EOSCogniton/ELIZ-2022/Documentation/systemes/module standard 48v/conception/concepts/concept_connecteurs_modules.png

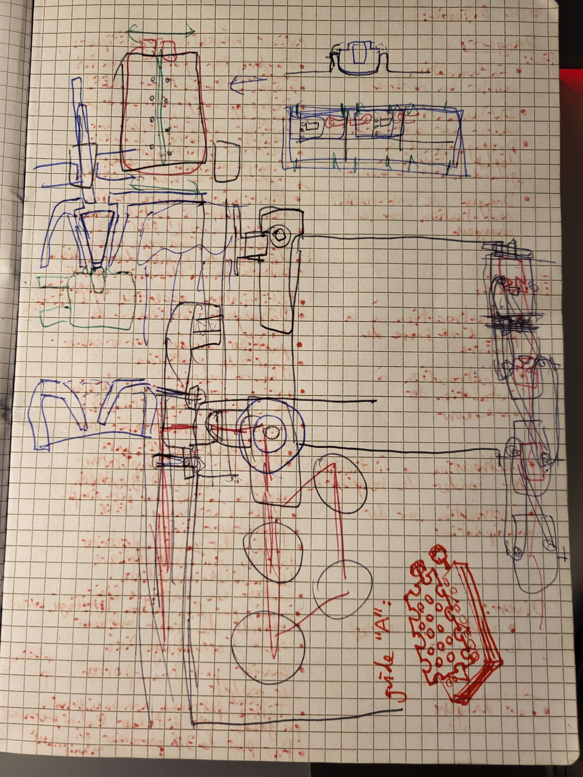
Documentation/systemes/module standard 48v/conception/concepts/concept_connecteurs_modules.png
