EOSCogniton/ELIZ-2022/01 - Maquette CATIA/AA - Mise en plan/La mache laser/4e vague/Anti-Intrusion Plate/Note - read me.txt

Note - read me

Il me semble que l'AIP avait été faite en Alu l'année dernière, mais elle doit être soudée sur tout son coutour. Il faut donc soit de l'alu soudable, sinon du S235 en 1.5mm d'épaisseur ira très bien. Pour l'épaisseur de l'alu, il faut au moins 1.5mm, pas plus que 3. Je vous en reparle quand on se voit.
