EOSCogniton/ELIZ-2022/01 - Maquette CATIA/AA - Mise en plan/La mache laser/3e vague/S235/5mm/Note - read me.txt

Note : Si vous n'avez pas de 5mm, prenez ce que vous avez de plus proche (plus épais ou moins épais, peu importe). Ces pièces ne servent qu'à bloquer en translation les sangles du harnais.
