EOSCogniton/ELIZ-2022/02 - Documentation/CHASEA/Info chassis carbone/Mail_conseils_anglais.docx

Hello,

I am a student at Ecole Centrale de Lyon in France and I am member of the school’s Formula Student team named EPSA.

I am contacting you because I would like to ask you for some details about your chassis, especially the carbon fiber part.

Indeed we would like to design parts of our next car in carbon fiber but we have never made it. Therefore, maybe you could you give us some advices before beginning to use this material.

My questions are

1) Do you manufacture your own parts ?

2) If yes which technique do you use ? Draping and then vacuuming ? How do you produce the mould ?

3) How do you connect your carbon fiber part to the tubular structure ?

Thank you very much for your help.

Hope you will perform this summer.

Kind regards.
