EOSCogniton/ELIZ-2022/02 - Documentation/RC_Rendus_Compet/Eté 2024/IAD/Schematics/Positionning IAD on AIP.pptx

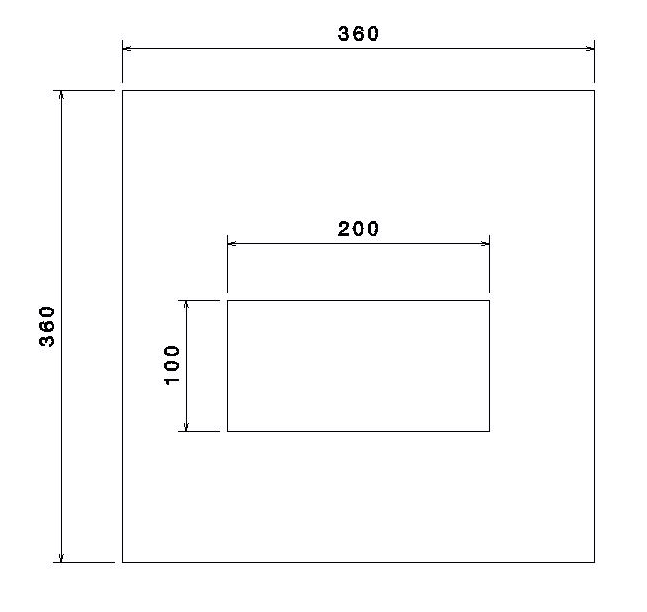
[picture p3: figure]

AIP

IA

## Slide 2

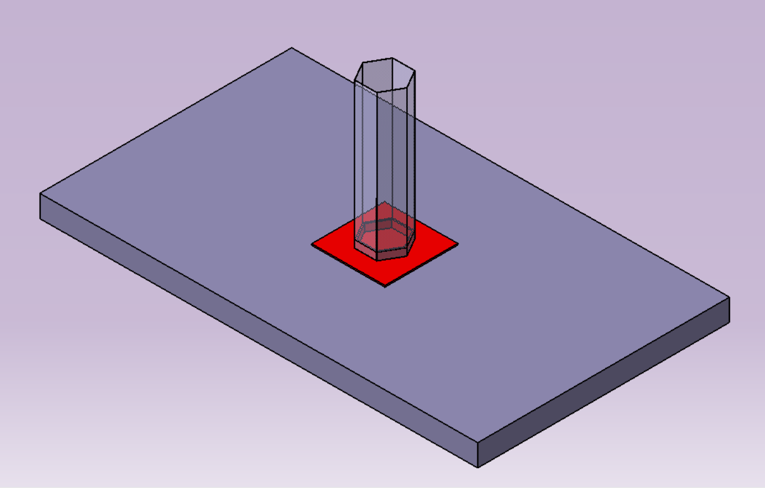
[picture p4: figure]

Cell of the AIP

AIP

Glue that runs up along the walls of the honeycomb

Glue spread on the AIP
