EOSCogniton/ELIZ-2022/02 - Documentation/BASTIE/Cartes Artemiz/SCS IMD-AMS Indicator/Note_SEI.rtf

Question en suspens:

/* Opto ou transistor ?
/* Bonne config du transistor ?
/* Quelles résistances Pulldown / Sortie ?
/* Tension de sortie du comparateur > Vt ?

/* Rest à faire:

/* Déterminer les valeurs des résistances:
/* 2 ponts diviseurs
/* Pull down
/* Sortie

/* Simulation

/* PCB
