EOSCogniton/ELIZ-2022/02 - Documentation/LASMECA/Hors sujet Osiriz/Drivetrain_osiriz/HU-FS-Gearset_B_ProductOverview2526.pdf

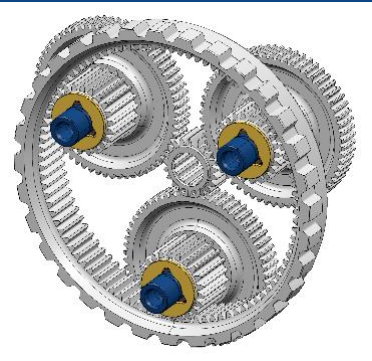
[picture p125: figure]
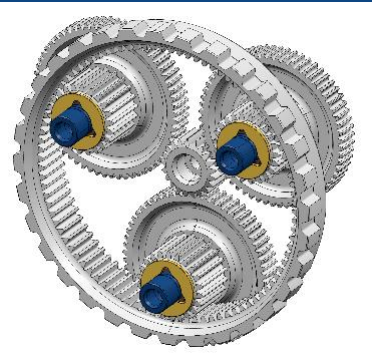
[picture p126: figure]

25/26 – Product Overview formula student gear set | 1

## FORMULA STUDENT GEAR SET

### Product Overview Racing Season 25 / 26

Products

Gear Set “AMK”
V1 – 2025, itot = 12.48
- 1x Sun gear “AMK”
(internal DIN5480 spline)
- 3x Stepped planets
- 1x Ring gear
- 3x Planetary bolts
- 12x Thrust washer

Gear Set “DTI”
V1 – 2025, itot = 12.48
- 1x Sun gear “DTI”
(external DIN5480 spline)
- 3x Stepped planets
- 1x Ring gear
- 3x Planetary bolts
- 12x Thrust washer

Pricing

Version | Price
Gear Set “AMK” | 2,500.00€
Gear Set “AMK” inclusive HUMBEL Sponsoring | 2,000.00€
Gear Set “DTI” | 2,500.00€
Gear Set “DTI” inclusive HUMBEL Sponsoring | 2,000.00€
(Incoterm: FCA Kradolf)

The conditions for the Sponsoring Kit remain in place for as long as the devices in the Sponsoring Kit are used.

HUMBEL Sponsoring requires the following conditions
- HUMBEL logo on the gearbox cover or
HUMBEL logo on the car
- HUMBEL logo on team-website
- 1x Instagram or LinkedIn Post from unboxing or assembly
- HUMBEL may call itself as “Team-Sponsor”
