EOSCogniton/ELIZ-2022/02 - Documentation/RC_Rendus_Compet/Eté 2025/Design Support FSS/Design Support Suspensions.pdf

# Design Support

# Suspensions & Vehicle Dynamics

### Objectives

- Predictable behavior of the car for non-professional drivers
- Extract maximum grip from the tires
- Easily adjustable
- First EV : reliability and ease of operations first

## Conception steps

### 1st Step : tyre choice & tyre study

| Continental C19 | Hoosier HB137 | Goodyear Eagle
Grip capability | 4 | 3 | 5
Weight | 5 | 4 | 5
Price | 5 | 5 | 3
Ease of supply | 3 | 3 | 1
Total | 17 | 15 | 14

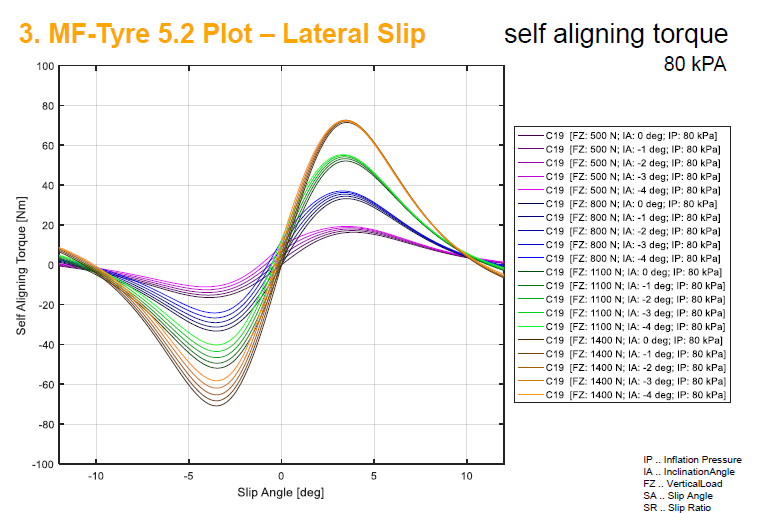
[picture p132: figure]
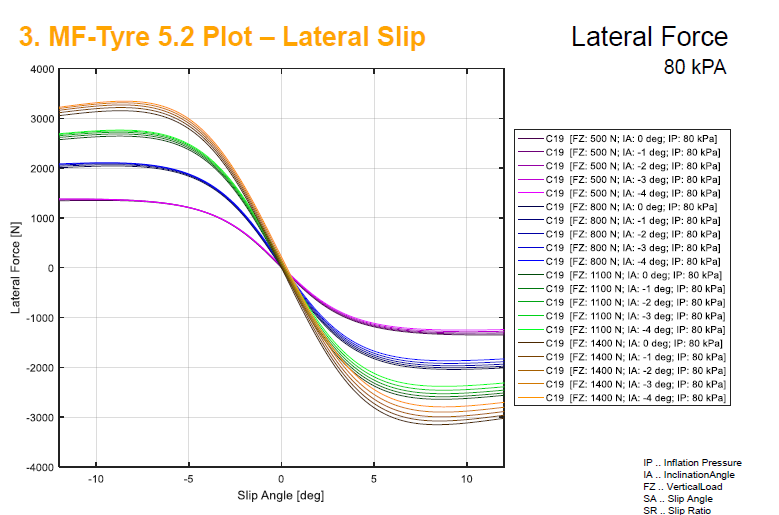
[picture p133: figure]
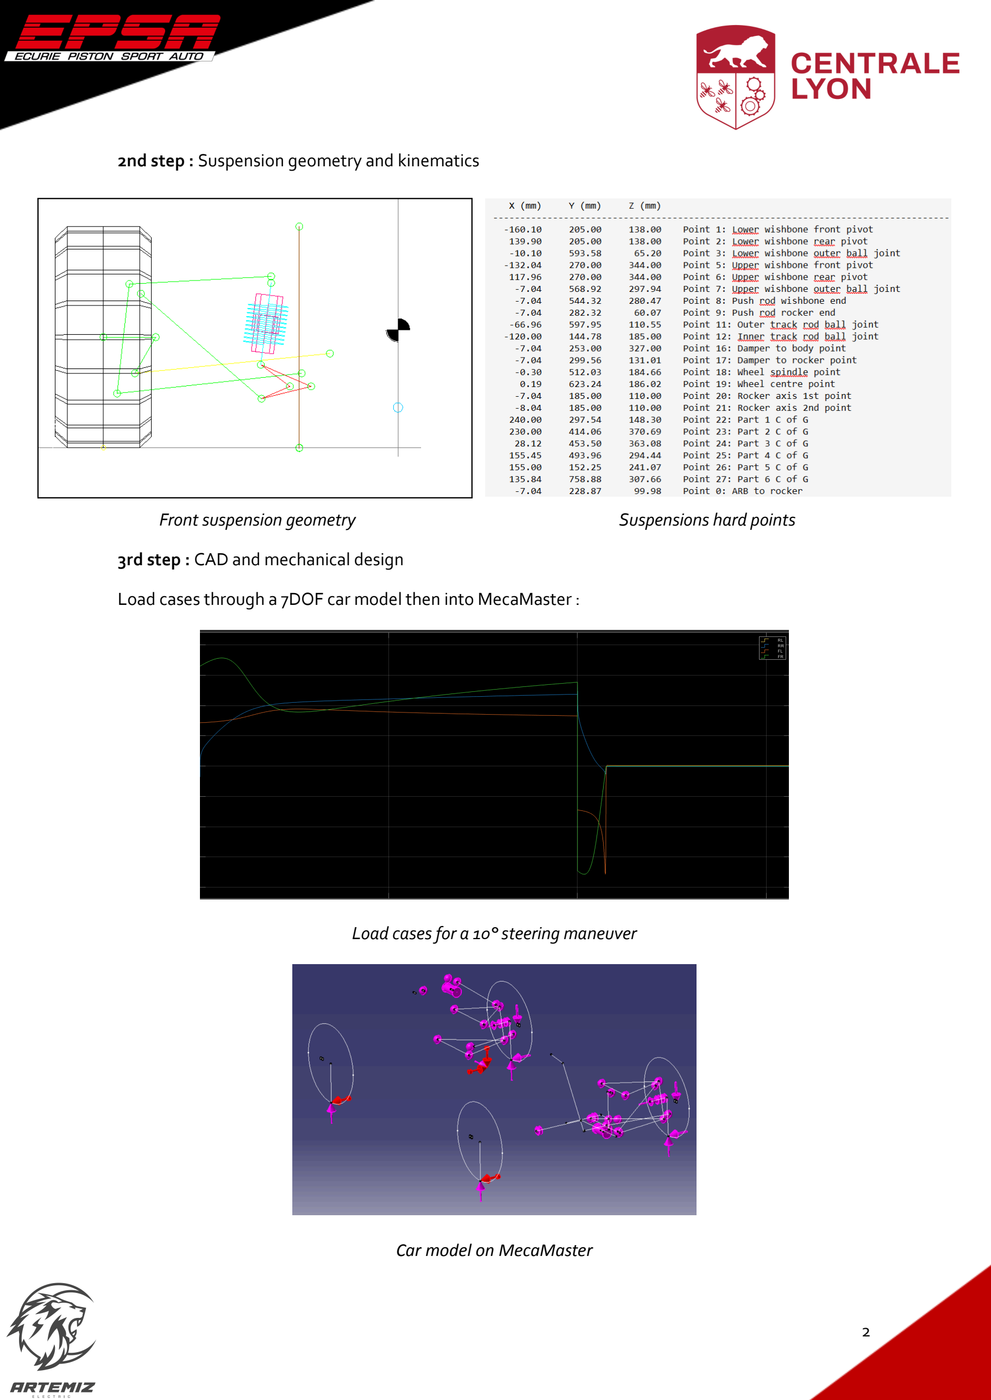
[picture p134: page 2]

2nd step : Suspension geometry and kinematics

Front suspension geometry | Suspensions hard points

3rd step : CAD and mechanical design

Load cases through a 7DOF car model then into MecaMaster :

Load cases for a 10° steering maneuver

Car model on MecaMaster

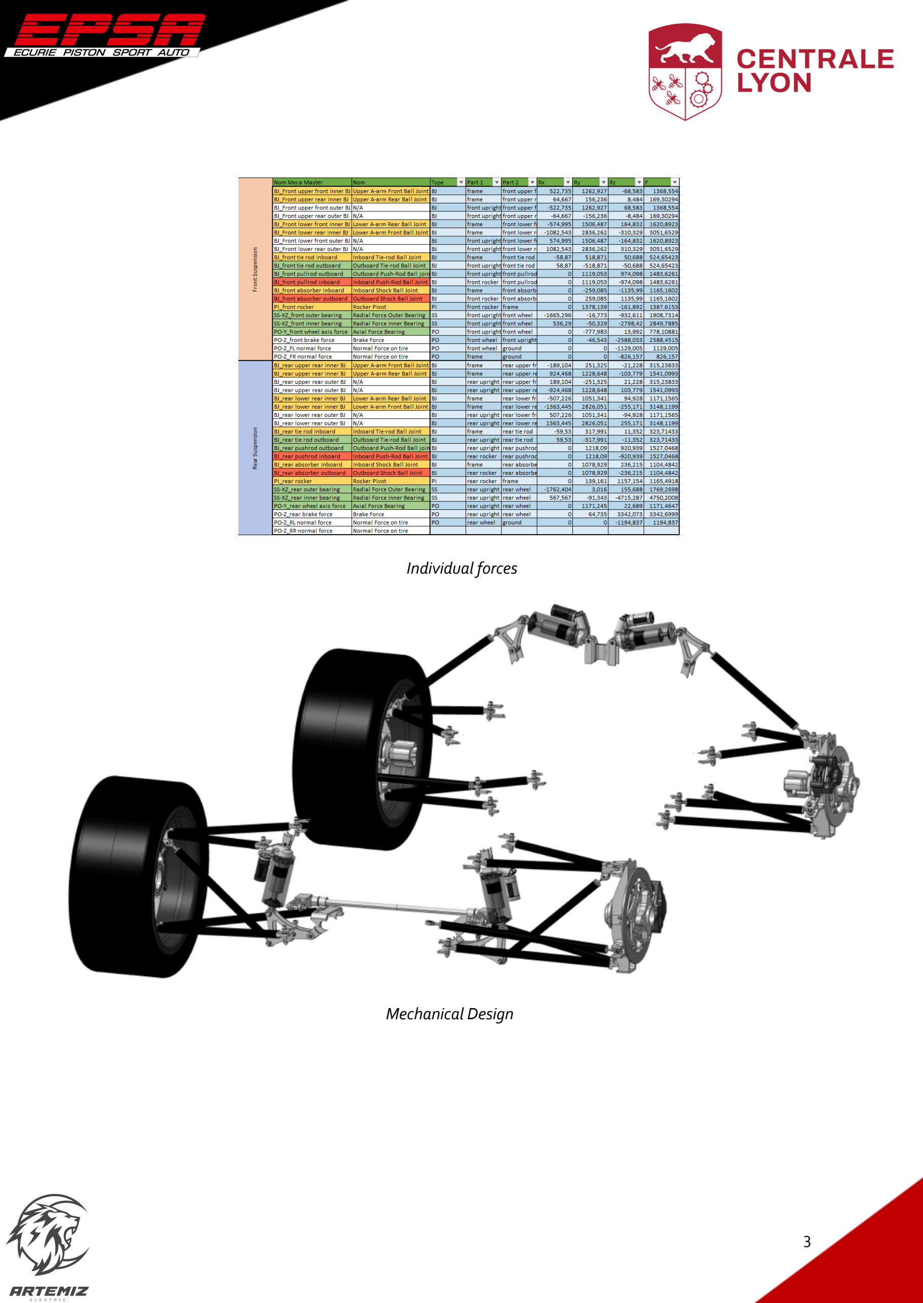
[picture p135: page 3]

Individual forces

Mechanical Design
