EOSCogniton/ELIZ-2022/02 - Documentation/RC_Rendus_Compet/Eté 2025/Design Support FSS/Design_Support_Chassis FSS 2025.pdf

# Design Support Documents

# Frame & Ergonomics

### Objectives

The objective of this document is to present the various tools and approaches we used to design the frame of Artemiz. Our goal was to create the team’s first frame for an electric vehicle. We also aimed to be as competitive as possible, so we set a performance target based on the previous results achieved with the team’s combustion-powered car.

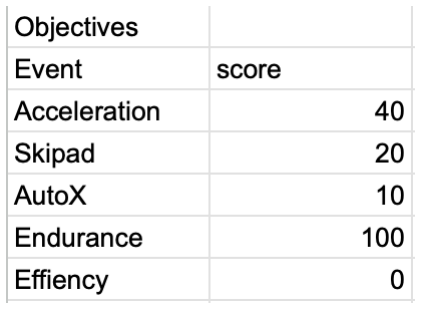
[picture p139: figure]

Figure 0 : Objectives points

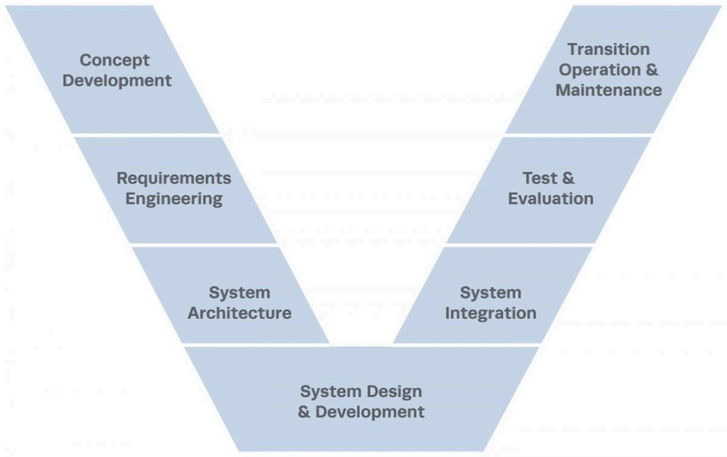
[picture p140: figure]

Figure 1 : Design of the product cycle: V-cycle

### Conception steps

To begin with, we set objectives, summated constraints imposed by the rules and located improvements opportunities, in order to structure and define our work. Then, a preconception phase instituted the basics of the development that was brought in detailed conception. This consisted of an iterative process between CAD and simulations and interface management with other systems.

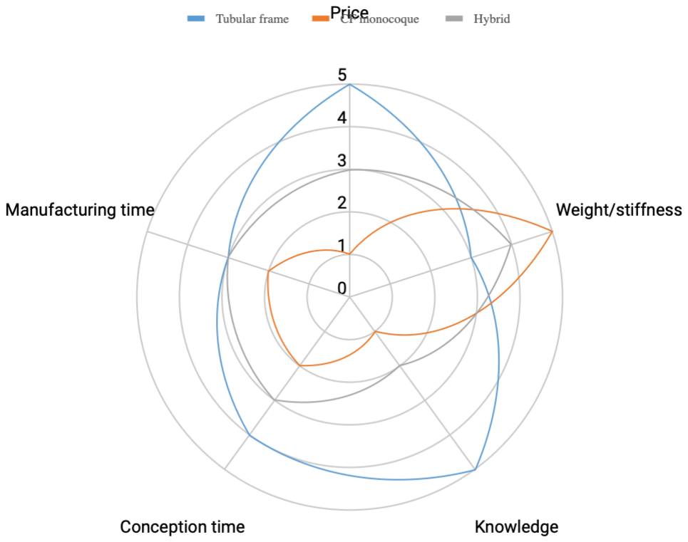
[picture p141: figure]

Figure 2 : Decision graph frame

### Assumptions

We realised simulations under the following assumptions.

- Elastic behaviour
- Small displacement
- No dynamic phenomenon
- Welding beams infinitely stiff
- Beam model

### Important values

| Target | Simulation | Test
Torsional Stiffness (Nm/deg) | 1200 - 1500 | 1430 | 1150
Weight (kg) | 57 | 52 | 53
- Steel: 25CrMo4
- Yield strength: > 700MPa

### CAD

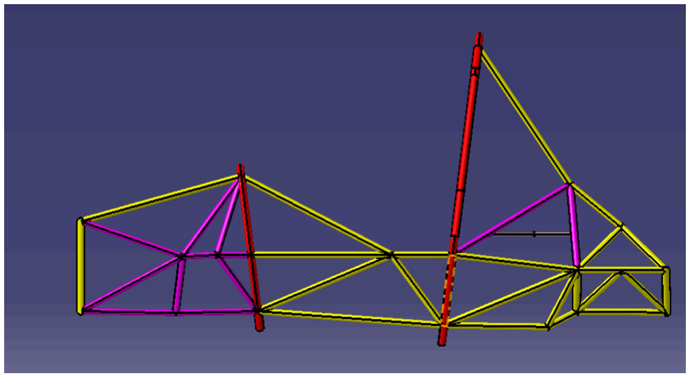
[picture p142: figure]

figure 3 : CAD of the frame

### Simulation tests results

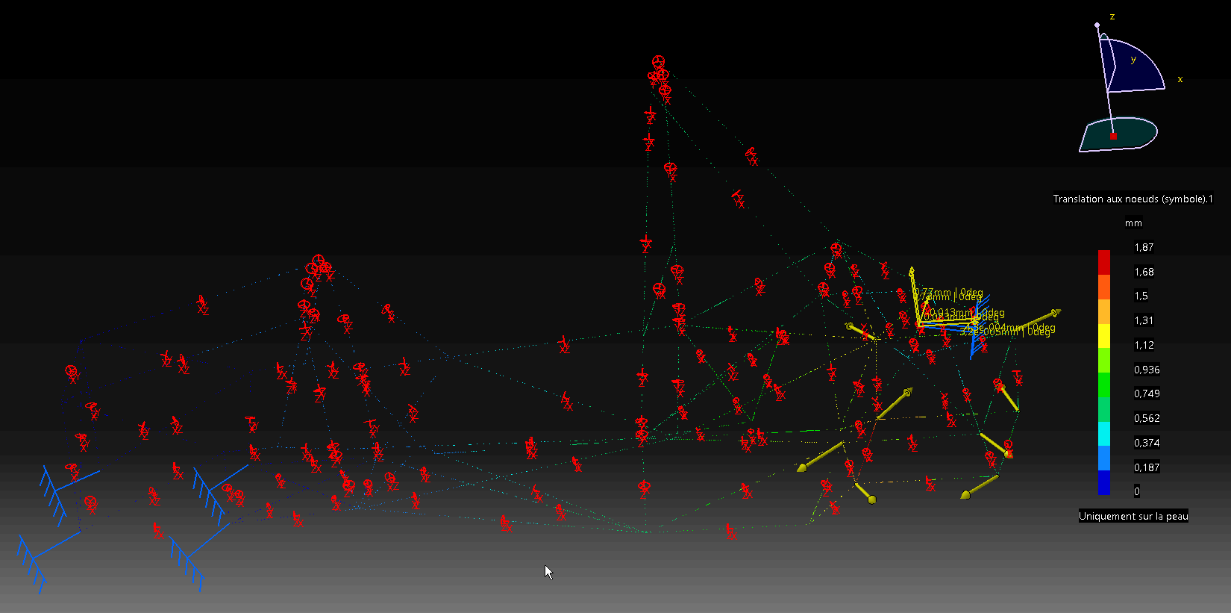
[picture p143: figure]

Figure 4 : Bump 3g rear

### Tests Results

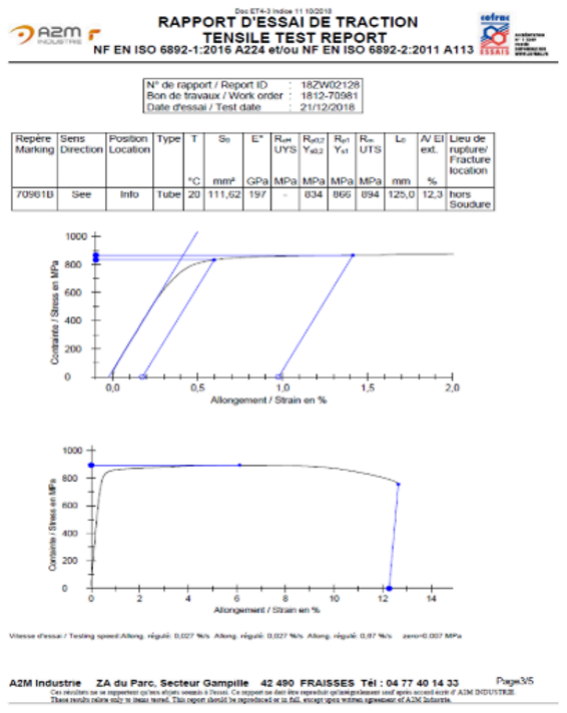
[picture p144: figure]

Figure 5 : Tensile strength test

### Stiffness measurement

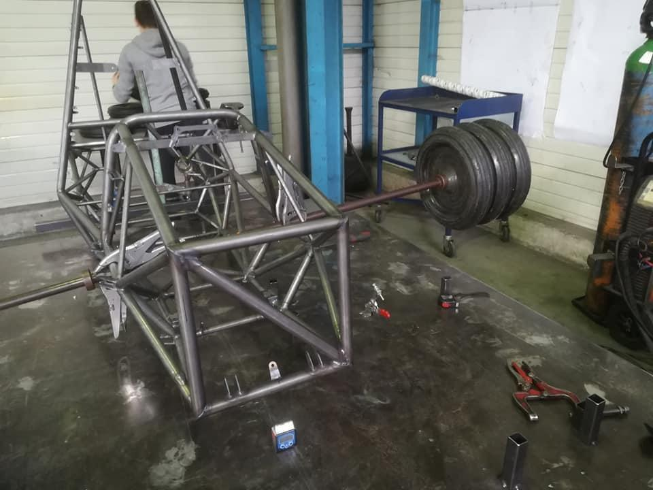
[picture p145: figure]
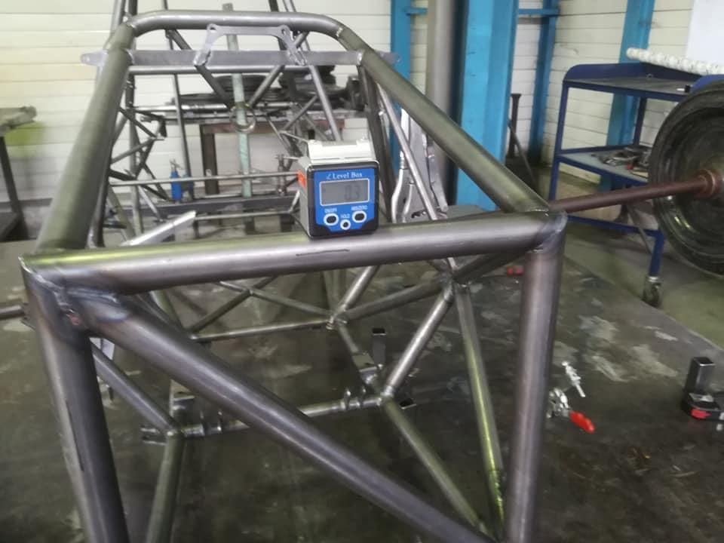
[picture p146: figure]

Fig 9A. Stiffness measurement on a previous frame

Measure performed in two times (distance to longitudinal axis approx. 1m):

- Apply a torque to the front and the cockpit of the frame, blocking the back
- Apply a torque at the back, blocking the front

### Ergonomics and Human Factors

A dedicated ergonomic test bench was used to validate pilot positioning:

- Adjustable seat, pedal box, and steering wheel
- Use of 95th percentile male anthropometric data
- Verification of visibility, accessibility, and harness geometry

This phase ensured rule compliance (6-point harness geometry, padding, egress time) and increased comfort.

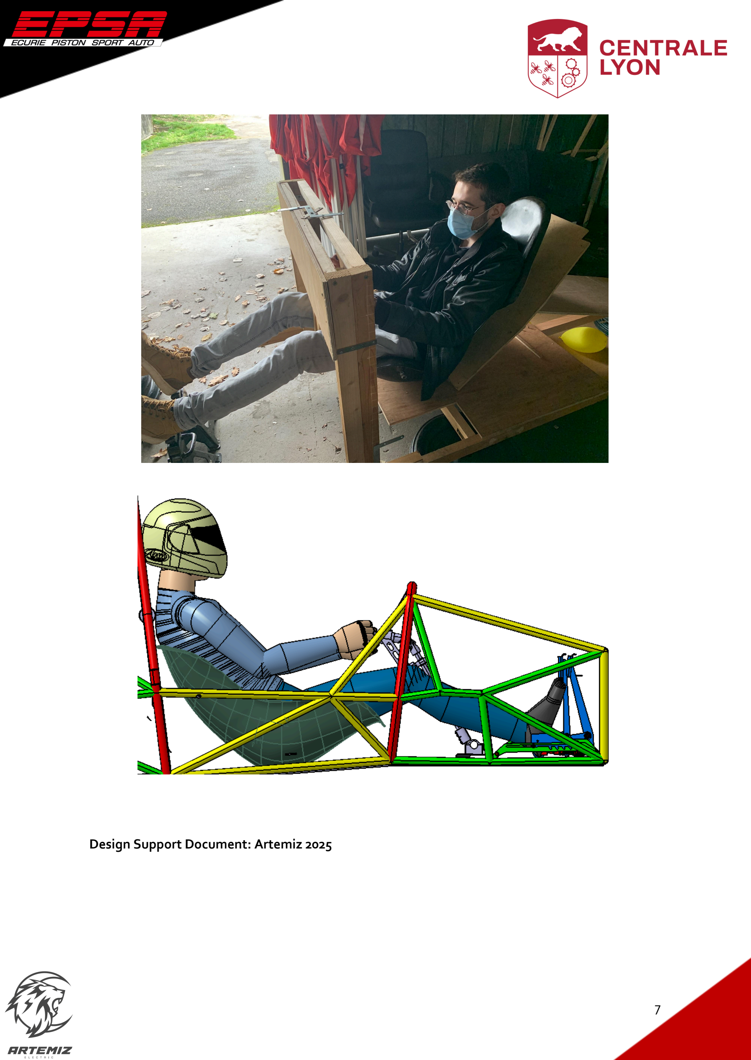
[picture p147: page 7]

Design Support Document: Artemiz 2025
