EOSCogniton/ELIZ-2022/Models/Electronique/Design carte/BSPD/Etape1CarteClarObj.pdf

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

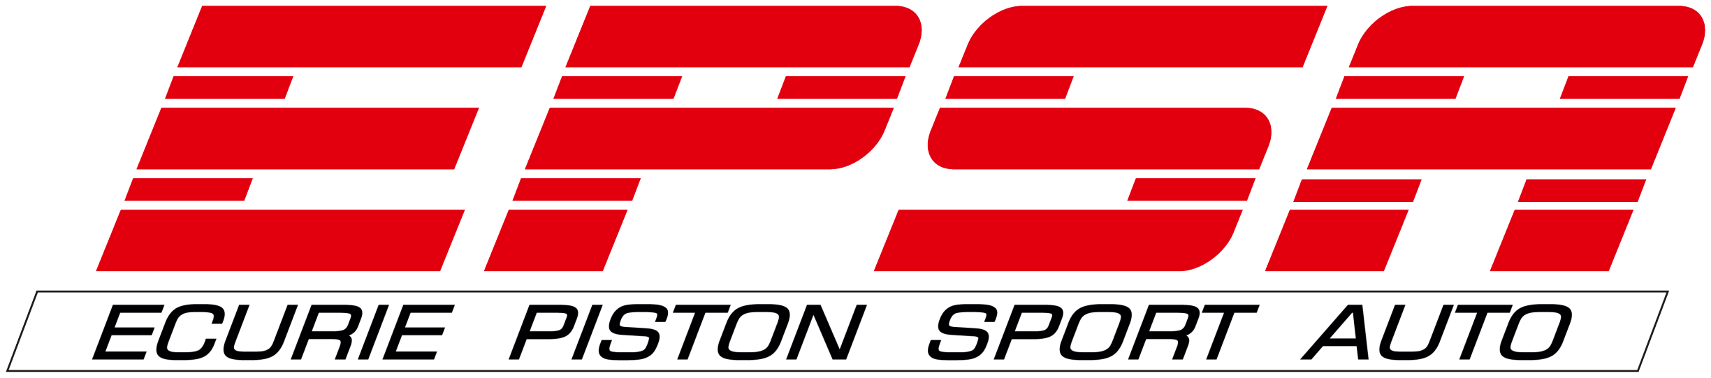
[picture p151: figure]

2 Description du fonctionnement

## Table des matières

1 Introduction | 1
2 Description du fonctionnement | 1
3 Description détaillé du fonctionnement de la carte | 2
4 Schéma Logique | 2
5 Réalisation de la carte BSPD durant le projet Artemiz V1.0 | 3

## 1 Introduction

Le présent document va résumer le fonctionnement la carte BSPD présent dans le réglement à la section X.0.0. Cette rédaction s'est faite sous la direction du véhicule Artemiz V1.0 et sous la version des régles suivantes : FS-Rules_2022_v1.0

## 2 Description du fonctionnement

La logique de cette carte obéit aux règles suivantes :

T 1 1. 6 Brake System P l a u s i b i l i t y Device

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

4 Schéma Logique

De ces règles nous pouvons sortir une liste d'entrée sortie que devra posséder notre carte :
Entrée :
Première entrée : signal du capteur de freinage
Deuxième entrée : signal du capteur de puissance délivrée aux moteurs Sortie :
Première sortie : interrupteur ouvrant ou fermant le shotgun circuit.

## 3 Description détaillé du fonctionnement de la carte

Le fonctionnement détaillé de la carte BSPD est résumé ci-dessous :
le BSPD ouvre le shutdown circuit lorsque'il capte un gros freinage alors que plus de 5kW est délivré aux moteurs pendant plus de 500ms Le shutdown circuit ne se referme que quand les conditions de fermeture ne sont pas validées pendant plus de 10 secondes. Il ne doit comporter que des circuits imprimés non programmables et n'être reliée à aucun système en amont.
Un système de pression des freins doit être utilisé tel que cette pression ne dépasse pas 30 bar.
Seul un capteur de courant DC doit être utilisé. Il doit être choisi tel que la puissance de dépasse pas 5kW à la tension maximale.
Il faut pouvoir déconnecter chaque capteur en cas d'inspection.
Il ne doit pas être dans la TSAC.
Tous les signaux associés doivent être des SCS.
Le fonctionnement du BSPD doit être prouvé en réalisant les conditions d'activation.

## 4 Schéma Logique

La carte BSPD, devra suivre le schéma logique Figure 1. Ce schéma pose les bases pour la conception détaillé de la carte.

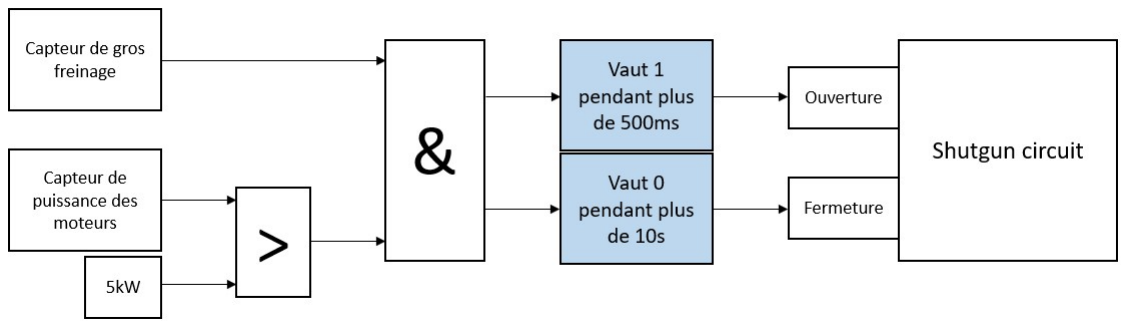
[picture p152: figure]

Figure 1 Schéma logique de la carte BSPD

BASTIE- v0.1 | Clarication Objectif Carte Electroniques- BSPD | 2

5 Réalisation de la carte BSPD durant le projet Artemiz V1.0

## 5 Réalisation de la carte BSPD durant le projet Artemiz V1.0

Cette année l'itération de la carte possède quelques particularité :
Première spécicité
Deuxième spécicité
La carte de l'année actuelle possède un circuit réelle représenté Figure 2 et une optimisation d'espace Figure 3. Toute les données concernant cette carte sont trouvables au lien suivant : Itération Artemiz V1.0 de la carte BSPD (http://google.com)

Figure 2 Schéma Réelle de la carte BSPD du projet Artemiz V1.0

Figure 3 Schéma position de la carte BSPD du projet Artemiz V1.0

La carte possède les composants suivants :

Pièce | Référence Quantité
NE555 | ? | 1
resistance de ?ohms | ? | 1
Condensateur de ?mF | ? | 2
Porte ET | ? | 1
Transistor MOS | ? | 1
Amplicateur opérationnel ? | 1
BASTIE- v0.1 | Clarication Objectif Carte Electroniques- BSPD | 3
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
