EOSCogniton/ELIZ-2022/02 - Documentation/CHASEA/Info chassis carbone/Carbon Rules.xlsx

Zone | Properties | Rules | Questions
side impact structure | same properties as 2 tubes for buckling modulus, yield strength and absorbed energy. | T3.5.2
test sample | Dimensions : 500 x 275
 | Information (permanent marker or engraving, but no sticke): laminated structure acronym and date of testing. | T3.5.4 | T3.5.9
 | rayon du load applicator = 50 mm | T3.5.5
Roll hoop | must be mechanically attached at the top and bottom of both sides of that structure | T3.7.4 | T3.7.6
 | the lower roll hoop tubing attachment points must be within 50mm of the endpoints of the roll hoop.
 | Mounting plates welded to the roll hoops must be at least 2mm thick steel | T3.7.5
Front bulkhead | perimeter shear strength equivalent to a 1:5mm thick steel plate. | T3.13.1
 | The length of the section perpendicular to the bulkhead may be a maximum of 25mm measured from the rearmost face of the bulkhead. |  | T3.13.2
Front bulkhead support | If the front bulkhead support is part of a composite structure, it must have equivalent EI to the sum of the EI of the six baseline steel tubes that it replaces and it must not be counted towards the composite front hoop bracing structures for the structural equivalency documentation | T3.14.2
 | The EI of the vertical side of the front bulkhead support structure must be equivalent to atleast the EI of one baseline steel tube that it replaces | T3.14.3
 |  |  | T3.14.4
Side impact structure | the region 320mm above the lowest inside chassis point between the front and main hoop must have an EI equal to the three baseline steel tubes that it replaces (cf schéma) | T3.15.2
 | The vertical side impact structure must have an EI equivalent to two baseline steel tubes and half the horizontal floor must have an EI equivalent to one baseline steel tube. |  | T3.15.2
 | The vertical side impact structure must have an absorbed energy equivalent to two baseline steel tubes.
 | The perimeter shear strength must be at least 7:5 kN.
Monocoque | Tissage : 50% max de fibres parallèles (+/- 10°) | T3.4.3
 | Main hoop en acier | T3.3.1
 | Front hoop en métal | T3.3.1
 | Respecter les propriétés des matériaux pour la primary structure | T3.2
Si pas même épaisseur partout attention
Front hoop possible de le laminer T3.9.5
