EOSCogniton/ELIZ-2022/02 - Documentation/module standard 48v/conception/Calcul-du-nombre-de-cellules-et-des-dimensions-à-utiliser.xlsx

Sheet: Calcul du nombre de cellules
Caractéristiques batterie | Valeur | Unité
Capacité | 7800 | Wh
Nombre de modules | 10 | /
Caractéristiques cellule : 18650 Parasonic ou Sony | Valeur | Unité
Tension nominale | 3.6 | V
Capacité | 2.5 | Ah
Caractéristiques module | Valeur | Unité
Capacité | 780 | Wh
Tension nominale | [48;50] | V
Nombre de cellules | 86.66666667 | /
Intervalle admissible pour le nombre de cellules (+/- 5%) | [83;91] | /
Nombre de blocs en parallèle | 14 | /
Facteur de paramétrisation | 6.19047619 | /

Sheet: Calculs pour la structure
Valable pour toutes les structures
c : nombre de colonnes, c \in {5,7,9}
n_0 : nombre de cellules dans une colonne de bout
n : nombre total de cellules, n \in [83;91]
Utilisation d'un script Python pour déterminer les n0 compatibles
Colonne1 | Colonne2
Résultats |  | Colonne 1 | Colonne 2 | Colonne 3 | Colonne 4 | Colonne 5
c = 5 | n0 = 17 | 17 | 18 | 17 | 18 | 17
Nombre total de cellules | 87
c = 7 | n0 = 12 | Colonne 1 | Colonne 2 | Colonne 3 | Colonne 4 | Colonne 5 | Colonne 6 | Colonne 7
Nombre total de cellules | 87 | 12 | 13 | 12 | 13 | 12 | 13 | 12
c = 9 | n0 = 9
Nombre total de cellules | 85 | Colonne 1 | Colonne 2 | Colonne 3 | Colonne 4 | Colonne 5 | Colonne 6 | Colonne 7 | Colonne 8 | Colonne 9
 |  | 9 | 10 | 9 | 10 | 9 | 10 | 9 | 10 | 9
