EOSCogniton/ELIZ-2022/02 - Documentation/module standard 48v/conception/calculs elec et dimensions.xlsx

Caractéstiques cellule | valeur | unité
Ref | 18650 panasonic/sony
Tension nominale | 2.3 | V | topologie batterie
Capacité |  |  | ligne 1 | ligne 2 | ligne 3 | ligne 4 | ligne 5
 |  |  | 8 | 9 | 8 | 9 | 8
 |  |  | total cellules : |  |  |  | 42
Caractéristiques module | valeur | unité
Capacité | 780 | Wh
Tension nominale | 48.3 | V
Facteur de parallélisation | 2
Nombre de cellules | 42
Volume parallépipédique enveloppe
Masse cellules
Prix cellules
Masse totales
Prix total
Caractéristiques batterie | valeur | unité
Capacité | 7800 | Wh
Nombre modules | 10 | -
