EOSCogniton/ELIZ-2022/Models/Electronique/Thermique Jeu de barre/Barre Design.xlsx

Paramètre simulation : |  |  | Résultat
Température air ambient | 50 | °C | Resistance du matériaux | 9.321401939e-05 | Ohm/m
Epaisseur plaque | 6 | mm | Puissance Dissipé | 3.728560776 | W/m
Largeur Plaque | 30 | mm
Courant Dans la plaque | 200 | A | Température atteinte | 62.94639158 | °C
Conductivité plaque | 59600000 | S/m
Coéfficient échange thermique | 4 | W/(m^2.K)
 |  |  | Equation de la simulation
 |  |  | Résistance | R = 1/(S*cond)
 |  |  | Premier principe en statique | 0 = (T - Tinf)*h*Per + Pelec
 |  |  | Puissance Dissipé | Pelec = I^2 * R
 |  |  | cond : conductivité
 |  |  | T : température du cable
 |  |  | Tinf : température ambiante
 |  |  | h : coéfficient échange thermique
 |  |  | Pelec : puissance dissipé par effet joule
 |  |  | S : la section de cable
 |  |  | I : inténsité électrique
 |  |  | Per : perimètre
