EOSCogniton/ELIZ-2022/02 - Documentation/BASTIE/Cartes Artemiz/TSAL (version SCS output)/TSAL_Design_explanation/truth_table.xlsx

Relais | Int | SCS | Int_Logic | Rel_Logic | Commentaire
Fermé | 12V | 0 | 1 | 0 | Pas de problème
Ouvert | 12V | 1 | 1 | 1
Fermé | 0V | 0 | 0 | 0 | the intentional state of the used (auxiliary) contact is opened
Ouvert | 0V | 0 | 0 | 1 | Pas de problème
VoltageAIR | IntDetect | VoltageAir_Logic | SCS |  | Commentaire | NOR | NAND int
50 | 1 | 0 | 0 |  | Pas de problème | 1 | 0
50 | 0 | 0 | 0 |  | Pas de tension intentionnellement | 0 | 1
0 | 1 | 1 | 1 |  |  | 0 | 0
0 | 0 | 1 | 0 |  | Pas de problème | 0 | 1
