EOSCogniton/ELIZ-2022/Models/Electronique/Thermique Jeu de barre/README.md

# Latex Thermique des Conducteur

Projet latex et de recherche sur les conducteurs.

Il y a à disposition :
- un fichier excel permettant de prévoir la montée de température des jeux de barres 
- un fichier pdf regroupant des connaissances de bases sur les conducteurs 
- un dernier pdf résumant de manière empirique les tailles de vis suivant les puissances électriques
