EOSCogniton/ELIZ-2022/02 - Documentation/BASTIE/Cartes Valkyriz/BMS/README.txt

Page 21: pulse transformers recommandés. Ratio 1:1, center tap pour un réduction eventuelle de bruit.
Page 20: Valeurs des résistances pour des tranfos 1:1
