EOSCogniton/ELIZ-2022/01 - Maquette CATIA/AA - Mise en plan/La mache laser/4e vague/Catch-can bottle/Note - read me.txt

Note - read me

Equipement qui se soudera sur une bouteille en inox. J'avoue que je n'ai aucune idée du matériau à utiliser dans ce cas, mais si du S235 convient, partons là dessus. Idem, je vous en parle quand nous nous revoyons.
