EOSCogniton/ELIZ-2022/03 - H901BENCH/Bancs et prototypes/proto batterie/module standard 48v/travail_JAuburtin/Connexions électriques/Deuxièmes versions.pptx

## C = 5

## C5.2.1

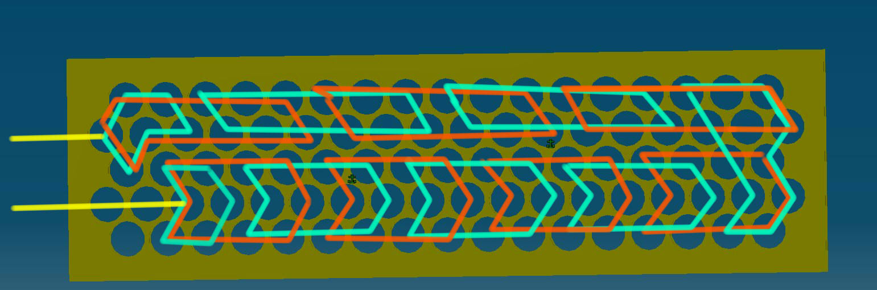
[picture p158: figure]

## C5.2.2

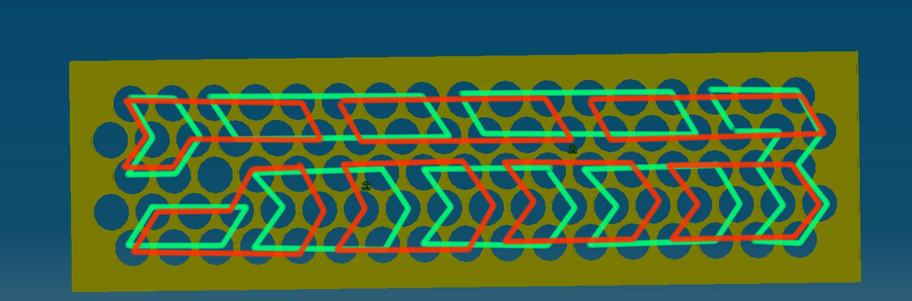
[picture p159: figure]

## C5.2.3

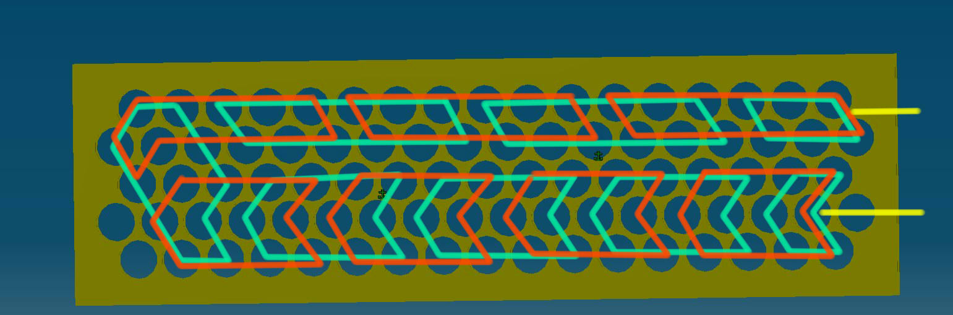
[picture p160: figure]

## C5.4.1

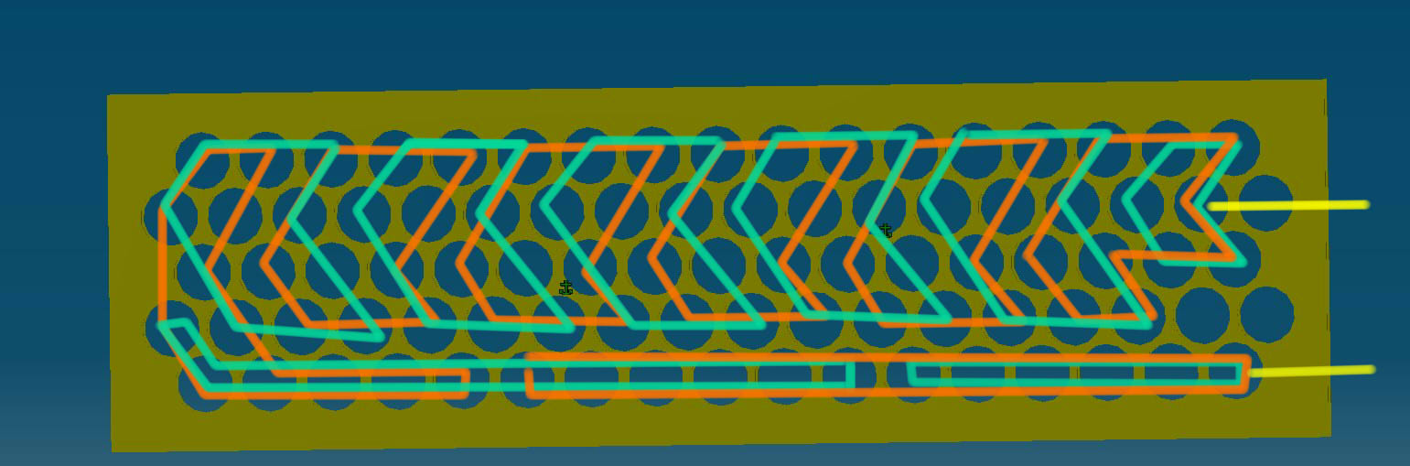
[picture p161: figure]

## C5.4.2

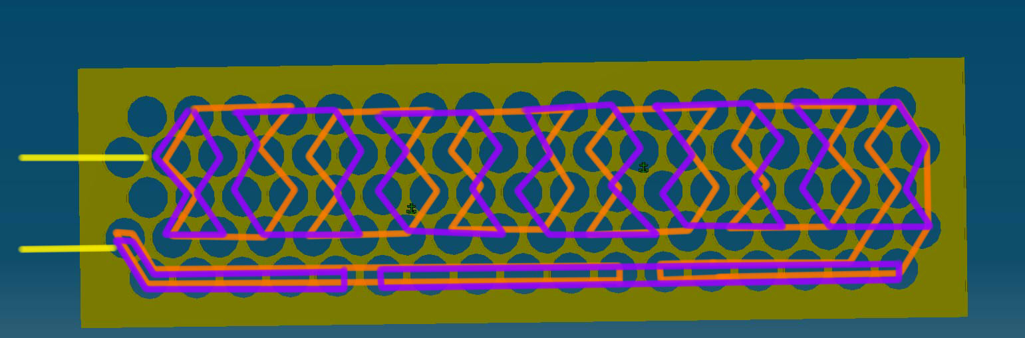
[picture p162: figure]

## C5.4.3

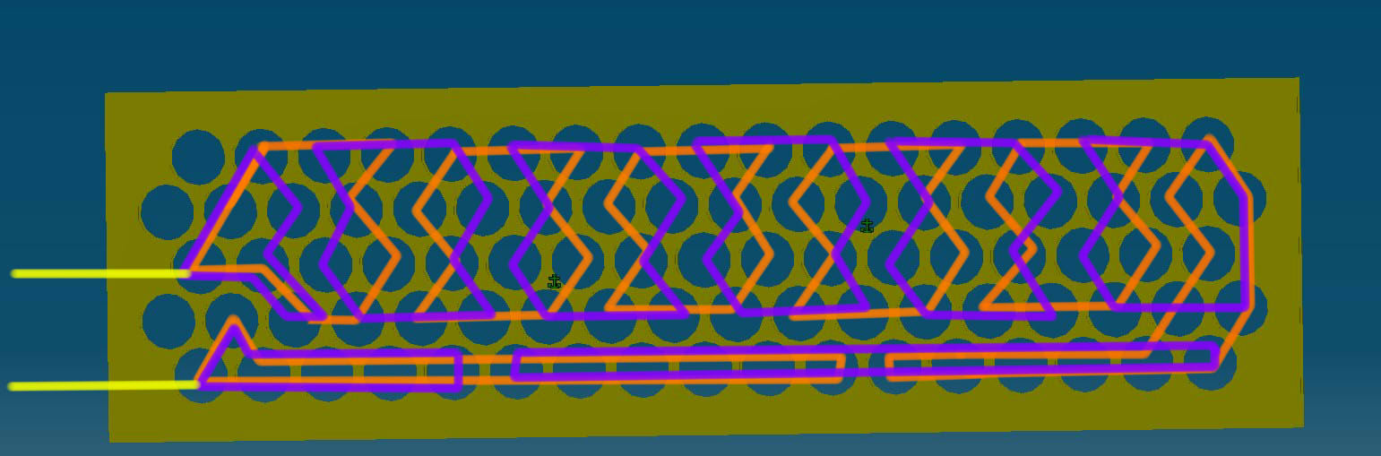
[picture p163: figure]

## C = 7

## C7.4.1

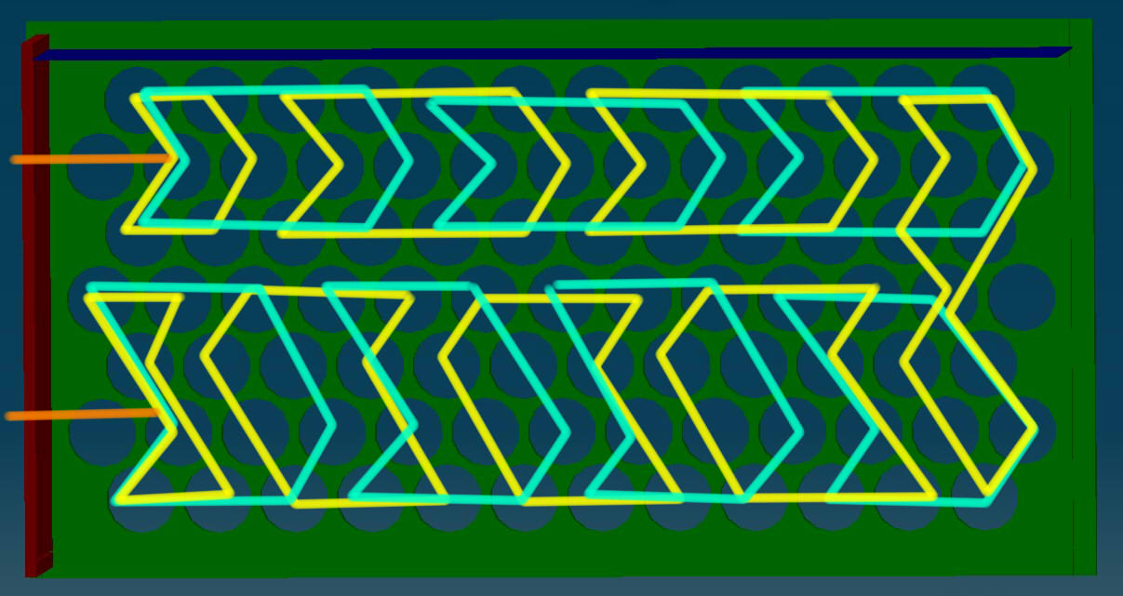
[picture p164: figure]

## C7.4.2

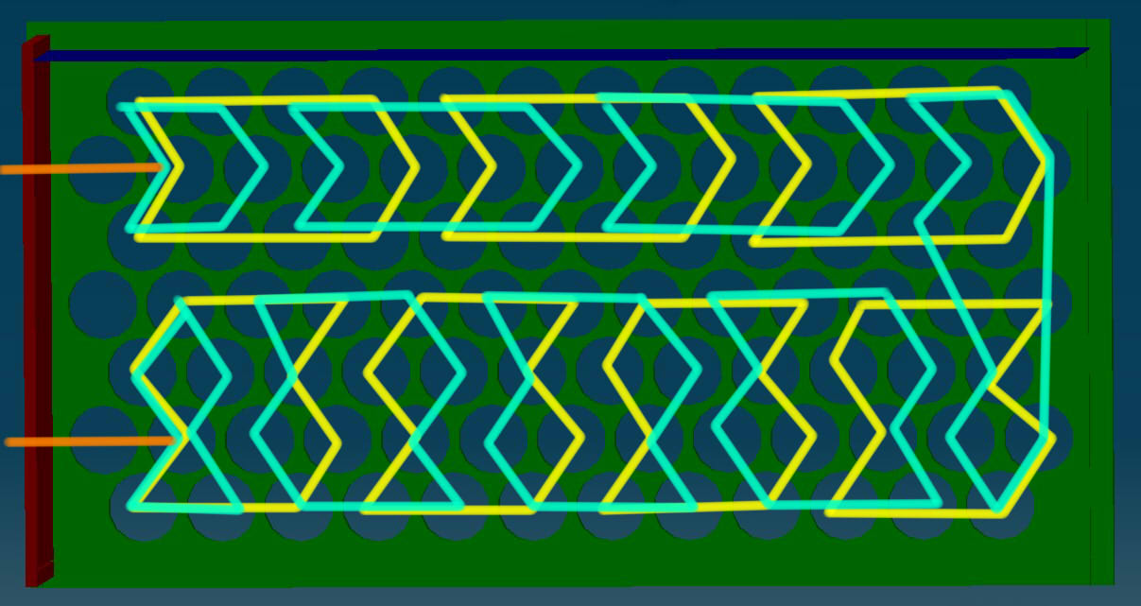
[picture p165: figure]

## C7.3.1

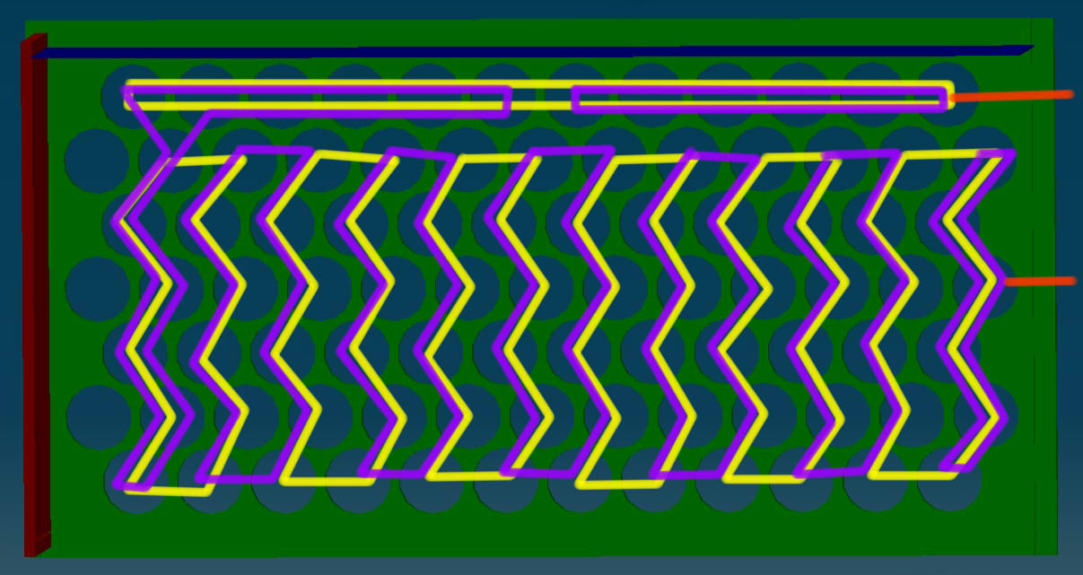
[picture p166: figure]
