EOSCogniton/ELIZ-2022/03 - H901BENCH/Bancs et prototypes/proto batterie/module standard 48v/travail_JAuburtin/Connexions électriques/Premières versions.pptx

## C = 5

Trois formes de connecteurs :
- le losange allongé, 3 de hauteur et 4 de largeur
- l’éclair de Harry Potter, 4 de hauteur et 3 de largeur
- le rectangle, 1 de hauteur et 6 de largeur

## Slide 2

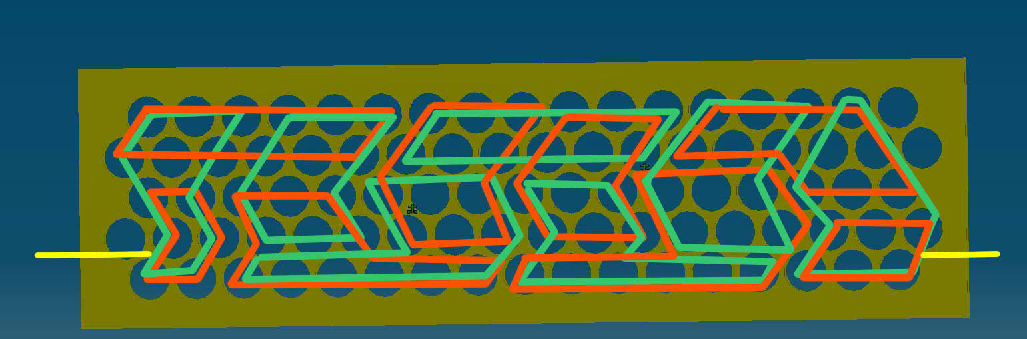
[picture p167: figure]

## Slide 3

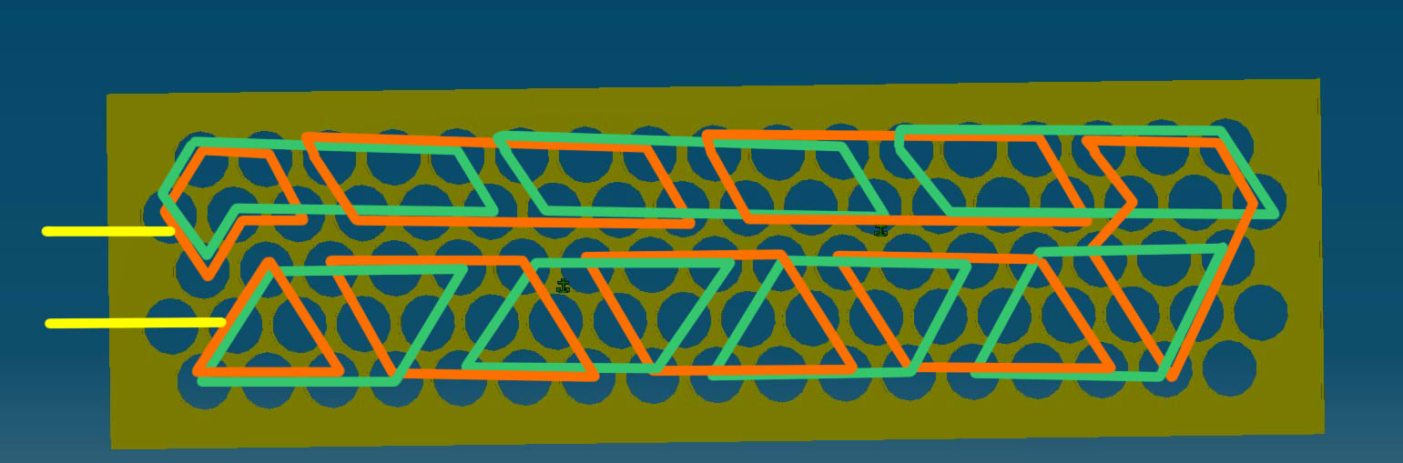
[picture p168: figure]

## Slide 4

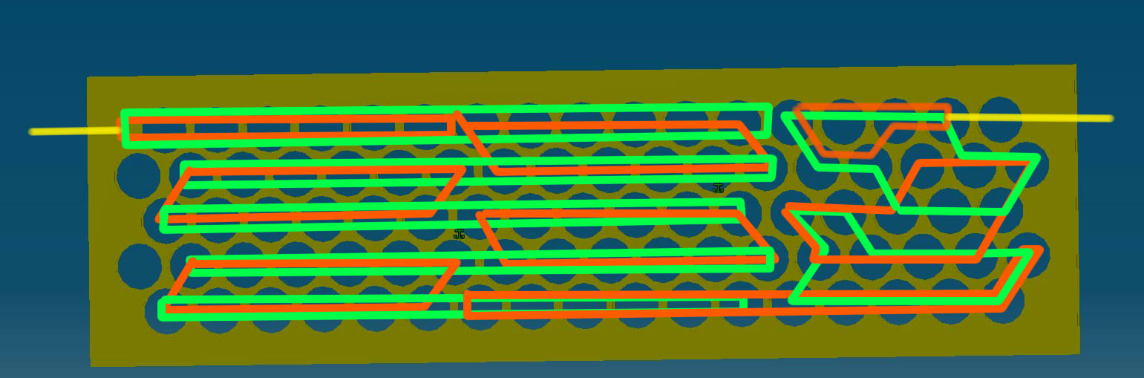
[picture p169: figure]

## Slide 5

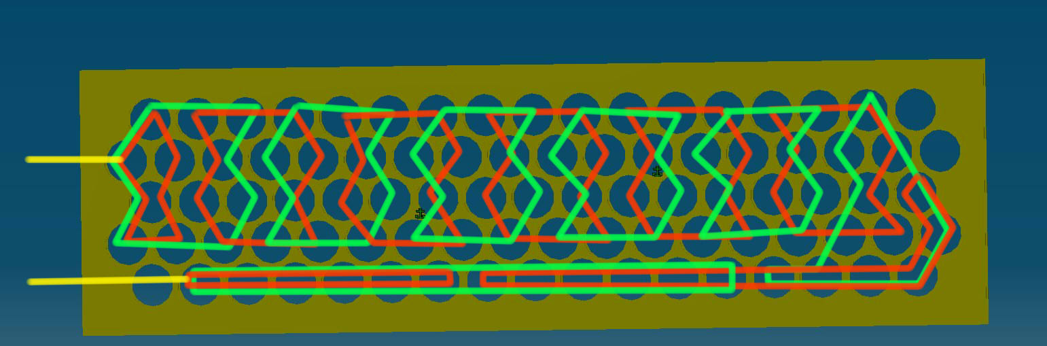
[picture p170: figure]

## C = 7

Cinq formes de connecteurs :
- le rectangle de hauteur 1 et de largeur 6
- l’éclair de Harry Potter, de hauteur 4 et de largeur 3
- le losange allongé, de hauteur 3 et de largeur 4
- le losange fin, de fauteur 6 et de base 2
- la flèche Exit, de hauteur 3 et de largeur 4

## Slide 7

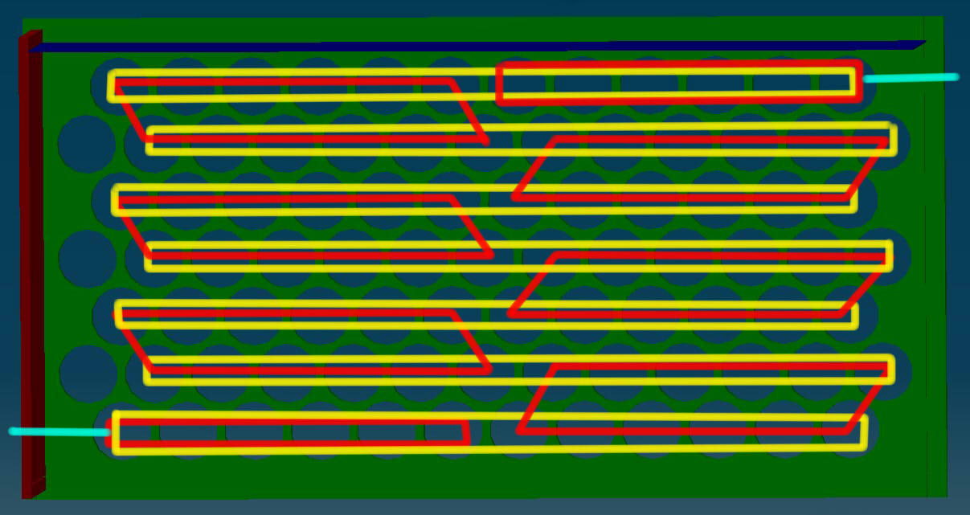
[picture p171: figure]

## Slide 8

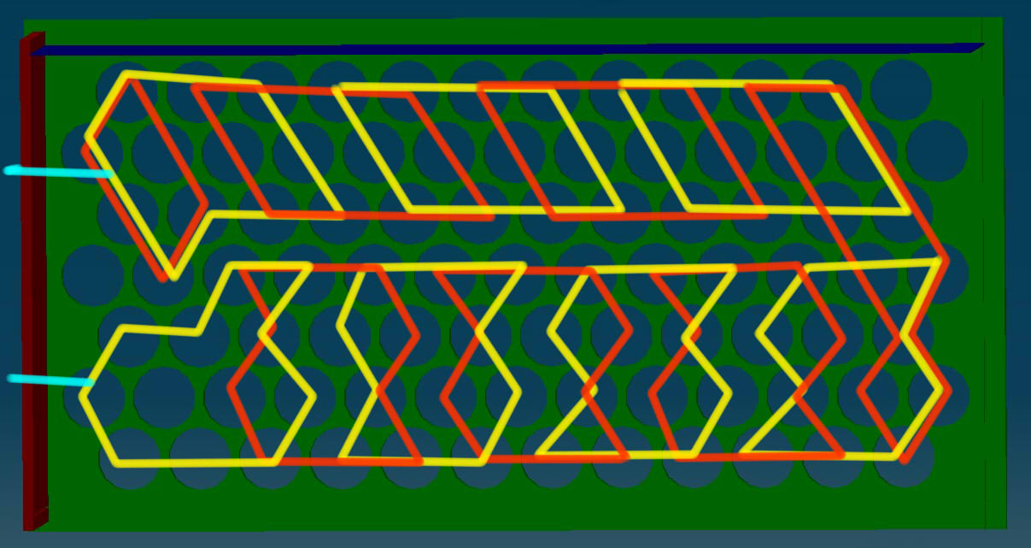
[picture p172: figure]

## Slide 9

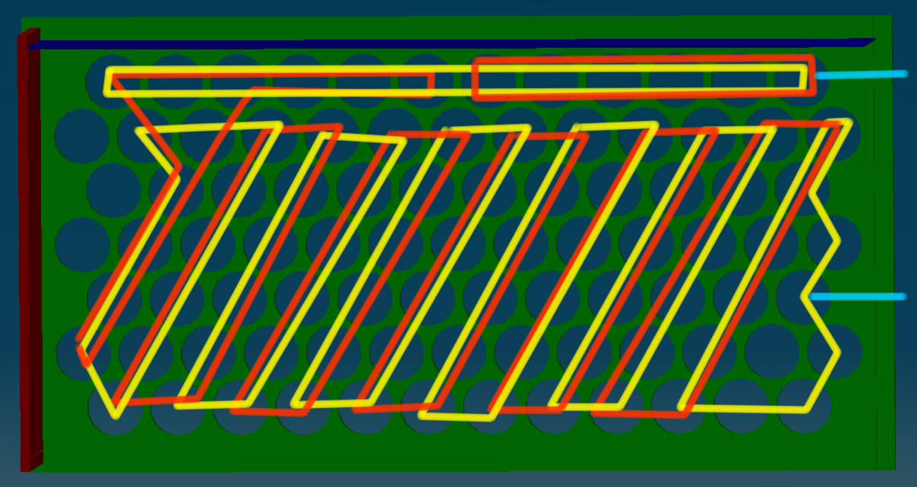
[picture p173: figure]

## Slide 10

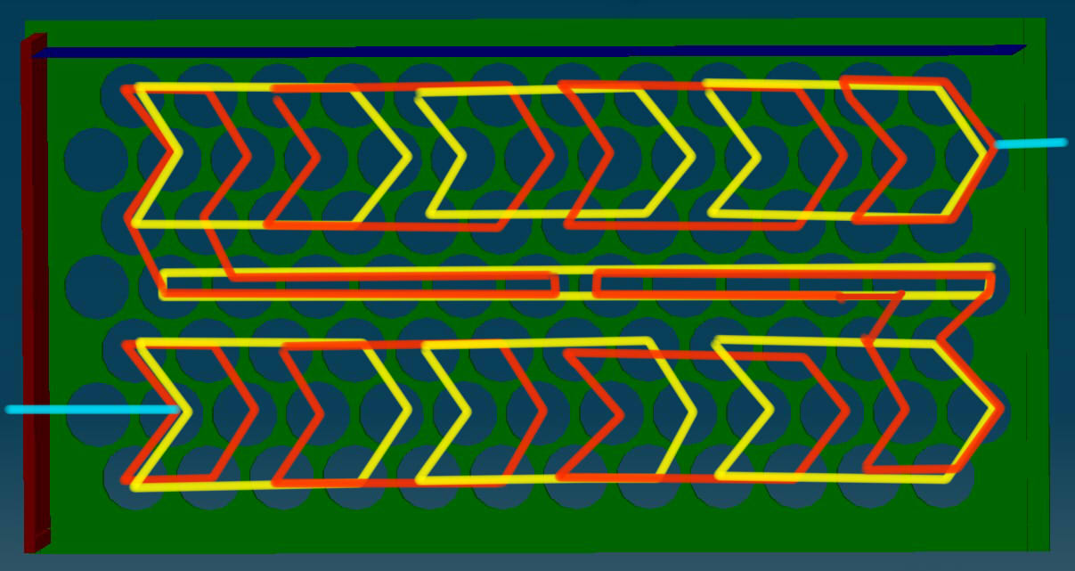
[picture p174: figure]
