EOSCogniton/ELIZ-2022/02 - Documentation/Formation_Catia/TP2-conception_paramétrée-schéma_de_référence.pdf

Démarche de conception - CATIA V5®

## TP2 :Utilisation d’un schéma de référence non modifiable piloté par un chef de projet

Introduction :
Dans le TP précédent, le schéma apparaissait explicitement dans l’arbre de l’assemblage.

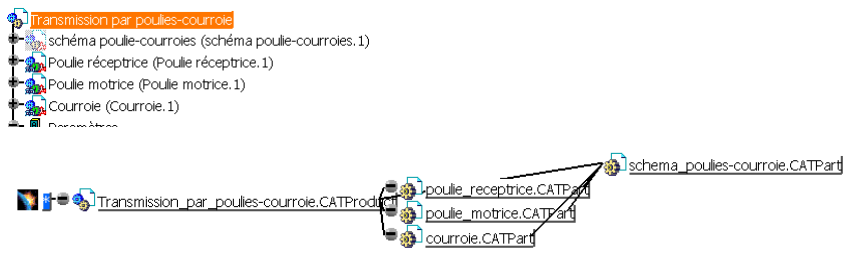
[picture p190: figure]

Ce résultat n’est pas souhaitable lorsque les fichiers de pièces et d’assemblages sont manipulés par plusieurs personnes différentes dans un ou plusieurs bureau d’études. En effet, une personne peut modifier voire détruire par inadvertance le fichier source « schema_poulies-courroie.CATPArt » et les personnes qui vont concevoir d’autres pièces à partir de ce schéma peuvent alors utiliser le bon ou le mauvais fichier. Il peut donc se produire des problèmes de références et donc de mise à jour des pièces et de l’assemblage.
Pour éviter ces problèmes, la pièce « schema_poulies-courroie.CATPArt » n’apparaîtra pas dans l’assemblage mais l’esquisse qui contient le schéma sera copiée comme résultat dans chaque pièce conçue à partir de lui.
Ainsi pas de risque de destruction ; de plus, on n’a plus besoin d’ouvrir l’assemblage pour mettre à jour les pièces. Une pièce ouverte sera mise à jour si une mise à jour de « schema_poulies-courroie.CATPArt » a été effectuée. Cette méthode est intéressante si différentes personnes travaillent en différents endroits et/ou en même temps sur une même conception.
Quand le chef de projet de la conception mettra à jour « schema_poulies-courroie.CATPArt », toutes les pièces dépendantes seront mises à jour.
Objectifs :
- concevoir une transmission par poulies-courroie en utilisant la copie d’un schéma de référence .
- travailler simultanément sur plusieurs fichiers dépendant d’un schéma de référence.

### 1 Etape n°1 : Visualisation du schéma de référence

### 1.1 Visualisation de la géométrie

Ouvrir « schema_poulies-courroie.CATPart dans le dossier « schéma(ne pas modifier) » :

Ce schéma est contenu dans l’esquisse du Corps principal nommée « Esquisse paramétrée (à copier) ».

©F.XERRI | Conception paramétrée du scootcar- TP n°2 | 1

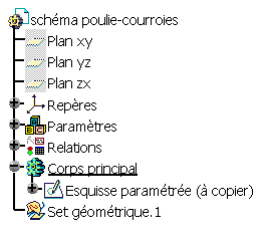
[picture p191: figure]

### 1.2 Visualisation du paramétrage

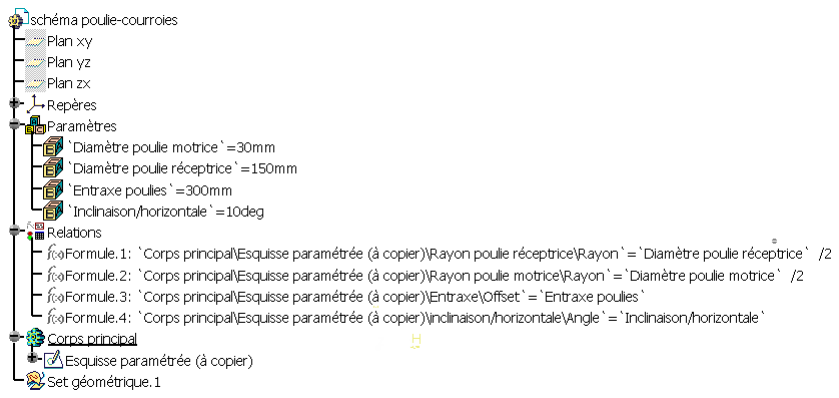
[picture p192: figure]

On a créé comme au TP précédent, quatre paramètres et autant de relations qui permettent de piloter le schéma . Cette fois, les paramètres et les relations ont été créés dans le schéma.

### 2 Etape n°2 : Création des pièces et de l’assemblage

### 2.1 Création de l’assemblage

2.1.1 Créer le fichier « Transmission_par_poulies-courroie.CATProduct » dans le dossier « TP2-copie d’un schéma ».

©F.XERRI | Conception paramétrée du scootcar- TP n°2 | 2

### 2.2 Création de la pièce poulie motrice

2.2.1 Insérer une nouvelle pièce « poulie-motrice.CATPart » dans cet assemblage. L’enregistrer dans le dossier « TP2-copie d’un schéma ».

2.2.2 Retourner dans « schema_poulies-courroie.CATPArt » (utiliser Mosaïque verticale pour le multi-fenêtrage).

2.2.3 Sélectionner puis copier l’esquisse nommée « Esquisse paramétrée (à copier) »

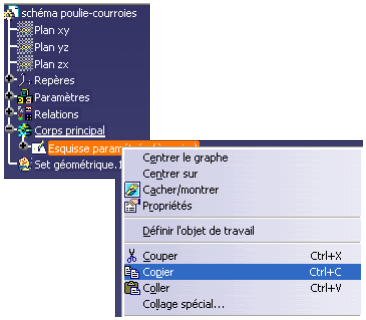
[picture p193: figure]
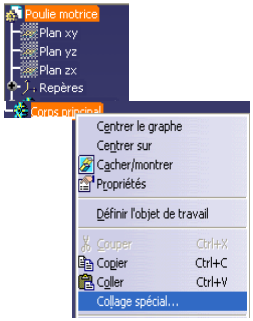
[picture p194: figure]

2.2.4 Aller dans « poulie-motrice.CATPart ». Cliquer bouton droit sur Corps Principal puis « Collage spécial ».

2.2.5 Choisir Coller « En tant que résultat avec lien ».

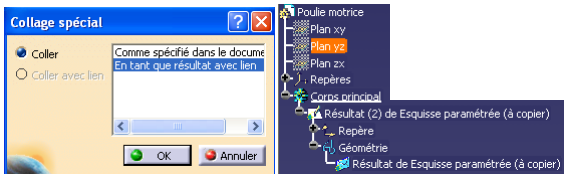
[picture p195: figure]

Seul le résultat visuel de la géométrie de l’esquisse est copié. Les entités qui composent la géométrie ne sont pas accessibles. On ne peut donc modifier directement le fichier « schema_poulies-courroie.CATPArt ».

©F.XERRI | Conception paramétrée du scootcar- TP n°2 | 3

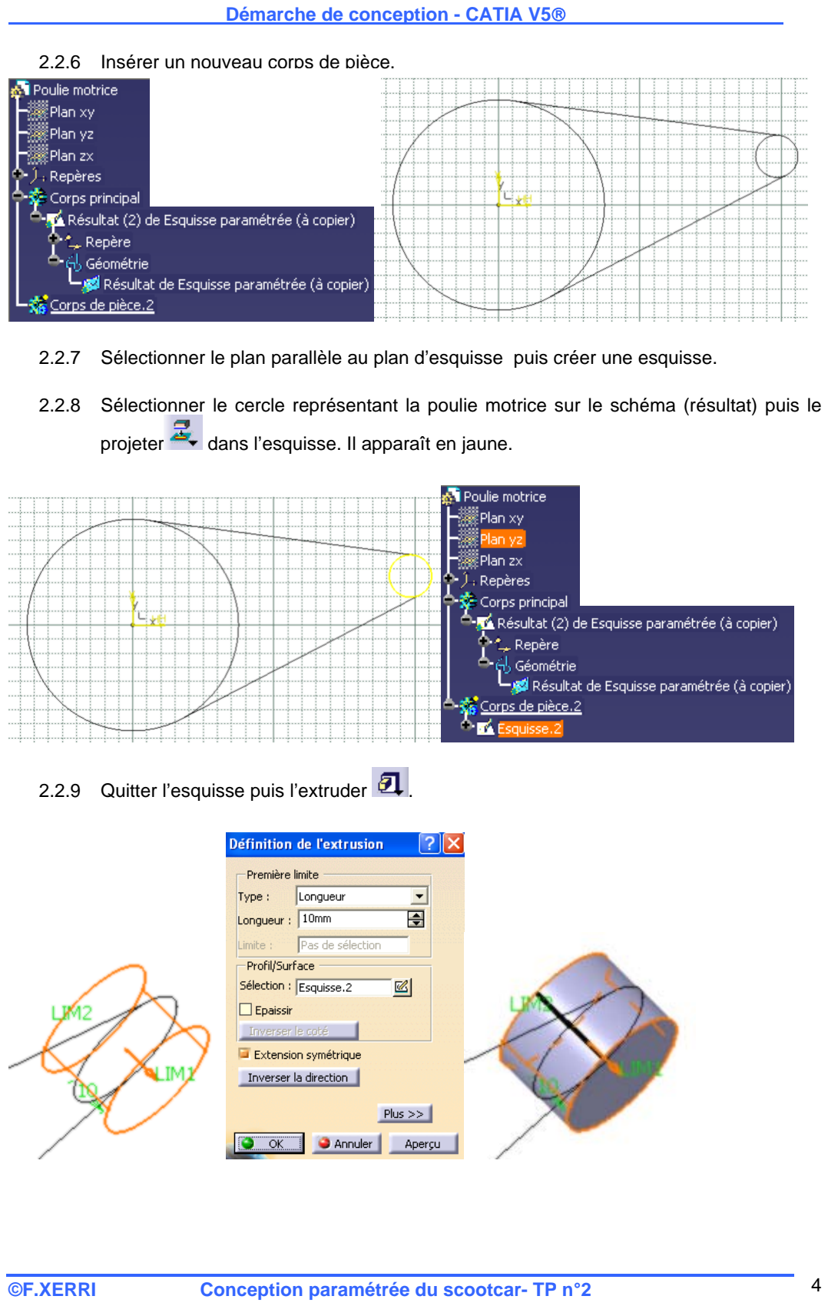
[picture p196: page 4]

2.2.6 Insérer un nouveau corps de pièce.

2.2.7 Sélectionner le plan parallèle au plan d’esquisse puis créer une esquisse.

2.2.8 Sélectionner le cercle représentant la poulie motrice sur le schéma (résultat) puis le

projeter | dans l’esquisse. Il apparaît en jaune.
2.2.9 Quitter l’esquisse puis l’extruder | .
©F.XERRI | Conception paramétrée du scootcar- TP n°2 | 4

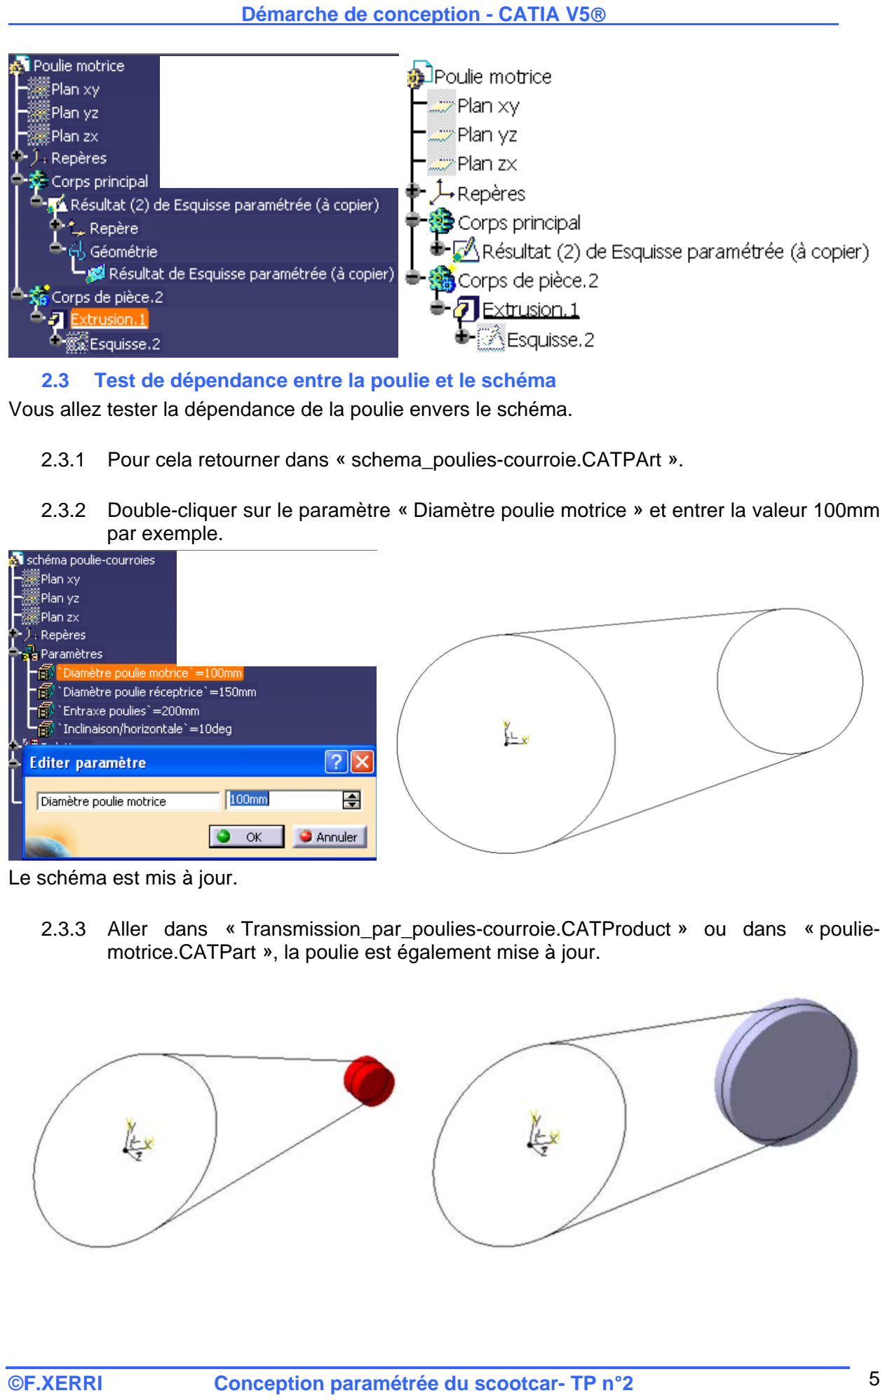
[picture p197: page 5]

### 2.3 Test de dépendance entre la poulie et le schéma

Vous allez tester la dépendance de la poulie envers le schéma.

2.3.1 Pour cela retourner dans « schema_poulies-courroie.CATPArt ».

2.3.2 Double-cliquer sur le paramètre « Diamètre poulie motrice » et entrer la valeur 100mm par exemple.

Le schéma est mis à jour.

2.3.3 Aller dans « Transmission_par_poulies-courroie.CATProduct » ou dans « poulie-motrice.CATPart », la poulie est également mise à jour.

©F.XERRI | Conception paramétrée du scootcar- TP n°2 | 5

### 2.4 Création des autres pièces : poulie réceptrice et courroie

2.4.1 Procéder de même . Reprendre la démarche en 2.2.1. Voir le TP1 pour l’extrusion de la courroie.
Voici le résultat que vous devez obtenir :

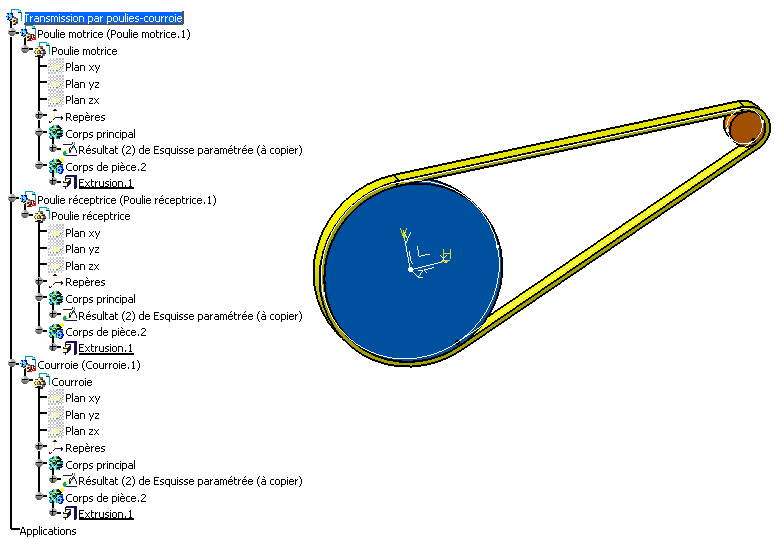
[picture p198: figure]

Pour information, vous pouvez voir les dépendances des fichiers en regardant dans FichierBureau. Les trois Part crées dépendent du schéma.

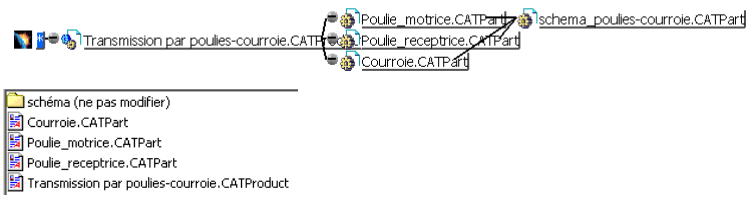
[picture p199: figure]

Conclusion :
Les trois pièces dépendent du fichier « schema_poulies-courroie.CATPArt » mais ce fichier n’apparaît pas comme pièce dans l’assemblage. Seule la copie de son esquisse en tant que résultat avec lien est visible dans le corps principal de chaque pièce.
Quand le chef de projet de la conception modifiera « schema_poulies-courroie.CATPArt », toutes les pièces dépendantes seront mises à jour d’où un gain de temps appréciable sans risque d’erreur de reconception.
©F.XERRI | Conception paramétrée du scootcar- TP n°2 | 6
