EOSCogniton/ELIZ-2022/02 - Documentation/Formation_Catia/TP3-conception-schéma_paramétrée-excel.pdf

Démarche de conception - CATIA V5®

## TP3 :modification d’une conception à partir d’une feuille de calcul Excel

Introduction :
Dans le TP précédent, le schéma est paramétré. Pour le modifier, il est nécessaire d’entrer les valeurs des paramètres.

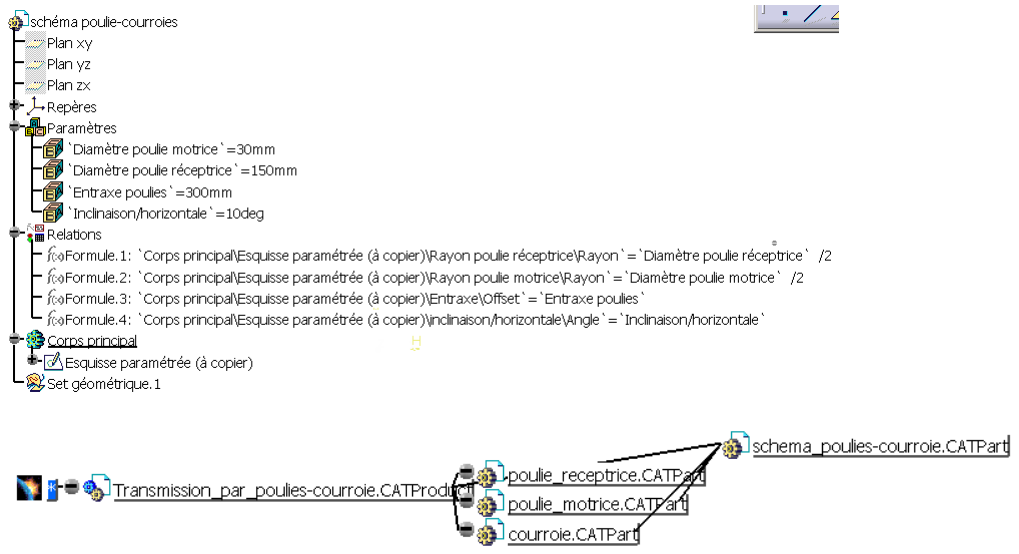
[picture p200: figure]

Dans le cas d’une transmission par poulies-courroie, l’entraxe définitif est imposé par le diamètre primitif des poulies et la longueur de courroie disponible (imposée par le fabricant). Nous allons utiliser un fichier Excel qui calculera cet entraxe définitif et mettra à jour les paramètres dans « schema_poulies-courroie.CATPArt ».
Quand le chef de projet de la conception utilisera le fichier Excel pour déterminer une transmission, le fichier « schema_poulies-courroie.CATPArt » et toutes les pièces dépendantes seront mis à jour. Objectifs :
- Créer une table de paramétrage (fichier Excel) à partir de paramètres existants .
- Lier une table de paramétrage à une feuille de calcul existante.

### 1 Etape n°1 : Création d’une table de paramétrage

### 1.1 Ouverture du fichier à paramétrer

Ouvrir « schema_poulies-courroie.CATPart dans le dossier « schéma(ne pas modifier) » :

©F.XERRI | Conception paramétrée du scootcar- TP n°3 | 1

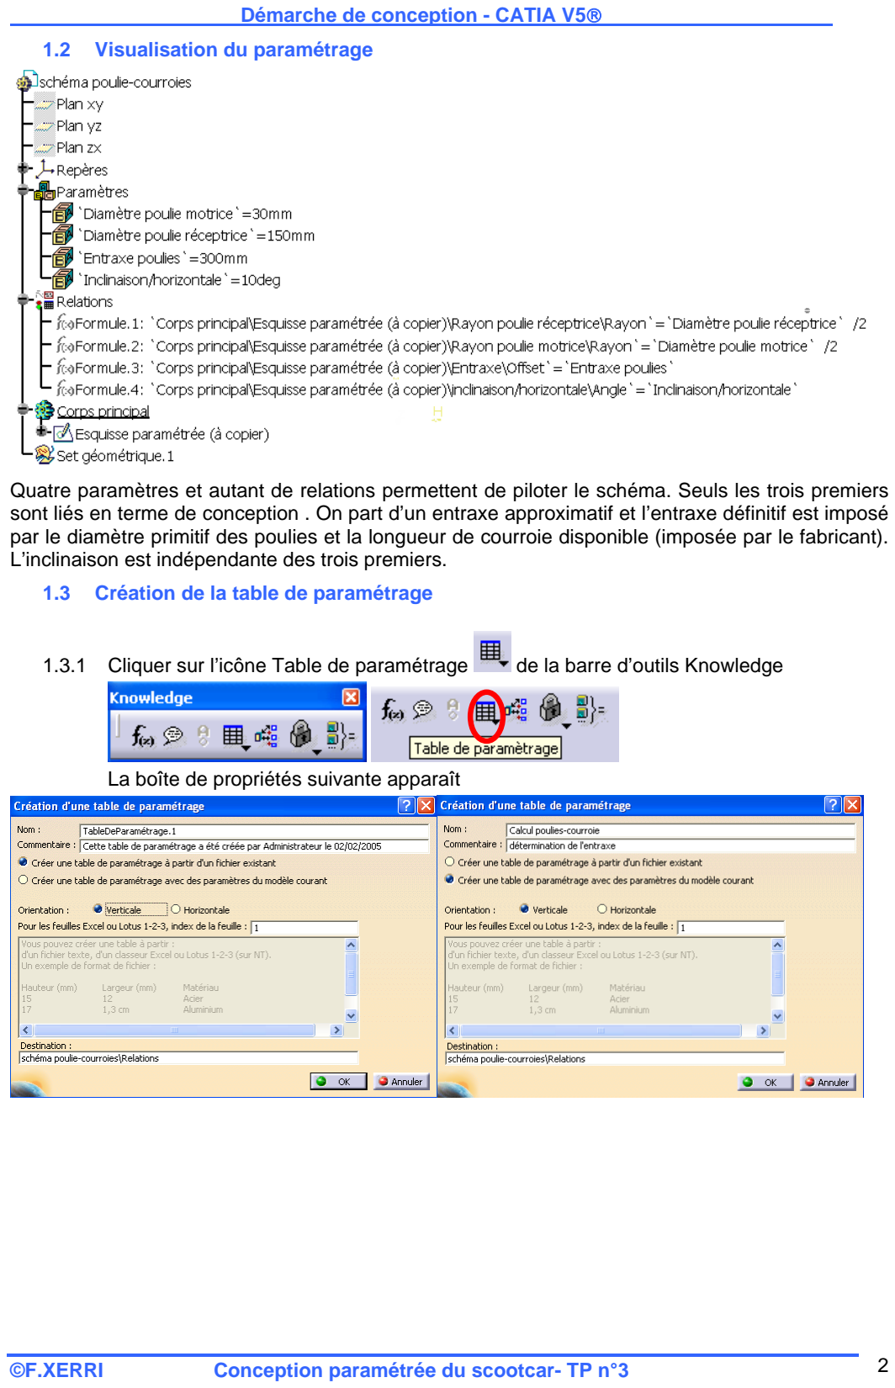
[picture p201: page 2]

### 1.2 Visualisation du paramétrage

Quatre paramètres et autant de relations permettent de piloter le schéma. Seuls les trois premiers sont liés en terme de conception . On part d’un entraxe approximatif et l’entraxe définitif est imposé par le diamètre primitif des poulies et la longueur de courroie disponible (imposée par le fabricant). L’inclinaison est indépendante des trois premiers.

### 1.3 Création de la table de paramétrage

1.3.1 Cliquer sur l’icône Table de paramétrage de la barre d’outils Knowledge

La boîte de propriétés suivante apparaît

©F.XERRI | Conception paramétrée du scootcar- TP n°3 | 2

1.3.2 Dans «Nom », remplacer « TableDeParmétrage.1 » par Calcul poulies-courroie

1.3.3 Dans « Commentaire », écrire « détermination de l'entraxe »

1.3.4 Cocher « Créer une table de paramétrage avec des paramètres du modèle courant »

1.3.5 Valider par « OK »

1.3.6 La boîte de propriétés suivante apparaît | Cliquer sur Paramètres dans l’arbre
pour | voir | apparaître | les | quatre
paramètres créés.

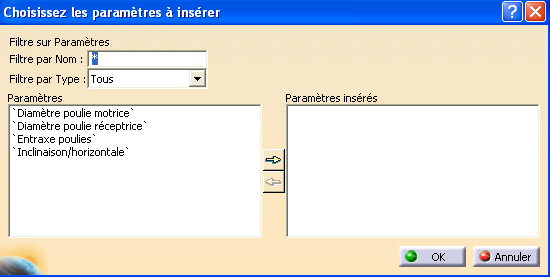
[picture p202: figure]

1.3.7 Sélectionner les trois premiers puis cliquer sur la flèche

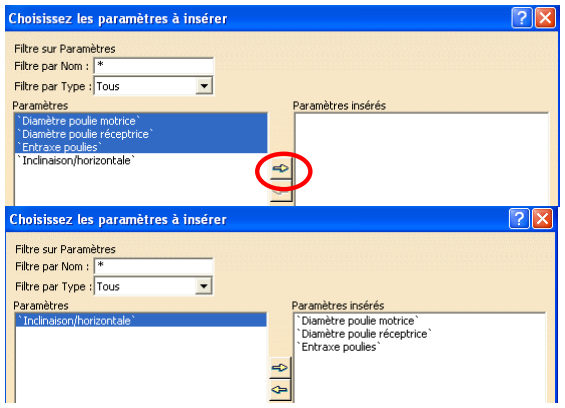
[picture p203: figure]

1.3.8 Cliquer sur OK.

1.3.9 La boîte « Enregister sous » apparaît et vous demande d’enregistrer le fichier Excel qui va être créer . Nommez-le « Calcul_poulies-courroie ».et enregistrez-le dans le dossier « schéma(ne pas modifier) »

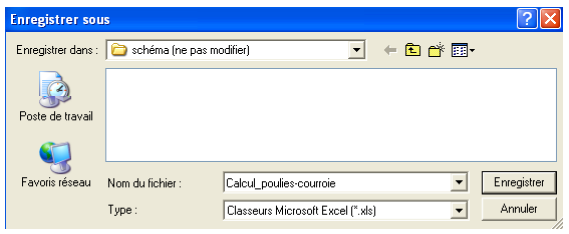
[picture p204: figure]

©F.XERRI | Conception paramétrée du scootcar- TP n°3 | 3

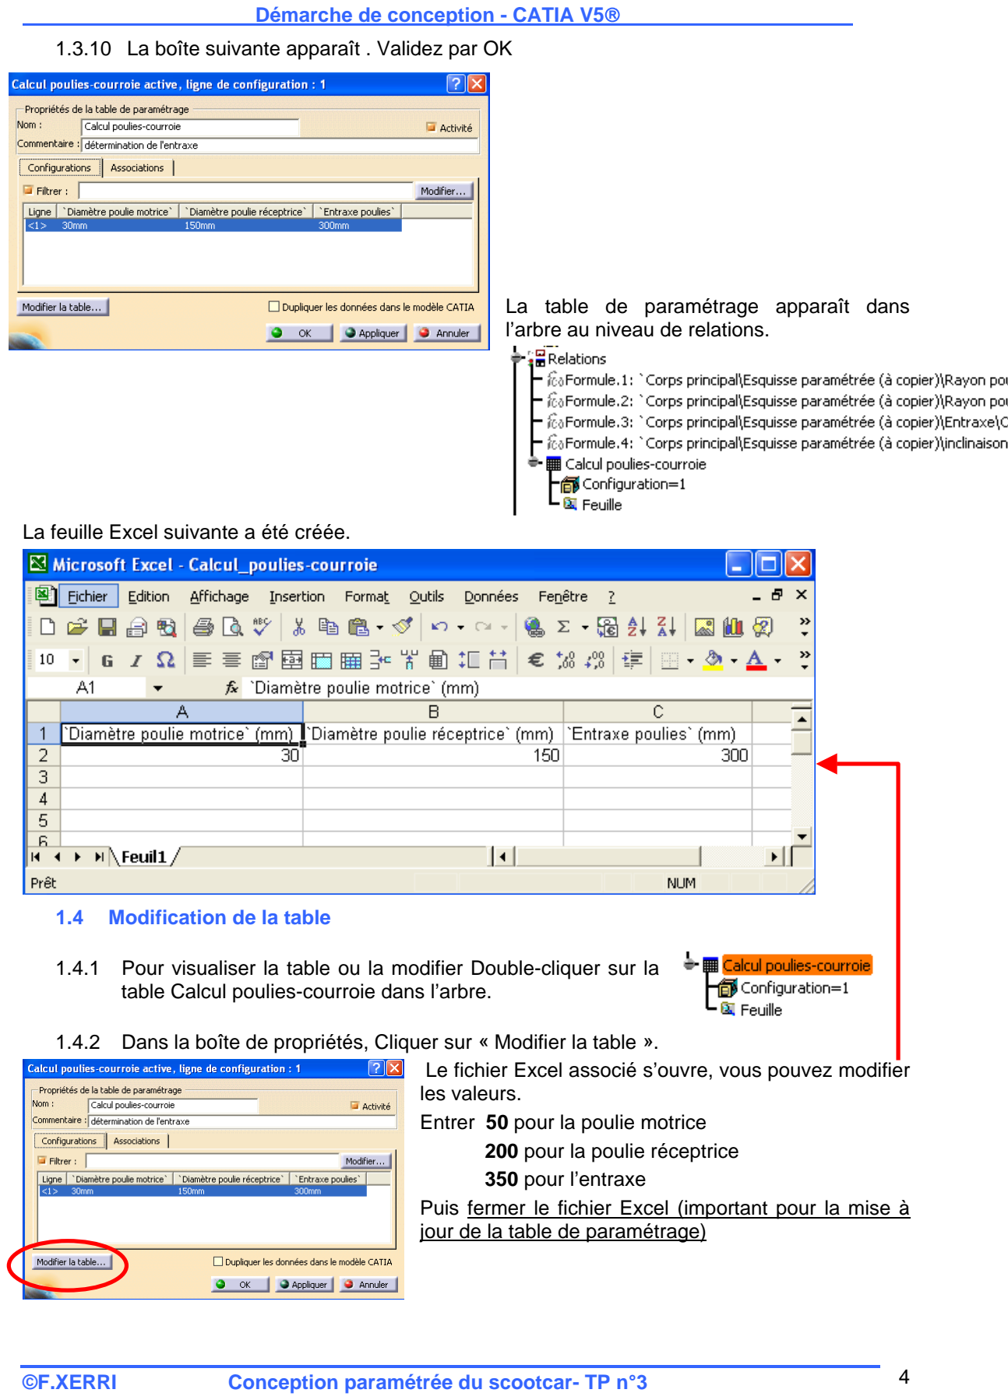
[picture p205: page 4]

1.3.10 La boîte suivante apparaît . Validez par OK

La table de paramétrage apparaît dans l’arbre au niveau de relations.

La feuille Excel suivante a été créée.

### 1.4 Modification de la table

1.4.1 Pour visualiser la table ou la modifier Double-cliquer sur la table Calcul poulies-courroie dans l’arbre.

1.4.2 Dans la boîte de propriétés, Cliquer sur « Modifier la table ». Le fichier Excel associé s’ouvre, vous pouvez modifier les valeurs.
Entrer 50 pour la poulie motrice
200 pour la poulie réceptrice
350 pour l’entraxe
Puis fermer le fichier Excel (important pour la mise à jour de la table de paramétrage)
©F.XERRI | Conception paramétrée du scootcar- TP n°3 | 4

La boîte de Messages suivante s’affiche.

1.4.3 Cliquer sur chaque message pour voir l’information associée. Les informations sont assez claires.

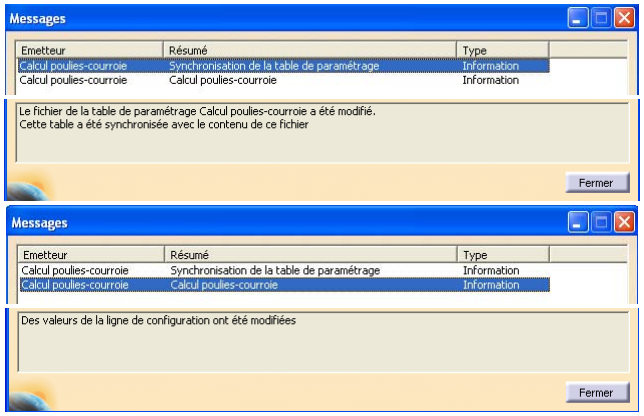
[picture p206: figure]

Les valeurs de la boîte de propriétés de la table ont été modifiées.

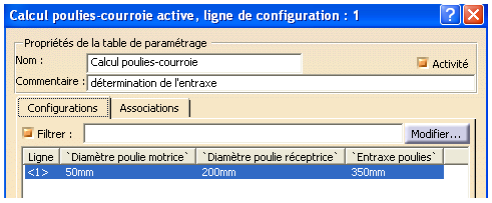
[picture p207: figure]

1.4.4 Cliquer sur Appliquer puis OK, le schéma est mis à jour.

### 2 Etape n°2 : Liaison avec une feuille de calcul existante

Rappel : l’entraxe est imposé par le diamètre primitif des poulies et la longueur de courroie disponible (imposée par le fabricant).
La valeur de l’entraxe de la table de paramétrage doit donc être calculée en fonction du diamètre primitif des poulies et de la longueur de courroie disponible. Pour cela , on utilise une feuille de calcul existante : « poulies-courroie-crantee.xls ».

### 2.1 Ouverture des fichiers Excel

2.1.1 Ouvrir « Calcul_poulies-courroie.xls » (feuille associée à la table de paramétrage).

2.1.2 Ouvrir « poulies-courroie-crantee.xls » (feuille de calcul avec formules).

©F.XERRI | Conception paramétrée du scootcar- TP n°3 | 5

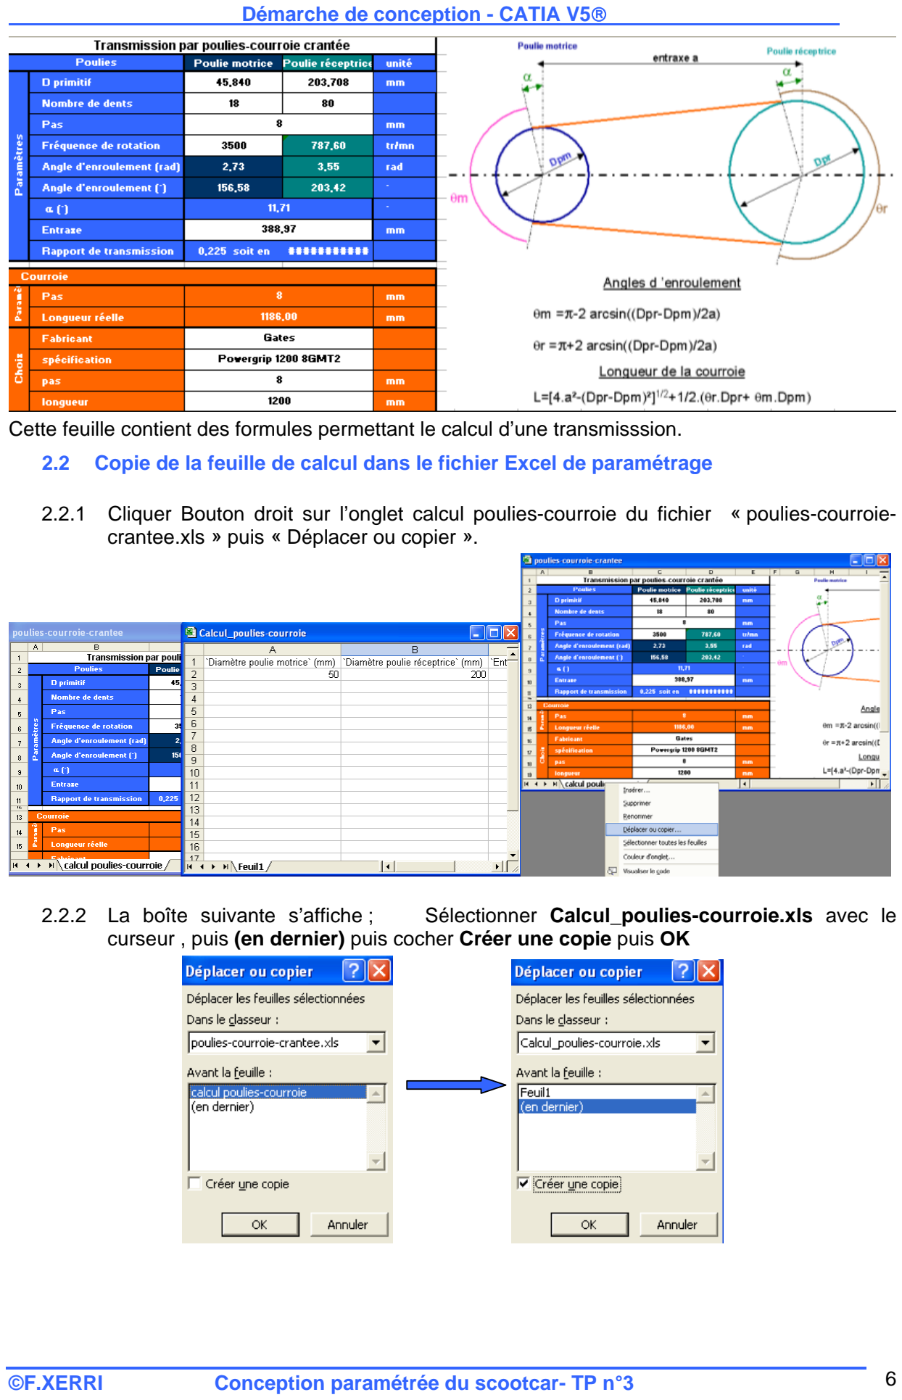
[picture p208: page 6]

Cette feuille contient des formules permettant le calcul d’une transmisssion.

### 2.2 Copie de la feuille de calcul dans le fichier Excel de paramétrage

2.2.1 Cliquer Bouton droit sur l’onglet calcul poulies-courroie du fichier « poulies-courroie-crantee.xls » puis « Déplacer ou copier ».

2.2.2 La boîte suivante s’affiche ; Sélectionner Calcul_poulies-courroie.xls avec le curseur , puis (en dernier) puis cocher Créer une copie puis OK

©F.XERRI | Conception paramétrée du scootcar- TP n°3 | 6

Le classeur « Calcul_poulies-courroie.xls » (associé à la table de paramétrage) contient maintenant deux feuilles :
- Feuil1 qui fait le lien vers la table de paramétrage Catia
- calcul poulies-courroie qui contient les formules de calcul

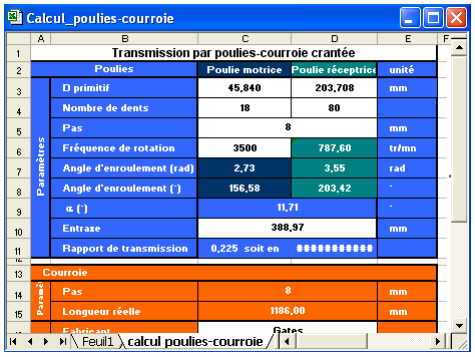
[picture p209: figure]

2.2.3 Enregistrer le fichier « Calcul_poulies-courroie.xls »

2.2.4 Fermer le fichier « poulies-courroie-crantee.xls »

### 2.3 Création de la liaison entre les deux feuilles

2.3.1 Cliquer sur Feuil1

2.3.2 Cliquer sur la cellule A2 qui contient la valeur du Diamètre primitif de la poulie motrice

2.3.3 Taper = puis cliquer sur la feuille calcul poulies-courroie puis sur la cellule C3 puis Entrée (au clavier)

La cellule A2 est maintenant liée par la formule « = Dp_m » à la cellule C3 (dont le nom est Dp_m).

©F.XERRI | Conception paramétrée du scootcar- TP n°3 | 7

2.3.4 Procéder de même avec le Diamètre primitif de la poulie réceptrice

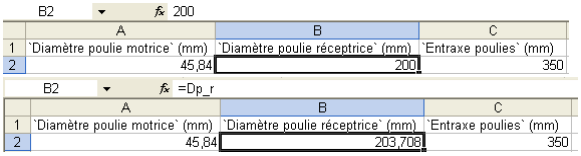
[picture p210: figure]

2.3.5 puis avec l’entraxe :

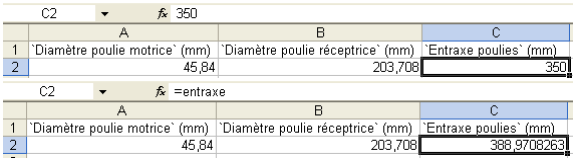
[picture p211: figure]

2.3.6 Enregistrer le fichier puis le fermer

2.3.7 Retourner dans la fenêtre Catia et Double-cliquer sur la table Calcul poulies-courroie dans l’arbre.

2.3.8 La table est synchronisée avec les valeurs du fichier Excel.

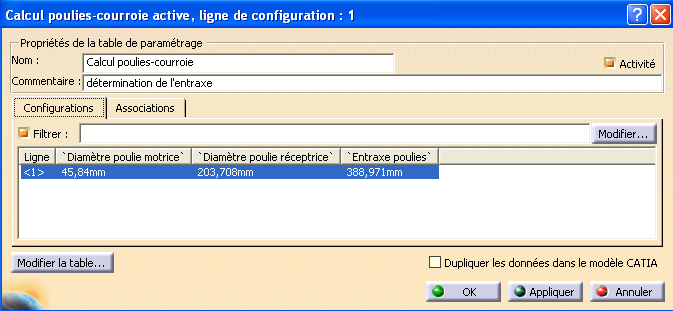
[picture p212: figure]

### 2.4 Calcul pour une courroie réelle

2.4.1 Ouvrir « Calcul_poulies-courroie.xls ».

2.4.2 Cliquer sur la feuille calcul poulies-courroie
Cliquer sur la cellule contenant la valeur de la longueur réelle de la courroie.

1186mm n’est pas une valeur du commerce.
Vous allez utiliser l’outil Valeur cible d’Excel pour calculer l’entraxe afin d’obtenir une valeur de 1200mm pour la longueur de courroie.
©F.XERRI | Conception paramétrée du scootcar- TP n°3 | 8

2.4.3 Cliquer sur Outils Valeur cible
Cellule à définir : cliquer sur la cellule C15 (qui contient la valeur 1186) Valeur à atteindre : entrer 1200
Cellule à modifier : Cliquer sur la valeur de l’entraxe cellule C10

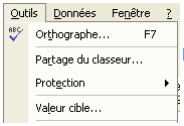
[picture p213: figure]

2.4.4 Puis OK

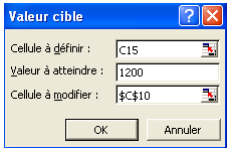
[picture p214: figure]

Un message s’affiche concernant le résultat du calcul, validez par OK

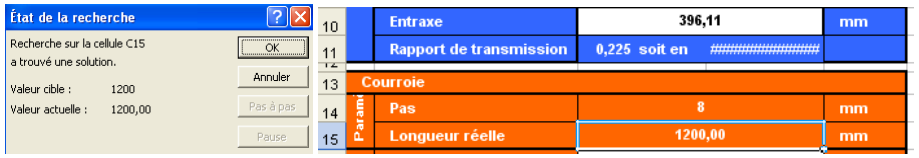
[picture p215: figure]

Le nouvel entraxe correspondant à une longueur de courroie de 1200mm est égal à 396,11 mm

2.4.5 Enregistrer le fichier puis le fermer

2.4.6 Retourner dans la fenêtre Catia et Double-cliquer sur la table Calcul poulies-courroie dans l’arbre.

2.4.7 La table est synchronisée avec les valeurs du fichier Excel.

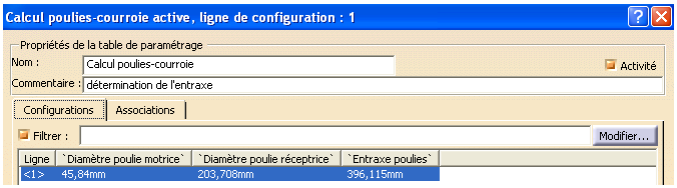
[picture p216: figure]

Conclusion :
Vous avez appris à créer une table de paramétrage liée à un fichier Excel, à lier cette table à une feuille de calcul Excel contenant des formules , à modifier une conception à partir d’un fichier Excel. Quand le chef de projet de la conception modifiera le fichier Excel « Calcul_poulies-courroie.xls ».le fichier « schema_poulies-courroie.CATPArt »et toutes les pièces dépendantes seront mises à jour d’où un gain de temps appréciable sans risque d’erreur de reconception.
©F.XERRI | Conception paramétrée du scootcar- TP n°3 | 9
