EOSCogniton/ELIZ-2022/02 - Documentation/CHASEA/Info chassis carbone/Devis_carrosserie_S2MA.pdf

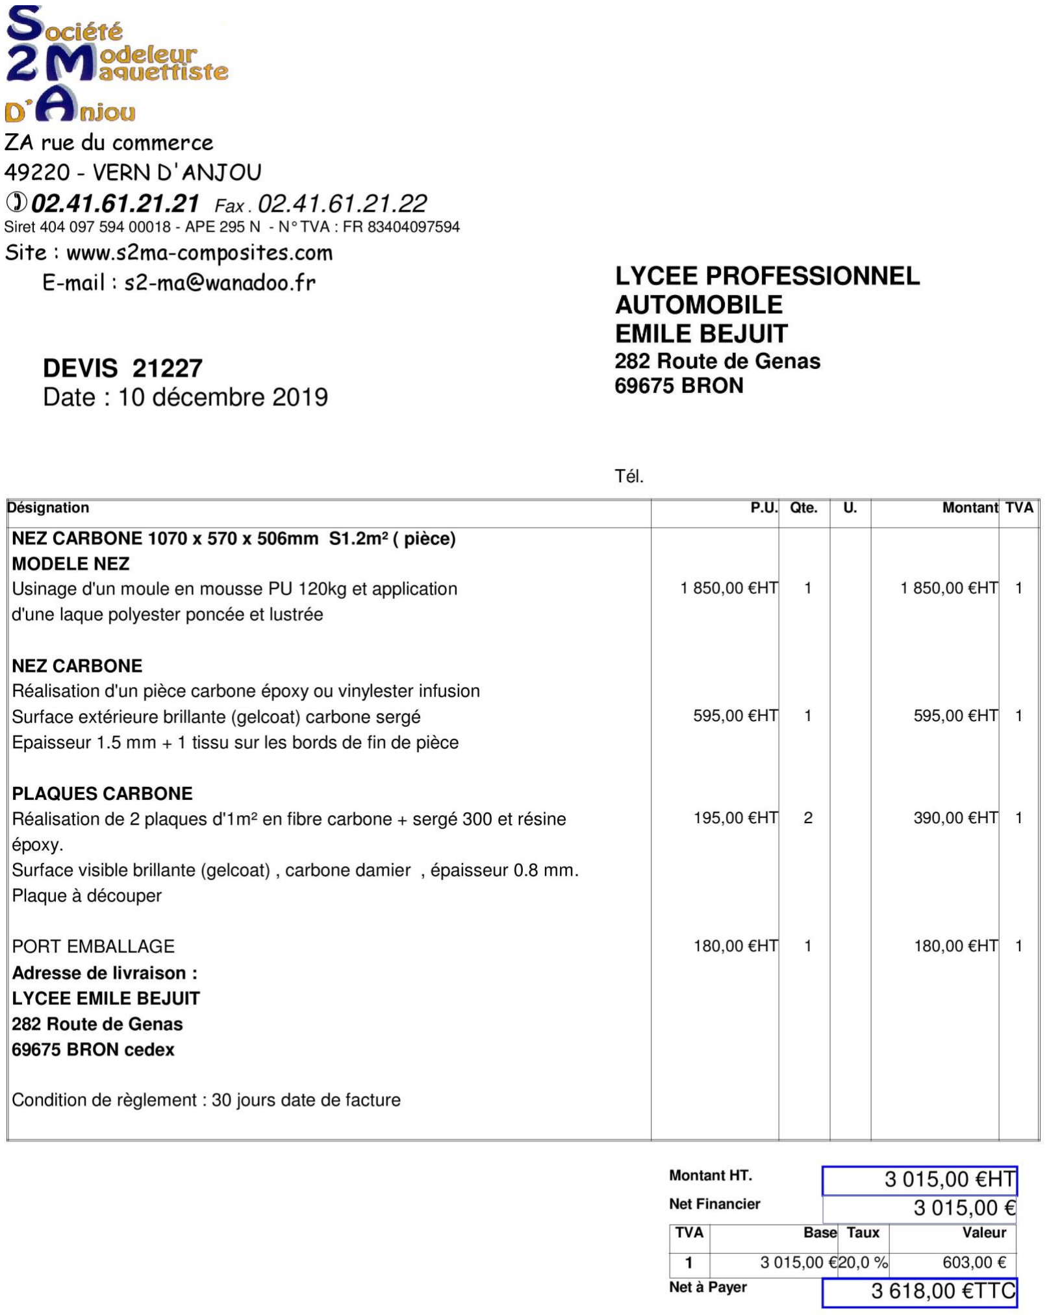
[picture p220: page 1]
