EOSCogniton/ELIZ-2022/01 - Maquette CATIA/EN_Engine_Drivetrain/EN_A0100 (Engine)/02_documents/Résistance-des-matériaux-Sections-usuelles.pdf

## Date de publication : 10 novembre 1987

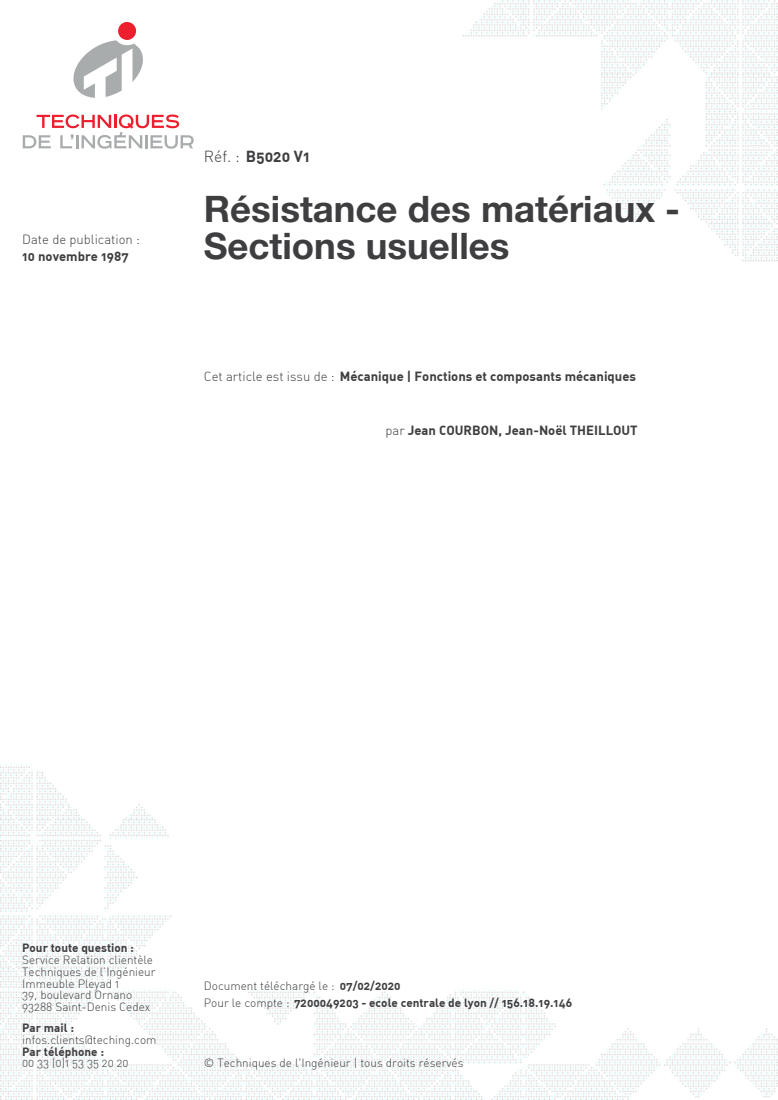
[picture p266: page 1]

Réf. : B5020 V1
Résistance des matériaux -
Sections usuelles

Cet article est issu de : Mécanique | Fonctions et composants mécaniques

par Jean COURBON, Jean-Noël THEILLOUT

Pour toute question :
Service Relation clientèle
Techniques de l’Ingénieur
Immeuble Pleyad 1
39, boulevard Ornano
93288 Saint-Denis Cedex
Par mail :
infos.clients@teching.com
Par téléphone :

Document téléchargé le : 07/02/2020
Pour le compte : 7200049203 - ecole centrale de lyon // 156.18.19.146

© Techniques de l'Ingénieur | tous droits réservés

Toute reproduction sans autorisation du Centre français d’exploitation du droit de copie
est strictement interdite. − © Techniques de l’Ingénieur | Form. B 5 020 − 1

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
# Résistance des matériaux

# Sections usuelles

### par Jean COURBON

Ingénieur Général Honoraire des Ponts et Chaussées
Professeur Honoraire à l’École Nationale des Ponts et Chaussées
M. COURBON étant décédé avant l’impression, ce formulaire a été mis au point

### par Jean-Noël THEILLOUT

Ingénieur au Laboratoire Central des Ponts et Chaussées, Section Fonctionnement des Structures

### ans cet article sont énoncées les caractéristiques géométriques puis les caractéristiques mécaniques de résistance des sections usuelles des pièces

suivant des hypothèses de base.

### Les caractéristiques mécaniques de résistance d’anneaux circulaires ou d’arcs

font l’objet d’un deuxième article [Form. B 5 021].

### Des articles du traité Structure et gros œuvre sont également consacrés à la résistance des matériaux des structures composées de poutres que l’on

rencontre dans presque tous les ouvrages de Génie civil.

Tableau 1 — Caractéristiques géométriques des sections | | Form. B 5 020-2
Tableau 2 — Contraintes de cisaillement dues à l’effort tranchant (déduites de la théorie de l’élasticité) | | — | 5
Tableau 3 — Contraintes de cisaillement et déformations dues à l’effort tranchant (formules approchées) | | — | 6
Tableau 4 — Contraintes de cisaillement et déformations dues à un moment de torsion (torsion gauche libre) (1) | | — | 8
Tableau 5 — Moments et effort tranchant dans une section en I soumise à une torsion (torsion gauche non libre) et à une flexion | | — | 10
Tableau 6 — Charge critique de flambement d’une barre à inertie constante, libre de fléchir transversalement entre ses extrémités (1) | | — | 11

D

Parution : novembre 1987 - Ce document a ete delivre pour le compte de 7200049203 - ecole centrale de lyon // 156.18.19.146 Ce document a ete delivre pour le compte de 7200049203 - ecole centrale de lyon // 156.18.19.146

tiwekacontentpdf_b5020 v1 | Ce document a ete delivre pour le compte de 7200049203 - ecole centrale de lyon // 156.18.19.146

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
Toute reproduction sans autorisation du Centre français d’exploitation du droit de copie Form. B 5 020 − 2 | est strictement interdite. − © Techniques de l’Ingénieur

RÉSISTANCE DES MATÉRIAUX ____________________________________________________________________________________________________________

(0)

### Tableau 1 – Caractéristiques géométriques des sections

Section

Centre de gravité | v a 2 = --v′ a 2 = -- | v a 2 = --v′ a 2 = -- | v h 2 = ---v′ h 2 = ---
Surface | S = a² | S a² a′ – 2 = | S = bh
Inertie polaire | a⁴ IG 6 = ----- | a⁴ a′ 4 – IG 6 = ------------------- | bh b² h² ( ) + IG 12 = --------------------------------
Inertie par rapport à un axe | a⁴ Ix1 3 = -----a⁴ Ix 12 = ------a⁴ Id 12 = ------ | a⁴ a′ 4 – Ix 12 = -------------------a⁴ a′ 4 – Id 12 = ------------------- | bh³ Ix1 3 = ----------bh³ Ix 12 = ----------b³h³ Id 6 b² h² ( ) + = ---------------------------
Module de résistance minimal | a³ µx 6 = -----a³ µd 62 = ---------- | a⁴ a′ 4 – µx 6a = -------------------a⁴ a′ a 72 -------------------4 – a⁴ a′ 4 – µd = -------------------6a 2 = | bh² µx 6 = ----------b²h² µd = ---------------------------6 b² h² +
Rayon de giration | a rx 12 = ----------a rd 12 = ---------- | a² a′ 2 + rx 12 -------------------- = a² a′ 2 + rd 12 -------------------- = | h rx 12 = ----------bh rd = -------------------------------6 b² h² ( ) +

Noyau central

Gα Gβ a
6 = = --

Gγ Gδ a
6 = = --

Gα Gβ a² a′
2 +
6a = = --------------------

Gγ Gδ a² a′
2 +
6a = = --------------------

Gα Gβ h
6 = = ---

Gγ Gδ b
6 = = ---

Parution : novembre 1987 - Ce document a ete delivre pour le compte de 7200049203 - ecole centrale de lyon // 156.18.19.146 Ce document a ete delivre pour le compte de 7200049203 - ecole centrale de lyon // 156.18.19.146

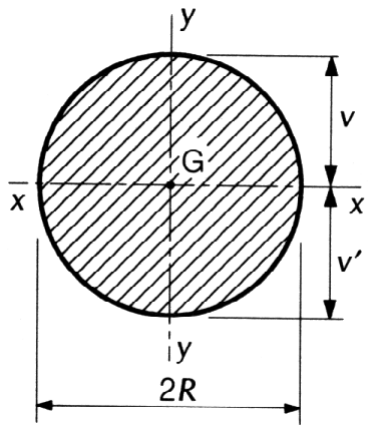
[picture p267: figure]
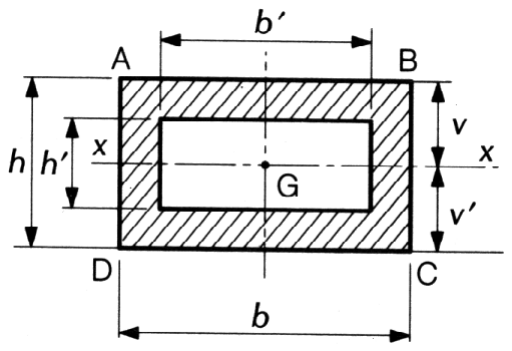
[picture p268: figure]

Toute reproduction sans autorisation du Centre français d’exploitation du droit de copie

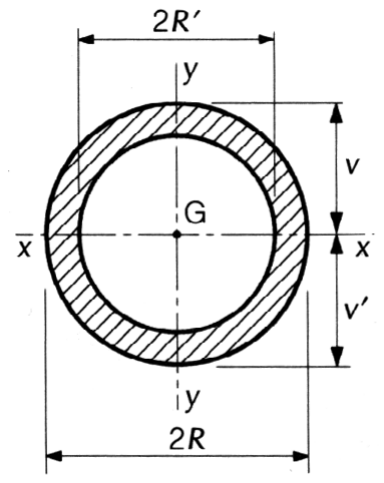
[picture p269: figure]

est strictement interdite. − © Techniques de l’Ingénieur | Form. B 5 020 − 3

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
___________________________________________________________________________________________________________ RÉSISTANCE DES MATÉRIAUX

Section

Centre de gravité | v h 2 = ---v′ h --- = 2 | v = R v′ = R | v = R v′ = R
Surface | S bh b = – ′h′ | S = π R² | S π R² R′ ( 2 = ) –
Inertie polaire | bh b² h² ( ) + b′h′ b′ ( 2 h′ 2 – ) + IG 12 = ------------------------------------------------------------------------------ | 1 -- πR⁴ = IG 2 | 1 IG -- π R⁴ R′ ( 4 = ) – 2
Inertie par rapport à un axe | bh³ b′h′ 3 – Ix 12 = ------------------------------ | 1 Ix -- πR⁴ = 4 1 Iy -- πR⁴ = 4 | π -- R⁴ R′ ( 4 = ) – Ix 4 π Iy -- R⁴ R′ ( 4 = ) – 4
Module de résistance minimal | bh³ b′h′ 3 – µx 6h = ------------------------------ | 1 µx -- πR³ = 4 µy 1 -- πR³ = 4 | π R⁴ R′ 4 ( ) – µx 4R = -----------------------------π R⁴ R′ 4 ( ) – µy 4R = -----------------------------
Rayon de giration | bh³ b′h′ 3 – rx 12( ) bh b– ′h′ ⁻⁻⁻⁻⁻⁻⁻⁻⁻⁻⁻⁻⁻⁻⁻⁻⁻⁻⁻⁻⁻⁻⁻⁻⁻⁻⁻⁻⁻⁻⁻⁻⁻⁻⁻⁻⁻ = | 1 rx 2 = -- R 1 ry 2 = -- R | 1 --R² R′ + 2 = rx 2 1 --R² R′ ry + 2 = 2

Noyau
central

Le noyau central est limité par un cercle de centre G et de rayon ρ :

Le noyau central est limité par un cercle de centre G et de rayon ρ :

### Tableau 1 – Caractéristiques géométriques des sections (suite)

Gα Gβ bh³ b′h′
3 –
6h bh b ( | ) – ′h′ = | = -------------------------------------
Gγ Gδ | hb³ h′b′
3 –
6b bh b ( | ) – ′h′ = | = -------------------------------------

ρ

1
4 = -- R | ρ

R² R′
2 +
4R = ---------------------

Parution : novembre 1987 - Ce document a ete delivre pour le compte de 7200049203 - ecole centrale de lyon // 156.18.19.146 Ce document a ete delivre pour le compte de 7200049203 - ecole centrale de lyon // 156.18.19.146

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
Toute reproduction sans autorisation du Centre français d’exploitation du droit de copie Form. B 5 020 − 4 | est strictement interdite. − © Techniques de l’Ingénieur

Section

Centre de gravité | v h² + ( ) be – ( ) 2he – 2( – = ----------------------------------------------------) hbe + v′ h² be e² + – 2( – = --------------------------------) hbe + | v 3( ) – e e² + 22( ) – e = ------------------------------------v′ ² ee² + – 22( ) – e = ------------------------------ | v hv = – ′ v′ 2h²eb′e1 2 + 22he b′e1 ( ) + = --------------------------------------
Surface | S = e(h + b − e) | S e = ( ) 2 – e | S 2he b′e1 = +
Inertie polaire | IG = Ix + Iy | IG = If + Id | IG = Ix + Iy
Inertie par rapport à un axe | e Ix1 -- h³ be² e³ = ( – ) + 3 Ix Ix1 Sv′ – 2 = e ------ b³ ( [ ) he – e² = ] + Iy 12 | 1 -- e ³ ( ) – e e² [ ] + – Sv′ 2 = Ix 3 ------ ⁴ ( 1 [ ) – e 4 = ] – If 12 Id If ²( ) – e 2e – 22( ) – e ----------------------------- = | 1 -- 2h³eb′e1 ( 3 = ) + Ix1 3 Ix Ix1 Sv′ – 2 = ------ hb³ 1 [ he1 ( ) – b′ 3 = ] – Iy 12
Module de résistance minimal | Ix µx v = ----eb³ ( ) he – e² [ ] + µy 6b = --------------------------------------------- | Ix µx v = ----If 2 µf = -----------Id µd v′ 2 = ------------ | Ix µx v = ----2Iy µy b = --------
Rayon de giration | Ix rx ---- = S Iy ry ---- = S | Ix rx ---- = S rf ² ( ) – e 2 + et Id 12 ------------------------------- = rd ---- = S | Ix rx ---- = S Iy ry ---- = S

Noyau
central
et | et | et

### Tableau 1 – Caractéristiques géométriques des sections (suite)

Gα | Ix
Sv′ = | G --------- | β

Ix
Sv = -------

Gγ Gδ

2Iy
Sb = | = --------
Gα | Id
Sv′ 2 = ----------------- | Gβ

Id
Sv 2 = ---------------

Gγ Gδ

If 2
S = | = -----------
Gα | Ix
Sv′ = | G --------- | β

Ix
Sv = -------

Gγ Gδ

2Iy
Sb = = --------

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

Toute reproduction sans autorisation du Centre français d’exploitation du droit de copie
est strictement interdite. − © Techniques de l’Ingénieur | Form. B 5 020 − 5

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
___________________________________________________________________________________________________________ RÉSISTANCE DES MATÉRIAUX

(0)
Tableau 2 – Contraintes de cisaillement dues à l’effort tranchant (déduites de la théorie de l’élasticité)

Les valeurs des contraintes de cisaillement, déduites de la théorie de l’élasticité, sont données dans le tableau ci-après pour les sections circulaire et rectangulaire. Elles ont été établies à partir des hypothèses suivantes (Gy et Gz étant les axes principaux d’inertie de la section de la pièce).
- La pièce est à section constante.
Dans le cas où la pièce est à section variable, il faut faire intervenir la notion d’effort tranchant réduit.
- La résultante T (élément de réduction de l’effort tranchant dans la section) est portée par Gy. Dans le cas où la résultante T est inclinée par rapport aux axes Gy et Gz, on décomposera T en 2 composantes

Ty et Tz suivant Gy et Gz. On fera le calcul des contraintes séparément sous l’action de Ty et Tz. Les contraintes totales s’obtiendront par application du principe de superposition.
- L’axe Gy est l’axe de symétrie de la section.
Dans le cas où Gy n’est pas axe de symétrie, il faut faire intervenir la notion de centre de cisaillement.
Les formules données dans ce tableau permettront en particulier de comparer les formules exactes ci-après avec les formules approchées, données dans le tableau 3.

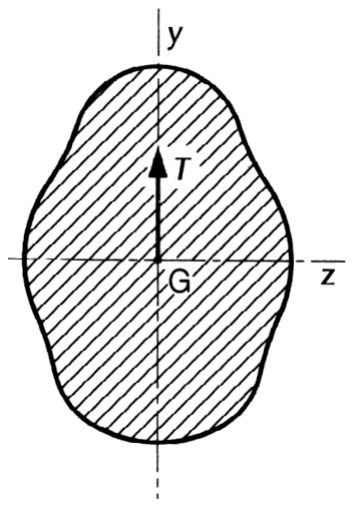
[picture p270: figure]

Section | Valeurs générales | Valeurs particulières
| 41( 12 + ν ) + ν ⁻⁻⁻⁻⁻⁻⁻⁻⁻⁻⁻⁻⁻⁻⁻⁻⁻⁻⁻⁻⁻ T --- = – yz τ2 I ν coefficient de Poisson I moment d’inertie par rapport à Gz | en G : 32 + ν 21( ) + ν ⁻⁻⁻⁻⁻⁻⁻⁻⁻⁻⁻⁻⁻⁻⁻⁻⁻⁻⁻⁻⁻ T --- = τ3 S en A et B : 12 + ν 1 + ν ⁻⁻⁻⁻⁻⁻⁻⁻⁻⁻⁻⁻⁻⁻⁻⁻ T --- = τ3 S

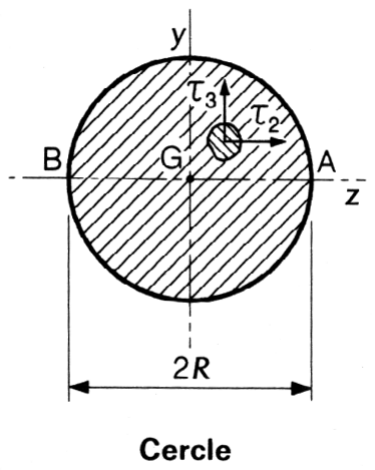
[picture p271: figure]

Rectangle | τ3 3T 3T τ3 ------- k1 = ------- k2 = 2S 2S Point G Points A et B τ2 = 0 τ2 = 0 Les coefficients k1 et k2 sont fonction de ν et du rapport a/b ; les valeurs données dans la table ci-après correspondent à ν = 0,25.

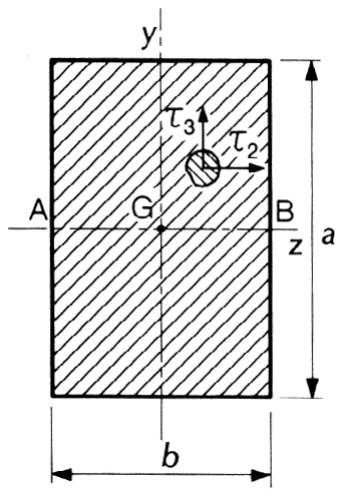
[picture p272: figure]

a/b | k1 | k2 | a/b | k1 | k2 | b/a | k1 | k2 | b/a | k1 | k2
0 | 0,800 | ∞ | 0,6 | 0,879 | 1,301 | 0 | 1 | 1 | 0,6 | 0,976 | 1,048
0,1 | 0,800 | 3,770 | 0,7 | 0,899 | 1,235 | 0,1 | 0,999 | 1,001 | 0,7 | 0,968 | 1,064
0,2 | 0,801 | 2,285 | 0,8 | 0,916 | 1,188 | 0,2 | 0,997 | 1,005 | 0,8 | 0,959 | 1,083
0,3 | 0,811 | 1,790 | 0,9 | 0,929 | 1,153 | 0,3 | 0,994 | 1,012 | 0,9 | 0,950 | 1,104
0,4 | 0,832 | 1,543 | 1 | 0,940 | 1,126 | 0,4 | 0,989 | 1,021 | 1 | 0,940 | 1,126
0,5 | 0,856 | 1,396 | | | | 0,5 | 0,983 | 1,033

τ3

32 + ν
81( | ) + ν ⁻⁻⁻⁻⁻⁻⁻⁻⁻⁻⁻⁻⁻⁻⁻⁻⁻⁻⁻⁻⁻ T I
--- | R² y² – | 12 – ν
32 + ν ⁻⁻⁻⁻⁻⁻⁻⁻⁻⁻⁻⁻⁻⁻⁻⁻ z² = | –

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
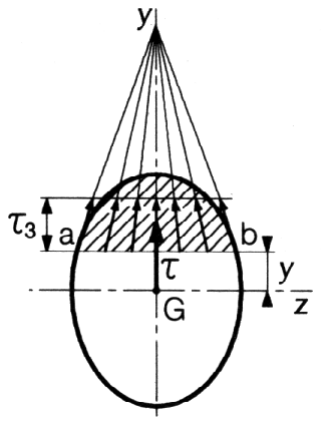
[picture p273: figure]

Toute reproduction sans autorisation du Centre français d’exploitation du droit de copie Form. B 5 020 − 6 | est strictement interdite. − © Techniques de l’Ingénieur

(0)
Tableau 3 – Contraintes de cisaillement et déformations dues à l’effort tranchant (formules approchées)

Les formules approchées, donnant pour les sections usuelles les valeurs des contraintes de cisaillement et la valeur de la section réduite S1 (intervenant dans le calcul des déformations), ont été déterminées à partir des hypothèses mentionnées dans le tableau 2 et des hypothèses

supplémentaires suivantes.

- Cas des sections pleines. | • Cas des sections minces (fermées ou ouvertes).

Le long d’une ligne parallèle à l’axe d’inertie Gz d’ordonnée y, coupant le contour de la section aux deux points a et b :
— les contraintes de cisaillement τ passent toutes par le point de concours des deux tangentes en a et b au contour de la section ;
— la composante τ3 suivant Gy des contraintes de cisaillement τ est constante.

La contrainte de cisaillement est tangente en chaque point à la ligne moyenne du profil.

Section | Contrainte de cisaillement | Déformation
Hypothèses | Valeur générale | Contrainte maximale | Diagramme | S1
| | S = bh | | | 3 -- T S = ---2 pour y = 0 | 5 -- S 6
a′ = ka (avec k < 1) | | | | | --- 1 kk² ++ 3 -- T 1 k² + ------------------------ = τ3 2 S pour mm (y = 0)

τ3

3
2

-- T
S
--- | 1 4y²
h² = | – --------- | τ3

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

Toute reproduction sans autorisation du Centre français d’exploitation du droit de copie
est strictement interdite. − © Techniques de l’Ingénieur | Form. B 5 020 − 7

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
___________________________________________________________________________________________________________ | RÉSISTANCE DES MATÉRIAUX
Section | | Contrainte de cisaillement | | Déformation
Hypothèses | Valeur générale | Contrainte maximale | Diagramme | S1
| | 4 -- T --- 1 y² R² – ------ = τ3 3 S A 4 -- T ---1 y² τ en – ------R² = 3 S S = π R² | 4 -- T τ3 S = ---3 le long de CD | | 9 ------ S 10
| | 6Te h e ( ) – τ1 3 – = ---------------------------------------------bh³ ( ) bb– ′ h′ b τ2 τ1 b′ = -----b′h --------- b bb ( ) – ′ ( ) h′ ⁄ h 2 – 3 --T τ3 b --------------------------------------------------bb ( ) – ′ ( ) h′ ⁄ h 3 – = 2 | τmax = τ3
| | 2T τM S = ------- cos ϕ S = 2 π Re | τA τB 2T = -------S = | | 0,5S

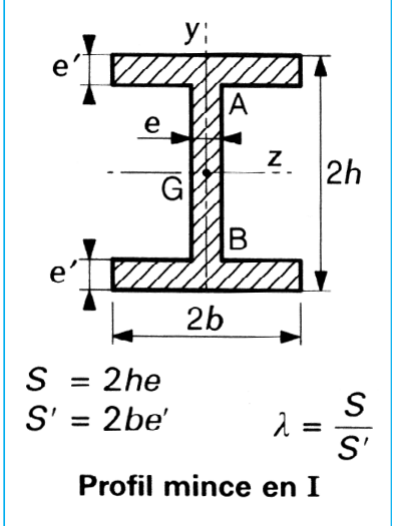
[picture p274: figure]

| | T τ 2 aile ( ) I = --- ( ) bz – h | T τ 2A() I = --- bh ---T 1 τ 3A() τ 3B() = = -------------1 λ S 6 + --1 λ 4 + --T τ 3G() = ----------------S 1 λ 6 + -- | | 2he

Tableau 3 – Contraintes de cisaillement et déformations dues à l’effort tranchant (formules approchées) (suite)

τ 3 âme ( )

T
I
--- | 2be′h | e
| | 2
-- h² y² = | + | ( | ) –

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

R
M

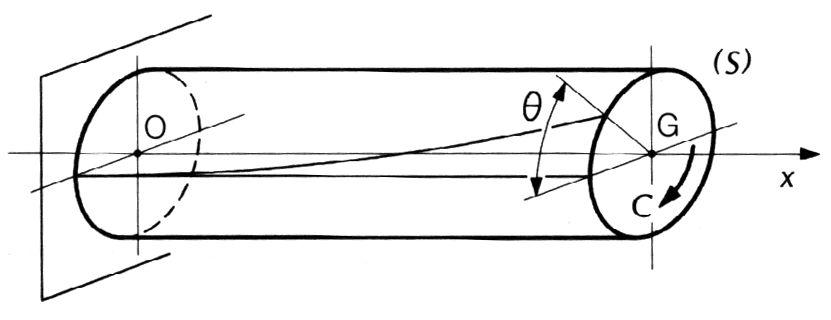
[picture p275: figure]

U
L
A
I
R
E
Toute reproduction sans autorisation du Centre français d’exploitation du droit de copie Form. B 5 020 − 8 | est strictement interdite. − © Techniques de l’Ingénieur

(0)
Tableau 4 – Contraintes de cisaillement et déformations dues à un moment de torsion (torsion gauche libre) (1)

Contraintes de cisaillement Les formules donnant les contraintes de cisaillement dans les pièces de section usuelle soumises à un moment de torsion C ont été déterminées dans les hypothèses suivantes :
— la pièce est rectiligne et de section constante ;
— au cours de la déformation, les sections ne restent pas planes et sont libres de gauchir (torsion gauche libre).
Déformation
Dans les mêmes hypothèses que précédemment, si θ est l’angle de rotation de la section d’abscisse x, on a :

(G module d’élasticité transversale).

La valeur de K, module d’inertie à la torsion de la pièce, est donnée dans le tableau ci-après pour les sections usuelles.
Section | Contrainte de cisaillement | Déformation
Direction des contraintes | Valeur générale | Contrainte maximale | Valeur de K
| | C Ga³b dθ C ------- k1 = – τmax et k2a²b = ----------------(a < b) dx
b/a | k1 | k2 | b/a | k1 | k2 | b/a | k1 | k2
1 1,1 1,2 1,3 1,4 1,5 1,6 1,7 1,8 | 0,140 6 0,154 0 0,165 1 0,177 1 0,186 9 0,195 8 0,203 7 0,210 9 0,217 4 | 0,208 2 0,213 9 0,218 9 0,223 4 0,227 3 0,231 0 0,234 3 0,237 5 0,240 4 | 1,9 2 2,2 2,4 2,6 2,8 3 3,5 4 | 0,223 3 0,228 7 0,238 0 0,245 9 0,252 6 0,258 3 0,263 3 0,273 3 0,280 8 | 0,243 2 0,245 9 0,250 9 0,255 4 0,259 7 0,263 6 0,267 2 0,275 1 0,281 7 | 4,5 5 6 7 8 9 10 20 ∞ | 0,286 6 0,291 3 0,298 3 0,303 3 0,307 1 0,310 0 0,312 3 0,322 8 1/3 | 0,287 0 0,291 5 0,298 4 0,303 3 0,307 1 0,310 0 0,312 3 0,322 8 1/3
| C τmax 0 217 , () Sd = ----------------------------S aire de la section S 1 -- d² = 3 2 | K = 0,133d²S
| C τmax 0 223 , × Sd × = -----------------------------------S aire de la section S 2 21 ( ) – d² = | K = 0,130d²S
τ Cr K = ------K inertie polaire | πR³ = ----------τmax 2C | K πR⁴ 2 = ----------

K inertie polaire

(1) Dans le cas où les sections de la pièce ne sont plus libres de se gauchir, il faut tenir compte (plus particulièrement pour les sections ouvertes à paroi mince) des phénomènes de torsion-flexion qui ont une influence importante sur la distribution des contraintes dans la pièce. L’exemple donné dans le tableau 5 per-mettra de se rendre compte de cette influence.

dθ

dx

------- C GK = – --------

τ Cr
K = ------ | τmax

2CR
π R⁴ R1
4 ( | ) –
= ---------------------------- | K | π R⁴ R1
4 ( | ) –
| | 2 = ----------------------------

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

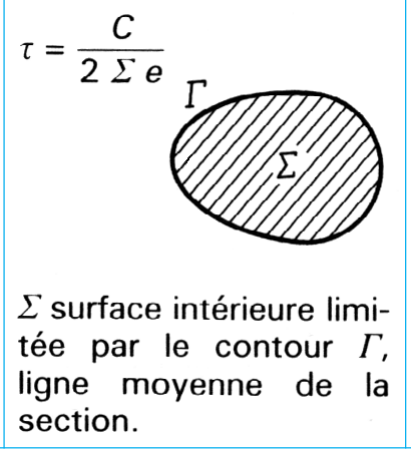
[picture p276: figure]
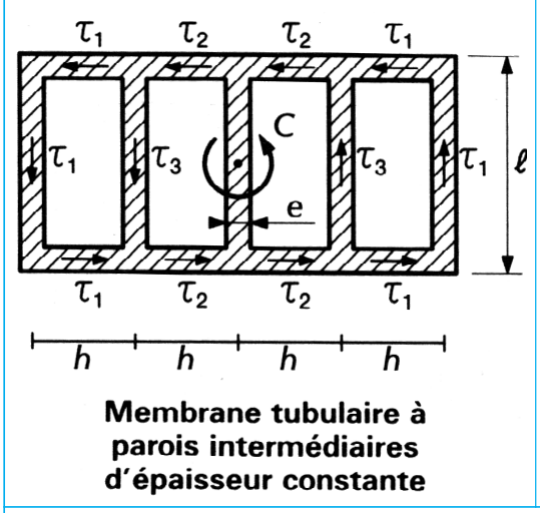
[picture p277: figure]

Toute reproduction sans autorisation du Centre français d’exploitation du droit de copie
est strictement interdite. − © Techniques de l’Ingénieur | Form. B 5 020 − 9

R
M

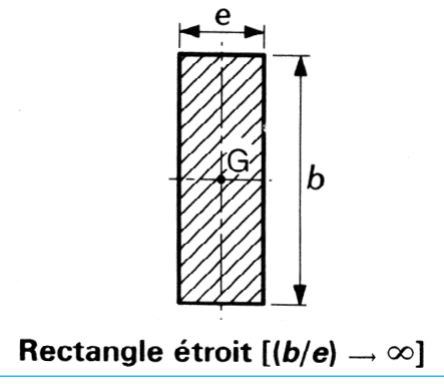
[picture p278: figure]

U
L
A
I
R
E
___________________________________________________________________________________________________________ | RÉSISTANCE DES MATÉRIAUX
| 3C τmax be² = ---------le long des grands côtés | K 1 -- be³ = 3
| ( 3C ) 2ae – e² = ---------------------------τmax | 1 -- 2( ) ae – e³ 3
| 3Ce1 τmax 3 + = ------------------------------------b1e1 3 2b2e2 on suppose e1 < e2 | b1e1 3 2b2e2 3 + 3 ------------------------------------
| Formules identiques aux ailes parallèles dans lesquelles on remplace : 3 1 -- e2 e3 ( ) + e2 2 ( ) + e2 par 2 e3 4
e faible et la variation de e dans la section n’est pas brusque. Section tubulaire mince | | 4Σ² -------------∫ d ------e Γ
On obtient τ1, τ2, τ3 et | en résolvant les quatre équations :

## τ3 = τ1 − τ2

Tableau 4 – Contraintes de cisaillement et déformations dues à un moment de torsion (torsion gauche libre) (1) (suite)

(1) Dans le cas où les sections de la pièce ne sont plus libres de se gauchir, il faut tenir compte (plus particulièrement pour les sections ouvertes à paroi mince) des phénomènes de torsion-flexion qui ont une influence importante sur la distribution des contraintes dans la pièce. L’exemple donné dans le tableau 5 per-mettra de se rendre compte de cette influence.

ϕ

dθ
dx = -------
( | ) + 2h τ1e e τ1 | τ2 + | 2 ( | ) – | = – Ghϕ
2hτ2e e τ2 | τ1 + | 2 ( | ) – | = – Ghϕ
C | 4he τ1 | τ2 = | ( | ) +

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

R
M
U
L
A
I

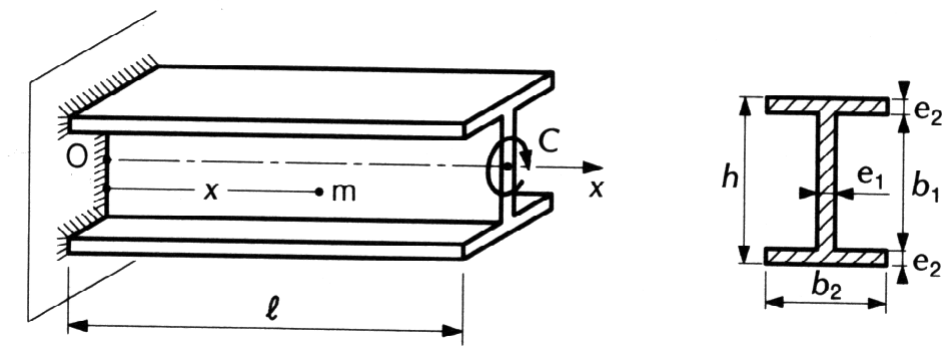
[picture p279: figure]

R
E

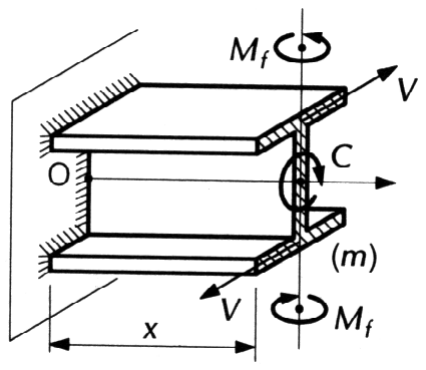
[picture p280: figure]
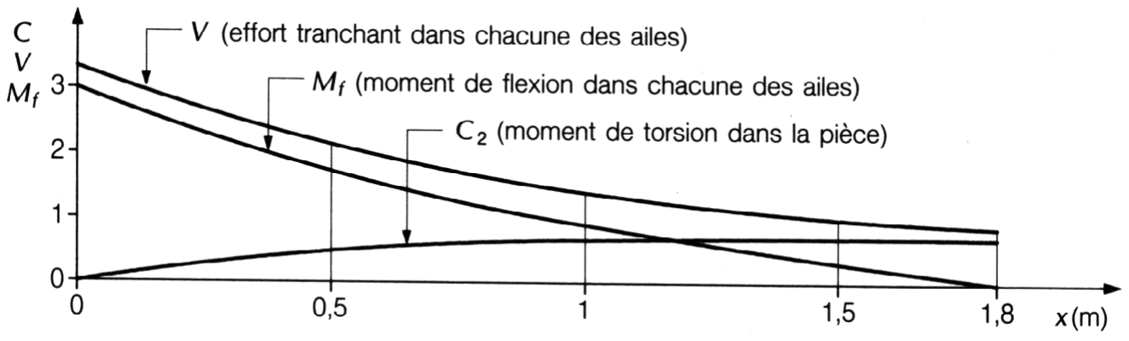
[picture p281: figure]

Toute reproduction sans autorisation du Centre français d’exploitation du droit de copie Form. B 5 020 − 10 | est strictement interdite. − © Techniques de l’Ingénieur

(0)

Tableau 5 – Moments et effort tranchant dans une section en I soumise à une torsion (torsion gauche non libre)

### et à une flexion

Étudions une poutre en I, encastrée à une extrémité et soumise à son extrémité libre à un moment de torsion C.

- Caractéristiques de la pièce

On pose :

EJ rigidité à la flexion d’une aile :

GK rigidité à la torsion de la poutre :

- Éléments de réduction dans une section m d’abscisse x Moment de flexion dans chacune des ailes :

Moment de torsion dans la pièce :

Effort tranchant dans chacune des ailes :

- Exemple :
poutre I 300, | : C = 1 t.
m.

a² EJh²
2GK = -------------

J e2b2

3
12 = ------------

K

b1e1

3 2b2e2

3 +
3 = ------------------------------------

Mf

a
h

--- C

sh – x
a

ch
a

= | -------------------------
C2 | C | 1

ch – x
a

ch
a

= | – -------------------------
V | C
| h

ch – x
a ----------- | |

ch
a

= – -------------------------

= 180 cm

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

Toute reproduction sans autorisation du Centre français d’exploitation du droit de copie
est strictement interdite. − © Techniques de l’Ingénieur | Form. B 5 020 − 11

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
___________________________________________________________________________________________________________ RÉSISTANCE DES MATÉRIAUX

(0)
Tableau 6 – Charge critique de flambement d’une barre à inertie constante, libre de fléchir transversalement

### entre ses extrémités (1)

Caractéristiques de la pièce
Cas de charges

Charge critique de flambement Fc (sans tenir compte des déformations dues à l’effort tranchant)

u | π /2 | 1,655 1 | 1,718 6 | 1,768 1 | 1,807 8 | 1,909 6
(1) E module d’élasticité longitudinale, | I moment d’inertie de la section transversale, | longueur de la pièce.
| π²EI ( 2 --------------------------) 1 122 , 7 837 EI () q c = , -----² =
| π²EI ² ⁻⁻⁻⁻⁻⁻⁻⁻⁻⁻⁻⁻ q – ------2 ≈ Fc (valeur approchée)
| π²EI () 2 2 = -------------- 03 – , q Fc (valeur approchée)
| ² ⁻⁻⁻⁻⁻⁻⁻⁻⁻⁻⁻⁻⁻⁻⁻⁻ π²EI --π 4u²EI = ------------L² = L P1 P2 ( ) + c et 2u = ------- P1 P2 + Si l’on pose β , u est la plus petite racine positive de l’équation : = ------------------P1 u β ------- cot u + u u cot ( ) β – 1 2 β + 1 = -------------------β
P1 P2 + ------------------P1 | 1 | 1,25 | 1,5 | 1,75 | 2 | 3
L ⁄ | 1 | 0,949 | 0,914 | 0,888 | 0,869 | 0,823

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
Toute reproduction sans autorisation du Centre français d’exploitation du droit de copie Form. B 5 020 − 12 | est strictement interdite. − © Techniques de l’Ingénieur

Poutre encastrée élastiquement à ses extrémités. Les rotations ω0 et ω1 des extrémités de la poutre sont proportionnelles aux moments M0 et M1 d’encastrement :

β0 et β1 étant des nombres positifs sans dimension ; β = 0 correspond à un encastrement, et β = ∞ correspond à une articulation. L’effort normal critique a pour valeur :

C étant un coefficient dépendant de β0 et β1 dont la valeur est donnée par le tableau suivant.
β0 β1 | 0 | 0,1 | 0,2 | 0,5 | 1 | 2 | 5 | 10 | 20 | 50 | ∞
0 0,1 0,2 0,5 1 2 5 10 20 50 ∞ | 39,478 38,199 37,004 33,981 30,550 26,958 23,452 21,933 21,092 20,559 20,191 | 38,199 36,981 35,841 32,950 29,647 26,166 22,745 21,257 20,431 19,907 19,546 | 37,004 35,841 34,752 31,984 28,804 25,429 22,092 20,635 19,825 19,311 18,955 | 33,981 32,950 31,984 29,517 26,648 23,554 20,495 19,073 18,307 17,819 17,482 | 30,550 29,647 28,804 26,648 24,121 21,353 18,521 17,250 16,545 16,091 15,777 | 26,958 26,166 25,429 23,554 21,353 18,916 16,382 15,236 14,589 14,174 13,886 | 23,452 22,745 22,092 20,495 18,521 16,382 14,134 13,107 12,523 12,148 11,887 | 21,933 21,257 20,635 19,073 17,250 15,236 13,107 12,130 11,574 11,217 10,967 | 21,092 20,431 19,825 18,307 16,545 14,589 12,523 11,574 11,034 10,686 10,443 | 20,559 19,907 19,311 17,819 16,091 14,174 12,148 11,217 10,686 10,344 10,105 | 20,191 19,546 18,955 17,482 15,777 13,886 11,887 10,967 10,443 10,105 9,870

Tableau 6 – Charge critique de flambement d’une barre à inertie constante, libre de fléchir transversalement

### entre ses extrémités (1) (suite)

Caractéristiques de la pièce Cas de charges | Charge critique de flambement Fc (sans tenir compte des déformations dues à l’effort tranchant)
| C C ∑ ∑ qx dx = q0 = ⁄ 4 On a : qx dx A B q0 π²EI --------- c ( 2 = --------------------------) 0 696 , 4
| GS1 G module d’élasticité au cisaillement S1 aire réduite de la section transversale de la pièce (voir valeurs de S1 dans le tableau 3)
(1) E module d’élasticité longitudinale, | I moment d’inertie de la section transversale, | longueur de la pièce.

Fc

π²EI
² ⁻⁻⁻⁻⁻⁻⁻⁻⁻⁻⁻⁻ | | | 1
1 | π²EI
² ⁻⁻⁻⁻⁻⁻⁻⁻⁻⁻⁻⁻ | | 1
+ | -----------
= | ------------------------------------------
ω0 | β0 M0
EI = | -----------
ω1 | β1 – M1 EI
----------- =
Fc | C EI
² = | -----

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

# GAGNEZ DU TEMPS ET SÉCURISEZ VOS PROJETS EN UTILISANT UNE SOURCE ACTUALISÉE ET FIABLE

en français !; leurs compléments et mises à jour, et bénéficiez des services inclus.; RÉDIGÉE ET VALIDÉE PAR DES EXPERTS; 100 % COMPATIBLE SUR TOUS SUPPORTS NUMÉRIQUES; MISE À JOUR PERMANENTE; SERVICES INCLUS DANS CHAQUE OFFRE; Automatique - Robotique Biomédical - Pharma Construction et travaux publics Électronique - Photonique Énergies Environnement - Sécurité Génie industriel Ingénierie des transports; Innovation Matériaux Mécanique Mesures - Analyses Procédés chimie - Bio - Agro Sciences fondamentales Technologies de l’information; + de 350 000 utilisateurs + de 10 000 articles de référence + de 80 offres 15 domaines d’expertise

# Techniques de l’Ingénieur propose la plus importante collection documentaire technique et scientifique

# Grâce à vos droits d’accès, retrouvez l’ensemble

des articles et fiches pratiques de votre offre,

Pour des offres toujours plus adaptées à votre métier,

# découvrez les offres dédiées à votre secteur d’activité

# Depuis plus de 70 ans, Techniques de l’Ingénieur est la source

d’informations de référence des bureaux d’études,
de la R&D et de l’innovation.

# www.techniques-ingenieur.fr

CONTACT : Tél. : + 33 (0)1 53 35 20 20 - Fax : +33 (0)1 53 26 79 18 - E-mail : infos.clients@teching.com

# ILS NOUS FONT CONFIANCE

## Accès illimité aux articles en HTML

## Enrichis et mis à jour pendant toute la durée de la souscription

## Questions aux experts*

## Les meilleurs experts techniques et scientifiques vous répondent

## Archives

## Technologies anciennes et versions antérieures des articles

*Questions aux experts est un service réservé aux entreprises, non proposé dans les offres écoles, universités ou pour tout autre organisme de formation.

## Consultation sur tous les supports numériques

## Des contenus optimisés pour ordinateurs, tablettes et mobiles

## Dictionnaire technique multilingue

45 000 termes en français, anglais,

## espagnol et allemand

## Alertes actualisations

## Recevez par email toutes les nouveautés de vos ressources documentaires

## Téléchargement des articles au format PDF

## Pour un usage en toute liberté

## Articles Découverte

## La possibilité de consulter des articles en dehors de votre offre

## Impression à la demande

## Commandez les éditions papier de vos ressources documentaires

# ACCÈS SERVICES ET OUTILS PRATIQUES

# www.techniques-ingenieur.fr

CONTACT : Tél. : + 33 (0)1 53 35 20 20 - Fax : +33 (0)1 53 26 79 18 - E-mail : infos.clients@teching.com

# LES AVANTAGES ET SERVICES compris dans les offres Techniques de l’Ingénieur
