EOSCogniton/ELIZ-2022/02 - Documentation/Formation_Catia/Conception_Schema/Bielle-Manivelle.xls

`Epaisseur-bielle` (mm) | `Longueur-bielle` (mm) | `Longueur-manivelle` (mm)
10 | 100 | 30
20 | 150 | 40
