EOSCogniton/ELIZ-2022/02 - Documentation/Formation_Catia/Conception_Schema/DesignTable1.xlsx

diametre_piston (mm) | excentrique (mm)
55 | 20
70 | 25
100 | 30
