EOSCogniton/ELIZ-2022/01 - Maquette CATIA/EL_Electrical/EL_A2100 (Accumulator Assy)/EL_A2100-a (Accumulator Assy Version a)/DesignTable1.xls

`EL_21000 (Filaire)\largeur_plot` (mm) | `EL_21000 (Filaire)\largeur_batterie` (mm) | `EL_21000 (Filaire)\profondeur_batterie` (mm) | `EL_21000 (Filaire)\hauteur_batterie` (mm) | `EL_21000 (Filaire)\largeur_plaque` (mm) | `EL_21000 (Filaire)\profondeur_plaque` (mm) | `EL_21000 (Filaire)\epaisseur_plaque` (mm) | `EL_21000 (Filaire)\b_verte` (mm) | `EL_21000 (Filaire)\h_verte` (mm) | `EL_21000 (Filaire)\L_verte` (mm)
60 | 310 | 430 | 260 | 190 | 310 | 6 | 50 | 6 | 44
