EOSCogniton/ELIZ-2022/01 - Maquette CATIA/EL_Electrical/EL_A2000(TSBox + Inverter)/schémas nouvelle TSBOX (2024).png

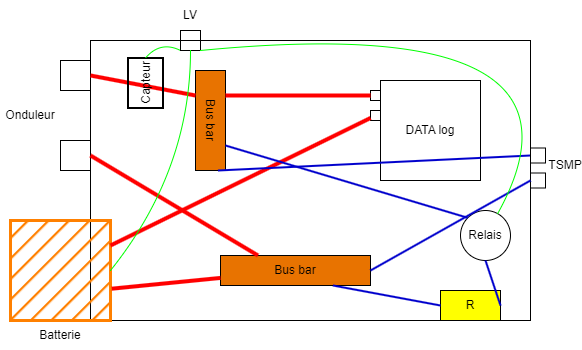
01 - Maquette CATIA/EL_Electrical/EL_A2000(TSBox + Inverter)/schémas nouvelle TSBOX (2024).png
