EOSCogniton/ELIZ-2022/01 - Maquette CATIA/FR_Frame_Body/Cockpit_Templates/Vérification/Impactor_Check.jpg

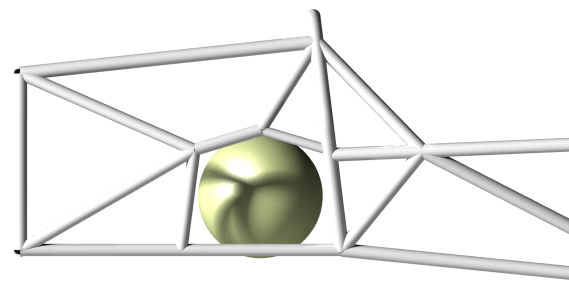
01 - Maquette CATIA/FR_Frame_Body/Cockpit_Templates/Vérification/Impactor_Check.jpg
