EOSCogniton/ELIZ-2022/01 - Maquette CATIA/SU_Suspension/SU_A0600 (Front Bell Crank)/01_FEA_FRocker/Simu_FRocker_Bump3G.1.PNG

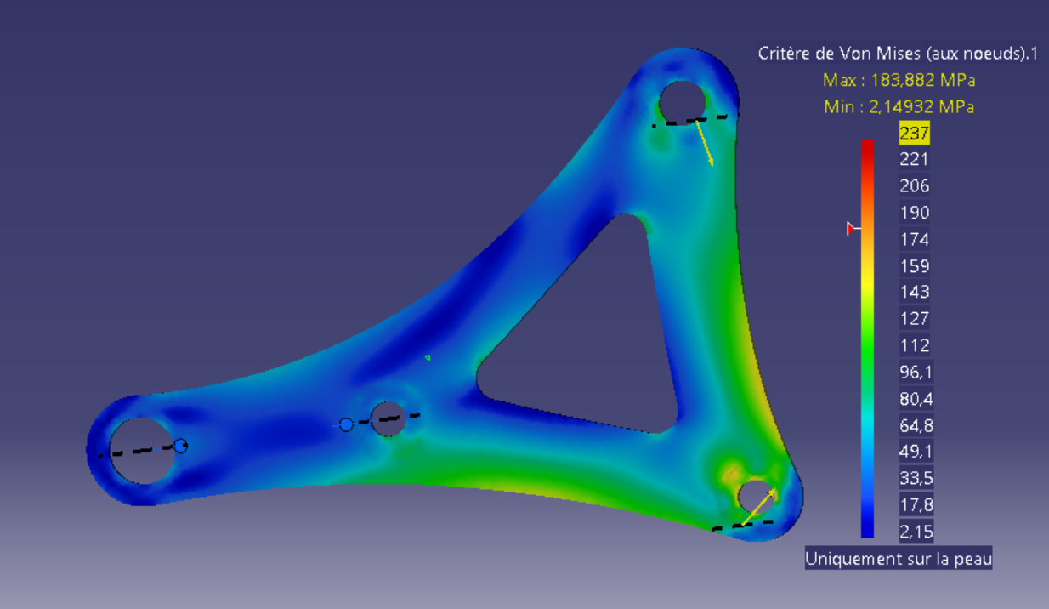
01 - Maquette CATIA/SU_Suspension/SU_A0600 (Front Bell Crank)/01_FEA_FRocker/Simu_FRocker_Bump3G.1.PNG
