EOSCogniton/ELIZ-2022/01 - Maquette CATIA/SU_Suspension/SU_A0600 (Front Bell Crank)/02_PROM/Stape1.PNG

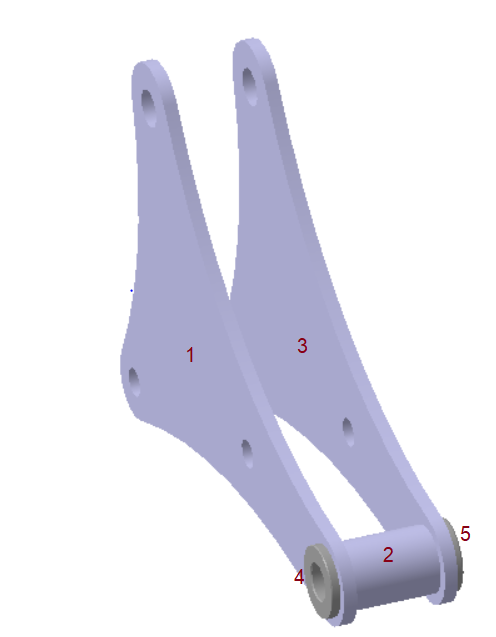
01 - Maquette CATIA/SU_Suspension/SU_A0600 (Front Bell Crank)/02_PROM/Stape1.PNG
