EOSCogniton/ELIZ-2022/01 - Maquette CATIA/WT_Wheels_Wheel-Bearings_Tires/01_nut_dowel/goujonsData.jpg

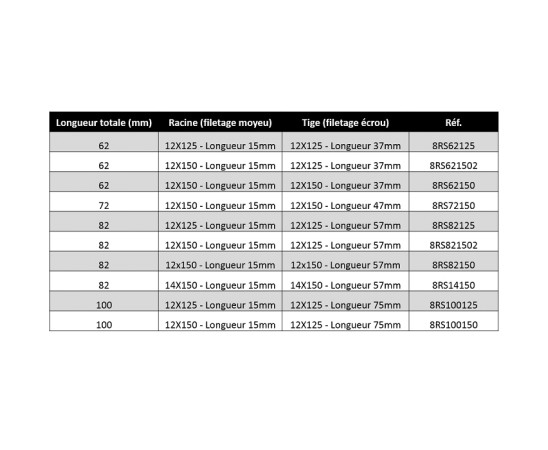
01 - Maquette CATIA/WT_Wheels_Wheel-Bearings_Tires/01_nut_dowel/goujonsData.jpg
