EOSCogniton/ELIZ-2022/01 - Maquette CATIA/WT_Wheels_Wheel-Bearings_Tires/01_nut_dowel/goujonsDetail.jpg

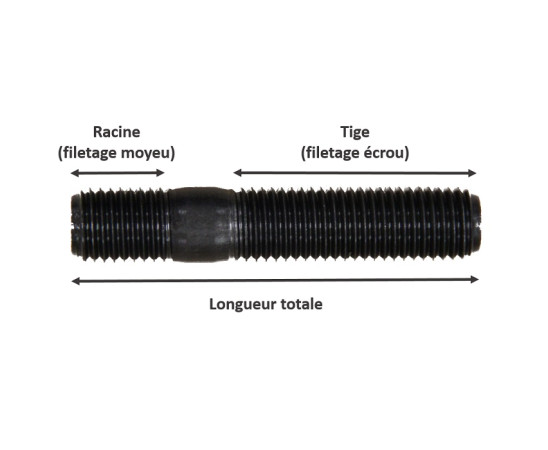
01 - Maquette CATIA/WT_Wheels_Wheel-Bearings_Tires/01_nut_dowel/goujonsDetail.jpg
