EOSCogniton/ELIZ-2022/02 - Documentation/BASTIE/Cartes Artemiz/TSAL (version SCS output)/TSAL/Explanation screenshot/Faulty_Detection.png

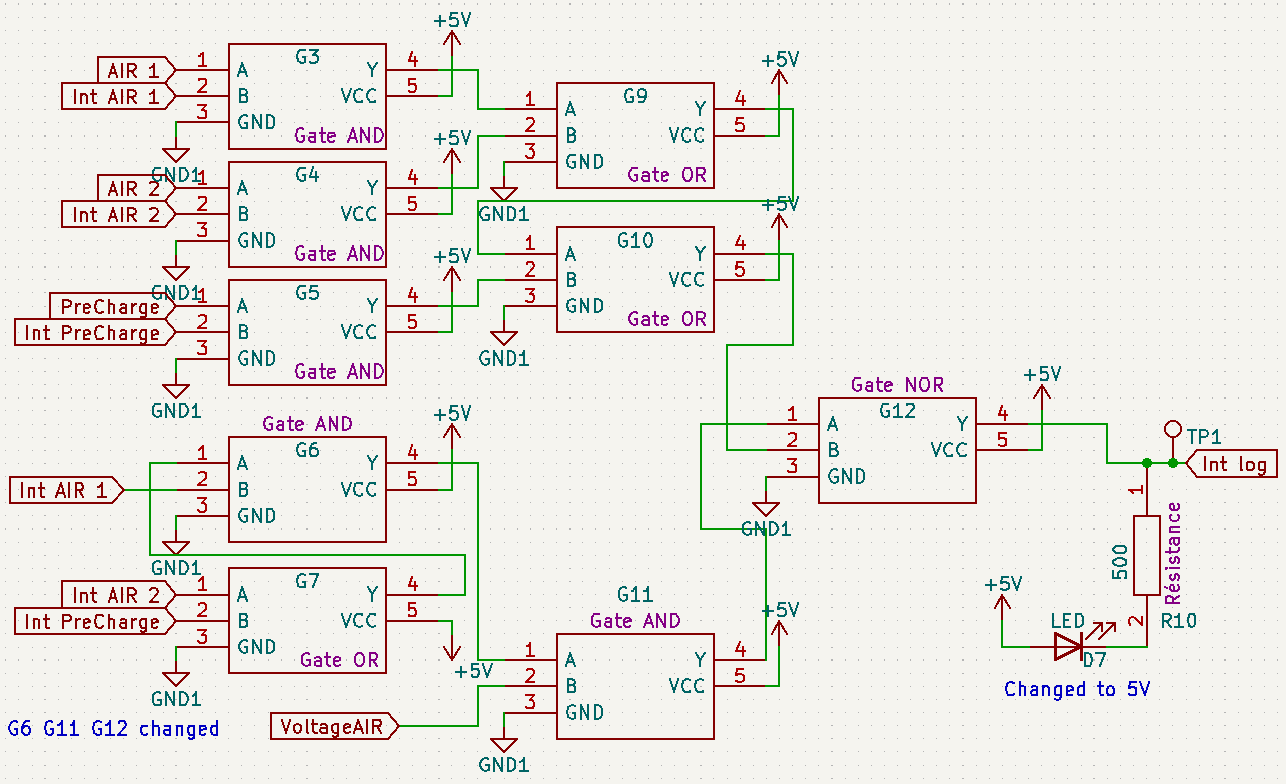
02 - Documentation/BASTIE/Cartes Artemiz/TSAL (version SCS output)/TSAL/Explanation screenshot/Faulty_Detection.png
