EOSCogniton/ELIZ-2022/02 - Documentation/BASTIE/Cartes Artemiz/TSAL (version SCS output)/TSAL/Explanation screenshot/Latch_init.png

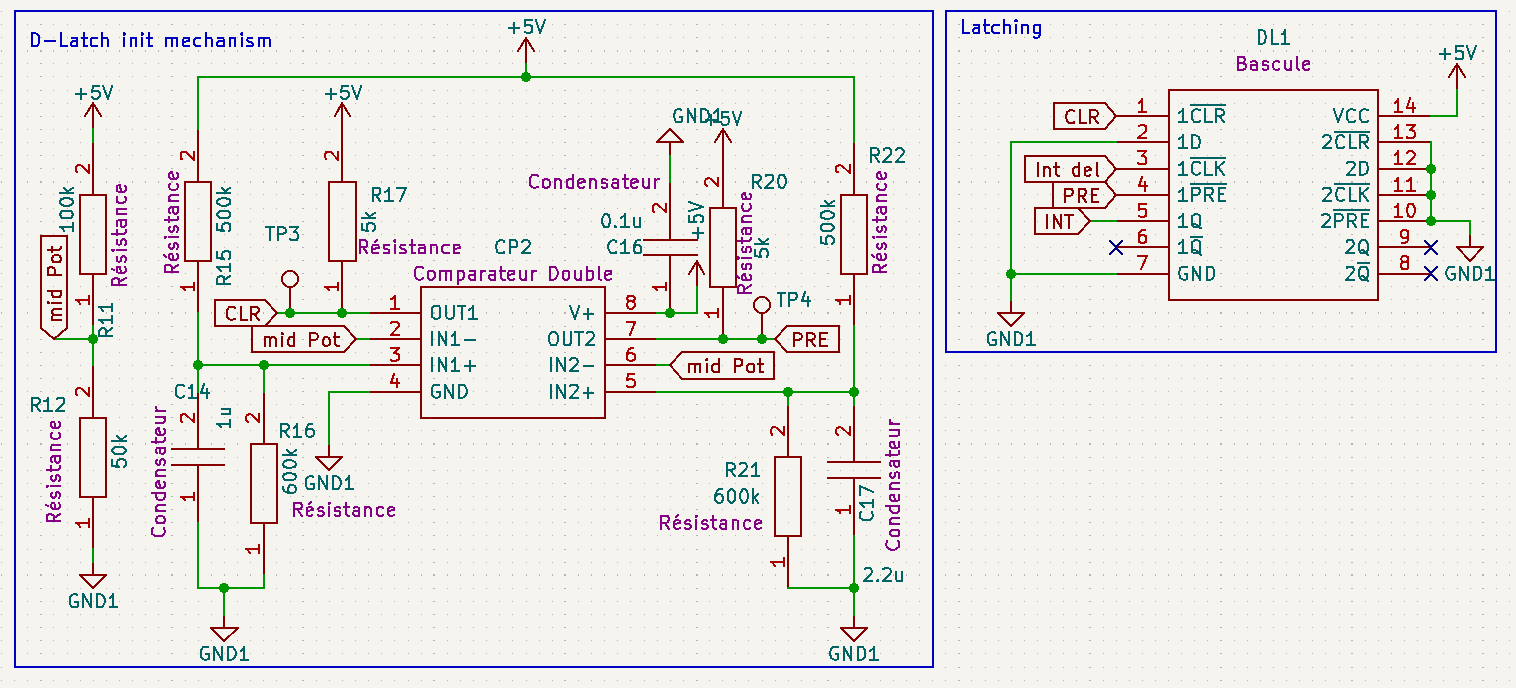
02 - Documentation/BASTIE/Cartes Artemiz/TSAL (version SCS output)/TSAL/Explanation screenshot/Latch_init.png
