EOSCogniton/ELIZ-2022/02 - Documentation/BASTIE/Cartes Artemiz/TSAL (version SCS output)/TSAL/Explanation screenshot/NON_SCS_Input.png

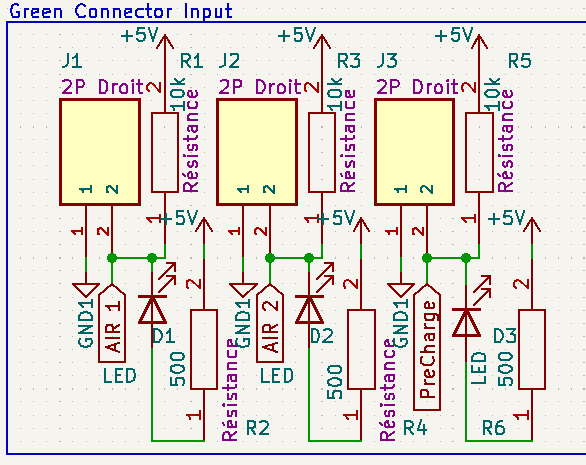
02 - Documentation/BASTIE/Cartes Artemiz/TSAL (version SCS output)/TSAL/Explanation screenshot/NON_SCS_Input.png
