EOSCogniton/ELIZ-2022/02 - Documentation/BASTIE/Cartes Artemiz/TSAL (version SCS output)/TSAL/TSAL-insta.png

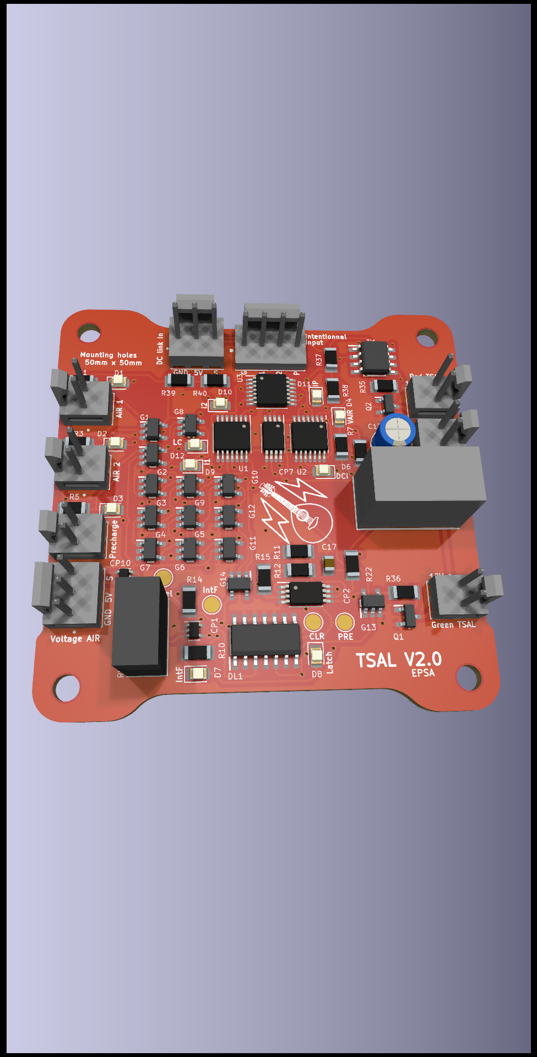
02 - Documentation/BASTIE/Cartes Artemiz/TSAL (version SCS output)/TSAL/TSAL-insta.png
