EOSCogniton/ELIZ-2022/02 - Documentation/BASTIE/Cartes Artemiz/TSAL (version SCS output)/TSAL/TSAL-topdown.jpg

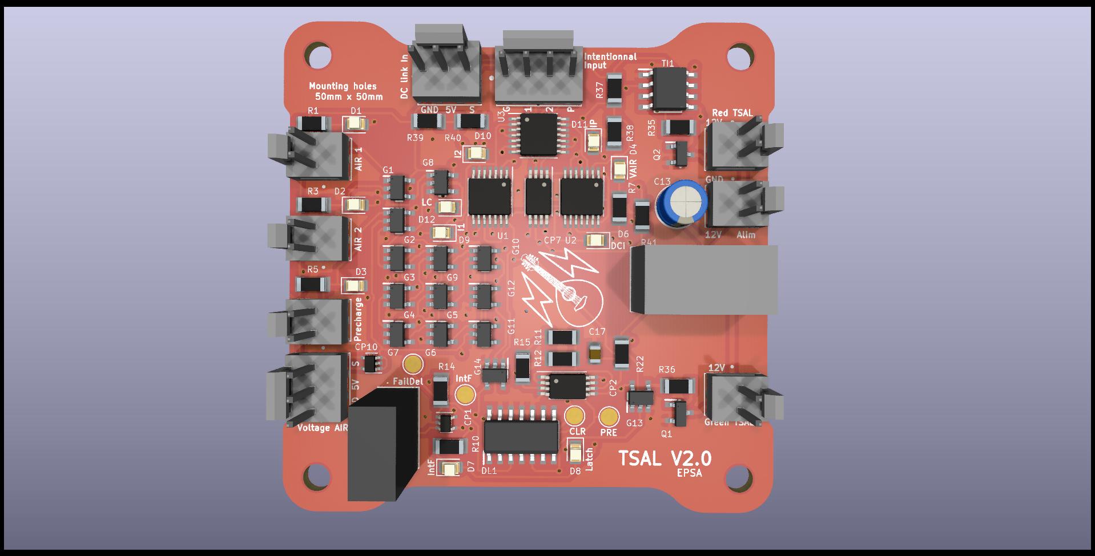
02 - Documentation/BASTIE/Cartes Artemiz/TSAL (version SCS output)/TSAL/TSAL-topdown.jpg
