EOSCogniton/ELIZ-2022/02 - Documentation/BASTIE/Cartes Artemiz/TSAL (version SCS output)/TSAL_Green_Latching/Justification simulation latching.png

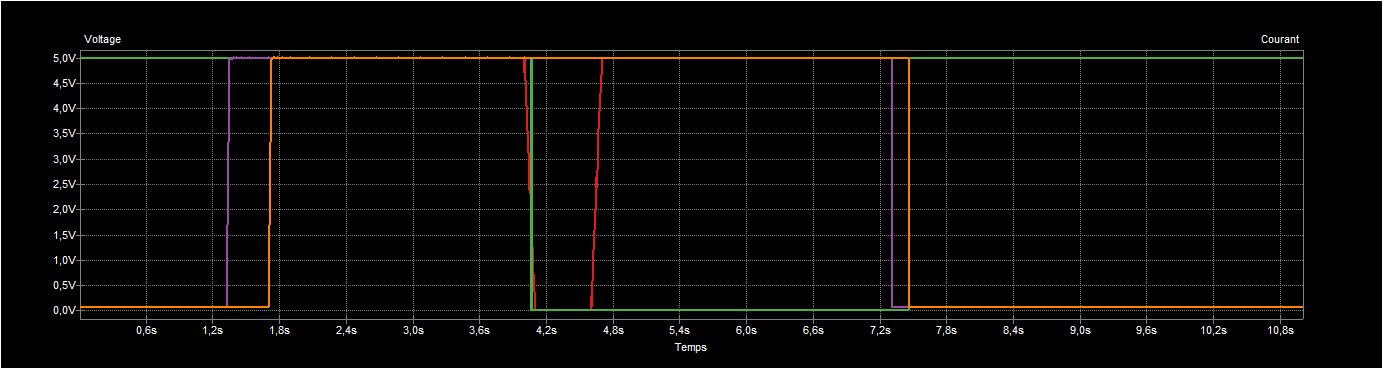
02 - Documentation/BASTIE/Cartes Artemiz/TSAL (version SCS output)/TSAL_Green_Latching/Justification simulation latching.png
