EOSCogniton/ELIZ-2022/02 - Documentation/BASTIE/Cartes Valkyriz/BMS/BMS V1.0/BMS V1.0_pers.png

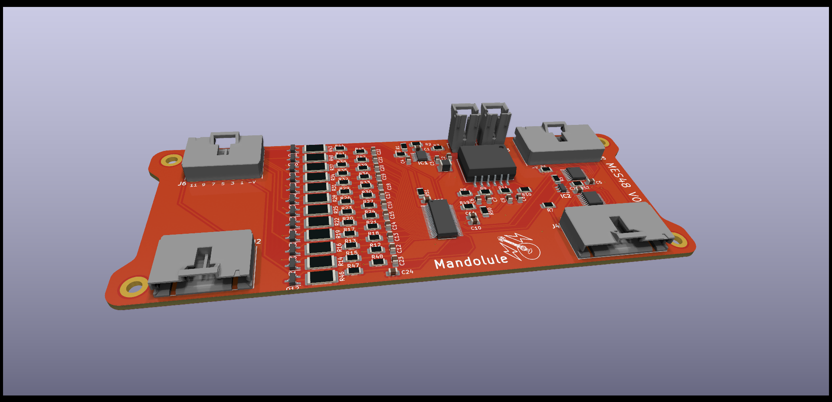
02 - Documentation/BASTIE/Cartes Valkyriz/BMS/BMS V1.0/BMS V1.0_pers.png
