EOSCogniton/ELIZ-2022/02 - Documentation/BASTIE/Cartes Valkyriz/BMS/BMS V1.0/illustration/LTC.jpg

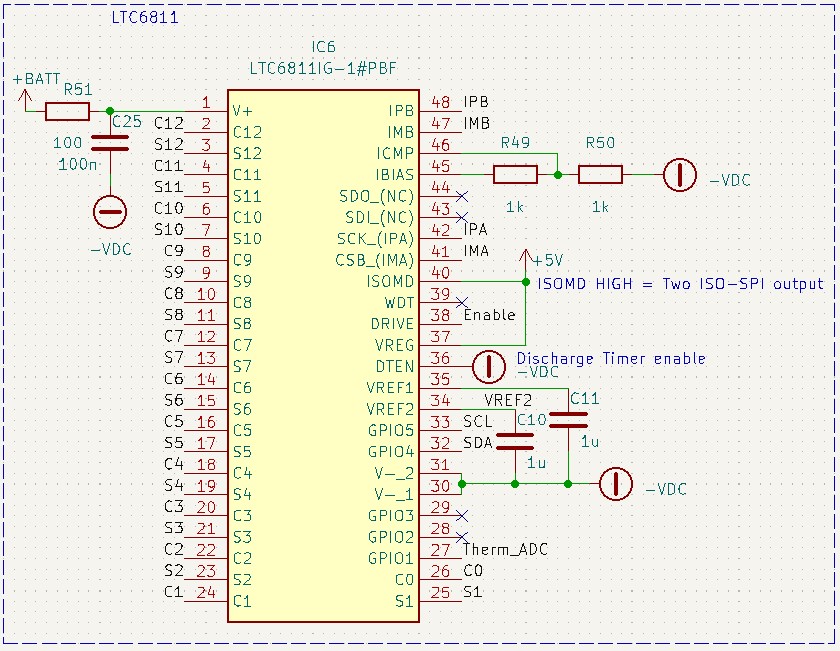
02 - Documentation/BASTIE/Cartes Valkyriz/BMS/BMS V1.0/illustration/LTC.jpg
