EOSCogniton/ELIZ-2022/02 - Documentation/BASTIE/Cartes Valkyriz/BMS/BMS V1.0/Silk/.svg2shenzhen-cache/images/F.SilkS_g835.png

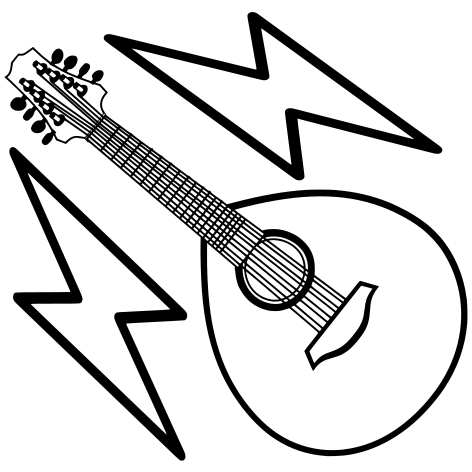
02 - Documentation/BASTIE/Cartes Valkyriz/BMS/BMS V1.0/Silk/.svg2shenzhen-cache/images/F.SilkS_g835.png
