EOSCogniton/ELIZ-2022/02 - Documentation/BASTIE/Tableau de Bord/Pictures/2.png

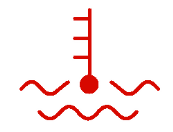
02 - Documentation/BASTIE/Tableau de Bord/Pictures/2.png
