EOSCogniton/ELIZ-2022/02 - Documentation/BASTIE/Tableau de Bord/Pictures/9.png

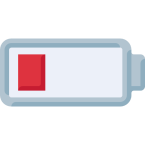
02 - Documentation/BASTIE/Tableau de Bord/Pictures/9.png
