EOSCogniton/ELIZ-2022/02 - Documentation/BASTIE/Tableau de Bord/Pictures/lowrezpicartemiz.png

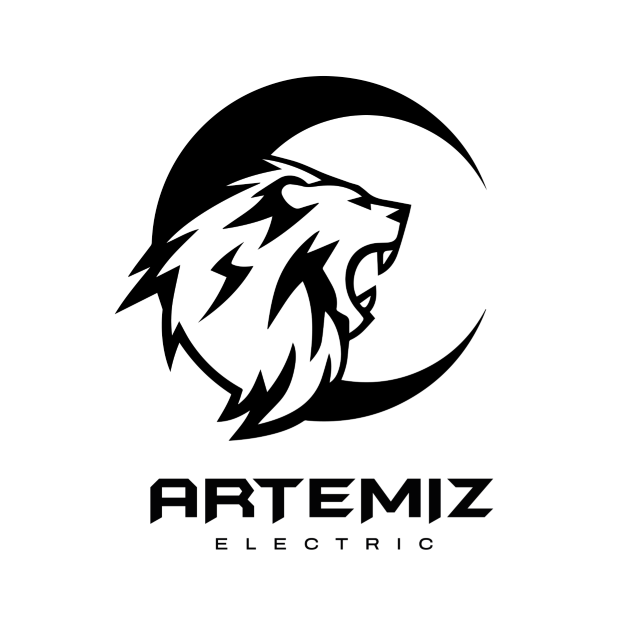
02 - Documentation/BASTIE/Tableau de Bord/Pictures/lowrezpicartemiz.png
