EOSCogniton/ELIZ-2022/02 - Documentation/CHASEA/Info chassis carbone/image_chassis_2.png

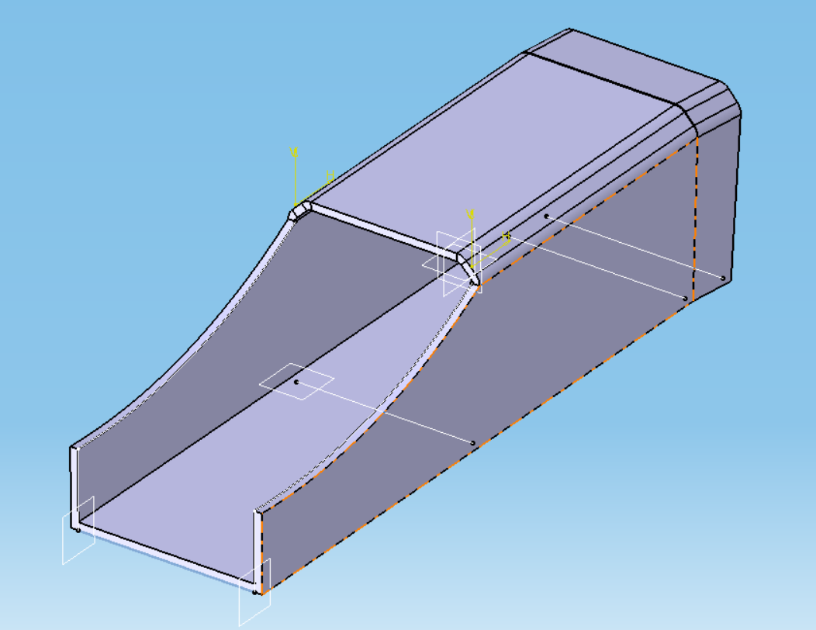
02 - Documentation/CHASEA/Info chassis carbone/image_chassis_2.png
