EOSCogniton/ELIZ-2022/02 - Documentation/CHASEA/Réglage BOTS/vue couleur BOTS.png

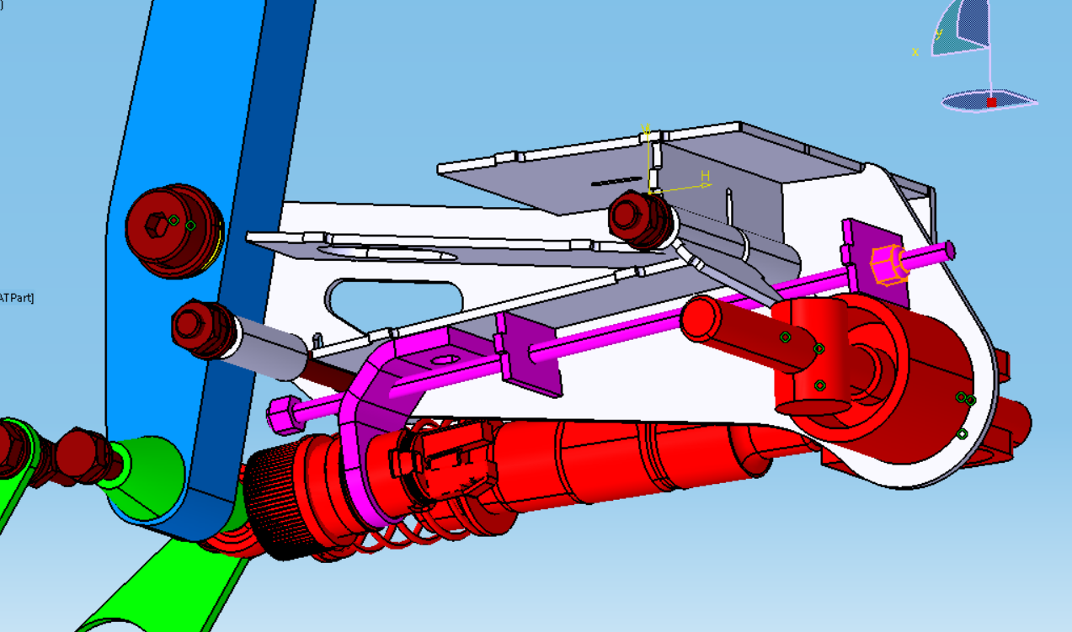
02 - Documentation/CHASEA/Réglage BOTS/vue couleur BOTS.png
