EOSCogniton/ELIZ-2022/02 - Documentation/CHASEA/Réglage BOTS/vue de cote.png

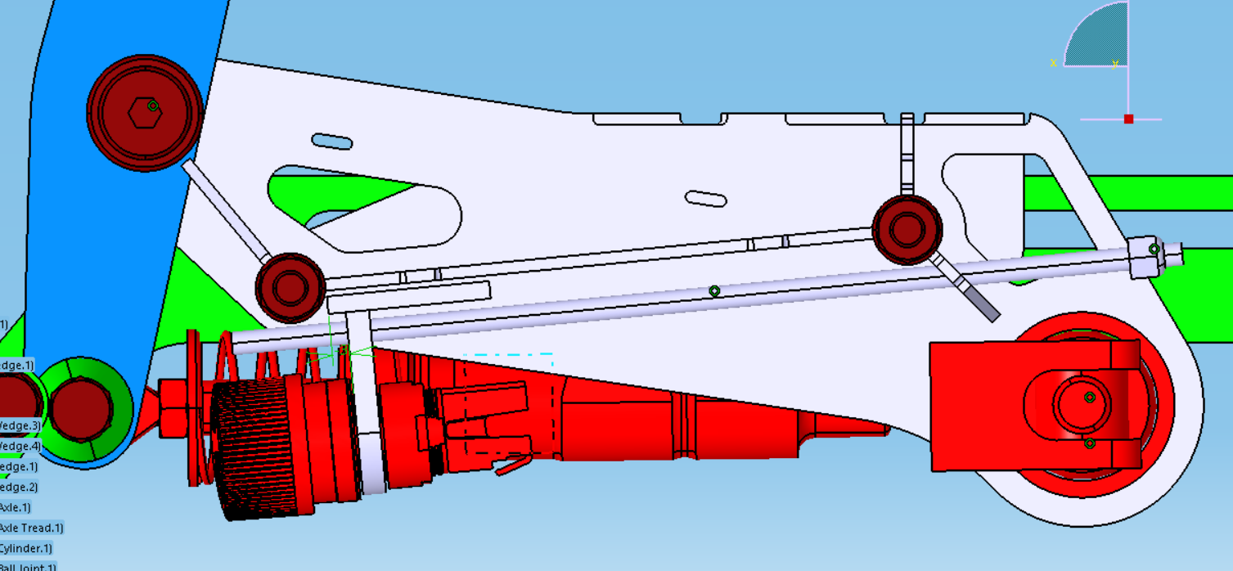
02 - Documentation/CHASEA/Réglage BOTS/vue de cote.png
