EOSCogniton/ELIZ-2022/02 - Documentation/CHASEA/Réglage BOTS/vue iso.png

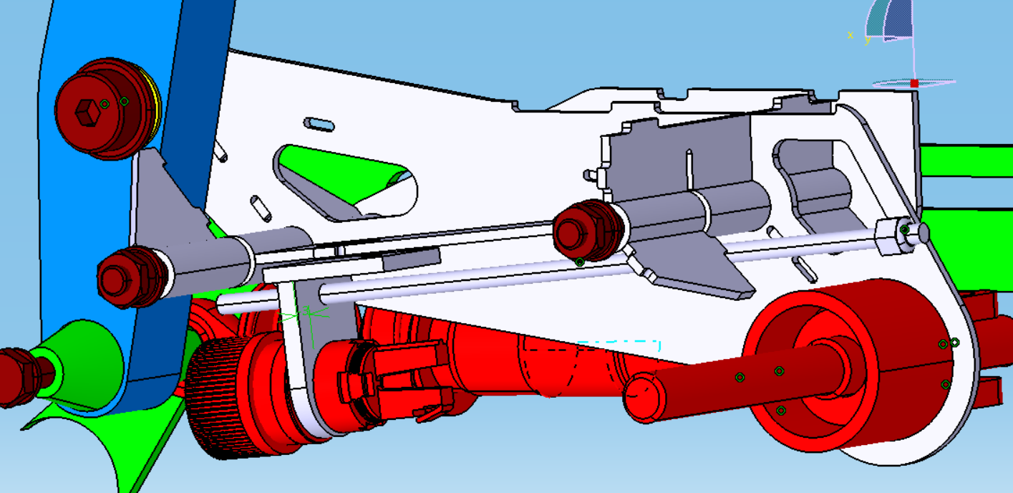
02 - Documentation/CHASEA/Réglage BOTS/vue iso.png
