EOSCogniton/ELIZ-2022/02 - Documentation/Formation_Catia/Bidon_Surfacique/Bidon.jpg

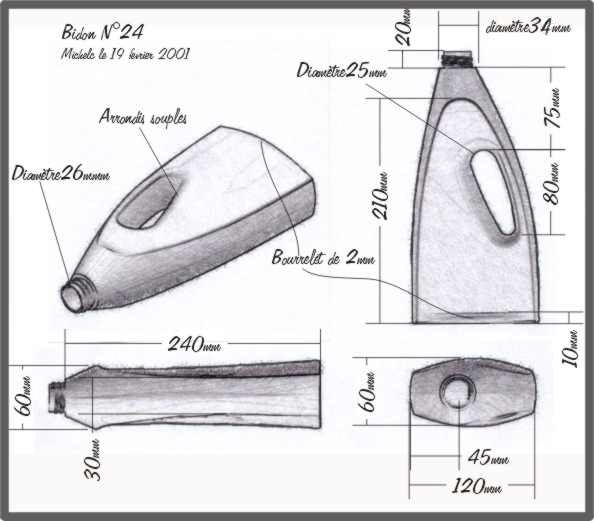
02 - Documentation/Formation_Catia/Bidon_Surfacique/Bidon.jpg
