EOSCogniton/ELIZ-2022/02 - Documentation/MODAC/Dimensionnement énergétique/michigan_tc.jpg

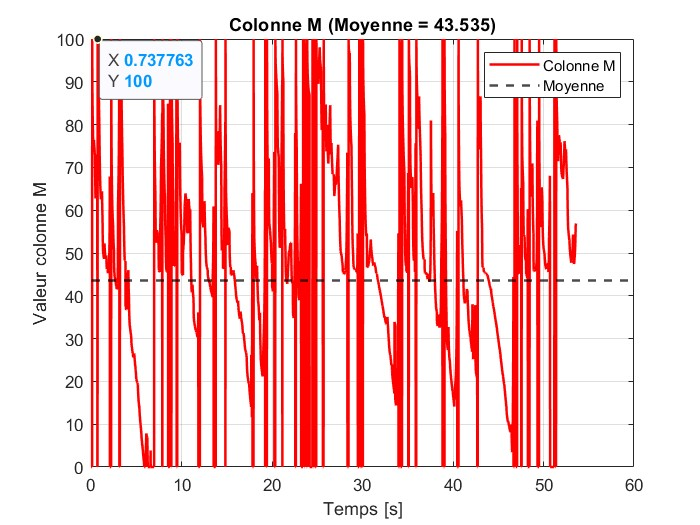
02 - Documentation/MODAC/Dimensionnement énergétique/michigan_tc.jpg
