EOSCogniton/ELIZ-2022/02 - Documentation/Models/Electronique/Design carte/0 - Template/schéma.png

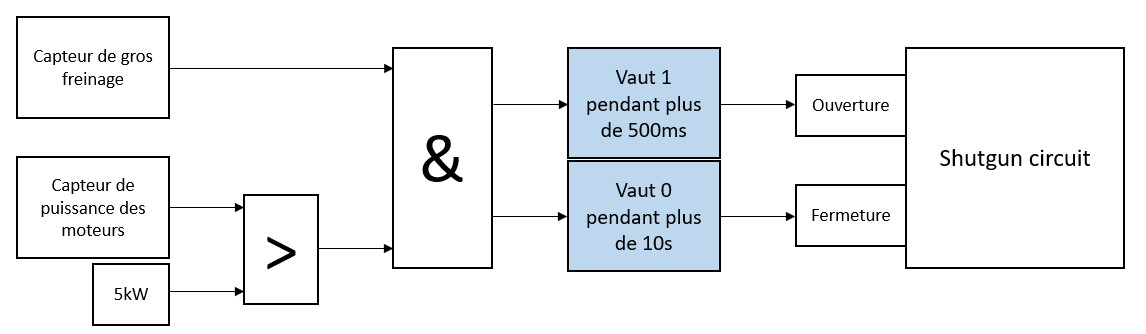
02 - Documentation/Models/Electronique/Design carte/0 - Template/schéma.png
