EOSCogniton/ELIZ-2022/02 - Documentation/module standard 48v/conception/concepts/2022-07-11 17_32_12-Window.jpg

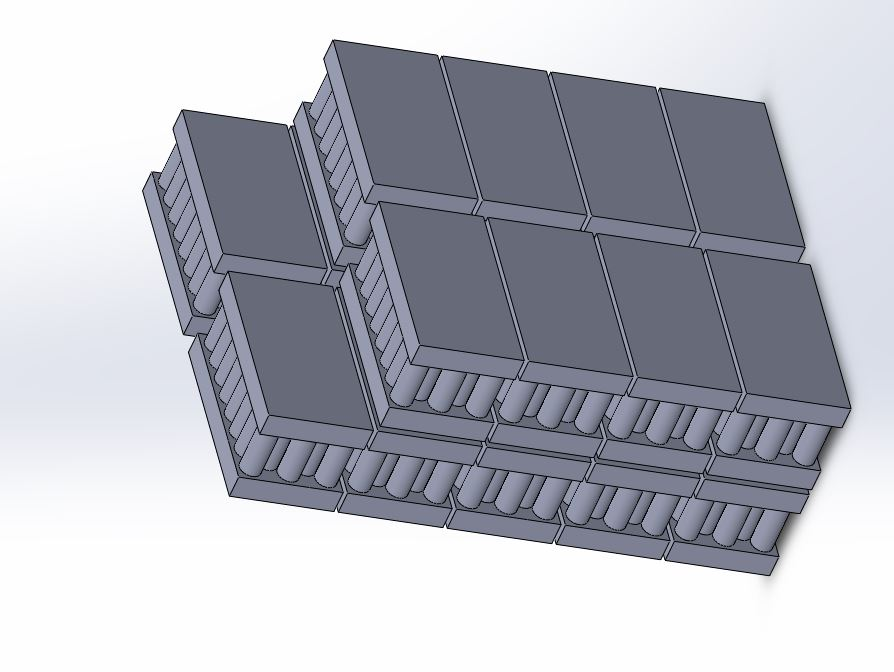
02 - Documentation/module standard 48v/conception/concepts/2022-07-11 17_32_12-Window.jpg
