EOSCogniton/ELIZ-2022/02 - Documentation/module standard 48v/conception/concepts/283409479_1040818083530950_8166807057242132913_n.jpg

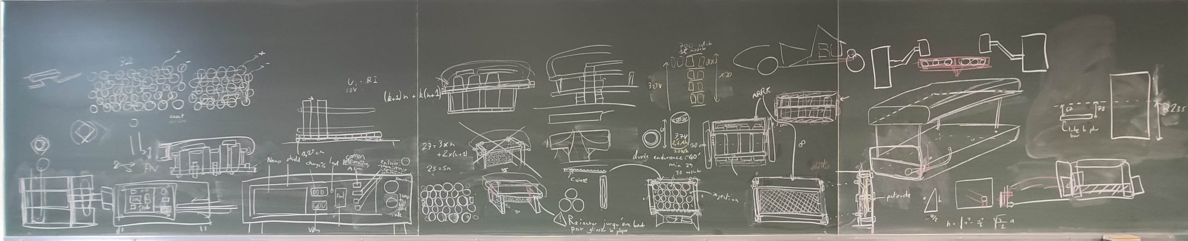
02 - Documentation/module standard 48v/conception/concepts/283409479_1040818083530950_8166807057242132913_n.jpg
