EOSCogniton/ELIZ-2022/02 - Documentation/module standard 48v/conception/concepts/284052310_564448625247586_6237405332960430543_n.jpg

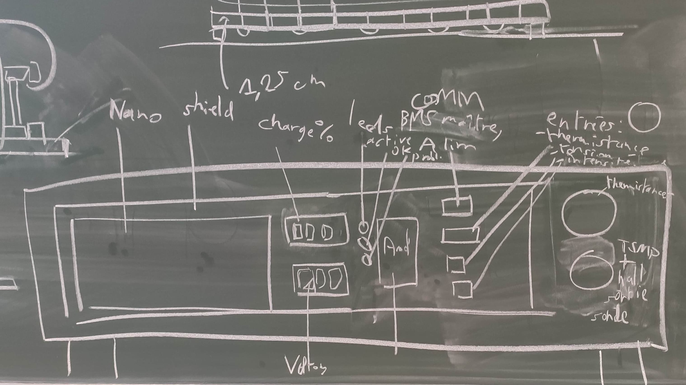
02 - Documentation/module standard 48v/conception/concepts/284052310_564448625247586_6237405332960430543_n.jpg
