EOSCogniton/ELIZ-2022/02 - Documentation/module standard 48v/conception/concepts/284619519_379124330854086_5229062566418372510_n.jpg

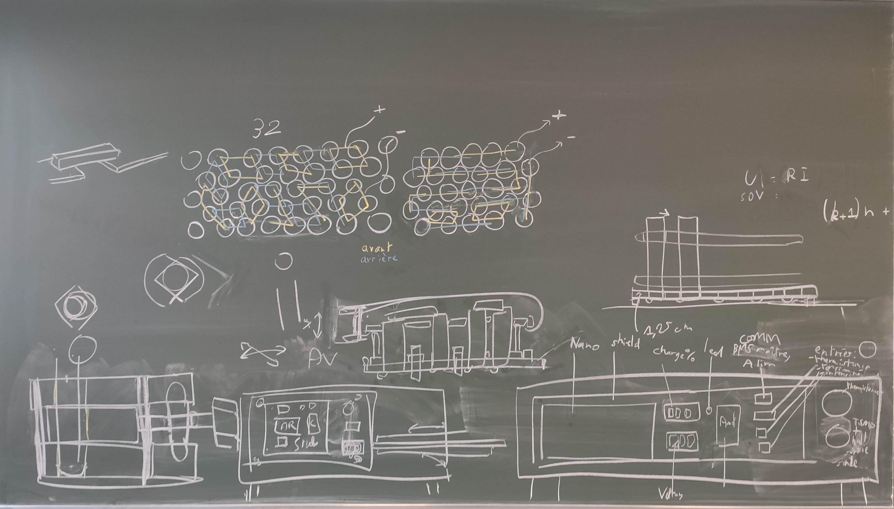
02 - Documentation/module standard 48v/conception/concepts/284619519_379124330854086_5229062566418372510_n.jpg
