EOSCogniton/ELIZ-2022/02 - Documentation/module standard 48v/conception/concepts/284865931_5956503121060884_3955008983643456669_n.jpg

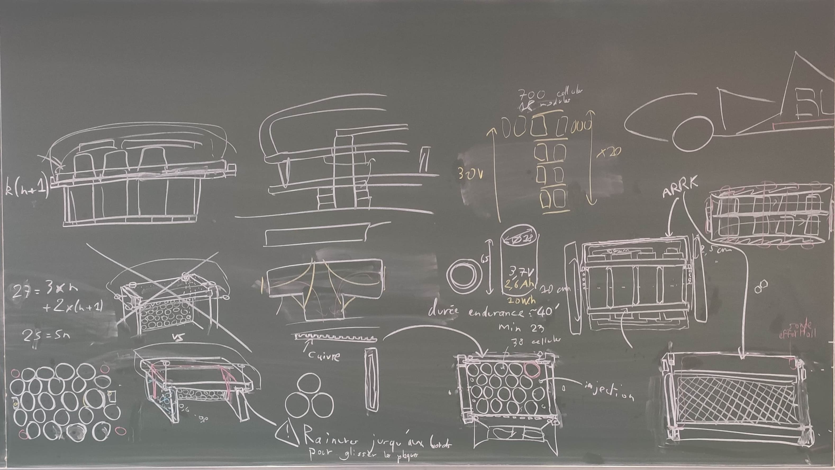
02 - Documentation/module standard 48v/conception/concepts/284865931_5956503121060884_3955008983643456669_n.jpg
