EOSCogniton/ELIZ-2022/02 - Documentation/module standard 48v/conception/concepts/285321508_559712972215300_2510789516890139299_n.jpg

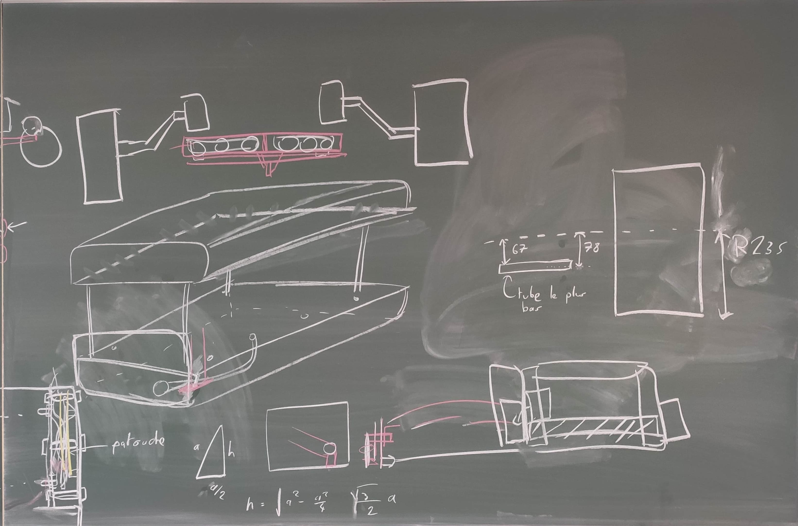
02 - Documentation/module standard 48v/conception/concepts/285321508_559712972215300_2510789516890139299_n.jpg
