EOSCogniton/ELIZ-2022/02 - Documentation/module standard 48v/conception/concepts/concept_connection.png

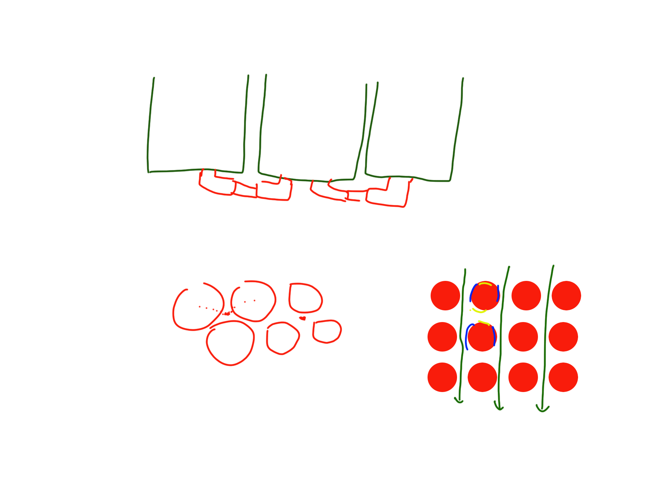
02 - Documentation/module standard 48v/conception/concepts/concept_connection.png
