EOSCogniton/ELIZ-2022/02 - Documentation/module standard 48v/conception/concepts/greenmot.png

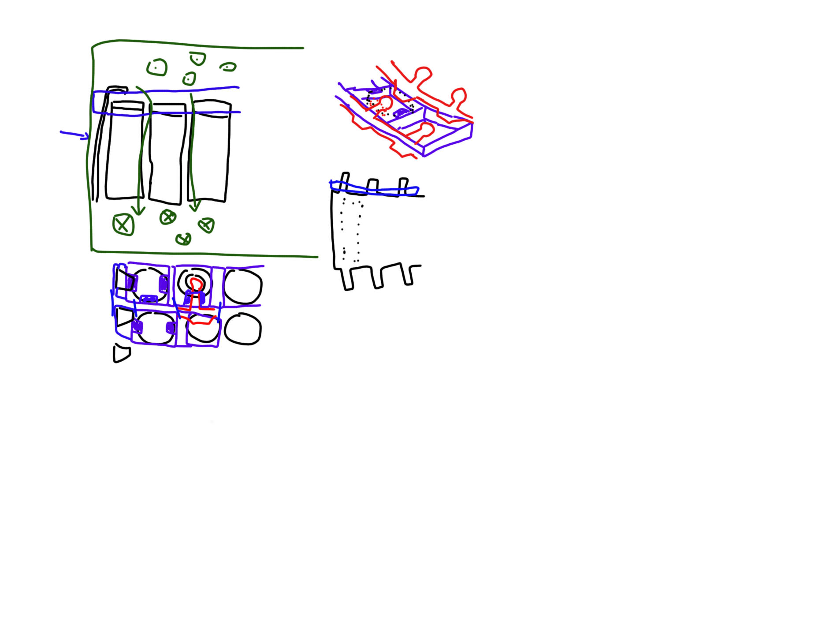
02 - Documentation/module standard 48v/conception/concepts/greenmot.png
