EOSCogniton/ELIZ-2022/02 - Documentation/module standard 48v/conception/concepts/The-structure-of-the-battery-system-of-the-Tesla-Model-S.png

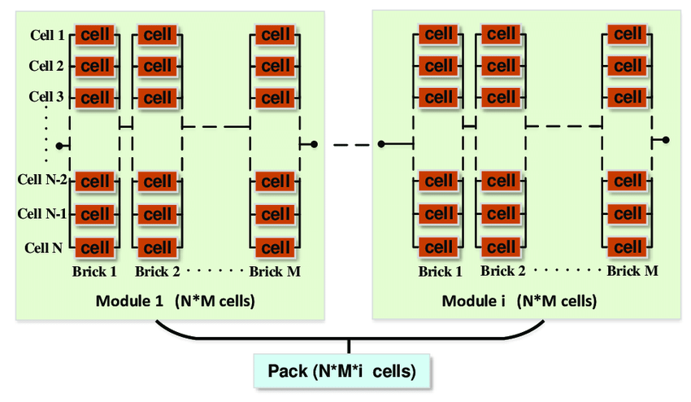
02 - Documentation/module standard 48v/conception/concepts/The-structure-of-the-battery-system-of-the-Tesla-Model-S.png
