EOSCogniton/ELIZ-2022/02 - Documentation/module standard 48v/images_reference/2022-09-29 10_20_48-Accumulator Learning Part 1_ Single Cells and How They Work - YouTube  Mozilla .jpg

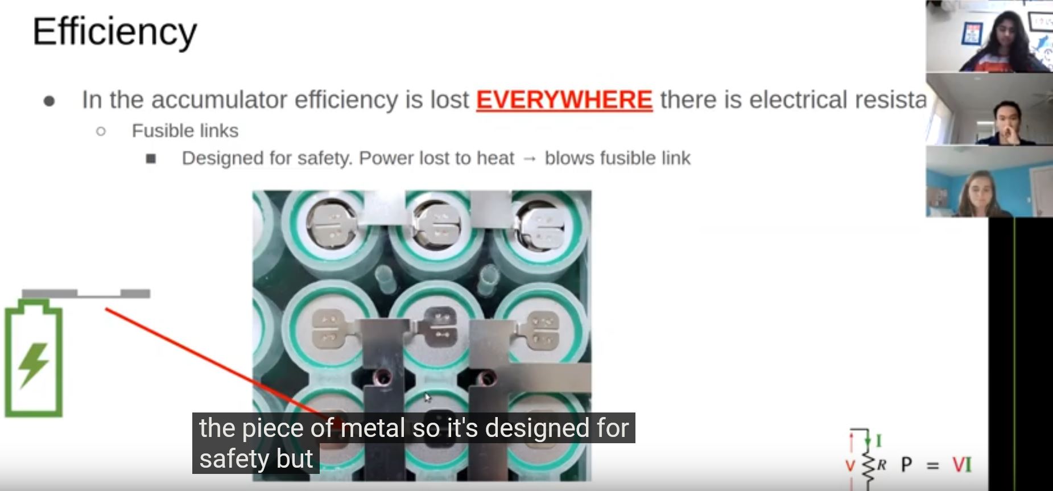
02 - Documentation/module standard 48v/images_reference/2022-09-29 10_20_48-Accumulator Learning Part 1_ Single Cells and How They Work - YouTube Mozilla .jpg
