EOSCogniton/ELIZ-2022/02 - Documentation/module standard 48v/images_reference/2022-09-29 12_02_42-battery pack - YouTube  Mozilla Firefox.jpg

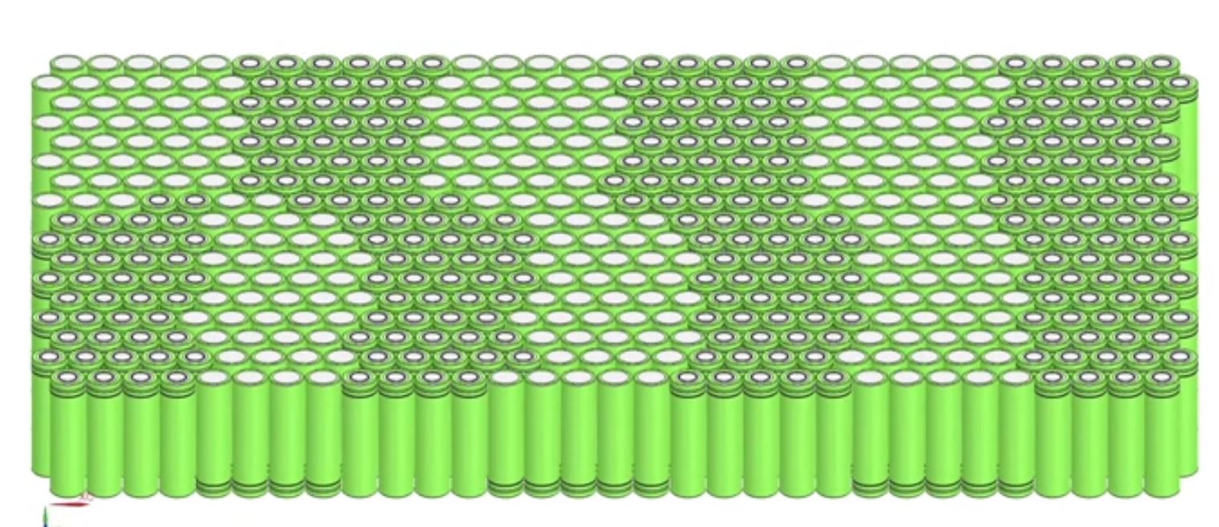
02 - Documentation/module standard 48v/images_reference/2022-09-29 12_02_42-battery pack - YouTube Mozilla Firefox.jpg
