EOSCogniton/ELIZ-2022/02 - Documentation/module standard 48v/images_reference/2022-09-29 12_10_30-Creating my single biggest D.I.Y. battery with 2800 18650 cells recovered from u.jpg

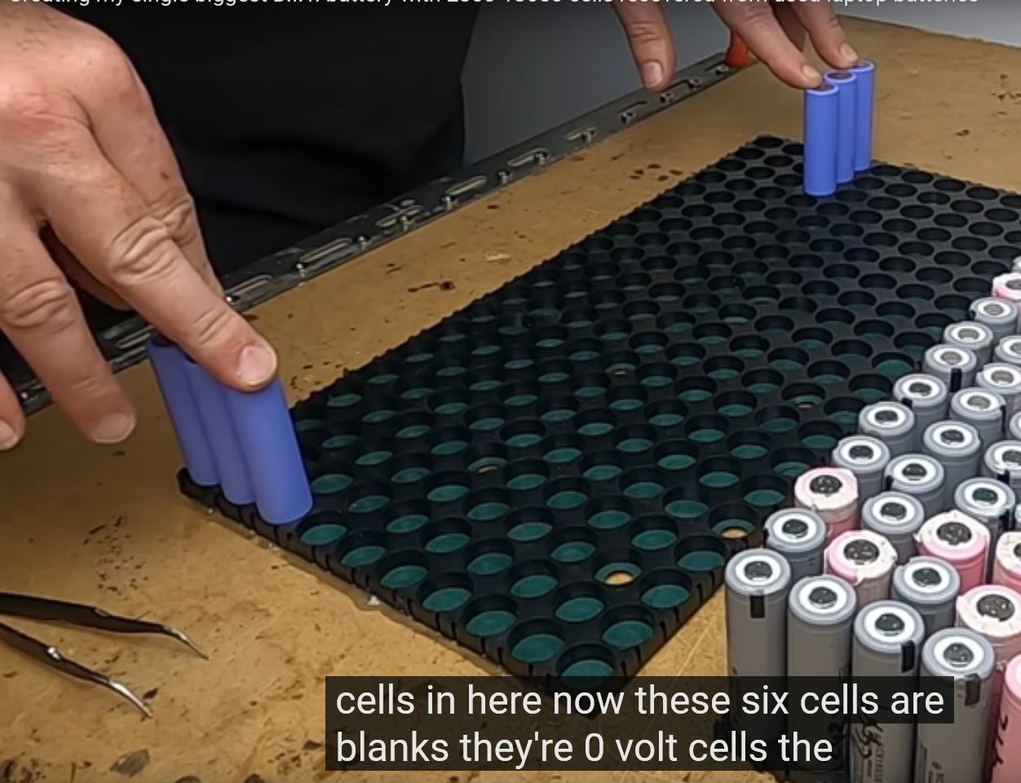
02 - Documentation/module standard 48v/images_reference/2022-09-29 12_10_30-Creating my single biggest D.I.Y. battery with 2800 18650 cells recovered from u.jpg
