EOSCogniton/ELIZ-2022/02 - Documentation/RC_Rendus_Compet/Eté 2024/Design/Vue 3D.jpg

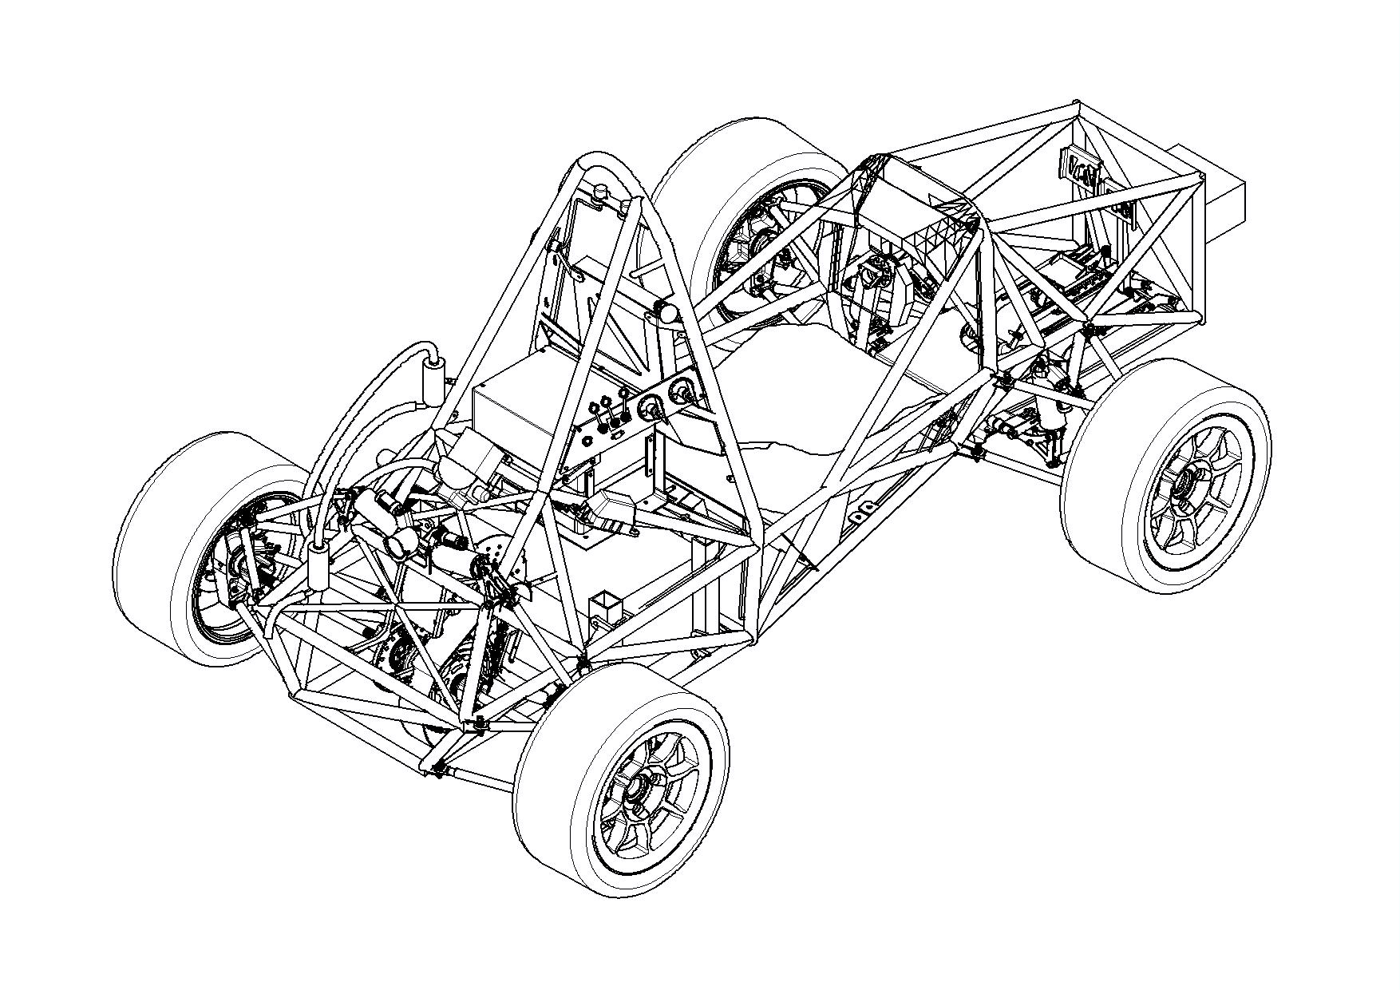
02 - Documentation/RC_Rendus_Compet/Eté 2024/Design/Vue 3D.jpg
