EOSCogniton/ELIZ-2022/02 - Documentation/RC_Rendus_Compet/Eté 2024/IAD/Schematics/Positionning IAD Rendering.jpg

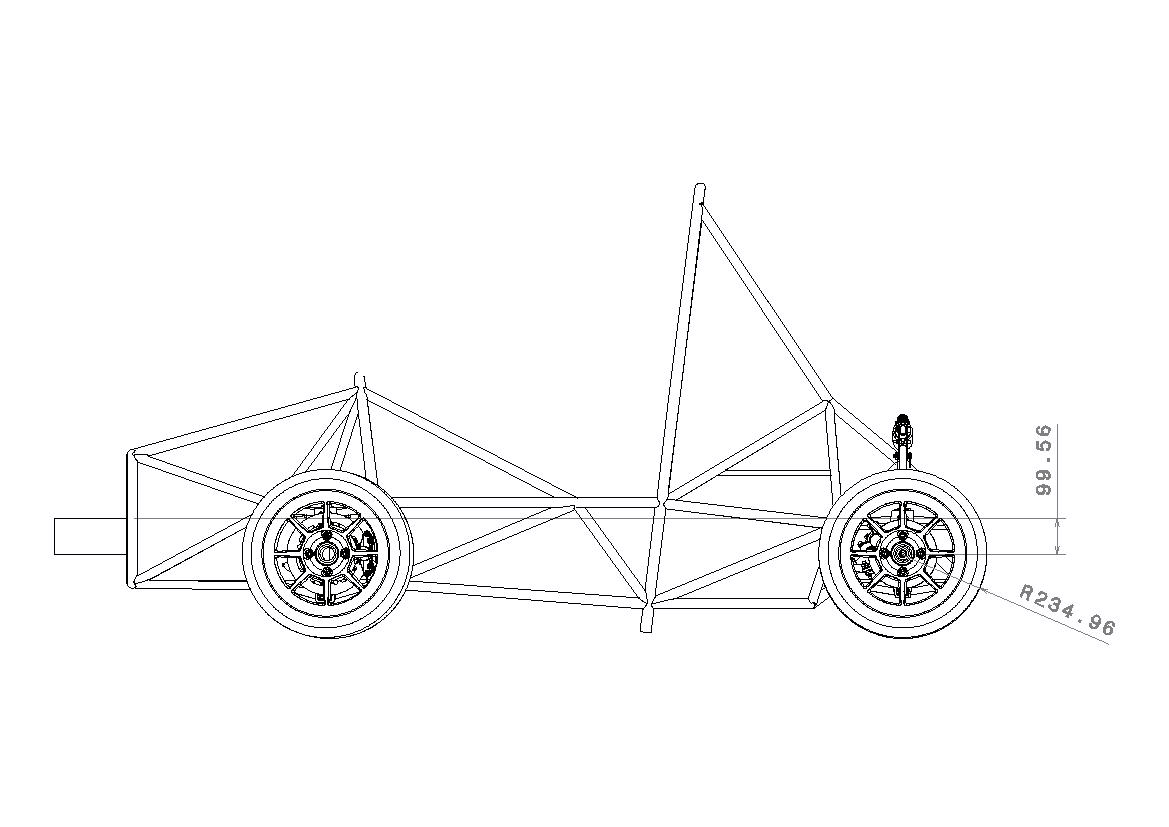
02 - Documentation/RC_Rendus_Compet/Eté 2024/IAD/Schematics/Positionning IAD Rendering.jpg
