EOSCogniton/ELIZ-2022/02 - Documentation/RC_Rendus_Compet/Eté 2024/IAD/Schematics/Spread glue.png

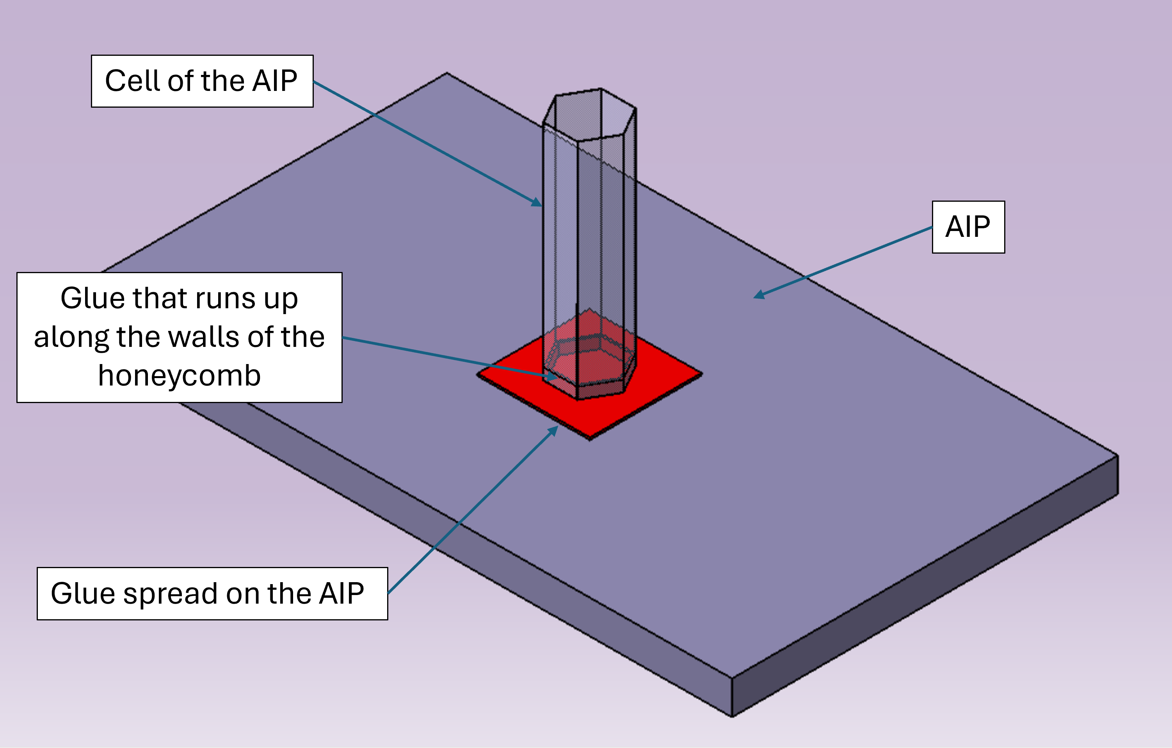
02 - Documentation/RC_Rendus_Compet/Eté 2024/IAD/Schematics/Spread glue.png
