EOSCogniton/ELIZ-2022/02 - Documentation/RC_Rendus_Compet/Eté 2024/SE3D/3D View.jpg

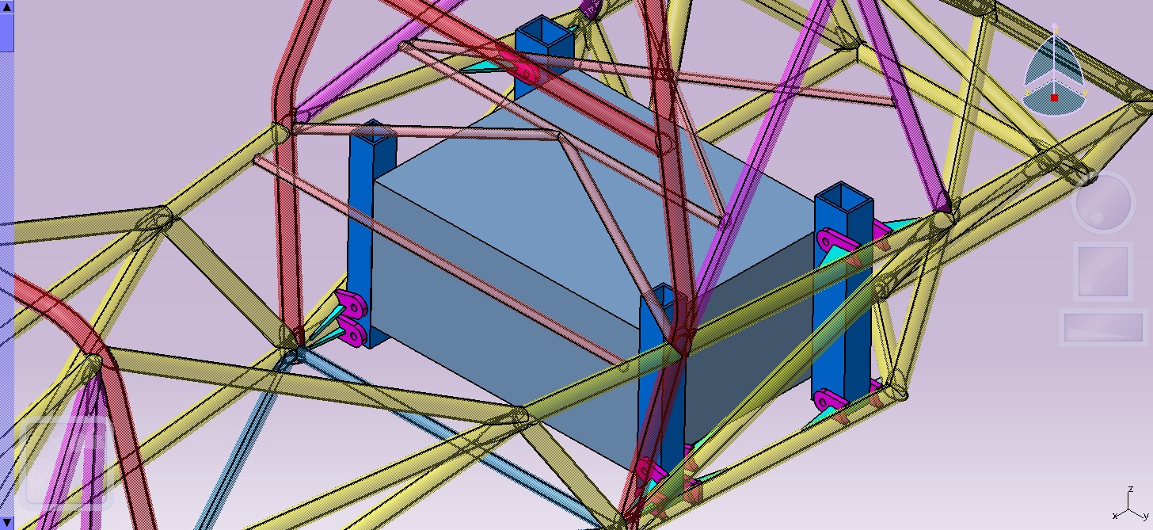
02 - Documentation/RC_Rendus_Compet/Eté 2024/SE3D/3D View.jpg
