EOSCogniton/ELIZ-2022/02 - Documentation/RC_Rendus_Compet/Eté 2024/SES/TSAC Attachment photos/Beam theory schematics 1.jpg

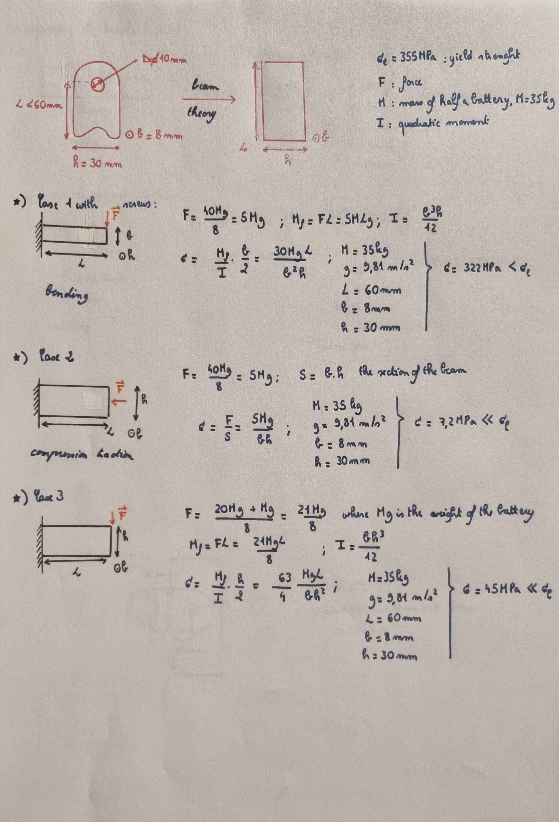
02 - Documentation/RC_Rendus_Compet/Eté 2024/SES/TSAC Attachment photos/Beam theory schematics 1.jpg
