EOSCogniton/ELIZ-2022/02 - Documentation/RC_Rendus_Compet/Eté 2024/SES/TSAC Attachment photos/Charge cases.png

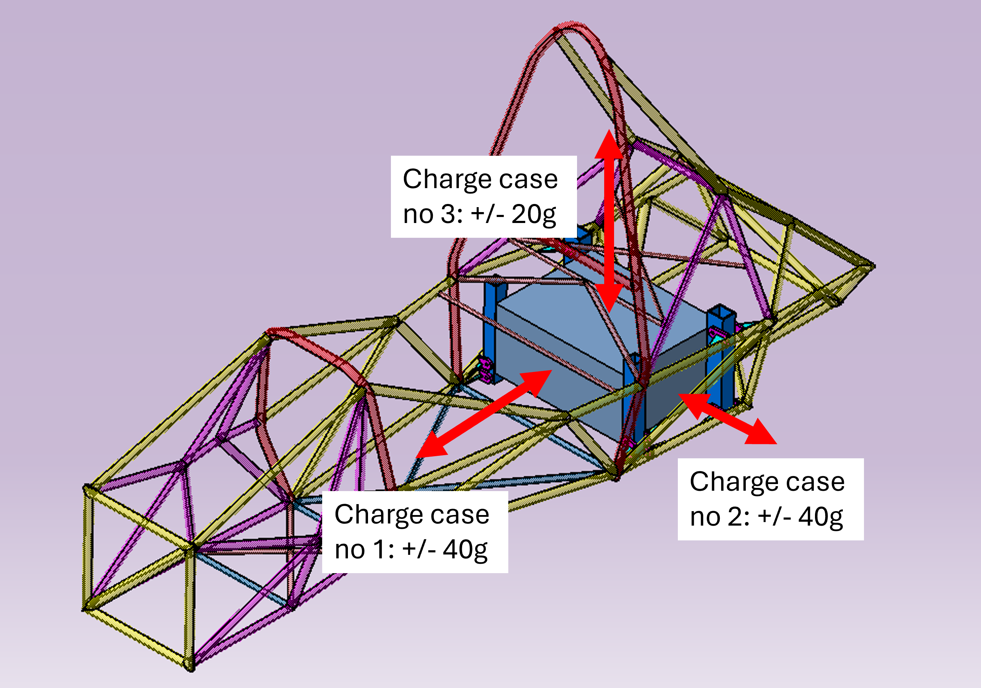
02 - Documentation/RC_Rendus_Compet/Eté 2024/SES/TSAC Attachment photos/Charge cases.png
