EOSCogniton/ELIZ-2022/02 - Documentation/RC_Rendus_Compet/Eté 2024/SES/TSAC Attachment photos/EL_21006 (High Rear Rear Bracket).jpg

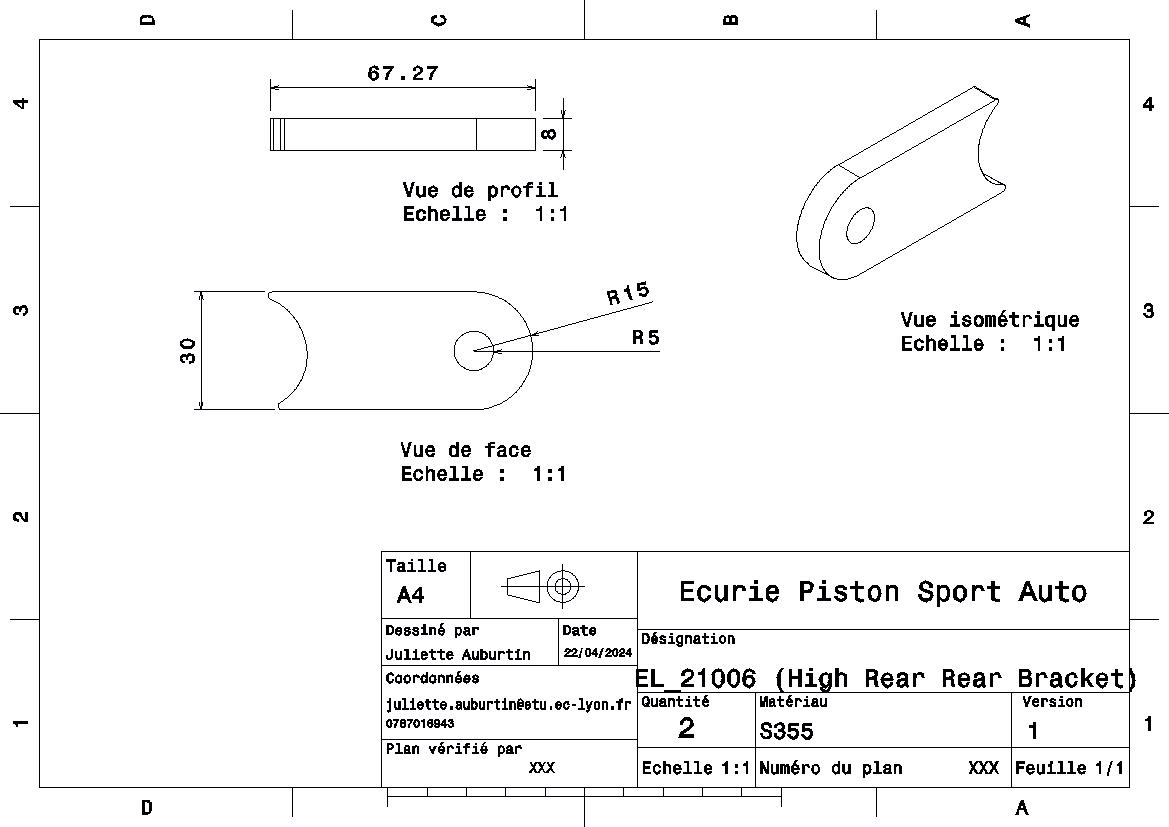
02 - Documentation/RC_Rendus_Compet/Eté 2024/SES/TSAC Attachment photos/EL_21006 (High Rear Rear Bracket).jpg
