EOSCogniton/ELIZ-2022/02 - Documentation/RC_Rendus_Compet/Eté 2024/SES/TSAC Attachment photos/Front.tif

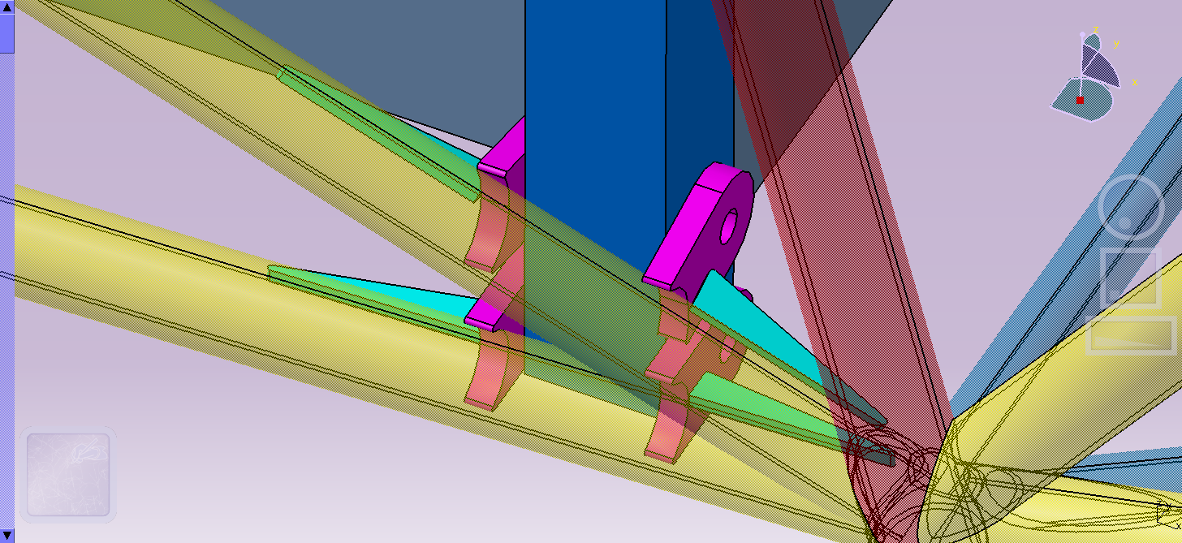
02 - Documentation/RC_Rendus_Compet/Eté 2024/SES/TSAC Attachment photos/Front.tif
