EOSCogniton/ELIZ-2022/02 - Documentation/RC_Rendus_Compet/Eté 2025/SES/systèmes lubrifiés.png

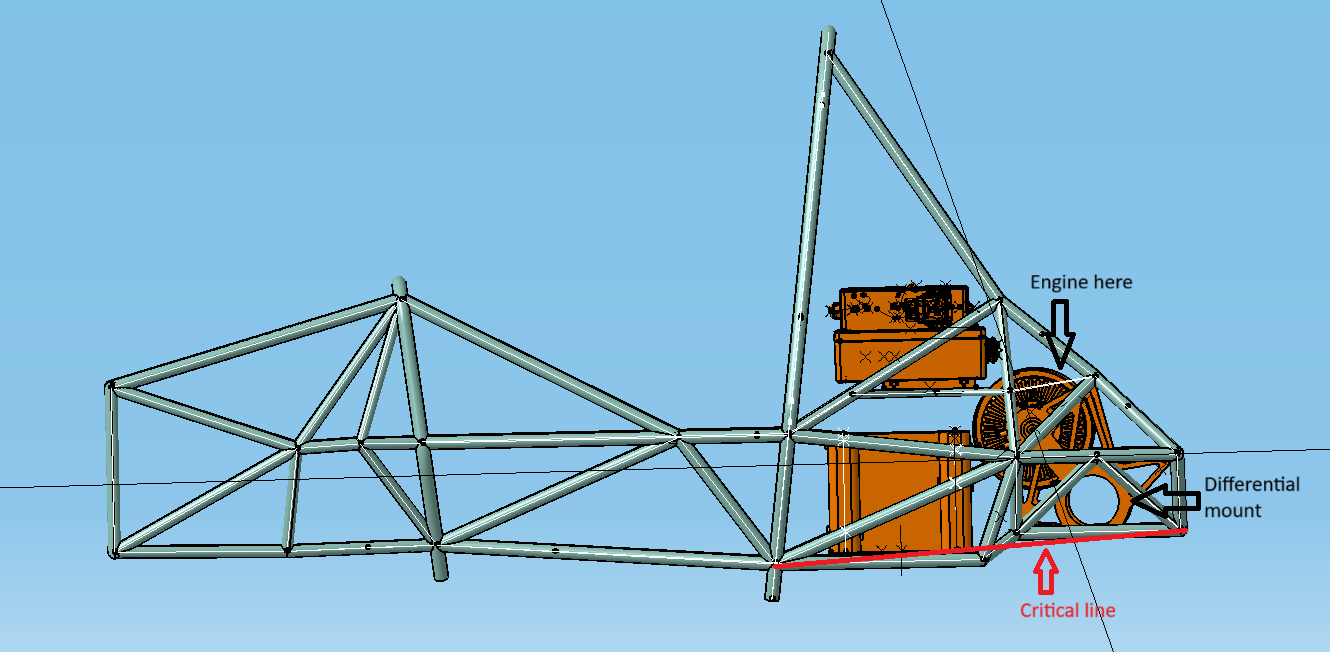
02 - Documentation/RC_Rendus_Compet/Eté 2025/SES/systèmes lubrifiés.png
