EOSCogniton/ELIZ-2022/03 - H901BENCH/Bancs et prototypes/banc ergo/2022-06-17 19_59_38-Window.png

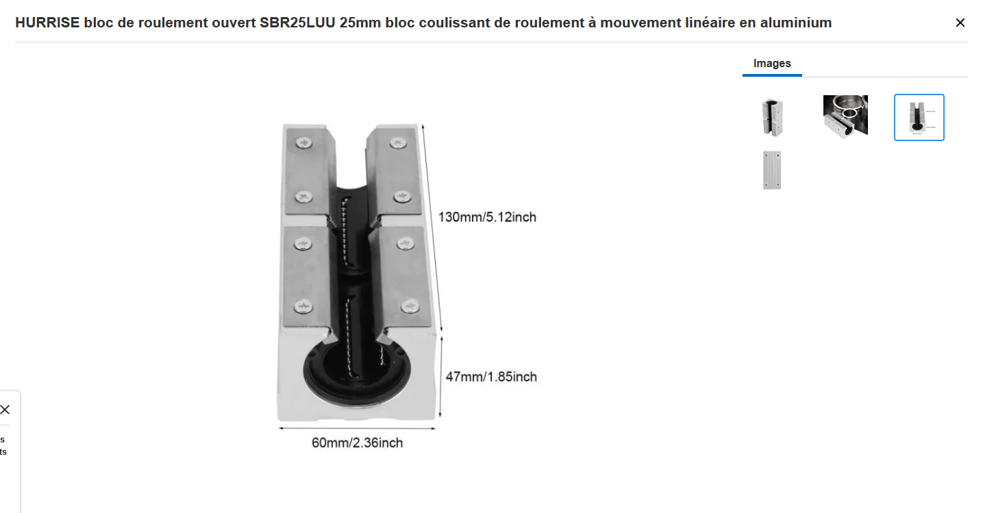
03 - H901BENCH/Bancs et prototypes/banc ergo/2022-06-17 19_59_38-Window.png
