EOSCogniton/ELIZ-2022/03 - H901BENCH/Bancs et prototypes/banc ergo/289910953_471915964622113_1568847782922603518_n.jpg

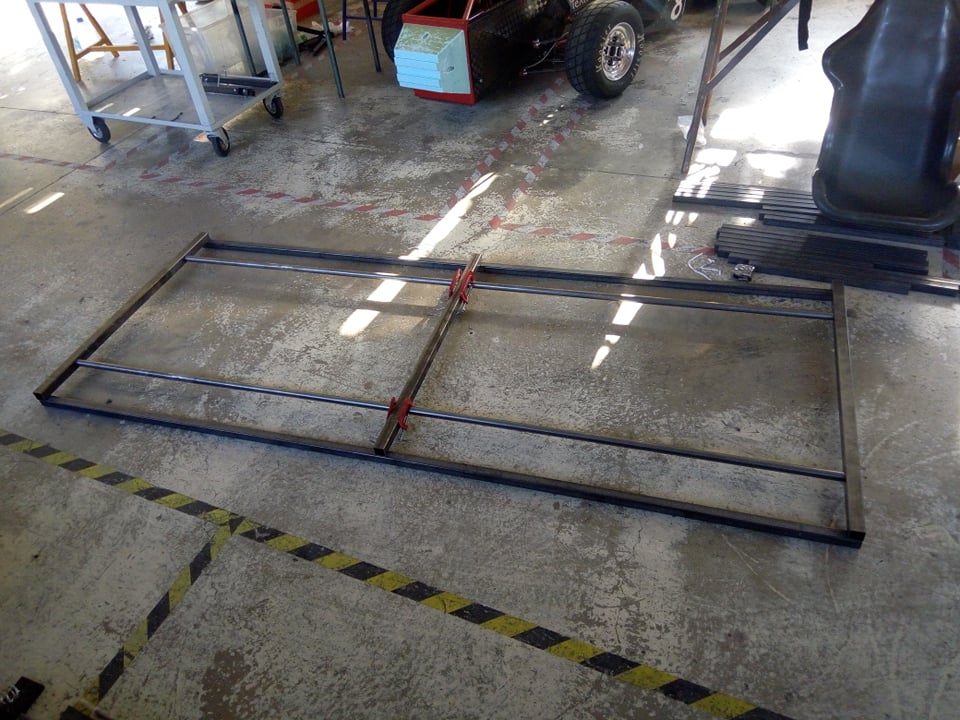
03 - H901BENCH/Bancs et prototypes/banc ergo/289910953_471915964622113_1568847782922603518_n.jpg
