EOSCogniton/ELIZ-2022/03 - H901BENCH/Bancs et prototypes/banc ergo/banc-ergo.png

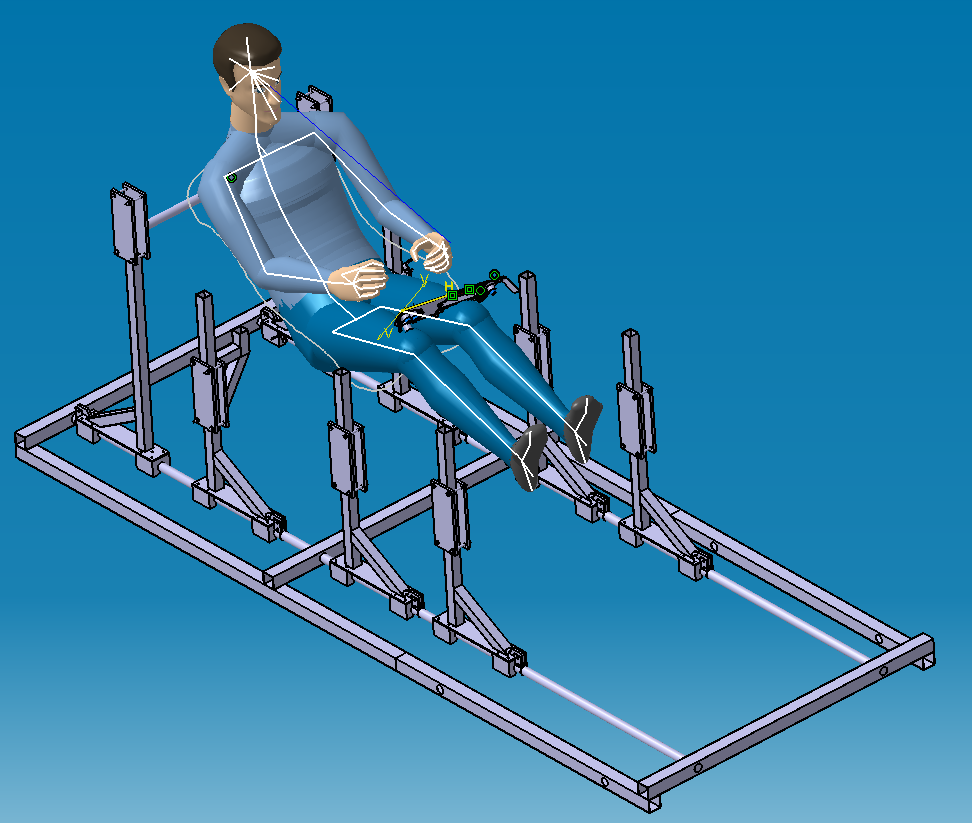
03 - H901BENCH/Bancs et prototypes/banc ergo/banc-ergo.png
