EOSCogniton/ELIZ-2022/03 - H901BENCH/Bancs et prototypes/banc ergo/documentation/279656564_1662025977463879_3420317699523870385_n.jpg

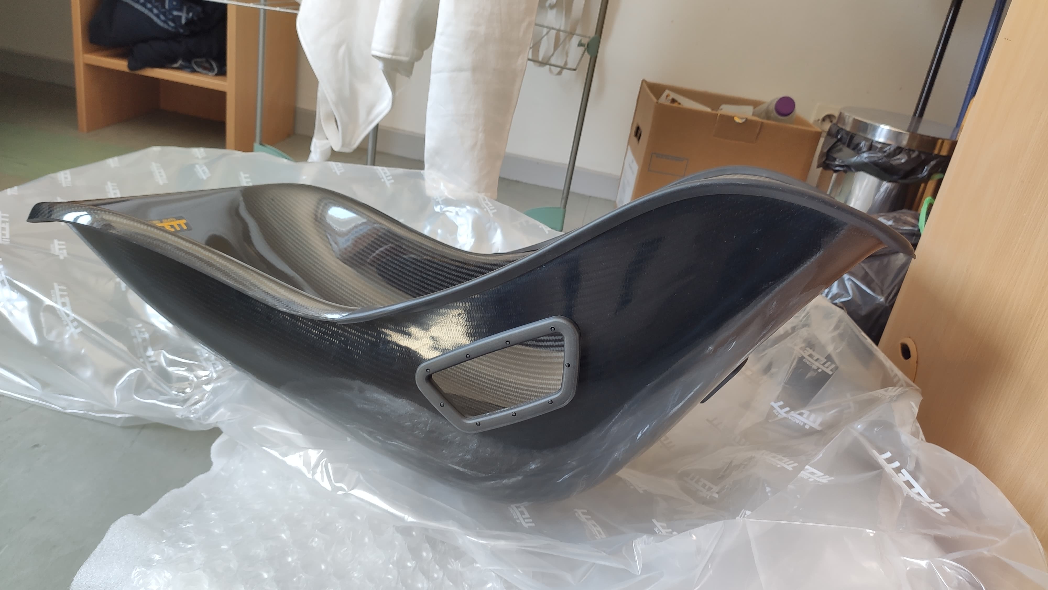
03 - H901BENCH/Bancs et prototypes/banc ergo/documentation/279656564_1662025977463879_3420317699523870385_n.jpg
