EOSCogniton/ELIZ-2022/03 - H901BENCH/Bancs et prototypes/banc ergo/documentation/279723270_539864260832111_1171870878692547965_n.jpg

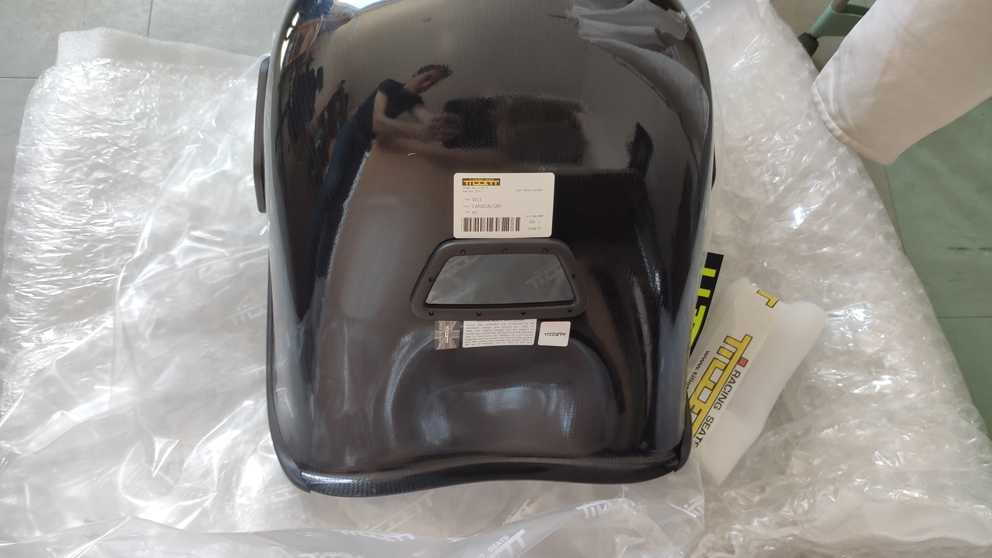
03 - H901BENCH/Bancs et prototypes/banc ergo/documentation/279723270_539864260832111_1171870878692547965_n.jpg
