EOSCogniton/ELIZ-2022/03 - H901BENCH/Bancs et prototypes/banc ergo/documentation/279912121_332806665449407_6657333633724223208_n.jpg

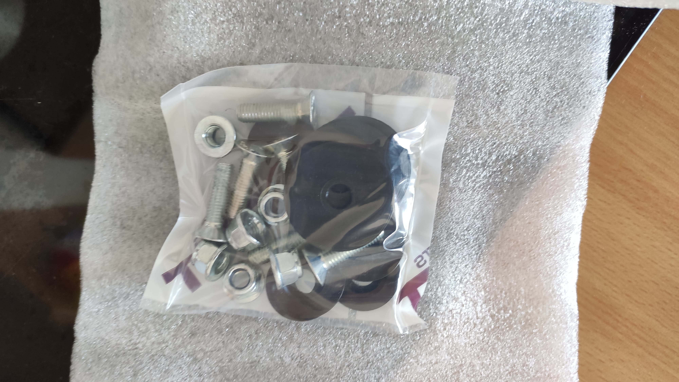
03 - H901BENCH/Bancs et prototypes/banc ergo/documentation/279912121_332806665449407_6657333633724223208_n.jpg
