EOSCogniton/ELIZ-2022/03 - H901BENCH/Bancs et prototypes/banc ergo/documentation/280055629_588726148908419_1213461718131169505_n.jpg

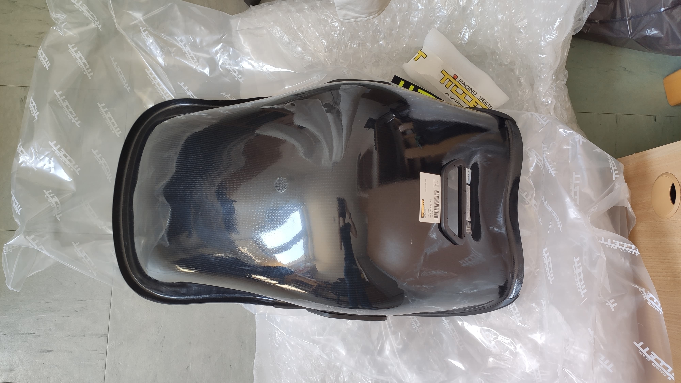
03 - H901BENCH/Bancs et prototypes/banc ergo/documentation/280055629_588726148908419_1213461718131169505_n.jpg
