EOSCogniton/ELIZ-2022/03 - H901BENCH/Bancs et prototypes/banc ergo/rails/2022-05-11 10_13_01-glissière mécanique - Recherche Google.png

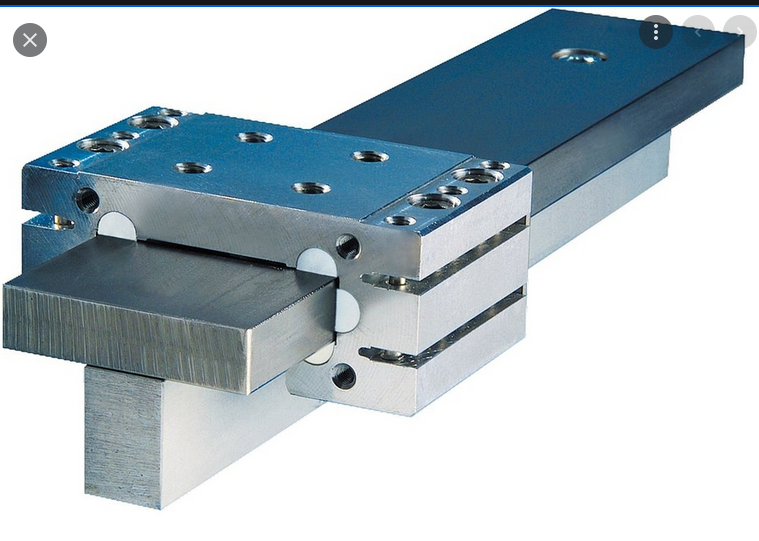
03 - H901BENCH/Bancs et prototypes/banc ergo/rails/2022-05-11 10_13_01-glissière mécanique - Recherche Google.png
