EOSCogniton/ELIZ-2022/03 - H901BENCH/Bancs et prototypes/proto batterie/module standard 48v/pieces/cellule 18650 MEP.jpg

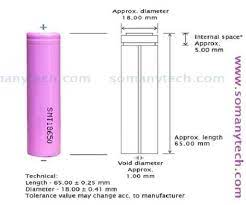
03 - H901BENCH/Bancs et prototypes/proto batterie/module standard 48v/pieces/cellule 18650 MEP.jpg
