EOSCogniton/ELIZ-2022/03 - H901BENCH/Bancs et prototypes/proto batterie/module standard 48v/simulations_thermiques/parametrique/documentation_modelisation_MES48V/2023-01-19 17_48_31-Window.jpg

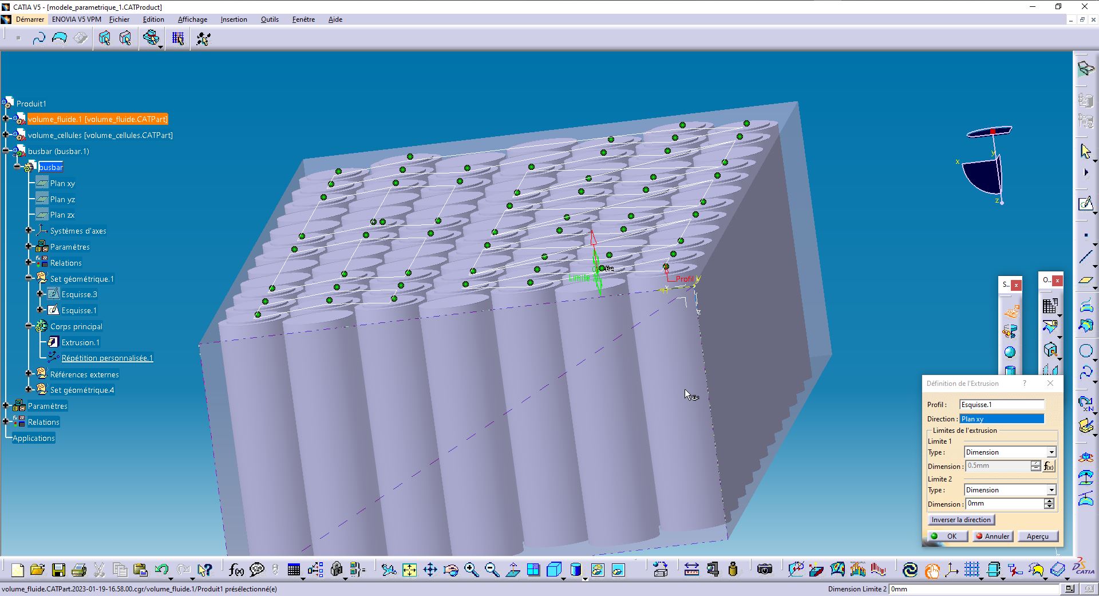
03 - H901BENCH/Bancs et prototypes/proto batterie/module standard 48v/simulations_thermiques/parametrique/documentation_modelisation_MES48V/2023-01-19 17_48_31-Window.jpg
