EOSCogniton/ELIZ-2022/03 - H901BENCH/Bancs et prototypes/proto batterie/module standard 48v/travail_JAuburtin/Connexions électriques/c5/Brouillons/c5_potable5.jpg

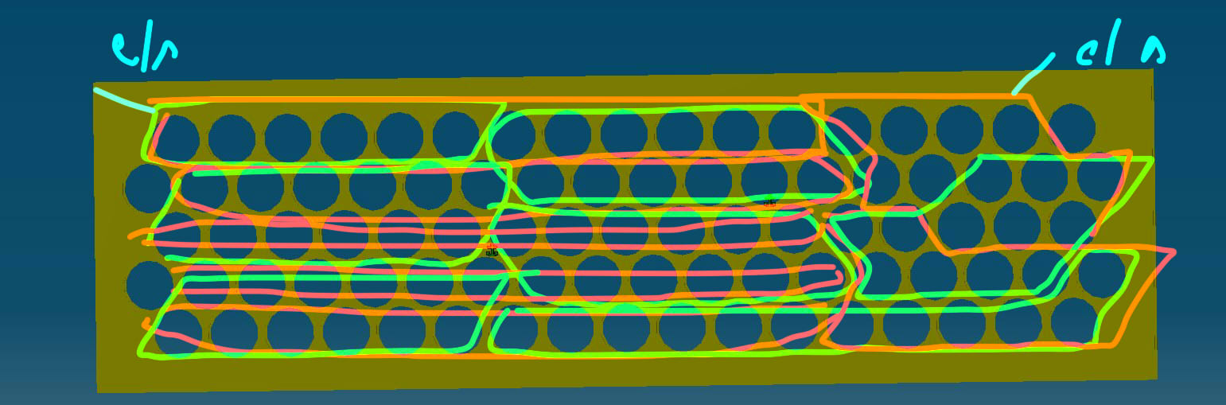
03 - H901BENCH/Bancs et prototypes/proto batterie/module standard 48v/travail_JAuburtin/Connexions électriques/c5/Brouillons/c5_potable5.jpg
