EOSCogniton/ELIZ-2022/03 - H901BENCH/BENCH 1/NDrive2-Software/images/images/unitek/Position_2014.bmp

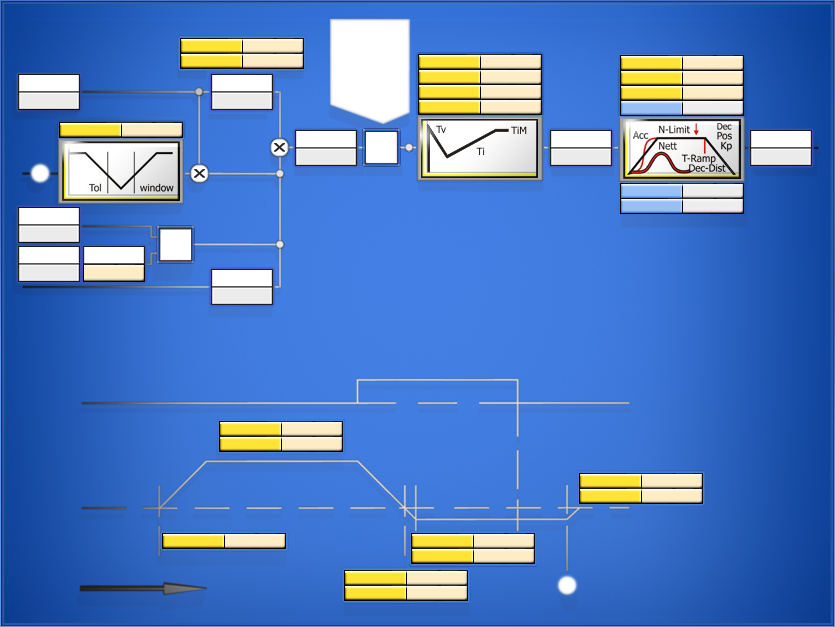
03 - H901BENCH/BENCH 1/NDrive2-Software/images/images/unitek/Position_2014.bmp
