EOSCogniton/ELIZ-2022/03 - H901BENCH/BENCH 1/NDrive2-Software/images/images/unitek/Speed_2014.png

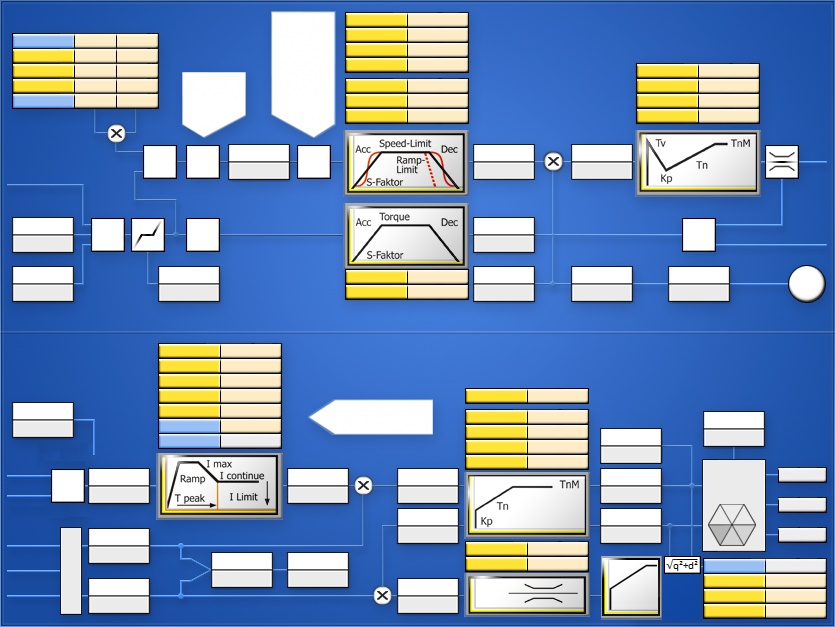
03 - H901BENCH/BENCH 1/NDrive2-Software/images/images/unitek/Speed_2014.png
