EOSCogniton/ELIZ-2022/Catia/Bancs et prototypes/banc ergo/documentation/2022-05-19 12_59_11-Window.png

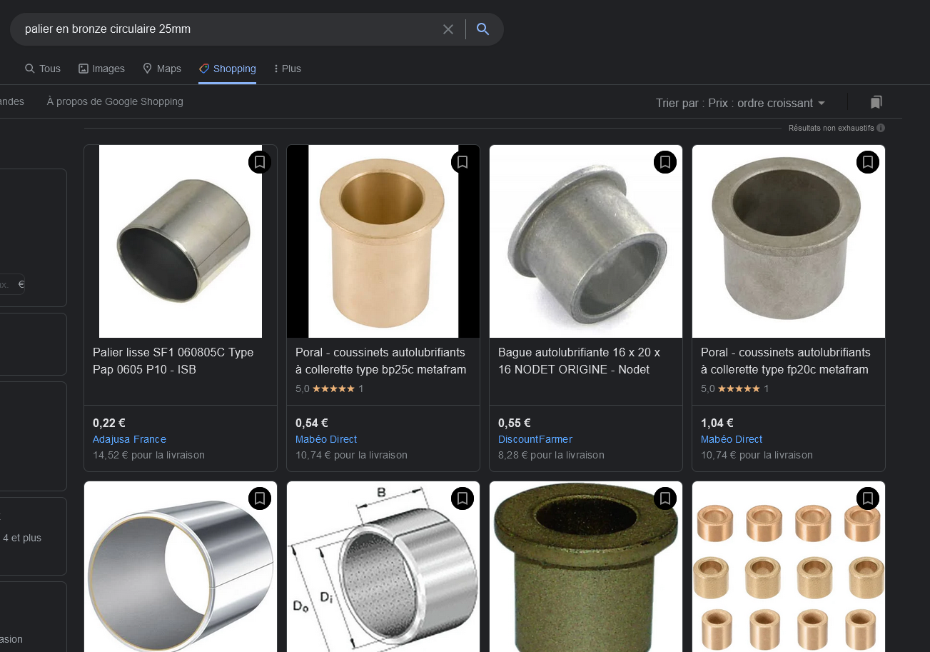
Catia/Bancs et prototypes/banc ergo/documentation/2022-05-19 12_59_11-Window.png
