EOSCogniton/ELIZ-2022/Catia/Bancs et prototypes/banc ergo/documentation/278388179_666104117824608_8467793082866683604_n.jpg

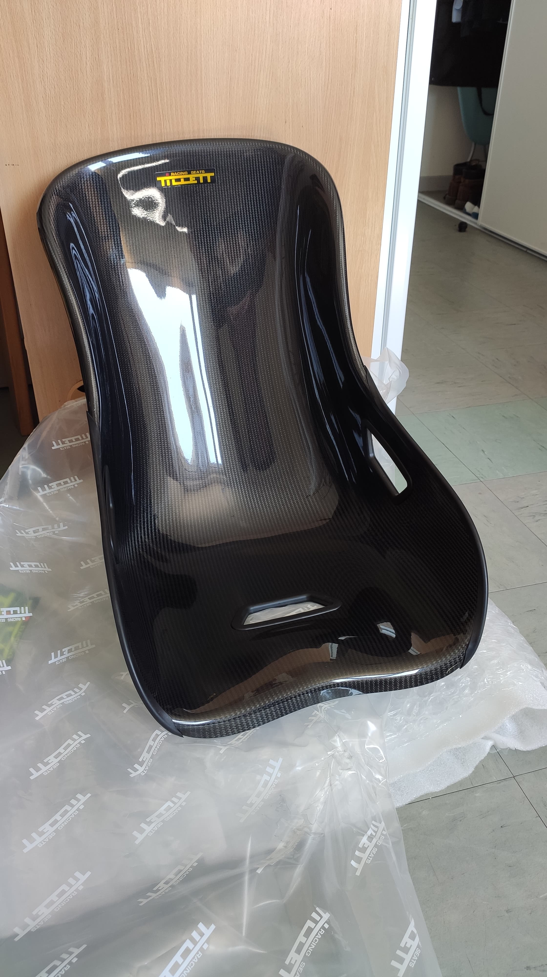
Catia/Bancs et prototypes/banc ergo/documentation/278388179_666104117824608_8467793082866683604_n.jpg
