EOSCogniton/ELIZ-2022/Catia/Bancs et prototypes/banc ergo/documentation/279902953_3407233502838058_2326856034201799243_n.jpg

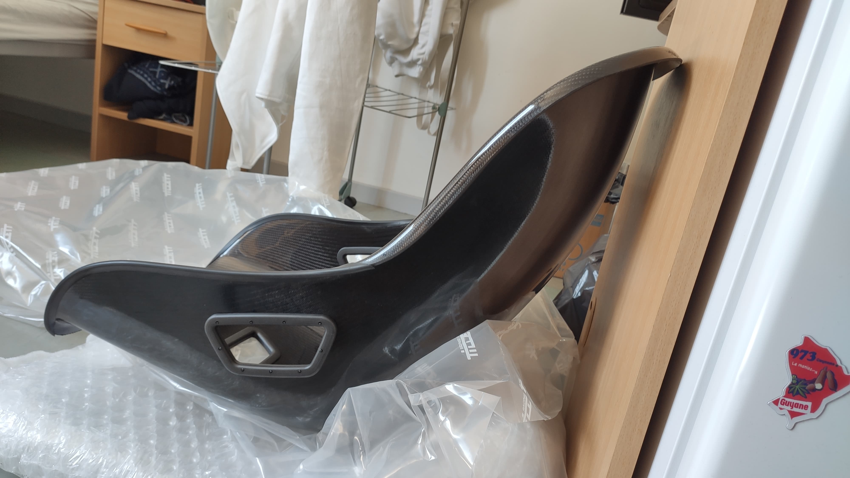
Catia/Bancs et prototypes/banc ergo/documentation/279902953_3407233502838058_2326856034201799243_n.jpg
