EOSCogniton/ELIZ-2022/Catia/Bancs et prototypes/banc ergo/rails/2022-05-11 10_13_15-glissière mécanique - Recherche Google.png

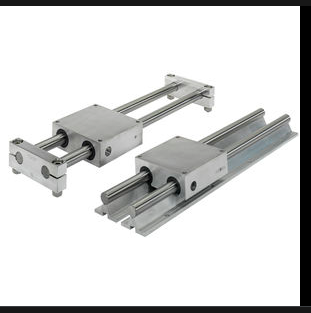
Catia/Bancs et prototypes/banc ergo/rails/2022-05-11 10_13_15-glissière mécanique - Recherche Google.png
