EOSCogniton/ELIZ-2022/Catia/Bancs et prototypes/proto batterie/module standard 48v/simulations_thermiques/parametrique/documentation_modelisation_MES48V/2023-01-19 18_01_43-Window.jpg

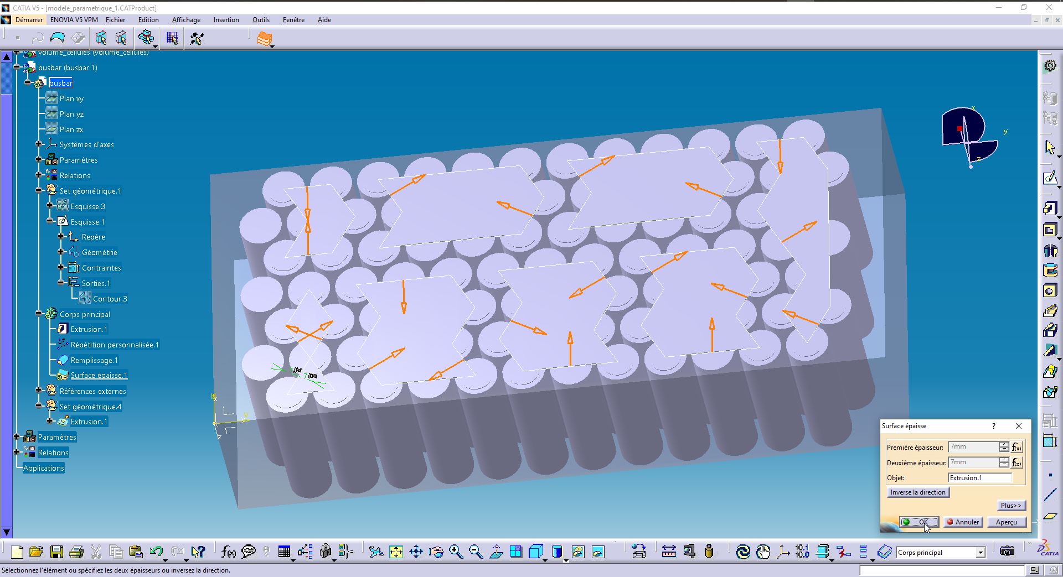
Catia/Bancs et prototypes/proto batterie/module standard 48v/simulations_thermiques/parametrique/documentation_modelisation_MES48V/2023-01-19 18_01_43-Window.jpg
