EOSCogniton/ELIZ-2022/Catia/Bancs et prototypes/proto batterie/module standard 48v/travail_JAuburtin/Connexions électriques/c5/Brouillons/c5_potable3.jpg

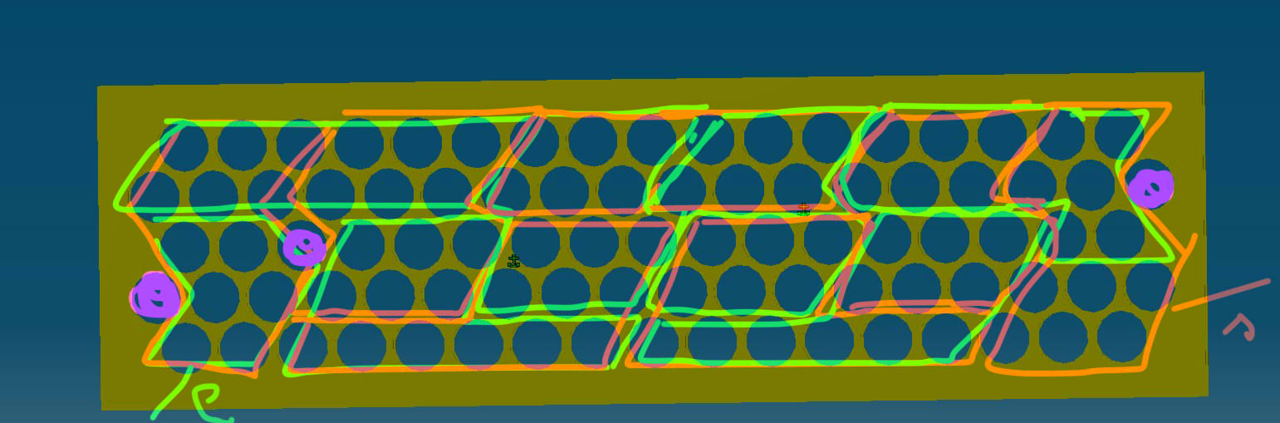
Catia/Bancs et prototypes/proto batterie/module standard 48v/travail_JAuburtin/Connexions électriques/c5/Brouillons/c5_potable3.jpg
