EOSCogniton/ELIZ-2022/Catia/Bancs et prototypes/proto batterie/module standard 48v/travail_JAuburtin/Connexions électriques/c7/Brouillons/c7_potable2.jpg

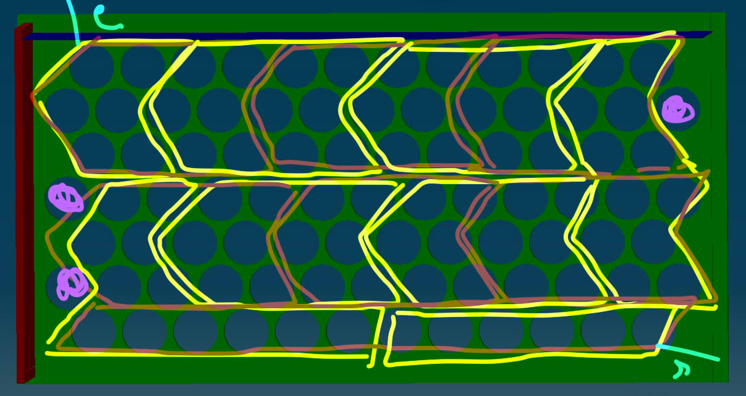
Catia/Bancs et prototypes/proto batterie/module standard 48v/travail_JAuburtin/Connexions électriques/c7/Brouillons/c7_potable2.jpg
