EOSCogniton/ELIZ-2022/Documentation/systemes/module standard 48v/images_reference/2022-09-29 10_26_17-Accumulator Learning Part 1_ Single Cells and How They Work - YouTube  Mozilla .jpg

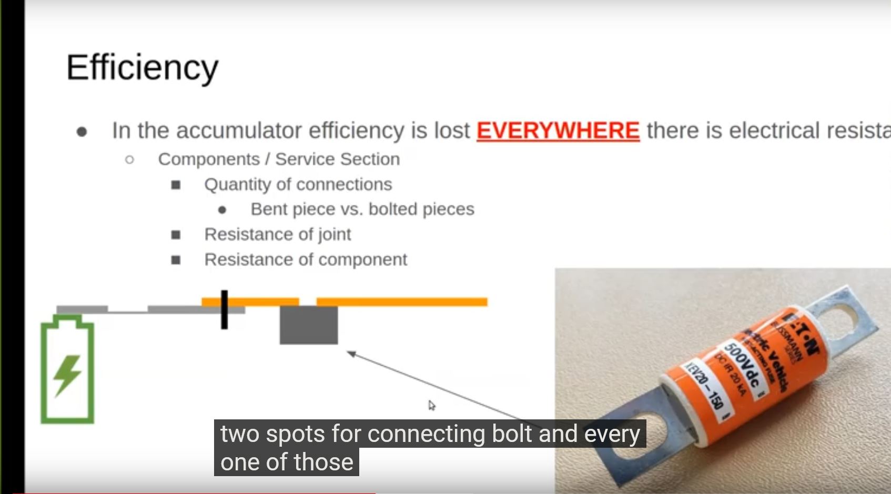
Documentation/systemes/module standard 48v/images_reference/2022-09-29 10_26_17-Accumulator Learning Part 1_ Single Cells and How They Work - YouTube Mozilla .jpg
