EOSCogniton/ELIZ-2022/Documentation/systemes/module standard 48v/images_reference/2022-09-29 12_05_47-Creating my single biggest D.I.Y. battery with 2800 18650 cells recovered from u.jpg

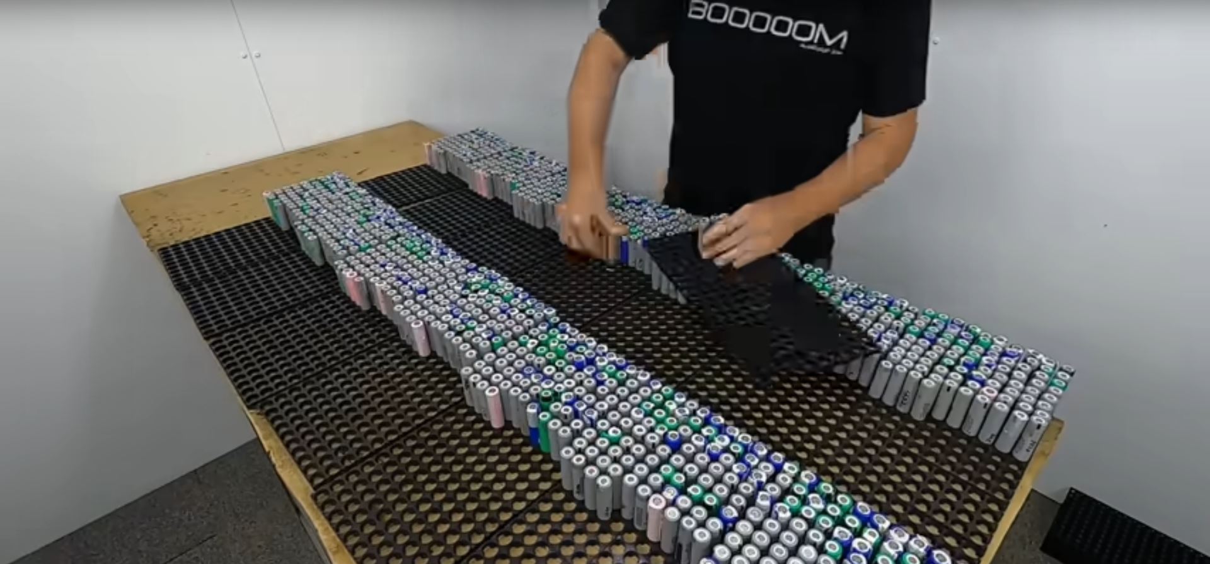
Documentation/systemes/module standard 48v/images_reference/2022-09-29 12_05_47-Creating my single biggest D.I.Y. battery with 2800 18650 cells recovered from u.jpg
