EOSCogniton/ELIZ-2022/02 - Documentation/LASMECA/Hors sujet Osiriz/Drivetrain_osiriz/HU-FS-Gearset_A_RequestOrder.pdf

V1.1 – Request & Order Form formula student gear set | 1

## FORMULA STUDENT GEAR SET

### Request & Order Form

(Please check where applicable)
[ ] Request
[ ] Order

Please fill out completely and ensure that all information is correct!

Ordering party (Team, University, Sponsor, …)

Company / Team
University name
Customer number (if known) Street
City
ZIP / Postal code
Country
Contact person
E-Mail
Phone number
VAT number / TAX ID

Deviating invoice address

Company / Team

University name
Street
City
ZIP / Postal code
Country

Deviating delivery address

Company / Team

University name
Street
City
ZIP / Postal code
Country
Contact person
Phone number

V1.1 – Request & Order Form formula student gear set | 2

AVAILABLE VARIANTS

Gear Set “AMK Version” | quantity | (Please check where applicable)
| [ ] with Sponsoring
| [ ] without Sponsoring
- 1x Sun gear “AMK” - 3x Stepped planets - 1x Ring gear - 3x Planetary bolts -12x Thrust washer | | HUMBEL Sponsoring requires the following conditions - HUMBEL logo on the gearbox cover or HUMBEL logo on the car - HUMBEL logo on team-website - 1x Instagram or LinkedIn Post (unboxing or assembly) - HUMBEL may call itself as “Team Sponsor”
Gear Set “DTI Version” | quantity
- 1x Sun gear “DTI” - 3x Stepped planets - 1x Ring gear - 3x Planetary bolts - 12x Thrust washer

(For a 4WD vehicle, 4 sets are required.)

[ ] We agree with the sponsoring conditions.

[ ] I would like to be informed about innovations & offers for the Formula Student Gear Set

in the future. (You can revoke this consent at any time by e-mail)

Date | Signature

Please send the completed form as PDF to fs-gearbox@humbel-gears.com
