EOSCogniton/ELIZ-2022/02 - Documentation/RC_Rendus_Compet/Eté 2025/CRD/BOM ARTEMIZ Version finale (1).xlsx

Sheet: BOM
System | Assembly | Part (25 chars max) | Sub-part | m/b | Comment (40 chars max) | Qty | ID
BR | Brake system front |  |  |  |  |  | BR_A0100
 |  | Front brake disc |  | b | In the front wheels | 2 | BR_01001
 |  | Front brake caliper |  | b | Beringer aerotec 2 pistons m10x1 | 2 | BR_01002
 |  | Front brake pad |  | b | In the calipers | 4 | BR_01003
BR | Brake system rear |  |  |  |  |  | BR_A0200
 |  | Rear brake disc |  | b | In the rear wheels | 2 | BR_02001
 |  | Rear brake caliper |  | b | Beringer aerotec 2 pistons m10x1 | 2 | BR_02002
 |  | Rear brake pad |  | b | In the calipers | 4 | BR_02003
BR | Brake master cylinder |  |  |  |  |  | BR_A0300
 |  | Master cylinder |  | b | Under the brake pedal | 2 | BR_003001
 |  | Reservoir |  | b | Under the brake pedal | 2 | BR_003002
 |  | Connector |  | b | Under the brake pedal | 4 | BR_003003
 |  | Wedge |  | b | Under the brake pedal | 2 | BR_003004
BR | Hose |  |  |  |  |  | BR_A0400
 |  | Rilsan |  | b |  | 8 | BR_A04001
 |  | Connector |  | b |  | 2 | BR_A04002
 |  | Hose |  | b |  | 2 | BR_A04003
 |  | Hose_R_T_R |  | b |  | 2 | BR_A04004
 |  | Hose_F_MC_T |  | b |  | 2 | BR_A04005
 |  | Hose_R_MC_T |  | b |  | 2 | BR_A04006
 |  | Hose_F_T_R |  | b |  | 2 | BR_A04007
 |  | Brake_T |  | b |  | 2 | BR_A04008
EL | Dash Panel |  |  |  |  |  | EL_A0100
 |  | Armature |  | m | Fixed to the front hoop | 1 | EL_001001
 |  | Screen |  | b | On the right side of the dashboard | 1 | EL_001002
 |  | Shutdown button |  | b | In the top right corner | 1 | EL_001003
 |  | Red led push button |  | b | In the bottom right corner | 1 | EL_001004
 |  | Push button |  | b | One in the bottom left corner, another next to red led push button | 2 | EL_001006
 |  | 2 Position switch |  | b | 2 next to red led push button and the other in the top left corner | 3 | EL_001007
 |  | 3 positions switch |  | b | At the right of the screen | 2 | EL_001008
 |  | Red led |  | b | Both in the top midddle | 2 | EL_001009
 |  | Green led |  | b | Top to red led push button | 1 | EL_001010
 |  | Controller housing |  | b | Behind the armature | 1 | EL_001011
EL | LV battery |  |  |  |  |  | EL_A0300
 |  | LV battery TYVA |  | b | On the rear side of the main hoop | 1 | EL_003001
 |  | LV battery support |  | m | Fixed between two bars | 1 | EL_003002
 |  | LV battery bracket |  | m | 2 fixed each side of the battery | 4 | EL_003003
EL | TS box |  |  |  |  |  | EL_A0400
 |  | BOPLA box |  | b | On top of the BAMOCAR, at the rear, behind the firewall | 1 | EL_004001
 |  | Fixation sheet |  | m | Inside the BOPLA box | 1 | EL_004002
 |  | Datalog sheet |  | m | On the fixation sheet | 1 | EL_004003
 |  | Copper bar |  | m | On the pods, on the fixation and data sheets | 3 | EL_004004
 |  | Pod 3mm |  | b | On the fixation and data sheet | 5 | EL_004006
 |  | Dissipative resistor |  | b | On the wall of the BOPLA box | 1 | EL_004008
 |  | Hall effect sensor |  | b | On the Fixation sheet | 1 | EL_004009
 |  | Relay |  | b | On the TSMP PCB | 1 | EL_004010
 |  | Small resistors 10kOhm |  | b | On the TSMP PCB | 2 | EL_004010_1
 |  | TSMP PCB |  | m | On the fixation sheet | 1 | EL_004010_2
 |  | Voltage sensor card |  | m | In the TS box | 2 | EL_004011
 |  | Battery connector |  | b | On the left side of the TS box |  | EL_004012
 |  | Relay control card |  | b | In the TS Box | 2 | EL_004016
 |  | Cable glands |  | b | On the walls of the TS box | 4 | EL_004017
EL | Switch support |  |  |  |  |  | EL_A0600
 |  | Master switch |  | b | On the right side | 2 | EL_006001
 |  | Master switch support |  | m | Between the main hoop and the rear hoop | 1 | EL_006002
 |  | Box cover TSMP |  | b | To protect TSMP from environment | 1 | EL_006003
 |  | Box clipsTSMP |  | b |  | 2 | EL_006004
 |  | Box cylinders clips TSMP |  | b |  | 2 | EL_006005
 |  | TSMP banana plug |  | b | At the left of the master switches | 2 | EL_006006
 |  | GND banana plug |  | b | At the left of TSMP banana plug | 1 | EL_006007
 |  | TSMP stickers |  | b | Next to respective plugs | 2 | EL_006008
 |  | GND stickers |  | b | Next to respective plug | 1 | EL_006009
EL | Inverter |  |  |  |  |  | EL_A0700
 |  | BAMOCAR |  | b | at the back, under the TSBox, on top of the battery | 1 | EL_007001
 |  | Cable gland |  | b | On the BAMOCAR, at the left | 5 | EL_007002
 |  | Support |  | m | Supporting the BAMOCAR on the chassis | 1 | EL_007003
EL | VCU |  |  |  |  |  | EL_A0800
 |  | VCU Ecotron EV2274A |  | b | Underneath the firewall | 1 | EL_008001
EL | Dashboard controller PCBA |  |  |  |  |  | EL_A0900
 |  | Controller PCB |  | b | In a box behind the dashboard | 1 | EL_009001
 |  | 4 pin wire to board M con. |  | b |  | 2 | EL_009002
 |  | 4 pin wire to board F con. |  | b |  | 2 | EL_009003
 |  | 6 pin CAN transceiver con. |  | b |  | 2 | EL_009004
 |  | CAN transceiver |  | b | Next to controller PCB | 2 | EL_009005
EL | BSPD PCBA |  |  |  |  |  | EL_A1000
 |  | BSPD PCB |  | m | In the aluminium diecast box | 1 | EL_010001
 |  | Open loop transducer |  | b | In the TS BOX | 1 | EL_010002
 |  | Pressure sensor 130bar |  | b | One at the front and another at the back | 2 | EL_010003
 |  | 6 pin wire to board M con. |  | b |  | 1 | EL_010004
 |  | 6 pin wire to board F con. |  | b |  | 1 | EL_010005
 |  | 5V voltage regulator |  | b |  | 1 | EL_010006
 |  | 12V dc coil relay 1RT |  | b |  | 1 | EL_010007
 |  | TVS protection diode |  | b |  | 3 | EL_010008
 |  | Fast switching diode |  | b |  | 2 | EL_010009
 |  | NMOS transistor |  | b |  | 2 | EL_010010
 |  | PMOS transistor |  | b |  | 1 | EL_010011
 |  | Dual voltage comparator |  | b |  | 3 | EL_010012
 |  | NOR Gate |  | b |  | 1 | EL_010013
 |  | 20kΩ trimmer resistor |  | b |  | 2 | EL_010014
 |  | 680kΩ resistor |  | b |  | 2 | EL_010015
 |  | 100kΩ resistor |  | b |  | 3 | EL_010016
 |  | 39kΩ resistor |  | b |  | 3 | EL_010017
 |  | 10kΩ resistor |  | b |  | 11 | EL_010018
 |  | 100Ω resistor |  | b |  | 4 | EL_010019
 |  | 10μF ceramic capacitor |  | b |  | 4 | EL_010020
 |  | 100nF ceramic capacitor |  | b |  | 6 | EL_010021
 |  | Aluminium diecast box |  | b | On the right side of the vehicle | 1 | EL_010022
EL | TSAL PCBA |  |  |  |  |  | EL_A1100
 |  | TSAL logic PCB |  | m | In a box beneath the top of the main hoop | 1 | EL_011001
 |  | 5 pin wire to board M con. |  | b |  | 2 | EL_011002
 |  | 5 pin wire to board F con. |  | b |  | 2 | EL_011003
 |  | 5V voltage regulator |  | b |  | 1 | EL_011004
 |  | Optocoupler |  | b |  | 2 | EL_011005
 |  | TVS protection diode |  | b |  | 1 | EL_011006
 |  | NMOS transistor |  | b |  | 2 | EL_011007
 |  | PMOS transistor |  | b |  | 2 | EL_011008
 |  | Dual voltage comparator |  | b |  | 5 | EL_011009
 |  | AND Gate |  | b |  | 1 | EL_011010
 |  | OR Gate |  | b |  | 1 | EL_011011
 |  | XNOR Gate |  | b |  | 1 | EL_011012
 |  | D-type flip-flops |  | b |  | 1 | EL_011013
 |  | Precision timer |  | b |  | 1 | EL_011014
 |  | 100kΩ resistor |  | b |  | 4 | EL_011015
 |  | 24kΩ resistor |  | b |  | 2 | EL_011016
 |  | 10kΩ resistor |  | b |  | 20 | EL_011017
 |  | 2,49kΩ resistor |  | b |  | 8 | EL_011018
 |  | 2kΩ resistor |  | b |  | 2 | EL_011019
 |  | 1kΩ resistor |  | b |  | 2 | EL_011020
 |  | 100Ω resistor |  | b |  | 4 | EL_011021
 |  | 680Ω through hole resist. |  | b |  | 1 | EL_011022
 |  | 33Ω through hole resistor |  | b |  | 2 | EL_011023
 |  | 10μF ceramic capacitor |  | b |  | 5 | EL_011024
 |  | 100nF ceramic capacitor |  | b |  | 11 | EL_011025
 |  | 10μF electrolytic capacitor |  | b |  | 2 | EL_011026
EL | SC circuit PCBA |  |  |  |  |  | EL_A1200
 |  | SC logic PCB |  | m | In a box next to the BSPD one | 1 | EL_012001
 |  | 4 pin wire to board M con. |  | b |  | 2 | EL_012002
 |  | 4 pin wire to board F con. |  | b |  | 2 | EL_012003
 |  | 6 pin wire to board M con. |  | b |  | 2 | EL_012004
 |  | 6 pin wire to board F con. |  | b |  | 2 | EL_012005
 |  | 5V voltage regulator |  | b |  | 1 | EL_012006
 |  | 12V dc coil relay 1RT |  | b |  | 3 | EL_012007
 |  | 12V dc, 35A relay DPNO |  | b |  | 2 | EL_012008
 |  | 12V dc, 5A relay DPNO |  | b |  | 1 | EL_012009
 |  | Optocoupler |  | b |  | 9 | EL_012010
 |  | TVS protection diode |  | b |  | 1 | EL_012011
 |  | Fast switching diode |  | b |  | 6 | EL_012012
 |  | Ultrafast rectifier |  | b |  | 1 | EL_012013
 |  | NMOS transistor |  | b |  | 4 | EL_012014
 |  | Dual voltage comparator |  | b |  | 1 | EL_012015
 |  | OR Gate |  | b |  | 2 | EL_012016
 |  | XOR Gate |  | b |  | 1 | EL_012017
 |  | Monostable multivibrator |  | b |  | 1 | EL_012018
 |  | D-type flip-flops |  | b |  | 1 | EL_012019
 |  | 100kΩ resistor |  | b |  | 5 | EL_012020
 |  | 10kΩ resistor |  | b |  | 13 | EL_012021
 |  | 4,3kΩ resistor |  | b |  | 10 | EL_012022
 |  | 2kΩ resistor |  | b |  | 1 | EL_012023
 |  | 1kΩ resistor |  | b |  | 1 | EL_012024
 |  | 680Ω through hole resist. |  | b |  | 2 | EL_012025
 |  | 100Ω resistor |  | b |  | 2 | EL_012026
 |  | 33Ω through hole resistor |  | b |  | 2 | EL_012027
 |  | 10μF ceramic capacitor |  | b |  | 5 | EL_012028
 |  | 100nF ceramic capacitor |  | b |  | 6 | EL_012029
 |  | 10μF electrolytic capacitor |  | b |  | 2 | EL_012030
EL | Accumulator electronics |  |  |  |  |  | EL_A1300
 |  | IMD housing |  | b | The power distribution unit in the TSAC | 1 | EL_013001
 |  | IMD connectors |  | b |  | 6 | EL_013002
 |  | IMD PCBA |  | b | In the power distribution unit | 1 | EL_013003
 |  | AMS housing |  | b | (c'est le même que l'IMD vu que c'est fourni par TYVA) | 1 | EL_013004
 |  | AMS connectors |  | b |  | 6 | EL_013005
 |  | AMS PCBA |  | b | In the power distribution unit | 1 | EL_A1400
 |  | TSAL AIR state housing |  |  | (y a pas) | 1 | EL_013007
 |  | TSAL AIR state connectors |  |  | (y a pas) | 4 | EL_013008
 |  | TSAL AIR state PCBA |  | m | (y a pas) | 1 | EL_A1500
 |  | Precharge circuit housing |  |  | (y a pas) | 1 | EL_013010
 |  | Precharge circuit connectors |  |  | (y a pas) | 2 | EL_013011
 |  | Precharge circuit PCBA |  |  | (y a pas) | 1 | EL_013012
 |  | Indicator voltage housing |  |  | (y a pas) | 1 | EL_013013
 |  | Indicator voltage connectors |  | b |  | 2 | EL_013014
 |  | Voltage indicator PCBA |  | m | In the upper container of the TSAC | 1 | EL_A1600
EL | Voltage indicator PCBA |  |  |  |  |  | EL_A1600
 |  | Indicator voltage PCB |  | m | In the upper container of the TSAC | 1 | EL_016001
 |  | 2 pin wire to board M con. |  | b |  | 3 | EL_016002
 |  | 2 pin wire to board F con. |  | b |  | 3 | EL_016003
 |  | Voltage regulator |  | b |  | 1 | EL_016004
 |  | Silicon diode |  | b |  | 1 | EL_016005
 |  | Ultrafast diode |  | b |  | 2 | EL_016006
 |  | 15V zener diode |  | b |  | 1 | EL_016007
 |  | NMOS transistor |  | b |  | 1 | EL_016008
 |  | Voltage comparator |  | b |  | 1 | EL_016009
 |  | Viper16 |  | b |  | 1 | EL_016010
 |  | 750kΩ resistor |  | b |  | 4 | EL_016011
 |  | 100kΩ resistor |  | b |  | 10 | EL_016012
 |  | 24kΩ resistor |  | b |  | 1 | EL_016013
 |  | 10kΩ resistor |  | b |  | 11 | EL_016014
 |  | 9,1kΩ resistor |  | b |  | 1 | EL_016015
 |  | 2,49kΩ resistor |  | b |  | 1 | EL_016016
 |  | 1kΩ resistor |  | b |  | 1 | EL_016017
 |  | 100Ω through hole resist. |  | b |  | 2 | EL_016018
 |  | 22Ω through hole resist. |  | b |  | 1 | EL_016019
 |  | 150nF ceramic capacitor |  | b |  | 2 | EL_016020
 |  | 100nF ceramic capacitor |  | b |  | 1 | EL_016021
 |  | 1,8nF ceramic capacitor |  | b |  | 1 | EL_016022
 |  | 220μF electrolytic capa. |  | b |  | 1 | EL_016023
 |  | 10μF 450V electrolytic capa. |  | b |  | 2 | EL_016024
 |  | 10μF 35V electrolytic capa. |  | b |  | 2 | EL_016025
 |  | 2,2mH through hole ind. |  | b |  | 1 | EL_016026
 |  | 1mH through hole ind. |  | b |  | 1 | EL_016027
EL | TSAL inverter voltage PCBA |  |  |  |  |  | EL_A1800
 |  | Indicator voltage PCB |  | m | In the upper container of the TSAC | 1 | EL_018001
 |  | Electronic components |  | b |  | 57 | EL_018002
EL | Battery |  |  |  |  |  | EL_A1800
 |  | TSAC |  | m |  | 1 | EL_2200
 |  | Module |  | b | in the TSAC | 4 | EL_A3200
 |  | Modules connectors |  | b | on top of modules | 3 | EL_A22001
 |  | AIR+ |  | b | inside container (LV part of TSAC) | 1 | EL_22002
 |  | AIR- |  | b | inside container | 1 | EL_22003
 |  | Precharge relay |  | b | inside container | 1 | EL_22004
 |  | Precharge resistor |  | b | inside container | 1 | EL_22005
 |  | Current sensor |  | b | inside container | 1 | EL_22006
 |  | Fuse |  | b | inside container | 1 | EL_22007
 |  | IMD |  | m | inside container | 1 | EL_22008
 |  | IMD SCS Maker |  | b | inside container | 1 | EL_22009
 |  | AMS |  | m | inside container | 1 | EL_22010
 |  | AVI |  | b | inside container | 1 | EL_22011
 |  | TSAC voltage sensor |  | b | inside container | 1 | EL_22012
 |  | Relay Controler |  | b | inside container | 1 | EL_22013
 |  | Short connector |  | b | inside container | 1 | EL_22014
 |  | Inside container connector |  | b | inside container | 2 | EL_22015
 |  | Long connector |  | b | inside container | 1 | EL_22016
 |  | Inside container |  | b | In the TSAC | 1 | EL_22017
 |  | HP plug |  | b | top of the TSAC | 1 | EL_22018
 |  | Receptable HP |  | b |  | 1 | EL_22019
 |  | Fan |  | b | side of TSAC | 4 | EL_22020
 |  | LED indicator |  | b |  | 1 | EL_22021
 |  | 5 pin LP connector |  | b |  | 3 | EL_22022
 |  | 2 pns LP connector |  | b |  | 2 | EL_22023
 |  | Cable gland |  | b |  | 4 | EL_22024
 |  | Fuse support |  | b |  | 1 | EL_22025
EL | AMS/IMD card |  |  |  |  |  | EL_A1800
 |  | Operationnal amplifier |  | b | On the AMS/IMS card | 1 | EL_22010_1
 |  | Analogic comparator |  | b | On the AMS/IMS card | 1 | EL_22010_2
 |  | Logic gate |  | b | On the AMS/IMS card | 2 | EL_22010_3
 |  | Logic gate |  | b | On the AMS/IMS card | 1 | EL_22010_4
 |  | Cable connector type 1 |  | b | On the AMS/IMS card | 7 | EL_22010_5
 |  | Cable connector type 2 |  | b | On the AMS/IMS card | 1 | EL_22010_6
 |  | Relay |  | b | On the AMS/IMS card | 1 | EL_22010_7
 |  | Relay |  | b | On the AMS/IMS card | 2 | EL_22010_8
 |  | Vishay |  | b | On the AMS/IMS card | 8 | EL_22010_9
 |  | Analogic comparator |  | b | On the AMS/IMS card | 1 | EL_22010_10
 |  | Resistor |  | b | On the AMS/IMS card | 22 | EL_22010_11
 |  | Converter |  | b | On the AMS/IMS card | 1 | EL_22010_12
 |  | Operationnal amplifier |  | b | On the AMS/IMS card | 1 | EL_22010_13
 |  | PCB |  | b | On the AMS/IMS card | 1 | EL_22010_14
EL | Charger |  |  |  |  |  | EL_A1800
 |  | Charger |  | b | Outside of the car | 1 | EL_23001
 |  | Banana jack type 1 |  | b | Outside of the car | 1 | EL_23002
 |  | Connector |  | b | Outside of the car | 2 | EL_23003
 |  | AMS/IMD Reset charger |  | b | Outside of the car | 1 | EL_23004
 |  | Converter |  | b | Outside of the car | 1 | EL_23005
 |  | Resistor |  | b | Outside of the car | 2 | EL_23006
 |  | LED light |  | b | Outside of the car | 2 | EL_23007
EL | VCU Bis card |  |  |  |  |  | EL_A1900
 |  | Capacitor 10n |  | b |  | 2 | EL_A19001
 |  | 4P Droit |  | b |  | 2 | EL_A19002
 |  | 2P Droit |  | b |  | 1 | EL_A19003
 |  | Resistor 8k2 |  | b |  | 8 | EL_A19004
 |  | Resistor 3k9 |  | b |  | 4 | EL_A19005
 |  | Alim LP TSR_0.5-2450 |  | b |  | 1 | EL_A19006
EL | SCS Maker card |  |  |  |  |  | EL_A2000
 |  | Capacitor 10n |  | b |  | 2 | EL_A20001
 |  | 2P Droit |  | b |  | 2 | EL_A20002
 |  | Resistor 3k9 |  | b |  | 1 | EL_A20003
 |  | Resistor 8k2 |  | b |  | 2 | EL_A20004
 |  | Alim LP TSR_0.5-2450 |  | b |  | 1 | EL_A20005
EL | SCS TSAL Green LED |  |  |  |  |  | EL_A2100
 |  | Capacitor 10n |  | b |  | 5 | EL_A21001
 |  | Capacitor 22u |  | b |  | 1 | EL_A21002
 |  | Comparator |  | b |  | 1 | EL_A21003
 |  | Gate AND |  | b |  | 1 | EL_A21004
 |  | Gate OR |  | b |  | 1 | EL_A21005
 |  | 2P Droit |  | b |  | 2 | EL_A21006
 |  | SSR CPC1394GR |  | b |  | 1 | EL_A21007
 |  | Resistor 2k2 |  | b |  | 1 | EL_A21008
 |  | Resistor 500k |  | b |  | 1 | EL_A21009
 |  | Resistor 10k |  | b |  | 2 | EL_A21010
 |  | Resistor 82k |  | b |  | 2 | EL_A21011
 |  | Resistor 12k |  | b |  | 2 | EL_A21012
 |  | Resistor 560k |  | b |  | 2 | EL_A21013
 |  | Opamp_Dual |  | b |  | 1 | EL_A21014
 |  | Alim LP TSR |  | b |  | 1 | EL_A21015
EL | SCS TSAL Red LED |  |  |  |  |  | EL_A2200
 |  | Capacitor_THT |  | b |  | 1 | EL_A22001
 |  | Capacitor 10n |  | b |  | 3 | EL_A22002
 |  | Gate AND |  | b |  | 1 | EL_A22003
 |  | 2P Droit |  | b |  | 2 | EL_A22004
 |  | SSR CPC1394GR |  | b |  | 1 | EL_A22005
 |  | Resistor 2k2 |  | b |  | 1 | EL_A22006
 |  | Resistor 500k |  | b |  | 1 | EL_A22007
 |  | Resistor 10k |  | b |  | 1 | EL_A22008
 |  | Resistor 82k |  | b |  | 2 | EL_A22009
 |  | Resistor 12k |  | b |  | 2 | EL_A22010
 |  | Opamp_Dual |  | b |  | 1 | EL_A22011
 |  | Alim LP TSR_0.5-2450 |  | b |  | 1 | EL_A22012
EN | Engine |  |  |  |  |  | EN_A0100
 |  | Emrax 228 MV LC |  | b | axial flux permanent magnet synchronous electric motor | 1 | EN_001001
 |  | Flanged shaft |  | m | at the right of the engine | 1 | EN_001002
 |  | Engine sprocket |  | b | connect the engine and the chain | 1 | EN_001003
 |  | Clamp washer |  | f | at the right of the engine sprocket | 1 | EN_001004
 |  | Bearing housing |  | m | at the right of the engine | 1 | EN_001005
 |  | Motor Shield part 1 |  | m | protect the engine | 1 | EN_001006
 |  | Motor Shield part 2 |  | m | protect the engine | 1 | EN_001007
 |  | Right engine bracket |  | m | to support the engine and the differential simultaneously | 1 | EN_001008
 |  | Left engine bracket |  | m | to support the engine and the differential simultaneously | 1 | EN_001009
 |  | Sprocket spacer |  | m | between the bearing and the sprocket | 1 | EN_001010
EN | Cooling system |  |  |  |  |  | EN_A0200
 |  | Radiator |  | b | On the left side of the vehicule near the back | 1 | EN_002001
 |  | Water pump |  | b | on the back of the vehicule | 1 | EN_002002
 |  | Brass connector |  | b | Connecting the different pipes together | 16 | EN_002003
 |  | Coolant lines |  | b | from the radiator to the water pomp to the motor at the back | 10 | EN_002006
 |  | Protective grid |  | b | in front of the radiator | 1 | EN_002009
 | Overflow bottle |  |  |  |  |  | EN_A02007
 |  | Overflow bottle body |  | m | At the back top | 1 | EN_002007_1
 |  | Overflow bottle cap |  | m | At the back top | 1 | EN_002007_2
 |  | Overflow primary pipe |  | b | At the rear back top | 3 | EN_002007_3
 | Catch-can |  |  |  |  |  | EN_A02007
 |  | Catch-can bottle body |  | b | At the back top | 1 | EN_002008_1
 |  | Catch-can bottle cap |  | m | At the back top | 1 | EN_002008_2
 |  | Overflow secondary pipe |  | b | At the rear back bottom | 1 | EN_002008_3
EN | Secondary transmission |  |  |  |  |  | EN_A0300
 |  | Excentric right |  | m | at the right of the differential, to clamp the chain | 1 | EN_003001
 |  | Chain |  | b | between the engine and the differential | 1 | EN_003002
 |  | Sprocket |  | b | at the right of the engine | 1 | EN_003003
 |  | Tripod |  | b | at the sides of the differential | 2 | EN_003004
 |  | Drexler differential |  | b | at the back | 1 | EN_003005
 |  | Sprocket bearer |  | m | at the right of the differential | 1 | EN_003006
 |  | Drexler bearing right |  | b | at the right of the differential | 1 | EN_003007
 |  | Right tripod housing |  | b | at the right of the differential | 1 | EN_003008
 |  | Left tripod housing |  | b | at the left of the differential | 1 | EN_003009
 |  | Drexler bearing left |  | b | at the left of the differential | 1 | EN_003010
 |  | Chain shield |  | m | over the chain | 1 | EN_003011
 |  | Driveshaft left |  | b | between the differential and the hub | 1 | EN_003012
 |  | Driveshaft right |  | b | between the differential and the hub | 1 | EN_003013
 |  | Excentric left |  | m | at the left of the differential, to clamp the chain | 1 | EN_003014
 |  | Tripod housing boot |  | b | at the ends of driveshaft | 2 | EN_003015
 |  | Chainshield bracket |  | m | near the engine, on the chassis | 2 | EN_003016
FR | Frame |  |  |  |  |  | FR_A0100
 |  | Round steel tubing |  | m | 28x1.5 25x1.5 20x1.5 & 15x1.5 |  | FR_001001
 |  | Round bent steel tubing |  | m | 30x2 | 2 | FR_001002
FR | Body |  |  |  |  |  | FR_A0200
 |  | Nose |  | m | moulded carbon fiber | 1 | FR_002001
 |  | Side plates |  | m | pressured water cut carbon pans | 2 | FR_002002
 |  | Push-clips |  | b | two on each side | 4 | FR_002004
 |  | Hook and loop belts |  | b |  | 3 | MS_A0300
FR | Throttle pedal |  |  |  |  |  | FR_A0300
 |  | Frame throttle |  | m | basis of the pedal | 1 | FR_003001
 |  | Footrest |  | m | top part of the pedal | 1 | FR_003002
 |  | Pedal stick |  | m | Below the footrest. | 1 | FR_003003
 |  | Fixing rail |  | m | allows the pedal to be adjusted in depth | 2 | FR_003004
 |  | Rail wedge |  | m | holds the rail with a bolt | 2 | FR_003005
 |  | Threated rod |  | b | is used to adjust the pedal depth | 2 | FR_003006
 |  | Front rail wedge |  | m | holds the rail with a bolt | 2 | FR_003007
 |  | Negative mechanical stop |  | m | End stop for the pedal stem | 1 | FR_003008
 |  | Positive mechanical stop |  | m | End stop for the pedal stem | 1 | FR_003009
 |  | Pedal bearing |  | b | part that allows rotation of the pedal stick | 2 | FR_003010
 |  | Springs |  | b | ensure the pedal's callback | 2 | FR_003011
 |  | Potentiometer |  | b | sensor | 2 | FR_003012
 |  | Rear Potentiometer Threaded rods |  | b | fix the potentiometer | 1 | FR_003013
 |  | Front Potentiometer Threaded rods |  | b | fix the potentiometer | 1 | FR_003014
 |  | Axle Spacer |  | m | Spacer at the basis of the throttle pedal stem | 1 | FR_003015
FR | Brake pedal |  |  |  |  |  | FR_A0400
 |  | Frame brake |  | m | basis of the pedal | 1 | FR_004001
 |  | Brake pedal stick |  | m | Below the footrest. | 1 | FR_004002
 |  | Footrest |  | m | top part of the pedal | 1 | FR_004003
 |  | Master cylinder |  | b | Piston under the frame. | 2 | FR_004004
 |  | Master cylinder wedge |  | m | at the basis of the pedal stick. | 2 | FR_004005
 |  | Brake fixing rail |  | m | allows the pedal to be adjusted in depth | 2 | FR_004006
 |  | Brake R Fixing Rail Wedge |  | m | holds the rail with a bolt | 2 | FR_004007
 |  | Brake F Fixing Rail Wedge |  | m | holds the rail with a bolt | 2 | FR_004008
 |  | Distribution Brake Axle |  | b | part of the break distribution system | 1 | FR_004009
 |  | Distribution Axle Tread |  | b | part of the break distribution system | 2 | FR_004010
 |  | Distribution Cylinder |  | b | part of the break distribution system | 1 | FR_004011
 |  | Distribution Ball Joint |  | b | part of the break distribution system | 1 | FR_004012
 |  | BOTS Support |  | m | holds the BOTS | 1 | FR_004013
 |  | BOTS |  | b | under the frame brake. | 1 | FR_004014
 |  | Brake Pedal Hose Wedge |  | m | in front of the pedal stick | 1 | FR_004015
 |  | cylinder screw Distribution |  | b | part of the break distribution system | 2 | FR_004016
 |  | Brake Pedale Bearing |  | b | part that allows rotation of the pedal stick | 2 | FR_004017
 |  | Brake Threated Rod |  | b | support of the frame brake into the fixing rails. | 2 | FR_004018
FR | Crash box |  |  |  |  |  | FR_A0500
 |  | Impact attenuator |  | b | crashbox in front of the car | 1 | FR_005001
 |  | Anti-intrusion plate |  | m | aluminium plate which the crashboxed is bolted to | 1 | FR_005002
FR | Floor pan |  |  |  |  |  | FR_A0600
 |  | Front plate |  | m | Front part of the floor pan | 1 | FR_006001
 |  | Cockpit plate |  | m | Rear part of the floor pan | 1 | FR_006002
MS | Seat |  |  |  |  |  | MS_A0100
 |  | Seat |  | b | at the center of the cockpit | 1 | MS_001001
MS | Head restraint |  |  |  |  |  | MS_A0200
 |  | Support |  | m | beside the foam | 1 | MS_002001
 |  | Foam |  | b |  | 1 | MS_002002
MS | Harness |  |  |  |  |  | MS_A0300
 |  | Harness |  | b | attached to the tubing | 1 | MS_003001
 |  | Roll bar padding |  | b | on the main hoop | 2 | MS_003004
MS | Firewall |  |  |  |  |  | MS_A0400
 |  | Middle part |  | m | Part of the firewall | 1 | MS_004001
 |  | Upper part |  | m | Part of the firewall | 1 | MS_004002
 |  | Lower part |  | m | Part of the firewall | 1 | MS_004003
ST | Steering rack |  |  |  |  |  | ST_A0100
 |  | Steering rack Narrcob |  | b | between the front wheels, in front of the seat | 1 | ST_001001
ST | Steering column |  |  |  |  |  | ST_A0200
 |  | Column |  | m | over the steering rack | 1 | ST_002001
 |  | Rigid coupling column/rack |  | b | between the column and the rack, behind the pedals | 1 | ST_002002
 |  | U joint |  | b | in front of the steering wheel | 1 | ST_002003
ST | Tie rod |  |  |  |  |  | ST_A0300
 |  | Rod tube |  | b | carbon tube | 2 | ST_003001
 |  | Insert sup |  | m | alu 7075 T6 | 2 | ST_003002
 |  | Wedge |  | m |  | 2 | ST_003003
 |  | Insert middle |  | m | alu 7075 T6 | 2 | ST_003004
ST | Steering rack support |  |  |  |  |  | ST_A0400
 |  | Half moon top |  | m | behind the rack, in front of the seat | 2 | ST_004001
 |  | Half moon bottom |  | m | behind the rack, in front of the seat | 2 | ST_004002
 |  | Left bracket |  | m | behind the rack, in front of the seat | 1 | ST_004003
 |  | Right bracket |  | m | behind the rack, in front of the seat | 1 | ST_004004
ST | Steering rack protection |  |  |  |  |  | ST_A0500
 |  | Protection rack |  | m | behind the rack, in front of the seat | 2 | ST_005003
ST | Steering shaft pivot |  |  |  |  |  | ST_A0600
 |  | Steering upper shaft |  | m | between the column and the steering wheel | 1 | ST_006001
 |  | Steering bore |  | m | between the column and the steering wheel | 1 | ST_006002
 |  | Fixation tube |  | m | between the column and the steering wheel | 2 | ST_006003
 |  | QR shaft |  | b | between the column and the steering wheel | 1 | ST_006004
 |  | Circlips M30 |  | b | between the column and the steering wheel | 1 | ST_006005
 |  | Fixation U joint |  | m | between the steering wheel and the ball joint | 2 | ST_006006
 |  | Ball joint |  | b | on the column | 1 | ST_006007
 |  | Steering shaft pivot sheet |  | m | behind the ball joint | 1 | ST_006008
 |  | Roller bearing |  | b | between the column and the steering wheel | 2 | ST_006009
ST | Steering wheel |  |  |  |  |  | ST_A0700
 |  | Steering wheel |  | b | in front of the seat | 1 | ST_007001
 |  | Shift spacer light |  | b | in front of the steering wheel | 1 | ST_007002
 |  | Quick release |  | b | in front of the steering wheel | 1 | ST_007003
SU | Front upper A-arm |  |  |  |  |  | SU_A0100
 |  | Front rod |  | b | carbon tube at the front | 2 | SU_001001
 |  | Rear rod |  | b | carbon tube at the rear | 2 | SU_001002
 |  | Outer bearing support |  | m | Wheel side, extremity of the A-arm alu 7075 T6 | 2 | SU_001003
 |  | Inner bearing support |  | m | Frame side, aluminium 7075 T6 | 4 | SU_001004
SU | Front lower A-arm |  |  |  |  |  | SU_A0200
 |  | Front rod |  | b | carbon tube at the front | 2 | SU_002001
 |  | Rear rod |  | b | carbon tube at the rear | 2 | SU_002002
 |  | Outer bearing support |  | m | Wheel side, extremity of the A-arm alu 7075 T6 | 2 | SU_002003
 |  | Inner bearing support |  | m | Frame side, aluminium 7075 T6 | 4 | SU_002004
SU | Rear upper A-arm |  |  |  |  |  | SU_A0300
 |  | Front rod |  | b | carbon tube at the front | 2 | SU_003001
 |  | Rear rod |  | b | carbon tube at the rear | 2 | SU_003002
 |  | Outer bearing support |  | m | Wheel side, extremity of the A-arm alu 7075 T6 | 2 | SU_003003
 |  | Inner bearing support |  | m | Frame side, aluminium 7075 T6 | 4 | SU_003004
SU | Rear lower A-arm |  |  |  |  |  | SU_A0400
 |  | Front rod |  | b | carbon tube at the front | 2 | SU_004001
 |  | Rear rod |  | b | carbon tube at the rear | 2 | SU_004002
 |  | Outer bearing support |  | m | Wheel side, extremity of the A-arm alu 7075 T6 | 2 | SU_004003
 |  | Inner bearing support |  | m | Frame side, aluminium 7075 T6 | 4 | SU_004004
SU | Tie rod |  |  |  |  |  | SU_A0500
 |  | Tube |  | b | carbon tube | 2 | SU_005001
 |  | Inner bearing support |  | m | aluminium 7075 T6, Oval, 2 screws, frame side | 2 | SU_005002
 |  | Wedge |  | m | RED, frame side | 2 | SU_005003
 |  | Outer bearing support |  | m | aluminium 7075 T6, wheel side, 1 screw | 2 | SU_005004
SU | Front bell crank |  |  |  | Triangle shape, under frame |  | SU_A0600
 |  | Front rocker |  | m | under the front absorber | 4 | SU_006001
 |  | Pivot joint spacer |  | m | under the front absorber | 4 | SU_006002
 |  | Ball joint spacer |  | m | above and under ball joint | 60 | SU_006003
 |  | Ohlins ball joint spacer |  | m | above and under ball joint | 16 | SU_006004
SU | Rear bell crank |  |  |  |  |  | SU_A0800
 |  | Rear rocker |  | m | at the sides of the rear absorber | 4 | SU_008001
SU | Front upright assy |  |  |  |  |  | SU_A1000
 |  | Front upright |  | m | Aluminium 7075 T6 | 2 | SU_01001
 |  | Upper arm bracket |  | m | Aluminium 7075 T6 | 2 | SU_01002
SU | Rear upright assy |  |  |  |  |  | SU_A1100
 |  | Rear upright |  | m | Aluminium 7075 T6 | 2 | SU_011001
 |  | Upper arm bracket |  | m | Aluminium 7075 T6 | 2 | SU_011002
 |  | Camber shim 2mm |  | m | Aluminium 2017 T4 | 10 | SU_011003
 |  | Camber shim 1mm |  | m | Aluminium 2017 T4 | 6 | SU_011004
SU | Front suspension rod |  |  |  |  |  | SU_A1200
 |  | Front pullrod |  | b | carbon tube | 2 | SU_012001
 |  | Tapped insert right |  | m | aluminium 7075 T6 | 8 | SU_012002
SU | Rear suspension rod |  |  |  |  |  | SU_A1300
 |  | Rear pushrod |  | b | carbon tube | 2 | SU_013001
SU | Anti roll bar |  |  |  |  |  | SU_A1400
 |  | ARB bar |  | m |  | 1 | SU_014001
 |  | Y stop |  | m | Aluminium 2017 T4 | 2 | SU_014002
 |  | Blade |  | m | Acier S355 | 4 | SU_014003
 |  | Pad |  | m |  | 2 | SU_014004
 |  | Blade link |  | b | SKF PRM 151715 | 2 | SU_014005
 |  | Brushing support |  | m | Aluminium 2017 T4 | 2 | SU_014006
 |  | Bracket |  | m |  | 2 | SU_014007
WT | Wheel Assy |  |  |  |  |  | WT_A0100
 |  | Rim oz magnesium |  | b | 13 inch | 4 | WT_001001
 |  | Tire Continental 13 |  | b |  | 4 | WT_001002
WT | Front hub |  |  |  |  |  | WT_A0200
 |  | Hub |  | m | Al7075t6 | 2 | WT_002001
 |  | Brake bell |  | m | Al2017T4 | 2 | WT_002002
 |  | Bearing washer |  | m | Al2017T4 | 2 | WT_002003
 |  | Inner bearing spacer |  | m | Aluminium 2017A | 4 | WT_002004
 |  | Speed disc |  | m | Acier S235 | 2 | WT_002005
 |  | Wheel stud |  | b |  | 8 | WT_002006
 |  | Bearing |  | b | S71910 ACD/P4A | 4 | WT_002007
 |  | Lock washer |  | b |  | 2 | WT_002008
 |  | Lock nut |  | b |  | 2 | WT_002009
WT | Rear hub |  |  |  |  |  | WT_A0300
 |  | Hub |  | m | Al7075t6 | 2 | WT_003001
 |  | Rear brake bell |  | m | Al2017T4 | 2 | WT_003002
 |  | Outboard tripod housing |  | m |  | 2 | WT_003003
 |  | Tripod housing spacer |  | m | Al2017T4 | 4 | WT_003004
 |  | Bearing washer |  | b | Al2017T4 | 2 | WT_002003
 |  | Speed disc |  | b | Acier S235 | 2 | WT_002005
 |  | Bearing |  | b | S71910 ACD/P4A | 4 | WT_002007
 |  | Tripod housing boot |  | b |  | 2 | EN_003015

Sheet: BR-Brake system
System | Assembly | Part (25 chars max) | m/b | Comment (40 chars max) | Qty | ID
BR | Brake system front |  |  |  |  | BR_A0100
 |  | Front brake disc | b | In the front wheels | 2 | BR_01001
 |  | Front brake caliper | b | Beringer aerotec 2 pistons m10x1 | 2 | BR_01002
 |  | Front brake pad | b | In the calipers | 4 | BR_01003
BR | Brake system rear |  |  |  |  | BR_A0200
 |  | Rear brake disc | b | In the rear wheels | 2 | BR_02001
 |  | Rear brake caliper | b | Beringer aerotec 2 pistons m10x1 | 2 | BR_02002
 |  | Rear brake pad | b | In the calipers | 4 | BR_02003
BR | Brake master cylinder |  |  |  |  | BR_A0300
 |  | Master cylinder | b | Under the brake pedal | 2 | BR_003001
 |  | Reservoir | b | Under the brake pedal | 2 | BR_003002
 |  | Connector | b | Under the brake pedal | 4 | BR_003003
 |  | Wedge | b | Under the brake pedal | 2 | BR_003004
BR | Hose |  |  |  |  | BR_A0400
 |  | Rilsan | b |  | 8 | BR_A04001
 |  | Connector | b |  | 2 | BR_A04002
 |  | Hose | b |  | 2 | BR_A04003
 |  | Hose_R_T_R | b |  | 2 | BR_A04004
 |  | Hose_F_MC_T | b |  | 2 | BR_A04005
 |  | Hose_R_MC_T | b |  | 2 | BR_A04006
 |  | Hose_F_T_R | b |  | 2 | BR_A04007
 |  | Brake_T | b |  | 2 | BR_A04008

Sheet: EL-Electrical
System | Assembly | Part (25 chars max) | m/b | Comment (40 chars max) | Qty | ID
EL | Dash Panel |  |  |  |  | EL_A0100
 |  | Armature | m | Fixed to the front hoop | 1 | EL_001001
 |  | Screen | b | On the right side of the dashboard | 1 | EL_001002
 |  | Shutdown button | b | In the top right corner | 1 | EL_001003
 |  | Red led push button | b | In the bottom right corner | 1 | EL_001004
 |  | Push button | b | One in the bottom left corner, another next to red led push button | 2 | EL_001006
 |  | 2 Position switch | b | 2 next to red led push button and the other in the top left corner | 3 | EL_001007
 |  | 3 positions switch | b | At the right of the screen | 2 | EL_001008
 |  | Red led | b | Both in the top midddle | 2 | EL_001009
 |  | Green led | b | Top to red led push button | 1 | EL_001010
 |  | Controller housing | b | Behind the armature | 1 | EL_001011
EL | LV battery |  |  |  |  | EL_A0300
 |  | LV battery TYVA | b | On the rear side of the main hoop | 1 | EL_003001
 |  | LV battery support | m | Fixed between two bars | 1 | EL_003002
 |  | LV battery bracket | m | 2 fixed each side of the battery | 4 | EL_003003
EL | TS box |  |  |  |  | EL_A0400
 |  | BOPLA box | b | On top of the BAMOCAR, at the rear, behind the firewall | 1 | EL_004001
 |  | Fixation sheet | m | Inside the BOPLA box | 1 | EL_004002
 |  | Datalog sheet | m | On the fixation sheet | 1 | EL_004003
 |  | Copper bar | m | On the pods, on the fixation and data sheets | 3 | EL_004004
 |  | Pod 3mm | b | On the fixation and data sheet | 5 | EL_004006
 |  | Dissipative resistor | b | On the wall of the BOPLA box | 1 | EL_004008
 |  | Hall effect sensor | b | On the Fixation sheet | 1 | EL_004009
 |  | Relay | b | On the TSMP PCB | 1 | EL_004010
 |  | Small resistors 10kOhm | b | On the TSMP PCB | 2 | EL_004010_1
 |  | TSMP PCB | m | On the fixation sheet | 1 | EL_004010_2
 |  | Voltage sensor card | m | In the TS box | 2 | EL_004011
 |  | Battery connector | b | On the left side of the TS box |  | EL_004012
 |  | Relay control card | b | In the TS Box | 2 | EL_004016
 |  | Cable glands | b | On the walls of the TS box | 4 | EL_004017
EL | Switch support |  |  |  |  | EL_A0600
 |  | Master switch | b | On the right side | 2 | EL_006001
 |  | Master switch support | m | Between the main hoop and the rear hoop | 1 | EL_006002
 |  | Box cover TSMP | b | To protect TSMP from environment | 1 | EL_006003
 |  | Box clipsTSMP | b |  | 2 | EL_006004
 |  | Box cylinders clips TSMP | b |  | 2 | EL_006005
 |  | TSMP banana plug | b | At the left of the master switches | 2 | EL_006006
 |  | GND banana plug | b | At the left of TSMP banana plug | 1 | EL_006007
 |  | TSMP stickers | b | Next to respective plugs | 2 | EL_006008
 |  | GND stickers | b | Next to respective plug | 1 | EL_006009
EL | Inverter |  |  |  |  | EL_A0700
 |  | BAMOCAR | b | at the back, under the TSBox, on top of the battery | 1 | EL_007001
 |  | Cable gland | b | On the BAMOCAR, at the left | 5 | EL_007002
 |  | Support | m | Supporting the BAMOCAR on the chassis | 1 | EL_007003
EL | VCU |  |  |  |  | EL_A0800
 |  | VCU Ecotron EV2274A | b | Underneath the firewall | 1 | EL_008001
EL | Dashboard controller PCBA |  |  |  |  | EL_A0900
 |  | Controller PCB | b | In a box behind the dashboard | 1 | EL_009001
 |  | 4 pin wire to board M con. | b |  | 2 | EL_009002
 |  | 4 pin wire to board F con. | b |  | 2 | EL_009003
 |  | 6 pin CAN transceiver con. | b |  | 2 | EL_009004
 |  | CAN transceiver | b | Next to controller PCB | 2 | EL_009005
EL | BSPD PCBA |  |  |  |  | EL_A1000
 |  | BSPD PCB | m | In the aluminium diecast box | 1 | EL_010001
 |  | Open loop transducer | b | In the TS BOX | 1 | EL_010002
 |  | Pressure sensor 130bar | b | One at the front and another at the back | 2 | EL_010003
 |  | 6 pin wire to board M con. | b |  | 1 | EL_010004
 |  | 6 pin wire to board F con. | b |  | 1 | EL_010005
 |  | 5V voltage regulator | b |  | 1 | EL_010006
 |  | 12V dc coil relay 1RT | b |  | 1 | EL_010007
 |  | TVS protection diode | b |  | 3 | EL_010008
 |  | Fast switching diode | b |  | 2 | EL_010009
 |  | NMOS transistor | b |  | 2 | EL_010010
 |  | PMOS transistor | b |  | 1 | EL_010011
 |  | Dual voltage comparator | b |  | 3 | EL_010012
 |  | NOR Gate | b |  | 1 | EL_010013
 |  | 20kΩ trimmer resistor | b |  | 2 | EL_010014
 |  | 680kΩ resistor | b |  | 2 | EL_010015
 |  | 100kΩ resistor | b |  | 3 | EL_010016
 |  | 39kΩ resistor | b |  | 3 | EL_010017
 |  | 10kΩ resistor | b |  | 11 | EL_010018
 |  | 100Ω resistor | b |  | 4 | EL_010019
 |  | 10μF ceramic capacitor | b |  | 4 | EL_010020
 |  | 100nF ceramic capacitor | b |  | 6 | EL_010021
 |  | Aluminium diecast box | b | On the right side of the vehicle | 1 | EL_010022
EL | TSAL PCBA |  |  |  |  | EL_A1100
 |  | TSAL logic PCB | m | In a box beneath the top of the main hoop | 1 | EL_011001
 |  | 5 pin wire to board M con. | b |  | 2 | EL_011002
 |  | 5 pin wire to board F con. | b |  | 2 | EL_011003
 |  | 5V voltage regulator | b |  | 1 | EL_011004
 |  | Optocoupler | b |  | 2 | EL_011005
 |  | TVS protection diode | b |  | 1 | EL_011006
 |  | NMOS transistor | b |  | 2 | EL_011007
 |  | PMOS transistor | b |  | 2 | EL_011008
 |  | Dual voltage comparator | b |  | 5 | EL_011009
 |  | AND Gate | b |  | 1 | EL_011010
 |  | OR Gate | b |  | 1 | EL_011011
 |  | XNOR Gate | b |  | 1 | EL_011012
 |  | D-type flip-flops | b |  | 1 | EL_011013
 |  | Precision timer | b |  | 1 | EL_011014
 |  | 100kΩ resistor | b |  | 4 | EL_011015
 |  | 24kΩ resistor | b |  | 2 | EL_011016
 |  | 10kΩ resistor | b |  | 20 | EL_011017
 |  | 2,49kΩ resistor | b |  | 8 | EL_011018
 |  | 2kΩ resistor | b |  | 2 | EL_011019
 |  | 1kΩ resistor | b |  | 2 | EL_011020
 |  | 100Ω resistor | b |  | 4 | EL_011021
 |  | 680Ω through hole resist. | b |  | 1 | EL_011022
 |  | 33Ω through hole resistor | b |  | 2 | EL_011023
 |  | 10μF ceramic capacitor | b |  | 5 | EL_011024
 |  | 100nF ceramic capacitor | b |  | 11 | EL_011025
 |  | 10μF electrolytic capacitor | b |  | 2 | EL_011026
EL | SC circuit PCBA |  |  |  |  | EL_A1200
 |  | SC logic PCB | m | In a box next to the BSPD one | 1 | EL_012001
 |  | 4 pin wire to board M con. | b |  | 2 | EL_012002
 |  | 4 pin wire to board F con. | b |  | 2 | EL_012003
 |  | 6 pin wire to board M con. | b |  | 2 | EL_012004
 |  | 6 pin wire to board F con. | b |  | 2 | EL_012005
 |  | 5V voltage regulator | b |  | 1 | EL_012006
 |  | 12V dc coil relay 1RT | b |  | 3 | EL_012007
 |  | 12V dc, 35A relay DPNO | b |  | 2 | EL_012008
 |  | 12V dc, 5A relay DPNO | b |  | 1 | EL_012009
 |  | Optocoupler | b |  | 9 | EL_012010
 |  | TVS protection diode | b |  | 1 | EL_012011
 |  | Fast switching diode | b |  | 6 | EL_012012
 |  | Ultrafast rectifier | b |  | 1 | EL_012013
 |  | NMOS transistor | b |  | 4 | EL_012014
 |  | Dual voltage comparator | b |  | 1 | EL_012015
 |  | OR Gate | b |  | 2 | EL_012016
 |  | XOR Gate | b |  | 1 | EL_012017
 |  | Monostable multivibrator | b |  | 1 | EL_012018
 |  | D-type flip-flops | b |  | 1 | EL_012019
 |  | 100kΩ resistor | b |  | 5 | EL_012020
 |  | 10kΩ resistor | b |  | 13 | EL_012021
 |  | 4,3kΩ resistor | b |  | 10 | EL_012022
 |  | 2kΩ resistor | b |  | 1 | EL_012023
 |  | 1kΩ resistor | b |  | 1 | EL_012024
 |  | 680Ω through hole resist. | b |  | 2 | EL_012025
 |  | 100Ω resistor | b |  | 2 | EL_012026
 |  | 33Ω through hole resistor | b |  | 2 | EL_012027
 |  | 10μF ceramic capacitor | b |  | 5 | EL_012028
 |  | 100nF ceramic capacitor | b |  | 6 | EL_012029
 |  | 10μF electrolytic capacitor | b |  | 2 | EL_012030
EL | Accumulator electronics |  |  |  |  | EL_A1300
 |  | IMD housing | b | The power distribution unit in the TSAC | 1 | EL_013001
 |  | IMD connectors | b |  | 6 | EL_013002
 |  | IMD PCBA | b | In the power distribution unit | 1 | EL_013003
 |  | AMS housing | b | (c'est le même que l'IMD vu que c'est fourni par TYVA) | 1 | EL_013004
 |  | AMS connectors | b |  | 6 | EL_013005
 |  | AMS PCBA | b | In the power distribution unit | 1 | EL_A1400
 |  | TSAL AIR state housing |  | (y a pas) | 1 | EL_013007
 |  | TSAL AIR state connectors |  | (y a pas) | 4 | EL_013008
 |  | TSAL AIR state PCBA | m | (y a pas) | 1 | EL_A1500
 |  | Precharge circuit housing |  | (y a pas) | 1 | EL_013010
 |  | Precharge circuit connectors |  | (y a pas) | 2 | EL_013011
 |  | Precharge circuit PCBA |  | (y a pas) | 1 | EL_013012
 |  | Indicator voltage housing |  | (y a pas) | 1 | EL_013013
 |  | Indicator voltage connectors | b |  | 2 | EL_013014
 |  | Voltage indicator PCBA | m | In the upper container of the TSAC | 1 | EL_A1600
EL | Voltage indicator PCBA |  |  |  |  | EL_A1600
 |  | Indicator voltage PCB | m | In the upper container of the TSAC | 1 | EL_016001
 |  | 2 pin wire to board M con. | b |  | 3 | EL_016002
 |  | 2 pin wire to board F con. | b |  | 3 | EL_016003
 |  | Voltage regulator | b |  | 1 | EL_016004
 |  | Silicon diode | b |  | 1 | EL_016005
 |  | Ultrafast diode | b |  | 2 | EL_016006
 |  | 15V zener diode | b |  | 1 | EL_016007
 |  | NMOS transistor | b |  | 1 | EL_016008
 |  | Voltage comparator | b |  | 1 | EL_016009
 |  | Viper16 | b |  | 1 | EL_016010
 |  | 750kΩ resistor | b |  | 4 | EL_016011
 |  | 100kΩ resistor | b |  | 10 | EL_016012
 |  | 24kΩ resistor | b |  | 1 | EL_016013
 |  | 10kΩ resistor | b |  | 11 | EL_016014
 |  | 9,1kΩ resistor | b |  | 1 | EL_016015
 |  | 2,49kΩ resistor | b |  | 1 | EL_016016
 |  | 1kΩ resistor | b |  | 1 | EL_016017
 |  | 100Ω through hole resist. | b |  | 2 | EL_016018
 |  | 22Ω through hole resist. | b |  | 1 | EL_016019
 |  | 150nF ceramic capacitor | b |  | 2 | EL_016020
 |  | 100nF ceramic capacitor | b |  | 1 | EL_016021
 |  | 1,8nF ceramic capacitor | b |  | 1 | EL_016022
 |  | 220μF electrolytic capa. | b |  | 1 | EL_016023
 |  | 10μF 450V electrolytic capa. | b |  | 2 | EL_016024
 |  | 10μF 35V electrolytic capa. | b |  | 2 | EL_016025
 |  | 2,2mH through hole ind. | b |  | 1 | EL_016026
 |  | 1mH through hole ind. | b |  | 1 | EL_016027
EL | TSAL inverter voltage PCBA |  |  |  |  | EL_A1800
 |  | Indicator voltage PCB | m | In the upper container of the TSAC | 1 | EL_018001
 |  | Electronic components | b |  | 57 | EL_018002
EL | Battery |  |  |  |  | EL_A1800
 |  | TSAC | m |  | 1 | EL_2200
 |  | Module | b | in the TSAC | 4 | EL_A3200
 |  | Modules connectors | b | on top of modules | 3 | EL_A22001
 |  | AIR+ | b | inside container (LV part of TSAC) | 1 | EL_22002
 |  | AIR- | b | inside container | 1 | EL_22003
 |  | Precharge relay | b | inside container | 1 | EL_22004
 |  | Precharge resistor | b | inside container | 1 | EL_22005
 |  | Current sensor | b | inside container | 1 | EL_22006
 |  | Fuse | b | inside container | 1 | EL_22007
 |  | IMD | m | inside container | 1 | EL_22008
 |  | IMD SCS Maker | b | inside container | 1 | EL_22009
 |  | AMS | m | inside container | 1 | EL_22010
 |  | AVI | b | inside container | 1 | EL_22011
 |  | TSAC voltage sensor | b | inside container | 1 | EL_22012
 |  | Relay Controler | b | inside container | 1 | EL_22013
 |  | Short connector | b | inside container | 1 | EL_22014
 |  | Inside container connector | b | inside container | 2 | EL_22015
 |  | Long connector | b | inside container | 1 | EL_22016
 |  | Inside container | b | In the TSAC | 1 | EL_22017
 |  | HP plug | b | top of the TSAC | 1 | EL_22018
 |  | Receptable HP | b |  | 1 | EL_22019
 |  | Fan | b | side of TSAC | 4 | EL_22020
 |  | LED indicator | b |  | 1 | EL_22021
 |  | 5 pin LP connector | b |  | 3 | EL_22022
 |  | 2 pns LP connector | b |  | 2 | EL_22023
 |  | Cable gland | b |  | 4 | EL_22024
 |  | Fuse support | b |  | 1 | EL_22025
EL | AMS/IMD card |  |  |  |  | EL_A1800
 |  | Operationnal amplifier | b | On the AMS/IMS card | 1 | EL_22010_1
 |  | Analogic comparator | b | On the AMS/IMS card | 1 | EL_22010_2
 |  | Logic gate | b | On the AMS/IMS card | 2 | EL_22010_3
 |  | Logic gate | b | On the AMS/IMS card | 1 | EL_22010_4
 |  | Cable connector type 1 | b | On the AMS/IMS card | 7 | EL_22010_5
 |  | Cable connector type 2 | b | On the AMS/IMS card | 1 | EL_22010_6
 |  | Relay | b | On the AMS/IMS card | 1 | EL_22010_7
 |  | Relay | b | On the AMS/IMS card | 2 | EL_22010_8
 |  | Vishay | b | On the AMS/IMS card | 8 | EL_22010_9
 |  | Analogic comparator | b | On the AMS/IMS card | 1 | EL_22010_10
 |  | Resistor | b | On the AMS/IMS card | 22 | EL_22010_11
 |  | Converter | b | On the AMS/IMS card | 1 | EL_22010_12
 |  | Operationnal amplifier | b | On the AMS/IMS card | 1 | EL_22010_13
 |  | PCB | b | On the AMS/IMS card | 1 | EL_22010_14
EL | Charger |  |  |  |  | EL_A1800
 |  | Charger | b | Outside of the car | 1 | EL_23001
 |  | Banana jack type 1 | b | Outside of the car | 1 | EL_23002
 |  | Connector | b | Outside of the car | 2 | EL_23003
 |  | AMS/IMD Reset charger | b | Outside of the car | 1 | EL_23004
 |  | Converter | b | Outside of the car | 1 | EL_23005
 |  | Resistor | b | Outside of the car | 2 | EL_23006
 |  | LED light | b | Outside of the car | 2 | EL_23007
EL | VCU Bis card |  |  |  |  | EL_A1900
 |  | Capacitor 10n | b |  | 2 | EL_A19001
 |  | 4P Droit | b |  | 2 | EL_A19002
 |  | 2P Droit | b |  | 1 | EL_A19003
 |  | Resistor 8k2 | b |  | 8 | EL_A19004
 |  | Resistor 3k9 | b |  | 4 | EL_A19005
 |  | Alim LP TSR_0.5-2450 | b |  | 1 | EL_A19006
EL | SCS Maker card |  |  |  |  | EL_A2000
 |  | Capacitor 10n | b |  | 2 | EL_A20001
 |  | 2P Droit | b |  | 2 | EL_A20002
 |  | Resistor 3k9 | b |  | 1 | EL_A20003
 |  | Resistor 8k2 | b |  | 2 | EL_A20004
 |  | Alim LP TSR_0.5-2450 | b |  | 1 | EL_A20005
EL | SCS TSAL Green LED |  |  |  |  | EL_A2100
 |  | Capacitor 10n | b |  | 5 | EL_A21001
 |  | Capacitor 22u | b |  | 1 | EL_A21002
 |  | Comparator | b |  | 1 | EL_A21003
 |  | Gate AND | b |  | 1 | EL_A21004
 |  | Gate OR | b |  | 1 | EL_A21005
 |  | 2P Droit | b |  | 2 | EL_A21006
 |  | SSR CPC1394GR | b |  | 1 | EL_A21007
 |  | Resistor 2k2 | b |  | 1 | EL_A21008
 |  | Resistor 500k | b |  | 1 | EL_A21009
 |  | Resistor 10k | b |  | 2 | EL_A21010
 |  | Resistor 82k | b |  | 2 | EL_A21011
 |  | Resistor 12k | b |  | 2 | EL_A21012
 |  | Resistor 560k | b |  | 2 | EL_A21013
 |  | Opamp_Dual | b |  | 1 | EL_A21014
 |  | Alim LP TSR | b |  | 1 | EL_A21015
EL | SCS TSAL Red LED |  |  |  |  | EL_A2200
 |  | Capacitor_THT | b |  | 1 | EL_A22001
 |  | Capacitor 10n | b |  | 3 | EL_A22002
 |  | Gate AND | b |  | 1 | EL_A22003
 |  | 2P Droit | b |  | 2 | EL_A22004
 |  | SSR CPC1394GR | b |  | 1 | EL_A22005
 |  | Resistor 2k2 | b |  | 1 | EL_A22006
 |  | Resistor 500k | b |  | 1 | EL_A22007
 |  | Resistor 10k | b |  | 1 | EL_A22008
 |  | Resistor 82k | b |  | 2 | EL_A22009
 |  | Resistor 12k | b |  | 2 | EL_A22010
 |  | Opamp_Dual | b |  | 1 | EL_A22011
 |  | Alim LP TSR_0.5-2450 | b |  | 1 | EL_A22012

Sheet: EN-Engine and Drivetrain
System | Assembly | Sub-assembly | Part (25 chars max) | m/b | Comment (40 chars max) | Qty | ID
EN | Engine |  |  |  |  |  | EN_A0100
 |  |  | Emrax 228 MV LC | b | axial flux permanent magnet synchronous electric motor | 1 | EN_001001
 |  |  | Flanged shaft | m | at the right of the engine | 1 | EN_001002
 |  |  | Engine sprocket | b | connect the engine and the chain | 1 | EN_001003
 |  |  | Clamp washer | f | at the right of the engine sprocket | 1 | EN_001004
 |  |  | Bearing housing | m | at the right of the engine | 1 | EN_001005
 |  |  | Motor Shield part 1 | m | protect the engine | 1 | EN_001006
 |  |  | Motor Shield part 2 | m | protect the engine | 1 | EN_001007
 |  |  | Right engine bracket | m | to support the engine and the differential simultaneously | 1 | EN_001008
 |  |  | Left engine bracket | m | to support the engine and the differential simultaneously | 1 | EN_001009
 |  |  | Sprocket spacer | m | between the bearing and the sprocket | 1 | EN_001010
EN | Cooling system |  |  |  |  |  | EN_A0200
 |  |  | Radiator | b | On the left side of the vehicule near the back | 1 | EN_002001
 |  |  | Water pump | b | on the back of the vehicule | 1 | EN_002002
 |  |  | Brass connector | b | Connecting the different pipes together | 16 | EN_002003
 |  |  | Coolant lines | b | from the radiator to the water pomp to the motor at the back | 10 | EN_002006
 |  |  | Protective grid | b | in front of the radiator | 1 | EN_002009
 |  | Overflow bottle |  |  |  |  | EN_A02007
 |  |  | Overflow bottle body | m | At the back top | 1 | EN_002007_1
 |  |  | Overflow bottle cap | m | At the back top | 1 | EN_002007_2
 |  |  | Overflow primary pipe | b | At the rear back top | 3 | EN_002007_3
 |  | Catch-can |  |  |  |  | EN_A02007
 |  |  | Catch-can bottle body | b | At the back top | 1 | EN_002008_1
 |  |  | Catch-can bottle cap | m | At the back top | 1 | EN_002008_2
 |  |  | Overflow secondary pipe | b | At the rear back bottom | 1 | EN_002008_3
EN | Secondary transmission |  |  |  |  |  | EN_A0300
 |  |  | Excentric right | m | at the right of the differential, to clamp the chain | 1 | EN_003001
 |  |  | Chain | b | between the engine and the differential | 1 | EN_003002
 |  |  | Sprocket | b | at the right of the engine | 1 | EN_003003
 |  |  | Tripod | b | at the sides of the differential | 2 | EN_003004
 |  |  | Drexler differential | b | at the back | 1 | EN_003005
 |  |  | Sprocket bearer | m | at the right of the differential | 1 | EN_003006
 |  |  | Drexler bearing right | b | at the right of the differential | 1 | EN_003007
 |  |  | Right tripod housing | b | at the right of the differential | 1 | EN_003008
 |  |  | Left tripod housing | b | at the left of the differential | 1 | EN_003009
 |  |  | Drexler bearing left | b | at the left of the differential | 1 | EN_003010
 |  |  | Chain shield | m | over the chain | 1 | EN_003011
 |  |  | Driveshaft left | b | between the differential and the hub | 1 | EN_003012
 |  |  | Driveshaft right | b | between the differential and the hub | 1 | EN_003013
 |  |  | Excentric left | m | at the left of the differential, to clamp the chain | 1 | EN_003014
 |  |  | Tripod housing boot | b | at the ends of driveshaft | 2 | EN_003015
 |  |  | Chainshield bracket | m | near the engine, on the chassis | 2 | EN_003016

Sheet: FR-Chassis and body
System | Assembly | Part (25 chars max) | m/b | Comment (40 chars max) | Qty | ID
FR | Frame |  |  |  |  | FR_A0100
 |  | Round steel tubing | m | 28x1.5 25x1.5 20x1.5 & 15x1.5 |  | FR_001001
 |  | Round bent steel tubing | m | 30x2 | 2 | FR_001002
FR | Body |  |  |  |  | FR_A0200
 |  | Nose | m | moulded carbon fiber | 1 | FR_002001
 |  | Side plates | m | pressured water cut carbon pans | 2 | FR_002002
 |  | Push-clips | b | two on each side | 4 | FR_002004
 |  | Hook and loop belts | b |  | 3 | MS_A0300
FR | Throttle pedal |  |  |  |  | FR_A0300
 |  | Frame throttle | m | basis of the pedal | 1 | FR_003001
 |  | Footrest | m | top part of the pedal | 1 | FR_003002
 |  | Pedal stick | m | Below the footrest. | 1 | FR_003003
 |  | Fixing rail | m | allows the pedal to be adjusted in depth | 2 | FR_003004
 |  | Rail wedge | m | holds the rail with a bolt | 2 | FR_003005
 |  | Threated rod | b | is used to adjust the pedal depth | 2 | FR_003006
 |  | Front rail wedge | m | holds the rail with a bolt | 2 | FR_003007
 |  | Negative mechanical stop | m | End stop for the pedal stem | 1 | FR_003008
 |  | Positive mechanical stop | m | End stop for the pedal stem | 1 | FR_003009
 |  | Pedal bearing | b | part that allows rotation of the pedal stick | 2 | FR_003010
 |  | Springs | b | ensure the pedal's callback | 2 | FR_003011
 |  | Potentiometer | b | sensor | 2 | FR_003012
 |  | Rear Potentiometer Threaded rods | b | fix the potentiometer | 1 | FR_003013
 |  | Front Potentiometer Threaded rods | b | fix the potentiometer | 1 | FR_003014
 |  | Axle Spacer | m | Spacer at the basis of the throttle pedal stem | 1 | FR_003015
FR | Brake pedal |  |  |  |  | FR_A0400
 |  | Frame brake | m | basis of the pedal | 1 | FR_004001
 |  | Brake pedal stick | m | Below the footrest. | 1 | FR_004002
 |  | Footrest | m | top part of the pedal | 1 | FR_004003
 |  | Master cylinder | b | Piston under the frame. | 2 | FR_004004
 |  | Master cylinder wedge | m | at the basis of the pedal stick. | 2 | FR_004005
 |  | Brake fixing rail | m | allows the pedal to be adjusted in depth | 2 | FR_004006
 |  | Brake R Fixing Rail Wedge | m | holds the rail with a bolt | 2 | FR_004007
 |  | Brake F Fixing Rail Wedge | m | holds the rail with a bolt | 2 | FR_004008
 |  | Distribution Brake Axle | b | part of the break distribution system | 1 | FR_004009
 |  | Distribution Axle Tread | b | part of the break distribution system | 2 | FR_004010
 |  | Distribution Cylinder | b | part of the break distribution system | 1 | FR_004011
 |  | Distribution Ball Joint | b | part of the break distribution system | 1 | FR_004012
 |  | BOTS Support | m | holds the BOTS | 1 | FR_004013
 |  | BOTS | b | under the frame brake. | 1 | FR_004014
 |  | Brake Pedal Hose Wedge | m | in front of the pedal stick | 1 | FR_004015
 |  | cylinder screw Distribution | b | part of the break distribution system | 2 | FR_004016
 |  | Brake Pedale Bearing | b | part that allows rotation of the pedal stick | 2 | FR_004017
 |  | Brake Threated Rod | b | support of the frame brake into the fixing rails. | 2 | FR_004018
FR | Crash box |  |  |  |  | FR_A0500
 |  | Impact attenuator | b | crashbox in front of the car | 1 | FR_005001
 |  | Anti-intrusion plate | m | aluminium plate which the crashboxed is bolted to | 1 | FR_005002
FR | Floor pan |  |  |  |  | FR_A0600
 |  | Front plate | m | Front part of the floor pan | 1 | FR_006001
 |  | Cockpit plate | m | Rear part of the floor pan | 1 | FR_006002

Sheet: MS-Miscellaneous
System | Assembly | Part (25 chars max) | m/b | Comment (40 chars max) | Qty | ID
MS | Seat |  |  |  |  | MS_A0100
 |  | Seat | b | at the center of the cockpit | 1 | MS_001001
MS | Head restraint |  |  |  |  | MS_A0200
 |  | Support | m | beside the foam | 1 | MS_002001
 |  | Foam | b |  | 1 | MS_002002
MS | Harness |  |  |  |  | MS_A0300
 |  | Harness | b | attached to the tubing | 1 | MS_003001
 |  | Roll bar padding | b | on the main hoop | 2 | MS_003004
MS | Firewall |  |  |  |  | MS_A0400
 |  | Middle part | m | Part of the firewall | 1 | MS_004001
 |  | Upper part | m | Part of the firewall | 1 | MS_004002
 |  | Lower part | m | Part of the firewall | 1 | MS_004003

Sheet: ST-Steering system
System | Assembly | Part (25 chars max) | m/b | Comment (40 chars max) | Qty | ID
ST | Steering rack |  |  |  |  | ST_A0100
 |  | Steering rack Narrcob | b | between the front wheels, in front of the seat | 1 | ST_001001
ST | Steering column |  |  |  |  | ST_A0200
 |  | Column | m | over the steering rack | 1 | ST_002001
 |  | Rigid coupling column/rack | b | between the column and the rack, behind the pedals | 1 | ST_002002
 |  | U joint | b | in front of the steering wheel | 1 | ST_002003
ST | Tie rod |  |  |  |  | ST_A0300
 |  | Rod tube | b | carbon tube | 2 | ST_003001
 |  | Insert sup | m | alu 7075 T6 | 2 | ST_003002
 |  | Wedge | m |  | 2 | ST_003003
 |  | Insert middle | m | alu 7075 T6 | 2 | ST_003004
ST | Steering rack support |  |  |  |  | ST_A0400
 |  | Half moon top | m | behind the rack, in front of the seat | 2 | ST_004001
 |  | Half moon bottom | m | behind the rack, in front of the seat | 2 | ST_004002
 |  | Left bracket | m | behind the rack, in front of the seat | 1 | ST_004003
 |  | Right bracket | m | behind the rack, in front of the seat | 1 | ST_004004
ST | Steering rack protection |  |  |  |  | ST_A0500
 |  | Protection rack | m | behind the rack, in front of the seat | 2 | ST_005003
ST | Steering shaft pivot |  |  |  |  | ST_A0600
 |  | Steering upper shaft | m | between the column and the steering wheel | 1 | ST_006001
 |  | Steering bore | m | between the column and the steering wheel | 1 | ST_006002
 |  | Fixation tube | m | between the column and the steering wheel | 2 | ST_006003
 |  | QR shaft | b | between the column and the steering wheel | 1 | ST_006004
 |  | Circlips M30 | b | between the column and the steering wheel | 1 | ST_006005
 |  | Fixation U joint | m | between the steering wheel and the ball joint | 2 | ST_006006
 |  | Ball joint | b | on the column | 1 | ST_006007
 |  | Steering shaft pivot sheet | m | behind the ball joint | 1 | ST_006008
 |  | Roller bearing | b | between the column and the steering wheel | 2 | ST_006009
ST | Steering wheel |  |  |  |  | ST_A0700
 |  | Steering wheel | b | in front of the seat | 1 | ST_007001
 |  | Shift spacer light | b | in front of the steering wheel | 1 | ST_007002
 |  | Quick release | b | in front of the steering wheel | 1 | ST_007003

Sheet: SU-Suspension
System | Assembly | Part (25 chars max) | m/b | Comment (40 chars max) | Qty | ID
SU | Front upper A-arm |  |  |  |  | SU_A0100
 |  | Front rod | b | carbon tube at the front | 2 | SU_001001
 |  | Rear rod | b | carbon tube at the rear | 2 | SU_001002
 |  | Outer bearing support | m | Wheel side, extremity of the A-arm alu 7075 T6 | 2 | SU_001003
 |  | Inner bearing support | m | Frame side, aluminium 7075 T6 | 4 | SU_001004
SU | Front lower A-arm |  |  |  |  | SU_A0200
 |  | Front rod | b | carbon tube at the front | 2 | SU_002001
 |  | Rear rod | b | carbon tube at the rear | 2 | SU_002002
 |  | Outer bearing support | m | Wheel side, extremity of the A-arm alu 7075 T6 | 2 | SU_002003
 |  | Inner bearing support | m | Frame side, aluminium 7075 T6 | 4 | SU_002004
SU | Rear upper A-arm |  |  |  |  | SU_A0300
 |  | Front rod | b | carbon tube at the front | 2 | SU_003001
 |  | Rear rod | b | carbon tube at the rear | 2 | SU_003002
 |  | Outer bearing support | m | Wheel side, extremity of the A-arm alu 7075 T6 | 2 | SU_003003
 |  | Inner bearing support | m | Frame side, aluminium 7075 T6 | 4 | SU_003004
SU | Rear lower A-arm |  |  |  |  | SU_A0400
 |  | Front rod | b | carbon tube at the front | 2 | SU_004001
 |  | Rear rod | b | carbon tube at the rear | 2 | SU_004002
 |  | Outer bearing support | m | Wheel side, extremity of the A-arm alu 7075 T6 | 2 | SU_004003
 |  | Inner bearing support | m | Frame side, aluminium 7075 T6 | 4 | SU_004004
SU | Tie rod |  |  |  |  | SU_A0500
 |  | Tube | b | carbon tube | 2 | SU_005001
 |  | Inner bearing support | m | aluminium 7075 T6, Oval, 2 screws, frame side | 2 | SU_005002
 |  | Wedge | m | RED, frame side | 2 | SU_005003
 |  | Outer bearing support | m | aluminium 7075 T6, wheel side, 1 screw | 2 | SU_005004
SU | Front bell crank |  |  | Triangle shape, under frame |  | SU_A0600
 |  | Front rocker | m | under the front absorber | 4 | SU_006001
 |  | Pivot joint spacer | m | under the front absorber | 4 | SU_006002
 |  | Ball joint spacer | m | above and under ball joint | 60 | SU_006003
 |  | Ohlins ball joint spacer | m | above and under ball joint | 16 | SU_006004
SU | Rear bell crank |  |  |  |  | SU_A0800
 |  | Rear rocker | m | at the sides of the rear absorber | 4 | SU_008001
SU | Front upright assy |  |  |  |  | SU_A1000
 |  | Front upright | m | Aluminium 7075 T6 | 2 | SU_01001
 |  | Upper arm bracket | m | Aluminium 7075 T6 | 2 | SU_01002
SU | Rear upright assy |  |  |  |  | SU_A1100
 |  | Rear upright | m | Aluminium 7075 T6 | 2 | SU_011001
 |  | Upper arm bracket | m | Aluminium 7075 T6 | 2 | SU_011002
 |  | Camber shim 2mm | m | Aluminium 2017 T4 | 10 | SU_011003
 |  | Camber shim 1mm | m | Aluminium 2017 T4 | 6 | SU_011004
SU | Front suspension rod |  |  |  |  | SU_A1200
 |  | Front pullrod | b | carbon tube | 2 | SU_012001
 |  | Tapped insert right | m | aluminium 7075 T6 | 8 | SU_012002
SU | Rear suspension rod |  |  |  |  | SU_A1300
 |  | Rear pushrod | b | carbon tube | 2 | SU_013001
SU | Anti roll bar |  |  |  |  | SU_A1400
 |  | ARB bar | m |  | 1 | SU_014001
 |  | Y stop | m | Aluminium 2017 T4 | 2 | SU_014002
 |  | Blade | m | Acier S355 | 4 | SU_014003
 |  | Pad | m |  | 2 | SU_014004
 |  | Blade link | b | SKF PRM 151715 | 2 | SU_014005
 |  | Brushing support | m | Aluminium 2017 T4 | 2 | SU_014006
 |  | Bracket | m |  | 2 | SU_014007

Sheet: WT-Wheels
System | Assembly | Part (25 chars max) | m/b | Comment (40 chars max) | Qty | ID
WT | Wheel Assy |  |  |  |  | WT_A0100
 |  | Rim oz magnesium | b | 13 inch | 4 | WT_001001
 |  | Tire Continental 13 | b |  | 4 | WT_001002
WT | Front hub |  |  |  |  | WT_A0200
 |  | Hub | m | Al7075t6 | 2 | WT_002001
 |  | Brake bell | m | Al2017T4 | 2 | WT_002002
 |  | Bearing washer | m | Al2017T4 | 2 | WT_002003
 |  | Inner bearing spacer | m | Aluminium 2017A | 4 | WT_002004
 |  | Speed disc | m | Acier S235 | 2 | WT_002005
 |  | Wheel stud | b |  | 8 | WT_002006
 |  | Bearing | b | S71910 ACD/P4A | 4 | WT_002007
 |  | Lock washer | b |  | 2 | WT_002008
 |  | Lock nut | b |  | 2 | WT_002009
WT | Rear hub |  |  |  |  | WT_A0300
 |  | Hub | m | Al7075t6 | 2 | WT_003001
 |  | Rear brake bell | m | Al2017T4 | 2 | WT_003002
 |  | Outboard tripod housing | m |  | 2 | WT_003003
 |  | Tripod housing spacer | m | Al2017T4 | 4 | WT_003004
 |  | Bearing washer |  | Al2017T4 | 2 | WT_002003
 |  | Speed disc |  | Acier S235 | 2 | WT_002005
 |  | Bearing |  | S71910 ACD/P4A | 4 | WT_002007
 |  | Tripod housing boot |  |  | 2 | EN_003015
