EOSCogniton/ELIZ-2022/02 - Documentation/BASTIE/Cartes Valkyriz/BMS/BMS V1.0/Mouser_BOM.xls

PANIER
Ceci n'est pas une facture
09-sept.-23 11:05:02
 | N° Mouser | N° de fab. | Fabricant | N° client | Description | RoHS | Cycle de vie | Qté. | Prix (EUR) | Ext. : (EUR)
1 | 584-LT3990EMSE#TRPBF | LT3990EMSE#TRPBF | Analog Devices Inc. |  | Régulateurs de tension de commutation 62V, 350mA Buck Reg w/ 2.5 A Q C & Int | RoHS : conforme |  | 1 | 6,85 € | 6,85 €
2 | 584-ADG728BRUZ-R7 | ADG728BRUZ-REEL7 | Analog Devices Inc. |  | CI commutateur multiplexeur SERIAL I2C, 8-ch MUX | RoHS : conforme |  | 2 | 5,86 € | 11,72 €
3 | 584-LTC6255IS6TRMPBF | LTC6255IS6#TRMPBF | Analog Devices Inc. |  | Amplificateurs de précision 6.5MHz, 65 A Pwr Eff R2R I/O Op Amps | RoHS : conforme |  | 1 | 4,28 € | 4,28 €
4 | 584-LTC6811IG-1#PBF | LTC6811IG-1#PBF | Analog Devices Inc. |  | Gestion de batterie/pile Multicell Bat Mon s | RoHS : conforme |  | 1 | 18,56 € | 18,56 €
5 | 652-SM91501ALE | SM91501ALE | Bourns |  | Transformateurs d'alimentation BMS xformer 2-Ch 1600V AECQ +125 C | RoHS : conforme |  | 1 | 4,84 € | 4,84 €
6 | 726-BSS315PH6327XT | BSS315P H6327 | Infineon |  | MOSFET P-Ch -30V -1.5A SOT-23-3 | RoHS : conforme |  | 12 | 0,325 € | 3,90 €
20 | 571-5-103635-8 | 5-103635-8 | TE Connectivity |  | Embases et logements de câbles LATCHING HDR SHRD 9P W/O HOLD-DN 15AU CNT | RoHS : conforme |  | 2 | 1,25 € | 2,50€
8 | 571-5-103635-6 | 5-103635-6 | TE Connectivity |  | Embases et logements de câbles LATCHING HDR SHRD 7P W/O HOLD-DN 15AU CNT | RoHS : conforme |  | 2 | 1,73 € | 3,46 €
9 | 571-5-103635-1 | 5-103635-1 | TE Connectivity |  | Embases et logements de câbles LATCHING HDR SHRD 2P W/O HOLD-DN 15AU CN | RoHS : conforme |  | 2 | 0,781 € | 1,56€
10 | 581-KGM21NR71H103KT | KGM21NR71H103KT | KYOCERA AVX |  | Condensateurs céramique multicouches MLCC - CMS 50V .01uF X7R 0805 10% | RoHS : conforme | Nouveau produit | 17 | 0,031 € | 0,53 €
11 | 755-KTR18EZPJ332 | KTR18EZPJ332 | ROHM Semiconductor |  | Résistances à couches épaisses - CMS 1206 3.3Kohm 5% High VoltageAEC-Q200 | Conforme à RoHS par dispense |  | 12 | 0,121 € | 1,45 €
12 | 603-RT1206FRE07100RL | RT1206FRE07100RL | YAGEO |  | Résistances à couches minces - CMS 1/4W 100 ohm 1% 50pp m | Conforme à RoHS par dispense |  | 15 | 0,06 € | 0,90 €
13 | 603-RC2512JK-0724RL | RC2512JK-0724RL | YAGEO |  | Résistances à couches épaisses - CMS 24 Ohms 1 W 2512 5% | Conforme à RoHS par dispense |  | 12 | 0,083 € | 1,00 €
14 | 542-PM1210-330J-RC | PM1210-330J-RC | Bourns |  | Inducteurs RF - CMS 33uH 5% | RoHS : conforme |  | 1 | 0,36 € | 0,36 €
18 | 571-104479-9-CT | 104479-9 (Cut Strip) | TE Connectivity |  | Embases et logements de câbles SKT 24-20 CU/AU Cut Strip of 100 | RoHS : conforme |  | 100 | 0,155 € | 15,50 €
19 | 571-1042571 | 104257-1 | TE Connectivity |  | Embases et logements de câbles RECEPTACLE ASSY 2P | RoHS : conforme |  | 2 | 0,423 € | 0,85 €
20 | 571-1042576 | 104257-6 | TE Connectivity |  | Embases et logements de câbles RECEPTACLE ASSY 7P | RoHS : conforme |  | 2 | 0,675 € | 1,35 €
21 | 571-1042578 | 104257-8 | TE Connectivity |  | Embases et logements de câbles RECEPTACLE ASSY 9P | RoHS : conforme |  | 2 | 0,572 € | 1,144 €
En soumettant votre commande, vous acceptez ces conditions. (https://www.mouser.fr/saleterms) |  |  |  |  |  |  |  |  | Marchandise : | 81.19 €
Les prix sont ceux de la date et de l'heure indiquées. |  |  |  |  |  |  |  |  | Frais d'expédition : | 0,00 €
