EOSCogniton/ELIZ-2022/02 - Documentation/MODAC/Cahier des charges Batterie.xlsx

Sheet: Versions
Objectif de ce document: Rédiger les cahiers des charges de la Batterie Haute Tension d'Artemiz
 | Date | Action | Auteurs
 | 2023-12-04 | Version v0.5 | AMR, JAN
 | 2024-01-07 | Version v1.0 | AMR, JAN
 | 2024-01-09 | Version v1.1 | AMR, JAN
 | 2024-02-08 | Version v1.2 | AMR, JAN

Sheet: Changelog
Changelog
 | 09/01/2024 - v1.1 : version de publication - AMR, JAN
 | Numéro de fonction | Changements
 | Global | Publication
 | 08/02/2024 - v1.2 : version corrigée, ajout manquements règlements - AMR, JAN
 | Numéro de fonction | Changements
 | F524 | Ajout de la règle
 | F143 | Ajout de la règle T11.1.3
 | F145 | Ajout de la règle T11.1.6
 | F147 | Ajout de la règle EV4.1.7
 | F2b25 / F148 | Déplacement des contraintes de la fonction F2b25 (TSAC) à F148 (Batterie HV)
 | F642 | Ajout de la règle EV4.4.1
 | Glossaire | Ajout de la définition de "Rollover Protection Enveloppe"
 | F143 | Ajout de la règle EV4.5.3
 | F643 | Ajout de la résistance à l'eau
 | F519 | Ajout de la résistance à l'eau
 | F02 | Ajout d'une caractèristique globale sur l'amovibilité de la batterie
 | F623 | Ajout du critère "Présence du main Fuse"
 | F145 | Ajout d'un critère sur la règle EV5.4.7
 | F222 | Modification du terme "visible" à "accessible" dans le premier critère
 | F632 | Ajout du critère "Normalement ouvert" sur les AIR
 | F331 | Ajout du dépassement de caractéristiques seuil comme critère d'ouverture du SDC
 | 08/02/2024 - v : - AMR, JAN, ECT
 | Numéro de fonction | Changements
 | F143 | Modification des termes sur le critère sur l'utilisation de peinture ou de scotch en tant qu'isolant
 | F144 | Modification de l'ensemble des termes de la sous-fonction F144
 | F145 | Modification des termes sur la protection contre les dommages matériels
 | F146 | Remplacement du terme 'perturbations magnétiques', rajout du terme de traction pour la résistance mécanique des câbles
 | F2 | Nouvelle numérotation de l'ensemble des fonctions et sous fonctions (F2X->F2Y) avec Y=X-2
 | F212 | Ajout d'une image explicative
 | F236 | Modification de la formulation du critère
 | Glossaire | Ajout de la définition de "Structure d'Impact"
 | F242 | Modification du terme "Pluie tridimensionnelle"
 | F243 | Remplacement du critère "Présence de ventilateur" par "Température maximale des cellules"
 | F282 | Modification de la flexibilité pour ajouter la possibilité d'avoir une reprise de blindage
 | F29 | Suppression de la F293 pour cause de redondance et renumérotation de la F294 en F293
 | F34 | Modification des termes de "1 logique" afin d'être plus clair et permissif
 | F41 | Modification des termes de "1 logique" afin d'être plus clair et permissif
 | F714 | Modification du critère en donnant l'intensité de la batterie dans son entièreté, pour laisser plus de possibilité dans le choix des cellules
 | F722 | Ajout de flexibilité dans le critère, pour permettre à ce critère d'être rempli par le TSAC
 | F725 | Reformulation de l'origine du besoin sur le nombre d'entrée/sortie
 | F731 | Modification du critère et reformulation de la sous-fonction
 | F92 | Modification des termes de "0 logique" afin d'être plus clair et permissif
 | EL_1009 | Changement de nom pour se baser sur les dénominations FSG

Sheet: Caractéristiques principales
Caractéristiques principales | Batterie Haute Tension EPSA
CDCF
Fonction | Caractéristique | Niveau | Unité | Commentaire
F01 : Embarquer l'énergie de propulsion du véhicule | Tension nominale | Entre 600 et 500 | VDC
 | Courant nominal | 80 | A
 | Courant de pic | 120 | A
 | Puissance maximale | 80 | kW
 | Capacité minimale | 7 | kWh
F02 : S'intégrer au véhicule | Volume maximal | 450 x 450 x 333 | cm³ | Prend également en compte les connecteurs externes (haute et basse puissance), ainsi que le volume nécessaire à leur manipulation
 | Masse maximale | 70 | kg | Dépendant du véhicule, mais également de son armoire de charge
 | Être amovible | Oui | N/A | La batterie doit pouvoir être retirée "facilement" (sans manipulation dangereuse pour les objets ou les personnes), afin de pouvoir la recharger en dehors de la voiture et la transporter facilement
F03 : Respecter le règlement du FS | Pourcentage de cellules monitorées en température | 30% équiréparties par module | %
 | Respect total du règlement | N/A | - | Contrainte principale
Nomenclature systèmique Système Batterie HV Numéro EL_A1000 | Nom du sous-système | Numéro du sous-système
 | Batterie HV | EL_A1001
 | TSAC | EL_01002
 | AMS | EL_01003
 | IMD | EL_01004
 | Interface LV | EL_01005
 | Interface HV | EL_01006
 | Module | EL_01007
 | Chargeur | EL_01008
 | TSAL Voltage measurement | EL_01009

Sheet: Besoins complémentaires
Besoins complémentaires
Type de besoin | Besoin | Nature du besoin | Articles du règlement | Origine du besoin | Remarques | Vérif 1 | Vérif 2
Documentation | Photographie des mécanismes de Positive Locking qui ne pourront pas être vérifiés à l'ouverture du TSAC. | Photographies | EV4.5.15 |  |  | FALSE | FALSE
 | Modèle 3D de la batterie, comprenant en particulier le TSAC, les modules, le busbar de haute puissance, les cartes et les connecteurs. | Fichier .stp | T3.6.3 |  | Les câbles n'ont pas à figurer sur ce modèle, néanmoins, leur implantation doit être réfléchie en amont et justifiée par des plans annexes. | FALSE | FALSE
 | Les bulletins de livraison des matériaux ignifuges utilisés dans la batterie | Datasheets | IN3.2.1 |  |  | FALSE | FALSE
 | Les datasheets de tous les composants achetés sur étagère | Datasheets |  |  |  | FALSE | FALSE
 | La codification du faisceau interne au TSAC, des éventuels câbles externes, ainsi que les schémas de position des câbles dans le TSAC | Schémas sur le positionnement théorique des câbles Codification des couleurs et des tailles des câbles, internes et externes au TSAC | EV4.5.5 |  | Ce code doit permettre d'identifier en un seul regard sur le câble son calibre, sa cote de température et sa tension d'isolation | FALSE | FALSE
 | Un bilan complet sur la conception de la batterie, comprenant de manière exhaustive les matériaux utilisés, les dessins, les images, les emplacements des fixations, le poids des segments, les cellules, et la position des segments. | Schémas, dessins, datasheets des cellules, plan de positionnement des modules | EV5.5.19 |  |  | FALSE | FALSE
 | Les courbes de charge et de décharge de la batterie | Graphiques expérimentaux |  | Vérifier que la batterie a été testée |  | FALSE | FALSE
 | Les procédés de fabrication des cartes électroniques custom | Description des procédés employés |  | Vérifier que l'ensemble des soudures et l'isolation sont dimensionnées pour soutenir les courants et tensions adaptés, et que les soudures ont été réalisées selon les méthodes adaptées (cf Glossaire, Conformal Coating) |  | FALSE | FALSE
 | Schéma électrique complet de la batterie en fonctionnement, du circuit LV intégré et du circuit de précharge | Schémas électriques |  |  |  | FALSE | FALSE
Pièces supplémentaires | Des exemplaires des sous-systèmes utilisées dans le TSAC non-accesibles où le LV et le HV interviennent, pour prouver que la ségrégation est respectée | Exemplaires supplémentaires de pièces présentes dans la batterie | EV4.3.7 | Prouver la ségrégation LV/HV sur les pièces inacessibles pour l'inspection technique |  | FALSE | FALSE
 | Les cartes électroniques faites sur mesure présentes dans le TSAC et non accessibles au démontage | Cartes électroniques | IN3.2.1 | Vérifier la conformité des PCBs inacessibles |  | FALSE | FALSE
 | Un échantillon de chaque câble ou fil utilisé dans le TSAC | Câbles électriques | EV4.5.5 |  |  | FALSE | FALSE
 | Un échantillon de chaque matériau composite utilisé dans le TSAC | Échantillons de matériaux composite | EV5.5.4 |  |  | FALSE | FALSE

Sheet: Glossaire
Glossaire
Acronyme | Définition | Articles du règlement
AIR | Accumulator Insulation Relay, relai alimenté par le SDC présent sur un pôle de la batterie | EV5.6
AMS | Accumulator Management System, carte de contrôle globale de la batterie communiquant avec le VCU et ordonnant des actions en fonction des informations des BMS
B2XL | Habilitation électrique autorisant le travail sous une tension inférieure à 60VDC
BMS | Battery Management System, carte de contrôle s'appliquant à chaque module de la batterie
Busbar Haute Puissance | Ensemble composé des AIRs, du Main Fuse et de leurs connecteurs.
Conformal Coating | Revêtement adapté : il s'agit d'une couche protectrice appliquée sur les circuits électroniques pour les isoler et les protéger contre l'humidité, la poussière, les produits chimiques, et d'autres contaminants environnementaux. Cette couche est conçue pour suivre la forme des composants électroniques, assurant une protection uniforme. La résine de soudure n'est pas considérée comme un revêtement adapté. | EV4.3.6
Direct Connection | Connexion directe, deux dispositifs ou circuits sont considérés comme directement connectés si la connexion ne passe pas par un PCB (circuit imprimé) commun et ne comprend aucun dispositif ou fonctionnalité autre que la protection contre les surintensités ou les connecteurs | T1.3.1
Faisceau | Réseau de câbles et de fils électriques reliant différents composants
Fire-retardant | Ignifuge, correspondant à l'une des normes suivantes : - UL94V-0 pour l'épaisseur minimale du matériau utilisé - FAR 25.853(a)(1)(i)
Hard-wired | Se dit d'un système qui ne comporte aucune intelligence informatique
HV | High Voltage, haute tension (>= 60V)
IMD | Insulation Monitoring Device, de type Bender A-ISOMETER® iso-F1 IR155-3203, -3204, -4203, ou -4204, ou un Bender ISOMETER® iso165C-1, ou un équivalent IMD approuvé pour une utilisation automobile. L'équivalence peut être approuvée par les juges selon plusieurs critères : robustesse face aux vibrations, plage de température de fonctionnement, indice de protection, présence d'une sortie directe, facilité d'auto-test, alimentation indépendante du système surveillé. Il est relié à une carte qui ouvre le SDC si du courant est détecté dans le TSAC ou dans la structure tubulaire. | EV6.3.2
IP3X | Qualification d'un connecteur. Un connecteur est dit IP3X lorsqu'il assure une protection contre les objets solides de plus de 2,5 mm (ex. : outils et fils)
Isolation Galvanique | Deux circuits électriques sont définis comme galvaniquement isolés si toutes les conditions suivantes sont remplies : - La résistance entre les deux circuits est ≥500Ω/V, en rapport avec la tension TS maximale du véhicule, à une tension d'essai de la tension TS maximale ou de 250V, selon la valeur la plus élevée. - La tension d'essai d'isolation en RMS, en courant alternatif pendant 1 minute, entre les deux circuits est supérieure à trois fois la tension TS maximale ou 750V, selon la valeur la plus élevée - La tension de travail de la barrière d'isolation, si spécifiée dans la fiche technique, est supérieure à la tension TS maximale.
LV | Low Voltage, basse tension (<= 60V)
Main Fuse | Fusible Principal, présent dans le TSAC et sur le chemin de courant principal | EV3.2.7
Maintenance Plugs | Connecteurs entre les différents modules de la batterie | EV5.4.4 EV5.4.5
Module (de batterie) | Aussi appelé segment, un module est un sous-assemblage de la batterie qui embarque de l'énergie, mais qui est soumis à une tension et/ou une intensité moindre. La mise en série ou en parallèle de modules forme la batterie. | EV5.1.5
OEM | Origine de Fabricant, se dit des pièces qui sont achetées sur étagère. | T10.1.2
PCB | Printed Circuit Board, carte électronique
PNST | Pièce Nue Sous Tension, élément conducteur comprenant de la tension
Positive Locking | Mécanisme de protection contre le desserrage accidentel des fixations dû aux vibrations du véhicule. Les mécanismes acceptés sont : - Sertissage correctement installé (Correctly installed safety wiring) : Il s'agit de fils métalliques qui sont correctement installés pour empêcher le desserrage des écrous ou boulons. Le sertissage peut être effectué de manière à lier ensemble plusieurs éléments, empêchant ainsi leur rotation. - Goupilles fendues (Cotter pins) : Des goupilles fendues peuvent être utilisées comme mécanisme de verrouillage en les insérant à travers un trou percé dans un boulon ou une vis et en les pliant pour empêcher le desserrage. - Écrous à encliquetage de couple résiduel (Prevailing torque lock nuts) : Cela inclut les écrous de blocage à couple résiduel, tels que les écrous conformes aux normes DIN 980, ISO 7042 ou à un standard équivalent, ainsi que les écrous à jet (jet nuts) ou les écrous K (K-nuts). - Plaques de verrouillage (Locking plates) : Des plaques de verrouillage peuvent être utilisées pour immobiliser plusieurs éléments en les reliant mécaniquement. - Rondelles à languettes (Tab washers) : Les rondelles à languettes sont des rondelles avec des languettes qui peuvent être pliées pour empêcher le desserrage. Pour la batterie, les écrous à encliquetage nylon (Nylon lock nuts) ne sont pas autorisés, car tous les systèmes doivent fonctionner sous 85°C au moins. Tout mécanisme de verrouillage basé sur la précontrainte ou un adhésif n'est pas considér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 | T10.2
Rollover Protection Enveloppe |  | T1.1.16
SCS | System Critical Signal, signaux qui sont susceptibles d'agir sur un élément du SDC et dont la détection d'une défaillance ouvre automatiquement le SDC
SDC | ShutDown Circuit, circuit de basse puissance qui relie les éléments de protection du véhicule entre eux et qui, en cas d'anomalie, ouvre les AIRs de la batterie pour la déconnecter du TS. | EV6
Structure Tubulaire | Squelette en acier du véhicule, qui permet l'intégration des autres éléments.
Structure d'Impact | Eléments de la structure tubulaire présentant une structure triangulaire et permettant de protéger des composants sensibles. Ils remplissent certains critères additionnels par rapport à d'autres partie de la structure tubulaire. | T3.15
Terre du véhicule | Point de potentiel nul, qui est la structure tubulaire (garanti par l'IMD)
TS | Tractive System : circuit haute puissance du véhicule, qui comprend notamment la batterie, le moteur et l'onduleur. | EV4
TSAL | Tractive System Active Light, carte associée à deux indicateurs lumineux qui détecte la présence de tension dans le TS | EV4.10
TSAC | Tractive System Accumulator Container : enveloppe rigide qui englobe le système batterie | EV5.1.4
TSMP | Tractive System Measuring Point, interfaces permettant de mesurer la tension aux bornes de la batterie côté véhicule des AIRs à l'aide de prises bananes | EV4.7
VCU | Vehicule Control Unit, ordinateur de bord du véhicule

Sheet: EL_A1001 (Batterie HV)
Système : | Batterie HV
CDCF
Fonction | Sous-fonctions | Critère | Niveau | Unité | Flexibilité | Articles du règlement | Origine du besoin | Remarques | Vérif 1
F11 : Embarquer l'énergie de traction du véhicule | F112 : Embarquer l'énergie nécessaire | Puissance de sortie maximale de la batterie | <= 80 | kW |  | EV2.2.1 |  |  | OK
 |  | Tension de la batterie | <= 600 | VDC |  | EV4.1.1 |  |  | OK
F12 : S'intégrer dans le châssis équipé d'Artemiz'24 | F121 : Pouvoir être retenue attachée dans le châssis équipé sans déformation de ce dernier. | Poids | <= 70 | kg | Non |  | La structure tubulaire d'Artemiz'24 est déjà existante, il faut donc s'adapter aux calculs d'efforts qui avaient été effectués pour qu'elle supporte la batterie TYVA. | Ce poids maximal a été aussi calculé par rapport à la charge supportée par un étage de notre armoire de stockage. Cette fonction couvre également le critère de poids pour le stockage. | OK
 | F122 : Sécuriser les attaches critiques, c'est-à-dire toutes les fixations utilisées au sein de la batterie ou de ses fixations à la structure tubulaire | Diamètre des fixations filetées | >= 4 | mm |  | T10.1.2 |  |  | OK
 |  | Classe de résistance métrique des fixations filetées | 2024-08-08 | N/A |  |  |  |  | NI
 |  | Classe des fixations filetées de diamètre 3mmd'origine constructeur (OEM) | 2024-08-08 | N/A |  |  |  |  | NI
 |  | Tous les fixations filetées sont du type boulons hexagonaux (ISO 4017, ISO 4014 ou un standard équivalent) ou vis à tête cylindrique à six pans creux (ISO 4762, DIN 7984, ISO 7379 ou un standard équivalent), y compris leurs versions à filetage fin | Oui | N/A |  | T10.1.3 |  |  | NI
 |  | Les fixations présentes à l'intérieur du TSAC, utilisées pour des parties non-structurelles (ex : PCBs), n'ont pas à respecter les exigences de T10.1.2, c'est-à-dire : - peuvent être de diamètre inférieur à 4mm - n'ont pas à être de grade 8.8 |  |  |  | EV5.5.11 |  |  | NI
 |  | Les fixations présentes à l'intérieur du TSAC, utilisées pour des parties non structurelles et faites d'un matériau électriquement isolant : - peuvent être de diamètre inférieur à 4mm - n'ont pas à être de grade 8.8 - n'ont pas à être de type boulons hexagonaux (ISO 4017, ISO 4014 ou un standard équivalent) ou vis à tête cylindrique à six pans creux (ISO 4762, DIN 7984, ISO 7379 ou un standard équivalent) |  |  |  |  |  |  | NI
 |  | Nombre de filets complets qui dépassent de tout écrou de blocage | >= 2 | N/A |  | T10.2.4 |  |  | NI
 |  | Des anneaux de retenue ou de fixation (snap rings) conformes aux normes DIN 471, DIN 472, ou à un standard équivalent sont autorisés dans les applications OEM (pièces d'origine de fabricant) ou pour la fixation de roulements ou de ressorts, à condition qu'ils ne supportent aucune charge dans des conditions de conduite normales |  |  |  | T10.2.3 |  |  | NI
F13 : Supporter les contraintes physiques dues à l'exploitation de l'énergie embarquée | F131 : Fonctionner à un rang de température adapté lors des phases d'exploitation | Rang de température de fonctionnement de tous les systèmes de la batterie, exceptés les cellules | [10;90] | °C | Seulement pour la borne inférieure | EV4.1.3 EV4.5.3 EV3.2.6 |  |  | OK
 | F132 : Protéger toutes ses fixations critiques | Toutes les connexions électriques, comprenant les écrous, les rondelles, et autres fixations, sur le chemin de courant principal du TS, sont protégées d'une déconnexion due aux vibrations par Positive Locking adapté aux températures de fonctionnement | Oui |  | Seulement pour des dispositifs certifiés pour un usage automobile, que les connexions sont intégrées selon les recommandations du fabricant et que le positive locking est impossible | EV4.5.14 |  |  | OK
 | F133 : Posséder des connexions soudées sécurisées | Les connexions soudées traversées par le courant principal de la batterie sont autorisées si : - elles se trouvent sur des PCBs - les éléments connectés ne sont pas des cellules et des fils - le dispositif est en plus protégé mécaniquement contre du desserrage | Oui | N/A |  | EV4.5.16 |  |  | OK
F14 : Sécuriser l'installation électrique | F141 : Séparer l'ensemble des systèmes électriques de haute puissance et de basse puissance | Présence d'une barrière physique isolée et résistante à l'humidité lorsque c'est possible | Oui | Binaire | Oui, voir sous-fonction suivante | EV4.3.4 |  |  | OK
 |  | Distance entre circuits LV et HV, avec tension <100V | >10 | mm | Non | EV4.3.4 |  |  | OK
 |  | Distance entre circuits LV et HV, avec tension <200V et >100V | >20 | mm | Non | EV4.3.4 |  |  | OK
 |  | Distance entre circuits LV et HV, avec tension >200V | >30 | mm | Non | EV4.3.4 |  |  | OK
 |  | Circuits maintenus physiquement par des attaches bloqué par des systèmes de positive-locking | Oui | Binaire | Non | EV4.3.5 |  |  | NI
 | F142 : Ne présenter aucune PNST | Qualification de tous les connecteurs de la batterie et de son chargeur | IP3X | N/A | Pas pour les connecteurs extérieurs (batterie fermée et chargeur) | EV4.5.1 |  |  | OK
 | F143 : Comprendre des dispositifs d'isolation électrique adaptés | Tension supportée par tous les matériaux électriquement isolants de la batterie et de son chargeur | >= 600 | VDC |  | EV4.5.2 |  |  | OK
 |  | L'utilisation de scotch isolant ou de peinture afin d'assurer une isolation électrique est toujours doublée d'un autre processus ou matériau afin de renforcer cette isolation | Oui | Binaire | Non | EV4.5.2 |  |  | NI
 |  | Températures supportées par les dispositifs d'isolation | >85 | °C | Non | EV4.5.3 |  |  | OK
 |  | Tout le système LV est isolé de manière appropriée | Oui | N/A |  | T11.1.3 |  |  | OK
 | F144 : Être protégée contre les surintensités par des fusibles | Tous les systèmes électriques sont protégés des surintensités |  |  |  | EV3.2.1 |  |  | OK
 |  | Cote de courant continu des fusibles utilisés | <= cote de courant continu de n'importe quel composant électrique protégé par ce dispositif | A |  | EV3.2.2 |  |  | OK
 |  | Le courant de surintensité à partir duquel le fusible cesse de fonctionner (Interrupt current rating) est supérieur au courant théorique de court-circuit du système qu'il protège (Theoretical short circuit current). Autrement dit, en cas de court-circuit, le fusible fonctionne et se déclenche |  |  |  | EV3.2.3 |  |  | OK
 |  | Tension de fonctionnement des fusibles | >= Tension du système protégé | VDC |  | EV3.2.4 |  |  | OK
 |  | En cas d'utilisation d'un dispositif autre qu'un fusible pour se protéger contre les surintensités, le dispositif en question vérifie l'ensemble des critères F144 et ne repose pas sur de la logique programmable | Oui | Binaire |  | EV3.2.5 |  |  | OK
 | F145 : Posséder un faisceau de câbles (internes et externes) fonctionnel, sécurisé et lisible | Respect d'un code couleur/taille des câbles utilisés pour qu'on puisse identifier seulement visuellement la taille du câble, son rang de températures et sa capacité d'isolation | Oui | N/A |  | EV4.5.5 |  |  | NI
 |  | Toutes les tailles de câbles employées peuvent être justifiées par rapport aux connecteurs et aux courants qui les traversent | Oui | N/A |  | EV4.5.6 |  |  | OK
 |  | Toutes les fixations des câbles sont protégées par Positive Locking | Oui | N/A |  |  |  |  | KO
 |  | Les câbles de la batterie sont protégés physiquement contre tout dommage mécanique accidentel | Oui | N/A |  | EV4.5.7 |  |  | KO
 |  | Tension supportée par tous les câbles électriques | >=600 | VDC |  | EV5.4.7 |  |  | OK
 |  | Aucun câble du LV circuit n'est orange | Oui | N/A |  | T11.1.6 |  |  | OK
 | F146 : Posséder un faisceau de câbles externes (cas d'une batterie dont le connecteur de puissance est de type mâle) répondant aux exgicences sécuritaires du règlement | Chacun de ces câbles est dans une protection orange et accroché à au moins chacune de ses extrêmités | Oui | N/A |  | EV4.5.8 EV4.5.9 |  |  | OK
 |  | Chacun de ces câbles est blindé pour être protégé contre les perturbations causées par toute onde électro-magnétique (OEM) | Oui | N/A |  |  |  |  | OK
 |  | Résistance entre le blindage du câble et la terre du véhicule | <300, pour un courant à 1A | mOhm | Non |  |  |  | OK
 |  | Force supportée par chaque câble du TS de la batterie, exceptés ceux qui connectent les modules entre eux à l'intérieur du TSAC, pour une traction dans n'importe quelle direction | >= 250 | N |  |  |  |  | OK
 | F147 : Assurer une transmission de courant sur un chemin prédéfini | Le courant de la batterie (et du TS en général) passe à travers des conducteurs de cuivre ou d'aluminium, et ne traversent pas d'écrous métalliques utilisés comme connecteurs | Oui | N/A |  | EV4.5.11 |  |  | OK
 |  | Aucune connexion du TS ne comprend de matériau compressible, comme du plastique, dans un stack-up ou pour une attache | Oui | N/A |  | EV4.5.12 |  |  | OK
 |  | Tous les systèmes pouvant être à la tension maximale du circuit du TS dans le cadre du fonctionnement classique de la batterie fonctionnent sous cette tension | Oui | N/A |  | EV4.1.2 |  |  | OK
 | F148 : Séparer physiquement le circuit LV et le circuit HV | Présence de la délimitation spécifiée autour de tous les éléments du circuit LV : - une barrière résistance à l'humidité, composée de matériaux isolants - éloignement d'au moins 34,5mm pour une tension de plus de 200VDC, d'au moins 23,4mm pour une tension comprise entre 100VDC et 200VDC, et d'au moins 12,5mm pour une tension inférieure à 100VDC (ex : à proximité des modules) | Oui | N/A |  | EV4.3.1 EV4.3.4 |  |  | KO
 |  | Nombre de conduits et connecteurs par lesquels passent à la fois le circuit LV et le circuit HV | 0 |  |  | EV4.3.3 |  |  | OK
 |  | Distance sur un PCB commun entre la partie HV et la partie LV. Cette distance doit être marquée sur le PCB et clairement indiquée entre les deux parties, elles-même marquées par "TS" ou "LV". NB : définition de Conformal Coating dans le Glossaire |  | mm |  | EV4.3.6 |  |  | OK
 |  | Jeu autorisé pour les différents câbles par rapport à leur position initiale, pour le circuit HV : - pour une tension de plus de 200VDC : 4mm d'amplitude - pour une tension entre 100VDC et 200VDC : 3mm d'amplitude - pour une tension inférieure à 100VDC : 1mm d'amplitude Et pour le circuit LV : 0,5mm d'amplitude Dans ce périmètre de déplacement ne doit se trouver aucune pièce susceptible d'endommager le câble | Oui | N/A | Seulement si on modifie alors l'espacement prévu par le plan initial entre les différents câbles. Il faut que, dans le pire cas, avec les déformations maximale, la distance obligatoire soit maintenue. | EV4.3.5 EV4.5.7 |  |  | OK

Sheet: EL_01002 (TSAC)
Système : | TSAC
CDCF
Fonction | Sous-fonctions | Critère | Niveau | Unité | Flexibilité | Articles du règlement | Origine du besoin | Remarques | Vérif 1
F21 : S'intégrer dans le châssis de Artemiz'24 | F211 : Être contenu dans le volume prévu d'Artemiz'24 pour l'emplacement batterie, attaches non comprises | Enveloppe batterie prise en compte pour le dimensionnement du châssis Volume prévu : 450 x 450 x 333 Taille des attaches : >= 3,2cm | <= 443 x 443 x 253 | cm^3 | Non |  | La structure tubulaire d'Artemiz'24 est déjà existante, il faut donc s'adapter au volume qui a été prévu pour la batterie TYVA. | Subsiste une marge de manoeuvre pour la taille des attaches. Cette configuration garantit le respect de l'exigence de taille pour le stockage dans l'armoire. | OK
 |  | TSAC attaché à la structure primaire, ou bien à une structure aditionnelle remplissant les critères d'une structure d'impact | Oui | N/A |  | EV5.5.1 EV5.5.2 |  |  | OK
 |  | Distance entre le sol et la partie la plus basse du TSAC, lorsque ce dernier est accorché à la structure tubulaire par ses fixations | >= 32 | mm |  | T2.2.1 |  |  | OK
 | F212 : Pouvoir être retenu par les équipements de la structure tubulaire sans déformation de ces dernières en statique. | Ratio de distance entre le trou de l'attache et sa distance à l'extrémité de la fixation : e/d | >= 1,5 | N/A | Non | T10.1.4 |  |  | OK
 |  | Taille du trou de l'attache d | >= 8 | mm | Non | T10.1.2 | Les vis travailleront en cisaillement. |  | OK
 |  | Nombre d'attaches présentes sur le TSAC | >=8 Au moins 4 de chaque côté, 2 en haut et 2 en bas |  | Non |  | Les vis travailleront en cisaillement. |  | OK
 | F213 : Pouvoir être retenu par les équipements de la structure tubulaire sans déformation de ces dernières en dynamique. | Accélération encaissable par le TSAC lui-même et ses fixations, de gauche à droite et d'avant en arrière | >= 40g | m/s^2 |  | EV5.5.8 | Tenir le TSAC en place en cas d'accélération/de freinage brut |  | NI
 |  | Accélération encaissable par le TSAC lui-même et ses fixations, de haut en bas | >= 20g | m/s^3 |  | EV5.5.8 | Tenir le TSAC en place en cas d'accélération/de freinage brut |  | NI
 | F214 : Assurer une connexion électrique avec la structure tubulaire, qui est la terre du véhicule | Résistance pour une mesure sous un courant de 1A | <= 300 | mΩ |  | EV3.1.1 |  |  | NI
 |  | Épaisseur de la couche d'acier sur le TSAC qui est reliée à la terre | >= 0,9 | mm |  |  |  |  | OK
 |  | Pourcentage du courant qui fait sauter le Main Fuse (fusible du TS) qui peut traverser le TSAC en continu | >= 10 | % |  |  | Si le TSAC devient conducteur, il doit faire circuler du courant dans la terre du véhicule pour que l'IMD ouvre les AIRs. Ce courant doit être assez important pour être détecté. |  | NI
 |  | TSAC non isolé au niveau de ses fixations avec le véhicule | Oui | N/A |  |  | Idem, l'IMD doit détecter la fuite de courant |  | NI
 | F215 : Être fixé de manière règlementaire | Toutes les attaches utilisées sont sécurisées par un Positive Locking supportant 80°C, sauf si elles sont non-conductrices et non-structurelles | Oui | N/A |  | EV5.5.11 |  |  | NI
 |  | Épaisseur des fixations | >= 1,6 pour de l'acier >= 4 pour de l'aluminium | mm |  |  |  |  | NI
 |  | Présence de renforts pour supporter la flexion | Oui | N/A |  | EV5.5.13 |  |  | NI
 |  | Charge à laquelle tous les points de fixations (supports, plaques de supports, inserts) doivent résister, dans toutes les directions | >= 20 | kN |  | EV5.5.13 |  |  | NI
F22 : Contenir les éléments constitutifs de la batterie HV | F221 : Contenir le circuit de précharge | Présence d'un espace dans la zone couverte (par une plaque transparente isolante) pour le relai du circuit de précharge et la résistance | Oui | N/A |  |  |  |  | OK
 | F222 : Contenir le busbar de haute puissance | Présence d'un espace dans la zone couverte (par une plaque transparente isolante) pour les AIRs et le Main Fuse | Oui | N/A |  | EV3.2.7 |  |  | OK
 | F223 : Contenir les segments de la batterie (les modules) | Présence d'une case pour chaque module nécessaire (nombre à définir, a priori 12 12s6p), chaque paroi de case étant une barrière rigide, électriquement isolée, et résistance au feu (UL94V0) | Oui | N/A |  | EV5.5.7 EV5.5.6 |  |  | OK
 |  | Présence de matériau amortissant dans chaque case de module, de sorte que la différence entre l'accélération que peut supporter le TSAC et l'accélération que peut supporter un module soit dissipée Ex : d'avant en arrière, accélération de 20g pour le TSAC et de 7g pour le module ; 13g doivent être amortis | Oui | N/A |  |  | Sécuriser les modules par rapport aux accélérations et aux vibrations. Permettre une insertion et un retrait facilité (matière compressible) |  | KO
 |  | Présence de cales, au-dessus de chaque module, pour bloquer la translation verticale | Oui | N/A |  |  | Empêcher les modules de translater verticalement | Les cales étaient présentes sur la batterie TYVA, mais surdimensionnées | KO
 | F224 : Contenir les dispositifs d'intelligence embarquée, dont notamment l'AMS |  |  |  |  |  |  |  | OK
 | F225 : Correspondre à l'architecture règlementaire | Modules de batterie et la partie HV (busbar = AIRs + main fuse) séparés par une barrière électriquement isolante et respectueuse de UL94V0. L'air n'est pas suffisant pour servir d'isolant dans ce cas. | Oui | N/A |  | EV5.5.12 |  |  | OK
 |  | Trous, internes et externes, ne sont percés que pour la ventilation, le refroidissement, ou encore les attaches + faisceau | Oui | N/A |  | EV5.5.14 | Il faut un refroidissement dans la batterie, mais ce dernier ne doit pas compromettre son étanchéité |  | OK
 |  | Les ouvertures externes du TSAC et leurs conduits ne pointent ni vers le conducteur, ni vers le porteur du TSAC. Les conduits et leurs attaches doivent être verrouillés et UL94V0. | Oui | NA |  | EV5.5.14 |  |  | OK
 |  | Pourcentage de la surface externe du TSAC enlevée pour percer des trous externes | <= 25 | % |  | EV5.5.14 |  | La taille des ventilateurs doit être cohérente avec ce point | NI
 |  | Chaque trou à travers une paroi structurelle (càd entre le busbar et les modules) est pourvu d'un presse-étoupe | Oui | N/A |  | EV4.5 |  | Par exemple, il n'y avait pas de presse-étoupe pour passer du lower au upper container dans la batterie TYVA | OK
F23 : Protéger les opérateurs des sous-systèmes de la batterie lorsqu'elle est fermée | F231 : Résister aux contraintes mécaniques de son contenu | Type de matériau utilisé | Acier ou aluminium | N/A | Non |  |  | L'utilisation de l'acier est favorisée dans notre cas, pour des raisons de fabricabilité. | OK
 |  | Épaisseur de la paroi inférieure | >= 1,25 (acier) >= 3,2 (aluminium) | mm | Non | EV5.5.4 |  |  | OK
 |  | Épaisseur des parois intérieures et extérieures verticales | >= 0,9 (acier) >= 2,3 (aluminium) | mm | Non |  |  |  | OK
 | F232 : Résister aux contraintes thermiques de son contenu | Rang de température supportable sans endommagement mécanique | [-10;85] | °C |  | EV4.5.3 |  |  | OK
 | F233 : Être isolé électriquement par rapport aux systèmes qu'il contient | Nombre de parois internes du TSAC isolées pour résister à une tension de 60V | Toutes | N/A |  | EV4.5.2 | La surface extérieure du TSAC n'est pas forcément isolée, en tout cas, pas intégralement ; en revanche, pas le moindre millimètre carré de la surface interne ne doit laisser passer le moindre courant |  | NI
 |  | Hauteur des parois internes verticales par rapport aux parois externes verticales | 75 | % |  | EV5.5.6 |  |  | OK
 |  | Nombre de modules contenus au sein d'une enceinte délimitée par des parois internes du TSAC | <= 1 | N/A |  |  |  |  | OK
 | F234 : Être isolé thermiquement par rapport aux systèmes qu'il contient | Nombres de parois intérieures couvertes par un matériau respectueux de la norme UL94V0 | Toutes | N/A | Non |  |  |  | NI
 |  | Matériaux utilisés pour fabriquer le TSAC et toutes ses parties structurelles fire-retardants (UL94V0) à une température de 60°C, si non métalliques et non laminés | Oui | N/A |  | EV5.5.3 |  |  | NI
 | F235 : Protéger un opérateur avec un outil d'atteindre les pièces nues sous tension de la batterie sans ouvrir le TSAC | Norme des connecteurs présents sur la surface du TSAC | Au moins IP3X (protection contre les objets solides de plus de 2,5mm) | N/A | Seulement pour les prises de basse puissance | EV4.5.1 | Tous les opérateurs qui graviteront autour de la batterie ne seront pas B2TL |  | OK
 | F236 : Éviter un court-circuit en son sein | Tout élément conducteur a moins de 100mm d'un composant du Tractive System est électriquement connecté a la terre du LV avec une résistance inférieur a 100Ohm | Oui | Binaire |  | EV3.1.3 |  |  | OK
 | F237 : Donner précisément les coordonnées du propriétaire de la batterie | Présence en Roman Sans Serif d'une hauteur d'au moins 20mm du numéro du véhicule, du nom de l'université, et du numéro de téléphone du (des) ESO(s) | N/A | N/A |  | EV5.3.8 |  |  | NI
 | F237 : Signaler la présence de haute tension de manière active | Présence d'un indicateur ou d'une LED rouge à la surface du TSAC, visible même en plein jour, s'illuminant dès que la tension côté véhicule des AIRs dépasse 60VDC ou la moitié de la tension maximum du TS, selon celui qui est le plus bas | Oui | N/A |  | EV5.4.8 |  |  | OK
 |  | L'incateur est marqué comme "Voltage Indicator" et doit être clairement visible lors de la déconnexion du TSAC du véhicule | Oui | N/A |  | EV5.4.9 |  | A priori, on a une carte qui remplit cette fonction, mais elle doit être à l'intérieur du TSAC et il faut penser à ses branchements | OK
 |  | L'indicateur ne comporte aucune intelligence informatique ("hard-wired"), et est alimenté directement (cf Glossaire) et seulement par le circuit de haute puisance du côté véhicule des AIRs. Il fonctionne toujours, même si le TSAC est déconnecté du circuit LV ou retiré du véhicule. | Oui | N/A |  | EV5.4.10 |  |  | OK
 | F238 : Signaler la présence de haute tension de manière passive | Nombre de stickers respectueux de la norme ISO 7010-W012 contenant la mention "High Voltage" sur la paroi extérieure du TSAC | >=1 | N/A |  | EV4.2.1 |  |  | NI
 | F239 : Ne pas glisser d'un plan de travail | Force nécessaire afin de faire bouger le TSAC posé sur une table en bois | >=500 | N | Forte, à discuter |  | Pouvoir travailler sur la batterie sur des surfaces diverses / Ne pas risquer de glisser et tomber d'une surface de travail en cas de choc impromptu |  | NI
F24 : Protéger les sous-systèmes de la batterie de l'environnement extérieur | F241 : Résister à une humidité ambiante persistente | Taux de corrosion du métal à une humidité de 100% pendant une semaine | 0 | % | Non | EV4.5.4 | La batterie peut être stockée dans un hangar (ex du FS Suisse 2023) ; en cas de pluie à l'extérieur, l'humidité dans le hangar peut monter rapidement à 100%. La batterie resterait sur place au plus une semaine. | Cette contrainte rend également le matériau du TSAC adapté au Rain Test | NI
 | F242 : Être imperméable face à une pluie fine, provenant de tous les côtés, puis aux écoulements qui en résultent | Présence d'eau dans le TSAC après 3 minutes sous une pluie projeté depuis le dessous, le dessus, l'avant, l'arrière et les deux côtés de la voiture, puis après 3 minutes d'écoulement | Non | N/A | Non | EV4.5.4 | Le Rain Test |  | NI
 | F243 : Maintenir l'ensemble à des températures acceptables pour le fonctionnement de la batterie | Température des cellules lors de n'importe quelle utilisation (charge,décharge) | <min(60, température de fonctionnement des cellules) | °C | Non | EV4.1.4 | La batterie doit être régulée en température pour limiter les risques d'emballement thermique |  | OK
F25 : Permettre la communication sur l'état interne de la batterie | F253 : Communiquer toutes les informations récoltables par l'AMS à un opérateur externe | Présence d'une prise avec fusible permettant la connexion sécurisée d'un ordinateur, à l'aide si besoin d'un adaptateur USB / CAN | / | N/A |  | EV5.8.12 EV1.2.1 | Un opérateur externe doit pouvoir connecter son ordinateur, directement branché au TSAC ; à l'intérieur, le câble doit être connecté à l'AMS et permettre ainsi la lecture de toutes les données qu'il contient. Il doit bien y avoir un fusible qui réponde à tous les critères des "overcurrent protection" (se référer à la partie sur le busbar HV) pour sécuriser la connexion électrique. |  | OK
F26 : Permettre le transport de la batterie | F261 : Présenter des points d'accroche pour des sangles | Nombre de points d'accroche | >=2 de chaque côté | N/A | Non |  | La batterie sera a priori lourde et devra être portée par plusieurs opérateurs qui devront chacun avoir une prise sûre sur la batterie. | Une solution technique envisageable serait de confondre les trous pour les attaches de la batterie au châssis équipé et les points d'accroche. Ceci serait possible si l'on peut passer les sangles à travers les ouvertures (diamètre suffisant) et si lesdites points d'accroches supportent chacun plus d'un quart du poids de la batterie (surdimensionnement). | KO
 | F262 : Rester à l'équilibre en étant soulevée par ses points d'accroche. | Charge supportée par les points d'accroche sans déformation plastique | >= 35 | kg |  |  | Les attaches doivent être fiables et supporter le poids de la batterie, en supposant que la répartition de cette charge soit équitable. |  | NI
F27 : Protéger les opérateurs des sous-systèmes de la batterie lors d'une phase de maintenance | F271 : Donner l'accès aux différents sous-systèmes pour un opérateur habilité B2XL | Nombre de pièces à enlever pour accéder, visuellement ou physiquement, aux modules, à leurs connexions, à la partie LV et au busbar HV | 1 | N/A | +1 |  | Il faut n'avoir qu'à retirer une sorte de "upper container" et tous les composants doivent être au même étage ; ainsi, un opérateur B2XL peut enlever un module sans avoir besoin de déconnecter la haute puissance, la seule pièce à enlever est mécanique |  | OK
 | F272 : Ne présenter aucune PNST lorsqu'il est ouvert | Nombre de PNST accessibles à un opérateur après la première manipulation permettant l'ouverture du TSAC | 0 | N/A | Non | EV4.5.1 | La plupart des équipiers ne seront pas habilités B2TL : il faut qu'une habilitation B2XL suffise pour pouvoir enlever un module de l'ensemble et le démonter |  | OK
 | F273 : Comprendre un réseau de câbles logique et cohérent. En fonction de sa couleur et de sa taille, chaque câble doit pouvoir se voir assigner un calibre, une plage de températures acceptables et une tension d'isolation. | Présence, pour chaque câble électrique, d'un schéma de positionnement et de passages de câbles prévus entre les parois | Oui | N/A |  |  |  | Ça ne doit pas être le bazar, et en particulier, on doit pouvoir refermer le TSAC sans comprimer un gros noeud de câbles : tout doit être architecturé pour avoir un espace dédié, câbles compris | OK
 |  | Respect du code sur les câbles établi | Oui | N/A |  | EV4.5.5 |  | À voir avec le sous-traitant : mis à part les câbles orange de haute puissance, les codes sont libres, il faut simplement qu'ils soient définis et respectés dans toute l'enceinte du TSAC | OK
F28 : Permettre la recharge de la batterie | F281 : Présenter une prise IP3X permettant la connexion de la batterie au chargeur, coté puissance | Présence d'un connecteur jaugé pour supporter 600V, permettant de brancher le chargeur à la batterie, qui se situe sur une des zones spécifiées (permettant un débattement suffisant pour qu'un opérateur connecte et déconnecte la batterie) NB : ces zones dépendront de la solution technique retenue de prise | Oui | N/A | Non |  |  | La batterie a été faite pour porter une prise femelle, et on y branche soit le chargeur, soit le reste du circuit du TS. Nénamoins, cela peut être remis en question ; on pourrait envisager que la prise porte la prise mâle, et que la TS Box et le chargeur présentent une prise femelle (ou bien une solution alternative si la prise chargeur n'est pas la même que la prise de connexion au TS). Dans tous les cas, il faut ici penser à la cohérence entre la charge et l'explotation dans la chaîne de haute puissance. | OK
 | F282 : Comprendre une zone surfacique non isolée électriquement qui permette, lors de la connexion du chargeur à la batterie, de relier électriquement le TSAC et le câble de terre du chargeur | Présence de cette surface | Oui | N/A | Oui, si la reprise de blindage entre les câbles permet de faire la connexion sans passer par une surface dédiée | EV7.1.2 |  |  | KO
F29 : Permettre l'exploitation sécuritaire de l'énergie embarquée, sur banc et sur piste | F291 : Présenter une prise IP3X permettant la connexion de la batterie à la chaîne de haute puissance du véhicule | Présence d'un connecteur IP3X jaugé pour supporter une tension de 600VDC et un courant de 200A | Oui | N/A | Non |  |  | Le connecteur peut être de type mâle ou femelle, tant qu'il est IP3X | OK
 |  | Présence du connecteur sur une des surfaces autorisées du TSAC (* [A DEFINIR en fonction de la technologie retenue]) | Oui |  |  |  | Espace limité pour permettre à un opérateur de connecter et de déconnecter la batterie à cause de la structure tubulaire et de la TS Box. L'emplacement de la sortie de la batterie doit être minutieusement choisi, particulièrement si la solution retenue est une prise femelle. |  | OK
 |  | Rayon de courbure des câbles de sortie pour rejoindre la TSBox | >= 8 | cm |  |  | Les câbles sont rigides et ne doivent pas être pliés |  | NI
 | F292 : Présenter une prise IP3X permettant la connexion de la batterie à la chaîne de basse puissance du véhicule | Présence du connecteur sur une des surfaces autorisées du TSAC (* [A DEFINIR en fonction de la technologie retenue]) | Oui |  |  |  |  |  | OK
 | F293 : Posséder un dimensionnement de câbles adéquat par rapport à l'utilisation. En particulier, les câbles doivent rester en place malgré les vibrations | Justification numérique de l'utilisation de chaque câble et du choix de sa fixation quant aux efforts subis | Oui | N/A |  | EV4.5.6 |  | Ces calculs pourront être faits côté FS@ECL, mais le constructeur devra prouver que cela a été respecté, en particulier que la taille de chaque câble est adapatée au courant qui le traverse. | KO
 |  |  |  |  |  |  |  | NI | 20
Ajouts (*) |  |  |  |  |  |  |  | KO | 5
RQ Un refroidissement à air est prévu pour le TSAC (a priori, deux ventilateurs branchés en LV) mais si un refroidissement à eau/huile est envisagé, d'autres règles s'appliquent

Sheet: EL_01003 (AMS)
Système : | AMS
CDCF
Fonction | Sous-fonctions | Critère | Niveau | Unité | Flexibilité | Articles du règlement | Origine du besoin | Remarques | Vérif 1
F31 : Transmettre des informations | F311 : Transmettre les données au VCU | Nombre de données affichées | 2 | N/A | +/-2 |  | Informer le pilote | Tension et température la plus haute | OK
 | F312 : Afficher les données sur un ordinateur | Nombre de données affichées | 5 | N/A | Non | EV5.8.12 | Informer un observateur, sécuriser | Tension, température des cellules avec leur emplacement Courant du TS Cellule critique avec température ou non | OK
 | F313 : Transmettre les données à distance | Données accessibles via un site/appli dédiés | Oui | Binaire | Possible |  | Informer un observateur extérieur de l'état de la batterie |  | OK
F32 : Connaître les informations | F321 : Connaître la tension de chaque cellule | Pourcentage de cellules monitorées en tension | 100 | % | Non | EV5.8.3 |  |  | OK
 | F322 : Connaître le courant en sortie de TS | Courant monitoré | Oui | Binaire | Non | EV5.8.3 |  |  | OK
 | F323 : Connaître la température d'au moins 30% des cellules avec leur emplacement | Pourcentage de cellules monitorées en température | >30 | % | Non | EV5.8.3 |  |  | OK
 | F324 : Connaître les températures de cellules critiques en températures | Pourcentage de cellules critiques monitorées en température | 100 | % | Non | EV5.8.3 |  |  | OK
F33 : Sécuriser l'utilisation et la recharge de la batterie | F331 :Ouvrir le SDC en cas de dysfonctionnement | Ouverture si extinction/déconnexion de l'AMS | Oui | Binaire | Non | EV6.1.7 |  |  | OK
 |  | Ouverture si une cellule atteint un seuil critique de température (90% valeur maximale entre 60°C et la valeur spécifiée sur la datasheet de la cellule) durant plus de 900ms | Oui | Binaire | Oui, sur le pourcentage | EV5.8.7 |  |  | OK
 |  | Ouverture si une cellule atteint un seuil critique de courant ou de tension (90% du courant maximal, 110% de la tension minimale spécifiées sur la datasheet de la cellule) durant plus de 400 ms | Oui | Binaire | Oui, sur le pourcentage | EV5.8.7 |  |  | OK
 |  | Ouverture si interruption de charge | Oui | Binaire | Non |  | Sécuriser les utilisateurs |  | NI
 | F332 : Fermer le SDC lors du fonctionnement nominal | Présence d'un circuit dédié à la fermeture du SDC | Oui | Binaire | Non | EV6.1.9 |  |  | OK
 |  | Circuit non programmable | Oui | Binaire | Non | EV6.1.9 |  |  | OK
 |  | Etat du SDC si dysfonctionnement | Ouvert | N/A | Non | EV6.1.9 |  |  | OK
 |  | Courant pouvant circuler | > 200% * ceux nécessaire à l'alimentation des AIR | A | Non | EV6.1.9 |  |  | OK
 | F333 : Utiliser des SCS pour influencer le SDC | Etat du SDC en cas de mise à la masse | Ouvert | N/A | Non | T11.9.2, EV6.1.11 |  |  | OK
 |  | Etat du SDC en cas de circuit ouvert | Ouvert | N/A | Non | T11.9.2, EV6.1.11 |  |  | OK
 |  | Etat du SDC en cas de connexion à l'alimentation de la carte | Ouvert | N/A | Non | T11.9.2, EV6.1.11 |  |  | OK
F34 : Informer le pilote en cas de panne | F341 : Alimenter la led indicatrice dans le cockpit en cas de défaut | Transmission d'un signal d'erreur en cas d'ouverture du SDC par l'AMS | Oui | Binaire | Non | EV5.8.9 | Informer le pilote qu'un défaut dans la batterie a été détecté | La forme et le type du signal est à définir, mais une information doit être transmise | OK
 | F342 : Utiliser des SCS pour influencer l'indicateur | Détection d'erreur en cas de mise à la masse du cable d'information | Ouvert | N/A | Non | T11.9.2, EV5.8.9 |  |  | OK
 |  | Détection d'erreur en cas de circuit ouvert du cable d'information | Ouvert | N/A | Non | T11.9.2, EV5.8.9 |  |  | OK

Sheet: EL_01004 (IMD)
Système : | IMD
CDCF
Fonction | Sous-fonctions | Critère | Niveau | Unité | Flexibilité | Articles du règlement | Origine du besoin | Remarques | Vérif 1
F41 : Informer le pilote | F411 : Alimenter la led indicatrice dans le cockpit en cas de défaut d'isolation | Transmission d'un signal d'erreur en cas d'ouverture du SDC par l'IMD | Oui | Binaire | Non | EV6.3.7 | Informer le pilote qu'un défaut d'isolation a été détecté |  | OK
 | F412 : Utiliser des SCS pour influencer l'indicateur | Détection d'erreur en cas de mise à la masse | Ouvert | N/A | Non | T11.9.2, EV6.3.7 |  |  | OK
 |  | Détection d'erreur en cas de circuit ouvert | Ouvert | N/A | Non | T11.9.2, EV6.3.7 |  |  | OK
 |  | Détection d'erreur en cas de connexion à l'alimentation de la carte | Ouvert | N/A | Non | T11.9.2, EV6.3.7 |  |  | OK
F42 : Sécuriser l'utilisation et la recharge de la batterie | F421 : Ouvrir le SDC en cas de défaut d'isolation | Ouverture si défaut d'isolation entre les AIR et le TSAC | Oui | Binaire | Non | EV6.3.5 |  |  | OK
 |  | Ouverture si défaut d'isolation entre les AIR et le châssis / l'enveloppe du chargeur | Oui | Binaire | Non | EV7.1.7, EV6.3.5 |  |  | KO
 | F422 : Vérifier l'isolation | Être relié aux AIR côtés véhicules | Oui | Binaire | Non | EV6.3.4 |  |  | OK
 | F423 : Eteindre le chargeur en cas d'ouverture du SDC | Etat du chargeur après ouverture du SDC | Eteint | N/A | Non | EV7.2.2 |  |  | OK
 | F424 : Fermer le SDC lors du fonctionnement nominal | Présence d'un circuit dédié à la fermeture du SDC | Oui | Binaire | Non | EV6.1.9 |  |  | OK
 |  | Circuit non programmable | Oui | Binaire | Non | EV6.1.9 |  |  | OK
 |  | Etat du SDC si dysfonctionnement | Ouvert | N/A | Non | EV6.1.9 |  |  | OK
 |  | Courant pouvant circuler | > 200% * ceux nécessaire à l'alimentation des AIR | A | Non | EV6.1.9 |  |  | OK
 | F425 : Utiliser des SCS pour influencer le SDC | Etat du SDC en cas de mise à la masse | Ouvert | N/A | Non | T11.9.2, EV6.1.11 |  |  | OK
 |  | Etat du SDC en cas de circuit ouvert | Ouvert | N/A | Non | T11.9.2, EV6.1.11 |  |  | OK
 |  | Etat du SDC en cas de connexion à l'alimentation de la carte | Ouvert | N/A | Non | T11.9.2, EV6.1.11 |  |  | OK
F43 : Respecter le règlement | Utiliser un IMD adapté | Modèle de l'IMD | Bender A-ISOMETER® iso-F1 IR155-3203, -3204, -4203, or -4204, or a Bender ISOMETER® iso165C-1 | Binaire | Oui, à faire valider par officiels du FS | EV6.3.2 | Détecter les défauts d'isolation haute puissance |  | OK

Sheet: EL_01005 (Interface LV)
55 | Interface LV
CDCF
Fonction | Sous-fonctions | Critère | Niveau | Unité | Flexibilité | Articles du règlement | Origine du besoin | Remarques | Vérif 1
F51 : Permettre l'interfaçage LV/extérieur | F511 : Permettre la connexion aux données de l'AMS | Connexion possible par un ordinateur | Oui | Binaire | Non | EV5.8.12 |  |  | OK
 | F512 : Permettre la connexion au SDC | Connexion possible depuis l'extérieur | Oui | Binaire | Non |  |  |  | OK
 | F513 : Permettre la connexion à l'AMS | Connexion possible depuis l'extérieur | Oui | Binaire | Non |  |  |  | OK
 | F514 : Permettre la connexion à l'IMD | Connexion possible depuis l'extérieur | Oui | Binaire | Non |  |  |  | OK
 | F515 : Ne pas gêner le déplacement de la batterie | Distance par rapport à la base du TSAC des connecteurs latéraux | >10 | cm | Oui, à voir en fonction des fixations |  | Prévision pour ne pas empiéter sur les fixations du Handcart |  | OK
 | F516 : Permettre la connexion aux alimentations des différents relais | Connexion possible depuis l'extérieur | Oui | Binaire | Oui, selon l'implémentation du contrôle des relais |  | Permettre le contrôle des AIR |  | OK
 | F517 : Permettre la connexion à la TSAL Green Voltage Detector | Connexion possible depuis l'extérieur | Oui | Binaire | Non |  | Transmettre les informations du TS à la TSAL |  | OK
 | F518 : Permettre la connexion à l'AIR +, côté véhicule | Connexion possible depuis l'extérieur | Oui | Binaire | Non | EV4.6.5 | Se connecter au data logger |  | OK
 | F519 : Résister au Rain Test | Tous les connecteurs sont étanches à l'eau | Oui | N/A |  | EV4.5.4 | Le Rain Test | L'eau peut être projetée dans toutes les directions pendant deux minutes sans interruption | OK
F52 : Sécuriser l'utilisation et la recharge de la batterie | F521 : Permettre la connexion du SDC aux différents éléments de la batterie | Continuité entre SDC et AIR + | Oui | Binaire | Non | EV6.1.1 |  |  | OK
 |  | Continuité entre SDC et AIR - | Oui | Binaire | Non | EV6.1.1 |  |  | OK
 |  | Continuité entre SDC et AMS | Oui | Binaire | Non |  |  |  | OK
 |  | Continuité entre SDC et IMD | Oui | Binaire | Non |  |  |  | OK
 |  | Continuité entre SDC et relais de précharge | Oui | Binaire | Non | EV6.1.1 |  |  | OK
 | F522 : Alimenter les AIR | Courant supportable par le SDC | > 200% * ceux nécessaire à l'alimentation des AIR | A | Non | EV6.1.1 |  |  | OK
 | F523 : Utiliser des SCS pour influencer le SDC | Etat du SDC en cas de mise à la masse | Ouvert | N/A | Non | T11.9.2, EV6.1.11 |  |  | OK
 |  | Etat du SDC en cas de circuit ouvert | Ouvert | N/A | Non | T11.9.2, EV6.1.11 |  |  | OK
 |  | Etat du SDC en cas de connexion à l'alimentation de la carte | Ouvert | N/A | Non | T11.9.2, EV6.1.11 |  |  | OK
 | F524 : Sécuriser les utilisateurs | Tension maximale entre 2 éléments ne faisant pas partie du TS | <60 | V | Non | T11.1.2 |  |  | OK
F53 : Contrôler l'utilisation de la batterie | F531 : Contrôler l'AIR - | Possibilité d'ouverture/fermeture du relai lorsque le SDC est fermé | Oui | Binaire | Non |  |  | A voir si les relais pour permettre la désactivation/activation des AIR sont à l'extérieur ou à l'intérieur de la batterie | OK
 | F532 : Contrôler l'AIR + | Possibilité d'ouverture/fermeture du relai lorsque le SDC est fermé | Oui | Binaire | Non |  |  |  | OK
 | F533 : Contrôler le relai de précharge | Possibilité d'ouverture/fermeture du relai lorsque le SDC est fermé | Oui | Binaire | Non |  |  |  | OK

Sheet: EL_01006 (Interface HV)
Système : | Interface HV
CDCF
Fonction | Sous-fonctions | Critère | Niveau | Unité | Flexibilité | Articles du règlement | Origne du besoin | Remarques | Vérif 1
F61 : Permettre la connexion au véhicule | F611 : Avoir un volume de connecteur permettant le branchement au sein de l'armoire de charge et de la voiture en manipulation | Largeur du connecteur | <100 | mm | +/-20mm |  | Permettre la connexion facile des câbles sur la voiture et dans l'armoire de charge |  | OK
 |  | Prondeur du connecteur | <100 | mm | +/-20mm |  |  |  | OK
 |  | Epaisseur du connecteur | <80 | mm | Non |  |  |  | OK
 | F612 : Etre identifiable comme un câble de haute puissance, en dehors d'un container TS | Couleur | Orange | Binaire | Non | EV4.5.8 | Règlement | Normalement cette règle s'applique pour des câbles en-dehors d'un boîtier ; néanmoins, en cas de prise mâle portée par la batterie, elle est appliquée | OK
 | F613 : Protéger l'extérieur des interférences, en possédant un blindage relié à la masse | Résistance entre le blindage et la masse | <300, pour un courant à 1A | mOhm | Non | EV4.5.8, EV4.5.9 | Règlement |  | KO
 | F614 : Ne pas gêner le déplacement de la batterie | Distance par rapport à la base du TSAC des connecteurs latéraux | >10 | cm | Oui, à voir en fonction des fixations |  | Prévision pour ne pas empiéter sur les fixations du Handcart |  | OK
F62 : Sécuriser les utilisateurs | F621 : Être visible mais non accessible (isolé physiquement) à un opérateur dès l'ouverture du TSAC | Nombre de manipulations nécessaires pour voir le busbar de haute tension après ouverture du TSAC | 0 | N/A |  | EV5.5.12 |  | Ex : mettre une plaque de plexiglas entre le busbar et un opérateur | KO
 |  | Nombre de manipulations nécessaires pour entrer en contact du busbar de haute tension après ouverture du TSAC | >= 1 | N/A |  |  |  |  | OK
 |  | Le busbar de haute puissance est séparé des modules et de la partie LV par un matériau électriquement isolant et ignifuge | Oui | N/A |  |  |  |  | NI
 | F622 : Sécuriser la connexion des modules | Câbles HV des modules uniquements connectés aux AIR | Oui | Binaire | Non |  | Pas de certification B2TL |  | OK
 | F623 : Empêcher les surintensités via un Main Fuse | Présence d'un fusible principal, appelé "Main Fuse" | Oui | N/A | Non | EV5.4.2 |  |  | OK
 |  | Le Main Fuse saute dès que l'on dépasse un seuil critique d'intensité, défini en fonction du facteur de parallélisation des modules et de la datasheet des cellules | Oui | N/A |  | EV3.3.2 |  | Ce seuil critique d'intensité ne peut pas être calculé sans connaître la solution technologique proposée | OK
 |  | La surintensité à partir de laquelle le fusible cesse de fonctionner (Interrupt current rating) est supérieure au courant théorique de court-circuit du TS (Theoretical short circuit current). Autrement dit, en cas de court-circuit, le fusible reste fonctionnel et se déclenche | Oui | N/A |  | EV3.2.3 | En cas de court-circuit dans le système, le fusible doit tout déconnecter |  | OK
 |  | Tension supportée par le Main Fuse | >= 600 | VDC |  | EV3.2.4 |  |  | OK
 |  | Température de fonctionnement du Main Fuse | [0;90] | °C |  | EV3.2.6 |  | Le règlement impose 85°C, on prend une marge de sécurité | OK
 |  | Le Main Fuse repose sur de la logique programmable | Non | N/A |  | EV3.2.5 |  |  | OK
 |  | Main Fuse positionné en entrée ou en sortie d'un des AIRs, c'est-à-dire, sur le chemin de courant principal (High Current Path) | Oui |  |  | EV3.2.7 |  |  | OK
 | F624 : Permettre un branchement sans risques avec la chaîne de haute puissance | Les AIRs sont alimentés par le SDC | Oui | N/A |  | EV6.1.1 |  |  | OK
 |  | Qualification du connecteur HV en sortie de TSAC | IP3X | Norme | Non |  | Empêcher tout contact entre un câble haute puissance et un utilisateur |  | OK
 | F625 : Minimiser la tension entre relais lorsque ceux-ci sont ouverts | Temps pour chuter à moins de 60V après ouverture du SDC | <5 | s | Non | EV6.1.5 |  |  | OK
 | F626 : Relier le TSAC à une sortie LV | Résistance entre le TSAC et la sortie LV lors du brancement | <300, pour un courant à 1A | mOhm | Non | EV7.1.2 |  |  | NI
F63 : Commander la connexion de la haute puissance au véhicule | F631 : Permettre la connexion physique | Nombre d'AIRs présents | 2 | N/A | Non | EV 5.6.1 | Alimenter le moteur de la voiture |  | OK
 |  | Positionnement des AIRs | Un sur chaque pôle de la batterie | Oui |  |  |  |  | OK
 | F632 : Sécuriser la connexion | Présence de courant dans le circuit HV si un AIR ou relai de précharge non alimenté | Non | Binaire | Non | EV 5.6.3 | Ne pas permettre l'alimentation si l'ensemble des systèmes n'est pas en état de fonctionnement optimal | AIR de type "normally open" | OK
 |  | Tension au niveau de la voiture avant fermeture des 2 AIRs | > 95% * tension de la batterie | V | Non | EV 5.7.1 | Eviter les arcs électriques |  | OK
 |  | Présence d'une résistance de précharge | Oui | Binaire | Oui, si autre système pour permettre la précharge |  | Circuit RC de précharge |  | OK
 |  | Valeur de la résistance de précharge | [A COMPLETER] | Ohm | Oui, si autre système pour permettre la précharge |  | Dimensionnement de notre circuit de précharge, quant à une tension maximale de 600VDC |  | OK
 |  | Présence d'un relais de précharge | Oui | Binaire | Non | EV 5.7.2 | Eviter les arcs électriques |  | OK
 |  | Type de relais pour les AIR | Mécanique normalement ouvert | N/A |  | EV5.6.3 |  |  | OK
 |  | Type du relais de précharge | Mécanique normalement ouvert | N/A |  | EV5.7.2 |  |  | OK
F64 : Être sécurisé lors des phases d'utilisation | F641 : Être protégé des vibrations pour que l'architecture ne varie pas | Les connexions entre les différents composants du busbar de haute puissance sont tous protégés par des mécanismes de Positive Locking | Oui | N/A |  | EV4.5.14 |  |  | NI
 | F642 : Supporter les contraintes physiques de la batterie lors d'une phase d'exploitation | Force de traction applicable sur les câbles, dans toutes les directions, sans endommagement des connexions | <= 200 | N |  | EV4.5.8 |  | La règle s'applique normalement aux câbles en-dehors d'un boîtier | NI
 |  | Le positionnement des sorties des câbles du circuit HV assure qu'aucun de ces éléments ne sortent de la "Rollover Protection Enveloppe" délimitée par la structure tubulaire. | Oui | N/A |  | EV4.4.1 |  |  | NI
 |  | Intervalle de température de fonctionnement des systèmes (AIRs, Main Fuse, Circuit de Précharge, câbles) | [0;85] | °C | Seulement sur la borne inférieure | EV4.5.3 |  |  | OK
 | F643 : Supporter le Rain Test | Tous les connecteurs sont étanches à l'eau | Oui | N/A |  | EV4.5.4 | Le Rain Test | L'eau peut être projetée dans toutes les directions pendant deux minutes sans interruption | OK

Sheet: EL_01007 (Module)
CDCF
Fonction | Sous-fonctions | Critère | Niveau | Unité | Flexibilité | Articles du règlement | Origne du besoin | Remarques | Vérif 1 | Vérif 2
F71 : Embarquer l'énergie de traction du véhicule de manière sécuritaire | F711 : Embarquer de l'énergie sous forme de cellules au lithium | Cellules de type LTO | Oui | N/A | Oui, peut être discuté |  | Formation Batteries premier volet : il s'agit d'un type de cellules non sujet à emballement thermique, qui peut décharger en 10C |  | FALSE | FALSE
 |  | Aucune cellule à sels fondus, thermiques ou à combustible | Oui | N/A |  | EV5.2.2 |  |  | FALSE | FALSE
 | F712 : Respecter les contraintes dimensionnelles de la compétition | Énergie embarquée dans un module | <= 6 | MJ |  | EV5.3.2 |  |  | FALSE | FALSE
 |  | Tension statique | [40;120] | VDC |  |  |  |  | FALSE | FALSE
 |  | Masse | <= 12 | kg |  |  |  |  | FALSE | FALSE
 | F713 : Se décharger suffisamment vite pour les phases d'accélération | Courant de décharge minimal (en pic) de la batterie | 120 | A | Oui |  | L'épreuve d'accélération, il faut des cellules qui puissent délivrer toute leur énergie en un temps court | On veut pouvoir approcher les 80 kW avec la tension nominale et le courant de pic de la batterie. Attention, on ne doit pas dépasser ces 80 kW | FALSE | FALSE
 | F714 : Comprendre un dispositif de protection contre les intensités trop importantes, pour empêcher le dépassement du courant de décharge des cellules | Intensité à partir de laquelle le dispositif de protection s'enclenche | Courant de décharge maximal de la cellule | A |  | T11.7.7 |  | Il faudra voir concrètement comment ce dispositif se manifeste : déconnecter un seul module reviendrait à déconnecter la batterie, il faudrait probablement plutôt limiter l'appel de courant | FALSE | FALSE
 | F715 : Comprendre un dispositif de protection contre les températures trop importantes, qui ouvre le ShutDown Circuit en cas de dépassement d'une tempéture critique par au moins une cellule sur un certain temps | Température à laquelle le dispositif s'enclenche | min(60°C, température de fonctionnement d'une cellule) | °C |  | T11.7.7 |  |  | FALSE | FALSE
 |  | Temps pendant lequel ladite température doit être dépassée pour que le dispositif s'enclenche | 1 | s |  |  |  |  | FALSE | FALSE
 | F716 : Comprendre un dispositif de protection contre les tensions trop importantes, qui ouvre le ShutDown Circuit en cas de dépassement d'une tension critique par au moins un segment de cellule pendant un certain temps | Tension à partir de laquelle le dispositif s'enclenche | Tension maximale autorisée pour les cellules d'après leur datasheet | V |  | T11.7.7 |  |  | FALSE | FALSE
 |  | Temps pendant lequel ladite tension doit être dépassée pour que le dispositif s'enclenche | 500 | ms |  |  |  |  | FALSE | FALSE
F72 : S'implémenter dans le TSAC et se connecter à d'autres modules | F721 : Être protégé par un TSAC | Toutes les cellules qui embarquent de l'énergie de traction pour le véhicule sont dans un TSAC | Oui | N/A |  | EV5.3.5 |  |  | FALSE | FALSE
 | F722 : Ne pas pouvoir former un arc électrique au contact d'un outil ou d'un autre module | L'enveloppe extérieure du module est rigide, ignifuge (UL94V0) et électriquement isolante | Oui | N/A | Oui, si les séparations physiques présentes dans le TSAC permettent de respecter ce critère lorsque les modules sont en place | EV5.4.6 |  |  | FALSE | FALSE
 | F723 : Être entièrement composé, mis à part pour les parties conductrices, de matériaux ignifuges (UL94V0) | Norme respectée par toutes les parties non conductrices du module | UL94V0 | N/A |  | T11.7.7 |  |  | FALSE | FALSE
 | F724 : Pouvoir être enlevé et mis dans le TSAC indépendamment des autres modules | Nombre de modules affectés physiquement par l'ajout ou le retrait d'un autre module dans le TSAC | 0 | N/A |  |  |  |  | FALSE | FALSE
 | F725 : Se connecter les uns aux autres, ainsi qu'au busbar de haute puissance, via des "Maintenance Plugs" | Nombre d'entrées/de sorties de courant dans le module | 1 | N/A |  |  | Minimisation du nombre d'entrée sortie pour minimiser toute fuite/risque électrique |  | FALSE | FALSE
 |  | L'entrée et la sortie électriques du module sont identifiées par un code couleur (rouge et noir) et connectables à des Maintenances Plugs (cf ci-dessous) | Oui | N/A |  |  | Gagner en clarté pour un opérateur découvrant la batterie |  | FALSE | FALSE
 |  | L'entrée et la sortie de courant du module se trouvent sur la face du module qui se présente à un opérateur ouvrant le TSAC. Autrement dit, en ouvrant le TSAC, un observateur voit toutes les connexions électriques entre les modules. | Oui | N/A |  |  | Souci logique : la seule dimension où les câbles auront de l'espace pour sortir, c'est celle via laquelle on retirera une partie du TSAC |  | FALSE | FALSE
 |  | La déconnexion des Maintenance Plugs isole totalement le module du reste de la chaîne de haute puissance | Oui | N/A |  | EV5.4.4 |  |  | FALSE | FALSE
 |  | Les Maintenances Plugs s'enlèvent sans nécessiter aucun outil, pour un opérateur portant des gants de protection pour 1000V | Oui | N/A |  | EV5.4.5 |  |  | FALSE | FALSE
 |  | Les Maintenances Plugs sont des connecteurs IP3X | Oui | N/A |  |  | Le règlement ne mentionne pas IP3X, mais stipule que les Maintenances Plugs ne doivent être connecteurs qu'au niveau des branchements électriques ; par sécurité, on augmenter ce critère à des connecteurs IP3X, pour qu'un opérateur ne puisse pas s'électrifier en les manipulant |  | FALSE | FALSE
 |  | Les Maintenance Plugs ne peuvent pas être connectés d'une façon autre que celle définie lors de la conception. Autrement dit, même en essayant, un opérateur ne peut connecter des modules entre eux qu'en suivant le schéma prévu | Oui | N/A |  |  | Les connexions entre les modules doivent être Monkey Proof |  | FALSE | FALSE
 |  | Les Maintenance Plugs ne peuvent pas être reconnectés accidentellement | Oui | N/A |  |  |  |  | FALSE | FALSE
 |  | Le design des Maintenance Plugs ne laisse aucune ambiguïté quant à leur état (connectés ou non). En particulier, les interrupteurs électriques ne sont pas autorisés | Oui | N/A |  |  |  |  | FALSE | FALSE
 |  | Tension supportée par les câbles reliant les Maintenance Plugs entre eux | >= 600 | VDC |  | EV5.4.7 |  |  | FALSE | FALSE
 |  | Les Maintenance Plugs sont protégés des vibrations par Positive Locking | Oui | N/A |  | IN3.1.1 |  |  | FALSE | FALSE
 | F726 : Se connecter à la basse puissance via des câbles de communication CAN | Présence de connecteurs CAN sur chacun des modules | Oui | N/A |  |  |  |  | FALSE | FALSE
F73 : Être monitoré par BMS (Battery Management System) communiquant avec l'AMS | F731 : Comporter un BMS permettant de remplir toutes les sous-fonctions suivantes | Présence d'un BMS | Oui | Binaire | Non |  |  |  | FALSE | FALSE
 | F732 : Mesurer la température des cellules d'un module à l'aide de capteurs de température connectés au BMS | Proportion de cellules monitorées dans un module, de manière équirépartie | >= 30 | % |  | EV5.8.4 |  |  | FALSE | FALSE
 |  | Position des capteurs de température sur la cellule | <= 10 Par rapport au pôle négatif de la cellule ou à son busbar de haute intensité | mm |  |  |  |  | FALSE | FALSE
 |  | Nombre de cellules dont on mesure la température avec un seul capteur | >= 1 si la contrainte précédente est respectée | N/A |  |  |  |  | FALSE | FALSE
 | F733 : Comprendre un dispositif de protection contre les intensités trop importantes, pour empêcher le dépassement du courant de décharge des cellules | Intensité à partir de laquelle le dispositif de protection s'enclenche | Courant de décharge maximal de la cellule | A |  | T11.7.7 |  | Il faudra voir concrètement comment ce dispositif se manifeste : déconnecter un seul module reviendrait à déconnecter la batterie, il faudrait probablement plutôt limiter l'appel de courant | FALSE | FALSE
 | F734 : Comprendre un dispositif de protection contre les températures trop importantes, qui ouvre le ShutDown Circuit en cas de dépassement d'une tempéture critique par au moins une cellule sur un certain temps | Température à laquelle le dispositif s'enclenche | min(60°C, température de fonctionnement d'une cellule) | °C |  | T11.7.7 |  |  | FALSE | FALSE
 |  | Temps pendant lequel ladite température doit être dépassée pour que le dispositif s'enclenche | 1 | s |  |  |  |  | FALSE | FALSE
 | F735 : Comprendre un dispositif de protection contre les tensions trop importantes, qui ouvre le ShutDown Circuit en cas de dépassement d'une tension critique par au moins un segment de cellule pendant un certain temps | Tension à partir de laquelle le dispositif s'enclenche | Tension maximale autorisée pour les cellules d'après leur datasheet | V |  | T11.7.7 |  |  | FALSE | FALSE
 |  | Temps pendant lequel ladite tension doit être dépassée pour que le dispositif s'enclenche | 500 | ms |  |  |  |  | FALSE | FALSE
 | F736 : Assurer la fiabilité et la sécurisation des signaux de ses différents dispositifs de sécurité | Tous les signaux utilisés pour remplir la connexion entre le BMS et le module sont des signaux critiques | Oui | N/A |  | T11.7.7 |  |  | FALSE | FALSE
F74 : Autoriser des opérations de maintenance pour un opérateur B2XL | F741 : Permettre le positionnement d'un capteur de température indépendant près du pôle négatif de la cellule la plus chaude du module | Distance entre le capteur de température et le pôle négatif de la cellule la plus chaude du module | <= 30 Pour un capteur de température positionné sur le busbar relié au pôle négatif de la cellule la plus chaude | mm |  | EV5.8.6 |  |  | FALSE | FALSE
 | F742 : Avoir des connexions de capteurs facilement démontables et remontables | Il est possible de déconnecter individuellement de manière non destructive les fils du capteur de courant, d'un capteur de température, et d'un capteur de tension de cellule si la technologie de transmission de l'information est un fil. | Oui | N/A |  | EV5.8.11 |  | La partie "non-destructive" a été ajoutée, car cette requête peut avoir lieu à l'Inspection Technique, après laquelle les modules doivent toujours être fonctionnels | FALSE | FALSE
 | F743 : Fermé, ne présenter que des connexions IP3X et aucune PNST | Norme des connecteurs | IP3X | N/A |  |  | On parle d'opérateurs B2XL |  | FALSE | FALSE
 | F744 : Être intégralement démontable jusqu'à l'ensemble capteurs, cellules et busbars, sans procédé destructif sur des éléments autres que les consommables (ex : destruction prévue des systèmes de Positive Locking) | Nombre de procédés destructifs sur les éléments autres que les consommables pour parvenir aux capteurs, aux cellules ou au busbar | 0 | N/A |  |  |  |  | FALSE | FALSE
 | F745 : Ne pas être endommagé par des opérations de maintenance classiques | Force ponctuelle à appliquer sur n'importe quelle partie du module pour qu'il se déforme plastiquement | >= 200 | N |  |  | On ne doit pas endommager le module en donnant sans le vouloir un coup de tournevis |  | FALSE | FALSE
F75 : Résister aux contraintes physiques du véhicule en fonctionnement | F751 : Sécuriser l'architecture interne en cas de vibrations | Toutes les connexions électriques sur le chemin de courant principal (entrée et sortie du module vers les Maintenance Plugs) sont sécurisées par du Positive Locking | Oui | N/A |  | EV4.5.14 |  |  | FALSE | FALSE
 | F752 : Fonctionner même en cas d'échauffement des cellules | Intervalle de température au sein duquel les composants autres que les cellules Li ne subissent pas de dommages | [0;85] | °C |  | EV4.5.3 |  |  | FALSE | FALSE

Sheet: EL_01008 (Chargeur)
Système : | Chargeur
CDCF
Fonction | Sous-fonctions | Critère | Niveau | Unité | Flexibilité | Articles du règlement | Origne du besoin | Remarques | Vérif 1
F81 : Charger la batterie | F811 : Se connecter au connecteur haute tension | Connexion faisable | Oui | Binaire | Non |  |  |  | KO
 | F812 : Alimenter la batterie et permettre sa charge | Vitesse | De 20% à 80% en 3h | h | +/-1h |  | Recharger la batterie en une séance de PE/PA |  | NI
 | F813 : Etre identifiable comme un câble de haute puissance | Couleur | Orange | Binaire | Non | EV4.5.8 | Règlement |  | KO
 | F814 : Protéger l'extérieur des interférences, en possédant un blindage relié à la masse | Résistance entre le blindage et la masse | <300, pour un courant à 1A | mOhm | Non | EV4.5.8, EV4.5.9 | Règlement |  | KO
 | F815 : Résister aux contraintes en utilisation | Force en traction avant endommagement des câbles | >250 | N | Non | EV4.5.8 | Règlement |  | NI
F82 : Sécuriser les utilisateurs | F821 : Relier le TSAC et les parties conductives accessibles à la terre | Résistance entre le TSAC et la prise de terre lors du branchement | <300, pour un courant à 1A | mOhm | Non | EV7.1.2 |  |  | FALSE
 | F822 : Ne pas présenter de PNST | Absence de PNST | Oui | Binaire | Non | EV7.1.1 |  |  | FALSE
 | F823 : Bloquer le contact humain avec tout circuit électrique | Qualification des connecteurs | IP3X | N/A | Non | EV7.1.1 | Empêcher l'électrisation des utilisateurs |  | FALSE
 | F824 : Fermer le SDC lors du fonctionnement nominal | Présence d'un circuit dédié à la fermeture du SDC | Oui | Binaire | Non | EV6.1.9 |  |  | OK
 |  | Circuit non programmable | Oui | Binaire | Non | EV6.1.9 |  |  | OK
 |  | Etat du SDC si dysfonctionnement | Ouvert | N/A | Non | EV6.1.9 |  |  | OK
 |  | Courant pouvant circuler | > 200% * ceux nécessaire à l'alimentation des AIR | A | Non | EV6.1.9 |  |  | OK
 | F825 : Nécessiter une action manuelle pour refermer le SDC | Nombre de manipulations pour fermer le SDC | 1 | N/A | Non | EV7.2.2 |  |  | FALSE
 |  | Logique nécessaire à l'action manuelle en Hardware uniquement | Oui | Binaire | Non | EV6.1.6 |  |  | FALSE
 | F826 : Permettre l'extinction d'urgence du chargeur | Présence d'un bouton d'arrêt d'urgence | Oui | Binaire | Non | EV7.1.6 |  |  | FALSE
 |  | Diamètre du bouton d'arrêt d'urgence | >24 | mm | Non | EV7.1.6 |  |  | FALSE
 |  | Etat du SDC après activation du bouton d'arrêt d'urgence | Ouvert | N/A | Non | EV7.2.1 |  |  | FALSE
 | F827 : Informer l'utilisateur d'un défaut d'isolation | Présence d'une led rouge sur le chargeur | Oui | Binaire | Non | EV7.1.8 |  |  | FALSE
 |  | Etat de la LED en cas de défaut d'isolation | Allumée | N/A | Non | EV7.1.8 |  |  | FALSE
 | F828 : Indiquer les fonctionnalités du chargeur | Pourcentage des indicateurs, sorties et actionneurs labellisés | 100 | % | Non | EV7.1.10 |  |  | FALSE
 | F829 : Permettre la vérification de la tension actuelle | Nombre de points de mesure (TSMP) présents | 2 | N/A | Non |  |  |  | FALSE
 |  | Connexion directe entre les (TSMP) et les sorties HV du chargeur | Oui | Binaire | Non | EV7.1.9 |  |  | FALSE
 |  | Type de branchement | Prise banane 4mm | N/A | Non | EV4.7.3 |  |  | FALSE
 |  | Tension supportable par le branchement | >1000 | V | Non | EV4.7.3 |  |  | FALSE
 |  | Résistance entre les sorties HV et les TSMP | >15 | kOhm | Oui, en fonction de la tension du TS | EV4.7.6 |  |  | FALSE
 |  | Être monté sur fond orange | Oui | Binaire | Non | EV4.7.4 |  |  | FALSE
 |  | Type de fixations pour les TSMP | Positive-locking | N/A | Non | EV4.7.7 |  |  | FALSE
 |  | Présence de protections attachées au véhicules sur les TSMP | Oui | Binaire | Non | EV4.7.5 |  |  | FALSE
 |  | Outils nécessaires pour enlever les protections | 0 | N/A | Non | EV4.7.5 |  |  | FALSE
 |  | Présence d'un point de mesure "GND" relié au ground du circuit LV | Oui | Binaire | Non | EV4.7.8 |  |  | FALSE
 | F8210 : Eteindre le chargeur en cas de dysfonctionnement | Etat du chargeur après ouverture défaut détecté par IMD | Eteint | N/A | Non | EV7.2.2 |  |  | FALSE
 |  | Etat du chargeur après ouverture défaut détecté par AMS | Eteint | N/A | Non | EV7.2.2 |  |  | FALSE
 | F8211 : Alimenter les éléments basse tension de la batterie | Etat de l'AMS lorsque la batterie est branchée et le chargeur allumé | Allumé | N/A | Non |  |  |  | FALSE
 |  | Etat de l'IMD lorsque la batterie est branchée et le chargeur allumé | Allumé | N/A | Non |  |  |  | FALSE
 | F8212 : Minimiser la tension entre relais lorsque ceux-ci sont ouverts | Temps pour chuter à moins de 60V après ouverture du SDC | <5 | s | Non | EV6.1.5 |  |  | FALSE
 | F8213 : Bloquer la charge en cas de SDC ouvert | Charge possible en cas de SDC ouvert | Non | Binaire | Non | EV7.2.2 |  |  | FALSE
 | F8214 : Utiliser des SCS pour influencer le SDC | Etat du SDC en cas de mise à la masse | Ouvert | N/A | Non | T11.9.2, EV7.2.4 |  |  | FALSE
 |  | Etat du SDC en cas de circuit ouvert | Ouvert | N/A | Non | T11.9.2, EV7.2.4 |  |  | FALSE
 |  | Etat du SDC en cas de connexion à l'alimentation de la carte | Ouvert | N/A | Non | T11.9.2, EV7.2.4 |  |  | FALSE
F83 : Etre déplacable et stockable | F831 : Permettre un branchement proche de la batterie | Dimensions du chargeur | <500x250x500 (Lxlxh) | mm^3 | Oui, voir dimension armoire |  |  |  | FALSE
 | F832 : Pouvoir être supporté par une étagère | Masse | <50 | kg | Oui, idem |  |  |  | FALSE
 | F833 : En cas de poids important, faciliter le déplacement | Nombre de poignées | 2 | N/A | Oui, en fonction de la masse |  |  |  | FALSE
F84 : Sécuriser l'installation électrique | F841 : Séparer l'ensemble des systèmes électriques de haute puissance et de basse puissance | Présence d'une barrière physique isolée et résistante à l'humidité lorsque c'est possible | Oui | Binaire | Oui, voir sous-fonction suivante | EV4.3.4 |  |  | FALSE
 |  | Distance entre circuits LV et HV, avec tension <100V | >10 | mm | Non | EV4.3.4 |  |  | FALSE
 |  | Distance entre circuits LV et HV, avec tension <200V et >100V | >20 | mm | Non | EV4.3.4 |  |  | FALSE
 |  | Distance entre circuits LV et HV, avec tension >200V | >30 | mm | Non | EV4.3.4 |  |  | FALSE
 |  | Circuits maintenus physiquement par des attaches bloqué par des systèmes de positive-locking | Oui | Binaire | Non | EV4.3.5 |  |  | FALSE

Sheet: Template
Système :
CDCF |  |  |  |  |  |  |  |  |  |  | CAS DE CHARGE
Fonction | Sous-fonctions | Critère | Niveau | Unité | Flexibilité | Articles du règlement | Origine du besoin | Remarques | Vérif 1 | Vérif 2 | Cas de charge | Nominal | Limite | Extrême
F |  |  |  |  |  |  |  |  | FALSE | FALSE | Grandeur 1 | Description | Description | Description
 |  |  |  |  |  |  |  |  | FALSE | FALSE |  | Niveau | Niveau | Niveau
 |  |  |  |  |  |  |  |  | FALSE | FALSE | Grandeur 2 | Description | Description | Description
F |  |  |  |  |  |  |  |  | FALSE | FALSE |  | Niveau | Niveau | Niveau
 |  |  |  |  |  |  |  |  | FALSE | FALSE | Grandeur 3 | Description | Description | Description
 |  |  |  |  |  |  |  |  | FALSE | FALSE |  | Niveau | Niveau | Niveau
F |  |  |  |  |  |  |  |  | FALSE | FALSE
 |  |  |  |  |  |  |  |  | FALSE | FALSE
 |  |  |  |  |  |  |  |  | FALSE | FALSE
F |  |  |  |  |  |  |  |  | FALSE | FALSE
 |  |  |  |  |  |  |  |  | FALSE | FALSE
 |  |  |  |  |  |  |  |  | FALSE | FALSE
