EOSCogniton/ELIZ-2022/01 - Maquette CATIA/FR_Frame_Body/SES EPSA 2023.xlsx

Sheet: F.3.1-4 Tube Chassis
 | University Name |  |  |  |  |  |  | BLANK |  | 2023 | FSAE Structural Equivalency Spreadsheet (SES), includes Impact Attenuator Document (IAD) |  |  |  |  |  |  |  |  |  |  | Steel Tube | 1.1 | Acc Fastener Shear
 | Team Name |  |  |  |  |  |  | BLANK
 | Competitions | May - IC |  | June - EV | Other - Edit | Other - Edit |  | EQ |  | There are two versions of the 2023 SES: Steel Tube and Monocoque/Hybrid/Non-Ferrous.
 | Car Numbers |  |  |  |  |  |  | BLANK |  | Aluminum equivalance may be used in the Steel Tube SES for Anti-Intrusion, EV Rear Impact, or Accumulator Containers and Mounting.
 | Team Contact(s) |  |  |  |  |  |  | BLANK |  | Steel can be used for any part of the frame in the Monocoque/Hybrid/Non-Ferrous SES.
 | Email Address(es) |  |  |  |  |  |  | BLANK |  | F.3.4.2 - Any and all steel grades are assigned the same material properties. No material properties for different grades may be used in the SES.
Faculty Advisor |  | Email Address |  | Chassis Rules | Powertrain |  |  | EQ |  | Teams using multiple chassis in one season: Comment below the SES submission with a link to the SES for the second chassis, before the Action Deadline.
 |  |  |  | Select Drop Down | Select Drop Down |  |  | BLANK
 |  |  |  |  |  |  |  |  |  |  | Only cells of this color can be edited. Enter all values as positive numerals. |  |  |  |  |  |  |  |  |  |  |  |  |  |  |  |  | Front 3/4 3D CAD with color coded tube sizes required. |  |  |  |  |  |  |  |  |  |  | Rear 3/4 3D CAD with color coded tube sizes required.
Overall |  |  | Ready to submit for review? |  |  |  | NO |  |  | Drop down options can be identified by the heavy border. Delete will clear the entry.
 |  |  |  |  |  |  |  |  |  | Each entry, each category, each tab, and the entire sheet are coded as one of the following: |  |  |  |  |  |  |  | BLANK | EQ | CHECK | REJECT | N/A |  |  |  |  |  |  | Use different colors for square and round. |  |  |  |  |  |  |  |  |  |  | Use different colors for square and round.
 | F.3.1-4 Tube Chassis | BLANK | BLUE: NO. BLANK ENTRY. INCOMPLETE. CHECK ALL TABS. |  |  |  |  |  |  | The status of some cells depends on entries in other cells.
 | F.10-11 EV Accumulator | BLANK | This will not change until all required entries are filled out. Check all tabs. |  |  |  |  |  |  |  |  |  |  |  |  |  |  |  |  |  |  |  |  |  |  |  |  |  | Include a legend that shows each color and size. |  |  |  |  |  |  |  |  |  |  | Include a legend that shows each color and size.
 | F.8 Front Protection | BLANK | Incomplete submissions will incur a penalty. |  |  |  |  |  |  | SELECT YOUR UNITS. The entire SES will be completed in either mm or Inch. Inch tubing can be entered in mm, and vice versa.
 | F.3.4.3 Welded Inserts | BLANK | RED ORANGE: NO. GROUNDS FOR REJECTION. CHECK ALL TABS. |  |  |  |  |  |  | Keep a copy of the rules open to reference rule numbers directly while filling out the SES. |  |  |  |  |  |  |  |  |  |  |  |  |  |  |  |  |  | Fuel tank or HV systems must be shown in orange. |  |  |  |  |  |  |  |  |  |  | Fuel tank or HV systems must be shown in orange.
 | F.5.12 Bolted Members | BLANK | The SES will permanently REJECT for removing any tab. Fill out a fresh copy. |  |  |  |  |  |  | Fill in all | BLANK | sections on ALL TABS. Start with any drop downs in the top left corner of each tab.
BLANK |  |  | Locate all violations and bring the design into compliance before submitting. |  |  |  |  |  |  | Replace example images with your own clear, undistorted CAD, showing all required dimensions in a moderate filesize. Each SES file 25Mb max.
 |  |  | Grounds for rejection could be considered incomplete and incur a penalty. |  |  |  |  |  |  | Read the additional guidance on the right side of this sheet.
 |  |  | SKY: YES. RULES EQUIVALENCE.
 |  |  | Document is ready for review. Double check triangulation. |  |  |  |  |  | F.2.2.1 | SES forms must be completed and submitted by all teams no later than the date specified in the Action Deadlines on the specific event website.
 |  |  | Sheet protection must still be active when submitted, or the SES will be rejected. |  |  |  |  |  | DR.3.2.1 | Submission of late, blank, incomplete, or previous car's SES will incur a competition point penalty.
 |  |  | YELLOW: YES. CHECK ADDITIONAL EQUIVALENCIES. |  |  |  |  |  | DR.3.1.2.b | Do not submit an updated document after the deadline without having the previous document rejected.
 |  |  | Some entries require additional tubes or documentation. |  |  |  |  |  | DR.3.1.2.b | Submit a comment requesting a rejection on your team's SES page on fsaeonline.com. Submissions or comments on FSAEonline.com will send a notification to your reviewer.
 |  |  | Once these are added, document is ready for review. |  |  |  |  |  | DR.3.1.3 | Please respond quickly and thoroughly to requests for revisions or clarifications. Your team's response time influences Tech Inspection order.
mm |  |  |  |  |  | Units |  |  | IN.8.1 | Bring an ELECTRONIC copy of the approved SES to Tech Inspection. It is your responsibility to bring a functioning, charged tablet or laptop. Bring backups. DO NOT PRINT.
 |  |  |  |  |  |  |  |  | IN.1.4 | Approval of an SES does not guarantee passing Tech Inspection. The final decision about all designs will be made at Tech Inspection.
Use the space below to list changes between uploads, rules inquiries, and any other information.
 |  |  |  |  |  |  |  | Front Hoop CAD with dimensions required. |  |  |  |  |  |  |  |  | FBHS, FHB CAD with dimensions required. |  |  |  |  |  |  |  |  |  | SIS CAD with dimensions required. |  |  |  |  |  |  |  | MH + SH CAD with dimensions required. |  |  |  |  |  |  |  | MHB, MHBS CAD with dimensions required.
 |  |  |  |  |  |  |  |  |  |  |  |  |  |  |  |  | Highlight/trace/color code required tubes. |  |  |  |  |  |  |  |  |  | Highlight/trace/color code required tubes. |  |  |  |  |  |  |  |  |  |  |  |  |  |  |  | Highlight/trace/color code required tubes.
 |  |  |  |  |  |  |  | Additional images may be placed below each section. |  |  |  |  |  |  |  |  | Additional images may be placed below each section. |  |  |  |  |  |  |  |  |  | Additional images may be placed below each section. |  |  |  |  |  |  |  | Additional images may be placed below each section. |  |  |  |  |  |  |  | Additional images may be placed below each section.
 |  |  |  |  |  |  |  | BLANK |  | Front Hoop (FH), Steering Protection |  |  |  |  |  |  | BLANK |  | Front Bulkhead Supports (FBHS), |  |  |  |  |  |  |  | BLANK |  | Side Impact Structure (SIS), |  |  |  |  |  | BLANK |  | Main Hoop (MH), |  |  |  |  |  | BLANK |  | Main Hoop Braces (MHB),
 |  |  |  |  |  |  |  | F.5.7.2-3 | The FH runs from the lowest frame member on each side. The FH may be multiple pieces. |  |  |  |  |  |  |  | Front Hoop Braces (FHB) |  |  |  |  |  |  |  |  |  | Lap and Sub Belt Attachment |  |  |  |  |  |  |  | Shoulder Harness Bar (SH) |  |  |  |  |  |  |  | Main Hoop Brace Supports (MHBS)
 |  |  |  |  |  |  |  | F.5.6.2.b | Front view FH bends below the Upper SIS must meet a triangulated FBHS or SIS node.
 |  |  |  |  |  |  |  | F.5.6.2 | All FH side view bends must meet a triangulated FBHS or SIS tube end. |  |  |  |  |  |  |  | There are three basic configurations for the FBHS. See examples starting in column CO. |  |  |  |  |  |  |  |  |  |  |  |  |  |  |  |  |  | F.5.8.1-2 | The Main Hoop extend, uncut, from the lowest frame member on both sides. |  |  |  |  |  |  | F.5.9.6 | The Main Hoop Braces must be one piece, steel, with no bends.
 |  |  |  |  |  |  |  |  |  |  |  |  |  |  |  |  | A. | Upper FBHS from the top of the FB to the Upper SIS, with a tolerance. |  |  |  |  |  |  |  |  | F.6.4.4 | Designate the Upper SIS and Lower SIS along their entire length. |  |  |  |  |  |  | F.5.6.2 | All bends below the Upper SIS must have an SIS or MHBS tube within 25mm. |  |  |  |  |  |  | Designate the Main Hoop Braces.
 |  |  |  |  |  |  |  | BLANK |  |  |  |  |  |  |  |  |  | Lower FBHS from the bottom of the FB to the Lower SIS. |  |  |  |  |  |  |  |  | Upper SIS height is measured from the lowest point of the top surface of the Lower SIS tube. |  |  |  |  |  |  |  | F.5.8.3.b | Main Hoop side view bends must be braced to an MHBS or SIS node. |  |  |  |  |  |  | 'X' or 'V' MHB configurations are strongly discouraged.
 |  |  |  |  |  |  |  | F.5.7 | Front Hoop (FH) |  |  |  | Minimum | Tube Used |  | EQ | B. | Upper FBHS from the top of FB to above the Upper SIS, braced rearward. |  |  |  |  |  |  |  |  | F.6.4.6 | The area between the upper and lower SIS must be completely triangulated.
 |  |  |  |  |  |  |  | F.3.2.1.c | Example: 25mm x 2.5mm round |  |  |  | Size A |  |  | BLANK |  | Lower FBHS from the bottom of the FB to the Lower SIS. |  |  |  |  |  |  |  |  | A straight Upper SIS may be intersected by triangulated tubes without being considered bent. |  |  |  |  |  |  |  | F.6.5.1.a | Tube Shoulder Harness Bars must be one piece of uncut, continuous steel tubing. |  |  |  |  |  |  | F.6.6.2 | The MHB must be triangulated back to the Main Hoop at the Upper and Lower SIS.
 |  |  |  |  |  |  |  | F.3.4.1.a |  |  |  | Wall thickness: | 2 |  | mm | BLANK | C. | Upper FBHS from the top of FB to above the Upper SIS, braced rearward. |  |  |  |  |  |  |  |  | F.3.2.1.f | A bent Upper Side Impact tube requires Size D. |  |  |  |  |  |  | F.6.5.1.b | Tube Shoulder Harness Bars must connect to the Main Hoop at both ends. |  |  |  |  |  |  | F.6.6.2.a | The Upper MHBS runs from MHB to the Upper SIS.
 |  |  |  |  |  |  |  |  |  |  |  | Square side: | 25 |  | mm | BLANK |  | Lower FBHS from the bottom of the FB to the Upper SIS, with a tolerance. |  |  |  |  |  |  |  |  | F.5.2.3.c | Diagonals for straight or bent upper SIS are both minimum Size B. |  |  |  |  |  |  | F.6.5.2.b | Shoulder Harness Braces must support the middle of SH bends. |  |  |  |  |  |  | Designate the Upper MHBS along its entire length.
 |  |  |  |  |  |  |  |  |  |  |  | Wall thickness: | 2.0 |  | mm | BLANK |  | A second Lower FBHS path from the bottom of the FB to the Lower SIS. |  |  |  |  |  |  |  |  |  |  |  |  |  |  |  |  | F.6.5.2.b | Shoulder Harness Braces must connect back to the Main Hoop, ideally at a node. |  |  |  |  |  |  | F.6.6.2.b | The Lower MHBS runs from MHB to the Lower SIS.
 |  |  |  |  |  |  |  |  |  |  |  | Square side: | 25.0 |  | mm | BLANK | F.6.2.3.a | Designate the Upper FBHS along its entire length. |  |  |  |  |  |  |  |  | BLANK |  |  |  |  |  |  |  | F.6.5.2.b | The larger the SH Brace angle (>=30), the better the moment from the harness is reacted. |  |  |  |  |  |  | Designate the Lower MHBS along its entire length.
 |  |  |  |  |  |  |  |  |  |  |  | Tube cross sectional area (A): | 173 |  | mm^2 | BLANK | F.6.2.3.c | Designate the Lower FBHS along its entire length. |  |  |  |  |  |  |  | F.6.4.4.b | F.6.4.1 | Upper Side Impact Structure (SIS) |  |  |  |  |  | BLANK | The MHB may act as braces for a bent Shoulder Harness Bar. See column 'F' to the right. |  |  |  |  |  |  |  | F.6.6.2 | The area between the Upper and Lower MHBS must be completely triangulated
 |  |  |  |  |  |  |  |  |  |  |  | Tube second moment of inertia (I): | 11320 |  | mm^4 | BLANK | F.6.2.3.d | The area between the Upper and Lower FBHS must be completely triangulated |  |  |  |  |  |  |  | F.6.4.4.b |  |  |  |  | Minimum | Tube Used |  | EQ |  | SH Brace Angle: | https://www.fsaeonline.com/cdsweb/rqa/ViewFAQ.aspx?faqnum=284 |  |  |  |  |  | with tubes meeting F.3.4.1 Size C.
 |  |  |  |  |  |  |  |  |  |  |  |  |  |  |  |  | with tubes meeting F.3.4.1 Size C. |  |  |  |  |  |  |  |  |  | F.3.2.1.f | Example: 35mm x 1.2mm round |  |  | Size D |  |  | BLANK | BLANK |  |  |  |  |  |  |  | F.6.6.2.a | A Shoulder Harness Bar and/or SH Brace may be used as part of the MHBS.
 |  |  |  |  |  |  |  | BLANK |  |  |  |  |  |  |  |  |  |  |  |  |  |  |  |  |  |  | F.3.2.1.d |  |  | Wall thickness: | 1.2 |  | mm | BLANK | F.5.8.1 | Main Hoop (MH) |  |  | Minimum | Tube Used |  | EQ
 |  |  |  |  |  |  |  | F.5.7.4 |  |  |  |  | Turned Steering Wheel minimum below FH top: |  | mm | BLANK | X-braces form two segments in side view, and cannot be used for Upper FBHS |  |  |  |  |  |  |  |  |  |  |  |  | Square side: | 35 |  | mm | BLANK | F.3.2.1.g | Example: 25mm x 2.5mm round |  |  | Size A | Round |  | EQ | F.5.8.3.b | Main Hoop side view bends above Upper SIS must be braced to an MHBS node.
 |  |  |  |  |  |  |  |  |  |  |  |  |  |  |  |  | in Types B or C without additional triangulation to the center node. |  |  |  |  |  |  |  |  |  |  |  |  | Wall thickness: | 1.2 |  | mm | BLANK | F.3.4.1.a |  |  | Wall thickness: | 2 |  | mm | BLANK
 |  |  |  |  |  |  |  | BLANK |  |  |  |  |  |  |  |  | V-braces meet at the center at one end, and cannot be used for Upper FBHS in Types B or C. |  |  |  |  |  |  |  |  |  |  |  |  | Square side: | 35.0 |  | mm | BLANK |  |  |  | Outer Diameter (OD): | 25 |  | mm | BLANK |  | Main Hoop Braces may run forward or rearward.
 |  |  |  |  |  |  |  | F.5.7.5 |  |  |  |  | FH to Steering Wheel gap <=250mm (9.8in) |  | mm | BLANK | 'X' or 'V' FHB configurations are discouraged. |  |  |  |  |  |  |  |  |  |  |  |  | Tube cross sectional area (A): | 126 |  | mm^2 | BLANK |  |  |  | Wall thickness: | 2.0 |  | mm | BLANK | BLANK
 |  |  |  |  |  |  |  |  |  |  |  |  |  |  |  |  | The upper and lower segments of a straight Front Hoop tube (created by the FBHS offset to |  |  |  |  |  |  |  |  |  |  |  |  | Tube second moment of inertia (I): | 18015 |  | mm^4 | BLANK |  |  |  | Outer Diameter (OD): | 25.0 |  | mm | BLANK | F.5.9.2 |  |  |  | Main Hoop brace direction: |  |  | BLANK
 |  |  |  |  |  |  |  | BLANK |  |  |  |  |  |  |  |  | the Upper SIS) are treated as one segment. |  |  |  |  |  |  |  |  |  |  |  |  |  |  |  |  |  |  |  |  | Tube cross sectional area (A): | 173 |  | mm^2 | BLANK | F.5.9.5 |  |  |  | Angle between MH and MHB >=30 degrees: |  | degrees | BLANK
 |  |  |  |  |  |  |  | F.5.7.6 |  |  |  |  | FH side angle above Upper SIS <=20 degrees: |  | degrees | BLANK |  |  |  |  |  |  |  |  |  |  | BLANK |  |  |  |  |  |  |  |  |  |  | Tube second moment of inertia (I): | 11320 |  | mm^4 | BLANK
 |  |  |  |  |  |  |  |  |  |  |  |  |  |  |  |  | F.6.3.6 | A tube FHB must be straight, without any bends. (One segment.) |  |  |  |  |  |  |  |  |  |  |  |  | Top surface of Lower SIS to Lowest UpperSIS point >=240mm: |  | mm | BLANK |  |  |  |  |  |  |  |  | BLANK
 |  |  |  |  |  |  |  | BLANK |  |  |  |  |  |  |  |  | Designate the Front Hoop Braces. |  |  |  |  |  |  |  |  |  |  |  |  |  | Top surface of Lower SIS to Highest UpperSIS point <=320mm: |  | mm | BLANK | BLANK |  |  |  |  |  |  |  | F.5.9.4 |  |  |  | Top of MH of MHB tube, 160mm vertical limit: |  | mm | BLANK
 |  |  |  |  |  |  |  | F.6.3.5 |  |  |  |  | FH rearward lean above Upper SIS <= 10, or braced: |  | degrees | BLANK | F.6.3.3 | The FHB should extend all the way to the Front Bulkhead. |  |  |  |  |  |  |  |  |  |  |  |  | Highest and lowest are on the top and bottom of the Upper SIS tube. | 0 | mm | BLANK | F.6.5 | Shoulder Harness Bar (SH) |  |  |  |  |  | BLANK
 |  |  |  |  |  |  |  |  | Rearward Front Hoop Brace is not required. |  |  |  |  |  |  |  | F.5.6.2 | Front FHB that do not reach the FB must end the node of a completely triangulated structure. |  |  |  |  |  |  |  |  |  |  |  |  |  |  |  |  |  |  |  |  | Minimum | Tube Used |  | EQ | BLANK
 |  |  |  |  |  |  |  |  |  |  |  |  |  |  |  |  | F.5.6.2 | Rear FHB must end at the node of a completely triangulated structure. |  |  |  |  |  |  |  |  | BLANK |  |  |  |  |  |  |  | F.3.2.1.k | Example: 25mm x 2.5mm round |  |  | Size A |  |  | BLANK | F.5.9.1 | Main Hoop Brace (MHB) |  |  | Minimum | Tube Used |  | EQ
 |  |  |  |  |  |  |  | BLANK |  |  |  |  |  |  |  |  | T.1.3.2 | The driver's feet and legs must be completely enclosed by tubes meeting F.3.4.1. |  |  |  |  |  |  |  |  | F.6.4.1 | Lower / Diagonal SIS |  |  | Minimum | Tube Used |  | EQ | F.3.4.1.a |  |  | Wall thickness: | 2 |  | mm | BLANK | F.3.2.1.h | Example: 25.4mm x 1.6mm round |  |  | Size B |  |  | BLANK
 |  |  |  |  |  |  |  | F.5.14 |  |  |  |  | Steering rack is inside the FBHS? |  |  | BLANK | In side view, feet on pedals, structural tubes must be above and below all of feet and legs. |  |  |  |  |  |  |  |  |  | F.3.2.1.e | Example: 25.4mm x 1.6mm round |  |  | Size B |  |  | BLANK |  |  |  | Square side: | 25 |  | mm | BLANK | F.3.4.1.b |  |  | Wall thickness: | 1.2 |  | mm | BLANK
 |  |  |  |  |  |  |  |  |  |  |  | Additional steering protection required the FBHS. |  |  |  | EQ | Tubes may be added for leg and foot protection. |  |  |  |  |  |  |  |  |  | F.3.4.1.b |  |  | Wall thickness: | 1.2 |  | mm | BLANK |  |  |  | Wall thickness: | 2.0 |  | mm | BLANK |  |  |  | Square side: | 25 |  | mm | BLANK
 |  |  |  |  |  |  |  | F.6.2.3.b | Rear Front Bulkhead Support (FBHS) |  |  |  | Minimum | Tube Used |  | EQ | BLANK |  |  |  |  |  |  |  |  |  |  |  |  | Square side: | 25 |  | mm | BLANK |  |  |  | Square side: | 25.0 |  | mm | BLANK |  |  |  | Wall thickness: | 1.2 |  | mm | BLANK
 |  |  |  |  |  |  |  | F.3.2.1.b | Example: 25.4mm x 1.2mm round |  |  |  | Size C |  |  | BLANK | F.6.2 | Front Bulkhead Support (FBHS) |  |  |  | Minimum | Tube Used |  | EQ |  |  |  |  | Wall thickness: | 1.2 |  | mm | BLANK |  |  |  | Tube cross sectional area (A): | 173 |  | mm^2 | BLANK |  |  |  | Square side: | 25.0 |  | mm | BLANK
 |  |  |  |  |  |  |  | F.3.4.1.c |  |  |  | Wall thickness: | 1.2 |  | mm | BLANK | F.3.2.1.b | Example: 25.4mm x 1.2mm round |  |  |  | Size C |  |  | BLANK |  |  |  |  | Square side: | 25.0 |  | mm | BLANK |  |  |  | Tube second moment of inertia (I): | 11320 |  | mm^4 | BLANK |  |  |  | Tube cross sectional area (A): | 114 |  | mm^2 | BLANK
 |  |  |  |  |  |  |  |  |  |  |  | Square side: | 25 |  | mm | BLANK | F.3.4.1.c |  |  |  | Wall thickness: | 1.2 |  | mm | BLANK |  |  |  |  | Tube cross sectional area (A): | 114 |  | mm^2 | BLANK |  |  |  |  |  |  |  |  |  |  |  | Tube second moment of inertia (I): | 8509 |  | mm^4 | BLANK
 |  |  |  |  |  |  |  |  |  |  |  | Wall thickness: | 1.2 |  | mm | BLANK |  |  |  |  | Square side: | 25 |  | mm | BLANK |  |  |  |  | Tube second moment of inertia (I): | 8509 |  | mm^4 | BLANK |  | Shoulder Harness Bar bends requires braces.
 |  |  |  |  |  |  |  |  |  |  |  | Square side: | 25.0 |  | mm | BLANK |  |  |  |  | Wall thickness: | 1.2 |  | mm | BLANK |  |  |  |  |  |  |  |  |  |  |  |  |  |  |  |  |  | BLANK
 |  |  |  |  |  |  |  |  |  |  |  | Tube cross sectional area (A): | 91 |  | mm^2 | BLANK |  |  |  |  | Square side: | 25.0 |  | mm | BLANK |  | T.2.4.2 | F.3.2.1.j | Lap and sub belts attachments must be located on minimum Size B tubes. |  |  |  |  |  | BLANK |  |  |  |  |  |  |  | F.6.6 | Main Hoop Brace Support (MHBS) |  |  | Minimum | Tube Used |  | EQ
 |  |  |  |  |  |  |  |  |  |  |  | Tube second moment of inertia (I): | 6695 |  | mm^4 | BLANK |  |  |  |  | Tube cross sectional area (A): | 91 |  | mm^2 | BLANK |  |  |  |  |  |  |  |  |  | F.6.5.2.b |  |  |  | Brace angle to plane of SH side view >= 30: |  | degrees | BLANK | F.3.2.1.i | Example: 25.4mm x 1.2mm round |  |  | Size C |  |  | BLANK
 |  |  |  |  |  |  |  |  |  |  |  |  |  |  |  |  |  |  |  |  | Tube second moment of inertia (I): | 6695 |  | mm^4 | BLANK |  | BLANK |  |  |  |  |  |  |  |  |  |  |  |  |  |  |  | F.3.4.1.c |  |  | Wall thickness: | 1.2 |  | mm | BLANK
 |  |  |  |  |  |  |  |  |  |  |  |  |  |  |  |  |  |  |  |  |  |  |  |  |  |  | T.2.4.2 | F.3.2.1.j | Minimum Lap/Sub Belt Tube |  | Minimum | Tube Used |  | EQ | F.5.2.3 | The plane of a bent tube is defined by the straight axes on either side of the bend. |  |  |  |  |  |  |  |  |  | Square side: | 25 |  | mm | BLANK
 |  |  |  |  |  |  |  |  |  |  |  |  |  |  |  |  | BLANK |  |  |  |  |  |  |  |  |  | F.3.2.1.j | Example: 25.4mm x 1.6mm round |  |  | Size B |  |  | BLANK |  |  |  |  |  |  |  |  |  |  |  | Wall thickness: | 1.2 |  | mm | BLANK
 |  |  |  |  |  |  |  |  |  |  |  |  |  |  |  |  | F.6.2.3.a |  |  |  |  | Top of FB to Upper FBHS tube, 50mm vertical limit: |  | mm | BLANK |  | F.3.4.1.b |  |  | Wall thickness: | 1.2 |  | mm | BLANK |  | Shoulder Harness Bar bends requires braces. |  |  |  |  |  |  |  |  |  | Square side: | 25.0 |  | mm | BLANK
 |  |  |  |  |  |  |  |  |  |  |  |  |  |  |  |  |  |  |  |  |  |  |  |  |  |  |  |  |  | Square side: | 25 |  | mm | BLANK | BLANK |  |  |  |  |  |  |  |  |  |  | Tube cross sectional area (A): | 91 |  | mm^2 | BLANK
 |  |  |  |  |  |  |  |  |  |  |  |  |  |  |  |  | BLANK |  |  |  |  |  |  |  |  |  |  |  |  | Wall thickness: | 1.2 |  | mm | BLANK | F.6.5.1 | Shoulder Harness Braces |  |  | Minimum | Tube Used |  | EQ |  |  |  | Tube second moment of inertia (I): | 6695 |  | mm^4 | BLANK
 |  |  |  |  |  |  |  |  |  |  |  |  |  |  |  |  | F.6.2.3.ab |  |  |  |  | FBHS configuration: |  |  | BLANK |  |  |  |  | Square side: | 25.0 |  | mm | BLANK | F.3.2.1.l | Example: 25.4mm x 1.2mm round |  |  | Size C |  |  | BLANK
 |  |  |  |  |  |  |  |  |  |  |  |  |  |  |  |  |  |  |  |  |  | Top of Upper FBHS tube relative to top of Upper SIS tube: |  |  | BLANK |  |  |  |  | Tube cross sectional area (A): | 114 |  | mm^2 | BLANK | F.3.4.1.c |  |  | Wall thickness: | 1.2 |  | mm | BLANK
 |  |  |  |  |  |  |  |  |  |  |  |  |  |  |  |  |  |  |  |  |  | Vertical limit 50mm below: |  | mm | BLANK |  |  |  |  | Tube second moment of inertia (I): | 8509 |  | mm^4 | BLANK |  |  |  | Square side: | 25 |  | mm | BLANK
 |  |  |  |  |  |  |  |  |  |  |  |  |  |  |  |  |  | Rearward Front Hoop Brace is not required. |  |  |  |  |  |  |  |  |  |  |  |  |  |  |  |  |  |  |  | Wall thickness: | 1.2 |  | mm | BLANK
 |  |  |  |  |  |  |  |  |  |  |  |  |  |  |  |  |  |  |  |  |  |  |  |  |  |  |  |  |  | Wrapping lap and anti-sub belts around tubes is not acceptable for 6-point harnesses. |  |  |  |  |  |  |  | Square side: | 25.0 |  | mm | BLANK
 |  |  |  |  |  |  |  |  |  |  |  |  |  |  |  |  | BLANK |  |  |  |  |  |  |  |  |  |  |  |  | Double shear attachments are preferred, but only one side is measured. |  |  |  |  |  |  |  | Tube cross sectional area (A): | 91 |  | mm^2 | BLANK
 |  |  |  |  |  |  |  |  |  |  |  |  |  |  |  |  | F.6.3.4 |  |  |  |  | Top of FH to top of FHB tube, 50mm vertical limit: |  | mm | BLANK |  | BLANK |  |  |  |  |  |  |  |  |  |  | Tube second moment of inertia (I): | 6695 |  | mm^4 | BLANK
 |  |  |  |  |  |  |  |  |  |  |  |  |  |  |  |  |  |  |  |  |  |  |  |  |  |  |  |  |  |  | Lap and sub belt attachment: |  |  | BLANK
 |  |  |  |  |  |  |  |  |  |  |  |  |  |  |  |  | BLANK |  |  |  |  |  |  |  |  |  | T.2.5.8 |  |  |  | Lap belt hole diameter / fastener size: |  | mm | BLANK | BLANK
 |  |  |  |  |  |  |  |  |  |  |  |  |  |  |  |  | F.6.3 | Forward Front Hoop Braces (FHB) |  |  |  | Minimum | Tube Used |  | EQ |  | T.2.7.4 |  |  |  | Anti-submarine belt hole diameter / fastener size: |  |  | BLANK | F.5.8.3.a |  |  |  | Main Hoop side view direction from Upper SIS up: |  |  | BLANK
 |  |  |  |  |  |  |  |  |  |  |  |  |  |  |  |  | F.3.2.1.d | Example: 25.4mm x 1.6mm round |  |  |  | Size B |  |  | BLANK |  | T.2.4.3.b |  |  |  | Bolt hole thickness >= 1.6mm (0.063in) steel: |  | mm | BLANK |  |  |  |  | Main Hoop angle from vertical above Upper SIS, in side view, <=10: |  | degrees | BLANK
 |  |  |  |  |  |  |  |  |  |  |  |  |  |  |  |  | F.3.4.1.b |  |  |  | Wall thickness: | 1.2 |  | mm | BLANK |  |  |  |  |  | Minimum tearout distance: |  | mm | BLANK | F.5.8.2 | Main Hoop Braces may run forward or rearward.
 |  |  |  |  |  |  |  |  |  |  |  |  |  |  |  |  |  |  |  |  | Square side: | 25 |  | mm | BLANK |  |  |  |  |  | Area = 2*thickness*min distance >= 60 mm^2 | 0 | 0.00% | REJECT
 |  |  |  |  |  |  |  |  |  |  |  |  |  |  |  |  |  |  |  |  | Wall thickness: | 1.2 |  | mm | BLANK |  |  |  |  |  | Bracket attachment: |  |  | BLANK | BLANK
 |  |  |  |  |  |  |  |  |  |  |  |  |  |  |  |  |  |  |  |  | Square side: | 25.0 |  | mm | BLANK |  |  |  |  | Tab to tube welding must be on both sides of the tab. |  |  |  |  | F.5.8.3.c |  |  |  | MH side view direction from Upper SIS down: |  |  | BLANK | Required Image: Car showing wing mounts.
 |  |  |  |  |  |  |  |  |  |  |  |  |  |  |  |  |  |  |  |  | Tube cross sectional area (A): | 114 |  | mm^2 | BLANK |  |  |  |  |  |  |  |  |  |  |  |  |  | Main Hoop side angle from vertical below Upper SIS: |  | degrees | BLANK
 |  |  |  |  |  |  |  |  |  |  |  |  |  |  |  |  |  |  |  |  | Tube second moment of inertia (I): | 8509 |  | mm^4 | BLANK
 |  |  |  |  |  |  |  |  |  |  |  |  |  |  |  |  |  |  |  |  |  |  |  |  |  |  |  |  |  |  |  |  |  |  | BLANK
 |  |  |  |  |  |  |  |  |  |  |  |  |  |  |  |  |  | Rearward Front Hoop Brace is not required. |  |  |  |  |  |  |  |  |  |  |  |  |  |  |  |  | F.5.8.4 |  |  |  | Distance between Main Hoop ends, >=380mm (15") |  | mm | BLANK
 |  |  |  |  |  |  |  |  |  |  |  |  |  |  |  |  | EQ
 |  |  |  |  |  |  |  |  |  |  |  |  |  |  |  |  | F.6.2.3.b | Rear Front Bulkhead Support (FBHS) |  |  |  | Minimum | Tube Used |  | N/A |  |  |  |  |  |  |  |  |  | F.5.2.1 | Enter the tightest bend on any T.5-6 tube in the chassis (usually in the MH or SH.)
 |  |  |  |  |  |  |  |  |  |  |  |  |  |  |  |  | F.3.2.1.b | Example: 25.4mm x 1.2mm round |  |  |  | Size C |  |  | N/A |  |  |  |  |  |  |  |  |  | BLANK
 |  |  |  |  |  |  |  |  |  |  |  |  |  |  |  |  | F.3.4.1.c |  |  |  | Wall thickness: | 1.2 |  | mm | N/A |  |  |  |  |  |  |  |  |  | F.5.2.1 |  |  |  | Minimum tube centerline radius: |  | mm | BLANK
 |  |  |  |  |  |  |  |  |  |  |  |  |  |  |  |  |  |  |  |  | Square side: | 25 |  | mm | N/A |  |  |  |  |  |  |  |  |  |  |  |  |  | Outer Diameter (OD): |  | mm | BLANK
 |  |  |  |  |  |  |  |  |  |  |  |  |  |  |  |  |  |  |  |  | Wall thickness: | 1.2 |  | mm | N/A |  |  |  |  |  |  |  |  |  |  |  |  |  | Minimum radius::diameter ratio, >=3:
 |  |  |  |  |  |  |  |  |  |  |  |  |  |  |  |  |  |  |  |  | Square side: | 25.0 |  | mm | N/A
 |  |  |  |  |  |  |  |  |  |  |  |  |  |  |  |  |  |  |  |  | Tube cross sectional area (A): | 91 |  | mm^2 | N/A |  |  |  |  |  |  |  |  |  |  |  |  | Wrapping shoulder harness belts around the SH bar is preferred.
 |  |  |  |  |  |  |  |  |  |  |  |  |  |  |  |  |  |  |  |  | Tube second moment of inertia (I): | 6695 |  | mm^4 | N/A |  | Harness tab location, dimensions, shear area |  |  |  |  |  |  |  | BLANK
 |  |  |  |  |  |  |  |  |  |  |  |  |  |  |  |  |  |  |  |  |  |  |  |  |  |  |  |  |  |  |  |  |  |  |  |  |  |  | Shoulder belt attachment: |  |  | BLANK
 |  |  |  |  |  |  |  |  |  |  |  |  |  |  |  |  | F.6.2.3.b | Rear FBHS braces minimum Size C. |  |  |  |  |  |  |  |  |  |  |  |  |  |  |  |  | T.2.6.3 |  |  |  | Shoulder belt hole diameter / fastener size: |  | mm | BLANK | F.5.11 | Approaches to wing detachment.
 |  |  |  |  |  |  |  |  |  |  |  |  |  |  |  |  | F.6.3.5 | Rear FH braces minimum Size B. |  |  |  |  |  |  |  |  |  |  |  |  |  |  |  |  |  |  |  |  |  |  |  | BLANK
 |  |  |  |  |  |  |  |  |  |  |  |  |  |  |  |  |  |  |  |  |  |  |  |  |  |  |  |  |  |  |  |  |  |  | T.2.4.3 |  |  |  | Bolt hole thickness >= 1.6mm (0.063in) steel: |  | mm | BLANK | A | STRONGLY PREFERRED
 |  |  |  |  |  |  |  |  |  |  |  |  |  |  |  |  |  |  |  |  |  |  |  |  |  |  |  |  |  |  |  |  |  |  |  |  |  |  | Minimum tearout distance: |  | mm | BLANK |  | Single fastener at each node, rotationally free.
 |  |  |  |  |  |  |  |  |  |  |  |  |  |  |  |  |  |  |  |  |  |  |  |  |  |  |  |  |  |  |  |  |  |  |  |  |  |  | Area = 2*thickness*min distance >= 60 mm^2 | 0 | 0.00% | REJECT |  | No failure force required.
 |  |  |  |  |  |  |  |  |  |  |  |  |  |  |  |  |  |  |  |  |  |  |  |  |  |  |  |  |  |  |  |  |  |  |  |  |  |  | Bracket attachment: |  |  | BLANK |  | Mounts rearward of the MHB assembly are completely unrestricted
 |  |  |  |  |  |  |  |  |  |  |  |  |  |  |  |  |  |  |  |  |  |  |  |  |  |  |  |  |  |  |  |  |  |  |  |  |  | Tab to tube welding must be on both sides of the tab.
 |  |  |  |  |  |  |  |  |  |  |  |  |  |  |  |  |  |  |  |  |  |  |  |  |  |  |  |  |  |  |  |  |  |  |  |  |  |  |  |  |  |  | B | NOT RECOMMENEDED - ILLEGAL IN AUSTRALIA
 |  |  |  |  |  |  |  |  |  |  |  |  |  |  |  |  |  |  |  |  |  |  |  |  |  |  |  |  |  |  |  |  |  |  |  |  |  |  |  |  |  |  |  | Mounts in the middle of the MHB or MH require a brace between the two.
 |  |  |  |  |  |  |  |  |  |  |  |  |  |  |  |  |  |  |  |  |  |  |  |  |  |  |  |  |  |  |  |  |  |  |  |  |  |  |  |  |  |  |  | All fasteners or mounts on a side must fail simultaneously below the MHB buckling force.
 |  |  |  |  |  |  |  |  |  |  |  |  |  |  |  |  |  |  |  |  |  |  |  |  |  |  |  |  |  |  |  |  |  |  |  |  |  |  |  |  |  |  | C | NOT RECOMMENEDED - GUSSET MAY BE REQUIRED
 |  |  |  |  |  |  |  |  |  |  |  |  |  |  |  |  |  |  |  |  |  |  |  |  |  |  |  |  |  |  |  |  |  |  |  |  |  |  |  |  |  |  |  | Multiple fasteners within 1x outer diameter of the node.
 |  |  |  |  |  |  |  |  |  |  |  |  |  |  |  |  |  |  |  |  |  |  |  |  |  |  |  |  |  |  |  |  |  |  |  |  |  |  |  |  |  |  |  | All but one fastener must fail simultaneously below the MHB buckling force.
 |  |  |  |  |  |  |  |  |  |  |  |  |  |  |  |  |  |  |  |  |  |  |  |  |  |  |  |  |  |  |  |  |  |  |  |  |  |  |  |  |  |  | D | NOT RECOMMENEDED - ILLEGAL IN AUSTRALIA
 |  |  |  |  |  |  |  |  |  |  |  |  |  |  |  |  |  |  |  |  |  |  |  |  |  |  |  |  |  |  |  |  |  |  |  |  |  |  |  |  |  |  |  | Multiple fasteners along the MHB.
 |  |  |  |  |  |  |  |  |  |  |  |  |  |  |  |  |  |  |  |  |  |  |  |  |  |  |  |  |  |  |  |  |  |  |  |  |  |  |  |  |  |  |  | Brace required between MH and MHB at rearmost fastener.
 |  |  |  |  |  |  |  |  |  |  |  |  |  |  |  |  |  |  |  |  |  |  |  |  |  |  |  |  |  |  |  |  |  |  |  |  |  |  |  |  |  |  |  | All fasteners not located at the MH-MHB node must fail simultaneously below the MHB buckling force.

Sheet: F.10-11 EV Accumulator
Match composite testing tabs and material list names. Properties auto-populate. No need to use "F.4.3 Composite" in the name. |  |  |  | Note: Forces are given in Pa, not Mpa or Gpa. |  |  |  |  |  |  |  |  |  |  | F.10.4.4 | FOR ACCUMULATORS LOCATED BEHIND THE DRIVER, NO AIRFLOW OPENINGS ARE PERMITTED IN THE FRONT OR TOP. |  |  |  |  |  |  |  |  |  |  |  | Section 3: Mount attachment to the accumulator container. If the mount sticks out from the accumulator, the mount
 |  |  |  | Material |  | E (Pa) |  | S_Ultimate (Pa) |  | Shear (Pa) |  |  |  |  |  | 75% OF EACH SEGMENT FACE MUST BE COVERED. HOLE PATTERNS ARE ENCOURAGED. LARGE HOLES ARE DISCOURAGED. |  |  |  |  |  |  |  |  |  |  |  | itself has to attach to the accumulator skin. It may be bolted, bonded, welded, or continuous material. (AA100)
 |  |  |  | Steel Unwelded |  | 200000000000 |  | 365000000 |  | 210605000 |  |  |  |  |  | SLOTS FOR AIRFLOW ARE PROHIBITED |  |  |  |  |  |  |  |  |  |  |  | Chassis mount sections are broken into four subsections.
 |  |  |  | Steel Welded |  | 200000000000 |  | 300000000 |  | 173100000 |  |  |  |  | F.10.5.6.a | For accumulator mounting, the SES considers the accumulator modules as one solid block. Most likely, your |  |  |  |  |  |  |  |  |  |  |  | Section 4: Main accumulator fastener to chassis. Same ideas as Section 1, just on the chassis side instead of the
 |  |  |  | 6061-T6 Unwelded |  | 69000000000 |  | 290000000 |  | 167330000 |  |  |  |  |  | modules are basically rectangular. Most likely, all the modules in the accumulator form a larger rectangle. |  |  |  |  |  |  |  |  |  |  |  | accumulator side. How far does the mount stick out from the chassis at the point where the fastener is in shear?
 |  |  |  | 6061-T6 Welded |  | 69000000000 |  | 175000000 |  | 100975000 |  |  |  |  |  | If it's not a rectangle, structure may be added to make it rectangular, or maybe it's an L-shape made of two rectangles. |  |  |  |  |  |  |  |  |  |  |  | Note: Fastener shear should be identical to the accumulator section, since it's the same fastener/fasteners.
 |  |  |  | Other Unwelded |  |  |  |  |  | 0 |  | Core | Outer | Inner | F.10.5.5 | Start by imagining the accumulator as a block with planar surfaces. We encourage you to engineer the accumulator |  |  |  |  |  |  |  |  |  |  |  | Mounts using welded inserts on the centerline of Size B tubes automatically meet a 15kN load requirement.
 |  |  |  | Other Welded |  |  |  |  |  | 0 |  | mm | mm | mm |  | and chassis for F.10.5.6 corner attachment. Due to better moment reaction with mounts at all corners, the required |  |  |  |  |  |  |  |  |  |  |  | F.10.5.2.a | MOUNTS PROHIBITED ON SH, MHB, AND PORTIONS OF MH ABOVE TRIANGULATED SIDE STRUCTURE.
Doubled skin must repeat whole layup. Scroll up if Layup Used blank. |  |  |  |  |  |  |  |  |  |  |  |  |  |  |  | test load for corner attachment mounts is reduced compared to F.10.5.7 load based attachment. |  |  |  |  |  |  |  |  |  |  |  | Tall packs will also have more difficulty passing the tilt test, IN.9.2.2. |  |  |  |  |  |  |  |  |  |  | Show accumulator / frame with all mounts. |  |  |  |  |  |  |  |  |  |  |  |  | Show accumulator / frame mounts.
 |  |  |  |  |  |  |  |  |  |  |  |  |  |  |  | Accumulator mount sections are broken into three subsections. |  |  |  |  |  |  |  |  |  |  |  | F.11.2.3 | IDEALLY, CHASSIS TUBES AND NON-CRUSHABLE OBJECTS HAVE 25mm CLEARANCE TO ANY CELLS.
 |  |  |  |  |  |  |  |  |  |  |  |  |  |  | F.10.5.6.c | Section 1: Main accumulator fastener location and fastener interaction with mount. Use 0 for internal hardpoints. |  |  |  |  |  |  |  |  |  |  |  | IDEALLY, ACCUMULATOR AND CHASSIS MOUNTS HAVE THE LOWEST OFFSET AND BENDING POSSIBLE. |  |  |  |  |  |  |  |  |  |  | Identify mounts by corresponding number / corner name. |  |  |  |  |  |  |  |  |  |  |  |  | Show fastener bending distances from segments.
 |  |  |  |  |  |  |  |  |  |  |  |  |  |  | F.10.5.7.c | Where the fastener is in shear, at the centerpoint, what is the minimum distance to the block representation of the |  |  |  |  |  |  |  |  |  |  |  | Section 5: For a tube frame section, a bending check on the tubes themselves. For 2023, the SES committee will not
 |  |  |  |  |  |  |  |  |  |  |  |  |  |  |  | accumulator in the X, Y, and Z views? "Outside" shows where the mount is sticking out. (In front, to the left, above, etc.) |  |  |  |  |  |  |  |  |  |  |  | be overly concerned with accumulator tube CHECK values if the rest of the design is reasonable. It was included to |  |  |  |  |  |  |  |  |  |  | All walls must maintain 75% area, holes < 10mm each. |  |  |  |  |  |  |  |  |  |  |  |  | Show fastener bending distances from chassis.
 |  |  |  |  |  |  |  |  |  |  |  |  |  |  |  | Any "outside" measurements count towards AA65, "Total Surface Offset", which is the minimum lever distance from the |  |  |  |  |  |  |  |  |  |  |  | help student teams consider whether there could be a better location for their chassis-side mounts. Rather than
 |  |  |  |  |  |  |  |  |  |  |  |  |  |  |  | fastener shear plane to the block representation of the accumulator. Any "between" measurement is where the mount |  |  |  |  |  |  |  |  |  |  |  | randomly placing one or more high load requirements in the middle of a span. And hopefully take any reasonable steps
Select Drop Down |  |  |  |  |  |  |  |  |  |  |  |  |  |  |  | is between two planes. Also in this section: Checks for fastener shear, pullout, and tearout from the accumulator side. |  |  |  |  |  |  |  |  |  |  |  | for improvement. Designing a strong mount without paying attention to the underlying structure is not good engineering.
BLANK |  |  |  |  |  |  |  |  |  |  |  |  |  |  |  | Section 2: Geometry to react bending moments. If the mount is sticking out, it has to have sufficient bending strength. |  |  |  |  |  |  |  |  |  |  |  | F.10.5.7.e | MAXIMUM OF TWO MOUNTS ON A CHASSIS TUBE BETWEEN TWO TRIANGULATED NODES.
 |  |  |  |  |  |  |  |  |  |  |  |  |  |  |  | The image in AY28 shows how to find the measurements for this section, using the shape of the mount contacting the skin. |  |  |  |  |  |  |  |  |  |  |  | Section 6: Geometry to react bending moments, same ideas as Section 2.
 |  |  |  |  |  |  |  |  |  |  |  |  |  |  |  | Sufficient bending strength is needed for the fastener trying to move around its axis, gusset thickness parallel to the shear plane. |  |  |  |  |  |  |  |  |  |  |  | Section 7: Mount attachment to chassis, same ideas as section 3.
 |  |  |  |  |  |  |  |  | Composite teams: Enter tab names for materials used. |  |  |  |  |  |  | Sufficient bending strength is needed for the fastener trying to move ALONG its axis, gusset thickness parallel to the axis. |  |  |  |  |  |  |  |  |  |  |  | If the mount sticks out from the chassis, the mount itself has to attach to the chassis skin.
 |  |  |  |  | BLANK |  |  |  |  |  |  |  |  |  |  |  | BLANK
 |  |  |  |  | Low Est | 0 |  |  |  | Total mass of all segments: |  | kg | BLANK |  |  | F.10.5.6-7 |  |  | Mounting Method: |  |  |  |  |  |  | BLANK |  | All mounts on an accumulator, even if identical, need to be entered into the SES.
 |  |  |  |  | High Est | 0 |  |  |  | Total accumulator mass: |  | kg | BLANK |  |  |  |  |  | Test Load: | 15000 | N |  |  |  |  | EQ |  | Identical mounts for multiple packs only need to be entered once.
 |  |  |  |  | F.10.5.6 |  |  |  |  | Corner attachment test load: | 0 | N | each |  |  |  |  |  | Accumulator mount symmetry: |  |  | This will change the names of sections. |  |  |  | BLANK |  | Nearly identical mounts (or if repeated across multiple packs) should be entered as highest offset, smallest brace.
mm |  |  |  |  | F.10.5.7 |  |  |  | Mass based min attachment number: | 4x at | 15000 | N | each |  |  |  |  |  | Chassis mount symmetry: |  |  | This will change the names of sections. |  |  |  | BLANK |  | For asymmetric packs, more than 10 mounts, or removable subframes: Right click and make a copy of this tab.
Segment cross sections required. |  |  |  |  |  |  |  |  |  | Segment arrangement CAD required. |  |  |  |  |  |  |  |  |  | Top Front Accumulator Mount |  |  |  |  |  |  |  |  |  | Top Rear Accumulator Mount |  |  |  |  |  |  |  |  | Bottom Front Accumulator Mount |  |  |  |  |  |  |  |  | Bottom Rear Accumulator Mount
 |  |  |  |  |  |  |  |  |  |  | Include all dimensions entered below.
 | Segment lateral cross section. (Multiple if modules are not identical.) |  |  |  |  |  |  |  |  |  | Lateral cross sections at attachment points.
 | Segment longitudinal cross section. (Multiple if modules are not identical.) |  |  |  |  |  |  |  |  |  | Longitudinal cross sections at attachment points.
 | Include all dimensions entered below. |  |  |  |  |  |  |  |  |  | If symmetric, only one lateral and longitudinal section cut showing half of the attachments is needed.
 |  |  |  |  |  |  |  |  |  |  | If the section through the mounts does not intersect the segments, provide the accumulator cross sections at the segment ends.
 |  |  |  |  |  |  |  |  |  |  |  |  |  |  |  |  |  |  |  | Include all dimensions entered below. |  |  |  |  |  |  |  |  |  | Include all dimensions entered below. |  |  |  |  |  |  |  |  | Include all dimensions entered below. |  |  |  |  |  |  |  |  | Include all dimensions entered below.
Additional images may be placed below each section. |  |  |  |  |  |  |  |  |  | Additional images may be placed below each section. |  |  |  |  |  |  |  |  |  | Additional images may be placed below each section. |  |  |  |  |  |  |  |  |  | Additional images may be placed below each section. |  |  |  |  |  |  |  |  | Additional images may be placed below each section. |  |  |  |  |  |  |  |  | Additional images may be placed below each section.
BLANK |  | Accumulator Segments |  |  |  |  |  |  |  | BLANK |  | Accumulator Container |  |  |  |  |  |  |  | BLANK |  | Top Front Accumulator Mount |  |  |  |  |  |  |  | BLANK |  | Top Rear Accumulator Mount |  |  |  |  |  |  | BLANK |  | Bottom Front Accumulator Mount |  |  |  |  |  |  | BLANK |  | Bottom Rear Accumulator Mount
The segment structures carry the load to the accumulator container and mounts. |  |  |  |  |  |  |  |  |  | Structure may be added between or around segments to define a rectangular structure. |  |  |  |  |  |  |  |  |  | ACCUMULATOR MOUNT: Where fastener passes through to Chassis Mount |  |  |  |  |  |  |  |  |  | ACCUMULATOR MOUNT: Where fastener passes through to Chassis Mount |  |  |  |  |  |  |  |  | ACCUMULATOR MOUNT: Where fastener passes through to Chassis Mount |  |  |  |  |  |  |  |  | ACCUMULATOR MOUNT: Where fastener passes through to Chassis Mount
This information will help develop FSAE standards for accumulator and segment internal structure. |  |  |  |  |  |  |  |  |  | A 1-tube thick exoskeleton with a direct load path around the perimeter of the assembled segments may be used to define the structural limits and corners. |  |  |  |  |  |  |  |  |  | BLANK |  |  |  |  |  |  |  |  |  | BLANK |  |  |  |  |  |  |  |  | BLANK |  |  |  |  |  |  |  |  | BLANK
Segment installation is generally assumed to increase the strength of containers. |  |  |  |  |  |  |  |  |  |  |  |  |  |  |  |  |  |  |  |  |  |  |  | Intersection of fastener axis and fastener shear plane. |  |  |  | EQ |  |  |  |  |  | Intersection of fastener axis and fastener shear plane. |  |  |  | EQ |  |  |  |  | Intersection of fastener axis and fastener shear plane. |  |  |  | EQ |  |  |  |  | Intersection of fastener axis and fastener shear plane. |  |  |  | EQ
EV.2.1 | Additional documentation is required in the ESF. |  |  |  |  |  |  |  |  | A subframe may be used to bring nodes to the accumulator if the tubes meet F.3.4 |  |  |  |  |  |  |  |  |  | Outside | the front/rear planes of the accumulator segments: |  |  |  |  |  | mm | BLANK |  | Outside | the front/rear planes of the accumulator segments: |  |  |  |  |  | mm | BLANK | Outside | the front/rear planes of the accumulator segments: |  |  |  |  |  | mm | BLANK | Outside | the front/rear planes of the accumulator segments: |  |  |  |  |  | mm | BLANK
 |  |  |  |  |  |  |  |  |  |  |  |  |  |  |  |  |  |  |  | Outside | the top/bottom planes of the accumulator segments: |  |  |  |  |  | mm | BLANK |  | Outside | the top/bottom planes of the accumulator segments: |  |  |  |  |  | mm | BLANK | Outside | the top/bottom planes of the accumulator segments: |  |  |  |  |  | mm | BLANK | Outside | the top/bottom planes of the accumulator segments: |  |  |  |  |  | mm | BLANK
BLANK |  |  |  |  |  |  |  |  |  | BLANK |  |  |  |  |  |  |  |  |  | Outside | the left/right planes of the accumulator segments: |  |  |  |  |  | mm | BLANK |  | Outside | the left/right planes of the accumulator segments: |  |  |  |  |  | mm | BLANK | Outside | the left/right planes of the accumulator segments: |  |  |  |  |  | mm | BLANK | Outside | the left/right planes of the accumulator segments: |  |  |  |  |  | mm | BLANK
 |  |  |  |  | Cell type: |  |  | BLANK |  |  |  |  |  |  | Minimum segment mass: |  | kg | BLANK |  |  |  |  |  |  | Total Surface Offset, zero for an internal hardpoint: | 0 | mm | EQ |  |  |  |  |  |  | Total Surface Offset, zero for an internal hardpoint: | 0 | mm | EQ |  |  |  |  |  | Total Surface Offset, zero for an internal hardpoint: | 0 | mm | EQ |  |  |  |  |  | Total Surface Offset, zero for an internal hardpoint: | 0 | mm | EQ
 |  |  |  |  | Maximum Voltage: |  | V | BLANK |  | F.10.3.2.b |  |  |  |  | Maximum segment mass <=12kg (26.4lbs): |  | kg | BLANK |  |  |  |  |  |  | Mount material (Accumulator skin if directly mounted): | Steel Unwelded |  | EQ |  |  |  |  |  |  | Mount material (Accumulator skin if directly mounted): | Steel Unwelded |  | EQ |  |  |  |  |  | Mount material (Accumulator skin if directly mounted): | Steel Unwelded |  | EQ |  |  |  |  |  | Mount material (Accumulator skin if directly mounted): | Steel Unwelded |  | EQ
 |  |  |  |  | Nominal Voltage: |  | V | BLANK |  |  |  |  |  |  | Number of segments <= 8kg (17.6lbs): |  |  | BLANK |  |  |  | Young's Modulus (E): |  |  |  | 200000000000 | Pa | EQ |  |  |  | Young's Modulus (E): |  |  |  | 200000000000 | Pa | EQ |  |  | Young's Modulus (E): |  |  |  | 200000000000 | Pa | EQ |  |  | Young's Modulus (E): |  |  |  | 200000000000 | Pa | EQ
 |  |  |  |  | Nominal Capacity: |  | mAh | BLANK |  |  |  |  |  |  | Number of 8kg < segments <= 12kg (26.4lbs): |  |  | BLANK |  |  | Ultimate Tensile and Bending Strength (S): |  |  |  |  | 365000000 | Pa | EQ |  |  | Ultimate Tensile and Bending Strength (S): |  |  |  |  | 365000000 | Pa | EQ |  | Ultimate Tensile and Bending Strength (S): |  |  |  |  | 365000000 | Pa | EQ |  | Ultimate Tensile and Bending Strength (S): |  |  |  |  | 365000000 | Pa | EQ
 |  |  |  |  | Maximum segment cells in series: |  |  | BLANK |  | F.10.3.2.d |  |  |  |  |  |  | Min fastener count in fastened connections between vertical walls: | 3 |  |  |  | Shear: |  |  |  | 210605000 | Pa | EQ |  |  |  | Shear: |  |  |  | 210605000 | Pa | EQ |  |  | Shear: |  |  |  | 210605000 | Pa | EQ |  |  | Shear: |  |  |  | 210605000 | Pa | EQ
 |  |  |  |  | Maximum segment cells in parallel: |  |  | BLANK |  |  |  |  |  |  |  |  |  |  |  |  |  |  |  |  | Mounting face thickness (Do not include core.): |  | mm | BLANK |  |  |  |  |  |  | Mounting face thickness (Do not include core.): |  | mm | BLANK |  |  |  |  |  | Mounting face thickness (Do not include core.): |  | mm | BLANK |  |  |  |  |  | Mounting face thickness (Do not include core.): |  | mm | BLANK
EV.6.1.2 |  |  |  |  | Maximum segment voltage: | 0 | V | EQ |  | BLANK |  |  |  |  |  |  |  |  |  |  |  |  |  |  | Minimum - Fastener spacing, edge, or corner distance: |  | mm | BLANK |  |  |  |  |  |  | Minimum - Fastener spacing, edge, or corner distance: |  | mm | BLANK |  |  |  |  |  | Minimum - Fastener spacing, edge, or corner distance: |  | mm | BLANK |  |  |  |  |  | Minimum - Fastener spacing, edge, or corner distance: |  | mm | BLANK
EV.6.1.2 |  |  |  |  | Maximum segment capacity: | 0 | MJ | EQ |  | F.10.2.2e |  |  |  |  | Number of segment external vertical walls: |  |  | BLANK |  |  |  |  |  |  | Number of fasteners used (2x if in double shear): |  |  | BLANK |  |  |  |  |  |  | Number of fasteners used (2x if in double shear): |  |  | BLANK |  |  |  |  |  | Number of fasteners used (2x if in double shear): |  |  | BLANK |  |  |  |  |  | Number of fasteners used (2x if in double shear): |  |  | BLANK
 |  |  |  |  | Total accumulator cells in series: |  |  | BLANK |  |  |  |  |  |  | Number of cover fasteners: |  |  | BLANK |  |  |  |  |  |  | Fastener diameter: |  | mm | BLANK |  |  |  |  |  |  | Fastener diameter: |  | mm | BLANK |  |  |  |  |  | Fastener diameter: |  | mm | BLANK |  |  |  |  |  | Fastener diameter: |  | mm | BLANK
 |  |  |  |  | Total accumulator cells in parallel: |  |  | BLANK |  | F.10.3.1.d | Min 1 per segment when using fasteners between external walls and floor. |  |  |  |  |  |  |  |  |  |  |  |  |  | Threads in shear: |  |  | BLANK |  |  |  |  |  |  | Threads in shear: |  |  | BLANK |  |  |  |  |  | Threads in shear: |  |  | BLANK |  |  |  |  |  | Threads in shear: |  |  | BLANK
EV.4.1.2 |  |  |  |  | Maximum accumulator voltage: | 0 | V | EQ |  |  |  |  |  |  |  |  |  |  |  |  |  |  |  |  | Fastener UTS: |  | Pa | BLANK |  |  |  |  |  |  | Fastener UTS: |  | Pa | BLANK |  |  |  |  |  | Fastener UTS: |  | Pa | BLANK |  |  |  |  |  | Fastener UTS: |  | Pa | BLANK
 |  |  |  |  | Maximum accumulator capacity: | 0 | kWh | EQ |  | BLANK |  |  |  |  |  |  |  |  |  |  |  |  |  |  | Min total perimeter of all washers, inserts, brackets on one surface: |  | mm | BLANK |  |  |  |  |  |  | Min total perimeter of all washers, inserts, brackets on one surface: |  | mm | BLANK |  |  |  |  |  | Min total perimeter of all washers, inserts, brackets on one surface: |  | mm | BLANK |  |  |  |  |  | Min total perimeter of all washers, inserts, brackets on one surface: |  | mm | BLANK
 |  |  |  |  |  |  |  |  |  | F.10.2.3 |  |  |  |  | Vertical wall joining method: |  |  | BLANK |  | F.10.5.7.c |  |  |  |  | --Shear--0.577*fasteners*UTS*pi*r^2 >= Test Load: | 0 |  | EQ |  | F.10.5.7.c |  |  |  |  | --Shear--0.577*fasteners*UTS*pi*r^2 >= Test Load: | 0 |  | EQ | F.10.5.7.c |  |  |  |  | --Shear--0.577*fasteners*UTS*pi*r^2 >= Test Load: | 0 |  | EQ | F.10.5.7.c |  |  |  |  | --Shear--0.577*fasteners*UTS*pi*r^2 >= Test Load: | 0 |  | EQ
BLANK |  |  |  |  |  |  |  |  |  |  |  |  |  |  | Average unit strength of 50% weld, 0.9mm wall: | 135 | N/mm | N/A |  |  |  |  |  |  | --Pullout--Mount shear*thickness*perimeter >= Test Load: | 0 |  | EQ |  |  |  |  |  |  | --Pullout--Mount shear*thickness*perimeter >= Test Load: | 0 |  | EQ |  |  |  |  |  | --Pullout--Mount shear*thickness*perimeter >= Test Load: | 0 |  | EQ |  |  |  |  |  | --Pullout--Mount shear*thickness*perimeter >= Test Load: | 0 |  | EQ
F.10.3.4 | Cell mounting and bracing material: |  |  |  | E: |  | Pa | BLANK |  | #VALUE! |  |  |  |  |  |  | N | N/A |  |  |  |  |  |  | --Tearout--Mount shear*thickness*edge distance >= Test Load: | 0 |  | EQ |  |  |  |  |  |  | --Tearout--Mount shear*thickness*edge distance >= Test Load: | 0 |  | EQ |  |  |  |  |  | --Tearout--Mount shear*thickness*edge distance >= Test Load: | 0 |  | EQ |  |  |  |  |  | --Tearout--Mount shear*thickness*edge distance >= Test Load: | 0 |  | EQ
 |  |  |  |  | UTS: |  | Pa | BLANK |  |  |  |  |  |  |  |  | mm | N/A
 |  |  |  |  | Shear: |  | Pa | BLANK |  |  |  |  |  |  |  |  | N/mm^2 | N/A
 |  |  |  |  | Assembled Segment moment of inertia, Lateral cross section: |  | mm^4 | BLANK |  |  |  |  |  |  |  |  | mm | N/A |  |  |  |  |  | MOUNT GEOMETRY - ACCUMULATOR SIDE |  |  |  |  |  |  |  |  |  | MOUNT GEOMETRY - ACCUMULATOR SIDE |  |  |  |  |  |  |  |  | MOUNT GEOMETRY - ACCUMULATOR SIDE |  |  |  |  |  |  |  |  | MOUNT GEOMETRY - ACCUMULATOR SIDE
 |  |  |  |  | Assembled Segment moment, Longitudinal cross section: |  | mm^4 | BLANK |  | F.10.2.3.b |  |  |  |  |  |  |  | EQ |  | EQ |  |  |  |  |  |  |  |  |  | EQ |  |  |  |  |  |  |  |  | EQ |  |  |  |  |  |  |  |  | EQ
 |  |  |  |  | Maximum segment length: |  | mm | BLANK |  |  |  |  |  |  |  |  |  |  |  |  |  |  |  |  | Mount cross section on accumulator skin: |  |  | N/A |  |  |  |  |  |  | Mount cross section on accumulator skin: |  |  | N/A |  |  |  |  |  | Mount cross section on accumulator skin: |  |  | N/A |  |  |  |  |  | Mount cross section on accumulator skin: |  |  | N/A
 |  |  |  |  | Maximum segment width: |  | mm | BLANK |  | F.10.2.1 |  |  |  | MINIMUM ACCUMULATOR FLOOR |  |  |  |  |  |  |  |  |  |  | Mount thickness (B): |  | mm | N/A |  |  |  |  |  |  | Mount thickness (B): |  | mm | N/A |  |  |  |  |  | Mount thickness (B): |  | mm | N/A |  |  |  |  |  | Mount thickness (B): |  | mm | N/A
 |  |  |  |  | Maximum segment height: |  | mm | BLANK |  | BLANK |  |  |  |  |  |  |  |  |  |  |  |  |  |  | Mount length (L): |  | mm | N/A |  |  |  |  |  |  | Mount length (L): |  | mm | N/A |  |  |  |  |  | Mount length (L): |  | mm | N/A |  |  |  |  |  | Mount length (L): |  | mm | N/A
 |  |  |  |  |  |  |  |  |  |  |  |  |  |  | All segment floor sections >= 75% area: |  |  | BLANK |  |  |  |  |  |  | Minimum gusset thickness (T): |  | mm | N/A |  |  |  |  |  |  | Minimum gusset thickness (T): |  | mm | N/A |  |  |  |  |  | Minimum gusset thickness (T): |  | mm | N/A |  |  |  |  |  | Minimum gusset thickness (T): |  | mm | N/A
BLANK |  |  |  |  |  |  |  |  |  | F.10.2.1 | Accumulator Floor Construction: |  |  |  |  |  |  | EQ |  |  |  |  |  |  | Minimum gusset height normal to mount face (H): |  | mm | N/A |  |  |  |  |  |  | Minimum gusset height normal to mount face (H): |  | mm | N/A |  |  |  |  |  | Minimum gusset height normal to mount face (H): |  | mm | N/A |  |  |  |  |  | Minimum gusset height normal to mount face (H): |  | mm | N/A
F.10.3.4 | Restraint Method: |  | Examples: Bolted, Friction, Adhesive |  |  |  |  | BLANK |  |  |  |  |  |  | Steel: 1.25mm (0.049in), Aluminum: 3.2mm (.125in): |  | mm | BLANK |  | F.3.4.2 | 0.0 |  |  |  | 15000N Bending in shear M*y / I < Su: |  |  | N/A |  | F.3.4.2 | 0.0 |  |  |  | 15000N Bending in shear M*y / I < Su: |  |  | N/A | F.3.4.2 | 0.0 |  |  |  | 15000N Bending in shear M*y / I < Su: |  |  | N/A | F.3.4.2 | 0.0 |  |  |  | 15000N Bending in shear M*y / I < Su: |  |  | N/A
 |  |  |  |  |  |  |  |  |  | Material Used: |  |  |  |  |  | Steel Unwelded |  | EQ |  | 365000000 | 0.0 |  |  |  | 15000N Bending normal M*y / I < Su: |  |  | N/A |  | 365000000 | 0.0 |  |  |  | 15000N Bending normal M*y / I < Su: |  |  | N/A | 365000000 | 0.0 |  |  |  | 15000N Bending normal M*y / I < Su: |  |  | N/A | 365000000 | 0.0 |  |  |  | 15000N Bending normal M*y / I < Su: |  |  | N/A
 |  |  |  |  |  |  |  |  |  | Panel thickness: |  |  |  |  |  | #VALUE! | mm | N/A |  | 210605000 |  |  |  |  | Parabolic shear 3*Test Load/2*area <= Shear: |  |  | N/A |  | 210605000 |  |  |  |  | Parabolic shear 3*Test Load/2*area <= Shear: |  |  | N/A | 210605000 |  |  |  |  | Parabolic shear 3*Test Load/2*area <= Shear: |  |  | N/A | 210605000 |  |  |  |  | Parabolic shear 3*Test Load/2*area <= Shear: |  |  | N/A
 |  |  |  |  |  |  |  |  |  | Core thickness: |  |  |  |  |  |  | mm | N/A
 |  |  |  |  |  |  |  |  |  |  |  | Scaling option, layup repeats: |  |  | Outer skin thickness: | Layup | mm | N/A |  |  |  |  |  | ACCUMULATOR MOUNT :: Accumulator Skin interface |  |  |  |  |  |  |  |  |  | ACCUMULATOR MOUNT :: Accumulator Skin interface |  |  |  |  |  |  |  |  | ACCUMULATOR MOUNT :: Accumulator Skin interface |  |  |  |  |  |  |  |  | ACCUMULATOR MOUNT :: Accumulator Skin interface
 |  |  |  |  |  |  |  |  |  |  |  | Scaling option, layup repeats: |  |  | Inner skin thickness: | Typo | mm | N/A |  | EQ |  |  |  |  |  |  |  |  |  | EQ |  |  |  |  |  |  |  |  | EQ |  |  |  |  |  |  |  |  | EQ
 |  |  |  |  |  |  |  |  |  | Flat Panel Properties |  |  | Flat Panel Properties |  |  | Flat Panel Properties |  |  |  |  |  |  | Accumulator skin at accumulator mount: |  |  | Steel Unwelded |  | N/A |  |  |  |  | Accumulator skin at accumulator mount: |  |  | Steel Unwelded |  | N/A |  |  |  | Accumulator skin at accumulator mount: |  |  | Steel Unwelded |  | N/A |  |  |  | Accumulator skin at accumulator mount: |  |  | Steel Unwelded |  | N/A
 |  |  |  |  |  |  |  |  |  | Outer (b) | 0 | m | A1 | #VALUE! | m^2 | I1 | #VALUE! | m^4 |  |  |  | Young's Modulus (E): |  |  |  | 200000000000 | Pa | N/A |  |  |  | Young's Modulus (E): |  |  |  | 200000000000 | Pa | N/A |  |  | Young's Modulus (E): |  |  |  | 200000000000 | Pa | N/A |  |  | Young's Modulus (E): |  |  |  | 200000000000 | Pa | N/A
 |  |  |  |  |  |  |  |  |  | Outer (h) | #VALUE! | m | A2 | #VALUE! | m^2 | I2 | #VALUE! | m^4 |  |  | Ultimate Tensile and Bending Strength (S): |  |  |  |  | 365000000 | Pa | N/A |  |  | Ultimate Tensile and Bending Strength (S): |  |  |  |  | 365000000 | Pa | N/A |  | Ultimate Tensile and Bending Strength (S): |  |  |  |  | 365000000 | Pa | N/A |  | Ultimate Tensile and Bending Strength (S): |  |  |  |  | 365000000 | Pa | N/A
 |  |  |  |  |  |  |  |  |  | Thickness | #VALUE! | m | y1 | #VALUE! | m | Ic1 | #VALUE! | m^4 |  |  |  | Shear: |  |  |  | 210605000 | Pa | N/A |  |  |  | Shear: |  |  |  | 210605000 | Pa | N/A |  |  | Shear: |  |  |  | 210605000 | Pa | N/A |  |  | Shear: |  |  |  | 210605000 | Pa | N/A
 |  |  |  |  |  |  |  |  |  | Inner (b) | 0 | m | y2 | #VALUE! | m | Ic2 | #VALUE! | m^4 |  |  |  |  |  |  |  | 0 | mm | N/A |  |  |  |  |  |  |  | 0 | mm | N/A |  |  |  |  |  |  | 0 | mm | N/A |  |  |  |  |  |  | 0 | mm | N/A
 |  |  |  |  |  |  |  |  |  | Inner (h) | #VALUE! | m | Centroid | 0.000 | m | Ic12 | #VALUE! | m^4 |  | F.10.5.7.c |  |  |  |  |  |  |  | N/A |  | F.10.5.7.c |  |  |  |  |  |  |  | N/A | F.10.5.7.c |  |  |  |  |  |  |  | N/A | F.10.5.7.c |  |  |  |  |  |  |  | N/A
 |  |  |  |  |  |  |  |  |  |  |  |  |  | Baseline Steel |  | 0 |  |  |  |  |  |  |  |  |  |  | mm | N/A |  |  |  |  |  |  |  |  | mm | N/A |  |  |  |  |  |  |  | mm | N/A |  |  |  |  |  |  |  | mm | N/A
 |  |  |  |  |  |  |  |  |  |  | Thickness: |  |  |  | 0.00125 | #VALUE! | m | N/A |  |  |  |  |  |  |  |  |  | N/A |  |  |  |  |  |  |  |  |  | N/A |  |  |  |  |  |  |  |  | N/A |  |  |  |  |  |  |  |  | N/A
 |  |  |  |  |  |  |  |  |  |  | Cross sectional area (A): |  |  |  | 0 | #VALUE! | m^2 | N/A |  |  |  |  |  |  |  |  | mm | N/A |  |  |  |  |  |  |  |  | mm | N/A |  |  |  |  |  |  |  | mm | N/A |  |  |  |  |  |  |  | mm | N/A
 |  |  |  |  |  |  |  |  |  |  | Second moment of inertia (I): |  |  |  | 0 | #VALUE! | m^4 | N/A |  |  |  |  |  |  |  |  |  | N/A |  |  |  |  |  |  |  |  |  | N/A |  |  |  |  |  |  |  |  | N/A |  |  |  |  |  |  |  |  | N/A
 |  |  |  |  |  |  |  |  |  | F.3.4.2 | Young's Modulus (E): |  |  |  | 200000000000 | 200000000000 | Pa | N/A |  |  |  |  |  |  |  |  | Pa | N/A |  |  |  |  |  |  |  |  | Pa | N/A |  |  |  |  |  |  |  | Pa | N/A |  |  |  |  |  |  |  | Pa | N/A
 |  |  |  |  |  |  |  |  |  | Ultimate Tensile and Bending Strength (S): |  |  |  |  | 365000000 | 365000000 | 100.00% | N/A |  |  |  |  |  |  |  |  | mm | N/A |  |  |  |  |  |  |  |  | mm | N/A |  |  |  |  |  |  |  | mm | N/A |  |  |  |  |  |  |  | mm | N/A
 |  |  |  |  |  |  |  |  |  |  | Shear: |  |  |  | 210605000 | 210605000 | 100.00% | N/A |  |  |  |  |  |  |  | 0 |  | N/A |  |  |  |  |  |  |  | 0 |  | N/A |  |  |  |  |  |  | 0 |  | N/A |  |  |  |  |  |  | 0 |  | N/A
 |  |  |  |  |  |  |  |  |  | Buckling Modulus |  | E_1*I_1 <= E_2*I_2: |  |  | 0 | 0 | 0.00% | N/A |  |  |  |  |  |  |  | 0 |  | N/A |  |  |  |  |  |  |  | 0 |  | N/A |  |  |  |  |  |  | 0 |  | N/A |  |  |  |  |  |  | 0 |  | N/A
 |  |  |  |  |  |  |  |  |  | UTS | S_1*A_1 <= S_2*A_2: |  |  |  | 0 | #VALUE! | #VALUE! | N/A |  |  |  |  |  |  |  | 0 |  | N/A |  |  |  |  |  |  |  | 0 |  | N/A |  |  |  |  |  |  | 0 |  | N/A |  |  |  |  |  |  | 0 |  | N/A
 |  |  |  |  |  |  |  |  |  | Bending | 4*S_1*I_1/r <= 4*S_2*I_2/r: |  |  |  | 0 | #VALUE! | #VALUE! | N/A |  |  |  |  |  |  |  | 0 | 0.0% | N/A |  |  |  |  |  |  |  | 0 | 0.0% | N/A |  |  |  |  |  |  | 0 | 0.0% | N/A |  |  |  |  |  |  | 0 | 0 | N/A
 |  |  |  |  |  |  |  |  |  | Deflection | Bending_1/(48*EI): |  |  |  | 0 | #VALUE! | #VALUE! | N/A |  |  |  |  |  |  |  |  | mm | N/A |  |  |  |  |  |  |  |  | mm | N/A |  |  |  |  |  |  |  | mm | N/A |  |  |  |  |  |  |  | mm | N/A
 |  |  |  |  |  |  |  |  |  | Energy | 0.5*Bending^2/(48*EI): |  |  |  | 0 | #VALUE! | #VALUE! | N/A |  |  |  |  |  |  |  | 0 | mm | N/A |  |  |  |  |  |  |  | 0 | mm | N/A |  |  |  |  |  |  | 0 | mm | N/A |  |  |  |  |  |  | 0 | mm | N/A
 |  |  |  |  |  |  |  |  |  | Shear |  |  |  | Shear x Thickness: | 263256.25 | #VALUE! | #VALUE! | N/A |  |  |  |  |  |  |  |  |  | N/A |  |  |  |  |  |  |  |  |  | N/A |  |  |  |  |  |  |  |  | N/A |  |  |  |  |  |  |  |  | N/A
 |  |  |  |  |  |  |  |  |  |  |  |  |  |  |  |  |  |  |  |  |  |  |  |  |  |  | N/mm^2 | N/A |  |  |  |  |  |  |  |  | N/mm^2 | N/A |  |  |  |  |  |  |  | N/mm^2 | N/A |  |  |  |  |  |  |  | N/mm^2 | N/A
 |  |  |  |  |  |  |  |  |  | F.10.2.2 |  |  |  | MINIMUM ACCUMULATOR WALLS |  |  |  |  |  |  |  |  |  |  |  |  | N/mm^2 | N/A |  |  |  |  |  |  |  |  | N/mm^2 | N/A |  |  |  |  |  |  |  | N/mm^2 | N/A |  |  |  |  |  |  |  | N/mm^2 | N/A
 |  |  |  |  |  |  |  |  |  | BLANK |  |  |  |  |  |  |  |  |  |  |  |  |  |  |  |  | mm^2 | N/A |  |  |  |  |  |  |  |  | mm^2 | N/A |  |  |  |  |  |  |  | mm^2 | N/A |  |  |  |  |  |  |  | mm^2 | N/A
 |  |  |  |  |  |  |  |  |  |  |  |  |  |  | All segment wall sections >= 75% area: |  |  | BLANK |  | F.5.5.3 |  |  |  |  |  |  |  | N/A |  | F.5.5.3 |  |  |  |  |  |  |  | N/A | F.5.5.3 |  |  |  |  |  |  |  | N/A | F.5.5.3 |  |  |  |  |  |  |  | N/A
 |  |  |  |  |  |  |  |  |  | F.10.2.2 | Minimum Wall Construction: |  |  |  |  |  |  | EQ |  |  |  |  |  |  |  |  |  | N/A |  |  |  |  |  |  |  |  |  | N/A |  |  |  |  |  |  |  |  | N/A |  |  |  |  |  |  |  |  | N/A
 |  |  |  |  |  |  |  |  |  |  |  |  |  |  | Steel: 0.90mm (0.035in), Aluminum: 2.3mm (0.090in): |  | mm | BLANK |  |  |  |  |  |  |  |  | mm | N/A |  |  |  |  |  |  |  |  | mm | N/A |  |  |  |  |  |  |  | mm | N/A |  |  |  |  |  |  |  | mm | N/A
 |  |  |  |  |  |  |  |  |  | Material Used: |  |  |  |  |  | Steel Unwelded |  | EQ |  |  |  |  |  |  |  |  | mm | N/A |  |  |  |  |  |  |  |  | mm | N/A |  |  |  |  |  |  |  | mm | N/A |  |  |  |  |  |  |  | mm | N/A
 |  |  |  |  |  |  |  |  |  | Panel thickness: |  |  |  |  |  | #VALUE! | mm | N/A |  |  |  |  |  |  |  |  |  | N/A |  |  |  |  |  |  |  |  |  | N/A |  |  |  |  |  |  |  |  | N/A |  |  |  |  |  |  |  |  | N/A
 |  |  |  |  |  |  |  |  |  | Core thickness: |  |  |  |  |  |  | mm | N/A
 |  |  |  |  |  |  |  |  |  |  |  | Scaling option, layup repeats: |  |  | Outer skin thickness: | Layup | mm | N/A
 |  |  |  |  |  |  |  |  |  |  |  | Scaling option, layup repeats: |  |  | Inner skin thickness: | Typo | mm | N/A
 |  |  |  |  |  |  |  |  |  | Flat Panel Properties |  |  | Flat Panel Properties |  |  | Flat Panel Properties
 |  |  |  |  |  |  |  |  |  | Outer (b) | 0 | m | A1 | #VALUE! | m^2 | I1 | #VALUE! | m^4
 |  |  |  |  |  |  |  |  |  | Outer (h) | #VALUE! | m | A2 | #VALUE! | m^2 | I2 | #VALUE! | m^4
 |  |  |  |  |  |  |  |  |  | Thickness | #VALUE! | m | y1 | #VALUE! | m | Ic1 | #VALUE! | m^4
 |  |  |  |  |  |  |  |  |  | Inner (b) | 0 | m | y2 | #VALUE! | m | Ic2 | #VALUE! | m^4
 |  |  |  |  |  |  |  |  |  | Inner (h) | #VALUE! | m | Centroid | 0.000 | m | Ic12 | #VALUE! | m^4
 |  |  |  |  |  |  |  |  |  |  |  |  |  | Baseline Steel |  | 0
 |  |  |  |  |  |  |  |  |  |  | Thickness: |  |  |  | 0.0009 | #VALUE! | m | N/A
 |  |  |  |  |  |  |  |  |  |  | Cross sectional area (A): |  |  |  | 0 | #VALUE! | m^2 | N/A
 |  |  |  |  |  |  |  |  |  |  | Second moment of inertia (I): |  |  |  | 0 | #VALUE! | m^4 | N/A
 |  |  |  |  |  |  |  |  |  | F.3.4.2 | Young's Modulus (E): |  |  |  | 200000000000 | 200000000000 | Pa | N/A
 |  |  |  |  |  |  |  |  |  | Ultimate Tensile and Bending Strength (S): |  |  |  |  | 365000000 | 365000000 | 100.00% | N/A
 |  |  |  |  |  |  |  |  |  |  | Shear: |  |  |  | 210605000 | 210605000 | 100.00% | N/A
 |  |  |  |  |  |  |  |  |  | Buckling Modulus |  | E_1*I_1 <= E_2*I_2: |  |  | 0 | 0 | 0.00% | N/A
 |  |  |  |  |  |  |  |  |  | UTS | S_1*A_1 <= S_2*A_2: |  |  |  | 0 | #VALUE! | #VALUE! | N/A
 |  |  |  |  |  |  |  |  |  | Bending | 4*S_1*I_1/r <= 4*S_2*I_2/r: |  |  |  | 0 | #VALUE! | #VALUE! | N/A
 |  |  |  |  |  |  |  |  |  | Deflection | Bending_1/(48*EI): |  |  |  | 0 | #VALUE! | #VALUE! | N/A
 |  |  |  |  |  |  |  |  |  | Energy | 0.5*Bending^2/(48*EI): |  |  |  | 0 | #VALUE! | #VALUE! | N/A
 |  |  |  |  |  |  |  |  |  | Shear |  |  |  | Shear x Thickness: | 189544.5 | #VALUE! | #VALUE! | N/A
 |  |  |  |  |  |  |  |  |  | F.10.2.2 |  |  |  | MINIMUM ACCUMULATOR COVER/LID
 |  |  |  |  |  |  |  |  |  | BLANK
 |  |  |  |  |  |  |  |  |  |  |  |  | No accumulator holes with line of sight to driver: |  |  |  |  | BLANK
 |  |  |  |  |  |  |  |  |  |  |  |  |  |  | All segment cover sections >= 75% area: |  |  | BLANK
 |  |  |  |  |  |  |  |  |  | F.10.2.2 |  |  |  | Accumulator Lid: |  |  |  | EQ
 |  |  |  |  |  |  |  |  |  |  |  |  |  |  | Steel: 0.90mm (0.035in), Aluminum: 2.3mm (0.090in): |  | mm | BLANK
 |  |  |  |  |  |  |  |  |  | Material Used: |  |  |  |  |  | Steel Unwelded |  | N/A
 |  |  |  |  |  |  |  |  |  | Panel thickness: |  |  |  |  |  | #VALUE! | mm | N/A
 |  |  |  |  |  |  |  |  |  | Core thickness: |  |  |  |  |  |  | mm | N/A
 |  |  |  |  |  |  |  |  |  |  |  | Scaling option, layup repeats: |  |  | Outer skin thickness: | Layup | mm | N/A
 |  |  |  |  |  |  |  |  |  |  |  | Scaling option, layup repeats: |  |  | Inner skin thickness: | Typo | mm | N/A
 |  |  |  |  |  |  |  |  |  | Flat Panel Properties |  |  | Flat Panel Properties |  |  | Flat Panel Properties
 |  |  |  |  |  |  |  |  |  | Outer (b) | 0 | m | A1 | #VALUE! | m^2 | I1 | #VALUE! | m^4
 |  |  |  |  |  |  |  |  |  | Outer (h) | #VALUE! | m | A2 | #VALUE! | m^2 | I2 | #VALUE! | m^4
 |  |  |  |  |  |  |  |  |  | Thickness | #VALUE! | m | y1 | #VALUE! | m | Ic1 | #VALUE! | m^4
 |  |  |  |  |  |  |  |  |  | Inner (b) | 0 | m | y2 | #VALUE! | m | Ic2 | #VALUE! | m^4
 |  |  |  |  |  |  |  |  |  | Inner (h) | #VALUE! | m | Centroid | 0.000 | m | Ic12 | #VALUE! | m^4
 |  |  |  |  |  |  |  |  |  |  |  |  |  | Baseline Steel |  | 0
 |  |  |  |  |  |  |  |  |  |  | Thickness: |  |  |  | 0.0009 | #VALUE! | m | N/A
 |  |  |  |  |  |  |  |  |  |  | Cross sectional area (A): |  |  |  | 0 | #VALUE! | m^2 | N/A
 |  |  |  |  |  |  |  |  |  |  | Second moment of inertia (I): |  |  |  | 0 | #VALUE! | m^4 | N/A
 |  |  |  |  |  |  |  |  |  | F.3.4.2 | Young's Modulus (E): |  |  |  | 200000000000 | 200000000000 | Pa | N/A
 |  |  |  |  |  |  |  |  |  | Ultimate Tensile and Bending Strength (S): |  |  |  |  | 365000000 | 365000000 | 100.00% | N/A
 |  |  |  |  |  |  |  |  |  |  | Shear: |  |  |  | 210605000 | 210605000 | 100.00% | N/A
 |  |  |  |  |  |  |  |  |  | Buckling Modulus |  | E_1*I_1 <= E_2*I_2: |  |  | 0 | 0 | 0.00% | N/A
 |  |  |  |  |  |  |  |  |  | UTS | S_1*A_1 <= S_2*A_2: |  |  |  | 0 | #VALUE! | #VALUE! | N/A
 |  |  |  |  |  |  |  |  |  | Bending | 4*S_1*I_1/r <= 4*S_2*I_2/r: |  |  |  | 0 | #VALUE! | #VALUE! | N/A
 |  |  |  |  |  |  |  |  |  | Deflection | Bending_1/(48*EI): |  |  |  | 0 | #VALUE! | #VALUE! | N/A
 |  |  |  |  |  |  |  |  |  | Energy | 0.5*Bending^2/(48*EI): |  |  |  | 0 | #VALUE! | #VALUE! | N/A
 |  |  |  |  |  |  |  |  |  | Shear |  |  |  | Shear x Thickness: | 189544.5 | #VALUE! | #VALUE! | N/A

Sheet: F.8 Front Protection
E, Sy, Su, Sy-Weld, Su-Weld
Steel | 6061-T6 | Other
200000000000 | 69000000000
305000000 | 240000000
365000000 | 290000000
180000000 | 115000000
300000000 | 175000000
Sy | 78.68852459% | 0%
Su | 79.45205479% | 0% | Insert Pictures - may be added left or below:
Sy-Weld | 63.88888889% | 0% |  |  |  |  |  |  |  |  |  | Insert Pictures - continued: |  |  |  |  |  |  |  |  |  | Insert measurement of IA front top edge height.
Su-Weld | 58.33333333% | 0% | (a.) Standard Impact Attenuator Receipt
 | Critical Steel Comparison |  |  |  |  |  |  |  |  |  |  | (d.) Wing Detachment Material Properites |  |  |  |  |  |  |  |  |  |  |  |  |  |  |  |  | Front Bulkhead CAD with dimensions required. |  |  |  |  |  |  |  |  | Front Bulkhead CAD with dimensions required.
Su | Su-Weld | Sy |  |  |  |  |  |  |  |  |  |  |  |  |  |  |  |  |  |  |  | Shear Dimensions |  |  |  |  |  |  |  |  |  |  |  |  |  |  |  |  |  |  |  |  |  |  |  | Annually tested items must be
365000000 | 300000000 | 305000000 | (b.) Adhesive Material Properties - Indicate selected value, include units conversion |  |  |  |  |  |  |  |  |  |  |  |  |  |  |  |  |  |  |  |  |  |  |  |  |  |  |  |  |  |  |  |  |  |  | Include skin and core thickness, height, depth, and moment of inertia.
365000000 | 175000000 | 0 |  |  |  |  |  |  |  |  |  |  |  |  |  |  |  |  |  |  |  | Do not count holes as part of the area. |  |  |  |  |  |  | Show 25mm gap to pedal assembly. |  |  |  |  |  |  |  |  |  |  |  |  |  |  |  |  | permanently marked with the date.
 |  |  |  |  |  |  |  |  |  |  |  | (e.) Other Wing Detachment Calculations (if not using standard fastener shear)
BLANK |  |  |  |  |  |  |  |  |  |  |  |  |  |  |  |  |  |  |  |  |  | Even with precrush, honeycomb bond area is |  |  |  |  |  |  |  |  |  |  |  |  |  |  |  |  |  |  |  |  |  |  |  | Tested items must be presented during
 |  |  |  |  |  |  |  |  |  |  |  |  |  |  |  |  |  |  |  |  |  |  |  |  |  |  |  |  | Pedal attachments preferably >25mm behind FB.
 |  |  | (c.) Composite Material Receipts (if not already on 3-Point test tab) |  |  |  |  |  |  |  |  |  |  |  |  |  |  |  |  |  |  | usually <50% of the face. |  |  |  |  |  |  |  |  |  |  |  |  |  |  |  |  |  |  |  |  |  |  |  | Technical Inspection.
mm
 |  |  |  |  |  |  |  |  |  |  |  |  |  |  |  |  |  |  |  |  |  |  |  |  |  |  |  |  |  |  |  |  |  |  |  |  |  |  |  |  | FB compares the minimum horizontal or vertical panel to two tubes (plus diagonal if required.)
 |  |  | F.8.7.3 | F.5.5.2 | Provide IA receipt and material properties documents above or below. |  |  |  |  |  |  |  |  |  |  |  |  |  |  |  |  | Additional images or calculations may be placed below each section. |  |  |  |  |  |  | If additional images are necessary, they may be placed below each section. |  |  |  |  |  |  |  |  |  |  |  | If additional images are necessary, they may be placed below each section.
 |  |  | BLANK |  | Attenuator and Diagonal |  |  |  |  |  |  | BLANK |  | Anti-Intrusion Plate |  |  |  |  |  |  |  | BLANK |  | IA Attachment, Wing Detachment |  |  |  |  | BLANK |  | Front Bulkhead, Composite Diagonal |  |  |  |  |  |  | BLANK |  | AIP Attachment |  |  |  |  |  | EQ |  | Physical Test Fixture Guidance
 |  |  | No Test: |  |  | + |  |  |  |  |  | No additional test for Steel or Aluminum AIP. |  |  |  |  |  |  |  |  |  | F.8.5.2 | Foam and honeycomb attenuators must be bonded to the AIP. |  |  |  |  |  | F.8.2.4 | A 25mm gap is required between the AIP + FB + Diagonal and the pedal assembly. |  |  |  |  |  |  |  | F.8.2.2 | A welded AIP must reach tube centerlines. Any other AIP must match the bulkhead perimeter. |  |  |  |  |  |  | F.8.7.6.b | The tested IA must be attached to a structurally representative section of the chassis.
 |  |  |  |  |  |  |  |  |  |  |  |  |  |  |  |  |  |  |  |  |  | The entire attenuator face must be bonded with adhesive suitable for both materials. |  |  |  |  |  |  | BLANK |  |  |  |  |  |  |  |  | F.8.2.3.b | Anti Intrusion Plates bolted through welded inserts on the centerline of Size B tubes
 |  |  |  |  |  |  |  |  |  |  |  |  |  |  |  |  |  |  |  |  |  |  |  |  |  |  |  |  | F.6.1 | Front Bulkhead |  |  |  |  |  |  | BLANK |  | automatically meet the 15kN load requirement. The centerline method is strongly preferred. |  |  |  |  |  |  | EQ
 |  |  | F.8.4.3 | A Standard Foam Attenuator may be oriented horizontally or vertically. |  |  |  |  |  |  |  | BLANK |  |  |  |  |  |  |  |  |  | Honeycomb attenuators must be glued on a pre-crushed side. Do not count area of holes. |  |  |  |  |  |  |  |  |  |  |  | Minimum | Tube Used |  | EQ | F.8.2.3.c | Bonding is legal for composite bulkheads with no openings. The entire surface must be bonded. |  |  |  |  |  |  |  |  |  | Front Bulkhead Outside to Outside Height: | 0
 |  |  |  | The outside edges of the Bulkhead must be no more than 25mm (1in) from the foam. |  |  |  |  |  |  |  | F.8.2.1 |  |  |  |  | Anti-Intrusion Plate (AI) material: |  |  | BLANK |  | No wall wetting may be factored into the bond area. Use a calculation of pre-crushed area. |  |  |  |  |  |  | F.3.2.1 | Example: 25.4mm x 1.6mm round |  |  |  | Steel |  |  | BLANK | F.8.3 | An integrated composite AIP may also qualify as the monocoque front bulkhead. |  |  |  |  |  |  |  |  |  | Front Bulkhead Outside To Outside Width: | 0
 |  |  |  | Otherwise, a diagonal or an annual physical test will be required. |  |  |  |  |  |  |  |  |  |  |  |  | Steel: 1.5mm (0.060in), Aluminum: 4.0mm (0.157in): |  | mm | BLANK |  | Multiple layers of honeycomb require pre-crushed bond on both sides of a plate between each layer. |  |  |  |  |  |  | F.3.4.1 | Front Bulkhead Minimum Tube: |  |  |  | Size B |  |  | BLANK | F.8.2.3.d | If the AIP does not meet FB equivalence, it may be fully enclosed in a monocoque in front of the front bulkhead layup. |  |  |  |  |  |  | F.8.7.6.c |  |  | Fixture Thickness on table >=50mm:
 |  |  |  |  |  |  |  |  |  |  |  |  |  |  |  |  |  |  |  |  |  |  |  |  |  |  |  |  |  | Wall thickness: |  |  |  | 1.2 |  | mm | BLANK |  |  |  |  |  |  |  |  | F.8.4.2.a |  |  | Tested IA starting length > 200mm:
 |  |  | F.8.4.2 | A Standard Honeycomb Attenuator must be oriented 200mm horizontally. |  |  |  |  |  |  |  |  |  |  |  |  |  |  |  |  |  | F.8.5.6 | The bottom leading edge of the attenuator must be <=220mm above the SIS lowest point. |  |  |  |  |  | F.3.4.1 | Square side: |  |  |  | 25 |  | mm | BLANK | BLANK |  |  |  |  |  |  |  | F.8.4.2.b |  |  | Custom IA WIDTH over 200mm length >= 200mm:
 |  |  | F.8.4.3 | A Standard Honeycomb with a FB diagonal does not require an annual physical test. |  |  |  |  |  |  |  | F.8.3.2 | AI plates made of any material besides steel or aluminum must either: |  |  |  |  |  |  |  |  |  | The top leading edge of a standard honeycomb must be >=240mm. No lower foam limit. |  |  |  |  |  |  | Wall thickness: |  |  |  | 0.0012 |  | m | EQ | F.8.2.2 |  |  |  | AIP to FB Attachment: |  |  | BLANK |  |  |  | Custom IA HEIGHT over 200mm length >= 100mm:
 |  |  |  |  |  |  |  |  |  |  |  | F.8.3.2.a | Be physically tested on a replica bulkhead up to 120kN, |  |  |  |  |  |  |  |  |  |  |  |  |  |  |  |  | Square side: |  |  |  | 0.025 |  | m | EQ |  | AI plate must match entire Front Bulkhead perimeter. |  |  |  |  |  | EQ
 |  |  | F.8.7.5 | Custom Impact Attenuators require an annual physical test. |  |  |  |  |  |  |  |  | with the load distributed over the 200 mm x 100mm minimum IA area. |  |  |  |  |  |  |  |  | Quick release attenuators must be rigidly lockable. |  |  |  |  |  |  |  | Tube cross sectional area (A): |  |  |  | 0.000114 |  | m^2 | EQ | F.8.4.3.d |  |  |  | Scroll to bottom. |  |  | BLANK | F.8.7.6.bc | Tube frame teams need to build a replica of their front bulkhead.
 |  |  | F.8.7.7.a | Composite Impact Attenuators require an annual dynamic test. |  |  |  |  |  |  |  | F.8.3.2.b | Show F.8.3.4 120kN equivalence from F.4.3.1 laminate testing. |  |  |  |  |  |  |  |  | In any direction, while the lock is engaged: |  |  |  |  |  |  |  | Tube second moment of inertia (I): |  |  |  | 8.509e-09 |  | m^4 | EQ |  |  |  |  | Scroll to bottom. |  | mm | BLANK | The dimensions, tube sizes, and location of the Impact Attenuator must match the chassis FB.
 |  |  | F.8.7.6.a | Dynamic tests may not be performed by students. |  |  |  |  |  |  |  |  |  |  |  |  |  |  |  |  |  | A quick release attenuator must not be removable with less force than standard bolt shear. |  |  |  |  |  |  | F.3.4.2 | F.3.5 |  |  | Young's Modulus (E): | 200000000000 | 0 | Pa | BLANK |  |  |  |  |  |  |  |  | The Anti Intrusion plate must be spaced at least 50mm away from the test rig surface.
 |  |  |  |  |  |  |  |  |  |  |  | EQ |  |  |  |  |  |  |  |  |  |  |  |  |  |  |  |  | F.3.5 | Critical |  |  | Sy: | 305000000 | 0 | Pa | BLANK | EQ |  |  |  |  |  |  |  | Spacer tubes should be located at the corners where FBHS tubes attach.
 |  |  | BLANK |  |  |  |  |  |  |  |  | F.8.3.2 | Composite Anti Intrusion: |  |  |  | 0 |  |  | N/A |  | BLANK |  |  |  |  |  |  | Buckling Modulus |  | E_1*I_1 <= E_2*I_2: |  |  | 1701.8 |  |  | EQ |  |  |  |  | Bolting AIP to tube Front Bulkhead |  |  | N/A | Spacer tubes may be vertical, and wall thickness is not critical.
 |  |  | F.8.4.1 |  |  | Impact Attenuator Type: |  |  |  |  | BLANK | F.8.3.2 |  |  |  |  | Composite AI Equivalence: |  |  | N/A | F.8.5.6 |  |  |  | Front face of IA > 240mm above lowest point in cockpit: |  | mm | BLANK | Sy: | S_1*A_1 <= S_2*A_2: |  |  |  | 34770 |  |  | EQ | F.8.2.3.b |  |  |  | Locate AI bolts through FB tube inserts or on tabs: |  |  | N/A
 |  |  |  |  |  |  |  |  |  |  | N/A |  |  |  |  |  | Type SES Tab Name Of Layup Used: |  |  | N/A |  |  |  |  | Front face of IA < 220mm above lowest point in cockpit: |  | mm | BLANK | Bending | 4*S_1*I_1/r <= 4*S_2*I_2/r: |  |  |  | 817.4 |  |  | EQ |  |  |  |  | Maximum Fastener centerline offset from tube surface: |  | mm | N/A | F.8.7.6.bc | Monocoque teams need to test a replica of the first 50mm+ of the full chassis.
 |  |  |  |  |  |  |  |  | 355mm (14in) |  | N/A |  |  |  |  |  | Core thickness: |  | mm | N/A |  | F.8.5.2 |  |  | IA to AI plate mounting method: |  |  | BLANK | Deflection | Bending_1/(48*EI): |  |  |  | 0.01000656168 |  |  | EQ |  |  |  |  | Mount cross section on tube surface: |  |  | N/A | Layups must match the car presented at competition.
 |  |  | F.8.4.3 |  |  |  |  | Front Bulkhead Outside to Outside Height: |  | mm | BLANK |  |  | Scaling option, layup repeats: |  |  | Outer skin thickness: | Layup | mm | N/A |  |  |  |  |  |  |  | BLANK | Energy | 0.5*Bending^2/(48*EI): |  |  |  | 4.089681759 |  |  | EQ | See diagrams: EV Acc tab AY28-BI28 |  |  |  | Mount thickness (B): |  | mm | N/A
 |  |  |  |  |  |  |  | Front Bulkhead Outside To Outside Width: |  | mm | BLANK |  |  | Scaling option, layup repeats: |  |  | Inner skin thickness: | Typo | mm | N/A |  |  |  |  |  |  | mm | BLANK |  |  |  |  |  |  |  |  |  |  |  |  |  | Mount length (L): |  | mm | N/A | Option 1 | Design the mold to layup and pull the front 2" off.
 |  |  |  |  |  |  |  |  |  |  |  |  |  |  |  |  | Thickness of panel: | #VALUE! | mm | N/A |  |  |  |  |  |  |  | BLANK | EQ |  |  |  |  |  |  |  |  |  |  |  |  | Minimum gusset thickness (T): |  | mm | N/A | 1a | Maybe use last year's, mold, often shared between the two years.
 |  |  |  |  |  |  |  |  |  |  |  |  |  |  |  |  | Composite Panel Height: |  | mm | N/A |  |  |  |  |  | 95000 | N | EQ | F.7.3 |  |  | Front Bulkhead Construction: | Tube |  | 0 |  | N/A |  |  |  |  | Minimum gusset height normal to mount face (H): |  | mm | N/A | 1b | Or pull a tool of last year's car, if the nose will be the same.
 |  |  |  |  |  |  |  |  |  |  |  |  |  |  |  |  | Composite Panel Width: |  | mm | N/A |  |  |  |  |  |  | N/mm^2 | BLANK |  |  |  | Front Bulkhead Tubes Replaced Size B: | 0 |  | Diagonal Size C: | 0 | N/A | F.3.5 | 0.0 |  |  | 15kN shear bending M*y / I <= Su-Weld: |  |  | N/A | This is the best test of the monocoque itself, if we are concerned about the FB.
 |  |  | BLANK |  |  |  |  |  |  |  |  |  |  |  |  |  | Top Edge of FB to Top Edge of IA: |  | mm | N/A |  |  |  |  |  | 0 | N/mm^2 | EQ |  |  |  |  |  | Type SES Tab Name Of Layup Used: |  |  | N/A | 0 | 0.0 |  |  | 15kN normal bending M*y / I <= Su-Weld: |  |  | N/A
 |  |  | F.8.4.3 | Diagonal Tube, Attenuator Test, or Composite |  |  |  |  |  |  | BLANK | F.8.3.1 |  |  |  |  | Minimum Required Impact Attenuator Height: | 100 | mm | N/A |  |  |  |  |  |  | mm^2 | BLANK |  |  |  |  | Front Bulkhead |  |  |  | N/A | 0 |  |  |  | Parabolic shear 3*Test Load/2*area <= Shear: |  |  | N/A | Option 2 | A flat bulkhead-profile layup, with perpendicular FBHS layup segments below the rear face.
 |  |  |  |  |  |  |  | Minimum | Tube Used |  | N/A |  |  |  |  |  | Minimum Required Impact Attenuator Width: | 200 | mm | N/A |  |  |  |  |  |  |  | EQ |  |  |  |  |  | Core thickness: |  | mm | N/A |  |  |  |  |  |  |  |  | 2a | This could be made before the mold is cut, or off the previous year's mold.
 |  |  | F.3.2.1 | Example: 25.4mm x 1.2mm round |  |  |  | Steel |  |  | N/A |  |  |  |  |  | Second moment of inertia I, Vertical: |  | m^4 | N/A |  |  |  |  |  |  |  |  |  |  | Scaling option, layup repeats: |  |  | Outer skin thickness: | Layup | mm | N/A | EQ |  |  |  |  |  |  |  | 2b | Most monocoques have an tapered nose and rounded corners, which this might eliminate.
 |  |  | F.3.4.1 | Diagonal Minimum Tube: |  |  |  | Size C |  |  | N/A |  |  |  |  |  | Second moment of inertia I, Horizontal: |  | m^4 | N/A |  | F.8.6.1 | All non-crushable objects ahead of the AI plate must be accounted for. |  |  |  |  |  |  |  | Scaling option, layup repeats: |  |  | Inner skin thickness: | Typo | mm | N/A | F.8.2.3.b |  |  |  | Bolting AIP to composite Front Bulkhead |  |  | N/A | This is fully composite, but hopefully easier, faster, and less expensive to make.
 |  |  |  | Wall thickness: |  |  |  | 1.2 |  | mm | N/A |  |  | Young's Modulus (E): |  |  |  | Layup | Pa | N/A |  | Thin, non-structural nosecones, attachment tabs, tires, and fastener ends are ignored. |  |  |  |  |  |  |  |  |  |  |  | Thickness of panel: | #VALUE! | mm | N/A |  | Fasteners per washer: |  |  | Washer/bolt perimeter: |  | mm | N/A
 |  |  | F.3.4.1 | Square side: |  |  |  | 25 |  | mm | N/A |  |  | Ultimate Tensile Strength (S): |  |  |  | Name | Pa | N/A |  | F.8.6.6 | The front wing and mounts must have a path around or below the AIP. |  |  |  |  |  |  |  |  |  |  | Front Bulkhead Height: |  | mm | N/A |  |  |  |  | Panel thickness: | #VALUE! | mm | N/A | Option 3 | Steel tube perimeter replicating FBHS under underneath a flat, same shape, bulkhead layup.
 |  |  |  | Wall thickness: |  |  |  | 0.0012 |  | m | N/A |  |  | Shear: |  |  |  | Typo | Pa | N/A |  | Keep wing mounts outside the Front Bulkhead in Front View. |  |  |  |  |  |  |  |  |  |  |  | Front Bulkhead Width: |  | mm | N/A |  |  |  |  | Core thickness: | 0 | mm | N/A | 3a | Can the steel tubes match the thickness and stiffness of the FBHS?
 |  |  |  | Square side: |  |  |  | 0.025 |  | m | N/A | F.8.3.1 |  |  |  |  | Max Bending Moment, Vertical (120kN Partial UDL): |  | Nm | N/A |  | Calculation math other than fastener shear may be entered as an image. |  |  |  |  |  |  |  |  |  |  |  | Cutout Height |  | mm | N/A |  |  |  |  | Outer skin thickness: | Layup | mm | N/A | 3b | This will affect the bulkhead behavior.
 |  |  |  | Tube cross sectional area (A): |  |  |  | 9.1e-05 |  | m^2 | N/A |  |  |  |  |  | Max Bending Moment, Horizontal (120kN Partial UDL): |  | Nm | N/A |  | F.2.3 | FEA is not an accepted calculation for mount failure force or any other SES equivalency. |  |  |  |  |  |  |  |  |  |  | Cutout Width |  | mm | N/A |  |  |  |  | Inner skin thickness: | Typo | mm | N/A | 3c | Make sure to have very good bonding or laminating between the tubes and bulkhead.
 |  |  |  | Tube second moment of inertia (I): |  |  |  | 6.695e-09 |  | m^4 | N/A |  |  |  |  |  | Max Bending * Max y / I = Max Stress, Vertical: |  | Pa | N/A |  |  |  |  |  |  |  |  |  |  |  |  |  | Composite Panel Height: | 0 | mm | N/A |  | Fasteners per insert: |  |  | Insert Perimeter on bulkhead: |  | mm | N/A
 |  |  | F.3.4.2 | Young's Modulus (E): |  |  |  | 200000000000 | 0 | Pa | N/A |  |  |  |  |  | Max Bending * Max y / I = Max Stress, Horizontal: |  | Pa | N/A |  | BLANK |  |  |  |  |  |  | F.3.4.2.a |  |  |  | Young's Modulus (E): | 200000000000 | Layup | Pa | N/A |  | Fasteners per backing plate: |  |  | Backing plate thickness: |  | mm | N/A | Not accepted: | Steel tubes with no composite bulkhead.
 |  |  | F.3.5 | Critical |  |  | Sy: | 305000000 | 0 | Pa | N/A |  |  |  |  |  | UTS (S) / Max Stress = Safety Factor, Bending: |  |  | N/A |  |  | Front Wing Status: |  |  |  |  | BLANK |  |  |  |  | Ultimate Tensile Strength (S): | 365000000 | Name | Pa | N/A |  |  |  |  | Backing plate perimeter on bulkhead: |  | mm | N/A | Difficult to match monocoque bulkhead front shape with or without cutouts.
 |  |  | Buckling Modulus |  | E_1*I_1 <= E_2*I_2: |  |  | 1339 |  |  | N/A |  |  |  |  |  | Perimeter Shear Stress, 120kN Load: |  | Pa | N/A |  |  |  |  |  |  | N | N/A |  |  |  |  | Shear: | 210605000 | Typo | Pa | N/A |  |  |  |  | Minimum - Fastener spacing, edge, or corner distance: |  | mm | N/A | Difficult to quantify stiffness to match to monocoque bulkhead.
 |  |  | Sy: | S_1*A_1 <= S_2*A_2: |  |  |  | 27755 |  |  | N/A |  |  |  |  |  | Safety Factor, Perimeter Shear: |  |  | N/A |  |  |  |  |  |  |  | N/A | F.7.3.2 |  |  |  | 25mm FBHS Section |  |  |  | N/A |  |  |  |  | Skin shear strength: | 0 | Pa | N/A | Both of these will affect AI plate behavior, which is a critical part of the test.
 |  |  | Bending | 4*S_1*I_1/r <= 4*S_2*I_2/r: |  |  |  | 643.1417323 |  |  | N/A |  | IA Bottom |  | IA Top |  | IA Left |  | IA Right |  |  |  |  |  | Wing detachment force: | 0 | N | EQ |  |  |  |  |  | Core thickness: | 0 | mm | N/A | F.8.2.3.b |  |  |  | Perimeter shear strength >15000N: | #VALUE! | N | N/A
 |  |  | Deflection | Bending_1/(48*EI): |  |  |  | 0.01000656168 |  |  | N/A |  | -100 | mm | 0 | mm | -100 | mm | 100 | mm |  |  |  |  | Peak Attenuator Force: | 0 | N | EQ |  |  |  |  |  | Outer skin thickness: | 0 | mm | N/A |  |  |  |  | Tearout strength >15000N: | #VALUE! | N | N/A
 |  |  | Energy | 0.5*Bending^2/(48*EI): |  |  |  | 3.217818706 |  |  | N/A | Vertical Panel Properties |  |  | Vertical Panel Properties |  |  | Vertical Panel Properties |  |  |  | F.8.7.2.a |  |  | Peak deceleration force <= 120000N | 0 | N | EQ |  |  |  |  |  | Inner skin thickness: | 0 | mm | N/A
 |  |  |  |  |  |  |  |  |  |  |  | Outer (b) | 0 | m | A1 | #VALUE! | m^2 | I1 | #VALUE! | m^4 |  |  |  |  | Peak deceleration remains <= 40g: | 0.0 | g | EQ |  |  |  |  |  | Thickness of panel: | 0 | mm | N/A | EQ
 |  |  | F.8.4.3.a | Tube frame teams should weld a diagonal to the Front Bulkhead. |  |  |  |  |  |  |  | Outer (h) | #VALUE! | m | A2 | #VALUE! | m^2 | I2 | #VALUE! | m^4 |  |  |  |  |  |  |  |  | F.3.4.2.a |  |  |  | Young's Modulus (E): | 200000000000 | 0 | Pa | N/A |  |  |  | Bonding AIP to composite Front Bulkhead |  |  |  | N/A
 |  |  | F.8.4.3.a | Monocoque teams should install diagonals with 2 * 30kN attachment to reduce testing. |  |  |  |  |  |  |  | Thickness | #VALUE! | m | y1 | #VALUE! | m | Ic1 |  | m^4 |  |  |  |  |  |  |  |  |  |  |  |  | Ultimate Tensile Strength (S): | 365000000 | 0 | Pa | N/A | F.8.2.3.c |  |  |  | Is there an opening in the Front Bulkhead? |  |  | N/A
 |  |  |  | The structure must go across the entire front bulkhead opening on the diagonal. |  |  |  |  |  |  |  | Inner (b) | 0 | m | y2 | #VALUE! | m | Ic2 |  | m^4 |  |  |  |  |  |  |  |  |  |  |  |  | Shear: | 210605000 | 0 | Pa | N/A |  |  |  |  | What is the brand name of the adhesive? |  |  | N/A
 |  |  |  | If a front bulkhead or removable panel with no openings is not feasible, preferably a square |  |  |  |  |  |  |  | Inner (h) | #VALUE! | m | Centroid |  | m | Ic12 |  | m^4 |  |  |  |  |  |  |  |  |  |  |  |  |  | 0 x Steel Tube | Flat (h) |  | N/A |  |  |  |  | Minimum shear / peel strength of adhesive: |  | N/mm^2 | N/A
 |  |  |  | tube is welded or bonded to the AIP. Round tubes may not be welded or bonded to the AIP. |  |  |  |  |  |  |  | Horizontal Panel Properties |  |  | Horizontal Panel Properties |  |  | Horizontal Panel Properties |  |  |  |  |  |  |  |  |  |  | F.3.2.1 |  |  |  | Minimum FB wall thickness: | 0.0012 | 0 | m | N/A |  |  |  |  | 50% adhesive reduction for safety factor: | 0 | N/mm^2 | N/A
 |  |  |  |  |  |  |  |  |  |  |  | Outer (b) | 0 | m | A1 | #VALUE! | m^2 | I1 | #VALUE! | m^4 |  |  |  |  |  |  |  |  |  |  |  |  | Outer Diameter / Panel Thickness: | 0.025 | #VALUE! | m | N/A |  |  |  |  | Minimum bond area: |  | mm^2 | N/A
 |  |  |  |  |  |  | Diagonal, AIP, and FB material must be entered in cells J57, J59, T37, AN35, and AN37. |  |  |  |  | Outer (h) | #VALUE! | m | A2 | #VALUE! | m^2 | I2 | #VALUE! | m^4 |  |  |  |  |  |  |  |  | F.3.4.1 |  |  |  | Additive cross section (A): | 0 | #VALUE! | m^2 | N/A |  |  |  |  | Calculated bond strength: |  |  | N/A
 |  |  | BLANK |  |  |  |  |  |  |  |  | Thickness | #VALUE! | m | y1 | #VALUE! | m | Ic1 |  | m^4 |  |  |  |  |  |  |  |  |  |  |  |  | Additive second moment of inertia (I): | 0 |  | m^4 | N/A
 |  |  | Diagonal | Composite |  |  | to |  | Composite |  | BLANK | Inner (b) | 0 | m | y2 | #VALUE! | m | Ic2 |  | m^4 |  |  |  |  |  |  |  |  | Buckling Modulus |  |  |  | E_1*I_1 <= E_2*I_2+E_3*I_3: | 0 |  |  | N/A | EQ
 |  |  |  |  |  |  |  |  |  |  | N/A | Inner (h) | #VALUE! | m | Centroid |  | m | Ic12 |  | m^4 |  | Front view, show the front wing and mounts are |  |  |  |  |  |  | UTS |  |  |  | S_1*A_1 <= S_2*A_2+S_3*A_3: | 0 |  |  | N/A | F.8.2.3.d |  |  | Laminated AIP to composite Front Bulkhead |  |  |  | N/A
 |  | N/A |  | mm |  |  |  |  |  | mm | N/A |  |  |  |  |  |  |  |  |  |  |  |  |  |  |  |  |  | Bending |  |  |  | 4*S_1*I_1/r <= 4*(S_2*I_2+S_3*I_3)/r: | 0 |  |  | N/A |  |  |  |  | Does the AIP form the front bulkhead of the monocoque? |  |  | N/A
 |  | N/A |  |  |  |  |  |  |  |  | BLANK | Fig. 3-4: | https://www.aboutcivil.org/simply-supported-UDL-beam-formulas-bending-moment-equations.html |  |  |  |  |  |  |  |  |  |  |  |  |  |  |  | Deflection |  |  |  | Bending_1/(48*EI): | 0 |  |  | N/A |  |  |  |  | Type SES Tab Name Of Enclosing Layup Used: |  |  | N/A
 |  | N/A | 0 | Pa |  |  |  |  | Typo | Pa | EQ |  |  |  |  |  |  |  |  |  |  | entirely outside / below the front bulkhead. |  |  |  |  |  |  | Energy |  |  |  | 0.5*Bending^2/(48*EI): | 0 |  |  | N/A |  |  |  |  | Skin used: |  |  | N/A
 |  | N/A |  | Typo | mm |  |  |  | Typo | mm | EQ |  |  |  |  |  |  |  |  |  |  |  |  |  |  |  |  |  | F.7.3.3 |  |  |  | 1.5mm Steel Shear Equivalence: | 315907500 |  |  | N/A |  |  |  |  | AIP Perimeter Length: |  | mm | N/A
 |  | N/A |  | Typo | mm |  |  |  | Typo | mm | EQ |  |  |  |  |  |  |  |  |  |  |  |  |  |  |  |  |  |  | Bulkhead Panel Properties |  |  | Bulkhead Panel Properties |  |  | Bulkhead Panel Properties |  |  |  | Scaling option, layup repeats: |  | Laminate thickness: | Typo | mm | N/A
 |  | N/A |  | mm |  |  |  |  |  | mm | N/A |  |  |  |  |  |  |  |  |  |  |  |  |  |  |  |  |  | Outer (b) | 0 | m | A1 | #VALUE! | m^2 | I1 | #VALUE! | m^4 |  |  |  |  | Skin shear area - centerline x 1 thickness: | #VALUE! | m^2 | N/A
 |  | N/A |  | mm |  |  |  |  |  | mm | N/A |  |  |  |  |  |  |  |  |  |  | Show total number of fasteners for |  |  |  |  |  |  | Outer (h) | #VALUE! | m | A2 | #VALUE! | m^2 | I2 | #VALUE! | m^4 |  |  |  |  | Skin shear strength: | Typo | Pa | N/A
 |  |  |  |  |  |  |  |  |  |  | N/A |  |  |  |  |  |  |  |  |  |  |  |  |  |  |  |  |  | Thickness | #VALUE! | m | y1 | #VALUE! | m | Ic1 |  | m^4 | F.8.2.3.d |  |  |  | Single tearout path >=120000N: |  | 0.00% | N/A
 |  |  |  |  |  |  |  |  |  | mm | N/A |  |  |  |  |  |  |  |  |  |  | standard shear calculation. |  |  |  |  |  |  | Inner (b) | 0 | m | y2 | #VALUE! | m | Ic2 |  | m^4 |  |  |  |  | Front Hoop Lamination: |  |  | N/A
 |  |  |  |  |  |  |  |  |  | N | N/A |  |  |  |  |  |  |  |  |  |  |  |  |  |  |  |  |  | Inner (h) | #VALUE! | m |  |  |  | Ic12 |  | m^4 |  |  |  |  | Lap joint strength: | Typo | Pa | N/A
 |  |  |  |  |  |  |  |  |  |  | N/A |  |  |  |  |  |  |  |  |  |  |  |  |  |  |  |  |  |  | FBHS 25mm Properties |  |  | FBHS 25mm Properties |  |  | FBHS 25mm Properties |  |  |  |  |  | Total bond width including both sides of the Front Hoop: |  | mm | N/A
 |  |  |  |  |  |  |  |  | 0 |  | N/A |  |  |  |  |  |  |  |  |  |  |  |  |  |  |  |  |  | Outer (b) | 0 | m | A1 | #VALUE! | m^2 | I1 | #VALUE! | m^4 |  |  |  |  | Bond shear area: | 0 | m^2 | N/A
 |  | N/A | 0 |  |  |  |  |  | #VALUE! | #VALUE! | N/A |  |  |  |  |  |  |  |  |  |  | Show fastener UTS source / conversion. |  |  |  |  |  |  | Outer (h) | #VALUE! | m | A2 | 0 | m^2 | I2 | 0 | m^4 | F.8.2.3.d |  |  |  | Bond failure >=120000N: | #VALUE! | #VALUE! | N/A
 |  | N/A | 0 |  |  |  |  |  | #VALUE! | #VALUE! | N/A |  |  |  |  |  |  |  |  |  |  |  |  |  |  |  |  |  | Thickness | 0 | m | y1 | #VALUE! | m | Ic1 |  | m^4
 |  |  |  |  |  |  |  |  | 0 | Pa | N/A |  |  |  |  |  |  |  |  |  |  |  |  |  |  |  |  |  | Inner (b) | 0 | m | y2 | #VALUE! | m | Ic2 |  | m^4
 |  |  |  |  |  |  |  |  |  | mm | N/A |  |  |  |  |  |  |  |  |  |  |  |  |  |  |  |  |  | Inner (h) | 0.025 | m | Centroid |  | m | Ic12 |  | m^4
 |  |  |  |  |  |  |  |  | 0 | mm | N/A
 |  |  |  |  |  |  |  |  |  |  | N/A |  |  |  |  |  |  |  |  |  |  |  |  |  |  |  |  |  | EQ
 |  |  |  |  |  |  |  |  |  |  | N/A |  |  |  |  |  |  |  |  |  |  |  |  |  |  |  |  |  | F.3.2.1.k |  |  |  |  | Composite Diagonal: | N/A |  | N/A
 |  |  |  |  |  |  |  |  |  | N/mm^2 | N/A |  |  |  |  |  |  |  |  |  |  |  |  |  |  |  |  |  |  |  |  |  |  | Size C Steel Tubes Replaced: | 0 |  | N/A
 |  |  |  |  |  |  |  |  |  | mm^2 | N/A |  |  |  |  |  |  |  |  |  |  |  |  |  |  |  |  |  |  |  |  |  |  | Type SES Tab Name Of Layup Used: | RENAME F.4.3 Composite |  | N/A
 |  |  |  |  |  |  |  |  |  |  | N/A |  |  |  |  |  |  |  |  |  |  |  |  |  |  |  |  |  |  |  |  |  |  | Core thickness: |  | mm | N/A
 |  |  |  |  |  |  |  |  |  | mm | N/A |  |  |  |  |  |  |  |  |  |  |  |  |  |  |  |  |  |  |  | Scaling option, layup repeats: |  |  | Outer skin thickness: | Layup | mm | N/A
 |  |  |  |  |  |  |  |  | #VALUE! | m^2 | N/A |  |  |  |  |  |  |  |  |  |  |  |  |  |  |  |  |  |  |  | Scaling option, layup repeats: |  |  | Inner skin thickness: | Typo | mm | N/A
 |  |  |  |  |  |  |  |  | Typo | Pa | N/A |  |  |  |  |  |  |  |  |  |  |  |  |  |  |  |  |  |  |  |  |  |  | Panel thickness: | #VALUE! | mm | N/A
 |  |  |  |  |  |  |  |  |  | 0.00% | N/A |  |  |  |  |  |  |  |  |  |  |  |  |  |  |  |  |  |  |  |  |  |  | Minimum Front View Measurement: |  | mm | N/A
 |  |  |  |  |  |  |  |  |  |  |  |  |  |  |  |  |  |  |  |  |  |  |  |  |  |  |  |  | OPTION - Second Moment, Surpassing Flat Panel, CLEAR CELLS IF NOT USED |  |  |  |  |  |  |  | N/A
 |  |  |  |  |  |  |  |  |  |  |  |  |  |  |  |  |  |  |  |  |  |  |  |  |  |  |  |  |  |  |  |  |  | Car centerline composite cross sectional area (skin only, no core): |  | mm^2 | N/A
 |  |  |  |  |  |  |  |  |  |  |  |  |  |  |  |  |  |  |  |  |  |  |  |  |  |  |  |  |  |  |  |  |  | Car centerline composite second moment (Izz): |  | mm^4 | N/A
 |  |  |  |  |  |  |  |  |  |  |  |  |  |  |  |  |  |  |  |  |  |  |  |  |  |  |  |  |  |  |  | 0 x Steel Tube |  | Flat h or L | Izz |  | N/A
 |  |  |  |  |  |  |  |  |  |  |  |  |  |  |  |  |  |  |  |  |  |  |  |  |  |  |  |  | F.3.4.1.a |  |  | Wall thickness: | 0.0024 | 0 | 0 | m | N/A
 |  |  |  |  |  |  |  |  |  |  |  |  |  |  |  |  |  |  |  |  |  |  |  |  |  |  |  |  |  |  |  | Outer Diameter / Panel Thickness: | 0.025 | #VALUE! | #VALUE! | m | N/A
 |  |  |  |  |  |  |  |  |  |  |  |  |  |  |  |  |  |  |  |  |  |  |  |  |  |  |  |  |  |  |  | Cross sectional area (A): | 0 | #VALUE! |  | m^2 | N/A
 |  |  |  |  |  |  |  |  |  |  |  |  |  |  |  |  |  |  |  |  |  |  |  |  |  |  |  |  |  |  |  | Second moment of inertia (I): | 0 |  |  | m^4 | N/A
 |  |  |  |  |  |  |  |  |  |  |  |  |  |  |  |  |  |  |  |  |  |  |  |  |  |  |  |  | F.3.4.2a |  |  | Young's Modulus (E): | 200000000000 | Layup | Layup | Pa | N/A
 |  |  |  |  |  |  |  |  |  |  |  |  |  |  |  |  |  |  |  |  |  |  |  |  |  |  |  |  |  |  |  | Ultimate Tensile Strength (S): | 365000000 | Name | Name | Pa | N/A
 |  |  |  |  |  |  |  |  |  |  |  |  |  |  |  |  |  |  |  |  |  |  |  |  |  |  |  |  |  |  |  | Shear: | 210605000 | Typo | Typo | Pa | N/A
 |  |  |  |  |  |  |  |  |  |  |  |  |  |  |  |  |  |  |  |  |  |  |  |  |  |  |  |  | Buckling Modulus |  |  | E_1*I_1 <= E_2*I_2: | 0 |  |  |  | N/A
 |  |  |  |  |  |  |  |  |  |  |  |  |  |  |  |  |  |  |  |  |  |  |  |  |  |  |  |  | UTS |  |  | S_1*A_1 <= S_2*A_2: | 0 |  |  |  | N/A
 |  |  |  |  |  |  |  |  |  |  |  |  |  |  |  |  |  |  |  |  |  |  |  |  |  |  |  |  | Bending |  |  | 4*S_1*I_1/r <= 4*S_2*I_2/r: | 0 |  |  |  | N/A
 |  |  |  |  |  |  |  |  |  |  |  |  |  |  |  |  |  |  |  |  |  |  |  |  |  |  |  |  | Deflection |  |  | Bending_1/(48*EI): | 0 |  |  |  | N/A
 |  |  |  |  |  |  |  |  |  |  |  |  |  |  |  |  |  |  |  |  |  |  |  |  |  |  |  |  | Energy |  |  | 0.5*Bending^2/(48*EI): | 0 |  |  |  | N/A
 |  |  |  |  |  |  |  |  |  |  |  |  |  |  |  |  |  |  |  |  |  |  |  |  |  |  |  |  |  | Flat Panel Properties |  |  | Flat Panel Properties |  |  | Flat Panel Properties
 |  |  |  |  |  |  |  |  |  |  |  |  |  |  |  |  |  |  |  |  |  |  |  |  |  |  |  |  | Outer (b) | 0 | m | A1 | #VALUE! | m^2 | I1 | #VALUE! | m^4
 |  |  |  |  |  |  |  |  |  |  |  |  |  |  |  |  |  |  |  |  |  |  |  |  |  |  |  |  | Outer (h) | #VALUE! | m | A2 | #VALUE! | m^2 | I2 | #VALUE! | m^4
 |  |  |  |  |  |  |  |  |  |  |  |  |  |  |  |  |  |  |  |  |  |  |  |  |  |  |  |  | Thickness | #VALUE! | m | y1 | #VALUE! | m | Ic1 |  | m^4
 |  |  |  |  |  |  |  |  |  |  |  |  |  |  |  |  |  |  |  |  |  |  |  |  |  |  |  |  | Inner (b) | 0 | m | y2 | #VALUE! | m | Ic2 |  | m^4
 |  |  |  |  |  |  |  |  |  |  |  |  |  |  |  |  |  |  |  |  |  |  |  |  |  |  |  |  | Inner (h) | #VALUE! | m | Centroid |  | m | Ic12 |  | m^4

Sheet: F.3.4.3 Welded Inserts
BLANK
Any removable members along required tubes?
 | Tube Chassis BO133: | 0
BLANK
Any holes over 4mm drilled in F.3.2.1 required tubes?
 | Tube Chassis BO134: | 0
 | AIP Inserts: | No
 | EV Accumulator: | No
BLANK |  |  | Welded Tube Insert with dimensions. |  |  |  |  |  |  |  | Welded Tube Insert with dimensions. |  |  |  |  |  |  |  | Welded Tube Insert with dimensions. |  |  |  |  |  |  |  | Welded Tube Insert with dimensions. |  |  |  |  |  |  |  | Welded Tube Insert with dimensions.
Does the steering rack interrupt any required tubes?
 | Tube Chassis BO135: | 0
BLANK
mm
 |  |  | Please show the source of each area and MOI measurement. |  |  |  |  |  |  |  | Please show the source of each area and MOI measurement. |  |  |  |  |  |  |  | Please show the source of each area and MOI measurement. |  |  |  |  |  |  |  | Please show the source of each area and MOI measurement. |  |  |  |  |  |  |  | Please show the source of each area and MOI measurement.
 |  |  | If additional images are necessary, they may be placed below each section. |  |  |  |  |  |  |  | If additional images are necessary, they may be placed below each section. |  |  |  |  |  |  |  | If additional images are necessary, they may be placed below each section. |  |  |  |  |  |  |  | If additional images are necessary, they may be placed below each section. |  |  |  |  |  |  |  | If additional images are necessary, they may be placed below each section.
 |  |  | EQ |  | Welded Tube Insert |  |  |  |  |  | EQ |  | Welded Tube Insert |  |  |  |  |  | EQ |  | Welded Tube Insert |  |  |  |  |  | EQ |  | Welded Tube Insert |  |  |  |  |  | EQ |  | Welded Tube Insert
Unwelded E, Sy, Su
Steel | 6061-T6 | Other AL | Note: Young's Modulus is given in MPa, not Gpa. |  |  |  |  |  |  |  | Note: Young's Modulus is given in MPa, not Gpa. |  |  |  |  |  |  |  | Note: Young's Modulus is given in MPa, not Gpa. |  |  |  |  |  |  |  | Note: Young's Modulus is given in MPa, not Gpa. |  |  |  |  |  |  |  | Note: Young's Modulus is given in MPa, not Gpa.
200000000000 | 69000000000 |  | EQ |  |  |  |  |  |  |  | EQ |  |  |  |  |  |  |  | EQ |  |  |  |  |  |  |  | EQ |  |  |  |  |  |  |  | EQ
305000000 | 240000000 |  |  |  |  |  | Minimum | Tube With Hole |  | N/A |  |  |  |  | Minimum | Tube With Hole |  | N/A |  |  |  |  | Minimum | Tube With Hole |  | N/A |  |  |  |  | Minimum | Tube With Hole |  | N/A |  |  |  |  | Minimum | Tube With Hole |  | N/A
365000000 | 290000000 |  |  |  |  |  | F.3.2.1 | + |  | N/A |  |  |  |  | F.3.2.1 | + |  | N/A |  |  |  |  | F.3.2.1 | + |  | N/A |  |  |  |  | F.3.2.1 | + |  | N/A |  |  |  |  | F.3.2.1 | + |  | N/A
Welded Sy, Su |  |  |  |  |  |  | Tube | Insert |  | N/A |  |  |  |  | Tube | Insert |  | N/A |  |  |  |  | Tube | Insert |  | N/A |  |  |  |  | Tube | Insert |  | N/A |  |  |  |  | Tube | Insert |  | N/A
Steel | 6061-T6 | Other AL |  |  |  | Material: | Steel | Steel |  | N/A |  |  |  | Material: | Steel | Steel |  | N/A |  |  |  | Material: | Steel | Steel |  | N/A |  |  |  | Material: | Steel | Steel |  | N/A |  |  |  | Material: | Steel | Steel |  | N/A
180000000 | 115000000 |  |  |  |  | Original tube: | Size A | Round |  | N/A |  |  |  | Original tube: | Size A | Round |  | N/A |  |  |  | Original tube: | Size A | Round |  | N/A |  |  |  | Original tube: | Size A | Round |  | N/A |  |  |  | Original tube: | Size A | Round |  | N/A
300000000 | 175000000 |  | F.3.4.1 |  |  | Wall thickness: | 2 |  | mm | N/A | F.3.4.1 |  |  | Wall thickness: | 2 |  | mm | N/A | F.3.4.1 |  |  | Wall thickness: | 2 |  | mm | N/A | F.3.4.1 |  |  | Wall thickness: | 2 |  | mm | N/A | F.3.4.1 |  |  | Wall thickness: | 2 |  | mm | N/A
 |  |  |  |  |  | Outer Diameter: | 25 |  | mm | N/A |  |  |  | Outer Diameter: | 25 |  | mm | N/A |  |  |  | Outer Diameter: | 25 |  | mm | N/A |  |  |  | Outer Diameter: | 25 |  | mm | N/A |  |  |  | Outer Diameter: | 25 |  | mm | N/A
 |  |  |  |  |  | Tube cross sectional area (A_1): | 173 | - | mm^2 | N/A |  |  |  | Tube cross sectional area (A_1): | 173 | - | mm^2 | N/A |  |  |  | Tube cross sectional area (A_1): | 173 | - | mm^2 | N/A |  |  |  | Tube cross sectional area (A_1): | 173 | - | mm^2 | N/A |  |  |  | Tube cross sectional area (A_1): | 173 | - | mm^2 | N/A
For EQ: All entries filled out correctly. -or- No holes over 4mm: Clear all entry boxes. Identical tube / insert combinations need to be identified everywhere used on the chassis, but only need to be calculated once. If more than 5 tube / insert combinations are used, make a copy of this tab. Oversized tubes with holes may not need inserts for EQ. |  |  |  |  |  | Tube second moment of inertia (I_1): | 11320 | - | mm^4 | N/A |  |  |  | Tube second moment of inertia (I_1): | 11320 | - | mm^4 | N/A |  |  |  | Tube second moment of inertia (I_1): | 11320 | - | mm^4 | N/A |  |  |  | Tube second moment of inertia (I_1): | 11320 | - | mm^4 | N/A |  |  |  | Tube second moment of inertia (I_1): | 11320 | - | mm^4 | N/A
 |  |  | F.3.4.3 |  |  |  | Tube with Hole cross sectional area (A_3): |  | mm^2 | N/A | F.3.4.3 |  |  |  | Tube with Hole cross sectional area (A_3): |  | mm^2 | N/A | F.3.4.3 |  |  |  | Tube with Hole cross sectional area (A_3): |  | mm^2 | N/A | F.3.4.3 |  |  |  | Tube with Hole cross sectional area (A_3): |  | mm^2 | N/A | F.3.4.3 |  |  |  | Tube with Hole cross sectional area (A_3): |  | mm^2 | N/A
 |  |  |  |  |  |  | Tube with Hole second moment of inertia (I_3): |  | mm^4 | N/A |  |  |  |  | Tube with Hole second moment of inertia (I_3): |  | mm^4 | N/A |  |  |  |  | Tube with Hole second moment of inertia (I_3): |  | mm^4 | N/A |  |  |  |  | Tube with Hole second moment of inertia (I_3): |  | mm^4 | N/A |  |  |  |  | Tube with Hole second moment of inertia (I_3): |  | mm^4 | N/A
 |  |  |  |  |  |  | Insert/Collar cross sectional area (A_2): |  | mm^2 | N/A |  |  |  |  | Insert/Collar cross sectional area (A_2): |  | mm^2 | N/A |  |  |  |  | Insert/Collar cross sectional area (A_2): |  | mm^2 | N/A |  |  |  |  | Insert/Collar cross sectional area (A_2): |  | mm^2 | N/A |  |  |  |  | Insert/Collar cross sectional area (A_2): |  | mm^2 | N/A
 |  |  |  |  |  |  | Insert/Collar second moment of inertia (I_2): |  | mm^4 | N/A |  |  |  |  | Insert/Collar second moment of inertia (I_2): |  | mm^4 | N/A |  |  |  |  | Insert/Collar second moment of inertia (I_2): |  | mm^4 | N/A |  |  |  |  | Insert/Collar second moment of inertia (I_2): |  | mm^4 | N/A |  |  |  |  | Insert/Collar second moment of inertia (I_2): |  | mm^4 | N/A
 |  |  | F.3.4.2 | F.3.5.3 |  | Young's Modulus (E): | 200000000000 | 200000000000 | Pa | N/A | F.3.4.2 | F.3.5.3 |  | Young's Modulus (E): | 200000000000 | 200000000000 | Pa | N/A | F.3.4.2 | F.3.5.3 |  | Young's Modulus (E): | 200000000000 | 200000000000 | Pa | N/A | F.3.4.2 | F.3.5.3 |  | Young's Modulus (E): | 200000000000 | 200000000000 | Pa | N/A | F.3.4.2 | F.3.5.3 |  | Young's Modulus (E): | 200000000000 | 200000000000 | Pa | N/A
 |  |  |  |  |  | Unwelded Yield Strength (Sy): | 305000000 | 305000000 | Pa | N/A |  |  |  | Unwelded Yield Strength (Sy): | 305000000 | 305000000 | Pa | N/A |  |  |  | Unwelded Yield Strength (Sy): | 305000000 | 305000000 | Pa | N/A |  |  |  | Unwelded Yield Strength (Sy): | 305000000 | 305000000 | Pa | N/A |  |  |  | Unwelded Yield Strength (Sy): | 305000000 | 305000000 | Pa | N/A
 |  |  |  |  |  | Unwelded Ultimate Strength (Su): | 365000000 | 365000000 | Pa | N/A |  |  |  | Unwelded Ultimate Strength (Su): | 365000000 | 365000000 | Pa | N/A |  |  |  | Unwelded Ultimate Strength (Su): | 365000000 | 365000000 | Pa | N/A |  |  |  | Unwelded Ultimate Strength (Su): | 365000000 | 365000000 | Pa | N/A |  |  |  | Unwelded Ultimate Strength (Su): | 365000000 | 365000000 | Pa | N/A
 |  |  |  |  |  | Welded Yield Strength (Sy): | N/A | 180000000 | Pa | N/A |  |  |  | Welded Yield Strength (Sy): | N/A | 180000000 | Pa | N/A |  |  |  | Welded Yield Strength (Sy): | N/A | 180000000 | Pa | N/A |  |  |  | Welded Yield Strength (Sy): | N/A | 180000000 | Pa | N/A |  |  |  | Welded Yield Strength (Sy): | N/A | 180000000 | Pa | N/A
 |  |  |  |  |  | Welded Ultimate Strength (Su): | N/A | 300000000 | Pa | N/A |  |  |  | Welded Ultimate Strength (Su): | N/A | 300000000 | Pa | N/A |  |  |  | Welded Ultimate Strength (Su): | N/A | 300000000 | Pa | N/A |  |  |  | Welded Ultimate Strength (Su): | N/A | 300000000 | Pa | N/A |  |  |  | Welded Ultimate Strength (Su): | N/A | 300000000 | Pa | N/A
 |  |  | Buckling Modulus |  |  | E_1*I_1 <= E_2*I_2 + E_1*I_3: |  |  |  | N/A | Buckling Modulus |  |  | E_1*I_1 <= E_2*I_2 + E_1*I_3: |  |  |  | N/A | Buckling Modulus |  |  | E_1*I_1 <= E_2*I_2 + E_1*I_3: |  |  |  | N/A | Buckling Modulus |  |  | E_1*I_1 <= E_2*I_2 + E_1*I_3: |  |  |  | N/A | Buckling Modulus |  |  | E_1*I_1 <= E_2*I_2 + E_1*I_3: |  |  |  | N/A
 |  |  | Yield |  |  | Sy_1*A_1 <= Sy_2*A_2 + Sy_1*A_3: |  |  |  | N/A | Yield |  |  | Sy_1*A_1 <= Sy_2*A_2 + Sy_1*A_3: |  |  |  | N/A | Yield |  |  | Sy_1*A_1 <= Sy_2*A_2 + Sy_1*A_3: |  |  |  | N/A | Yield |  |  | Sy_1*A_1 <= Sy_2*A_2 + Sy_1*A_3: |  |  |  | N/A | Yield |  |  | Sy_1*A_1 <= Sy_2*A_2 + Sy_1*A_3: |  |  |  | N/A
 |  |  | Ultimate |  |  | Su_1*A_1 <= Su_2*A_2 + Su_1*A_3: |  |  |  | N/A | Ultimate |  |  | Su_1*A_1 <= Su_2*A_2 + Su_1*A_3: |  |  |  | N/A | Ultimate |  |  | Su_1*A_1 <= Su_2*A_2 + Su_1*A_3: |  |  |  | N/A | Ultimate |  |  | Su_1*A_1 <= Su_2*A_2 + Su_1*A_3: |  |  |  | N/A | Ultimate |  |  | Su_1*A_1 <= Su_2*A_2 + Su_1*A_3: |  |  |  | N/A
 |  |  | Bending |  |  | 4*Su_1*I_1/r <= 4*(Su_2*I_2+Su_1*I_3)/r: |  |  |  | N/A | Bending |  |  | 4*Su_1*I_1/r <= 4*Su_1*(I_2+I_3)/r: |  |  |  | N/A | Bending |  |  | 4*Su_1*I_1/r <= 4*Su_1*(I_2+I_3)/r: |  |  |  | N/A | Bending |  |  | 4*Su_1*I_1/r <= 4*Su_1*(I_2+I_3)/r: |  |  |  | N/A | Bending |  |  | 4*Su_1*I_1/r <= 4*Su_1*(I_2+I_3)/r: |  |  |  | N/A
 |  |  | Deflection |  |  | Bending_1/(48*EI): |  |  |  | N/A | Deflection |  |  | Bending_1/(48*EI): |  |  |  | N/A | Deflection |  |  | Bending_1/(48*EI): |  |  |  | N/A | Deflection |  |  | Bending_1/(48*EI): |  |  |  | N/A | Deflection |  |  | Bending_1/(48*EI): |  |  |  | N/A
 |  |  | Energy |  |  | 0.5*Bending^2/(48*EI): |  |  |  | N/A | Energy |  |  | 0.5*Bending^2/(48*EI): |  |  |  | N/A | Energy |  |  | 0.5*Bending^2/(48*EI): |  |  |  | N/A | Energy |  |  | 0.5*Bending^2/(48*EI): |  |  |  | N/A | Energy |  |  | 0.5*Bending^2/(48*EI): |  |  |  | N/A

Sheet: F.5.12 Bolted Members
BLANK
Bolted Members Used?
 | Tube Chassis BO133: | 0
For EQ: All entries filled out correctly. - or if not used: 1. Bolted Connection set to "Select drop down." 2. Clear lug thickness box. Symmetric left / right attachments only need to be entered for one side. If more than 5 non-symmetric bolted connections are used, make a copy of this tab.
 |  |  | Bolted Chassis Connection with dimensions. |  |  |  |  |  |  | Bolted Chassis Connection with dimensions. |  |  |  |  |  |  | Bolted Chassis Connection with dimensions. |  |  |  |  |  |  | Bolted Chassis Connection with dimensions. |  |  |  |  |  |  | Bolted Chassis Connection with dimensions.
Removable tubes require
welded inserts to prevent
crushing.
mm
BLANK
 |  |  | If additional images are necessary, they may be placed below each section. |  |  |  |  |  |  | If additional images are necessary, they may be placed below each section. |  |  |  |  |  |  | If additional images are necessary, they may be placed below each section. |  |  |  |  |  |  | If additional images are necessary, they may be placed below each section. |  |  |  |  |  |  | If additional images are necessary, they may be placed below each section.
 |  |  | EQ |  | Bolted Connection |  |  |  |  | EQ |  | Bolted Connection |  |  |  |  | EQ |  | Bolted Connection |  |  |  |  | EQ |  | Bolted Connection |  |  |  |  | EQ |  | Bolted Connection
 |  |  | EQ |  |  |  |  |  |  | EQ |  |  |  |  |  |  | EQ |  |  |  |  |  |  | EQ |  |  |  |  |  |  | EQ
 |  |  | F.5.12.2 |  |  | Bolted Connection: | Select drop down: |  | EQ | F.5.12.2 |  |  | Bolted Connection: | Select drop down: |  | EQ | F.5.12.2 |  |  | Bolted Connection: | Select drop down: |  | EQ | F.5.12.2 |  |  | Bolted Connection: | Select drop down: |  | EQ | F.5.12.2 |  |  | Bolted Connection: | Select drop down: |  | EQ
 |  |  | F.5.3.1 | All fasteners for removable tubing require crush bushings through the tubes. |  |  |  |  |  | F.5.3.1 | All fasteners for removable tubing require crush bushings through the tubes. |  |  |  |  |  | F.5.3.1 | All fasteners for removable tubing require crush bushings through the tubes. |  |  |  |  |  | F.5.3.1 | All fasteners for removable tubing require crush bushings through the tubes. |  |  |  |  |  | F.5.3.1 | All fasteners for removable tubing require crush bushings through the tubes.
 |  |  |  | Inserts are not mandatory for outside sleeves and lugs for removable tubing. |  |  |  |  |  |  | Inserts are not mandatory for outside sleeves and lugs for removable tubing. |  |  |  |  |  |  | Inserts are not mandatory for outside sleeves and lugs for removable tubing. |  |  |  |  |  |  | Inserts are not mandatory for outside sleeves and lugs for removable tubing. |  |  |  |  |  |  | Inserts are not mandatory for outside sleeves and lugs for removable tubing.
 |  |  | F.5.12.4 | Double lug joints must include caps on tabs at both ends. |  |  |  |  |  | F.5.12.4 | Double lug joints must include caps on tabs at both ends. |  |  |  |  |  | F.5.12.4 | Double lug joints must include caps on tabs at both ends. |  |  |  |  |  | F.5.12.4 | Double lug joints must include caps on tabs at both ends. |  |  |  |  |  | F.5.12.4 | Double lug joints must include caps on tabs at both ends.
 |  |  | EQ |  |  |  |  |  |  | EQ |  |  |  |  |  |  | EQ |  |  |  |  |  |  | EQ |  |  |  |  |  |  | EQ
 |  |  | F.5.12.3.a |  |  | Lug thickness >= 4.5mm (0.177in) steel: |  | mm | N/A | F.5.12.3.a |  |  | Lug thickness >= 4.5mm (0.177in) steel: |  | mm | N/A | F.5.12.3.a |  |  | Lug thickness >= 4.5mm (0.177in) steel: |  | mm | N/A | F.5.12.3.a |  |  | Lug thickness >= 4.5mm (0.177in) steel: |  | mm | N/A | F.5.12.3.a |  |  | Lug thickness >= 4.5mm (0.177in) steel: |  | mm | N/A
 |  |  | F.5.12.3.b |  |  | Perpendicular dimension >=25mm (1in): |  | mm | N/A | F.5.12.3.b |  |  | Perpendicular dimension >=25mm (1in): |  | mm | N/A | F.5.12.3.b |  |  | Perpendicular dimension >=25mm (1in): |  | mm | N/A | F.5.12.3.b |  |  | Perpendicular dimension >=25mm (1in): |  | mm | N/A | F.5.12.3.b |  |  | Perpendicular dimension >=25mm (1in): |  | mm | N/A
 |  |  | F.5.12.5 | Double lug joints require a pin or fastener >= 10mm Grade 9.8 (3/8in Grade 8). |  |  |  |  |  | F.5.12.5 | Double lug joints require a pin or fastener >= 10mm Grade 9.8 (3/8in Grade 8). |  |  |  |  |  | F.5.12.5 | Double lug joints require a pin or fastener >= 10mm Grade 9.8 (3/8in Grade 8). |  |  |  |  |  | F.5.12.5 | Double lug joints require a pin or fastener >= 10mm Grade 9.8 (3/8in Grade 8). |  |  |  |  |  | F.5.12.5 | Double lug joints require a pin or fastener >= 10mm Grade 9.8 (3/8in Grade 8).
 |  |  | F.5.12.7 | Sleeved butt joints require 4X pins or fasteners >= 6mm Grade 9.8 (1/4in Grade 8). |  |  |  |  |  | F.5.12.7 | Sleeved butt joints require 4X pins or fasteners >= 6mm Grade 9.8 (1/4in Grade 8). |  |  |  |  |  | F.5.12.7 | Sleeved butt joints require 4X pins or fasteners >= 6mm Grade 9.8 (1/4in Grade 8). |  |  |  |  |  | F.5.12.7 | Sleeved butt joints require 4X pins or fasteners >= 6mm Grade 9.8 (1/4in Grade 8). |  |  |  |  |  | F.5.12.7 | Sleeved butt joints require 4X pins or fasteners >= 6mm Grade 9.8 (1/4in Grade 8).
 |  |  | F.5.4.3 | Any bolted non-suspension member must have an edge::distance ratio >=1.5. |  |  |  |  |  | F.5.4.3 | Any bolted non-suspension member must have an edge::distance ratio >=1.5. |  |  |  |  |  | F.5.4.3 | Any bolted non-suspension member must have an edge::distance ratio >=1.5. |  |  |  |  |  | F.5.4.3 | Any bolted non-suspension member must have an edge::distance ratio >=1.5. |  |  |  |  |  | F.5.4.3 | Any bolted non-suspension member must have an edge::distance ratio >=1.5.
 |  |  | Dimensions shown above from the edges of the holes to the end of each tube/tab >=1.5 x diameter. |  |  |  |  |  |  | Dimensions shown above from the edges of the holes to the end of each tube/tab >=1.5 x diameter. |  |  |  |  |  |  | Dimensions shown above from the edges of the holes to the end of each tube/tab >=1.5 x diameter. |  |  |  |  |  |  | Dimensions shown above from the edges of the holes to the end of each tube/tab >=1.5 x diameter. |  |  |  |  |  |  | Dimensions shown above from the edges of the holes to the end of each tube/tab >=1.5 x diameter.
 |  |  | EQ |  |  |  |  |  |  | EQ |  |  |  |  |  |  | EQ |  |  |  |  |  |  | EQ |  |  |  |  |  |  | EQ
 |  |  | F.5.4.3 |  |  | Hole diameter / fastener size: |  | mm | N/A | F.5.4.3 |  |  | Hole diameter / fastener size: |  | mm | N/A | F.5.4.3 |  |  | Hole diameter / fastener size: |  | mm | N/A | F.5.4.3 |  |  | Hole diameter / fastener size: |  | mm | N/A | F.5.4.3 |  |  | Hole diameter / fastener size: |  | mm | N/A
 |  |  |  |  |  | Distance to tube edge: |  | mm | N/A |  |  |  | Distance to tube edge: |  | mm | N/A |  |  |  | Distance to tube edge: |  | mm | N/A |  |  |  | Distance to tube edge: |  | mm | N/A |  |  |  | Distance to tube edge: |  | mm | N/A
 |  |  |  |  |  | Distance to tab edge: |  | mm | N/A |  |  |  | Distance to tab edge: |  | mm | N/A |  |  |  | Distance to tab edge: |  | mm | N/A |  |  |  | Distance to tab edge: |  | mm | N/A |  |  |  | Distance to tab edge: |  | mm | N/A
 |  |  |  |  |  | Minimum edge::diameter ratio >=1.5: |  |  | N/A |  |  |  | Minimum edge::diameter ratio >=1.5: |  |  | N/A |  |  |  | Minimum edge::diameter ratio >=1.5: |  |  | N/A |  |  |  | Minimum edge::diameter ratio >=1.5: |  |  | N/A |  |  |  | Minimum edge::diameter ratio >=1.5: |  |  | N/A
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
