EOSCogniton/ELIZ-2022/02 - Documentation/CHASEA/La Mache laser/Liste chapes 2022_2023.xlsx

La Mache Laser
S235 - 1.5 mm
Name | Sous-éléments | Nomenclature | Qté | Statut | Période - Start | Période - End | Fichier
AIP |  | FR_05002 | 2 | Terminé |  |  | https://drive.google.com/file/d/1mgDKUhgX8HdMQpPxSsuRATmosTX9usuR/view?usp=drive_web, https://drive.google.com/file/d/1kKrY74HO-IjRVh01ld6oho0CDZ6g7Zk-/view?usp=drive_web
chape carrosserie |  |  | 8 | Terminé |  |  | https://drive.google.com/file/d/1YTTbxxSEKS5O6CXdRYAwWUnV632vPv6c/view?usp=drive_web, https://drive.google.com/file/d/1oXXv-mznuIGHsoNG-9NbW1XnOMZV2Ell/view?usp=drive_web
Chape TdB haut |  | EL_04009 | 1 | Terminé | 2022-11-18 | 2022-11-24 | https://epsa2021.monday.com/protected_static/5873723/resources/667630466/EL_04009(Half%20Bent%20Centre%20Left%20Bracket).stp, https://epsa2021.monday.com/protected_static/5873723/resources/667645175/EL_04009%20(Chape%20TdB%20haut).pdf
Chape TdB gauche |  | EL_04012 | 1 | Terminé | 2022-11-18 | 2022-11-24 | https://epsa2021.monday.com/protected_static/5873723/resources/667630834/EL_04012(Fully%20Bent%20Left%20Bracket).stp, https://epsa2021.monday.com/protected_static/5873723/resources/667645584/EL_04012%20(Chape%20TdB%20gauche).pdf
Chape TdB droite |  | EL_04008 | 1 | Terminé | 2022-11-18 | 2022-11-24 | https://epsa2021.monday.com/protected_static/5873723/resources/667631172/EL_04008(Fully%20Bent%20Right%20Bracket).stp, https://epsa2021.monday.com/protected_static/5873723/resources/667645944/EL_04008%20(Chape%20TdB%20droite).pdf
Support HVD |  | EL_06008 | 2 | Terminé | 2022-11-18 | 2022-12-01 | https://epsa2021.monday.com/protected_static/5873723/resources/669038878/EL_06008%20Support%20HVD.pdf, https://epsa2021.monday.com/protected_static/5873723/resources/669040032/EL_06008%20SUpport%20HVD.dxf
Chape Inertia Switch |  | EL_12002 | 1 | Terminé | 2022-11-18 | 2022-11-24 | https://epsa2021.monday.com/protected_static/5873723/resources/669038733/EL_12002%20Chape%20Inertia%20Switch.pdf, https://epsa2021.monday.com/protected_static/5873723/resources/669040140/EL_12002%20Chape%20Inertia%20Switch.dxf
Chape support MS |  | EL_06010 | 4 | Terminé | 2022-11-18 | 2022-11-24 | https://epsa2021.monday.com/protected_static/5873723/resources/669047195/EL_06010.pdf, https://epsa2021.monday.com/protected_static/5873723/resources/669047197/EL_06010.dxf
Chape Brake Light |  | EL_A1102 | 2 | Terminé | 2022-11-18 | 2022-12-01 | https://epsa2021.monday.com/protected_static/5873723/resources/671051084/EL_A1102%20(Chape%20brake%20light).stp, https://epsa2021.monday.com/protected_static/5873723/resources/671051082/EL_A1102%20Chape%20Brake%20Light.pdf
Frame brake |  | FR_04001_1 |  | Terminé | 2023-01-18 | 2023-01-31 | https://epsa2021.monday.com/protected_static/5873723/resources/734530659/FR_10001_1%20(Frame%20Brake).stp, https://epsa2021.monday.com/protected_static/5873723/resources/734530658/FR_10001_1%20(Frame%20Brake).pdf
Frame brake |  | FR_04001_2 |  | Terminé | 2023-01-18 | 2023-01-31 | https://epsa2021.monday.com/protected_static/5873723/resources/734531184/FR_10001_2%20(Frame%20Brake).pdf, https://epsa2021.monday.com/protected_static/5873723/resources/734531197/FR_10001_2%20(Frame%20Brake).stp
Frame Brake |  | FR_04001_3 |  | Terminé | 2023-01-18 | 2023-01-31 | https://epsa2021.monday.com/protected_static/5873723/resources/734547952/FR_10001_3%20(Frame%20Brake).stp, https://epsa2021.monday.com/protected_static/5873723/resources/734547946/FR_10001_3%20(Frame%20Brake).pdf
Frame Brake |  | FR_04001_5 |  | Terminé | 2023-01-18 | 2023-01-31 | https://epsa2021.monday.com/protected_static/5873723/resources/734548140/FR_10001_5%20(Frame%20Brake).pdf, https://epsa2021.monday.com/protected_static/5873723/resources/734548141/FR_10001_5%20(Frame%20Brake).stp
Frame Brake |  | FR_04001_6 |  | Terminé | 2023-01-18 | 2023-01-31 | https://epsa2021.monday.com/protected_static/5873723/resources/734551769/FR_10001_6%20(Frame%20Brake).pdf, https://epsa2021.monday.com/protected_static/5873723/resources/734551770/FR_10001_6%20(Frame%20Brake).stp
Frame Brake |  | FR_04001_7 |  | Terminé | 2023-01-18 | 2023-01-31 | https://epsa2021.monday.com/protected_static/5873723/resources/734548354/FR_10001_7%20(Frame%20Brake).pdf, https://epsa2021.monday.com/protected_static/5873723/resources/734548358/FR_10001_7%20(Frame%20Brake).stp
Frame Brake |  | FR_04001_9 |  | Terminé | 2023-01-18 | 2023-01-31 | https://epsa2021.monday.com/protected_static/5873723/resources/734552418/FR_10001_9%20(Frame%20Brake).stp, https://epsa2021.monday.com/protected_static/5873723/resources/734552411/FR_10001_9%20(Frame%20Brake).pdf
Frame Brake |  | FR_04001_10 |  | Terminé | 2023-01-18 | 2023-01-31 | https://epsa2021.monday.com/protected_static/5873723/resources/734553035/FR_10001_10%20(Frame%20Brake).pdf, https://epsa2021.monday.com/protected_static/5873723/resources/734553036/FR_10001_10%20(Frame%20Brake).stp
Frame Brake |  | FR_04001_11 |  | Terminé | 2023-01-18 | 2023-01-31 | https://epsa2021.monday.com/protected_static/5873723/resources/734553214/FR_10001_11%20(Frame%20Brake).stp, https://epsa2021.monday.com/protected_static/5873723/resources/734553215/FR_10001_11%20(Frame%20Brake).pdf
 |  |  |  |  | 2022-11-18 | 2023-01-31
S700 - 4mm
Name | Sous-éléments | Nomenclature | Qté | Statut | Période - Start | Période - End | Fichier
BOTS Support |  | FR_04013 | 1 |  | 2023-01-18 | 2023-01-31 | https://epsa2021.monday.com/protected_static/5873723/resources/741301289/FR_04013%20(BOTS%20Support).stp, https://epsa2021.monday.com/protected_static/5873723/resources/741301290/FR_04013%20BOTS%20Support.pdf
 |  |  |  |  | 2023-01-18 | 2023-01-31
Alu - 2 mm
Name | Sous-éléments | Nomenclature | Qté | Statut | Période - Start | Période - End | Fichier
Footrest |  | FR_03002 | 4 | Terminé | 2022-09-27 | 2022-10-11 | https://epsa2021.monday.com/protected_static/5873723/resources/628721135/FR_03002%20(Footrest).pdf, https://epsa2021.monday.com/protected_static/5873723/resources/628721755/FR_03002%20(Footrest).stp
Front Plate |  | FR_06001 | 1 | Terminé |  |  | https://drive.google.com/file/d/1gdG0RZsazcOVjL5bB0p78RQ8_rH2tTNQ/view?usp=drive_web, https://drive.google.com/file/d/1SMnlMpLHBaFuwaHae4S8XZMFcI29uYIz/view?usp=drive_web
Cockpit Plate |  | FR_06002 | 1 | Terminé |  |  | https://drive.google.com/file/d/1L5SFTWh88-T4Qf1TLbrZdCOqPOMnzkH9/view?usp=drive_web, https://drive.google.com/file/d/1XWGITwCieevJLEAVdmY48Oiw6__TtCTU/view?usp=drive_web
Camber shim |  | Su_11003 | 20 | Terminé |  |  | https://drive.google.com/file/d/1xrc_RhR6yIOxhZ4OTrsKw6MEDzIouHWH/view?usp=drive_web, https://drive.google.com/file/d/18151n_zTcs1YH8rCgDH9Gkqu9XKNZ5R5/view?usp=drive_web, https://drive.google.com/file/d/1_beoZDsagy3wfZtkiKr_8_PV6wXK2SGc/view?usp=drive_web
 |  |  |  |  | 2022-09-27 | 2022-10-11
Alu - 1 mm
Name | Sous-éléments | Nomenclature | Qté | Statut | Période - Start | Période - End | Fichier
Camber shim |  | SU_11004 | 12 | Terminé |  |  | https://drive.google.com/file/d/12ZroSjKGY52JCiDmU7cRR35_1yiM5u18/view?usp=drive_web, https://drive.google.com/file/d/1psGEuIrnvUZh06-oHuCaOk8_QXlvmUo0/view?usp=drive_web, https://drive.google.com/file/d/13_a624GlXCy4hv-k8Jg_jneloi_kS4_t/view?usp=drive_web
S355 - 3 mm
Name | Sous-éléments | Nomenclature | Qté | Statut | Période - Start | Période - End | Fichier
Negative Throttle Mechanical Stop |  | FR_03008 | 2 | Terminé |  |  | https://drive.google.com/file/d/1DvtiSImicr_ZEm6FXt0C9sQ6r02H3DoV/view?usp=drive_web, https://drive.google.com/file/d/1HN34TYATs70ayoMkOKoZHFgFKvqWghCr/view?usp=drive_web
Positive Throttle Mechanical Stop |  | FR_03009 | 2 | Terminé |  |  | https://drive.google.com/file/d/1dQv7-THGC19ynxLM2PsDrcG1z9o5MXqp/view?usp=drive_web, https://drive.google.com/file/d/188YM9FOOks8n9H2Y9z8DyIUEA1UywUtM/view?usp=drive_web
chape LV |  |  | 8 | Terminé |  |  | https://drive.google.com/file/d/1rxW70QLZHPuYEkNkQbXqT31JYDySxM2_/view?usp=drive_web, https://drive.google.com/file/d/10XCHewYKWRCFT2LbSHuOR1c_e0KYKuJk/view?usp=drive_web
Blade link |  | SU_14006 | 4 | Terminé |  |  | https://drive.google.com/file/d/1sJ8y9NduqsjvT7UuqQs-OPgK0Zc9F2kA/view?usp=drive_web, https://drive.google.com/file/d/15OrhD4iWhIdJgwniXaia2X9AC5vZ1BNh/view?usp=drive_web, https://drive.google.com/file/d/1O35uMtdbDPx37wAG5iyEJknUSqho28db/view?usp=drive_web
Plaque direction |  | ST_06008 | 2 | Terminé |  |  | https://drive.google.com/file/d/1W-OYyXGAh87F5nGVz3RvpTrZhqRMKBF8/view?usp=drive_web, https://drive.google.com/file/d/1IRk8fY88xFtk3aUj25EFfTAndYAn-sHR/view?usp=drive_web, https://drive.google.com/file/d/1kKeCRyhTmG7YxDD5iuapgYwmbPOKNE80/view?usp=drive_web
Right bracket (support direction) |  | ST_04003 | 1 | Terminé | 2022-10-21 | 2022-11-08 | https://drive.google.com/file/d/1ECZ-X1iGjCoxqY3GOBhtIYII8gsrqYkB/view?usp=drive_web, https://drive.google.com/file/d/15dgFSQ_hi_LdksS8mPM_N1kCYoFdO6ik/view?usp=drive_web, https://drive.google.com/file/d/1d5I2l-teVmgZ0Y1AYvaP7EV8zcQNQg_T/view?usp=drive_web
Left Bracket (support direction) |  | ST_04003.1 | 1 | Terminé | 2022-10-21 | 2022-11-08 | https://drive.google.com/file/d/168lPnAmvrxvzDKud7-1P-SOKFZmIUR5m/view?usp=drive_web, https://drive.google.com/file/d/1WdpRVobaAiMNCyNVgiBkdIaAacWeaeKq/view?usp=drive_web, https://drive.google.com/file/d/1cGfwyyErw4DB7TlSvMPyJ9j2gv80xQGD/view?usp=drive_web
Chape_Fw_Ua_Rp_Up |  |  | 2 | Terminé | 2022-10-27 | 2022-10-27 | https://drive.google.com/file/d/1O0tiIvrZtdsq2ytgn6_b0MG3AvzFTsHE/view?usp=drive_web, https://drive.google.com/file/d/1SCAjNgAC0s7D4gc6FWRP4Li-hubU2SDC/view?usp=drive_web, https://drive.google.com/file/d/1EU2QTUfarA3iUd7Y1SXwBhKg98NOZUUg/view?usp=drive_web
Chape_Fw_Ua_Fp_Low |  |  | 2 | Terminé | 2022-10-27 | 2022-10-27 | https://drive.google.com/file/d/1VqQwmTOX0d5aZaB4kSWaYBArGKklZ0_b/view?usp=drive_web, https://drive.google.com/file/d/15By91V8wEL9GxjaxIBuuZwIVbEyAlcnI/view?usp=drive_web, https://drive.google.com/file/d/19d1NE851gAgowvlRNVccCN-mxgUtu0nQ/view?usp=drive_web
Chape_Fw_Ra_Rp_Low |  |  | 2 | Terminé | 2022-10-27 | 2022-10-27 | https://drive.google.com/file/d/1mJeDPLEW4ty3JM1QwgV96b5CWRRP0Per/view?usp=drive_web, https://drive.google.com/file/d/1mbaWlTMoa0WnFYfRkSz1xDyvEKlqcQAh/view?usp=drive_web, https://drive.google.com/file/d/1mUsgWdt_HbKq7pvZMu-yfRvdpjpLylGk/view?usp=drive_web
Chape_Fw_La_Rp_Up |  |  | 2 | Terminé | 2022-10-27 | 2022-10-27 | https://drive.google.com/file/d/1ObI2mSD5ayY7Kw5FWNbx76N31V8l999o/view?usp=drive_web, https://drive.google.com/file/d/1P_ofdMC4Yvy0Wgw55ynd1OWXtec_sAvK/view?usp=drive_web, https://drive.google.com/file/d/1fQVZXHAMYjgG9HmUVlttIbaMt7CGICJU/view?usp=drive_web
Chape_Fw_La_Fp_Low |  |  | 2 | Terminé | 2022-10-27 | 2022-10-27 | https://drive.google.com/file/d/1zzv7xZcDqAa1ufIFgOSKHa_z-JKOUPny/view?usp=drive_web, https://drive.google.com/file/d/1TvbCAP5UwR_H3TyS_bZO8yIAqMbsZ93Y/view?usp=drive_web, https://drive.google.com/file/d/1azdlSaCr8Rb4C5Ap3iQP5gsTwiKsNJpX/view?usp=drive_web
Chape_FL_Damper_Up |  |  | 2 | Terminé | 2022-10-27 | 2022-10-27 | https://drive.google.com/file/d/163-kUPC0msdDOjadBF79AuZCwI1_2RVL/view?usp=drive_web, https://drive.google.com/file/d/1kEPMN40kE5zdXrQWu1oo3L57pyxT2Yo6/view?usp=drive_web, https://drive.google.com/file/d/1k98W6B9go8YJmonTe501iunD5IhKIkCb/view?usp=drive_web
Chape boîte à fusible |  | EL_05001 | 2 | Terminé | 2022-11-18 | 2022-11-24 | https://epsa2021.monday.com/protected_static/5873723/resources/670322788/EL_05001%20v2.pdf, https://epsa2021.monday.com/protected_static/5873723/resources/670322882/EL_05001%20v2.dxf
Basculeur avant |  | SU_06001 | 4 | Terminé | 2023-01-16 | 2023-01-18 | https://epsa2021.monday.com/protected_static/5873723/resources/731270075/SU_06001%20(front%20Rocker%203%20mm).pdf, https://epsa2021.monday.com/protected_static/5873723/resources/731270076/SU_06001%20(Front%20Rocker).stp, https://epsa2021.monday.com/protected_static/5873723/resources/731270073/SU_06001%20(front%20Rocker%203%20mm).dxf
Basculeur arrière |  | SU_08001 | 4 | Terminé | 2023-01-16 | 2023-01-18 | https://epsa2021.monday.com/protected_static/5873723/resources/731269204/SU_08001%20(Rear%20Rocker%203%20mm).pdf, https://epsa2021.monday.com/protected_static/5873723/resources/731269203/SU_08001%20(Rear%20Rocker%203%20mm).dxf, https://epsa2021.monday.com/protected_static/5873723/resources/731269274/SU_08001%20(Rear%20Rocker).stp
Basculeur arrière |  | SU_08001 | 4 | Terminé | 2023-01-31 | 2023-02-01 | https://epsa2021.monday.com/protected_static/5873723/resources/749087547/SU_08001%20(Rear%20Rocker%203%20mm).pdf, https://epsa2021.monday.com/protected_static/5873723/resources/749087545/SU_08001%20(Rear%20Rocker%203%20mm).dxf, https://epsa2021.monday.com/protected_static/5873723/resources/749087548/SU_08001%20(Rear%20Rocker).stp
 |  |  |  |  | 2022-10-21 | 2023-02-01
Alu plaque fine
Name | Sous-éléments | Nomenclature | Qté | Statut | Période - Start | Période - End | Fichier
Cale de réglage de la pince 0.75mm |  | ST_03003 | 20 | Terminé | 2023-01-16 | 2023-02-06
Cale de réglage de la pince 1.5mm |  | ST_03003 | 20 | Terminé | 2023-01-16 | 2023-02-06
Camber shim |  | SU_11004 | 12 | Terminé | 2023-01-16 | 2023-02-06 | https://epsa2021.monday.com/protected_static/5873723/resources/731777606/SU_11004%20(camber%20shim%201mm).dxf, https://epsa2021.monday.com/protected_static/5873723/resources/731777609/SU_11004%20(Camber%20shim%201mm).stp, https://epsa2021.monday.com/protected_static/5873723/resources/731777607/SU_11004%20(camber%20shim%201mm).pdf
 |  |  |  |  | 2023-01-16 | 2023-02-06
