EOSCogniton/ELIZ-2022/02 - Documentation/Kicad/Pack Elec/Ressource annexe/Panier mouser Composant standard.xls

PANIER
Ceci n'est pas une facture
31-oct.-22 10:25:05
 | N° Mouser | N° de fab. | Fabricant | N° client | Description | RoHS | Cycle de vie | Qté. | Prix (EUR) | Ext. : (EUR)
1 | 652-3296Y-1-203LF | 3296Y-1-203LF | Bourns |  | Résistances ajustables - Trou débouchant 3/8" 20Kohms Sealed Vertical Adjust | Conforme à RoHS par dispense |  | 5 | 2,38 € | 11,90 €
2 | 652-3296Y-1-204LF | 3296Y-1-204LF | Bourns |  | Résistances ajustables - Trou débouchant 3/8" 200Kohms Sealed Vertical Adjust | Conforme à RoHS par dispense |  | 10 | 1,85 € | 18,50 €
3 | 652-3296Y-1-105LF | 3296Y-1-105LF | Bourns |  | Résistances ajustables - Trou débouchant 3/8" 1Mohms Sealed Vertical Adjust | Conforme à RoHS par dispense |  | 5 | 2,43 € | 12,15 €
4 | 926-LM555CMX/NOPB | LM555CMX/NOPB | Texas Instruments |  | Minuteurs et produits de support TIMER | RoHS : conforme |  | 10 | 1,08 € | 10,80 €
5 | 511-TS391IL | TS391ILT | STMicroelectronics |  | Comparateurs analogiques Lo-Pwr Sngl Voltage | RoHS : conforme |  | 20 | 0,714 € | 14,28 €
6 | 595-LM393LVQDRQ1 | LM393LVQDRQ1 | Texas Instruments |  | Comparateurs analogiques Automotive low-voltage commodity comparator 8-SOIC -40 to 125 | RoHS : conforme | Nouveau produit | 10 | 0,53 € | 5,30 €
7 | 495-TSR2-2450 | TSR 2-2450 | TRACO Power |  | Convertisseurs CC-CC non isolés 6.5-36Vin 5V 2A SIP switching regulator | RoHS : conforme |  | 3 | 11,10 € | 33,30 €
8 | 495-TSR0.5-2450 | TSR 0.5-2450 | TRACO Power |  | Convertisseurs CC-CC non isolés Product Type: POL; Package Style: SMD; Output Power (W): N/A; Input Voltage: 6.5-32 VDC; Output 1 (Vdc): 5; Output 2 (Vdc): N/A; Output 3 (Vdc): N/A | RoHS : conforme |  | 4 | 5,20 € | 20,80 €
9 | 490-PDM2-S5-S5-S | PDM2-S5-S5-S | CUI Inc. |  | Convertisseurs CC/CC isolés - Traversants Isolated Board Mount DC-DC Cnvrt | RoHS : conforme |  | 4 | 5,97 € | 23,88 €
10 | 595-SN74AHCT1G08DBVR | SN74AHCT1G08DBVR | Texas Instruments |  | Portes logiques Single 2-Input | RoHS : conforme |  | 10 | 0,364 € | 3,64 €
11 | 595-SN74AHCT1G32DBVR | SN74AHCT1G32DBVR | Texas Instruments |  | Portes logiques Single 2-Input | RoHS : conforme |  | 10 | 0,26 € | 2,60 €
12 | 595-SN74AHCT1G00DBVR | SN74AHCT1G00DBVR | Texas Instruments |  | Portes logiques Single 2-Input | RoHS : conforme |  | 10 | 0,297 € | 2,97 €
13 | 595-SN74AHCT1G86DBVR | SN74AHCT1G86DBVR | Texas Instruments |  | Portes logiques Single 2 Input | RoHS : conforme |  | 10 | 0,407 € | 4,07 €
14 | 849-CPC1394GRTR | CPC1394GRTR | IXYS |  | Relais à semi-conducteurs - Montage PCB 1-Form-A; 600V,120mA 5000Vrms Isolation | RoHS : conforme |  | 10 | 2,21 € | 22,10 €
15 | 595-SN74HCS72QDRQ1 | SN74HCS72QDRQ1 | Texas Instruments |  | Bistables Automotive Schmitt-trigger input dual D-type negative-edge-triggered flip-flops w/ clear and preset 14-SOIC -40 to 125 | RoHS : conforme |  | 10 | 0,553 € | 5,53 €
16 | 755-RFN1VWM2STFTR | RFN1VWM2STFTR | ROHM Semiconductor |  | Diodes - Usage général, alimentation, commutation 200V SUPER FAST RECOVER | RoHS : conforme | Nouveau produit | 20 | 0,586 € | 11,72 €
17 | 538-79107-7056 | 79107-7056 | Molex |  | Embases et logements de câbles MGrid VRec DR W/OPg W/OPgs .76AuLF 14Ckt | RoHS : conforme |  | 3 | 2,89 € | 8,67 €
18 | 595-SN74AHCT1G02DBVT | SN74AHCT1G02DBVT | Texas Instruments |  | Portes logiques Single 2-Input Positive-NOR Gate | RoHS : conforme |  | 10 | 0,867 € | 8,67 €
19 | 78-SQ2348ES-T1_BE3 | SQ2348ES-T1_BE3 | Vishay |  | MOSFET N-CHANNEL 30V (D-S) | RoHS : conforme |  | 10 | 0,599 € | 5,99 €
20 | 78-SI2343CDS-T1-BE3 | SI2343CDS-T1-BE3 | Vishay |  | MOSFET P-CHANNEL 30-V (D-S) | RoHS : conforme | Nouveau produit | 10 | 0,557 € | 5,57 €
21 | 538-22-11-2022 | 22-11-2022 | Molex |  | Embases et logements de câbles VERT PCB HDR 2P GOLD FRICTION LOCK | RoHS : conforme |  | 10 | 0,356 € | 3,56 €
22 | 538-22-11-2042 | 22-11-2042 | Molex |  | Embases et logements de câbles VERT PCB HDR 4P GOLD FRICTION LOCK | RoHS : conforme |  | 10 | 0,598 € | 5,98 €
23 | 538-22-01-3027 | 22-01-3027 | Molex |  | Embases et logements de câbles HSG 2P W/RAMP/RIBS | RoHS : conforme |  | 20 | 0,224 € | 4,48 €
24 | 538-22-01-3037 | 22-01-3037 | Molex |  | Embases et logements de câbles HSG 3P W/RAMP/RIBS | RoHS : conforme |  | 20 | 0,167 € | 3,34 €
25 | 538-22-01-3047 | 22-01-3047 | Molex |  | Embases et logements de câbles HSG 4P W/RAMP/RIBS | RoHS : conforme |  | 20 | 0,203 € | 4,06 €
26 | 538-22-01-3067 | 22-01-3067 | Molex |  | Embases et logements de câbles HSG 6P W/RAMP/RIBS | RoHS : conforme |  | 20 | 0,366 € | 7,32 €
27 | 538-22-11-2062 | 22-11-2062 | Molex |  | Embases et logements de câbles VERT PCB HDR 6P GOLD FRICTION LOCK | RoHS : conforme |  | 10 | 0,915 € | 9,15 €
28 | 538-22-11-2032 | 22-11-2032 | Molex |  | Embases et logements de câbles VERT PCB HDR 3P GOLD FRICTION LOCK | RoHS : conforme |  | 10 | 0,576 € | 5,76 €
29 | 538-171857-4006 | 171857-4006 | Molex |  | Embases et logements de câbles KK RPC 254 Hdr FrLk R/A 06 Ckt 15Au T&R | RoHS : conforme |  | 10 | 1,16 € | 11,60 €
30 | 538-171857-4004 | 171857-4004 | Molex |  | Embases et logements de câbles KK RPC 254 Hdr FrLk R/A 04 Ckt 15Au T&R | RoHS : conforme |  | 10 | 0,884 € | 8,84 €
31 | 538-171857-4002 | 171857-4002 | Molex |  | Embases et logements de câbles KK RPC 254 Hdr FrLk R/A 02 Ckt 15Au T&R | RoHS : conforme |  | 10 | 0,797 € | 7,97 €
32 | 538-22-12-2034 | 22-12-2034 | Molex |  | Embases et logements de câbles R/A PCB HDR 3P GOLD FRICTION LOCK | RoHS : conforme |  | 10 | 0,808 € | 8,08 €
33 | 652-3296Y-1-201 | 3296Y-1-201 | Bourns |  | Résistances ajustables - Trou débouchant 3/8IN 200 OHM Sealed Vertical Adjust | Non |  | 5 | 3,81 € | 19,05 €
En soumettant votre commande, vous acceptez ces conditions. (https://www.mouser.fr/saleterms) |  |  |  |  |  |  |  |  | Marchandise : | 331,63 €
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
