EOSCogniton/ELIZ-2022/01 - Maquette CATIA/AA - Mise en plan/Noel metal/EL_TSAC/couvercle/plaque principale/main_plate.dxf

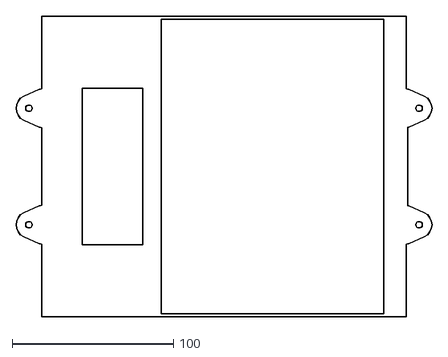
[picture p409: CAD file, 2025-06-11]
01 - Maquette CATIA/AA - Mise en plan/Noel metal/EL_TSAC/couvercle/plaque principale/main_plate.dxf
258.0 x 186.5
