EOSCogniton/ELIZ-2022/01 - Maquette CATIA/SU_Suspension/Gabarits/Gabarit basculeur arrière/MEPs/Maintien tube.dxf

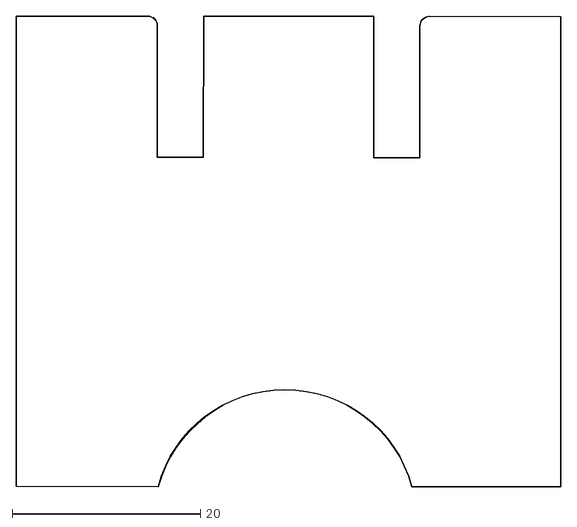
[picture p410: CAD file, 2024-10-20]
01 - Maquette CATIA/SU_Suspension/Gabarits/Gabarit basculeur arrière/MEPs/Maintien tube.dxf
57.9 x 50.0
