EOSCogniton/ELIZ-2022/01 - Maquette CATIA/SU_Suspension/Gabarits/Gabarit_en_triangle_arriere_bas/MEPs/maintien_plaques_tie_rod.dxf

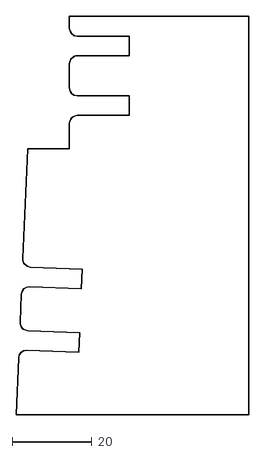
[picture p411: CAD file, 2024-11-18]
01 - Maquette CATIA/SU_Suspension/Gabarits/Gabarit_en_triangle_arriere_bas/MEPs/maintien_plaques_tie_rod.dxf
58.4 x 100.0
