EOSCogniton/ELIZ-2022/Documentation/Kicad/Pack Elec/KicadLib/3Dmodel/Teensy_4.0_Assembly.STEP

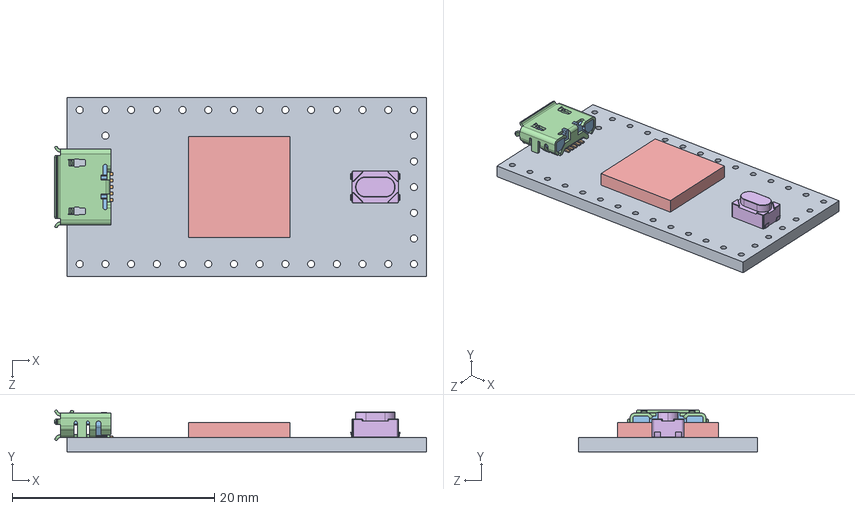
[picture p412: CAD file, 2023-03-28]
Documentation/Kicad/Pack Elec/KicadLib/3Dmodel/Teensy_4.0_Assembly.STEP
36.8 x 4.12 x 17.7 mm
Teensy_4.0_PCB
Micro USB-B Female 5Pin SMD
NXP iMXRT1062
SKRPACE010 v4
