EOSCogniton/ELIZ-2022/01 - Maquette CATIA/AA - Mise en plan/AquaCut/EN_01009 v3.dxf

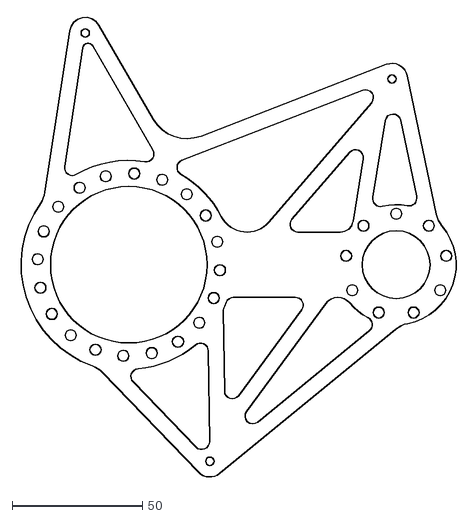
[picture p413: CAD file, 2025-03-06]
01 - Maquette CATIA/AA - Mise en plan/AquaCut/EN_01009 v3.dxf
170.1 x 177.2
