EOSCogniton/ELIZ-2022/01 - Maquette CATIA/AA - Mise en plan/AquaCut/Prod support moteurs 2025/left/EN_01009.stp

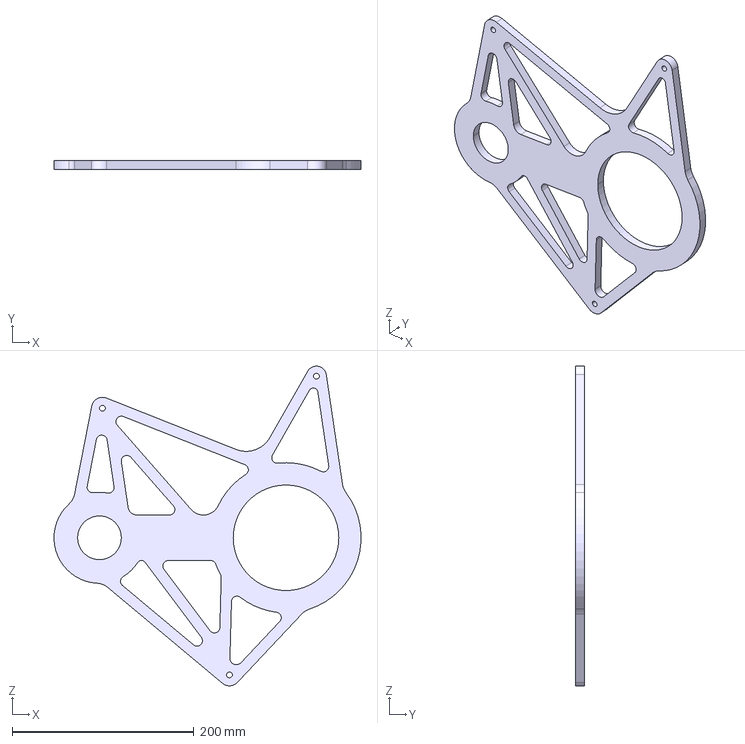
[picture p414: CAD file, 2025-03-06]
01 - Maquette CATIA/AA - Mise en plan/AquaCut/Prod support moteurs 2025/left/EN_01009.stp
337.4 x 10.0 x 351.3 mm
