EOSCogniton/ELIZ-2022/01 - Maquette CATIA/AA - Mise en plan/AquaCut/Prod support moteurs 2025/right/EN_01008.stp

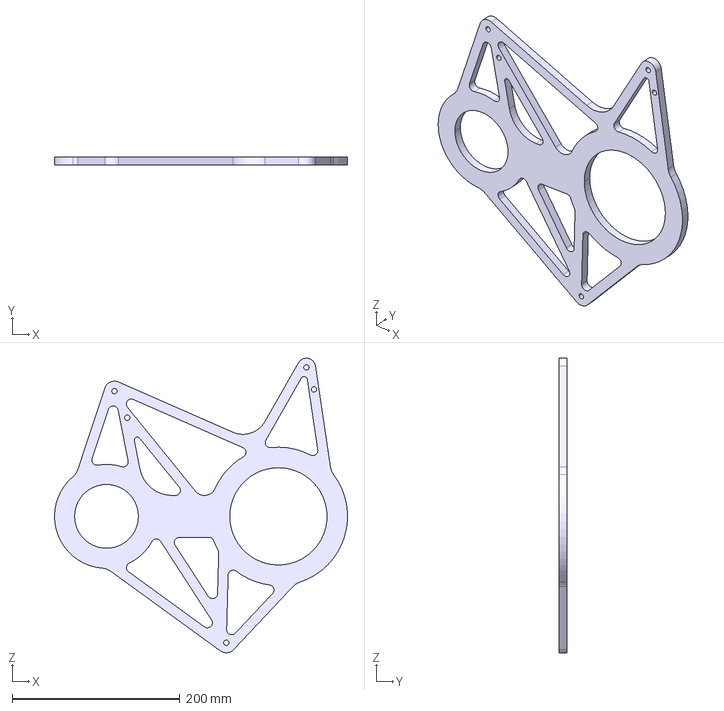
[picture p415: CAD file, 2025-03-06]
01 - Maquette CATIA/AA - Mise en plan/AquaCut/Prod support moteurs 2025/right/EN_01008.stp
349.4 x 10.0 x 351.3 mm
