EOSCogniton/ELIZ-2022/01 - Maquette CATIA/AA - Mise en plan/Boisard/vague 2/Driveshaft right.dxf

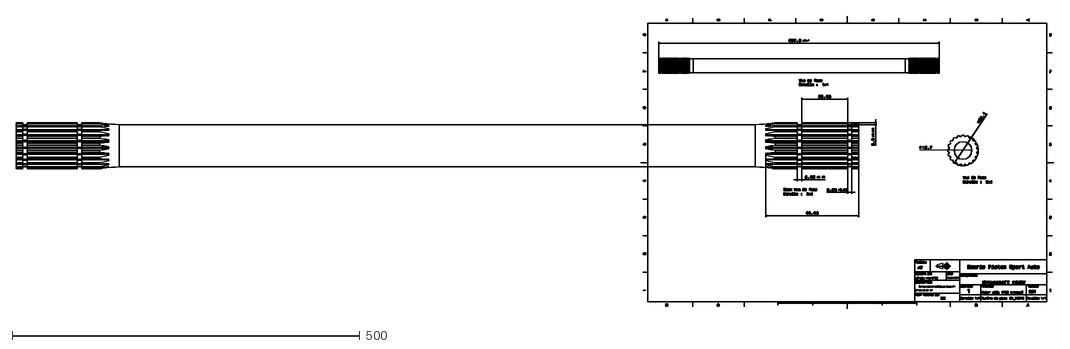
[picture p416: CAD file, 2024-03-05]
01 - Maquette CATIA/AA - Mise en plan/Boisard/vague 2/Driveshaft right.dxf
1492.3 x 420.0
