EOSCogniton/ELIZ-2022/01 - Maquette CATIA/AA - Mise en plan/Boisard/Vague1/WT_02001 (Front Hub).stp

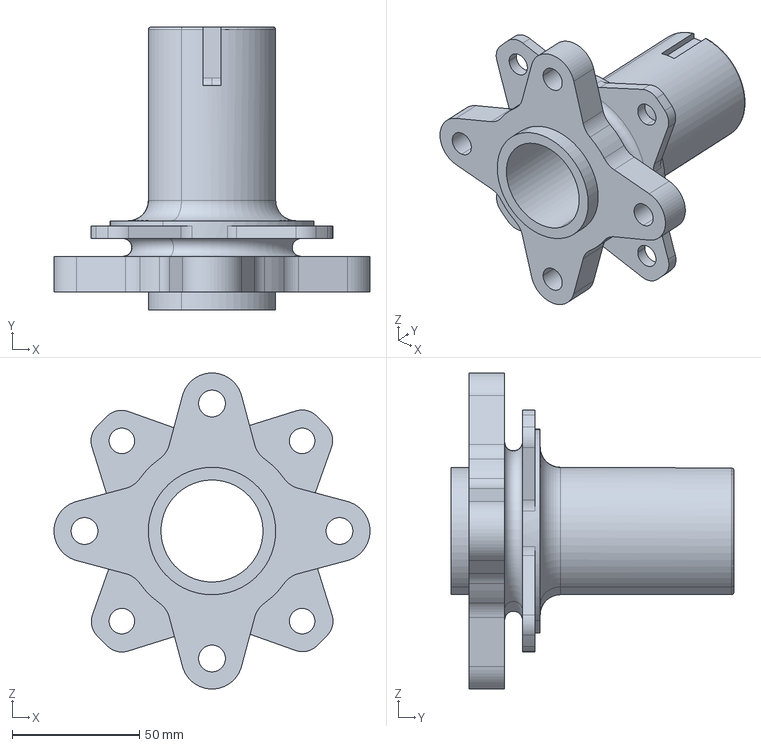
[picture p417: CAD file, 2023-02-03]
01 - Maquette CATIA/AA - Mise en plan/Boisard/Vague1/WT_02001 (Front Hub).stp
124.0 x 111.0 x 124.0 mm
