EOSCogniton/ELIZ-2022/01 - Maquette CATIA/AA - Mise en plan/Cellulearrière.dxf

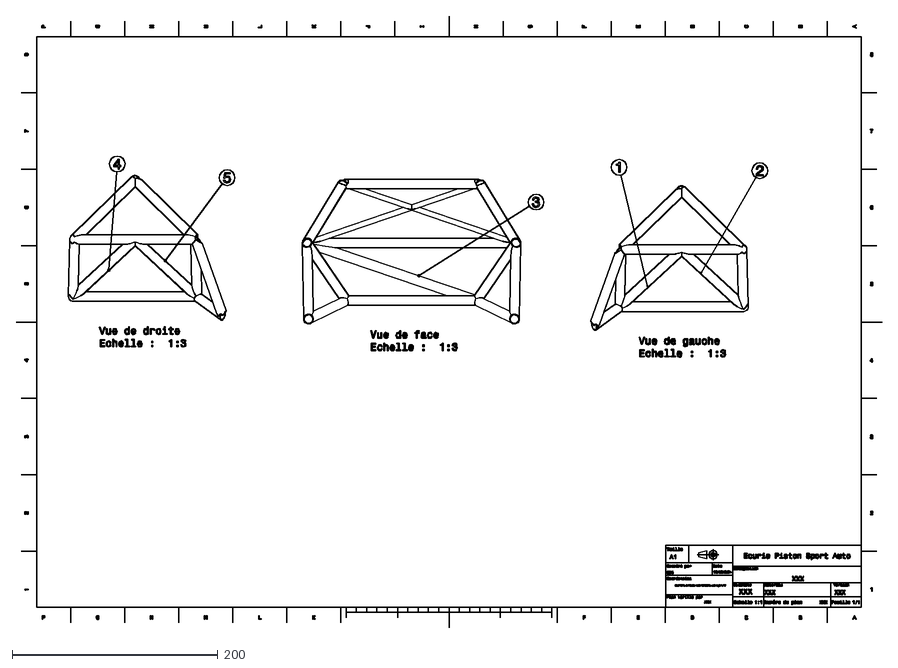
[picture p418: CAD file, 2024-02-20]
01 - Maquette CATIA/AA - Mise en plan/Cellulearrière.dxf
841.0 x 594.0
