EOSCogniton/ELIZ-2022/01 - Maquette CATIA/AA - Mise en plan/EL_Electrical/EL_01 - TDB/EL_01003 (Dash Panel Mid Bracket).dxf

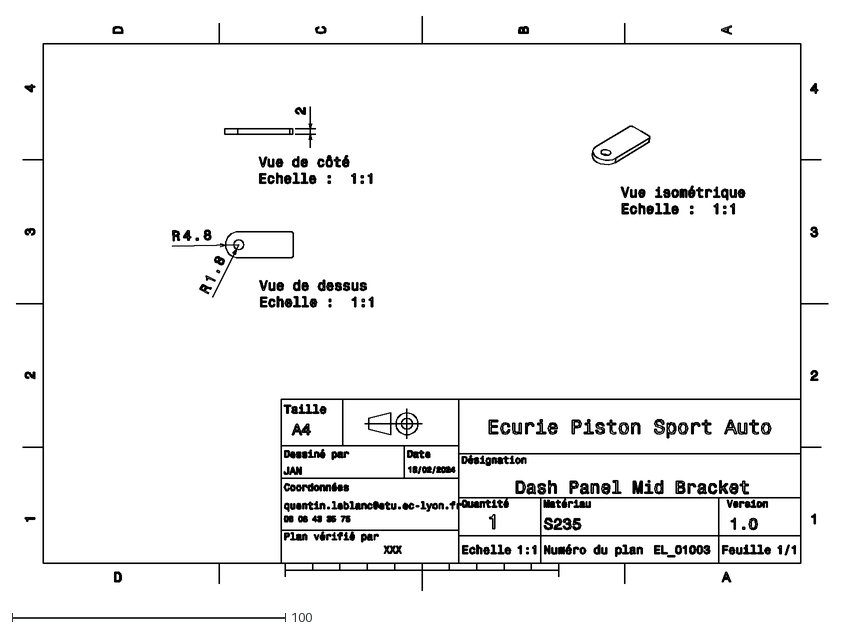
[picture p419: CAD file, 2024-02-20]
01 - Maquette CATIA/AA - Mise en plan/EL_Electrical/EL_01 - TDB/EL_01003 (Dash Panel Mid Bracket).dxf
297.0 x 210.0
