EOSCogniton/ELIZ-2022/01 - Maquette CATIA/AA - Mise en plan/EL_Electrical/EL_03 - BLV/EL_03002.dxf

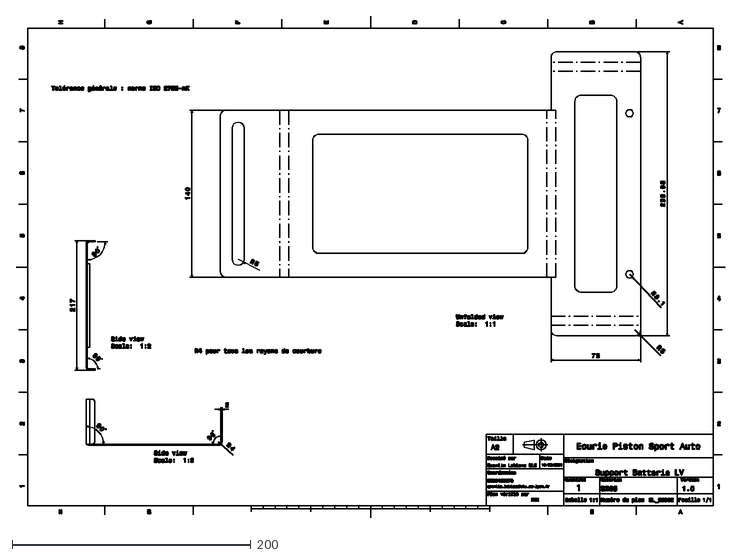
[picture p420: CAD file, 2024-02-20]
01 - Maquette CATIA/AA - Mise en plan/EL_Electrical/EL_03 - BLV/EL_03002.dxf
594.0 x 420.0
