EOSCogniton/ELIZ-2022/01 - Maquette CATIA/AA - Mise en plan/EL_Electrical/EL_06008/EL_06008 SUpport HVD.dxf

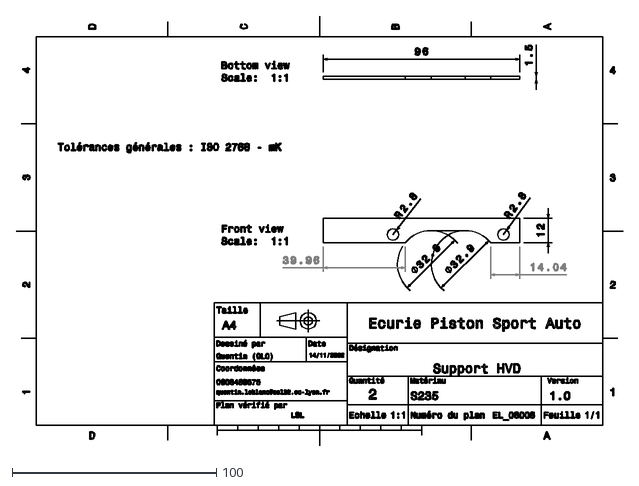
[picture p421: CAD file, 2023-10-17]
01 - Maquette CATIA/AA - Mise en plan/EL_Electrical/EL_06008/EL_06008 SUpport HVD.dxf
297.0 x 210.0
