EOSCogniton/ELIZ-2022/01 - Maquette CATIA/AA - Mise en plan/EL_Electrical/EL_06010/EL_06010.dxf

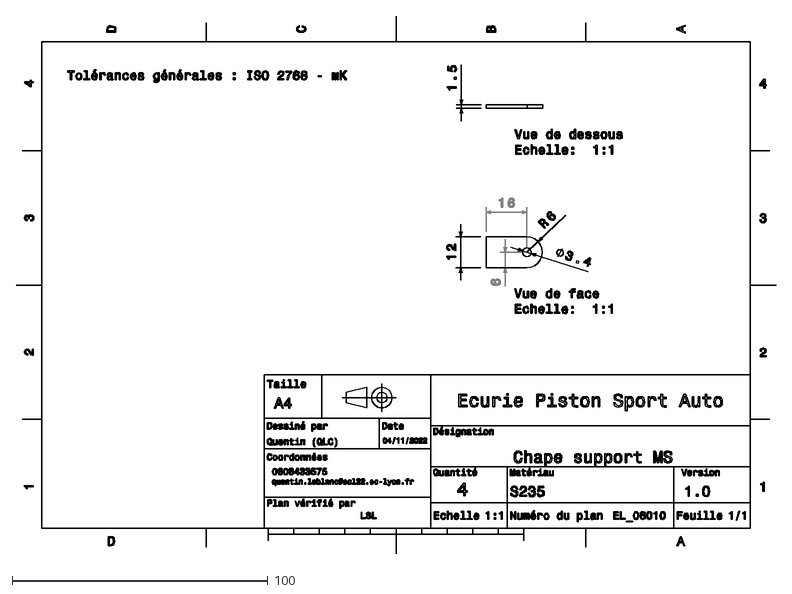
[picture p422: CAD file, 2023-10-17]
01 - Maquette CATIA/AA - Mise en plan/EL_Electrical/EL_06010/EL_06010.dxf
297.0 x 210.0
