EOSCogniton/ELIZ-2022/01 - Maquette CATIA/AA - Mise en plan/EL_Electrical/EL_08 - TSAL/EL_08002.dxf

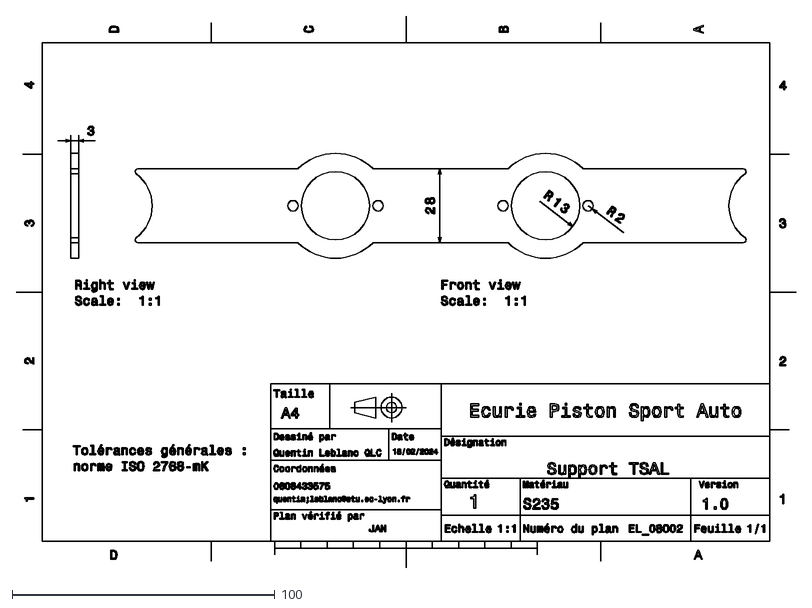
[picture p423: CAD file, 2024-02-20]
01 - Maquette CATIA/AA - Mise en plan/EL_Electrical/EL_08 - TSAL/EL_08002.dxf
297.0 x 210.0
