EOSCogniton/ELIZ-2022/01 - Maquette CATIA/AA - Mise en plan/EL_Electrical/EL_20 - TS Box/EL_20008 (Low Bracket Rear).dxf

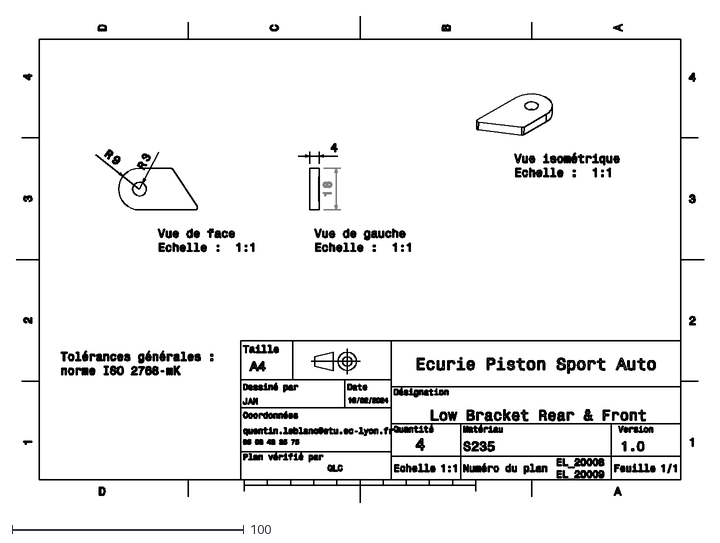
[picture p424: CAD file, 2024-02-20]
01 - Maquette CATIA/AA - Mise en plan/EL_Electrical/EL_20 - TS Box/EL_20008 (Low Bracket Rear).dxf
297.0 x 210.0
