EOSCogniton/ELIZ-2022/01 - Maquette CATIA/AA - Mise en plan/EL_Electrical/EL_buzzer/EL_buzz.dxf

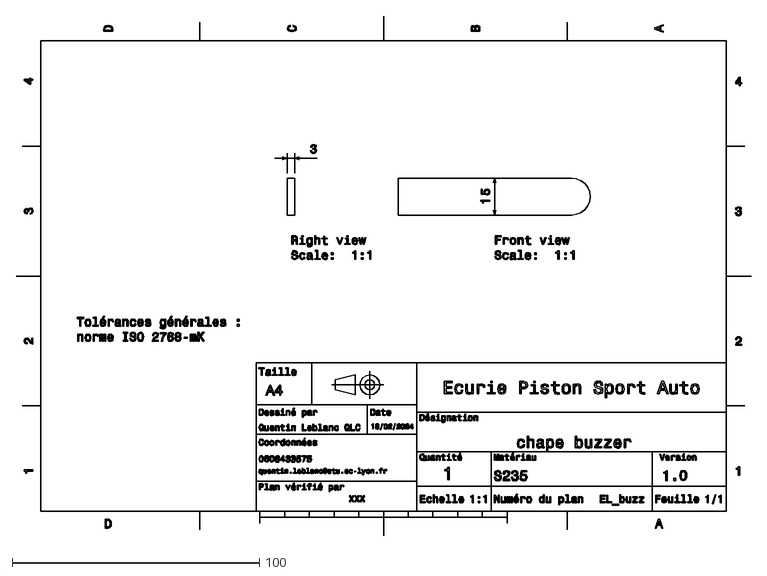
[picture p425: CAD file, 2024-02-20]
01 - Maquette CATIA/AA - Mise en plan/EL_Electrical/EL_buzzer/EL_buzz.dxf
297.0 x 210.0
