EOSCogniton/ELIZ-2022/01 - Maquette CATIA/AA - Mise en plan/EN_Engine/EN_02 - Cooling System/EN_02020.dxf

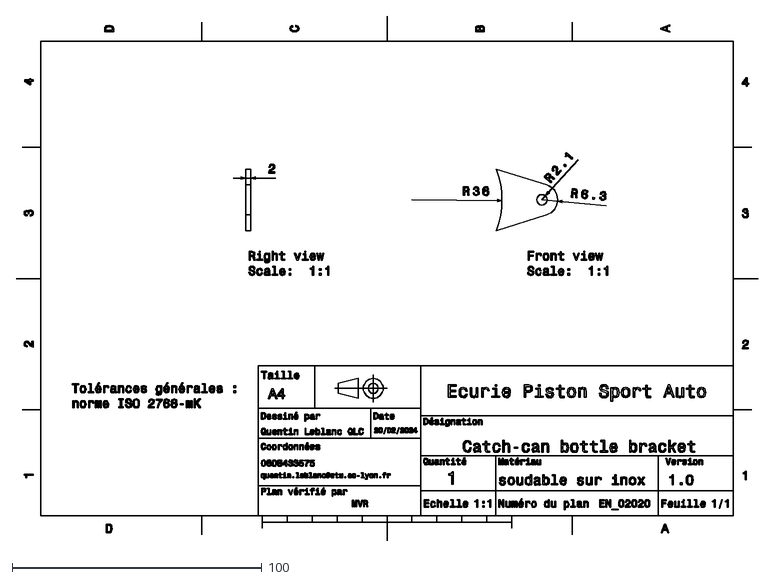
[picture p426: CAD file, 2024-03-05]
01 - Maquette CATIA/AA - Mise en plan/EN_Engine/EN_02 - Cooling System/EN_02020.dxf
297.0 x 210.0
