EOSCogniton/ELIZ-2022/01 - Maquette CATIA/AA - Mise en plan/EN_Engine/GABARIT_protection radiateur/protection_radiateur.dxf

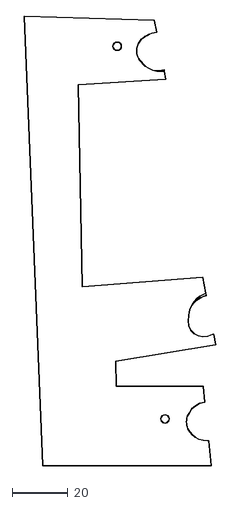
[picture p427: CAD file, 2024-03-26]
01 - Maquette CATIA/AA - Mise en plan/EN_Engine/GABARIT_protection radiateur/protection_radiateur.dxf
68.7 x 161.1
