EOSCogniton/ELIZ-2022/01 - Maquette CATIA/AA - Mise en plan/fernand forest/SU_06003 (ball joint spacer).dxf

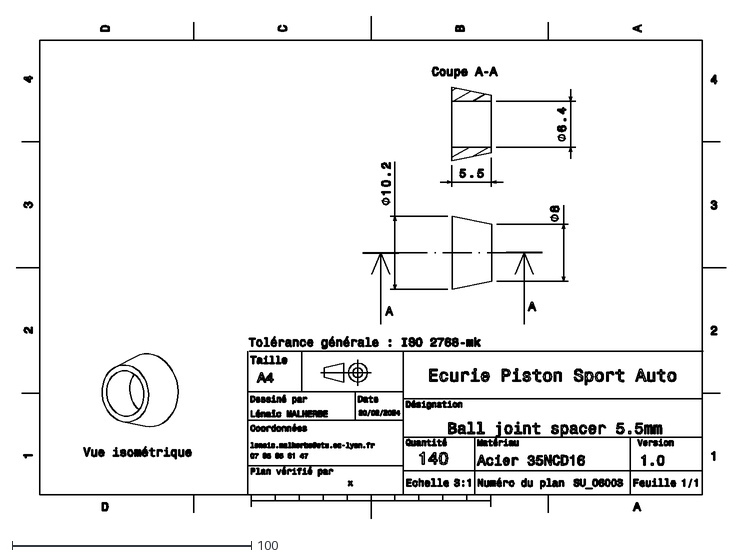
[picture p428: CAD file, 2024-03-05]
01 - Maquette CATIA/AA - Mise en plan/fernand forest/SU_06003 (ball joint spacer).dxf
297.0 x 210.0
