EOSCogniton/ELIZ-2022/01 - Maquette CATIA/AA - Mise en plan/FR_Frame_Body/FR_02003/FR_02003.dxf

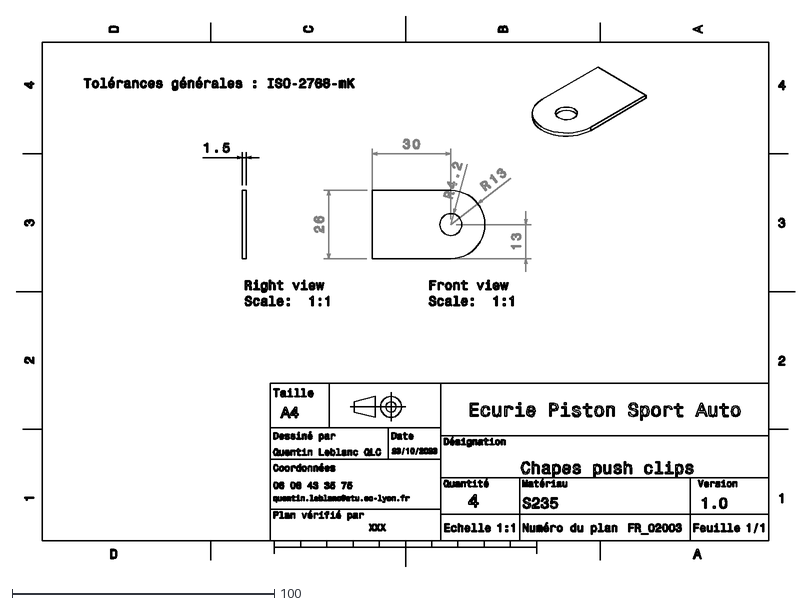
[picture p429: CAD file, 2023-11-14]
01 - Maquette CATIA/AA - Mise en plan/FR_Frame_Body/FR_02003/FR_02003.dxf
297.0 x 210.0
