EOSCogniton/ELIZ-2022/01 - Maquette CATIA/AA - Mise en plan/FR_Frame_Body/FR_03 - Throttle/FR_03001/FR_03001_16.dxf

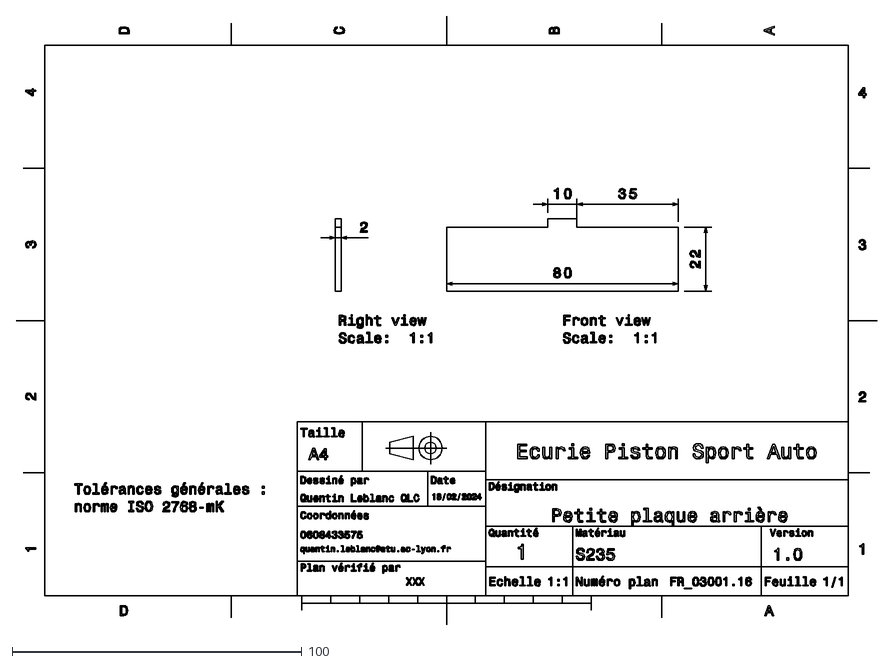
[picture p430: CAD file, 2024-02-20]
01 - Maquette CATIA/AA - Mise en plan/FR_Frame_Body/FR_03 - Throttle/FR_03001/FR_03001_16.dxf
297.0 x 210.0
