EOSCogniton/ELIZ-2022/01 - Maquette CATIA/AA - Mise en plan/FR_Frame_Body/FR_03 - Throttle/FR_03004/FR_03004.dxf

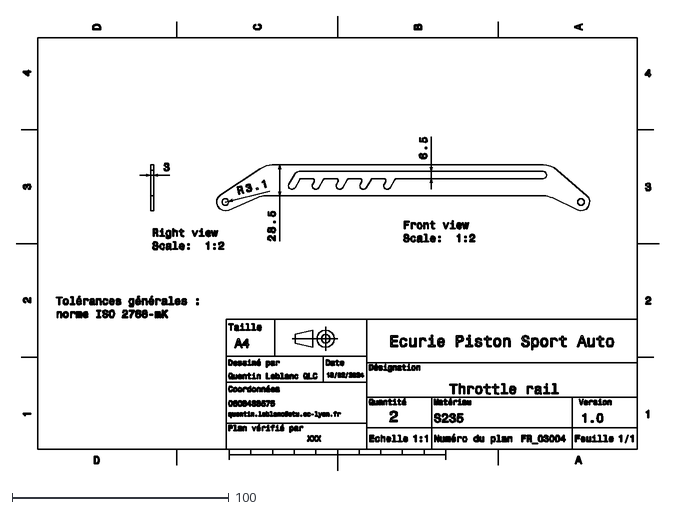
[picture p431: CAD file, 2024-02-20]
01 - Maquette CATIA/AA - Mise en plan/FR_Frame_Body/FR_03 - Throttle/FR_03004/FR_03004.dxf
297.0 x 210.0
