EOSCogniton/ELIZ-2022/01 - Maquette CATIA/AA - Mise en plan/FR_Frame_Body/FR_03 - Throttle/FR_03005/FR_03005 (Throttle Fixing Rail Wedge).dxf

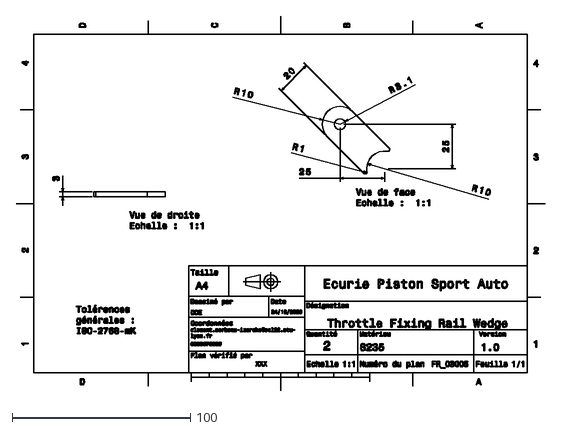
[picture p432: CAD file, 2023-10-25]
01 - Maquette CATIA/AA - Mise en plan/FR_Frame_Body/FR_03 - Throttle/FR_03005/FR_03005 (Throttle Fixing Rail Wedge).dxf
297.0 x 210.0
