EOSCogniton/ELIZ-2022/01 - Maquette CATIA/AA - Mise en plan/FR_Frame_Body/FR_03 - Throttle/FR_03007/FR_03007.dxf

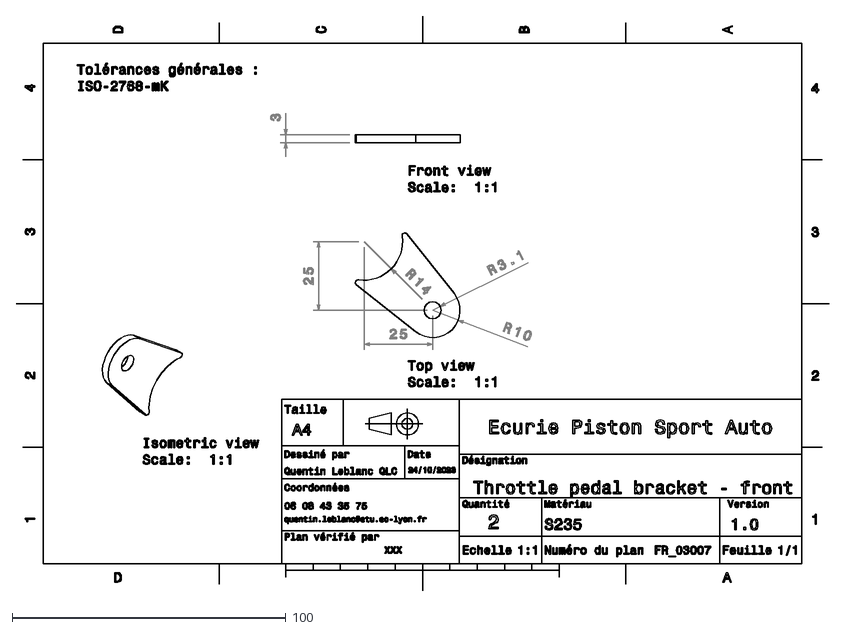
[picture p433: CAD file, 2023-11-14]
01 - Maquette CATIA/AA - Mise en plan/FR_Frame_Body/FR_03 - Throttle/FR_03007/FR_03007.dxf
297.0 x 210.0
