EOSCogniton/ELIZ-2022/01 - Maquette CATIA/AA - Mise en plan/FR_Frame_Body/FR_04 - Brake/FR_04001 (Frame Brake)/FR_04001_5.dxf

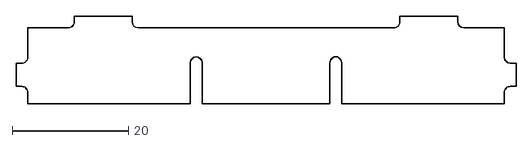
[picture p434: CAD file, 2025-01-30]
01 - Maquette CATIA/AA - Mise en plan/FR_Frame_Body/FR_04 - Brake/FR_04001 (Frame Brake)/FR_04001_5.dxf
86.0 x 15.1
