EOSCogniton/ELIZ-2022/01 - Maquette CATIA/AA - Mise en plan/FR_Frame_Body/FR_04 - Brake/FR_04006.dxf

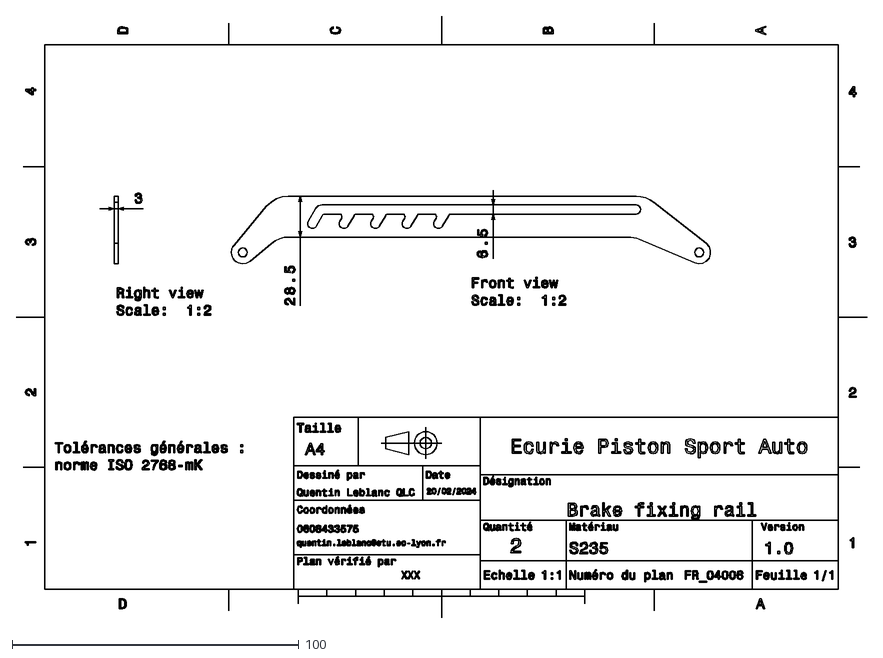
[picture p435: CAD file, 2024-03-05]
01 - Maquette CATIA/AA - Mise en plan/FR_Frame_Body/FR_04 - Brake/FR_04006.dxf
297.0 x 210.0
