EOSCogniton/ELIZ-2022/01 - Maquette CATIA/AA - Mise en plan/FR_Frame_Body/FR_04 - Brake/FR_04007/FR_04007.dxf

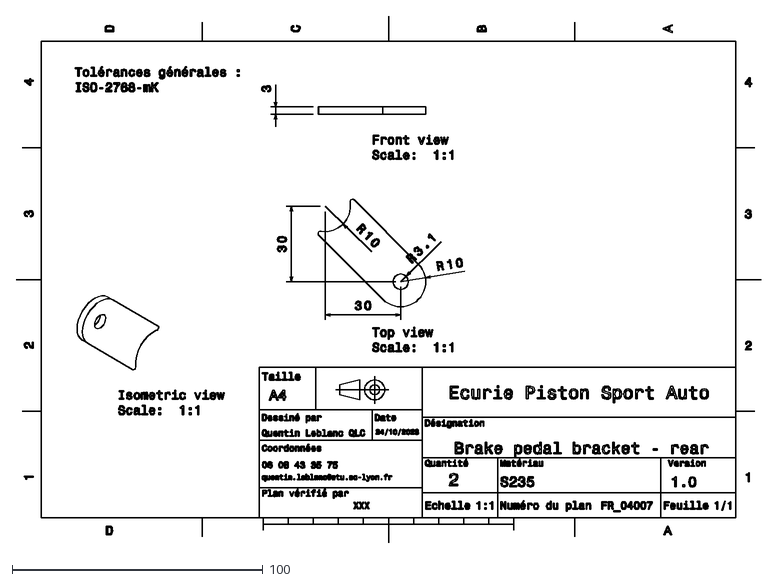
[picture p436: CAD file, 2023-11-14]
01 - Maquette CATIA/AA - Mise en plan/FR_Frame_Body/FR_04 - Brake/FR_04007/FR_04007.dxf
297.0 x 210.0
