EOSCogniton/ELIZ-2022/01 - Maquette CATIA/AA - Mise en plan/FR_Frame_Body/FR_06003/FR_06003_4 (Floor pan bracket)(Cockpit_Rear).dxf

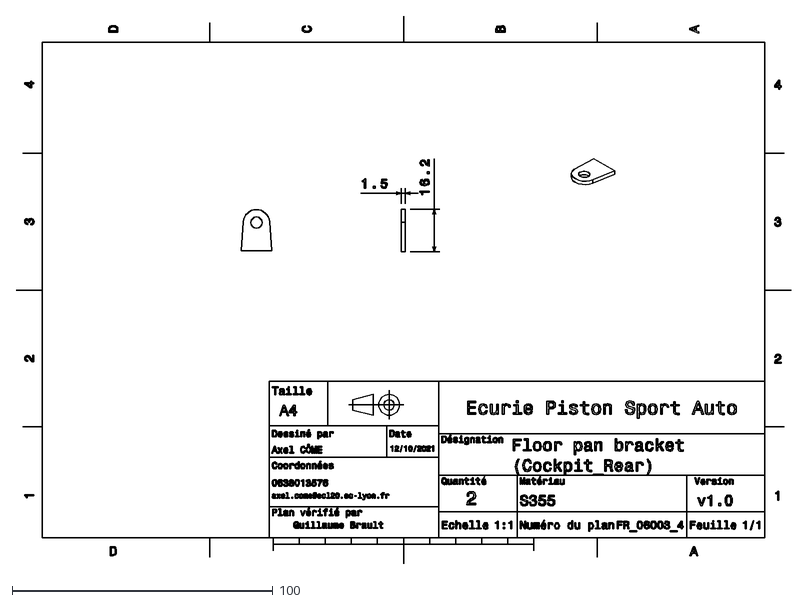
[picture p437: CAD file, 2023-05-31]
01 - Maquette CATIA/AA - Mise en plan/FR_Frame_Body/FR_06003/FR_06003_4 (Floor pan bracket)(Cockpit_Rear).dxf
297.0 x 210.0
