EOSCogniton/ELIZ-2022/01 - Maquette CATIA/AA - Mise en plan/FR_Frame_Body/Mechanical stops/FR_03008 (neg).dxf

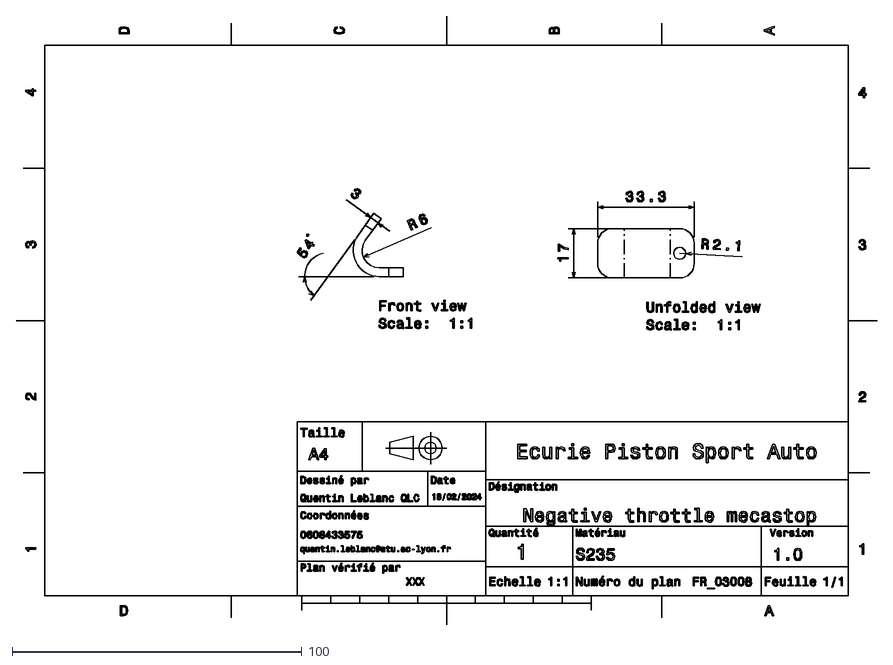
[picture p438: CAD file, 2024-02-20]
01 - Maquette CATIA/AA - Mise en plan/FR_Frame_Body/Mechanical stops/FR_03008 (neg).dxf
297.0 x 210.0
