EOSCogniton/ELIZ-2022/01 - Maquette CATIA/AA - Mise en plan/Gabarits/découpe 27032024/Gabarits catch-can/GabaritPompe2_Calque_1.dxf

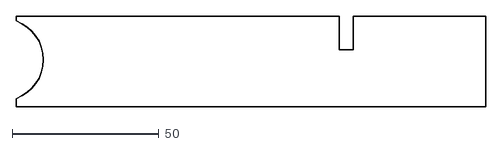
[picture p439: CAD file, 2024-03-20]
01 - Maquette CATIA/AA - Mise en plan/Gabarits/découpe 27032024/Gabarits catch-can/GabaritPompe2_Calque_1.dxf
160.0 x 30.9
