EOSCogniton/ELIZ-2022/01 - Maquette CATIA/AA - Mise en plan/Gabarits/découpe 27032024/gabarits_TS_bas/plaque-arret-chape.dxf

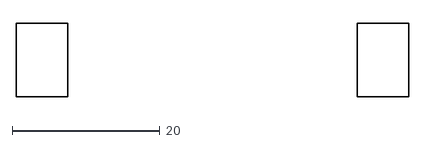
[picture p440: CAD file, 2024-03-20]
01 - Maquette CATIA/AA - Mise en plan/Gabarits/découpe 27032024/gabarits_TS_bas/plaque-arret-chape.dxf
53.1 x 10.0
