EOSCogniton/ELIZ-2022/01 - Maquette CATIA/AA - Mise en plan/La Fabrique/1ervague/SU_06002 (pivot joint spacer).stp

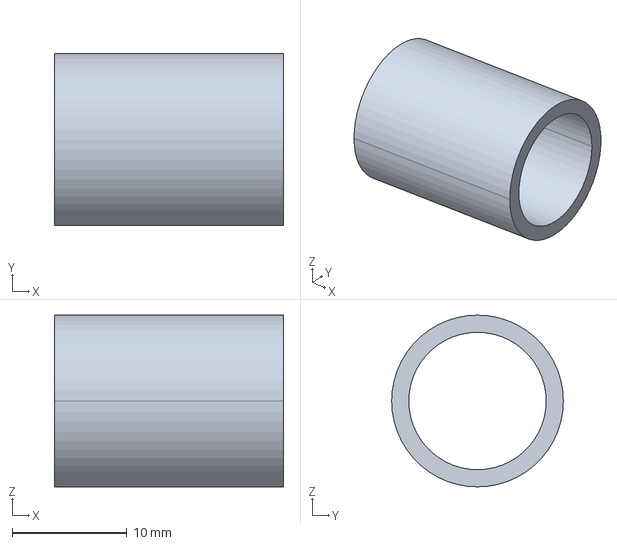
[picture p441: CAD file, 2023-02-03]
01 - Maquette CATIA/AA - Mise en plan/La Fabrique/1ervague/SU_06002 (pivot joint spacer).stp
20.0 x 15.0 x 15.0 mm
