EOSCogniton/ELIZ-2022/01 - Maquette CATIA/AA - Mise en plan/La mache laser/1e vague/S235/MS_02004_2.dxf

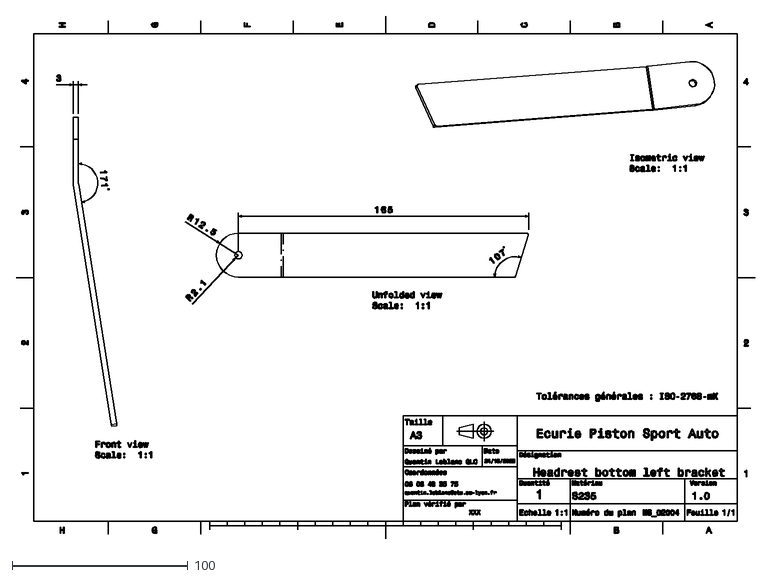
[picture p442: CAD file, 2023-11-14]
01 - Maquette CATIA/AA - Mise en plan/La mache laser/1e vague/S235/MS_02004_2.dxf
420.0 x 297.0
