EOSCogniton/ELIZ-2022/01 - Maquette CATIA/AA - Mise en plan/La mache laser/2e vague/S235/1.5mm/EL_11002.dxf

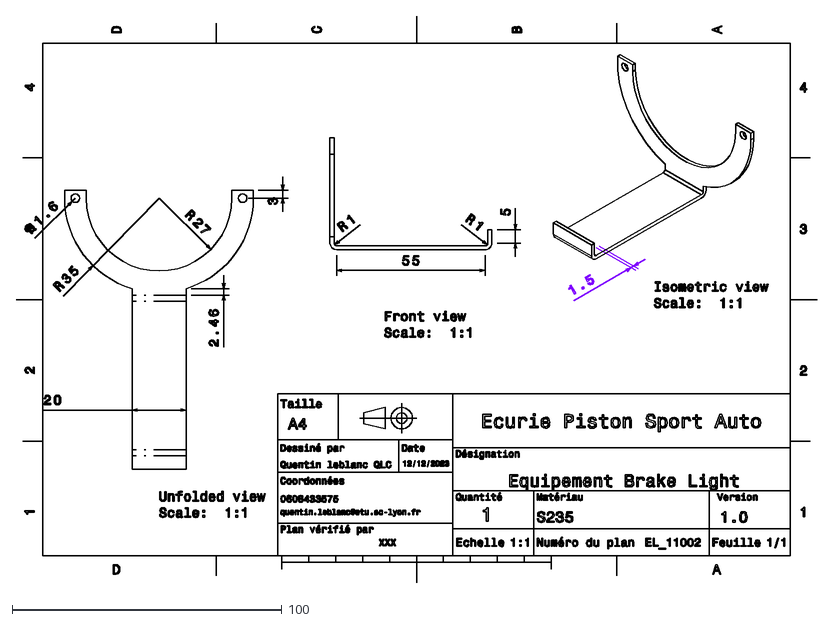
[picture p443: CAD file, 2023-12-12]
01 - Maquette CATIA/AA - Mise en plan/La mache laser/2e vague/S235/1.5mm/EL_11002.dxf
297.0 x 210.0
