EOSCogniton/ELIZ-2022/01 - Maquette CATIA/AA - Mise en plan/La mache laser/2e vague/S235/3mm/EL_16002.dxf

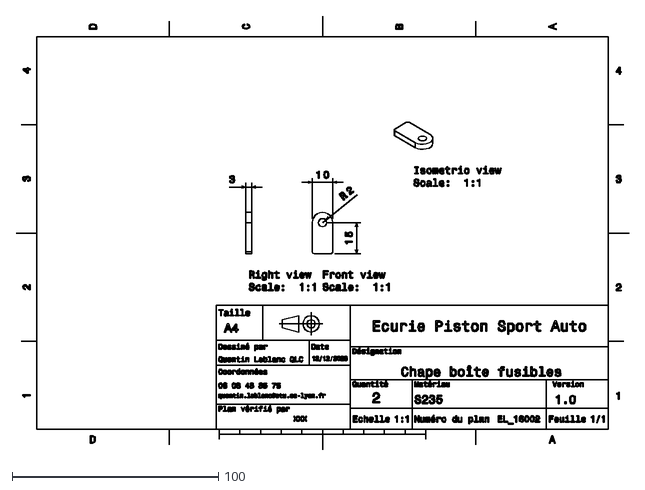
[picture p445: CAD file, 2023-12-14]
01 - Maquette CATIA/AA - Mise en plan/La mache laser/2e vague/S235/3mm/EL_16002.dxf
297.0 x 210.0
