EOSCogniton/ELIZ-2022/01 - Maquette CATIA/AA - Mise en plan/La mache laser/2e vague/S235/4mm/MS_03004 (Anti-submarine + lap belt bracket).dxf

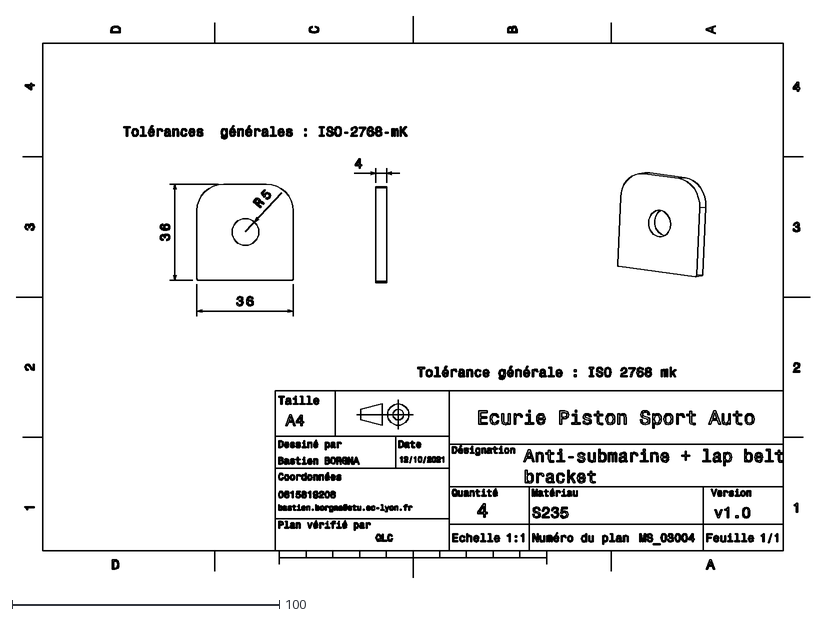
[picture p446: CAD file, 2023-12-13]
01 - Maquette CATIA/AA - Mise en plan/La mache laser/2e vague/S235/4mm/MS_03004 (Anti-submarine + lap belt bracket).dxf
297.0 x 210.0
