EOSCogniton/ELIZ-2022/01 - Maquette CATIA/AA - Mise en plan/La mache laser/2e vague/S355/3mm/Chape_RRocker_R.dxf

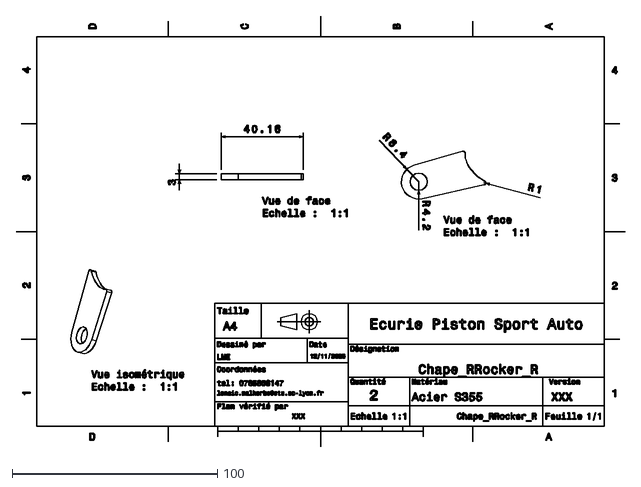
[picture p447: CAD file, 2023-11-14]
01 - Maquette CATIA/AA - Mise en plan/La mache laser/2e vague/S355/3mm/Chape_RRocker_R.dxf
297.0 x 210.0
