EOSCogniton/ELIZ-2022/01 - Maquette CATIA/AA - Mise en plan/La mache laser/2e vague/S355/4mm/chapes SU/Chape_tie-rod_Up.dxf

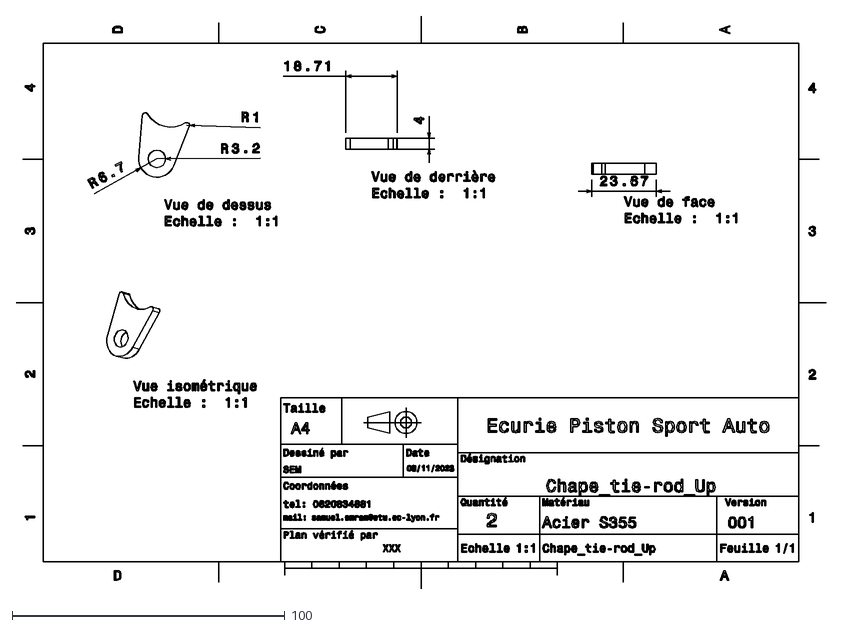
[picture p448: CAD file, 2023-11-14]
01 - Maquette CATIA/AA - Mise en plan/La mache laser/2e vague/S355/4mm/chapes SU/Chape_tie-rod_Up.dxf
297.0 x 210.0
