EOSCogniton/ELIZ-2022/01 - Maquette CATIA/AA - Mise en plan/La mache laser/3e vague/S235/2mm/EN_02019(radiator protection bottom equipment).dxf

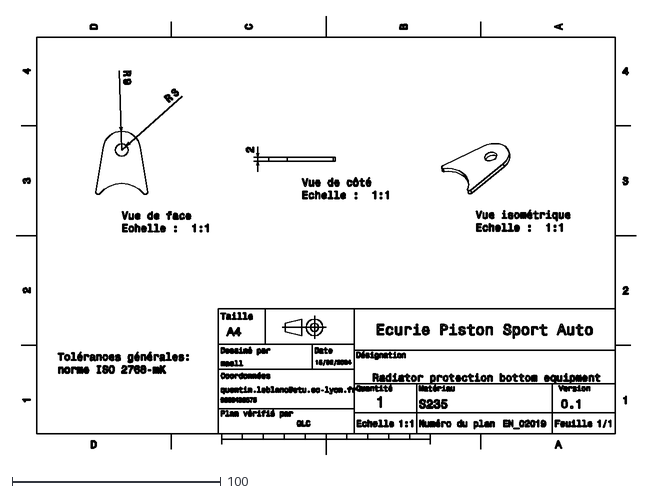
[picture p449: CAD file, 2024-02-20]
01 - Maquette CATIA/AA - Mise en plan/La mache laser/3e vague/S235/2mm/EN_02019(radiator protection bottom equipment).dxf
297.0 x 210.0
