EOSCogniton/ELIZ-2022/01 - Maquette CATIA/AA - Mise en plan/La mache laser/3e vague/S235/3mm/EN_02007 (water pump top) mep.dxf

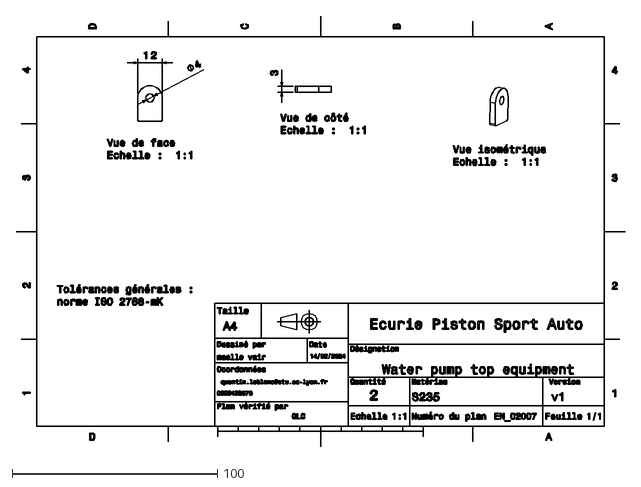
[picture p450: CAD file, 2024-02-20]
01 - Maquette CATIA/AA - Mise en plan/La mache laser/3e vague/S235/3mm/EN_02007 (water pump top) mep.dxf
297.0 x 210.0
