EOSCogniton/ELIZ-2022/01 - Maquette CATIA/AA - Mise en plan/La mache laser/3e vague/S235/4mm/EL_20010(side mount left).dxf

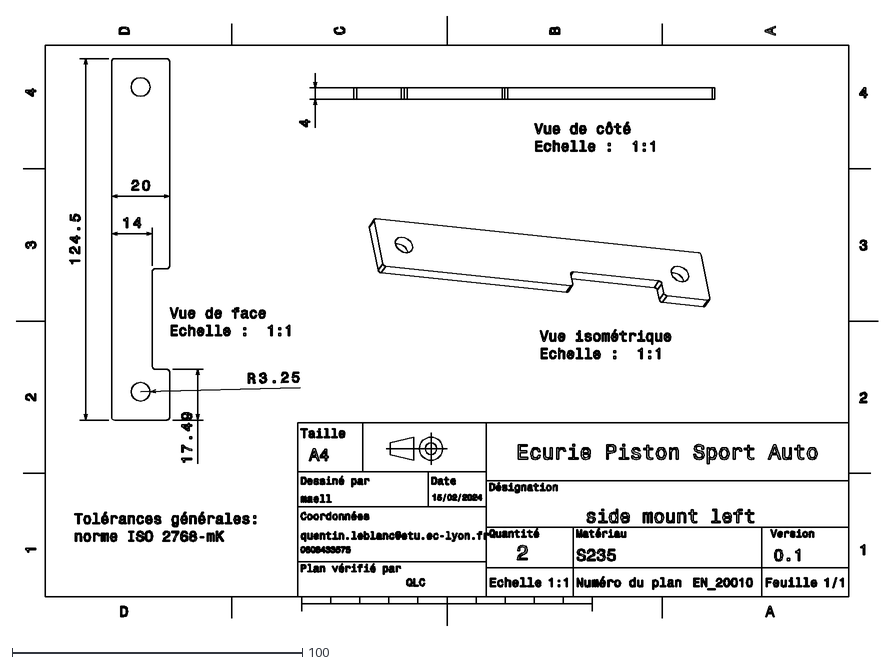
[picture p451: CAD file, 2024-02-20]
01 - Maquette CATIA/AA - Mise en plan/La mache laser/3e vague/S235/4mm/EL_20010(side mount left).dxf
297.0 x 210.0
