EOSCogniton/ELIZ-2022/01 - Maquette CATIA/AA - Mise en plan/La mache laser/3e vague/S235/5mm/MS_03006.dxf

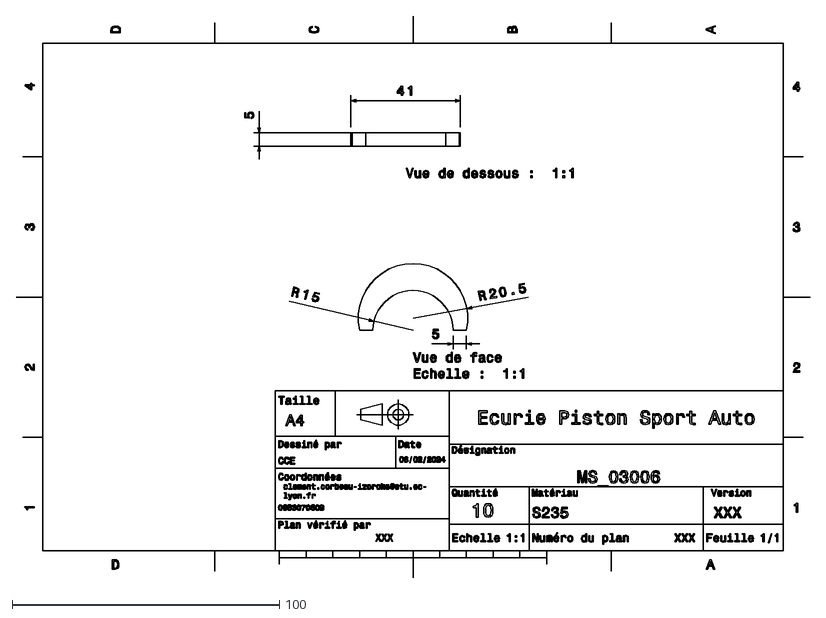
[picture p452: CAD file, 2024-02-13]
01 - Maquette CATIA/AA - Mise en plan/La mache laser/3e vague/S235/5mm/MS_03006.dxf
297.0 x 210.0
