EOSCogniton/ELIZ-2022/01 - Maquette CATIA/AA - Mise en plan/La mache laser/3e vague/S235/pliée/2mm/EN_02015 (Radiator Low Rear Bar).dxf

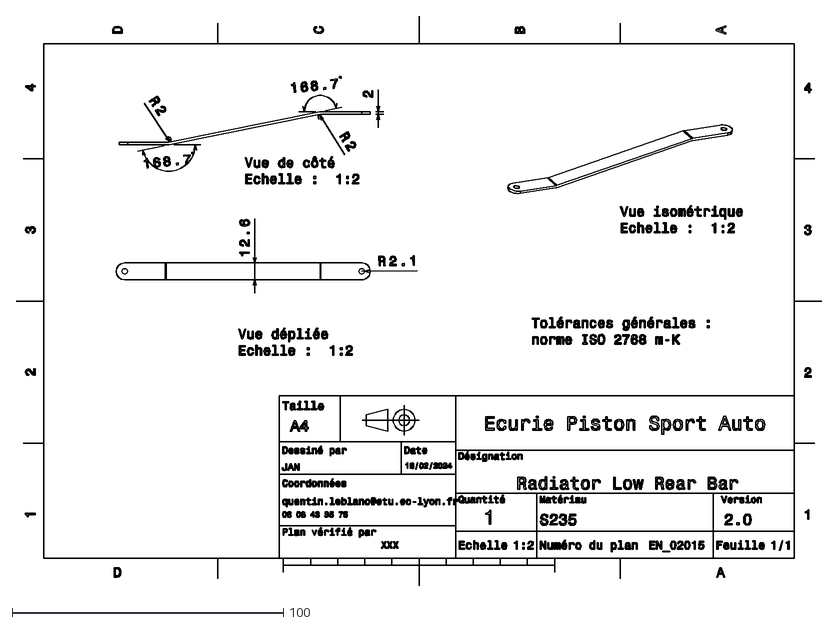
[picture p453: CAD file, 2024-02-20]
01 - Maquette CATIA/AA - Mise en plan/La mache laser/3e vague/S235/pliée/2mm/EN_02015 (Radiator Low Rear Bar).dxf
297.0 x 210.0
