EOSCogniton/ELIZ-2022/01 - Maquette CATIA/AA - Mise en plan/La mache laser/3e vague/S235/pliée/3mm/EL_20007 (Plate).dxf

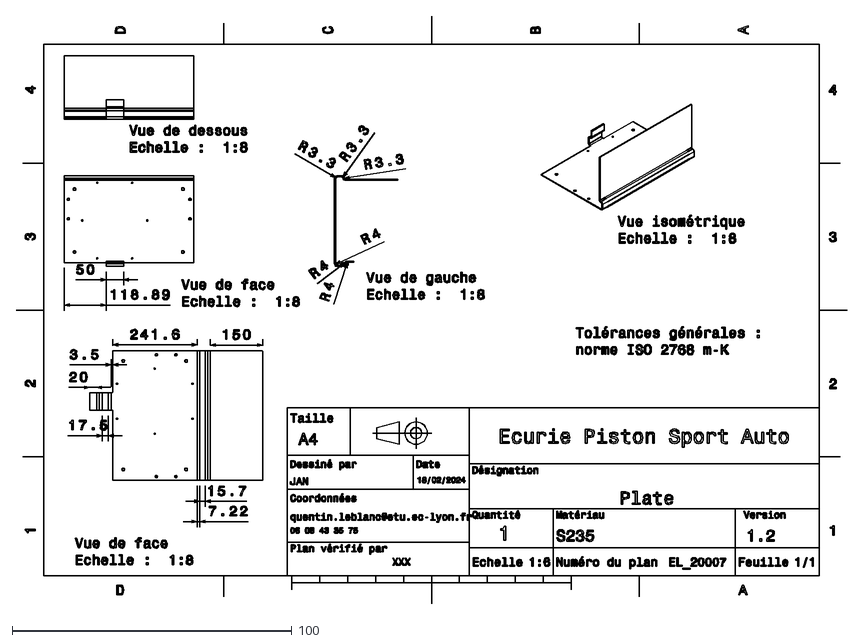
[picture p454: CAD file, 2024-02-20]
01 - Maquette CATIA/AA - Mise en plan/La mache laser/3e vague/S235/pliée/3mm/EL_20007 (Plate).dxf
297.0 x 210.0
