EOSCogniton/ELIZ-2022/01 - Maquette CATIA/AA - Mise en plan/La mache laser/3e vague/S235/pliée/4mm/EL_20005 (L Mount).dxf

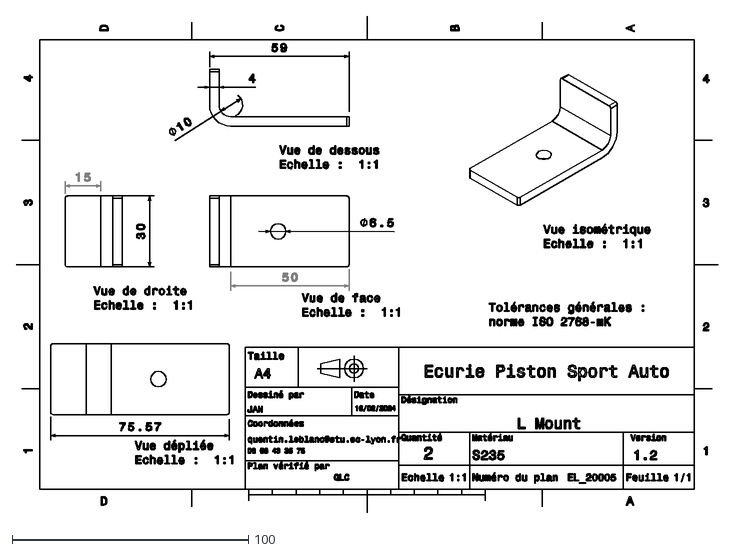
[picture p455: CAD file, 2024-04-24]
01 - Maquette CATIA/AA - Mise en plan/La mache laser/3e vague/S235/pliée/4mm/EL_20005 (L Mount).dxf
297.0 x 210.0
