EOSCogniton/ELIZ-2022/01 - Maquette CATIA/AA - Mise en plan/La mache laser/4e vague LAS/S355/3mm avec pliage/ST_04003 (Left Bracket).stp

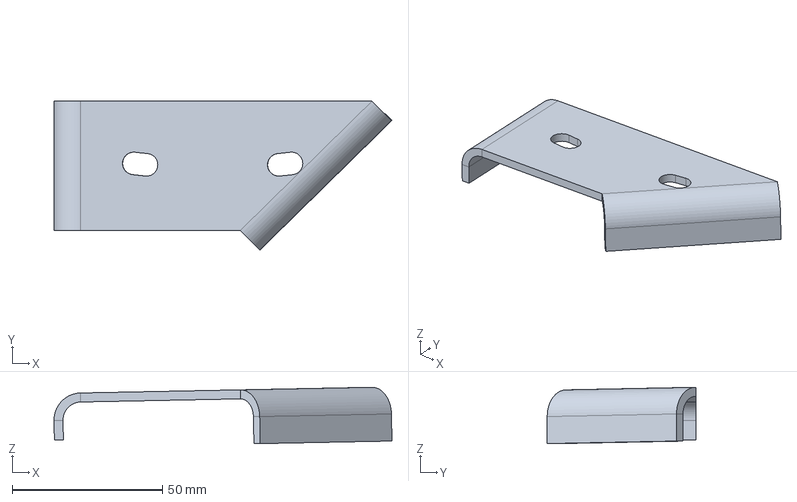
[picture p456: CAD file, 2024-02-20]
01 - Maquette CATIA/AA - Mise en plan/La mache laser/4e vague LAS/S355/3mm avec pliage/ST_04003 (Left Bracket).stp
112.4 x 49.4 x 18.8 mm
