EOSCogniton/ELIZ-2022/01 - Maquette CATIA/AA - Mise en plan/La mache laser/4e vague LAS/S355/3mm/ST_06003 (Right fixation tube).dxf

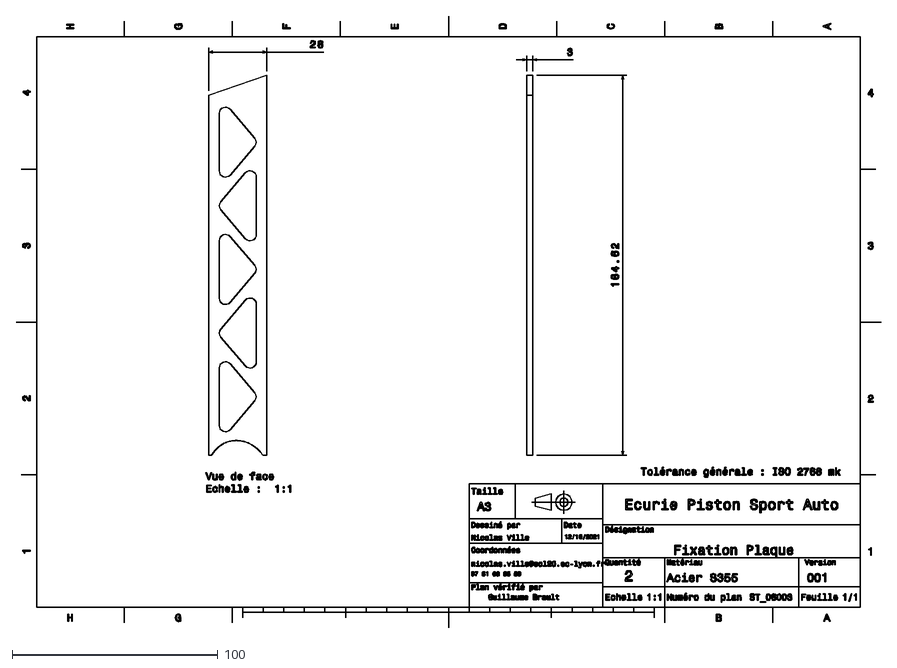
[picture p457: CAD file, 2024-02-20]
01 - Maquette CATIA/AA - Mise en plan/La mache laser/4e vague LAS/S355/3mm/ST_06003 (Right fixation tube).dxf
420.0 x 297.0
