EOSCogniton/ELIZ-2022/01 - Maquette CATIA/AA - Mise en plan/La mache laser/4e vague LAS/S355/4mm/Chape_Rw_la_Fp_Up.dxf

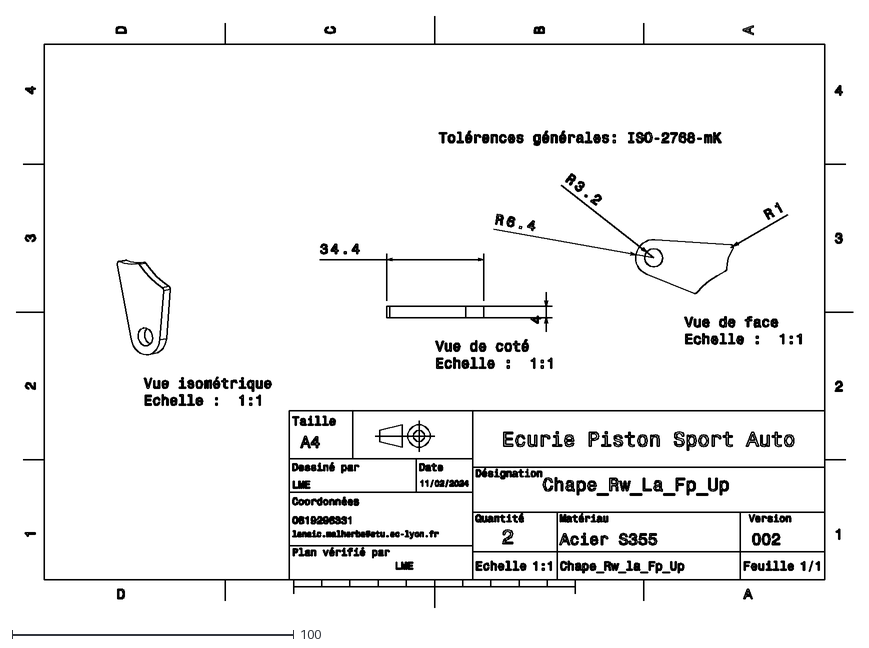
[picture p458: CAD file, 2024-02-20]
01 - Maquette CATIA/AA - Mise en plan/La mache laser/4e vague LAS/S355/4mm/Chape_Rw_la_Fp_Up.dxf
297.0 x 210.0
