EOSCogniton/ELIZ-2022/01 - Maquette CATIA/AA - Mise en plan/La mache laser/4e vague/S235/1.5mm/FR_04001_7.dxf

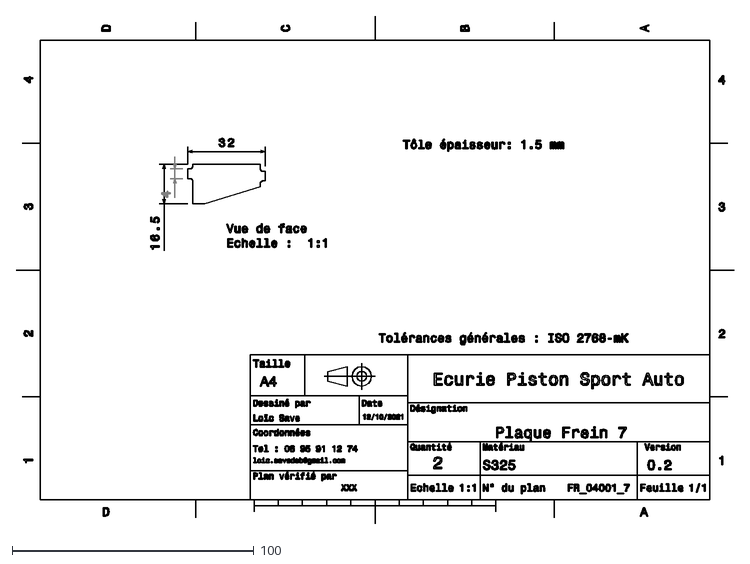
[picture p459: CAD file, 2024-03-05]
01 - Maquette CATIA/AA - Mise en plan/La mache laser/4e vague/S235/1.5mm/FR_04001_7.dxf
297.0 x 210.0
