EOSCogniton/ELIZ-2022/01 - Maquette CATIA/AA - Mise en plan/La mache laser/4e vague/S235/2mm/FR_04001_4.dxf

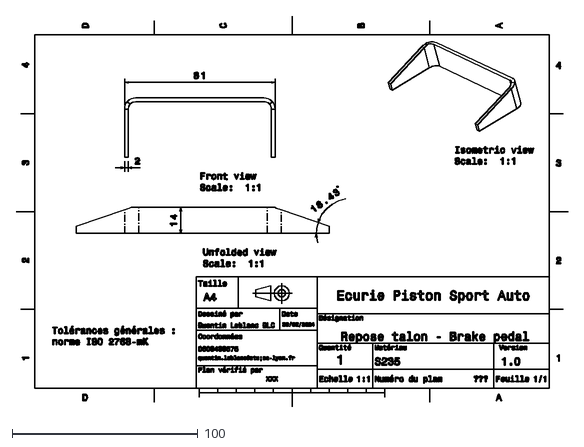
[picture p460: CAD file, 2024-02-20]
01 - Maquette CATIA/AA - Mise en plan/La mache laser/4e vague/S235/2mm/FR_04001_4.dxf
297.0 x 210.0
