EOSCogniton/ELIZ-2022/01 - Maquette CATIA/AA - Mise en plan/La mache laser/4e vague/S235/pliée/MS_02002_2 (Left Up Bracket Head Restraint).dxf

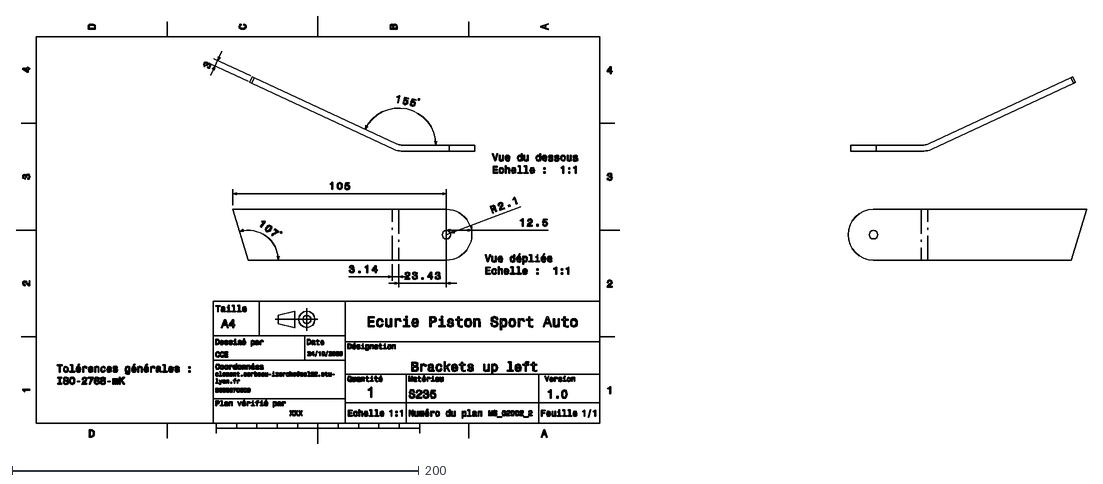
[picture p461: CAD file, 2023-11-14]
01 - Maquette CATIA/AA - Mise en plan/La mache laser/4e vague/S235/pliée/MS_02002_2 (Left Up Bracket Head Restraint).dxf
526.7 x 210.0
