EOSCogniton/ELIZ-2022/01 - Maquette CATIA/AA - Mise en plan/La mache laser/4e vague/S355/3mm/MS_01007_2 (Left Seat Bracket).dxf

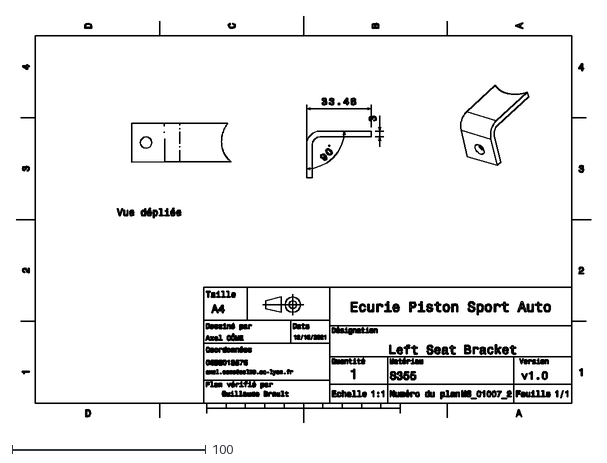
[picture p462: CAD file, 2023-05-31]
01 - Maquette CATIA/AA - Mise en plan/La mache laser/4e vague/S355/3mm/MS_01007_2 (Left Seat Bracket).dxf
297.0 x 210.0
