EOSCogniton/ELIZ-2022/01 - Maquette CATIA/AA - Mise en plan/La mache laser/4e vague/S355/pliée/4mm/SU_14011-chape-BAR.dxf

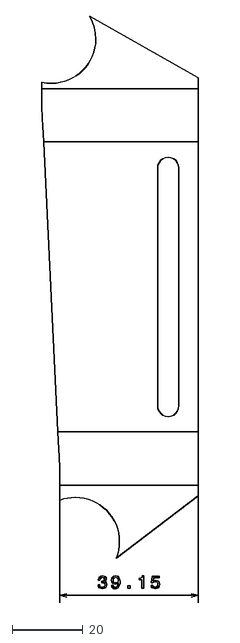
[picture p463: CAD file, 2024-03-05]
01 - Maquette CATIA/AA - Mise en plan/La mache laser/4e vague/S355/pliée/4mm/SU_14011-chape-BAR.dxf
44.3 x 165.7
