EOSCogniton/ELIZ-2022/01 - Maquette CATIA/AA - Mise en plan/La mache laser/5e vague/Aluminium/2mm/MS_04003 (Lower Part).dxf

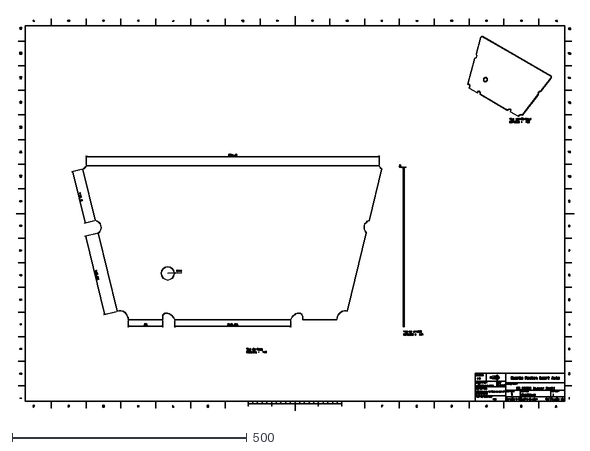
[picture p464: CAD file, 2024-05-22]
01 - Maquette CATIA/AA - Mise en plan/La mache laser/5e vague/Aluminium/2mm/MS_04003 (Lower Part).dxf
1189.0 x 841.0
