EOSCogniton/ELIZ-2022/01 - Maquette CATIA/AA - Mise en plan/La mache laser/5e vague/S235/2 mm/mepST_05001.dxf

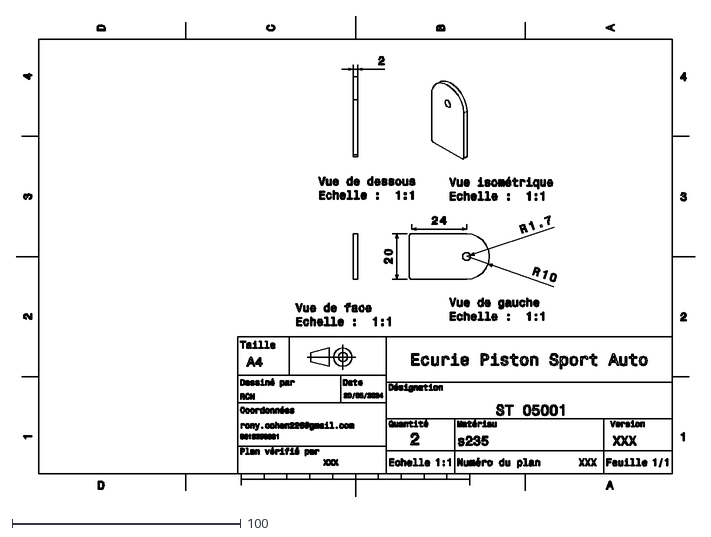
[picture p465: CAD file, 2024-05-21]
01 - Maquette CATIA/AA - Mise en plan/La mache laser/5e vague/S235/2 mm/mepST_05001.dxf
297.0 x 210.0
