EOSCogniton/ELIZ-2022/01 - Maquette CATIA/AA - Mise en plan/La mache laser/5e vague/S355/1.5mm/MS_04005 (Bracket 2).dxf

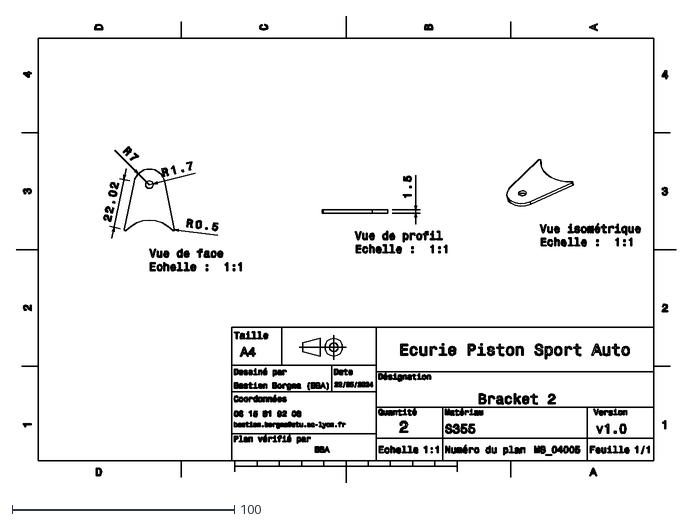
[picture p466: CAD file, 2024-05-23]
01 - Maquette CATIA/AA - Mise en plan/La mache laser/5e vague/S355/1.5mm/MS_04005 (Bracket 2).dxf
297.0 x 210.0
