EOSCogniton/ELIZ-2022/01 - Maquette CATIA/AA - Mise en plan/La mache laser/5e vague/S355/4 mm/Chape L.dxf

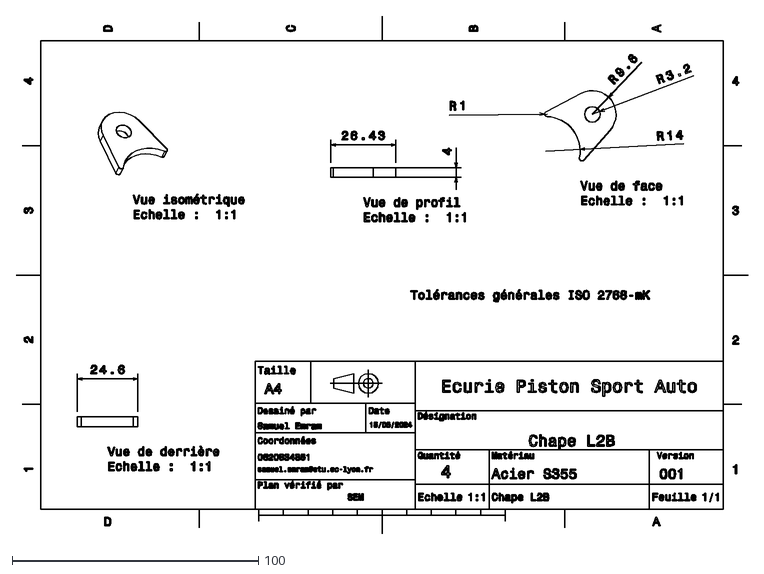
[picture p467: CAD file, 2024-05-19]
01 - Maquette CATIA/AA - Mise en plan/La mache laser/5e vague/S355/4 mm/Chape L.dxf
297.0 x 210.0
