EOSCogniton/ELIZ-2022/01 - Maquette CATIA/AA - Mise en plan/La mache laser/5e vague/S355/plié/MS_04003 (Bracket_3).igs

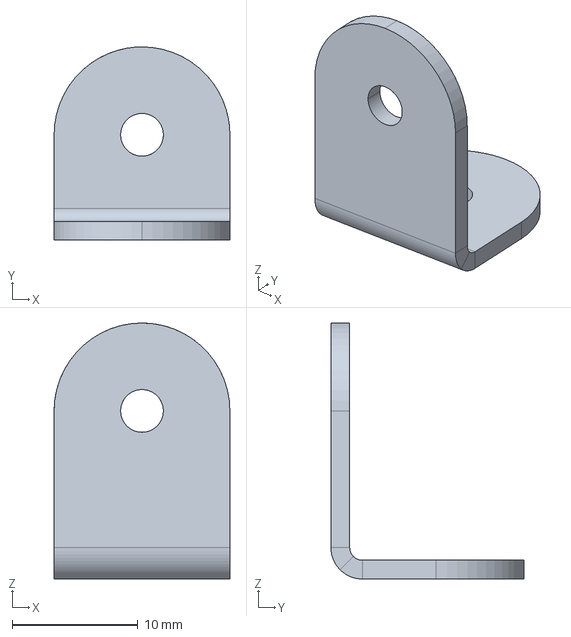
[picture p468: CAD file, 2024-05-23]
01 - Maquette CATIA/AA - Mise en plan/La mache laser/5e vague/S355/plié/MS_04003 (Bracket_3).igs
14.0 x 15.4 x 20.4 mm
