EOSCogniton/ELIZ-2022/01 - Maquette CATIA/AA - Mise en plan/La mache laser/6e vague/1.5mm/FR_05002.dxf

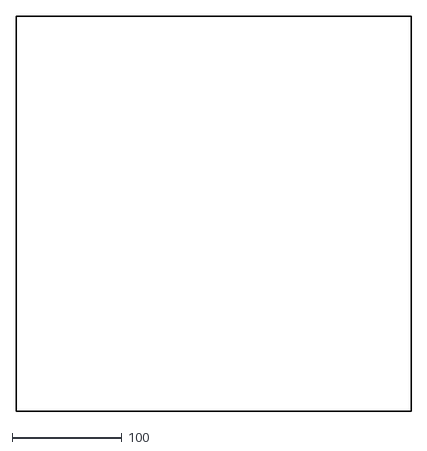
[picture p469: CAD file, 2024-10-13]
01 - Maquette CATIA/AA - Mise en plan/La mache laser/6e vague/1.5mm/FR_05002.dxf
360.0 x 360.0
