EOSCogniton/ELIZ-2022/01 - Maquette CATIA/AA - Mise en plan/La mache laser/6e vague/2mm/EL_18001/EL_18001.dxf

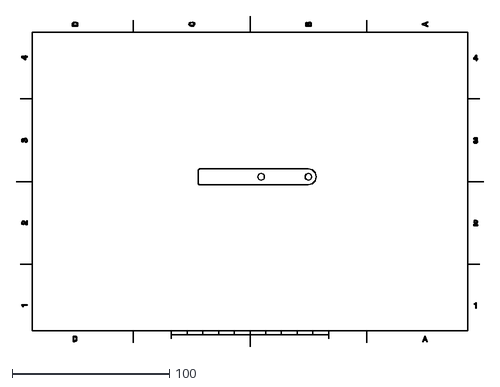
[picture p470: CAD file, 2024-10-13]
01 - Maquette CATIA/AA - Mise en plan/La mache laser/6e vague/2mm/EL_18001/EL_18001.dxf
297.0 x 210.0
