EOSCogniton/ELIZ-2022/01 - Maquette CATIA/AA - Mise en plan/La mache laser/6e vague/2mm/MS_01006/MS_01006 (Bracket seat rear).dxf

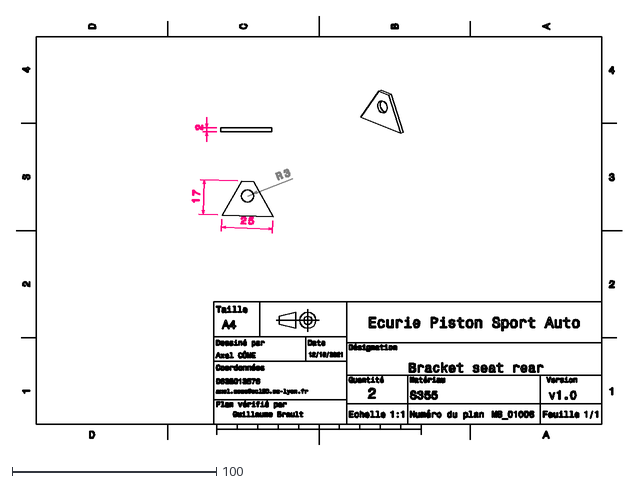
[picture p471: CAD file, 2024-10-12]
01 - Maquette CATIA/AA - Mise en plan/La mache laser/6e vague/2mm/MS_01006/MS_01006 (Bracket seat rear).dxf
297.0 x 210.0
