EOSCogniton/ELIZ-2022/01 - Maquette CATIA/AA - Mise en plan/La mache laser/6e vague/2mm/MS_04004/MS_04004 (Firewall bracket).dxf

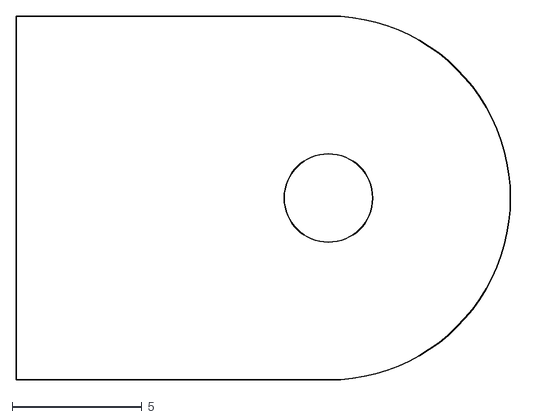
[picture p472: CAD file, 2024-10-13]
01 - Maquette CATIA/AA - Mise en plan/La mache laser/6e vague/2mm/MS_04004/MS_04004 (Firewall bracket).dxf
19.3 x 14.0
