EOSCogniton/ELIZ-2022/01 - Maquette CATIA/AA - Mise en plan/La mache laser/6e vague/3mm/EL_16002/EL_16002.dxf

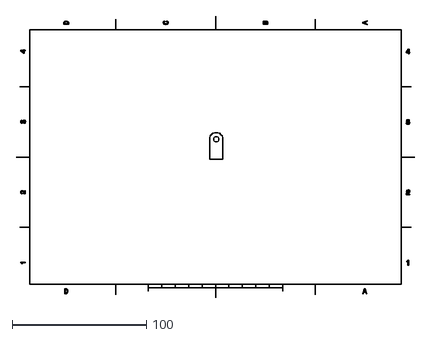
[picture p473: CAD file, 2024-10-13]
01 - Maquette CATIA/AA - Mise en plan/La mache laser/6e vague/3mm/EL_16002/EL_16002.dxf
297.0 x 210.0
