EOSCogniton/ELIZ-2022/01 - Maquette CATIA/AA - Mise en plan/La mache laser/6e vague/4mm/Fw_La/Chape_Fw_La_Fp_Low.dxf

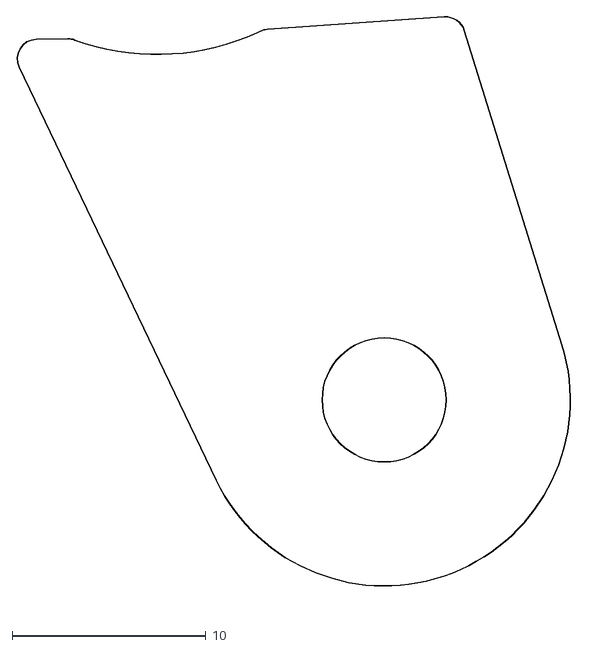
[picture p474: CAD file, 2024-10-13]
01 - Maquette CATIA/AA - Mise en plan/La mache laser/6e vague/4mm/Fw_La/Chape_Fw_La_Fp_Low.dxf
29.7 x 30.6
