EOSCogniton/ELIZ-2022/01 - Maquette CATIA/AA - Mise en plan/La mache laser/6e vague/4mm/Fw_Ua/Chape_Fw_Ua_Fp_Low.dxf

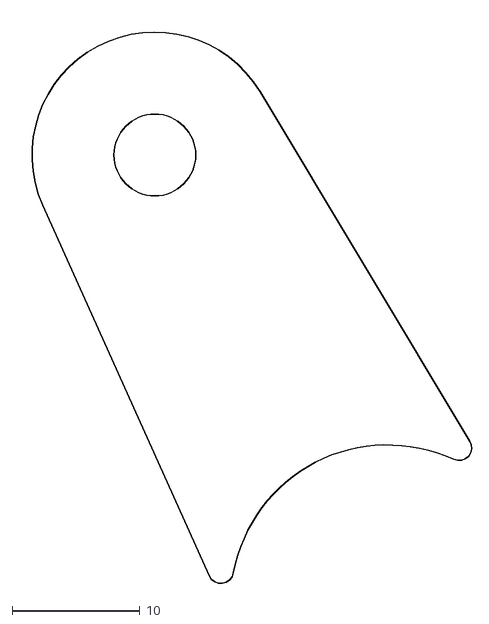
[picture p475: CAD file, 2024-10-13]
01 - Maquette CATIA/AA - Mise en plan/La mache laser/6e vague/4mm/Fw_Ua/Chape_Fw_Ua_Fp_Low.dxf
35.7 x 44.4
