EOSCogniton/ELIZ-2022/01 - Maquette CATIA/AA - Mise en plan/La mache laser/7e vague/Alu AG3/2.5mm/MS_04001 (Middle part).igs

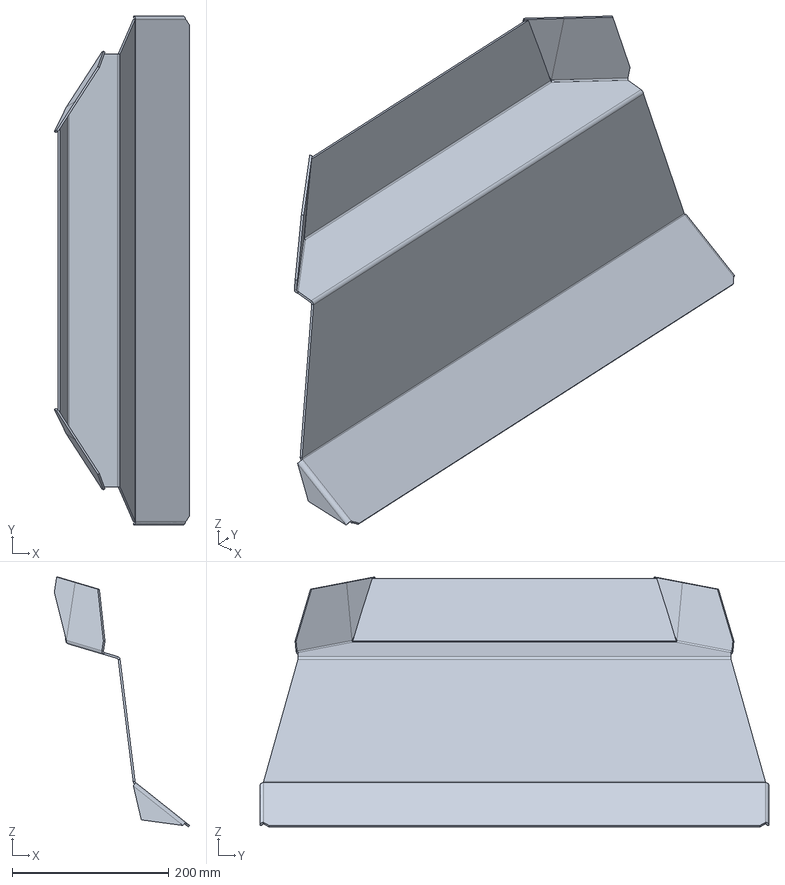
[picture p476: CAD file, 2024-12-15]
01 - Maquette CATIA/AA - Mise en plan/La mache laser/7e vague/Alu AG3/2.5mm/MS_04001 (Middle part).igs
172.8 x 649.7 x 319.2 mm
