EOSCogniton/ELIZ-2022/01 - Maquette CATIA/AA - Mise en plan/La mache laser/7e vague/S355/4mm/Chape_M2_b.dxf

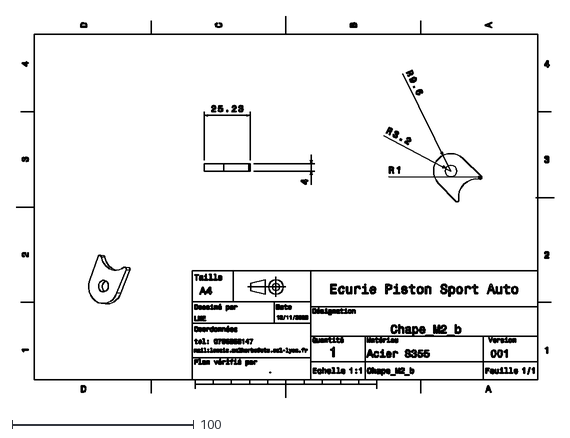
[picture p477: CAD file, 2023-11-14]
01 - Maquette CATIA/AA - Mise en plan/La mache laser/7e vague/S355/4mm/Chape_M2_b.dxf
295.9 x 210.0
