EOSCogniton/ELIZ-2022/01 - Maquette CATIA/AA - Mise en plan/La mache laser/Brake Pedal/FR_04018 (Brake Threated Rod).dxf

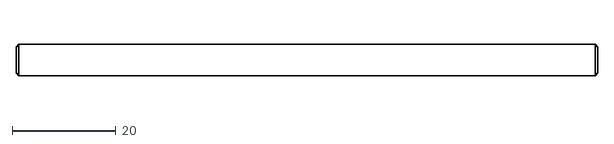
[picture p478: CAD file, 2023-02-03]
01 - Maquette CATIA/AA - Mise en plan/La mache laser/Brake Pedal/FR_04018 (Brake Threated Rod).dxf
112.0 x 6.00
