EOSCogniton/ELIZ-2022/01 - Maquette CATIA/AA - Mise en plan/La mache laser/CHAIPE/EN_02008 (water pump bottom) mep.dxf

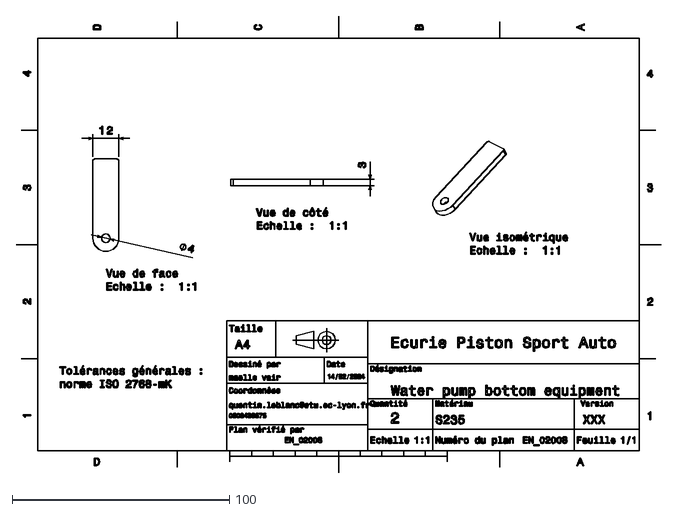
[picture p479: CAD file, 2024-02-20]
01 - Maquette CATIA/AA - Mise en plan/La mache laser/CHAIPE/EN_02008 (water pump bottom) mep.dxf
297.0 x 210.0
