EOSCogniton/ELIZ-2022/01 - Maquette CATIA/AA - Mise en plan/La mache laser/chapes RW LA/Chape_RRocker_R.dxf

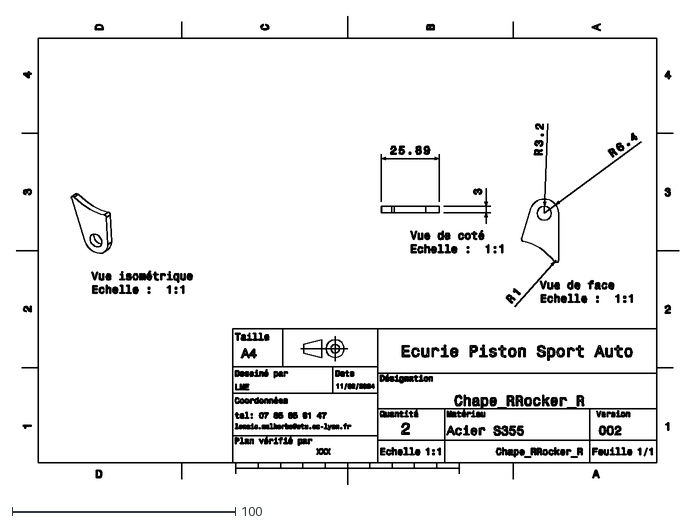
[picture p480: CAD file, 2024-02-20]
01 - Maquette CATIA/AA - Mise en plan/La mache laser/chapes RW LA/Chape_RRocker_R.dxf
297.0 x 210.0
