EOSCogniton/ELIZ-2022/01 - Maquette CATIA/AA - Mise en plan/La mache laser/chapes ST/ST_06006 (Fixation U joint bottom).dxf

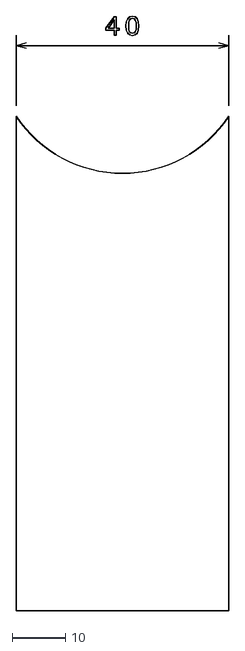
[picture p481: CAD file, 2024-02-20]
01 - Maquette CATIA/AA - Mise en plan/La mache laser/chapes ST/ST_06006 (Fixation U joint bottom).dxf
40.0 x 111.7
