EOSCogniton/ELIZ-2022/01 - Maquette CATIA/AA - Mise en plan/La mache laser/Chapes/Chapes_SU_Artemiz/Basculeur arrière/Chape_Re_Damper_Down.dxf

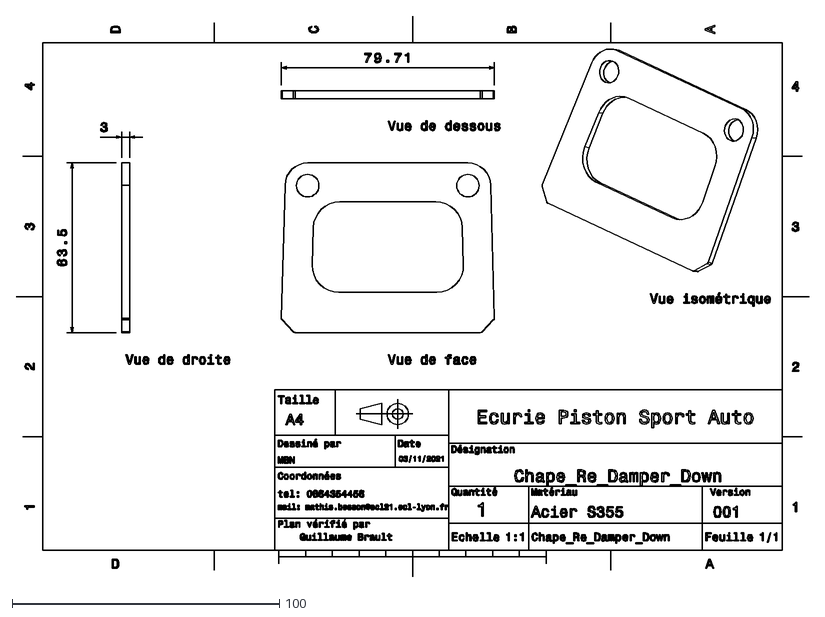
[picture p482: CAD file, 2023-11-14]
01 - Maquette CATIA/AA - Mise en plan/La mache laser/Chapes/Chapes_SU_Artemiz/Basculeur arrière/Chape_Re_Damper_Down.dxf
297.0 x 210.0
