EOSCogniton/ELIZ-2022/01 - Maquette CATIA/AA - Mise en plan/La mache laser/Chapes/Chapes_SU_Artemiz/Basculeur avant/Chape_FRocker_F.dxf

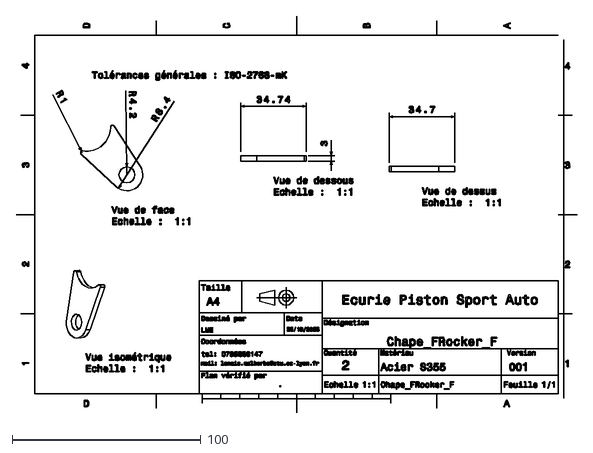
[picture p483: CAD file, 2023-11-14]
01 - Maquette CATIA/AA - Mise en plan/La mache laser/Chapes/Chapes_SU_Artemiz/Basculeur avant/Chape_FRocker_F.dxf
297.0 x 210.0
