EOSCogniton/ELIZ-2022/01 - Maquette CATIA/AA - Mise en plan/La mache laser/Chapes/Chapes_SU_Artemiz/Chape_Rw_Ua_Rp_Up.dxf

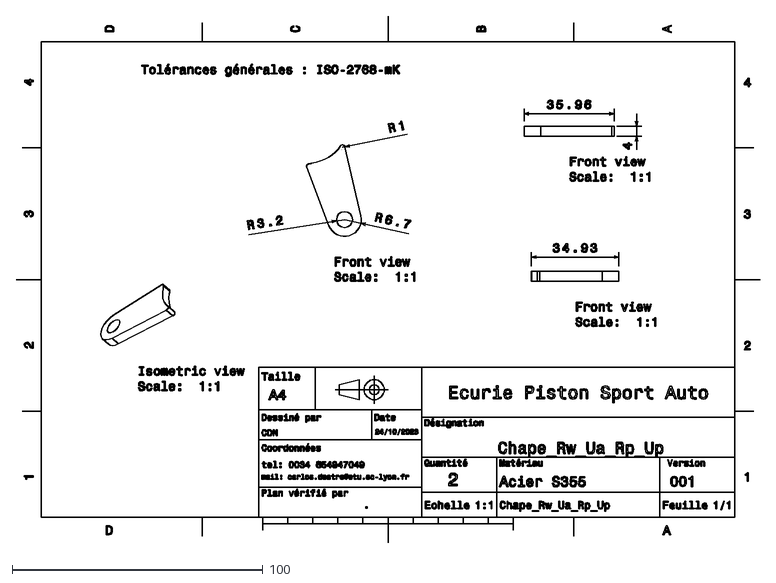
[picture p484: CAD file, 2023-11-14]
01 - Maquette CATIA/AA - Mise en plan/La mache laser/Chapes/Chapes_SU_Artemiz/Chape_Rw_Ua_Rp_Up.dxf
297.0 x 210.0
