EOSCogniton/ELIZ-2022/01 - Maquette CATIA/AA - Mise en plan/La mache laser/Chapes/FR_03005 (Rear Throttle bracket)/FR_03005 (Rear Throttle bracket).dxf

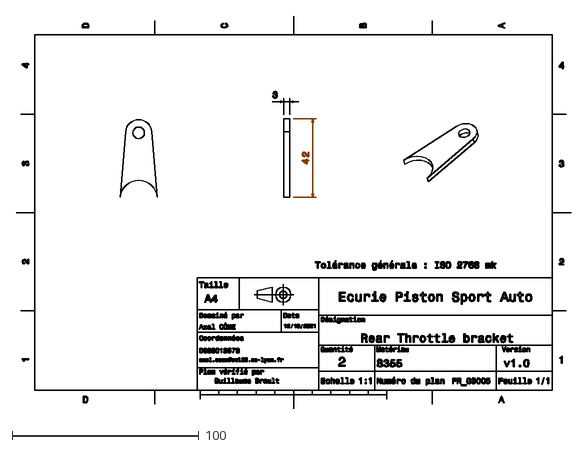
[picture p485: CAD file, 2023-11-14]
01 - Maquette CATIA/AA - Mise en plan/La mache laser/Chapes/FR_03005 (Rear Throttle bracket)/FR_03005 (Rear Throttle bracket).dxf
297.0 x 210.0
