EOSCogniton/ELIZ-2022/01 - Maquette CATIA/AA - Mise en plan/La mache laser/derniere vague/2mm plié/S235/EN_02015/EN_02015 (Radiator Low Rear Bar).igs

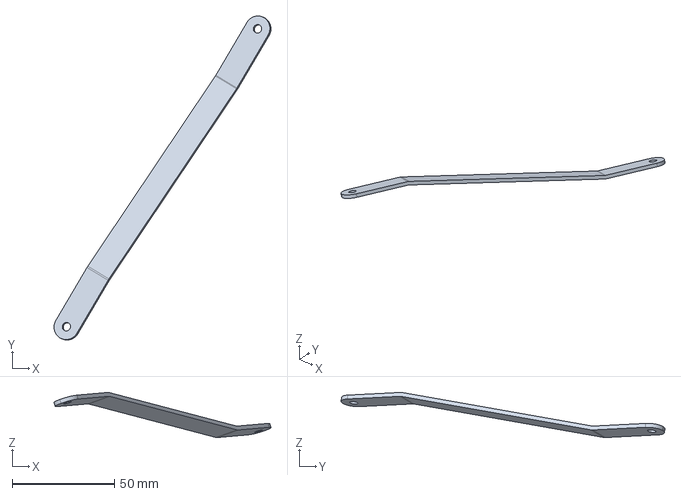
[picture p486: CAD file, 2025-02-04]
01 - Maquette CATIA/AA - Mise en plan/La mache laser/derniere vague/2mm plié/S235/EN_02015/EN_02015 (Radiator Low Rear Bar).igs
106.0 x 158.3 x 22.1 mm
