EOSCogniton/ELIZ-2022/01 - Maquette CATIA/AA - Mise en plan/La mache laser/derniere vague/2mm plié/S355/EN_040XX/Chainshield_bracket_1.igs

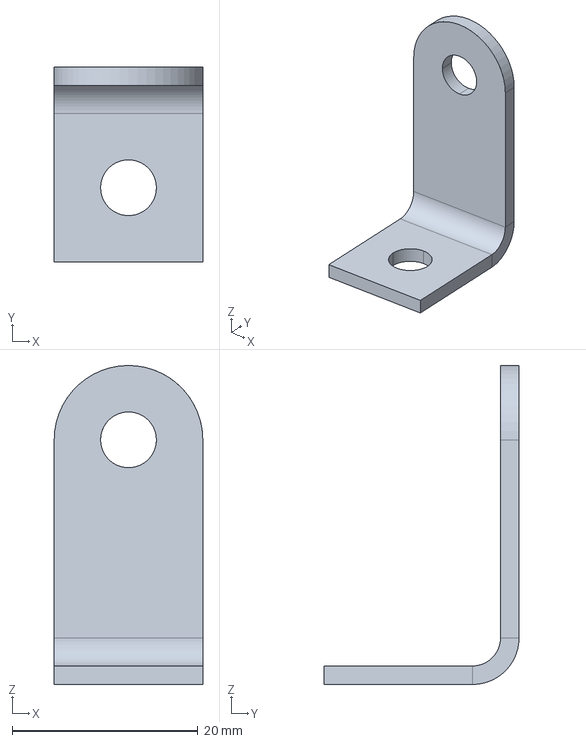
[picture p487: CAD file, 2024-05-23]
01 - Maquette CATIA/AA - Mise en plan/La mache laser/derniere vague/2mm plié/S355/EN_040XX/Chainshield_bracket_1.igs
16.0 x 21.0 x 34.3 mm
