EOSCogniton/ELIZ-2022/01 - Maquette CATIA/AA - Mise en plan/La mache laser/derniere vague/3mm S355/chapes/chape_rrocker_f.dxf

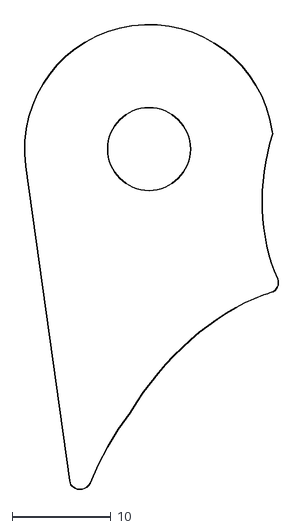
[picture p488: CAD file, 2025-02-04]
01 - Maquette CATIA/AA - Mise en plan/La mache laser/derniere vague/3mm S355/chapes/chape_rrocker_f.dxf
26.6 x 47.9
