EOSCogniton/ELIZ-2022/01 - Maquette CATIA/AA - Mise en plan/La mache laser/derniere vague/3mm S355/Extension baquet/MS_01008 (Front bracket extension).dxf

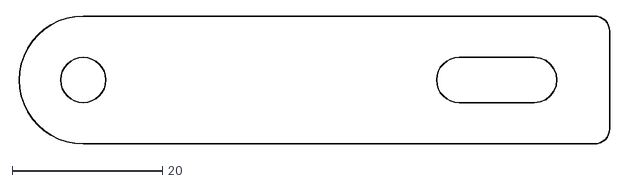
[picture p489: CAD file, 2025-03-13]
01 - Maquette CATIA/AA - Mise en plan/La mache laser/derniere vague/3mm S355/Extension baquet/MS_01008 (Front bracket extension).dxf
78.9 x 17.0
