EOSCogniton/ELIZ-2022/01 - Maquette CATIA/AA - Mise en plan/La mache laser/derniere vague/3mm S355/Pédale de frein/FR_04001 (Frame Brake).igs

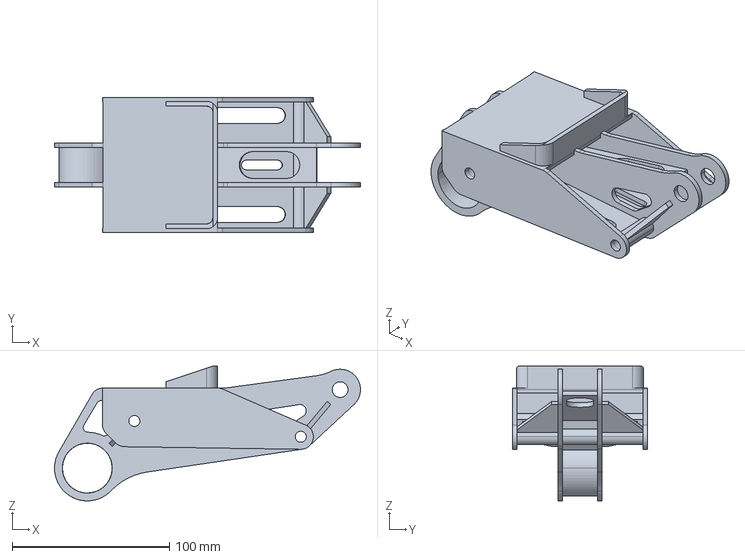
[picture p490: CAD file, 2025-02-04]
01 - Maquette CATIA/AA - Mise en plan/La mache laser/derniere vague/3mm S355/Pédale de frein/FR_04001 (Frame Brake).igs
194.9 x 86.0 x 85.9 mm
