EOSCogniton/ELIZ-2022/01 - Maquette CATIA/AA - Mise en plan/La mache laser/derniere vague/3mm S355/Pédale de frein/Plans de découpe/FR_04001_2 (Frame Brake)test.dxf

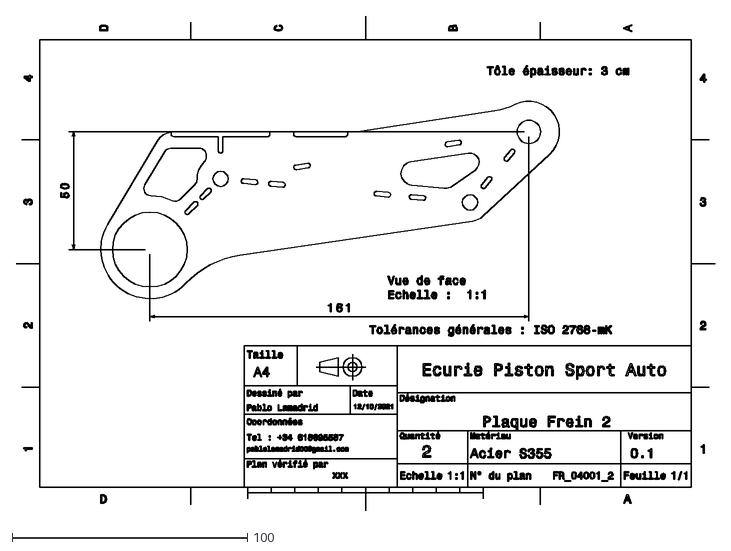
[picture p491: CAD file, 2025-03-13]
01 - Maquette CATIA/AA - Mise en plan/La mache laser/derniere vague/3mm S355/Pédale de frein/Plans de découpe/FR_04001_2 (Frame Brake)test.dxf
297.0 x 210.0
