EOSCogniton/ELIZ-2022/01 - Maquette CATIA/AA - Mise en plan/La mache laser/modification découpé-plié/SU_14011 (chape BAR).dxf

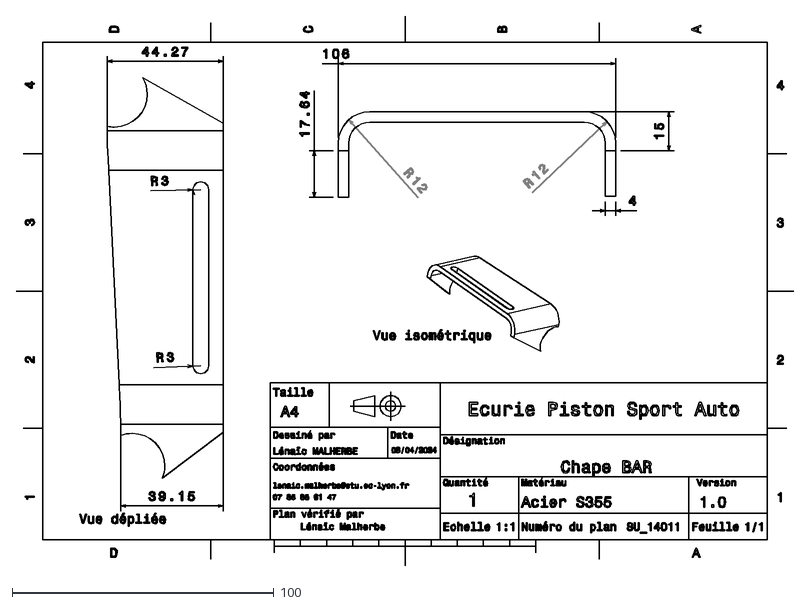
[picture p492: CAD file, 2024-04-03]
01 - Maquette CATIA/AA - Mise en plan/La mache laser/modification découpé-plié/SU_14011 (chape BAR).dxf
297.0 x 210.0
