EOSCogniton/ELIZ-2022/01 - Maquette CATIA/AA - Mise en plan/La mache laser/Pare feu/Plans de découpe/MS_04008 (Paroi pare feu - side).igs

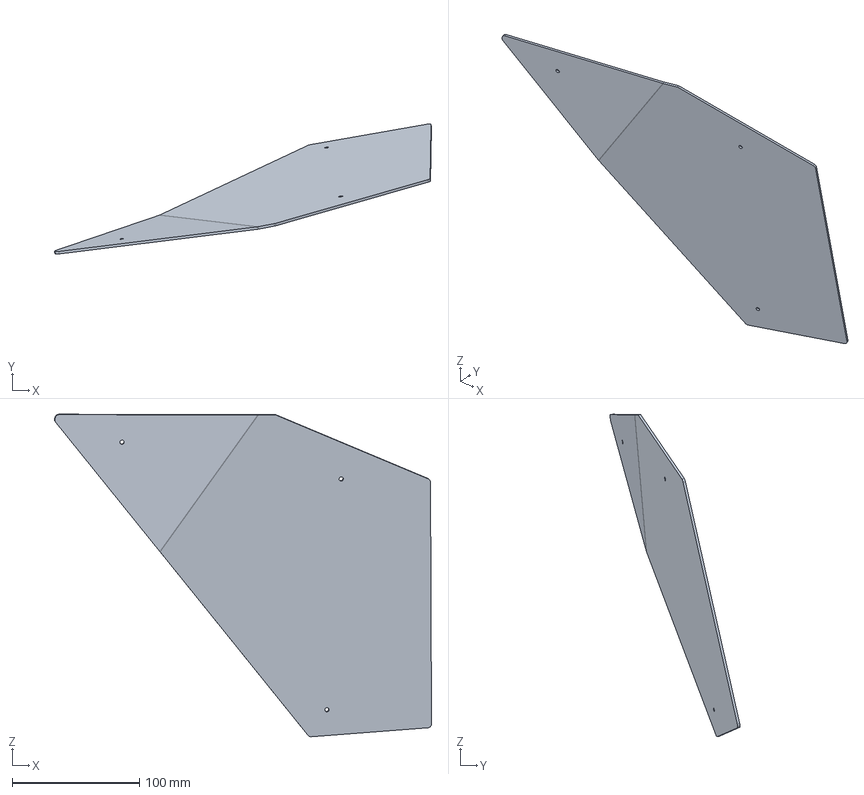
[picture p493: CAD file, 2024-12-15]
01 - Maquette CATIA/AA - Mise en plan/La mache laser/Pare feu/Plans de découpe/MS_04008 (Paroi pare feu - side).igs
296.6 x 102.4 x 253.8 mm
