EOSCogniton/ELIZ-2022/01 - Maquette CATIA/AA - Mise en plan/La mache laser/shields chaine et moteur/Chain/bracket 1/bracket1_shield.dxf

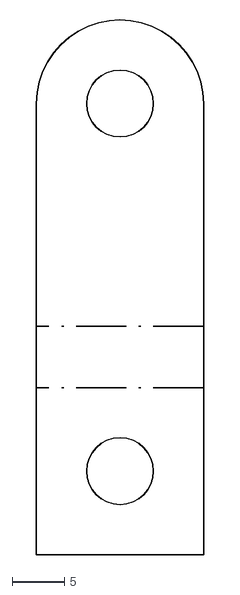
[picture p494: CAD file, 2025-05-28]
01 - Maquette CATIA/AA - Mise en plan/La mache laser/shields chaine et moteur/Chain/bracket 1/bracket1_shield.dxf
16.0 x 51.6
