EOSCogniton/ELIZ-2022/01 - Maquette CATIA/AA - Mise en plan/La mache laser/shields chaine et moteur/Chain/bracket 2/bracket2_shield.dxf

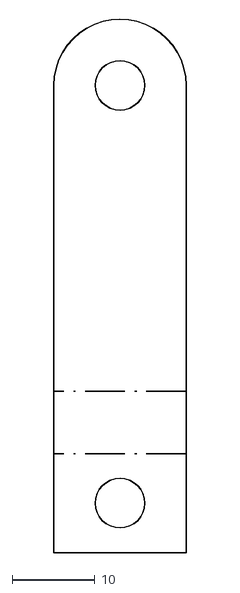
[picture p495: CAD file, 2025-05-28]
01 - Maquette CATIA/AA - Mise en plan/La mache laser/shields chaine et moteur/Chain/bracket 2/bracket2_shield.dxf
16.0 x 64.9
