EOSCogniton/ELIZ-2022/01 - Maquette CATIA/AA - Mise en plan/La mache laser/shields chaine et moteur/Chain/chainshield/mep_chainshieldv2.dxf

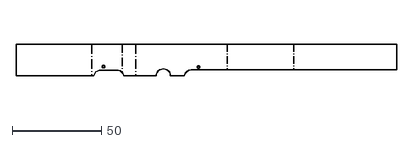
[picture p496: CAD file, 2025-05-28]
01 - Maquette CATIA/AA - Mise en plan/La mache laser/shields chaine et moteur/Chain/chainshield/mep_chainshieldv2.dxf
212.7 x 17.9
