EOSCogniton/ELIZ-2022/01 - Maquette CATIA/AA - Mise en plan/La mache laser/shields chaine et moteur/Motor/Bracket 1/bracket1.dxf

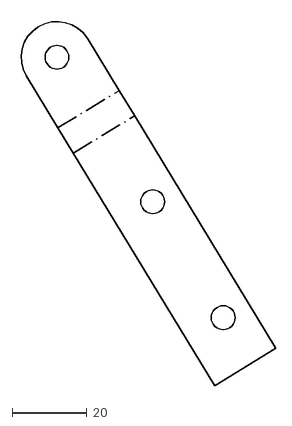
[picture p497: CAD file, 2025-05-28]
01 - Maquette CATIA/AA - Mise en plan/La mache laser/shields chaine et moteur/Motor/Bracket 1/bracket1.dxf
69.7 x 99.1
