EOSCogniton/ELIZ-2022/01 - Maquette CATIA/AA - Mise en plan/La mache laser/shields chaine et moteur/Motor/Bracket 2/bracket2.dxf

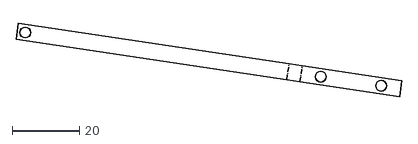
[picture p498: CAD file, 2025-05-28]
01 - Maquette CATIA/AA - Mise en plan/La mache laser/shields chaine et moteur/Motor/Bracket 2/bracket2.dxf
114.9 x 21.8
