EOSCogniton/ELIZ-2022/01 - Maquette CATIA/AA - Mise en plan/La mache laser/shields chaine et moteur/motor/motor_casing/motor_casing.stp

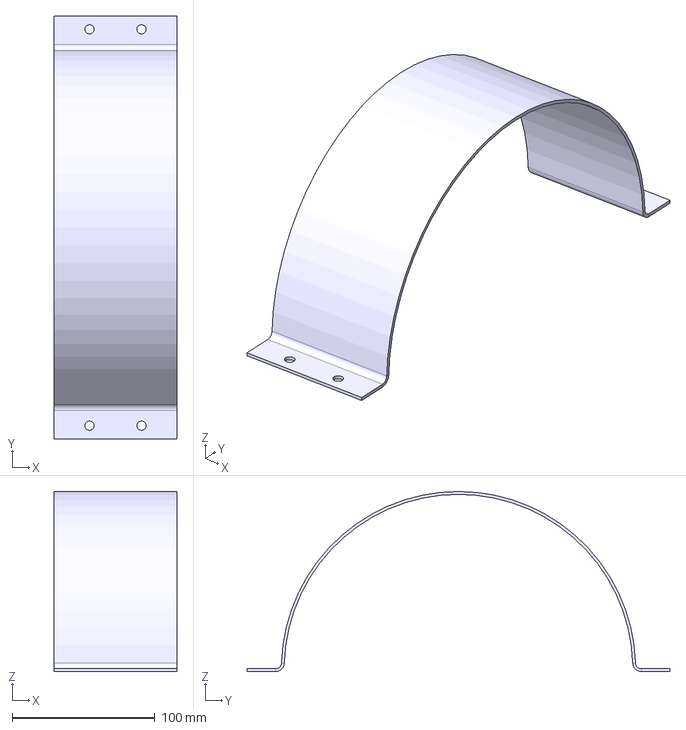
[picture p499: CAD file, 2025-05-23]
01 - Maquette CATIA/AA - Mise en plan/La mache laser/shields chaine et moteur/motor/motor_casing/motor_casing.stp
86.0 x 295.9 x 126.0 mm
