EOSCogniton/ELIZ-2022/01 - Maquette CATIA/AA - Mise en plan/La mache laser/shields chaine et moteur/motor/Plaque/plaque.stp

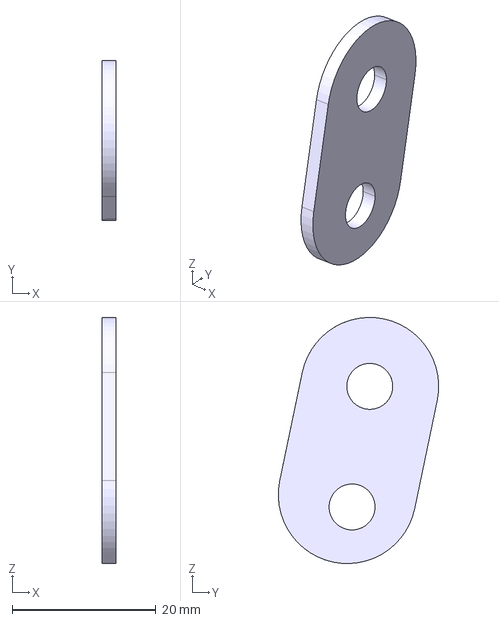
[picture p500: CAD file, 2025-05-23]
01 - Maquette CATIA/AA - Mise en plan/La mache laser/shields chaine et moteur/motor/Plaque/plaque.stp
2.01 x 22.3 x 34.3 mm
