EOSCogniton/ELIZ-2022/01 - Maquette CATIA/AA - Mise en plan/MS_Miscellaneous/MS_01006/MS_01006.dxf

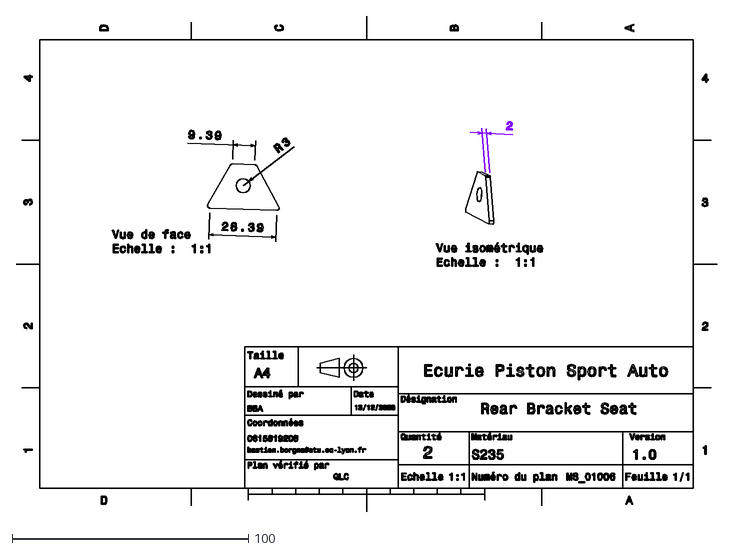
[picture p501: CAD file, 2023-12-13]
01 - Maquette CATIA/AA - Mise en plan/MS_Miscellaneous/MS_01006/MS_01006.dxf
297.0 x 210.0
