EOSCogniton/ELIZ-2022/01 - Maquette CATIA/AA - Mise en plan/MS_Miscellaneous/MS_02004/MS_02004_1.dxf

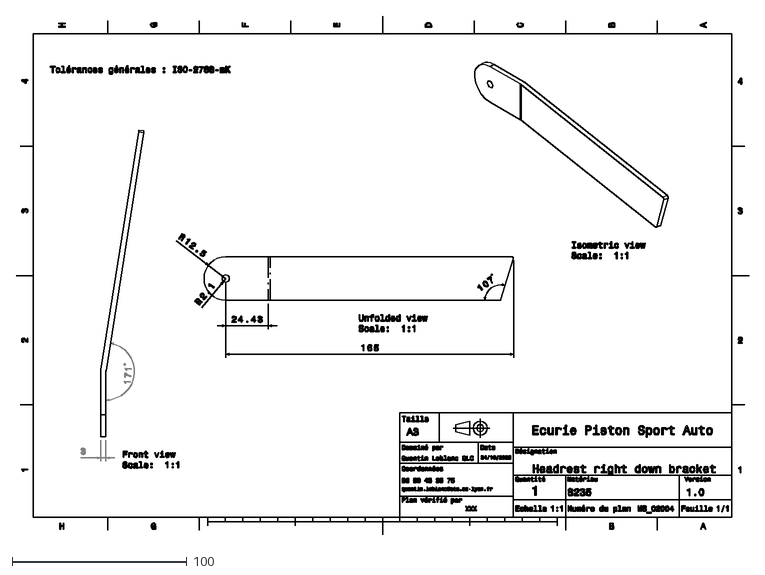
[picture p502: CAD file, 2023-11-14]
01 - Maquette CATIA/AA - Mise en plan/MS_Miscellaneous/MS_02004/MS_02004_1.dxf
420.0 x 297.0
