EOSCogniton/ELIZ-2022/01 - Maquette CATIA/AA - Mise en plan/MS_Miscellaneous/MS_03004/MS_03004 (Anti-submarine + lap belt bracket).dxf

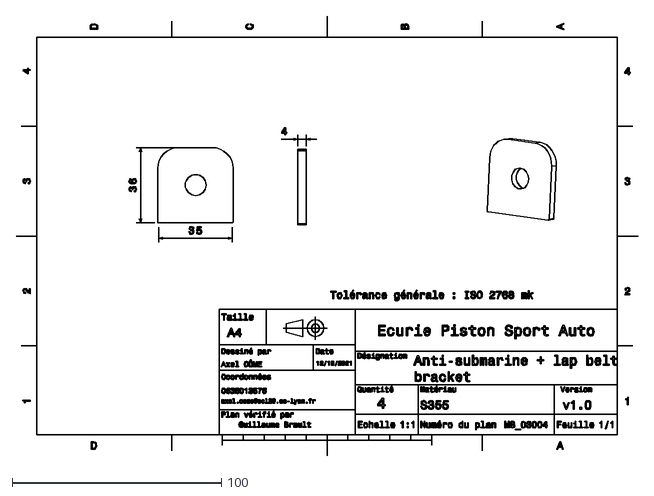
[picture p503: CAD file, 2023-05-31]
01 - Maquette CATIA/AA - Mise en plan/MS_Miscellaneous/MS_03004/MS_03004 (Anti-submarine + lap belt bracket).dxf
297.0 x 210.0
