EOSCogniton/ELIZ-2022/01 - Maquette CATIA/AA - Mise en plan/MS_Miscellaneous/MS_0400 (Firewall)/MS_04005 (Bracket 2).dxf

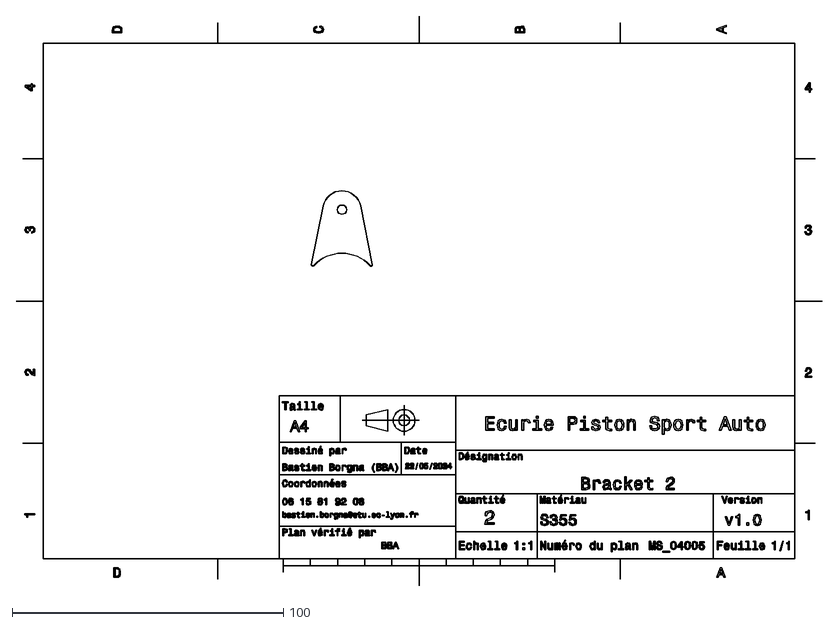
[picture p504: CAD file, 2024-05-23]
01 - Maquette CATIA/AA - Mise en plan/MS_Miscellaneous/MS_0400 (Firewall)/MS_04005 (Bracket 2).dxf
297.0 x 210.0
