EOSCogniton/ELIZ-2022/01 - Maquette CATIA/AA - Mise en plan/MS_Miscellaneous/MS_04005/MS_04005 (Firewall bracket).dxf

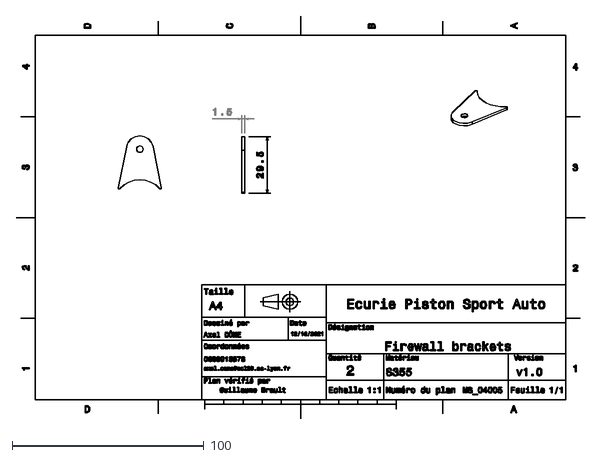
[picture p506: CAD file, 2023-05-31]
01 - Maquette CATIA/AA - Mise en plan/MS_Miscellaneous/MS_04005/MS_04005 (Firewall bracket).dxf
297.0 x 210.0
