EOSCogniton/ELIZ-2022/01 - Maquette CATIA/AA - Mise en plan/Noel metal/EL_TSAC/chapes_fixations/chapes_fixations.dxf

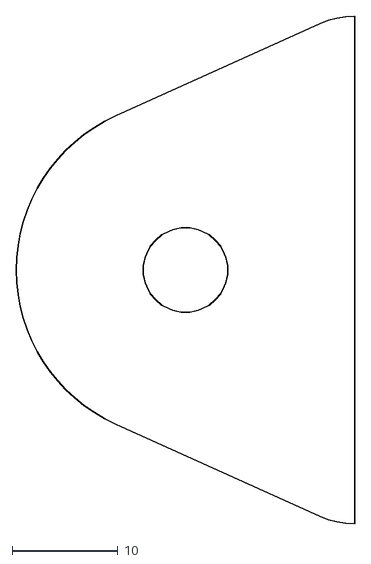
[picture p507: CAD file, 2025-06-09]
01 - Maquette CATIA/AA - Mise en plan/Noel metal/EL_TSAC/chapes_fixations/chapes_fixations.dxf
32.0 x 48.0
