EOSCogniton/ELIZ-2022/01 - Maquette CATIA/AA - Mise en plan/Noel metal/EL_TSAC/couvercle/EL_22000 (TSAC)_Mark2.stp

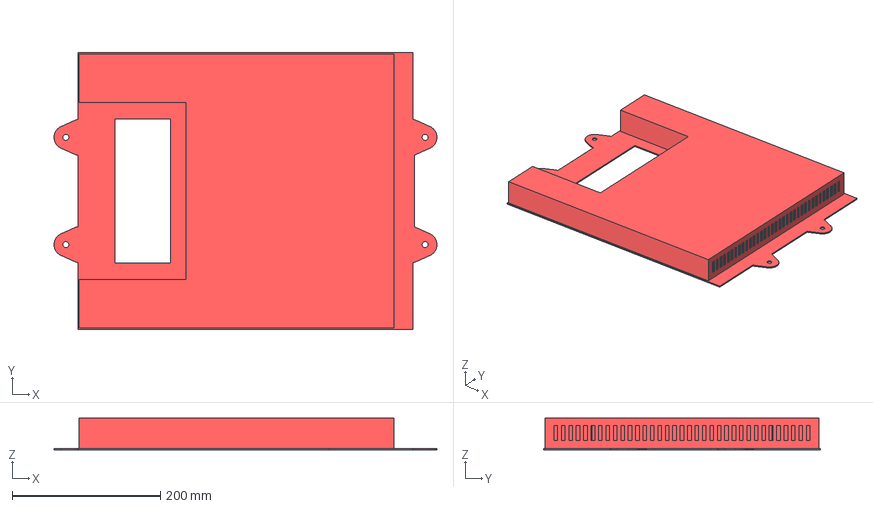
[picture p508: CAD file, 2025-06-11]
01 - Maquette CATIA/AA - Mise en plan/Noel metal/EL_TSAC/couvercle/EL_22000 (TSAC)_Mark2.stp
516.0 x 373.0 x 43.0 mm
