EOSCogniton/ELIZ-2022/01 - Maquette CATIA/AA - Mise en plan/Noel metal/EL_TSAC/couvercle/midplate avant/midplate avant.dxf

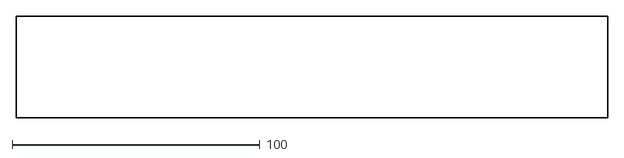
[picture p509: CAD file, 2025-06-11]
01 - Maquette CATIA/AA - Mise en plan/Noel metal/EL_TSAC/couvercle/midplate avant/midplate avant.dxf
239.0 x 41.0
