EOSCogniton/ELIZ-2022/01 - Maquette CATIA/AA - Mise en plan/Noel metal/EL_TSAC/couvercle/plaque avant soutien/plaque av soutien.dxf

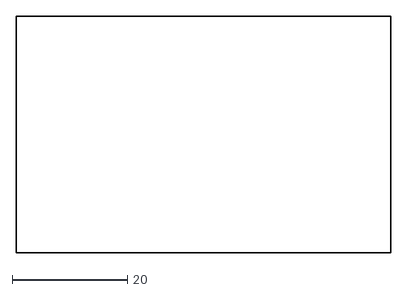
[picture p510: CAD file, 2025-06-11]
01 - Maquette CATIA/AA - Mise en plan/Noel metal/EL_TSAC/couvercle/plaque avant soutien/plaque av soutien.dxf
65.0 x 41.0
