EOSCogniton/ELIZ-2022/01 - Maquette CATIA/AA - Mise en plan/Noel metal/EL_TSAC/couvercle/plaque supérieure/plaque sup.dxf

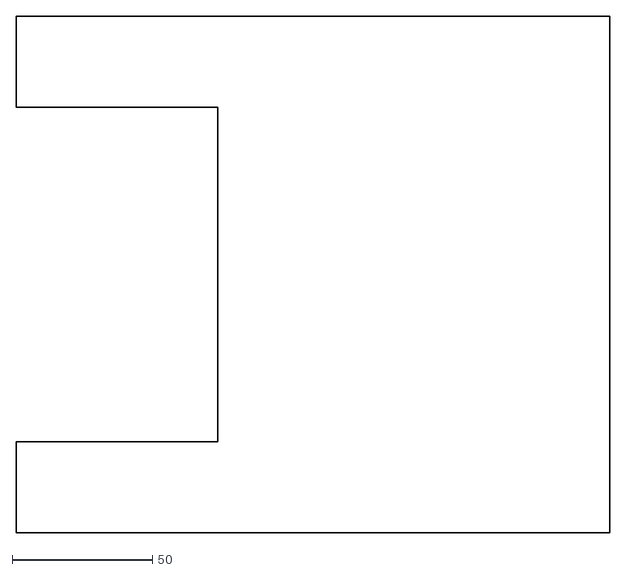
[picture p511: CAD file, 2025-06-11]
01 - Maquette CATIA/AA - Mise en plan/Noel metal/EL_TSAC/couvercle/plaque supérieure/plaque sup.dxf
212.0 x 184.5
