EOSCogniton/ELIZ-2022/01 - Maquette CATIA/AA - Mise en plan/Noel metal/EL_TSAC/couvercle/plaque_aeration/plaque aeration.dxf

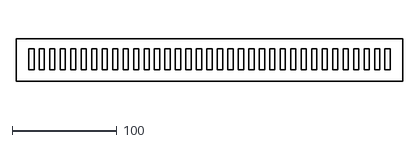
[picture p512: CAD file, 2025-06-11]
01 - Maquette CATIA/AA - Mise en plan/Noel metal/EL_TSAC/couvercle/plaque_aeration/plaque aeration.dxf
369.0 x 41.0
