EOSCogniton/ELIZ-2022/01 - Maquette CATIA/AA - Mise en plan/Noel metal/EL_TSAC/couvercle/sideplate extérieure/sideplate ext.dxf

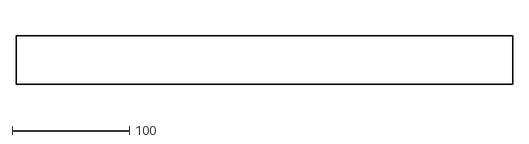
[picture p513: CAD file, 2025-06-11]
01 - Maquette CATIA/AA - Mise en plan/Noel metal/EL_TSAC/couvercle/sideplate extérieure/sideplate ext.dxf
424.0 x 41.0
