EOSCogniton/ELIZ-2022/01 - Maquette CATIA/AA - Mise en plan/Noel metal/EL_TSAC/couvercle/sideplate intérieure/sideplate int.dxf

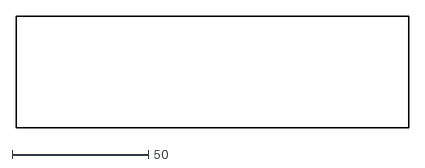
[picture p514: CAD file, 2025-06-11]
01 - Maquette CATIA/AA - Mise en plan/Noel metal/EL_TSAC/couvercle/sideplate intérieure/sideplate int.dxf
144.0 x 41.0
