EOSCogniton/ELIZ-2022/01 - Maquette CATIA/AA - Mise en plan/Noel metal/EL_TSAC/EL_22000 (TSAC)_Mark2.stp

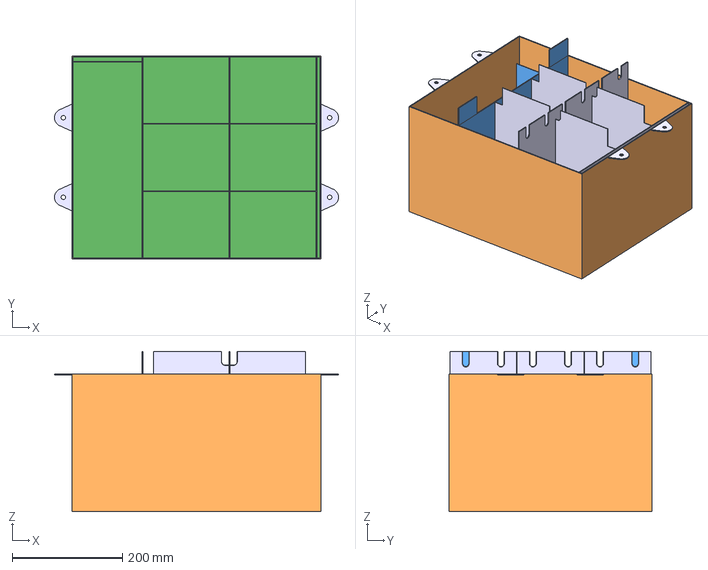
[picture p515: CAD file, 2025-06-09]
01 - Maquette CATIA/AA - Mise en plan/Noel metal/EL_TSAC/EL_22000 (TSAC)_Mark2.stp
516.0 x 369.0 x 291.0 mm
