EOSCogniton/ELIZ-2022/01 - Maquette CATIA/AA - Mise en plan/Noel metal/EL_TSAC/Fond_global/fond_global.dxf

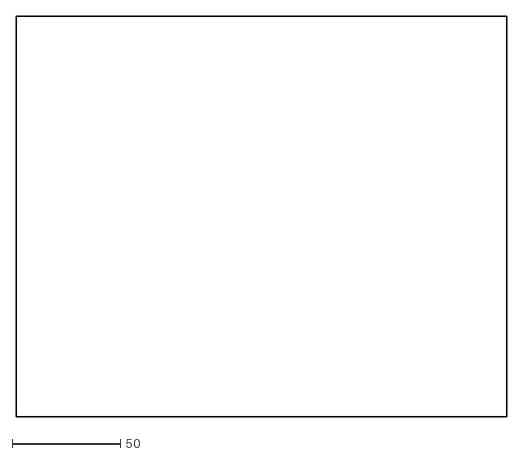
[picture p516: CAD file, 2025-06-09]
01 - Maquette CATIA/AA - Mise en plan/Noel metal/EL_TSAC/Fond_global/fond_global.dxf
226.0 x 184.5
