EOSCogniton/ELIZ-2022/01 - Maquette CATIA/AA - Mise en plan/Noel metal/EL_TSAC/Fond_longitudinal/plaque_fond.dxf

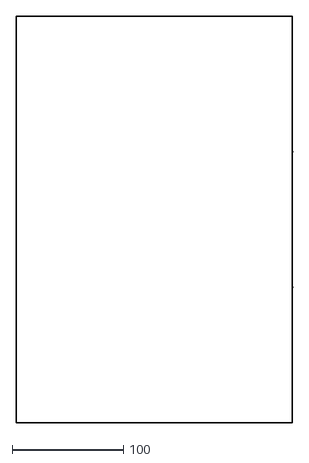
[picture p517: CAD file, 2025-06-09]
01 - Maquette CATIA/AA - Mise en plan/Noel metal/EL_TSAC/Fond_longitudinal/plaque_fond.dxf
248.0 x 365.0
