EOSCogniton/ELIZ-2022/01 - Maquette CATIA/AA - Mise en plan/Noel metal/EL_TSAC/Middle plate/middle_plate.dxf

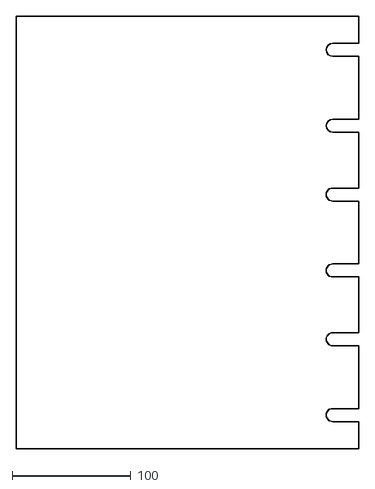
[picture p518: CAD file, 2025-06-09]
01 - Maquette CATIA/AA - Mise en plan/Noel metal/EL_TSAC/Middle plate/middle_plate.dxf
289.0 x 365.0
