EOSCogniton/ELIZ-2022/01 - Maquette CATIA/AA - Mise en plan/Noel metal/EL_TSAC/paroi_largeur/paroi_largeur.dxf

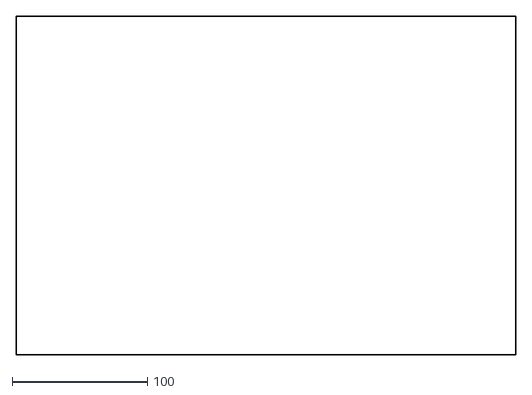
[picture p519: CAD file, 2025-06-09]
01 - Maquette CATIA/AA - Mise en plan/Noel metal/EL_TSAC/paroi_largeur/paroi_largeur.dxf
369.0 x 250.0
