EOSCogniton/ELIZ-2022/01 - Maquette CATIA/AA - Mise en plan/Noel metal/EL_TSAC/paroi_longeur/paroi_longueur.dxf

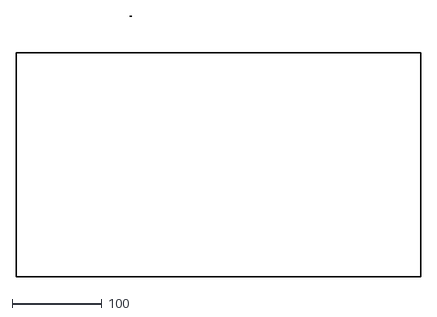
[picture p520: CAD file, 2025-06-09]
01 - Maquette CATIA/AA - Mise en plan/Noel metal/EL_TSAC/paroi_longeur/paroi_longueur.dxf
452.0 x 291.0
