EOSCogniton/ELIZ-2022/01 - Maquette CATIA/AA - Mise en plan/Noel metal/EL_TSAC/parois_modules/parois_modules.dxf

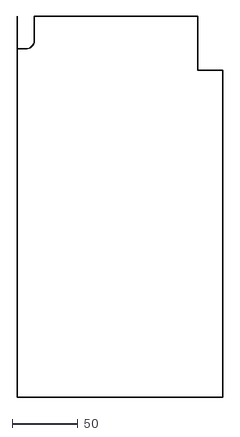
[picture p521: CAD file, 2025-06-09]
01 - Maquette CATIA/AA - Mise en plan/Noel metal/EL_TSAC/parois_modules/parois_modules.dxf
156.0 x 289.0
