EOSCogniton/ELIZ-2022/01 - Maquette CATIA/AA - Mise en plan/Noel metal/EL_TSAC/séparation_LV_HV/separation_lv_hv.dxf

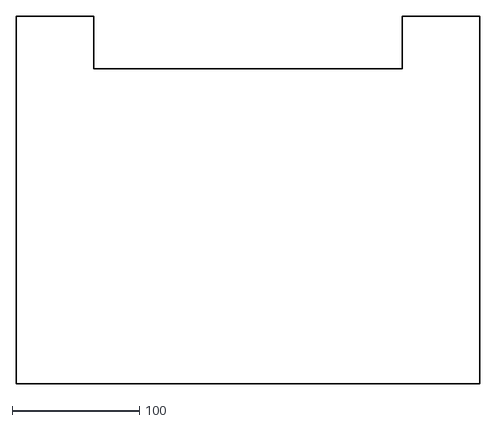
[picture p522: CAD file, 2025-06-09]
01 - Maquette CATIA/AA - Mise en plan/Noel metal/EL_TSAC/séparation_LV_HV/separation_lv_hv.dxf
365.0 x 289.0
