EOSCogniton/ELIZ-2022/01 - Maquette CATIA/AA - Mise en plan/Noel metal/EL_TSAC/séparation_LV_HV_latérale/separation_lv_hv_laterale.dxf

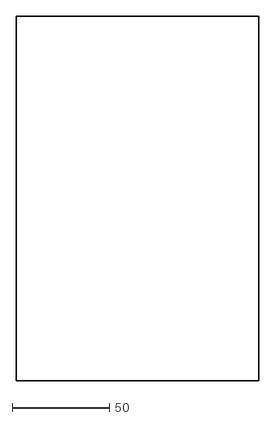
[picture p523: CAD file, 2025-06-09]
01 - Maquette CATIA/AA - Mise en plan/Noel metal/EL_TSAC/séparation_LV_HV_latérale/separation_lv_hv_laterale.dxf
125.0 x 187.5
