EOSCogniton/ELIZ-2022/01 - Maquette CATIA/AA - Mise en plan/Noel metal/tubes_harnais/Shape_234.stp

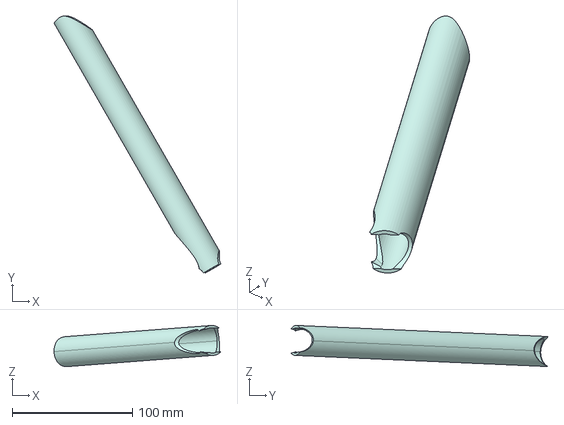
[picture p524: CAD file, 2025-06-11]
01 - Maquette CATIA/AA - Mise en plan/Noel metal/tubes_harnais/Shape_234.stp
138.9 x 213.9 x 34.3 mm
