EOSCogniton/ELIZ-2022/01 - Maquette CATIA/AA - Mise en plan/ST_Steering_System/ST_05001/ST_05001 (Front Bracket).dxf

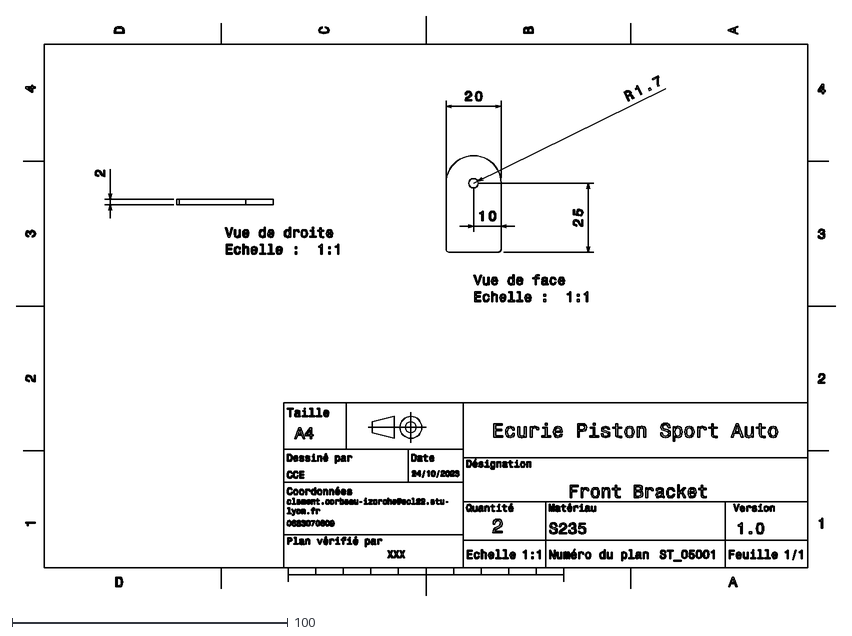
[picture p525: CAD file, 2023-10-25]
01 - Maquette CATIA/AA - Mise en plan/ST_Steering_System/ST_05001/ST_05001 (Front Bracket).dxf
297.0 x 210.0
