EOSCogniton/ELIZ-2022/01 - Maquette CATIA/AA - Mises en Plan RBX/Boisard/EN_04012.dxf

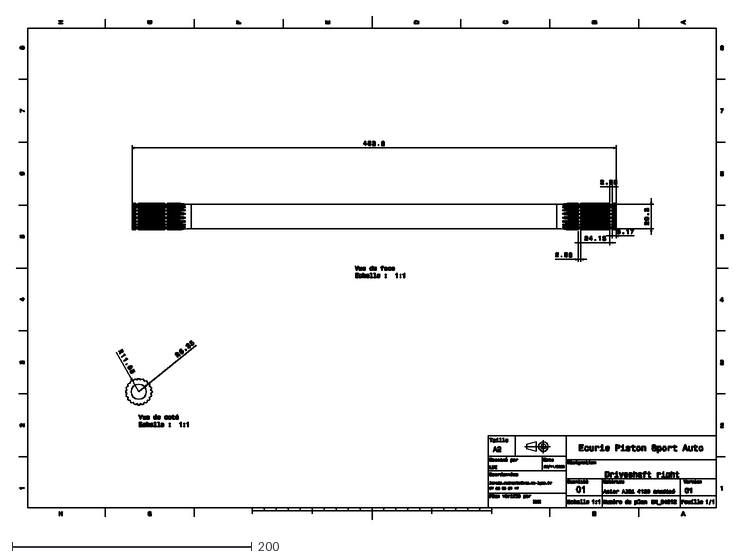
[picture p526: CAD file, 2023-11-29]
01 - Maquette CATIA/AA - Mises en Plan RBX/Boisard/EN_04012.dxf
594.0 x 420.0
