EOSCogniton/ELIZ-2022/01 - Maquette CATIA/AA - Mises en Plan RBX/FR_Frame_Body/FR_06003/FR_06003.dxf

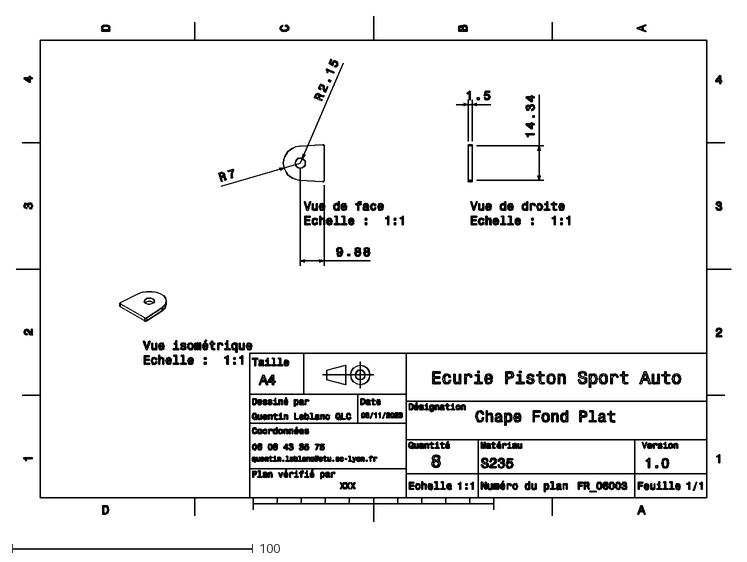
[picture p527: CAD file, 2023-11-29]
01 - Maquette CATIA/AA - Mises en Plan RBX/FR_Frame_Body/FR_06003/FR_06003.dxf
297.0 x 210.0
