EOSCogniton/ELIZ-2022/01 - Maquette CATIA/AA - Mises en Plan RBX/La mache laser/2ème vague/ST_05002.dxf

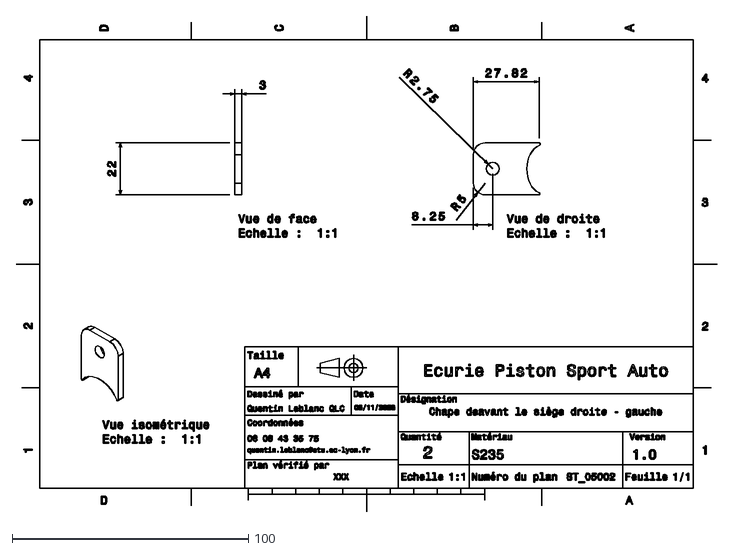
[picture p528: CAD file, 2023-11-29]
01 - Maquette CATIA/AA - Mises en Plan RBX/La mache laser/2ème vague/ST_05002.dxf
297.0 x 210.0
