EOSCogniton/ELIZ-2022/01 - Maquette CATIA/BR_Brake_System/BR_A0300 (Brake Master Cylinders)/tank_fixation.stl

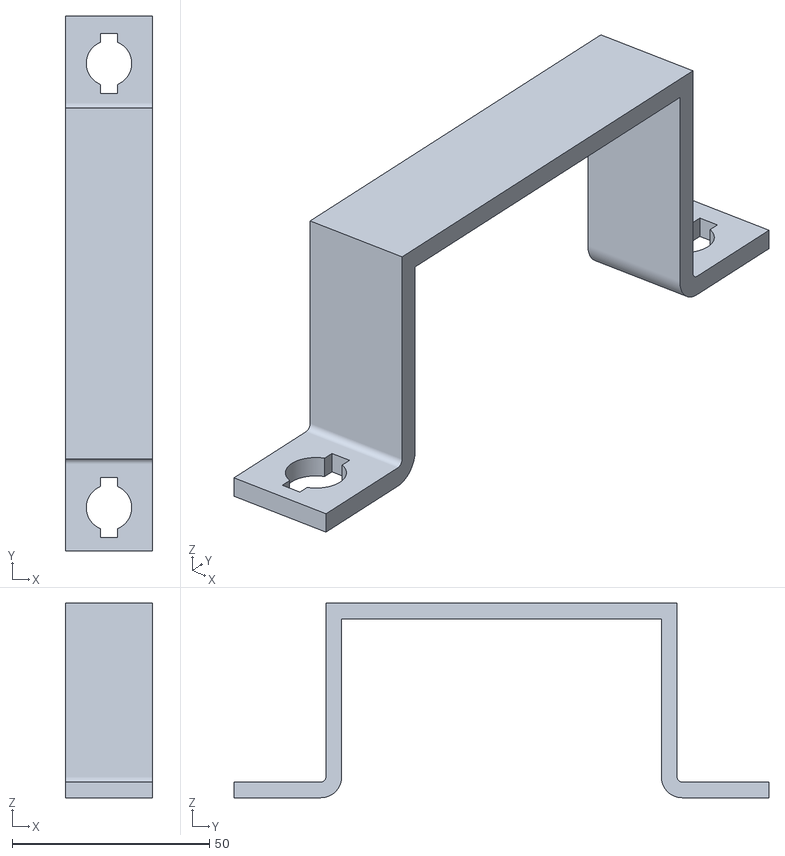
[picture p529: CAD file, 2025-10-21]
01 - Maquette CATIA/BR_Brake_System/BR_A0300 (Brake Master Cylinders)/tank_fixation.stl
22.0 x 135.6 x 49.3
