EOSCogniton/ELIZ-2022/01 - Maquette CATIA/EL_Electrical/EL_A1500 (Master Switch Plate)/D_Sub_Cap.stl

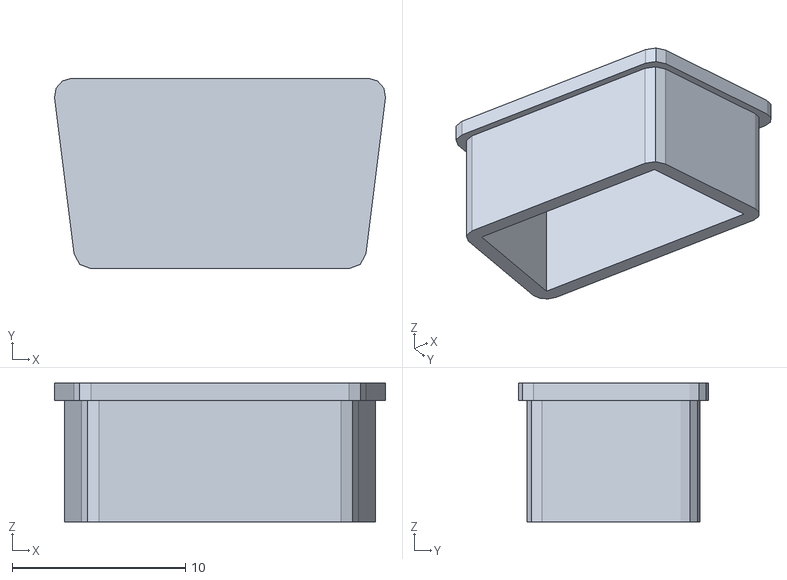
[picture p530: CAD file, 2024-04-15]
01 - Maquette CATIA/EL_Electrical/EL_A1500 (Master Switch Plate)/D_Sub_Cap.stl
19.1 x 11.0 x 8.00
