EOSCogniton/ELIZ-2022/01 - Maquette CATIA/EL_Electrical/EL_A1500 (Master Switch Plate)/EL_15002 (TSMP)/Banana Cap.stl

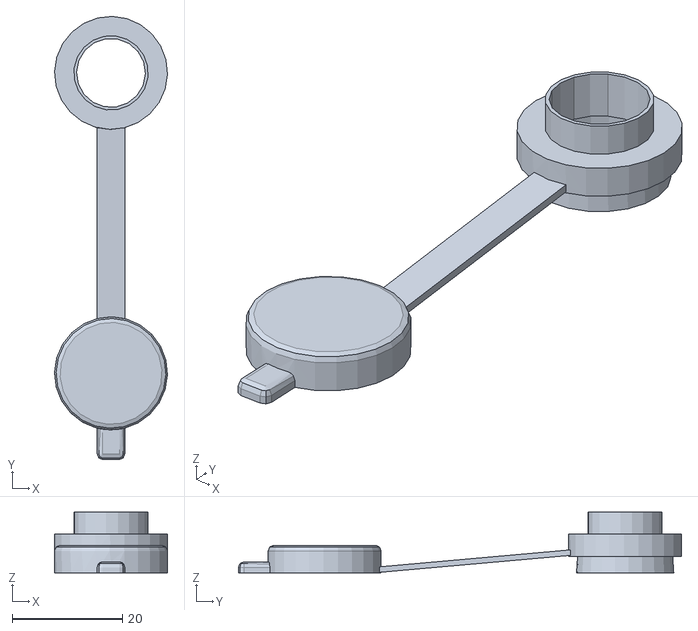
[picture p531: CAD file, 2024-03-05]
01 - Maquette CATIA/EL_Electrical/EL_A1500 (Master Switch Plate)/EL_15002 (TSMP)/Banana Cap.stl
20.5 x 80.4 x 11.0
