EOSCogniton/ELIZ-2022/01 - Maquette CATIA/EL_Electrical/EL_A1500 (Master Switch Plate)/EL_15003 (Master Switch)/Poignee_Master_Switch.stl

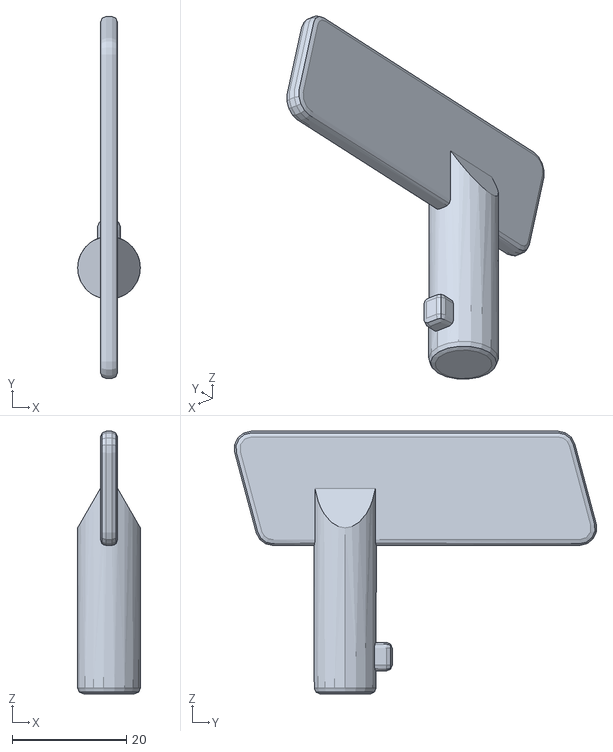
[picture p532: CAD file, 2024-02-06]
01 - Maquette CATIA/EL_Electrical/EL_A1500 (Master Switch Plate)/EL_15003 (Master Switch)/Poignee_Master_Switch.stl
11.0 x 63.4 x 46.0
