EOSCogniton/ELIZ-2022/01 - Maquette CATIA/EL_Electrical/EL_A2000(TSBox + Inverter)/gabarit EN_G20004_gauche/fichier dxf/plaque_chape_1.dxf

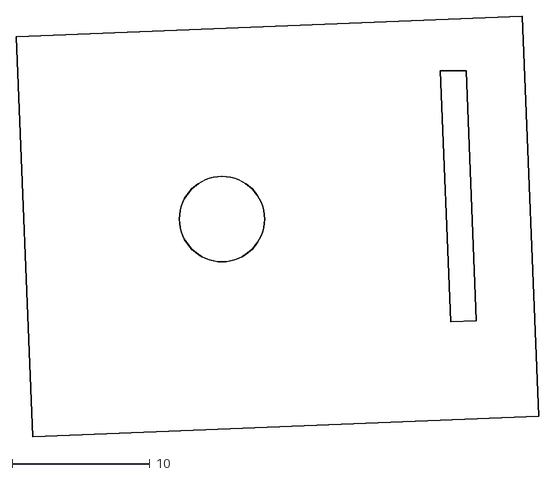
[picture p533: CAD file, 2024-05-15]
01 - Maquette CATIA/EL_Electrical/EL_A2000(TSBox + Inverter)/gabarit EN_G20004_gauche/fichier dxf/plaque_chape_1.dxf
38.0 x 30.6
