EOSCogniton/ELIZ-2022/01 - Maquette CATIA/EL_Electrical/EL_A2000(TSBox + Inverter)/gabarit EN_G2004_droite/fichier dxf/plaque_tube.dxf

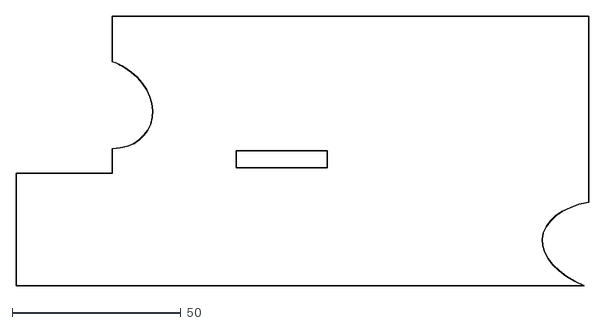
[picture p534: CAD file, 2024-05-15]
01 - Maquette CATIA/EL_Electrical/EL_A2000(TSBox + Inverter)/gabarit EN_G2004_droite/fichier dxf/plaque_tube.dxf
169.8 x 80.0
