EOSCogniton/ELIZ-2022/01 - Maquette CATIA/EL_Electrical/EL_A2000(TSBox + Inverter)/gabarit_EL_G2008_cote_droit/plaque_tube.dxf

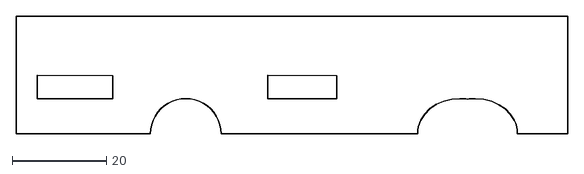
[picture p535: CAD file, 2024-04-03]
01 - Maquette CATIA/EL_Electrical/EL_A2000(TSBox + Inverter)/gabarit_EL_G2008_cote_droit/plaque_tube.dxf
117.0 x 25.0
