EOSCogniton/ELIZ-2022/01 - Maquette CATIA/EL_Electrical/EL_A2000(TSBox + Inverter)/gabarit_EL_G2009_cote_gauche/plaque_chape.dxf

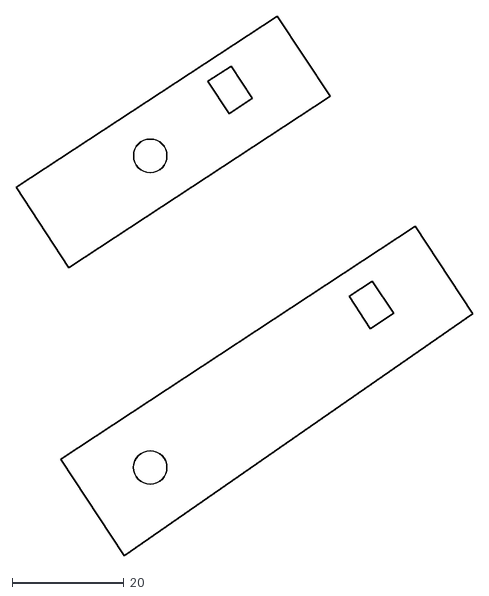
[picture p536: CAD file, 2024-04-03]
01 - Maquette CATIA/EL_Electrical/EL_A2000(TSBox + Inverter)/gabarit_EL_G2009_cote_gauche/plaque_chape.dxf
81.8 x 96.8
