EOSCogniton/ELIZ-2022/01 - Maquette CATIA/EL_Electrical/EL_A2100 (Accumulator Assy)/EL_A2100-a (Accumulator Assy Version a)/Symmetry of EL_21002 (Low Green Bracket).stl

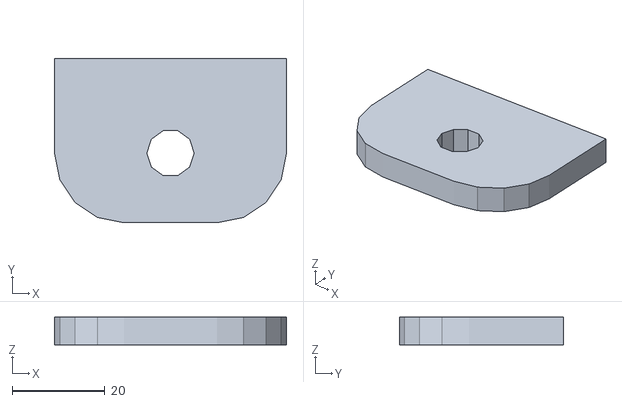
[picture p537: CAD file, 2024-03-26]
01 - Maquette CATIA/EL_Electrical/EL_A2100 (Accumulator Assy)/EL_A2100-a (Accumulator Assy Version a)/Symmetry of EL_21002 (Low Green Bracket).stl
50.0 x 35.4 x 6.00
