EOSCogniton/ELIZ-2022/01 - Maquette CATIA/EL_Electrical/EL_A2200 (Accumulator)/Export stl/Support_Fusible.stl

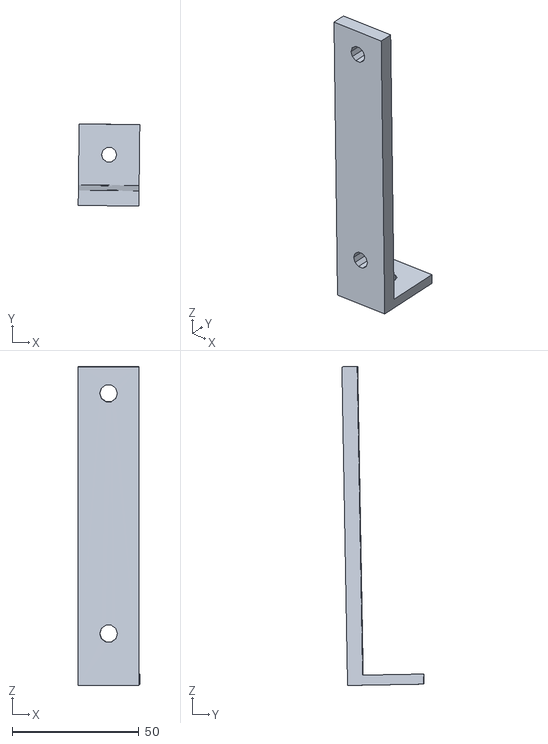
[picture p538: CAD file, 2024-10-12]
01 - Maquette CATIA/EL_Electrical/EL_A2200 (Accumulator)/Export stl/Support_Fusible.stl
24.4 x 32.5 x 126.1
