EOSCogniton/ELIZ-2022/01 - Maquette CATIA/EL_Electrical/EL_A2200 (Accumulator)/Imports stp/Indicator_voltage.step

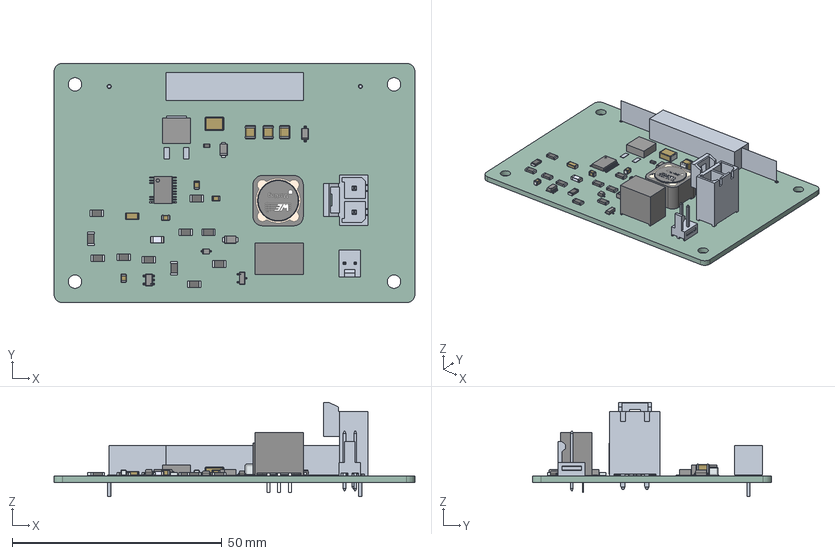
[picture p539: CAD file, 2024-09-17]
01 - Maquette CATIA/EL_Electrical/EL_A2200 (Accumulator)/Imports stp/Indicator_voltage.step
86.0 x 57.0 x 22.4 mm
ASSEMBLY x 29
tsr05
LT8316EFE#PBF
GRM31A5C2J101FW01D
Indicator_voltage_PCB
