EOSCogniton/ELIZ-2022/01 - Maquette CATIA/EL_Electrical/EL_A2200 (Accumulator)/Inside Container v2 (FR-4)/Main/Export DXF/guide_translation_x2.dxf

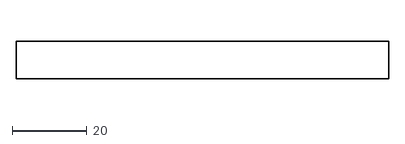
[picture p540: CAD file, 2025-07-24]
01 - Maquette CATIA/EL_Electrical/EL_A2200 (Accumulator)/Inside Container v2 (FR-4)/Main/Export DXF/guide_translation_x2.dxf
100.0 x 10.0
