EOSCogniton/ELIZ-2022/01 - Maquette CATIA/EL_Electrical/EL_A2200 (Accumulator)/Inside Container v2 (FR-4)/Main/Export STP/rectangle_support.stp

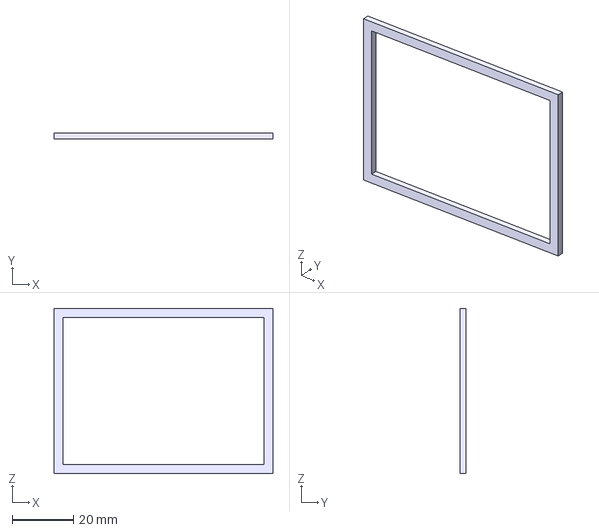
[picture p541: CAD file, 2025-07-24]
01 - Maquette CATIA/EL_Electrical/EL_A2200 (Accumulator)/Inside Container v2 (FR-4)/Main/Export STP/rectangle_support.stp
71.5 x 2.00 x 53.9 mm
