EOSCogniton/ELIZ-2022/01 - Maquette CATIA/EL_Electrical/EL_A2200 (Accumulator)/SLPIPB50BSB2EH/3D/SLPIPB50BSB2EH.stp

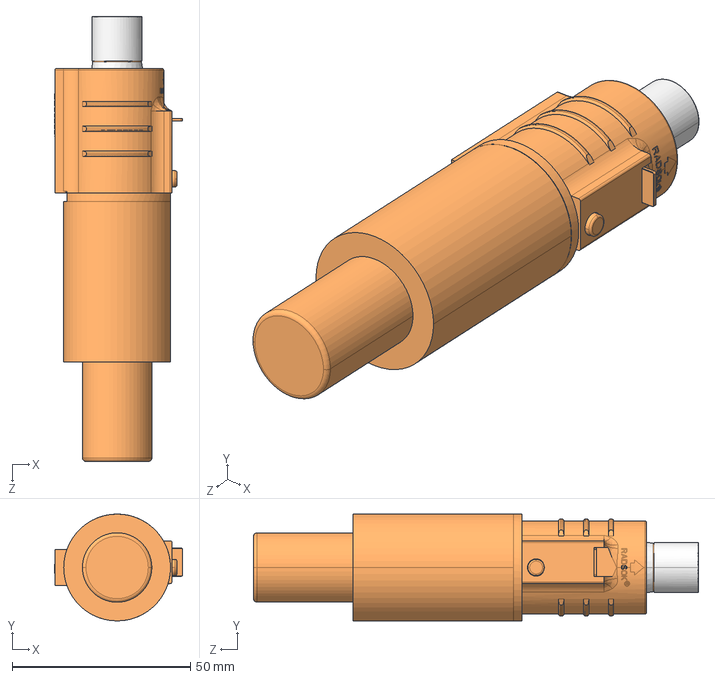
[picture p542: CAD file, 2025-03-24]
01 - Maquette CATIA/EL_Electrical/EL_A2200 (Accumulator)/SLPIPB50BSB2EH/3D/SLPIPB50BSB2EH.stp
36.0 x 30.0 x 125.0 mm
