EOSCogniton/ELIZ-2022/01 - Maquette CATIA/EL_Electrical/EL_A2200 (Accumulator)/SLPIRCBPSO0/3D/SLPIRCBPSO0.stp

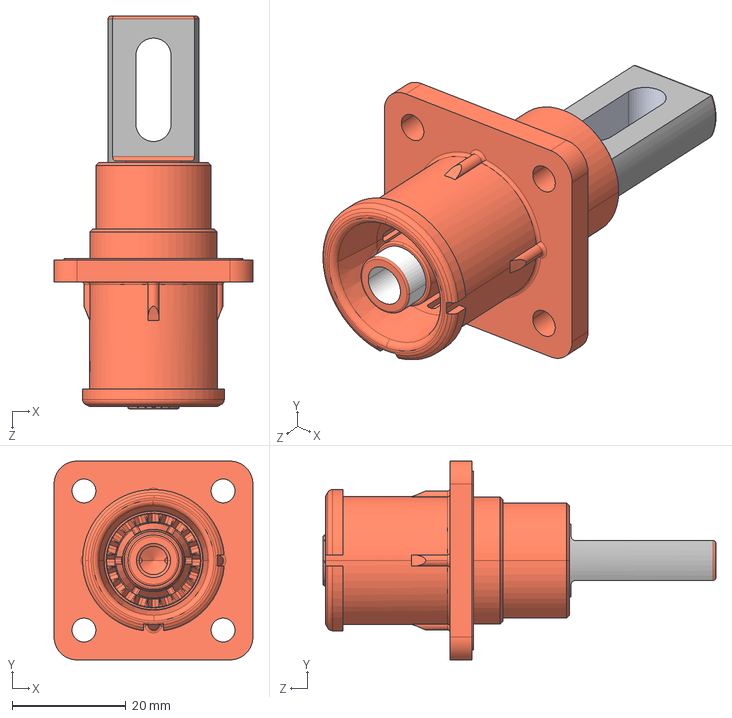
[picture p543: CAD file, 2025-05-22]
01 - Maquette CATIA/EL_Electrical/EL_A2200 (Accumulator)/SLPIRCBPSO0/3D/SLPIRCBPSO0.stp
35.0 x 35.0 x 69.2 mm
