EOSCogniton/ELIZ-2022/01 - Maquette CATIA/EL_Electrical/EL_A2200 (Accumulator)/SLPRBBPSR/3D/SLPRBBPSR.stp

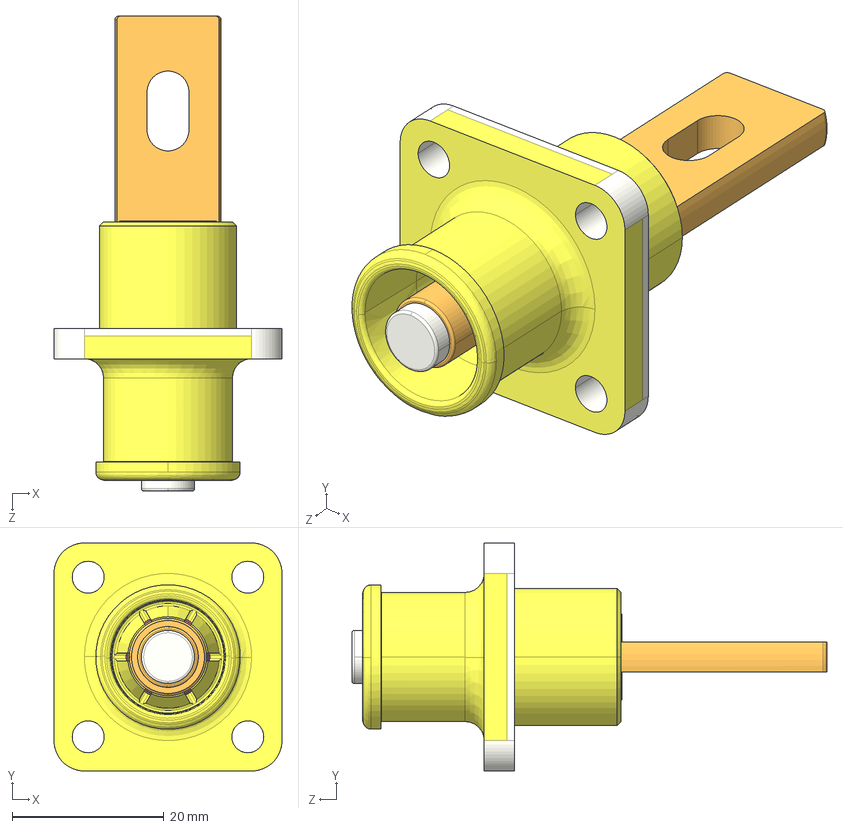
[picture p544: CAD file, 2025-05-28]
01 - Maquette CATIA/EL_Electrical/EL_A2200 (Accumulator)/SLPRBBPSR/3D/SLPRBBPSR.stp
30.0 x 30.0 x 62.5 mm
