EOSCogniton/ELIZ-2022/01 - Maquette CATIA/EL_Electrical/EL_A2300 (Module)/Casing module v3 Martin/MEP/upper_plate.dxf

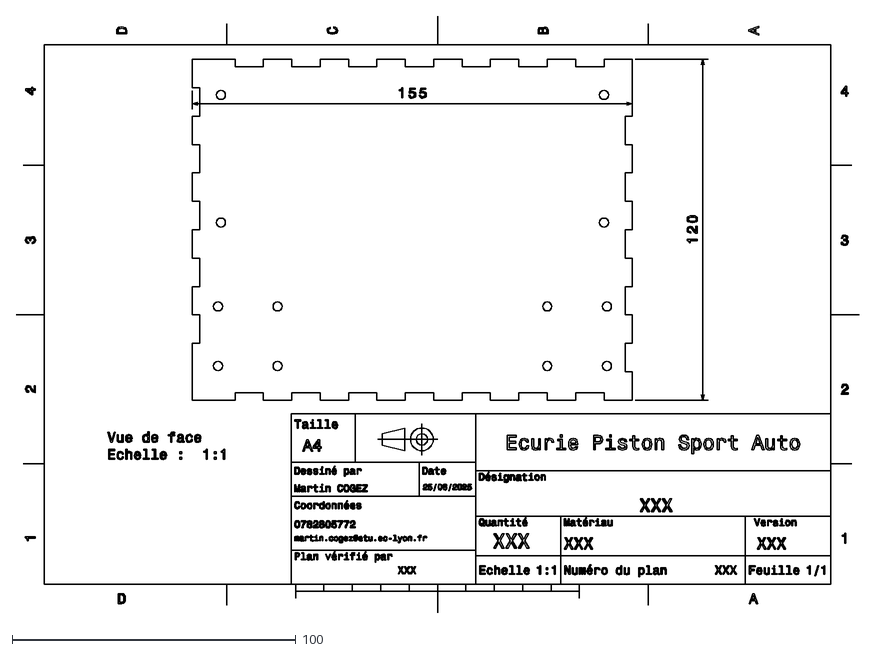
[picture p545: CAD file, 2025-07-08]
01 - Maquette CATIA/EL_Electrical/EL_A2300 (Module)/Casing module v3 Martin/MEP/upper_plate.dxf
297.0 x 210.0
