EOSCogniton/ELIZ-2022/01 - Maquette CATIA/EL_Electrical/EL_A2300 (Module)/Casing module v3 Martin/STP/back_plate.stp

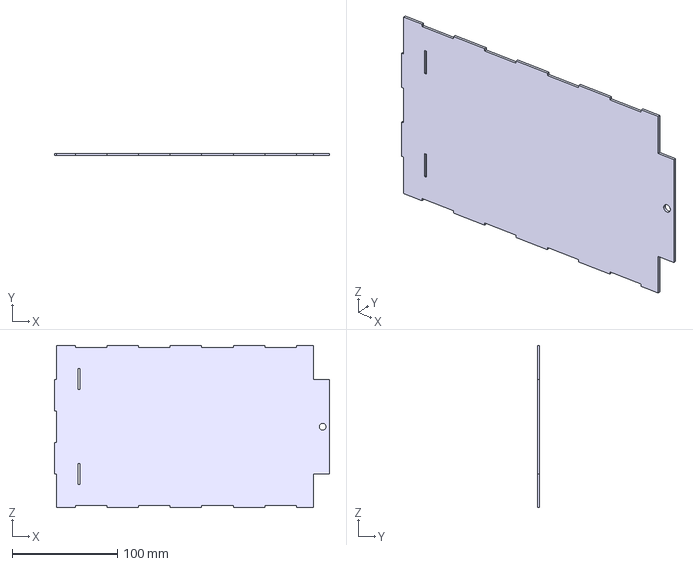
[picture p546: CAD file, 2025-07-24]
01 - Maquette CATIA/EL_Electrical/EL_A2300 (Module)/Casing module v3 Martin/STP/back_plate.stp
261.0 x 2.00 x 154.0 mm
