EOSCogniton/ELIZ-2022/01 - Maquette CATIA/EL_Electrical/EL_A2300 (Module)/MEP Casing Module v2/Coté 1/cote1.dxf

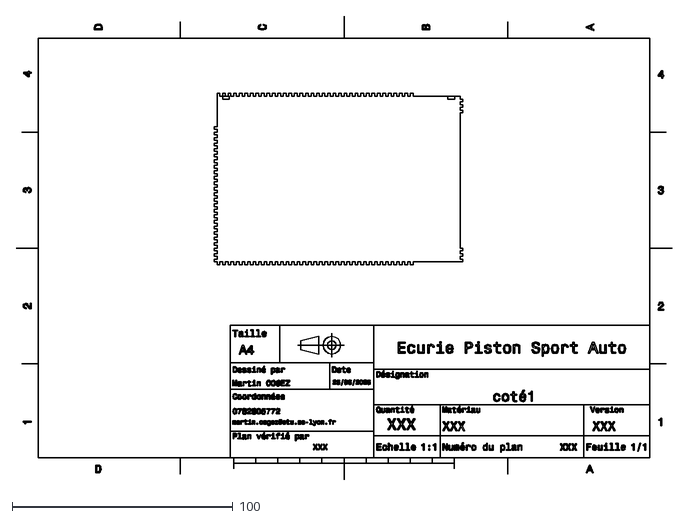
[picture p547: CAD file, 2025-06-25]
01 - Maquette CATIA/EL_Electrical/EL_A2300 (Module)/MEP Casing Module v2/Coté 1/cote1.dxf
297.0 x 210.0
