EOSCogniton/ELIZ-2022/01 - Maquette CATIA/EL_Electrical/EL_A2300 (Module)/MEP Casing Module v2/Coté 2/cote2.dxf

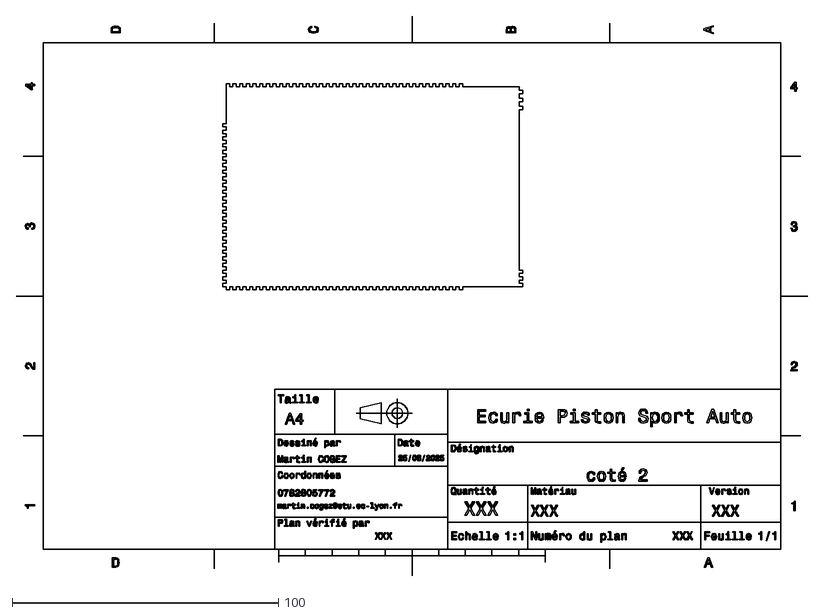
[picture p548: CAD file, 2025-06-25]
01 - Maquette CATIA/EL_Electrical/EL_A2300 (Module)/MEP Casing Module v2/Coté 2/cote2.dxf
297.0 x 210.0
