EOSCogniton/ELIZ-2022/01 - Maquette CATIA/EL_Electrical/EL_A2300 (Module)/MEP Casing Module v2/Oeillet/oeillet.dxf

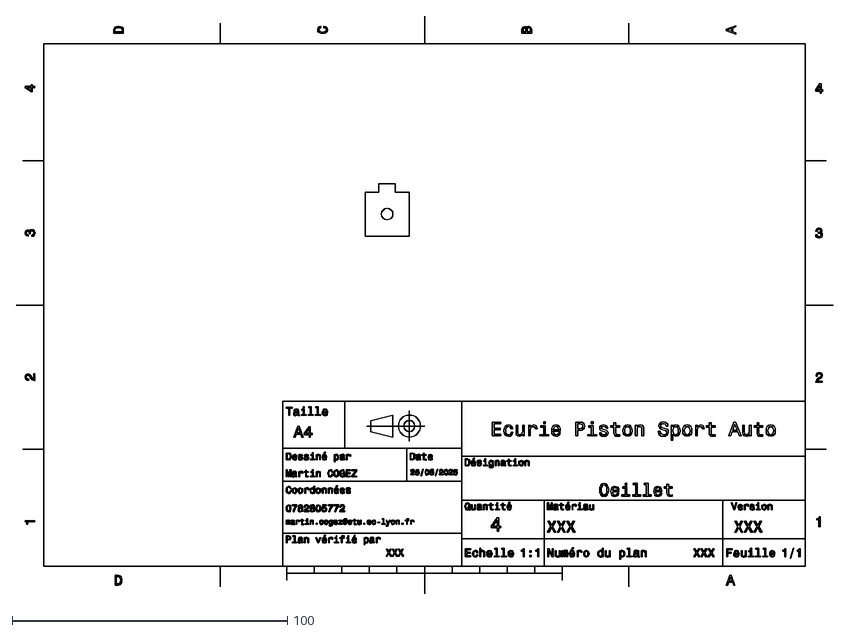
[picture p551: CAD file, 2025-06-25]
01 - Maquette CATIA/EL_Electrical/EL_A2300 (Module)/MEP Casing Module v2/Oeillet/oeillet.dxf
297.0 x 210.0
