EOSCogniton/ELIZ-2022/01 - Maquette CATIA/EL_Electrical/EL_A2300 (Module)/MEP Casing Module v2/Rigidifiant/rigidifiant.dxf

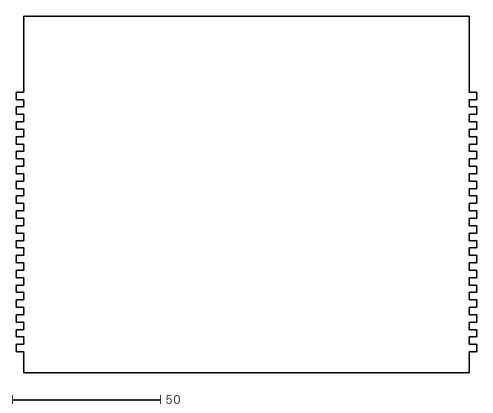
[picture p552: CAD file, 2025-06-25]
01 - Maquette CATIA/EL_Electrical/EL_A2300 (Module)/MEP Casing Module v2/Rigidifiant/rigidifiant.dxf
155.0 x 120.0
