EOSCogniton/ELIZ-2022/(list of files, cad)

Other CAD files:
01 - Maquette CATIA/AA - Mise en plan/AquaCut/EN_01009 v2.dxf
01 - Maquette CATIA/AA - Mise en plan/AquaCut/Prod support moteurs 2025/left/EN_01009.dxf
01 - Maquette CATIA/AA - Mise en plan/AquaCut/Prod support moteurs 2025/right/EN_01008.dxf
01 - Maquette CATIA/AA - Mise en plan/Boisard/ST_03004 (Insert middle).stp
01 - Maquette CATIA/AA - Mise en plan/Boisard/ST_03004 (insert mid).dxf
01 - Maquette CATIA/AA - Mise en plan/Boisard/ST_04001 (Half Moon top).stp
01 - Maquette CATIA/AA - Mise en plan/Boisard/ST_04001 (Half moon top).dxf
01 - Maquette CATIA/AA - Mise en plan/Boisard/ST_04002 (Half Moon below).stp
01 - Maquette CATIA/AA - Mise en plan/Boisard/ST_04002 (Half moon bellow).dxf
01 - Maquette CATIA/AA - Mise en plan/Boisard/ST_06001 (Pivot de direction).dxf
01 - Maquette CATIA/AA - Mise en plan/Boisard/ST_06001 (Steering upper shaft).stp
01 - Maquette CATIA/AA - Mise en plan/Boisard/SU_11002 (Upper arm bracket).dxf
01 - Maquette CATIA/AA - Mise en plan/Boisard/SU_11002 (Upper arm bracket).stp
01 - Maquette CATIA/AA - Mise en plan/Boisard/Vague1/EL_01009 OK(Container mounting point).dxf
01 - Maquette CATIA/AA - Mise en plan/Boisard/Vague1/EL_01009 OK(Container mounting point).v2.stp
01 - Maquette CATIA/AA - Mise en plan/Boisard/Vague1/ST_03004 (Insert middle).stp
01 - Maquette CATIA/AA - Mise en plan/Boisard/Vague1/ST_03004 (insert mid).dxf
01 - Maquette CATIA/AA - Mise en plan/Boisard/Vague1/ST_04001 (Half Moon top).stp
01 - Maquette CATIA/AA - Mise en plan/Boisard/Vague1/ST_04001 (Half moon top).dxf
01 - Maquette CATIA/AA - Mise en plan/Boisard/Vague1/ST_04002 (Half Moon below).stp
01 - Maquette CATIA/AA - Mise en plan/Boisard/Vague1/ST_04002 (Half moon bellow).dxf
01 - Maquette CATIA/AA - Mise en plan/Boisard/Vague1/ST_06001 (Pivot de direction).dxf
01 - Maquette CATIA/AA - Mise en plan/Boisard/Vague1/ST_06001 (Steering upper shaft).stp
01 - Maquette CATIA/AA - Mise en plan/Boisard/Vague1/SU_11002 (Upper arm bracket).dxf
01 - Maquette CATIA/AA - Mise en plan/Boisard/Vague1/SU_11002 (Upper arm bracket).stp
01 - Maquette CATIA/AA - Mise en plan/Boisard/Vague1/WT_02001 (Front Hub).dxf
01 - Maquette CATIA/AA - Mise en plan/Boisard/Vague1/WT_02003 (Bearing Washer).dxf
01 - Maquette CATIA/AA - Mise en plan/Boisard/Vague1/WT_02003 (Front Bearing Washer).stp
01 - Maquette CATIA/AA - Mise en plan/Boisard/Vague1/WT_02005 (Front Speed Sensor Disc).stp
01 - Maquette CATIA/AA - Mise en plan/Boisard/Vague1/WT_02005 (speed disc).dxf
01 - Maquette CATIA/AA - Mise en plan/Boisard/Vague1/WT_03001 (Rear Hub).dxf
01 - Maquette CATIA/AA - Mise en plan/Boisard/Vague1/WT_03001 (Rear Hub).stp
01 - Maquette CATIA/AA - Mise en plan/Boisard/Vague1/WT_03004 (Tripod Housing Spacer).stp
01 - Maquette CATIA/AA - Mise en plan/Boisard/Vague1/WT_03004 (Tripod housing spacer).dxf
01 - Maquette CATIA/AA - Mise en plan/Boisard/WT_02001 (Front Hub).dxf
01 - Maquette CATIA/AA - Mise en plan/Boisard/WT_02003 (Bearing Washer).dxf
01 - Maquette CATIA/AA - Mise en plan/Boisard/WT_02003 (Front Bearing Washer).stp
01 - Maquette CATIA/AA - Mise en plan/Boisard/WT_02005 (Front Speed Sensor Disc).stp
01 - Maquette CATIA/AA - Mise en plan/Boisard/WT_02005 (speed disc).dxf
01 - Maquette CATIA/AA - Mise en plan/Boisard/WT_03001 (Rear Hub).dxf
01 - Maquette CATIA/AA - Mise en plan/Boisard/WT_03001 (Rear Hub).stp
01 - Maquette CATIA/AA - Mise en plan/Boisard/WT_03004 (Tripod Housing Spacer).stp
01 - Maquette CATIA/AA - Mise en plan/Boisard/WT_03004 (Tripod housing spacer).dxf
01 - Maquette CATIA/AA - Mise en plan/Boisard/vague 2/Driveshaft left.dxf
01 - Maquette CATIA/AA - Mise en plan/Boisard/vague 2/ST_06002 (Steering Bore).dxf
01 - Maquette CATIA/AA - Mise en plan/EL_Electrical/EL_01 - TDB/EL_01002 (Dash Panel Equipment).dxf
01 - Maquette CATIA/AA - Mise en plan/EL_Electrical/EL_03 - BLV/EL_03004.dxf
01 - Maquette CATIA/AA - Mise en plan/EL_Electrical/EL_12002/EL_12002(Chape).CATPart
01 - Maquette CATIA/AA - Mise en plan/EL_Electrical/EL_17002/EL_17002 (Chape).CATPart
01 - Maquette CATIA/AA - Mise en plan/EL_Electrical/EL_20 - TS Box/EL_20003(side mount right).dxf
01 - Maquette CATIA/AA - Mise en plan/EL_Electrical/EL_20 - TS Box/EL_20004(high bracket).dxf
01 - Maquette CATIA/AA - Mise en plan/EL_Electrical/EL_20 - TS Box/EL_20005 (L Mount).dxf
01 - Maquette CATIA/AA - Mise en plan/EL_Electrical/EL_20 - TS Box/EL_20011(intermediate high mount).dxf
01 - Maquette CATIA/AA - Mise en plan/EL_Electrical/EL_masses/EL_masses.dxf
01 - Maquette CATIA/AA - Mise en plan/EN_Engine/EN_02 - Cooling System/EN_02014(Radiator low rear bracket).dxf
01 - Maquette CATIA/AA - Mise en plan/EN_Engine/EN_02 - Cooling System/EN_02016(Overflow Bottle Equipement).dxf
01 - Maquette CATIA/AA - Mise en plan/EN_Engine/EN_02 - Cooling System/EN_02017(Catch can equipment).dxf
01 - Maquette CATIA/AA - Mise en plan/EN_Engine/EN_02 - Cooling System/EN_02018 (Radiator Protection Top Equipment).dxf
01 - Maquette CATIA/AA - Mise en plan/EN_Engine/GABARIT_protection radiateur/EN_G2019.CATPart
01 - Maquette CATIA/AA - Mise en plan/FR_Frame_Body/FR_02003/FR_02003 (Chape push clips).CATPart
01 - Maquette CATIA/AA - Mise en plan/FR_Frame_Body/FR_03 - Throttle/FR_03001/FR_03001_1.dxf
01 - Maquette CATIA/AA - Mise en plan/FR_Frame_Body/FR_03 - Throttle/FR_03001/FR_03001_2.dxf
01 - Maquette CATIA/AA - Mise en plan/FR_Frame_Body/FR_03 - Throttle/FR_03001/FR_03001_3.dxf
01 - Maquette CATIA/AA - Mise en plan/FR_Frame_Body/FR_03 - Throttle/FR_03001/FR_03001_4.dxf
01 - Maquette CATIA/AA - Mise en plan/FR_Frame_Body/FR_03 - Throttle/FR_03001/FR_03001_5.dxf
01 - Maquette CATIA/AA - Mise en plan/FR_Frame_Body/FR_03 - Throttle/FR_03001/FR_03001_6.dxf
01 - Maquette CATIA/AA - Mise en plan/FR_Frame_Body/FR_03 - Throttle/FR_03001/FR_03001_7.dxf
01 - Maquette CATIA/AA - Mise en plan/FR_Frame_Body/FR_03 - Throttle/FR_03005/FR_03005 (Throttle Fixing Rail Wedge).CATPart
01 - Maquette CATIA/AA - Mise en plan/FR_Frame_Body/FR_03 - Throttle/FR_03007/FR_03007 (Front Throttle Fixing Rail Wedge).CATPart
01 - Maquette CATIA/AA - Mise en plan/FR_Frame_Body/FR_04 - Brake/FR_04001 (Frame Brake)/FR_04001_1.dxf
01 - Maquette CATIA/AA - Mise en plan/FR_Frame_Body/FR_04 - Brake/FR_04001 (Frame Brake)/FR_04001_10.dxf
01 - Maquette CATIA/AA - Mise en plan/FR_Frame_Body/FR_04 - Brake/FR_04001 (Frame Brake)/FR_04001_11.dxf
01 - Maquette CATIA/AA - Mise en plan/FR_Frame_Body/FR_04 - Brake/FR_04001 (Frame Brake)/FR_04001_2.dxf
01 - Maquette CATIA/AA - Mise en plan/FR_Frame_Body/FR_04 - Brake/FR_04001 (Frame Brake)/FR_04001_3.dxf
01 - Maquette CATIA/AA - Mise en plan/FR_Frame_Body/FR_04 - Brake/FR_04001 (Frame Brake)/FR_04001_4.dxf
01 - Maquette CATIA/AA - Mise en plan/FR_Frame_Body/FR_04 - Brake/FR_04001 (Frame Brake)/FR_04001_6.dxf
01 - Maquette CATIA/AA - Mise en plan/FR_Frame_Body/FR_04 - Brake/FR_04001 (Frame Brake)/FR_04001_7.dxf
01 - Maquette CATIA/AA - Mise en plan/FR_Frame_Body/FR_04 - Brake/FR_04001 (Frame Brake)/FR_04001_8.dxf
01 - Maquette CATIA/AA - Mise en plan/FR_Frame_Body/FR_04 - Brake/FR_04001 (Frame Brake)/FR_04001_9.dxf
01 - Maquette CATIA/AA - Mise en plan/FR_Frame_Body/FR_04 - Brake/FR_04007/FR_04007(Brake Fixing Rail Wedge).CATPart
01 - Maquette CATIA/AA - Mise en plan/FR_Frame_Body/FR_05 - AIP/FR_05002.dxf
01 - Maquette CATIA/AA - Mise en plan/FR_Frame_Body/FR_06003/FR_06003_1 (Floor pan bracket)(Front-cell_Front).dxf
01 - Maquette CATIA/AA - Mise en plan/FR_Frame_Body/FR_06003/FR_06003_2 (Floor pan bracket)(Cockpit_Front).dxf
01 - Maquette CATIA/AA - Mise en plan/FR_Frame_Body/FR_06003/FR_06003_3 (Floor pan bracket)(Front-cell_Rear).dxf
01 - Maquette CATIA/AA - Mise en plan/FR_Frame_Body/Mechanical stops/FR_03009 (pos).dxf
01 - Maquette CATIA/AA - Mise en plan/Gabarits/découpe 27032024/Gabarits catch-can/Gabarit1.dxf
01 - Maquette CATIA/AA - Mise en plan/Gabarits/découpe 27032024/gabarits_TS_bas/plaque_chape-01.dxf
01 - Maquette CATIA/AA - Mise en plan/Gabarits/découpe 27032024/gabarits_TS_bas/plaque_chape.dxf
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
