EOSCogniton/ELIZ-2022/03 - H901BENCH/BENCH 1/Notice Montage Banc/Notice Montage Banc.tex

\documentclass{EPSA-rap-template}

\type{Type}

\titresize{\LARGE} % ne pas hésiter a changer la taille :
%\normalsize
%\large
%\Large
%\LARGE
%\huge
%\Huge
%\HUGE

\titre{ Notice Montage Banc H9}
\titresh{Montage Banc H9 } % Titre réduit pour les en-tête et bas de page

\departement{BASTIE}
%\departementsh{Dép}% Département réduit pour les en-tête et bas de page

\auteurs{Eymeric \textbf{Chauchat}}

\version{V1.0}

\versionnement{
\ver{V1.0}{11 Octobre 2022}{ ECT }{Rédaction initiale.}{1}
}

\setuppack

\begin{document}

\fairepagedegarde
\newpage
\tableofcontents

\section{Introduction}

Ce document a pour but de donner le plus d'information possible sur le montage du banc du H9

\section{Resolver}

Le resolver utilisé est ts2620n21e11 

\section{Moteur}

Le moteur utilisé est EMRAX 228 Medium Voltage

\section{Cable Feedback Bamocar}

Les couleurs du câble Feedback X7 du bamocar sont les suivantes : 

\begin{tabular}{ll}

Lettre & Couleur \\
M & Bleu \\
G & Rose \\
L & Blanc \\
K & Marron \\
O & Rouge \\
H & Jaune \\
E & Vert \\
C & Gris \\

\end{tabular}

\section{Cable Input-Output}

Les couleurs du câble X1 Input-Output.

\begin{tabular}{lll}

Lettre & Couleur & Signification \\
D & Jaune & +24V \\
C & Rose & GND \\
T & Bleu & RFE \\
G & Vert & FRG/RUN \\
K & Gray & Logic Gnd \\

\end{tabular}

\end{document}
