EOSCogniton/ELIZ-2022/03 - H901BENCH/BENCH 1/Notice Montage Banc/Notice Montage Banc.pdf

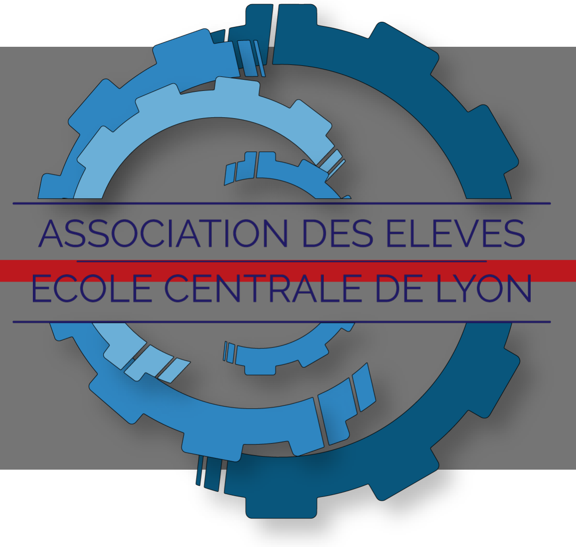
[picture p623: figure]

# Notice Montage Banc H9

## Type

## BASTIE

### Auteurs :

### Eymeric Chauchat

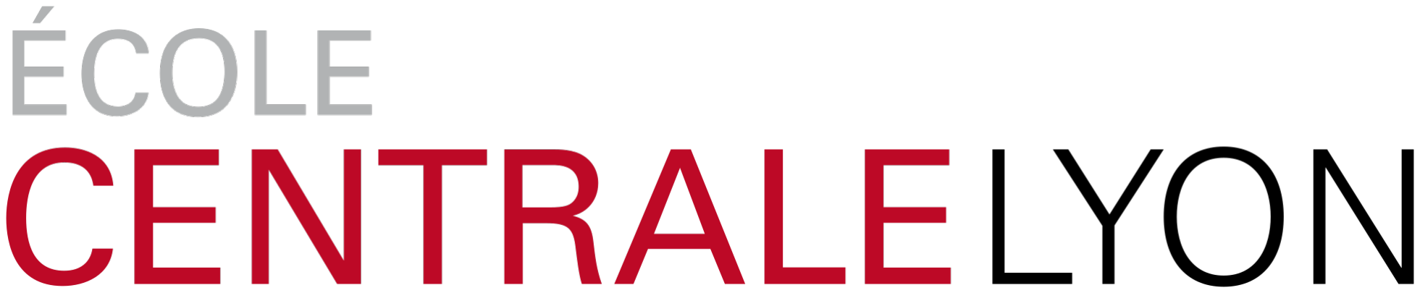
[picture p624: figure]

### 7 juillet 2023- V1.0

BASTIE - V1.0 | 1 Type - Montage Banc H9

5 Cable Input-Output

## Table des matières

1 Introduction | 1
2 Resolver | 1
3 Moteur | 1
4 Cable Feedback Bamocar | 1
5 Cable Input-Output | 1

## 1 Introduction

Ce document a pour but de donner le plus d’information possible sur lemontage du banc du H9

## 2 Resolver

Le resolver utilisé est ts2620n21e11

## 3 Moteur

Le moteur utilisé est EMRAX 228 Medium Voltage

## 4 Cable Feedback Bamocar

Les couleurs du câble Feedback X7 du bamocar sont les suivantes : Lettre Couleur
M | Bleu
G | Rose
L | Blanc
K | Marron
O | Rouge
H | Jaune
E | Vert
C | Gris

## 5 Cable Input-Output

Les couleurs du câble X1 Input-Output.

BASTIE - V1.0 | 2 Type - Montage Banc H9

5 Cable Input-Output

Lettre Couleur Signification
D | Jaune | +24V
C | Rose | GND
T | Bleu | RFE
G | Vert | FRG/RUN
K | Gray | Logic Gnd
