EOSCogniton/ELIZ-2022/02 - Documentation/module standard 48v/images_reference/2022-09-29 09_09_18-Formula Student Rollout 2016 - virtual Assembly of a Racecar - YouTube  Mozilla.jpg

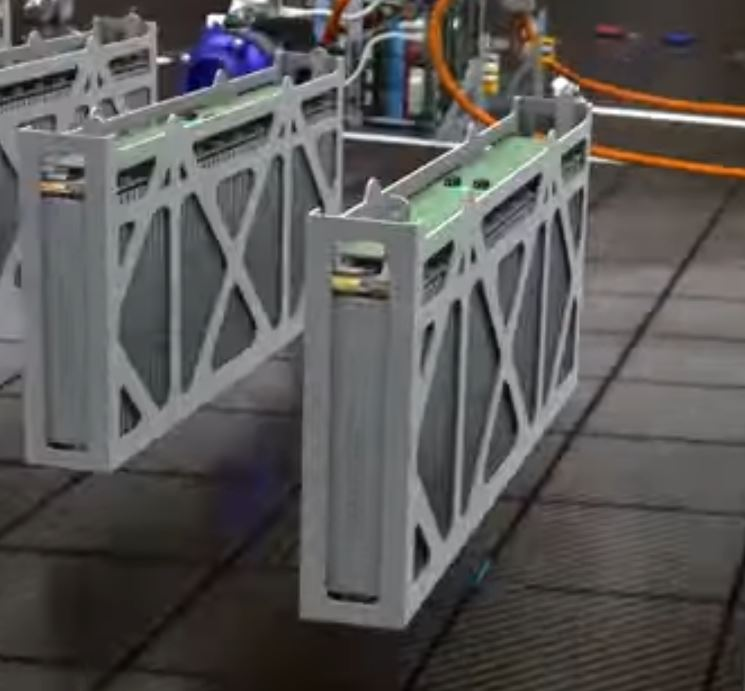
02 - Documentation/module standard 48v/images_reference/2022-09-29 09_09_18-Formula Student Rollout 2016 - virtual Assembly of a Racecar - YouTube Mozilla.jpg
