EOSCogniton/ELIZ-2022/02 - Documentation/module standard 48v/images_reference/2022-09-29 11_13_27-Formula Student Electric - Assembly Animation - YouTube  Mozilla Firefox.jpg

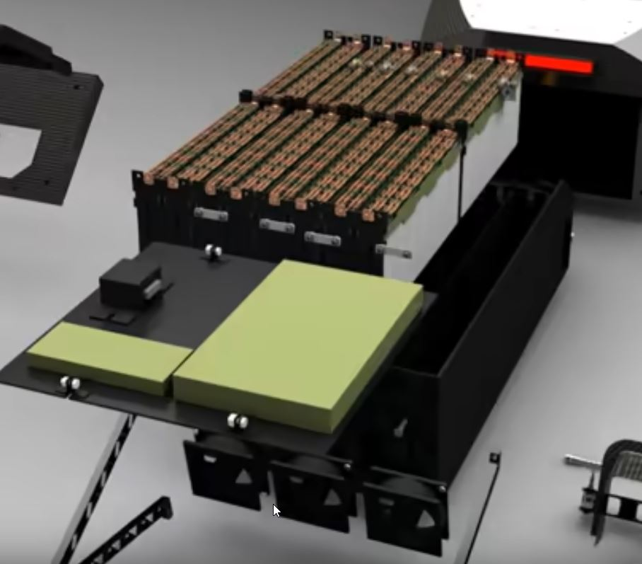
02 - Documentation/module standard 48v/images_reference/2022-09-29 11_13_27-Formula Student Electric - Assembly Animation - YouTube Mozilla Firefox.jpg
