EOSCogniton/ELIZ-2022/02 - Documentation/module standard 48v/images_reference/2022-09-29 11_31_52-Electric Vehicle Battery Pack Wiring - YouTube  Mozilla Firefox.jpg

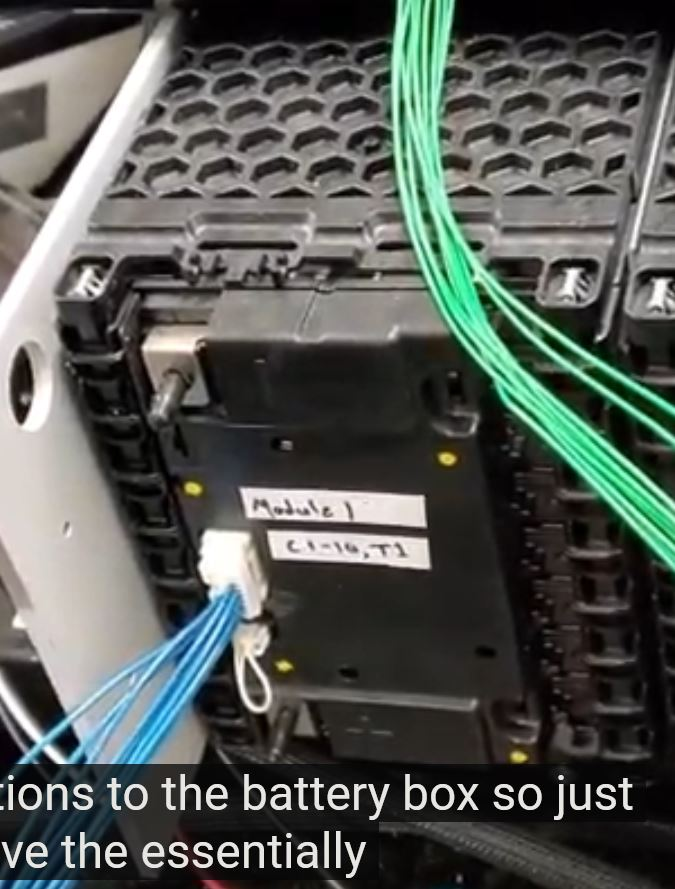
02 - Documentation/module standard 48v/images_reference/2022-09-29 11_31_52-Electric Vehicle Battery Pack Wiring - YouTube Mozilla Firefox.jpg
