EOSCogniton/ELIZ-2022/02 - Documentation/MODAC/Cartes Elec/BMS_testboard/Custom_Switch/Custom_Switch_Drawing.jpeg

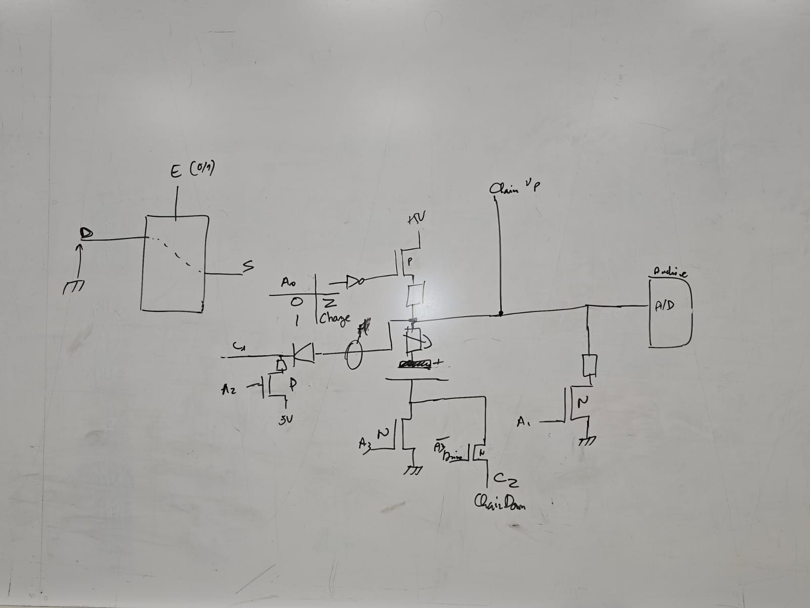
02 - Documentation/MODAC/Cartes Elec/BMS_testboard/Custom_Switch/Custom_Switch_Drawing.jpeg
