EOSCogniton/ELIZ-2022/02 - Documentation/LASMECA/Hors sujet Osiriz/Drivetrain_osiriz/F-MOT-B_Drawing (1).pdf

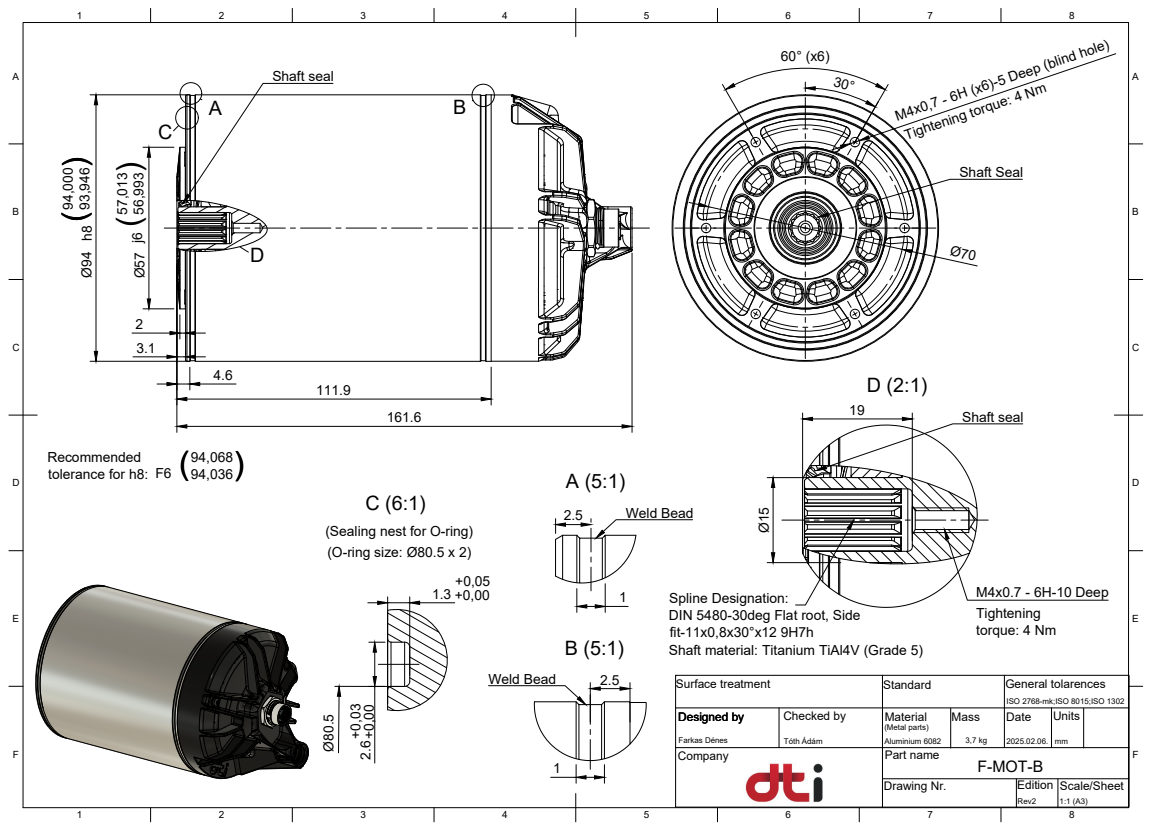
[picture p674: page 1]
Rev2; Farkas Dénes; Tóth Ádám; Aluminium 6082; 2025.02.06. mmScale/Sheet; Designed by; Drawing Nr.; Edition; Part name; Material; Mass; Date; Units; Standard; General tolarences; Checked by; Surface treatment; (Metal parts); Weld Bead; M4x0.7 - 6H-10 Deep; torque: 4 Nm; Shaft Seal; Shaft seal; tolerance for h8:

M4x0,7 - 6H (x6)-5 Deep (blind hole)

Tightening torque: 4 Nm Ø15

(Sealing nest for O-ring)
(O-ring size: Ø80.5 x 2)

Spline Designation:
DIN 5480-30deg Flat root, Side
fit-11x0,8x30°x12 9H7h
Shaft material: Titanium TiAl4V (Grade 5)

ISO 2768-mk;ISO 8015;ISO 1302
