EOSCogniton/ELIZ-2022/01 - Maquette CATIA/SU_Suspension/Gabarits/Gabarit_en_triangle_arriere_bas/MEPs/maintien_plaques_tie_rod.pdf

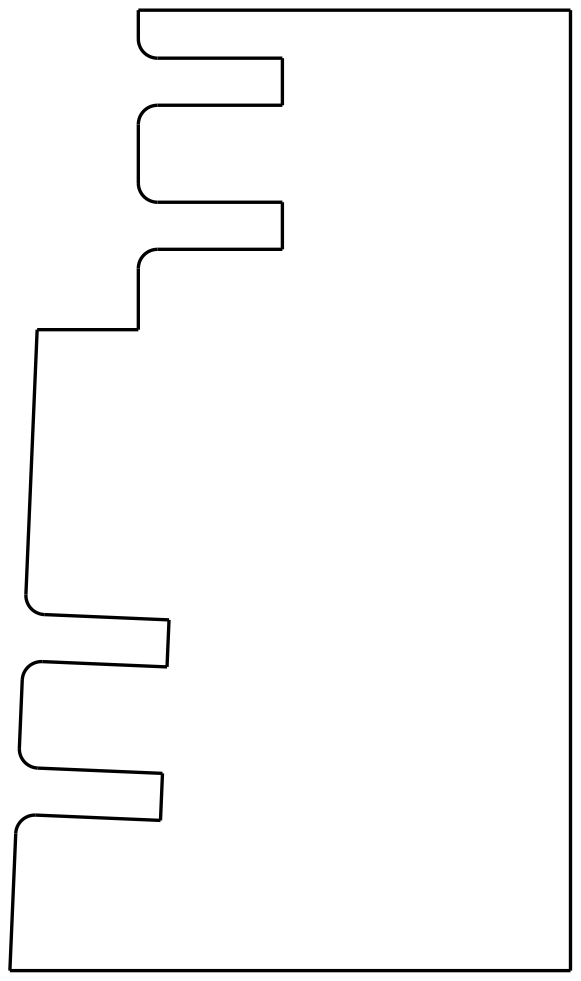
[picture p675: page 1]
