EOSCogniton/ELIZ-2022/01 - Maquette CATIA/EL_Electrical/EL_A2300 (Module)/plan_tsac_montage.pdf

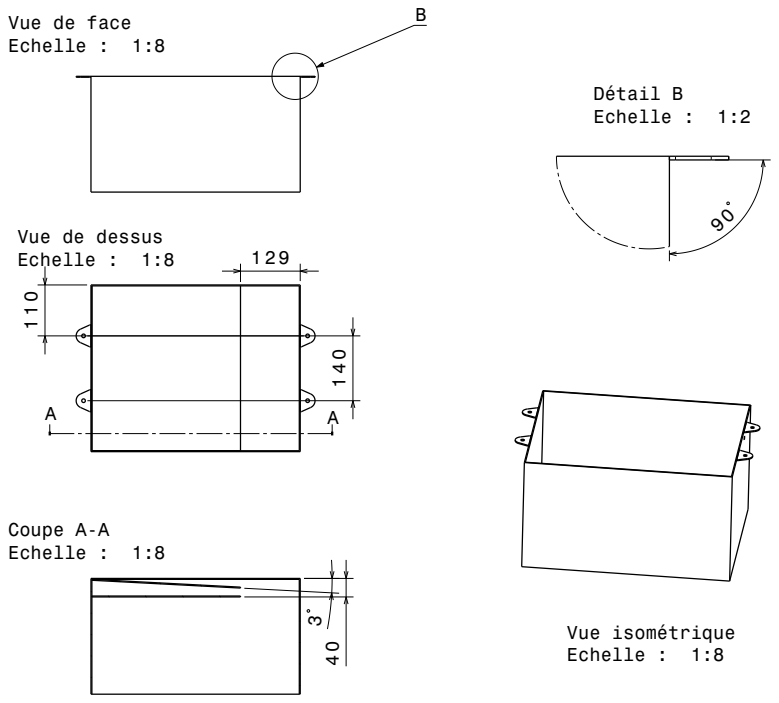
[picture p676: page 1]
Vue isométrique Echelle : 1:8; Coupe A-A Echelle : 1:8; Détail B Echelle : 1:2

Vue de face
Echelle : 1:8

Vue de dessus
