EOSCogniton/ELIZ-2022/01 - Maquette CATIA/EN_Engine_Drivetrain/Gabarits/EN_02017_gabarit_2_MEP.pdf

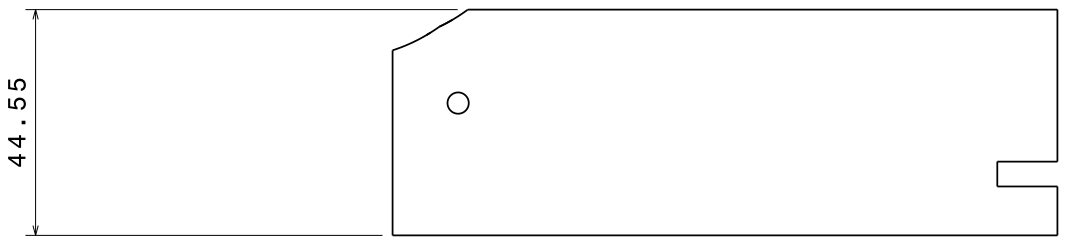
[picture p677: page 1]
