EOSCogniton/ELIZ-2022/01 - Maquette CATIA/EN_Engine_Drivetrain/Gabarits/EN_02018_support_MEP.pdf

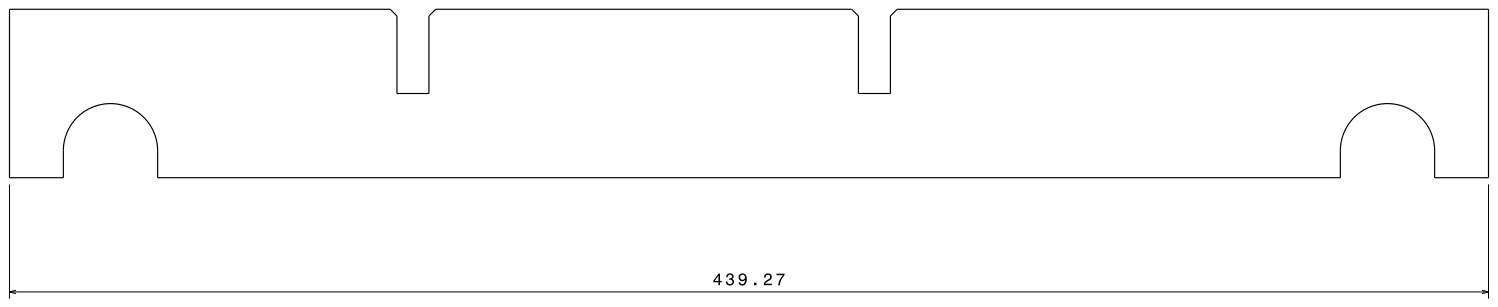
[picture p678: page 1]
