EOSCogniton/ELIZ-2022/01 - Maquette CATIA/EN_Engine_Drivetrain/Gabarits/EN_2018_MEP.pdf

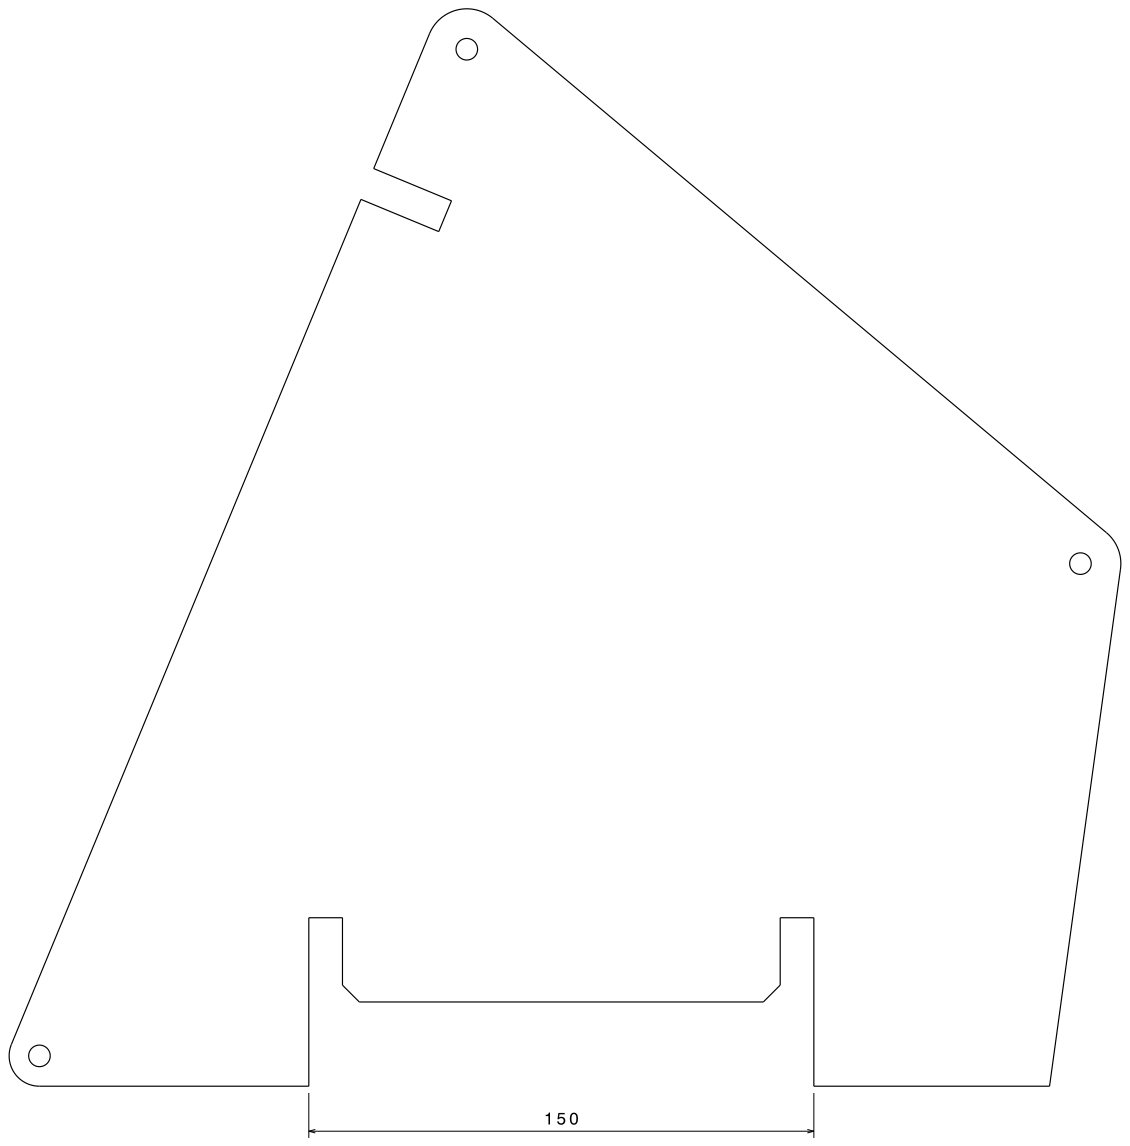
[picture p679: page 1]
