EOSCogniton/ELIZ-2022/01 - Maquette CATIA/FR_Frame_Body/FR_A0500 (IA Assembly)/MEP FR_05002_Calque_1.pdf

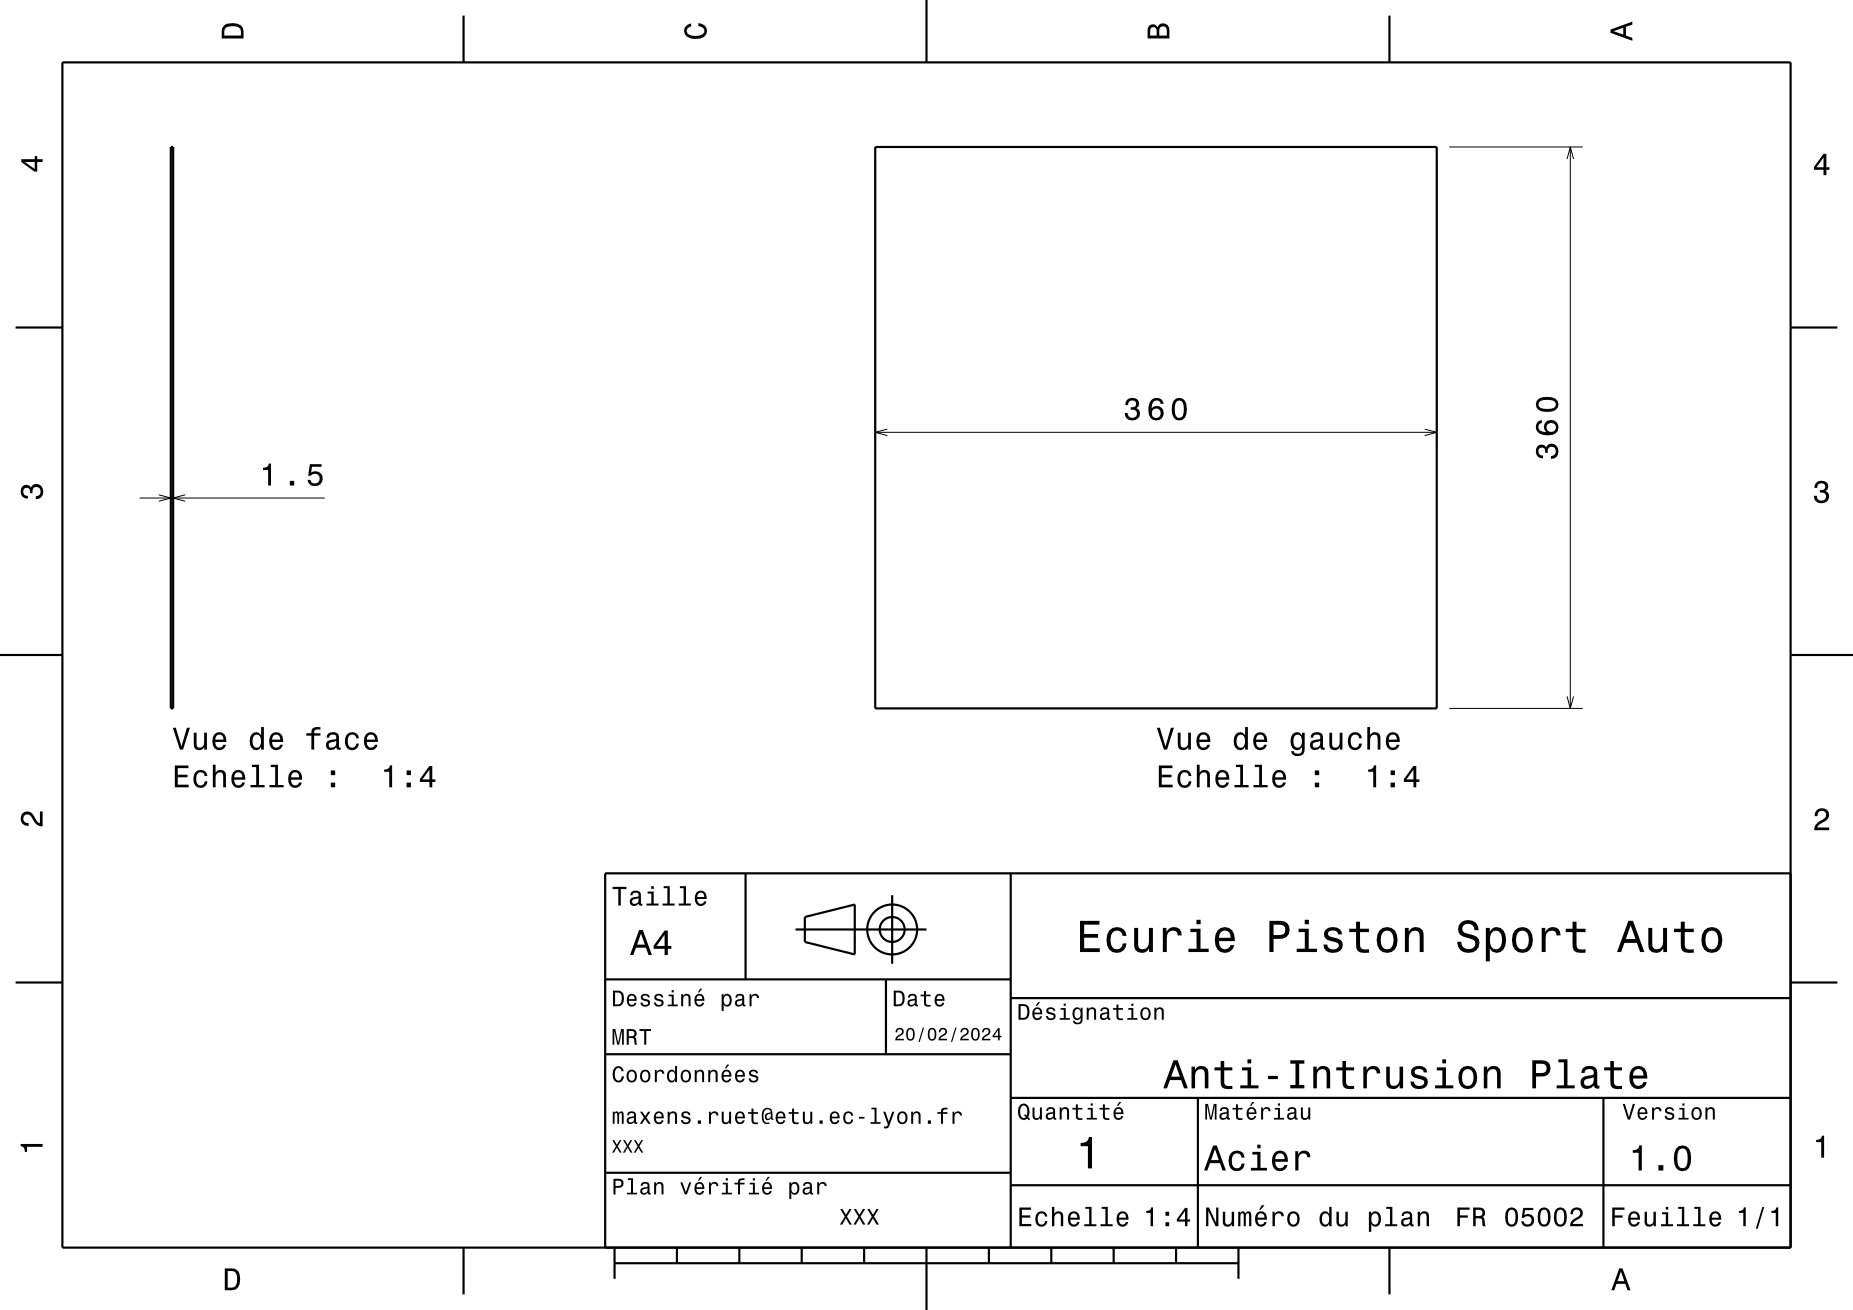
[picture p680: page 1]
