EOSCogniton/ELIZ-2022/01 - Maquette CATIA/FR_Frame_Body/FR_A0500 (IA Assembly)/MEP FR_05002_Calque_2.pdf

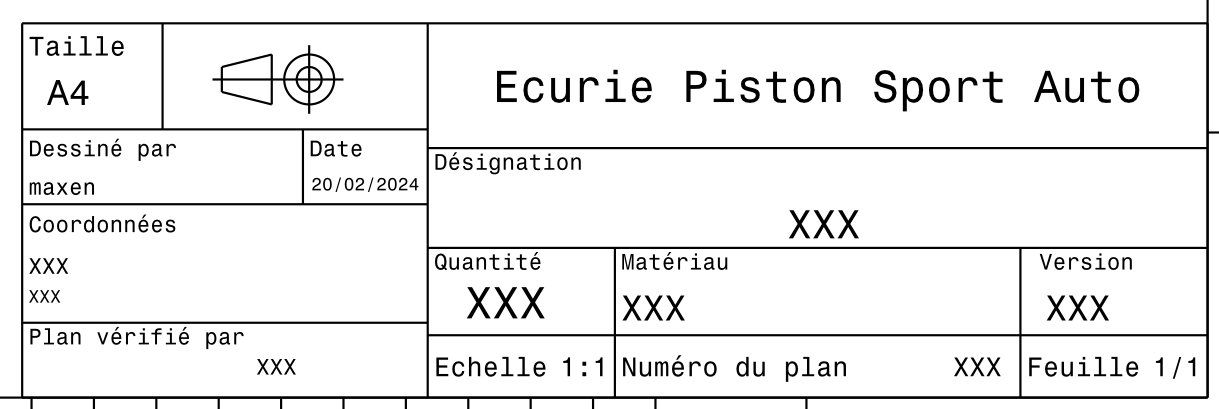
[picture p681: page 1]
