EOSCogniton/ELIZ-2022/02 - Documentation/BASTIE/Cartes Valkyriz/test.pdf

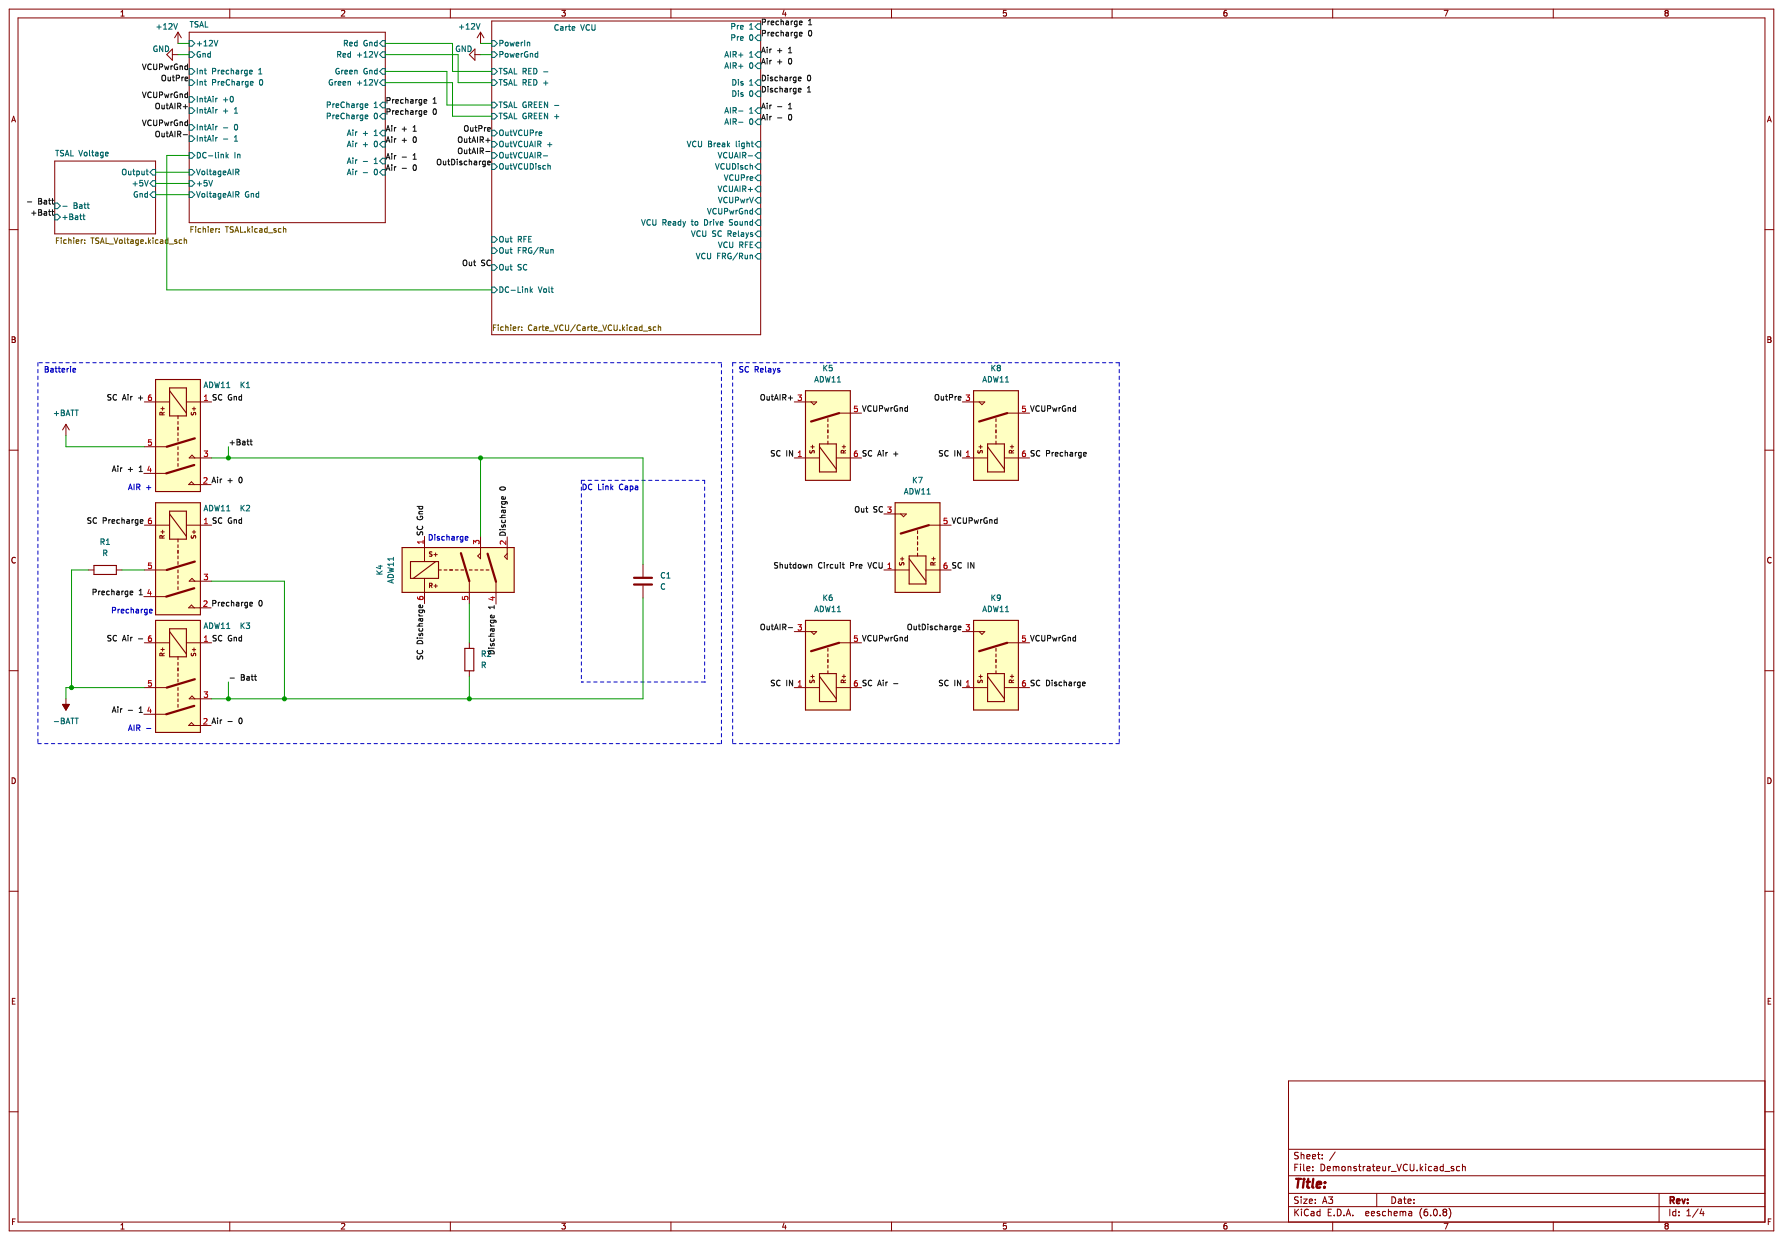
[picture p682: page 1]

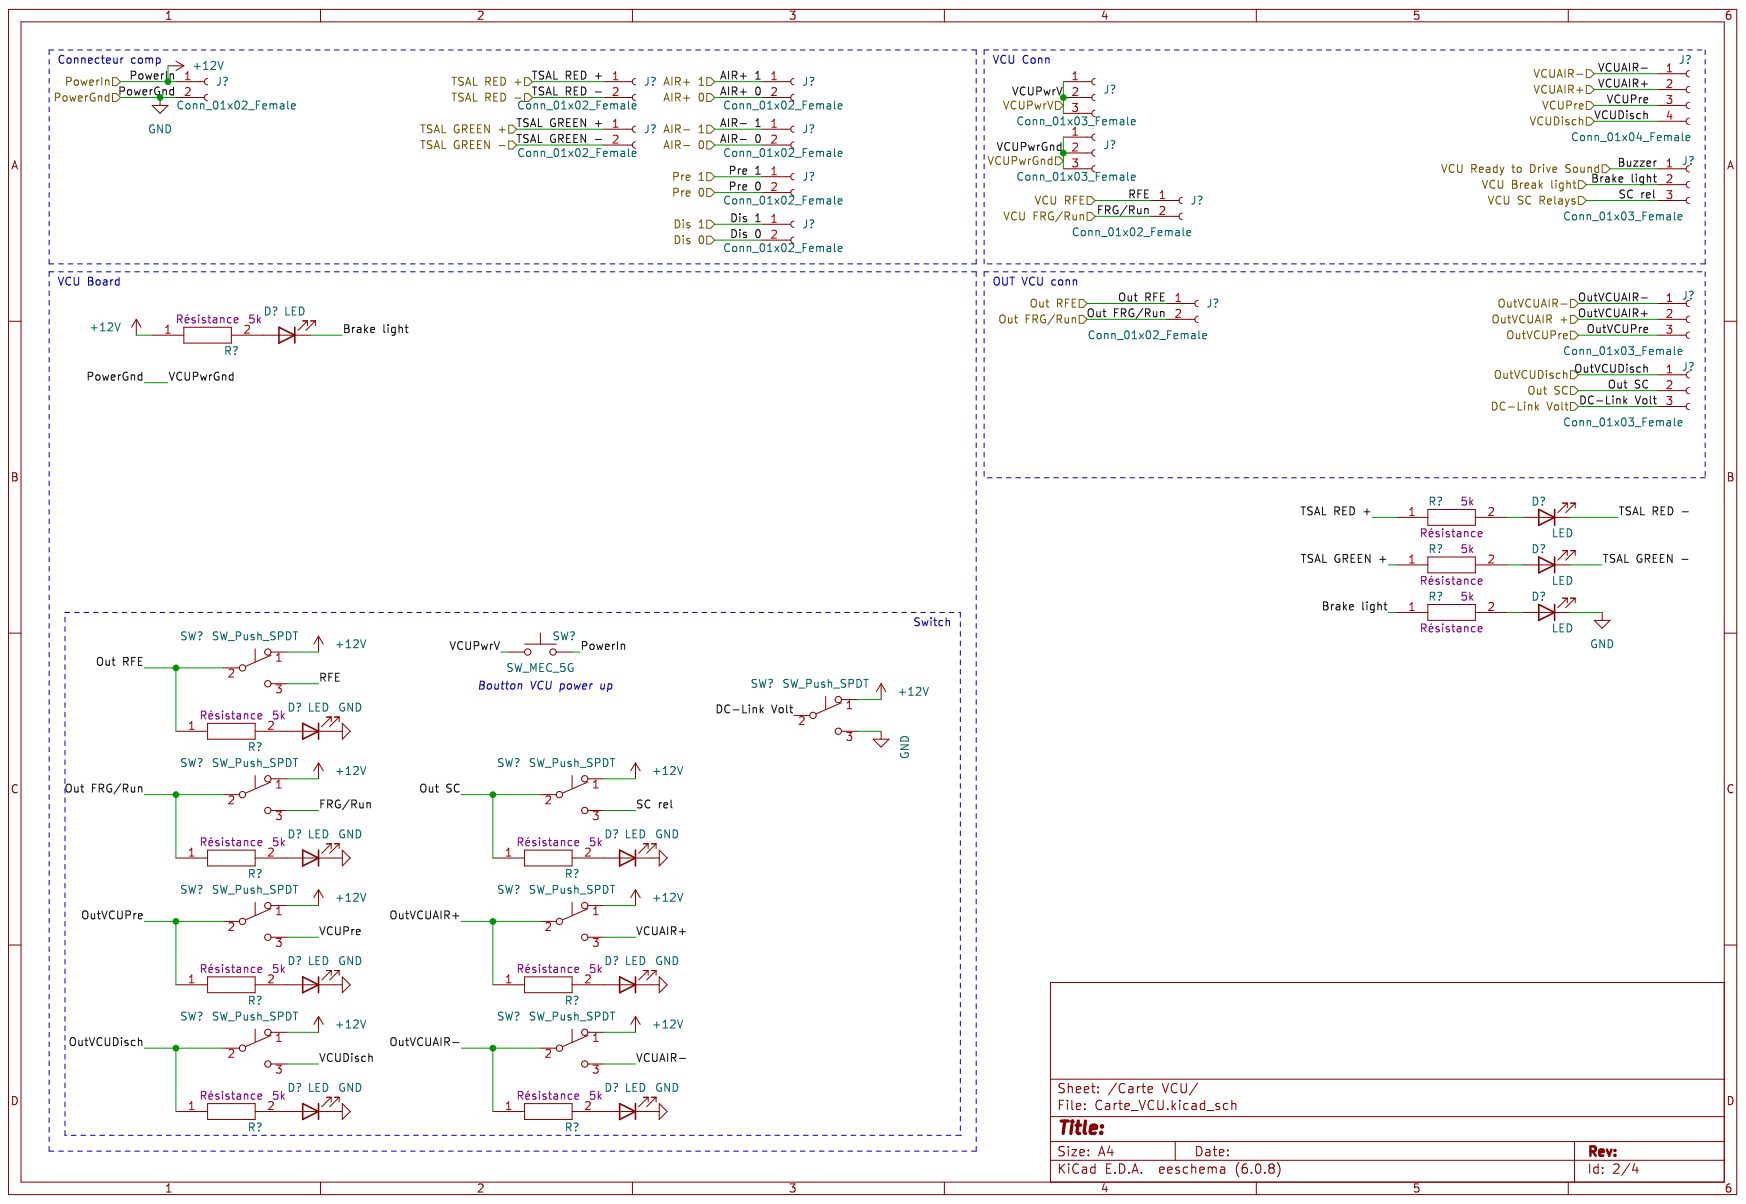
[picture p683: page 2]

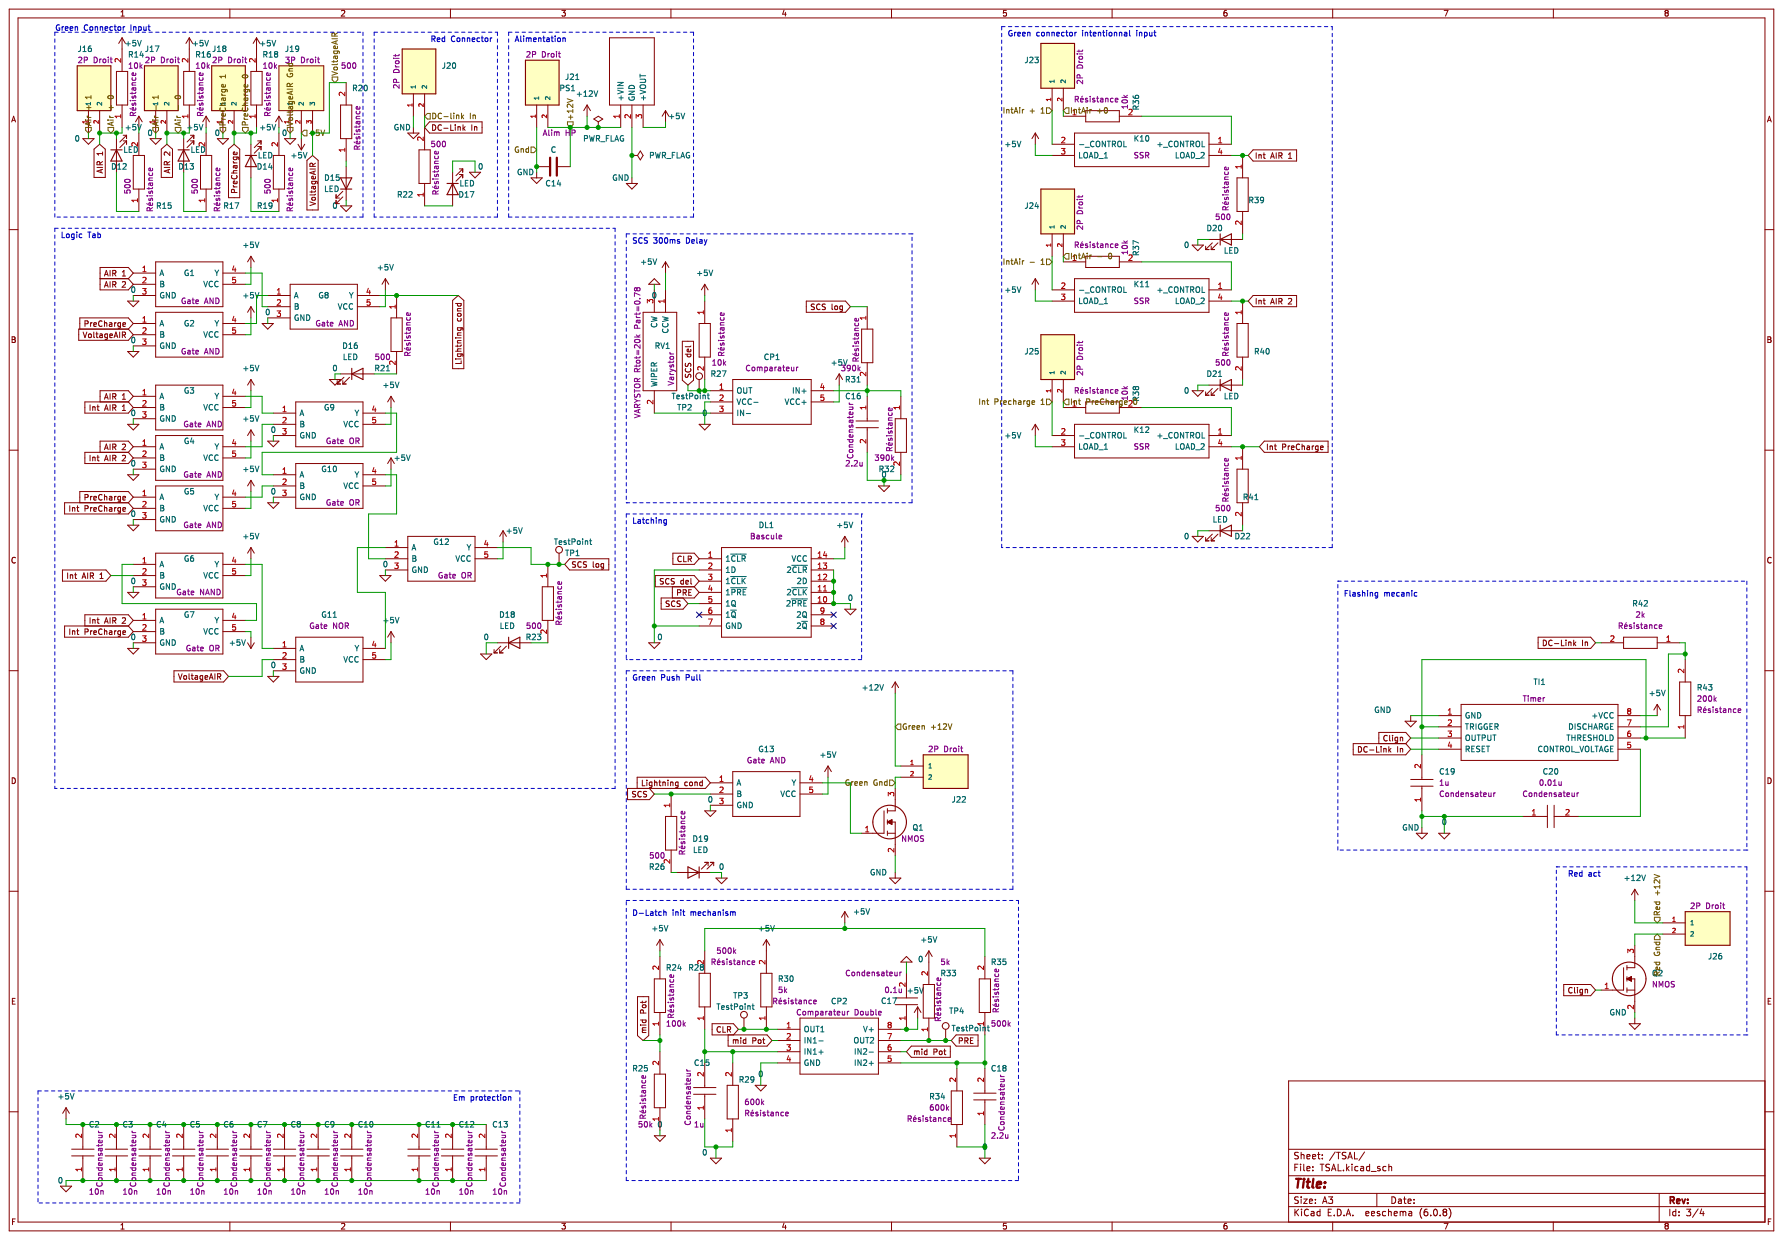
[picture p684: page 3]

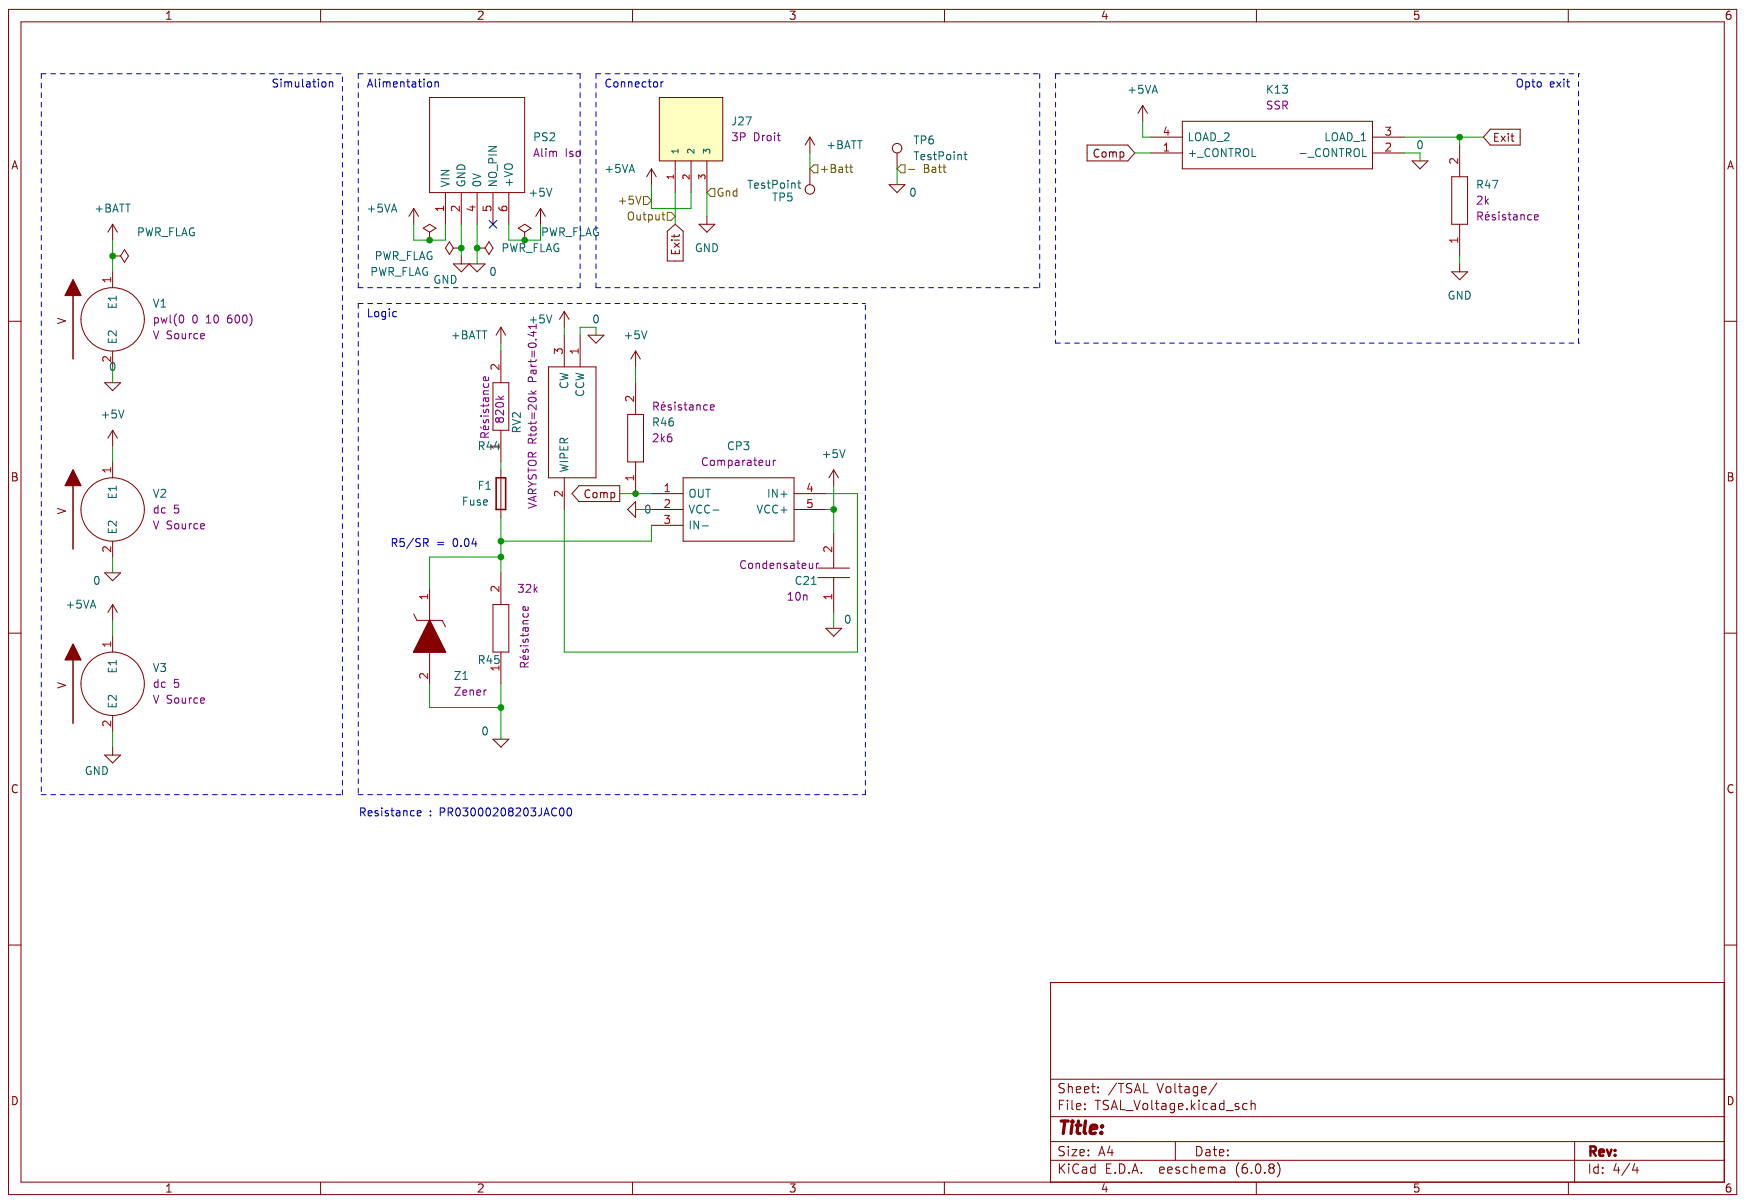
[picture p685: page 4]
