EOSCogniton/ELIZ-2022/02 - Documentation/LASMECA/Hors sujet Osiriz/Drivetrain_osiriz/hum_logo_pan_p_m.pdf

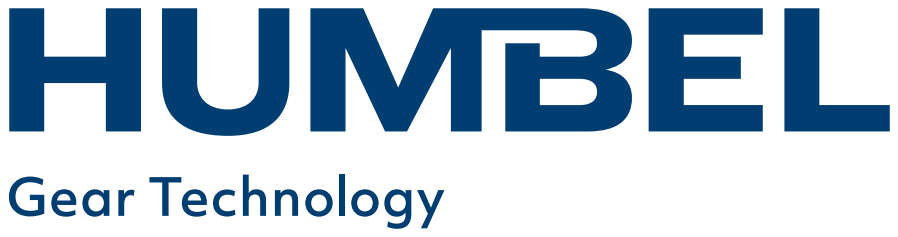
[picture p686: page 1]
