EOSCogniton/ELIZ-2022/02 - Documentation/MODAC/Cartes Elec/TS Full (Schematic only)/TS schematic.pdf

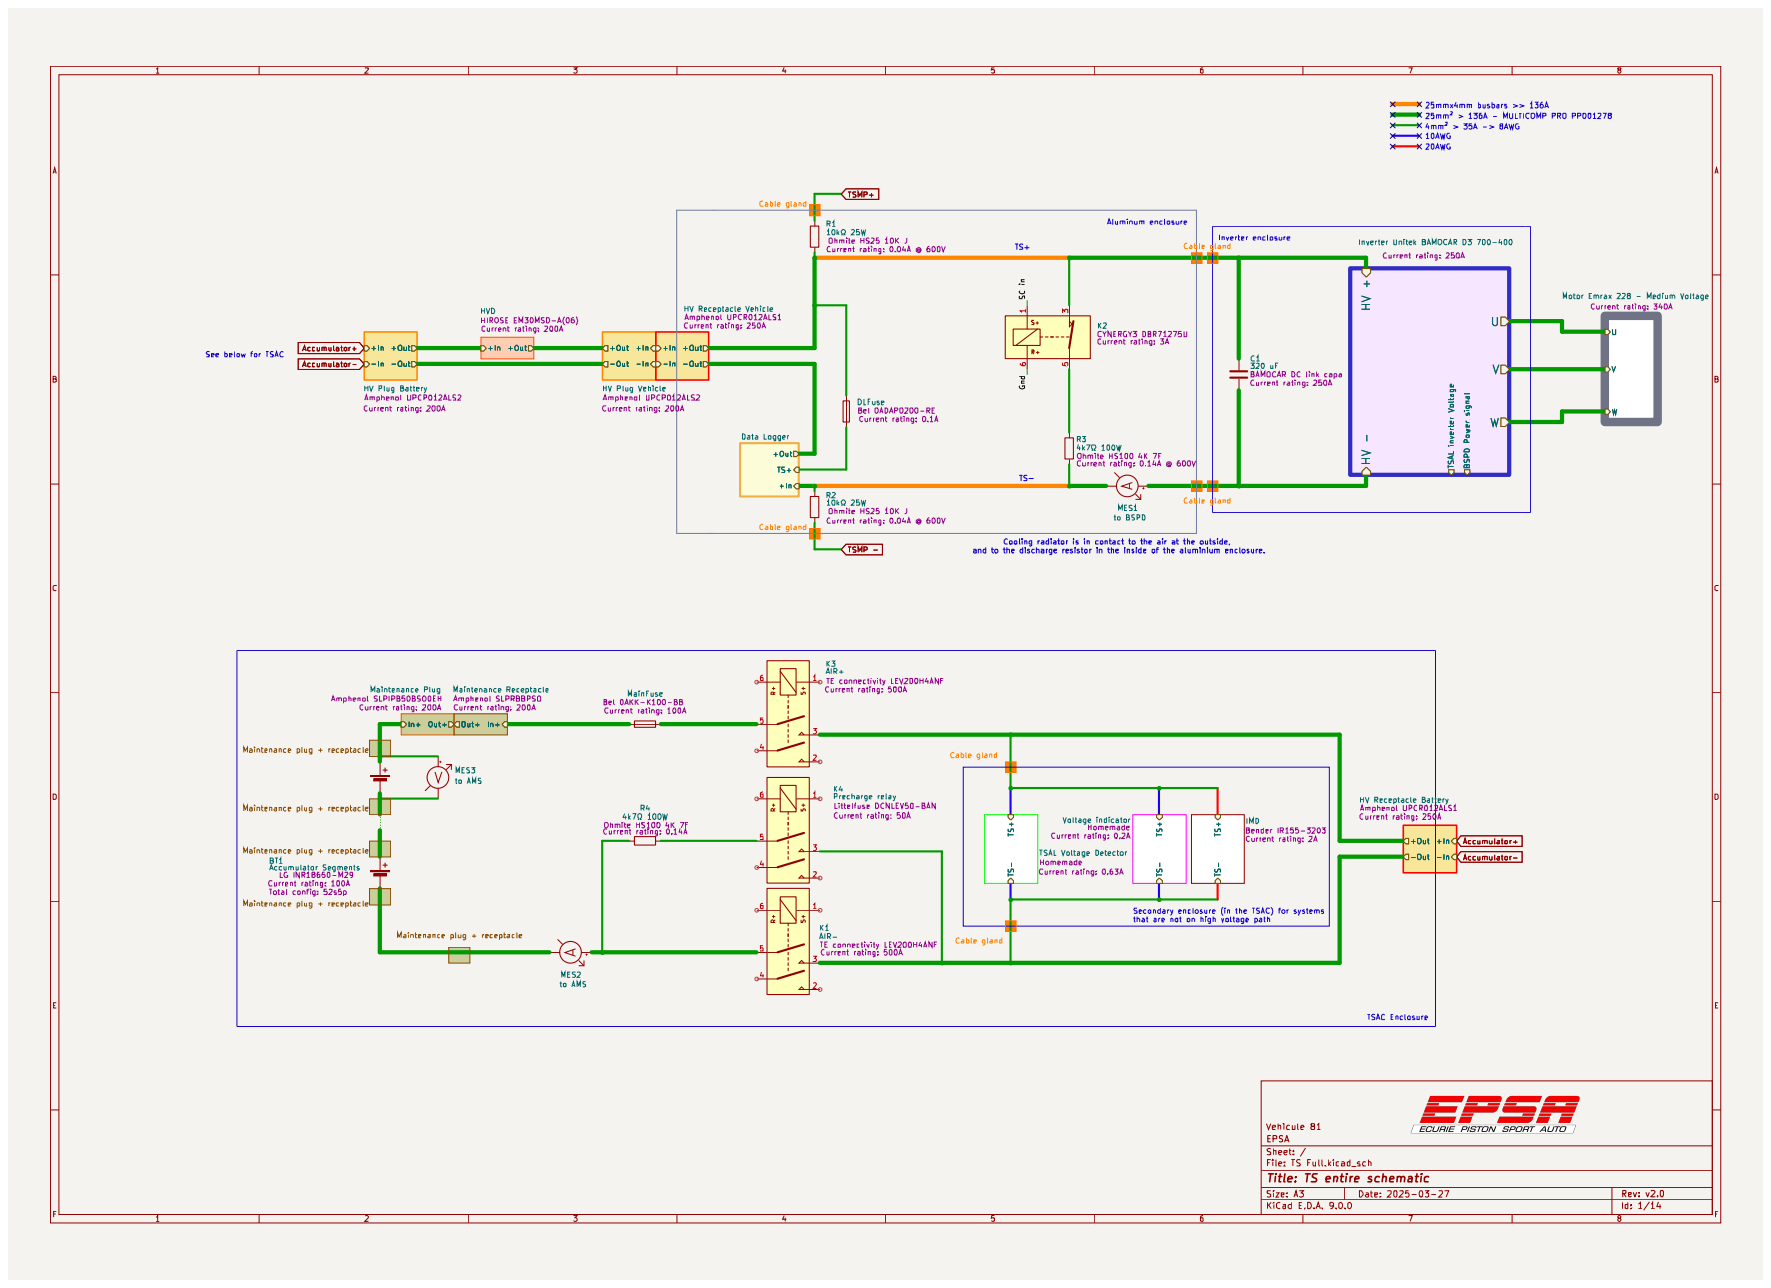
[picture p687: page 1]

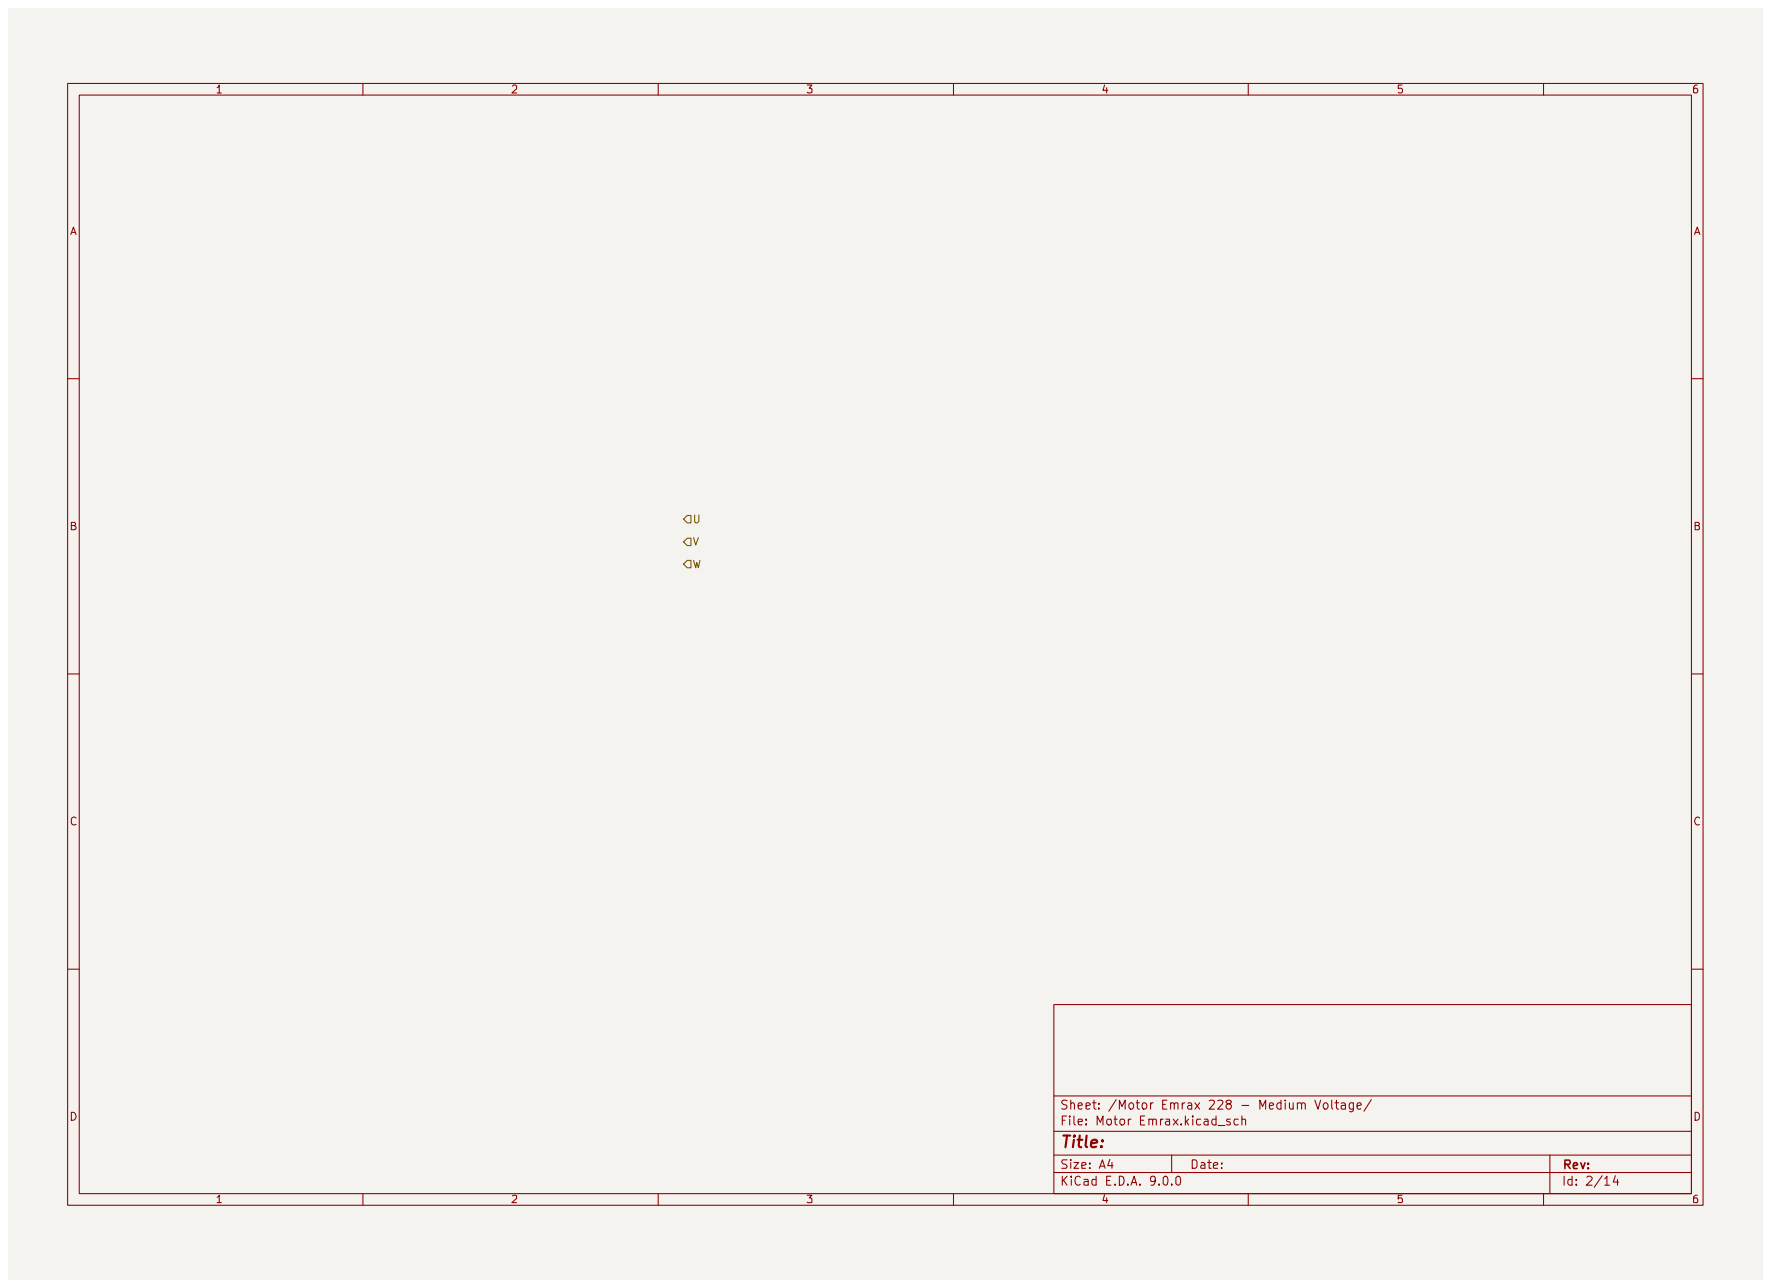
[picture p688: page 2]

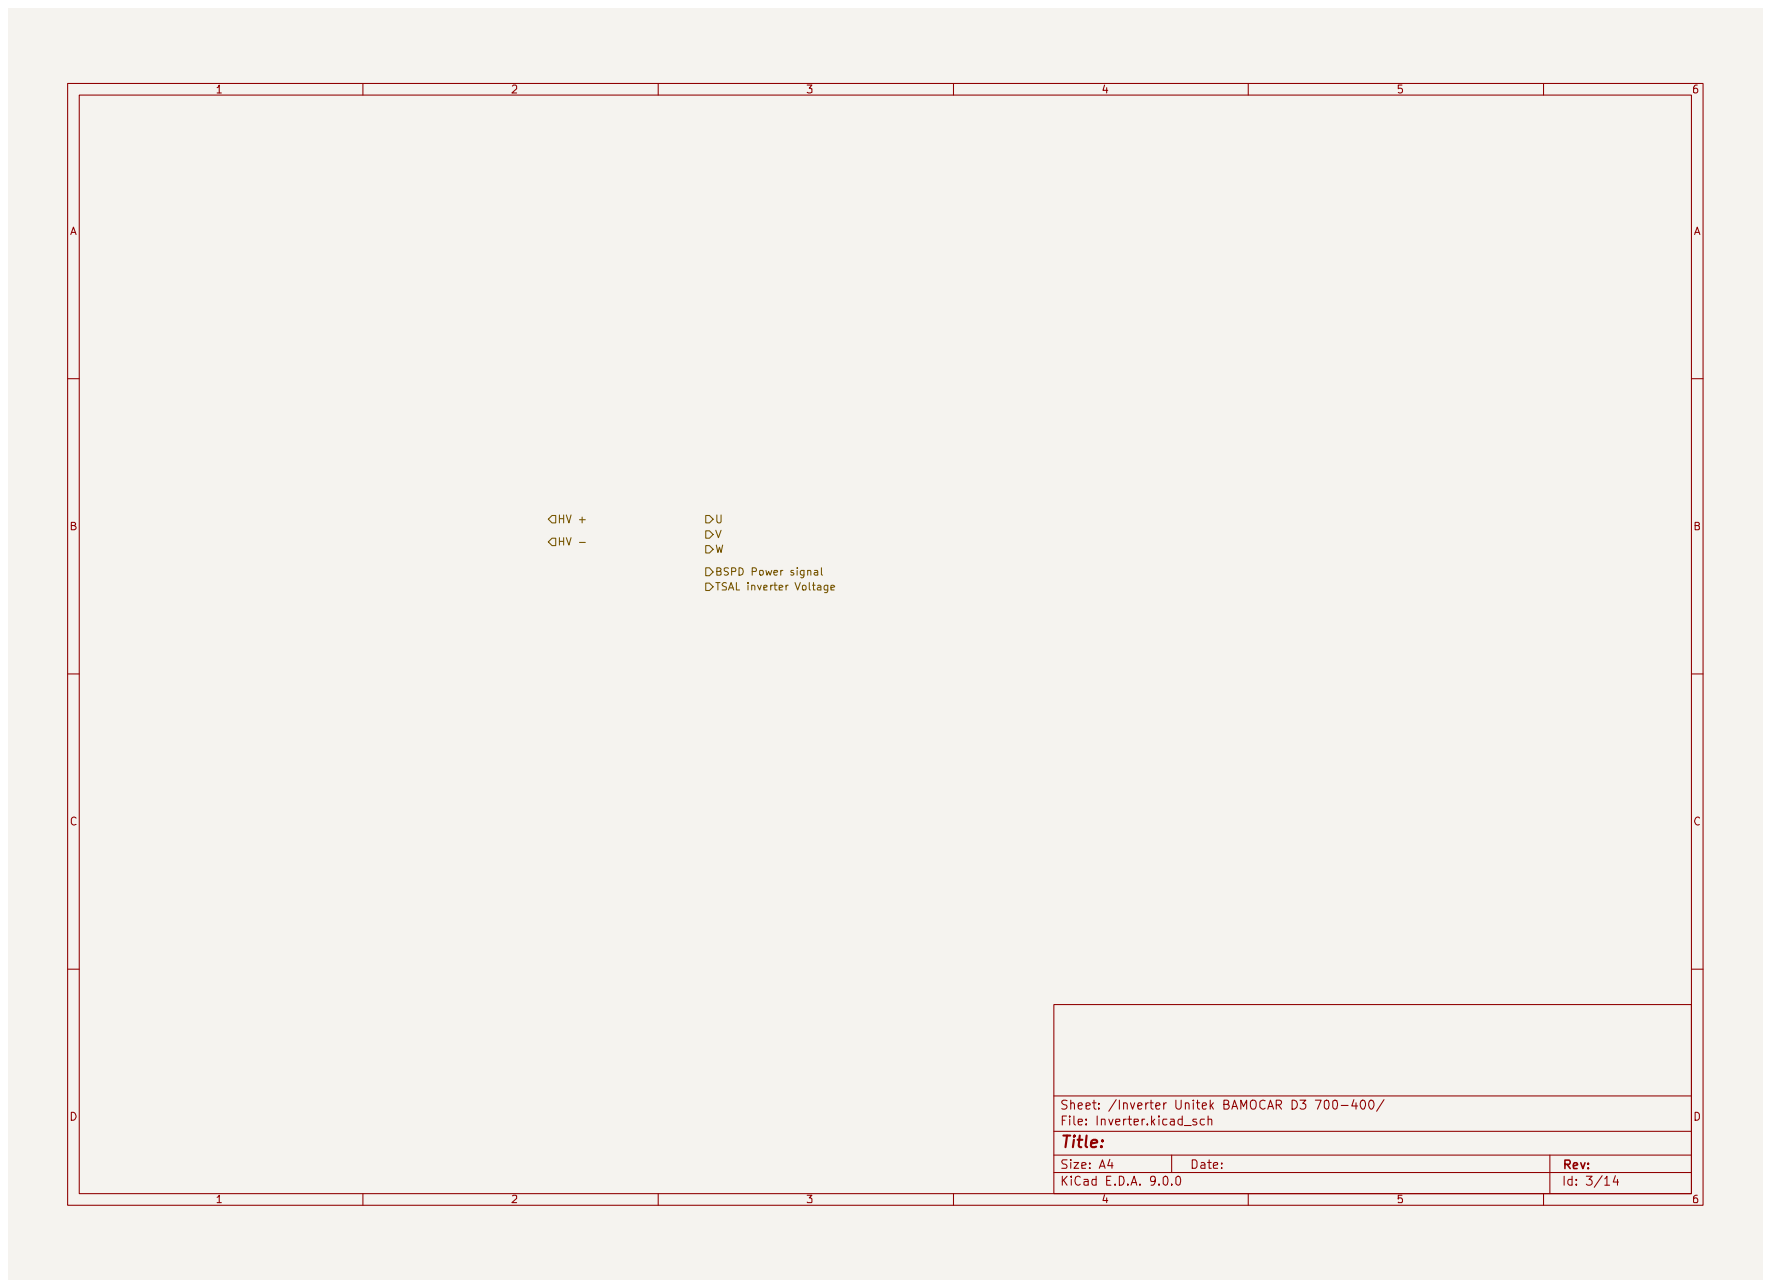
[picture p689: page 3]

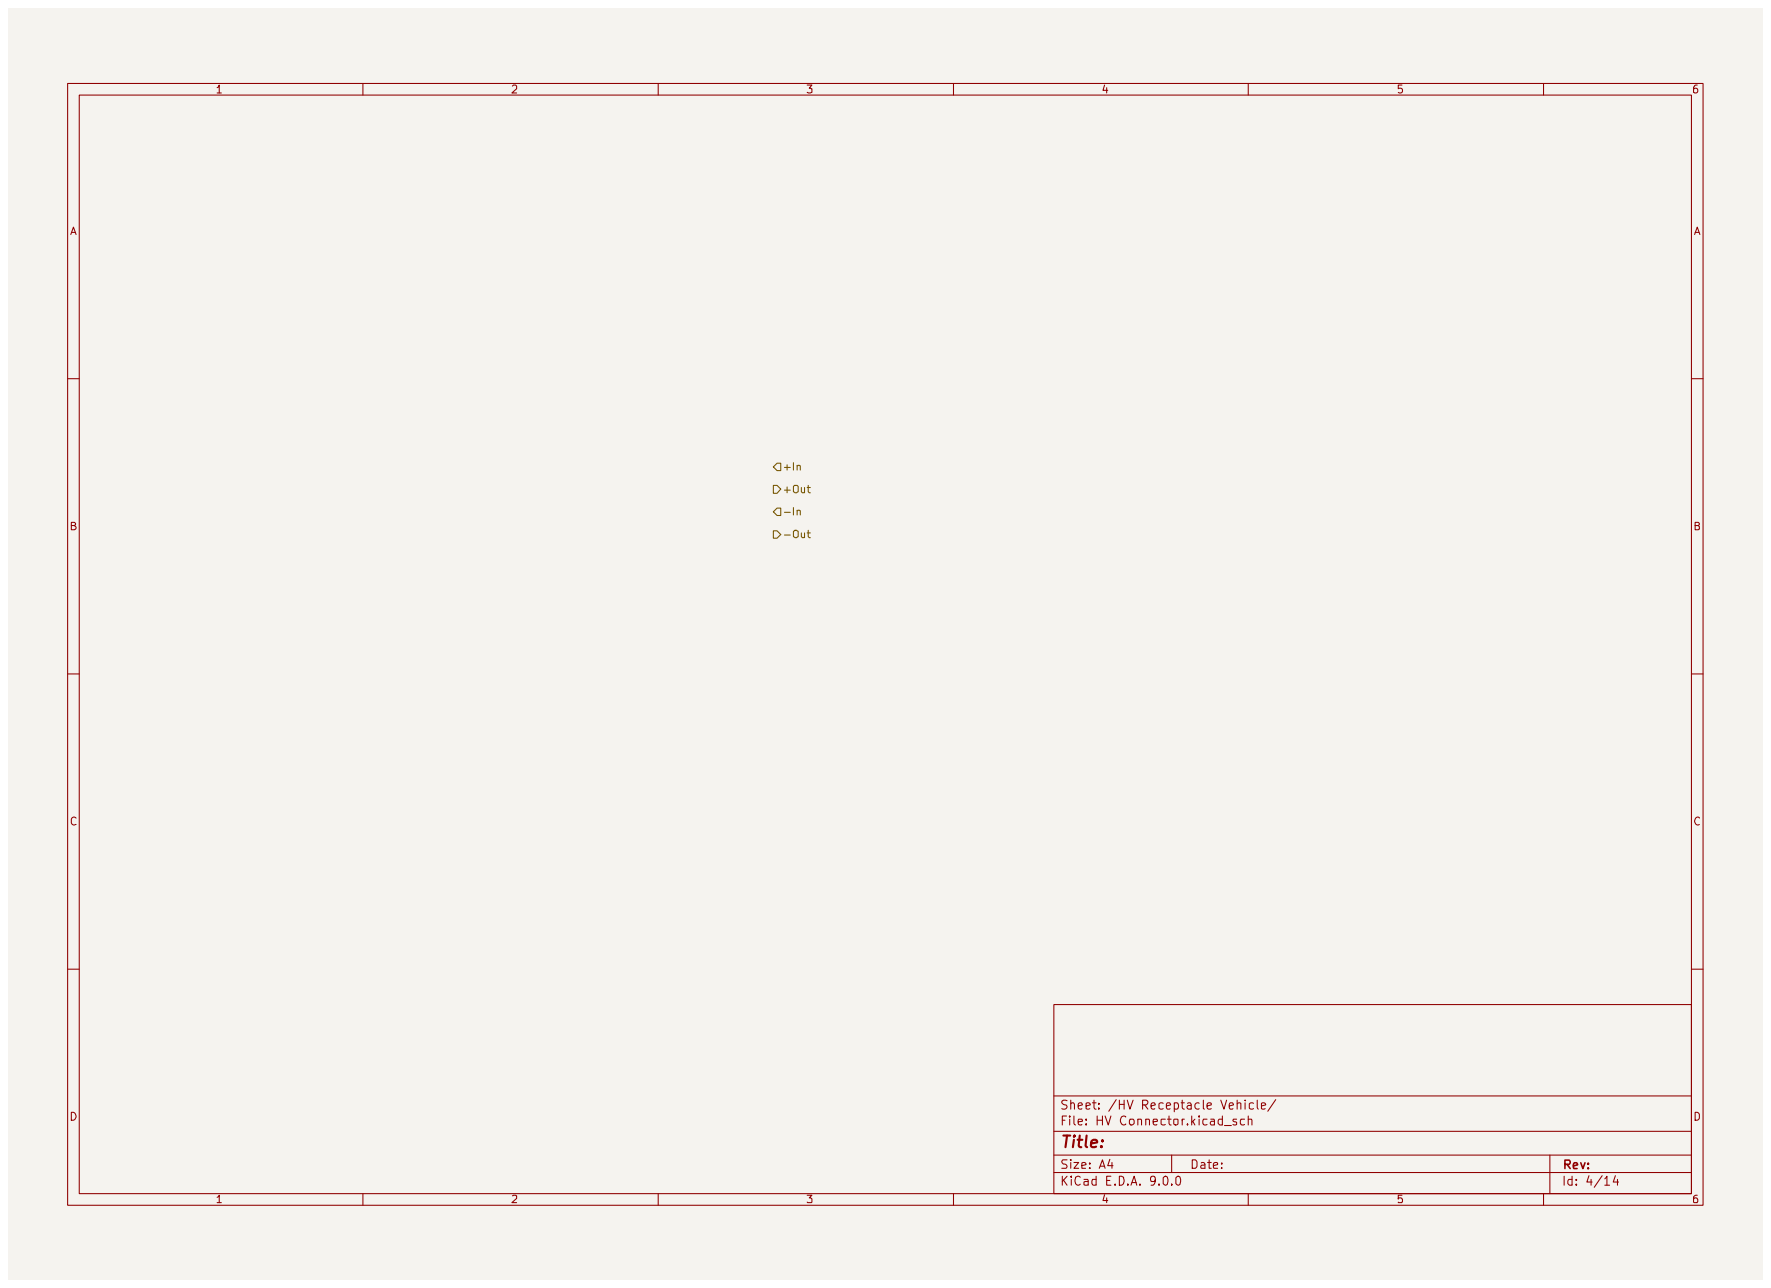
[picture p690: page 4]

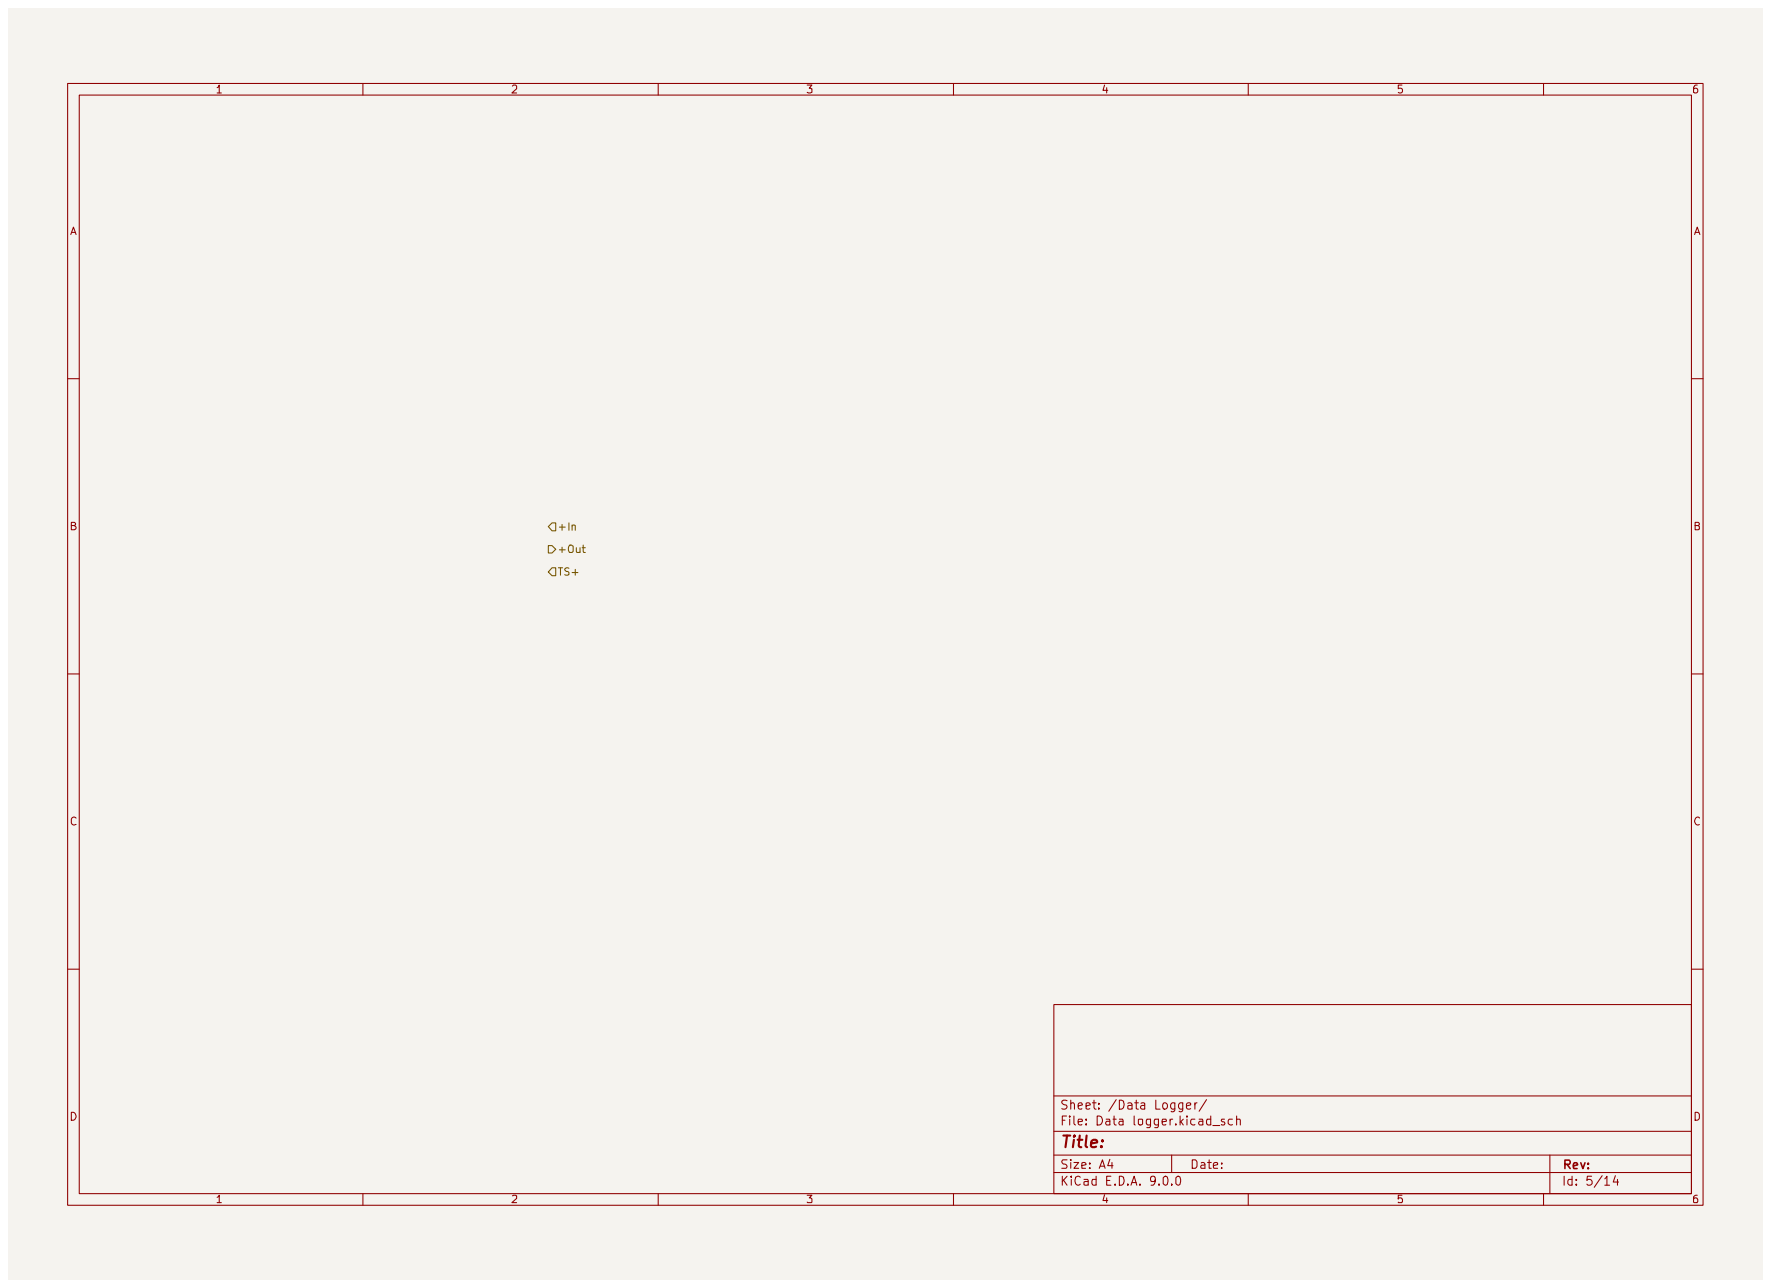
[picture p691: page 5]

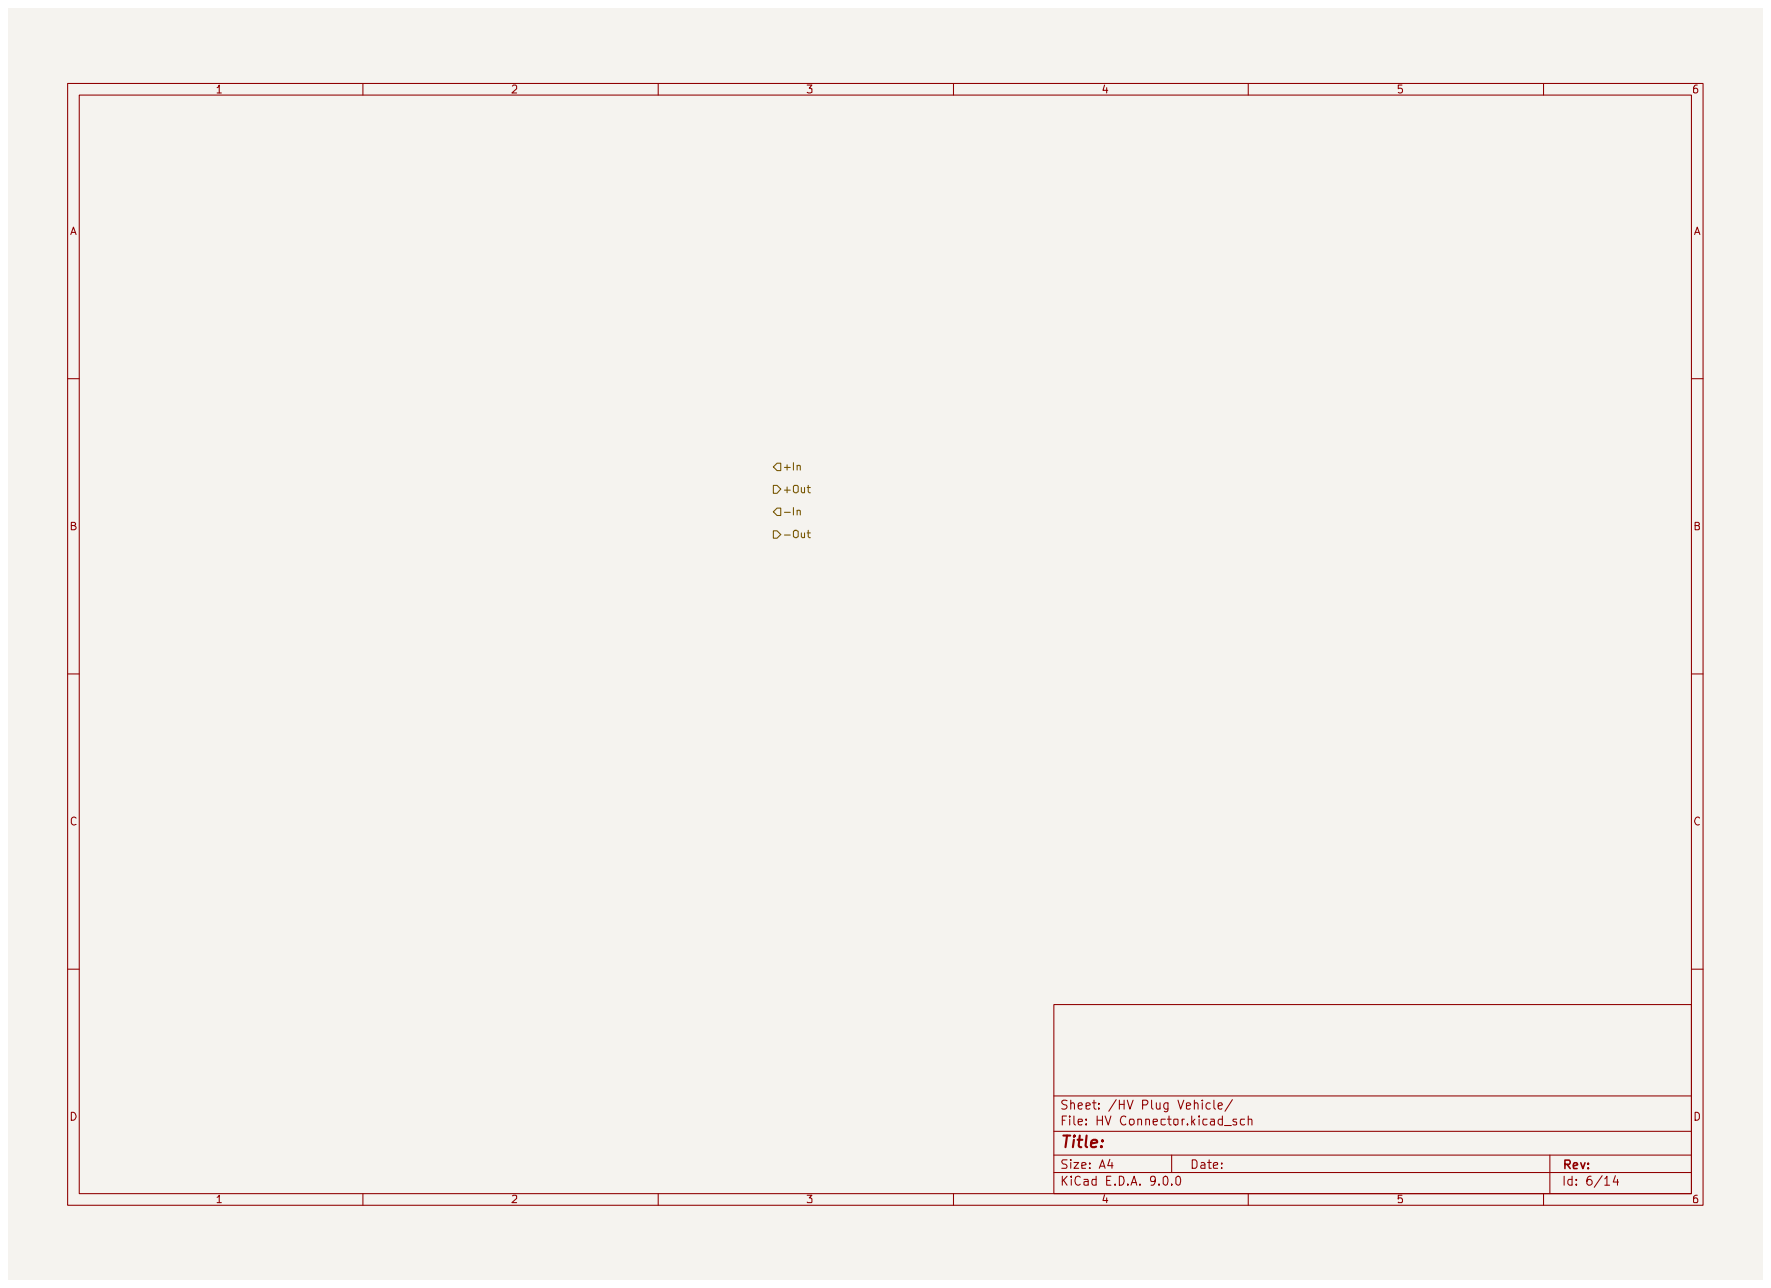
[picture p692: page 6]

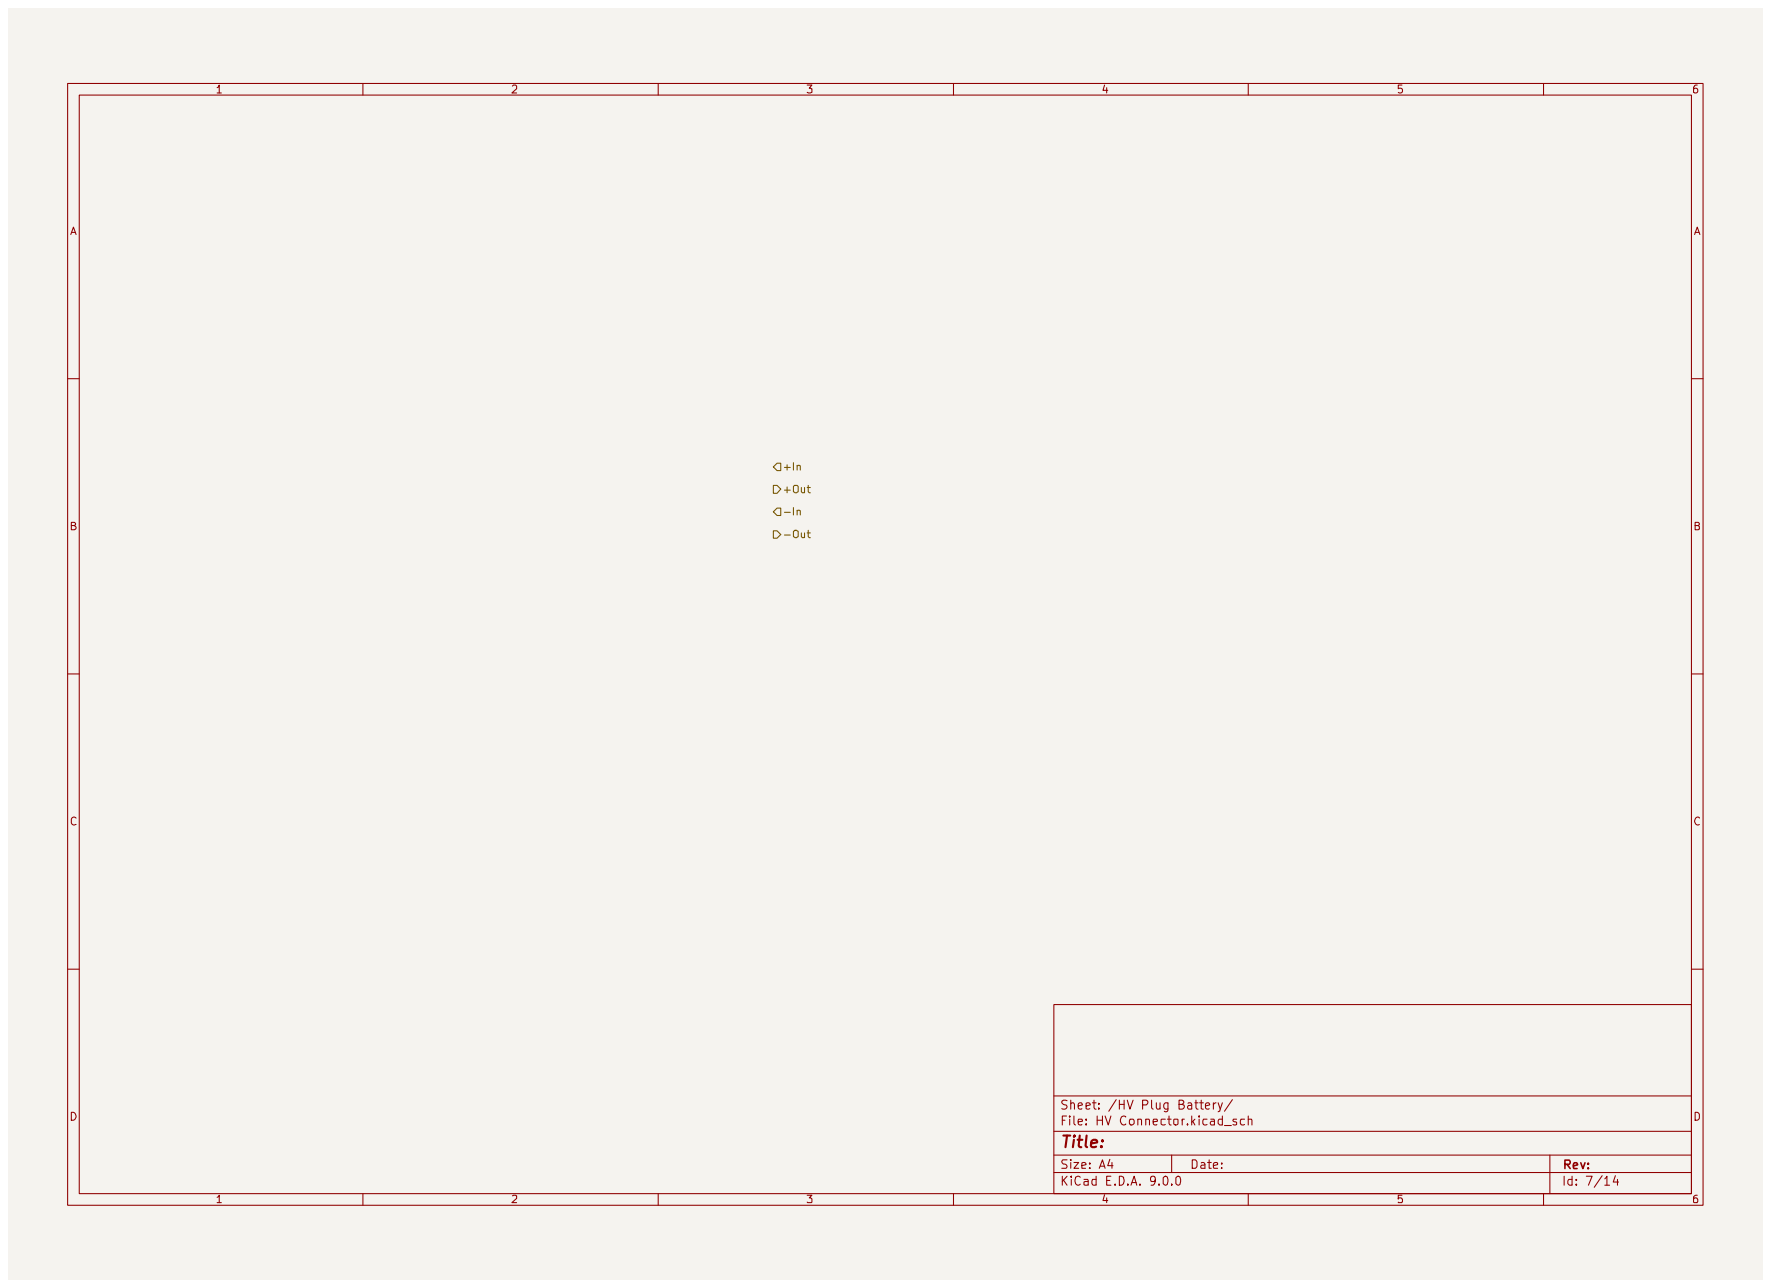
[picture p693: page 7]

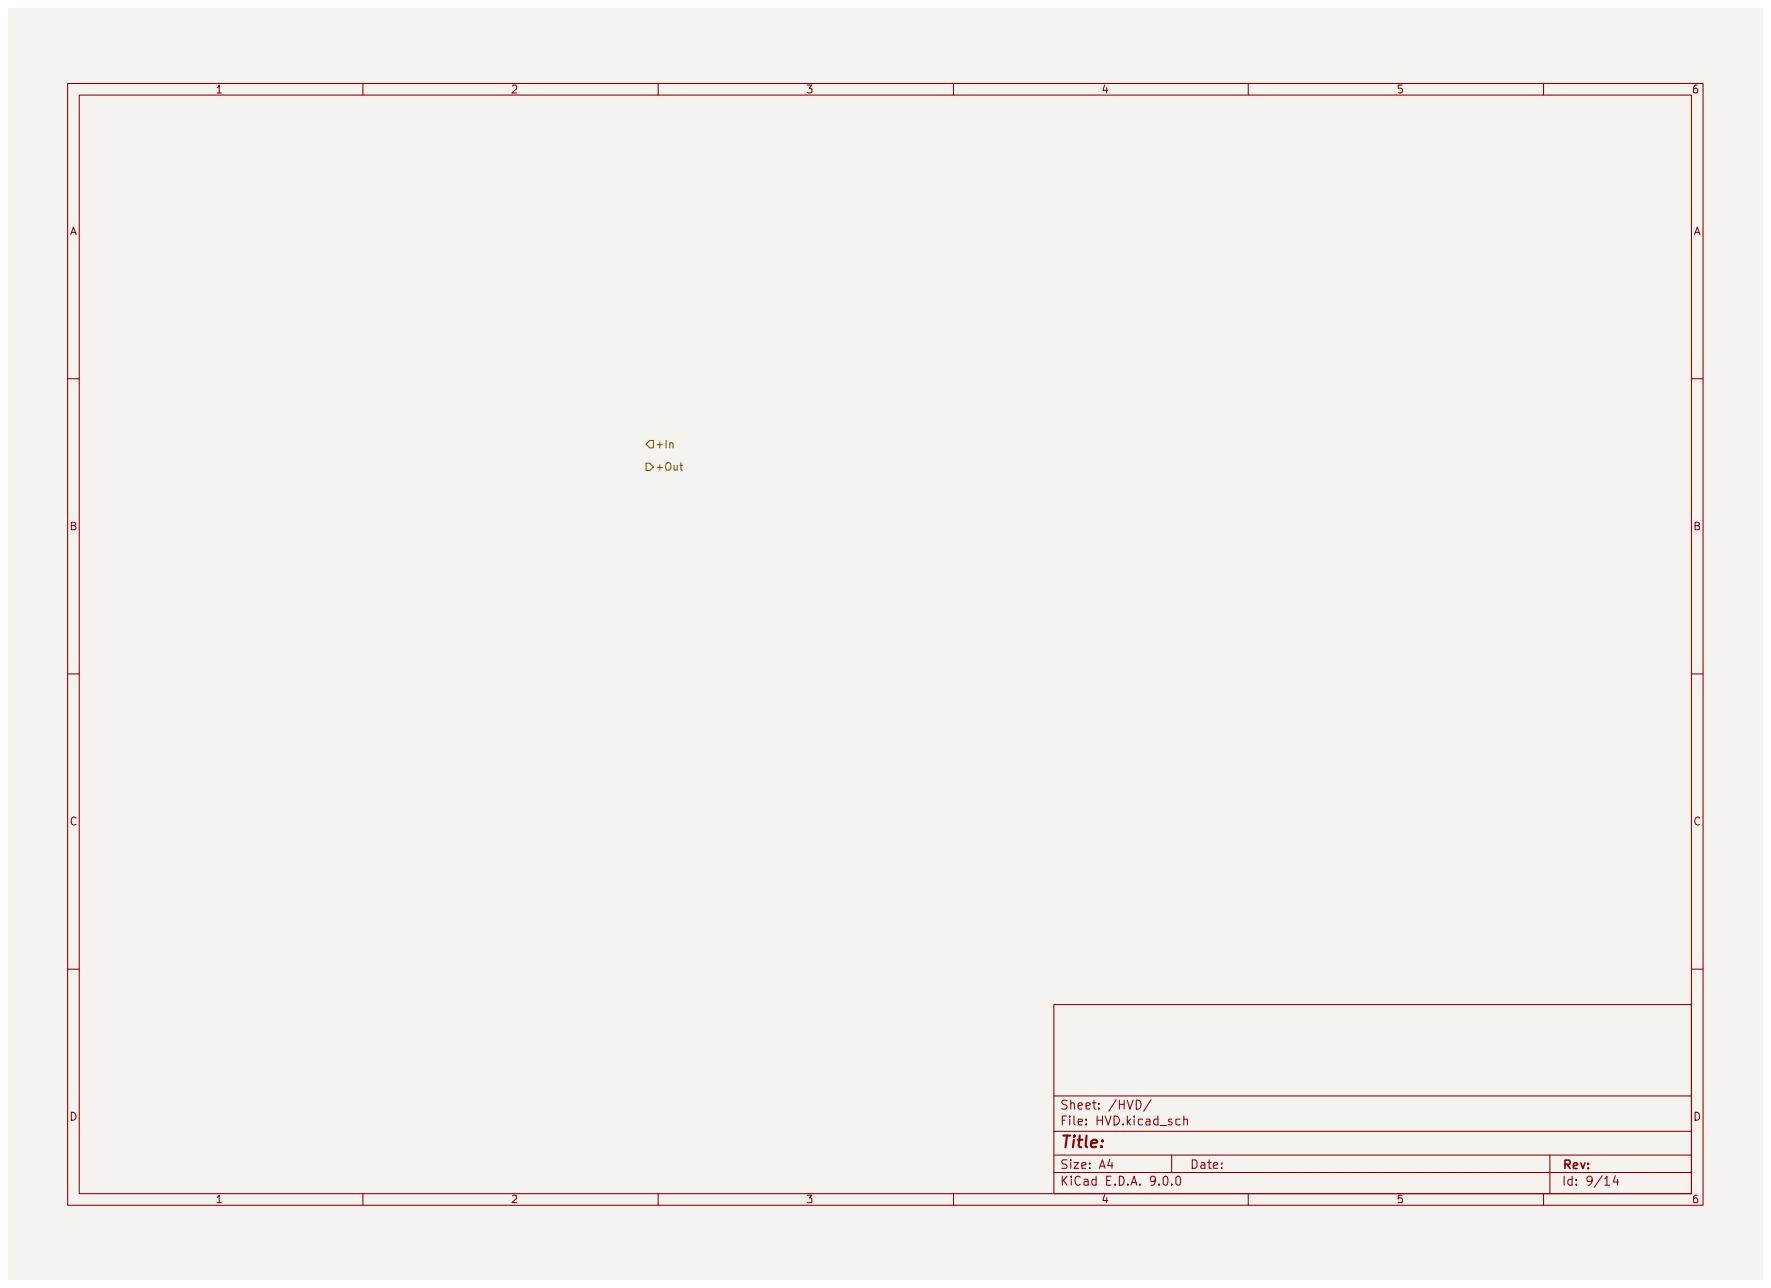
[picture p694: page 8]

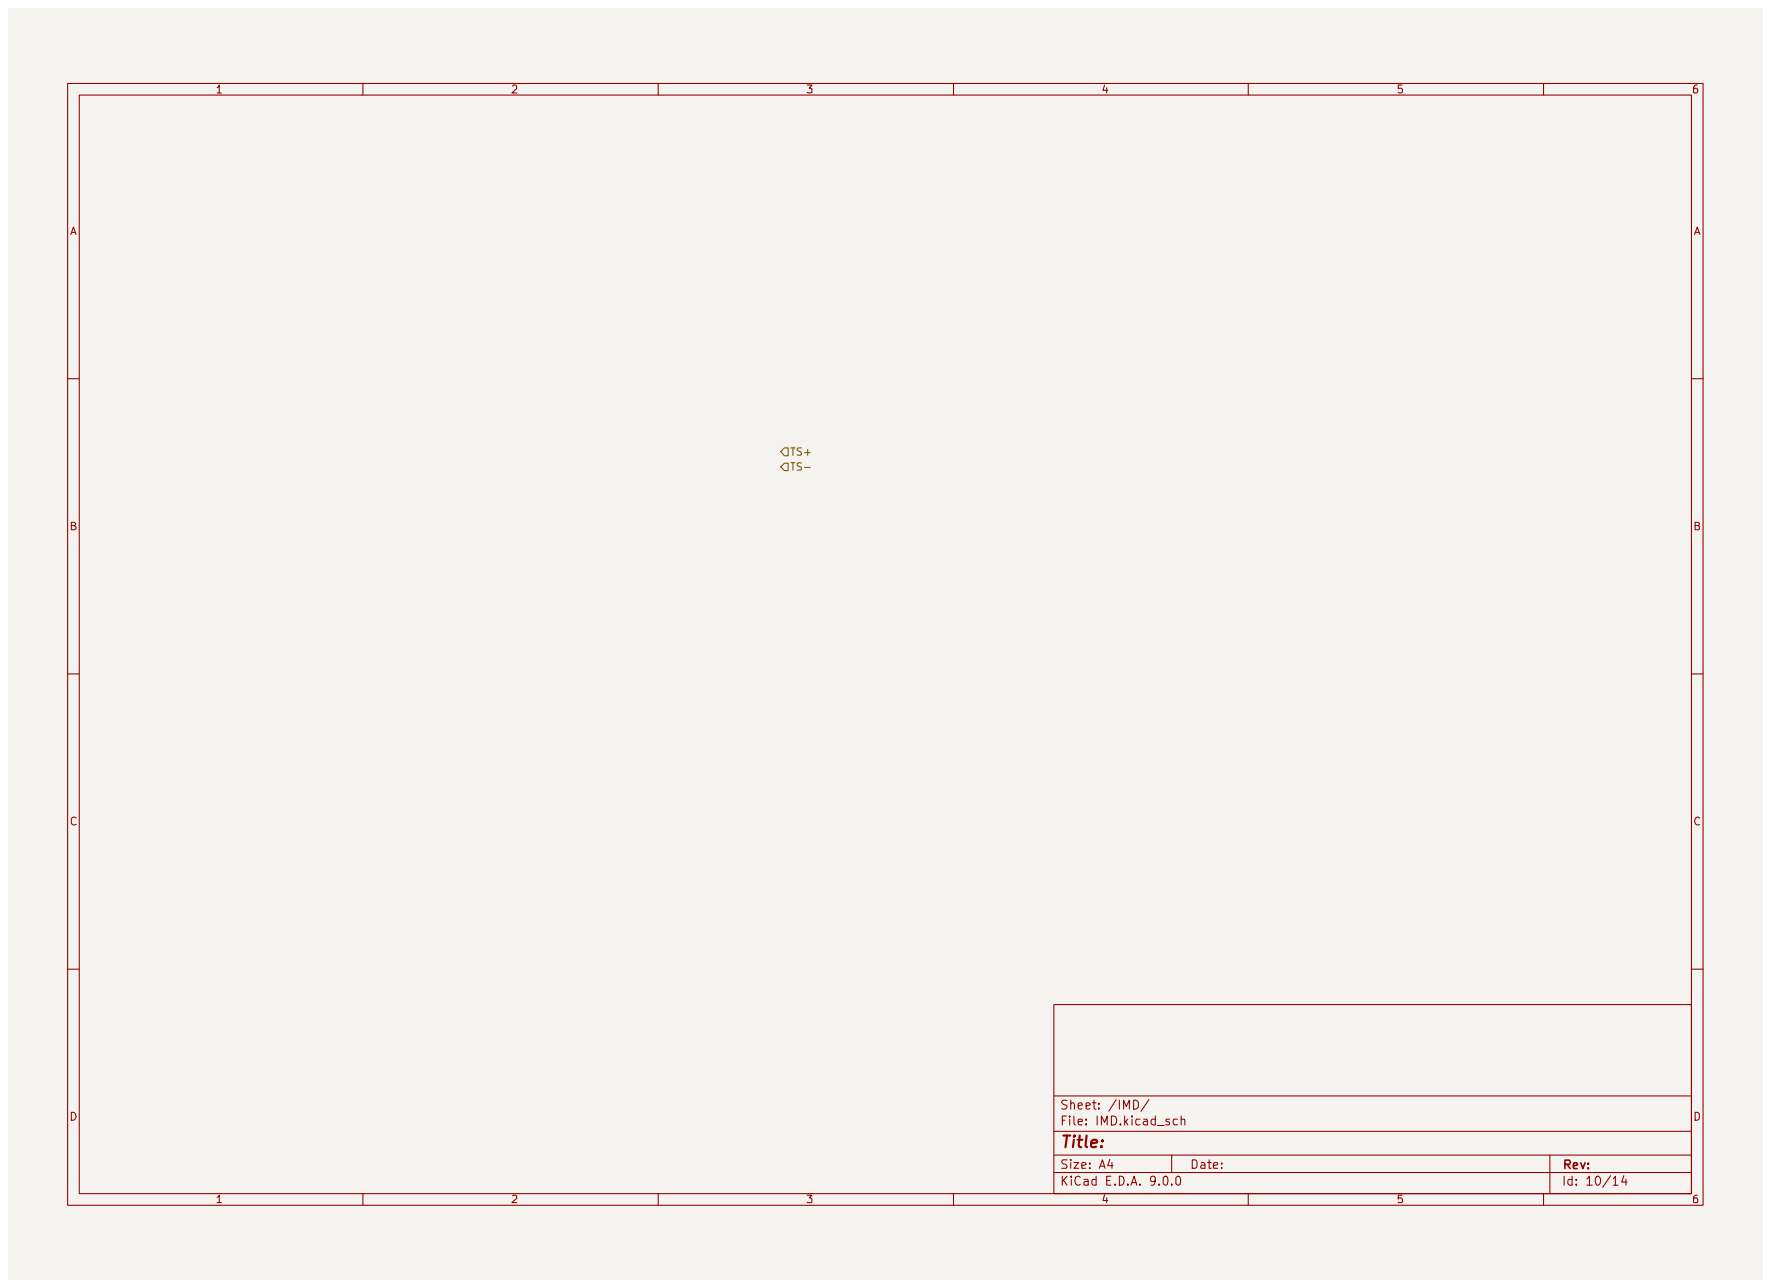
[picture p695: page 9]

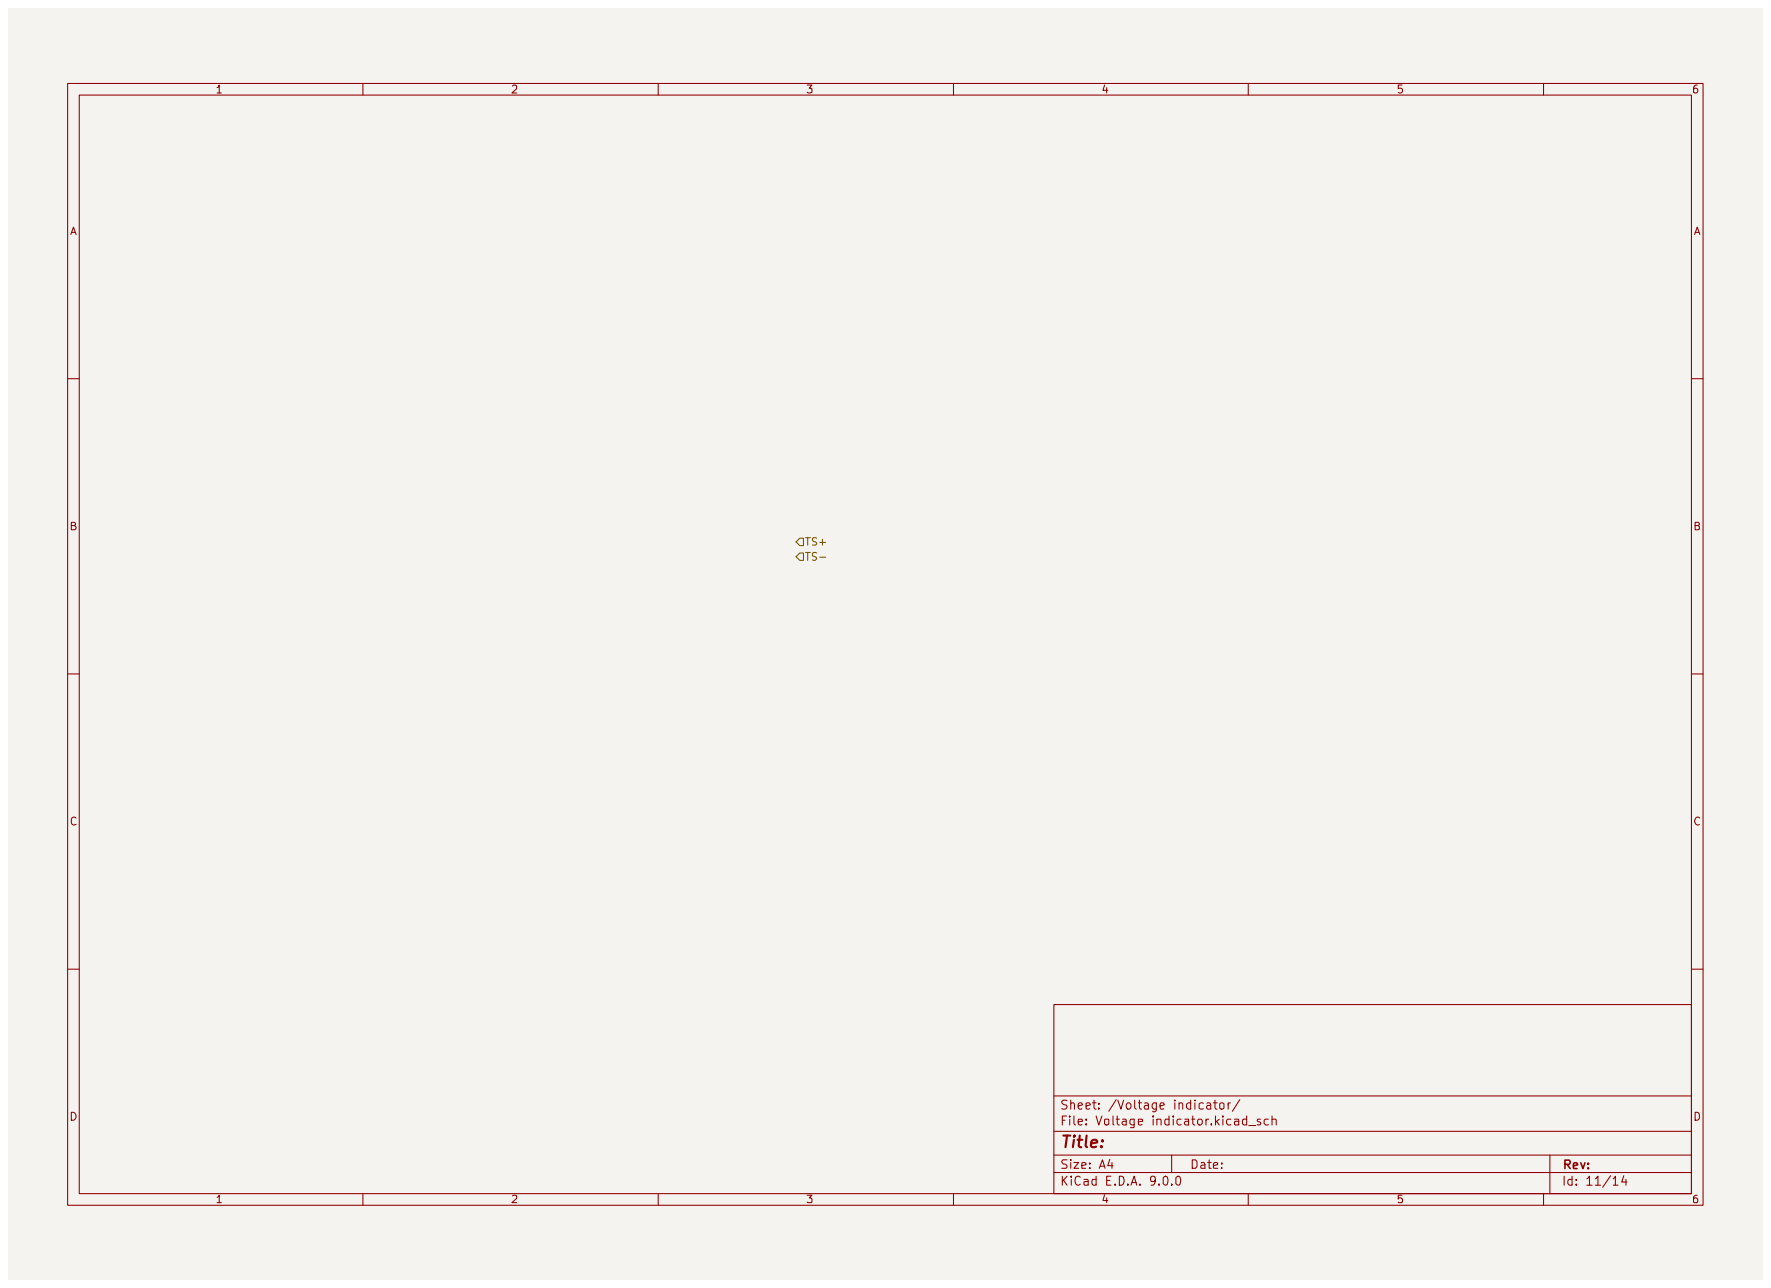
[picture p696: page 10]

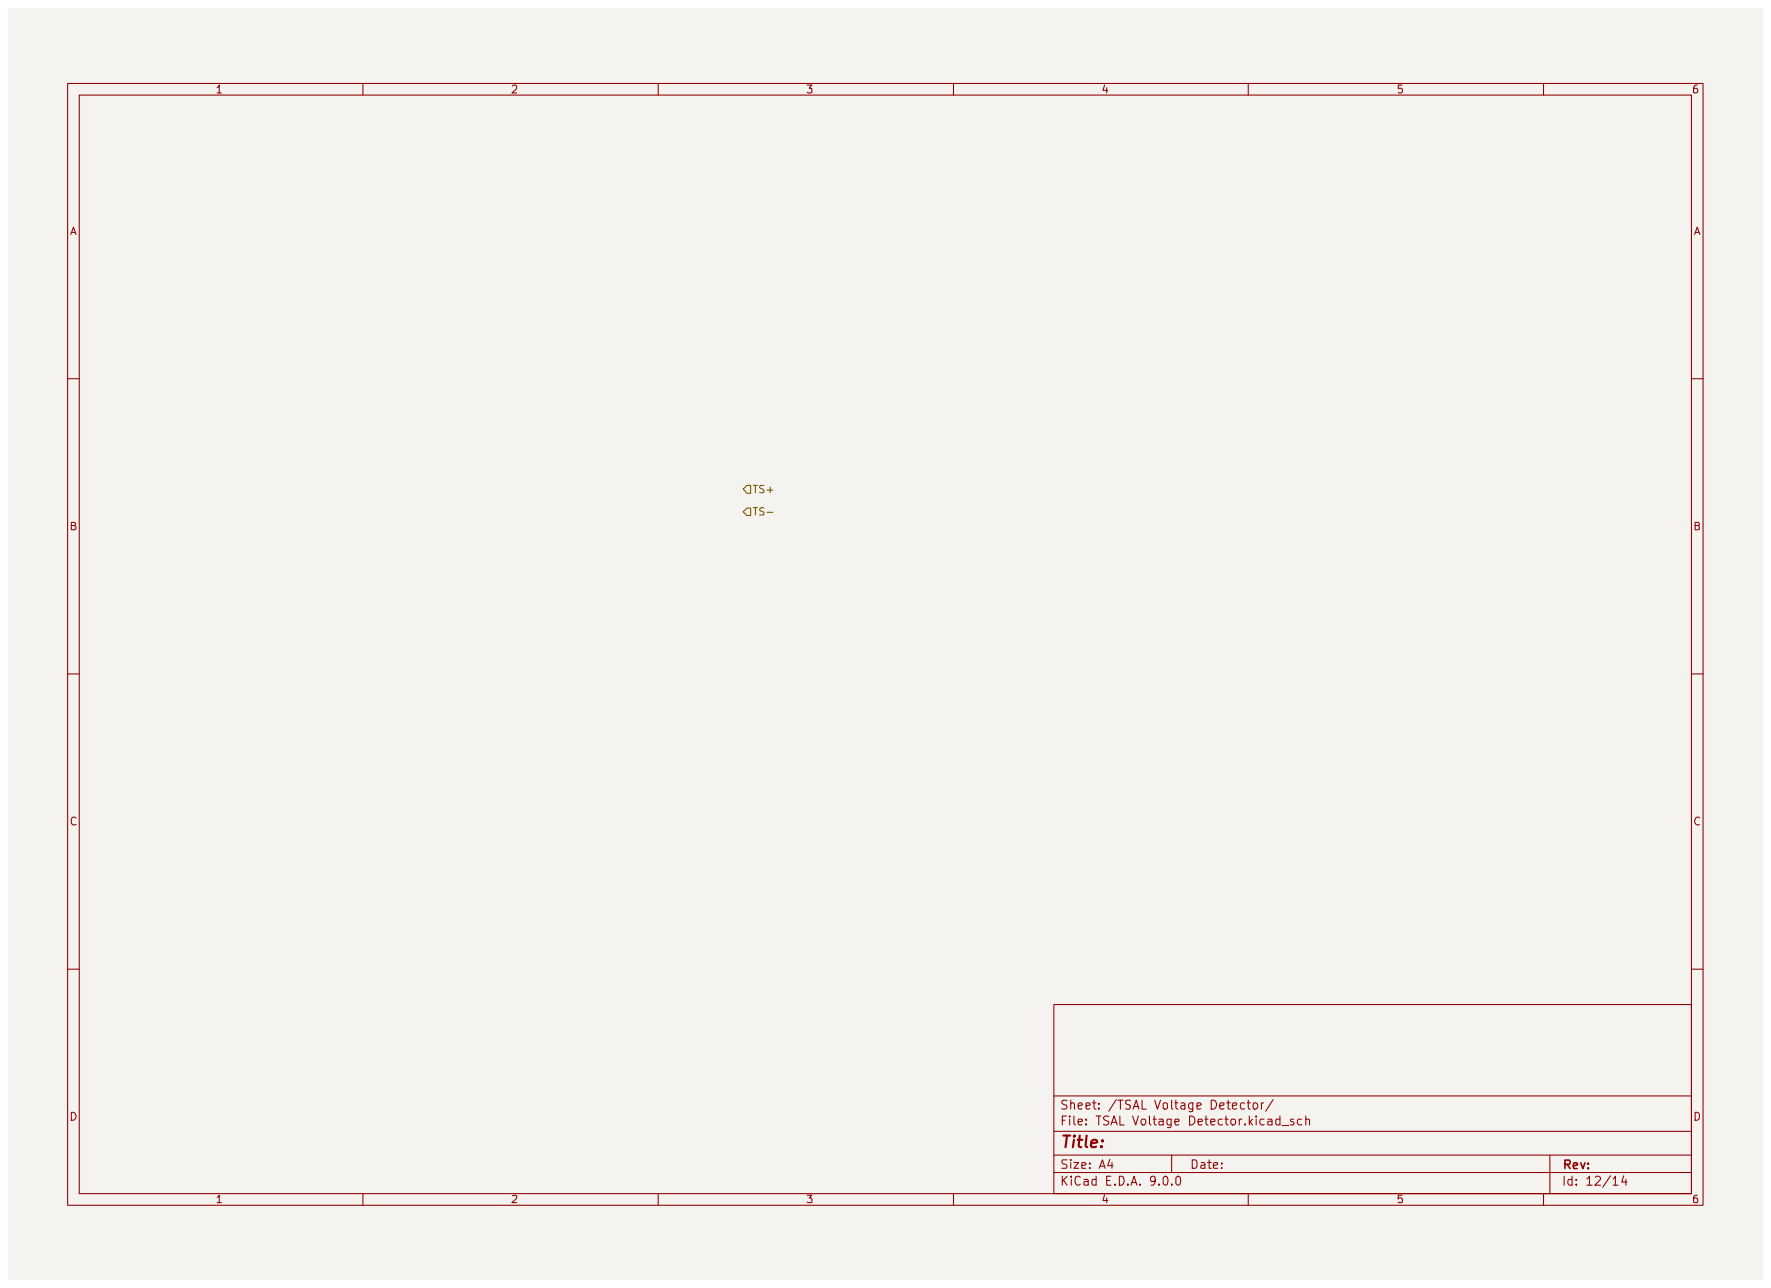
[picture p697: page 11]

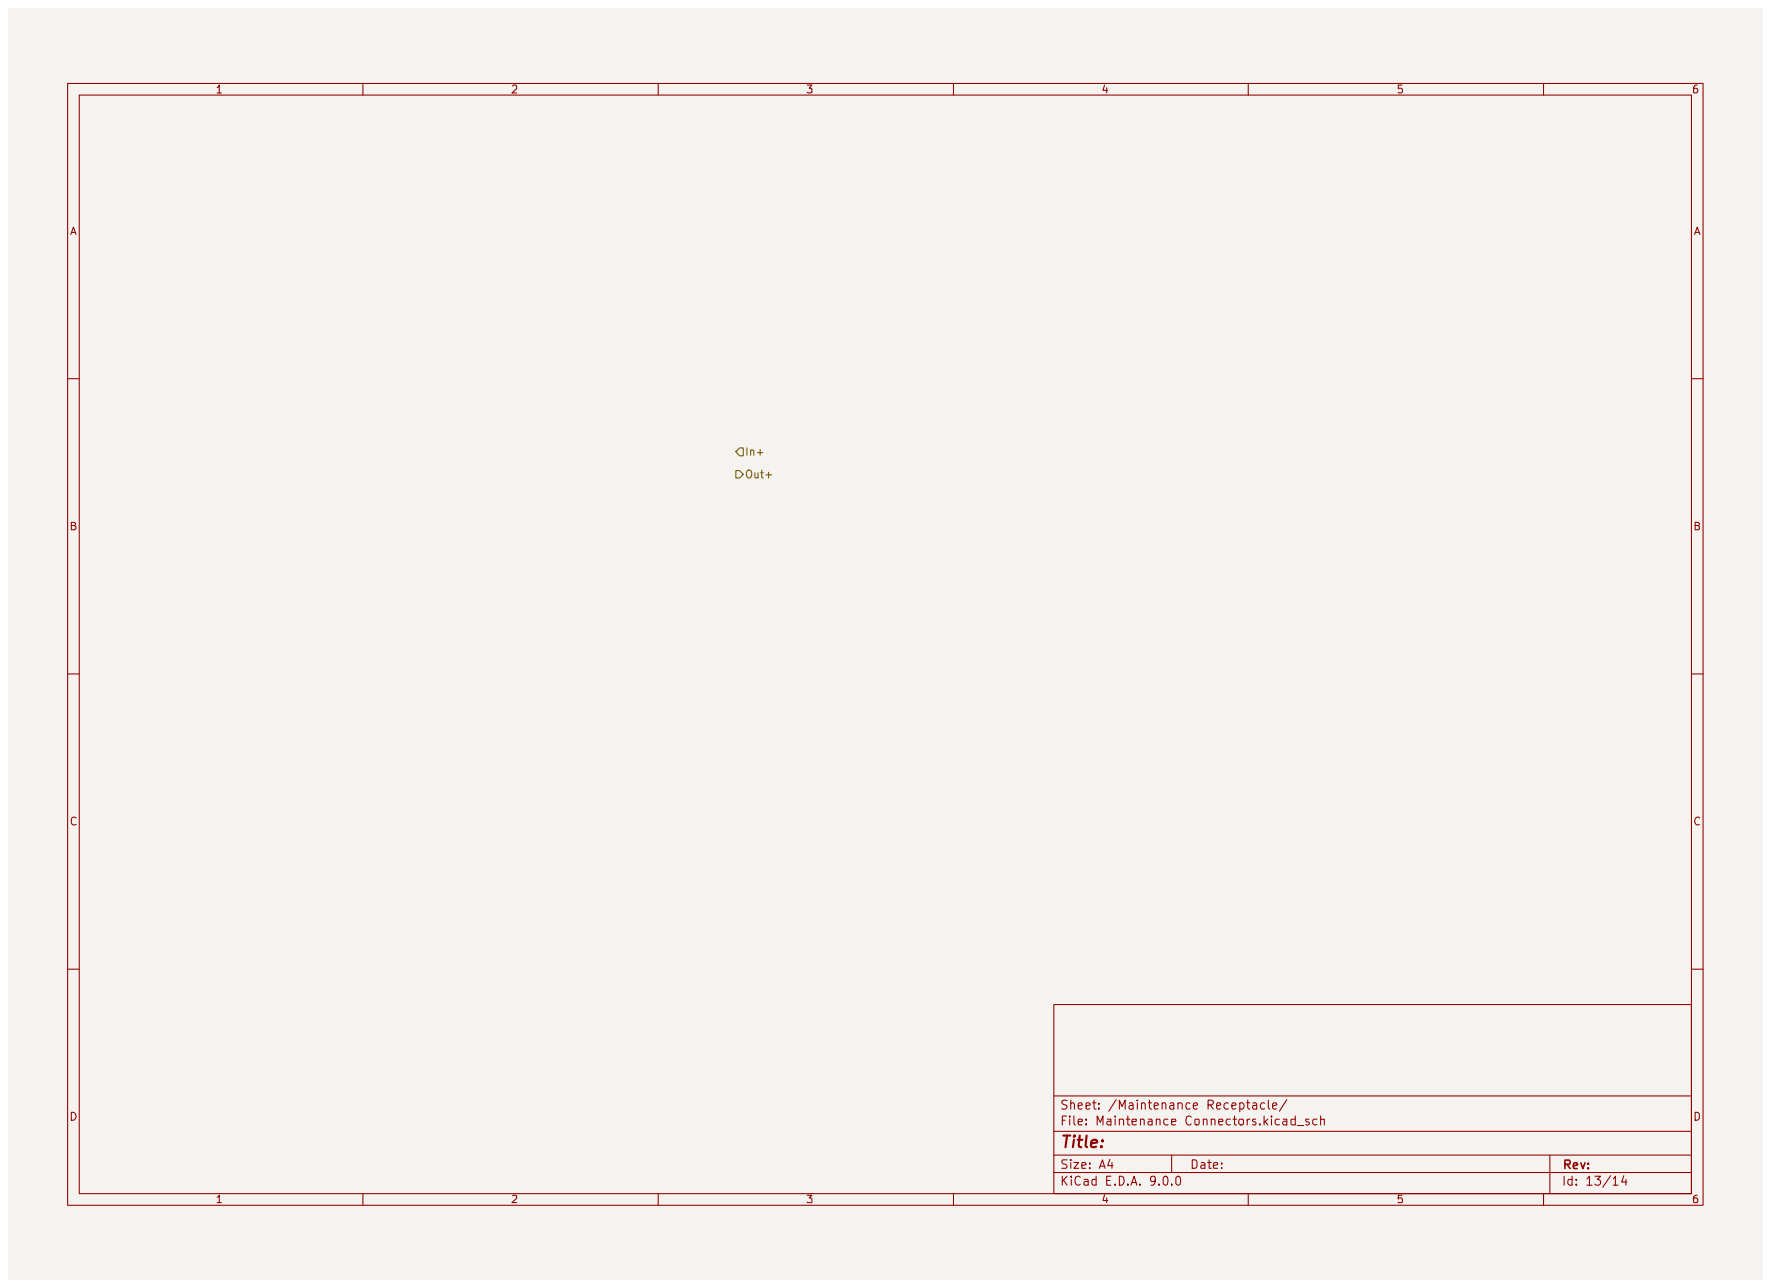
[picture p698: page 12]

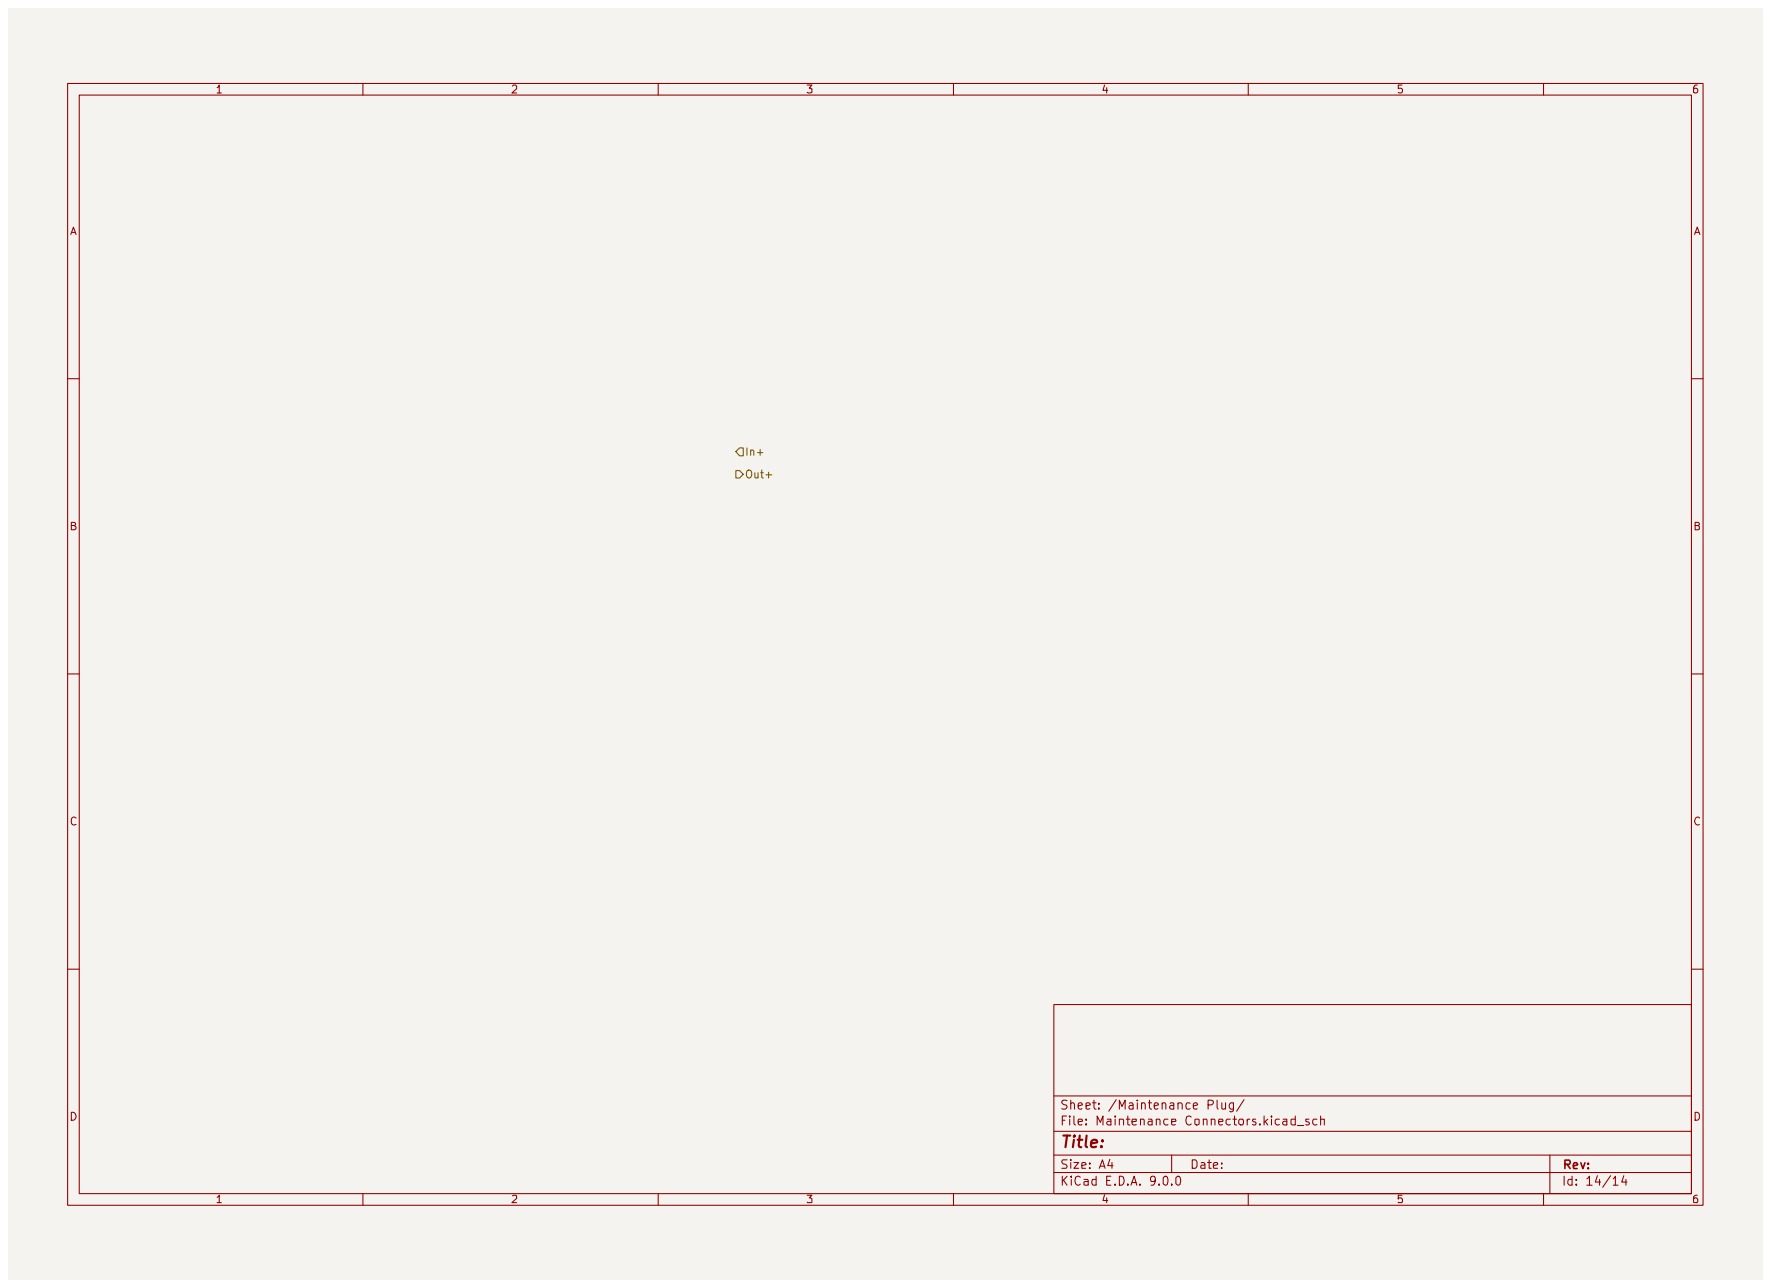
[picture p699: page 13]

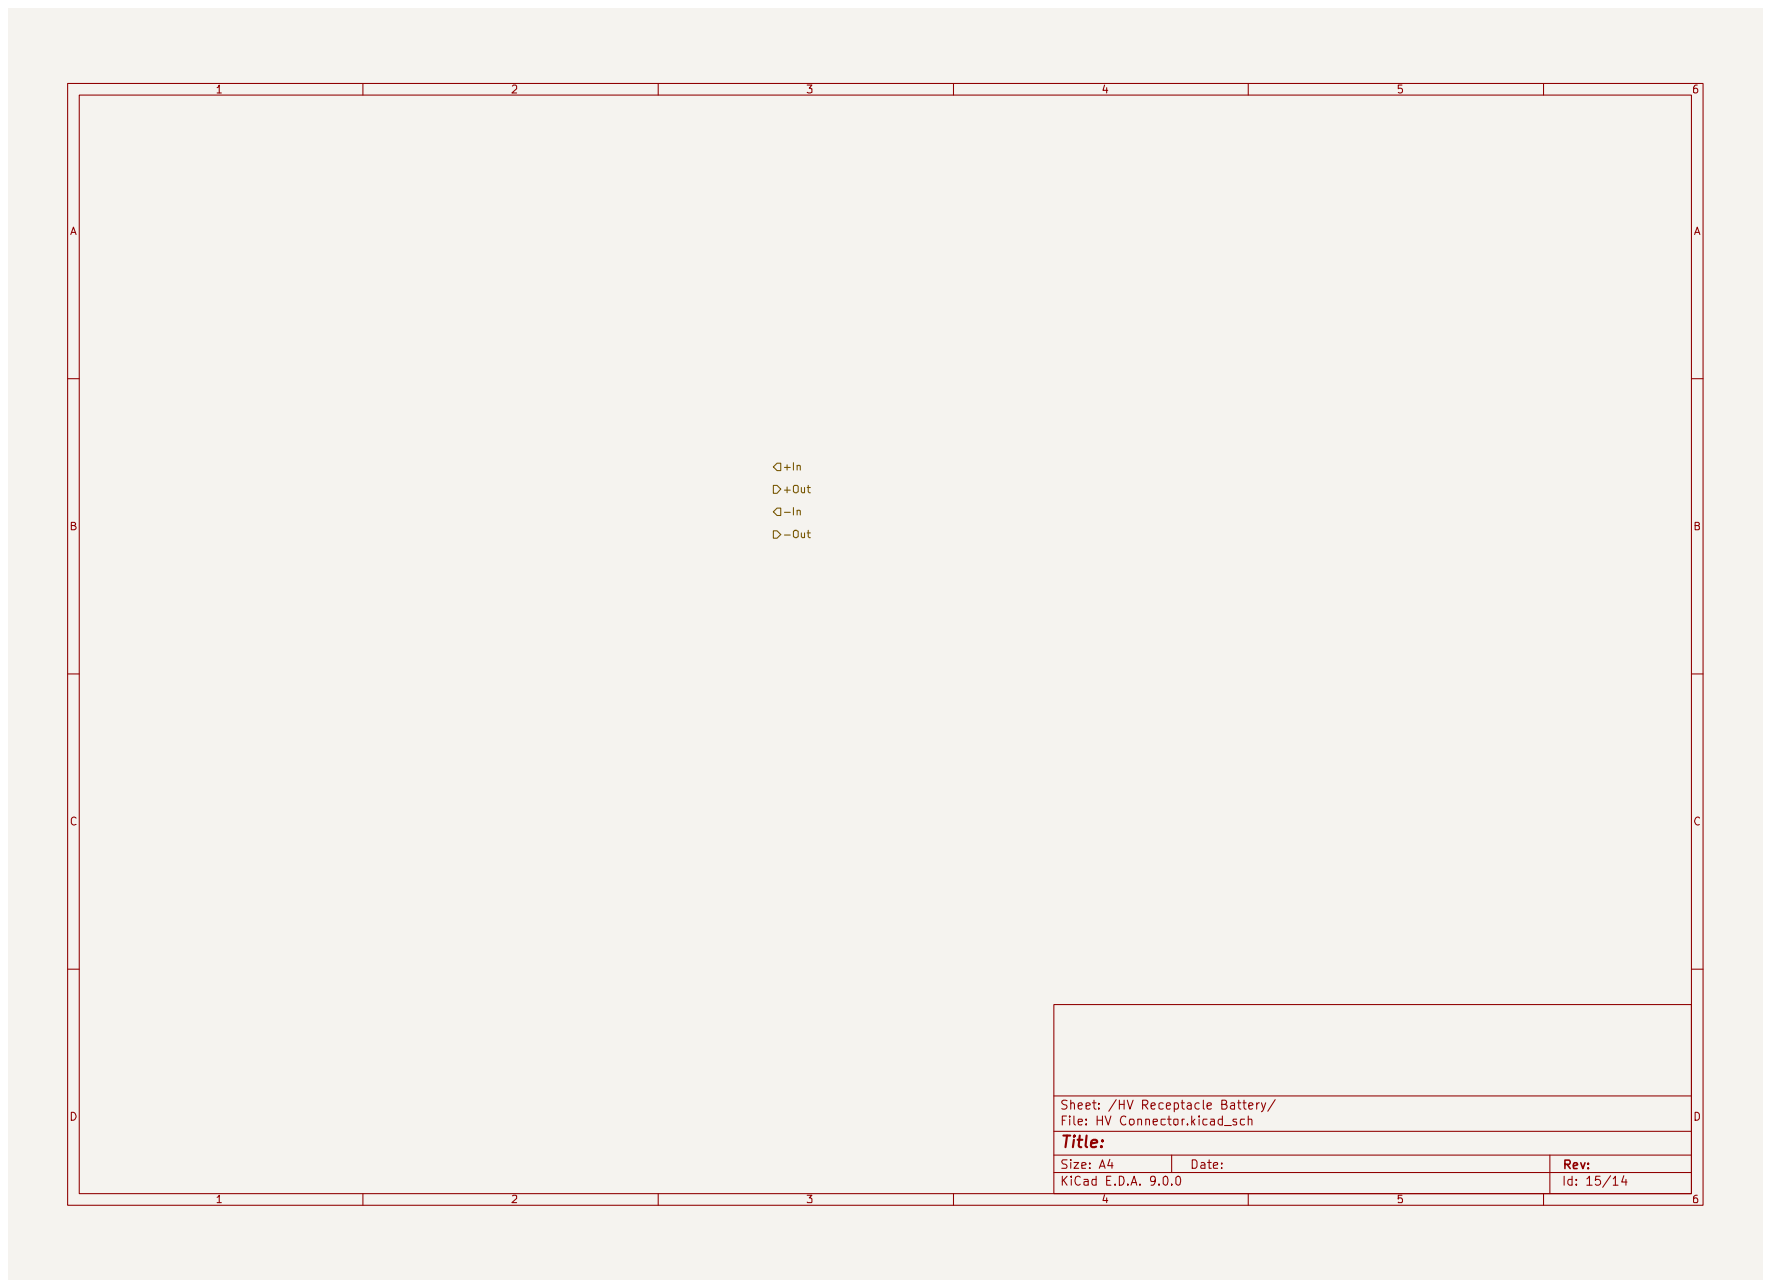
[picture p700: page 14]
