EOSCogniton/ELIZ-2022/02 - Documentation/RC_Rendus_Compet/Eté 2024/Design/Artemiz_drawings_v1.pdf

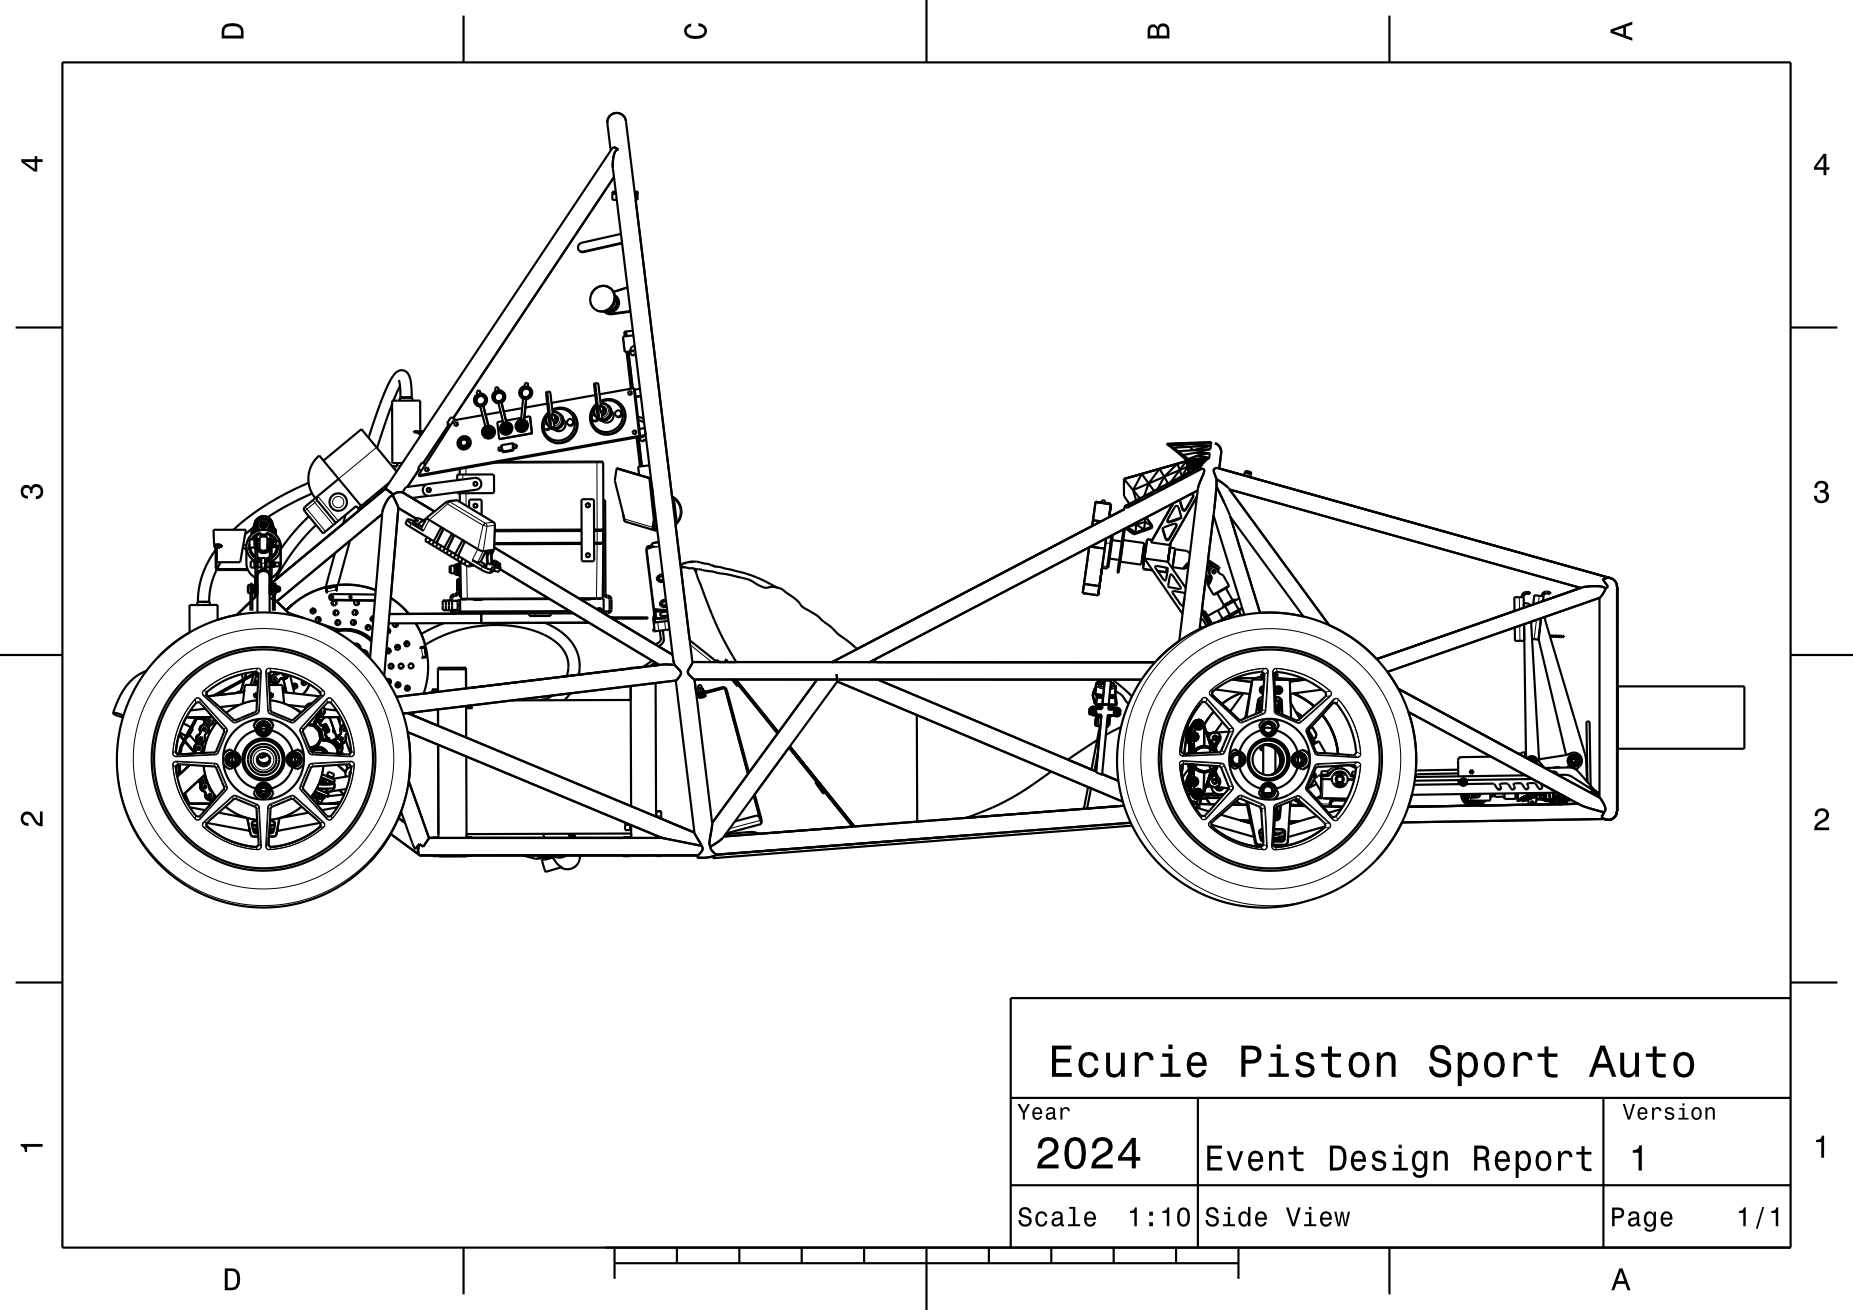
[picture p701: page 1]

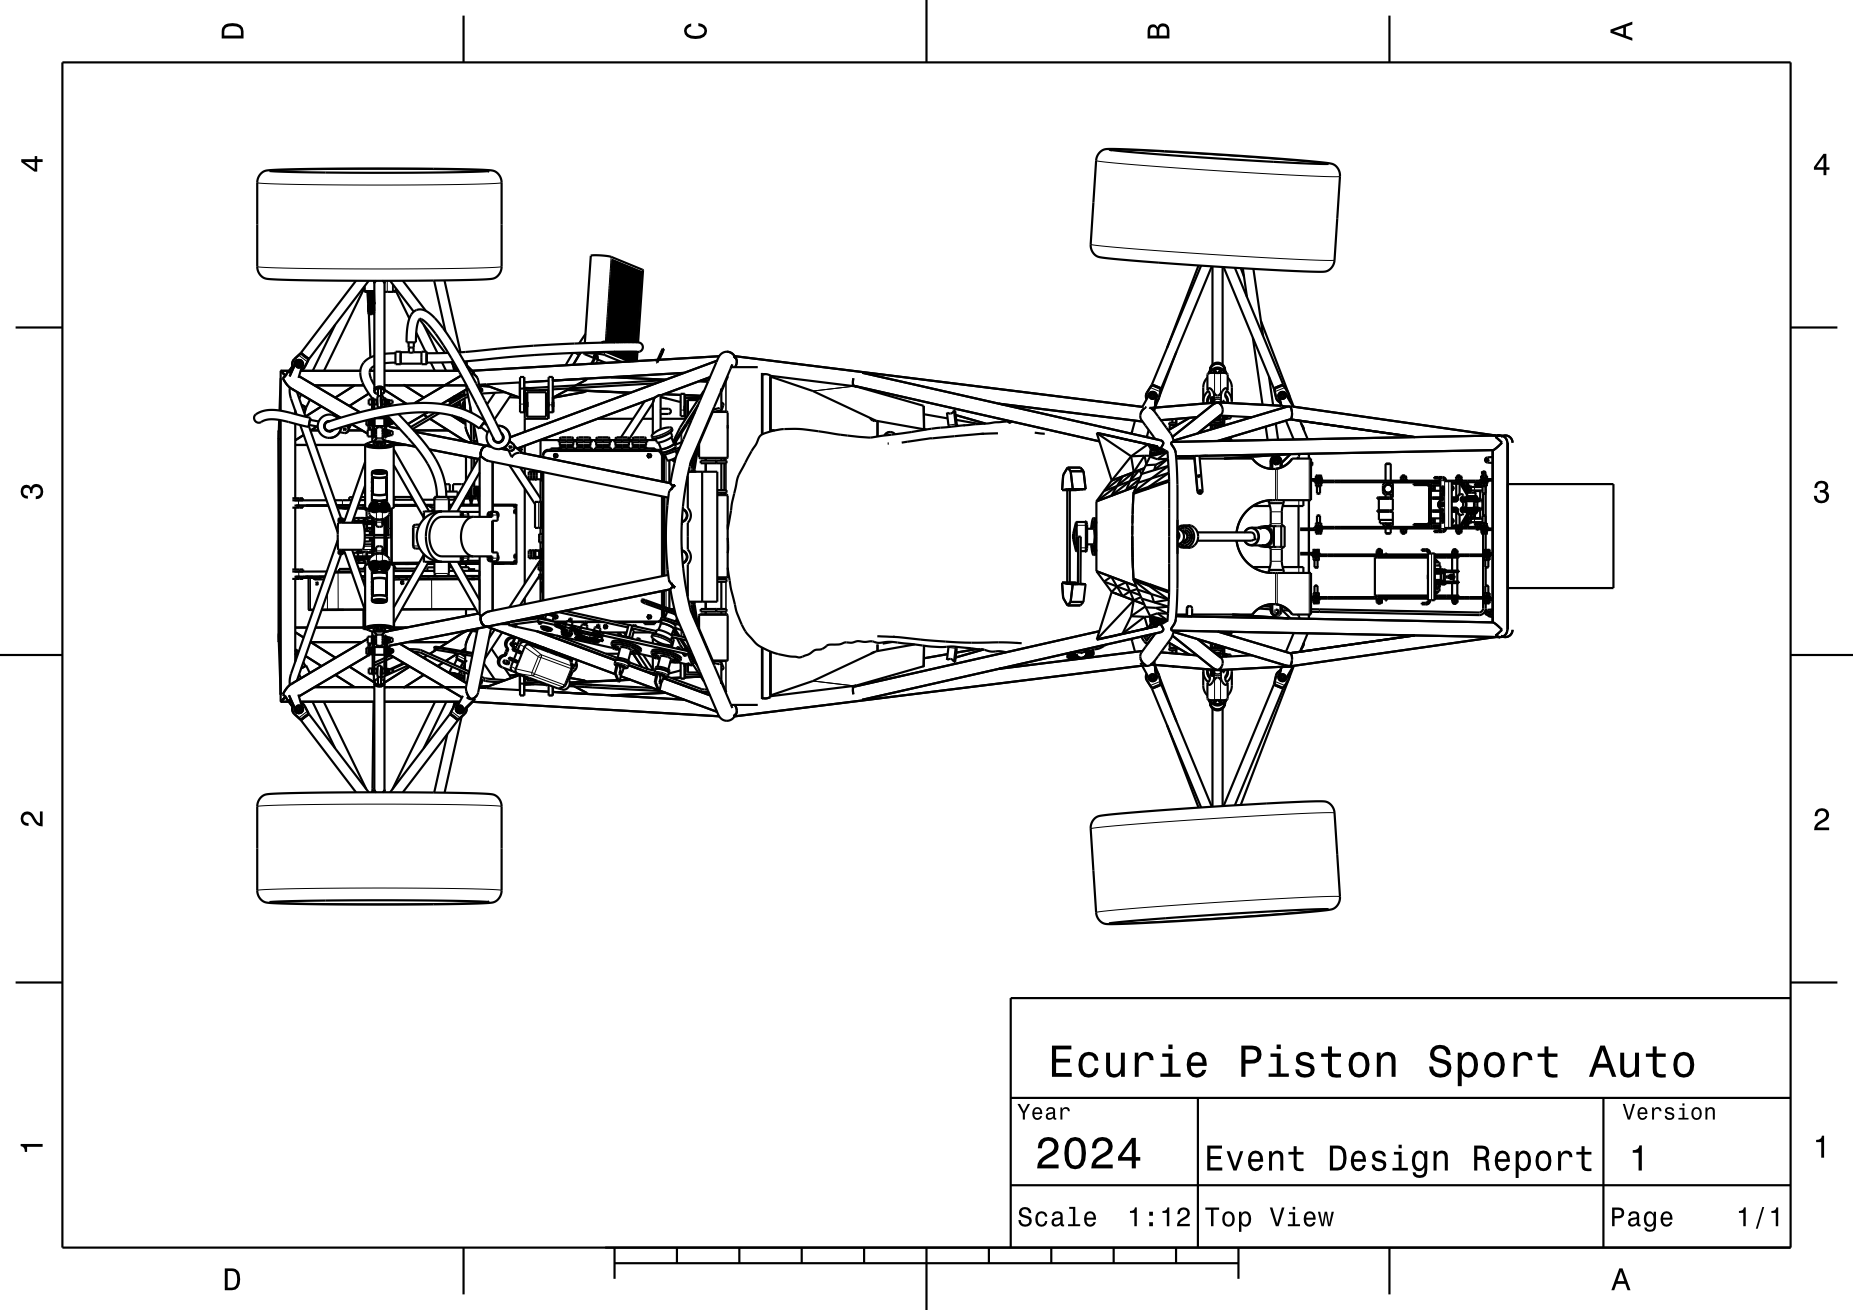
[picture p702: page 2]

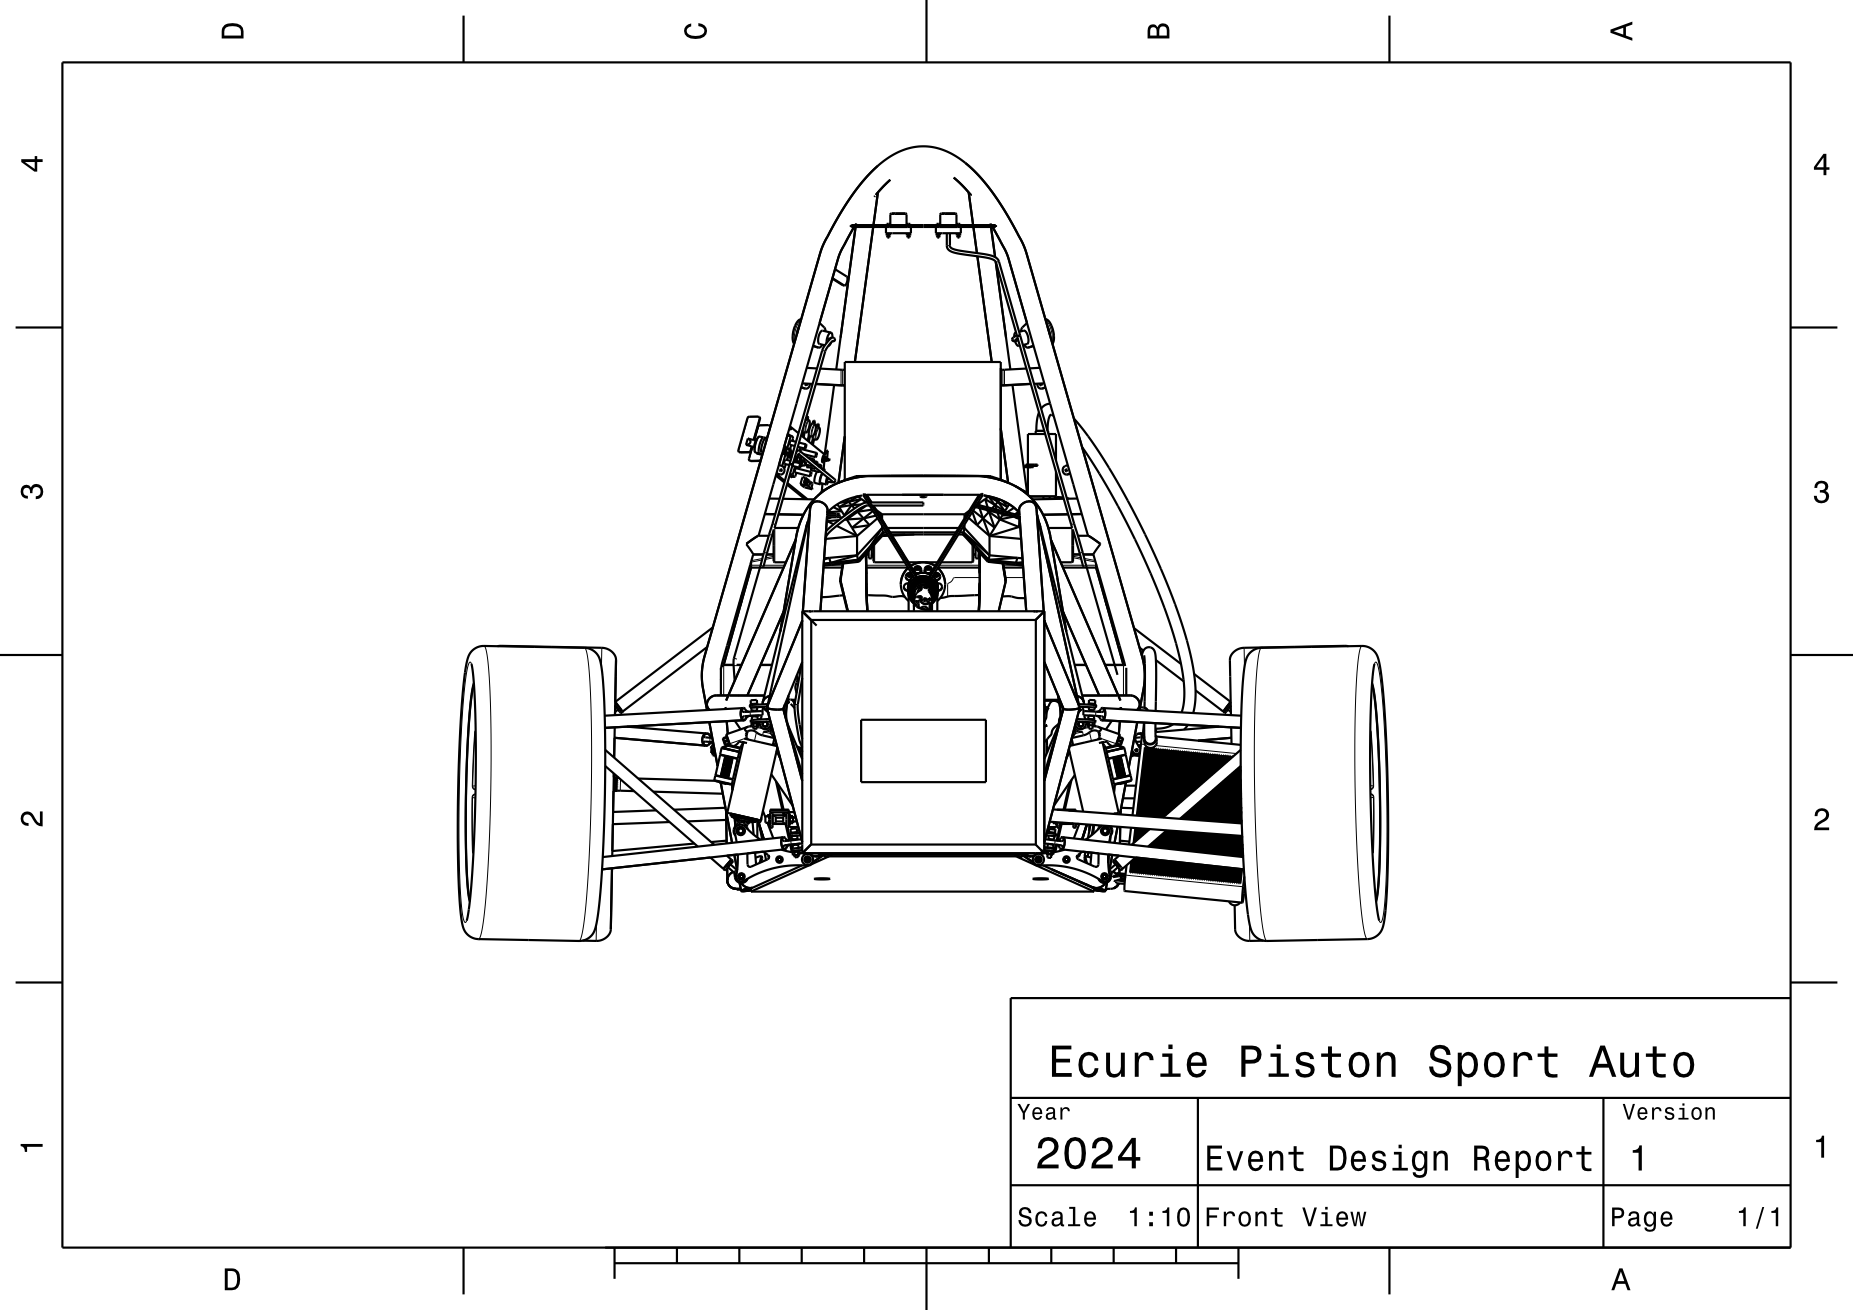
[picture p703: page 3]
