EOSCogniton/ELIZ-2022/02 - Documentation/RC_Rendus_Compet/Eté 2024/Design/Vue 3D.pdf

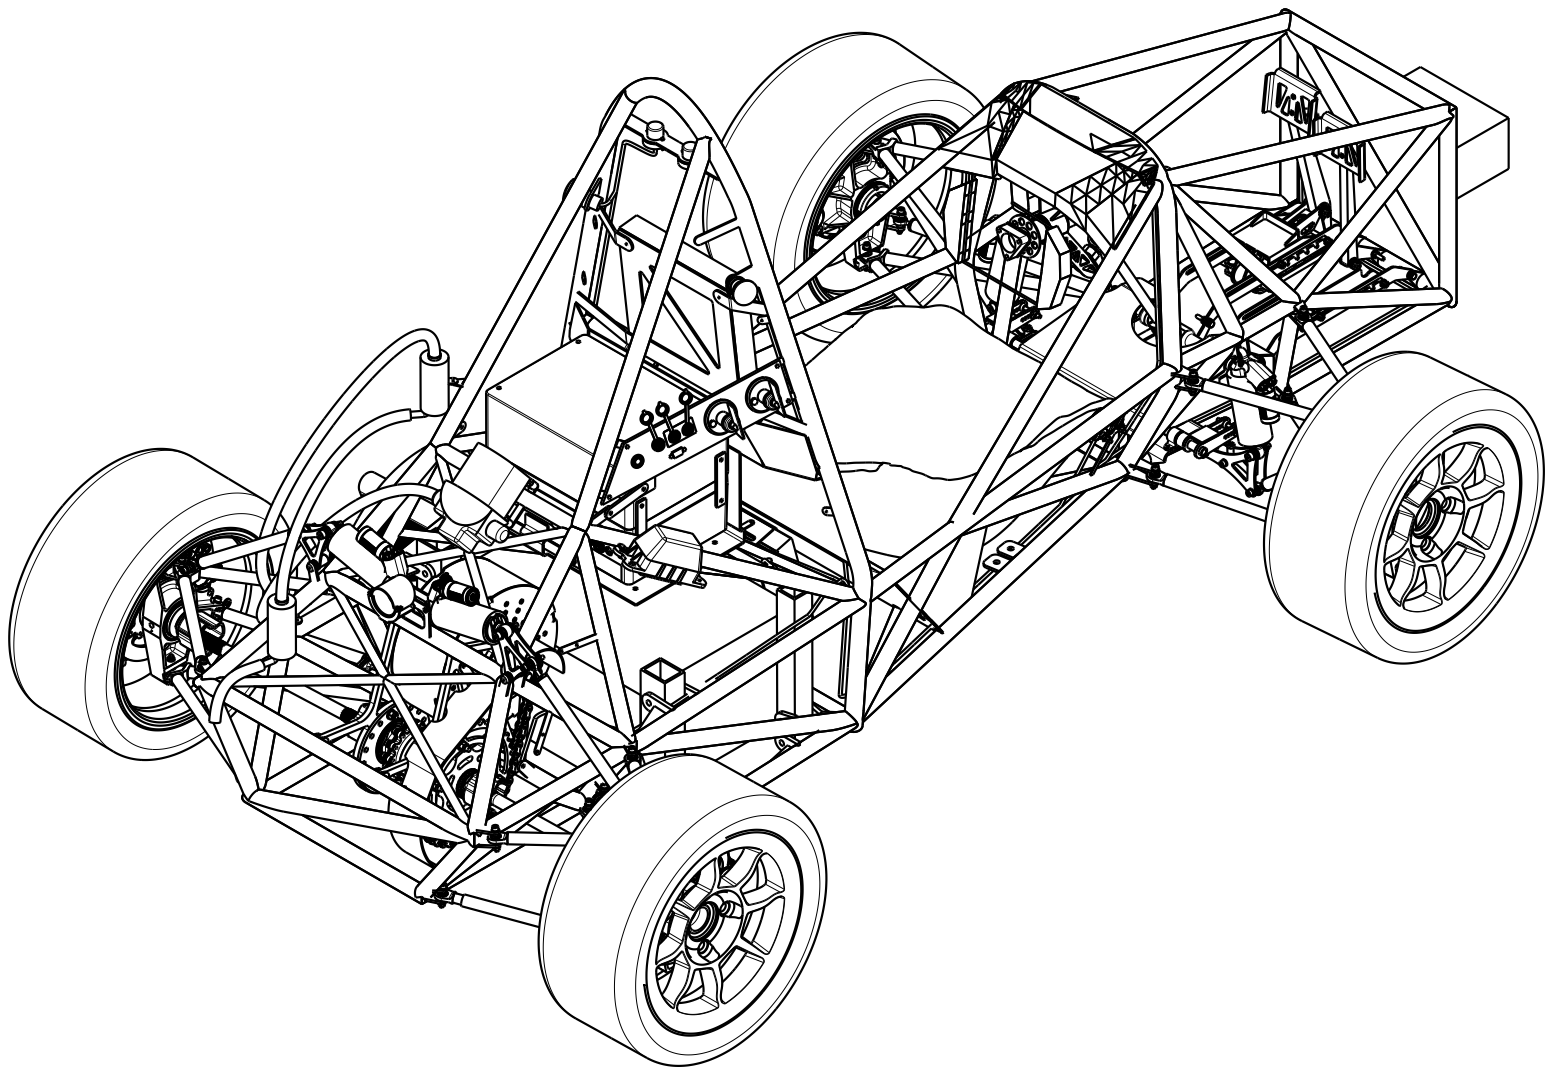
[picture p704: page 1]
