EOSCogniton/ELIZ-2022/01 - Maquette CATIA/MS_Miscellanous_Finish_Assembly/MEP Gabarits/MS_A0100 (Seat & Driver)/MS_GA01002.pdf

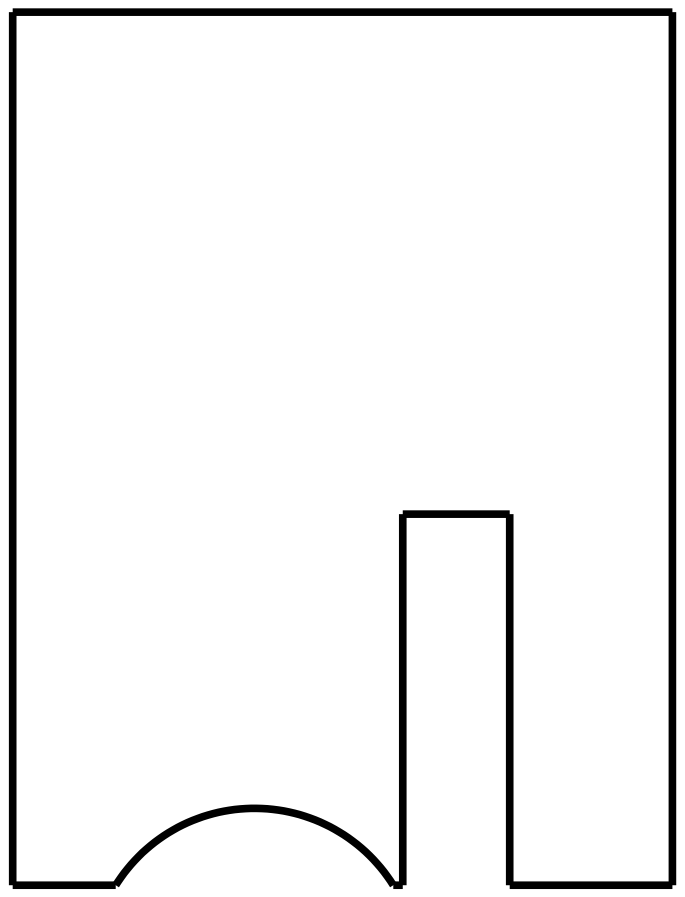
[picture p705: page 1]
