EOSCogniton/ELIZ-2022/01 - Maquette CATIA/EN_Engine_Drivetrain/EN_A0100 (Engine)/02_documents/coupe_assemblage_moteur_transmission.pdf

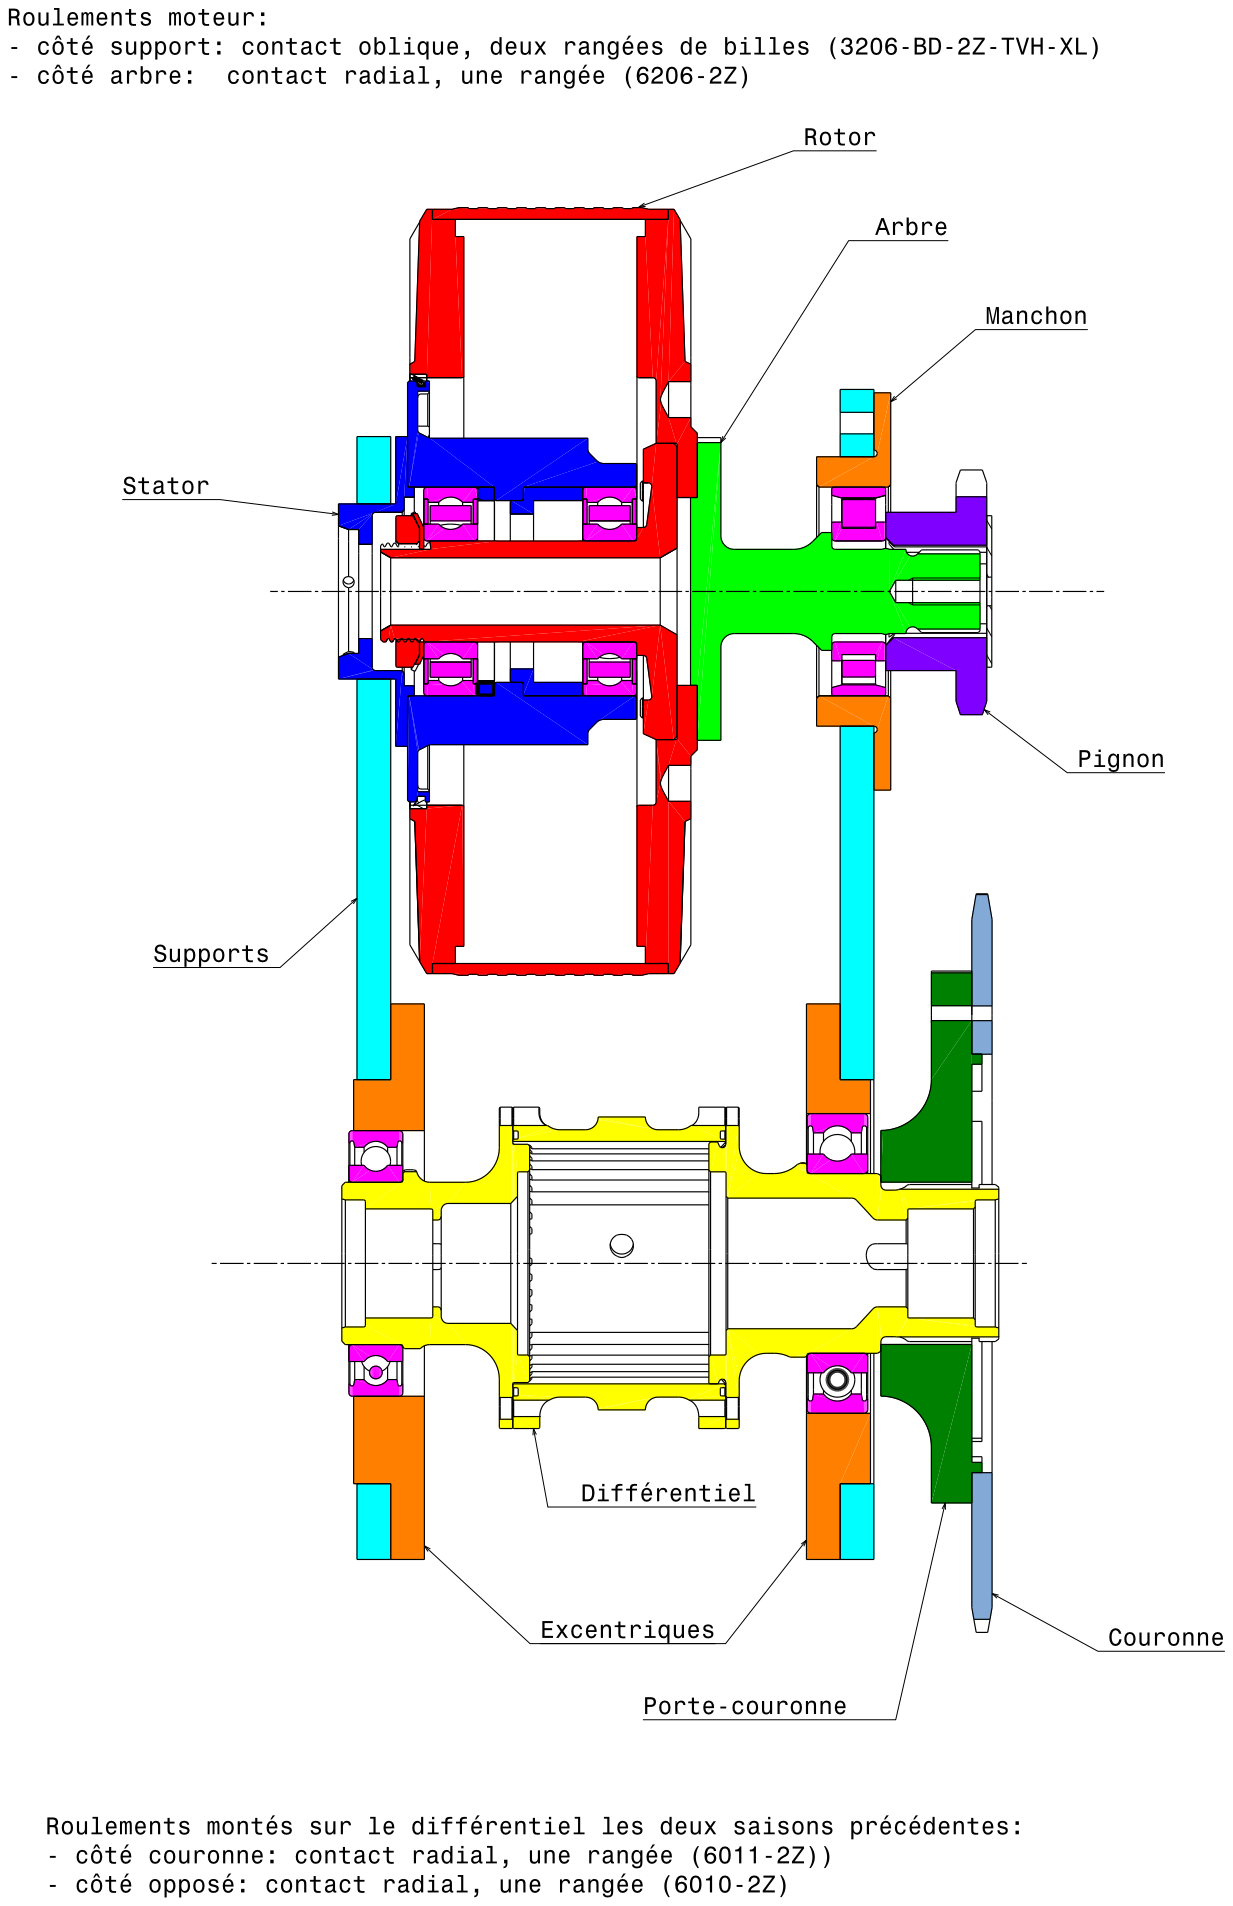
[picture p706: page 1]
