EOSCogniton/ELIZ-2022/01 - Maquette CATIA/AA - Mise en plan/FR_Frame_Body/Mechanical stops/FR_03008 (neg).pdf

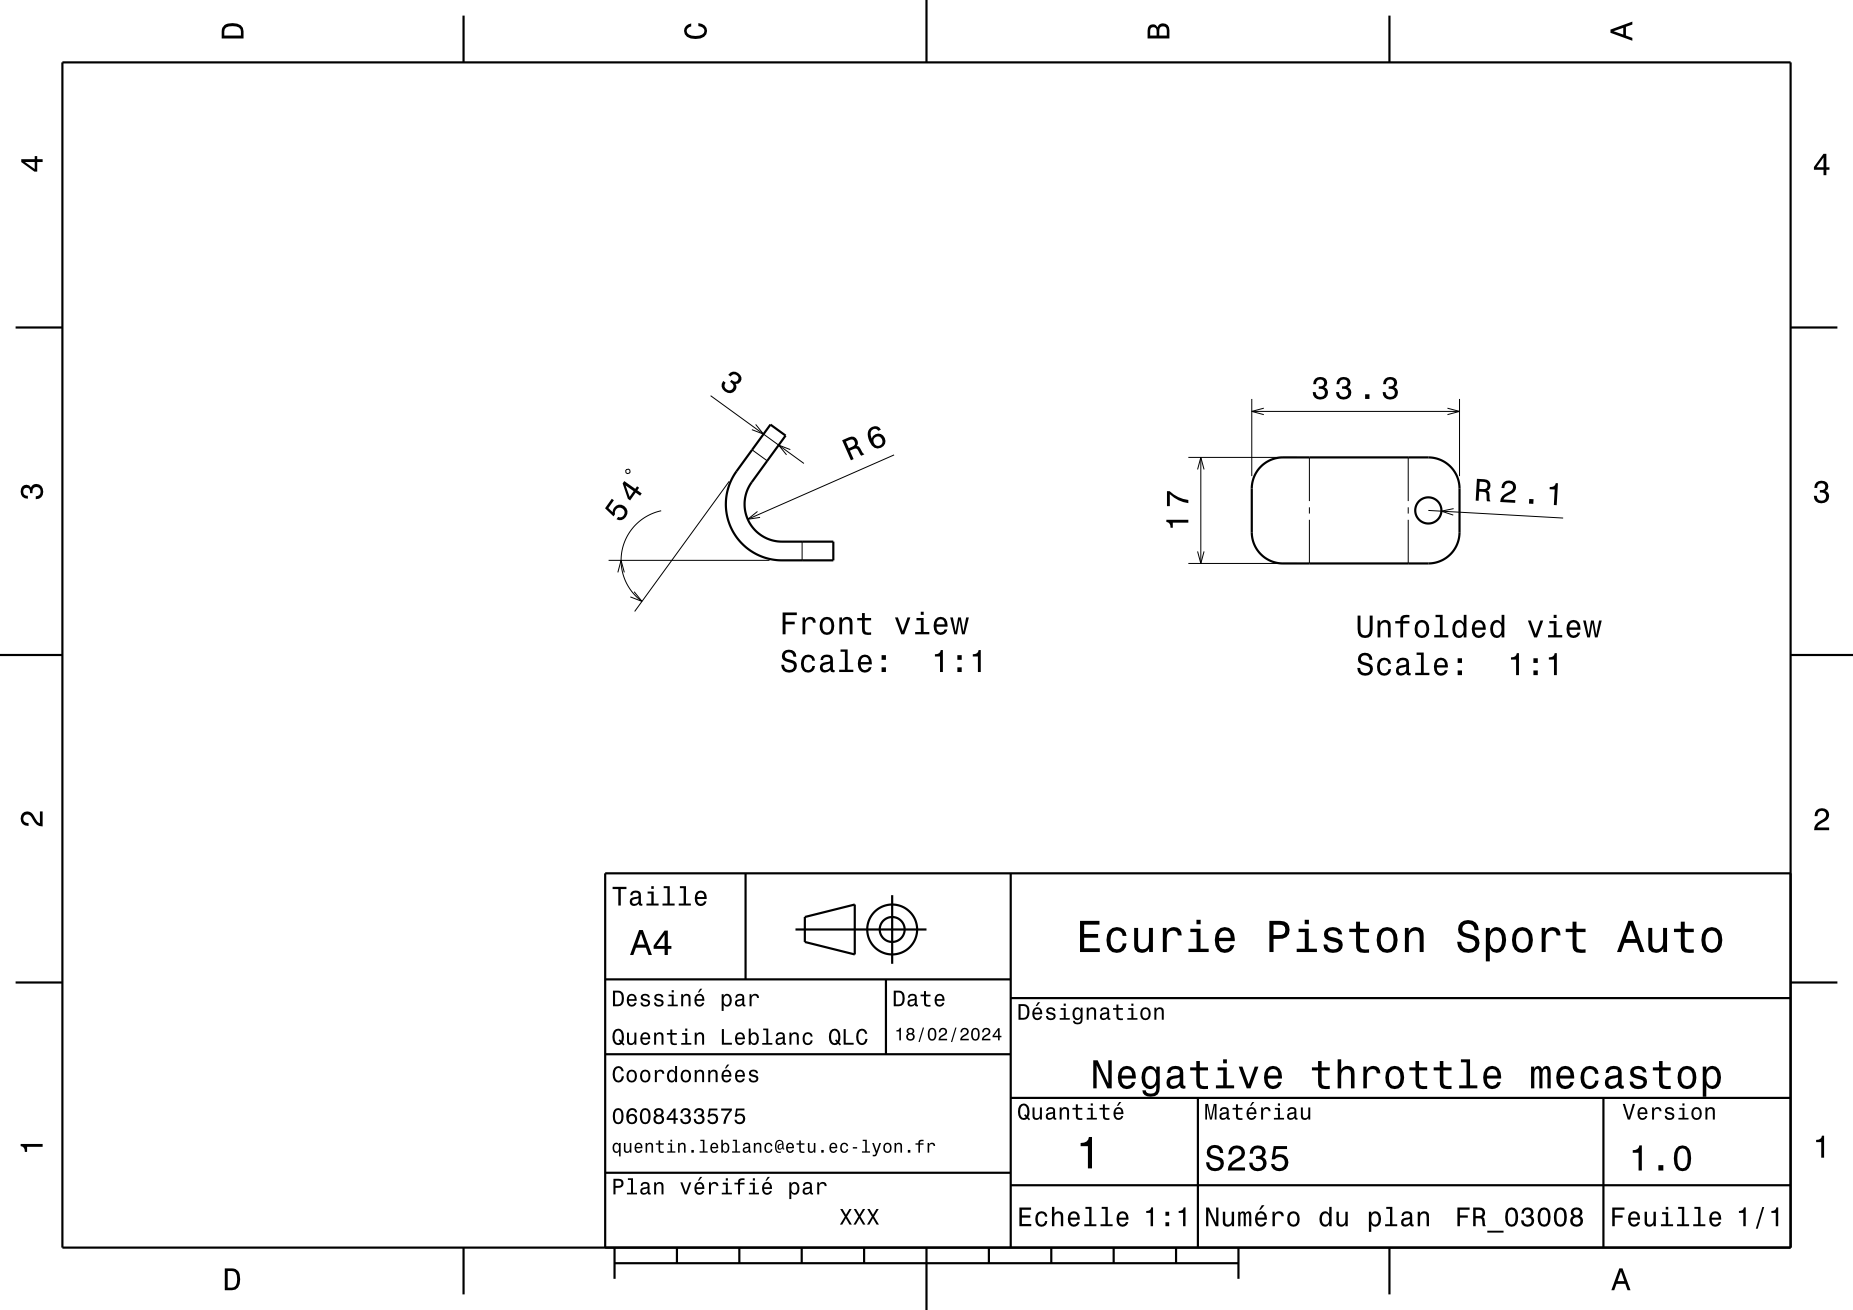
[picture p707: page 1]
