EOSCogniton/ELIZ-2022/01 - Maquette CATIA/AA - Mise en plan/FR_Frame_Body/Mechanical stops/FR_03009 (pos).pdf

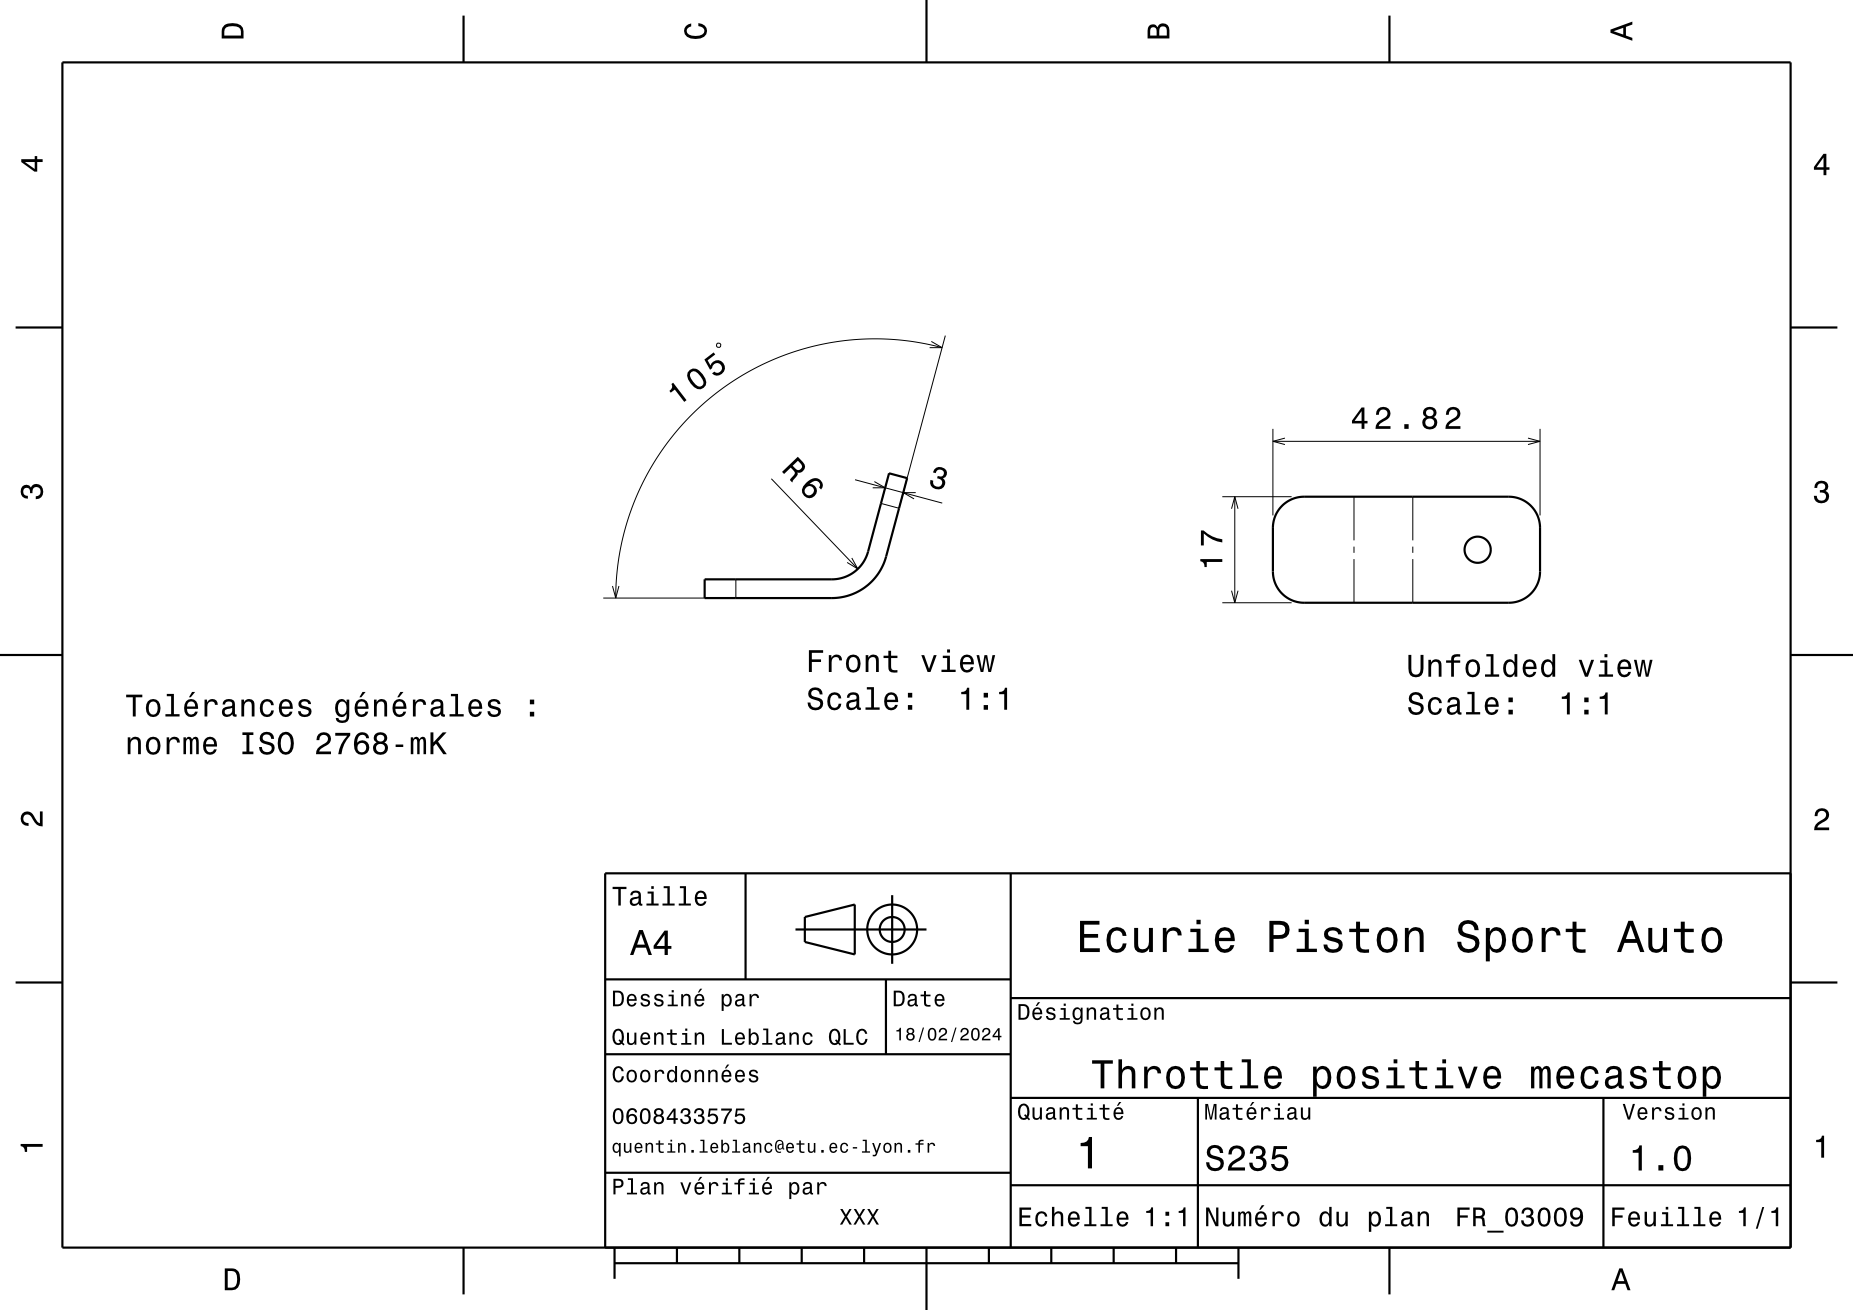
[picture p708: page 1]
