EOSCogniton/ELIZ-2022/01 - Maquette CATIA/MS_Miscellanous_Finish_Assembly/MEP Gabarits/MS_A0300 (Harness)/Submarine/MS_030041.pdf

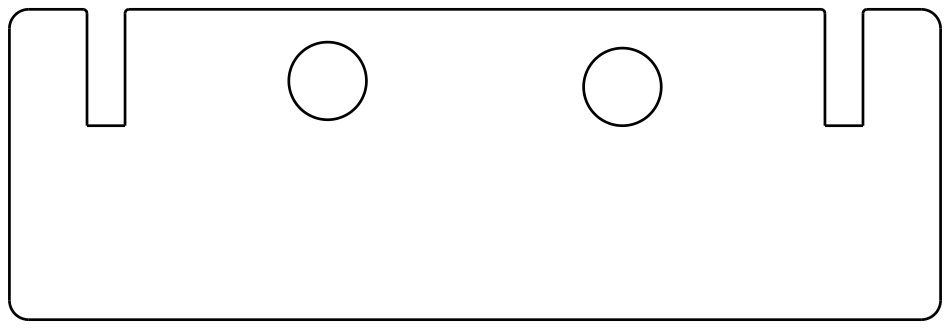
[picture p709: page 1]
