EOSCogniton/ELIZ-2022/01 - Maquette CATIA/MS_Miscellanous_Finish_Assembly/MEP Gabarits/MS_A0300 (Harness)/Submarine/MS_030042.pdf

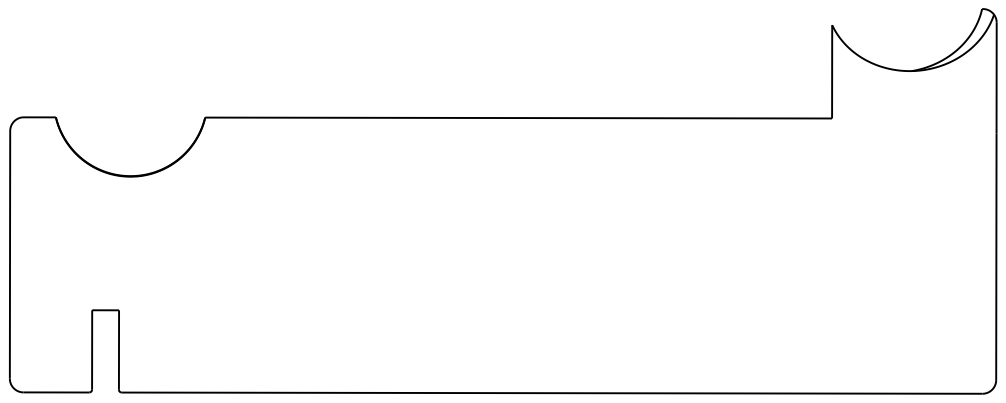
[picture p710: page 1]
