EOSCogniton/ELIZ-2022/01 - Maquette CATIA/MS_Miscellanous_Finish_Assembly/MEP Gabarits/MS_A0300 (Harness)/Blocage sangles harnais/MS_G030061.pdf

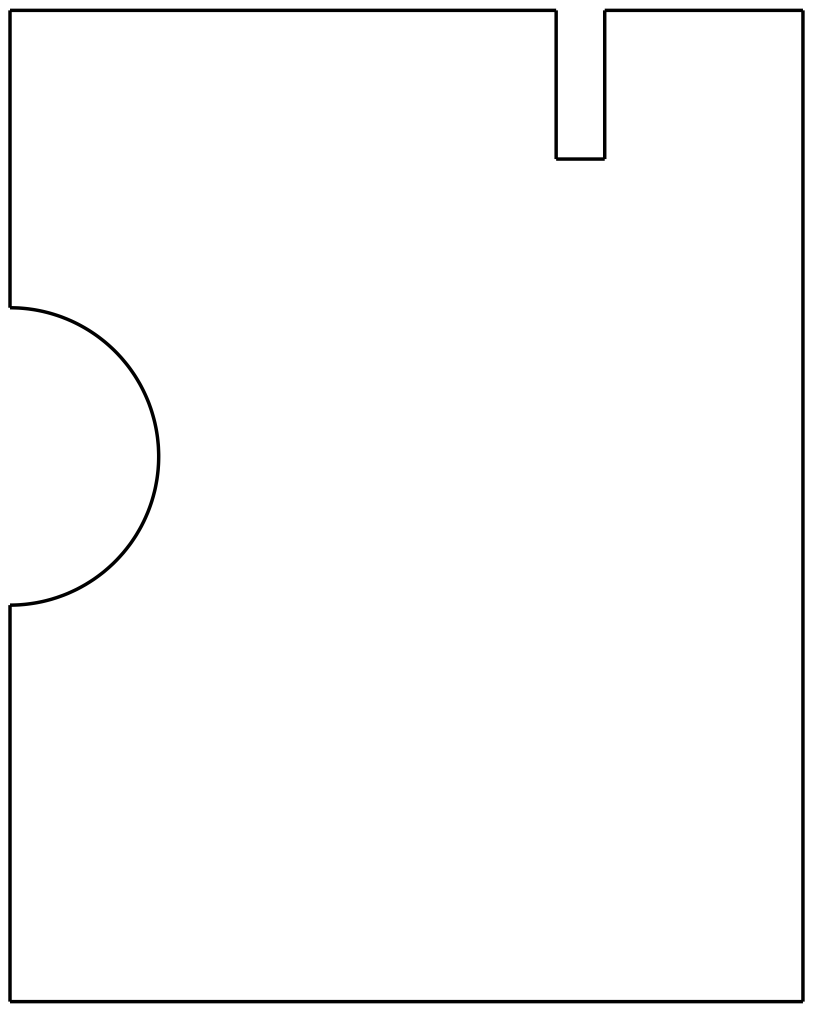
[picture p712: page 1]
