EOSCogniton/ELIZ-2022/02 - Documentation/RC_Rendus_Compet/Eté 2024/IAD/Schematics/Positionning IAD Rendering.pdf

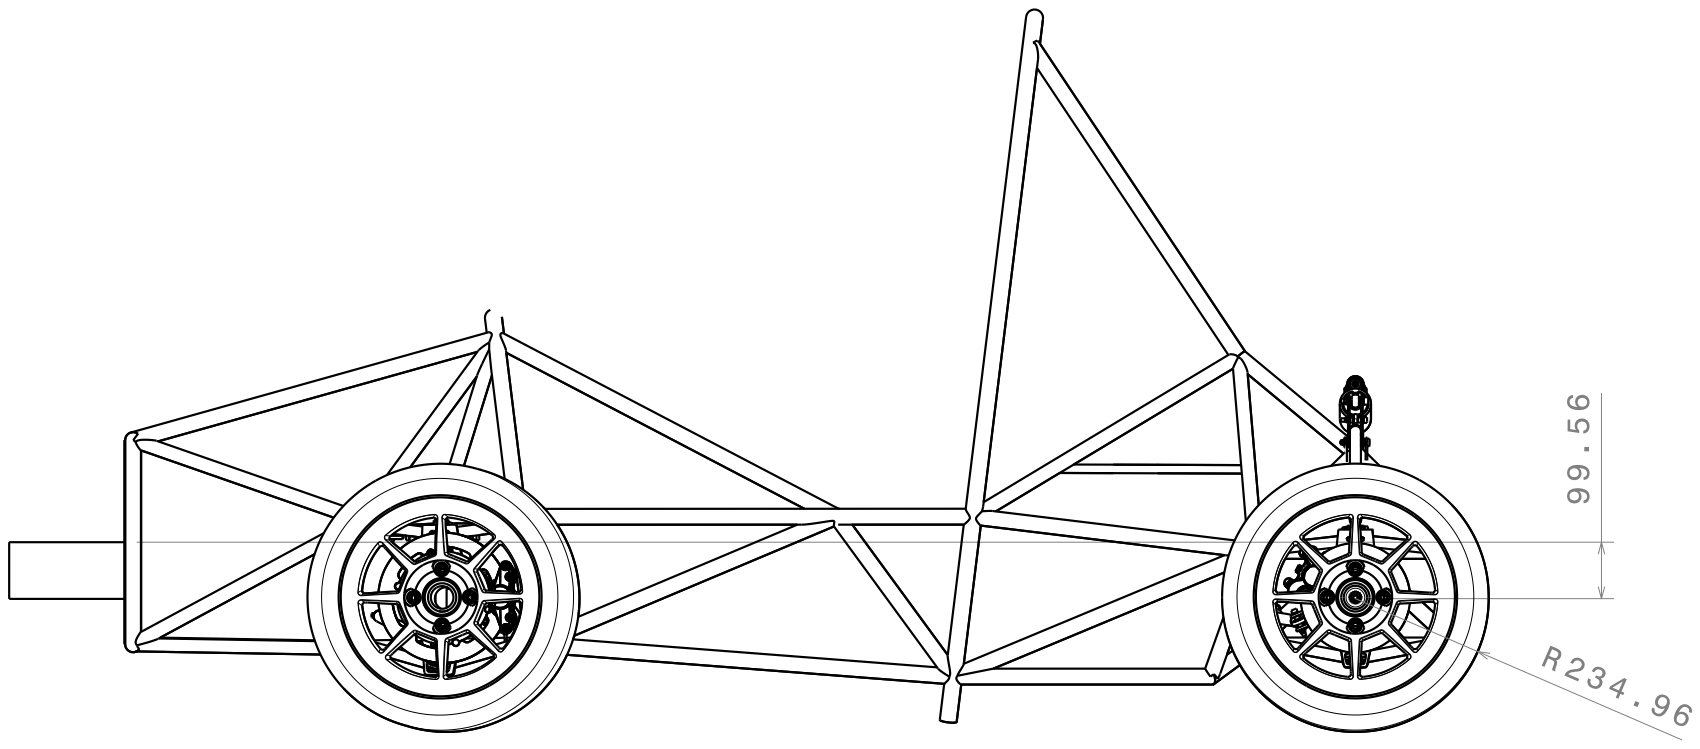
[picture p713: page 1]
