EOSCogniton/ELIZ-2022/01 - Maquette CATIA/EN_Engine_Drivetrain/EN_A0100 (Engine)/EN_01001 (motor)/00_documentation/plan_emrax228.pdf

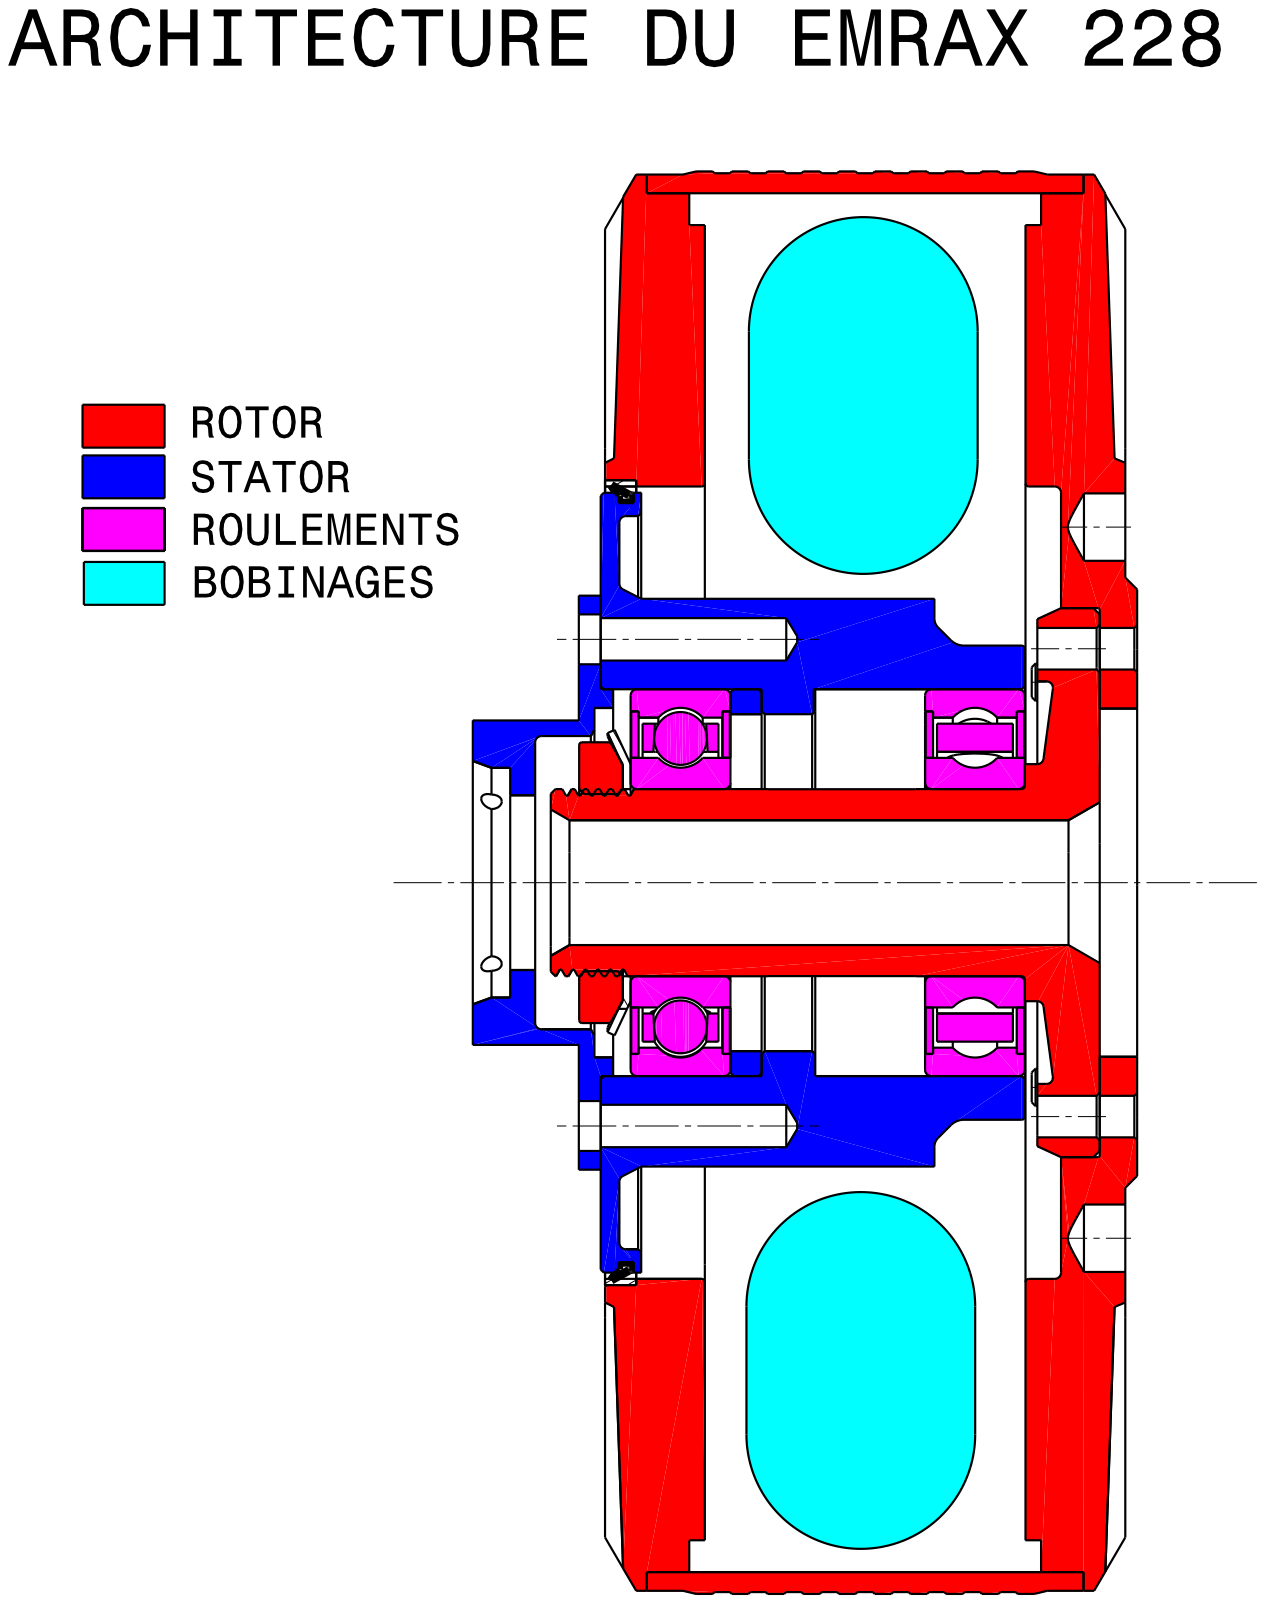
[picture p714: page 1]

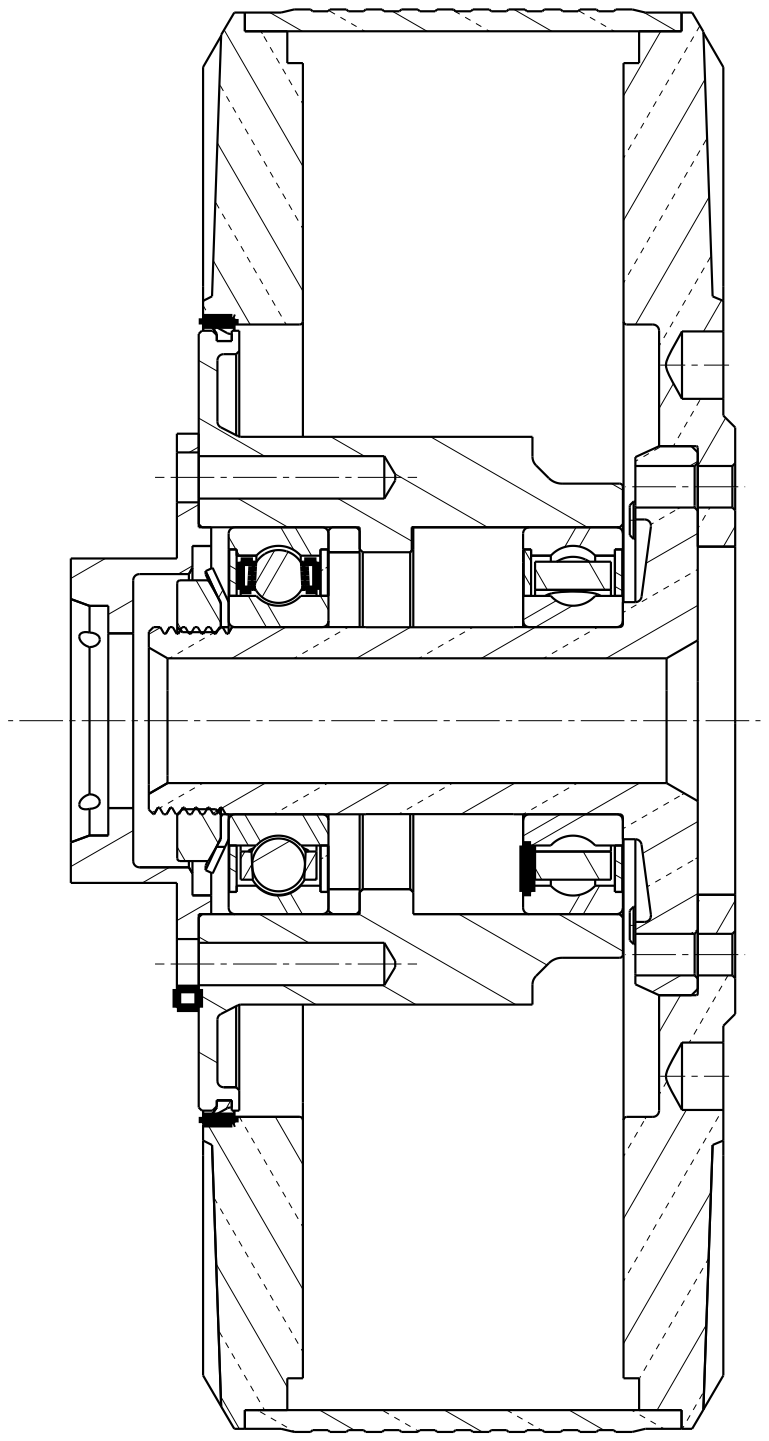
[picture p715: page 2]
