EOSCogniton/ELIZ-2022/02 - Documentation/BASTIE/Cartes Valkyriz/BSPD/Fabrication/BSPD-B_Cu.pdf

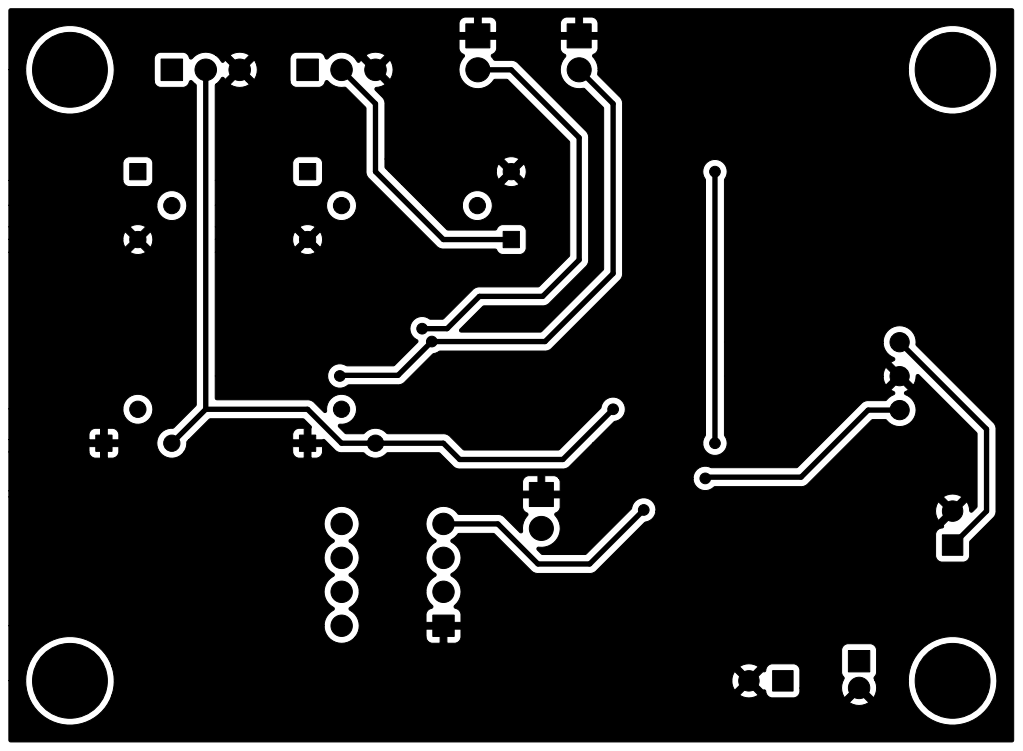
[picture p716: page 1]
