EOSCogniton/ELIZ-2022/02 - Documentation/BASTIE/Cartes Valkyriz/BSPD/Fabrication/BSPD-B_Mask.pdf

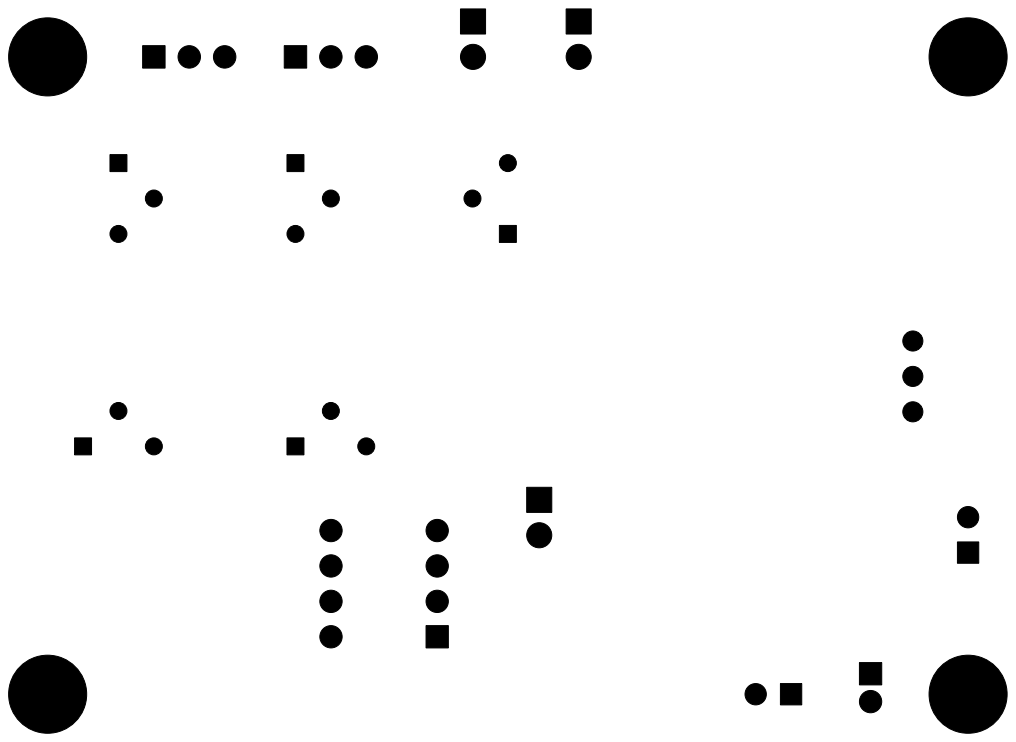
[picture p717: page 1]
