EOSCogniton/ELIZ-2022/02 - Documentation/BASTIE/Cartes Valkyriz/BSPD/Fabrication/BSPD-F_Cu.pdf

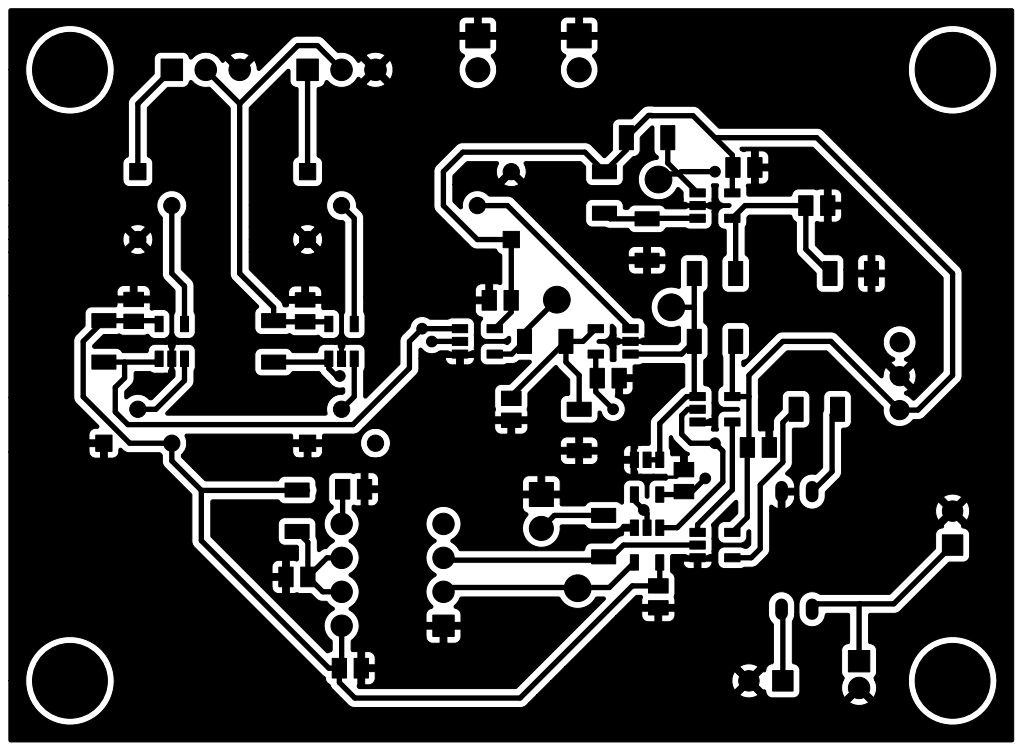
[picture p718: page 1]
