EOSCogniton/ELIZ-2022/02 - Documentation/Kicad/Construction de la librairy/Comparateur Double LM393LVDR 1.2/1er essai/LM393-PSpiceFiles/SCHEMATIC1/test1/test1.cir

** Profile: "SCHEMATIC1-test1"  [ C:\Modeling\LM393_ti\lm393-pspicefiles\schematic1\test1.sim ] 

** Creating circuit file "test1.cir" 
** WARNING: THIS AUTOMATICALLY GENERATED FILE MAY BE OVERWRITTEN BY SUBSEQUENT SIMULATIONS

*Libraries: 
* Profile Libraries :
* Local Libraries :
.LIB "../../../lm393.lib" 
* From [PSPICE NETLIST] section of C:\SPB_DATA\cdssetup\OrCAD_PSpice\17.4.0\PSpice.ini file:
.lib "nom.lib" 

*Analysis directives: 
.TRAN  0 30u 0 
.OPTIONS ADVCONV
.PROBE64 V(alias(*)) I(alias(*)) W(alias(*)) D(alias(*)) NOISE(alias(*)) 
.INC "..\SCHEMATIC1.net" 


.END
