EOSCogniton/ELIZ-2022/02 - Documentation/BASTIE/Cartes Valkyriz/BSPD.asc

C1: cap; 400n
R1: res; 200k
U3: and2
V1: voltage; 5V
V2: voltage; PULSE(0 5 2 0.01n 0.01n 5 10 1)
V3: voltage; 2.49
Named nets: 0
.tran 10
