EOSCogniton/ELIZ-2022/(list of files, drawings)

Other design files:
02 - Documentation/BASTIE/Cartes Valkyriz/Simulation protheus/BSPD/BSPD.pdsprj
02 - Documentation/Kicad/Construction de la librairy/Comparateur Double LM393LVDR 1.2/1er essai/lm393.dsn
02 - Documentation/Kicad/Construction de la librairy/Comparateur Double LM393LVDR 1.2/1er essai/lm393.opj
02 - Documentation/Kicad/Construction de la librairy/Comparateur Double LM393LVDR 1.2/2eme essai/lm393.dsn
02 - Documentation/Kicad/Construction de la librairy/Comparateur Double LM393LVDR 1.2/2eme essai/lm393.opj
02 - Documentation/Kicad/Construction de la librairy/NMOS SQ2348ES-T1_BE3 1.5/spice/SQ2348ES_PS Rev A.OLB
02 - Documentation/Kicad/Construction de la librairy/NMOS SQ2348ES-T1_BE3 1.5/spice/SQ2348ES_PS_RC Rev A.OLB
02 - Documentation/Kicad/Construction de la librairy/PMOS SI2343CDS-T1-GE3 1.5/spice/SI2343CDS_PS Rev B.OLB
02 - Documentation/Kicad/Construction de la librairy/PMOS SI2343CDS-T1-GE3 1.5/spice/SI2343CDS_PS_RC Rev B.OLB
02 - Documentation/Kicad/Construction de la librairy/Timer LM555CMX NOPB 0.2/spice/TLC555.DSN
02 - Documentation/Kicad/Construction de la librairy/Timer LM555CMX NOPB 0.2/spice/TLC555.OLB
02 - Documentation/Kicad/Construction de la librairy/Timer LM555CMX NOPB 0.2/spice/TLC555.opj
02 - Documentation/MODAC/Cartes Elec/BMS Slave/BMS_13_VF/BMS_13_VF/Components/LIB_5-103635-8/5-103635-8/Altium/5-103635-8.SchLib
02 - Documentation/MODAC/Cartes Elec/BMS Slave/BMS_13_VF/BMS_13_VF/Components/LIB_5-103635-8/5-103635-8/Altium/SHDRRA9W69P0X254_1X9_2527X1359X741P.PcbLib
Documentation/Kicad/Construction de la librairy/Comparateur Double LM393LVDR 1.2/1er essai/lm393.dsn
Documentation/Kicad/Construction de la librairy/Comparateur Double LM393LVDR 1.2/1er essai/lm393.opj
Documentation/Kicad/Construction de la librairy/Comparateur Double LM393LVDR 1.2/2eme essai/lm393.dsn
Documentation/Kicad/Construction de la librairy/Comparateur Double LM393LVDR 1.2/2eme essai/lm393.opj
Documentation/Kicad/Construction de la librairy/NMOS SQ2348ES-T1_BE3 1.5/spice/SQ2348ES_PS Rev A.OLB
Documentation/Kicad/Construction de la librairy/NMOS SQ2348ES-T1_BE3 1.5/spice/SQ2348ES_PS_RC Rev A.OLB
Documentation/Kicad/Construction de la librairy/PMOS SI2343CDS-T1-GE3 1.5/spice/SI2343CDS_PS Rev B.OLB
Documentation/Kicad/Construction de la librairy/PMOS SI2343CDS-T1-GE3 1.5/spice/SI2343CDS_PS_RC Rev B.OLB
Documentation/Kicad/Construction de la librairy/Timer LM555CMX NOPB 0.2/spice/TLC555.DSN
Documentation/Kicad/Construction de la librairy/Timer LM555CMX NOPB 0.2/spice/TLC555.OLB
Documentation/Kicad/Construction de la librairy/Timer LM555CMX NOPB 0.2/spice/TLC555.opj
