EOSCogniton/ELIZ-2022/02 - Documentation/BASTIE/Cartes Artemiz/AMS IMD Reset/Remplacement AMS IMS Reset/remplacement/remplacement.kicad_pcb

## KiCad design 02 - Documentation/BASTIE/Cartes Artemiz/AMS IMD Reset/Remplacement AMS IMS Reset/remplacement/remplacement.kicad_pcb (2025-09-01)

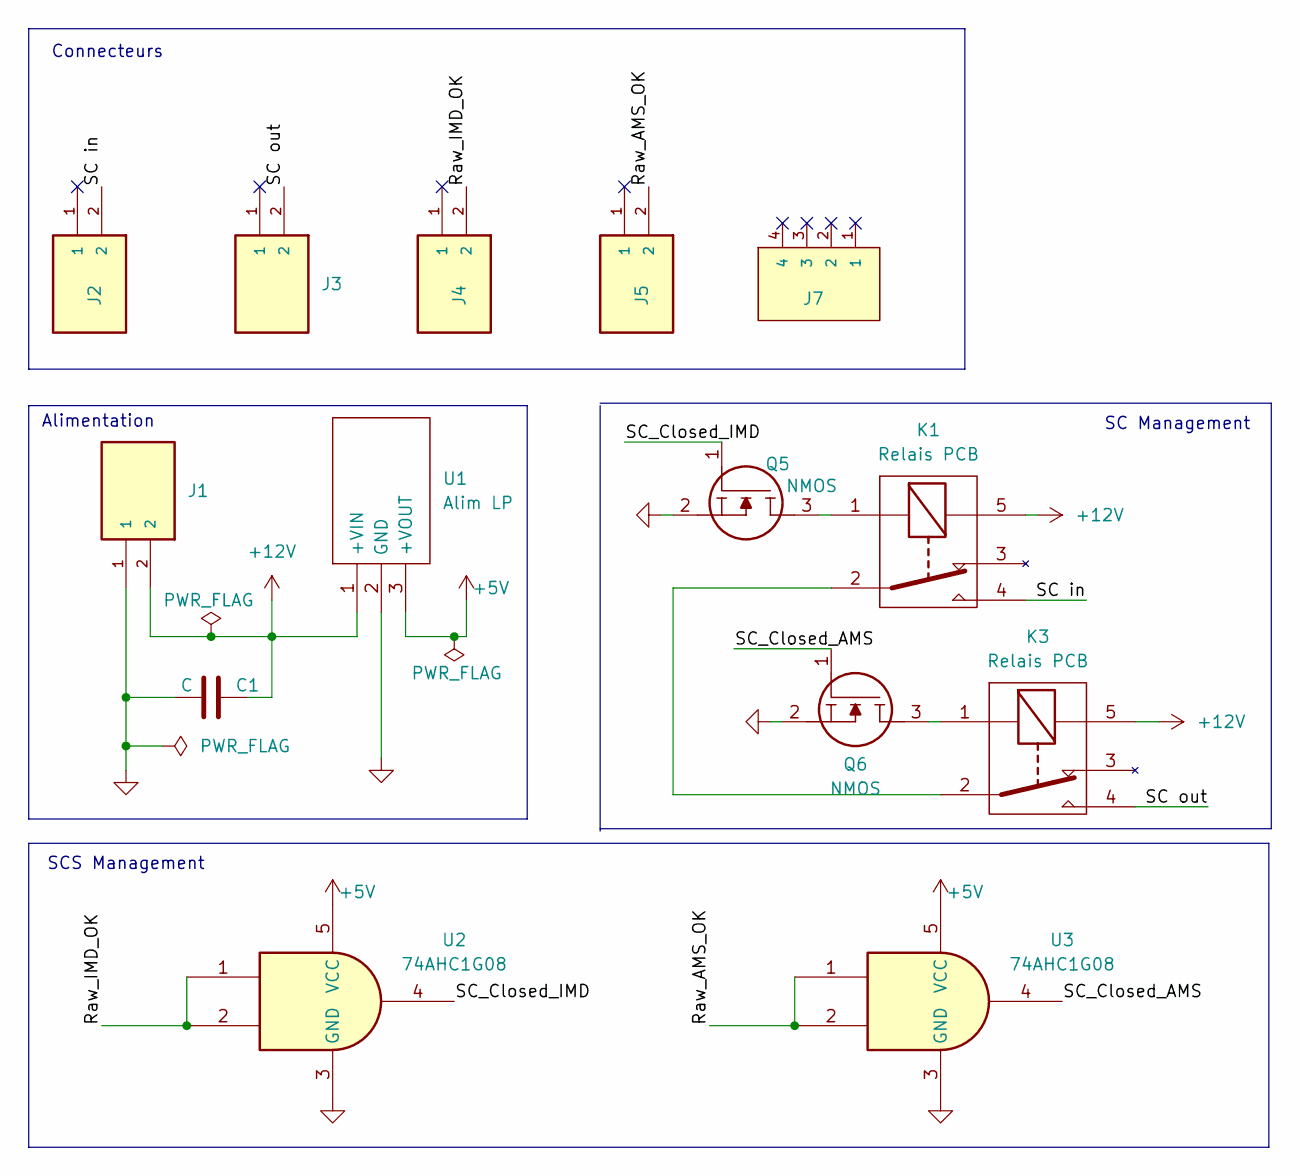
[picture p719: schematic remplacement.kicad_sch, IMD Reset]

Parts:
C1: C; CP_Radial_D5.0mm_P2.00mm
J1, J2, J3, J4, J5: 2P Droit 2-11-2022; MOLEX_22-11-2022; PARTREV BD8; Mouser Part Number 538-22-11-2022
J7: 4P Droit 22-11-2042; MOLEX_22-11-2042; Manufacturer_Part_Number 22-11-2042; Mouser Part Number 538-22-11-2042
K1, K3: Relais PCB; CP112V; Mouser Part Number 769-CP1-12V
Q5, Q6: NMOS SQ2348ES-T1_GE3; SOT95P237X112-3N; Manufacturer_Part_Number SQ2348ES-T1_GE3; Mouser Part Number 781-SQ2348ES-T1_GE3
U1: Alim LP TSR_0.5-2450; TSR-0.5-2433; Manufacturer_Part_Number TSR 0.5-2450; Mouser Part Number 495-TSR0.5-2450
U2, U3: 74AHC1G08; SOT-23-5_L3.0-W1.7-P0.95-LS2.8-BL

Connections:
+5V: U1.3 (+VOUT), U2.5 (VCC), U3.5 (VCC)
+12V: C1.2, J1.2, K1.5, K3.5, U1.1 (+VIN)
/Raw_AMS_OK: J5.2, U3.1, U3.2
/Raw_IMD_OK: J4.2, U2.1, U2.2
/SC in: J2.2, K1.4
/SC out: J3.2, K3.4
/SC_Closed_AMS: Q6.1, U3.4
/SC_Closed_IMD: Q5.1, U2.4
GND: C1.1, J1.1, Q5.2, Q6.2, U1.2 (GND), U2.3 (GND), U3.3 (GND)
unnamed: K1.1, Q5.3
unnamed: K1.2, K3.2
unnamed: K3.1, Q6.3

Notes on the sheet:
Alimentation
SC Management
SCS Management
Connecteurs

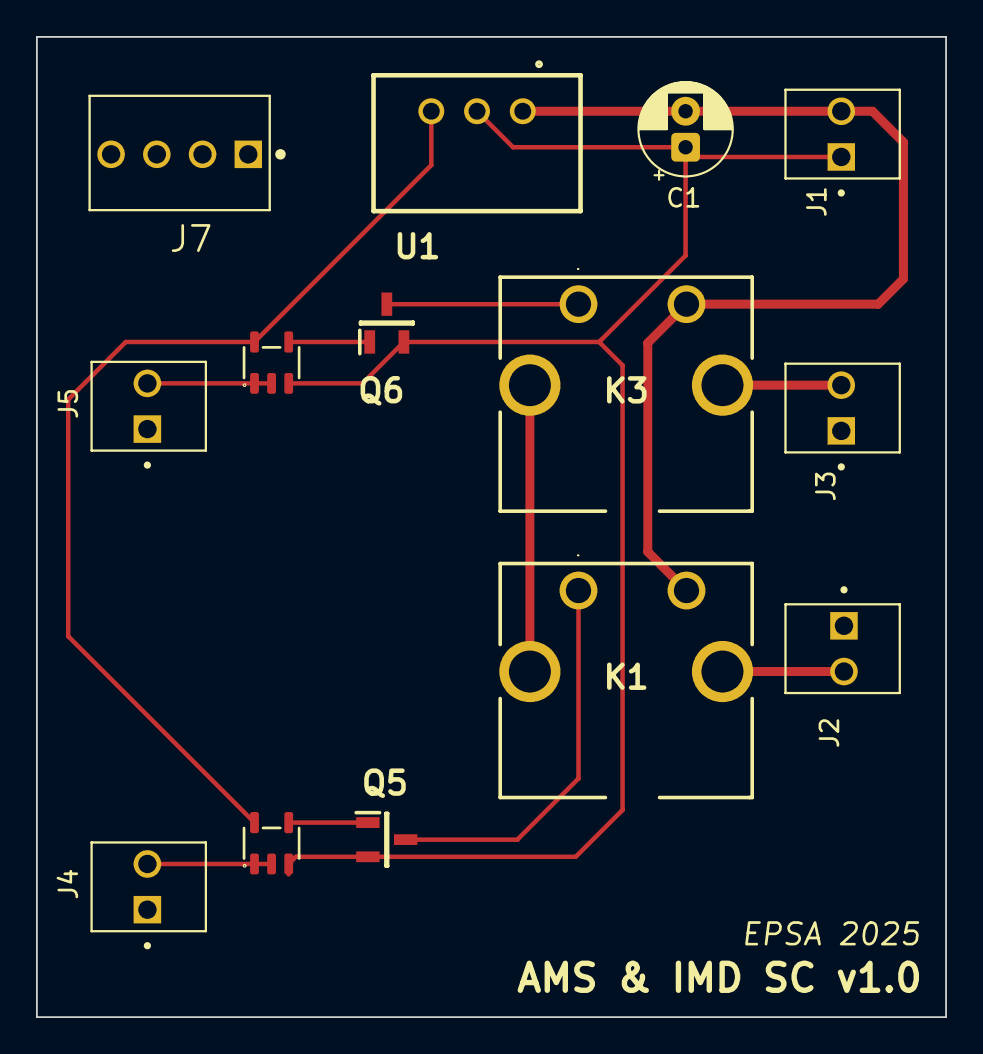
[picture p720: board remplacement.kicad_pcb from above]

Board: 2 copper layers, 50.5 x 54.5 mm, 14 parts (0 on the bottom side), 12 nets.
