EOSCogniton/ELIZ-2022/02 - Documentation/BASTIE/Cartes Artemiz/BSPD/BSPD_v4/bspdv4.kicad_pcb

## KiCad design 02 - Documentation/BASTIE/Cartes Artemiz/BSPD/BSPD_v4/bspdv4.kicad_pcb (2025-06-13)

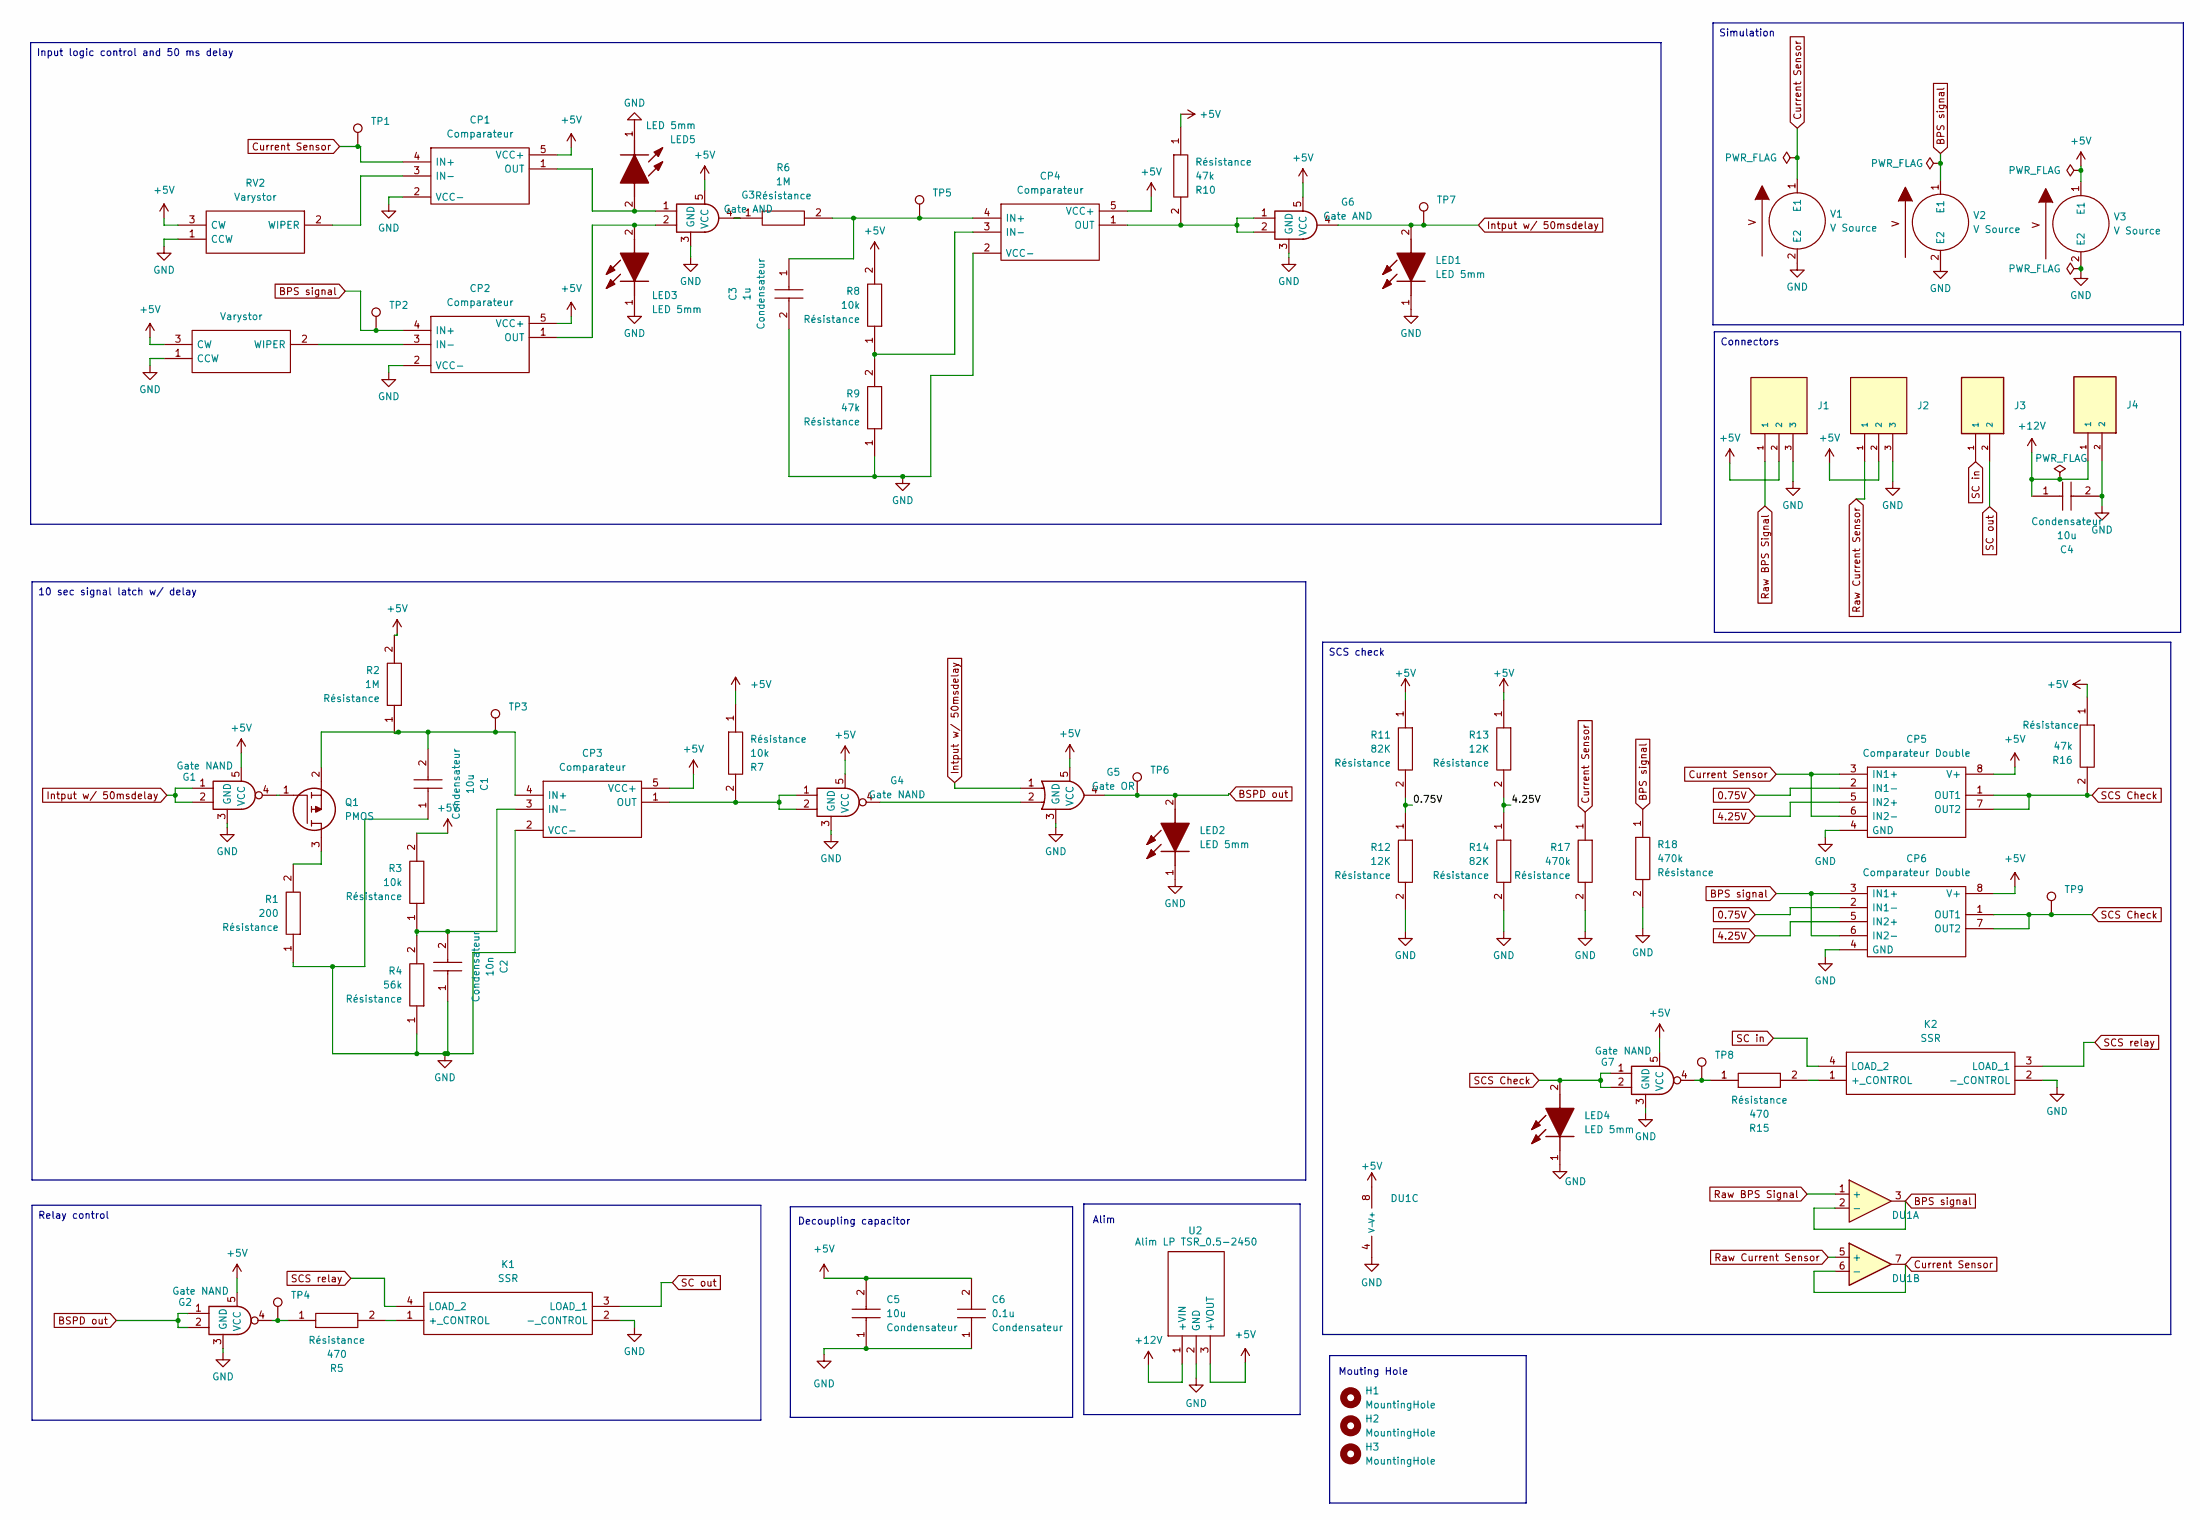
[picture p721: schematic bspdv4.kicad_sch, BSPD]

Parts:
C1, C4, C5: 10u; CP_Radial_D5.0mm_P2.00mm; Manufacturer_Part_Number 0805Y1000104JXT
C2: 10n; CAPC2012X130N; Manufacturer_Part_Number 0805Y1000104JXT
C3: 1u; CAPC2012X130N; Manufacturer_Part_Number 0805Y1000104JXT
C6: 0.1u; CAPC2012X130N; Manufacturer_Part_Number 0805Y1000104JXT
CP1, CP2, CP3, CP4: Comparateur TS391ILT; SOT95P280X145-5N; Manufacturer_Part_Number TS391ILT; Mouser Part Number 511-TS391IL
CP5, CP6: Comparateur Double LM393LVDR; SOIC127P600X175-8N; Manufacturer_Part_Number LM393LVDR; Mouser Part Number 595-LM393LVDR
DU1: Opamp_Dual; TSSOP-8_4.4x3mm_P0.65mm; Manufacturer_Part_Number TLV9062QPWRQ1; Mouser Part Number 595-TLV9062QPWRQ1
G1, G2, G4, G7: Gate NAND SN74AHCT1G00DBVR; SOT95P280X145-5N; Manufacturer_Part_Number SN74AHCT1G00DBVR; Mouser Part Number 595-SN74AHCT1G00DBVR
G3, G6: Gate AND SN74AHCT1G08DBVR; SOT95P280X145-5N; Manufacturer_Part_Number SN74AHCT1G08DBVR; Mouser Part Number 595-SN74AHCT1G08DBVR
G5: Gate OR SN74AHCT1G32DBVR; SOT95P280X145-5N; Manufacturer_Part_Number SN74AHCT1G32DBVR; Mouser Part Number 595-SN74AHCT1G32DBVR
H1, H2, H3: MountingHole; MountingHole_2.7mm_M2.5
J1, J2: 3P Droit 22-11-2032; MOLEX_22-11-2032; Manufacturer_Part_Number 22-11-2032; Mouser Part Number 538-22-11-2032
J3, J4: 2P Droit 2-11-2022; MOLEX_22-11-2022; Manufacturer_Part_Number 22-11-2022; Mouser Part Number 538-22-11-2022
K1, K2: SSR CPC1394GR; CPC1394GR; Manufacturer_Part_Number CPC1394GR; Mouser Part Number 849-CPC1394GR
LED1, LED2, LED3, LED4, LED5: LED 5mm; 4302H55V; Mouser Part Number 606-4302H5-5V
Q1: PMOS SI2343CDS-T1-GE3; SOT95P237X112-3N; Manufacturer_Part_Number SI2343CDS-T1-GE3; Mouser Part Number 781-SI2343CDS-T1-GE3
R1: 200; RESC3216X70N; Manufacturer_Part_Number RK73H2BLTDD2152F; Mouser Part Number N/A
R2, R6: 1M; RESC3216X70N; Manufacturer_Part_Number RK73H2BLTDD2152F; Mouser Part Number N/A
R3, R7, R8: 10k; RESC3216X70N; Manufacturer_Part_Number RK73H2BLTDD2152F; Mouser Part Number N/A
R4: 56k; RESC3216X70N; Manufacturer_Part_Number RK73H2BLTDD2152F; Mouser Part Number N/A
R5, R15: 470; RESC3216X70N; Manufacturer_Part_Number RK73H2BLTDD2152F; Mouser Part Number N/A
R9, R10, R16: 47k; RESC3216X70N; Manufacturer_Part_Number RK73H2BLTDD2152F; Mouser Part Number N/A
R11, R14: 82K; RESC3216X70N; Manufacturer_Part_Number RK73H2BLTDD2152F; Mouser Part Number N/A
R12, R13: 12K; RESC3216X70N; Manufacturer_Part_Number RK73H2BLTDD2152F; Mouser Part Number N/A
R17, R18: 470k; RESC3216X70N; Manufacturer_Part_Number RK73H2BLTDD2152F; Mouser Part Number N/A
RV1, RV2: Varystor 3296Y-1-223LF; 3296Y1223LF; Manufacturer_Part_Number 3296Y-1-223LF; Mouser Part Number 652-3296Y-1-223LF
TP1, TP2, TP3, TP4, TP5, TP6, TP7, TP8, TP9: type="R" model="TestPoint" lib=""; TestPoint_Pad_D2.0mm
U2: Alim LP TSR_0.5-2450; TSR-0.5-2433; Manufacturer_Part_Number TSR 0.5-2450; Mouser Part Number 495-TSR0.5-2450
V1, V2, V3: 5

Connections:
0.75V: CP5.2 (IN1-), CP6.2 (IN1-), R11.2, R12.1
4.25V: CP5.5 (IN2+), CP6.5 (IN2+), R13.2, R14.1
+5V: C5.2, C6.2, CP1.5 (VCC+), CP2.5 (VCC+), CP3.5 (VCC+), CP4.5 (VCC+), CP5.8 (V+), CP6.8 (V+), DU1.8 (V+), G1.5 (VCC), G2.5 (VCC), G3.5 (VCC), G4.5 (VCC), G5.5 (VCC), G6.5 (VCC), G7.5 (VCC), J1.2, J2.2, R2.2, R3.2, R7.1, R8.2, R10.1, R11.1, R13.1, R16.1, RV1.3 (CW), RV2.3 (CW), U2.3 (+VOUT), V3.1 (E1)
+12V: C4.1, J4.1, U2.1 (+VIN)
BPS signal: CP2.4 (IN+), CP6.3 (IN1+), CP6.6 (IN2-), DU1.2 (-), DU1.3, R18.1, TP2.1, V2.1 (E1)
BSPD out: G2.1, G2.2, G5.4, LED2.2 (A), TP6.1
Current Sensor: CP1.4 (IN+), CP5.3 (IN1+), CP5.6 (IN2-), DU1.6 (-), DU1.7, R17.1, TP1.1, V1.1 (E1)
GND: C1.1, C2.1, C3.2, C4.2, C5.1, C6.1, CP1.2 (VCC-), CP2.2 (VCC-), CP3.2 (VCC-), CP4.2 (VCC-), CP5.4 (GND), CP6.4 (GND), DU1.4 (V-), G1.3 (GND), G2.3 (GND), G3.3 (GND), G4.3 (GND), G5.3 (GND), G6.3 (GND), G7.3 (GND), J1.3, J2.3, J4.2, K1.2 (-_CONTROL), K2.2 (-_CONTROL), LED1.1 (K), LED2.1 (K), LED3.1 (K), LED4.1 (K), LED5.1 (K), R1.1, R4.1, R9.1, R12.2, R14.2, R17.2, R18.2, RV1.1 (CCW), RV2.1 (CCW), U2.2 (GND), V1.2 (E2), V2.2 (E2), V3.2 (E2)
Intput w/ 50msdelay: G1.1, G1.2, G5.1, G6.4, LED1.2 (A), TP7.1
unnamed: CP1.3 (IN-), RV2.2 (WIPER)
unnamed: CP1.1 (OUT), G3.1, LED5.2 (A)
unnamed: CP2.3 (IN-), RV1.2 (WIPER)
unnamed: CP2.1 (OUT), G3.2, LED3.2 (A)
unnamed: C1.2, CP3.4 (IN+), Q1.2, R2.1, TP3.1
unnamed: C2.2, CP3.3 (IN-), R3.1, R4.2
unnamed: CP3.1 (OUT), G4.1, G4.2, R7.2
unnamed: C3.1, CP4.4 (IN+), R6.2, TP5.1
unnamed: CP4.3 (IN-), R8.1, R9.2
unnamed: CP4.1 (OUT), G6.1, G6.2, R10.2
unnamed: G1.4, Q1.1
unnamed: G2.4, R5.1, TP4.1
unnamed: G3.4, R6.1
unnamed: G4.4, G5.2
unnamed: G7.4, R15.1, TP8.1
unnamed: K1.1 (+_CONTROL), R5.2
unnamed: K2.1 (+_CONTROL), R15.2
unnamed: Q1.3, R1.2
Raw BPS Signal: DU1.1 (+), J1.1
Raw Current Sensor: DU1.5 (+), J2.1
SC in: J3.1, K2.4 (LOAD_2)
SC out: J3.2, K1.3 (LOAD_1)
SCS Check: CP5.1 (OUT1), CP5.7 (OUT2), CP6.1 (OUT1), CP6.7 (OUT2), G7.1, G7.2, LED4.2 (A), R16.2, TP9.1
SCS relay: K1.4 (LOAD_2), K2.3 (LOAD_1)

Notes on the sheet:
Relay control
10 sec signal latch w/ delay
Connectors
SCS check
Simulation
Input logic control and 50 ms delay
Alim
Mouting Hole
Decoupling capacitor

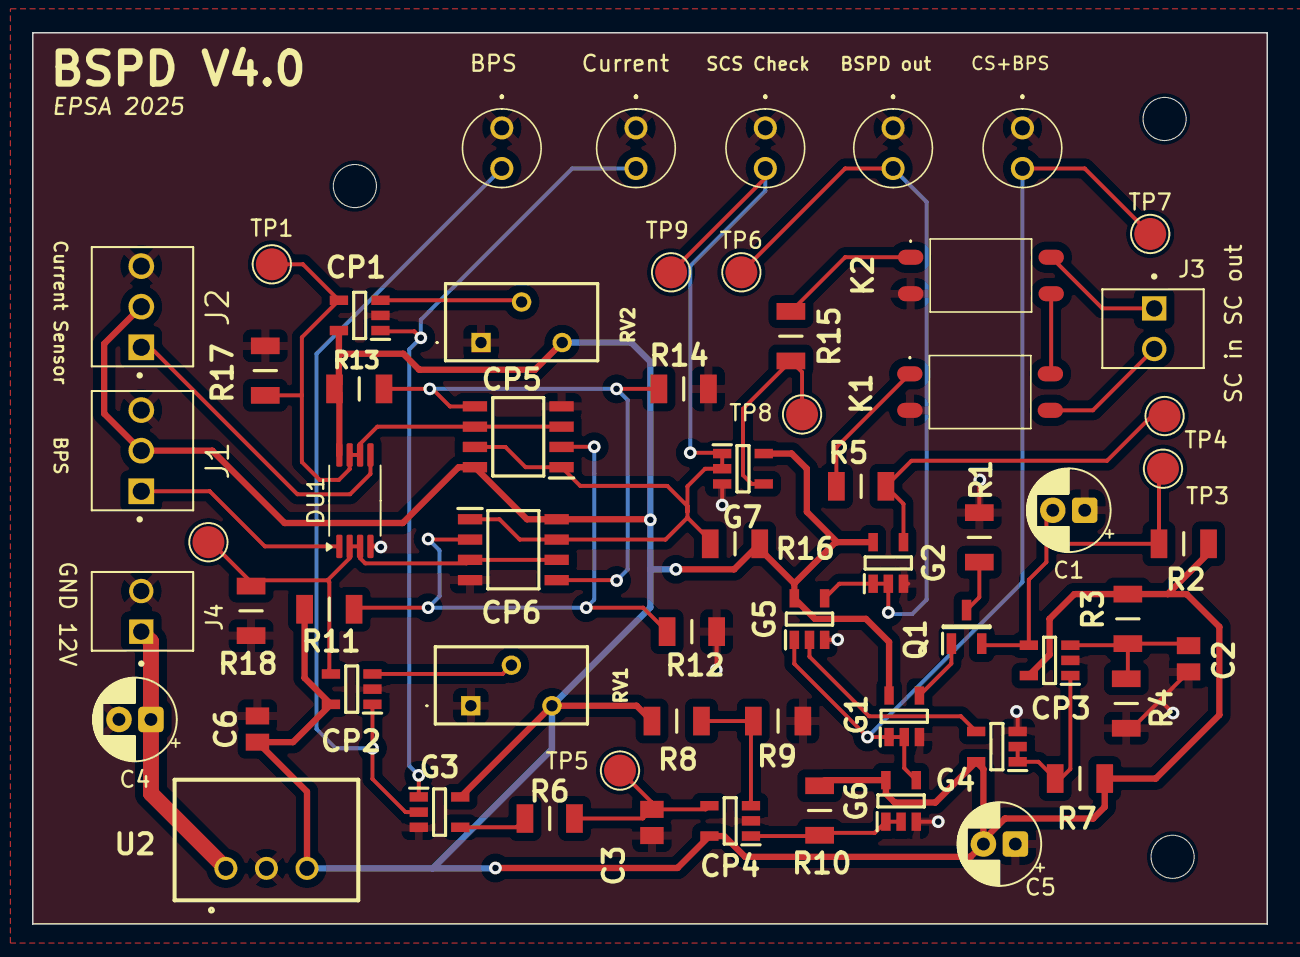
[picture p722: board bspdv4.kicad_pcb from above]

Board: 2 copper layers, 77.3 x 55.8 mm, 65 parts (0 on the bottom side), 33 nets.
