EOSCogniton/ELIZ-2022/02 - Documentation/BASTIE/Cartes Artemiz/BSPD/BSPD_v2/BSPD.kicad_pcb

## KiCad design 02 - Documentation/BASTIE/Cartes Artemiz/BSPD/BSPD_v2/BSPD.kicad_pcb (2024-04-17, an earlier design)

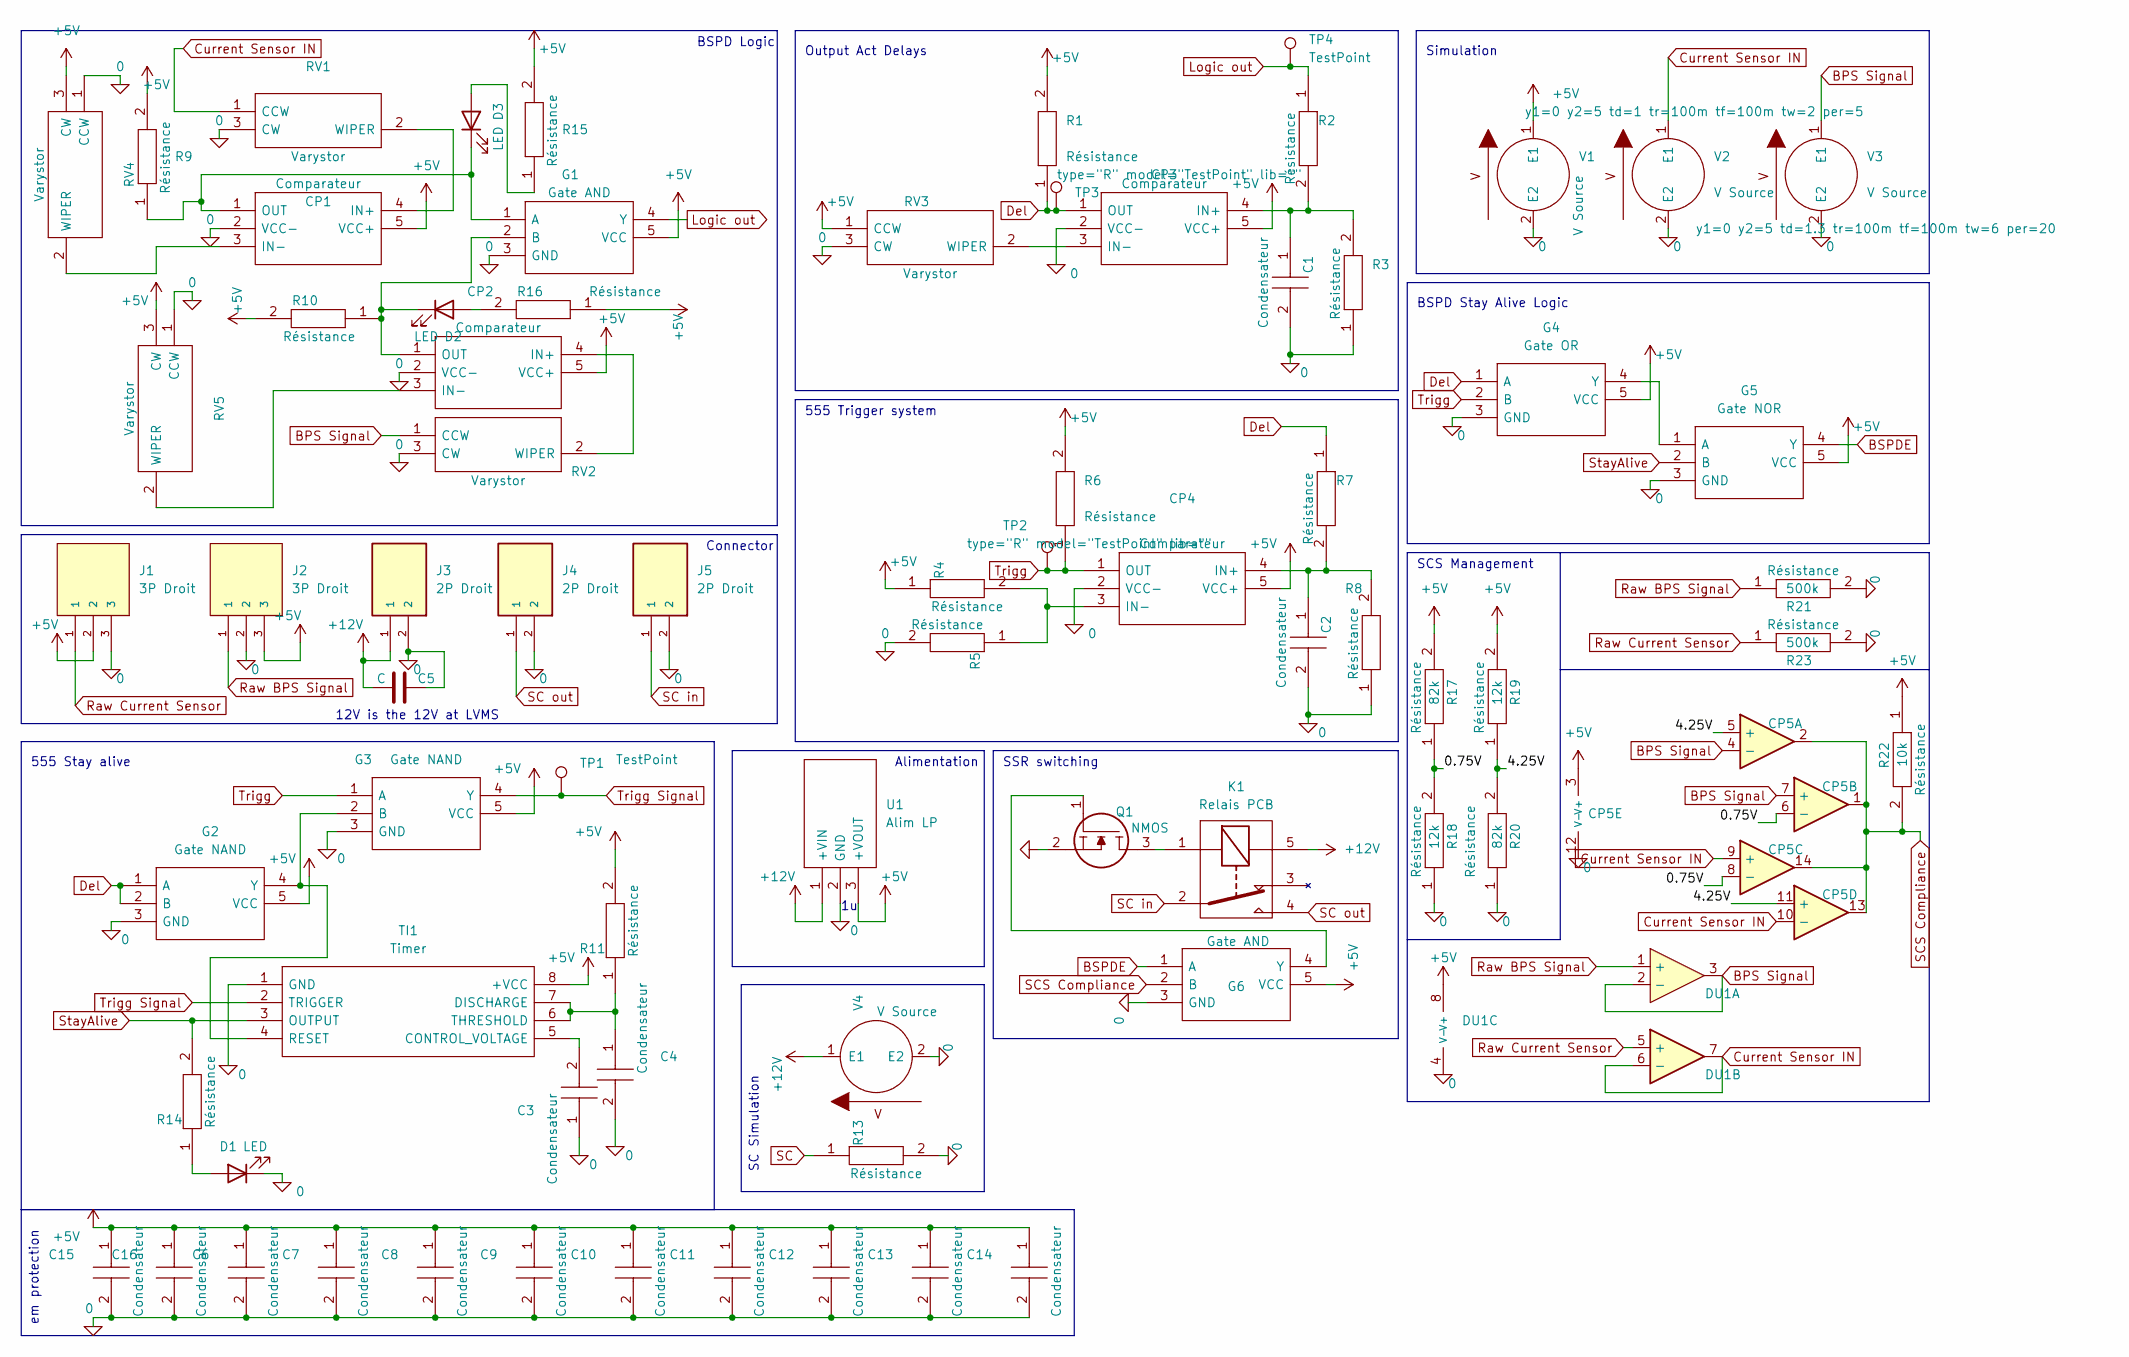
[picture p723: schematic BSPD.kicad_sch]

Parts:
C1, C2, C3, C4, C6, C7, C8, C9, C10, C11, C12, C13, C14, C15, C16: Condensateur 0805Y1000104JXT; CAPC2012X130N; Manufacturer_Part_Number 0805Y1000104JXT
C5: C; CP_Radial_D5.0mm_P2.00mm
CP1, CP2, CP3, CP4: Comparateur TS391ILT; SOT95P280X145-5N; Manufacturer_Part_Number TS391ILT; Mouser Part Number 511-TS391IL
CP5: Opamp_Quad; TSSOP-14_4.4x5mm_P0.65mm; Manufacturer_Part_Number LMV339IPWR; Mouser Part Number 595-LMV339IPWR
D1, D2, D3: LED; LED_D5.0mm
DU1: Opamp_Dual; TSSOP-8_4.4x3mm_P0.65mm; Manufacturer_Part_Number TLV9062QPWRQ1; Mouser Part Number 595-TLV9062QPWRQ1
G1, G6: Gate AND SN74AHCT1G08DBVR; SOT95P280X145-5N; Manufacturer_Part_Number SN74AHCT1G08DBVR; Mouser Part Number 595-SN74AHCT1G08DBVR
G2, G3: Gate NAND SN74AHCT1G00DBVR; SOT95P280X145-5N; Manufacturer_Part_Number SN74AHCT1G00DBVR; Mouser Part Number 595-SN74AHCT1G00DBVR
G4: Gate OR SN74AHCT1G32DBVR; SOT95P280X145-5N; Manufacturer_Part_Number SN74AHCT1G32DBVR; Mouser Part Number 595-SN74AHCT1G32DBVR
G5: Gate NOR SN74AHCT1G02DBVR; SOT95P280X145-5N; Manufacturer_Part_Number SN74AHCT1G02DBVR; Mouser Part Number 595-SN74AHCT1G02DBVR
J1, J2: 3P Droit 22-11-2032; MOLEX_22-11-2032; PARTREV BD8
J3, J4, J5: 2P Droit 2-11-2022; MOLEX_22-11-2022; PARTREV BD8
K1: Relais PCB; CP112V; Mouser Part Number 769-CP1-12V
Q1: NMOS SQ2348ES-T1_GE3; SOT95P237X112-3N; Manufacturer_Part_Number SQ2348ES-T1_GE3; Mouser Part Number 781-SQ2348ES-T1_GE3
R1, R2, R3, R4, R5, R6, R7, R8, R9, R10, R11, R13, R14, R15, R16: Résistance RK73H2BLTDD2152F; RESC3216X70N; Manufacturer_Part_Number RK73H2BLTDD2152F; Mouser Part Number N/A
R17, R20: 82k; RESC3216X70N; Manufacturer_Part_Number RK73H2BLTDD2152F; Mouser Part Number N/A
R18, R19: 12k; RESC3216X70N; Manufacturer_Part_Number RK73H2BLTDD2152F; Mouser Part Number N/A
R21, R23: 500k; RESC3216X70N; Manufacturer_Part_Number RK73H2BLTDD2152F; Mouser Part Number N/A
R22: 10k; RESC3216X70N; Manufacturer_Part_Number RK73H2BLTDD2152F; Mouser Part Number N/A
RV1, RV2, RV3, RV4, RV5: Varystor 3296Y-1-223LF; 3296Y1223LF; Manufacturer_Part_Number 3296Y-1-223LF; Mouser Part Number 652-3296Y-1-223LF
TI1: Timer 555 LM555CMX_NOPB; DIP-8_W7.62mm_Socket; Manufacturer_Part_Number LM555CMX/NOPB; Mouser Part Number 926-LM555CMX/NOPB
TP1, TP4: TestPoint; TestPoint_Pad_D2.0mm
TP2, TP3: type="R" model="TestPoint" lib=""; TestPoint_Pad_D2.0mm
U1: Alim LP TSR_0.5-2450; TSR-0.5-2433; Manufacturer_Part_Number TSR 0.5-2450; Mouser Part Number 495-TSR0.5-2450
V1: 5
V2, V3: VSOURCE
V4: 12

Connections:
0: C1.2, C2.2, C3.1, C4.2, C5.2, C6.2, C7.2, C8.2, C9.2, C10.2, C11.2, C12.2, C13.2, C14.2, C15.2, C16.2, CP1.2 (VCC-), CP2.2 (VCC-), CP3.2 (VCC-), CP4.2 (VCC-), CP5.12 (V-), D1.1 (K), DU1.4 (V-), G1.3 (GND), G2.3 (GND), G3.3 (GND), G4.3 (GND), G5.3 (GND), G6.3 (GND), J1.3, J2.2, J3.2, J4.2, J5.2, R3.1, R5.2, R8.1, R18.1, R20.1, R21.2, R23.2, RV1.3 (CW), RV2.3 (CW), RV3.3 (CW), RV4.1 (CCW), RV5.1 (CCW), TI1.1 (GND), U1.2 (GND)
+5V: C6.1, C7.1, C8.1, C9.1, C10.1, C11.1, C12.1, C13.1, C14.1, C15.1, C16.1, CP1.5 (VCC+), CP2.5 (VCC+), CP3.5 (VCC+), CP4.5 (VCC+), CP5.3 (V+), DU1.8 (V+), G1.5 (VCC), G2.5 (VCC), G3.5 (VCC), G4.5 (VCC), G5.5 (VCC), G6.5 (VCC), J1.2, J2.3, R1.2, R4.1, R6.2, R9.2, R10.2, R11.2, R15.2, R16.1, R17.2, R19.2, R22.1, RV3.1 (CCW), RV4.3 (CW), RV5.3 (CW), TI1.8 (+VCC), U1.3 (+VOUT)
+12V: C5.1, J3.1, K1.5, U1.1 (+VIN), V4.1 (E1)
/0.75V: CP5.6 (-), CP5.8 (-), R17.1, R18.2
/4.25V: CP5.5 (+), CP5.11 (+), R19.1, R20.2
BPS Signal: CP5.4 (-), CP5.7 (+), DU1.2 (-), DU1.3, RV2.1 (CCW), V3.1 (E1)
BSPDE: G5.4 (Y), G6.1 (A)
Current Sensor IN: CP5.9 (+), CP5.10 (-), DU1.6 (-), DU1.7, RV1.1 (CCW), V2.1 (E1)
Del: CP3.1 (OUT), G2.1 (A), G2.2 (B), G4.1 (A), R1.1, R7.1, TP3.1
GND: Q1.2
Logic out: G1.4 (Y), R2.1, TP4.1
unnamed: CP1.4 (IN+), RV1.2 (WIPER)
unnamed: CP1.3 (IN-), RV4.2 (WIPER)
unnamed: CP1.1 (OUT), D3.1 (K), G1.1 (A), R9.1
unnamed: CP2.4 (IN+), RV2.2 (WIPER)
unnamed: CP2.3 (IN-), RV5.2 (WIPER)
unnamed: CP2.1 (OUT), D2.1 (K), G1.2 (B), R10.1
unnamed: C1.1, CP3.4 (IN+), R2.2, R3.2
unnamed: CP3.3 (IN-), RV3.2 (WIPER)
unnamed: C2.1, CP4.4 (IN+), R7.2, R8.2
unnamed: CP4.3 (IN-), R4.2, R5.1
unnamed: D1.2 (A), R14.1
unnamed: D2.2 (A), R16.2
unnamed: D3.2 (A), R15.1
unnamed: G2.4 (Y), G3.2 (B), TI1.4 (RESET)
unnamed: G4.4 (Y), G5.1 (A)
unnamed: G6.4 (Y), Q1.1
unnamed: K1.1, Q1.3
unnamed: C3.2, TI1.5 (CONTROL_VOLTAGE)
unnamed: C4.1, R11.1, TI1.6 (THRESHOLD), TI1.7 (DISCHARGE)
Raw BPS Signal: DU1.1 (+), J2.1, R21.1
Raw Current Sensor: DU1.5 (+), J1.1, R23.1
SC in: J5.1, K1.2
SC out: J4.1, K1.4
SCS Compliance: CP5.1, CP5.2, CP5.13, CP5.14, G6.2 (B), R22.2
StayAlive: G5.2 (B), R14.2, TI1.3 (OUTPUT)
Trigg: CP4.1 (OUT), G3.1 (A), G4.2 (B), R6.1, TP2.1
Trigg Signal: G3.4 (Y), TI1.2 (TRIGGER), TP1.1

Notes on the sheet:
em protection
BSPD Stay Alive Logic
12V is the 12V at LVMS
SSR switching
SCS Management
Simulation
Connector
BSPD Logic
555 Trigger system
SC Simulation
Output Act Delays
555 Stay alive
Alimentation

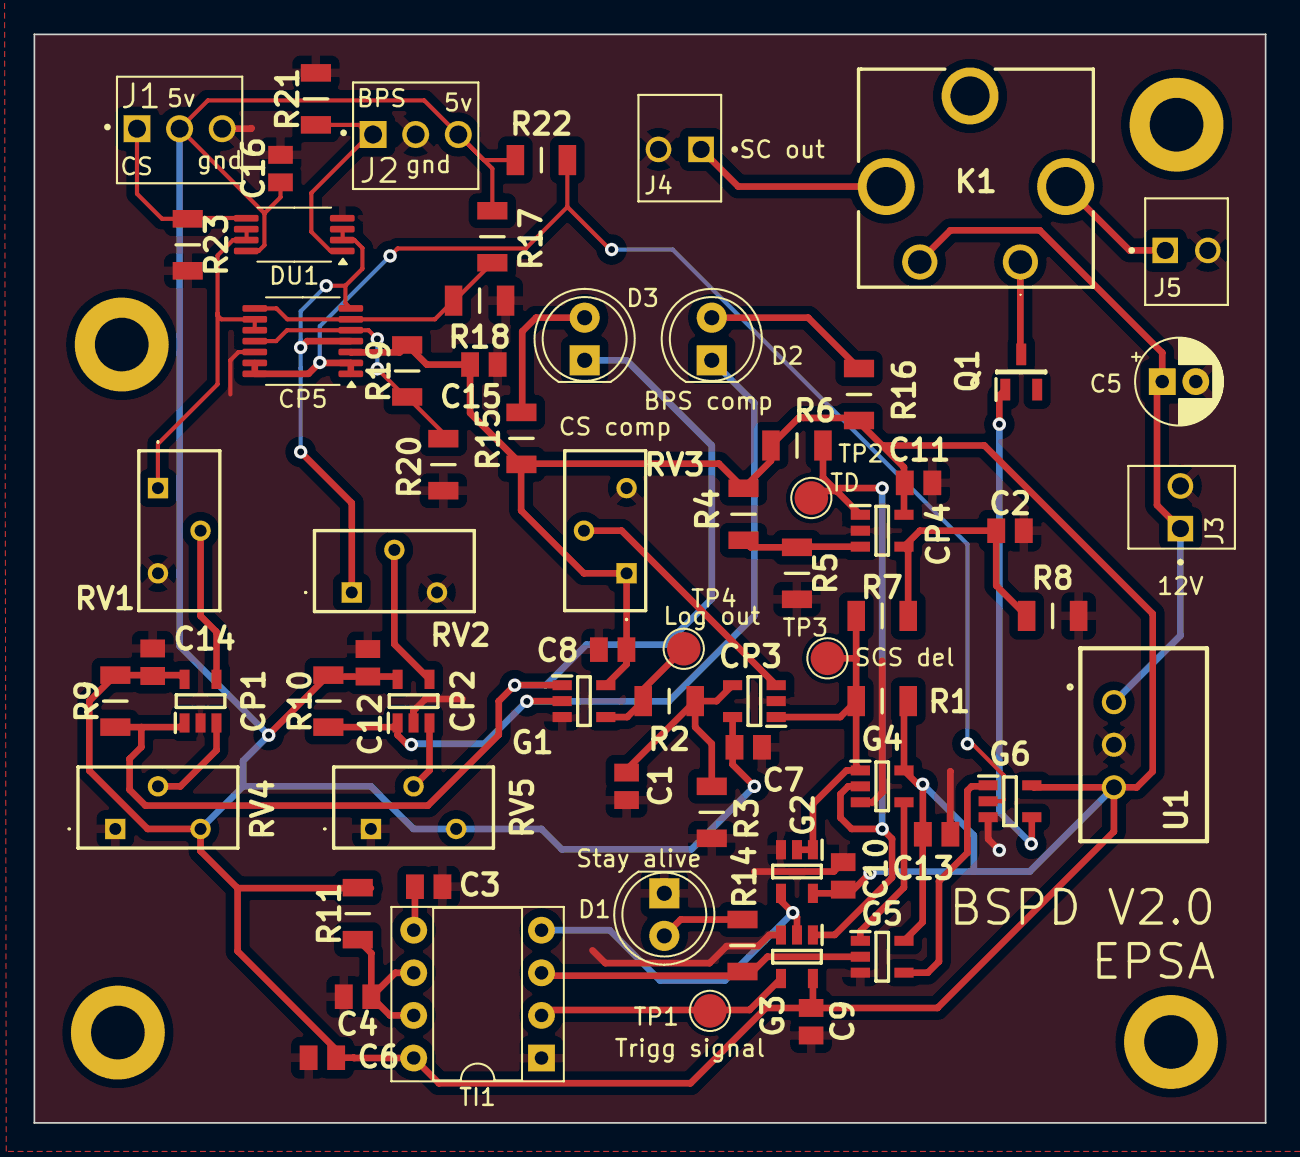
[picture p724: board BSPD.kicad_pcb from above]

Board: 2 copper layers, 73.4 x 64.9 mm, 70 parts (0 on the bottom side), 37 nets.
