EOSCogniton/ELIZ-2022/02 - Documentation/BASTIE/Cartes Artemiz/AMS IMD Reset/AMS_IMD_Reset_v3/AMS_IMD_Reset_v3.kicad_pcb

## KiCad design 02 - Documentation/BASTIE/Cartes Artemiz/AMS IMD Reset/AMS_IMD_Reset_v3/AMS_IMD_Reset_v3.kicad_pcb (2025-06-25)

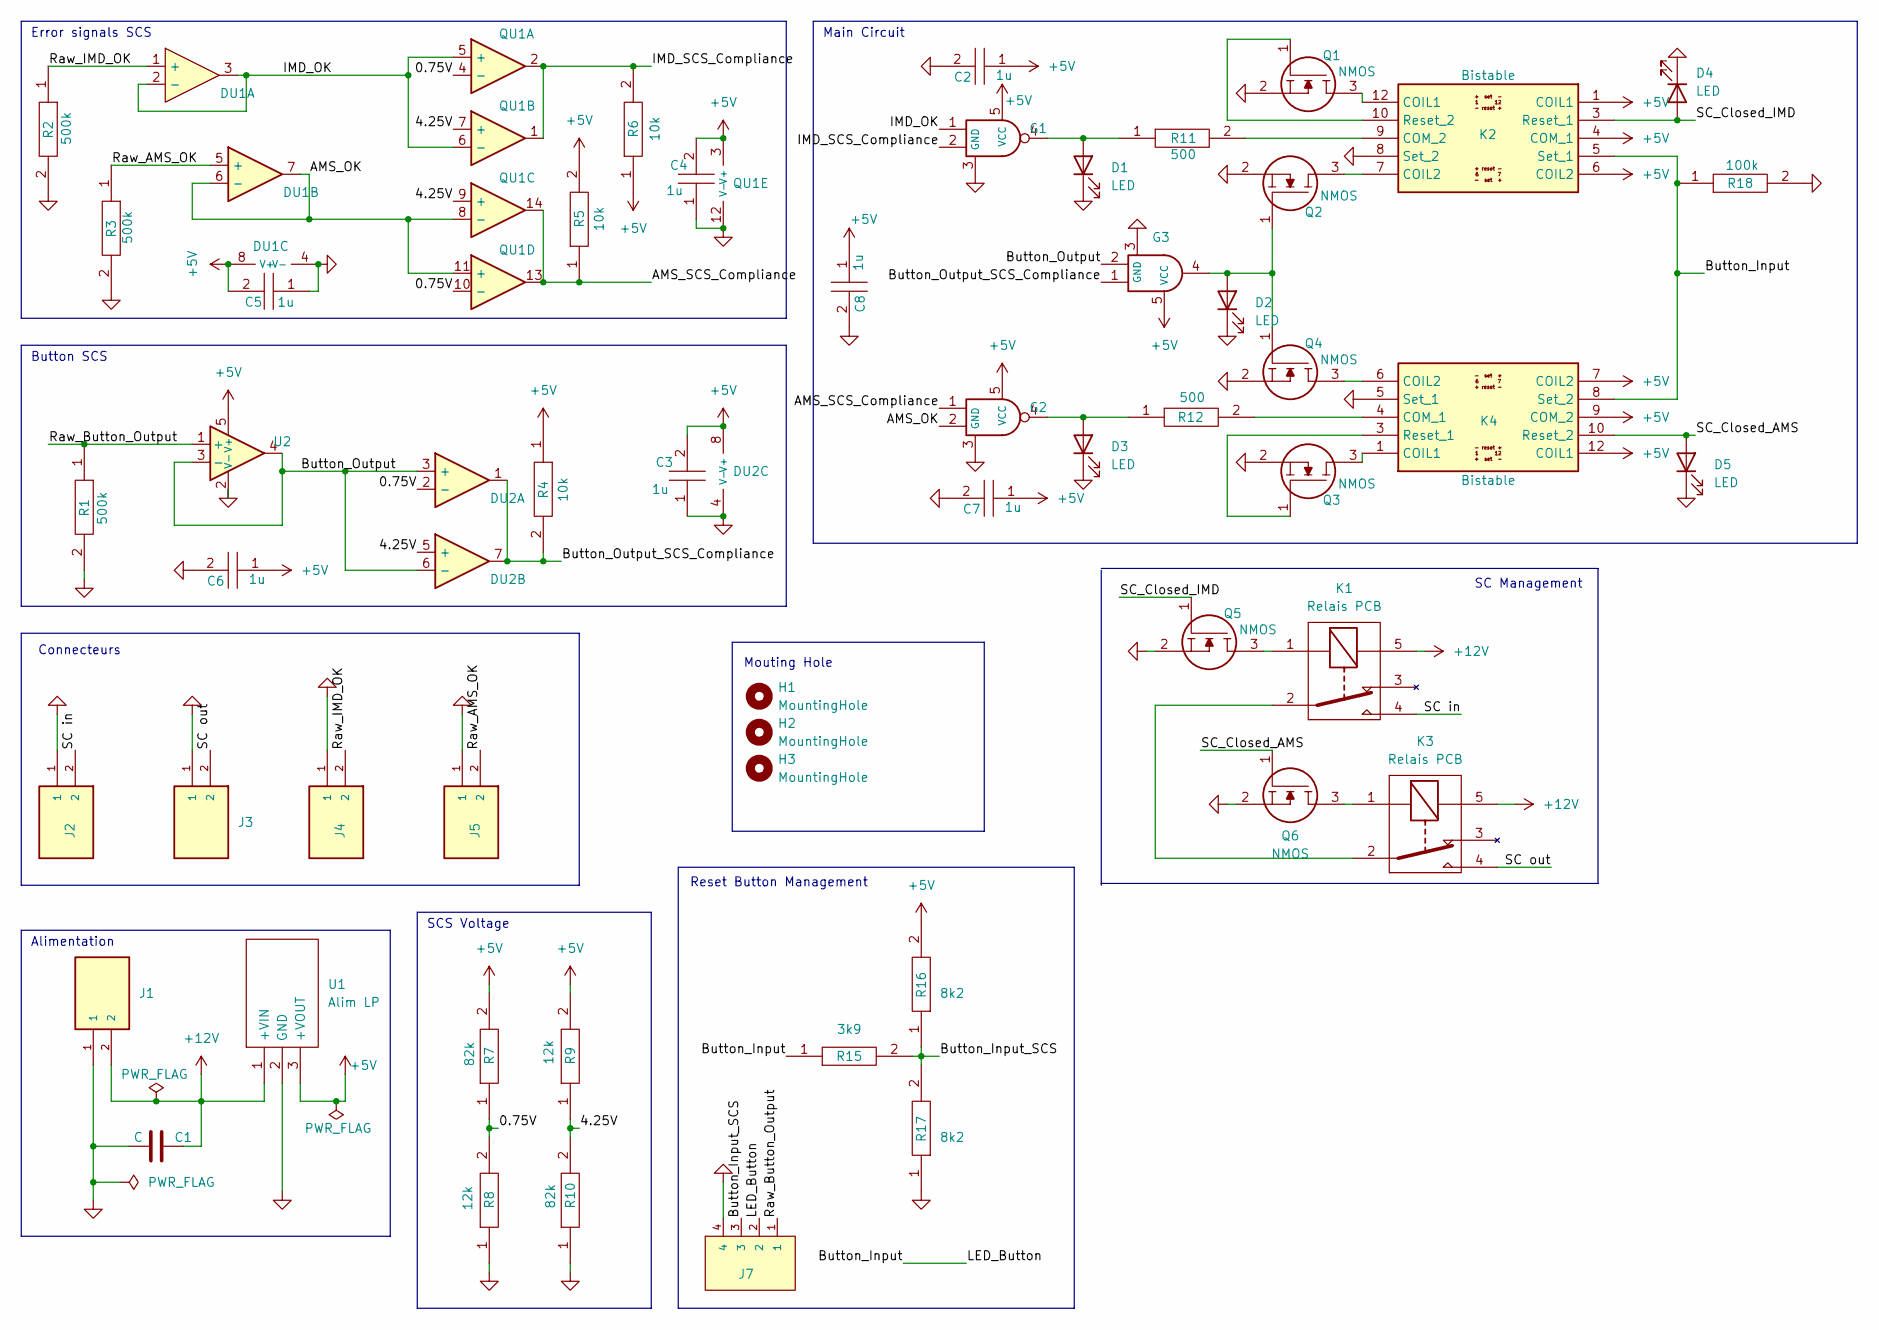
[picture p725: schematic AMS_IMD_Reset_v3.kicad_sch, IMD Reset]

Parts:
C1: C; CP_Radial_D5.0mm_P2.00mm
C2, C3, C4, C5, C6, C7, C8: 1u; CAPC2012X130N; Manufacturer_Part_Number 0805Y1000104JXT
D1, D2, D3, D4, D5: LED; LED_D5.0mm
DU1: Opamp_Dual; TSSOP-8_4.4x3mm_P0.65mm; Manufacturer_Part_Number TLV9062QPWRQ1; Mouser Part Number 595-TLV9062QPWRQ1
DU2: Opamp_Dual; TSSOP-8_4.4x3mm_P0.65mm; Manufacturer_Part_Number LMV393IPWR; Mouser Part Number 595-LMV393IPWR
G1, G2: Gate NAND SN74AHCT1G00DBVR; SOT95P280X145-5N; Manufacturer_Part_Number SN74AHCT1G00DBVR; Mouser Part Number 595-SN74AHCT1G00DBVR
G3: Gate AND SN74AHCT1G08DBVR; SOT95P280X145-5N; Manufacturer_Part_Number SN74AHCT1G08DBVR; Mouser Part Number 595-SN74AHCT1G08DBVR
H1, H2, H3: MountingHole; MountingHole_2.7mm_M2.5
J1, J2, J3, J4, J5: 2P Droit 2-11-2022; MOLEX_22-11-2022; PARTREV BD8; Mouser Part Number 538-22-11-2022
J7: 4P Droit 22-11-2042; MOLEX_22-11-2042; Manufacturer_Part_Number 22-11-2042; Mouser Part Number 538-22-11-2042
K1, K3: Relais PCB; CP112V; Mouser Part Number 769-CP1-12V
K2, K4: Bistable V23079B1201B301; V23079B1201B301; Mouser Part Number 655-V23079B1201B301
Q1, Q2, Q3, Q4, Q5, Q6: NMOS SQ2348ES-T1_GE3; SOT95P237X112-3N; Manufacturer_Part_Number SQ2348ES-T1_GE3; Mouser Part Number 781-SQ2348ES-T1_GE3
QU1: Opamp_Quad; TSSOP-14_4.4x5mm_P0.65mm; Manufacturer_Part_Number LMV339IPWR; Mouser Part Number 595-LMV339IPWR
R1, R2, R3: 500k; RESC3216X70N; Manufacturer_Part_Number RK73H2BLTDD2152F; Mouser Part Number N/A
R4, R5, R6: 10k; RESC3216X70N; Manufacturer_Part_Number RK73H2BLTDD2152F; Mouser Part Number N/A
R7, R10: 82k; RESC3216X70N; Manufacturer_Part_Number RK73H2BLTDD2152F; Mouser Part Number N/A
R8, R9: 12k; RESC3216X70N; Manufacturer_Part_Number RK73H2BLTDD2152F; Mouser Part Number N/A
R11, R12: 500; RESC3216X70N; Manufacturer_Part_Number RK73H2BLTDD2152F; Mouser Part Number N/A
R15: 3k9; RESC3216X70N; Manufacturer_Part_Number RK73H2BLTDD2152F; Mouser Part Number N/A
R16, R17: 8k2; RESC3216X70N; Manufacturer_Part_Number RK73H2BLTDD2152F; Mouser Part Number N/A
R18: 100k; RESC3216X70N; Manufacturer_Part_Number RK73H2BLTDD2152F; Mouser Part Number N/A
U1: Alim LP TSR_0.5-2450; TSR-0.5-2433; Manufacturer_Part_Number TSR 0.5-2450; Mouser Part Number 495-TSR0.5-2450
U2: ${SIM.PARAMS}; SOT-353_SC-70-5_Handsoldering; Manufacturer_Part_Number TLV9061QDCKRQ1; Mouser Part Number 595-TLV9061QDCKRQ1

Connections:
+5V: C2.1, C3.2, C4.2, C5.2, C6.1, C7.1, C8.1, DU1.8 (V+), DU2.8 (V+), G1.5 (VCC), G2.5 (VCC), G3.5 (VCC), K2.1 (COIL1), K2.4 (COM_1), K2.6 (COIL2), K4.7 (COIL2), K4.9 (COM_2), K4.12 (COIL1), QU1.3 (V+), R4.1, R5.2, R6.1, R7.2, R9.2, R16.2, U1.3 (+VOUT), U2.5 (V+)
+12V: C1.2, J1.2, K1.5, K3.5, U1.1 (+VIN)
/0.75V: DU2.2 (-), QU1.4 (-), QU1.10 (-), R7.1, R8.2
/4.25V: DU2.5 (+), QU1.7 (+), QU1.9 (+), R9.1, R10.2
/AMS_OK: DU1.6 (-), DU1.7, G2.2, QU1.8 (-), QU1.11 (+)
/AMS_SCS_Compliance: G2.1, QU1.13, QU1.14, R5.1
/Button_Input: J7.2, K2.5 (Set_1), K4.8 (Set_2), R15.1, R18.1
/Button_Input_SCS: J7.3, R15.2, R16.1, R17.2
/Button_Output: DU2.3 (+), DU2.6 (-), G3.2, U2.3 (-), U2.4
/Button_Output_SCS_Compliance: DU2.1, DU2.7, G3.1, R4.2
/IMD_OK: DU1.2 (-), DU1.3, G1.1, QU1.5 (+), QU1.6 (-)
/IMD_SCS_Compliance: G1.2, QU1.1, QU1.2, R6.2
/Raw_AMS_OK: DU1.5 (+), J5.2, R3.1
/Raw_Button_Output: J7.1, R1.1, U2.1 (+)
/Raw_IMD_OK: DU1.1 (+), J4.2, R2.1
/SC in: J2.2, K1.4
/SC out: J3.2, K3.4
/SC_Closed_AMS: D5.2 (A), K4.10 (Reset_2), Q6.1
/SC_Closed_IMD: D4.2 (A), K2.3 (Reset_1), Q5.1
GND: C1.1, C2.2, C3.1, C4.1, C5.1, C6.2, C7.2, C8.2, D1.1 (K), D2.1 (K), D3.1 (K), D4.1 (K), D5.1 (K), DU1.4 (V-), DU2.4 (V-), G1.3 (GND), G2.3 (GND), G3.3 (GND), J1.1, J2.1, J3.1, J4.1, J5.1, J7.4, K2.8 (Set_2), K4.5 (Set_1), Q1.2, Q2.2, Q3.2, Q4.2, Q5.2, Q6.2, QU1.12 (V-), R1.2, R2.2, R3.2, R8.1, R10.1, R17.1, R18.2, U1.2 (GND), U2.2 (V-)
unnamed: D1.2 (A), G1.4, R11.1
unnamed: D2.2 (A), G3.4, Q2.1, Q4.1
unnamed: D3.2 (A), G2.4, R12.1
unnamed: K1.1, Q5.3
unnamed: K1.2, K3.2
unnamed: K2.12 (COIL1), Q1.3
unnamed: K2.7 (COIL2), Q2.3
unnamed: K2.9 (COM_2), R11.2
unnamed: K2.10 (Reset_2), Q1.1
unnamed: K3.1, Q6.3
unnamed: K4.1 (COIL1), Q3.3
unnamed: K4.6 (COIL2), Q4.3
unnamed: K4.4 (COM_1), R12.2
unnamed: K4.3 (Reset_1), Q3.1

Notes on the sheet:
Error signals SCS
Button SCS
Alimentation
SC Management
Main Circuit
Mouting Hole
Reset Button Management
SCS Voltage
Connecteurs

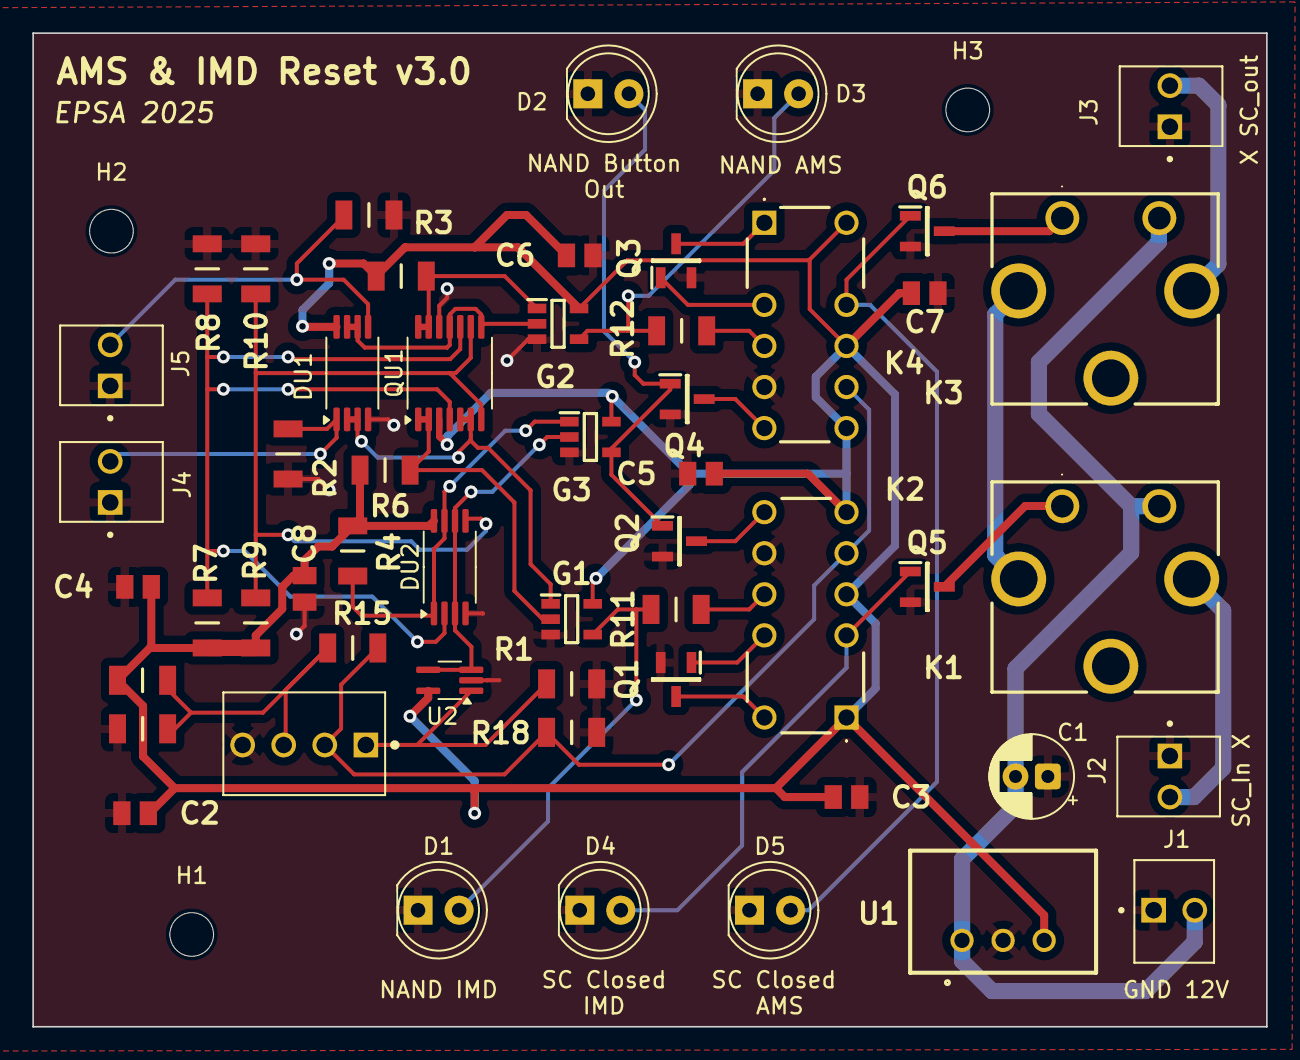
[picture p726: board AMS_IMD_Reset_v3.kicad_pcb from above]

Board: 2 copper layers, 76.3 x 61.5 mm, 56 parts (0 on the bottom side), 34 nets.
