EOSCogniton/ELIZ-2022/02 - Documentation/MODAC/Cartes Elec/BMS Slave/BMS_13_VF/BMS_13_VF/BMS_13_VF.kicad_pcb

## KiCad design 02 - Documentation/MODAC/Cartes Elec/BMS Slave/BMS_13_VF/BMS_13_VF/BMS_13_VF.kicad_pcb (2025-07-24)

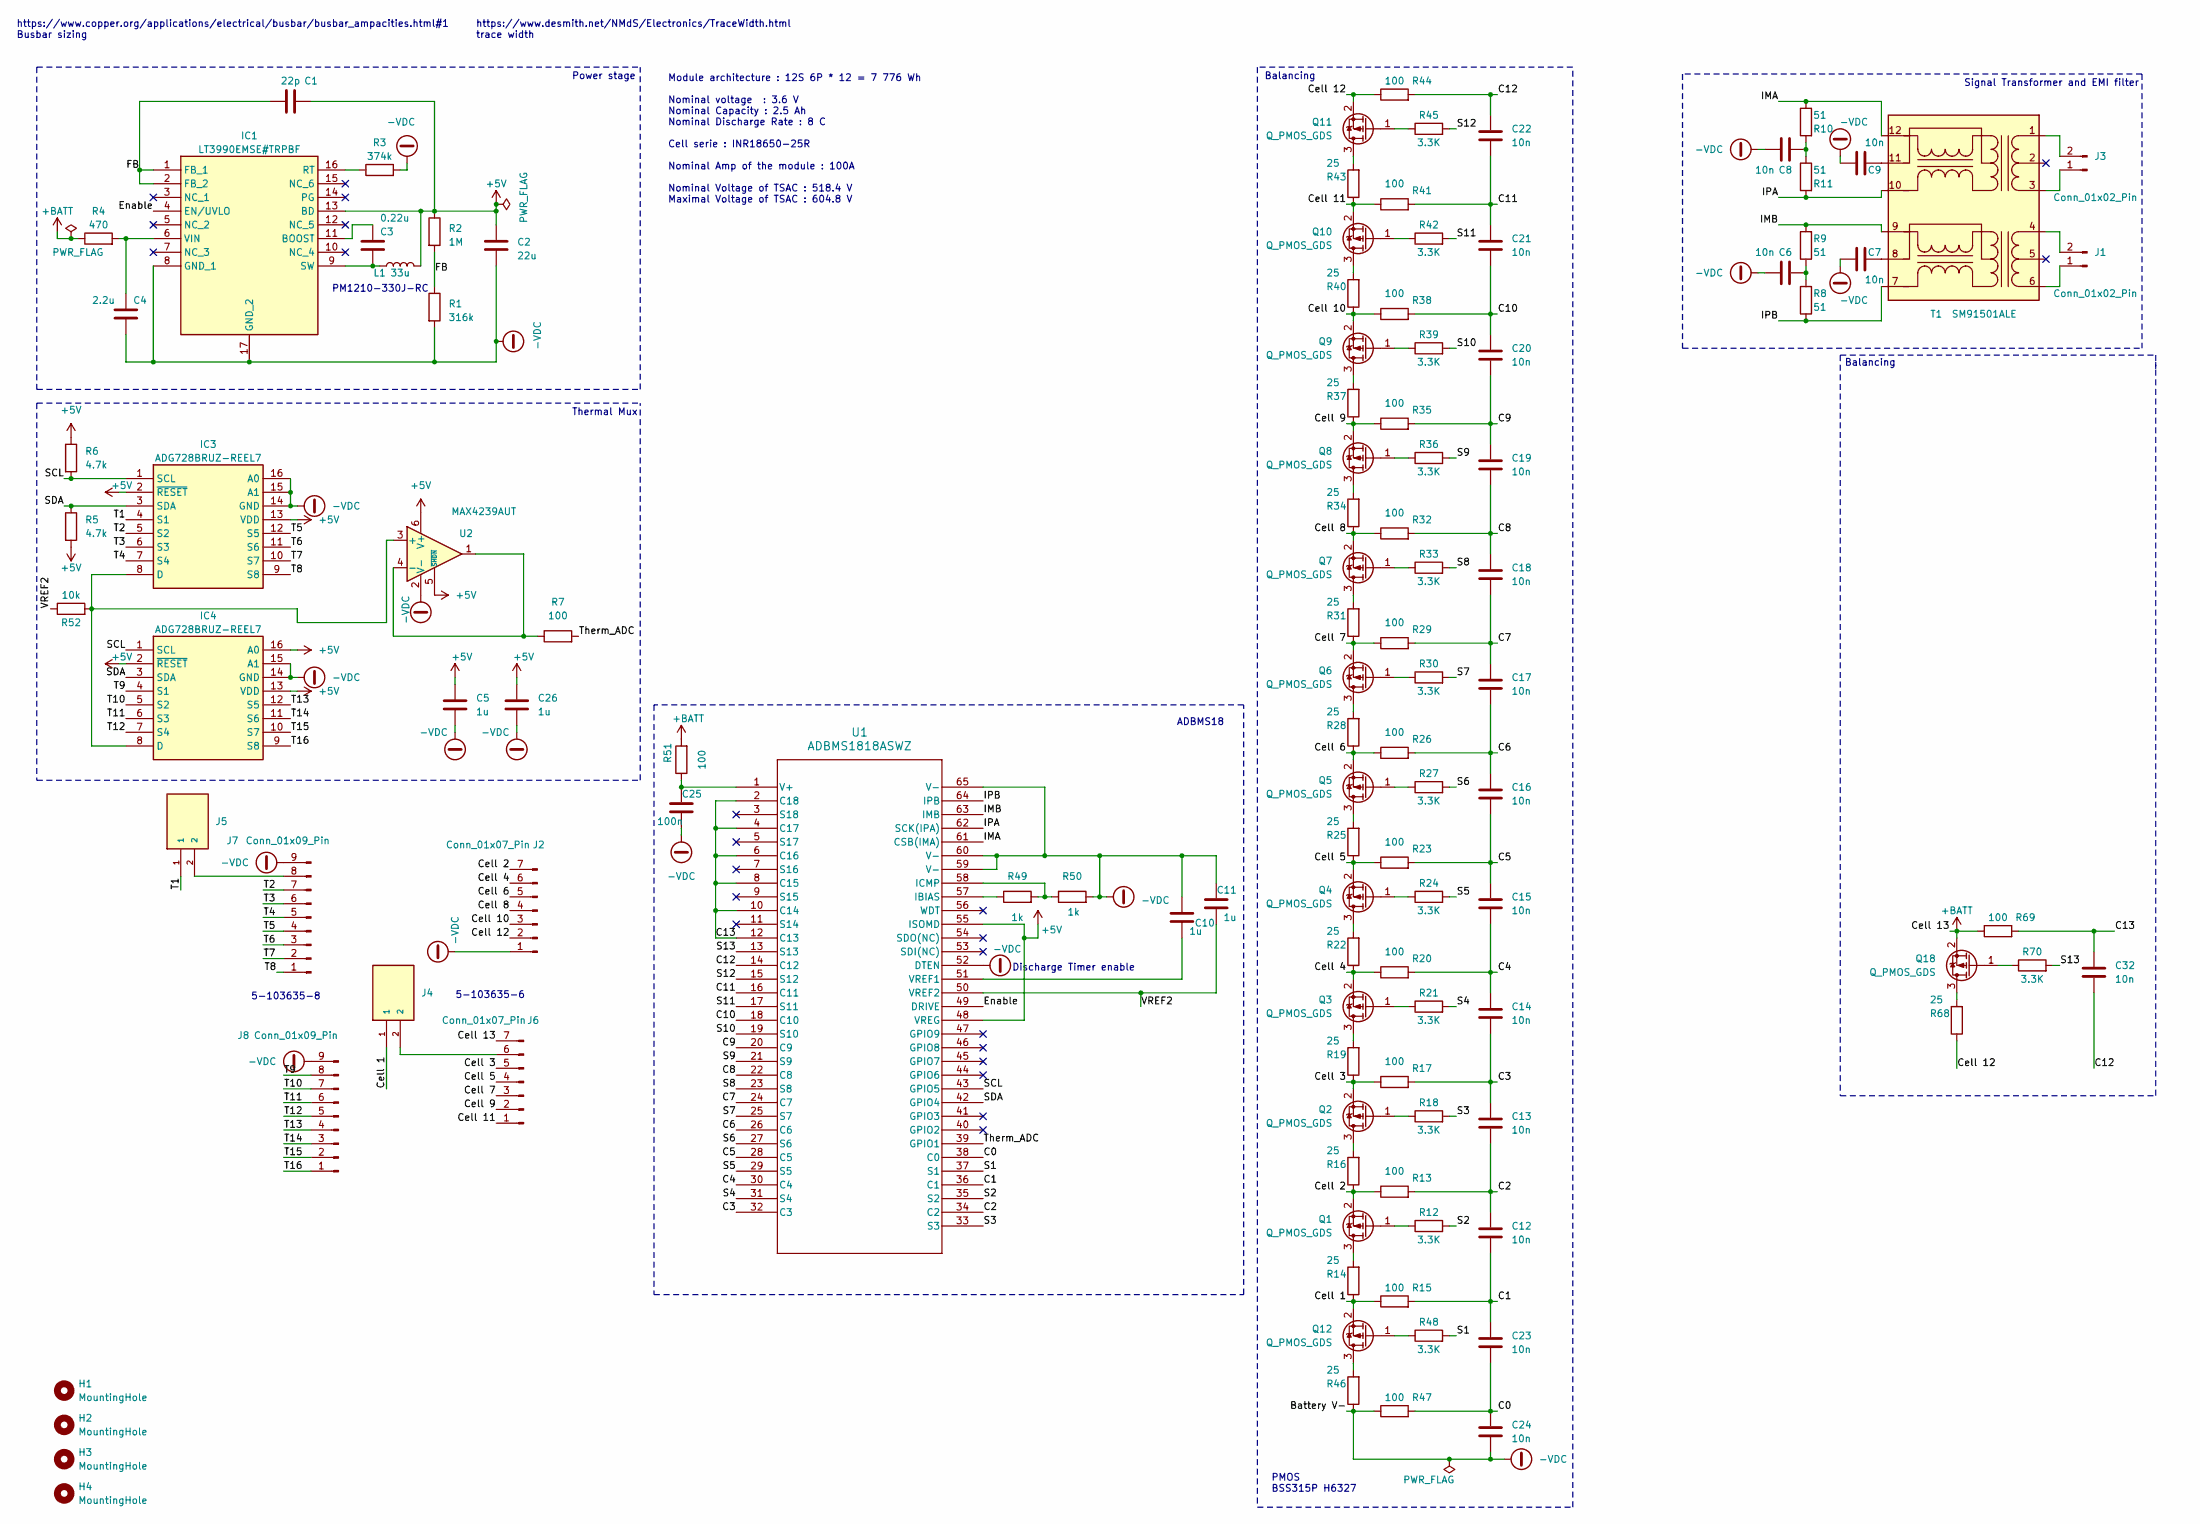
[picture p727: schematic BMS_13_VF.kicad_sch]

Parts:
C1: 22p; C_0805_2012Metric_Pad1.18x1.45mm_HandSolder
C2: 22u; C_0805_2012Metric_Pad1.18x1.45mm_HandSolder
C3: 0.22u; C_0805_2012Metric_Pad1.18x1.45mm_HandSolder
C4: 2.2u; C_0805_2012Metric_Pad1.18x1.45mm_HandSolder
C5, C10, C11, C26: 1u; C_0805_2012Metric_Pad1.18x1.45mm_HandSolder
C6, C7, C8, C9, C12, C13, C14, C15, C16, C17, C18, C19, C20, C21, C22, C23, C24, C32: 10n; C_0805_2012Metric_Pad1.18x1.45mm_HandSolder
C25: 100n; C_0805_2012Metric_Pad1.18x1.45mm_HandSolder
H1, H2, H3, H4: MountingHole; MountingHole_3.2mm_M3_DIN965_Pad
IC1: LT3990EMSE#TRPBF; SOP50P490X110-17N; Mouser Part Number 584-LT3990EMSE#TRPBF
IC3, IC4: ADG728BRUZ-REEL7; SOP65P640X120-16N; Mouser Part Number 584-ADG728BRUZ-R7
J1, J3: Conn_01x02_Pin; RHDR2W97P0X254_1X2_654X508X1379P
J2, J6: Conn_01x07_Pin; SHDRRA7W77P0X254_1X7_2032X1359X699P
J4, J5: 2P Droit 22-11-2022; MOLEX_22-11-2022; PARTREV BD8; Mouser Part Number 538-22-11-2022
J7, J8: Conn_01x09_Pin; SHDRRA9W69P0X254_1X9_2527X1359X741P
L1: 33u; L_1210_3225Metric_Pad1.42x2.65mm_HandSolder
Q1, Q2, Q3, Q4, Q5, Q6, Q7, Q8, Q9, Q10, Q11, Q12: Q_PMOS_GDS; SOT-23-3
Q18: Q_PMOS_GDS; SOT95P237X112-3N
R1: 316k; R_1206_3216Metric_Pad1.30x1.75mm_HandSolder
R2: 1M; R_1206_3216Metric_Pad1.30x1.75mm_HandSolder
R3: 374k; R_1206_3216Metric_Pad1.30x1.75mm_HandSolder
R4: 470; R_1206_3216Metric_Pad1.30x1.75mm_HandSolder
R5, R6: 4.7k; R_1206_3216Metric_Pad1.30x1.75mm_HandSolder
R7, R13, R15, R17, R20, R23, R26, R29, R32, R35, R38, R41, R44, R47, R51, R69: 100; R_1206_3216Metric_Pad1.30x1.75mm_HandSolder
R8, R9, R10, R11: 51; R_1206_3216Metric_Pad1.30x1.75mm_HandSolder
R12, R18, R21, R24, R27, R30, R33, R36, R39, R42, R45, R48, R70: 3.3K; R_1206_3216Metric_Pad1.30x1.75mm_HandSolder
R14, R16, R19, R22, R25, R28, R31, R34, R37, R40, R43, R46, R68: 25; R_2512_6332Metric_Pad1.40x3.35mm_HandSolder
R49, R50: 1k; R_1206_3216Metric_Pad1.30x1.75mm_HandSolder
R52: 10k; R_1206_3216Metric_Pad1.30x1.75mm_HandSolder
T1: SM91501ALE; SOP200P1473X500-12N; Mouser Part Number 652-SM91501ALE
U1: ADBMS1818ASWZ; 05-08-1982_ADI
U2: MAX4239AUT; SOT-23-6

Connections:
+5V: C1.2, C2.2, C5.1, C26.1, IC1.13 (BD), IC3.2 (~RESET), IC3.13 (VDD), IC4.2 (~RESET), IC4.13 (VDD), IC4.16 (A0), L1.2, R2.1, R5.2, R6.1, U1.48 (VREG), U1.55 (ISOMD), U2.5 (~SHDN), U2.6 (V+)
+BATT: J6.7, Q18.2 (S), R4.1, R51.2, R69.1
-VDC: C2.1, C4.1, C5.2, C6.1, C7.1, C8.1, C9.1, C10.1, C11.1, C24.2, C25.2, C26.2, IC1.8 (GND_1), IC1.17 (GND_2), IC3.14 (GND), IC3.15 (A1), IC3.16 (A0), IC4.14 (GND), IC4.15 (A1), J2.1, J7.9, J8.9, R1.2, R3.2, R46.1, R47.1, R50.2, U1.52 (DTEN), U1.59 (V-), U1.60 (V-), U1.65 (V-), U2.2 (V-)
/C0: C23.2, C24.1, R47.2, U1.38 (C0)
/C1: C12.2, C23.1, R15.2, U1.36 (C1)
/C2: C12.1, C13.2, R13.2, U1.34 (C2)
/C3: C13.1, C14.2, R17.2, U1.32 (C3)
/C4: C14.1, C15.2, R20.2, U1.30 (C4)
/C5: C15.1, C16.2, R23.2, U1.28 (C5)
/C6: C16.1, C17.2, R26.2, U1.26 (C6)
/C7: C17.1, C18.2, R29.2, U1.24 (C7)
/C8: C18.1, C19.2, R32.2, U1.22 (C8)
/C9: C19.1, C20.2, R35.2, U1.20 (C9)
/C10: C20.1, C21.2, R38.2, U1.18 (C10)
/C11: C21.1, C22.2, R41.2, U1.16 (C11)
/C12: C22.1, C32.2, R44.2, U1.14 (C12)
/C13: C32.1, R69.2, U1.2 (C18), U1.4 (C17), U1.6 (C16), U1.8 (C15), U1.10 (C14), U1.12 (C13)
/Cell 1: J4.1, Q12.2 (S), R14.1, R15.1
/Cell 2: J2.7, Q1.2 (S), R13.1, R16.1
/Cell 3: J6.5, Q2.2 (S), R17.1, R19.1
/Cell 4: J2.6, Q3.2 (S), R20.1, R22.1
/Cell 5: J6.4, Q4.2 (S), R23.1, R25.1
/Cell 6: J2.5, Q5.2 (S), R26.1, R28.1
/Cell 7: J6.3, Q6.2 (S), R29.1, R31.1
/Cell 8: J2.4, Q7.2 (S), R32.1, R34.1
/Cell 9: J6.2, Q8.2 (S), R35.1, R37.1
/Cell 10: J2.3, Q9.2 (S), R38.1, R40.1
/Cell 11: J6.1, Q10.2 (S), R41.1, R43.1
/Cell 12: J2.2, Q11.2 (S), R44.1, R68.1
/Enable: IC1.4 (EN/UVLO), U1.49 (DRIVE)
/FB: C1.1, IC1.1 (FB_1), IC1.2 (FB_2), R1.1, R2.2
/IMA: R10.1, T1.12 (SEC1_3), U1.61 (CSB(IMA))
/IMB: R9.2, T1.9 (SEC2_3), U1.63 (IMB)
/IPA: R11.2, T1.10 (SEC1_1), U1.62 (SCK(IPA))
/IPB: R8.1, T1.7 (SEC2_1), U1.64 (IPB)
/S1: R48.2, U1.37 (S1)
/S2: R12.2, U1.35 (S2)
/S3: R18.2, U1.33 (S3)
/S4: R21.2, U1.31 (S4)
/S5: R24.2, U1.29 (S5)
/S6: R27.2, U1.27 (S6)
/S7: R30.2, U1.25 (S7)
/S8: R33.2, U1.23 (S8)
/S9: R36.2, U1.21 (S9)
/S10: R39.2, U1.19 (S10)
/S11: R42.2, U1.17 (S11)
/S12: R45.2, U1.15 (S12)
/S13: R70.2, U1.13 (S13)
/SCL: IC3.1 (SCL), IC4.1 (SCL), R6.2, U1.43 (GPIO5)
/SDA: IC3.3 (SDA), IC4.3 (SDA), R5.1, U1.42 (GPIO4)
/T1: IC3.4 (S1), J5.1
/T2: IC3.5 (S2), J7.7
/T3: IC3.6 (S3), J7.6
/T4: IC3.7 (S4), J7.5
/T5: IC3.12 (S5), J7.4
/T6: IC3.11 (S6), J7.3
/T7: IC3.10 (S7), J7.2
/T8: IC3.9 (S8), J7.1
/T9: IC4.4 (S1), J8.8
/T10: IC4.5 (S2), J8.7
/T11: IC4.6 (S3), J8.6
/T12: IC4.7 (S4), J8.5
/T13: IC4.12 (S5), J8.4
/T14: IC4.11 (S6), J8.3
/T15: IC4.10 (S7), J8.2
/T16: IC4.9 (S8), J8.1
/Therm_ADC: R7.2, U1.39 (GPIO1)
/VREF2: C11.2, R52.1, U1.50 (VREF2)
unnamed: C6.2, R8.2, R9.1
unnamed: C8.2, R10.2, R11.1
unnamed: C3.2, IC1.11 (BOOST)
unnamed: IC1.16 (RT), R3.1
unnamed: C3.1, IC1.9 (SW), L1.1
unnamed: C4.2, IC1.6 (VIN), R4.2
unnamed: IC3.8 (D), IC4.8 (D), R52.2, U2.3 (+)
unnamed: J1.1, T1.6 (PRI2_3)
unnamed: J1.2, T1.4 (PRI2_1)
unnamed: J3.1, T1.3 (PRI1_3)
unnamed: J3.2, T1.1 (PRI1_1)
unnamed: J4.2, J6.6
unnamed: J5.2, J7.8
unnamed: Q1.3 (D), R14.2
unnamed: Q1.1 (G), R12.1
unnamed: Q2.3 (D), R16.2
unnamed: Q2.1 (G), R18.1
unnamed: Q3.3 (D), R19.2
unnamed: Q3.1 (G), R21.1
unnamed: Q4.3 (D), R22.2
unnamed: Q4.1 (G), R24.1
unnamed: Q5.3 (D), R25.2
unnamed: Q5.1 (G), R27.1
unnamed: Q6.3 (D), R28.2
unnamed: Q6.1 (G), R30.1
unnamed: Q7.3 (D), R31.2
unnamed: Q7.1 (G), R33.1
unnamed: Q8.3 (D), R34.2
unnamed: Q8.1 (G), R36.1
unnamed: Q9.3 (D), R37.2
unnamed: Q9.1 (G), R39.1
unnamed: Q10.3 (D), R40.2
unnamed: Q10.1 (G), R42.1
unnamed: Q11.3 (D), R43.2
unnamed: Q11.1 (G), R45.1
unnamed: Q12.3 (D), R46.2
unnamed: Q12.1 (G), R48.1
unnamed: Q18.3 (D), R68.2
unnamed: Q18.1 (G), R70.1
unnamed: C9.2, T1.11 (SEC1_2)
unnamed: C7.2, T1.8 (SEC2_2)
unnamed: R49.1, U1.57 (IBIAS)
unnamed: R49.2, R50.1, U1.58 (ICMP)
unnamed: C25.1, R51.1, U1.1 (V+)
unnamed: C10.2, U1.51 (VREF1)
unnamed: R7.1, U2.1, U2.4 (-)

Notes on the sheet:
Module architecture : 12S 6P * 12 = 7 776 Wh Nominal voltage : 3.6 V Nominal Capacity : 2.5 Ah Nominal Discharge Rate : 8 C Cell serie : INR18650-25R Nominal Amp of the module : 100A Nominal Voltage of TSAC : 518.4 V Maximal Voltage of TSAC : 604.8 V
PMOS BSS315P H6327
PM1210-330J-RC
Balancing
Thermal Mux
Power stage
Signal Transformer and EMI filter
ADBMS18
https://www.desmith.net/NMdS/Electronics/TraceWidth.html trace width
5-103635-8
https://www.copper.org/applications/electrical/busbar/busbar_ampacities.html#1 Busbar sizing
5-103635-6
Discharge Timer enable

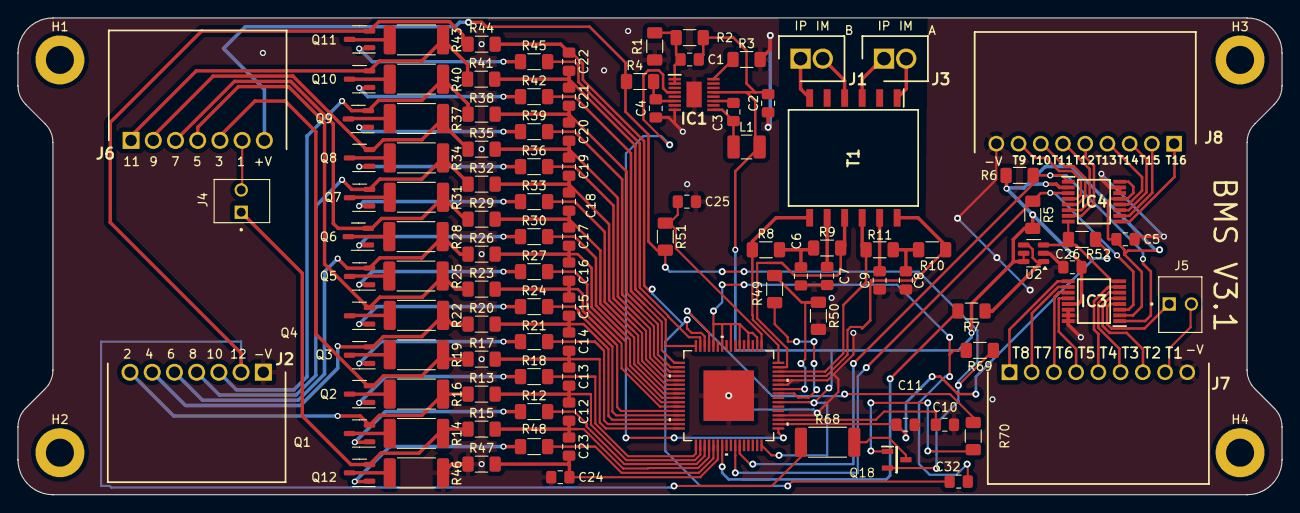
[picture p728: board BMS_13_VF.kicad_pcb from above]

Board: 2 copper layers, 144.5 x 54.5 mm, 114 parts (0 on the bottom side), 114 nets.
