EOSCogniton/ELIZ-2022/02 - Documentation/BASTIE/Cartes Artemiz/JLCPCB-ver/SCS IMD-AMD-indicator/SCS IMD-AMD-indicator.kicad_pcb

## KiCad design 02 - Documentation/BASTIE/Cartes Artemiz/JLCPCB-ver/SCS IMD-AMD-indicator/SCS IMD-AMD-indicator.kicad_pcb (2025-06-25)

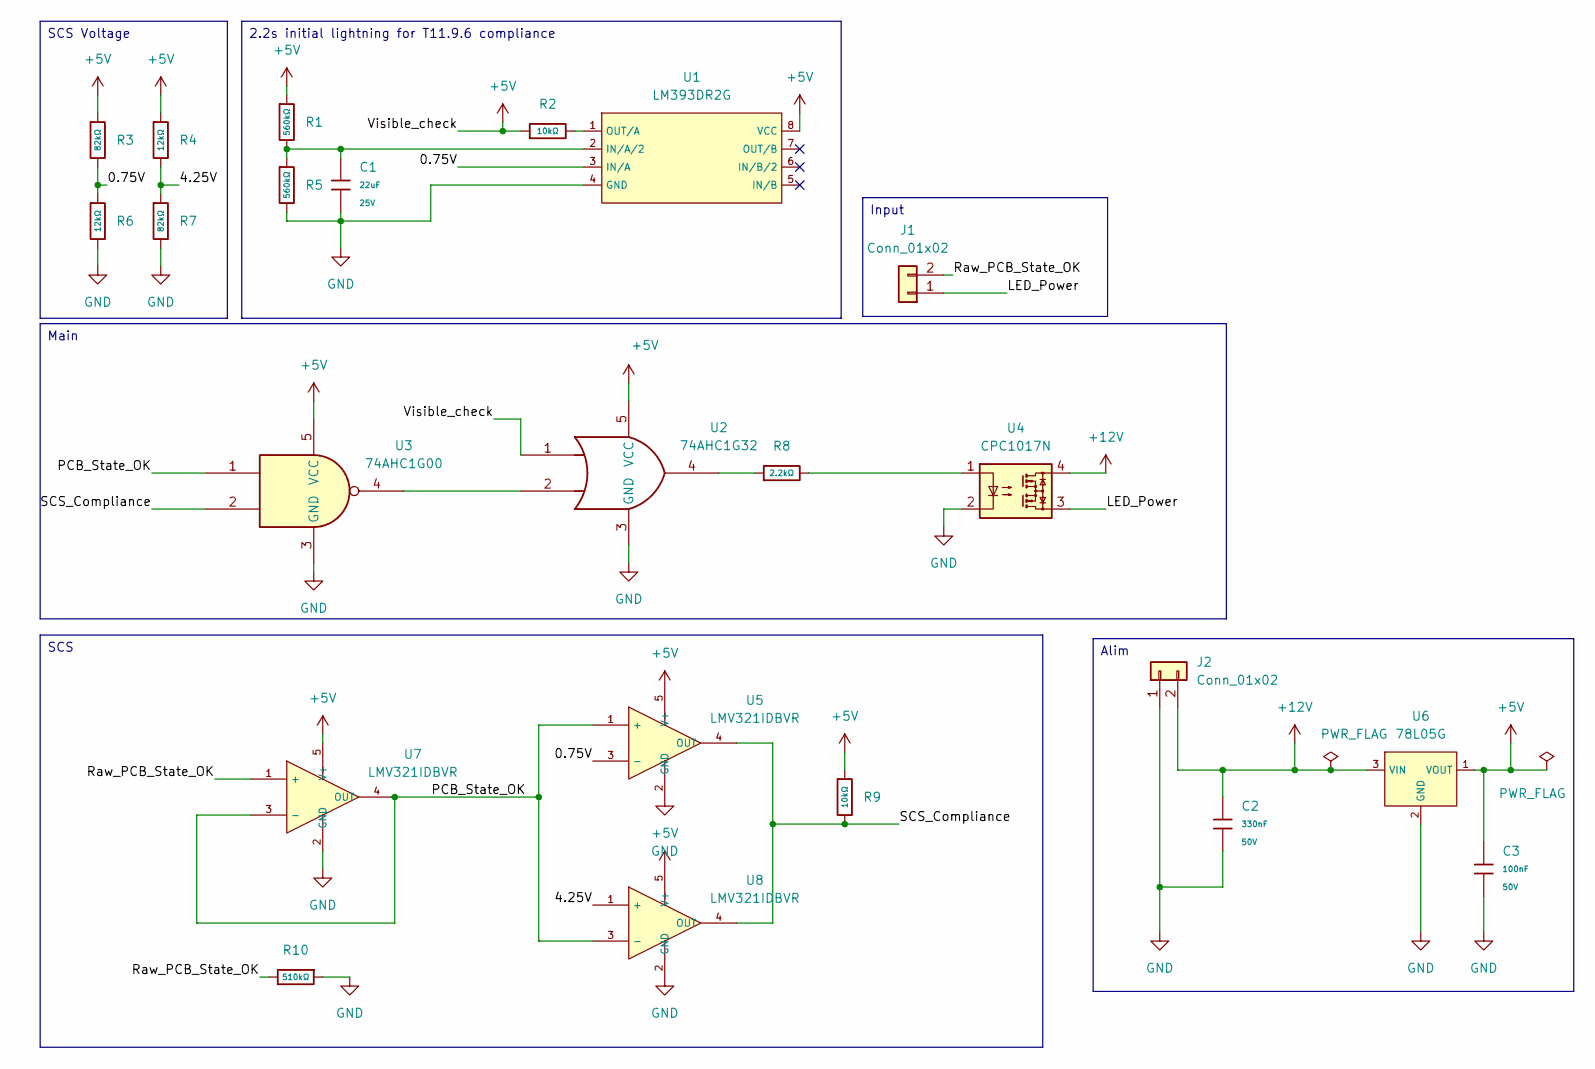
[picture p729: schematic SCS IMD-AMD-indicator.kicad_sch]

Parts:
C1: 22uF; C_0805; Voltage Rated 25V; Tolerance ±20%; Part CL21A226MAQNNNE; LCSC C45783
C2: 330nF; C_0805; Voltage Rated 50V; Tolerance ±10%; Part 0805B334K500NT; LCSC C1740
C3: 100nF; C_0805; Voltage Rated 50V; Tolerance ±10%; Part CC0805KRX7R9BB104; LCSC C49678
J1, J2: Conn_01x02; Molex_KK-254_AE-6410-02A_1x02_P2.54mm_Vertical
R1, R5: 560kΩ; R_0603; Overload Voltage (Max) 75V; Tolerance ±1%; Part 0603WAF5603T5E; LCSC C23203
R2, R9: 10kΩ; R_0805; Overload Voltage (Max) 150V; Tolerance ±1%; Part 0805W8F1002T5E; LCSC C17414
R3, R7: 82kΩ; R_0805; Overload Voltage (Max) 150V; Tolerance ±1%; Part 0805W8F8202T5E; LCSC C17840
R4, R6: 12kΩ; R_0805; Overload Voltage (Max) 150V; Tolerance ±1%; Part 0805W8F1202T5E; LCSC C17444
R8: 2.2kΩ; R_0805; Overload Voltage (Max) 150V; Tolerance ±1%; Part 0805W8F2201T5E; LCSC C17520
R10: 510kΩ; R_0805; Overload Voltage (Max) 150V; Tolerance ±1%; Part 0805W8F5103T5E; LCSC C17733
U1: LM393DR2G; SOIC-8_L5.0-W4.0-P1.27-LS6.0-BL; Supply Voltage 2V~36V;1V~18V; Part LM393DR2G; LCSC C7955
U2: 74AHC1G32; SC-74A-5_1.55x2.9mm_P0.95mm
U3: 74AHC1G00; SOT-23-5_L3.0-W1.7-P0.95-LS2.8-BR
U4: CPC1017N; SOP-4_3.8x4.1mm_P2.54mm
U5, U7, U8: LMV321IDBVR; SOT-23-5_L3.0-W1.7-P0.95-LS2.8-BR; Part LMV321IDBVR; LCSC C7972
U6: 78L05G; SOT-89-3_L4.5-W2.5-P1.50-LS4.2-BR; Output Voltage 5V; Dropout Voltage 1.7V@(40mA); Part 78L05G-AB3-R; LCSC C71136

Connections:
+5V: C3.1, R1.1, R2.1, R3.1, R4.1, R9.1, U1.8 (VCC), U2.1, U2.5 (VCC), U3.5 (VCC), U5.5 (V+), U6.1 (VOUT), U7.5 (V+), U8.5 (V+)
+12V: C2.1, J2.2, U4.4, U6.3 (VIN)
/0.75V: R3.2, R6.1, U1.3 (IN/A), U5.3 (-)
/4.25V: R4.2, R7.1, U8.1 (+)
/LED_Power: J1.1, U4.3
/PCB_State_OK: U3.1, U5.1 (+), U7.3 (-), U7.4 (OUT), U8.3 (-)
/Raw_PCB_State_OK: J1.2, R10.2, U7.1 (+)
/SCS_Compliance: R9.2, U3.2, U5.4 (OUT), U8.4 (OUT)
GND: C1.2, C2.2, C3.2, J2.1, R5.2, R6.2, R7.2, R10.1, U1.4 (GND), U2.3 (GND), U3.3 (GND), U4.2, U5.2 (GND), U6.2 (GND), U7.2 (GND), U8.2 (GND)
unnamed: R8.1, U2.4
unnamed: R8.2, U4.1
unnamed: C1.1, R1.2, R5.1, U1.2 (IN/A/2)
unnamed: R2.2, U1.1 (OUT/A)
unnamed: U2.2, U3.4

Notes on the sheet:
Main
Input
2.2s initial lightning for T11.9.6 compliance
SCS Voltage
Alim
SCS

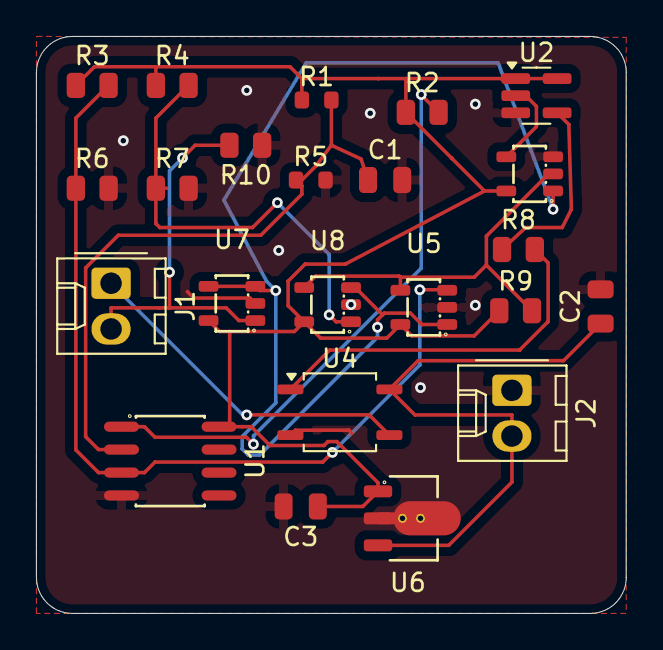
[picture p730: board SCS IMD-AMD-indicator.kicad_pcb from above]

Board: 2 copper layers, 32.8 x 32.1 mm, 23 parts (0 on the bottom side), 14 nets.
