EOSCogniton/ELIZ-2022/02 - Documentation/MODAC/Cartes Elec/Temp_Sensor_Cx/Temp_Sensor_Circuit_Side1/Temp_Sensor_Circuit.kicad_pcb

## KiCad design 02 - Documentation/MODAC/Cartes Elec/Temp_Sensor_Cx/Temp_Sensor_Circuit_Side1/Temp_Sensor_Circuit.kicad_pcb (2025-06-09)

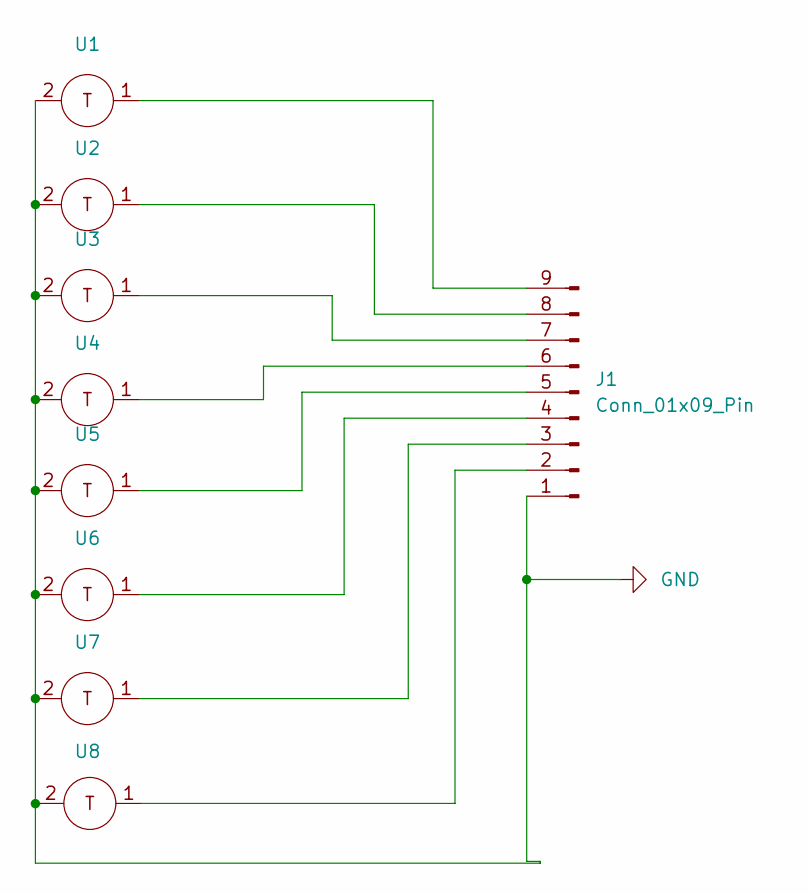
[picture p731: schematic Temp_Sensor_Circuit.kicad_sch]

Parts:
J1: Conn_01x09_Pin; PinHeader_1x09_P2.54mm_Vertical_SMD_Pin1Left
U1, U2, U3, U4, U5, U6, U7, U8: thermistor

Connections:
GND: J1.1, U1.2, U2.2, U3.2, U4.2, U5.2, U6.2, U7.2, U8.2
unnamed: J1.2, U8.1
unnamed: J1.3, U7.1
unnamed: J1.4, U6.1
unnamed: J1.5, U5.1
unnamed: J1.6, U4.1
unnamed: J1.7, U3.1
unnamed: J1.8, U2.1
unnamed: J1.9, U1.1

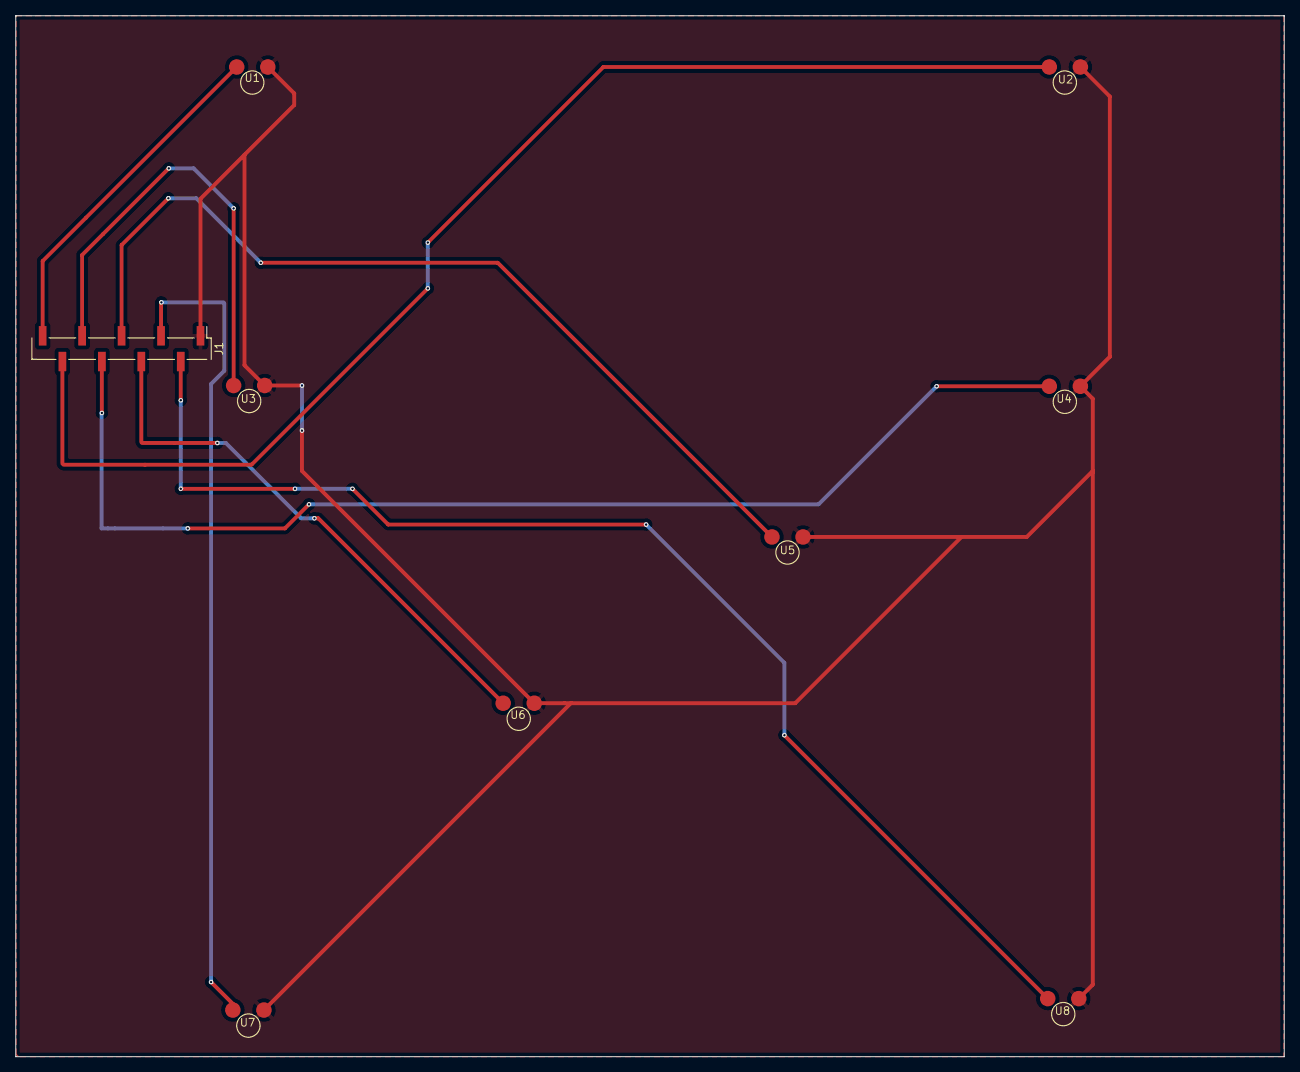
[picture p732: board Temp_Sensor_Circuit.kicad_pcb from above]

Board: 2 copper layers, 163.3 x 134.0 mm, 9 parts (0 on the bottom side), 9 nets.
