EOSCogniton/ELIZ-2022/02 - Documentation/MODAC/Cartes Elec/Temp_Sensor_Cx/Temp_Sensor_Circuit_Side2/Temp_Sensor_Circuit_Side2.kicad_pcb

## KiCad design 02 - Documentation/MODAC/Cartes Elec/Temp_Sensor_Cx/Temp_Sensor_Circuit_Side2/Temp_Sensor_Circuit_Side2.kicad_pcb (2025-06-09)

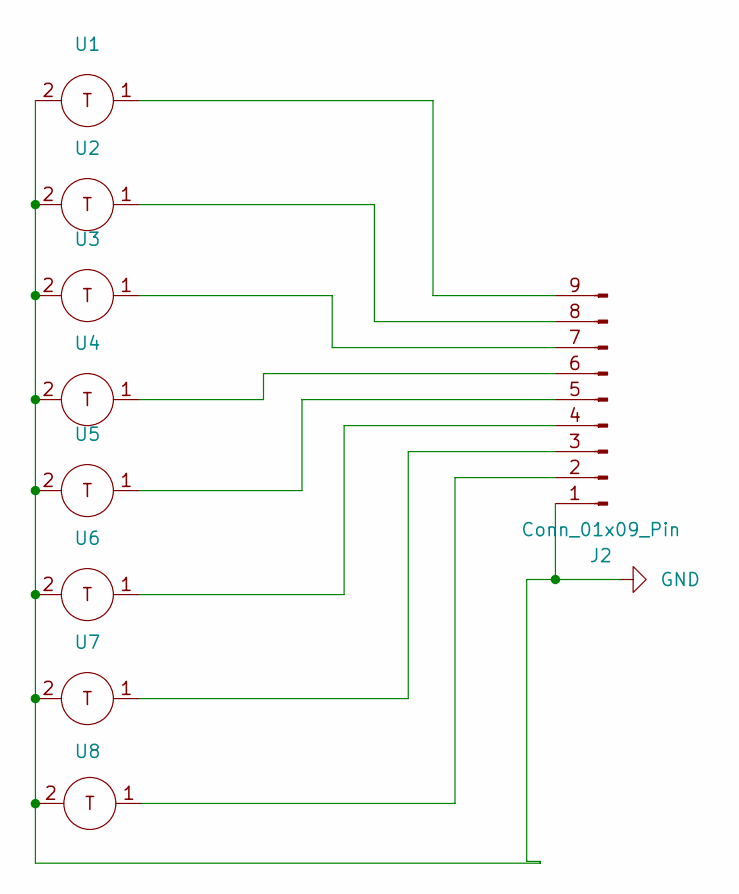
[picture p733: schematic Temp_Sensor_Circuit_Side2.kicad_sch]

Parts:
J2: Conn_01x09_Pin; PinHeader_1x09_P2.54mm_Vertical_SMD_Pin1Left
U1, U2, U3, U4, U5, U6, U7, U8: therm

Connections:
GND: J2.1, U1.2, U2.2, U3.2, U4.2, U5.2, U6.2, U7.2, U8.2
unnamed: J2.2, U8.1
unnamed: J2.3, U7.1
unnamed: J2.4, U6.1
unnamed: J2.5, U5.1
unnamed: J2.6, U4.1
unnamed: J2.7, U3.1
unnamed: J2.8, U2.1
unnamed: J2.9, U1.1

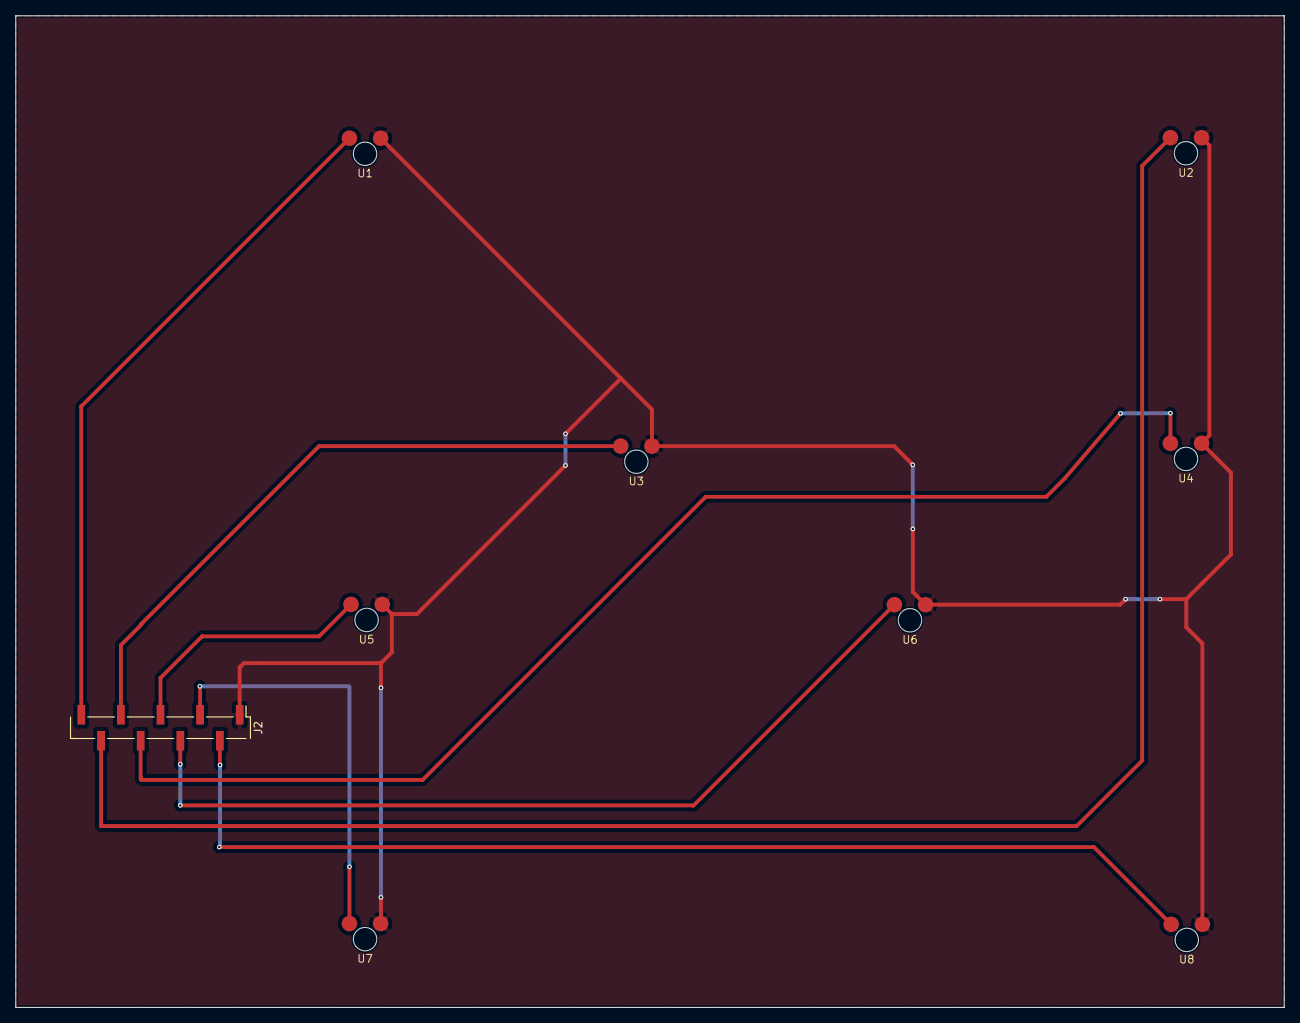
[picture p734: board Temp_Sensor_Circuit_Side2.kicad_pcb from above]

Board: 2 copper layers, 162.7 x 127.2 mm, 9 parts (0 on the bottom side), 9 nets.
