EOSCogniton/ELIZ-2022/02 - Documentation/BASTIE/Cartes Artemiz/JLCPCB-ver/SCS Maker/SCS-maker/SCS-maker.kicad_pcb

## KiCad design 02 - Documentation/BASTIE/Cartes Artemiz/JLCPCB-ver/SCS Maker/SCS-maker/SCS-maker.kicad_pcb (2025-04-29)

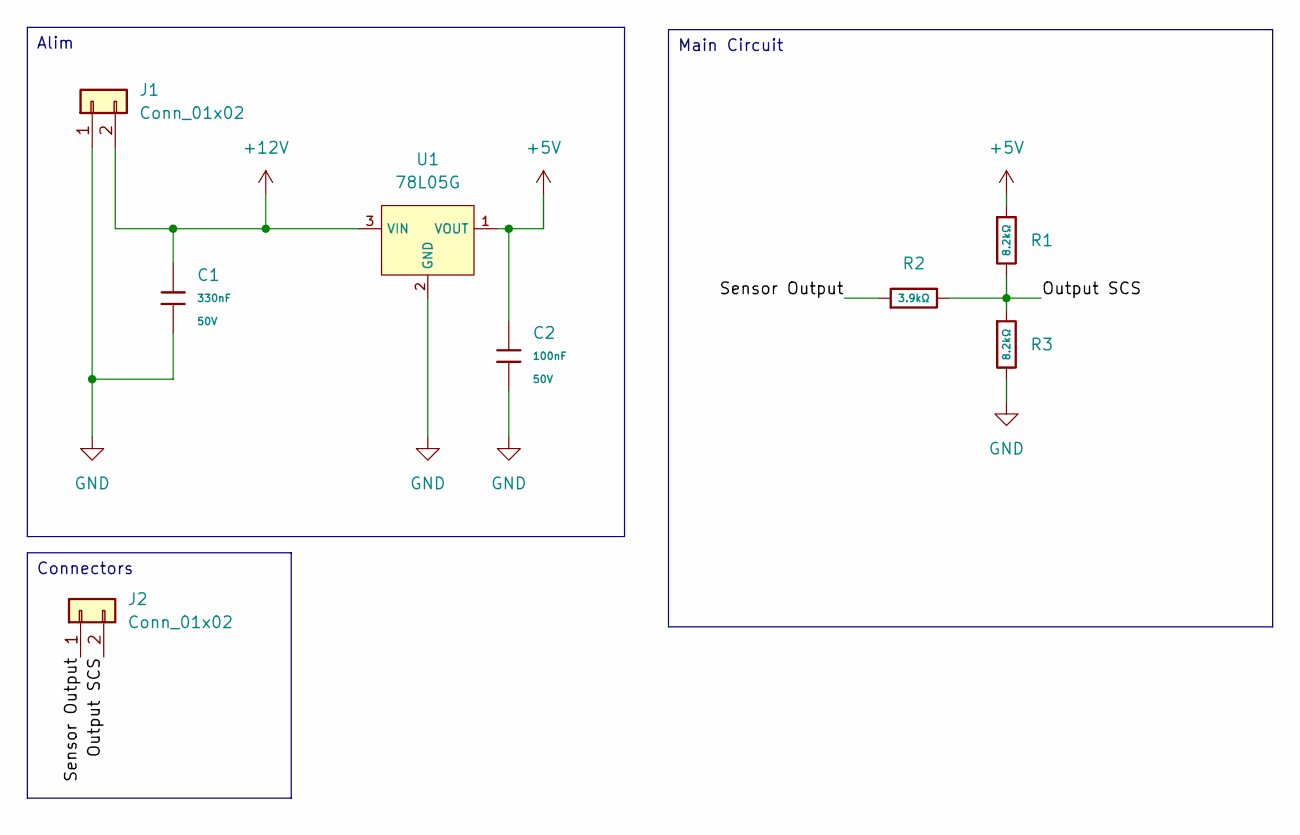
[picture p735: schematic SCS-maker.kicad_sch]

Parts:
C1: 330nF; C_0805; Voltage Rated 50V; Tolerance ±10%; Part 0805B334K500NT; LCSC C1740
C2: 100nF; C_0805; Voltage Rated 50V; Tolerance ±10%; Part CC0805KRX7R9BB104; LCSC C49678
J1, J2: Conn_01x02; Molex_KK-254_AE-6410-02A_1x02_P2.54mm_Vertical
R1, R3: 8.2kΩ; R_0805; Overload Voltage (Max) 150V; Tolerance ±1%; Part 0805W8F8201T5E; LCSC C17828
R2: 3.9kΩ; R_0805; Overload Voltage (Max) 150V; Tolerance ±1%; Part 0805W8F3901T5E; LCSC C17614
U1: 78L05G; SOT-89-3_L4.5-W2.5-P1.50-LS4.2-BR; Output Voltage 5V; Dropout Voltage 1.7V@(40mA); Part 78L05G-AB3-R; LCSC C71136

Connections:
+5V: C2.1, R1.1, U1.1 (VOUT)
+12V: C1.1, J1.2, U1.3 (VIN)
/Output SCS: J2.2, R1.2, R2.2, R3.1
/Sensor Output: J2.1, R2.1
GND: C1.2, C2.2, J1.1, R3.2, U1.2 (GND)

Notes on the sheet:
Connectors
Main Circuit
Alim

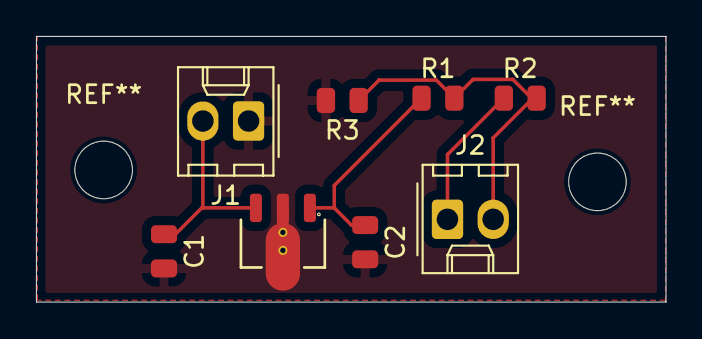
[picture p736: board SCS-maker.kicad_pcb from above]

Board: 2 copper layers, 35.0 x 14.8 mm, 8 parts (0 on the bottom side), 5 nets.
