EOSCogniton/ELIZ-2022/03 - H901BENCH/BENCH 1/Controle_banc/Controle_banc.kicad_pcb

## KiCad design 03 - H901BENCH/BENCH 1/Controle_banc/Controle_banc.kicad_pcb (2025-03-06)

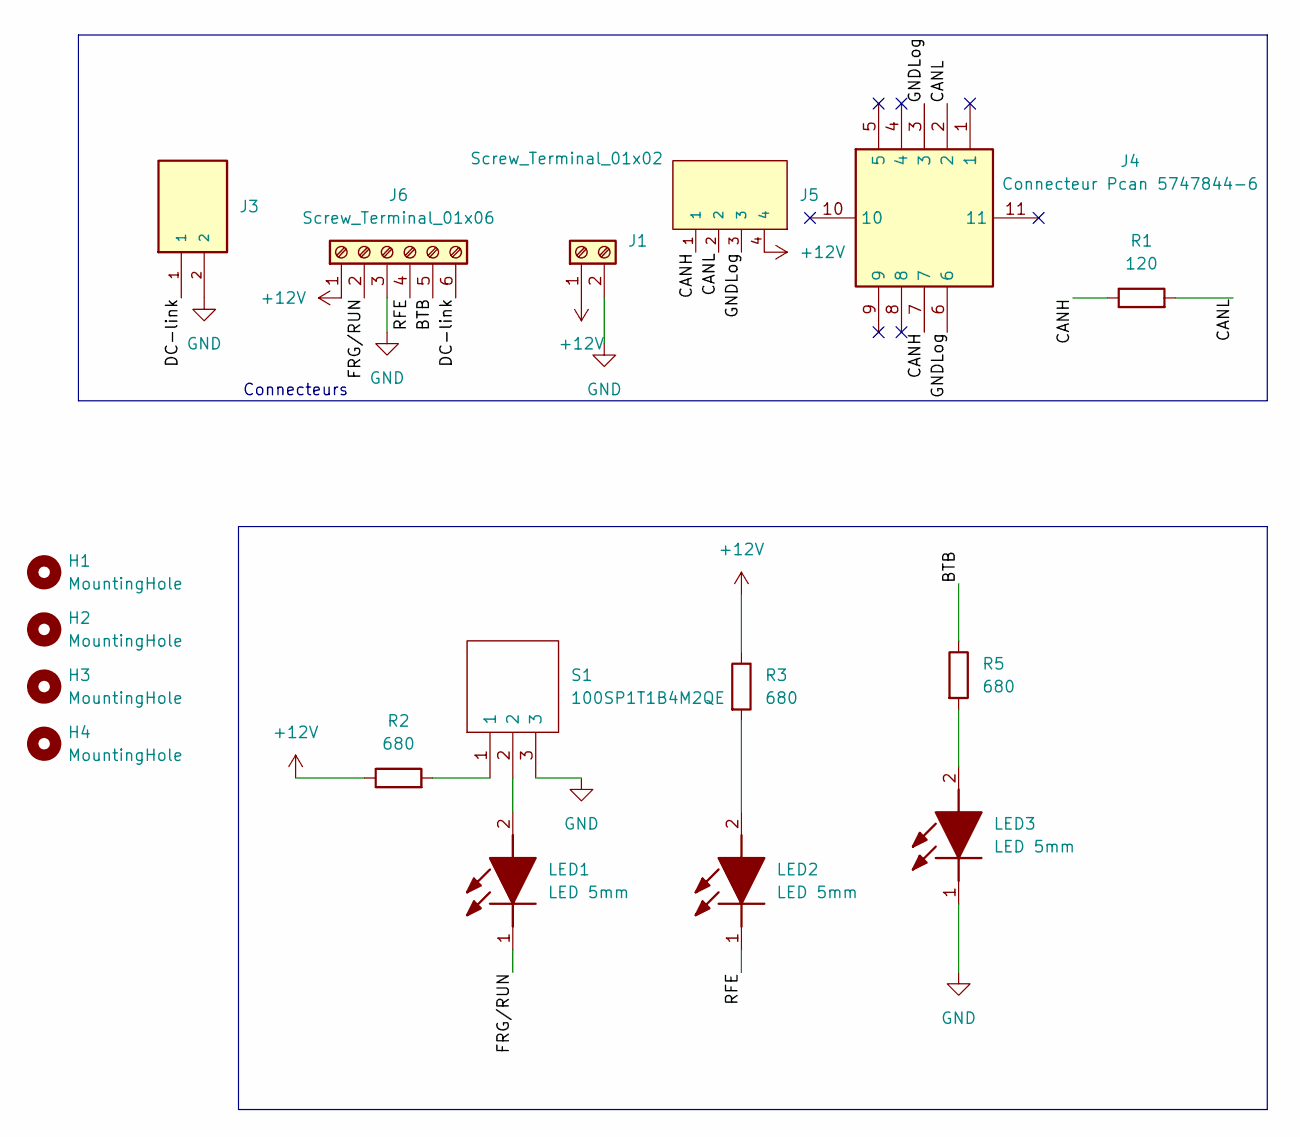
[picture p737: schematic Controle_banc.kicad_sch]

Parts:
H1, H2, H3, H4: MountingHole; MountingHole_4mm
J1: Screw_Terminal_01x02; TerminalBlock_bornier-2_P5.08mm
J3: 2P Droit 22-11-2022; MOLEX_22-11-2022; Manufacturer_Part_Number 22-11-2022; Mouser Part Number 538-22-11-2022
J4: Connecteur Pcan 5747844-6; 57478446; Mouser Part Number 571-5747844-6
J5: 4P Droit 22-11-2042; MOLEX_22-11-2042; Manufacturer_Part_Number 22-11-2042; Mouser Part Number 538-22-11-2042
J6: Screw_Terminal_01x06; TerminalBlock_bornier-6_P5.08mm
LED1, LED2, LED3: LED 5mm; 4302H55V; Mouser Part Number 606-4302H5-5V
R1: 120; R_Axial_DIN0207_L6.3mm_D2.5mm_P10.16mm_Horizontal
R2, R3, R5: 680; R_Axial_DIN0207_L6.3mm_D2.5mm_P10.16mm_Horizontal
S1: 100SP1T1B4M2QE; Mouser Part Number 612-100-A1421

Connections:
+12V: J1.1, J5.4, J6.1, R2.1, R3.1
/BTB: J6.5, R5.1
/CANH: J4.7, J5.1, R1.1
/CANL: J4.2, J5.2, R1.2
/DC-link: J3.1, J6.6
/FRG/RUN: J6.2, LED1.1 (K)
/GNDLog: J4.3, J4.6, J5.3
/RFE: J6.4, LED2.1 (K)
GND: J1.2, J3.2, J6.3, LED3.1 (K), S1.3
unnamed: LED1.2 (A), S1.2
unnamed: LED2.2 (A), R3.2
unnamed: LED3.2 (A), R5.2
unnamed: R2.2, S1.1

Notes on the sheet:
Connecteurs

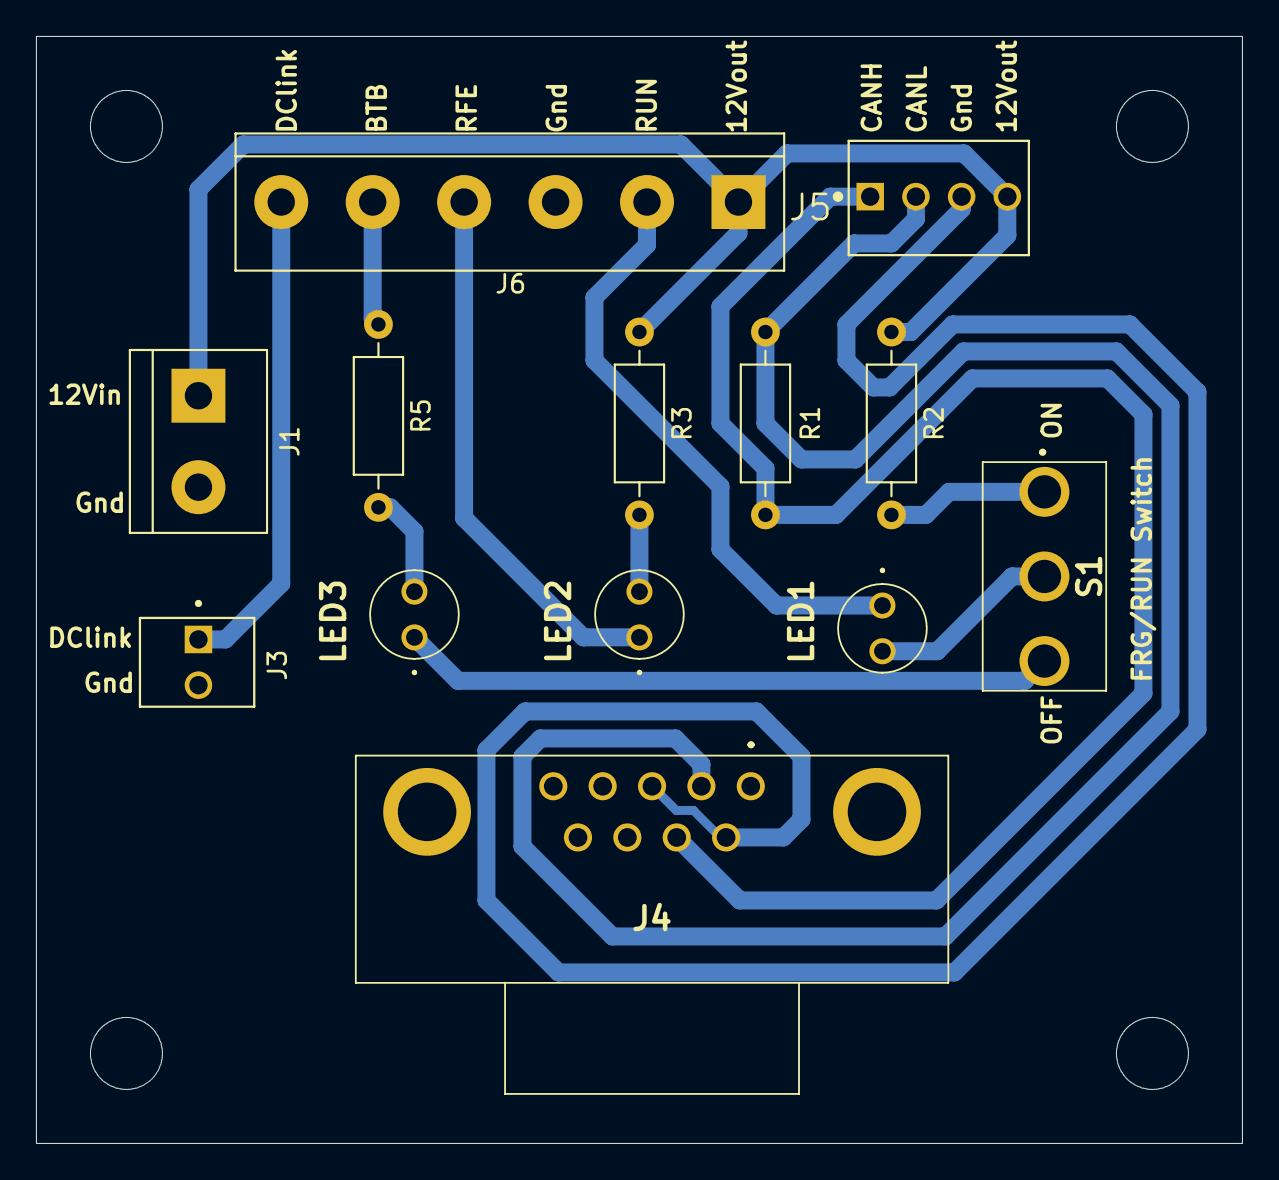
[picture p738: board Controle_banc.kicad_pcb from above]

Board: 2 copper layers, 67.0 x 61.5 mm, 17 parts (0 on the bottom side), 13 nets.
