EOSCogniton/ELIZ-2022/02 - Documentation/MODAC/Cartes Elec/BMS_testboard/BMS_testboard.kicad_pcb

## KiCad design 02 - Documentation/MODAC/Cartes Elec/BMS_testboard/BMS_testboard.kicad_pcb (2025-03-06)

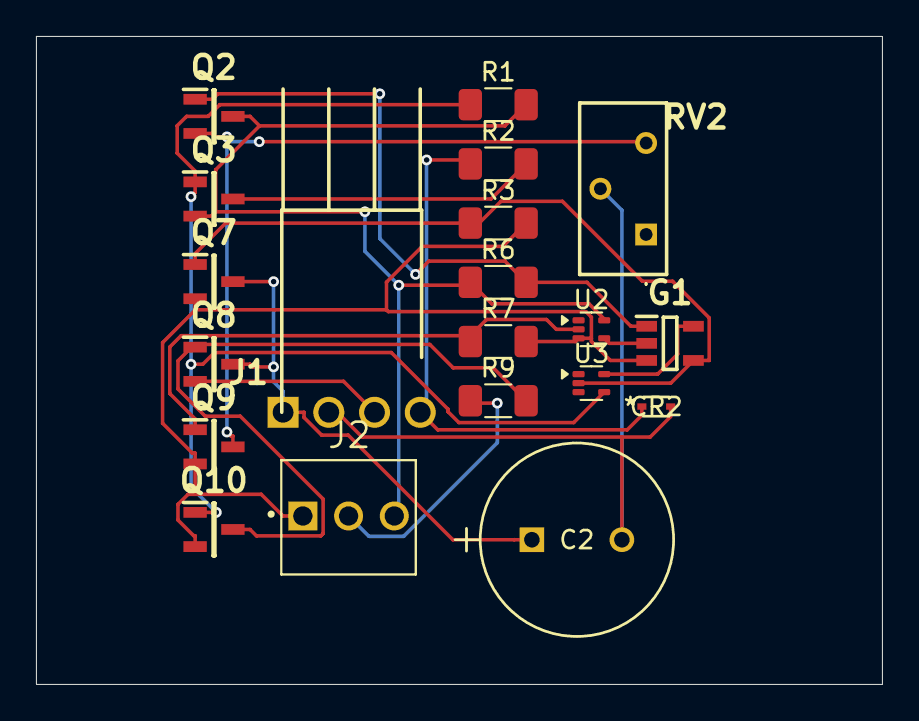
[picture p739: board BMS_testboard.kicad_pcb from above]

Board: 2 copper layers, 47.0 x 36.0 mm, 20 parts (0 on the bottom side), 15 nets.

Parts:
C2: MAL204835102E3; CAP_038RSU_10X20X.6_VIS
CR2: RB751S40T1G; DIODE_SOD523_1P3XP9_ONS
G1: Gate NAND SN74AHCT1G00DBVR; SOT95P280X145-5N
J1: 4P Angle 171857-4004; HDRRA4W66P0X254_1X4_762X818X635P
J2: 3P Droit 22-11-2032; MOLEX_22-11-2032
Q2, Q3: PMOS SI2343CDS-T1-GE3; SOT95P237X112-3N
Q7, Q8, Q9, Q10: NMOS SQ2348ES-T1_GE3; SOT95P237X112-3N
R1, R3, R6, R7, R9: 10k; R_1206_3216Metric_Pad1.30x1.75mm_HandSolder
R2: 1k; R_1206_3216Metric_Pad1.30x1.75mm_HandSolder
RV2: Varystor 3296Y-1-223LF; 3296Y1223LF
U2, U3: 74LVC1GU04DRL; SOT-553

Connections:
+5V: G1.5 (VCC), J2.3, Q2.3, Q3.2, R1.2, R6.1, U2.5 (VCC), U3.5 (VCC)
+12V: J2.2, R9.1
A0: G1.1, Q2.1, R6.2
A1: Q9.1, R7.1, U2.2
A2: Q3.1, Q10.1, R1.1, U3.4
A3: G1.4, Q7.1, R3.1, U3.2
C_Down: CR2.1, J1.4, R2.1
C_Up: J1.3, Q8.2
GND: G1.3 (GND), J2.1, Q7.2, Q9.2, Q10.2, R3.2, R7.2, U2.3 (GND)
unnamed: G1.2, U2.4
unnamed: Q3.3, R2.2
unnamed: Q2.2, Q9.3, RV2.3 (CW)
V_cap+: C2.2, CR2.2, J1.2, RV2.2 (WIPER)
V_cap-: C2.1, J1.1, Q7.3, Q8.3
Vgate_enable: Q8.1, Q10.3, R9.2
