EOSCogniton/ELIZ-2022/02 - Documentation/MODAC/Cartes Elec/BMS Slave/BMS_18/BMS_18.kicad_pcb

## KiCad design 02 - Documentation/MODAC/Cartes Elec/BMS Slave/BMS_18/BMS_18.kicad_pcb (2025-01-29, an earlier design)

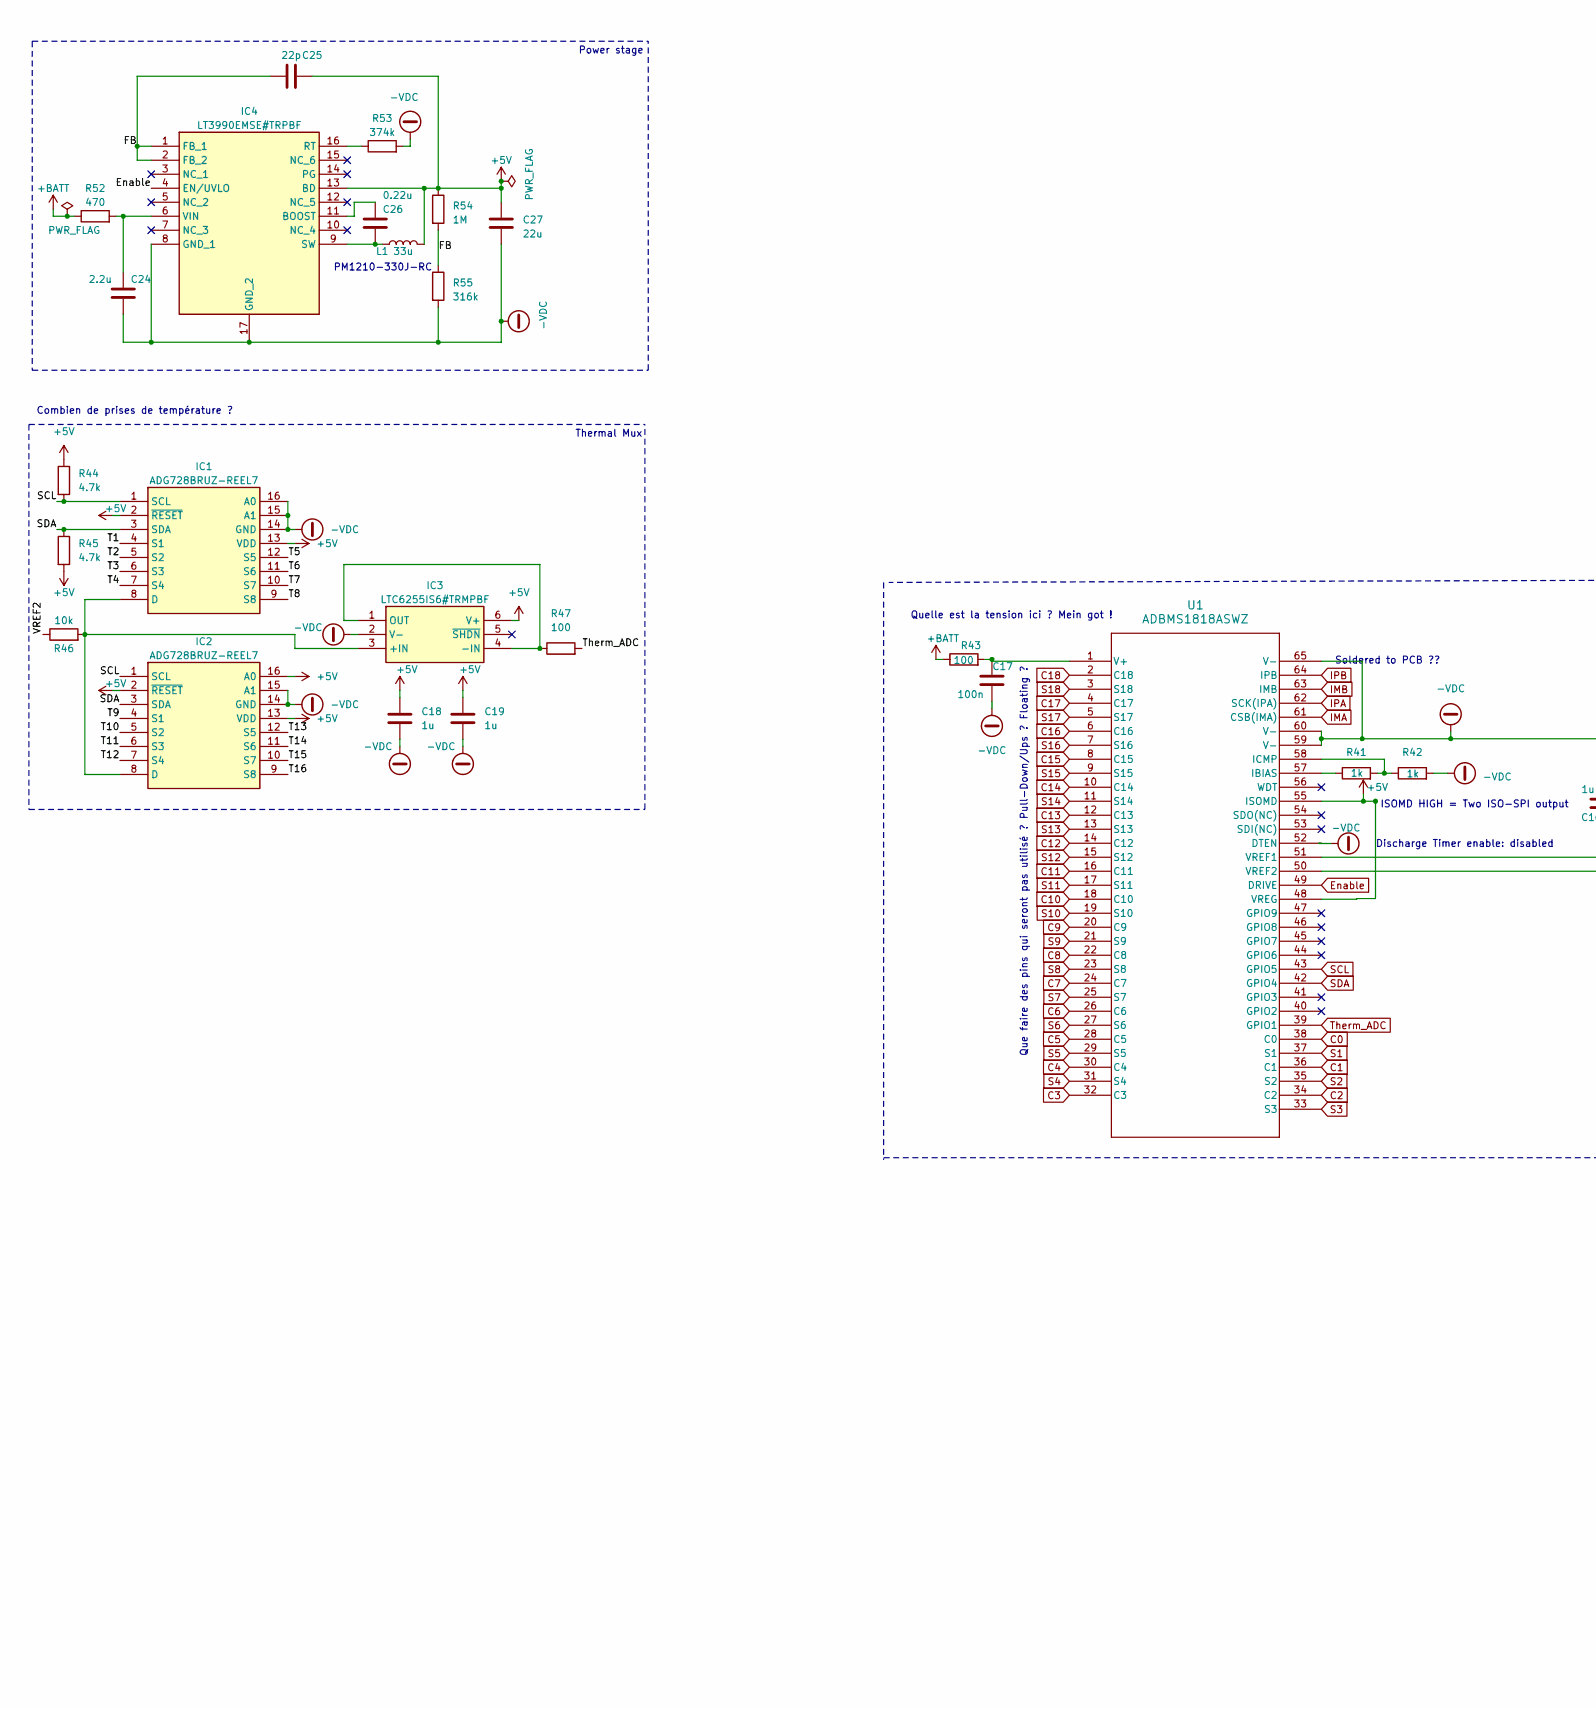
[picture p740: schematic BMS_18.kicad_sch, part in row 1, column 1]

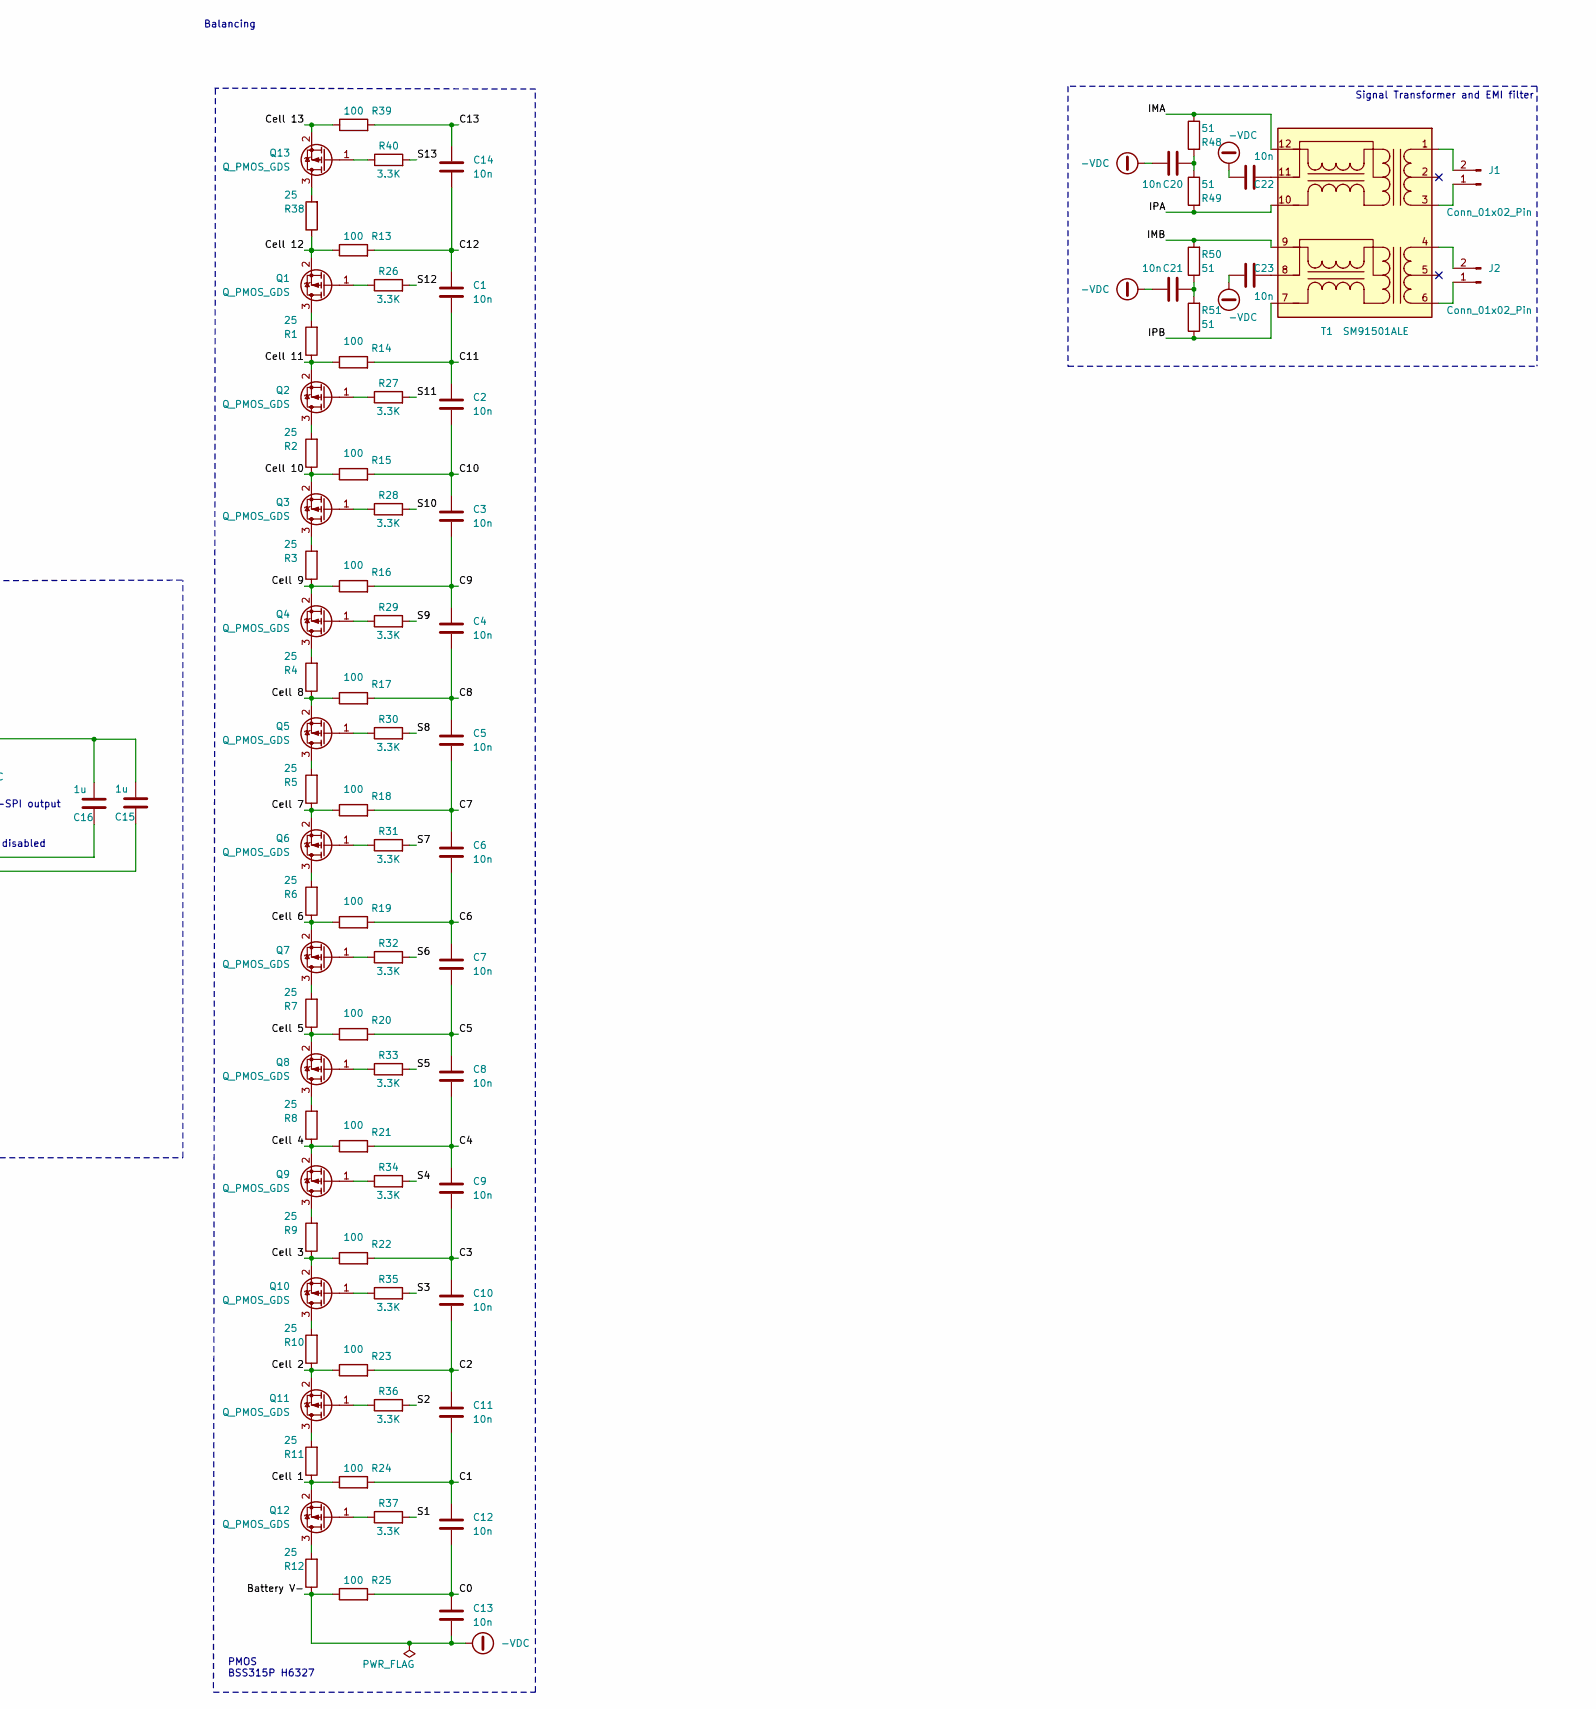
[picture p741: schematic BMS_18.kicad_sch, part in row 1, column 2]

Parts:
C1, C2, C3, C4, C5, C6, C7, C8, C9, C10, C11, C12, C13, C14, C20, C21, C22, C23: 10n; C_0805_2012Metric_Pad1.18x1.45mm_HandSolder
C15, C16, C18, C19: 1u; C_0805_2012Metric_Pad1.18x1.45mm_HandSolder
C17: 100n; C_0805_2012Metric_Pad1.18x1.45mm_HandSolder
C24: 2.2u; C_0805_2012Metric_Pad1.18x1.45mm_HandSolder
C25: 22p; C_0805_2012Metric_Pad1.18x1.45mm_HandSolder
C26: 0.22u; C_0805_2012Metric_Pad1.18x1.45mm_HandSolder
C27: 22u; C_0805_2012Metric_Pad1.18x1.45mm_HandSolder
IC1, IC2: ADG728BRUZ-REEL7; SOP65P640X120-16N; Mouser Part Number 584-ADG728BRUZ-R7
IC3: LTC6255IS6#TRMPBF; SOT95P280X100-6N; Mouser Part Number 584-LTC6255IS6TRMPBF
IC4: LT3990EMSE#TRPBF; SOP50P490X110-17N; Mouser Part Number 584-LT3990EMSE#TRPBF
J1, J2: Conn_01x02_Pin; RHDR2W97P0X254_1X2_654X508X1379P
L1: 33u; L_1210_3225Metric_Pad1.42x2.65mm_HandSolder
Q1, Q2, Q3, Q4, Q5, Q6, Q7, Q8, Q9, Q10, Q11, Q12, Q13: Q_PMOS_GDS; SOT95P237X112-3N
R1, R2, R3, R4, R5, R6, R7, R8, R9, R10, R11, R12, R38: 25; R_2512_6332Metric_Pad1.40x3.35mm_HandSolder
R13, R14, R15, R16, R17, R18, R19, R20, R21, R22, R23, R24, R25, R39, R43, R47: 100; R_1206_3216Metric_Pad1.30x1.75mm_HandSolder
R26, R27, R28, R29, R30, R31, R32, R33, R34, R35, R36, R37, R40: 3.3K; R_1206_3216Metric_Pad1.30x1.75mm_HandSolder
R41, R42: 1k; R_1206_3216Metric_Pad1.30x1.75mm_HandSolder
R44, R45: 4.7k; R_1206_3216Metric_Pad1.30x1.75mm_HandSolder
R46: 10k; R_1206_3216Metric_Pad1.30x1.75mm_HandSolder
R48, R49, R50, R51: 51; R_1206_3216Metric_Pad1.30x1.75mm_HandSolder
R52: 470; R_1206_3216Metric_Pad1.30x1.75mm_HandSolder
R53: 374k; R_1206_3216Metric_Pad1.30x1.75mm_HandSolder
R54: 1M; R_1206_3216Metric_Pad1.30x1.75mm_HandSolder
R55: 316k; R_1206_3216Metric_Pad1.30x1.75mm_HandSolder
T1: SM91501ALE; SOP200P1473X500-12N; Mouser Part Number 652-SM91501ALE
U1: ADBMS1818ASWZ; 05-08-1982_ADI

Connections:
+5V: C18.1, C19.1, C25.2, C27.2, IC1.2 (~RESET), IC1.13 (VDD), IC2.2 (~RESET), IC2.13 (VDD), IC2.16 (A0), IC3.6 (V+), IC4.13 (BD), L1.2, R44.1, R45.2, R54.1, U1.48 (VREG), U1.55 (ISOMD)
+BATT: R43.1, R52.1
-VDC: C13.2, C15.2, C16.2, C17.2, C18.2, C19.2, C20.1, C21.1, C22.1, C23.1, C24.1, C27.1, IC1.14 (GND), IC1.15 (A1), IC1.16 (A0), IC2.14 (GND), IC2.15 (A1), IC3.2 (V-), IC4.8 (GND_1), IC4.17 (GND_2), R12.1, R25.1, R42.2, R53.2, R55.2, U1.52 (DTEN), U1.59 (V-), U1.60 (V-), U1.65 (V-)
/Cell 1: Q12.2 (S), R11.1, R24.1
/Cell 2: Q11.2 (S), R10.1, R23.1
/Cell 3: Q10.2 (S), R9.1, R22.1
/Cell 4: Q9.2 (S), R8.1, R21.1
/Cell 5: Q8.2 (S), R7.1, R20.1
/Cell 6: Q7.2 (S), R6.1, R19.1
/Cell 7: Q6.2 (S), R5.1, R18.1
/Cell 8: Q5.2 (S), R4.1, R17.1
/Cell 9: Q4.2 (S), R3.1, R16.1
/Cell 10: Q3.2 (S), R2.1, R15.1
/Cell 11: Q2.2 (S), R1.1, R14.1
/Cell 12: Q1.2 (S), R13.1, R38.1
/Cell 13: Q13.2 (S), R39.1
/FB: C25.1, IC4.1 (FB_1), IC4.2 (FB_2), R54.2, R55.1
/T1: IC1.4 (S1)
/T2: IC1.5 (S2)
/T3: IC1.6 (S3)
/T4: IC1.7 (S4)
/T5: IC1.12 (S5)
/T6: IC1.11 (S6)
/T7: IC1.10 (S7)
/T8: IC1.9 (S8)
/T9: IC2.4 (S1)
/T10: IC2.5 (S2)
/T11: IC2.6 (S3)
/T12: IC2.7 (S4)
/T13: IC2.12 (S5)
/T14: IC2.11 (S6)
/T15: IC2.10 (S7)
/T16: IC2.9 (S8)
/VREF2: R46.1
C0: C12.2, C13.1, R25.2, U1.38 (C0)
C1: C11.2, C12.1, R24.2, U1.36 (C1)
C2: C10.2, C11.1, R23.2, U1.34 (C2)
C3: C9.2, C10.1, R22.2, U1.32 (C3)
C4: C8.2, C9.1, R21.2, U1.30 (C4)
C5: C7.2, C8.1, R20.2, U1.28 (C5)
C6: C6.2, C7.1, R19.2, U1.26 (C6)
C7: C5.2, C6.1, R18.2, U1.24 (C7)
C8: C4.2, C5.1, R17.2, U1.22 (C8)
C9: C3.2, C4.1, R16.2, U1.20 (C9)
C10: C2.2, C3.1, R15.2, U1.18 (C10)
C11: C1.2, C2.1, R14.2, U1.16 (C11)
C12: C1.1, C14.2, R13.2, U1.14 (C12)
C13: C14.1, R39.2, U1.12 (C13)
C14: U1.10 (C14)
C15: U1.8 (C15)
C16: U1.6 (C16)
C17: U1.4 (C17)
C18: U1.2 (C18)
Enable: IC4.4 (EN/UVLO), U1.49 (DRIVE)
IMA: R48.1, T1.12 (SEC1_3), U1.61 (CSB(IMA))
IMB: R50.2, T1.9 (SEC2_3), U1.63 (IMB)
IPA: R49.2, T1.10 (SEC1_1), U1.62 (SCK(IPA))
IPB: R51.1, T1.7 (SEC2_1), U1.64 (IPB)
unnamed: C20.2, R48.2, R49.1
unnamed: C21.2, R50.1, R51.2
unnamed: IC1.8 (D), IC2.8 (D), IC3.3 (+IN), R46.2
unnamed: IC3.1 (OUT), IC3.4 (-IN), R47.1
unnamed: C26.2, IC4.11 (BOOST)
unnamed: IC4.16 (RT), R53.1
unnamed: C26.1, IC4.9 (SW), L1.1
unnamed: C24.2, IC4.6 (VIN), R52.2
unnamed: J1.1, T1.3 (PRI1_3)
unnamed: J1.2, T1.1 (PRI1_1)
unnamed: J2.1, T1.6 (PRI2_3)
unnamed: J2.2, T1.4 (PRI2_1)
unnamed: Q1.3 (D), R1.2
unnamed: Q1.1 (G), R26.1
unnamed: Q2.3 (D), R2.2
unnamed: Q2.1 (G), R27.1
unnamed: Q3.3 (D), R3.2
unnamed: Q3.1 (G), R28.1
unnamed: Q4.3 (D), R4.2
unnamed: Q4.1 (G), R29.1
unnamed: Q5.3 (D), R5.2
unnamed: Q5.1 (G), R30.1
unnamed: Q6.3 (D), R6.2
unnamed: Q6.1 (G), R31.1
unnamed: Q7.3 (D), R7.2
unnamed: Q7.1 (G), R32.1
unnamed: Q8.3 (D), R8.2
unnamed: Q8.1 (G), R33.1
unnamed: Q9.3 (D), R9.2
unnamed: Q9.1 (G), R34.1
unnamed: Q10.3 (D), R10.2
unnamed: Q10.1 (G), R35.1
unnamed: Q11.3 (D), R11.2
unnamed: Q11.1 (G), R36.1
unnamed: Q12.3 (D), R12.2
unnamed: Q12.1 (G), R37.1
unnamed: Q13.3 (D), R38.2
unnamed: Q13.1 (G), R40.1
unnamed: C22.2, T1.11 (SEC1_2)
unnamed: C23.2, T1.8 (SEC2_2)
unnamed: R41.1, U1.57 (IBIAS)
unnamed: R41.2, R42.1, U1.58 (ICMP)
unnamed: C17.1, R43.2, U1.1 (V+)
unnamed: C16.1, U1.51 (VREF1)
unnamed: C15.1, U1.50 (VREF2)
S1: R37.2, U1.37 (S1)
S2: R36.2, U1.35 (S2)
S3: R35.2, U1.33 (S3)
S4: R34.2, U1.31 (S4)
S5: R33.2, U1.29 (S5)
S6: R32.2, U1.27 (S6)
S7: R31.2, U1.25 (S7)
S8: R30.2, U1.23 (S8)
S9: R29.2, U1.21 (S9)
S10: R28.2, U1.19 (S10)
S11: R27.2, U1.17 (S11)
S12: R26.2, U1.15 (S12)
S13: R40.2, U1.13 (S13)
S14: U1.11 (S14)
S15: U1.9 (S15)
S16: U1.7 (S16)
S17: U1.5 (S17)
S18: U1.3 (S18)
SCL: IC1.1 (SCL), IC2.1 (SCL), R44.2, U1.43 (GPIO5)
SDA: IC1.3 (SDA), IC2.3 (SDA), R45.1, U1.42 (GPIO4)
Therm_ADC: R47.2, U1.39 (GPIO1)

Notes on the sheet:
PM1210-330J-RC
Combien de prises de température ?
Signal Transformer and EMI filter
Discharge Timer enable: disabled
Quelle est la tension ici ? Mein got !
Soldered to PCB ??
Power stage
Balancing
Thermal Mux
ISOMD HIGH = Two ISO-SPI output
Que faire des pins qui seront pas utilisé ? Pull-Down/Ups ? Floating ?
PMOS BSS315P H6327

Board: 2 copper layers, 104 parts (0 on the bottom side), 97 nets, no tracks yet.
