EOSCogniton/ELIZ-2022/02 - Documentation/MODAC/Cartes Elec/AIR Controller/AIR Controller.kicad_pcb

## KiCad design 02 - Documentation/MODAC/Cartes Elec/AIR Controller/AIR Controller.kicad_pcb (2024-11-05)

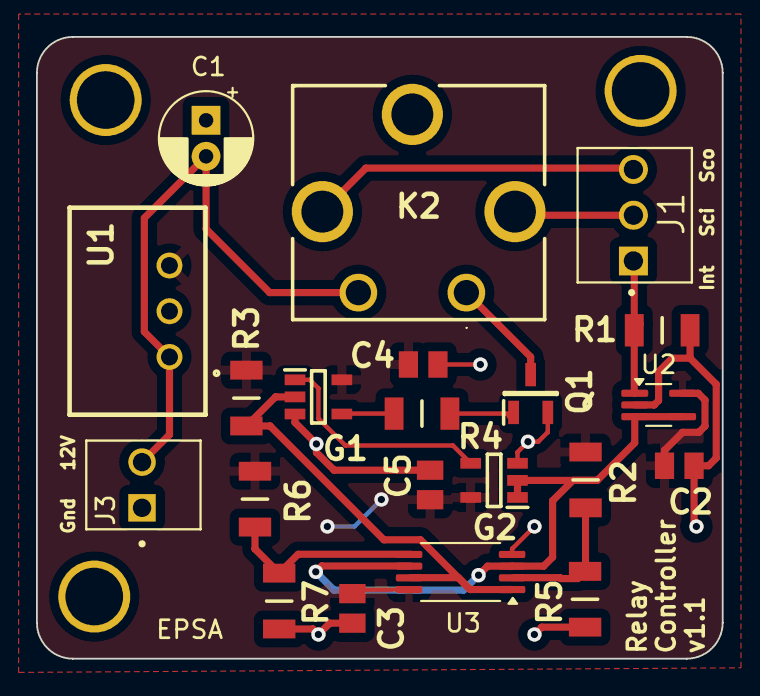
[picture p742: board AIR Controller.kicad_pcb from above]

Board: 2 copper layers, 38.1 x 34.5 mm, 21 parts (0 on the bottom side), 14 nets.

Parts:
C1: C; CP_Radial_D5.0mm_P2.00mm
C2, C3, C4, C5: 10n; CAPC2012X130N
G1: Gate AND SN74AHCT1G08DBVR; SOT95P280X145-5N
G2: Gate NAND SN74AHCT1G00DBVR; SOT95P280X145-5N
J1: 3P Droit 22-11-2032; MOLEX_22-11-2032
J3: 2P Droit 22-11-2022; MOLEX_22-11-2022
K2: Relais PCB; CP112V
Q1: NMOS SQ2348ES-T1_GE3; SOT95P237X112-3N
R1: 500k; RESC3216X70N
R2, R7: 82k; RESC3216X70N
R3: 10k; RESC3216X70N
R4: 1k; RESC3216X70N
R5, R6: 12k; RESC3216X70N
U1: Alim LP TSR_0.5-2450; TSR-0.5-2433
U2: SOT-353_SC-70-5_Handsoldering
U3: Opamp_Dual; TSSOP-8_4.4x3mm_P0.65mm

Connections:
+5V: C2.2, C3.2, C4.2, C5.2, G1.5 (VCC), G2.5 (VCC), R2.2, R3.1, R6.2, U1.3 (+VOUT), U2.5 (V+), U3.8 (V+)
+12V: C1.2, J3.2, K2.5, U1.1 (+VIN)
/0.75V: R2.1, R5.2, U3.2 (-)
/4.25V: R6.1, R7.2, U3.5 (+)
/Raw_Relay_Closed: J1.1, R1.1, U2.1 (+)
/Relay_Closed: G2.1, G2.2, U2.3 (-), U2.4, U3.3 (+), U3.6 (-)
/SC in: J1.2, K2.2
/SC out: J1.3, K2.4
/SCS_Compliance: G1.2, R3.2, U3.1, U3.7
GND: C1.1, C2.1, C3.1, C4.1, C5.1, G1.3 (GND), G2.3 (GND), J3.1, Q1.2, R1.2, R5.1, R7.1, U1.2 (GND), U2.2 (V-), U3.4 (V-)
unnamed: G1.1, G2.4
unnamed: G1.4, R4.1
unnamed: K2.1, Q1.3
unnamed: Q1.1, R4.2
