EOSCogniton/ELIZ-2022/02 - Documentation/BASTIE/Cartes Artemiz/TSAL/TSAL/TSAL.kicad_pcb

## KiCad design 02 - Documentation/BASTIE/Cartes Artemiz/TSAL/TSAL/TSAL.kicad_pcb (2024-10-22)

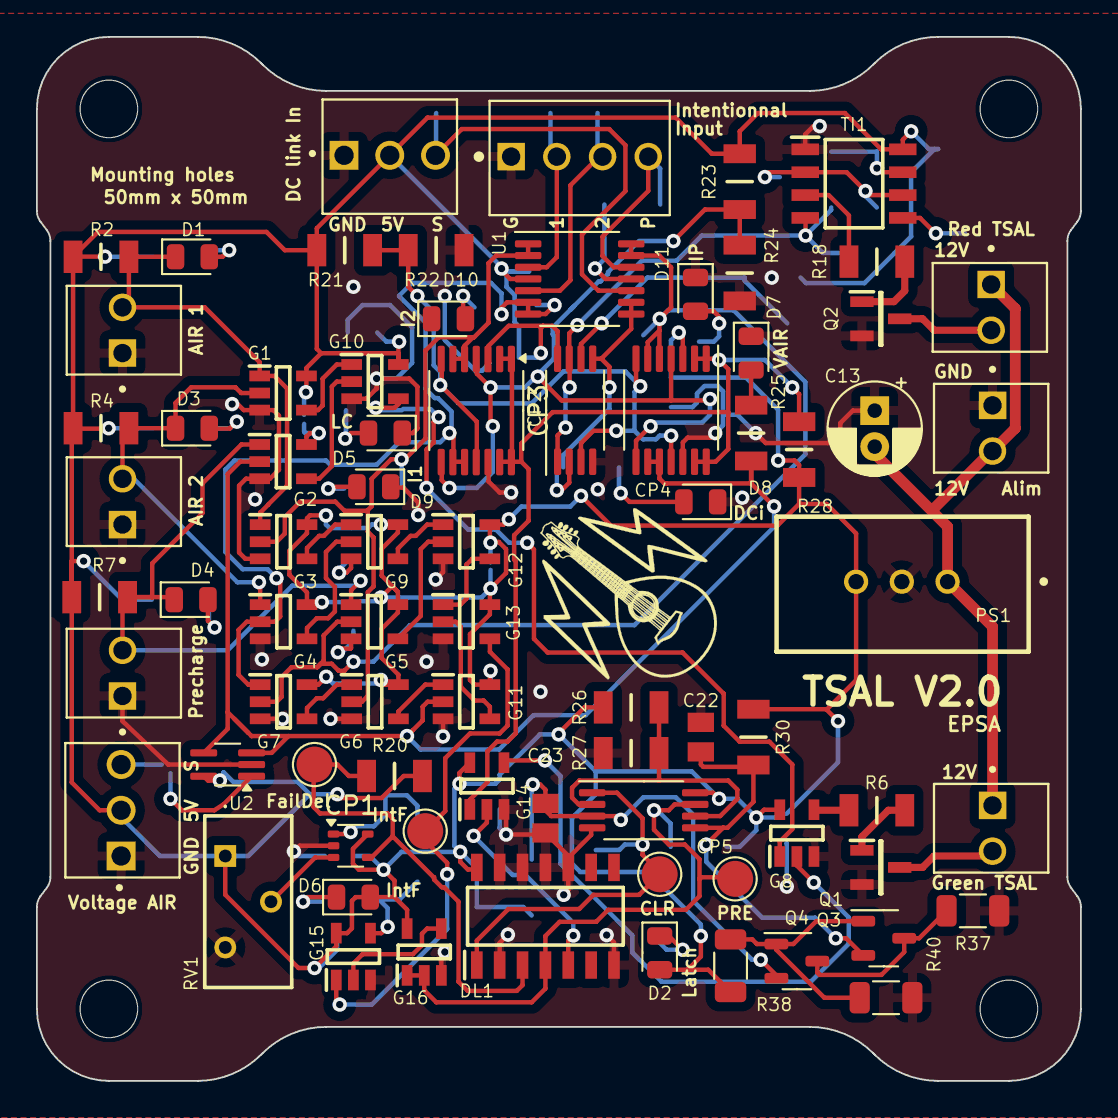
[picture p743: board TSAL.kicad_pcb from above]

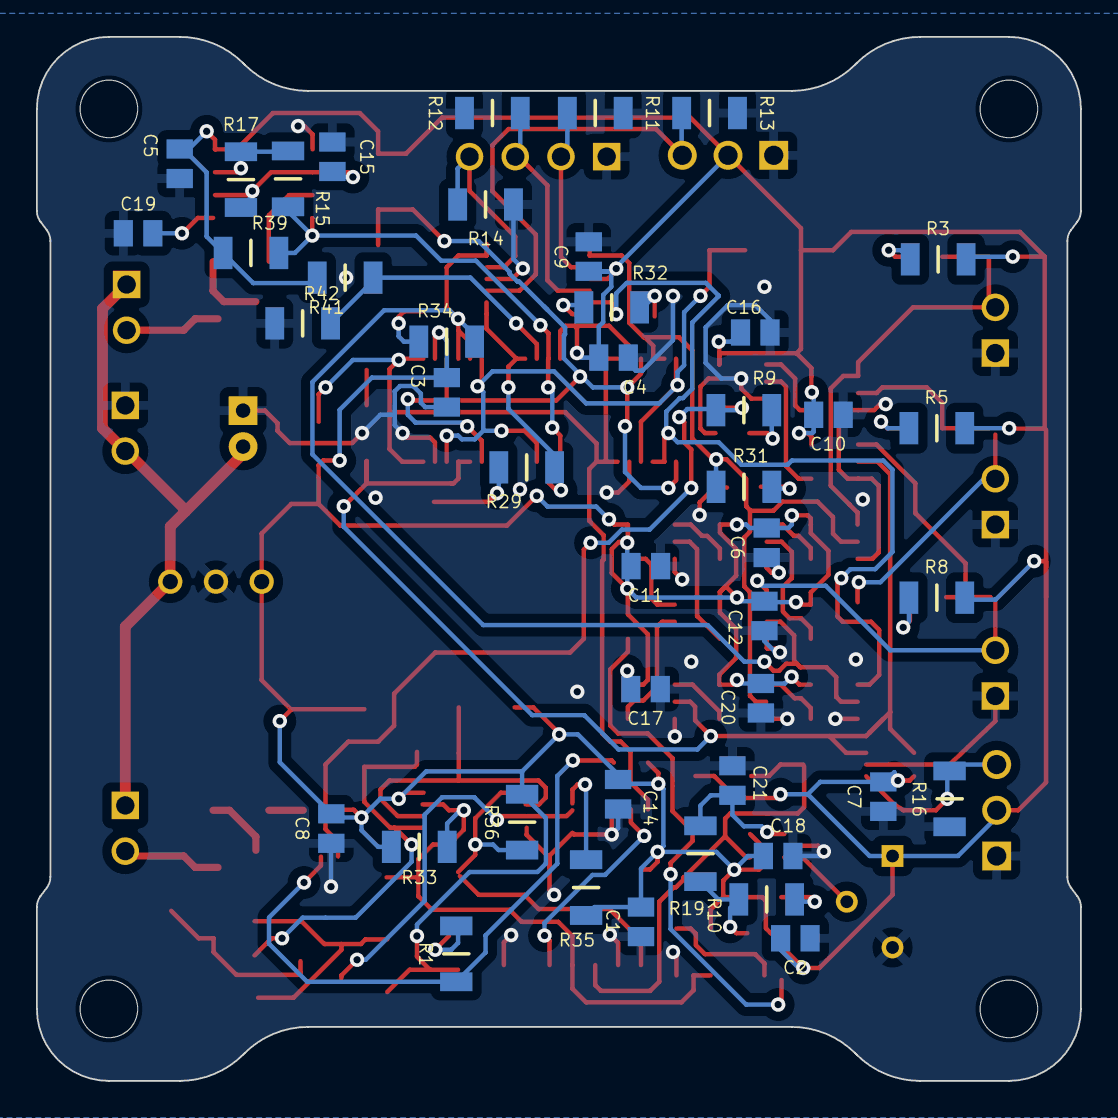
[picture p744: board TSAL.kicad_pcb from below]

Board: 2 copper layers, 58.0 x 58.0 mm, 125 parts (44 on the bottom side), 67 nets.

Parts:
C1, C2, C3, C4, C5, C6, C7, C8, C9, C10, C11, C12, C14, C16, C17, C18, C20: 10u; CAPC2012X130N
C13: C; CP_Radial_D5.0mm_P2.00mm
C15, C23: 1u; CAPC2012X130N
C19: 0.01u; CAPC2012X130N
C21, C22: 2.2u; CAPC2012X130N
CP1: Comparator; SOT-353_SC-70-5
CP2, CP5: Comparator_Dual; TSSOP-8_4.4x3mm_P0.65mm
CP3, CP4: Comparator_Quad; TSSOP-14_4.4x5mm_P0.65mm
D1, D2, D3, D4, D5, D6, D7, D8, D9, D10, D11: LED; LED_0805_2012Metric
DL1: Bascule D SN74HCS72QDRQ1; SOIC127P600X175-14N
G1, G2, G3, G4, G5, G6, G8, G10, G11, G14: Gate AND SN74AHCT1G08DBVR; SOT95P280X145-5N
G7, G9, G12, G15: Gate OR SN74AHCT1G32DBVR; SOT95P280X145-5N
G13, G16: Gate NOR SN74AHCT1G02DBVR; SOT95P280X145-5N
H1, H2, H3, H4: MountingHole; MountingHole_3.2mm_M3
J1, J2, J3, J5, J6, J9: 2P Droit 2-11-2022; MOLEX_22-11-2022
J4, J8: 3P Droit 22-11-2032; MOLEX_22-11-2032
J7: 4P Droit 22-11-2042; MOLEX_22-11-2042
PS1: Alim HP TSR_2-2450; TSR-2
Q1, Q2: NMOS SQ2348ES-T1_GE3; SOT95P237X112-3N
Q3, Q4: PMOS SI2343CDS-T1-GE3; SOT-23-3
R1, R3, R5, R8, R9, R10, R25, R29, R31, R32, R34: 500; RESC3216X70N
R2, R4, R6, R7, R18, R20, R28, R39: 10k; RESC3216X70N
R11, R12, R13, R14, R16, R30, R35: 500k; RESC3216X70N
R15: 2k; RESC3216X70N
R17: 200k; RESC3216X70N
R19: 390k; RESC3216X70N
R21, R24, R41, R42: 12k; RESC3216X70N
R22, R23: 82k; RESC3216X70N
R26: 100k; RESC3216X70N
R27: 50k; RESC3216X70N
R33, R36: 5k; RESC3216X70N
R37: 1k; R_1206_3216Metric
R38: 10k; R_1206_3216Metric
R40: 100k; R_1206_3216Metric
RV1: Varystor 3296Y-1-223LF; 3296Y1223LF
Ref**: Val**; Mandolule Silk
TI1: Timer 555 LM555CMX_NOPB; SOIC127P600X175-8N
TP1, TP2, TP3, TP4: type="R" model="TestPoint" lib=""; TestPoint_Pad_D2.0mm
U1: Opamp_Quad; TSSOP-14_4.4x5mm_P0.65mm
U2: Opamp; SOT-353_SC-70-5_Handsoldering

Connections:
+5V: C1.2, C2.2, C3.2, C4.2, C5.2, C6.2, C7.2, C8.2, C9.2, C10.2, C11.2, C12.2, C14.2, C16.2, C17.2, C18.2, C20.2, CP1.5 (V+), CP2.8 (V+), CP3.3 (V+), CP4.3 (V+), CP5.8 (V+), D2.2 (A), D6.2 (A), DL1.14 (VCC), G1.5 (VCC), G2.5 (VCC), G3.5 (VCC), G4.5 (VCC), G5.5 (VCC), G6.5 (VCC), G7.5 (VCC), G8.5 (VCC), G9.5 (VCC), G10.5 (VCC), G11.5 (VCC), G12.5 (VCC), G13.5 (VCC), G14.5 (VCC), G15.5 (VCC), G16.5 (VCC), J4.2, J8.2, PS1.3 (+VOUT), R2.2, R3.2, R4.2, R5.2, R7.2, R8.2, R20.2, R21.2, R23.2, R26.2, R28.1, R30.2, R33.2, R35.2, R36.2, R38.1, R39.1, R41.2, RV1.1 (CCW), TI1.8 (+VCC), U1.4 (V+), U2.5 (V+)
+12V: C13.2, J5.1, J6.2, J9.1, PS1.1 (+VIN)
/0.75V: CP3.4 (-), CP3.8 (-), CP4.4 (-), CP4.8 (-), R23.1, R24.2
/2.5V: CP2.6 (-), R41.1, R42.2
/4.25V: CP2.3 (+), CP3.7 (+), CP3.11 (+), CP4.7 (+), CP4.11 (+), R21.1, R22.2
/AIR_1: D1.1 (K), G1.1, G3.1, J1.2, R2.1
/AIR_2: D3.1 (K), G1.2, G4.1, J2.2, R4.1
/CLR: CP5.1, DL1.1 (1~CLR), R36.1, TP4.1
/Clign: R18.1, TI1.3 (OUTPUT)
/DC-Link_In: CP2.2 (-), CP2.5 (+), R29.2, U1.8, U1.9 (-)
/DC-Link_In_SCS: CP2.1, CP2.7, R15.2, R39.2, TI1.4 (RESET)
/INT: DL1.5 (1Q), G14.2
/Int_AIR_1: CP3.5 (+), CP3.6 (-), G3.2, G6.2, R31.2, U1.1, U1.2 (-)
/Int_AIR_2: CP3.9 (+), CP3.10 (-), G4.2, G7.1, R32.2, U1.6 (-), U1.7
/Int_PreCharge: CP4.5 (+), CP4.6 (-), G5.2, G7.2, R34.2, U1.13 (-), U1.14
/Int_del: CP1.4, DL1.3 (1~CLK), R20.1, TP2.1
/Int_log: G13.4, G15.1, TP1.1
/Lightning_cond: G8.1, G10.4, R9.1
/PRE: CP5.7, DL1.4 (1~PRE), G16.1, G16.2, R33.1, TP3.1
/PreCharge: D4.1 (K), G2.1, G5.1, J3.2, R7.1
/Raw_DC-Link_In: J8.3, R13.2, U1.10 (+)
/Raw_Int_AIR_1: J7.2, R11.2, U1.3 (+)
/Raw_Int_AIR_2: J7.3, R12.2, U1.5 (+)
/Raw_Int_PreCharge: J7.4, R14.2, U1.12 (+)
/Raw_VoltageAIR: J4.3, R16.2, U2.1 (+)
/SCS compliance: CP3.1, CP3.2, CP3.13, CP3.14, CP4.1, CP4.2, CP4.13, CP4.14, G14.1, R28.2
/VoltageAIR: CP4.9 (+), CP4.10 (-), G2.2, G11.2, R25.2, U2.3 (-), U2.4
/dis1: C22.2, CP5.5 (+), Q3.2, R30.1
/dis2: C23.2, CP5.3 (+), Q4.2, R35.1
/mid_Pot: CP5.2 (-), CP5.6 (-), R26.1, R27.2
GND: C1.1, C2.1, C3.1, C4.1, C5.1, C6.1, C7.1, C8.1, C9.1, C10.1, C11.1, C12.1, C13.1, C14.1, C15.1, C16.1, C17.1, C18.1, C19.1, C20.1, C21.2, C22.1, C23.1, CP1.2 (V-), CP2.4 (V-), CP3.12 (V-), CP4.12 (V-), CP5.4 (V-), D5.1 (K), D7.1 (K), D8.1 (K), D9.1 (K), D10.1 (K), D11.1 (K), DL1.2 (1D), DL1.7 (GND), DL1.10 (2~PRE), DL1.11 (2~CLK), DL1.12 (2D), DL1.13 (2~CLR), G1.3 (GND), G2.3 (GND), G3.3 (GND), G4.3 (GND), G5.3 (GND), G6.3 (GND), G7.3 (GND), G8.3 (GND), G9.3 (GND), G10.3 (GND), G11.3 (GND), G12.3 (GND), G13.3 (GND), G14.3 (GND), G15.3 (GND), G16.3 (GND), J1.1, J2.1, J3.1, J4.1, J6.1, J7.1, J8.1, PS1.2 (GND), Q1.2, Q2.2, R11.1, R12.1, R13.1, R14.1, R16.1, R22.1, R24.1, R27.1, R37.1, R40.2, R42.1, RV1.3 (CW), TI1.1 (GND), U1.11 (V-), U2.2 (V-)
unnamed: C21.1, CP1.1 (+), R19.2
unnamed: CP1.3 (-), RV1.2 (WIPER)
unnamed: D1.2 (A), R3.1
unnamed: D2.1 (K), R1.2
unnamed: D3.2 (A), R5.1
unnamed: D4.2 (A), R8.1
unnamed: D5.2 (A), R9.2
unnamed: D6.1 (K), R10.2
unnamed: D7.2 (A), R25.1
unnamed: D8.2 (A), R29.1
unnamed: D9.2 (A), R31.1
unnamed: D10.2 (A), R32.1
unnamed: D11.2 (A), R34.1
unnamed: G1.4, G10.1
unnamed: G3.4, G9.1
unnamed: G4.4, G9.2
unnamed: G6.1, G7.4
unnamed: G8.4, R6.1
unnamed: G2.4, G10.2
unnamed: G6.4, G11.1
unnamed: G11.4, G13.2
unnamed: G9.4, G12.1
unnamed: G5.4, G12.2
unnamed: G12.4, G13.1
unnamed: G8.2, G14.4, R1.1
unnamed: G15.2, G16.4
unnamed: G15.4, R10.1, R19.1
unnamed: J5.2, Q1.3
unnamed: J9.2, Q2.3
unnamed: Q1.1, R6.2
unnamed: Q2.1, R18.2
unnamed: Q3.1, Q4.1, R38.2, R40.1
unnamed: Q3.3, Q4.3, R37.2
unnamed: C19.2, TI1.5 (CONTROL_VOLTAGE)
unnamed: R15.1, R17.2, TI1.7 (DISCHARGE)
unnamed: C15.2, R17.1, TI1.2 (TRIGGER), TI1.6 (THRESHOLD)
