EOSCogniton/ELIZ-2022/02 - Documentation/BASTIE/Cartes Artemiz/SCS TSAL Green LED/SCS TSAL Green LED.kicad_pcb

## KiCad design 02 - Documentation/BASTIE/Cartes Artemiz/SCS TSAL Green LED/SCS TSAL Green LED.kicad_pcb (2024-10-22)

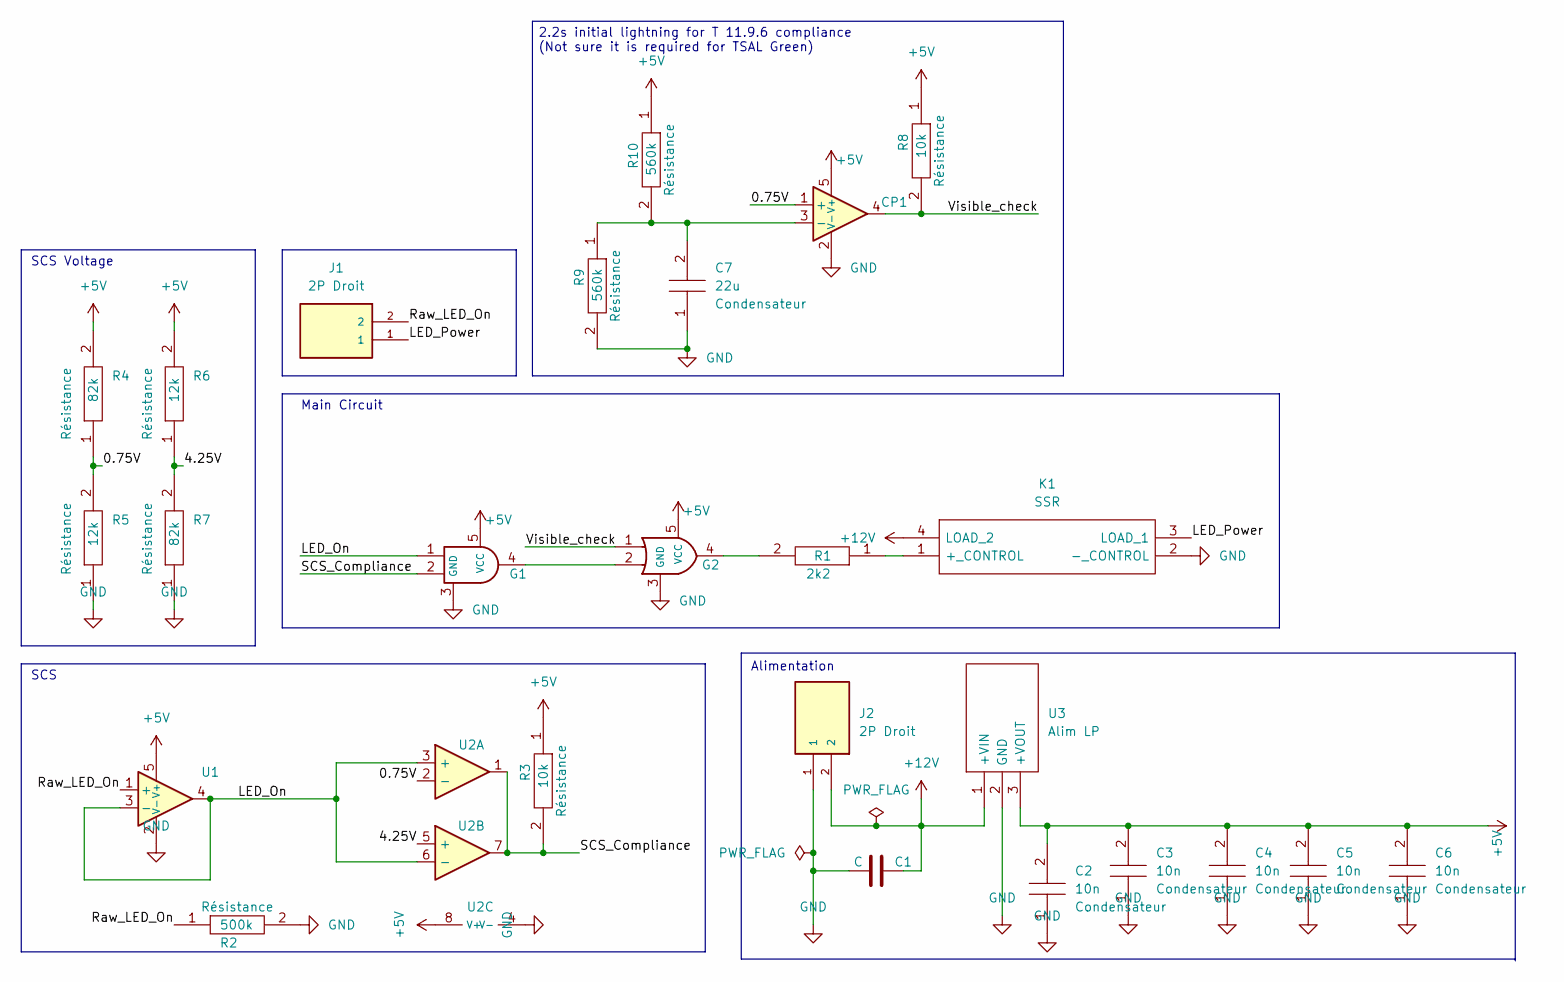
[picture p745: schematic SCS TSAL Green LED.kicad_sch]

Parts:
C1: C; CP_Radial_D5.0mm_P2.00mm
C2, C3, C4, C5, C6: 10n; CAPC2012X130N; Manufacturer_Part_Number 0805Y1000104JXT
C7: 22u; CAPC2012X130N; Manufacturer_Part_Number 0805Y1000104JXT
CP1: Comparator; SOT-353_SC-70-5; Manufacturer_Part_Number LMV331M7/NOPB; Mouser Part Number 926-LMV331M7/NOPB
G1: Gate AND SN74AHCT1G08DBVR; SOT95P280X145-5N; Manufacturer_Part_Number SN74AHCT1G08DBVR; Mouser Part Number 595-SN74AHCT1G08DBVR
G2: Gate OR SN74AHCT1G32DBVR; SOT95P280X145-5N; Manufacturer_Part_Number SN74AHCT1G32DBVR; Mouser Part Number 595-SN74AHCT1G32DBVR
J1, J2: 2P Droit 2-11-2022; MOLEX_22-11-2022; PARTREV BD8
K1: SSR CPC1394GR; CPC1394GR; Manufacturer_Part_Number CPC1394GR; Mouser Part Number 849-CPC1394GR
R1: 2k2; RESC3216X70N; Manufacturer_Part_Number RK73H2BLTDD2152F; Mouser Part Number N/A
R2: 500k; RESC3216X70N; Manufacturer_Part_Number RK73H2BLTDD2152F; Mouser Part Number N/A
R3, R8: 10k; RESC3216X70N; Manufacturer_Part_Number RK73H2BLTDD2152F; Mouser Part Number N/A
R4, R7: 82k; RESC3216X70N; Manufacturer_Part_Number RK73H2BLTDD2152F; Mouser Part Number N/A
R5, R6: 12k; RESC3216X70N; Manufacturer_Part_Number RK73H2BLTDD2152F; Mouser Part Number N/A
R9, R10: 560k; RESC3216X70N; Manufacturer_Part_Number RK73H2BLTDD2152F; Mouser Part Number N/A
U1: ${SIM.PARAMS}; SOT-353_SC-70-5_Handsoldering; Manufacturer_Part_Number TLV9061QDCKRQ1; Mouser Part Number 595-TLV9061QDCKRQ1
U2: Opamp_Dual; TSSOP-8_4.4x3mm_P0.65mm; Manufacturer_Part_Number LMV393IPWR; Mouser Part Number 595-LMV393IPWR
U3: Alim LP TSR_0.5-2450; TSR-0.5-2433; Manufacturer_Part_Number TSR 0.5-2450; Mouser Part Number 495-TSR0.5-2450

Connections:
+5V: C2.2, C3.2, C4.2, C5.2, C6.2, CP1.5 (V+), G1.5 (VCC), G2.5 (VCC), R3.1, R4.2, R6.2, R8.1, R10.1, U1.5 (V+), U2.8 (V+), U3.3 (+VOUT)
+12V: C1.2, J2.2, K1.4 (LOAD_2), U3.1 (+VIN)
/0.75V: CP1.1 (+), R4.1, R5.2, U2.2 (-)
/4.25V: R6.1, R7.2, U2.5 (+)
/LED_On: G1.1, U1.3 (-), U1.4, U2.3 (+), U2.6 (-)
/LED_Power: J1.1, K1.3 (LOAD_1)
/Raw_LED_On: J1.2, R2.1, U1.1 (+)
/SCS_Compliance: G1.2, R3.2, U2.1, U2.7
/Visible_check: CP1.4, G2.1, R8.2
GND: C1.1, C2.1, C3.1, C4.1, C5.1, C6.1, C7.1, CP1.2 (V-), G1.3 (GND), G2.3 (GND), J2.1, K1.2 (-_CONTROL), R2.2, R5.1, R7.1, R9.2, U1.2 (V-), U2.4 (V-), U3.2 (GND)
unnamed: C7.2, CP1.3 (-), R9.1, R10.2
unnamed: G1.4, G2.2
unnamed: G2.4, R1.2
unnamed: K1.1 (+_CONTROL), R1.1

Notes on the sheet:
Alimentation
Main Circuit
SCS
SCS Voltage
2.2s initial lightning for T 11.9.6 compliance (Not sure it is required for TSAL Green)

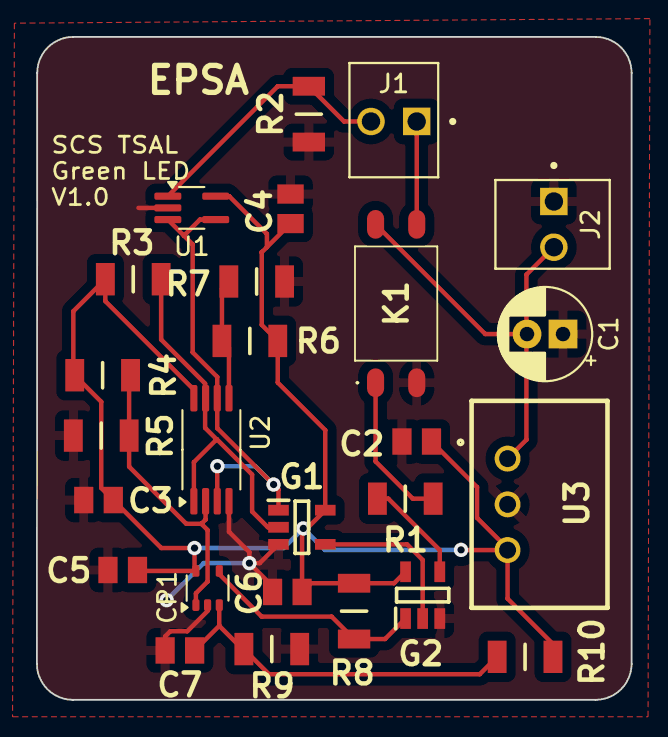
[picture p746: board SCS TSAL Green LED.kicad_pcb from above]

Board: 2 copper layers, 33.0 x 36.8 mm, 26 parts (0 on the bottom side), 14 nets.
