EOSCogniton/ELIZ-2022/02 - Documentation/MODAC/Cartes Elec/AMS Dongle/AMS Dongle.kicad_pcb

## KiCad design 02 - Documentation/MODAC/Cartes Elec/AMS Dongle/AMS Dongle.kicad_pcb (2024-10-12)

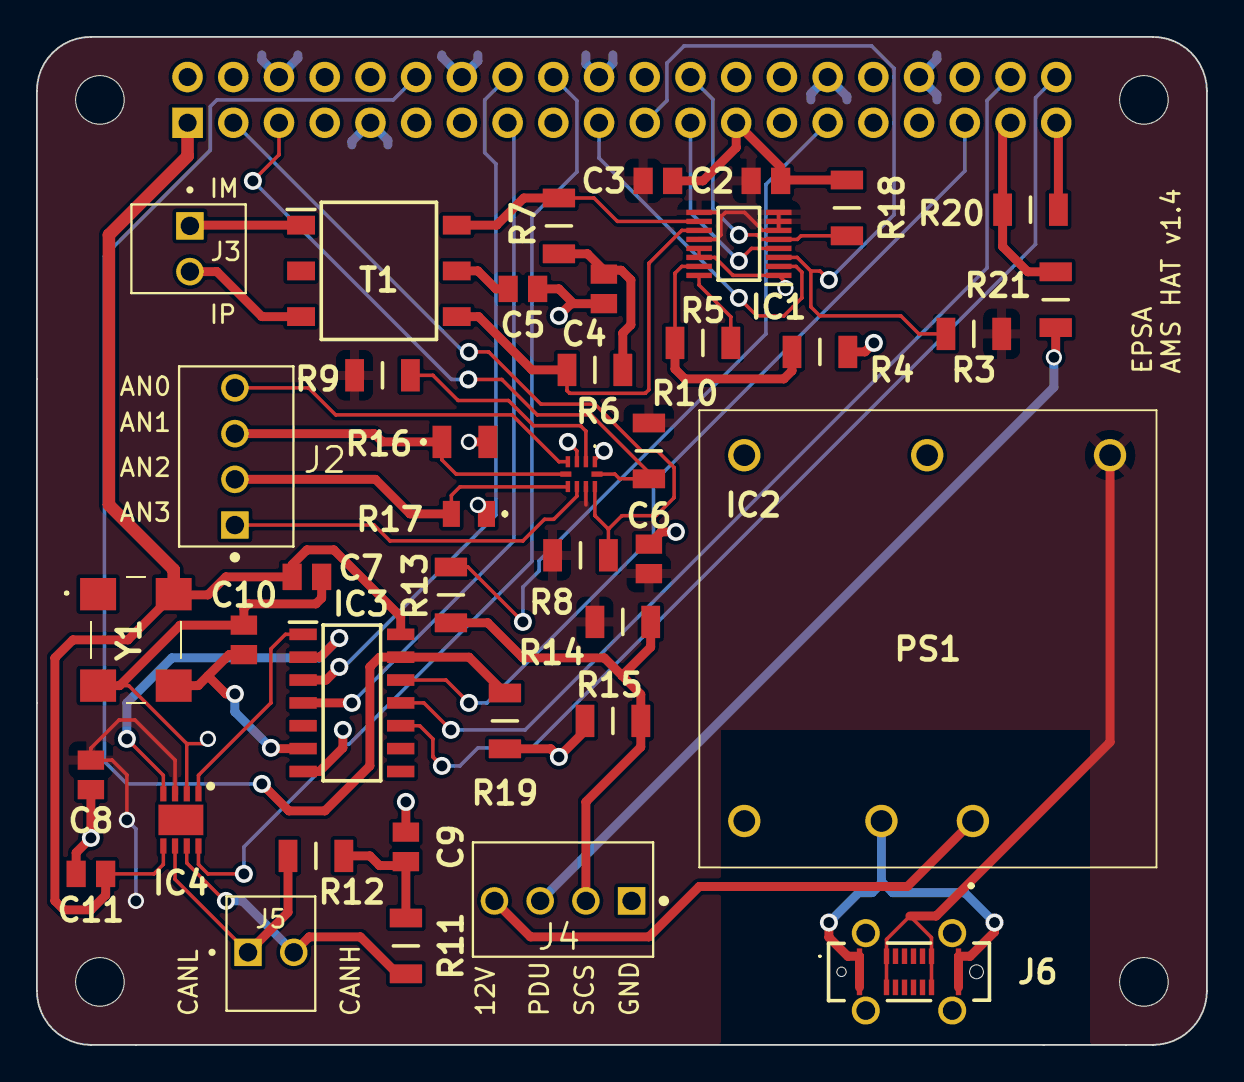
[picture p747: board AMS Dongle.kicad_pcb from above]

Board: 2 copper layers, 65.0 x 56.0 mm, 46 parts (1 on the bottom side), 41 nets.

Parts:
C2, C3, C6, C7, C8, C11: 100n; CAPC2012X130N
C4, C5: 10n; CAPC2012X130N
C9: 4.7n; CAPC2012X130N
C10: 22p; CAPC2012X130N
IC1: LTC6820HMS#PBF; SOP50P490X110-16N
IC2: ADC I2C ADS1115QNKSRQ1; ADS1115QNKSRQ1
IC3: CAN Controller MCP2518FDT-H_SL; SOIC127P600X175-14N
IC4: CAN Transceiver ATA6563-GBQW1; SON65P300X300X90-9N-D
J1: GPIO; PinSocket_2x20_P2.54mm_Vertical
J2, J4: 4P Angle 171857-4004; MOLEX_22-11-2042
J3, J5: 2P Angle 171857-4002; MOLEX_22-11-2022
J6: UJ20-C-V-C-1-SMT-TR; UJ20CVC1SMTTR
MH1, MH2, MH3, MH4: MountingHole_2.7mm_M2.5
PS1: Alim; THN301211
R3, R8, R9, R10: 2k; RESC3216X70N
R4, R5: 1k; RESC3216X70N
R6, R7: 51; RESC3216X70N
R11, R12: 60; RESC3216X70N
R13: 3k9; RESC3216X70N
R14, R15: 8k2; RESC3216X70N
R16: 24 .5W; RCS1206_E3
R17: 47 .5W; RCS0805_E3
R18, R19: 360; RESC3216X70N
R20: 3.6k; RESC3216X70N
R21: 10k; RESC3216X70N
T1: SM91502ALE; SOP254P927X572-6N
Y1: Oscillateur CB3-3C-20M0000; CB3LV3C20M0000

Connections:
+3V3: C7.1, C11.1, IC3.14 (VDD), IC4.5 (VIO), J1.1, J1.17, Y1.4 (VCC)
+5V: C2.1, C3.1, C6.1, C8.2, IC1.6 (VDDS), IC1.7 (POL), IC1.8 (PHA), IC1.9 (VDD), IC1.12 (MSTR), IC2.8 (VDD), IC4.3 (VCC), J6.A4 (VBUS_1), J6.A9 (VBUS_2), J6.B4 (VBUS_3), J6.B9 (VBUS_4), PS1.3 (+VOUT), R3.1, R8.2, R9.1, R10.2, R14.2
+5VP: J1.2, J1.4
+12V: J4.4, PS1.1 (+VIN_(VCC))
/AN0: IC2.4 (AIN0), J2.4
/AN1: IC2.5 (AIN1), J2.3, R16.1
/AN2: IC2.6 (AIN2), J2.2, R17.2
/AN3: IC2.7 (AIN3), J2.1
/CANH: IC4.7 (CANH), J5.2, R11.2
/CANL: IC4.6 (CANL), J5.1, R12.2
/GPIO2/SDA1: IC2.9 (SDA), J1.3, R8.1
/GPIO3/SCL1: IC2.10 (SCL), J1.5, R10.1
/GPIO5: J1.29, R13.2
/GPIO8/SPI0.CE0: IC1.5 (~CS), J1.24, R18.2
/GPIO9/SPI0.MISO: IC1.3 (MISO), J1.21, R3.2
/GPIO10/SPI0.MOSI: IC1.2 (MOSI), J1.19
/GPIO11/SPI0.SCLK: IC1.4 (SCK), J1.23
/GPIO18/PCM.CLK/SPI1.CE0: IC3.13 (NCS), J1.12, R19.1
/GPIO19/PCM.FS/SPI1.MISO: IC3.12 (SDO), J1.35
/GPIO20/PCM.DIN/SPI1.MOSI: IC3.11 (SDI), J1.38
/GPIO21/PCM.DOUT/SPI1.SCLK: IC3.10 (SCK), J1.40
/GPIO22: IC3.4 (~INT), J1.15
/GPIO23: IC3.3 (CLKO/SOF), J1.16
/GPIO24: IC4.8 (STBY), J1.18
/GPIO26: J1.37, R20.2, R21.1
/IM: J3.1, T1.1 (PRI_1)
/IP: J3.2, T1.3 (PRI_3)
/PDU: J4.3, R21.2
/SCS Out: J4.2, R13.1, R14.1, R15.2
GND: C2.2, C3.2, C4.1, C5.2, C6.2, C7.2, C8.1, C9.2, C10.2, C11.2, IC1.1 (EN), IC1.13 (SLOW), IC1.14 (GND), IC2.1 (ADDR), IC2.3 (GND), IC3.7 (VSS), IC4.2 (GND), J1.6, J1.9, J1.14, J1.20, J1.25, J1.30, J1.34, J1.39, J4.1, J6.A1 (GND_1), J6.A12 (GND_2), J6.B1 (GND_3), J6.B12 (GND_4), PS1.2 (-VIN_(GND)), PS1.5 (-VOUT), R4.2, R15.1, R16.2, R17.1, R18.1, R19.2, R20.1, Y1.2 (GND)
unnamed: C4.2, R6.2, R7.1
unnamed: C9.1, R11.1, R12.1
unnamed: IC1.16 (IBIAS), R5.2
unnamed: IC1.15 (ICMP), R4.1, R5.1
unnamed: IC1.10 (IM), R7.2, T1.6 (SEC_3)
unnamed: IC1.11 (IP), R6.1, T1.4 (SEC_1)
unnamed: IC2.2 (ALERT/RDY), R9.2
unnamed: C10.1, IC3.6 (OSC1), Y1.3 (OUTPUT)
unnamed: IC3.2 (RXCAN), IC4.4 (RXD)
unnamed: IC3.1 (TXCAN), IC4.1 (TXD)
unnamed: C5.1, T1.5 (SEC_2)
