EOSCogniton/ELIZ-2022/02 - Documentation/MODAC/Cartes Elec/Accumulator_indicator_voltage/Indicator_voltage.kicad_pcb

## KiCad design 02 - Documentation/MODAC/Cartes Elec/Accumulator_indicator_voltage/Indicator_voltage.kicad_pcb (2024-09-30)

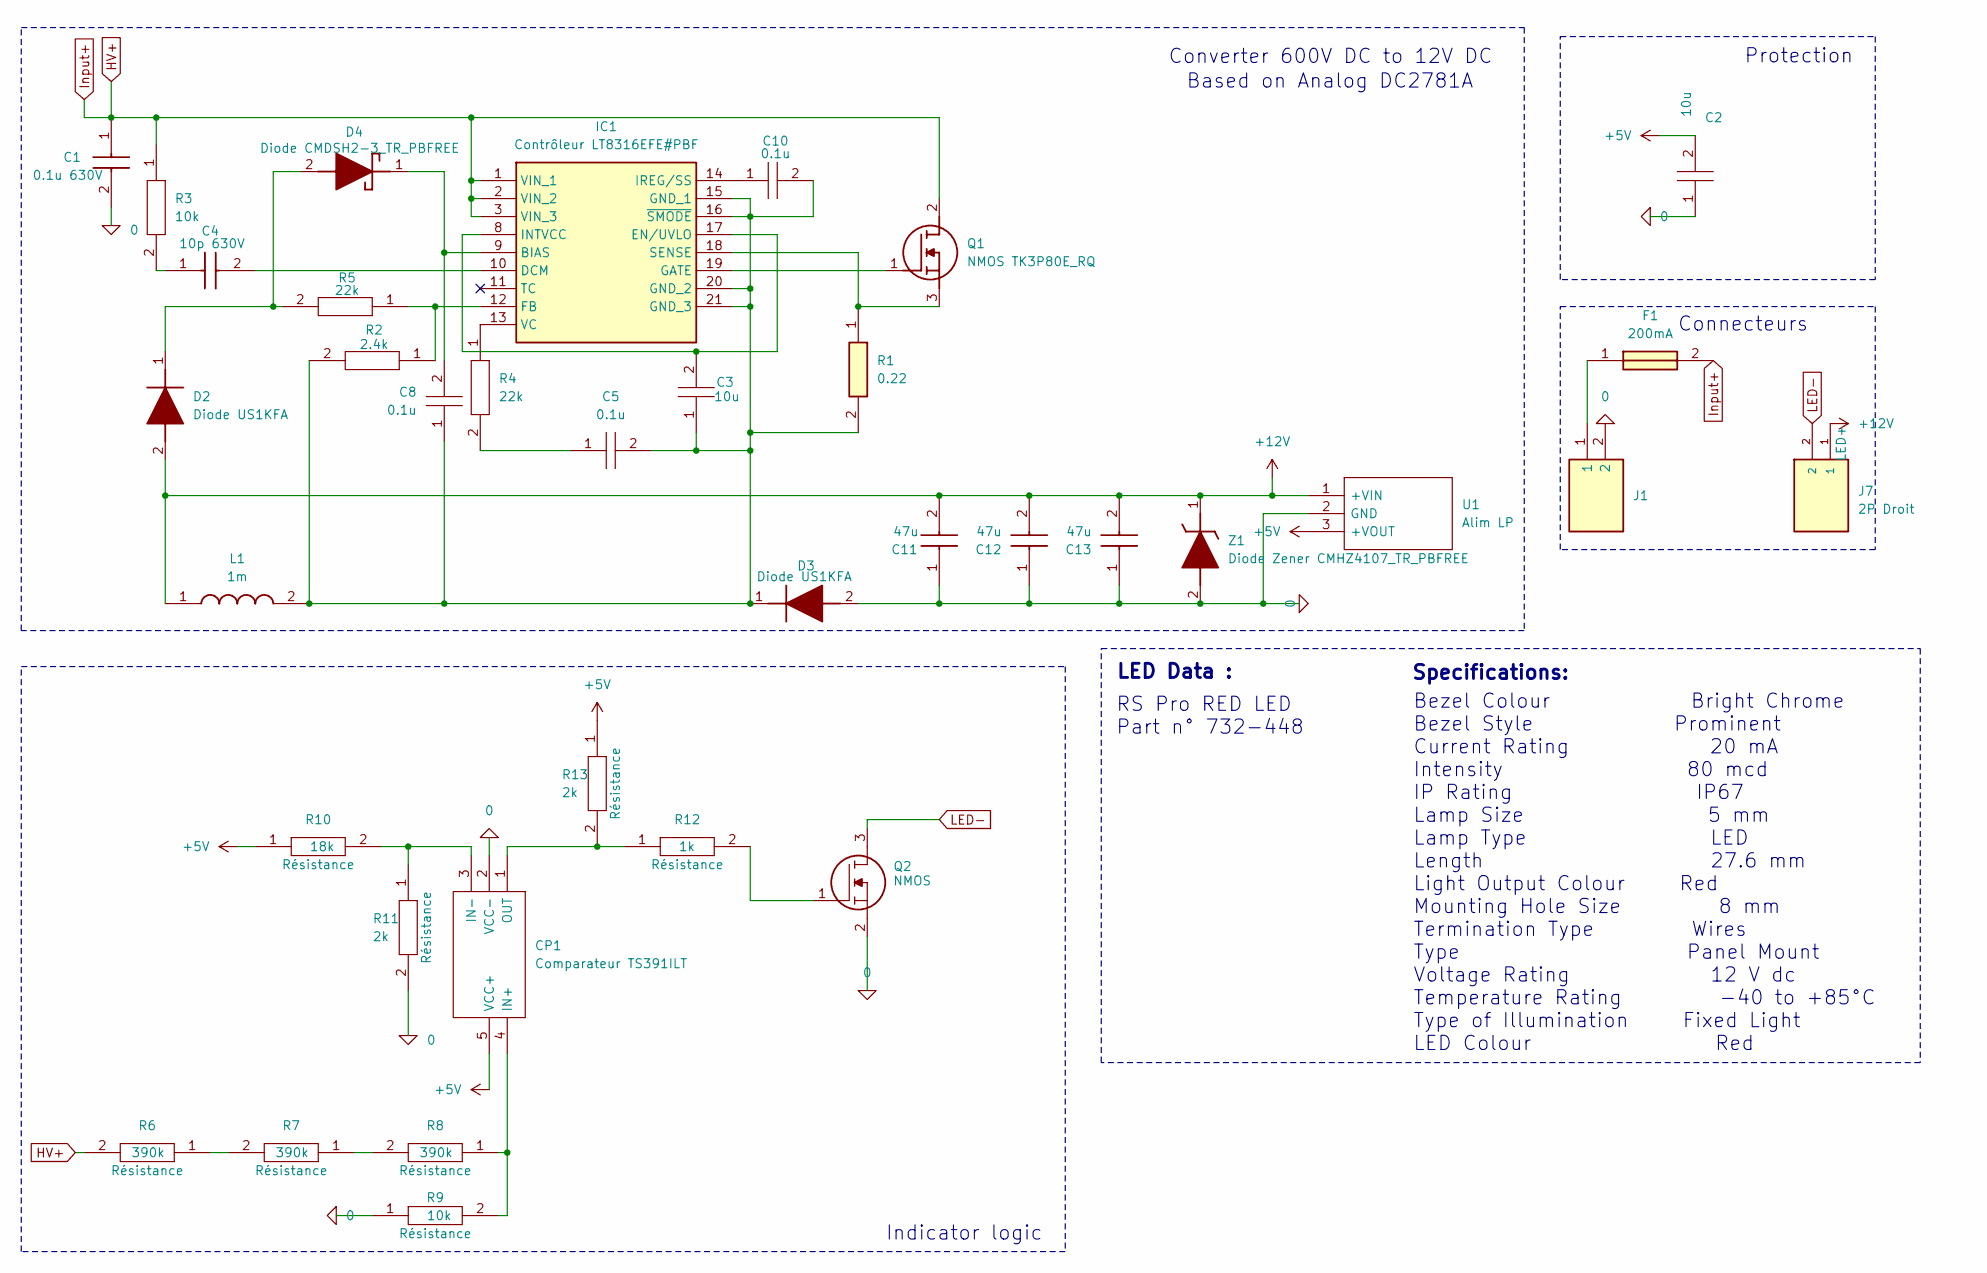
[picture p748: schematic Indicator_voltage.kicad_sch, Accumulator indicator voltage]

Parts:
C1: 0.1u 630V; CAPC4532X200N; Mouser Part Number 81-GCJ43DR72J104KX1L
C2, C3: 10u; CAPC2012X130N; Manufacturer_Part_Number 0805Y1000104JXT
C4: 10p 630V; CAPC3216X100N; Mouser Part Number 81-GRM31A5C2J100JW1D
C5, C8, C10: 0.1u; CAPC2012X130N; Manufacturer_Part_Number 0805Y1000104JXT
C11, C12, C13: 47u; CAPC3225X270N; Mouser Part Number 81-GRM32ER61C476KE5K
CP1: Comparateur TS391ILT; SOT95P280X145-5N; Manufacturer_Part_Number TS391ILT; Mouser Part Number 511-TS391IL
D2, D3: Diode US1KFA; SODFL3618X143N; Mouser Part Number 512-US1KFA
D4: Diode CMDSH2-3_TR_PBFREE; SOD2512X110N; Mouser Part Number 610-CMDSH2-3
F1: 200mA; 0ADAP0200RE; Mouser Part Number 530-0ADAP0200-RE
IC1: Contrôleur LT8316EFE#PBF; LT8315EFEPBF; Mouser Part Number 584-LT8316EFE#PBF
J1: 2P Angle HV 200241-1212; 2002411212; Mouser Part Number 538-200241-1212
J7: 2P Droit 2-11-2022; MOLEX_22-11-2022; PARTREV BD8; Mouser Part Number 538-22-11-2022
L1: 1m; WE-PD_1260_1245_1280_121054; Mouser Part Number 710-7447709102
Q1: NMOS TK3P80E_RQ; TK3P80ERQ; Manufacturer_Part_Number TK3P80E,RQ
Q2: NMOS SQ2348ES-T1_GE3; SOT95P237X112-3N; Manufacturer_Part_Number SQ2348ES-T1_GE3; Mouser Part Number 781-SQ2348ES-T1_GE3
R1: 0.22; RESC1608X55N; Mouser Part Number 754-RL0816S-R22-F
R2: 2.4k; RESC3216X70N; Manufacturer_Part_Number RK73H2BLTDD2152F; Mouser Part Number N/A
R3, R9: 10k; RESC3216X70N; Manufacturer_Part_Number RK73H2BLTDD2152F; Mouser Part Number N/A
R4, R5: 22k; RESC3216X70N; Manufacturer_Part_Number RK73H2BLTDD2152F; Mouser Part Number N/A
R6, R7, R8: 390k; RESC3216X70N; Manufacturer_Part_Number RK73H2BLTDD2152F; Mouser Part Number N/A
R10: 18k; RESC3216X70N; Manufacturer_Part_Number RK73H2BLTDD2152F; Mouser Part Number N/A
R11, R13: 2k; RESC3216X70N; Manufacturer_Part_Number RK73H2BLTDD2152F; Mouser Part Number N/A
R12: 1k; RESC3216X70N; Manufacturer_Part_Number RK73H2BLTDD2152F; Mouser Part Number N/A
U1: Alim LP TSR_0.5-2450; TSR-0.5-2433; Manufacturer_Part_Number TSR 0.5-2450; Mouser Part Number 495-TSR0.5-2450
Z1: Diode Zener CMHZ4107_TR_PBFREE; SOD3816X135N; Manufacturer_Part_Number CMHZ4107 TR PBFREE

Connections:
0: C1.2, C2.1, C11.1, C12.1, C13.1, CP1.2 (VCC-), D3.2 (A), J1.2, Q2.2, R9.1, R11.2, U1.2 (GND), Z1.2 (A)
+5V: C2.2, CP1.5 (VCC+), R10.1, R13.1, U1.3 (+VOUT)
+12V: C11.2, C12.2, C13.2, D2.2 (A), J7.1, L1.1, U1.1 (+VIN), Z1.1 (K)
HV+: C1.1, F1.2, IC1.1 (VIN_1), IC1.2 (VIN_2), IC1.3 (VIN_3), Q1.2 (D), R3.1, R6.2
LED-: J7.2, Q2.3
unnamed: C4.1, R3.2
unnamed: C5.1, R4.2
unnamed: CP1.4 (IN+), R8.1, R9.2
unnamed: CP1.3 (IN-), R10.2, R11.1
unnamed: CP1.1 (OUT), R12.1, R13.2
unnamed: D2.1 (K), D4.2 (A), R5.2
unnamed: C3.1, C5.2, C8.1, C10.2, D3.1 (K), IC1.15 (GND_1), IC1.16 (~SMODE), IC1.20 (GND_2), IC1.21 (GND_3), L1.2, R1.2, R2.2
unnamed: C8.2, D4.1 (K), IC1.9 (BIAS)
unnamed: F1.1, J1.1
unnamed: C4.2, IC1.10 (DCM)
unnamed: C3.2, IC1.8 (INTVCC), IC1.17 (EN/UVLO)
unnamed: IC1.12 (FB), R2.1, R5.1
unnamed: IC1.19 (GATE), Q1.1 (G)
unnamed: C10.1, IC1.14 (IREG/SS)
unnamed: IC1.18 (SENSE), Q1.3 (S), R1.1
unnamed: IC1.13 (VC), R4.1
unnamed: Q2.1, R12.2
unnamed: R6.1, R7.2
unnamed: R7.1, R8.2

Notes on the sheet:
Protection
Based on Analog DC2781A
RS Pro RED LED Part n° 732-448
Indicator logic
LED Data :
Specifications:
Connecteurs
Converter 600V DC to 12V DC
Bezel Colour Bright Chrome Bezel Style Prominent Current Rating 20 mA Intensity 80 mcd IP Rating IP67 Lamp Size 5 mm Lamp Type LED Length 27.6 mm Light Output Colour Red Mounting Hole Size 8 mm Termination Type Wires Type Panel Mount Voltage Rating 12 V dc Temperature Rating -40 to +85°C Type of Il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

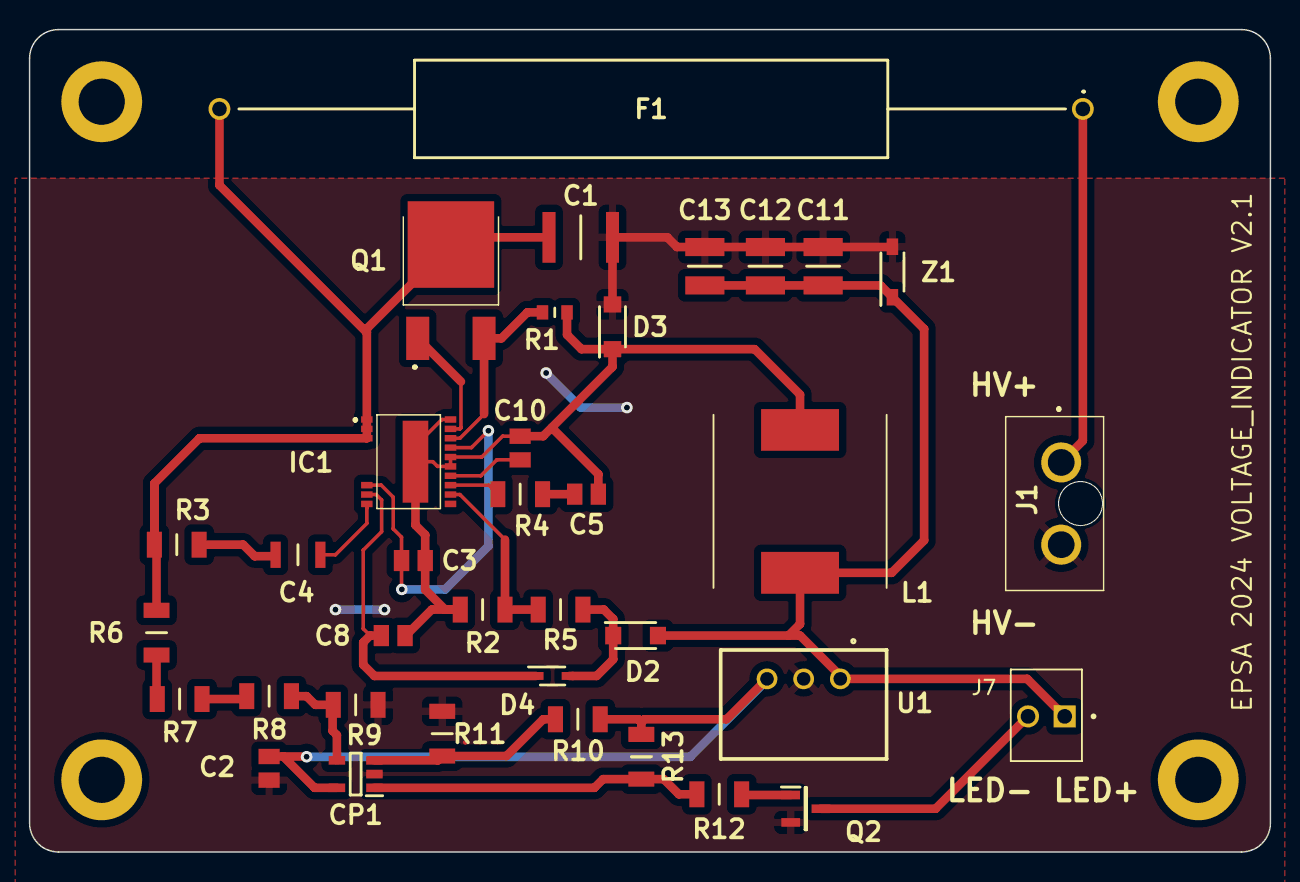
[picture p749: board Indicator_voltage.kicad_pcb from above]

Board: 2 copper layers, 86.0 x 57.0 mm, 36 parts (0 on the bottom side), 24 nets.
