EOSCogniton/ELIZ-2022/02 - Documentation/MODAC/Cartes Elec/IMD SCS Maker/IMD SCS Maker.kicad_pcb

## KiCad design 02 - Documentation/MODAC/Cartes Elec/IMD SCS Maker/IMD SCS Maker.kicad_pcb (2024-09-03)

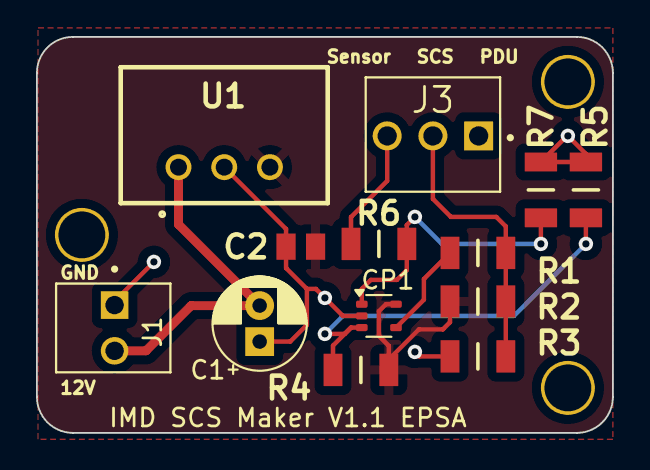
[picture p750: board IMD SCS Maker.kicad_pcb from above]

Board: 2 copper layers, 32.0 x 22.0 mm, 13 parts (0 on the bottom side), 8 nets.

Parts:
C1: C; CP_Radial_D5.0mm_P2.00mm
C2: 10n; CAPC2012X130N
CP1: Comparator; SOT-353_SC-70-5
J1: 2P Droit 2-11-2022; MOLEX_22-11-2022
J3: 3P Droit 22-11-2032; MOLEX_22-11-2032
R1: 3k9; RESC3216X70N
R2, R3: 8k2; RESC3216X70N
R4, R5, R7: 1k; RESC3216X70N
R6: 2k; RESC3216X70N
U1: Alim LP TSR_0.5-2450; TSR-0.5-2433

Connections:
+5V: C2.2, CP1.5 (V+), R2.2, R4.2, U1.3 (+VOUT)
+12V: C1.2, J1.2, U1.1 (+VIN)
/Output SCS: J3.2, R1.1, R2.1, R3.2
/Sensor Output: J3.3, R6.2
GND: C1.1, C2.1, CP1.2 (V-), J1.1, R3.1, R5.2, R7.1, U1.2 (GND)
unnamed: CP1.1 (+), R6.1, R7.2
unnamed: CP1.3 (-), R4.1, R5.1
unnamed: CP1.4, R1.2
