EOSCogniton/ELIZ-2022/02 - Documentation/MODAC/Cartes Elec/TSAC_Voltage_Sensor/TSAC_Voltage_Sensor.kicad_pcb

## KiCad design 02 - Documentation/MODAC/Cartes Elec/TSAC_Voltage_Sensor/TSAC_Voltage_Sensor.kicad_pcb (2024-09-03)

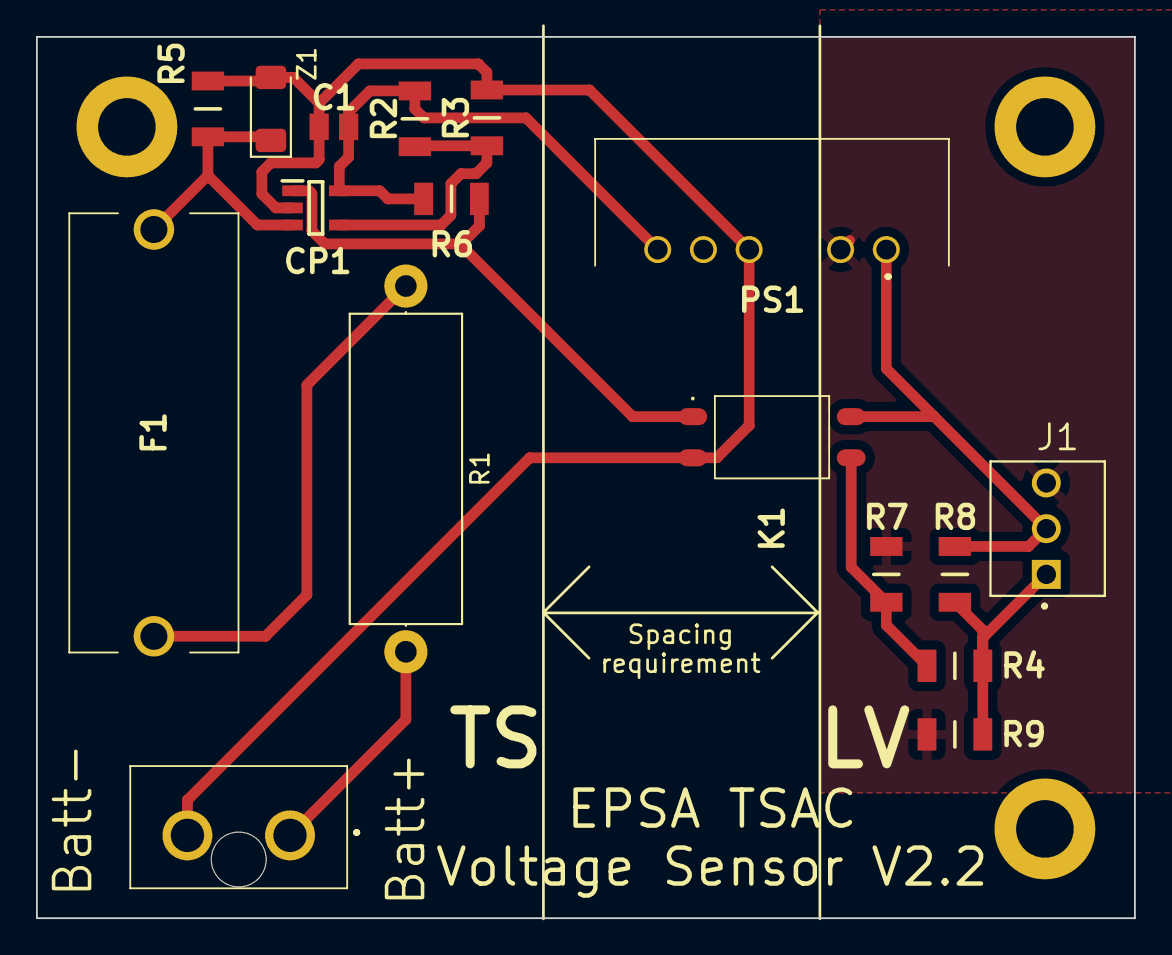
[picture p751: board TSAC_Voltage_Sensor.kicad_pcb from above]

Board: 2 copper layers, 61.0 x 49.0 mm, 17 parts (0 on the bottom side), 11 nets.

Parts:
C1: Condensateur 0805Y1000104JXT; CAPC2012X130N
CP1: Comparateur TS391ILT; SOT95P280X145-5N
F1: Fuse; 0PTF0078P
J1: 3P Droit 22-11-2032; MOLEX_22-11-2032
J2: 200241-1112; 2002411112
K1: SSR CPC1394GR; CPC1394GR
PS1: Alim Iso PDM2-S5-S5-S; PDM2S5S5S
R1: 820k; R_Axial_DIN0617_L17.0mm_D6.0mm_P20.32mm_Horizontal
R2: 1k2; RESC3216X70N
R3: 1k; RESC3216X70N
R4: 3k9; RESC3216X70N
R5: 33k; RESC3216X70N
R6: 2k7; RESC3216X70N
R7: 2k; RESC3216X70N
R8, R9: 8k2; RESC3216X70N
Z1: Zener TZM5224B-GS08; D_MiniMELF

Connections:
0: C1.1, CP1.2 (VCC-), J2.2, K1.2 (-_CONTROL), PS1.4 (0V), R3.2, R5.1, Z1.2
+5V: C1.2, CP1.5 (VCC+), PS1.6 (+VO), R2.2, R6.2
+5VA: J1.2, K1.4 (LOAD_2), PS1.1 (VIN), R8.2
+BATT: J2.1, R1.2
Comp: CP1.1 (OUT), K1.1 (+_CONTROL), R6.1
Exit: J1.1, R4.2, R8.1, R9.2
GND: J1.3, PS1.2 (GND), R7.1, R9.1
unnamed: CP1.4 (IN+), R2.1, R3.1
unnamed: CP1.3 (IN-), F1.2, R5.2, Z1.1
unnamed: F1.1, R1.1
Raw_Exit: K1.3 (LOAD_1), R4.1, R7.2
