EOSCogniton/ELIZ-2022/02 - Documentation/BASTIE/Cartes Artemiz/TSAL (version SCS output)/TSAL/TSAL_dep.kicad_pcb

## KiCad design 02 - Documentation/BASTIE/Cartes Artemiz/TSAL (version SCS output)/TSAL/TSAL_dep.kicad_pcb (2024-02-06)

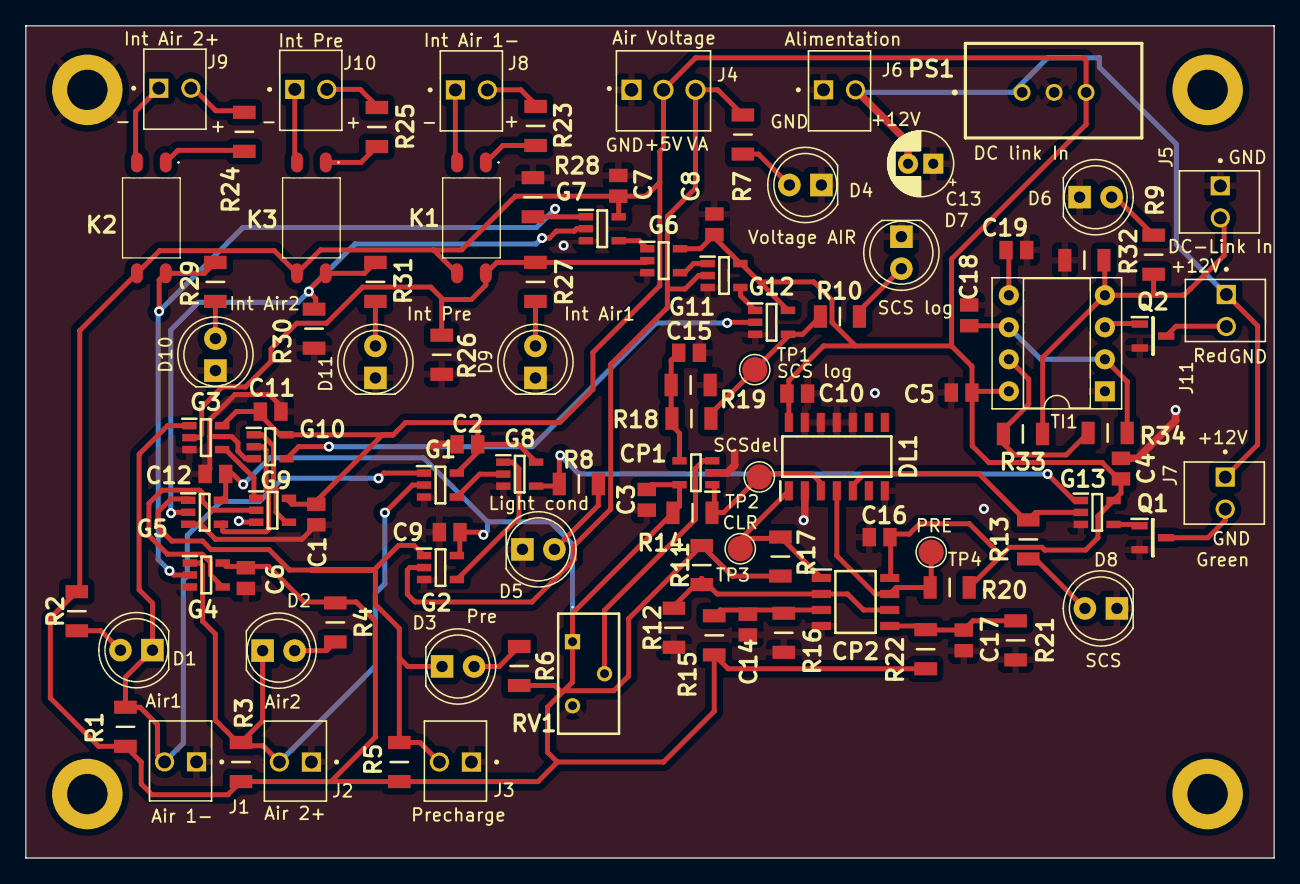
[picture p752: board TSAL_dep.kicad_pcb from above]

Board: 2 copper layers, 99.1 x 66.0 mm, 103 parts (0 on the bottom side), 59 nets.

Parts:
C1, C2, C3, C4, C5, C6, C7, C8, C9, C10, C11, C12, C14, C15, C16, C17, C18, C19: Condensateur 0805Y1000104JXT; CAPC2012X130N
C13: C; CP_Radial_D5.0mm_P2.00mm
CP1: Comparateur TS391ILT; SOT95P280X145-5N
CP2: Comparateur Double LM393LVDR; SOIC127P600X175-8N
D1, D2, D3, D4, D5, D6, D7, D8, D9, D10, D11: LED; LED_D5.0mm
DL1: Bascule D SN74HCS72QDRQ1; SOIC127P600X175-14N
G1, G2, G3, G4, G5, G8, G13: Gate AND SN74AHCT1G08DBVR; SOT95P280X145-5N
G6: Gate NAND SN74AHCT1G00DBVR; SOT95P280X145-5N
G7, G9, G10, G12: Gate OR SN74AHCT1G32DBVR; SOT95P280X145-5N
G11: Gate NOR SN74AHCT1G02DBVR; SOT95P280X145-5N
J1, J2, J3, J5, J6, J7, J8, J9, J10, J11: 2P Droit 2-11-2022; MOLEX_22-11-2022
J4: 3P Droit 22-11-2032; MOLEX_22-11-2032
K1, K2, K3: SSR CPC1394GR; CPC1394GR
PS1: Alim HP TSR_2-2450; TSR-2
Q1, Q2: NMOS SQ2348ES-T1_GE3; SOT95P237X112-3N
R1, R2, R3, R4, R5, R6, R7, R8, R9, R10, R11, R12, R13, R14, R15, R16, R17, R18, R19, R20, R21, R22, R23, R24, R25, R26, R27, R28, R29, R30, R31, R32, R33, R34: Résistance RK73H2BLTDD2152F; RESC3216X70N
RV1: Varystor 3296Y-1-223LF; 3296Y1223LF
TI1: Timer 555 LM555CMX_NOPB; DIP-8_W7.62mm_Socket
TP1, TP2, TP3: type="R" model="TestPoint" lib=""; TestPoint_Pad_D2.0mm
TP4: etype="R" model="TestPoint" lib=""; TestPoint_Pad_D2.0mm

Connections:
0: C1.1, C2.1, C3.1, C4.1, C5.1, C6.1, C7.1, C8.1, C9.1, C10.1, C11.1, C12.1, C13.1, C14.1, C15.2, C16.2, C17.1, C18.1, C19.1, CP1.2 (VCC-), CP2.4 (GND), D4.1 (K), D5.1 (K), D6.1 (K), D7.1 (K), D8.1 (K), D9.1 (K), D10.1 (K), D11.1 (K), DL1.2 (1D), DL1.7 (GND), DL1.10 (2~PRE), DL1.11 (2~CLK), DL1.12 (2D), DL1.13 (2~CLR), G1.3 (GND), G2.3 (GND), G3.3 (GND), G4.3 (GND), G5.3 (GND), G6.3 (GND), G7.3 (GND), G8.3 (GND), G9.3 (GND), G10.3 (GND), G11.3 (GND), G12.3 (GND), G13.3 (GND), J1.1, J2.1, J3.1, J4.1, J5.1, J6.1, PS1.2 (GND), Q1.2, Q2.2, R12.1, R16.1, R19.2, R21.1, R26.2, R28.2, R30.2, R32.2, RV1.3 (CW), TI1.1 (GND)
+5V: C1.2, C2.2, C3.2, C4.2, C5.2, C6.2, C7.2, C8.2, C9.2, C10.2, C11.2, C12.2, C16.1, CP1.5 (VCC+), CP2.8 (V+), DL1.14 (VCC), G1.5 (VCC), G2.5 (VCC), G3.5 (VCC), G4.5 (VCC), G5.5 (VCC), G6.5 (VCC), G7.5 (VCC), G8.5 (VCC), G9.5 (VCC), G10.5 (VCC), G11.5 (VCC), G12.5 (VCC), G13.5 (VCC), J4.2, K1.3 (LOAD_1), K2.3 (LOAD_1), K3.3 (LOAD_1), PS1.3 (+VOUT), R1.2, R2.2, R3.2, R4.2, R5.2, R6.2, R11.2, R14.1, R15.2, R17.2, R20.2, R22.2, RV1.1 (CCW), TI1.8 (+VCC)
+12V: C13.2, J6.2, J7.1, J11.1, PS1.1 (+VIN)
AIR 1: D1.1 (K), G1.1 (A), G3.1 (A), J1.2, R1.1
AIR 2: D2.1 (K), G1.2 (B), G4.1 (A), J2.2, R3.1
CLR: CP2.1 (OUT1), DL1.1 (1~CLR), R17.1, TP3.1
Clign: Q2.1, TI1.3 (OUTPUT)
DC-Link In: J5.2, R9.2, R32.1, R33.2, TI1.4 (RESET)
Int AIR 1: G3.2 (B), G6.2 (B), K1.4 (LOAD_2), R26.1, R27.1
Int AIR 2: G4.2 (B), G7.1 (A), K2.4 (LOAD_2), R28.1, R29.1
Int PreCharge: G5.2 (B), G7.2 (B), K3.4 (LOAD_2), R30.1, R31.1
Lightning cond: G8.4 (Y), G13.1 (A), R8.1
unnamed: C15.1, CP1.4 (IN+), R18.2, R19.1
unnamed: CP1.3 (IN-), RV1.2 (WIPER)
unnamed: C14.2, CP2.3 (IN1+), R15.1, R16.2
unnamed: C17.2, CP2.5 (IN2+), R21.2, R22.1
unnamed: D1.2 (A), R2.1
unnamed: D2.2 (A), R4.1
unnamed: D3.2 (A), R6.1
unnamed: D4.2 (A), R7.1
unnamed: D5.2 (A), R8.2
unnamed: D6.2 (A), R9.1
unnamed: D7.2 (A), R10.2
unnamed: D8.2 (A), R13.2
unnamed: D9.2 (A), R27.2
unnamed: D10.2 (A), R29.2
unnamed: D11.2 (A), R31.2
unnamed: G1.4 (Y), G8.2 (B)
unnamed: G2.4 (Y), G8.1 (A)
unnamed: G3.4 (Y), G9.1 (A)
unnamed: G4.4 (Y), G9.2 (B)
unnamed: G6.1 (A), G7.4 (Y)
unnamed: G9.4 (Y), G10.1 (A)
unnamed: G5.4 (Y), G10.2 (B)
unnamed: G10.4 (Y), G12.2 (B)
unnamed: G6.4 (Y), G11.1 (A)
unnamed: G11.4 (Y), G12.1 (A)
unnamed: G13.4 (Y), Q1.1
unnamed: J7.2, Q1.3
unnamed: J8.2, R23.1
unnamed: J9.2, R24.1
unnamed: J10.2, R25.1
unnamed: J11.2, Q2.3
unnamed: K1.1 (+_CONTROL), R23.2
unnamed: J8.1, K1.2 (-_CONTROL)
unnamed: K2.1 (+_CONTROL), R24.2
unnamed: J9.1, K2.2 (-_CONTROL)
unnamed: K3.1 (+_CONTROL), R25.2
unnamed: J10.1, K3.2 (-_CONTROL)
unnamed: C19.2, TI1.5 (CONTROL_VOLTAGE)
unnamed: R33.1, R34.2, TI1.7 (DISCHARGE)
unnamed: C18.2, R34.1, TI1.2 (TRIGGER), TI1.6 (THRESHOLD)
PRE: CP2.7 (OUT2), DL1.4 (1~PRE), R20.1, TP4.1
PreCharge: D3.1 (K), G2.1 (A), G5.1 (A), J3.2, R5.1
SCS: DL1.5 (1Q), G13.2 (B), R13.1
SCS del: CP1.1 (OUT), DL1.3 (1~CLK), R14.2, TP2.1
SCS log: G12.4 (Y), R10.1, R18.1, TP1.1
VoltageAIR: G2.2 (B), G11.2 (B), J4.3, R7.2
mid Pot: CP2.2 (IN1-), CP2.6 (IN2-), R11.1, R12.2
