EOSCogniton/ELIZ-2022/02 - Documentation/BASTIE/Cartes Artemiz/TSAL (version SCS output)/TSAL_Red/TSAL_Red.kicad_pcb

## KiCad design 02 - Documentation/BASTIE/Cartes Artemiz/TSAL (version SCS output)/TSAL_Red/TSAL_Red.kicad_pcb (2022-11-29)

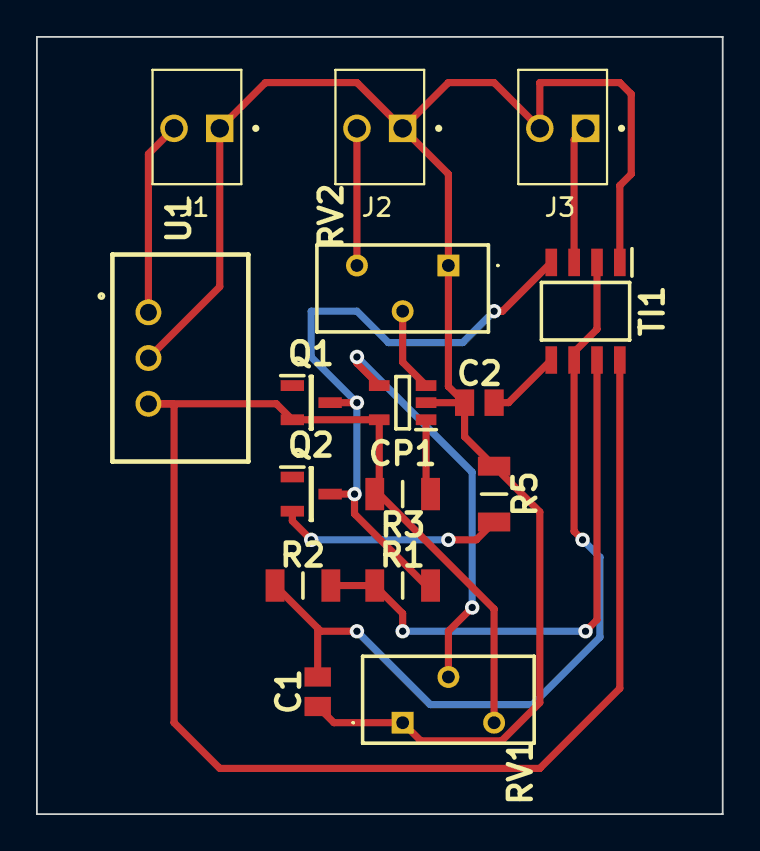
[picture p753: board TSAL_Red.kicad_pcb from above]

Board: 2 copper layers, 38.1 x 43.2 mm, 16 parts (0 on the bottom side), 13 nets.

Parts:
C1, C2: Condensateur 0805Y1000104JXT; CAPC2012X130N
CP1: Comparateur TS391ILT; SOT95P280X145-5N
J1, J2, J3: 2P Droit 2-11-2022; MOLEX_22-11-2022
Q1: PMOS SI2343CDS-T1-GE3; SOT95P237X112-3N
Q2: NMOS SQ2348ES-T1_GE3; SOT95P237X112-3N
R1, R2, R3, R5: Résistance RK73H2BLTDD2152F; RESC3216X70N
RV1, RV2: Varystor 3296Y-1-223LF; 3296Y1223LF
TI1: Timer 555 LM555CMX_NOPB; SOIC127P600X175-8N
U1: Alim LP TSR_0.5-2450; TSR-0.5-2433

Connections:
0: C1.1, C2.1, CP1.2 (VCC-), J1.1, J2.1, J3.2, R5.1, RV1.1 (CCW), RV2.1 (CCW), TI1.1 (GND), U1.2 (GND)
+5V: CP1.5 (VCC+), Q1.2, R3.2, RV1.3 (CW), TI1.8 (+VCC), U1.3 (+VOUT)
/Output: J3.1, TI1.3 (OUTPUT)
/clign: Q1.3, Q2.3, R1.2, TI1.4 (RESET)
unnamed: C1.2, R2.1, TI1.2 (TRIGGER), TI1.6 (THRESHOLD)
unnamed: C2.2, TI1.5 (CONTROL_VOLTAGE)
unnamed: CP1.1 (OUT), Q1.1, Q2.1, R3.1
unnamed: CP1.3 (IN-), RV2.2 (WIPER)
unnamed: CP1.4 (IN+), RV1.2 (WIPER)
unnamed: J1.2, U1.1 (+VIN)
unnamed: J2.2, RV2.3 (CW)
unnamed: Q2.2, R5.2
unnamed: R1.1, R2.2, TI1.7 (DISCHARGE)
