EOSCogniton/ELIZ-2022/02 - Documentation/Kicad/Construction de la librairy/BSPDNModel.kicad_sch

## KiCad design 02 - Documentation/Kicad/Construction de la librairy/BSPDNModel.kicad_sch (2022-10-31)

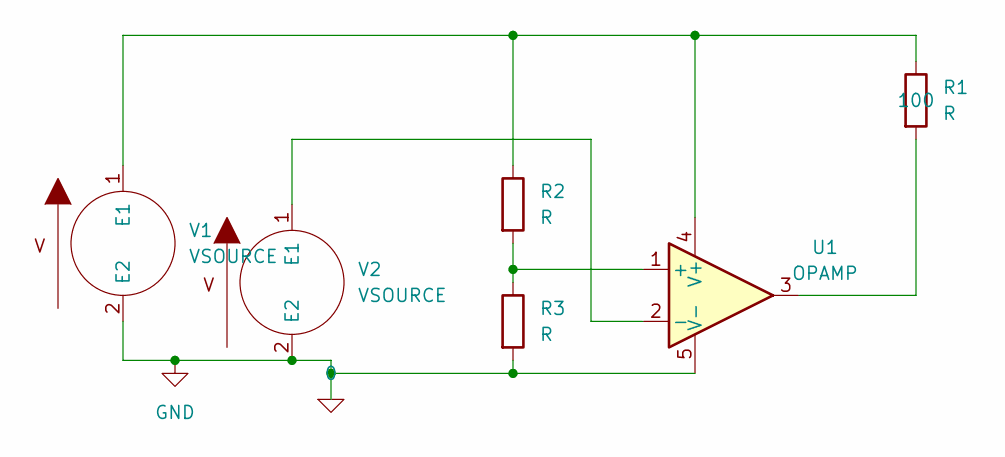
[picture p754: schematic BSPDNModel.kicad_sch]

Parts:
R1, R2, R3: R
U1: OPAMP
V1, V2: VSOURCE

Connections:
0: R3.2, U1.5 (V-), V1.2 (E2), V2.2 (E2)
unnamed: R1.1, R2.1, U1.4 (V+), V1.1 (E1)
unnamed: R1.2, U1.3
unnamed: R2.2, R3.1, U1.1 (+)
unnamed: U1.2 (-), V2.1 (E1)
