EOSCogniton/ELIZ-2022/02 - Documentation/Kicad/Construction de la librairy/BSPDV1.kicad_sch

## KiCad design 02 - Documentation/Kicad/Construction de la librairy/BSPDV1.kicad_sch (2022-10-31)

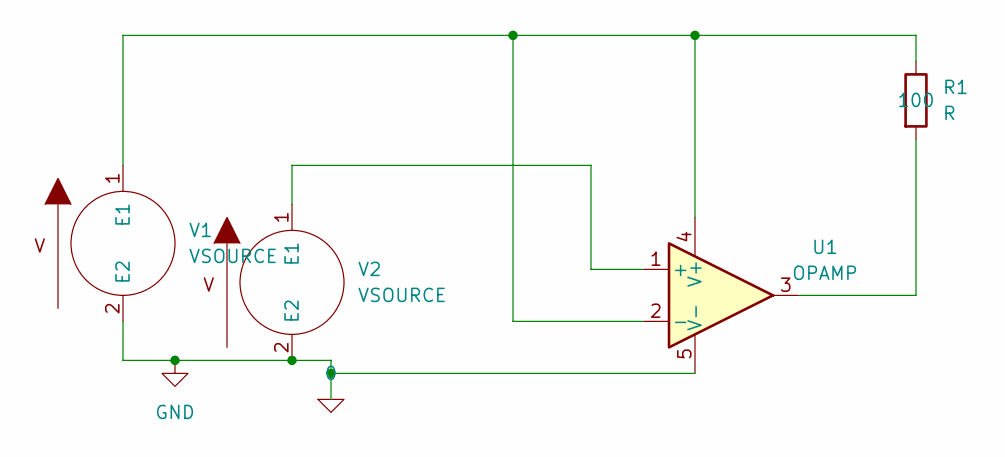
[picture p755: schematic BSPDV1.kicad_sch]

Parts:
R1: R
U1: OPAMP
V1, V2: VSOURCE

Connections:
0: U1.5 (V-), V1.2 (E2), V2.2 (E2)
unnamed: R1.1, U1.2 (-), U1.4 (V+), V1.1 (E1)
unnamed: R1.2, U1.3
unnamed: U1.1 (+), V2.1 (E1)
