EOSCogniton/ELIZ-2022/02 - Documentation/BASTIE/Cartes Valkyriz/AIV/AIV.kicad_sch

## KiCad design 02 - Documentation/BASTIE/Cartes Valkyriz/AIV/AIV.kicad_sch (2023-05-07)

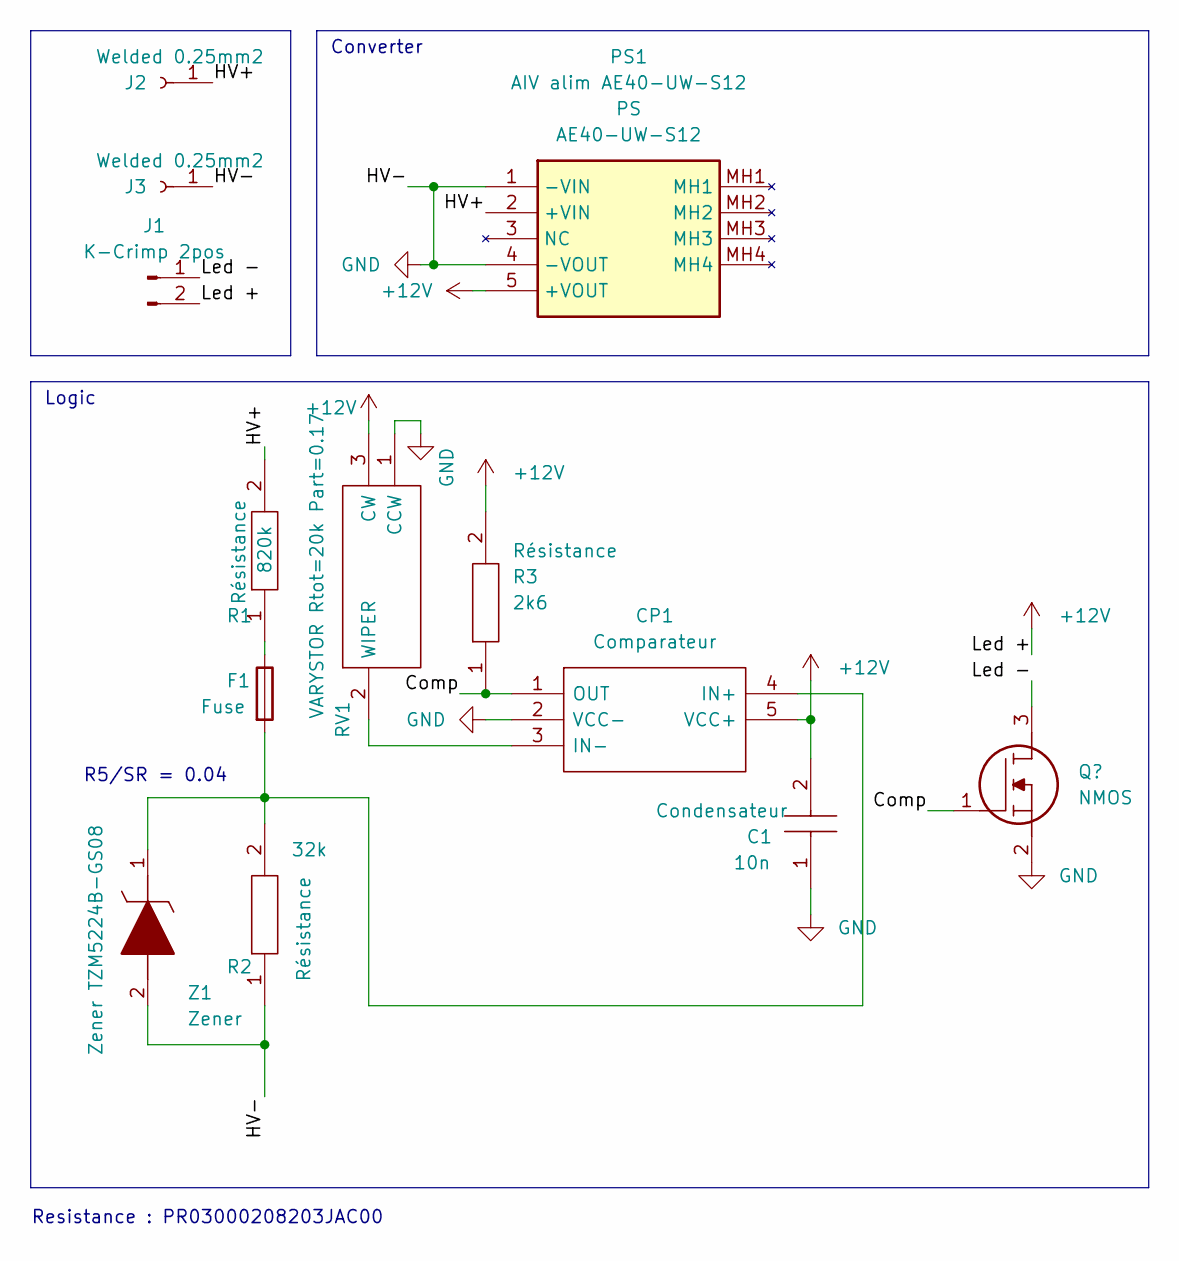
[picture p756: schematic AIV.kicad_sch]

Parts:
C1: Condensateur 0805Y1000104JXT; CAPC2012X130N; Manufacturer_Part_Number 0805Y1000104JXT
CP1: Comparateur TS391ILT; SOT95P280X145-5N; Manufacturer_Part_Number TS391ILT; Mouser Part Number 511-TS391IL
F1: Fuse; 0PTF0078P
J1: K-Crimp 2pos
J2, J3: Welded 0.25mm2
PS1: AIV alim AE40-UW-S12; Manufacturer_Part_Number AE40-UW-S12; Mouser Part Number 490-AE40-UW-S12
R1: Résistance RK73H2BLTDD2152F; R_Axial_DIN0617_L17.0mm_D6.0mm_P20.32mm_Horizontal; Manufacturer_Part_Number RK73H2BLTDD2152F; Mouser Part Number N/A
R2, R3: Résistance RK73H2BLTDD2152F; RESC3216X70N; Manufacturer_Part_Number RK73H2BLTDD2152F; Mouser Part Number N/A
RV1: Varystor 3296Y-1-223LF; 3296Y1223LF; Manufacturer_Part_Number 3296Y-1-223LF; Mouser Part Number 652-3296Y-1-223LF
Z1: Zener TZM5224B-GS08; D_MiniMELF; Manufacturer_Part_Number TZM5224B-GS08; Mouser Part Number 78-TZM5224B

Connections:
+12V: PS1.5 (+VOUT)
Comp: CP1.1 (OUT), R3.1
GND: J3.1, PS1.1 (-VIN), PS1.4 (-VOUT), R2.1, Z1.2
HV+: J2.1, PS1.2 (+VIN), R1.2
Led +: J1.2
Led -: J1.1
unnamed: C1.2, CP1.5 (VCC+)
unnamed: CP1.3 (IN-), RV1.2 (WIPER)
unnamed: CP1.4 (IN+), F1.2, R2.2, Z1.1
unnamed: F1.1, R1.1

Notes on the sheet:
Converter
Resistance : PR03000208203JAC00
Logic
R5/SR = 0.04
