EOSCogniton/ELIZ-2022/02 - Documentation/BASTIE/Cartes Valkyriz/TSAL_Voltage_Sensor/TSAL_Voltage_Sensor.kicad_sch

## KiCad design 02 - Documentation/BASTIE/Cartes Valkyriz/TSAL_Voltage_Sensor/TSAL_Voltage_Sensor.kicad_sch (2023-01-17)

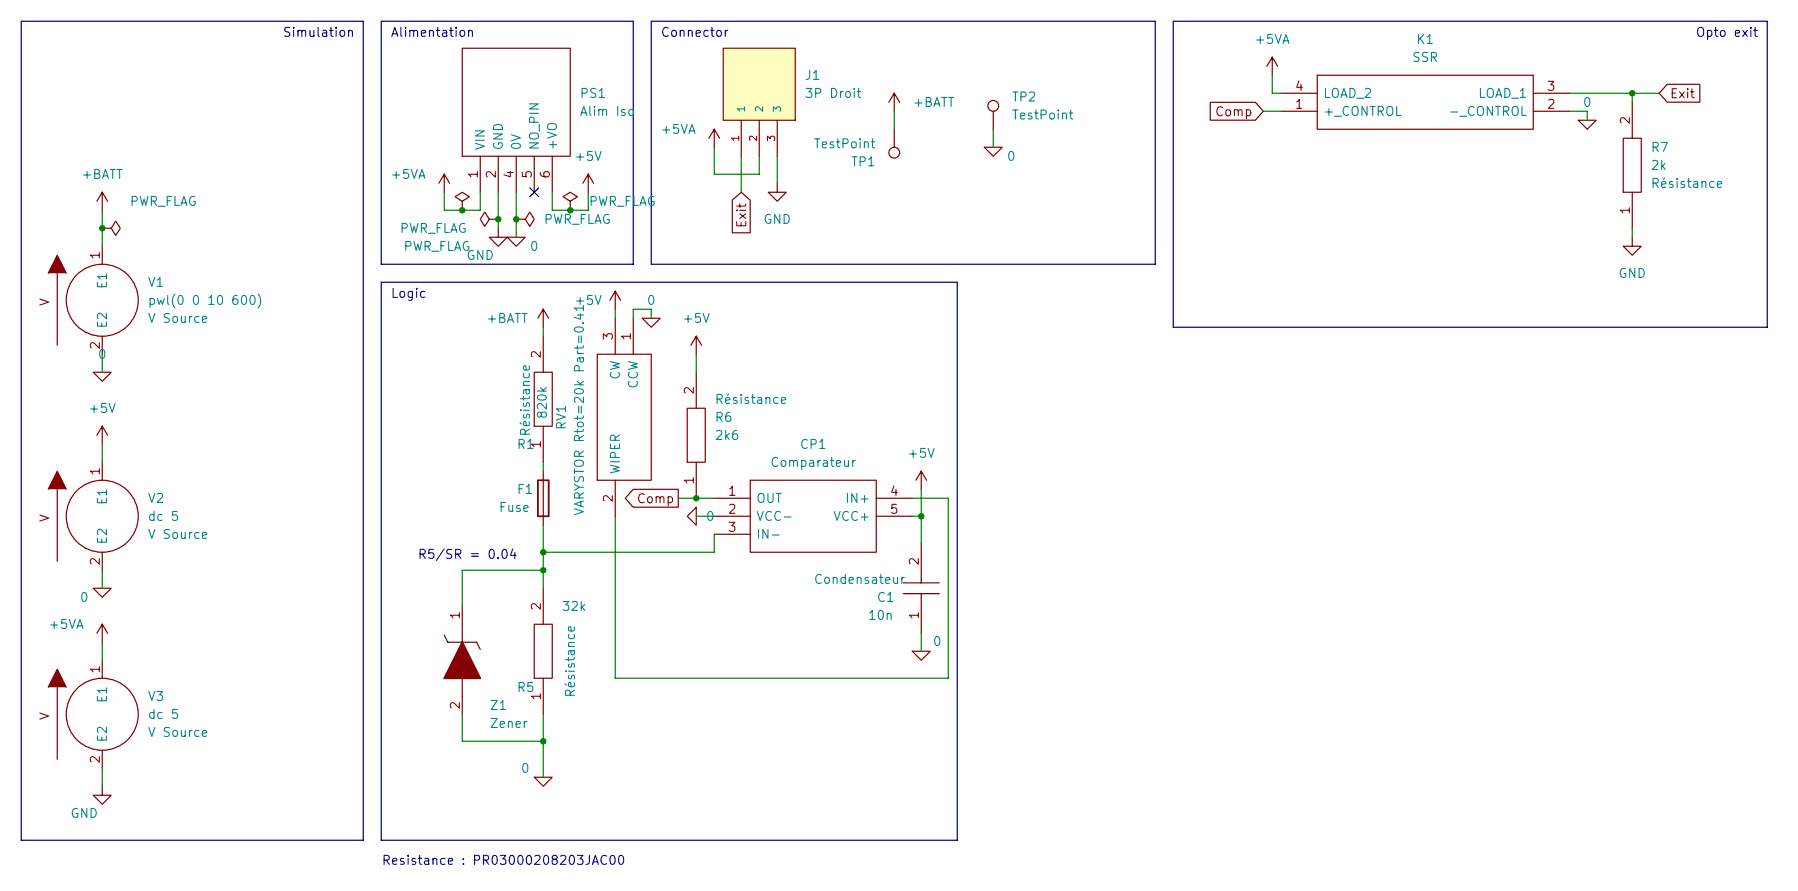
[picture p757: schematic TSAL_Voltage_Sensor.kicad_sch]

Parts:
C1: Condensateur 0805Y1000104JXT; CAPC2012X130N; Manufacturer_Part_Number 0805Y1000104JXT
CP1: Comparateur TS391ILT; SOT95P280X145-5N; Manufacturer_Part_Number TS391ILT; Mouser Part Number 511-TS391IL
F1: Fuse; 0PTF0078P
J1: 3P Droit 22-11-2032; MOLEX_22-11-2032; PARTREV BD8
K1: SSR CPC1394GR; CPC1394GR; Manufacturer_Part_Number CPC1394GR; Mouser Part Number 849-CPC1394GR
PS1: Alim Iso PDM2-S5-S5-S; PDM2S5S5S; Manufacturer_Part_Number PDM2-S5-S5-S; Mouser Part Number 490-PDM2-S5-S5-S
R1: Résistance RK73H2BLTDD2152F; R_Axial_DIN0617_L17.0mm_D6.0mm_P20.32mm_Horizontal; Manufacturer_Part_Number RK73H2BLTDD2152F; Mouser Part Number N/A
R5, R6, R7: Résistance RK73H2BLTDD2152F; RESC3216X70N; Manufacturer_Part_Number RK73H2BLTDD2152F; Mouser Part Number N/A
RV1: Varystor 3296Y-1-223LF; 3296Y1223LF; Manufacturer_Part_Number 3296Y-1-223LF; Mouser Part Number 652-3296Y-1-223LF
TP1, TP2: TestPoint; SolderWire-2.5sqmm_1x01_D2.4mm_OD3.6mm
V1, V2, V3: VSOURCE
Z1: Zener TZM5224B-GS08; D_MiniMELF; Manufacturer_Part_Number TZM5224B-GS08; Mouser Part Number 78-TZM5224B

Connections:
0: C1.1, CP1.2 (VCC-), K1.2 (-_CONTROL), PS1.4 (0V), R5.1, RV1.1 (CCW), TP2.1, V1.2 (E2), V2.2 (E2), Z1.2
+5V: C1.2, CP1.5 (VCC+), PS1.6 (+VO), R6.2, RV1.3 (CW), V2.1 (E1)
+5VA: J1.2, K1.4 (LOAD_2), PS1.1 (VIN), V3.1 (E1)
+BATT: R1.2, TP1.1, V1.1 (E1)
Comp: CP1.1 (OUT), K1.1 (+_CONTROL), R6.1
Exit: J1.1, K1.3 (LOAD_1), R7.2
GND: J1.3, PS1.2 (GND), R7.1, V3.2 (E2)
unnamed: CP1.3 (IN-), F1.2, R5.2, Z1.1
unnamed: CP1.4 (IN+), RV1.2 (WIPER)
unnamed: F1.1, R1.1

Notes on the sheet:
Connector
R5/SR = 0.04
Alimentation
Opto exit
Simulation
Resistance : PR03000208203JAC00
Logic
