EOSCogniton/ELIZ-2022/02 - Documentation/Kicad/Construction de la librairy/Bascule D SN74HCS72QDRQ1 1.5/Bascule D Example.kicad_sch

## KiCad design 02 - Documentation/Kicad/Construction de la librairy/Bascule D SN74HCS72QDRQ1 1.5/Bascule D Example.kicad_sch (2022-10-31)

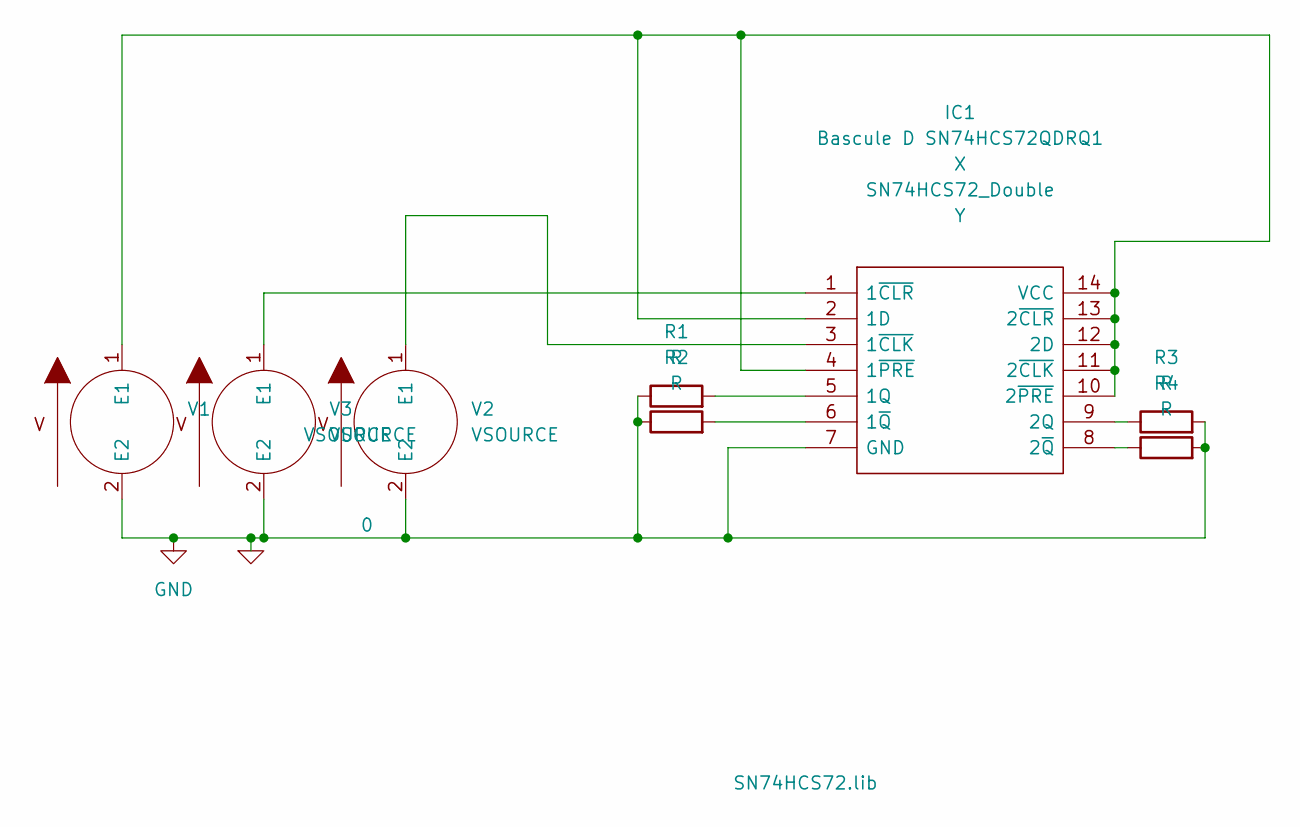
[picture p758: schematic Bascule D Example.kicad_sch]

Parts:
IC1: Bascule D SN74HCS72QDRQ1; SOIC127P600X175-14N; Manufacturer_Part_Number SN74HCS72QDRQ1; Mouser Part Number 595-SN74HCS72QDRQ1
R1, R2, R3, R4: R
V1, V2, V3: VSOURCE

Connections:
0: IC1.7 (GND), R1.1, R2.1, R3.2, R4.2, V1.2 (E2), V2.2 (E2), V3.2 (E2)
unnamed: IC1.1 (1~CLR), V3.1 (E1)
unnamed: IC1.3 (1~CLK), V2.1 (E1)
unnamed: IC1.5 (1Q), R1.2
unnamed: IC1.6 (1~Q), R2.2
unnamed: IC1.8 (2~Q), R4.1
unnamed: IC1.9 (2Q), R3.1
unnamed: IC1.2 (1D), IC1.4 (1~PRE), IC1.10 (2~PRE), IC1.11 (2~CLK), IC1.12 (2D), IC1.13 (2~CLR), IC1.14 (VCC), V1.1 (E1)
