EOSCogniton/ELIZ-2022/02 - Documentation/Kicad/Construction de la librairy/Comparateur Double LM393LVDR 1.2/Spice Model Double Comparator.kicad_sch

## KiCad design 02 - Documentation/Kicad/Construction de la librairy/Comparateur Double LM393LVDR 1.2/Spice Model Double Comparator.kicad_sch (2022-10-31)

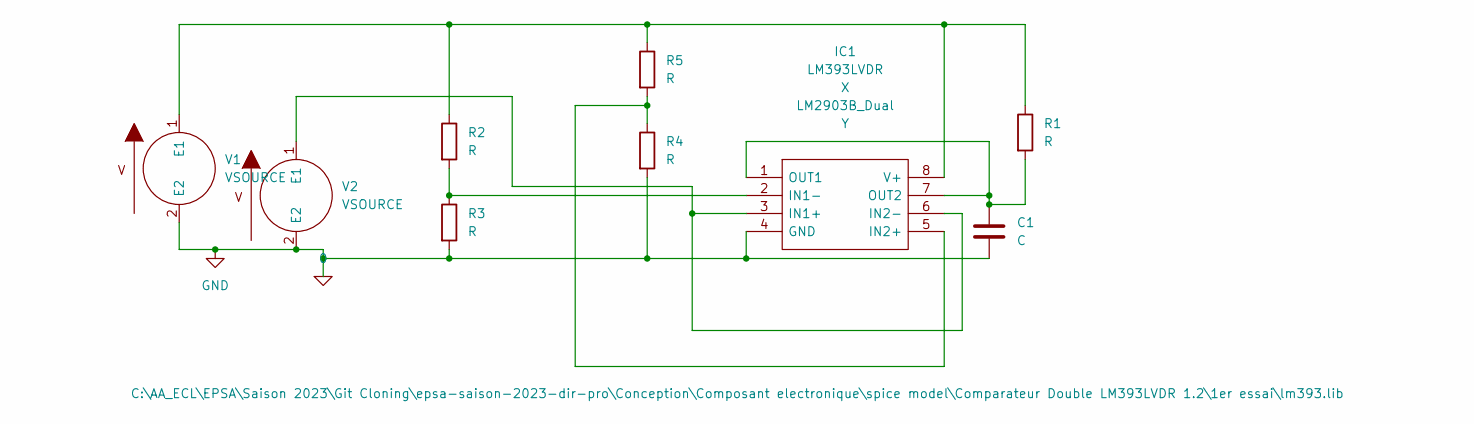
[picture p759: schematic Spice Model Double Comparator.kicad_sch]

Parts:
C1: C
IC1: LM393LVDR; SOIC127P600X175-8N; Manufacturer_Part_Number LM393LVDR; Mouser Part Number 595-LM393LVDR
R1, R2, R3, R4, R5: R
V1, V2: VSOURCE

Connections:
0: C1.2, IC1.4 (GND), R3.2, R4.2, V1.2 (E2), V2.2 (E2)
unnamed: C1.1, IC1.1 (OUT1), IC1.7 (OUT2), R1.2
unnamed: IC1.2 (IN1-), R2.2, R3.1
unnamed: IC1.3 (IN1+), IC1.6 (IN2-), V2.1 (E1)
unnamed: IC1.5 (IN2+), R4.1, R5.2
unnamed: IC1.8 (V+), R1.1, R2.1, R5.1, V1.1 (E1)
