EOSCogniton/ELIZ-2022/02 - Documentation/Kicad/Construction de la librairy/Comparateur Simple TS391ILT 0.7/Comparateur Simple.kicad_sch

## KiCad design 02 - Documentation/Kicad/Construction de la librairy/Comparateur Simple TS391ILT 0.7/Comparateur Simple.kicad_sch (2022-10-31)

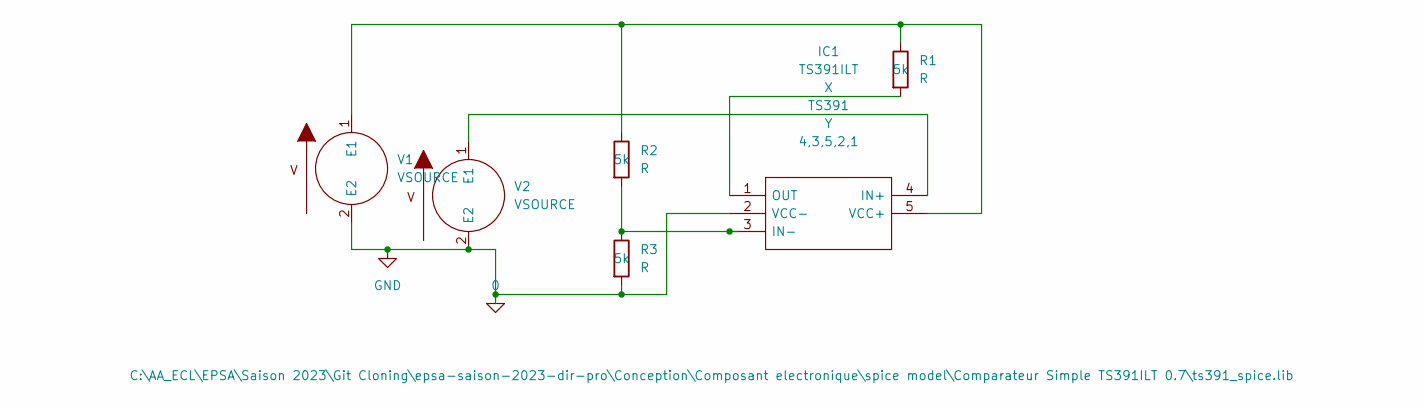
[picture p760: schematic Comparateur Simple.kicad_sch]

Parts:
IC1: TS391ILT; SOT95P280X145-5N; Manufacturer_Part_Number TS391ILT; Mouser Part Number 511-TS391IL
R1, R2, R3: R
V1, V2: VSOURCE

Connections:
0: IC1.2 (VCC-), R3.2, V1.2 (E2), V2.2 (E2)
unnamed: IC1.1 (OUT), R1.2
unnamed: IC1.3 (IN-), R2.2, R3.1
unnamed: IC1.4 (IN+), V2.1 (E1)
unnamed: IC1.5 (VCC+), R1.1, R2.1, V1.1 (E1)
