EOSCogniton/ELIZ-2022/02 - Documentation/Kicad/Construction de la librairy/Diode RFN1VWM2STF/Diode Example.kicad_sch

## KiCad design 02 - Documentation/Kicad/Construction de la librairy/Diode RFN1VWM2STF/Diode Example.kicad_sch (2022-10-31)

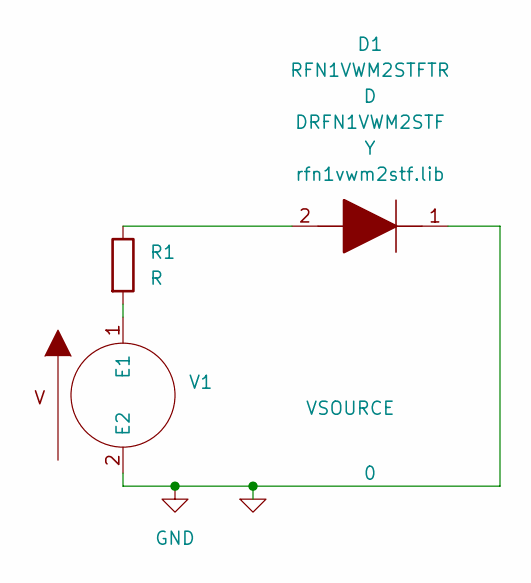
[picture p761: schematic Diode Example.kicad_sch]

Parts:
D1: RFN1VWM2STFTR; Manufacturer_Part_Number RFN1VWM2STFTR; Mouser Part Number 755-RFN1VWM2STFTR
R1: R
V1: VSOURCE

Connections:
0: D1.1, V1.2 (E2)
unnamed: D1.2, R1.1
unnamed: R1.2, V1.1 (E1)
