EOSCogniton/ELIZ-2022/02 - Documentation/Kicad/Construction de la librairy/NMOS SQ2348ES-T1_BE3 1.5/NMOS Example.kicad_sch

## KiCad design 02 - Documentation/Kicad/Construction de la librairy/NMOS SQ2348ES-T1_BE3 1.5/NMOS Example.kicad_sch (2022-10-31)

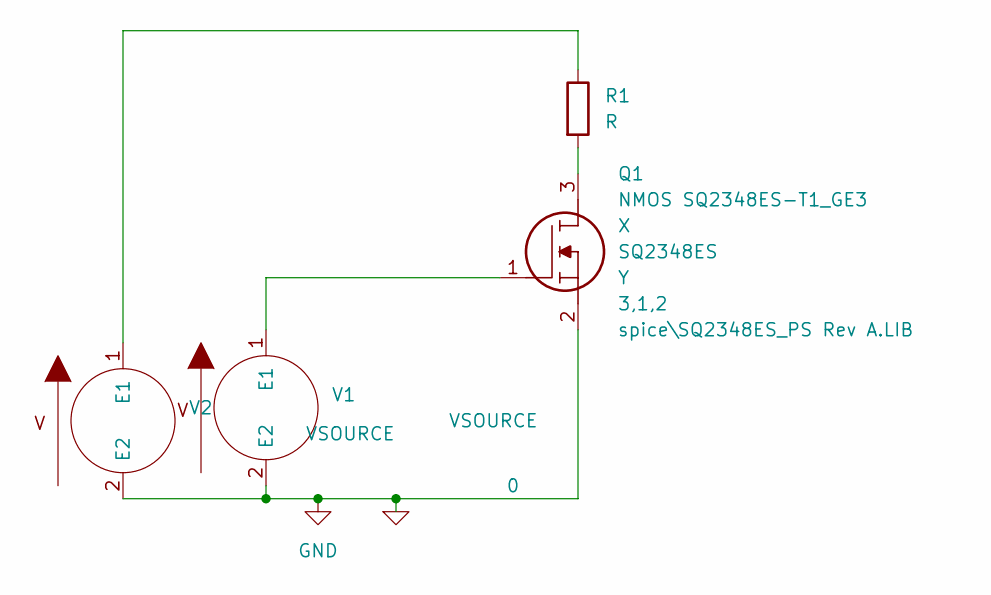
[picture p762: schematic NMOS Example.kicad_sch]

Parts:
Q1: NMOS SQ2348ES-T1_GE3; SOT95P237X112-3N; Manufacturer_Part_Number SQ2348ES-T1_GE3; Mouser Part Number 781-SQ2348ES-T1_GE3
R1: R
V1, V2: VSOURCE

Connections:
0: Q1.2, V1.2 (E2), V2.2 (E2)
unnamed: Q1.1, V1.1 (E1)
unnamed: Q1.3, R1.2
unnamed: R1.1, V2.1 (E1)
