EOSCogniton/ELIZ-2022/02 - Documentation/Kicad/Construction de la librairy/BSPDNModel.kicad_sch

## KiCad design 02 - Documentation/Kicad/Construction de la librairy/PMOS SI2343CDS-T1-GE3 1.5/PMOS Example.kicad_sch

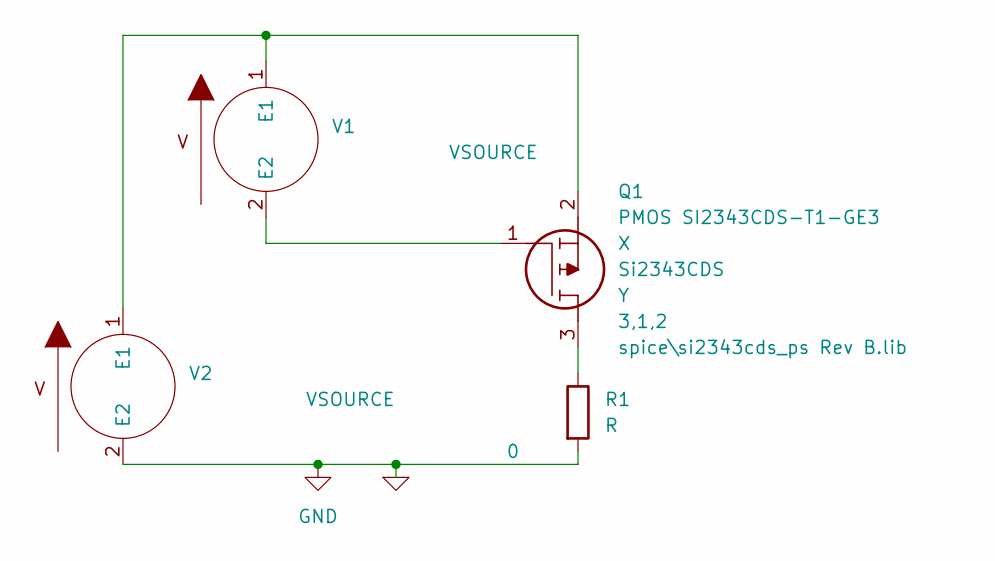
[picture p763: schematic PMOS Example.kicad_sch]

Parts:
Q1: PMOS SI2343CDS-T1-GE3; SOT95P237X112-3N; Manufacturer_Part_Number SI2343CDS-T1-GE3; Mouser Part Number 781-SI2343CDS-T1-GE3
R1: R
V1, V2: VSOURCE

Connections:
0: R1.2, V2.2 (E2)
unnamed: Q1.1, V1.2 (E2)
unnamed: Q1.2, V1.1 (E1), V2.1 (E1)
unnamed: Q1.3, R1.1
