EOSCogniton/ELIZ-2022/02 - Documentation/Kicad/Construction de la librairy/Timer LM555CMX NOPB 0.2/Timer Example.kicad_sch

## KiCad design 02 - Documentation/Kicad/Construction de la librairy/Timer LM555CMX NOPB 0.2/Timer Example.kicad_sch (2022-10-31)

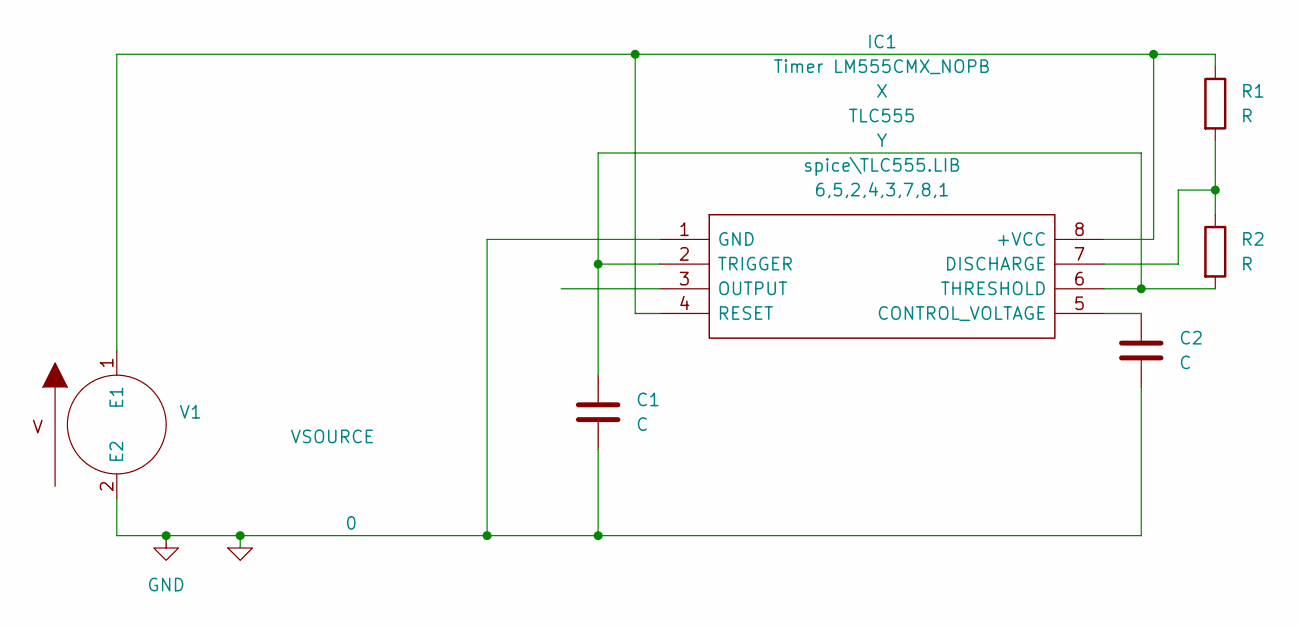
[picture p765: schematic Timer Example.kicad_sch]

Parts:
C1, C2: C
IC1: Timer LM555CMX_NOPB; SOIC127P600X175-8N; Manufacturer_Part_Number LM555CMX/NOPB; Mouser Part Number 926-LM555CMX/NOPB
R1, R2: R
V1: VSOURCE

Connections:
0: C1.2, C2.2, IC1.1 (GND), V1.2 (E2)
unnamed: C1.1, IC1.2 (TRIGGER), IC1.6 (THRESHOLD), R2.2
unnamed: C2.1, IC1.5 (CONTROL_VOLTAGE)
unnamed: IC1.4 (RESET), IC1.8 (+VCC), R1.1, V1.1 (E1)
unnamed: IC1.7 (DISCHARGE), R1.2, R2.1
