EOSCogniton/ELIZ-2022/02 - Documentation/Kicad/Construction de la librairy/BSPDNModel.kicad_sch

## KiCad design 02 - Documentation/Kicad/Construction de la librairy/Varystor 3296Y 0.3/Varystor Example.kicad_sch

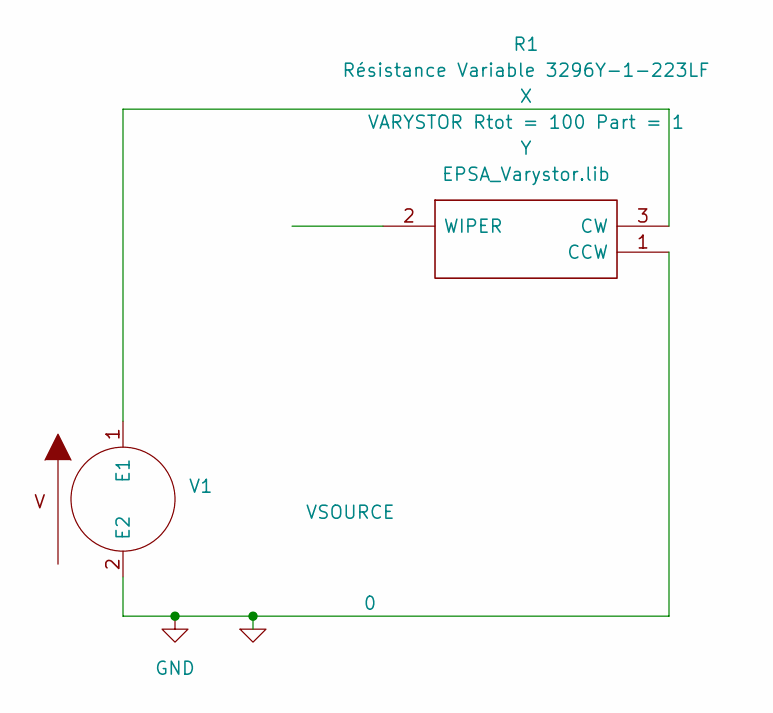
[picture p766: schematic Varystor Example.kicad_sch]

Parts:
R1: Résistance Variable 3296Y-1-223LF; 3296Y1223LF; Manufacturer_Part_Number 3296Y-1-223LF; Mouser Part Number 652-3296Y-1-223LF
V1: VSOURCE

Connections:
0: R1.1 (CCW), V1.2 (E2)
unnamed: R1.3 (CW), V1.1 (E1)
