EOSCogniton/ELIZ-2022/02 - Documentation/Kicad/Pack Elec/Kicad Spice Exemple/Comparateur Simple Example.kicad_sch

## KiCad design 02 - Documentation/Kicad/Pack Elec/Kicad Spice Exemple/Comparateur Simple Example.kicad_sch (2022-10-31)

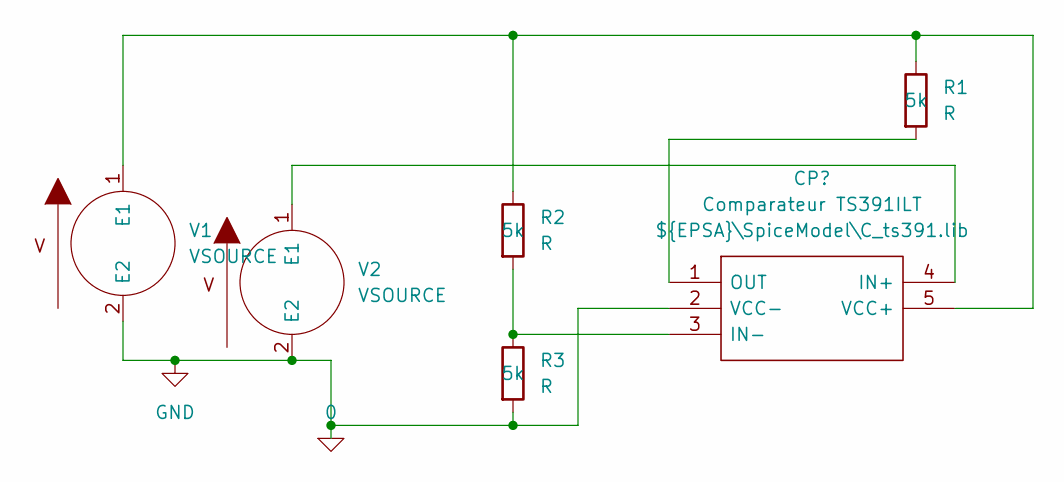
[picture p767: schematic Comparateur Simple Example.kicad_sch]

Parts:
R1, R2, R3: R
V1, V2: VSOURCE

Connections:
0: R3.2, V1.2 (E2), V2.2 (E2)
unnamed: R1.1, R2.1, V1.1 (E1)
unnamed: R2.2, R3.1
