EOSCogniton/ELIZ-2022/02 - Documentation/Kicad/Pack Elec/Kicad Spice Exemple/SSR Example.kicad_sch

## KiCad design 02 - Documentation/Kicad/Pack Elec/Kicad Spice Exemple/SSR Example.kicad_sch (2022-10-31)

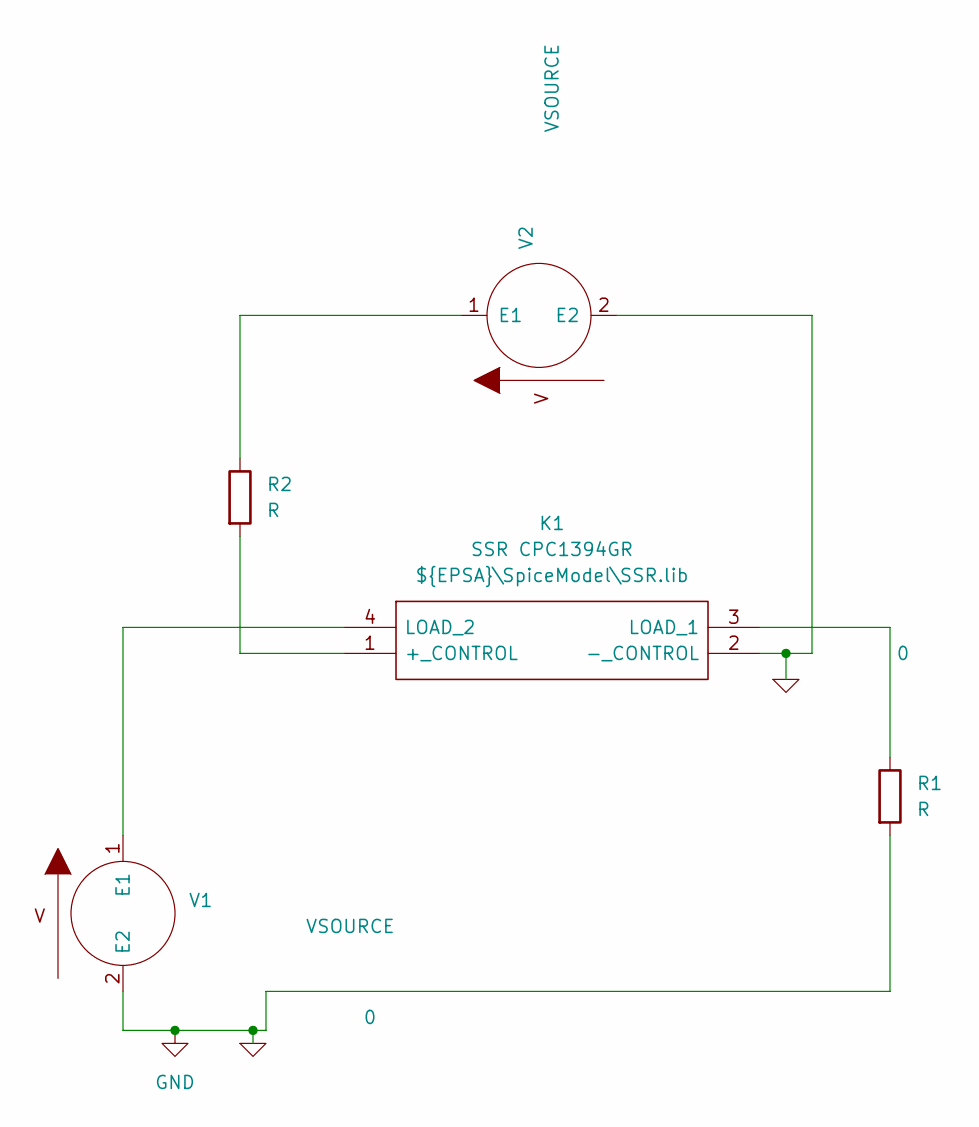
[picture p769: schematic SSR Example.kicad_sch]

Parts:
K1: SSR CPC1394GR; CPC1394GR; Manufacturer_Part_Number CPC1394GR; Mouser Part Number 849-CPC1394GR
R1, R2: R
V1, V2: VSOURCE

Connections:
0: K1.2 (-_CONTROL), R1.2, V1.2 (E2), V2.2 (E2)
unnamed: K1.1 (+_CONTROL), R2.2
unnamed: K1.3 (LOAD_1), R1.1
unnamed: K1.4 (LOAD_2), V1.1 (E1)
unnamed: R2.1, V2.1 (E1)
