EOSCogniton/ELIZ-2022/02 - Documentation/Kicad/Pack Elec/Kicad Spice Exemple/Timer Example.kicad_sch

## KiCad design 02 - Documentation/Kicad/Pack Elec/Kicad Spice Exemple/Timer Example.kicad_sch (2022-10-31)

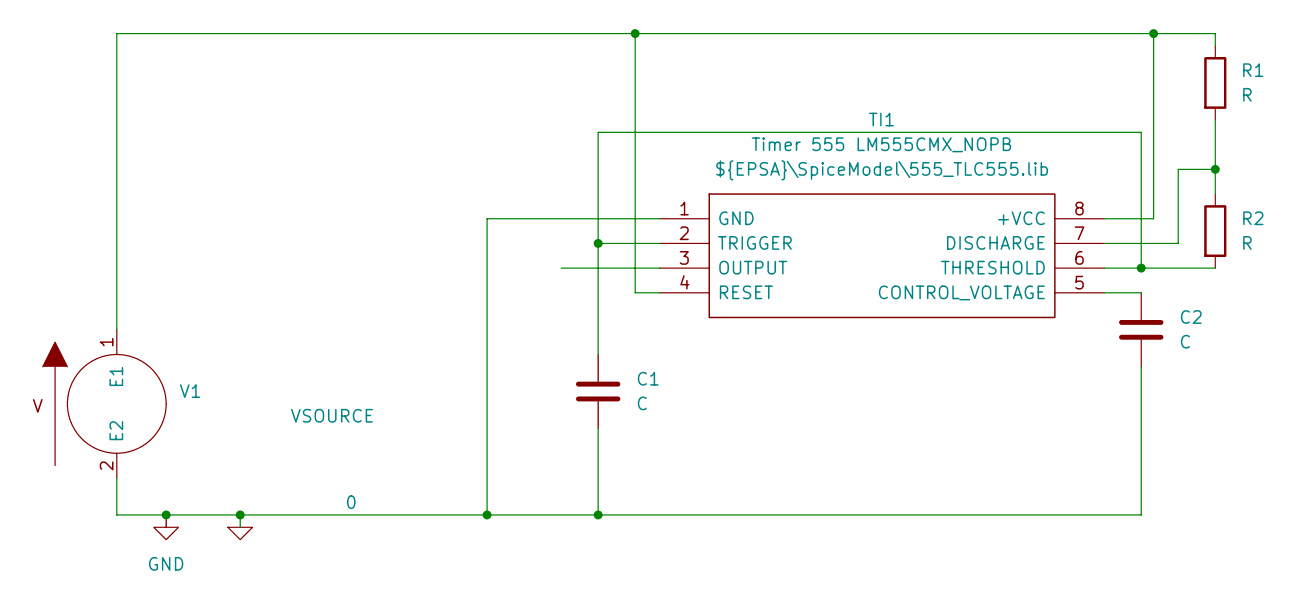
[picture p770: schematic Timer Example.kicad_sch]

Parts:
C1, C2: C
R1, R2: R
TI1: Timer 555 LM555CMX_NOPB; SOIC127P600X175-8N; Manufacturer_Part_Number LM555CMX/NOPB; Mouser Part Number 926-LM555CMX/NOPB
V1: VSOURCE

Connections:
0: C1.2, C2.2, TI1.1 (GND), V1.2 (E2)
unnamed: C1.1, R2.2, TI1.2 (TRIGGER), TI1.6 (THRESHOLD)
unnamed: C2.1, TI1.5 (CONTROL_VOLTAGE)
unnamed: R1.1, TI1.4 (RESET), TI1.8 (+VCC), V1.1 (E1)
unnamed: R1.2, R2.1, TI1.7 (DISCHARGE)
