EOSCogniton/ELIZ-2022/02 - Documentation/Kicad/Pack Elec/Kicad Spice Exemple/Varystor Example.kicad_sch

## KiCad design 02 - Documentation/Kicad/Pack Elec/Kicad Spice Exemple/Varystor Example.kicad_sch (2022-10-31)

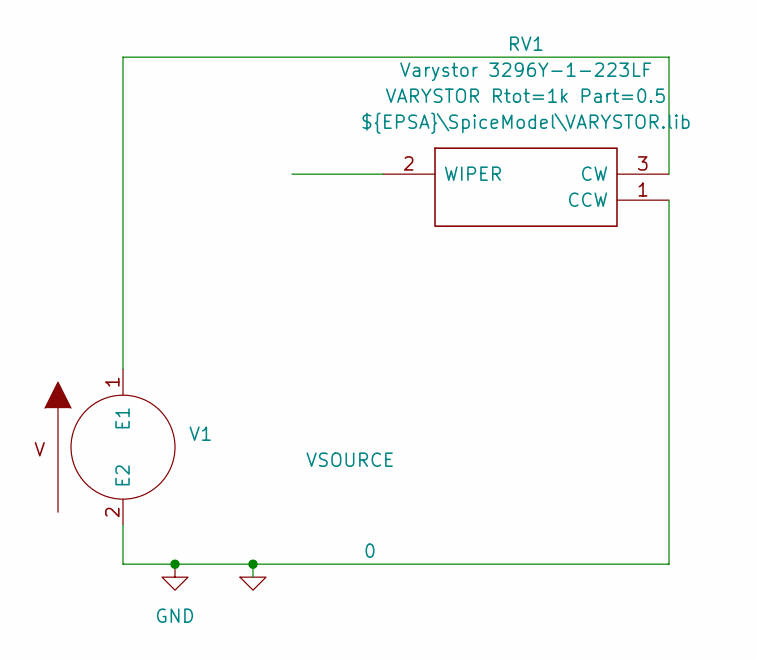
[picture p771: schematic Varystor Example.kicad_sch]

Parts:
RV1: Varystor 3296Y-1-223LF; 3296Y1223LF; Manufacturer_Part_Number 3296Y-1-223LF; Mouser Part Number 652-3296Y-1-223LF
V1: VSOURCE

Connections:
0: RV1.1 (CCW), V1.2 (E2)
unnamed: RV1.3 (CW), V1.1 (E1)
