EOSCogniton/ELIZ-2022/02 - Documentation/BASTIE/Cartes Valkyriz/BENCH/CAN_Switcher/CAN_Switcher.kicad_sch

## KiCad design 02 - Documentation/BASTIE/Cartes Valkyriz/BENCH/CAN_Switcher/CAN_Switcher.kicad_sch (2023-03-08)

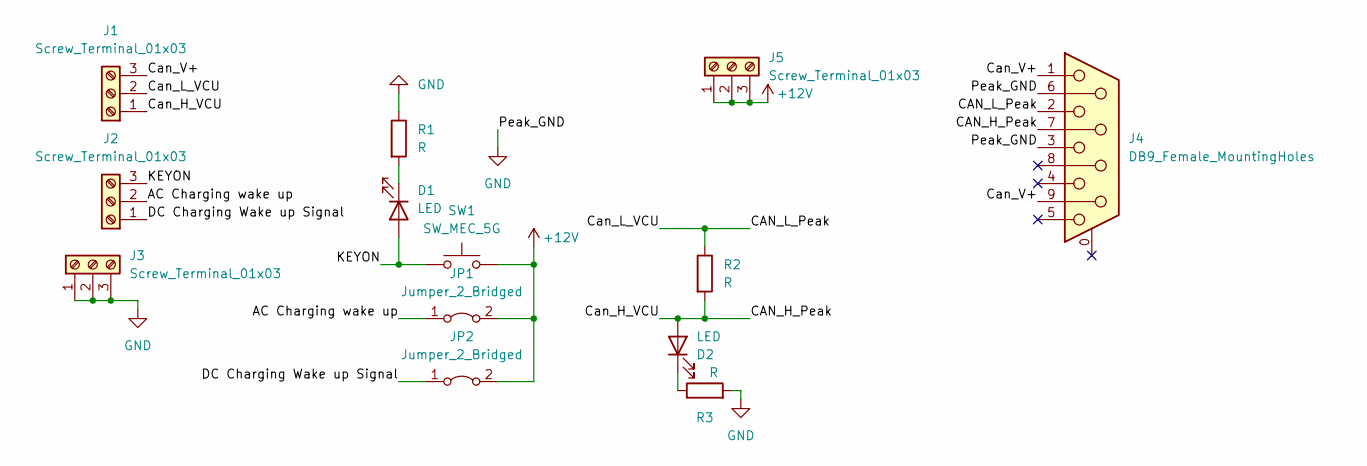
[picture p772: schematic CAN_Switcher.kicad_sch]

Parts:
D1, D2: LED; LED_D5.0mm
J1, J2, J3, J5: Screw_Terminal_01x03; TerminalBlock_bornier-3_P5.08mm
J4: DB9_Female_MountingHoles; DSUB-9_Female_Horizontal_P2.77x2.84mm_EdgePinOffset7.70mm_H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
JP1, JP2: Jumper_2_Bridged; PinHeader_1x02_P2.54mm_Vertical
R1, R2, R3: R; R_Axial_DIN0414_L11.9mm_D4.5mm_P15.24mm_Horizontal
SW1: SW_MEC_5G; Interrupteur 1Channel

Connections:
+12V: J5.1, J5.2, J5.3, JP1.2 (B), JP2.2 (B), SW1.3 (B), SW1.4 (B)
AC Charging wake up: J2.2, JP1.1 (A)
CAN_H_Peak: D2.2 (A), J1.1, J4.7, R2.2
CAN_L_Peak: J1.2, J4.2, R2.1
Can_V+: J1.3, J4.1, J4.9
DC Charging Wake up Signal: J2.1, JP2.1 (A)
GND: J3.1, J3.2, J3.3, J4.3, J4.6, R1.1, R3.2
KEYON: D1.2 (A), J2.3, SW1.1 (A), SW1.2 (A)
unnamed: D1.1 (K), R1.2
unnamed: D2.1 (K), R3.1
