EOSCogniton/ELIZ-2022/02 - Documentation/BASTIE/Cartes Valkyriz/BENCH/Demonstrateur_VCU/Demonstrateur_VCU.kicad_sch

## KiCad design 02 - Documentation/BASTIE/Cartes Valkyriz/BENCH/Demonstrateur_VCU/Demonstrateur_VCU.kicad_sch (2023-07-09)

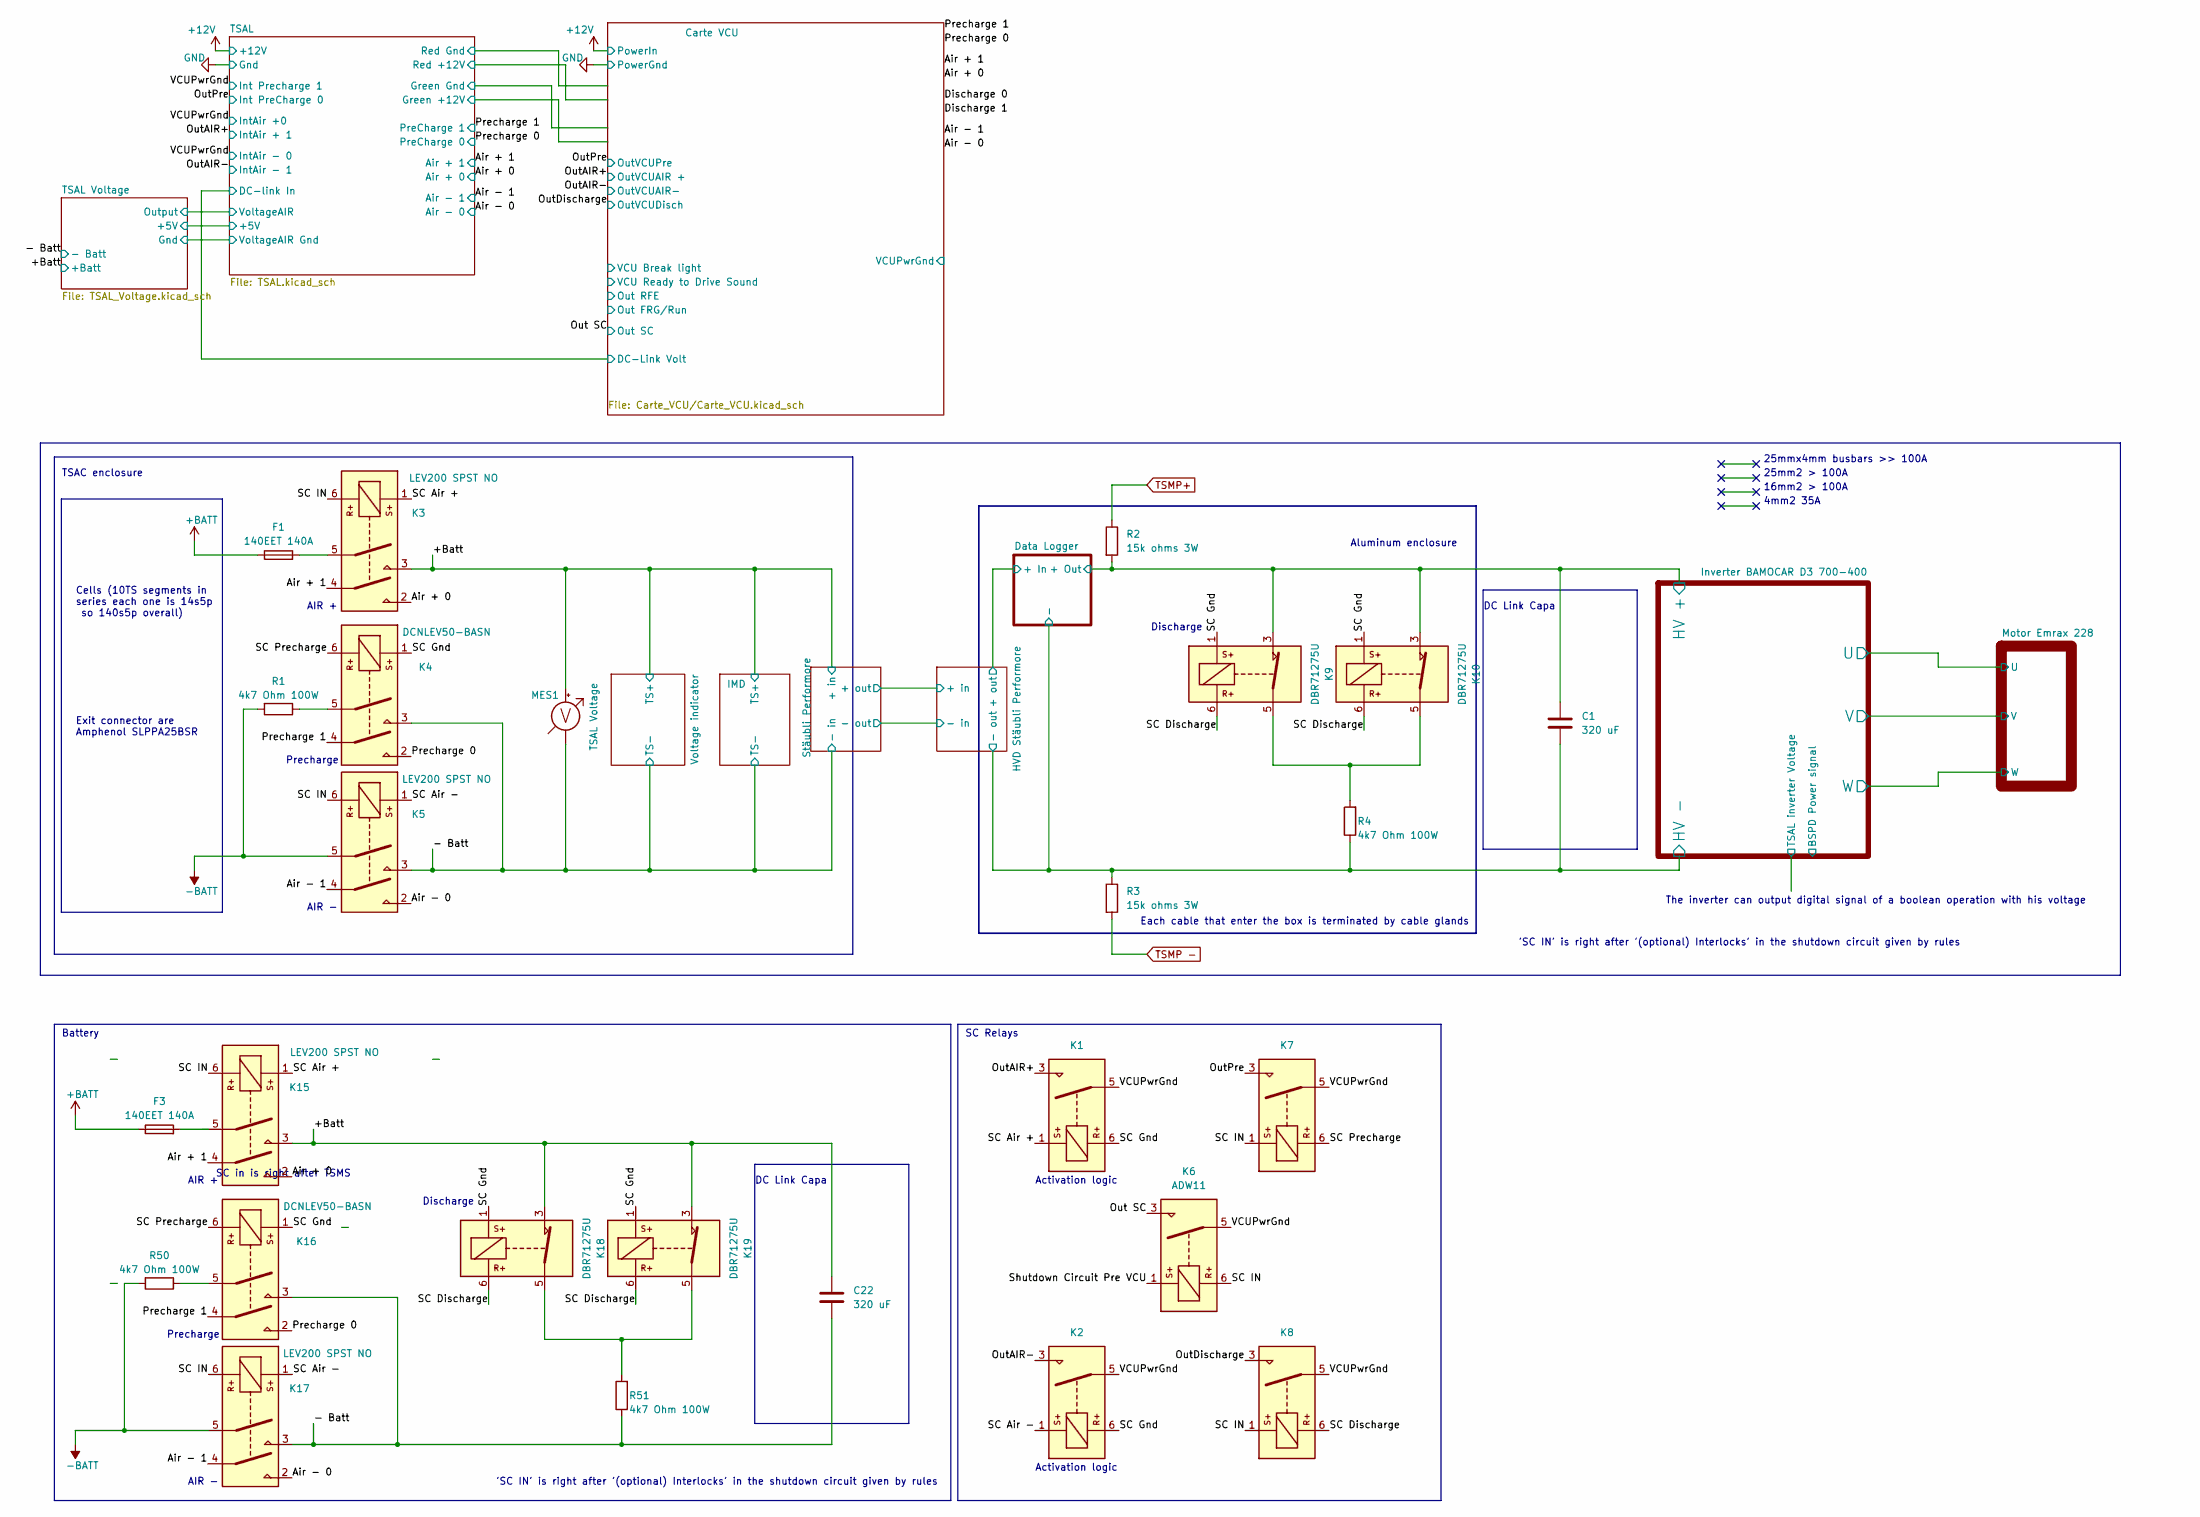
[picture p773: schematic Demonstrateur_VCU.kicad_sch]

Parts:
C1, C22: 320 uF
F1, F3: 140EET 140A
K1, K2, K6, K7, K8: ADW11; Relay_1P1T_NO_10x24x18.8mm_Panasonic_ADW11xxxxW_THT
K3, K5, K15, K17: LEV200 SPST NO; Relay_1P1T_NO_10x24x18.8mm_Panasonic_ADW11xxxxW_THT
K4, K16: DCNLEV50-BASN; Relay_1P1T_NO_10x24x18.8mm_Panasonic_ADW11xxxxW_THT
K9, K10, K18, K19: DBR71275U; Relay_1P1T_NO_10x24x18.8mm_Panasonic_ADW11xxxxW_THT
MES1: TSAL Voltage
R1, R4, R50, R51: 4k7 Ohm 100W
R2, R3: 15k ohms 3W

Connections:
+ Out: C1.1, K9.3, K10.3, R2.2
+Batt: C22.1, F1.1, F3.1, K3.3, K15.3, K18.3, K19.3, MES1.2 (+)
-: C1.2, R3.1, R4.1
- Batt: C22.2, K4.3, K5.3, K16.3, K17.3, MES1.1 (-), R51.1
-BATT: K5.5, K17.5, R1.2, R50.2
Air + 0: K3.2, K15.2
Air + 1: K3.4, K15.4
Air - 0: K5.2, K17.2
Air - 1: K5.4, K17.4
unnamed: F1.2, K3.5
unnamed: F3.2, K15.5
unnamed: K4.5, R1.1
unnamed: K9.5, K10.5, R4.2
unnamed: K16.5, R50.1
unnamed: K18.5, K19.5, R51.2
Out SC: K6.3
OutAIR+: K1.3
OutAIR-: K2.3
OutDischarge: K8.3
OutPre: K7.3
Precharge 0: K4.2, K16.2
Precharge 1: K4.4, K16.4
SC Air +: K1.1, K3.1, K15.1
SC Air -: K2.1, K5.1, K17.1
SC Discharge: K8.6, K9.6, K10.6, K18.6, K19.6
SC Gnd: K1.6, K2.6, K4.1, K9.1, K10.1, K16.1, K18.1, K19.1
SC IN: K3.6, K5.6, K6.6, K7.1, K8.1, K15.6, K17.6
SC Precharge: K4.6, K7.6, K16.6
Shutdown Circuit Pre VCU: K6.1
TSMP -: R3.2
TSMP+: R2.1
VCUPwrGnd: K1.5, K2.5, K6.5, K7.5, K8.5

Notes on the sheet:
Discharge
AIR +
Precharge
DC Link Capa
Battery
16mm2 > 100A
AIR -
SC in is right after TSMS
The inverter can output digital signal of a boolean operation with his voltage
25mm2 > 100A
Cells (10TS segments in series each one is 14s5p so 140s5p overall)
Each cable that enter the box is terminated by cable glands
Exit connector are Amphenol SLPPA25BSR
SC Relays
Activation logic
'SC IN' is right after '(optional) Interlocks' in the shutdown circuit given by rules
4mm2 35A
TSAC enclosure
Aluminum enclosure
25mmx4mm busbars >> 100A
