EOSCogniton/ELIZ-2022/02 - Documentation/BASTIE/Cartes Valkyriz/BENCH/Demonstrateur_VCU/TSAL.kicad_sch

## KiCad design 02 - Documentation/BASTIE/Cartes Valkyriz/BENCH/Demonstrateur_VCU/TSAL.kicad_sch (2023-11-13)

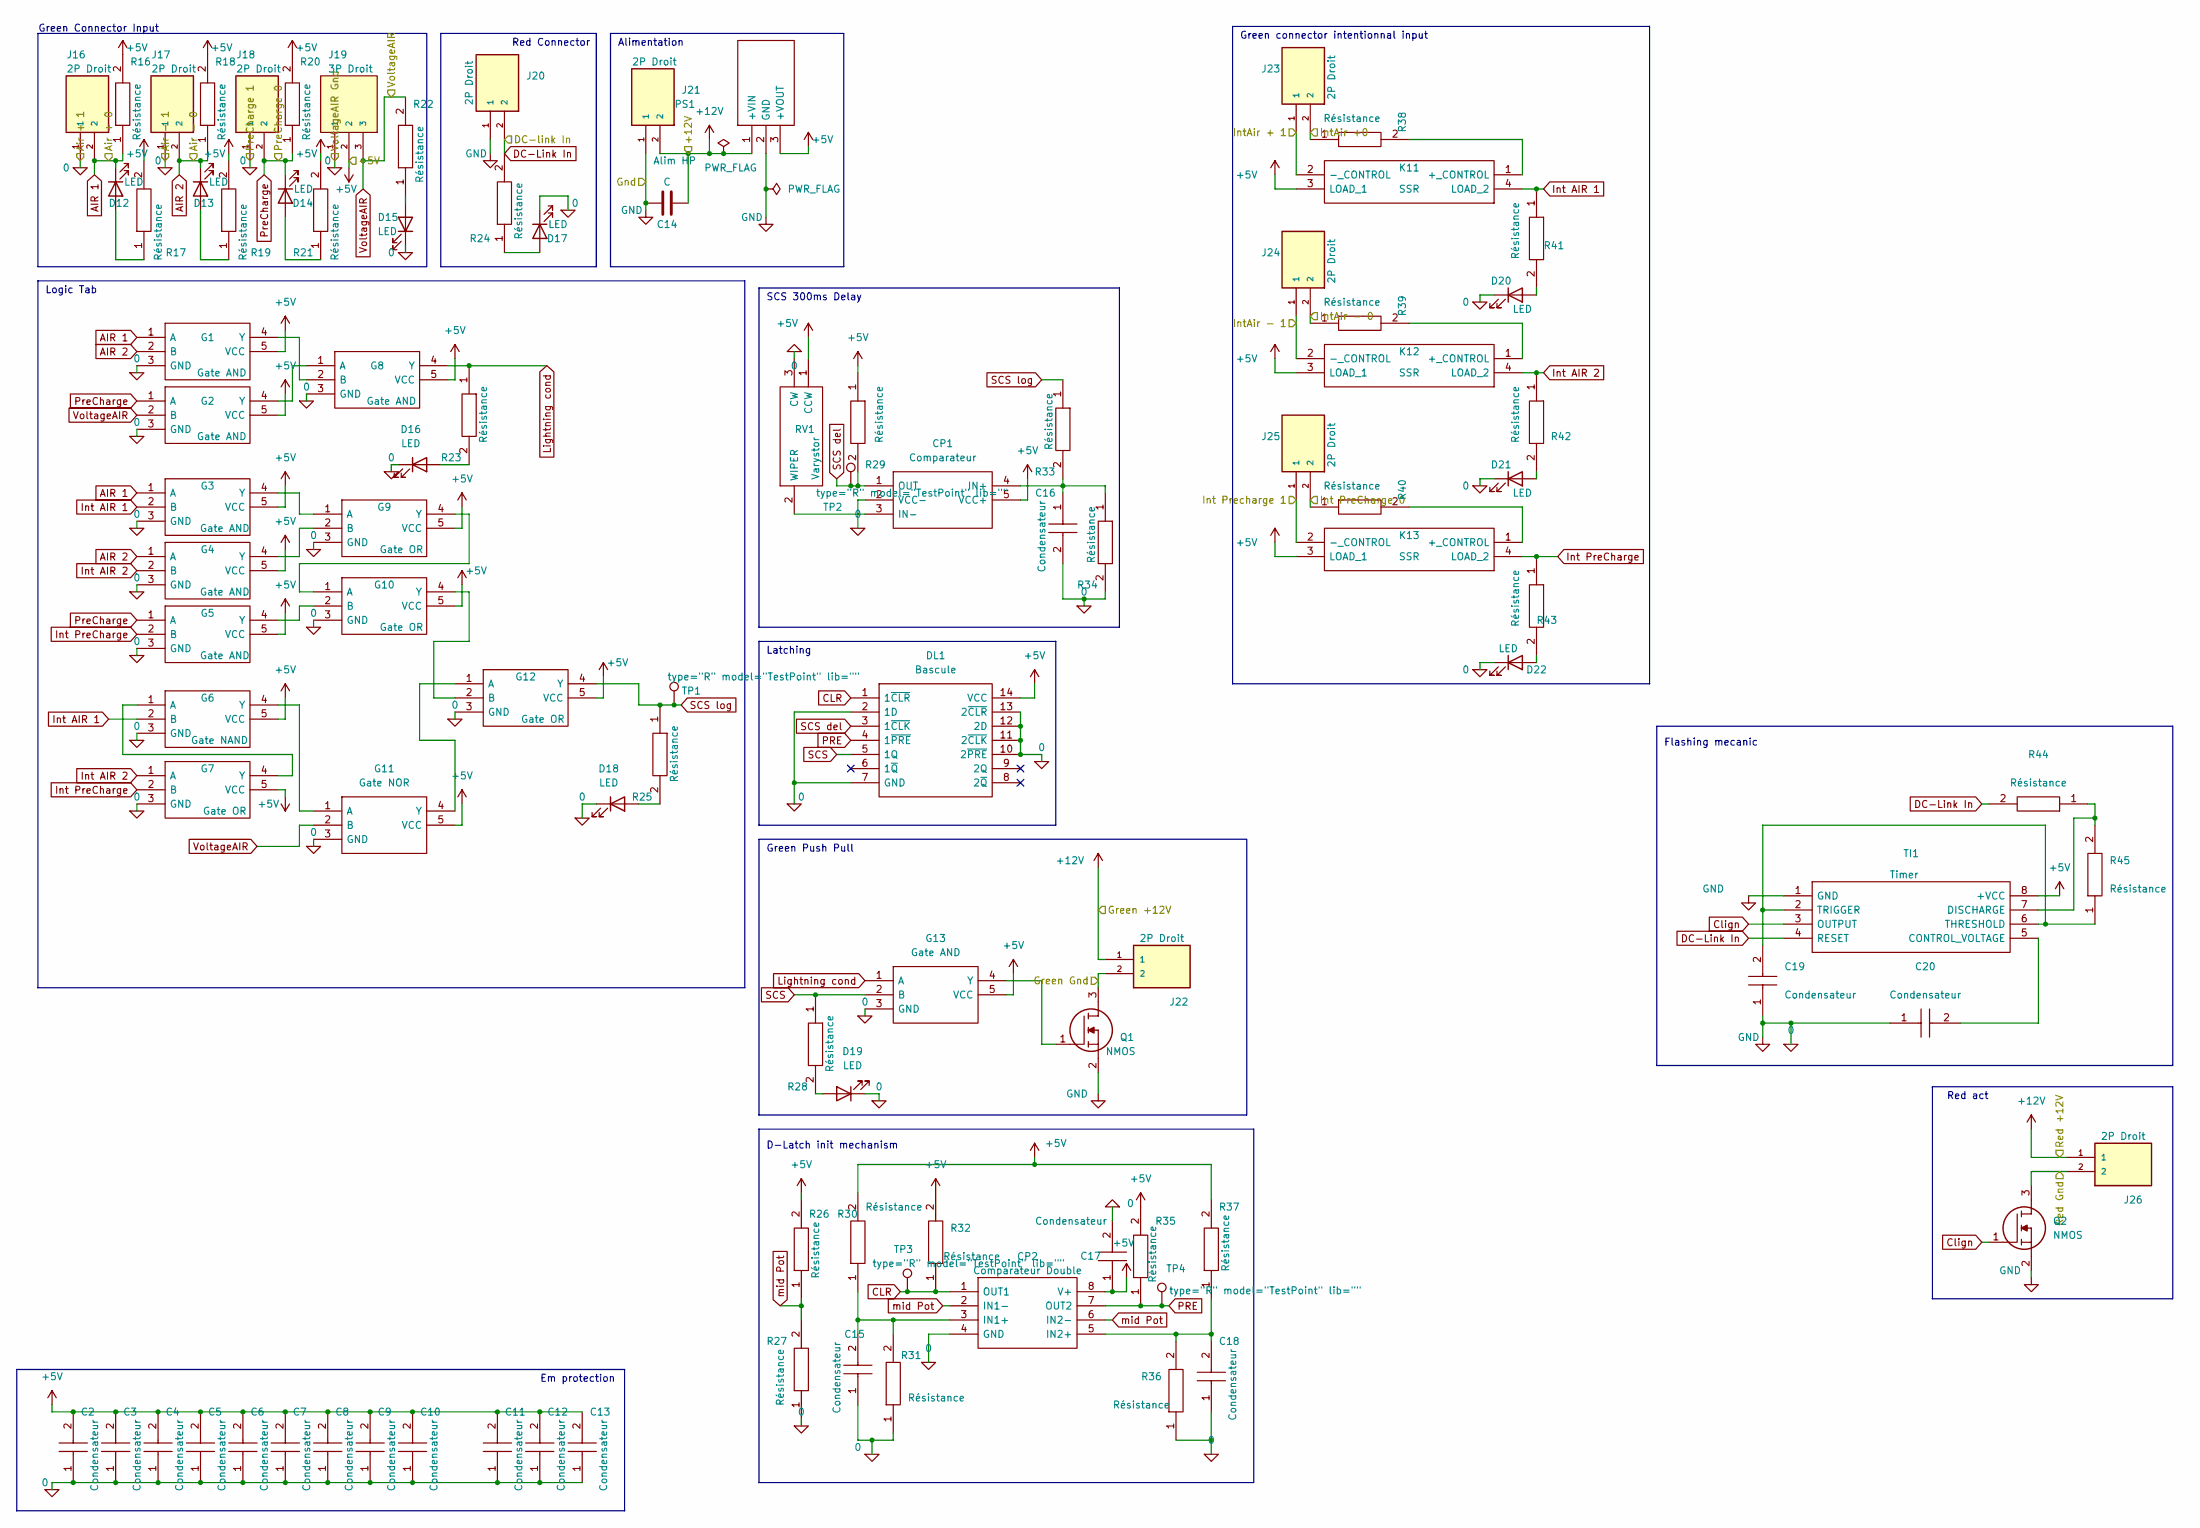
[picture p774: schematic TSAL.kicad_sch]

Parts:
C2, C3, C4, C5, C6, C7, C8, C9, C10, C11, C12, C13, C15, C16, C17, C18, C19, C20: Condensateur 0805Y1000104JXT; CAPC2012X130N; Manufacturer_Part_Number 0805Y1000104JXT
C14: C; CP_Radial_D5.0mm_P2.00mm
CP1: Comparateur TS391ILT; SOT95P280X145-5N; Manufacturer_Part_Number TS391ILT; Mouser Part Number 511-TS391IL
CP2: Comparateur Double LM393LVDR; SOIC127P600X175-8N; Manufacturer_Part_Number LM393LVDR; Mouser Part Number 595-LM393LVDR
D12, D13, D14, D15, D16, D17, D18, D19, D20, D21, D22: LED; LED_D5.0mm
DL1: Bascule D SN74HCS72QDRQ1; SOIC127P600X175-14N; Manufacturer_Part_Number SN74HCS72QDRQ1; Mouser Part Number 595-SN74HCS72QDRQ1
G1, G2, G3, G4, G5, G8, G13: Gate AND SN74AHCT1G08DBVR; SOT95P280X145-5N; Manufacturer_Part_Number SN74AHCT1G08DBVR; Mouser Part Number 595-SN74AHCT1G08DBVR
G6: Gate NAND SN74AHCT1G00DBVR; SOT95P280X145-5N; Manufacturer_Part_Number SN74AHCT1G00DBVR; Mouser Part Number 595-SN74AHCT1G00DBVR
G7, G9, G10, G12: Gate OR SN74AHCT1G32DBVR; SOT95P280X145-5N; Manufacturer_Part_Number SN74AHCT1G32DBVR; Mouser Part Number 595-SN74AHCT1G32DBVR
G11: Gate NOR SN74AHCT1G02DBVR; SOT95P280X145-5N; Manufacturer_Part_Number SN74AHCT1G02DBVR; Mouser Part Number 595-SN74AHCT1G02DBVR
J16, J17, J18, J20, J21, J22, J23, J24, J25, J26: 2P Droit 2-11-2022; MOLEX_22-11-2022; PARTREV BD8
J19: 3P Droit 22-11-2032; MOLEX_22-11-2032; PARTREV BD8
K11, K12, K13: SSR CPC1394GR; CPC1394GR; Manufacturer_Part_Number CPC1394GR; Mouser Part Number 849-CPC1394GR
PS1: Alim HP TSR_2-2450; TSR-2; Manufacturer_Part_Number TSR 2-2450; Mouser Part Number 495-TSR2-2450
Q1, Q2: NMOS SQ2348ES-T1_GE3; SOT95P237X112-3N; Manufacturer_Part_Number SQ2348ES-T1_GE3; Mouser Part Number 781-SQ2348ES-T1_GE3
R16, R17, R18, R19, R20, R21, R22, R23, R24, R25, R26, R27, R28, R29, R30, R31, R32, R33, R34, R35, R36, R37, R38, R39, R40, R41, R42, R43, R44, R45: Résistance RK73H2BLTDD2152F; RESC3216X70N; Manufacturer_Part_Number RK73H2BLTDD2152F; Mouser Part Number N/A
RV1: Varystor 3296Y-1-223LF; 3296Y1223LF; Manufacturer_Part_Number 3296Y-1-223LF; Mouser Part Number 652-3296Y-1-223LF
TI1: Timer 555 LM555CMX_NOPB; DIP-8_W7.62mm_Socket; Manufacturer_Part_Number LM555CMX/NOPB; Mouser Part Number 926-LM555CMX/NOPB
TP1, TP2, TP3, TP4: type="R" model="TestPoint" lib=""; TestPoint_Pad_D2.0mm

Connections:
0: C2.1, C3.1, C4.1, C5.1, C6.1, C7.1, C8.1, C9.1, C10.1, C11.1, C12.1, C13.1, C14.1, C15.1, C16.2, C17.2, C18.1, C19.1, C20.1, CP1.2 (VCC-), CP2.4 (GND), D15.1 (K), D16.1 (K), D17.1 (K), D18.1 (K), D19.1 (K), D20.1 (K), D21.1 (K), D22.1 (K), DL1.2 (1D), DL1.7 (GND), DL1.10 (2~PRE), DL1.11 (2~CLK), DL1.12 (2D), DL1.13 (2~CLR), G1.3 (GND), G2.3 (GND), G3.3 (GND), G4.3 (GND), G5.3 (GND), G6.3 (GND), G7.3 (GND), G8.3 (GND), G9.3 (GND), G10.3 (GND), G11.3 (GND), G12.3 (GND), G13.3 (GND), J16.1, J17.1, J18.1, J19.1, J20.1, J21.1, PS1.2 (GND), Q1.2, Q2.2, R27.1, R31.1, R34.2, R36.1, RV1.3 (CW), TI1.1 (GND)
+5V: C2.2, C3.2, C4.2, C5.2, C6.2, C7.2, C8.2, C9.2, C10.2, C11.2, C12.2, C13.2, C17.1, CP1.5 (VCC+), CP2.8 (V+), DL1.14 (VCC), G1.5 (VCC), G2.5 (VCC), G3.5 (VCC), G4.5 (VCC), G5.5 (VCC), G6.5 (VCC), G7.5 (VCC), G8.5 (VCC), G9.5 (VCC), G10.5 (VCC), G11.5 (VCC), G12.5 (VCC), G13.5 (VCC), J19.2, K11.3 (LOAD_1), K12.3 (LOAD_1), K13.3 (LOAD_1), PS1.3 (+VOUT), R16.2, R17.2, R18.2, R19.2, R20.2, R21.2, R26.2, R29.1, R30.2, R32.2, R35.2, R37.2, RV1.1 (CCW), TI1.8 (+VCC)
+12V: C14.2, J21.2, J22.1, J26.1, PS1.1 (+VIN)
AIR 1: D12.1 (K), G1.1 (A), G3.1 (A), J16.2, R16.1
AIR 2: D13.1 (K), G1.2 (B), G4.1 (A), J17.2, R18.1
CLR: CP2.1 (OUT1), DL1.1 (1~CLR), R32.1, TP3.1
Clign: Q2.1, TI1.3 (OUTPUT)
DC-link In: J20.2, R24.2, R44.2, TI1.4 (RESET)
Green Gnd: J22.2, Q1.3
Int AIR 1: G3.2 (B), G6.2 (B), K11.4 (LOAD_2), R41.1
Int AIR 2: G4.2 (B), G7.1 (A), K12.4 (LOAD_2), R42.1
Int PreCharge: G5.2 (B), G7.2 (B), K13.4 (LOAD_2), R43.1
Int PreCharge 0: J25.2, R40.1
Int Precharge 1: J25.1, K13.2 (-_CONTROL)
IntAir +0: J23.2, R38.1
IntAir + 1: J23.1, K11.2 (-_CONTROL)
IntAir - 0: J24.2, R39.1
IntAir - 1: J24.1, K12.2 (-_CONTROL)
Lightning cond: G8.4 (Y), G13.1 (A), R23.1
unnamed: C15.2, CP2.3 (IN1+), R30.1, R31.2
unnamed: C16.1, CP1.4 (IN+), R33.2, R34.1
unnamed: C18.2, CP2.5 (IN2+), R36.2, R37.1
unnamed: C19.2, R45.1, TI1.2 (TRIGGER), TI1.6 (THRESHOLD)
unnamed: C20.2, TI1.5 (CONTROL_VOLTAGE)
unnamed: CP1.3 (IN-), RV1.2 (WIPER)
unnamed: D12.2 (A), R17.1
unnamed: D13.2 (A), R19.1
unnamed: D14.2 (A), R21.1
unnamed: D15.2 (A), R22.1
unnamed: D16.2 (A), R23.2
unnamed: D17.2 (A), R24.1
unnamed: D18.2 (A), R25.2
unnamed: D19.2 (A), R28.2
unnamed: D20.2 (A), R41.2
unnamed: D21.2 (A), R42.2
unnamed: D22.2 (A), R43.2
unnamed: G1.4 (Y), G8.2 (B)
unnamed: G2.4 (Y), G8.1 (A)
unnamed: G3.4 (Y), G9.1 (A)
unnamed: G4.4 (Y), G9.2 (B)
unnamed: G6.1 (A), G7.4 (Y)
unnamed: G9.4 (Y), G10.1 (A)
unnamed: G5.4 (Y), G10.2 (B)
unnamed: G10.4 (Y), G12.2 (B)
unnamed: G6.4 (Y), G11.1 (A)
unnamed: G11.4 (Y), G12.1 (A)
unnamed: G13.4 (Y), Q1.1
unnamed: K11.1 (+_CONTROL), R38.2
unnamed: K12.1 (+_CONTROL), R39.2
unnamed: K13.1 (+_CONTROL), R40.2
unnamed: R44.1, R45.2, TI1.7 (DISCHARGE)
PRE: CP2.7 (OUT2), DL1.4 (1~PRE), R35.1, TP4.1
PreCharge: D14.1 (K), G2.1 (A), G5.1 (A), J18.2, R20.1
Red Gnd: J26.2, Q2.3
SCS: DL1.5 (1Q), G13.2 (B), R28.1
SCS del: CP1.1 (OUT), DL1.3 (1~CLK), R29.2, TP2.1
SCS log: G12.4 (Y), R25.1, R33.1, TP1.1
VoltageAIR: G2.2 (B), G11.2 (B), J19.3, R22.2
mid Pot: CP2.2 (IN1-), CP2.6 (IN2-), R26.1, R27.2

Notes on the sheet:
Green Push Pull
Red Connector
Flashing mecanic
Green Connector Input
Latching
Em protection
Green connector intentionnal input
Alimentation
Red act
Logic Tab
SCS 300ms Delay
D-Latch init mechanism
