EOSCogniton/ELIZ-2022/02 - Documentation/BASTIE/Cartes Valkyriz/BENCH/Demonstrateur_VCU/TSAL_Voltage.kicad_sch

## KiCad design 02 - Documentation/BASTIE/Cartes Valkyriz/BENCH/Demonstrateur_VCU/TSAL_Voltage.kicad_sch (2023-11-13)

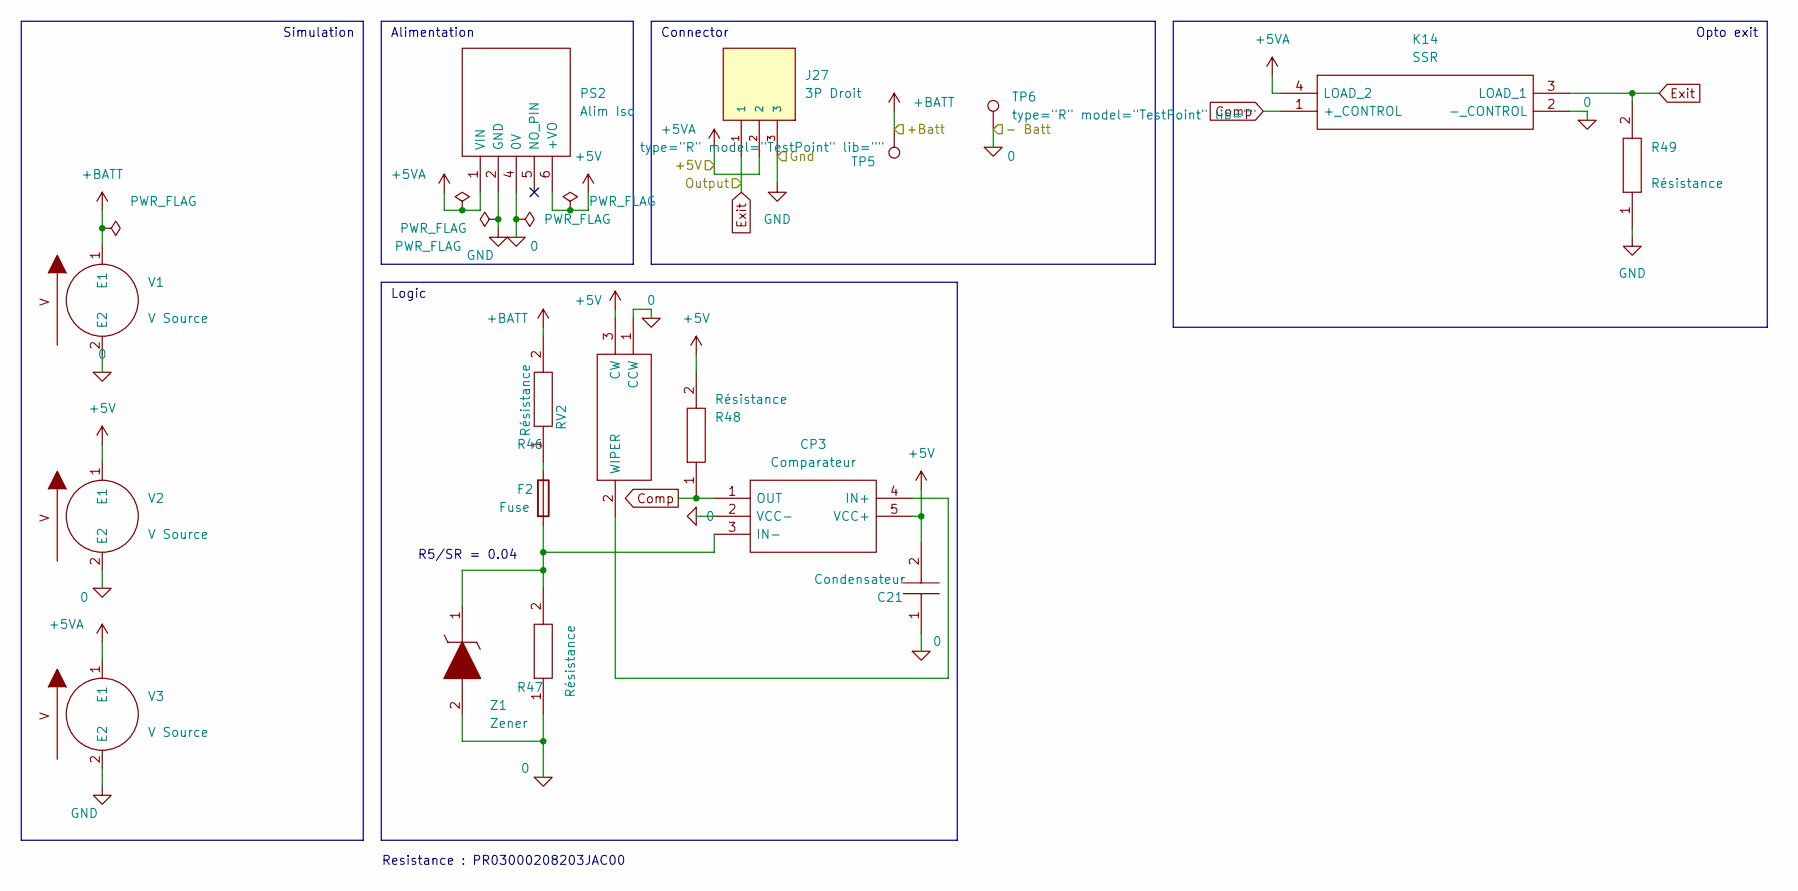
[picture p775: schematic TSAL_Voltage.kicad_sch]

Parts:
C21: Condensateur 0805Y1000104JXT; CAPC2012X130N; Manufacturer_Part_Number 0805Y1000104JXT
CP3: Comparateur TS391ILT; SOT95P280X145-5N; Manufacturer_Part_Number TS391ILT; Mouser Part Number 511-TS391IL
F2: Fuse; 0PTF0078P
J27: 3P Droit 22-11-2032; MOLEX_22-11-2032; PARTREV BD8
K14: SSR CPC1394GR; CPC1394GR; Manufacturer_Part_Number CPC1394GR; Mouser Part Number 849-CPC1394GR
PS2: Alim Iso PDM2-S5-S5-S; PDM2S5S5S; Manufacturer_Part_Number PDM2-S5-S5-S; Mouser Part Number 490-PDM2-S5-S5-S
R46: Résistance RK73H2BLTDD2152F; R_Axial_DIN0617_L17.0mm_D6.0mm_P20.32mm_Horizontal; Manufacturer_Part_Number RK73H2BLTDD2152F; Mouser Part Number N/A
R47, R48, R49: Résistance RK73H2BLTDD2152F; RESC3216X70N; Manufacturer_Part_Number RK73H2BLTDD2152F; Mouser Part Number N/A
RV2: Varystor 3296Y-1-223LF; 3296Y1223LF; Manufacturer_Part_Number 3296Y-1-223LF; Mouser Part Number 652-3296Y-1-223LF
TP5, TP6: type="R" model="TestPoint" lib=""; SolderWire-2.5sqmm_1x01_D2.4mm_OD3.6mm
V1: VSOURCE
V2, V3: 5
Z1: Zener TZM5224B-GS08; D_MiniMELF; Manufacturer_Part_Number TZM5224B-GS08; Mouser Part Number 78-TZM5224B

Connections:
0: C21.1, CP3.2 (VCC-), K14.2 (-_CONTROL), PS2.4 (0V), R47.1, RV2.1 (CCW), TP6.1, V1.2 (E2), V2.2 (E2), Z1.2
+5V: C21.2, CP3.5 (VCC+), PS2.6 (+VO), R48.2, RV2.3 (CW), V2.1 (E1)
+5VA: J27.2, K14.4 (LOAD_2), PS2.1 (VIN), V3.1 (E1)
+Batt: R46.2, TP5.1, V1.1 (E1)
Comp: CP3.1 (OUT), K14.1 (+_CONTROL), R48.1
Exit: J27.1, K14.3 (LOAD_1), R49.2
Gnd: J27.3, PS2.2 (GND), R49.1, V3.2 (E2)
unnamed: CP3.3 (IN-), F2.2, R47.2, Z1.1
unnamed: CP3.4 (IN+), RV2.2 (WIPER)
unnamed: F2.1, R46.1

Notes on the sheet:
Connector
R5/SR = 0.04
Alimentation
Opto exit
Simulation
Resistance : PR03000208203JAC00
Logic
