EOSCogniton/ELIZ-2022/02 - Documentation/BASTIE/Cartes Valkyriz/SCS/SCS_converting/SCS_converting.kicad_sch

## KiCad design 02 - Documentation/BASTIE/Cartes Valkyriz/SCS/SCS_converting/SCS_converting.kicad_sch (2024-02-06)

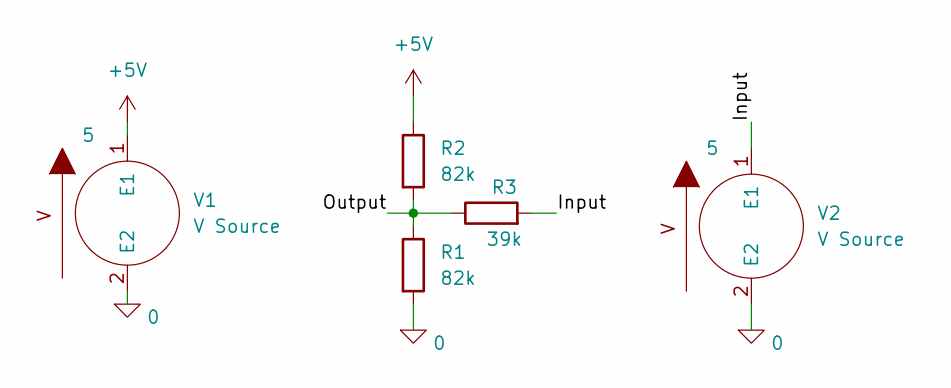
[picture p776: schematic SCS_converting.kicad_sch]

Parts:
R1, R2: 82k
R3: 39k
V1, V2: 5

Connections:
0: R1.2, V1.2 (E2), V2.2 (E2)
+5V: R2.1, V1.1 (E1)
Input: R3.2, V2.1 (E1)
Output: R1.1, R2.2, R3.1
