EOSCogniton/ELIZ-2022/02 - Documentation/BASTIE/Cartes Valkyriz/SCS/SCS_dongle/SCS_dongle.kicad_sch

## KiCad design 02 - Documentation/BASTIE/Cartes Valkyriz/SCS/SCS_dongle/SCS_dongle.kicad_sch (2024-02-06)

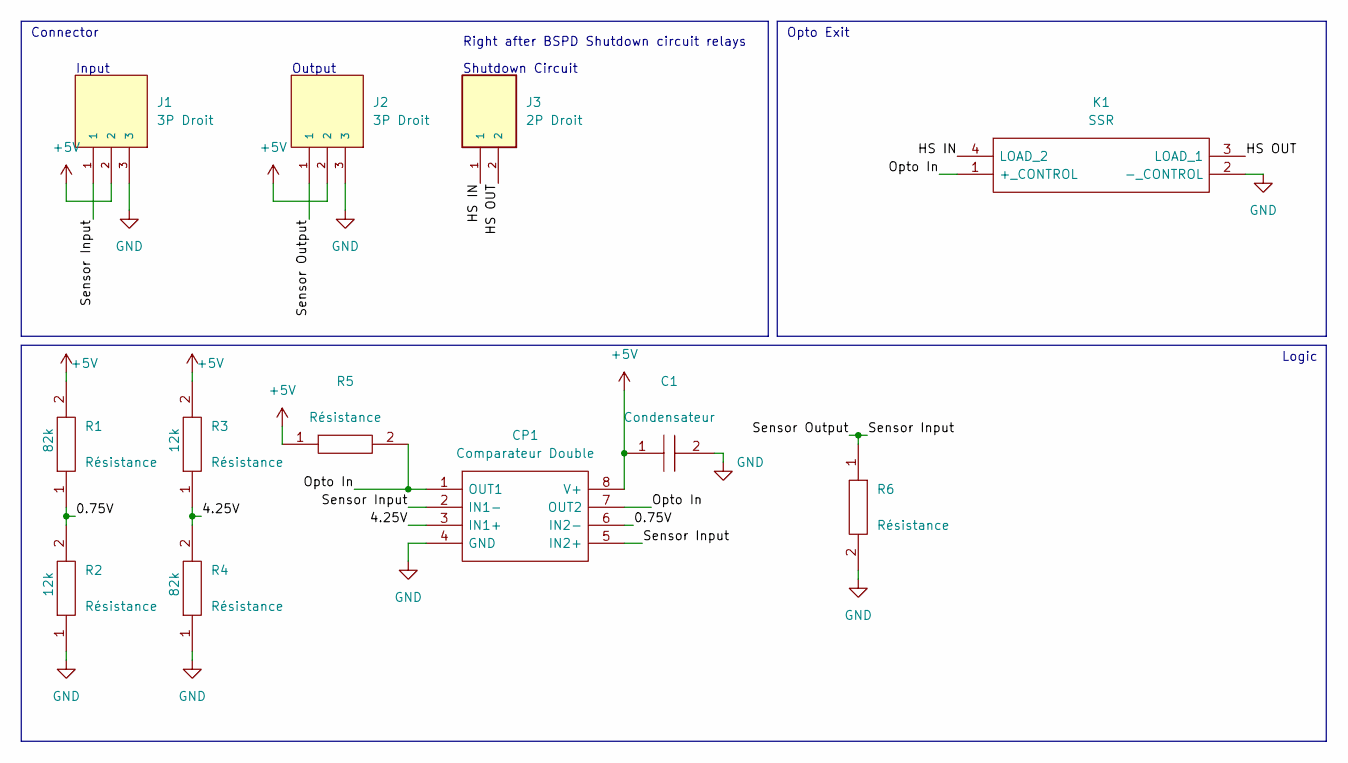
[picture p777: schematic SCS_dongle.kicad_sch]

Parts:
C1: Condensateur 0805Y1000104JXT; CAPC2012X130N; Manufacturer_Part_Number 0805Y1000104JXT
CP1: Comparateur Double LM393LVDR; SOIC127P600X175-8N; Manufacturer_Part_Number LM393LVDR; Mouser Part Number 595-LM393LVDR
J1, J2: 3P Droit 22-11-2032; MOLEX_22-11-2032; PARTREV BD8
J3: 2P Droit 2-11-2022; MOLEX_22-11-2022; PARTREV BD8
K1: SSR CPC1394GR; CPC1394GR; Manufacturer_Part_Number CPC1394GR; Mouser Part Number 849-CPC1394GR
R1, R4: 82k; RESC3216X70N; Manufacturer_Part_Number RK73H2BLTDD2152F; Mouser Part Number N/A
R2: 12k; RESC3216X70; Manufacturer_Part_Number RK73H2BLTDD2152F; Mouser Part Number N/A
R3: 12k; RESC3216X70N; Manufacturer_Part_Number RK73H2BLTDD2152F; Mouser Part Number N/A
R5, R6: Résistance RK73H2BLTDD2152F; RESC3216X70N; Manufacturer_Part_Number RK73H2BLTDD2152F; Mouser Part Number N/A

Connections:
0.75V: CP1.6 (IN2-), R1.1, R2.2
4.25V: CP1.3 (IN1+), R3.1, R4.2
+5V: C1.1, CP1.8 (V+), J1.2, J2.2, R1.2, R3.2, R5.1
GND: C1.2, CP1.4 (GND), J1.3, J2.3, K1.2 (-_CONTROL), R2.1, R4.1, R6.2
HS IN: J3.1, K1.4 (LOAD_2)
HS OUT: J3.2, K1.3 (LOAD_1)
Opto In: CP1.1 (OUT1), CP1.7 (OUT2), K1.1 (+_CONTROL), R5.2
Sensor Input: CP1.2 (IN1-), CP1.5 (IN2+), J1.1, J2.1, R6.1

Notes on the sheet:
Connector
Logic
Right after BSPD Shutdown circuit relays
Opto Exit
Output
Input
Shutdown Circuit
