EOSCogniton/ELIZ-2022/02 - Documentation/Kicad/Construction de la librairy/Gates SN74AHCT1G 0.7/NAND/NAND Example.kicad_sch

## KiCad design 02 - Documentation/Kicad/Construction de la librairy/Gates SN74AHCT1G 0.7/NAND/NAND Example.kicad_sch (2022-10-31)

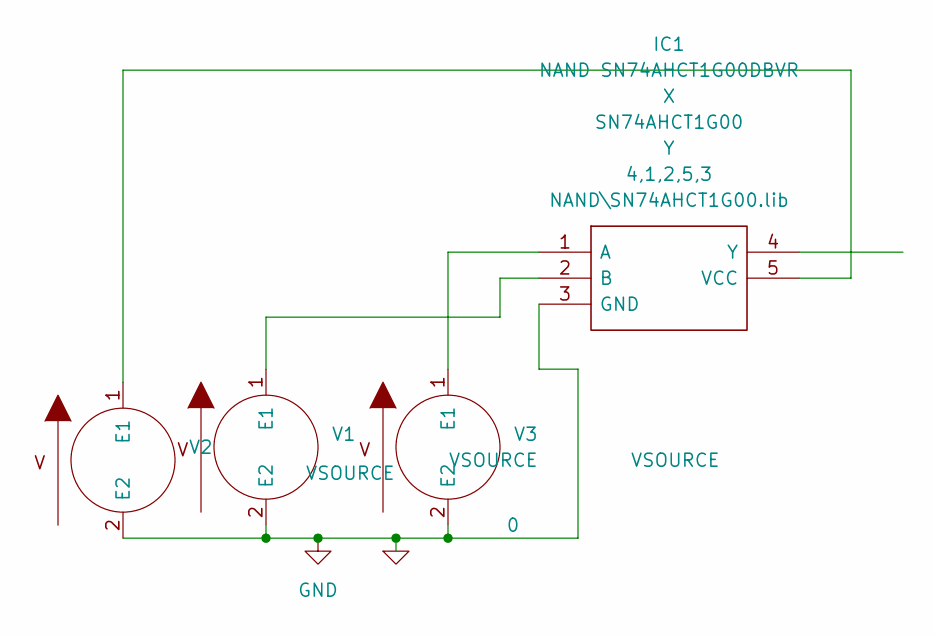
[picture p779: schematic NAND Example.kicad_sch]

Parts:
IC1: NAND SN74AHCT1G00DBVR; SOT95P280X145-5N; Manufacturer_Part_Number SN74AHCT1G00DBVR; Mouser Part Number 595-SN74AHCT1G00DBVR
V1, V2, V3: VSOURCE

Connections:
0: IC1.3 (GND), V1.2 (E2), V2.2 (E2), V3.2 (E2)
unnamed: IC1.1 (A), V3.1 (E1)
unnamed: IC1.2 (B), V1.1 (E1)
unnamed: IC1.5 (VCC), V2.1 (E1)
