EOSCogniton/ELIZ-2022/02 - Documentation/Kicad/Construction de la librairy/Gates SN74AHCT1G 0.7/XOR/XOR Example.kicad_sch

## KiCad design 02 - Documentation/Kicad/Construction de la librairy/Gates SN74AHCT1G 0.7/XOR/XOR Example.kicad_sch (2022-10-31)

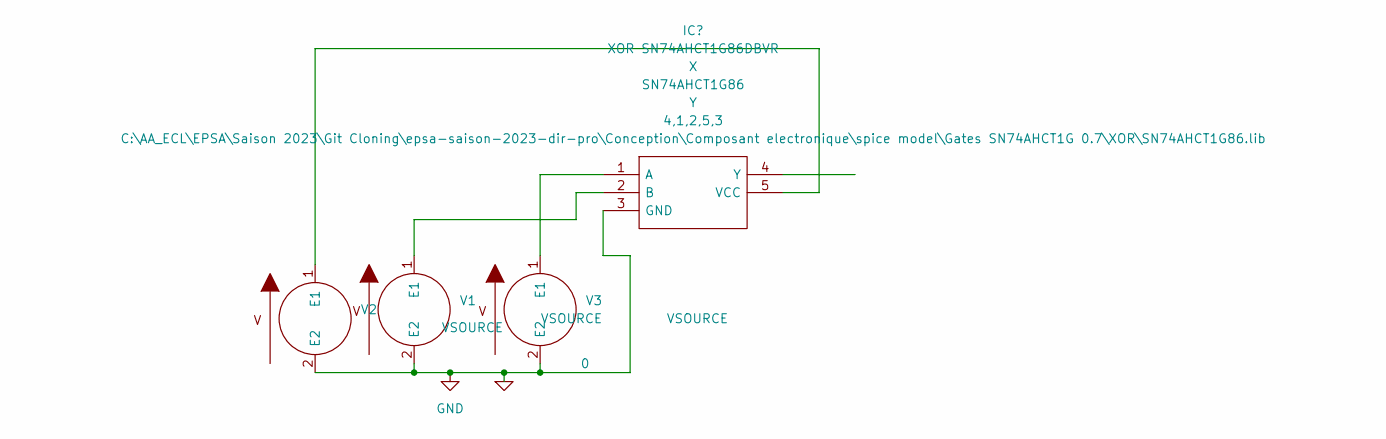
[picture p782: schematic XOR Example.kicad_sch]

Parts:
V1, V2, V3: VSOURCE

Connections:
0: V1.2 (E2), V2.2 (E2), V3.2 (E2)
