EOSCogniton/ELIZ-2022/02 - Documentation/Kicad/Pack Elec/Kicad Spice Exemple/Example Delay/Delay Example.kicad_sch

## KiCad design 02 - Documentation/Kicad/Pack Elec/Kicad Spice Exemple/Example Delay/Delay Example.kicad_sch (2022-10-31)

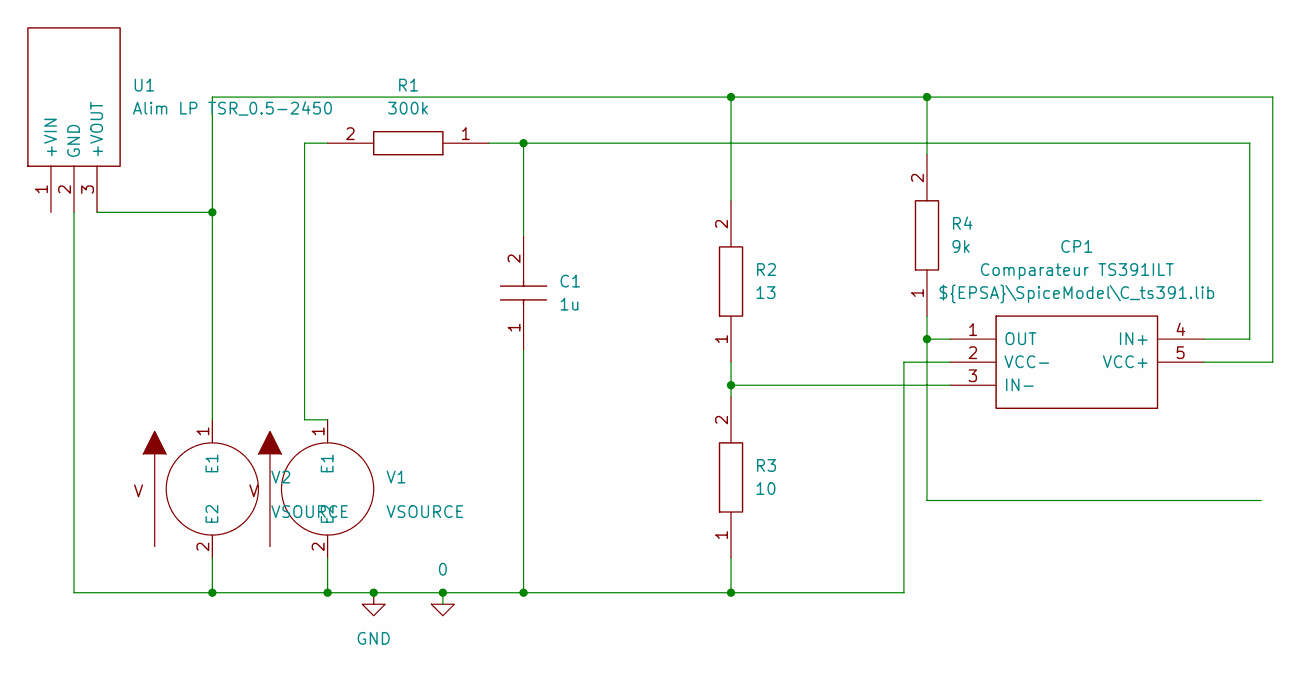
[picture p783: schematic Delay Example.kicad_sch]

Parts:
C1: Condensateur 0805Y1000104JXT; CAPC2012X130N; Manufacturer_Part_Number 0805Y1000104JXT
CP1: Comparateur TS391ILT; SOT95P280X145-5N; Manufacturer_Part_Number TS391ILT; Mouser Part Number 511-TS391IL
R1, R2, R3, R4: Résistance RK73H2BLTDD2152F; RESC3216X70N; Manufacturer_Part_Number RK73H2BLTDD2152F; Mouser Part Number N/A
U1: Alim LP TSR_0.5-2450; TSR-0.5-2433; Manufacturer_Part_Number TSR 0.5-2450; Mouser Part Number 495-TSR0.5-2450
V1, V2: VSOURCE

Connections:
0: C1.1, CP1.2 (VCC-), R3.1, U1.2 (GND), V1.2 (E2), V2.2 (E2)
unnamed: C1.2, CP1.4 (IN+), R1.1
unnamed: CP1.1 (OUT), R4.1
unnamed: CP1.3 (IN-), R2.1, R3.2
unnamed: CP1.5 (VCC+), R2.2, R4.2, U1.3 (+VOUT), V2.1 (E1)
unnamed: R1.2, V1.1 (E1)
