EOSCogniton/ELIZ-2022/02 - Documentation/Kicad/Pack Elec/Kicad Spice Exemple/Gates/NAND Example.kicad_sch

## KiCad design 02 - Documentation/Kicad/Pack Elec/Kicad Spice Exemple/Gates/NAND Example.kicad_sch (2022-10-31)

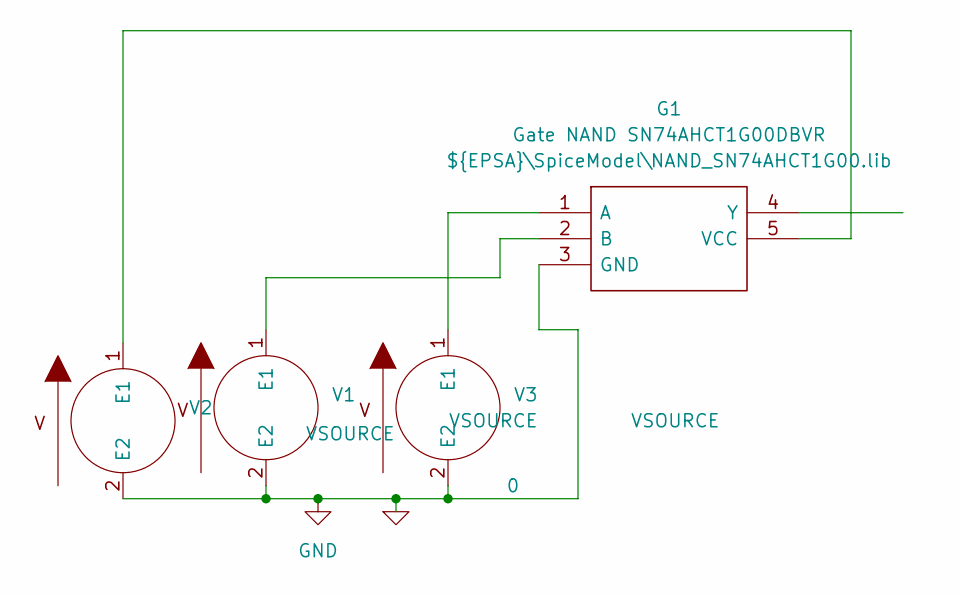
[picture p785: schematic NAND Example.kicad_sch]

Parts:
G1: Gate NAND SN74AHCT1G00DBVR; SOT95P280X145-5N; Manufacturer_Part_Number SN74AHCT1G00DBVR; Mouser Part Number 595-SN74AHCT1G00DBVR
V1, V2, V3: VSOURCE

Connections:
0: G1.3 (GND), V1.2 (E2), V2.2 (E2), V3.2 (E2)
unnamed: G1.1 (A), V3.1 (E1)
unnamed: G1.2 (B), V1.1 (E1)
unnamed: G1.5 (VCC), V2.1 (E1)
