EOSCogniton/ELIZ-2022/02 - Documentation/BASTIE/Cartes Valkyriz/BENCH/Demonstrateur_VCU/Carte_VCU/Carte_VCU - Back.kicad_sch

## KiCad design 02 - Documentation/BASTIE/Cartes Valkyriz/BENCH/Demonstrateur_VCU/Carte_VCU/Carte_VCU - Back.kicad_sch (2023-05-07)

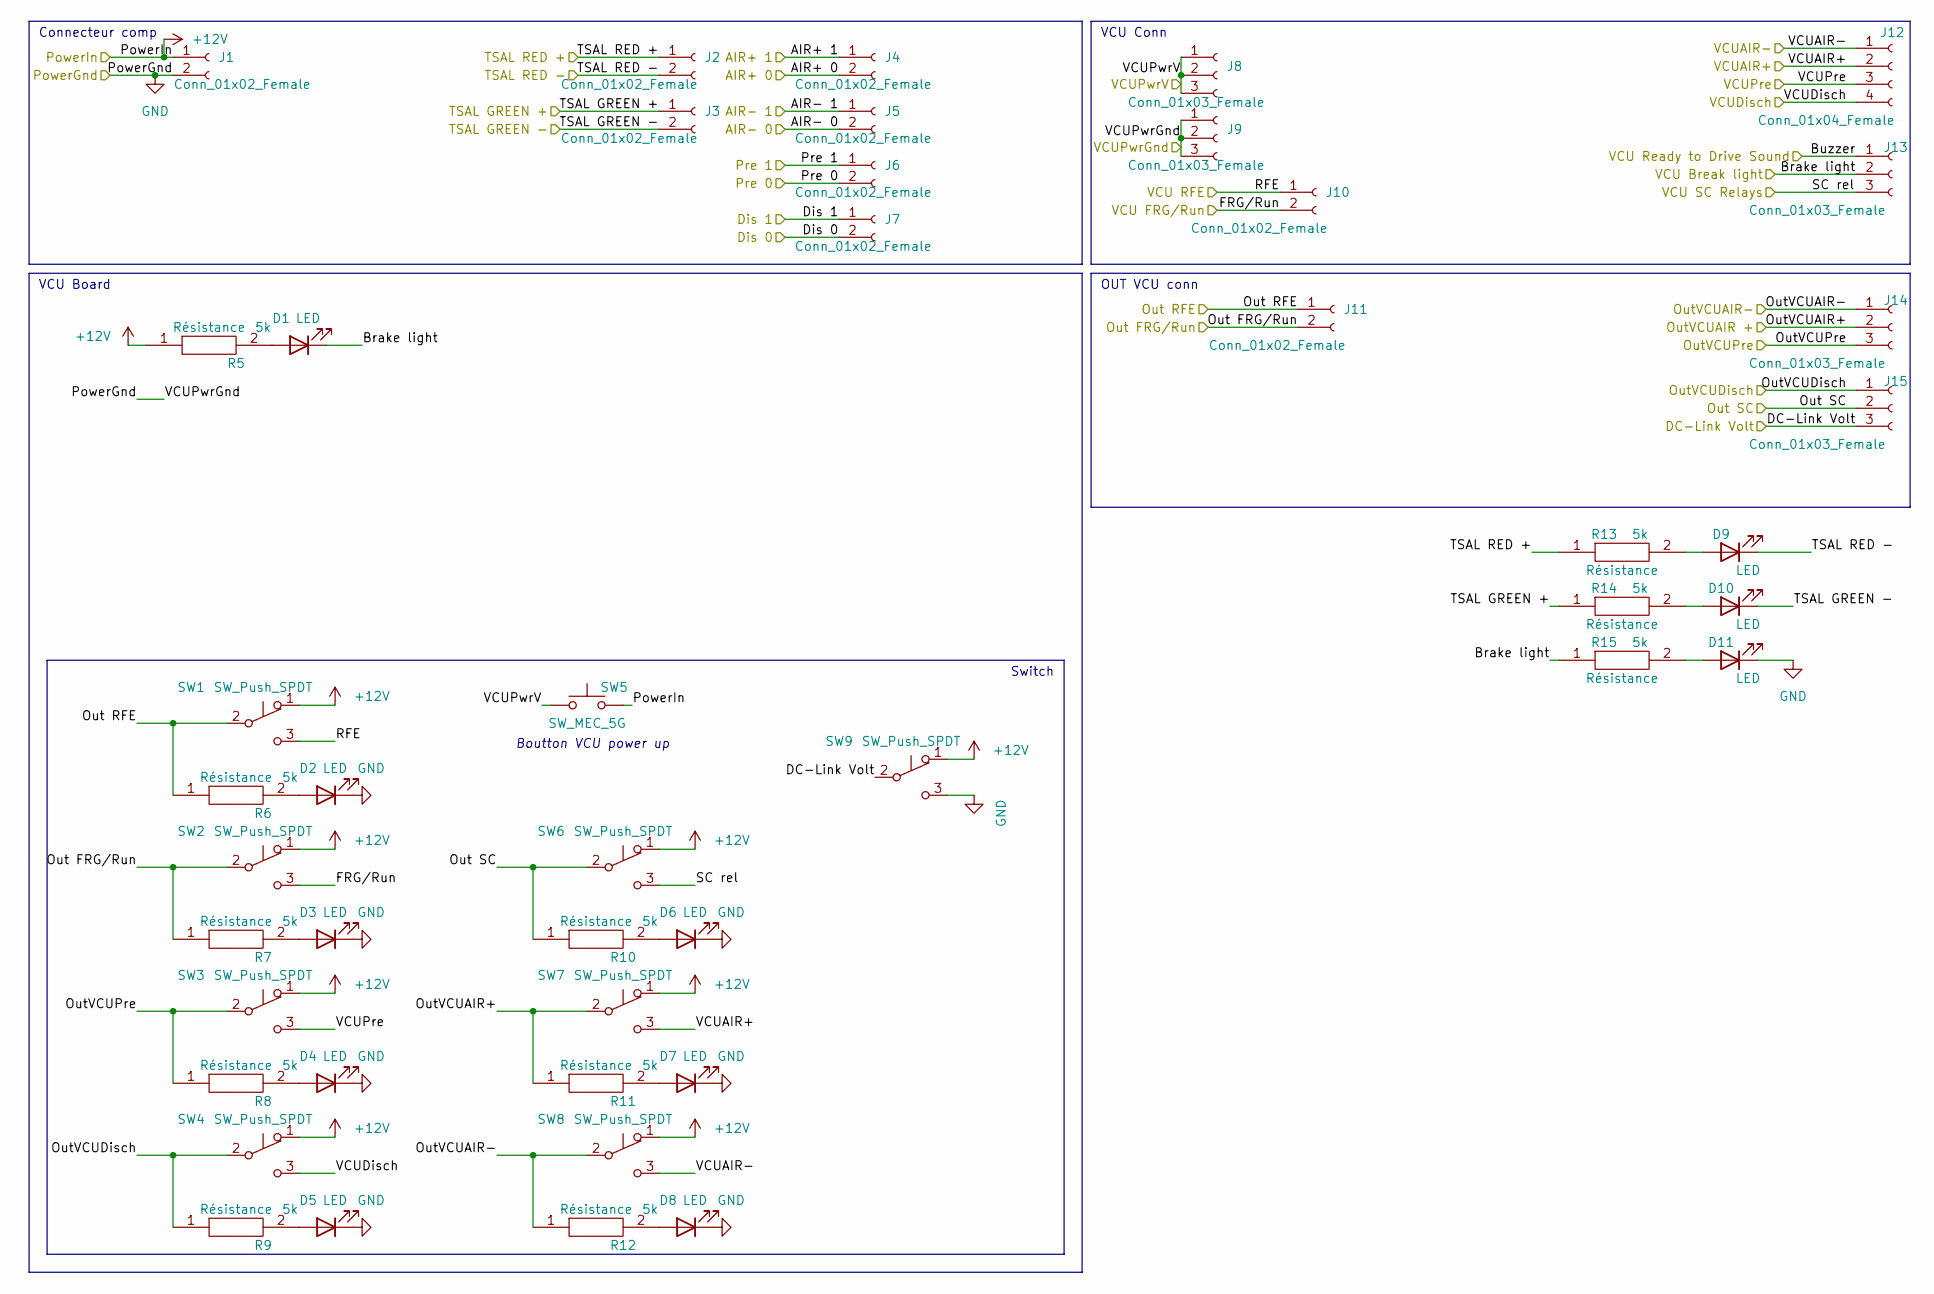
[picture p789: schematic Carte_VCU - Back.kicad_sch]

Parts:
D1, D2, D3, D4, D5, D6, D7, D8, D9, D10, D11: LED; LED_D5.0mm
J1, J2, J3, J4, J5, J6, J7, J10, J11: Conn_01x02_Female; JST_EH_S2B-EH_1x02_P2.50mm_Horizontal
J8, J9: Conn_01x03_Female; Wuerth_WR-WTB_64800311622_1x03_P1.50mm_Vertical
J12: Conn_01x04_Female; JST_EH_S4B-EH_1x04_P2.50mm_Horizontal
J13, J14, J15: Conn_01x03_Female; JST_EH_S3B-EH_1x03_P2.50mm_Horizontal
R5, R6, R7, R8, R9, R10, R11, R12, R13, R14, R15: Résistance RK73H2BLTDD2152F; RESC3216X70N; Manufacturer_Part_Number RK73H2BLTDD2152F; Mouser Part Number N/A
SW1, SW2, SW3, SW4, SW6, SW7, SW8, SW9: SW_Push_SPDT; JST_EH_B3B-EH-A_1x03_P2.50mm_Vertical
SW5: SW_MEC_5G; JST_EH_B2B-EH-A_1x02_P2.50mm_Vertical

Connections:
+12V: J1.1, R5.1, SW1.1 (A), SW2.1 (A), SW3.1 (A), SW4.1 (A), SW5.3 (B), SW5.4 (B), SW6.1 (A), SW7.1 (A), SW8.1 (A), SW9.1 (A)
AIR+ 0: J4.2
AIR+ 1: J4.1
AIR- 0: J5.2
AIR- 1: J5.1
Brake light: D1.1 (K), J13.2, R15.1
Buzzer: J13.1
DC-Link Volt: J15.3, SW9.2 (B)
Dis 0: J7.2
Dis 1: J7.1
FRG/Run: J10.2, SW2.3 (C)
GND: D2.1 (K), D3.1 (K), D4.1 (K), D5.1 (K), D6.1 (K), D7.1 (K), D8.1 (K), D11.1 (K), J1.2, J9.1, J9.2, J9.3, SW9.3 (C)
unnamed: D1.2 (A), R5.2
unnamed: D2.2 (A), R6.2
unnamed: D3.2 (A), R7.2
unnamed: D4.2 (A), R8.2
unnamed: D5.2 (A), R9.2
unnamed: D6.2 (A), R10.2
unnamed: D7.2 (A), R11.2
unnamed: D8.2 (A), R12.2
unnamed: D9.2 (A), R13.2
unnamed: D10.2 (A), R14.2
unnamed: D11.2 (A), R15.2
Out FRG/Run: J11.2, R7.1, SW2.2 (B)
Out RFE: J11.1, R6.1, SW1.2 (B)
Out SC: J15.2, R10.1, SW6.2 (B)
OutVCUAIR +: J14.2, R11.1, SW7.2 (B)
OutVCUAIR-: J14.1, R12.1, SW8.2 (B)
OutVCUDisch: J15.1, R9.1, SW4.2 (B)
OutVCUPre: J14.3, R8.1, SW3.2 (B)
Pre 0: J6.2
Pre 1: J6.1
RFE: J10.1, SW1.3 (C)
SC rel: J13.3, SW6.3 (C)
TSAL GREEN +: J3.1, R14.1
TSAL GREEN -: D10.1 (K), J3.2
TSAL RED +: J2.1, R13.1
TSAL RED -: D9.1 (K), J2.2
VCUAIR+: J12.2, SW7.3 (C)
VCUAIR-: J12.1, SW8.3 (C)
VCUDisch: J12.4, SW4.3 (C)
VCUPre: J12.3, SW3.3 (C)
VCUPwrV: J8.1, J8.2, J8.3, SW5.1 (A), SW5.2 (A)

Notes on the sheet:
Switch
Connecteur comp
Boutton VCU power up
VCU Conn
VCU Board
OUT VCU conn
