EOSCogniton/ELIZ-2022/(commit log)

2022-07-29 Putain de simus
2022-09-20 Grilles et BSPD
    [Grilles.CATPart]
2022-09-28 Pré tutoriel Git
    Positionnement du tutoriel
    [Barre Design.xlsx, TSAL.sch]
2022-09-28 Insertion test
2022-10-04 Ajout Pièce banc
    [EN_01001 (EMRAX_228).CATProduct, Support presse etoupe.CATProduct, Support.CATPart]
2022-10-05 Banc Ajout
    Ajout banc
    [Grilles.CATPart, Support.CATPart]
2022-10-10 Tuto Catia part1
    [Chape bas.CATPart, Chapes.CATProduct, Filaires chapes.CATPart, Filaires tubes.CATPart, Tube haut.CATPart, Tubes.CATProduct, Tuto.CATProduct, tube bas.CATPart]
2022-10-10 Tuto Catia
    [Filairechape.CATPart, chapebas.CATPart, chapehaut.CATPart, chapes.CATProduct, chapestubes.CATProduct, filairetube.CATPart, tube.CATProduct, tubebas.CATPart]
2022-10-12 Tuto Catia MSC
    [Chape bas.CATPart, Chape haut.CATPart, Chapes.CATProduct, Fialire chapes.CATPart, Filaire tube.CATPart, Produit1.CATProduct, Tube bas.CATPart, Tube haut.CATPart]
2022-10-13 création répertoire chassis
    [12x1.5.CATProduct, 12x2.5.CATPart, 15x1.5.CATPart, 20x1.5.CATPart, 25x1.5.CATPart, 28x1.5.CATPart, 28x2.CATPart, 28x2.CATProduct]
2022-10-18 filaire en legende
    [Filaire.CATPart]
2022-10-18 fin filaire
    [Filaire.CATPart]
2022-10-18 début tubes
    [30x2.CATProduct, Shape_008.CATPart, Shape_009.CATPart, Shape_010.CATPart, Shape_011.CATPart, Shape_012.CATPart, Shape_013.CATPart, Shape_014.CATPart]
2022-10-26 Testb push
    [filaire tubes.CATPart]
2022-10-26 Test Push
    [Part5.CATPart, Produit1.CATProduct, chape bas.CATPart, chape haut.CATPart, chapes.CATProduct, contact_chapes.CATPart, etape1.CATProduct, etape2.CATProduct]
2022-10-26 Documentation batterie
    [Calcul-du-nombre-de-cellules-et-des-dimensions-à-utiliser.xlsx, calculs elec et dimensions.xlsx]
2022-10-26 Cleanup Catia
    [EN_01001 (EMRAX_228).CATProduct, Grilles.CATPart, Support presse etoupe.CATProduct, Support.CATPart]
2022-10-26 Cleanup Catia bis
    [6x60.CATPart, EL_04001 (Armature).CATPart, EL_04002 (Urgent stop button).CATPart, EL_04003 (Simple Button).CATPart, EL_04004 (Bistable Switch).CATPart, EL_04005 (Tristable Switch).CATPart, EL_04006 (Screen).CATPart, EL_04007(Flat Bracket).CATPart]
2022-10-31 Ajout des ressources électroniques
    [0805Y1000104JXT.stp, 171857-4002.stp, 171857-4004.stp, 171857-4006.stp, 22-11-2022.step, 22-11-2032.step, 22-11-2042.step, 22-11-2062.stp]
2022-11-01 TSAL red et TSAL Green en construction
    [TSAL_Green.kicad_pcb, TSAL_Green.kicad_sch, TSAL_Red.kicad_pcb, TSAL_Red.kicad_sch, TSAL_Red_V1.kicad_sch, TSAL_Red_v1_NMOS.kicad_sch]
2022-11-06 Maj librairie Kicad
    Attribution de noms courts aux composants
2022-11-15 gueules de aouhhhh
    [15x1.5.CATProduct, 25x1.5.CATProduct, 28x1.5.CATProduct, 30x2.CATProduct, Fr_A0100 (Frame).CATProduct, Produit6.CATProduct, Shape_336.CATPart, Shape_341.CATPart]
2022-11-27 ajout TSAL verte
    [TSAL verte.kicad_pcb, TSAL verte.kicad_sch]
2022-11-27 TSAL RED
    [TSAL_Red.kicad_pcb, TSAL_Red.kicad_sch]
2022-11-27 Ajout NDrive et pièce refroidissement banc
    [Assemblage support.CATProduct, Auto_include.csv, Bus_include.csv, Bus_include_org.csv, Deuxieme attache.CATPart, Device_include.csv, Diagnose_include.csv, EN_01001 (EMRAX_228).CATProduct]
2022-11-27 Auto stash before rebase of "origin/master"
    Ajout des travaux sur le MES48V dans le dossier associé.
    [Calcul du nombre de cellules et des dimensions à utiliser.xlsx, Calculs dimensions.xlsx, Plaque carter cellules.CATProduct, Plaque plexi grille.CATProduct, calculs elec et dimensions.xlsx, carter_c5.CATPart, cellule-18650.catpart, ensemble.CATProduct]
2022-11-27 Auto stash before rebase of "origin/master"
    tsalrouge_maelle
    [PART 4 CORP.CATPart, PART 4 CORP2.CATPart, Part1 PINCE.CATPart, Part3 BIELLETTE.CATPart, Produit1.CATProduct, assemblage chapes.CATProduct, assemblage tubes.CATProduct, carte.kicad_pcb]
2022-11-27 Revert "Auto stash before rebase of "origin/master""
    This reverts commit 9aaa80b20b68c94933b09e65a6ab1b2f5e794cdc.
    [PART 4 CORP.CATPart, PART 4 CORP2.CATPart, Part1 PINCE.CATPart, Part3 BIELLETTE.CATPart, Produit1.CATProduct, assemblage chapes.CATProduct, assemblage tubes.CATProduct, carte.kicad_pcb]
2022-11-27 Modélisation Catia des V2 du MES48V
    Modification du fichier Excel du calcul de dimensions, ajouts de plusieurs modélisation en Catia pour c=7 et c=5 de trois pièces différentes, assemblages desdites pièces.
    [Calculs dimensions double feuille.xlsx, Calculs dimensions.xlsx, Plaque carter cellules.CATProduct, ensemble.CATProduct, filaire_plaque_c7.CATPart, grille_c5_V2.CATPart, grille_c7_V2.CATPart, plaque_alveolee_c7.CATProduct]
2022-11-29 Auto stash before rebase of "origin/master"
    [Auto_include.csv, Bus_include.csv, Bus_include_org.csv, Device_include.csv, Diagnose_include.csv, EN_01001 (EMRAX_228).CATProduct, Extra_include.csv, Feedback_include.csv]
2022-11-29 gueules de loups
    [28x1.5.CATProduct, Fr_A0100 (Frame).CATProduct, Produit6.CATProduct, Shape_319.CATPart, Shape_342.CATPart, Shape_343.CATPart, Shape_344.CATPart, Shape_345.CATPart]
2022-11-30 Ajout TSAL Rouge
    [carte.kicad_pcb, carte.kicad_sch]
2022-11-30 Clarification TSAL verte
    [TSAL verte.kicad_sch]
2022-11-30 gueules de loups suite
    [25x1.5.CATProduct, 28x1.5.CATProduct, 30x2.CATProduct, Fr_A0100 (Frame).CATProduct, Produit6.CATProduct, Shape_319.CATPart, Shape_320.CATPart, Shape_322.CATPart]
2022-11-30 tSAL ROUGE
    [carte.kicad_sch]
2022-12-04 gdl fin j'espère
    [25x1.5.CATProduct, Fr_A0100 (Frame).CATProduct, Produit6.CATProduct, Shape_336.CATPart, Shape_380.CATPart, Shape_382.CATPart, Shape_392.CATPart, Shape_432.CATPart]
2022-12-04 TSAL Fini
    [TSAL verte.kicad_sch, TSAL.csv, TSAL.kicad_pcb, TSAL.kicad_sch, TSAL_Green_Latching.kicad_pcb, TSAL_Green_Latching.kicad_sch, TSAL_Green_log.kicad_pcb, TSAL_Green_log.kicad_sch]
2022-12-05 Modification bureau Catia MES48V
    [Calculs dimensions double feuille.xlsx, plaque_plexi_grille_c5_V2.CATProduct]
2022-12-05 Ajout de modèles de connexions électriques et réparation des fichiers Catia
    [Calculs dimensions double feuille.xlsx, Comparaison c=5.xlsx, comparaison_connecteurs_V2.xlsx]
2022-12-06 ajout chapes chasea
    [Chape_L1.CATPart, Chape_L1b.CATPart, Chape_L2.CATPart, Chape_L2b.CATPart, Chape_M1.CATPart, Chape_M1b.CATPart, Chape_M2.CATPart, Chape_M2b.CATPart]
2022-12-06 Résolution pb1
    [15x1.5.CATProduct, 25x1.5.CATProduct, 28x1.5.CATProduct, Fr_A0100 (Frame).CATProduct, Produit6.CATProduct, Shape_326.CATPart, Shape_333.CATPart, Shape_336.CATPart]
2022-12-06 à chier
    [25x1.5.CATProduct, 28x1.5.CATProduct, Filaire.CATPart, Fr_A0100 (Frame).CATProduct, Produit6.CATProduct, Shape_338.CATPart, Shape_361.CATPart, Shape_362.CATPart]
2022-12-12 TSAL Last update et percage
    [TSAL.kicad_pcb, TSAL.kicad_sch, TSAL_Green_Latching.kicad_sch]
2022-12-13 fin gdl
    [15x1.5.CATProduct, 25x1.5.CATProduct, 28x1.5.CATProduct, Filaire.CATPart, Fr_A0100 (Frame).CATProduct, Produit6.CATProduct, Shape_333.CATPart, Shape_336.CATPart]
2022-12-14 Ajout Gabarit Scrut (conformité châssis)
    [Cockpit opening template.CATPart, T2-3-2 (ground clearance).CATPart, T_2-1-3 (Wheel).CATPart, internal cross section template.CATPart]
2022-12-20 Fin BSPD
    Fin du BSPD et travail sur la TSAL
    [BSPD.kicad_pcb, BSPD.kicad_sch, Banc manquante.CATProduct, Support.CATPart, Support.stl, TSAL.kicad_pcb, TSAL.kicad_sch, TSAL_Red_log.kicad_sch]
2022-12-29 Fin Cartes V2
    [TSAL.kicad_pcb, TSAL.kicad_sch, TSAL_Voltage_Sensor.kicad_pcb]
2023-01-03 mise en plan chassis numérotation tubulaire de 1 à 92
2023-01-05 création simulations thermiques
    creation modele thermique
    [cellule 18650.CATPart, modele_thermique_1.CATProduct, volume_cellules.CATPart, volume_fluide.CATPart]
2023-01-10 nvelles regles
    [2020-FSAE-SES-v1.0.xlsx]
2023-01-10 ajout vrai ses
    [SES EPSA 2023.xlsx]
2023-01-17 Cartes elec version cirly
    [BSPD-B_Cu.gbr, BSPD-B_Mask.gbr, BSPD-B_Paste.gbr, BSPD-B_Silkscreen.gbr, BSPD-Edge_Cuts.gbr, BSPD-F_Cu.gbr, BSPD-F_Mask.gbr, BSPD-F_Paste.gbr]
2023-01-17 ajout nouveaux tubes arrière
    [28x1.5.CATProduct, Fr_A0100 (Frame).CATProduct, Produit6.CATProduct, Shape_333.CATPart, Shape_412.CATPart, Shape_415.CATPart, Shape_417.CATPart, Shape_500.CATPart]
2023-01-19 Création du modèle paramétrique de module batterie
    [modele_parametrique_1.CATProduct, modele_thermique_1.CATProduct, volume_cellules.CATPart, volume_fluide.CATPart]
2023-01-31 Exemple MEP tube
    [Tube 06.stp]
2023-01-31 pdf chassis numérotation
2023-02-01 TSAL FIN
    [TSAL_Voltage_Sensor.step]
2023-02-01 Préparation MEP tubes
    [Tube 06.stp]
2023-02-03 MEP artemiz
    [EL_01009 OK(Container mounting point).dxf, EL_01009 OK(Container mounting point).v2.stp, EN_01005.stp, EN_01010 (sprocket spacer).stp, FR_010001 (Insert front).stp, FR_010002 (Insert rear).stp, FR_04001_1 (Frame Brake).dxf, FR_04001_10 (Frame Brake).dxf]
2023-02-08 Impression A0 numérotation tubes
2023-02-16 MEP 30 x 2
    [25 Frronthoop.stp, 30x2.CATProduct, 45.stp, 47.stp, Shape_616.CATPart]
2023-02-19 mep tubes chassis
    [26.stp, 30.stp, 41.stp, 42.stp, 43.stp, 44.stp, Shape_425.CATPart, Shape_428.CATPart]
2023-02-19 Auto stash before rebase of "origin/master"
    MEP Tubes
    [15x1.5.CATProduct, 25x1.5.CATProduct, 25x2.CATProduct, 28x1.5.CATProduct, 30x2.CATProduct, Assemblage pince.CATProduct, Bielette.CATPart, Corps.CATPart]
2023-02-20 Réparation perte fichiers AAT
    [10.stp, 11.stp, 12.stp]
2023-02-20 Tube 1-3
    [Shape_341.CATPart, Shape_347.CATPart, Tube 03.stp, Tube 06.stp]
2023-02-20 Re Tube 01
    [Shape_480.CATPart, Tube 01.stp]
2023-02-20 Re Tube 02
    [Shape_347.CATPart, Tube 02.stp]
2023-02-20 Tubes 3-4
    [Shape_343.CATPart, Tube 04.stp]
2023-02-20 MEP 25x1.5
    [10.stp, 11.stp, 12.stp, 13.stp, 14.stp, 15.stp, 16.stp, 21.CATPart]
2023-02-20 moitié tube 97, tube 5 disparu
    [28x1.5.CATProduct, Shape_342.CATPart, Shape_345.CATPart, Tube 97.stp]
2023-02-21 35 et 36
    [Tube 35.stp, Tube 36.stp]
2023-02-21 1 et 2
    [Tube 01.stp, Tube 02.stp]
2023-02-21 Suppression dossiers avec mauvaises MEP
    [Tube 01.stp, Tube 02.stp]
2023-02-21 MEP tubes
    [63.stp, 64.stp, 65.stp, 66.stp, 71.stp, 72.stp, 73.stp, 74.stp]
2023-02-23 Reprise manqueS MRT et MEP finies !
    [49.stp]
2023-02-24 Fichiers decoupe Noel Metal
    [10.stp, 11.stp, 12.stp, 13.stp, 14.stp, 15.stp, 16.stp, 17.stp]
2023-02-28 mep frame haut dessous
2023-02-28 mep cote frame
2023-02-28 Infos saison 2022
    [Carbon Rules.xlsx, Liste chapes 2022_2023.xlsx, chassis_test.catpart]
2023-03-01 Cockpit templates
    [Cockpit opening template.CATPart, Impactor Check.CATPart, internal cross section template.CATPart]
2023-03-07 ajustement arrière
    [25x1.5.CATProduct, 28x1.5.CATProduct, Filaire.CATPart, Fr_A0100 (Frame).CATProduct, Shape_342.CATPart, Shape_343.CATPart, Shape_344.CATPart, Shape_345.CATPart]
2023-03-08 Ajout can switcher et rajout sur EPSAlib
    [5747844-2.stp, CAN_Switcher.kicad_pcb, CAN_Switcher.kicad_sch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]
2023-03-08 (old) ajout tsal green
    [projet1bis.kicad_pcb, projet1bis.kicad_sch]
2023-03-08 ajout reset
    [projet1bis.kicad_pcb, projet1bis.kicad_sch]
2023-03-22 Rectification Noel Metal 51,52,61,62
    [25x1.5.CATProduct, 51.CATPart, 51.stp, 52.CATPart, 61.CATPart, 61.stp, 62.CATPart, Filaire.CATPart]
2023-03-22 pb noël métal
    [15x1.5.CATProduct, 25x1.5.CATProduct, 28x1.5.CATProduct, 33.stp, 34.stp, 41.stp, 69.stp, 90.stp]
2023-03-22 pb noël metal
    [15x1.5.CATProduct, 85.stp, 86.stp, Fr_A0100 (Frame).CATProduct, Shape_527.CATPart, Shape_633.CATPart, Shape_634.CATPart, Tubes.CATProduct]
2023-03-23 Ajout LASMECA2
    [10x100.CATPart, 10x100CHC.CATPart, 10x20.CATPart, 10x20CHC.CATPart, 10x25.CATPart, 10x25CHC.CATPart, 10x30.CATPart, 10x30CHC.CATPart]
2023-03-28 Ajout Teensy et Mux
    [5747844-2.stp, Demonstrateur_VCU.kicad_pcb, Demonstrateur_VCU.kicad_sch, PIN connecteur.xlsx, TZM5224B-GS08.stp, Teensy_4.0_Assembly.STEP]
2023-03-30 ajout carte accumulator indicator voltage
    [Indicator_voltage.kicad_pcb, Indicator_voltage.kicad_sch]
2023-03-30 Test VCU
    [Demonstrateur_VCU.kicad_sch, PIN connecteur.xlsx, TSAL_Voltage.kicad_sch]
2023-03-30 Carte VCU Avancement
    [Carte_VCU.kicad_pcb, Carte_VCU.kicad_sch, TSAL.kicad_sch]
2023-04-02 MEP hoops pour la Gir
2023-04-09 Carte voltage indicator
    Ajout composant schematics et début du pcb
    [Indicator_voltage.kicad_pcb, Indicator_voltage.kicad_sch]
2023-04-23 Ajout du dongle SCS
    [Carte_VCU.kicad_sch, Comparateur Double Example.kicad_sch, Demonstrateur_VCU.kicad_sch, Indicator_voltage.kicad_sch, SCS_dongle.kicad_pcb, SCS_dongle.kicad_sch, THR_3-7212WI.stp, TypNrTable.csv]
2023-05-07 ESF tentative
    [AE40-UW-S12.stp, AIV.kicad_pcb, AIV.kicad_sch, Carte_VCU.kicad_sch, Date logger.kicad_sch, Demonstrateur_VCU.kicad_sch, HVD.kicad_sch, IMD.kicad_sch]
2023-05-08 Carte voltage indicator pcb
    V1 du pcb de la carte voltage indicator
    [Indicator_voltage.kicad_pcb, Indicator_voltage.kicad_sch]
2023-05-09 Ajout CCPU tubes + .stptube 35
    [35.stp, 74.stp, Tube 35.stp]
2023-05-16 Ajout de l'AMS/IMD Reset
    [AMS & IMD Reset.kicad_pcb, AMS & IMD Reset.kicad_sch, Carte_VCU.kicad_sch, Date logger.kicad_sch, Demonstrateur_VCU.kicad_sch, HVD.kicad_sch, IMD.kicad_sch, Inverter.kicad_sch]
2023-05-21 PCB AMS/IMD Reset
    [AMS & IMD Reset.kicad_pcb]
2023-05-28 Maj cartes
    [AMS & IMD Reset-B_Cu.gbr, AMS & IMD Reset-B_Mask.gbr, AMS & IMD Reset-B_Paste.gbr, AMS & IMD Reset-B_Silkscreen.gbr, AMS & IMD Reset-Edge_Cuts.gbr, AMS & IMD Reset-F_Cu.gbr, AMS & IMD Reset-F_Mask.gbr, AMS & IMD Reset-F_Paste.gbr]
2023-05-31 transversage d'ELIZ 2021
    [12x1.5.CATProduct, 15x1.5.CATPart, 15x1.5.CATProduct, 20x1.5.CATPart, 22x1.5.CATPart, 22x1.5.CATProduct, 25x1.5.CATPart, 25x1.5.CATProduct]
2023-05-31 transvasage body
    [FR_02001 (Nose).CATPart, FR_02002 (Side plates).CATPart, FR_02003 (Chape).CATPart, FR_02004 (Nose Invictus).CATPart, FR_02005 (nose invictus original).CATPart, FR_02006 (Plaques complementaires).CATPart, FR_A0200 (Body).CATProduct, Symmetry of FR_02003.CATPart]
2023-05-31 Transvasage MS
    [MS_01007 (Rear bracket).CATPart, MS_02002 (Brackets up).CATPart, MS_02004 (Brackets down).CATPart, MS_03004(Anti-Submarine Belt Mounting).CATPart, MS_03005(Lap Mounting).CATPart, MS_0400(4-5) (Assemblage chappes).CATProduct, MS_04004 (Bracket_1).CATPart, MS_04005 (Bracket_2).CATPart]
2023-05-31 Début MEPs
    [FR_02003 (Chape).CATPart, FR_03005 (Rear Throttle bracket).dxf, FR_03007 (Front Throttle bracket).dxf, FR_04007 (Brake R Fixing Rail Wedge).dxf, FR_04007 (Rear Brake bracket).dxf, FR_04008 (Front Brake bracket).dxf, FR_04008 (Front Fixing Rail Wedge).dxf, FR_06003_1 (Floor pan bracket)(Front-cell_Front).dxf]
2023-06-01 Fin PCB et maj AMS_IMD_Reset
    [AMS & IMD Reset-B_Cu.gbr, AMS & IMD Reset-B_Mask.gbr, AMS & IMD Reset-B_Paste.gbr, AMS & IMD Reset-B_Silkscreen.gbr, AMS & IMD Reset-Edge_Cuts.gbr, AMS & IMD Reset-F_Cu.gbr, AMS & IMD Reset-F_Mask.gbr, AMS & IMD Reset-F_Paste.gbr]
2023-06-05 Fichiers fabrication Cirly
    [SCS_dongle-B_Cu.gbr, SCS_dongle-B_Mask.gbr, SCS_dongle-B_Paste.gbr, SCS_dongle-B_Silkscreen.gbr, SCS_dongle-Edge_Cuts.gbr, SCS_dongle-F_Cu.gbr, SCS_dongle-F_Mask.gbr, SCS_dongle-F_Paste.gbr]
2023-07-02 Maj KICAD
    [ADG728BRUZ-REEL7.stp, BMS V1.0.kicad_pcb, BMS V1.0.kicad_sch, BSS308PE_H6327.stp, CAS-120B.stp, LT3990EMSE#TRPBF.stp, LTC6811HG-2#PBF.stp, TG110-AE050N5LF.stp]
2023-07-03 travai bms
    [BMS V1.0.kicad_sch]
2023-07-03 Mise a plat doc pour BMS
    [LTC6811IG-1#PBF.stp, SM91501ALE.stp]
2023-07-03 Travail sur le BMS
    [BMS V1.0.kicad_sch]
2023-07-06 Modifs récentes
    [18650 Cell.1.CATPart, BMS V1.0.kicad_sch, Battery Module.CATProduct]
2023-07-07 Ecran HMI + Teensy
2023-07-15 Mise à jour Dashboard
    [Cadran.xlsx]
2023-08-20 BMS advance
    [18650 Cell.1.CATPart, Battery Module.CATProduct, Upper Sup.CATPart]
2023-08-20 BMS advance 2
    [Lower Sup.CATPart]
2023-10-02 réorganisation de dossiers MEP
    [FR_03005 (Rear Throttle bracket).dxf]
2023-10-10 encore des Meps
    [MS_01006 (Bracket seat rear).dxf, MS_01006 (Rear bracket).CATPart, MS_01007_1 (Right Seat Bracket).dxf, MS_01007_2 (Left Seat Bracket).dxf, MS_02002_1 (Right Up Bracket Head Restraint).dxf, MS_02002_2 (Left Up Bracket Head Restraint).dxf, MS_02004_1 (Right Down Bracket Head Restraint).dxf, MS_02004_2 (Left Down Bracket Head Restraint).dxf]
2023-10-17 MAJ equipements
    [EL_03002 (LV Battery support).CATPart, EL_03002-LV-Battery-support.catpart, EL_06008 SUpport HVD.dxf, EL_06008.CATPart, EL_06009.CATPart, EL_06010 (HVD Assembly).CATProduct, EL_06010(HVD)(volume enveloppe).CATPart, EL_06010.CATPart]
2023-10-19 MEP + réorganisation
    [Cockpit plate.CATPart]
2023-10-23 réorganisation + doc norme tolérancement
    [FR_02003 (Chape push clips).CATPart, FR_02003 (Chape).CATPart, FR_02003.dxf]
2023-10-25 création dossier d'envoi
    [FR_02003.dxf, FR_03005.dxf, FR_03007.dxf, FR_04007.dxf, FR_04008.dxf, MS_02004_1.dxf, MS_02004_2.dxf]
2023-11-08 réorganisation de dossier mep
    [ST_05001 (Front Bracket).dxf]
2023-11-08 Transfert MEP SU
    [Chape_FRocker_F.dxf, Chape_Fw_La_Fp_Low.dxf, Chape_Fw_La_Fp_Up.dxf, Chape_Fw_La_Rp_Up.dxf, Chape_Fw_Ra_Rp_Low.dxf, Chape_Fw_Ua_Fp_Low.dxf, Chape_Fw_Ua_Fp_Up.dxf, Chape_Fw_Ua_Rp_Low.dxf]
2023-11-08 Modif Rocker F
    [Chape_RRocker_F.dxf]
2023-11-08 Deplacement fichier masse de 2021 à 2022
    [EL_masses.dxf]
2023-11-12 Préparation lancement prod chapes EN
    [Chape_L1.dxf, Chape_L1_b.dxf, Chape_L2.dxf, Chape_L2_b.dxf, Chape_M1.dxf, Chape_M1_b.dxf, Chape_M2.dxf, Chape_M2_b.dxf]
2023-11-12 dossier de lancement
    [Chape_L1.dxf, Chape_L1_b.dxf, Chape_L2.dxf, Chape_L2_b.dxf, Chape_M1.dxf, Chape_M1_b.dxf, Chape_M2.dxf, Chape_M2_b.dxf]
2023-11-12 Préparation lancement prod chapes SU
    [Chape_FL_Damper_Down.dxf, Chape_FL_Damper_Up.dxf, Chape_FRocker_F.dxf, Chape_FRocker_R.dxf, Chape_Fw_La_Fp_Low.dxf, Chape_Fw_La_Fp_Up.dxf, Chape_Fw_La_Rp_Up.dxf, Chape_Fw_Ra_Rp_Low.dxf]
2023-11-12 suite dossier de lancement
    [Chape_FL_Damper_Down.dxf, Chape_FL_Damper_Up.dxf, Chape_FRocker_F.dxf, Chape_FRocker_R.dxf, Chape_Fw_La_Fp_Low.dxf, Chape_Fw_La_Fp_Up.dxf, Chape_Fw_La_Rp_Up.dxf, Chape_Fw_Ra_Rp_Low.dxf]
2023-11-13 Réorganisation BASTIE
    Déplacement des cartes dans le dossier BASTIE pour séparer les cartes de Valkyriz et d'Artemiz
    [18650 Cell.1.CATPart, AIV.kicad_pcb, AIV.kicad_sch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]
2023-11-14 Rangement du GIT
    Séparation entre les arborescences "maquette", "doc" et "banc"
    [0805Y1000104JXT.stp, 10.stp, 11.stp, 12.stp, 12x1.5.CATProduct, 13.stp, 14.stp, 15.stp]
2023-11-14 Revert "Rangement du GIT"
    This reverts commit cb682cbc7dd55bb44f1e31085f522a7fb4435130.
    [0805Y1000104JXT.stp, 10.stp, 11.stp, 12.stp, 12x1.5.CATProduct, 13.stp, 14.stp, 15.stp]
2023-11-14 Rangement du GIT
    [0805Y1000104JXT.stp, 10.stp, 10x100.CATPart, 10x100CHC.CATPart, 10x20.CATPart, 10x20CHC.CATPart, 10x25.CATPart, 10x25CHC.CATPart]
2023-11-14 Création de la maquette EL_Electrical
    [EL_Electrical.CATProduct, Tubes.CATProduct]
2023-11-15 ST_05002 : MEP et modification distance centre rayon ord du haut (3xR)
    [ST_05002 (Rear Bracket).CATPart, ST_05002.dxf]
2023-11-19 Récupération Catia BASTIE Valky
    [6x45CHC.CATPart, AMS_ntc_sensor.CATPart, AMS_power_and_CAN.CATPart, Attache front hoop bis.CATPart, Attache front hoop.CATPart, Boitier_carte.CATPart, Chape Lumière.CATPart, Chappe.CATPart]
2023-11-19 Ajout Excel FS Rules
    [FS_Rules.xlsm]
2023-11-19 Réorganisation Catia BASTIE
    [EL_03002 (LV Battery support).CATPart, EL_03002-LV-Battery-support.catpart, EL_1101 (Brake light).CATPart, EL_1102 (Chape brake light).CATPart, EL_12001(Inertia Switch).CATPart, EL_12002(Chape).CATPart, EL_A1100 (Brake Light).CATProduct, EL_A1101 (Brake light).CATPart]
2023-11-20 Shutdown Buttons
    [EL_17001 (Button).CATPart, EL_17002 (Chape).CATPart, EL_A1200(Inertia Switch).CATProduct, EL_A1700 (Shutdown Buttons).CATProduct, EL_Electrical.CATProduct, chape_shutdownbutton.CATPart]
2023-11-21 Mise en place maquette EL
    [EL_06002 (support MS ter).CATPart, EL_16001 (Fuse Box).CATPart, EL_16002 (Chape).CATPart, EL_A1700 (Shutdown Buttons).CATProduct, EL_Electrical.CATProduct, Fuse_Box_Ass.CATProduct, Symmetry of Chape_ShutdownButton.CATPart, Symmetry of Shutdown_Buttons_Ass.CATProduct]
2023-11-22 Mise a jour carte pcb BMS
    Le fichier de la carte Bms était vide, j'ai mis le bon.
    [BMS V1.0 (1).kicad_pcb, BMS V1.0.kicad_pcb]
2023-11-25 Remplacement du FR_Frame
    Le Product de la structure tubulaire était incorrect dans EL_Electrical
    [EL_Electrical.CATProduct]
2023-11-25 Suite maquette EL_Electrical
    [Base_Master_Switch.CATPart, Capuchon_Master_Switch.CATPart, EL_06001(Master switch).CATPart, EL_06002 (boitier TSMP montage).CATProduct, EL_06002 (support MS ter capeau).CATPart, EL_06002 (support MS ter clip).CATPart, EL_06002 (support MS ter cylindre clip).CATPart, EL_06002 (support MS ter).CATPart]
2023-11-26 MS Plate et placement
    [6x45CHC.CATPart, Base_Master_Switch.CATPart, Capuchon_Master_Switch.CATPart, EL_06009.CATPart, EL_06010.CATPart, EL_06012.CATPart, EL_15001 (Plate).CATPart, EL_15003 (Master Switch).CATProduct]
2023-11-28 MAJ Electrical
    [Banana Cap.CATPart, Banana Plug.CATPart, Base_Master_Switch.CATPart, EL_08001 (Brigh SuperLED).CATPart, EL_15001 (Plate).CATPart, EL_15002 (Banana Plug).CATPart, EL_15002 (TSMP).CATProduct, EL_15003 (Master Switch).CATProduct]
2023-11-29 Update Dashboard
    Ajout latence et fonctionnement du changement de page
2023-11-29 mise en plan arbres de transmission
    [EN_04011.dxf, EN_04012.dxf]
2023-11-29 modifs meps
    [EN_04011.dxf, EN_04012.dxf]
2023-11-29 Import BMS files
    Import des fichiers BMS directement depuis le git d'eymeric
    [BMS V1.0 (1).kicad_pcb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]
2023-11-29 Tests encore
    [ST_06002 (Palier direction).CATPart]
2023-11-29 Tri des fichiers de RBX
    [1206_EM.catproduct, 1206_EM_18.catpart, 1206_EM_3.catpart, 1206_EM_33.catpart, 1206_EM_35.catpart, 1206_EM_37.catpart, 1206_EM_39.catpart, 15x1.5.CATProduct]
2023-11-29 Gabarits FR
    Copie des gabarits du framebody de 2021 vers 2022
    [EL_A1102 (Chape brake light).CATPart, E_accel_arr.CATPart, E_acel_av.CATPart, E_frein_arriere.CATPart, E_frein_avant.CATPart, Exterieur gauche.CATPart, Gabarit-harness-submarine.CATProduct, Gabarit_accel.CATProduct]
2023-11-29 Tri des fichiers de RBX (2/2)
    [10x100.CATPart, 10x100CHC.CATPart, 10x20.CATPart, 10x20CHC.CATPart, 10x25.CATPart, 10x25CHC.CATPart, 10x30.CATPart, 10x30CHC.CATPart]
2023-11-30 Correction chape Brake Light
    [EL_A1100 (Brake Light).CATProduct, EL_Electrical.CATProduct]
2023-12-02 Ajout TSAL V.S. sans RV
    j'ai ajouté la maquette kicad du tsal voltage sensor sans la resistance variable, du coup j'ai créé 2 dossiers differents. Il faudra du coup refaire la maquette Kicad de la nouvelle carte, mais je ne sais pas comment partir de l'ancienne #MaximeAideMoi
    [TSAL_Voltage_Sensor sans RV1.kicad_sch, TSAL_Voltage_Sensor.kicad_pcb, TSAL_Voltage_Sensor.kicad_sch, TSAL_Voltage_Sensor.step]
2023-12-04 Update VCU
    Dernière maj VCU avec transmission des infos de la batterie LV
2023-12-06 Ajout filaire
    [28x1.5.CATProduct, Filaire.CATPart, Fr_A0100 (Frame).CATProduct, Shape_596.CATPart, Shape_627.CATPart, Tubes.CATProduct]
2023-12-06 Warning fusible manquant sur TSAL VS
    [TSAL_Voltage_Sensor sans RV1.kicad_sch]
2023-12-06 Tubes manquants
    [28x1.5.CATProduct, Filaire.CATPart, Fr_A0100 (Frame).CATProduct, Shape_001.CATPart, Shape_002.CATPart, Shape_003.CATPart, Shape_004.CATPart, Shape_005.CATPart]
2023-12-06 Correction tubes manquants
    [28x1.5.CATProduct, Fr_A0100 (Frame).CATProduct, Shape_003.CATPart, Tubes.CATProduct]
2023-12-08 Ajout du TdB version surfacique
    Pas encore exploitable pour des chapes mais ça va venir
    [Attache front hoop bis.CATPart, Attache front hoop.CATPart, EL_01001 (Dash Panel Support).CATPart, EL_04001 (Armature).CATPart, EL_04002 (Urgent stop button).CATPart, EL_04003 (Simple Button).CATPart, EL_04004 (Bistable Switch).CATPart, EL_04006 (Screen).CATPart]
2023-12-12 éléments cooling system
    [EN_02001 (Radiator).CATPart, EN_02002 (Water Pump).CATPart, EN_02010 (pump_support).CATPart, EN_02011 (croisement tubes).CATPart, EN_A0100(Engine).CATProduct, EN_A0200(Cooling System).CATProduct, EN_Engine_Drivetrain.CATProduct]
2023-12-12 Création dossier EQ_
    [EL_12002 Chape Inertia Switch.dxf]
2023-12-12 Equipements en tout genre
    [EL_12002 Chape Inertia Switch.dxf, EL_12002(Chape).CATPart, EL_17002 (Chape).CATPart, EL_masses.CATPart, EL_masses.dxf, EL_shutdown_button.dxf]
2023-12-12 Nouveau equipement elec
    [EL_A18001.CATPart]
2023-12-12 Création support batterie LV
    [EL_03001 (LV Battery TYVA).CATPart, EL_03003 (LV Battery Support For TYVA Battery).CATPart, LV Battery + Battery Support.CATProduct]
2023-12-12 avancement cooling system
    [EL_02004 (Coolant Lines).CATPart, EN_02001 (Radiator).CATPart, EN_A0200(Cooling System).CATProduct, EN_A0300 (Catch Can).CATProduct, EN_A0300 (Overflow bottle).CATProduct]
2023-12-12 des meps
    [EL_15004 (Chape droite haut).CATPart, EL_15004.dxf, EL_16002 (Chape).CATPart, EL_16002.dxf, EL_A1102 (Chape brake light).CATPart]
2023-12-13 Ajout du fichier des points LAS
    [Points LAS.xlsx]
2023-12-13 Points LAS 1
    [Filaire.CATPart]
2023-12-13 chape avant baquet
    [MS_01008 (Front bracket).CATPart]
2023-12-13 chapes ceintures basses et arrière baquet
    [MS_01006.dxf, MS_01007 (Rear bracket).CATPart, MS_03004 (Anti-submarine + lap belt bracket).dxf]
2023-12-14 Dossier d'envoi la mâche
    [EL_11002.dxf, EL_12002 Chape Inertia Switch.dxf, EL_15004.dxf, EL_16002.dxf, EL_A18001.dxf, EL_masses.dxf, EL_shutdown_button.dxf, MS_03004 (Anti-submarine + lap belt bracket).dxf]
2023-12-16 Resistance TSBOX
    [Resistance.CATPart]
2023-12-17 Electrical BASTIE
    [Banana Cap.CATPart, Banana Cap.stl, EL_03001 (LV Battery TYVA).CATPart, EL_08001 (Brigh SuperLED).CATPart, EL_08002 (Chape TSAL).CATPart, EL_15002 (TSMP).CATProduct, EL_15003 (Master Switch).CATProduct, EL_16001 (Fuse Box).CATPart]
2023-12-17 Contraintes sur des chapes d'EL_Electrical + modif de Insertion Visserie
    [10x100.CATPart, 10x100CHC.CATPart, 10x20.CATPart, 10x20CHC.CATPart, 10x25.CATPart, 10x25CHC.CATPart, 10x30.CATPart, 10x30CHC.CATPart]
2023-12-17 Re-modif de Insertion Visserie
    [10x100.CATPart, 10x100CHC.CATPart, 10x20.CATPart, 10x20CHC.CATPart, 10x25.CATPart, 10x25CHC.CATPart, 10x30.CATPart, 10x30CHC.CATPart]
2023-12-17 Encore quelques contraintes sur les chapes d'EL_Electrical
    [EL_A1200(Inertia Switch).CATProduct, EL_A1700 (Shutdown Buttons).CATProduct, EL_Electrical.CATProduct]
2023-12-19 Importation parties et assemblages (WT,BR)
    [BR_01001 (Front Brake Caliper AP-CP4227-2).CATPart, BR_01001 (front Brake Disc).CATPart, BR_01003 (Cale Front Brake Disc).CATPart, BR_02001 (Rear Brake Caliper AP-CP).CATPart, BR_02001 (Rear Brake Disc).CATPart, BR_02002 (Rear Brake caliper).CATPart, BR_02003 (Rear Brake Pad).CATPart, BR_02004 (Symmetry of BR_02003).CATPart]
2023-12-19 ajout de WT
    [WT_A0000.CATProduct]
2023-12-19 Suspensions (1/?)
    [Artemiz.CATProduct, Chape_Fw_Ua_Fp_Low.CATPart, Chape_Fw_Ua_Fp_Up.CATPart, Filaire.CATPart, Fr_A0100 (Frame).CATProduct, Suspension.CATProduct]
2023-12-19 Update Dashboard
    Mise à jour des logiciels écrans pour affichage R2D et TS et mise à jour baudrate
2023-12-19 Diffuseur thermique
    [Diffuseur thermique.CATPart]
2023-12-19 Suspensions (2/?)
    [Chape_Fw_Ua_Fp_Low.CATPart, Chape_Fw_Ua_Fp_Up.CATPart, Suspension.CATProduct]
2023-12-19 Barre de cuivre
    [Grande barre de cuivre.CATPart, Moyenne barre de cuivre.CATPart, Petite barre de cuivre.CATPart]
2023-12-19 Mise de l'assembalge de la LV dans EL
    [51.CATPart, 52.CATPart, 5x16CHC.CATPart, 61.CATPart, 62.CATPart, Banana Cap.CATPart, Banana Plug.CATPart, Base_Master_Switch.CATPart]
2023-12-19 modification MS001
    [MS_01001 (Seat).CATPart, MS_01003 (Driver v2).CATProduct, MS_01005 (Driver v3) (Small size).CATProduct, MS_01007 (Rear bracket).CATPart, MS_01008 (Front bracket).CATPart, MS_A0100 (Seat & Driver).CATProduct]
2023-12-19 modification Miscelleanous
    [Gabarit Appuie-tete.CATPart, MS_02001 (Support).CATPart, MS_02003 (Foam).CATPart, MS_02005(Roll bar padding).CATPart, MS_03002(MousseEpaules).CATPart, MS_03003(MousseEpauleslongues).CATPart, MS_03004(Anti-Submarine Belt Mounting).CATPart, MS_03005(Lap Mounting).CATPart]
2023-12-19 publications sur le cooling system
    [EL_02004 (Coolant Lines).CATPart, EN_02001 (Radiator).CATPart, EN_02002 (Water Pump).CATPart, EN_02003 (Converter Heat Exchange).CATPart, EN_02004 (Coolant Lines).CATPart, EN_02010 (pump_support).CATPart, EN_02011 (croisement tubes).CATPart, EN_A0300 (Catch Can).CATProduct]
2023-12-20 toutes les publications du système de refroidissement
    [EN_02004 (Coolant Lines).CATPart, EN_02011 (croisement tubes).CATPart, EN_A0200(Cooling System).CATProduct]
2023-12-20 cooling lines
    [EN_02004 (Coolant Lines).CATPart]
2023-12-20 ajout documentation théorie des poutres
2023-12-20 Boitier TS Box
    [Boitier.CATPart]
2023-12-20 Auto stash before rebase of "origin/master"
    Points LAS 2
    [Filaire.CATPart]
2023-12-21 ajout bamocar
    [Bamocar.CATPart, EN_Engine_Drivetrain.CATProduct]
2023-12-24 Insertion visserie BASTIE
    [Banana Cap.CATPart, EL_03001 (LV Battery TYVA).CATPart, EL_08002 (Chape TSAL).CATPart, EL_15001 (Plate).CATPart, EL_15002 (TSMP).CATProduct, EL_15003 (Master Switch).CATProduct, EL_15009 (RS232 Female).CATPart, EL_15010 (RS232 Cap).CATPart]
2023-12-24 Début placement équipements BASTIE
    [EL_15003 (Master Switch).CATProduct, EL_17001 (Button).CATPart, EL_A0300 (LV Battery).CATProduct, EL_A1200(Inertia Switch).CATProduct, EL_A1500 (MS Plate).CATProduct, EL_A1700 (Shutdown Buttons).CATProduct, EL_Electrical.CATProduct, Filaire.CATPart]
2023-12-27 Suite placement BASTIE
    [EL_1101 (Brake light).CATPart, EL_17002 (Chape).CATPart, EL_A0300 (LV Battery).CATProduct, EL_A0800 (TSAL).CATProduct, EL_A1100 (Brake Light).CATProduct, EL_A1102 (Chape brake light).CATPart, EL_A1200(Inertia Switch).CATProduct, EL_A1500 (MS Plate).CATProduct]
2024-01-02 Fin placement BASTIE
    [25x2.CATProduct, Banana Cap.CATPart, Banana Plug.CATPart, Base_Master_Switch.CATPart, Capuchon_Master_Switch.CATPart, EL_01001 (Dash Panel Support).CATPart, EL_03001 (LV Battery TYVA).CATPart, EL_03003 (LV Battery Support For TYVA Battery).CATPart]
2024-01-02 Suppression du doublon "Catia"
    Sauvegarde des modifs sur le fichier du MES dans "03 - H901BENCH"
    [Calculs dimensions double feuille.xlsx, plaque_plexi_grille_c5_V2.CATProduct]
2024-01-07 Modification placement
    Support du boitier pour la TSAL
    [EL_A0300 (LV Battery).CATProduct, EL_A1200(Inertia Switch).CATProduct, EL_A1500 (MS Plate).CATProduct, EL_A1700 (Shutdown Buttons).CATProduct, EL_A1900 (VCU Assy).CATProduct, EL_Electrical.CATProduct, chape_lumieres.CATPart]
2024-01-09 Travail suspensions
    [Chape_Fw_Ua_Fp_Up.CATPart, SU_01001 (Front_Upper_A_Arm_Front_Rod).CATPart, SU_01002 (Front_Upper_A_Arm_Rear_Rod).CATPart, SU_01003 (Front Upper Rod-End Support).CATPart, SU_01004 (Inner Bearing Support).CATPart, SU_01005 (Support Rotule bas).CATPart, SU_01005 (Support Rotule haut).CATPart, SU_01005 (Support Rotule).CATPart]
2024-01-09 Import pédale d'accel (dont pièces remodélisées)
    [FR_03001 - Frame Throttle.CATProduct, FR_03001.1 - Plaque droite.CATPart, FR_03001.10 - Petit cylindre avant.CATPart, FR_03001.11 - Grand cylindre arriere doit.CATPart, FR_03001.12 - Grand cylindre arriere gauche.CATPart, FR_03001.13 - Petit cylindre arriere.CATPart, FR_03001.14 - Plaque arriere droite.CATPart, FR_03001.15 - Plaque arriere gauche.CATPart]
2024-01-09 Head Restaint
    [MS_A0200 (Head Restraint).CATProduct]
2024-01-09 création dossier chapes dans EN
    [Chape1_radia.CATPart, Chape2.5_pompe.CATPart, Chape2_pompo_2.CATPart, Chape2_pompo_3.CATPart, Chape2_radia.CATPart]
2024-01-09 reprise des chapes
    [Chape2_pompo_2.CATPart, Chape2_pompo_3.CATPart, Chape3_radia.CATPart]
2024-01-09 ajout TSBOX
    ajout tsbox depuis eliz2021 dans 2022
    [01155010_A-155-SIL.CATProduct, 16mm2-5.CATPart, 212 OT_1002699_3DSYM.CATPart, 212 UT_1002700_3DSYM.CATPart, 25mm2-10.CATPart, A155_OT_3Dsym.CATPart, A155_UT_3Dsym.CATPart, DIN 84 - ersetzt durch DIN EN ISO 1207 M6 x 30.CATPart]
2024-01-09 Frame and body
    [FR_floor_pan.CATProduct, FR_frame_and_body.CATProduct]
2024-01-09 Pédale d'accel
    [FR_03005 (Rear Throttle Fixing Rail Wedge).CATPart, FR_03007 (Front Throttle Fixing Rail Wedge).CATPart, FR_A0300 (throttle pedal).CATProduct]
2024-01-10 modif pedale accel
    [FR_03005 (Rear Throttle Fixing Rail Wedge).CATPart, FR_03005 (Throttle Fixing Rail Wedge).CATPart, FR_A0300 (throttle pedal).CATProduct]
2024-01-10 dossier SCS ajout
    [SCS.kicad_pcb, SCS.kicad_sch]
2024-01-10 Head restraint assemblage
    [MS_A0200 (Head Restraint).CATProduct]
2024-01-10 Raccordement TS Box onduleur
    [RACCORD_TS_OND.CATPart]
2024-01-10 Suspensions (3/?)
    [ASKUBAL_G_6_D0_0.CATProduct, Bolted_assembly.CATProduct, Chape_Fw_Ua_Fp_Up.CATPart, Filaire.CATPart, Fr_A0100 (Frame).CATProduct, SU_A0100 (Front Upper A-Arm).CATProduct, Suspension.CATProduct]
2024-01-10 Maquette Catia globale (1/?)
    [Artemiz.CATProduct, EL_Electrical.CATProduct, EN_01202(Support transmission).CATPart, EN_A0100(Engine).CATProduct, EN_A0200(Cooling System).CATProduct, EN_Engine_Drivetrain.CATProduct, FR_floor_pan.CATProduct, FR_frame_and_body.CATProduct]
2024-01-12 Dossier d'envoi Noël metal
    [28x1.5.CATProduct, Shape_001.CATPart, Shape_002.CATPart, Shape_003.CATPart, Shape_004.CATPart, Shape_005.CATPart, Tube 1.stp, Tube 2.stp]
2024-01-16 Maquette appui tête
    [MS_02002 (Brackets up).CATPart, MS_A0200 (Head Restraint).CATProduct]
2024-01-16 Rename EL to EN dans TSbox
    :)
    [01155010_A-155-SIL.CATProduct, 212 OT_1002699_3DSYM.CATPart, 212 UT_1002700_3DSYM.CATPart, A155_OT_3Dsym.CATPart, A155_UT_3Dsym.CATPart, DIN 84 - ersetzt durch DIN EN ISO 1207 M6 x 30.CATPart, EN_06002 (Data logger FSG).CATProduct, EN_A0600 (TS Box).CATProduct]
2024-01-16 Auto stash before rebase of "origin/master"
    frame and body maquette
    [Cockpit plate.CATPart, FR_06001 (Front plate).CATPart, FR_06002 (Cockpit plate).CATPart, FR_06003.CATPart, FR_06003_1(Chape_FL_Cell_Avant).CATPart, FR_06003_2(Chape_FL_Cockpit).CATPart, FR_06003_3(Chape_RL_Cell_Avant).CATPart, FR_06003_4(Chape_RL_Cockpit).CATPart]
2024-01-16 Auto stash before rebase of "origin/master"
    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
    [FR_frame_and_body.CATProduct]
2024-01-16 chape 2 radiateur
    [Chape2_radia.CATPart]
2024-01-16 orientation de la chape 1
    [Chape1_radia.CATPart, EN_A0200(Cooling System).CATProduct, Radiator.CATProduct]
2024-01-16 Avancement TSBox
    [TSBox2024_peutetre.CATProduct]
2024-01-16 Fin pédale accel
    [FR_03005 (Rear Throttle Fixing Rail Wedge).CATPart, FR_03006 (Throttle Threated Rod).CATPart, FR_03012_1(Potentiometer Rod).CATPart, FR_03012_2(Potentiometer Body).CATPart, FR_A0300 - Throttle pedal.CATProduct]
2024-01-16 Cartes BASTIE et modifs CATIA
    [4302H5-5V.stp, Banana Cap.CATPart, Banana Cap.stl, EL_15002 (TSMP).CATProduct, EL_15003 (Master Switch).CATProduct, EL_A0200 (Ground).CATPart, EL_A0300 (LV Battery).CATProduct, EL_A1200(Inertia Switch).CATProduct]
2024-01-17 rajout overflow bottle
    [EN_A0300 (Overflow bottle).CATProduct]
2024-01-17 rajout catch can
    [EN_A0300 (Catch Can).CATProduct]
2024-01-17 assemblage chape
    [Chape_Fw_Ua_Fp_Up.CATPart, SU_A0100 (Front Upper A-Arm).CATProduct, Supension chape assembly.CATProduct, Suspension.CATProduct]
2024-01-17 Maj BASTIE
    [Attache front hoop bis.CATPart, Attache front hoop.CATPart, EL_04001 (Armature).CATPart, EL_04002 (Urgent stop button).CATPart, EL_04003 (Simple Button).CATPart, EL_04004 (Bistable Switch).CATPart, EL_04006 (Screen).CATPart, EL_04007(Flat Bracket).CATPart]
2024-01-26 TSAL V2.0
    Push de la TSAL V2.0
    [LS_R976-NR-1.stp, SCS_converting.kicad_pcb, SCS_converting.kicad_sch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]
2024-01-27 chapes las avant haut
    [Chape_Fw_Ua_Fp_Low.CATPart, Chape_Fw_Ua_Fp_Up.CATPart, Supension chape assembly.CATProduct, Suspension.CATProduct]
2024-01-27 Chapes avant haut suite
    [Chape_Fw_Ua_Fp_Low.CATPart, Chape_Fw_Ua_Fp_Up.CATPart, Chape_Fw_Ua_Rp_Up.CATPart, Fr_A0100 (Frame).CATProduct, SU_A0100 (Front Upper A-Arm).CATProduct, Supension chape assembly.CATProduct, Suspension.CATProduct]
2024-01-27 chapes avant bas
    [Chape_Fw_La_Fp_Low.CATPart, Chape_Fw_La_Fp_Up.CATPart, Chape_Fw_Ua_Rp_Low.CATPart, Chape_Fw_Ua_Rp_Up.CATPart, Filaire.CATPart, SU_02001 (Front_Lower_A_Arm_Front_Rod).CATPart, SU_02002 (Front_Lower_A_Arm_Rear_Rod).CATPart, SU_02003 (Front Lower Rod-End Support).CATPart]
2024-01-29 chapes arrière haut
    [Chape_Fw_La_Rp_Low.CATPart, Chape_Fw_La_Rp_Up.CATPart, Chape_Rw_Ua_Fp_Low.CATPart, Chape_Rw_Ua_Fp_Up.CATPart, Chape_Rw_Ua_Rp_Up.CATPart, SU_03001 (Rear_Upper_A_Arm_Front_Rod).CATPart, SU_03002 (Rear_Upper_A_Arm_Rear_Rod).CATPart, SU_03003 (Rear Upper Rod-End Support).CATPart]
2024-01-29 chapes arrière haut 2
    [Chape_Rw_Ua_Fp_Low.CATPart, Chape_Rw_Ua_Rp_Low.CATPart, Chape_Rw_Ua_Rp_Up.CATPart, Supension chape assembly.CATProduct, Suspension.CATProduct]
2024-01-30 TSAL Patché
    [TSAL.kicad_pcb, TSAL.kicad_sch]
2024-01-30 Toujours plus de TSALLL
    [TSAL.kicad_sch]
2024-02-01 ESSAI CHAPE RADIATEUR
    [15x1.5.CATProduct, 25x1.5.CATProduct, 28x1.5.CATProduct, 30x2.CATProduct, 51.CATPart, 52.CATPart, 61.CATPart, 62.CATPart]
2024-02-02 Chape radiateur et angle
    [28x1.5.CATProduct, EN_02001 (Radiator).CATPart, EN_02004 (Coolant Lines).CATPart, EN_A0200(Cooling System).CATProduct, Fr_A0100 (Frame).CATProduct, Produit6.CATProduct, Radiator.CATProduct, Ref_droite.CATPart]
2024-02-03 Changement chape radiateur et catchcan
    [Chape2_radia.CATPart, Chape3_radia.CATPart, Chape_catchcan.CATPart, EN_A0200(Cooling System).CATProduct, EN_A0300 (Catch Can).CATProduct, Filaire.CATPart, Radiator.CATProduct, Ref_droite.CATPart]
2024-02-04 Maquettage TS Box + Bamocar (1/?)
    Déplacement de TS Box vers EL_A2000
    Maquettage des boulons cylindrique
    Début du maquettage des fixations
    [01155010_A-155-SIL.CATProduct, 16mm2-5.CATPart, 212 OT_1002699_3DSYM.CATPart, 212 UT_1002700_3DSYM.CATPart, 25mm2-10.CATPart, A155_OT_3Dsym.CATPart, A155_UT_3Dsym.CATPart, Boitier.CATPart]
2024-02-04 correction triangle arrière bas
    [ASKUBAL_G_6_D0_0.CATProduct, Bolted_assembly.CATProduct, Chape_Fw_La_Fp_Low.CATPart, Chape_Fw_La_Fp_Up.CATPart, Chape_Fw_La_Rp_Low.CATPart, Chape_Fw_La_Rp_Up.CATPart, Chape_Fw_Ua_Fp_Low.CATPart, Chape_Fw_Ua_Fp_Up.CATPart]
2024-02-05 Maquettage TS Box + Bamocar (2/?)
    Insertion de l'ensemble TS Box + Inverter dans la structure tub
    Ajout des équipements latéraux et en L, contraintes avec l'écrou cylindriques et la vis
    Début de maquettage de la chape supérieure
    [EL_2000 (Inverter).CATPart, EL_2002 (Boulons cylindriques).CATPart, EL_2003 (Side Mounts).CATPart, EL_2004 (Brackets).CATPart, EL_2005 (L Mounts).CATPart, EL_A2000 (TSBox + Inverter).CATProduct, EN_20000 (TS Box Envelope Volume).CATPart, Suspension.CATProduct]
2024-02-06 suppression du catch can
    [EN_02004 (Coolant Lines).CATPart, EN_A0200(Cooling System).CATProduct, Radiator.CATProduct]
2024-02-06 ajout parts vase d'expansion
    [EN_03001_(Overflow Bottle Body).CATPart, EN_03002_(Overflow cap).CATPart, EN_03003_(Fixation).CATPart, EN_A0200(Cooling System).CATProduct, EN_A0300 (Catch Can).CATProduct, EN_A0300 (Overflow bottle).CATProduct]
2024-02-06 triangle arrière bas
    [SU_04001 (Rear_Lower_A_Arm_Front_Rod).CATPart, SU_04002(Rear_Lower_A_Arm_Rear_Rod).CATPart, SU_04003 (Rear Lower Rod-End Support).CATPart, SU_A0400 (Rear Lower A-Arm NEW).CATProduct, SU_A0400 (Rear Lower A-Arm).CATProduct]
2024-02-06 Ajout de l'IA Assembly à la maquette
    [FRA0500 (IA Assembly).CATProduct, FR_05001 (Impact Attenuator).CATPart, FR_05002 (Anti-Intrusion Plate).CATPart]
2024-02-06 arrière bas fin
    [Chape_Fw_La_Rp_Up.CATPart, Chape_Rw_La_Rp_Low.CATPart, Chape_Rw_La_Rp_Up.CATPart, Supension chape assembly.CATProduct, Suspension.CATProduct]
2024-02-06 Auto stash before rebase of "origin/master"
    ajout chape pompe
    [Chape_pompe_haut.CATPart]
2024-02-06 Auto stash before rebase of "origin/master"
    ajouts chapes pompe
    [Chape_pompe_bas.CATPart, Chape_pompe_haut.CATPart]
2024-02-06 MEP harness locker
    [MS_03006.dxf]
2024-02-06 FIXATION BOUTEILLE
    [EN_03002_(Overflow cap).CATPart]
2024-02-06 Catchcan encore
    [EN_03003_(Fixation).CATPart]
2024-02-06 Maquettage TS Box + Bamocar (3/?)
    [EL_2004 (Brackets).CATPart, EL_A2000 (TSBox + Inverter).CATProduct]
2024-02-06 Montage roue avant (non terminé)
    [Front Left Wheel Assy.CATProduct, Front_wheel_left_assembly.CATProduct, Rear Left Wheel Assy.CATProduct, SU_A0100 (Front Upper A-Arm).CATProduct, Suspension.CATProduct, Visserie.CATProduct, WT_03003 (Rear Bearing Washer).CATPart, WT_A0000.CATProduct]
2024-02-06 Revert "FIXATION BOUTEILLE"
    This reverts commit 9667b1d824ae86b4966a51f00c21101c24ec9353.
    [EN_03002_(Overflow cap).CATPart]
2024-02-06 Revert "Catchcan encore"
    This reverts commit 3cf1a55967e530ad997061de7f48bf6f5453a595.
    [EN_03003_(Fixation).CATPart]
2024-02-06 Chapes position moteur
    [25x2.CATProduct, Bamocar.CATPart, Chape1_radia.CATPart, Chape2_radia.CATPart, Chape3_radia.CATPart, Chape_L.CATPart, Chape_L2b.CATPart, Chape_catchcan.CATPart]
2024-02-06 Maquettage TS Box + Bamocar (4/?)
    [EN_02004 (Coolant Lines).CATPart, EN_A0200(Cooling System).CATProduct, EN_Engine_Drivetrain.CATProduct]
2024-02-06 Maquettage TS Box + Bamocar (5/?)
    [EL_2004 (Brackets).CATPart, EL_2005 (L Mounts).CATPart, EL_A2000 (TSBox + Inverter).CATProduct, EN_20000 (TS Box Envelope Volume).CATPart, EN_2006 (Tubes).CATPart, Fr_A0100 (Frame).CATProduct]
2024-02-07 TS Box + Inverter (6/?)
    [25x2.CATProduct, 3d2-fb-rahmen34 01.CATPart, 3d2-led-7seg 01.CATPart, 3d2-pg-metr-25.CATPart, 4x16.CATPart, Binder_09-0463-90-19.CATPart, Binder_09-0464-90-19.CATPart, Block 01.CATPart]
2024-02-07 TS Box + Bamocar encore
    [EL_2000 (Inverter).CATPart, EN_20000 (TS Box Envelope Volume).CATPart]
2024-02-07 Fixations radiateurs
    [Chape3_radia.CATPart, EN_02004 (Coolant Lines).CATPart, EN_A0200(Cooling System).CATProduct, Filaire.CATPart, Fr_A0100 (Frame).CATProduct, Radiator.CATProduct, Ref_droite.CATPart]
2024-02-07 Un peu plus d'élec
    [RFN1VWM2STFTR.stp, TSAL.csv, TSAL.kicad_pcb, TSAL.kicad_sch]
2024-02-07 2-3 modifs de chapes et nomenclature
    [Chape_pompe_bas.CATPart, Chape_pompe_haut.CATPart, MS_01006 (Rear bracket).CATPart, MS_01007 (Front bracket).CATPart]
2024-02-07 TS Box + Bamocar (7/?)
    [EL_09003 BAMOCAR_D3.CATProduct, EL_2004 (Brackets).CATPart, EL_A2000 (TSBox + Inverter).CATProduct, EN_20000 (TS Box Envelope Volume).CATPart, EN_2006 (Tubes).CATPart, EN_2007 (Low Bracket).CATPart, EN_2007 (Plate).CATPart, Filaire.CATPart]
2024-02-07 TS Box + Bamocar (8/?)
    [EL_2004 (Brackets).CATPart, EN_2006 (Tubes).CATPart, EN_2007 (Low Bracket).CATPart, EN_2007 (Plate).CATPart]
2024-02-07 Correction pédale d'accel (y'avait une version en trop)
    [FR_A0300 (throttle pedal).CATProduct]
2024-02-07 avancement chape catch can
    [Chape_catchcan.CATPart, EN_02004 (Coolant Lines).CATPart, EN_A0200(Cooling System).CATProduct, Filaire.CATPart, Fr_A0100 (Frame).CATProduct]
2024-02-07 CHAPE CATCHCAN
    [Chape_catchcan.CATPart, EN_02004 (Coolant Lines).CATPart, EN_02006_(Catch Can).CATPart, EN_A0200(Cooling System).CATProduct, Filaire.CATPart, Fr_A0100 (Frame).CATProduct]
2024-02-07 Chapes moteur
    [EN_Engine_Drivetrain.CATProduct]
2024-02-07 Vissage TSBox Chassis
    [15x1.5.CATProduct, 25x1.5.CATProduct, 28x1.5.CATProduct, 61.CATPart, 62.CATPart, EL_09003 BAMOCAR_D3.CATProduct, EL_2003 (Side Mounts).CATPart, EL_2004 (Brackets).CATPart]
2024-02-07 chape chaipe 1/...
    [Chape_pompe_bas.CATPart, Chape_pompe_bas2.CATPart, Chape_pompe_haut.CATPart, Chape_pompe_haut2.CATPart, Chape_vaseexpansion.CATPart, EN_02002 (Water Pump).CATPart, EN_02004 (Coolant Lines).CATPart, EN_02005_(Overflow Bottle Body).CATPart]
2024-02-07 throttle pedal
    ehuh
    [FR_03001 - Frame Throttle.CATProduct, FR_03001.1 - Plaque droite.CATPart, FR_03001.16 - Plaque arriere centrale.CATPart, FR_03001.2 - Plaque gauche.CATPart, FR_03001.3 - Plaque milieu droite.CATPart, FR_03001.4 - Plaque milieu gauche.CATPart, FR_03001.5 - Plaque superieure.CATPart]
2024-02-08 MEP rw ua
    [Chape_Rw_Ua_Fp_Low.dxf, Chape_Rw_Ua_Fp_Up.dxf, Chape_Rw_Ua_Rp_Low.dxf, Chape_Rw_Ua_Rp_Up.dxf]
2024-02-09 throttle pedal
    [FR_03001 - Frame Throttle.CATProduct, FR_03001.11 - Grand cylindre arriere doit.CATPart, FR_03001.12 - Grand cylindre arriere gauche.CATPart, FR_03001.14 - Plaque arriere droite.CATPart, FR_03001.15 - Plaque arriere gauche.CATPart, FR_03001.4 - Plaque milieu gauche.CATPart, FR_03001.5 - Plaque superieure.CATPart, FR_03001.6 - Positive mechanical stop bracket.CATPart]
2024-02-09 Maquettage TS Box + Bamocar (9/?)
    Mise à jour de la Plate (positionnement par rapport à la pare-feu)
    Changement d'équipements
    Corrections de la maquette du volume de la TS Box
    [EL_09003 BAMOCAR_D3.CATProduct, EL_20010 (Low Bracket 2).CATPart, EL_2009 (Low bracket 1).CATPart, EL_A2000 (TSBox + Inverter).CATProduct, EN_20000 (TS Box Envelope Volume).CATPart, EN_2007 (Plate).CATPart, Symmetry of EL_20010 (Low Bracket 2).CATPart, Symmetry of EL_2003 (Side Mounts).CATPart]
2024-02-10 gabarit batterie LV
    [EL_Electrical.CATProduct, EL_G03 (Gabarit).CATProduct, Plaque centrale.CATPart]
2024-02-11 meps SU arrière bas
    [Chape_Rw_La_Fp_Low.CATPart, Chape_Rw_La_Fp_Up.CATPart, Chape_Rw_La_Rp_Low.CATPart, Chape_Rw_La_Rp_Up.CATPart, Chape_Rw_la_Fp_Low.dxf, Chape_Rw_la_Fp_Up.dxf, Chape_Rw_la_Rp_Low.dxf, Supension chape assembly.CATProduct]
2024-02-11 Maquettage TS Box + Bamocar (10/?)
    Fixation du volume enveloppe de la TS Box
    Premières contraintes sur le schéma global
    Equipements inférieurs faits
    Plaque latérale faite
    Equipement supérieur en cours
    [EL_09003 BAMOCAR_D3.CATProduct, EL_2003 (Side Mount Right).CATPart, EL_2003 (Side Mounts).CATPart, EL_2004 (Brackets).CATPart, EL_2005 (L Mounts).CATPart, EL_2008 (Low Bracket rear).CATPart, EL_2009 (Low Bracket front).CATPart, EL_A2000 (TSBox + Inverter).CATProduct]
2024-02-11 Maquettage TS Box + Bamocar (11/?)
    Equipements latéraux faits (différenciation droite/gauche)
    Equipements supérieurs faits
    Pas de vis pour l'instant, mais toutes les positions relatives sont déclarés
    [3d2-pg-metr-25.CATPart, EL_09003 BAMOCAR_D3.CATProduct, EL_2004 (High Bracket).CATPart, EL_2008 (Low Bracket rear).CATPart, EL_2010 (Side Mouth Left).CATPart, EL_A2000 (TSBox + Inverter).CATProduct, EN_20000 (TS Box Envelope Volume).CATPart, EN_2007 (Plate).CATPart]
2024-02-11 Cooling System (1/?)
    Remise à zéro du système et ajout des nomenclatures correctes
    Maquettage des équipements du radiateur en cours
    [EN_02001 (Radiator).CATPart, EN_02011 (Tube Crossing).CATPart, EN_02011 (croisement tubes).CATPart, EN_A0200 (Cooling System).CATProduct, EN_A0200(Cooling System).CATProduct, EN_A0201 (Radiator Assy).CATProduct, EN_A02010 (Radiator).CATPart, EN_A02011 (Low Front Bracket).CATPart]
2024-02-11 faisceau 3/?
    Faisceau 1D -> 3D
    Produit Catia Harness
    [EL_Electrical.CATProduct, Filaire.CATPart, Fr_A0100 (Frame).CATProduct, Harness.CATProduct, Harness_points.CATPart, Harness_tube.CATPart, faisceau.CATPart, faisceau3.CATPart]
2024-02-12 fin la mache laser Las
    [Chape_RRocker_F.CATPart, Chape_RRocker_F.dxf, Chape_RRocker_R.CATPart, Chape_RRocker_R.dxf, Chape_Re_Damper_Down.CATPart, Chape_Re_Damper_Up.CATPart, Chape_Rw_Ua_Fp_Low.CATPart, Chape_Rw_Ua_Fp_Low.dxf]
2024-02-12 Cooling System (2/?)
    Découpage de deux équipements du radiateur.
    [EN_A0200 (Cooling System).CATProduct, EN_A0201 (Radiator Assy).CATProduct, EN_A02011 (Low Front Bracket).CATPart, EN_A02012 (High Front Bracket).CATPart]
2024-02-13 Cooling System (3/?)
    Ajout équipement haut pompe à eau
    [EN_02002 (Water Pump).CATPart, EN_02007 (Water Pump Top Equipment).CATPart, EN_02008 (Water Pump Bottom Equipment).CATPart, EN_A0200 (Cooling System).CATProduct, EN_A0201 (Radiator Assy).CATProduct]
2024-02-13 CHANGEMENT CHAPE POMPE
    [EN_02007 (Water Pump Top Equipment).CATPart, EN_02008 (Water Pump Bottom Equipment).CATPart, EN_A0200 (Cooling System).CATProduct]
2024-02-13 pompe chape
    ajout poche pour faire jolie piece
    [EN_02008 (Water Pump Bottom Equipment).CATPart]
2024-02-13 Cooling System (4/?)
    [EN_02002 (Water Pump).CATPart, EN_02007 (Water Pump Top Equipment).CATPart, EN_02008 (Water Pump Bottom Equipment).CATPart, EN_02009 (Overflow Bottle Equipment).CATPart, EN_02010 (Catch Can Equipment).CATPart, EN_A0200 (Cooling System).CATProduct, EN_A0201 (Radiator Assy).CATProduct, EN_A02011 (Low Front Bracket).CATPart]
2024-02-13 Auto stash before rebase of "origin/master"
    pedal
    [FR_03001 - Frame Throttle.CATProduct, FR_03001.3 - Plaque milieu droite.CATPart, FR_03001.4 - Plaque milieu gauche.CATPart, FR_03001.7 - Negative mechanical stop bracket.CATPart]
2024-02-13 BSPD v2
    [BSPD_v2.kicad_pcb, BSPD_v2.kicad_sch]
2024-02-13 faisceau 4/?
    Avancé sur le faisceau 3D
    [EL_Electrical.CATProduct, Filaire.CATPart, Fr_A0100 (Frame).CATProduct, Harness.CATProduct, Harness_points.CATPart, Harness_tube.CATPart, faisceau.CATPart, faisceau2.CATPart]
2024-02-13 Cooling System (5/?) ET TS Box + Bamocar (12/?)
    Fuuuusion
    "Fin" du maquettage TS Box + Bamocar (manquent les vis et les contraintes)
    Corrections sur la pompe à eau
    [EL_02010 (Intermediate High Mount).CATPart, EL_09003 BAMOCAR_D3.CATProduct, EL_2003 (Side Mount Right).CATPart, EL_2004 (High Bracket).CATPart, EL_2005 (L Mounts).CATPart, EL_2008 (Low Bracket rear).CATPart, EL_2009 (Low Bracket front).CATPart, EL_2010 (Side Mouth Left).CATPart]
2024-02-14 Cooling System (6/?)
    Fin du maquettage de l'assemblage radiateur : ajout de la barre de fixation arrière et des équipements
    [EN_02007 (Water Pump Top Equipment).CATPart, EN_02008 (Water Pump Bottom Equipment).CATPart, EN_02014 (Radiator Low Rear Bracket).CATPart, EN_02015 (Radiator Low Rear Bar).CATPart, EN_A0200 (Cooling System).CATProduct, EN_A0201 (Radiator Assy).CATProduct, EN_A02010 (Radiator).CATPart, EN_A02011 (Low Front Bracket).CATPart]
2024-02-14 Cooling System (7/?)
    Ajout de l'équipement de l'Overflow Bottle et des contraintes sur la maquette Cooling System
    [EN_02005_(Overflow Bottle Body).CATPart, EN_02016 (Overflow Bottle Equipment).CATPart, EN_A0200 (Cooling System).CATProduct]
2024-02-14 Gabarit batterie LV (2/2)
    [EL_Electrical.CATProduct, EL_G03 (Gabarit).CATProduct, Plaque centrale.CATPart, Plaque de positionnement.CATPart, Plaque liante.CATPart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]
2024-02-14 Cooling System (8/8)
    Ajout de deux positions d'équipements pour la Catch Can et contraintes sur la maquette
    Sauf changement dans le maquettage ou dans les chapes, il ne reste plus qu'à faire les tuyaux
    [EN_02006_(Catch Can).CATPart, EN_02017 (Catch Can Equipment 2).CATPart, EN_02017 (Catch Can Equipment).CATPart, EN_A0200 (Cooling System).CATProduct, EN_A0201 (Radiator Assy).CATProduct]
2024-02-14 Equipement TdB
    Ajout d'une chape au Product du TdB
    [EL_01001 (Dash Panel Support).CATPart, EL_01002 (Dash Panel Equipment).CATPart, EL_A01000 (Dash Panel).CATProduct, EL_Electrical.CATProduct]
2024-02-14 déplacement de fichiers
    [EL_G03 (Gabarit).CATProduct, Plaque centrale.CATPart, Plaque de positionnement.CATPart, Plaque liante.CATPart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]
2024-02-14 gabarit MS plate
    [Gabarit MS bis.CATProduct, attache arriere.CATPart, attache main hoop.CATPart, gabarit central.CATPart]
2024-02-14 Mise en plan EN_02016
    [EN_02016(Overflow Bottle Equipement).dxf]
2024-02-14 faisceau 5/?
    [EL_1101 (Brake light).CATPart, EL_A1100 (Brake Light).CATProduct, EL_A18001 (Enclosure support).CATPart, EL_A1900 (VCU Assy).CATProduct, EL_Electrical.CATProduct, Filaire.CATPart, Fr_A0100 (Frame).CATProduct, Harness.CATProduct]
2024-02-14 gabarit fuse box
    [EL_G16.CATProduct, Piece1.CATPart, Piece2.CATPart]
2024-02-14 BSPD fix
    [BSPD_v2.kicad_sch]
2024-02-14 Cooling System (9/9)
    En fait c'était pas fini
    Rectification des positions relatives
    Ajout des fixations de la protection radiateur
    [EN_02016 (Overflow Bottle Equipment).CATPart, EN_02017 (Catch Can Equipment).CATPart, EN_02018 (Radiator Protection Bottom Equipment).CATPart, EN_02018 (Radiator Protection Top Equipment).CATPart, EN_A0200 (Cooling System).CATProduct, EN_A0201 (Radiator Assy).CATProduct]
2024-02-14 Cooling System (10/10)
    C'était toujours pas fini
    Correction d'une poche
    [EN_02018 (Radiator Protection Bottom Equipment).CATPart, EN_02019 (Radiator Protection Bottom Equipment).CATPart, EN_A0200 (Cooling System).CATProduct]
2024-02-15 mep équipements pompe
    [EN_02007 (water pump top) mep.dxf]
2024-02-15 Pédale d'accel (n/n)
    [FR_03001 - Frame Throttle.CATProduct, FR_03001.16 - Plaque arriere centrale.CATPart, FR_03001.3 - Plaque milieu droite.CATPart, FR_03001.4 - Plaque milieu gauche.CATPart]
2024-02-15 MEP circuit de refroidissement sans la grille
    [EN_02008 (water pump bottom) mep.dxf, EN_02014(Radiator low rear bracket).dxf, EN_02015 radiator low rear bar.dxf, EN_02016 (Overflow Bottle Equipment).CATPart, EN_02017 (Catch Can Equipment).CATPart, EN_02017(Catch can equipment).dxf, EN_A02011 Low front bracket.dxf]
2024-02-15 Accumulator Equipment
    Version préliminaire des dimensions de fixation batterie
    [EL_21001 (Accumalor Front Equipment).CATPart, EL_21001 (Accumalor Front Equipment).stp, EL_A2100 (Accumulator Assy).CATProduct]
2024-02-15 Auto stash before rebase of "origin/master"
    création carte contole du relai de décharge
    [Carte controle du relai de décharge.kicad_pcb, Carte controle du relai de décharge.kicad_sch]
2024-02-15 TS Box + Bamocar encore
    Rectification position plaque
    Changement des autres positions relatives
    Ajout d'un maintien supplémentaire à l'arrière de la plaque
    [EL_02010 (Intermediate High Mount).CATPart, EL_09003 BAMOCAR_D3.CATProduct, EL_2004 (High Bracket).CATPart, EL_2005 (L Mounts).CATPart, EL_2008 (Low Bracket rear).CATPart, EL_2009 (Low Bracket front).CATPart, EL_A2000 (TSBox + Inverter).CATProduct, EN_20000 (TS Box Envelope Volume).CATPart]
2024-02-15 Mep pédalier
    [FR_03001 - Frame Throttle.CATProduct, FR_03001.4 - Plaque milieu gauche.CATPart, FR_03001_1.dxf, FR_03001_2.dxf, FR_03001_3.dxf, FR_03001_4.dxf, FR_03001_5.dxf]
2024-02-15 faisceau 5/6
    Faisceau 3D presque fini
    Manque les câbles vers les capteurs de vitesse & quelques ajustements
    [EL_A1100 (Brake Light).CATProduct, EL_A1500 (MS Plate).CATProduct, EL_Electrical.CATProduct, EL_masses.CATPart, Filaire.CATPart, Fuse_Box_Ass.CATProduct, Harness.CATProduct, Harness_points.CATPart]
2024-02-16 Ajout congés plaque TS Box + Bamocar
    [EL_09003 BAMOCAR_D3.CATProduct, EL_A2000 (TSBox + Inverter).CATProduct, EN_2007 (Plate).CATPart]
2024-02-16 fin mep circuit de refroidissement
    [EN_02018(top radiator protection equipment).dxf, EN_02019 (Radiator Protection Bottom Equipment).CATPart, EN_02019(radiator protection bottom equipment).dxf]
2024-02-16 mep chaipe TSBox
    [EL_02010 (Intermediate High Mount).CATPart, EL_2003(side mount right).dxf, EL_2004(high bracket).dxf, EL_2010(intermediate high mount).dxf, EN_20010(side mount left).dxf]
2024-02-16 MEPs Plate, Rear Bracket, L Mount
    [EL_20005 (L Mount).dxf, EL_20008 (Low Bracket Rear).dxf, EN_20007 (Plate).dxf]
2024-02-16 MEPs Front Bracket
    [EL_20009 (Low Bracket Front).dxf]
2024-02-16 Nouvelle Carte controle
    Nouvelle Carte controle sorti de Relai et SC
    [Carte controle du relai de décharge.kicad_pcb, Carte controle du relai de décharge.kicad_sch]
2024-02-17 Contraintes sur le TdB dans EL_Electrical
    [EL_01001 (Dash Panel Support).CATPart, EL_01002 (Dash Panel Equipment).CATPart, EL_A01000 (Dash Panel).CATProduct, EL_Electrical.CATProduct]
2024-02-17 Chapes tableau de bord
    [EL_01001 (Dash Panel Support).CATPart, EL_01002 (Dash Panel Equipment).CATPart, EL_01003 (Dash Panel Mid Bracket).CATPart, EL_A01000 (Dash Panel).CATProduct, EL_Electrical.CATProduct, Symmetry of EL_01002 (Dash Panel Equipment).CATPart]
2024-02-17 Dernières MEPS
    MEP Radiator Protection Top Equipment
    MEPs Dash Panel
    [EL_01002 (Dash Panel Equipment).dxf, EL_01003 (Dash Panel Mid Bracket).dxf, EN_02018 (Radiator Protection Top Equipment).dxf]
2024-02-18 Correction d'une erreur de nomenclature
    EN_02010 -> EN_20011
    [EL_02010 (Intermediate High Mount).CATPart, EL_09003 BAMOCAR_D3.CATProduct, EL_20011 (Intermediate High Mount).CATPart, EL_A2000 (TSBox + Inverter).CATProduct, Symmetry of EL_02010 (Intermediate High Mount).CATPart, Symmetry of EL_20111 (Intermediate High Mount).CATPart]
2024-02-18 MEP Chaipe (1/?)
    [EL_01002 (Dash Panel Equipment).dxf, EL_01003 (Dash Panel Mid Bracket).dxf, EL_08002 (Chape TSAL).CATPart, EL_08002.dxf, EL_20003(side mount right).dxf, EL_20004(high bracket).dxf, EL_20010(intermediate high mount).dxf, EL_buzz.dxf]
2024-02-18 MEPs tôles pliées
    Il aurait fallu utiliser le mode tôle ahah
    [EL_20005 (L Mount).dxf, EL_20005-1 (L Mount Unfolded).CATPart, EL_20007 (Plate).dxf, EL_20010(side mount left).dxf, EN_20007 - 1 (Plate Unfolded).CATPart, EN_20010(side mount left).dxf]
2024-02-18 MEP Chaipe (3/3)
    [EL_20008 (Low Bracket Rear).dxf, EN_02007 (water pump top) mep.dxf, EN_02008 (water pump bottom) mep.dxf, EN_02011 Low front bracket.dxf, EN_02012 (high front bracket) mep.dxf, EN_02014(Radiator low rear bracket).dxf, EN_02016(Overflow Bottle Equipement).dxf, EN_02017(Catch can equipment).dxf]
2024-02-18 MEP Chaipe (4/5)
    J'ai fait une boulette
    [EL_20008 (Low Bracket Rear).dxf, EN_02007 (water pump top) mep.dxf, EN_02008 (water pump bottom) mep.dxf, EN_02011 Low front bracket.dxf, EN_02012 (high front bracket) mep.dxf, EN_02014(Radiator low rear bracket).dxf, EN_02016(Overflow Bottle Equipement).dxf, EN_02017(Catch can equipment).dxf]
2024-02-18 MEP Radiator Low Rear Bar
    [EN_02015 (Radiator Low Rear Bar).CATPart, EN_02015 (Radiator Low Rear Bar).dxf, EN_02015 radiator low rear bar.dxf, EN_02015-1 (Radiator Low Rear Bar Unfolded).CATPart]
2024-02-18 Suppression de deux chapes qui avaient rien à faire là
    [EL_20010 (Low Bracket 2).CATPart, EL_2009 (Low bracket 1).CATPart]
2024-02-18 Auto stash before rebase of "origin/master"
    cellule arrière pour soudure
    [Cellulearrière.dxf]
2024-02-18 MEP Chaipe (5/5)
    [EL_20010(side mount left).dxf, EL_20011(intermediate high mount).dxf]
2024-02-18 MEP Chaipe (fin pour de vrai)
    toutes les cases du sheets sont cochées, amen
    [EL_20005 (L Mount).dxf, EL_20007 (Plate).dxf]
2024-02-18 MEP pédale d'accel (n/n)
    La pédale de frein ce sera pour demain
    [EL_03002.dxf, EL_20005 (L Mount).dxf, EL_20007 (Plate).dxf, EN_02015 (Radiator Low Rear Bar).dxf, FR_03001 - Frame Throttle.CATProduct, FR_03001_14.dxf, FR_03001_16.dxf, FR_03001_6.dxf]
2024-02-19 MEP LAS et résolution pb pédale accel
    [Chape_RRocker_F.dxf, Chape_RRocker_R.dxf, Chape_Rw_Ua_Fp_Low.dxf, Chape_Rw_Ua_Fp_Up.dxf, Chape_Rw_Ua_Rp_Low.dxf, Chape_Rw_Ua_Rp_Up.dxf, Chape_Rw_la_Fp_Low.dxf, Chape_Rw_la_Fp_Up.dxf]
2024-02-19 Brake pedal (1/?)
    [FR_A0400 (Brake Pedal).CATProduct]
2024-02-20 4 eme wave
    chappes
    [MS_01006 (Bracket seat rear).dxf, MS_01007_1 (Right Seat Bracket).dxf, MS_01007_2 (Left Seat Bracket).dxf, MS_02001(Support).dxf, MS_02002_1 (Right Up Bracket Head Restraint).dxf, MS_02002_2 (Left Up Bracket Head Restraint).dxf]
2024-02-20 publication pour préparer les coolant lines
    [EN_02006_(Catch Can).CATPart, EN_A0201 (Radiator Assy).CATProduct]
2024-02-20 changement de nom
    [EN_02005_(Overflow Bottle Body).CATPart, EN_02006_(Catch Can).CATPart, EN_A0200 (Cooling System).CATProduct, Fr_A0100 (Frame).CATProduct, Piece1.CATPart, Piece2.CATPart, Piece3.CATPart, Piece4.CATPart]
2024-02-20 qqs mep supplémentaires
    [FR_04008 (Front Fixing Rail Wedge).CATPart, FR_04008 (Front Fixing Rail Wedge).dxf, Repose talon.dxf, repose-talon.CATPart]
2024-02-20 gabarits throtle
    [E_accel_arr.CATPart, E_acel_av.CATPart, Gabarit_accel.CATProduct, accel_inter.CATPart]
2024-02-20 modif boulon tsbox
    [EL_2002 (Boulons cylindriques).CATPart]
2024-02-20 mep boisard
    [Driveshaft left.dxf, Driveshaft right.dxf, ST_06002 (Steering Bore).dxf, SU_06003 (ball joint spacer).dxf, SU_06004 (ball joint spacer 6mm).dxf]
2024-02-20 en fait, ça y est, tout est publié!
    [EN_02004 (Coolant Lines).2.CATPart, EN_02005_(Overflow Bottle Body).CATPart, EN_02006_(Catch Can).CATPart, EN_02011 (Tube Crossing).CATPart, EN_A0200 (Cooling System).CATProduct, EN_A0201 (Radiator Assy).CATProduct, EN_A02010 (Radiator).CATPart, Piece1.CATPart]
2024-02-20 Revert "sup"
    This reverts commit d6394036cc10f3c4bfb50a2abadedd2a2d64aeca.
    [SU_06003 (ball joint spacer).dxf]
2024-02-20 Revert "supression"
    This reverts commit e0f8bf45bd358383f25dc1114bb4be3f4064e1c5.
    [Driveshaft left.dxf, Driveshaft right.dxf, ST_06002 (Steering Bore).dxf]
2024-02-20 Mep brake et dernières las et chaipe
    [FR_04001_1.dxf, FR_04001_10.dxf, FR_04001_11.dxf, FR_04001_2.dxf, FR_04001_3.dxf, FR_04001_4.dxf, FR_04001_5.dxf, FR_04001_6.dxf]
2024-02-20 FIN DES MEPS
    enfin il reste la pare-feu, mais tout est envoyé à La Mâche !!
    [EN_02020.CATPart, EN_02020.dxf, FR_04006.dxf, FR_05002.dxf]
2024-02-21 Pédalier dans FR
    [FR_03001 - Frame Throttle.CATProduct, FR_03001.4 - Plaque milieu gauche.CATPart, FR_A0300 - Throttle pedal.CATProduct, FR_A034 (Pedal Assy).CATProduct, FR_A0400 (Brake Pedal).CATProduct, FR_frame_and_body.CATProduct, Filaire.CATPart, IS0_10511_M4_STEEL_PREVAILING_TORQUE_TYPE_HEXAGON_THIN_NUT.CATPart]
2024-02-21 Modif carte controle relai décharge
    mis a jour des pinns et de l'alimentation.
    [Carte controle du relai de décharge.kicad_sch]
2024-02-21 mauvais assembly
    [Suspension.CATProduct]
2024-02-21 assemblage roue avant
    [Front_wheel_left_assembly.CATProduct]
2024-02-21 création pcb carte controle relai décharge
2024-02-21 modif assy roue avant
    [Front Left Wheel Assy.CATProduct, Front_wheel_left_assembly.CATProduct, PSMF_081206_A51.catpart, SU_06001 (Front Rocker).CATPart, SU_06002 (pivot joint spacer).CATPart, SU_06004 (Ohlins ball joint spacer M8 20mm).CATPart, SU_06005 (spacer BAR).CATPart, SU_06006(M6 7mm).CATPart]
2024-02-21 MEP Gabarit MS Plate
    [MEP Attache arriere MSPlate.dxf, MEP Attache avant MSPlate.dxf, MEP Gabarit central MSPlate.dxf]
2024-02-21 MEP gabarits MS Plate
    [MEP Attache arriere MSPlate.dxf, MEP Attache avant MSPlate.dxf, MEP Gabarit central MSPlate.dxf]
2024-02-21 MEP Gabarit Battery LV
    [MEP Plaque Centrale.dxf, MEP Plaque de positionnement.dxf, MEP Plaque liante.dxf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]
2024-02-21 Gabarit fuse box ass
    [EL_G16.CATProduct, Piece1.CATPart, Piece3.CATPart]
2024-02-21 MEP Gabarits Fuse box
    [Attache avant.CATPart, Attache basse.CATPart, MEP Attache basse FuseBox.dxf, MEP Plaque centrale FuseBox.dxf, MEP attache avant FuseBox.dxf, Plaque centrale.CATPart]
2024-02-21 modif assy roue avant /2
    [Produit3.CATProduct, SU_10001 (Front Left Upright).CATPart, SU_10001_V2 (Front Left Upright).CATPart, SU_10002 (Upper Arm Bracket).CATPart, SU_10003 (track bracket).CATPart, SU_10005_v2 (track bracket).CATPart, SU_11003 (Camber shim 2mm).CATPart, SU_11004 (Camber shim 1mm).CATPart]
2024-02-21 Bspd update
    [BSPD_v2.kicad_pcb]
2024-02-28 Cartes Artemiz
    Reset et VCU Bis + qlq modifs Catia
    [AMS_IMD_Reset.kicad_sch, Banana Cap.CATPart, Banana Cap.stl, EL_03001 (LV Battery TYVA).CATPart, EL_06008.CATPart, EL_06009.CATPart, EL_06010 (HVD Assembly).CATProduct, EL_06010(HVD)(volume enveloppe).CATPart]
2024-03-01 Reset + EPSA_lib
    [AMS_IMD_Reset.kicad_pcb, AMS_IMD_Reset.kicad_sch, VCU_Bis.kicad_sch]
2024-03-01 Cartes LEDs volant + SCS Maker
    Ajout de doc Phelma pour les PCBs
    [Carte LED.kicad_pcb, Carte LED.kicad_sch, SCS Maker.kicad_pcb, SCS Maker.kicad_sch]
2024-03-01 assemblage SU_A13
    [ASKUBAL_KA_6_D0_0.catproduct, ASKUBAL_KA_6_D0_0_direction1.catproduct, ASKUBAL_KA_6_D0_0_direction2.catproduct, SU_13001 (Rear Suspension Rod).CATPart, SU_13002 (tapped insert right).CATPart, SU_13003 (tapped insert left).CATPart, SU_A1300.CATProduct, WireframeDefinition.CATProduct]
2024-03-01 BSPD V3 w/ sim
    [BSPD_v2_timertest.kicad_sch, bspdv3.kicad_pcb, bspdv3.kicad_sch, bspdv3simuworking.kicad_sch]
2024-03-02 Corrections mineures
    [AMS_IMD_Reset.kicad_sch, Discharge Controller.kicad_sch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]
2024-03-03 Encore qlq corrections
    [AMS_IMD_Reset.kicad_sch, BSPD.kicad_sch, Discharge Controller.kicad_sch, SCS LEDs.kicad_sch, SCS Maker.kicad_sch, VCU_Bis.kicad_sch]
2024-03-04 R rocker
    [Bolted_assembly1.CATProduct, M8 bolted assembly 2.CATProduct, SU_08001 (Rear Rocker).CATPart, SU_08001_int (Rear Rocker).CATPart, SU_A0800.CATProduct, Symmetry of SU_08001.CATPart]
2024-03-04 susp arrière
    [Chape_Fw_Ua_Fp_Low.CATPart, Chape_Fw_Ua_Fp_Up.CATPart, Chape_Fw_Ua_Rp_Up.CATPart, M8 bolted assembly 2.CATProduct, Rear shock absorber wireframe.CATPart, SU_A0100 (Front Upper A-Arm).CATProduct, SU_A0800.CATProduct, SU_A0900 (Rear shock absorber Assembly).CATProduct]
2024-03-04 modif boulons cylindriques
    [EL_2002 (Boulons cylindriques).CATPart, EL_2002 (Boulons cylindriques)_1.CATPart, EL_A2000 (TSBox + Inverter).CATProduct]
2024-03-05 Ajout tsbox
    Dossier tsbox_v1 avec tout pour la tsbox (je crois)
    [Cable_TS.CATPart, Diffuseur thermique.CATPart, EN_02007 (water pump top) mep.dxf, Grande barre de cuivre.CATPart, Moyenne barre de cuivre.CATPart, Passe cable.CATPart, Petite barre de cuivre.CATPart, Relais.CATPart]
2024-03-05 plus de chapes
    [Chape_U.CATPart, EN_Engine_Drivetrain.CATProduct, chapes.CATProduct]
2024-03-05 Maquettage TSAC (1/?)
    [EL_21000 (Filaire).CATPart, EL_21001 (Accumalor Front Equipment).CATPart, EL_21002 (Low Front Bracket).CATPart, EL_21003 (Low Rear Bracket).CATPart, EL_A2100 (Accumulator Assy).CATProduct]
2024-03-05 support TSbox
    [SupportTS.catpart]
2024-03-05 Gabarit Brake Pedal
    [FR_03001 - Frame Throttle.CATProduct, FR_03001.4 - Plaque milieu gauche.CATPart, FR_A0300 - Throttle pedal.CATProduct, FR_A034 (Pedal Assy).CATProduct, FR_A0400 (Brake Pedal).CATProduct, FR_frame_and_body.CATProduct, IS0_10511_M6_STEEL_PREVAILING_TORQUE_TYPE_HEXAGON_THIN_NUT.CATPart, ISO_4016_M6x30_STEEL_GRADE_C_HEXAGON_HEAD_BOLT_New_49.CATPart]
2024-03-05 Protection radiateur
    [EN_02016 (Overflow Bottle Equipment).CATPart, EN_02018 (Radiator Protection Top Equipment).CATPart, EN_02019 (Radiator Protection Bottom Equipment).CATPart, EN_02021 (protection radiateur).CATPart, EN_A0200 (Cooling System).CATProduct]
2024-03-06 Librairie Kicad+ DSB Controller
    [Screen Control.kicad_pcb, Screen Control.kicad_sch]
2024-03-06 modifs gabarits
    [Attache avant.CATPart, Attache basse.CATPart, E_accel_arr.CATPart, E_acel_av.CATPart, Plaque centrale.CATPart, accel_inter.CATPart, attache arriere.CATPart, attache main hoop.CATPart]
2024-03-06 Tie Rod
    [ASKUBAL_G_6_D0_0.catproduct, ASKUBAL_G_6_D0_0_rear_tie_rod.catproduct, Chape_Fw_Ua_Rp_Up.CATPart, SU_01004 (Inner Bearing Support).CATPart, SU_05001 (Tie rod).CATPart, SU_05002 (Inner insert sup ).CATPart, SU_05003 (cale) .CATPart, SU_05004 (Inner insert middle).CATPart]
2024-03-06 amortisseur arrière
    [Front shock absorber wireframe.CATPart, Gabarit_BAR.CATPart, Gabarit_protection.CATPart, Gabarit_protection.dxf, Gabarit_protection_bis.CATPart, Gabarit_protection_bis.dxf, Gabarit_rack.CATPart, Gabarit_steer.dxf]
2024-03-06 small fix BSPD
    [bspdv3.kicad_sch]
2024-03-06 BSPD add alim and capa
    [bspdv3.kicad_sch, bspdv3simuworking.kicad_sch]
2024-03-06 BSPD pull down R, V0.1PCB
    [bspdv3.kicad_pcb]
2024-03-08 AMD+Reset PCB
    [AMS_IMD_Reset.kicad_pcb]
2024-03-12 Maquettage TSAC (2/?)
    [EL_21000 (Filaire).CATPart, EL_21002 (Low Front Bracket).CATPart, EL_A2100 (Accumulator Assy).CATProduct]
2024-03-12 modif TSbox
    [Resistance.CATPart, tsbox_encore.CATPart, tsbox_encore2.CATProduct]
2024-03-12 Chape Mgit
    [Chape_Mgit.CATPart, Chape_U.CATPart, EN_Engine_Drivetrain.CATProduct, chapes.CATProduct]
2024-03-12 Modifs TSbox
    [Petite_plaqueTS.CATPart, SupportTS.catpart]
2024-03-12 gabarits avant bas et susp avant
    [GSU_tr_av_bas_E_1.dxf, GSU_tr_av_bas_L.dxf, GSU_tr_av_bas_cale.dxf, GSU_tr_av_bas_p.dxf, GSU_tr_av_goupille.dxf, MEP_basculeur_corp.dxf, MEP_basculeur_corp2.2.dxf, MEP_basculeur_corp2.dxf]
2024-03-12 encore modifs TSbox
    [tsbox_encore.CATPart, tsbox_encore2.CATProduct]
2024-03-12 gabarits catch can
    [EN_02004 (Coolant Lines).2.CATPart, EN_02016 (Overflow Bottle Equipment).CATPart, EN_02017 (Catch Can Equipment).CATPart, EN_02017_gabarit_1.CATPart, EN_02017_gabarit_2.CATPart, EN_A0200 (Cooling System).CATProduct, EN_A0201 (Radiator Assy).CATProduct]
2024-03-12 Chapes M
    [chapes.CATProduct]
2024-03-12 chapes et placement
    [Chape_Mgit.CATPart, Chape_U.CATPart]
2024-03-13 Retours PJR + Refonte librairie Kicad
    [AMS_IMD_Reset.kicad_pcb, AMS_IMD_Reset.kicad_sch, SCS Maker.kicad_sch]
2024-03-13 Câblage TSbox + modifs
    [Resistance.CATPart, tsbox_encore.CATPart, tsbox_encore2.CATProduct]
2024-03-13 PCB SCS Maker
    [SCS Maker.kicad_pcb]
2024-03-13 BSPD PCB v0.2
    [bspdv3.kicad_pcb]
2024-03-13 Assembly front left upright 1/?
    [SU_A1000 (Front Left Upright).CATProduct]
2024-03-13 PCB SCS LEDs
    [SCS LEDs.kicad_pcb]
2024-03-13 Gabarit EN_02014
    [EN_02004 (Coolant Lines).2.CATPart, EN_02014 (Radiator Low Rear Bracket).CATPart, EN_02014_gabarit.CATPart, EN_02014_gabarit_piece.CATPart, EN_02015 (Radiator Low Rear Bar).CATPart, EN_A0200 (Cooling System).CATProduct, EN_A0201 (Radiator Assy).CATProduct, EN_A02011 (Low Front Bracket).CATPart]
2024-03-13 Maquettage TSAC (3/?)
    Equipements inférieurs.
    Plaque de maintient.
    Première itération du volume TSAC
    [DesignTable1.xls, EL_21000 (Filaire).CATPart, EL_21001 (TSAC).CATPart, EL_21002 (Low Front Bracket).CATPart, EL_21002 (Low Green Bracket).CATPart, EL_21003 (Plate).CATPart, EL_A2100 (Accumulator Assy).CATProduct, Symmetry of EL_21002 (Low Green Bracket).CATPart]
2024-03-14 Maquettage TSAC (4/?)
    Boîtier du TSAC, éléments latéraux
    [EL_21000 (Filaire).CATPart, EL_21001 (TSAC).CATPart, EL_21003 (Plate).CATPart, EL_21004 (Low Pink Braket).CATPart, EL_21005-a (Square Rail).CATPart, EL_A2100 (Accumulator Assy).CATProduct, Symmetry of EL_21004 (Low Pink Braket).CATPart]
2024-03-15 Maquettage TSAC (5/?)
    Fin des fixations latérales v1.
    Ajout du .stp du SE3D.
    Complétion (très lacunaire) du SES pour la partie TSAC.
    [EL_21000 (Filaire).CATPart, EL_21000-b (Filaire 2).CATPart, EL_21001 (TSAC).CATPart, EL_21002 (Low Green Bracket).CATPart, EL_21003 (Plate).CATPart, EL_21004 (Low Pink Braket).CATPart, EL_21005 (High Rear Purple Bracket).CATPart, EL_21005-a (Square Rail).CATPart]
2024-03-16 qqs gabarits & corrections
    [EL_15002 (TSMP).CATProduct, EL_15003 (Master Switch).CATProduct, EL_A0300 (LV Battery).CATProduct, EL_A1100 (Brake Light).CATProduct, EL_A1200(Inertia Switch).CATProduct, EL_A1500 (MS Plate).CATProduct, EL_A1700 (Shutdown Buttons).CATProduct, EL_A1900 (VCU Assy).CATProduct]
2024-03-17 Encore qqs gabarits
    [Attache avant.CATPart, Plaque centrale.CATPart]
2024-03-18 Documents SES
    [Calculs SES chapes batterie.xlsx]
2024-03-18 Prérequis formation MécaMaster
    Ajout de l'exemple des trois barres
    Ajout de la documentation à lire
    [Barre 1.CATPart, Barre 2.CATPart, Barre 3.CATPart, Ensemble_3_barres.CATProduct, Filaire.CATPart]
2024-03-19 Mises en plans
    [EL_2002 (Boulons cylindriques).CATPart]
2024-03-20 update trous tsbox
    [tsbox_encore.CATPart, tsbox_encore2.CATProduct]
2024-03-20 gabarit tsbox EL_G2008
    [EL_20011 (Intermediate High Mount).CATPart, EL_A2000 (TSBox + Inverter).CATProduct, EL_G2008.CATProduct, piece 2.CATPart, plaque_chape.CATPart, plaque_sur_chape.CATPart, plaque_sur_chape2.CATPart, plaque_tubze.CATPart]
2024-03-20 gabarit tsbox
    [plaque_tube.dxf]
2024-03-20 Gabarit Pompe
    [AMS_IMD_Reset.kicad_sch, EN_02017_gabarit_1.CATPart, EN_02017_gabarit_2.CATPart]
2024-03-20 Auto stash before rebase of "master" onto "origin/master"
    [EN_02017_gabarit_1.CATPart, Gabarit1.dxf, GabaritPompe2_Calque_1.dxf]
2024-03-20 Gabarit chape radiateur 1
    [EN_G02014_gabarit.CATProduct, EN_G02014_gabarit_p.CATPart]
2024-03-20 gabarit pompe part 1
    [EN_G02008g.CATPart]
2024-03-20 Maquettage batterie + formation MécaMaster
    [Barre 1.CATPart, Barre 2.CATPart, Barre 3.CATPart, DesignTable1.xls, EL_21000 (Filaire).CATPart, EL_21000-b (Filaire 2).CATPart, EL_21001 (Accumalor Front Equipment).CATPart, EL_21001 (Accumalor Front Equipment).stp]
2024-03-21 Kicadlib + Modifs cartes
    [AIR Controller.kicad_pcb, AIR Controller.kicad_sch, AMS_IMD_Reset.kicad_sch, BSPD.kicad_pcb, BSPD.kicad_sch, CP1-12V.stp, Carte LED.kicad_pcb, Discharge Controller.kicad_pcb]
2024-03-22 Nouvelles chapes push clips
    Deux chapes mal placées à corriger
    [51.CATPart, 52.CATPart, 61.CATPart, 62.CATPart, 6x25.CATPart, FR_02001 (Nose).CATPart, FR_02002 (Side plates).CATPart, FR_02003 (Chape push clips).CATPart]
2024-03-24 Version Artemiz voltage indicator
    [EC7BW18-72S12.stp, Indicator_voltage.kicad_pcb, Indicator_voltage.kicad_sch]
2024-03-24 Maj vues 3D KIcad
    [Indicator_voltage.kicad_pcb]
2024-03-24 Update Gitignore et depollution de fichier
2024-03-25 Revert "Delete kicad_prl"
    This reverts commit 9fe5be2906406c3c64afc6048a7ffd3d023d0e3c.
    [Indicator_voltage.kicad_pcb, Indicator_voltage.kicad_sch]
2024-03-25 Création mainfuse et modif gitignore bastie
    [FullFuse.CATProduct, Fuse.CATPart, FuseSupport.CATPart, Symmetry of Support1.CATPart]
2024-03-26 changement nom et emplacement gabarit catch_can
    [Gabarit1.dxf, GabaritPompe2_Calque_1.dxf]
2024-03-26 légère modif ts box
    [tsbox_encore.CATPart, tsbox_encore2.CATProduct]
2024-03-26 placement moteur
    [Chape_L2b.CATPart, EN_Engine_Drivetrain.CATProduct, chapes.CATProduct]
2024-03-26 gabarit pour protection radiateur
    [EN_G2019.CATPart, protection_radiateur.dxf]
2024-03-26 Maquettage TSAC (6/?)
    [EL_21001 (TSAC Volume).CATPart, EL_A2100-b (Accumulator Assy Version b).CATProduct, EL_A21000 (Filaire).CATPart, Module.CATPart, Symmetry of EL_21002 (Low Green Bracket).stl]
2024-03-27 modif gabarit pedale d'accel +mep
    [E_accel_arr.CATPart, E_acel_av.CATPart]
2024-03-27 Relecture PCBs
    [AMS_IMD_Reset.kicad_pcb, BSPD.kicad_pcb, BSPD.kicad_sch, Discharge Controller.kicad_pcb, Discharge Controller.kicad_sch, SDC.kicad_sch, Screen Control.kicad_pcb]
2024-03-27 Working Voltage indicator
    [EC7BW18-72S12.stp, Indicator_voltage.kicad_sch]
2024-03-27 déplacement gabarits
    [Gabarit1.dxf, GabaritPompe2_Calque_1.dxf, plaque-arret-chape.dxf, plaque_chape-01.dxf, plaque_chape.dxf, plaque_chape2.dxf, plaque_tube-01.dxf, plaque_tube.dxf]
2024-03-29 Modifications de cartes pour l'ESF
    [AMS_IMD_Reset.kicad_sch, SDC.kicad_sch]
2024-03-29 TS et charger schematic pour école de ski français
    [AMS.kicad_sch, AMS_IMD_Reset.kicad_sch, Charger.kicad_pcb, Charger.kicad_sch, Data logger.kicad_sch, HV Connector.kicad_sch, HVD.kicad_sch, IMD.kicad_sch]
2024-04-02 g
    gabarit
    [Gabarit_d.CATPart]
2024-04-02 Gabarit cooling system
    [EN_A0200 (Cooling System).CATProduct, Gabarit_d.CATPart]
2024-04-02 Revert "test"
    This reverts commit 128c2b5cdf3236efd335557b67665b3e8173fa25.
    [EN_GA0201.CATPart]
2024-04-02 Gabarit radiateur 1
    [EN_G0201( gabarit radiateur 2).CATPart, EN_G0201(gabarit radiateur 1).CATPart]
2024-04-02 Légères corrections Indicator Voltage
    [Indicator_voltage.kicad_sch]
2024-04-03 gabarits susp arrière + modif mep la mache pilé
    [Chape_Fw_La_Rp_Up.CATPart, Chape_Fw_Ua_Rp_Up.CATPart, Chape_Rw_La_Fp_Up.CATPart, Chape_Rw_Ua_Fp_Up.CATPart, Gabarit_entier.CATProduct, Part195.CATPart, Produit27.CATProduct, SU_14011 (chape BAR).dxf]
2024-04-03 re modif mep plié
    [SU_14011 (chape BAR).dxf, SU_14011_anti_sym (chape BAR).dxf]
2024-04-03 Gnd plane
    [bspdv3.kicad_pcb]
2024-04-03 Chapes du haut radiateur
    [EN_GA0201_gabarit.CATPart]
2024-04-03 Autres gabarit chapes radiateur
    [EN_A0200 (Cooling System).CATProduct, EN_G02014_gabarit.CATProduct, EN_G02014_gabarit_p.CATPart, EN_GA0201.CATProduct]
2024-04-03 Chape puhs clips
    Chape puhs clips
    [FR_02003 (Chape push clips).CATPart, FR_A0200 (Body).CATProduct, Symmetry of FR_02003.CATPart, Symmetry of FR_02003_1.CATPart]
2024-04-03 gabarit dessous tsbox rectification
    [EL_G2008.CATProduct, EL_G2009.CATProduct, plaque_chape.CATPart, plaque_chape.dxf, plaque_chape_EN_G2009.CATPart, plaque_tube.CATPart, plaque_tube.dxf, plaque_tubze.CATPart]
2024-04-03 Maquettage TSAC
    [EL_21001 (TSAC Volume).CATPart, EL_21003 (High Voltage Indicator).CATPart, EL_A040012_1_2 (Finger protection cap).CATPart, EL_A040012_1_3 (Deep Drawn socket).CATPart, EL_A2100-b (Accumulator Assy Version b).CATProduct, EL_A21002 (HVD Assembly).CATProduct]
2024-04-03 gabarit pompe rectification
    [chape_pompe.CATProduct, plaque_grande_chape.CATPart, plaque_grande_chape.dxf, plaque_petite_chape.CATPart, plaque_petite_chape.dxf, plaque_tube.CATPart, plaque_tube.dxf]
2024-04-05 Création gabarit pushclip 1
    Création gabarit pushclip 1
    [FR_03001 - Frame Throttle.CATProduct, FR_03001.4 - Plaque milieu gauche.CATPart, FR_A0200 (Body).CATProduct, FR_A0300 - Throttle pedal.CATProduct, FR_A034 (Pedal Assy).CATProduct, FR_A0400 (Brake Pedal).CATProduct, FR_G03_1.CATProduct, FR_frame_and_body.CATProduct]
2024-04-05 Dessin deuxième gabarit pushclip
    Dessin deuxième gabarit pushclip
    [FR_03001 - Frame Throttle.CATProduct, FR_03001.4 - Plaque milieu gauche.CATPart, FR_A0200 (Body).CATProduct, FR_A0300 - Throttle pedal.CATProduct, FR_A034 (Pedal Assy).CATProduct, FR_A0400 (Brake Pedal).CATProduct, FR_G03_1.CATProduct, FR_G03_2.CATProduct]
2024-04-05 coins arrondis
    coins arrondis
    [gabarit_puschlip_2.CATPart, gabarit_pushclip_1.CATPart]
2024-04-05 MEP gabarits pushclip
    MEP gabarits pushclip
    [attache_1_pushclip_1.dxf, attache_1_pushclip_2.dxf, attache_2_puschlip_2.dxf, attache_2_pushclip_1.dxf, gabarit_pushclip_1.dxf, gabarit_pushclip_2.dxf]
2024-04-10 SU A100 fin
    [SU_A1000 (Front Left Upright).CATProduct]
2024-04-14 push pour José
    [Chape_Fw_La_Rp_Up.CATPart, Chape_Fw_Ua_Rp_Up.CATPart, E_droite.STEP, E_gauche_V2.STEP, E_pince.STEP, E_pince_V2.STEP, SU_A0100 (Front Upper A-Arm).CATProduct, SU_A0500.CATProduct]
2024-04-15 Modifications cartes
    Prise en compte des retours ECT + PCBs
    [AIR Controller.kicad_sch, AMS_IMD_Reset.kicad_pcb, AMS_IMD_Reset.kicad_sch, BSPD.kicad_pcb, BSPD.kicad_sch, Carte LED.kicad_sch, D_Sub_Cap.stl, Discharge Controller.kicad_pcb]
2024-04-17 Ajout sur la Voltage Indicator
    [Indicator_voltage.kicad_sch]
2024-04-17 Vérification PCBs + Fichiers Fabrication
    Préparation pour production des PCBs
    [AMS_IMD_Reset-B_Cu.gbr, AMS_IMD_Reset-B_Mask.gbr, AMS_IMD_Reset-B_Paste.gbr, AMS_IMD_Reset-B_Silkscreen.gbr, AMS_IMD_Reset-Edge_Cuts.gbr, AMS_IMD_Reset-F_Cu.gbr, AMS_IMD_Reset-F_Mask.gbr, AMS_IMD_Reset-F_Paste.gbr]
2024-04-17 Maquettage assemblage batterie (1/?)
    Ajout des rails sur le TSAC
    Corrections de certaines dimensions
    Ajout d'une première chape
    [EL_21001 (TSAC Volume).CATPart, EL_21004 (TSAC Rear Trackl).CATPart, EL_21005 (TSAC Front Rack).CATPart, EL_21006 (Rear Rear High Bracket).CATPart, EL_A2100-b (Accumulator Assy Version b).CATProduct, EL_A21000 (Filaire).CATPart]
2024-04-19 test baquet
    [MS_A0100 (Seat & Driver).CATProduct]
2024-04-19 Maquettage assemblage batterie (2/?)
    Beaucoup de filaires, quelques équipements
    [EL_21001 (TSAC Volume).CATPart, EL_21004 (TSAC Rear Trackl).CATPart, EL_21005 (TSAC Front Rack).CATPart, EL_21007 (Rear High High Bracket Support).CATPart, EL_21008 (High Rear Front Bracket).CATPart, EL_21009 (High Rear Front Bracket Support).CATPart, EL_A2100-b (Accumulator Assy Version b).CATProduct, EL_A2100-b (Accumulator Assy Version b).stp]
2024-04-20 Maquettage Miscellaneous
    Baquet comme sur 2021 mais pas parfaitement positionné au niveua des rear bracket qui rentrent un peu dans le tube
    [MS_01001 (Seat).CATPart, MS_01003 (Driver v2).CATProduct, MS_01005 (Driver v3) (Small size).CATProduct, MS_02002 (Brackets up).CATPart, MS_02004 (Brackets down).CATPart, MS_03002(MousseEpaules).CATPart, MS_03004(Anti-Submarine Belt Mounting).CATPart, MS_03005(Lap Mounting).CATPart]
2024-04-20 Dossiers au bon endroit
    [FR_G03_1.CATProduct, FR_G03_2.CATProduct, FR_frame_and_body.CATProduct, MS_Miscellanous.CATProduct, Symmetry of MS_03004.CATPart, Symmetry of MS_03005.CATPart, Symmetry of MS_A0300.CATProduct, attache_1_puschlip_2.CATPart]
2024-04-20 Maquettage assemblage batterie (3/?)
    Maquettage du point d'attache arrière bas
    Filaire pour les attaches avant
    [EL_21001 (TSAC Volume).CATPart, EL_21004 (TSAC Rear Trackl).CATPart, EL_21005 (TSAC Front Rack).CATPart, EL_21007 (Rear High High Bracket Support).CATPart, EL_21008 (High Rear Front Bracket).CATPart, EL_21009 (High Rear Front Bracket Support).CATPart, EL_21010 (Low Rear Rear Bracket).CATPart, EL_21011 (Low Rear Rear Bracket Support).CATPart]
2024-04-20 Maquettage assemblage batterie (4/?)
    Maquettage point attache haut avant (moitié)
    Franchement faut faire une cellule arrière droite, ces fixations sont cursed
    [EL_21005 (TSAC Front Rack).CATPart, EL_21014 (High Front Front Bracket).CATPart, EL_21015 (High Front Front Bracket Support).CATPart, EL_A2100-b (Accumulator Assy Version b).CATProduct]
2024-04-21 Maquettage assemblage batterie (5/?)
    Maquettage attaches avant
    [EL_21014 (High Front Front Bracket).CATPart, EL_21015 (High Front Front Bracket Support).CATPart, EL_21016 (High Front Rear Bracket).CATPart, EL_21017 (High Front Rear Bracket Support).CATPart, EL_21018 (Low Front Rear Bracket).CATPart, EL_21019 (Low Front Rear Bracket Support).CATPart, EL_A2100-b (Accumulator Assy Version b).CATProduct]
2024-04-21 Maquettage assemblage batterie (6/?)
    Fin du maquettage des équipements v1
    [EL_21001 (TSAC Volume).CATPart, EL_21004 (TSAC Rear Trackl).CATPart, EL_21005 (TSAC Front Rack).CATPart, EL_21019 (Low Front Rear Bracket Support).CATPart, EL_21020 (Low Front Front Bracket).CATPart, EL_21020.CATPart, EL_21021 (Low Front Front Bracket Support).CATPart, EL_A2100-b (Accumulator Assy Version b).CATProduct]
2024-04-22 gabarit circuit de refroidissement
    [EN_02005_(Overflow Bottle Body).CATPart, EN_A0200 (Cooling System).CATProduct, EN_G02016.CATProduct, EN_G02016_plaque_chape.CATPart, EN_G02016_plaque_tube.CATPart, Gabarit_d.CATPart, Produit1.CATProduct, calle_plaque_chape.CATPart]
2024-04-22 gabarit overflow bottle et catchcan
    [EN_02017_gabarit_2.CATPart, EN_A0200 (Cooling System).CATProduct, EN_G02016.CATProduct, EN_G02016_calle.CATPart, EN_G02016_calle.dxf, EN_G02016_plaque_chape.CATPart, EN_G02016_plaque_chape.dxf, EN_G02016_plaque_tube.CATPart]
2024-04-23 Déplacements sous MODAC
    [Calcul-du-nombre-de-cellules-et-des-dimensions-à-utiliser.xlsx, calculs elec et dimensions.xlsx]
2024-04-23 Maquettage assemblage batterie (6/?) + MEPs (1/?)
    [EL_21004 (TSAC Rear Trackl).CATPart, EL_21005 (TSAC Front Rack).CATPart, EL_21007 (Rear High High Bracket Support).CATPart, EL_21008 (High Rear Front Bracket).CATPart, EL_21009 (High Rear Front Bracket Support).CATPart, EL_21010 (Low Rear Rear Bracket).CATPart, EL_21010 TEST (Low Rear Rear Bracket).stp, EL_21011 (Low Rear Rear Bracket Support).CATPart]
2024-04-23 Maquettage assemblage batterie (7/?)) + MEPs (2/2=
    Ajout de pièces en doublon car ne passant pas en MEPs (non résolu)
    Fin des MEPs et compression en .zip
    [EL_21007 (Rear High High Bracket Support).CATPart, EL_21010 (Low Rear Rear Bracket NEW).CATPart, EL_21011 (Low Rear Rear Bracket Support NEW).CATPart, EL_21014 (High Front Front Bracket).CATPart, EL_21016 (High Front Rear Bracket).CATPart, EL_21018 (Low Front Rear Bracket NEW).CATPart, EL_21020 (Low Front Front Bracket).CATPart, EL_A2100-b (Accumulator Assy Version b).CATProduct]
2024-04-24 maquette IAD sur FR
    [FRA0500 (IA Assembly).CATProduct, FR_03001 - Frame Throttle.CATProduct, FR_03001.4 - Plaque milieu gauche.CATPart, FR_05002 (Anti-Intrusion Plate).CATPart, FR_A0200 (Body).CATProduct, FR_A0300 - Throttle pedal.CATProduct, FR_A034 (Pedal Assy).CATProduct, FR_A0400 (Brake Pedal).CATProduct]
2024-04-24 gabarit radia
    [EN_02005_(Overflow Bottle Body).CATPart, EN_02006_(Catch Can).CATPart, EN_02017_gabarit_1.CATPart, EN_A0200 (Cooling System).CATProduct, EN_GA0201.dxf]
2024-04-24 Maquettage module et TSAC (1/?)
    Modélisation du CTMD
    Ajout des dossiers correspondants
    [Battery-Module.stp, EL_23000 (Cell Temperature Monitoring Device).CATPart, EL_23001 (Cell Temperature Monitoring Device Support).CATPart, EL_23002 (Cells and support).CATProduct, EL_A2300 (Module).CATProduct, Part144.CATPart, Part145.CATPart, Part146.CATPart]
2024-04-26 Maquettage TSAC (1/?)
    Ajout des premiers volumes et parois
    [EL_22000 (TSAC).CATPart, EL_A2200 (Accumulator).CATProduct]
2024-04-27 Ajout conversion voltage/temp
    [RT_table.csv]
2024-04-27 Maquettage module (1/?)
    Ajout des busbars
    Connectique HV
    [Battery-Module.stp, EL_23002 (18650 Cells).CATPart, EL_23002 (Cells and support).CATProduct, EL_23003 (Lower Support).CATPart, EL_23004 (Upper Support).CATPart, EL_23005 (Upper Guide).CATPart, EL_23006 (Lower Guide).CATPart, EL_23007 (Lower Busbars).CATPart]
2024-04-30 Maquettage batterie en vrac
    Modules, CTMD et assy
    [EL_22000 (TSAC).CATPart, EL_23000 (Cell Temperature Monitoring Device).CATPart, EL_23001 (Cell Temperature Monitoring Device Support).CATPart, EL_230013 (Upper Plate).CATPart, EL_23002 (18650 Cells).CATPart, EL_23003 (Lower Support).CATPart, EL_23004 (Upper Support).CATPart, EL_23005 (Upper Guide).CATPart]
2024-04-30 Maquettage chapes moteur
    Deuxième couche par rapport à Carlos
    Corrections sur les chapes U0 Right (PDV pilote) sur la coaxialité
    Vérification des différentes positions
    [Chape_L2b.CATPart, Chape_M0.CATPart, Chape_U0 RR.CATPart, EN_A0100 (Engine).CATProduct, EN_Engine_Drivetrain.CATProduct, chapes.CATProduct]
2024-05-03 Réparation épaisseur busbar module
    [EL_230013 (Upper Plate).CATPart, EL_23002 (18650 Cells).CATPart, EL_23006 (Lower Guide).CATPart, EL_23007 (Lower Busbars).CATPart, EL_23008 (Upper Busbars).CATPart, EL_23011 (BMS Volume).CATPart, EL_23015 (Upper Plate W CTMD).CATPart, EL_A2300 (Module).CATProduct]
2024-05-03 Maquettage fixations batterie (8/?)
    Ajout des symétries des fixations.
    [EL_21014 (High Front Front Bracket).CATPart, EL_21018 (Low Front Rear Bracket NEW).CATPart, EL_A2100-b (Accumulator Assy Version b).CATProduct, Symmetry of EL_21004 (TSAC Rear Trackl).CATPart, Symmetry of EL_21005 (TSAC Front Rack).CATPart, Symmetry of EL_21006 (Rear High High Bracket).CATPart, Symmetry of EL_21007 (Rear High High Bracket Support).CATPart, Symmetry of EL_21008 (High Rear Front Br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]
2024-05-03 Gabarit baquet (1/?)
    Pas terminé du tout
    [MS_01001 (Seat).CATPart, MS_01003 (Driver v2).CATProduct, MS_01005 (Driver v3) (Small size).CATProduct, MS_A0100 (Seat & Driver).CATProduct, MS_A0200 (Head Restraint).CATProduct, MS_G01006.CATProduct, MS_Miscellanous.CATProduct, Part129.CATPart]
2024-05-03 Gabarit Batterie (1/?)
    Premières plaques
    [10x70.CATPart, 51.CATPart, 52.CATPart, 61.CATPart, 62.CATPart, EL_21001 (TSAC Volume).CATPart, EL_21003 (High Voltage Indicator).CATPart, EL_21004 (TSAC Rear Trackl).CATPart]
2024-05-04 Gabarit batterie (2/?)
    [EL_A2100-b (Accumulator Assy Version b).CATProduct, EL_GA2100.CATProduct, EL_GA2101.CATPart, EL_GA2102.CATPart, EL_GA2103.CATPart, EL_GA2104.CATPart, EL_GA2105.CATPart, EL_GA2106.CATPart]
2024-05-04 Gabarit batterie (3/?)
    Ajout de poches pour le tube penché
    Ajout d'une plaque par utilisation de références externes
    [EL_21001 (TSAC Volume).CATPart, EL_21010 (Low Rear Rear Bracket NEW).CATPart, EL_21011 (Low Rear Rear Bracket Support NEW).CATPart, EL_21018 (Low Front Rear Bracket NEW).CATPart, EL_21022 (High Rear Junction).CATPart, EL_A2100-b (Accumulator Assy Version b).CATProduct, EL_A21000 (Filaire).CATPart, EL_GA2100.CATProduct]
2024-05-05 Gabarit batterie (4/?)
    Corrections sur le gabarit test
    Réparation de liens contextuels
    [EL_A2100-b (Accumulator Assy Version b).CATProduct, EL_GA2100.CATProduct, EL_GA2101.CATPart, EL_GA2102.CATPart, Part161.CATPart, Test 3.CATPart, Test 5.CATPart, test.CATPart]
2024-05-05 Gabarit batterie (5/?)
    Ajout de nouvelles plaques
    [EL_A2100-b (Accumulator Assy Version b).CATProduct, EL_GA2100.CATProduct, EL_GA2101.CATPart, EL_GA2102.CATPart, EL_GA2103.CATPart, EL_GA2104.CATPart, EL_GA2105.CATPart, EL_GA2106.CATPart]
2024-05-05 Gabarit Batterie (6/?)
    Symétrie + nom fichier
    [EL_A2100-b (Accumulator Assy Version b).CATProduct, EL_GA2100.CATProduct, EL_GA2105.CATPart, Symmetry of EL_GA2100.CATProduct, Symmetry of EL_GA2101.CATPart, Symmetry of EL_GA2102.CATPart, Symmetry of EL_GA2103.CATPart, Symmetry of EL_GA2104.CATPart]
2024-05-06 Gabbarite Batterie (7/?)
    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
    [EL_A2100-b (Accumulator Assy Version b).CATProduct, EL_GA2100.CATProduct, EL_GA2101.CATPart, EL_GA2102.CATPart, EL_GA2103.CATPart, EL_GA2105.CATPart, EL_GA2106.CATPart, EL_GA2107.CATPart]
2024-05-06 Gabarit batterie (8/?)
    Nouvelle plaque
    [EL_A2100-b (Accumulator Assy Version b).CATProduct, EL_GA2100.CATProduct, EL_GA2108.CATPart, EL_GA2110.CATPart, EL_GA2111.CATPart, EL_Ga2109.CATPart, Symmetry of EL_GA2100.CATProduct, Symmetry of EL_GA2110.CATPart]
2024-05-06 Gabarit batterie (9/?)
    [EL_A2100-b (Accumulator Assy Version b).CATProduct, EL_GA2100.CATProduct, EL_GA2101.CATPart, EL_GA2102.CATPart, EL_GA2103.CATPart, EL_GA2104.CATPart, EL_GA2105.CATPart, EL_GA2106.CATPart]
2024-05-07 Modifs gabarit pushclips
    [FR_G03_1.CATProduct, FR_G03_2.CATProduct, FR_frame_and_body.CATProduct, attache_1_puschlip_1.dxf, attache_1_puschlip_2.CATPart, attache_1_puschlip_2.dxf, attache_1_pushclip_1.CATPart, attache_1_pushclip_1.dxf]
2024-05-07 Gabarit batterie (10/?)
    Correction de l'épaisseur des fentes de toutes les pièces
    [EL_A2100-b (Accumulator Assy Version b).CATProduct, EL_GA2100.CATProduct, EL_GA2101.CATPart, EL_GA2102.CATPart, EL_GA2103.CATPart, EL_GA2104.CATPart, EL_GA2105.CATPart, EL_GA2106.CATPart]
2024-05-08 Gabarit Batterie (11/?)
    Ajout de fentes pour la dernière plaque
    [EL_A2100-b (Accumulator Assy Version b).CATProduct, EL_GA2100.CATProduct, EL_GA2103.CATPart, EL_GA2107.CATPart, EL_GA2108.CATPart, EL_GA2110.CATPart, EL_GA2111.CATPart, Symmetry of EL_GA2102.CATPart]
2024-05-09 gabarit encore
    [EL_A2000 (TSBox + Inverter).CATProduct, EL_G2008.CATProduct, EN_02017_gabarit_1.CATPart, EN_A0200 (Cooling System).CATProduct, EN_G02017_plaque_tube.dxf, plaque_sur_chape.CATPart, plaque_sur_chape2.CATPart]
2024-05-12 Gabarit batterie (12/?)
    Supports de tubes
    Ajout de supports transversaux
    Ajout de fentes
    [EL_A2100-b (Accumulator Assy Version b).CATProduct, EL_GA2100.CATProduct, EL_GA2101.CATPart, EL_GA2102.CATPart, EL_GA2103.CATPart, EL_GA2104.CATPart, EL_GA2105.CATPart, EL_GA2106.CATPart]
2024-05-13 Gabarits
    Gabarit baquet arrière et excel des quantités à découper pour chaque pièce du gabarit batterie.
    [EL_A2100-b (Accumulator Assy Version b).CATProduct, EL_GA2100.CATProduct, EL_GA2101.CATPart, EL_GA2103.CATPart, EL_GA2105.CATPart, EL_GA2106.CATPart, EL_GA2107.CATPart, EL_GA2108.CATPart]
2024-05-13 Gabarit moteur
    [Chape_L2b.CATPart, Chape_M0.CATPart, Chape_U0 RR.CATPart, EN_02018.CATPart, EN_02018_support.CATPart, EN_A0100 (Engine).CATProduct, EN_Engine_Drivetrain.CATProduct, chapes.CATProduct]
2024-05-13 Gabarit Baquet arrière
    MEP
    [51.CATPart, 52.CATPart, 61.CATPart, 62.CATPart, Filaire.CATPart, Fr_A0100 (Frame).CATProduct, MS_GA01001.CATPart, MS_GA01001.dxf]
2024-05-13 Chapes moteur
    Modification équipement U0
    [Chapes_U0.CATPart, EN_02018.CATPart, EN_A0100 (Engine).CATProduct, EN_Engine_Drivetrain.CATProduct, chapes.CATProduct]
2024-05-14 Maquettage Firewall
    Premiers test
    [MS_04000 (Lower Plate).CATPart, MS_A0400 (FireWall).CATProduct]
2024-05-14 Pare-feu
    début de pare-feu (douteux)
    [Fr_A0100 (Frame).CATProduct, MS_04000 (right side firewall 1).CATPart, MS_A0400 (FireWall).CATProduct, Part1101.CATPart]
2024-05-14 Gabarits moteur
    Rear Plate
    Soutiens inférieurs, latéraux et supérieurs
    [Chape_L2b.CATPart, Chape_M0.CATPart, Chape_U0 RR.CATPart, EL_GA01003 (Front Support Plate).CATPart, EN_02018.CATPart, EN_A0100 (Engine).CATProduct, EN_Engine_Drivetrain.CATProduct, EN_GA002 (Engine Plate).CATPart]
2024-05-15 pare-feu
    début maquettage chapes
    [MS_04000 (right side firewall 1).CATPart, MS_04000 (test chape right side firewall).CATPart, MS_A0400 (FireWall).CATProduct]
2024-05-15 Encore pare-feu
    [MS_04000 (right side firewall 1).CATPart, MS_04000 (test chape right side firewall).CATPart, MS_A0400 (FireWall).CATProduct]
2024-05-15 pare-feu
    et c'est pas fini (je suis lent)
    [15x1.5.CATProduct, 25x1.5.CATProduct, 28x1.5.CATProduct, 30x2.CATProduct, 51.CATPart, 52.CATPart, 61.CATPart, 62.CATPart]
2024-05-15 gabarit chaipe tsbox part1
    [EL_A2000 (TSBox + Inverter).CATProduct, EN_G20004_gauche .CATProduct, plaque_chape.CATPart, plaque_chape_1.dxf, plaque_chape_2.CATPart, plaque_chape_2.dxf, plaque_sur_chape.CATPart, plaque_sur_chape2.CATPart]
2024-05-15 gabarit chaipe part 2 (enfin !)
    [EL_A2000 (TSBox + Inverter).CATProduct, EL_G2004_droite.CATProduct, pl_chape.CATPart, pl_tubze.CATPart, plaque_chape.dxf, plaque_tube.dxf]
2024-05-16 pare-feu
    c'est douteux mais ça prend forme
    [MS_04000 (chape avant side firewall).CATPart, MS_04000 (chape bas side firewall).CATPart, MS_04000 (right side firewall 1).CATPart, MS_A0400 (FireWall).CATProduct, Part109.CATPart, Shape_510.CATPart]
2024-05-16 Import module ECT
    [EL_23000 (Cell Temperature Monitoring Device).CATPart, EL_23001 (Cell Temperature Monitoring Device Support).CATPart, EL_230013 (Upper Plate).CATPart, EL_23002 (18650 Cells).CATPart, EL_23003 (Lower Support).CATPart, EL_23004 (Upper Support).CATPart, EL_23005 (Upper Guide).CATPart, EL_23006 (Lower Guide).CATPart]
2024-05-17 Ajout busbar module
    [EL_23007 (Lower Busbars Copper).CATPart, EL_23007 (Lower Busbars).CATPart, EL_23009 (Lower Busbars Nickel).CATPart, EL_32000 (18650 Cell).CATPart, EL_32001 (Lower Guide).CATPart, EL_32002 (Upper Guide).CATPart, EL_32003 (Lower Support).CATPart, EL_32004 (Upper Support).CATPart]
2024-05-17 Documentation IAD v2
    [IA cell over AIP.CATPart]
2024-05-17 IAD merged pdf
    [attache_1_puschlip_1.dxf, attache_1_puschlip_2.dxf, attache_2_puschlip_1.dxf, attache_2_puschlip_2.dxf, gabarit_puschlip_1.dxf, gabarit_puschlip_2.dxf]
2024-05-17 Ajout des deux versions de l'IAD, v1 et v2
2024-05-18 fin side firewall
    [15x1.5.CATProduct, 25x1.5.CATProduct, 28x1.5.CATProduct, 62.CATPart, Fr_A0100 (Frame).CATProduct, MS_04000 (chape avant side firewall).CATPart, MS_04000 (chape bas side firewall).CATPart, MS_04000 (right side firewall 1).CATPart]
2024-05-19 modifs mineures chape EN
    [Chape L.dxf, Chape_M0.dxf, Chape_U0.dxf, Chape_U0_RR.dxf]
2024-05-19 Gabarit Harness
    Gabarit + MEP
    [51.CATPart, 52.CATPart, 61.CATPart, Filaire.CATPart, MS_01001 (Seat).CATPart, MS_01003 (Driver v2).CATProduct, MS_01005 (Driver v3) (Small size).CATProduct, MS_02001 (Support).CATPart]
2024-05-20 st_05001 mep
    [mepST_05001.dxf]
2024-05-21 Add AMS_IMD reset chargeur
    [AMS.kicad_sch, AMS_IMD_Reset.kicad_pcb, AMS_IMD_Reset.kicad_sch, Charger.kicad_sch, HV Connector.kicad_sch, IMD.kicad_sch, Power Stage.kicad_sch, Raw Charger.kicad_sch]
2024-05-21 Ajout upper busbars
    [EL_23007 (Lower Busbars Copper).CATPart, EL_23008 (Upper Busbars Copper).CATPart, EL_23009 (Lower Busbars Nickel).CATPart, EL_23010 (Upper Busbars Nickel).CATPart, EL_32000 (18650 Cell).CATPart, EL_32001 (Lower Guide).CATPart, EL_32002 (Upper Guide).CATPart, EL_32003 (Lower Support).CATPart]
2024-05-22 modifs mineures
    [Chape L.dxf, Chape_M0.dxf, Chape_U0.dxf, Chape_U0_RR.dxf, mepST_05001.dxf]
2024-05-22 BSPD folder update
    [bspdv3.kicad_pcb, bspdv3.kicad_sch, bspdv3simuworking.kicad_sch]
2024-05-22 SCS Led chaffed corner + DRC ok
    [SCS LEDs.kicad_pcb]
2024-05-22 VC bis Led rounded corner + DRC ok
    [VCU_Bis.kicad_pcb]
2024-05-22 Correction SCS Maker
    [SCS Maker.kicad_pcb]
2024-05-22 Discharge Controller rounded corner + DRC ok
    [Discharge Controller.kicad_pcb]
2024-05-22 Correction DSB
    [Screen Control.kicad_pcb]
2024-05-22 MEP chainfield
    [Chainfield Bracket 1.dxf, Chainfield Bracket 2.dxf]
2024-05-22 Update module
    [EL_23007 (Lower Busbars Copper).CATPart, EL_23008 (Upper Busbars Copper).CATPart, EL_23009 (Lower Busbars Nickel).CATPart, EL_32000 (18650 Cell).CATPart, EL_32001 (Lower Guide).CATPart, EL_32002 (Upper Guide).CATPart, EL_32003 (Lower Support).CATPart, EL_32004 (Upper Support).CATPart]
2024-05-22 MEP LAs et rajout ancienne firewall
    [Chainfield Bracket 1.dxf, Chainfield Bracket 2.dxf, Chape L.dxf, Chape_M0.dxf, Chape_U0.dxf, Chape_U0_RR.dxf, MS_04000 (Middle part)Part1101.CATPart, MS_04001 (Middle part).CATPart]
2024-05-22 Push Firewall
    Rename des chapes
    Correction de la side plate
    [MS_04000 (Lower Plate).CATPart, MS_04000 (chape avant side firewall).CATPart, MS_04000 (chape bas side firewall).CATPart, MS_04000 (right side firewall 1).CATPart, MS_04001 (Middle Plate v1).CATPart, MS_04002 (Right Side Firewall).CATPart, MS_04003 (Rear Side Firewall Bracket).CATPart, MS_04004 (Front Side Firewall Bracket).CATPart]
2024-05-22 Revert "Push Firewall"
    This reverts commit e4f3855f62b25cff9b3795c70d03973c71f2d205.
    [MS_04000 (Lower Plate).CATPart, MS_04000 (chape avant side firewall).CATPart, MS_04000 (chape bas side firewall).CATPart, MS_04000 (right side firewall 1).CATPart, MS_04001 (Middle Plate v1).CATPart, MS_04002 (Right Side Firewall).CATPart, MS_04003 (Rear Side Firewall Bracket).CATPart, MS_04004 (Front Side Firewall Bracket).CATPart]
2024-05-22 MEP perçage TSBox
    [EL_A2000 (TSBox + Inverter).CATProduct, Resistance.CATPart, tsbox_encore.CATPart, tsbox_encore2.CATProduct]
2024-05-22 MEP Chapes firewall
    [MS_04004 (Bracket 1).dxf, MS_04005 (Bracket 2).dxf, MS_04006 (Chape side avant et bas).dxf, MS_04007 (Chape side arriere).dxf]
2024-05-22 Maquettage + MEP Firewall
    MEP Lower Part
    Découpe plaque latérale
    Maquettage de l'ensemble (c'est le bazar entre les différentes versions, il faudra que je fasse le tri)
    [MS_04000 (Lower Plate).CATPart, MS_04000 (Middle part)Part1101.CATPart, MS_04000 (chape avant side firewall).CATPart, MS_04000 (chape bas side firewall).CATPart, MS_04000 (right side firewall 1).CATPart, MS_04001 (Middle Part Bis).CATPart, MS_04003 (Lower Part Bis).CATPart, MS_04003 (Lower Part).dxf]
2024-05-22 Maquettage Firewall
    Redécoupe de la plaque latérale
    Correction MS_04005
    [MS_04003 (Lower Part Bis).CATPart, MS_04003 (Right Side Firewall Bis).CATPart, MS_04006 (False Tubes).CATPart, MS_A0400 (FireWall Test).CATProduct, MS_A0400 (FireWall).CATProduct]
2024-05-22 Symétrie plaque latérale firewall
    [MS_A0400 (FireWall).CATProduct, Symmetry of MS_04003 (Right Side Firewall Bis).CATPart]
2024-05-23 Chapes firewall dans dossier envoie la mache
    [MS_04004 (Bracket 1).dxf, MS_04005 (Bracket 2).dxf, MS_04006 (Chape side avant et bas).dxf, MS_04007 (Chape side arriere).dxf]
2024-05-23 Modification MEP MS_04005
    [MS_04005 (Bracket 2).dxf]
2024-05-23 Maquettage encore
    Chape coudée pour la FireWall
    Ajout de certaines plaques
    [MS_04003 (Bracket_3).CATPart, MS_04003 (Lower Part Bis).CATPart, MS_04006 (False Tubes).CATPart, MS_A0400 (FireWall Test).CATProduct, Symmetry of MS_04003 (Right Side Firewall Bis).CATPart]
2024-05-23 MEP MS_04004 Bracket 3
    MEP de la dernière chape pour la Firewall
    Suppression MEP Lower Part
    [MS_04004 (Bracket_3).dxf]
2024-05-23 MEP MS_04004 Bracket 3
    Correction MEP chape coudée Firewall
    [MS_04004 (Bracket_3).dxf]
2024-05-23 Rajout fichier igs dans 5eme vague
    [Chainshield Bracket 1.dxf, Chainshield Bracket 2.dxf, Chainshield_bracket_1.igs, Chainshield_bracket_2.igs, MS_04003 (Bracket_3).igs]
2024-05-23 Dernière correction
    [MS_04005 (Bracket 2).dxf]
2024-05-24 Fin module sans tenue mécanique
    [EL_23007 (Lower Busbars Copper).CATPart, EL_23008 (Upper Busbars Copper).CATPart, EL_23009 (Lower Busbars Nickel).CATPart, EL_23010 (Upper Busbars Nickel).CATPart, EL_32000 (18650 Cell).CATPart, EL_32001 (Lower Guide).CATPart, EL_32002 (Upper Guide).CATPart, EL_32003 (Lower Support).CATPart]
2024-05-25 Test Steering System
    [Rack_support_Wireframe.CATPart, ST_02001 (Steering Column).CATPart, ST_02002 (Rigid Coupling).CATPart, ST_02003 ( U-Joint).CATProduct, ST_02003_1 Croisillon.CATPart, ST_02003_2 Fork.CATPart, ST_02003_3 Intermediate.CATPart, ST_03001 (rod tube)V2.CATPart]
2024-05-27 Correction gabarit blocage sangles harnais
    [Filaire.CATPart, MS_A0300 (Harness).CATProduct, MS_G030062.CATPart, MS_G030062.dxf, MS_Miscellanous.CATProduct]
2024-05-27 Corrections chapes LAS
    Triangle avant done
    [Chape_Fw_La_Fp_Low.CATPart, Chape_Fw_La_Fp_Up.CATPart, Chape_Fw_La_Rp_Low.CATPart, Chape_Fw_La_Rp_Up.CATPart, Chape_Fw_Ua_Fp_Low.CATPart, Chape_Fw_Ua_Fp_Up.CATPart, Chape_Fw_Ua_Rp_Low.CATPart, Chape_Fw_Ua_Rp_Up.CATPart]
2024-05-27 Correction chapes LAS 2/2
    Triangle arrière done aussi
    [Chape_Fw_La_Rp_Up.CATPart, Chape_Fw_Ua_Rp_Low.CATPart, Chape_RRocker_F.CATPart, Chape_RRocker_R.CATPart, Chape_Rw_La_Fp_Low.CATPart, Chape_Rw_La_Fp_Up.CATPart, Chape_Rw_La_Rp_Low.CATPart, Chape_Rw_La_Rp_Up.CATPart]
2024-05-28 Ajout MEP gabarits moteur
    [EN_02017_gabarit_1_MEP.dxf, EN_02017_gabarit_2_MEP.dxf, EN_02018_support_MEP.dxf, EN_2018_MEP.dxf]
2024-05-28 BSPD files updates
    [BSPD_v2.kicad_pcb, BSPD_v2.kicad_sch, BSPD_v2_timertest.kicad_sch, bspdv3.kicad_pcb, bspdv3.kicad_sch]
2024-05-28 Modif écartement chapes Tie Rod
    [Suspension.CATProduct]
2024-06-02 TSAL modif
    [AMD_IMD_RESET.kicad_pcb, AMD_IMD_RESET.kicad_sch, TSAL.kicad_sch]
2024-06-02 Oupsi d oupsi resistance de tirage
    [TSAL.kicad_sch]
2024-06-02 Léger correctif logique TSAL
    [TSAL.kicad_sch]
2024-06-02 Routage Voltage Indicator
    [Indicator_voltage.kicad_pcb, Indicator_voltage.kicad_sch]
2024-06-03 Module et Circuit LV Batterie HV
    [AMS Alim and SCS Maker.kicad_sch, AMS.kicad_sch, Data logger.kicad_sch, EL_32003 (Lower Support).CATPart, EL_A2300 (Module).CATProduct, HV Battery (LV Part).kicad_pcb, HV Battery (LV Part).kicad_sch, HV Current Sensor.kicad_sch]
2024-06-05 Ajout compo convertisseur 600V + IMD SCS + BOM AIR
    [AIR controller.xls, Discharge Controller.kicad_pcb, IMD SCS Maker.kicad_pcb, IMD SCS Maker.kicad_sch, Indicator_voltage.kicad_pcb, Indicator_voltage.kicad_sch]
2024-06-05 Carte LED schem + pcb update cf feedback PJR
    [Carte LED.kicad_pcb, Carte LED.kicad_sch]
2024-06-05 LED right direction
    [Carte LED.kicad_sch]
2024-06-06 Déplacements cartes elec Batterie vers MODAC
    [AMS Alim and SCS Maker.kicad_sch, AMS Dongle.kicad_pcb, AMS Dongle.kicad_sch, AMS Dongle.sch, AMS.kicad_sch, AMS_IMD_Reset.kicad_pcb, AMS_IMD_Reset.kicad_sch, BOM.csv]
2024-06-06 Premier push AMS
    [AMS Dongle.kicad_pcb, AMS Dongle.kicad_sch, AMS Dongle.sch, IMD SCS Maker.kicad_sch, RPi_GPIO.sch]
2024-06-07 Routage AMS
    [AIR Controller.kicad_pcb, AIR Controller.kicad_sch, AIR controller.xls, AMS Dongle.kicad_pcb, AMS Dongle.kicad_sch, BOM.csv, Charger.kicad_sch]
2024-06-08 MAJ modèles 3D KICAD
    [ADS1115QNKSRQ1.stp, AMS Dongle.kicad_pcb, AMS Dongle.kicad_sch, AMS_IMD_Reset.kicad_pcb, AMS_IMD_Reset.kicad_sch, BD41041FJ-CE2.stp, CAS-120B.stp, CB3-3C-20M0000.stp]
2024-06-08 MAJ 3D Modac
    [0ADAP0200-RE.stp, 200241-1212.stp, 3296Y-1-223LF.stp, 7447709102.stp, AIR Controller.kicad_pcb, AIR controller.xls, AMS_IMD_Reset.kicad_pcb, CD4067BMG4.stp]
2024-06-10 Légère modif pistes AMS dongle
    [AMS Dongle.kicad_pcb]
2024-06-10 Renommage pour plus de clareté
    [AMS Alim and SCS Maker.kicad_sch, AMS.kicad_sch, AMS_IMD_Reset.kicad_sch, Charger.kicad_pcb, Charger.kicad_sch, Data logger.kicad_sch, Discharge Controller.kicad_pcb, Discharge Controller.kicad_sch]
2024-06-13 Import ECT BMS
    [BMS V1.0.kicad_pcb, BMS V1.0.kicad_sch, BMS.kicad_pcb, BMS.kicad_sch]
2024-06-14 Prise en compte retours JDL
    [AMS Dongle.kicad_pcb, AMS Dongle.kicad_sch, AMS_IMD_Reset.kicad_pcb, AMS_IMD_Reset.kicad_sch, BMS V1.0.kicad_pcb, BMS V1.0.kicad_sch, BMS.kicad_pcb, Discharge Controller.kicad_pcb]
2024-06-14 Modifs légères BMS/AMS
    [AMS Dongle.kicad_pcb, BMS V1.0.kicad_pcb, BMS.kicad_pcb]
2024-06-16 GND plane Fix
    [Carte LED.kicad_pcb, bspdv3.kicad_pcb]
2024-06-16 Update cirly files
    [AMS_IMD_Reset-B_Cu.gbr, AMS_IMD_Reset-B_Mask.gbr, AMS_IMD_Reset-B_Paste.gbr, AMS_IMD_Reset-B_Silkscreen.gbr, AMS_IMD_Reset-Edge_Cuts.gbr, AMS_IMD_Reset-F_Cu.gbr, AMS_IMD_Reset-F_Mask.gbr, AMS_IMD_Reset-F_Paste.gbr]
2024-06-16 Update SCS LEDs schematic
    For T11.9.6 compliance
    [SCS IMD-AMS Indicator.kicad_pcb, SCS IMD-AMS Indicator.kicad_sch, SCS TSAL Green LED.kicad_pcb, SCS TSAL Green LED.kicad_sch, SCS TSAL Red LED.kicad_pcb, SCS TSAL Red LED.kicad_sch]
2024-06-17 Gerbers cartes modac
    [AMS Dongle-B_Cu.gbl, AMS Dongle-B_Mask.gbs, AMS Dongle-B_Paste.gbp, AMS Dongle-B_Silkscreen.gbo, AMS Dongle-Edge_Cuts.gm1, AMS Dongle-F_Cu.gtl, AMS Dongle-F_Mask.gts, AMS Dongle-F_Paste.gtp]
2024-06-18 MAJ AMS/BMS
    [AMS Dongle-B_Cu.gbl, AMS Dongle-B_Mask.gbs, AMS Dongle-B_Paste.gbp, AMS Dongle-B_Silkscreen.gbo, AMS Dongle-Edge_Cuts.gm1, AMS Dongle-F_Cu.gtl, AMS Dongle-F_Mask.gts, AMS Dongle-F_Paste.gtp]
2024-06-20 Le module il est carré.
    Et oui
    [AMS Dongle.kicad_pcb, EL_23007 (Lower Busbars Copper).CATPart, EL_23008 (Upper Busbars Copper).CATPart, EL_32000 (18650 Cell).CATPart, EL_32001 (Lower Guide).CATPart, EL_32002 (Upper Guide).CATPart, EL_32003 (Lower Support).CATPart, EL_32004 (Upper Support).CATPart]
2024-06-23 PCBs + fichiers de fabrication
    Update SCS LEDs et retours TSAL ESF
    [SCS IMD-AMS Indicator-B_Cu.gbr, SCS IMD-AMS Indicator-B_Mask.gbr, SCS IMD-AMS Indicator-B_Paste.gbr, SCS IMD-AMS Indicator-B_Silkscreen.gbr, SCS IMD-AMS Indicator-Edge_Cuts.gbr, SCS IMD-AMS Indicator-F_Cu.gbr, SCS IMD-AMS Indicator-F_Mask.gbr, SCS IMD-AMS Indicator-F_Paste.gbr]
2024-06-27 ajout quelques composants
    [5-103635-6.step, 5-103635-8.step, 5-103735-1.stp, BMS V1.0.kicad_pcb, LTC6811IG-1#PBF.stp]
2024-06-27 légères modifs bms
    [BMS V1.0.step, BMS.kicad_pcb, BMS.kicad_sch]
2024-06-27 MAJ cartes modac
    [AMS Dongle-B_Cu.gbl, AMS Dongle-B_Mask.gbs, AMS Dongle-B_Paste.gbp, AMS Dongle-B_Silkscreen.gbo, AMS Dongle-Edge_Cuts.gm1, AMS Dongle-F_Cu.gtl, AMS Dongle-F_Mask.gts, AMS Dongle-F_Paste.gtp]
2024-06-27 MAJ module 3D
    [5-103635-6_Duplicate_7.CATPart, 5-103635-8_Duplicate_6.CATPart, ASSEMBLY.CATPart, ASSEMBLY_Duplicate_5.CATPart, ASSEMBLY_Duplicate_8.CATPart, BMS V1.0.step, BMS V1.0_PCB.CATPart, C-5-103735-1.CATPart]
2024-06-30 Import step + modif tsac
    [5-103635-6_Duplicate_7.CATPart, 5-103635-8_Duplicate_6.CATPart, AIR LEV200H4ANA.stp, ASSEMBLY.CATPart, ASSEMBLY_Duplicate_5.CATPart, ASSEMBLY_Duplicate_8.CATPart, BMS V1.0_PCB.CATPart, Bender_A_ISOMETER-IR155_3204_IMD.STEP]
2024-07-01 Adding precharge resistor stp
    [Precharge resistor HS100_4K7_F.stp]
2024-07-01 SES v2 attaches batterie
    Premiers schémas pour le SES, partie sur les fixations de l'accumulateur
2024-07-02 Test CTMD
    [EL_22000 (TSAC).CATPart, EL_23007 (Lower Busbars Copper).CATPart, EL_23007 (Lower Busbars).CATPart, EL_23008 (Upper Busbars Copper).CATPart, EL_23013 (CTMD).CATPart, EL_23014 (CTMD Support).CATPart, EL_32011 (Protection).CATPart, EL_A2200 (Accumulator).CATProduct]
2024-07-02 Update 3D batterie
    [Cable.CATPart, EL_22000 (TSAC).CATPart, EL_23013 (CTMD).CATPart, EL_32000 (18650 Cell).CATPart, EL_32001 (Lower Guide).CATPart, EL_32002 (Upper Guide).CATPart, EL_32003 (Lower Support).CATPart, EL_32004 (Upper Support).CATPart]
2024-07-02 SES v2 et SE3D v2
    SE3D actualisé avec les nouvelles attaches, compressé en 7z et mis sur le site du FSG
    Partie fixations de la batterie du SES complétée : positions, calculs de résistance des équipements et des vis dans les différents cas de charge
    [assemblage_special_SE3D_v2.CATProduct]
2024-07-03 Import step to catproduct batterie
    [0AKK-K100-BB_PART1.CATPart, 0AKK-K100-BB_PART2.CATPart, 0AKK-K100-BB_PART3.CATPart, 0AKK-K100-BB_PART4.CATPart, 0PTF0078P.stp, 124556.CATPart, 126151.CATPart, 1718574002.CATPart]
2024-07-03 Ajout test batterie 3D + Avancement
    [EL_21001 (TSAC Volume).CATPart, EL_21003 (High Voltage Indicator).CATPart, EL_21004 (TSAC Rear Trackl).CATPart, EL_21005 (TSAC Front Rack).CATPart, EL_21006 (Rear Rear High Bracket).CATPart, EL_21007 (Rear High High Bracket Support).CATPart, EL_21008 (High Rear Front Bracket).CATPart, EL_21009 (High Rear Front Bracket Support).CATPart]
2024-07-04 Grosse update maquette batterie
    [EL_22000 (TSAC).CATPart, EL_22015 (Connecteur module-AIR).CATPart, EL_22017 (Inside Container).CATPart, EL_A2200 (Accumulator).CATProduct, EL_A22014 (Connecteur module court).CATProduct, EL_A22016 (Connecteur module long).CATProduct, EL_A2300 (Module).CATProduct, Segment Connector H1111000301-000.CATPart]
2024-07-05 Quasi fin modele 3D batterie + modif TSAC Voltage
    [EL_22000 (TSAC).CATPart, EL_22008 (IMD).CATPart, EL_22017 (Inside Container).CATPart, EL_A2100-b (Accumulator Assy Version b).CATProduct, EL_A2200 (Accumulator).CATProduct, EL_A2300 (Module).CATProduct, PCB_for REF 060923.CATPart, TSAC_Voltage_Sensor.kicad_pcb]
2024-07-08 Modif cartes, ajout ventilateur et placement 3D PCB
    [0AKK-K100-BB_PART1.CATPart, 0AKK-K100-BB_PART2.CATPart, 0AKK-K100-BB_PART3.CATPart, 0AKK-K100-BB_PART4.CATPart, 0PTF0078P_Duplicate_3.CATPart, 124556.CATPart, 126151.CATPart, 1718574002.CATPart]
2024-07-09 update prod carte modac
    [AMS Dongle-B_Cu.gbl, AMS Dongle-B_Mask.gbs, AMS Dongle-B_Paste.gbp, AMS Dongle-B_Silkscreen.gbo, AMS Dongle-Edge_Cuts.gm1, AMS Dongle-F_Cu.gtl, AMS Dongle-F_Mask.gts, AMS Dongle-F_Paste.gtp]
2024-07-12 Modif accumulator
    [AMS Dongle.kicad_sch, Cahier des charges Batterie.xlsx, EL_22000 (TSAC).CATPart, EL_22017 (Inside Container).CATPart, EL_A2100-b (Accumulator Assy Version b).CATProduct, EL_A2200 (Accumulator).CATProduct, EL_A2300 (Module).CATProduct]
2024-07-15 Update couvercle batterie
    [0AKK-K100-BB_PART1.CATPart, 0AKK-K100-BB_PART2.CATPart, 0AKK-K100-BB_PART3.CATPart, 0AKK-K100-BB_PART4.CATPart, 0PTF0078P_Duplicate_3.CATPart, 124556.CATPart, 126151.CATPart, 1718574002.CATPart]
2024-07-16 Fin TSAC + Correction schema LV batterie
    [7239448_01.CATPart, 7239448_02.CATPart, 8STA-00-0635_NOT-LISTED.stp, 8STA-00-10_NOT-LISTED.stp, EL_22000 (TSAC).CATPart, EL_22015 (Connecteur module-AIR).CATPart, EL_22017 (Inside Container).CATPart, EL_22022 (Connecteur LV 5P).CATPart]
2024-07-16 Modifs batterie
    [Cable Gland 1SNG601012R0000.stp, Connecteur 2P 8STA-00-10_NOT-LISTED.stp, Connecteur 5P 8STA-00-0635_NOT-LISTED.stp, EL_22000 (TSAC).CATPart, EL_22017 (Inside Container).CATPart, EL_22024 (Presse etoupe).CATPart, EL_A2200 (Accumulator).CATProduct, EL_A2300 (Module).CATProduct]
2024-07-22 Modif AMS Dongle
    [AMS Dongle.kicad_pcb, AMS Dongle.kicad_sch, TS Full.kicad_sch]
2024-07-26 Modif CAN AMS.dongle
    [AMS Dongle.kicad_pcb, AMS Dongle.kicad_sch, ATA6563-GBQW1.stp, BD41041FJ-CE2.stp, CB3LV-3C-20M0000.stp]
2024-09-03 Modifs AMS Dongle + gerbers
    [AMS Dongle-B_Cu.gbl, AMS Dongle-B_Mask.gbs, AMS Dongle-B_Paste.gbp, AMS Dongle-B_Silkscreen.gbo, AMS Dongle-Edge_Cuts.gm1, AMS Dongle-F_Cu.gtl, AMS Dongle-F_Mask.gts, AMS Dongle-F_Paste.gtp]
2024-09-04 Update schematique chargeur
    [AMS Alim and SCS Maker.kicad_sch, AMS.kicad_sch, AMS_IMD_Reset.kicad_sch, Charger.kicad_sch, HV Battery (LV Part).kicad_pcb, HV Battery (LV Part).kicad_sch, HV Battery and Charger.kicad_pcb, HV Battery and Charger.kicad_sch]
2024-09-05 Legere update maquette et chargeur
    [AMS_IMD_Reset.kicad_sch, Cahier des charges Batterie.xlsx, EL_22000 (TSAC).CATPart, EL_22017 (Inside Container).CATPart, EL_A2200 (Accumulator).CATProduct, EL_A2300 (Module).CATProduct, HV Battery and Charger.kicad_sch]
2024-09-06 Debut MEP batterie
    [EL_22000 (TSAC).CATPart, EL_22017 (Inside Container).CATPart, EL_A2200 (Accumulator).CATProduct, Part1.CATPart]
2024-09-07 Gabarits de SU_14011 et ST_04003
    [GA_ST04003.CATPart, GA_SU_14011.CATPart]
2024-09-09 3/4 MEP Battery control unit
    [EL_22017 (Inside Container).CATPart]
2024-09-10 Maj plan batterie + Refonte supports relais
    [0AKK-K100-BB_PART1.CATPart, 0AKK-K100-BB_PART2.CATPart, 0AKK-K100-BB_PART3.CATPart, 0AKK-K100-BB_PART4.CATPart, 0PTF0078P_Duplicate_3.CATPart, 124556.CATPart, 126151.CATPart, 1718574002.CATPart]
2024-09-17 Gros rework batterie + cartes batterie part1
    [22-11-2022_1.1.CATPart, 22-11-2042_1.CATPart, ASSEMBLY.11.CATPart, ASSEMBLY.2.CATPart, ASSEMBLY_Duplicate_1.1.CATPart, ASSEMBLY_Duplicate_3.5.12.CATPart, ASSEMBLY_Duplicate_4.CATPart, ASSEMBLY_Duplicate_5.6.CATPart]
2024-09-17 Gros rework batterie + cartes batterie part2
    [124556.CATPart, 126151.CATPart, 1718574004.CATPart, 2002411112.4.CATPart, 2002411112.CATPart, 22-11-2022_1.2.CATPart, 7239448_01.CATPart, 7239448_02.CATPart]
2024-09-18 Fin drafting Inside Container
    [EL_22017 (Inside Container).CATPart, EL_A2200 (Accumulator).CATProduct, EL_A2300 (Module).CATProduct, Indicator_voltage.CATProduct]
2024-09-19 Update fixation batterie
    [EL_21022 (High Rear Junction).CATPart, EL_A2100-b (Accumulator Assy Version b).CATProduct, EL_A21000 (Filaire).CATPart, EL_A2200 (Accumulator).CATProduct, EL_GA2100.CATProduct, EL_GA2101.CATPart, EL_GA2102.CATPart, EL_GA2104.CATPart]
2024-09-19 Intégration batterie maquette générale
    [Artemiz.CATProduct, EL_21001 (TSAC Volume).CATPart, EL_21003 (High Voltage Indicator).CATPart, EL_21010 (Low Rear Rear Bracket NEW).CATPart, EL_21011 (Low Rear Rear Bracket Support NEW).CATPart, EL_22000 (TSAC).CATPart, EL_22017 (Inside Container).CATPart, EL_A0300 (LV Battery).CATProduct]
2024-09-20 Nettoyage fixation batterie
    [EL_21001 (TSAC Volume).CATPart, EL_21003 (High Voltage Indicator).CATPart, EL_21004 (TSAC Rear Trackl).CATPart, EL_21005 (TSAC Front Rack).CATPart, EL_21006 (Rear Rear High Bracket).CATPart, EL_21007 (Rear High High Bracket Support).CATPart, EL_21008 (High Rear Front Bracket).CATPart, EL_21009 (High Rear Front Bracket Support).CATPart]
2024-09-24 Modif Discharge controller
    [AMS_IMD_Reset.kicad_pcb, Discharge Controller.kicad_pcb, Discharge Controller.kicad_sch, HV Battery and Charger.kicad_sch]
2024-09-24 Revert "Modif Discharge controller"
    This reverts commit 299f52ab1fad389a0f7cf3a8ef8eeb6215b67b4a.
    [AMS_IMD_Reset.kicad_pcb, Discharge Controller.kicad_pcb, Discharge Controller.kicad_sch, HV Battery and Charger.kicad_sch]
2024-09-24 Fin revert commit
    [AMS_IMD_Reset.kicad_pcb, HV Battery and Charger.kicad_sch]
2024-09-26 Plans Isymeca
    [Armoire.CATPart, Isymeca.CATProduct, Murs.CATPart, Part2.CATPart, Portes.CATPart]
2024-09-26 Modif librairie EPSA AMPLI OP /!\
    [AIR Controller.kicad_pcb, AIR Controller.kicad_sch, AIR Controller.step, Armoire.CATPart, Isymeca.CATProduct, Murs.CATPart, Part2.CATPart]
2024-09-26 Gerbers MODAC
    [AIR Controller-B_Cu.gbr, AIR Controller-B_Mask.gbr, AIR Controller-B_Paste.gbr, AIR Controller-B_Silkscreen.gbr, AIR Controller-Edge_Cuts.gbr, AIR Controller-F_Cu.gbr, AIR Controller-F_Mask.gbr, AIR Controller-F_Paste.gbr]
2024-09-30 Premières corrections gabarit susp arrière
    [51.CATPart, 52.CATPart, 61.CATPart, 62.CATPart, Chape_Fw_La_Fp_Low.CATPart, Chape_Fw_La_Fp_Up.CATPart, Chape_Fw_La_Rp_Low.CATPart, Chape_Fw_La_Rp_Up.CATPart]
2024-09-30 Fin gabarit suspension arrière
    [Part195.CATPart, SU_A0100 (Front Upper A-Arm).CATProduct, SU_A0500.CATProduct, SU_A0800.CATProduct, SU_A1300.CATProduct, Suspension.CATProduct, WireframeDefinition.CATProduct, gabarit susp arriere.CATProduct]
2024-09-30 MAJ Gerber Modac
    [AIR Controller-B_Cu.gbr, AIR Controller-B_Mask.gbr, AIR Controller-B_Paste.gbr, AIR Controller-B_Silkscreen.gbr, AIR Controller-Edge_Cuts.gbr, AIR Controller-F_Cu.gbr, AIR Controller-F_Mask.gbr, AIR Controller-F_Paste.gbr]
2024-10-01 gabarit GA_ST04003 partie 1
    [GA_ST04003_plaque_tube_1.dxf]
2024-10-01 Gabarit chape submarine
    [MS_01003 (Driver v2).CATProduct, MS_01005 (Driver v3) (Small size).CATProduct, MS_A0100 (Seat & Driver).CATProduct, MS_A0300 (Harness).CATProduct, MS_G030045.CATProduct, MS_G0300451.CATPart, MS_G0300452.CATPart, MS_G0300453.CATPart]
2024-10-03 Gabarit ST et chapes moteur
    [EL_GA01003 (Front Support Plate).CATPart, EN_02018.CATPart, EN_A0100 (Engine).CATProduct, EN_Engine_Drivetrain.CATProduct, EN_GA01001 (Low Support Plate).CATPart, EN_GA01001_plaque_1.dxf, EN_GA01001_plaque_2.dxf, EN_GA01002 (Engine Rear Plate).CATPart]
2024-10-05 Modifications FireWall MS_A400
    Contient une modification du fichier Frame pour publication de certains éléments
    [15x1.5.CATProduct, 25x1.5.CATProduct, 25x2.CATProduct, 28x1.5.CATProduct, 30x2.CATProduct, FR_03001 - Frame Throttle.CATProduct, FR_03001.4 - Plaque milieu gauche.CATPart, FR_A0300 - Throttle pedal.CATProduct]
2024-10-08 MEP gabarit submarine
    [MS_01003 (Driver v2).CATProduct, MS_01005 (Driver v3) (Small size).CATProduct, MS_030041.dxf, MS_030042.dxf, MS_030043.dxf, MS_A0100 (Seat & Driver).CATProduct, MS_A0300 (Harness).CATProduct, MS_G03004.CATProduct]
2024-10-09 nouveau boitier TSBox (pour usiner)
    [boitierTSBOX_repris.CATPart]
2024-10-10 Correction PCB AMS et autres
    [AMS Dongle.kicad_pcb, AMS Dongle.kicad_sch, EL_22017 (Inside Container).CATPart, EL_A2200 (Accumulator).CATProduct, HV Battery and Charger.kicad_sch, Isymeca.CATProduct, Murs.CATPart, Support_Fusible.stl]
2024-10-10 correct opamp tsal
    [TSAL-B_Cu.gbr, TSAL-B_Mask.gbr, TSAL-B_Paste.gbr, TSAL-B_Silkscreen.gbr, TSAL-Edge_Cuts.gbr, TSAL-F_Cu.gbr, TSAL-F_Mask.gbr, TSAL-F_Paste.gbr]
2024-10-12 MEP la mache
    [Chape_Fw_La_Fp_Low.dxf, Chape_Fw_La_Fp_Up.dxf, Chape_Fw_La_Rp_Up.dxf, Chape_Fw_Ra_Rp_Low.dxf, Chape_Fw_Ua_Fp_Low.dxf, Chape_Fw_Ua_Fp_Up.dxf, Chape_Fw_Ua_Rp_Low.dxf, Chape_Fw_Ua_Rp_Up.dxf]
2024-10-12 MEP chapes LAS pour la mache
    [Chape_Fw_La_Fp_Low.dxf, Chape_Fw_La_Fp_Up.dxf, Chape_Fw_La_Rp_Low.dxf, Chape_Fw_La_Rp_Up.dxf, Chape_Fw_Ua_Fp_Low.dxf, Chape_Fw_Ua_Fp_Up.dxf, Chape_Fw_Ua_Rp_Low.dxf, Chape_Fw_Ua_Rp_Up.dxf]
2024-10-13 Dernières MEP la mache
    [Chape_Fw_La_Fp_Low.dxf, Chape_Fw_La_Fp_Up.dxf, Chape_Fw_La_Rp_Low.dxf, Chape_Fw_La_Rp_Up.dxf, Chape_Fw_Ua_Fp_Low.dxf, Chape_Fw_Ua_Fp_Up.dxf, Chape_Fw_Ua_Rp_Low.dxf, Chape_Fw_Ua_Rp_Up.dxf]
2024-10-14 Ajout des chapes de MS_A400
    [MS_04003 (Rear Side Firewall Bracket).CATPart, MS_04004 (Front Side Firewall Bracket).CATPart, MS_04005 (Low Side Firewall Bracket).CATPart, MS_A0400 (FireWall Test).CATProduct, MS_A0400 (FireWall).CATProduct]
2024-10-14 Symétrie des chapes MS_A400
    [Symmetry of MS_0400(4-5).CATProduct]
2024-10-14 Ajout des derniers fichiers MS_A400
    [MS_04001 (Middle Plate v1).CATPart, MS_04002 (Right Side Firewall).CATPart]
2024-10-15 New TSBox
    [TSBox.CATProduct, boitierTSBOX_repris.CATPart, cuivre_grande_plaque.CATPart, cuivre_petite_plaque.CATPart, plaque_TSbox.CATPart, plot_isolateur.CATPart]
2024-10-15 Gabarit tableau de bord middle
    [15x1.5.CATProduct, 25x1.5.CATProduct, 28x1.5.CATProduct, 30x2.CATProduct, 51.CATPart, 52.CATPart, 61.CATPart, 62.CATPart]
2024-10-17 Reprise du gabarit suspension arrière (1/?)
    [Chape_Fw_La_Fp_Low.CATPart, Chape_Fw_La_Fp_Up.CATPart, Chape_Fw_La_Rp_Low.CATPart, Chape_Fw_La_Rp_Up.CATPart, Chape_Fw_Ua_Fp_Low.CATPart, Chape_Fw_Ua_Fp_Up.CATPart, Chape_Fw_Ua_Rp_Low.CATPart, Chape_Fw_Ua_Rp_Up.CATPart]
2024-10-18 Gabarit suspension arrière (2/2)
    [Filaire.CATPart, Maintien tube.CATPart, Plaque principale 1.CATPart, Plaque principale 2.CATPart, Support chape RRocker F.CATPart, Support chape RRocker R.CATPart, Support plaques chapes.CATPart, Suspension.CATProduct]
2024-10-19 Dessin gabarits FL_Damper et FRocker
    [GAbarit Fl_damper.CATProduct, Gabarit FRocker.CATProduct, Plaque FL_Damper_Up.CATPart, Plaque FRocker_F.CATPart, Plaque FRocker_R.CATPart, Plaque support_FRocker.CATPart, Plaque_FL_Damper_Down.CATPart, Plaque_Support_FL_Damper.CATPart]
2024-10-20 Gabarits ST_05001/ST_05002 + bcp de MEP
    [6x55CHC.CATPart, EL_A2100-b (Accumulator Assy Version b).CATProduct, EL_Electrical.CATProduct, EL_G010031.CATPart, EL_G010031.dxf, EL_G010032.CATPart, EL_G010032.dxf, MEP_basculeur_corp.dxf]
2024-10-22 Réparation des fichiers CATIA
    [6x55CHC.CATPart, Chape_Fw_La_Fp_Low.CATPart, Chape_Fw_La_Fp_Up.CATPart, Chape_Fw_La_Rp_Low.CATPart, Chape_Fw_La_Rp_Up.CATPart, Chape_Fw_Ua_Fp_Low.CATPart, Chape_Fw_Ua_Fp_Up.CATPart, Chape_Fw_Ua_Rp_Low.CATPart]
2024-10-22 Aop fixes
    [AMS_IMD_Reset-B_Cu.gbr, AMS_IMD_Reset-B_Mask.gbr, AMS_IMD_Reset-B_Paste.gbr, AMS_IMD_Reset-B_Silkscreen.gbr, AMS_IMD_Reset-Edge_Cuts.gbr, AMS_IMD_Reset-F_Cu.gbr, AMS_IMD_Reset-F_Mask.gbr, AMS_IMD_Reset-F_Paste.gbr]
2024-10-27 BOM Checker v10.9 (non fonctionnelle) + modif connecteurs BMS
    [5-103635-8.step, AMS Dongle.kicad_sch, BMS.kicad_pcb, BMS.kicad_sch, BOM.csv]
2024-11-04 Début gabarits triangle arrière
    [Chape_Fw_La_Rp_Up.CATPart, Chape_Fw_Ua_Rp_Up.CATPart, Chape_Rw_La_Fp_Low.CATPart, Fr_A0100 (Frame).CATProduct, Plaque principale 1.CATPart, Plaque principale 2.CATPart, SU_A0500.CATProduct, SU_A0800.CATProduct]
2024-11-04 gabarit triangle arriere haut
    [Chape_Fw_Ua_Rp_Up.CATPart, Fr_A0100 (Frame).CATProduct, SU_A0500.CATProduct, SU_A0800.CATProduct, SU_A1300.CATProduct, Supension chape assembly.CATProduct, Support plaques.CATPart, Support tube.CATPart]
2024-11-05 Corrections légères BOM checker et cartes
    [AIR Controller.kicad_pcb, AIR Controller.kicad_sch, BOM.csv]
2024-11-06 BMS Testboard
    [BMS_testboard.kicad_pcb, BMS_testboard.kicad_sch]
2024-11-18 Correction gabarit batterie pour découpe
    [Chape_Rw_La_Fp_Low.CATPart, Decoupe_gabarit.xlsx, EL_A2100-b (Accumulator Assy Version b).CATProduct, EL_GA2100.CATProduct, EL_GA2101.CATPart, EL_GA2102.CATPart, EL_GA2103.CATPart, EL_GA2104.CATPart]
2024-11-18 MEPs gabarit batterie
    [Decoupe_gabarit.xlsx, EL_A2100-b (Accumulator Assy Version b).CATProduct, EL_GA2100.CATProduct, EL_GA2101.CATPart, EL_GA2101.dxf, EL_GA2102.CATPart, EL_GA2102.dxf, EL_GA2103.CATPart]
2024-11-20 Gabarit tableau de bord
    [EL_21018 (Low Front Rear Bracket NEW).CATPart, EL_Electrical.CATProduct, EL_G01002.CATProduct, EL_G010021.CATPart, EL_G010021.dxf, EL_G010022.CATPart, EL_G010022.dxf]
2024-11-25 BOM et placement BMS
    [BMS_testboard.kicad_sch]
2024-12-01 BMS 18 Channel V1
    [BMS_18.kicad_pcb, BMS_18.kicad_sch]
2024-12-03 Ajout Application Banc
    [BMS_BOM.csv, BOM.csv, IV_BOM.csv, Indicator_voltage.csv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]
2024-12-12 Rangement fichiers banc + carte controle banc
    [100SP1T1B4M2QE.stp, 5747844-6.stp, Chape bas.CATPart, Chape haut.CATPart, Chapes.CATProduct, Controle_banc.kicad_pcb, Controle_banc.kicad_sch, EN_01001 (EMRAX_228).CATProduct]
2024-12-13 modif legere carte
    [Controle_banc.kicad_pcb]
2024-12-14 BMS 18 modif
    [BMS_18.kicad_sch, BMS_Slave_BOM.csv]
2024-12-15 gabarit steering shaft
    [6x55CHC.CATPart, Chape_L1.dxf, Chape_L1_b.dxf, Chape_L2.dxf, Chape_L2_b.dxf, Chape_M1.dxf, Chape_M1_b.dxf, Chape_M2.dxf]
2024-12-15 Gabarits steering rack et steering shaft
    [GST_A0400.CATProduct, GST_A04001.CATPart, GST_A04002.CATPart, GST_A04003.CATPart, GST_A0600.CATProduct, GST_A06001.CATPart, GST_A06002.CATPart, GST_A06003.CATPart]
2024-12-17 MEP Gabarit ST
    [GST_A04001.dxf, GST_A04002.dxf, GST_A04003.dxf, GST_A06001.dxf, GST_A06002.dxf, GST_A06003.dxf]
2025-01-29 Ajout et modifs BMS 18 footprint
    [05-08-1982_ADI.step, BMS_18.kicad_pcb, BMS_18.kicad_sch]
2025-01-29 Chapes basculeurs arrière
    Remaquettage
    [Chape_RRocker_F.CATPart, Chape_RRocker_F_V2.CATPart, Chape_RRocker_R.CATPart, Supension chape assembly.CATProduct]
2025-01-30 Basculeurs arrière V2
    Fin de modif des chapes et mise à jour du gabarit
    [Chape_RRocker_F.CATPart, Chape_RRocker_R.CATPart, Plaque principale 1.CATPart, Plaque principale 2.CATPart, Supension chape assembly.CATProduct, Support chape RRocker F.CATPart, Support chape RRocker R.CATPart, Suspension.CATProduct]
2025-01-30 MEP Frame brake
    [FRA0500 (IA Assembly).CATProduct, FR_04001_1 (Frame Brake).dxf, FR_04001_1.dxf, FR_04001_10.dxf, FR_04001_11.dxf, FR_04001_2 (Frame Brake).dxf, FR_04001_2.dxf, FR_04001_3 (Frame Brake).dxf]
2025-02-04 mep gabarit basuleur arrière
    [Support chape RRocker F.dxf, Support chape RRocker R.dxf]
2025-02-04 TSboX + inverter
    [EL_2003 (Side Mount Right).CATPart, EL_2010 (Side Mouth Left).CATPart, EL_A2000 (TSBox + Inverter).CATProduct, Symmetry of EL_2003 (Side Mount Right).CATPart, boitierTSBOX_repris.CATPart]
2025-02-04 TSbox fini
    [EL_A2000 (TSBox + Inverter).CATProduct, TSBox.CATProduct, boitierTSBOX_repris.CATPart]
2025-02-11 cadre batterie
    [Cadre_cellule.CATPart, Cadre_cellule_v2.CATPart, EL_22000 (TSAC).CATPart, EL_32000 (18650 Cell)-New.CATPart, EL_32003 (Lower Support).CATPart, EL_32004 (Upper Support) - New.CATPart, EL_32004 (Upper Support).CATPart, EL_32006 (HV Plug).CATPart]
2025-02-13 Modif TSAC
    [EL_22000 (TSAC) - v2.CATPart, Module_new_v2.CATProduct]
2025-02-15 BMS 13 0 erreur
    [BMS_13.kicad_pcb]
2025-02-16 J'ai réduit à 17 les avertissements, il ne manque plus que 1 truc de vref que je ne comprends pas et 16 trucs de librairie
    [BMS_13.kicad_pcb]
2025-02-16 Update carte controle banc + maj fs rules
    [Controle_banc.kicad_pcb, Controle_banc.kicad_sch]
2025-02-17 bien_relié
    [BMS_13.kicad_pcb, BMS_13.kicad_sch]
2025-02-17 Modif bms13
    Déplacement et autres
    [BMS_13.kicad_pcb, BMS_13.kicad_sch]
2025-02-18 Support moteur v2
    [EL_A2200 (Accumulator).CATProduct, EL_Electrical.CATProduct, EN_01009 v2.dxf]
2025-02-19 Encore des modifs du support moteur
    [EN_01009 v2.dxf, ST_06012 (piece pour montage roulement).CATPart]
2025-02-20 Maj carte controle banc avec borniers
    [Controle_banc.kicad_pcb, Controle_banc.kicad_sch]
2025-02-26 modifs tsac
    [EL_22000 (TSAC) - v2.CATPart, Module_new_v2.CATProduct]
2025-02-27 BOMs et BMS Testboard
    [BMS_Slave_BOM.csv, BMS_testboard.kicad_sch, BOM_AMD_Dongle.csv, BOM_AMS_IMD_Reset_(Charger).csv, BOM_Accumulator_indicator_voltage.csv, BOM_Air_Controller.csv, BOM_IMD_SCS_Maker.csv, BOM_TSAC_Voltage_Sensor.csv]
2025-03-03 BMS Testboard schematic finito
    [BMS_testboard.kicad_pcb, BMS_testboard.kicad_sch, Custom_Switch.kicad_sch, Middle_Stage.kicad_sch]
2025-03-04 BMS Testboard PCB finito
    [BMS_testboard.kicad_pcb, BMS_testboard.kicad_sch]
2025-03-06 Support moteur (fin)
    Modifs support + MEP pour envoi en prod
    [EN_01008.dxf, EN_01008.stp, EN_01009 v3.dxf, EN_01009.dxf, EN_01009.stp]
2025-03-13 ASES et Docs prod BMS13
    [BMS_13-B_Cu.gbr, BMS_13-B_Mask.gbr, BMS_13-B_Paste.gbr, BMS_13-B_Silkscreen.gbr, BMS_13-Edge_Cuts.gbr, BMS_13-F_Cu.gbr, BMS_13-F_Mask.gbr, BMS_13-F_Paste.gbr]
2025-03-13 Documents SE3D
    quelques modifs non désirées si ce monde est bon ça ne créé pas de conflit
    [EL_21011 (Low Front Purple Bracket).CATPart, EL_21012 (Low Front Purple Bracket 2).CATPart, EL_22000 (TSAC) - v2.CATPart, EL_22000 (TSAC).CATPart, EL_A2200 (Accumulator).CATProduct, EL_Electrical.CATProduct, IA cell over AIP.CATPart, Module_new_v2.CATProduct]
2025-03-13 Ajout IAD et rendu visuel pour SES
    [16mm2-5.CATPart, 212 OT_1002699_3DSYM.CATPart, 212 UT_1002700_3DSYM.CATPart, 25mm2-10.CATPart, 3d2-fb-rahmen34 01.CATPart, 3d2-led-7seg 01.CATPart, 3d2-pg-metr-25.CATPart, 51.CATPart]
2025-03-13 MEP et chapes fond plat
    [Chapes.CATProduct, FR_04001_11 (Frame Brake).dxf, FR_04001_2 (Frame Brake).dxf, FR_04001_2 (Frame Brake)test.dxf, FR_06003.CATPart, FR_A0600 (Floor pan).CATProduct, FR_A06001.CATPart, FR_frame_and_body.CATProduct]
2025-03-14 ASES 😭
2025-03-14 Ajout SES
    [Frame_HV_Components.CATProduct]
2025-03-16 Parois TSAC
    [Cadre_cellule_Mark1.CATPart, Cadre_cellule_Mark2.CATPart, Cadre_cellule_Mark3.CATPart, EL_22000 (TSAC) - v2.CATPart, Lamelle_HV.CATPart]
2025-03-16 Update cadre_cellule_mark 3
    Automatisation du modele
    [Cadre_cellule_Mark3.CATPart]
2025-03-16 Update Cadre_cellule_Mark3.CATPart
    update avec la mise en place du puzzle sur le cadre
    [Cadre_cellule_Mark3.CATPart]
2025-03-18 Rajout puzzle cadre_mark3
    [Cadre_cellule_Mark3.CATPart]
2025-03-18 Quelques modifs TSAC + Assemblage début
    [Accumulator_Mark2.CATProduct, EL_22000 (TSAC) - v2.CATPart, EL_22000 (TSAC)_Mark2.CATPart]
2025-03-23 Update Cadre_cellule_Mark3.CATPart
    Modifs majeurs, passage un 1 bloc pour les 2 plugs, rajout de la plaque rigidifiante, trous en fraisé
    [Cadre_cellule_Mark3.CATPart]
2025-03-23 Update Cadre_cellule_Mark3.CATPart
    Rajout des dentelures
    [Cadre_cellule_Mark3.CATPart]
2025-03-24 Couvercle TSAC
    [Accumulator_Mark2.CATProduct, EL_22000 (TSAC).CATPart, EL_22000 (TSAC)_Mark2.CATPart, EL_A2200 (Accumulator).CATProduct, SLPIPB50BSB2EH.CATPart, SLPIPB50BSB2EH.stp]
2025-03-24 Courcle TSAC repush
    [Accumulator_Mark2.CATProduct, EL_22000 (TSAC)_Mark2.CATPart]
2025-03-24 Update Cadre_cellule_Mark3.CATPart
    Rajout du 3eme plug
    [Cadre_cellule_Mark3.CATPart]
2025-03-24 Modifs du couvercle Tsac
    Modifs du couvercle Tsac
    [Accumulator_Mark2.CATProduct, EL_22000 (TSAC)_Mark2.CATPart]
2025-03-24 Update EL_22000 (TSAC)_Mark2.CATPart
    [EL_22000 (TSAC)_Mark2.CATPart]
2025-03-25 Dentelures Cadre Cellul
    [Cadre_cellule_Mark3.CATPart]
2025-03-25 MEP plaques casing module
    [Cadre_cellule_Mark3.CATPart, cote1.dxf, cote2.dxf, derriere.dxf, dessus.dxf, oeillet.dxf, petit_oeillet.dxf, rigidifiant.dxf]
2025-04-01 plaque à imprimer
    [plaqueTSBOX.dxf, plaque_TSbox.CATPart]
2025-04-18 Fichiers découpe Casing module
    [cote1.dxf, cote2.dxf, dessus.dxf, socle.dxf]
2025-04-19 Update FS25_SES_v1_EPSA.xlsx
    Ajout Chassis Pics SES
2025-04-29 jlcpcb pcbs
    [Discharge Controller-CuBottom.gbr, Discharge Controller-CuTop.gbr, Discharge Controller-EdgeCuts.gbr, Discharge Controller-MaskBottom.gbr, Discharge Controller-MaskTop.gbr, Discharge Controller-NPTH.drl, Discharge Controller-PTH.drl, Discharge Controller-SilkBottom.gbr]
2025-04-29 SES v3
    Ajout des photos attaches batterie
2025-05-04 Ajout du VDC- aux connecteurs BMS + fichiers de prod + TS Schematic update
    [BMS_13.kicad_pcb, BMS_13.kicad_sch, Data logger.kicad_sch, HV Connector.kicad_sch, HVD.kicad_sch, IMD.kicad_sch, Inverter.kicad_sch, Maintenance Connectors.kicad_sch]
2025-05-12 Couvercle TSAC
    Reparation de l'esquisse
    [Accumulator_Mark2.CATProduct, EL_22000 (TSAC)_Mark2.CATPart]
2025-05-12 TSAC remis à jour
    Debugage du couvercle TSAC
    [EL_22000 (TSAC)_Mark2.CATPart]
2025-05-15 TSAC couvercle modif
    [Accumulator_Mark2.CATProduct, Cadre_cellule_Mark3.CATPart, EL_22000 (TSAC)_Mark2.CATPart]
2025-05-18 Rajout tubes filaires
    [Filaire.CATPart, Fr_A0100 (Frame).CATProduct, Part1.CATPart, Produit6.CATProduct, Shape_425.CATPart, Shape_428.CATPart, Shape_429.CATPart, Shape_449.CATPart]
2025-05-19 Carte des temp_sensors Side 1 et 2
    [Temp_Sensor_Circuit.kicad_pcb, Temp_Sensor_Circuit.kicad_sch, Temp_Sensor_Circuit_Side2.kicad_pcb, Temp_Sensor_Circuit_Side2.kicad_sch]
2025-05-21 corrections jlcp ver cartes
    [SCS IMD-AMD-indicator.kicad_pcb, SCS IMD-AMD-indicator.kicad_sch, SCS Red Led.kicad_pcb, SCS Red Led.kicad_sch]
2025-05-21 Restauration version Axel de février 2025
    [BMS_13.kicad_pcb, BMS_13.kicad_sch, bom.csv, designators.csv, positions.csv]
2025-05-21 TSAC couvercle + connecteurs
    [2883514.CATPart, Accumulator_Mark2.CATProduct, Cadre_cellule_Mark3.CATPart, EL_22000 (TSAC)_Mark2.CATPart, EL_22017 (Inside Container).CATPart, SLPIPB50BSR1.CATPart, SLPIRCBPSO0.CATPart, SLPIRCBPSO0.stp]
2025-05-22 MEP chainshield
    MEP des chapes pour fixer le protège-chaine + modif et MEP du p-c
    [Chainshield_bracket.stp, Chainshield_bracket_2.stp, EN_04010 (Chain Shield).stp]
2025-05-22 casing moteur
    v1 support moteur, attention il utilise des modifs faites dans eliz-2021
    [casingp1.CATPart]
2025-05-23 MEP
    MEP casing moteur et chainshield c'est finito (tunnel)
    [EN_04010 (Chain Shield).stp, casing_tolerie.CATPart, casingp1.CATPart, chape_casing1.stp, chape_casing2.stp, motor_casing.stp, plaque.stp]
2025-05-23 Create FR_A0100 (frame).zip
2025-05-26 TSAC Assembly et TSAC Mark II modif
    [Accumulator_Mark2.CATProduct, Cadre_cellule_Mark3.CATPart, Cadre_cellule_Mark3_negative.CATPart, Cadre_cellule_Mark3_positive.CATPart, EL_21002 (Low Green Bracket).CATPart, EL_21003 (Plate).CATPart, EL_21005 (High Rear Purple Bracket).CATPart, EL_21006 (High Rear Purple Bracket 2).CATPart]
2025-05-26 TsACOS elargissement et Assembly
    [Accumulator_Mark2.CATProduct, Artemiz.CATProduct, Cadre_cellule_Mark3_positive.CATPart, Chapes.CATProduct, EL_22000 (TSAC)_Mark2.CATPart, EL_A0300 (LV Battery).CATProduct, EL_A1200(Inertia Switch).CATProduct, EL_A1500 (MS Plate).CATProduct]
2025-05-27 Dernières modifs TSAC
    [Accumulator_Mark2.CATProduct, Cadre_cellule_Mark3_positive.CATPart, EL_22000 (TSAC)_Mark2.CATPart]
2025-05-28 ajout dxf
    toujours les casing
    [bracket1.dxf, bracket1_shield.dxf, bracket2.dxf, bracket2_shield.dxf, mep_chainshieldv2.dxf, motor_casing.dxf, plaque.dxf]
2025-05-28 Modification du connecteur et des pads
    [Temp_Sensor_Circuit.kicad_pcb, Temp_Sensor_Circuit.kicad_sch]
2025-06-02 Ajout frame parametrique
    [12x1.5.CATProduct, 15x1.5.CATPart, 15x1.5.CATProduct, 20x1.5.CATPart, 22x1.5.CATPart, 22x1.5.CATProduct, 25x1.5.CATPart, 25x1.5.CATProduct]
2025-06-04 Modif section nouveau tube
    [25x2.CATProduct, Fr_A0100 (Frame).CATProduct, Produit6.CATProduct, Shape_234.CATPart, Tubes.CATProduct]
2025-06-04 Update tube
    [Fr_A0100 (Frame).CATProduct]
2025-06-04 Nouveaux inserts direction
    [BR_03002 (fluid tank).CATPart, BR_03003 (tank fixation).CATPart, BR_03003 (tank fixation).stp, ST_03002 (insert v2).CATPart, ST_03002 (insert v2).stp]
2025-06-05 update inserts steering
    [ST_03002 (insert v2).CATPart, ST_03002 (insert v2).stp]
2025-06-05 Update ST_03002 (insert v2).CATPart
    [ST_03002 (insert v2).CATPart]
2025-06-06 Ajout CRD
    [BOM ARTEMIZ Version finale (1).xlsx, ST_03002 (insert v2).CATPart]
2025-06-06 MEP TSAC
    MEP + vues générales
    [chapes_fixations.dxf, fond_global.dxf, middle_plate.dxf, paroi_largeur.dxf, paroi_longueur.dxf, parois_modules.dxf, plaque_fond.dxf, separation_lv_hv.dxf]
2025-06-06 Ajout fichier .stp
    [EL_22000 (TSAC)_Mark2.stp]
2025-06-07 BSPD v4
    [bspdv3-CuBottom.gbr, bspdv3-CuTop.gbr, bspdv3-EdgeCuts.gbr, bspdv3-MaskBottom.gbr, bspdv3-MaskTop.gbr, bspdv3-NPTH.drl, bspdv3-PTH.drl, bspdv3-SilkBottom.gbr]
2025-06-09 dernière version temps sensors
    [Temp_Sensor_Circuit.kicad_pcb, Temp_Sensor_Circuit.kicad_sch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]
2025-06-09 AMS IMD Reset v3
    [AMS_IMD_Reset_v3.kicad_pcb, AMS_IMD_Reset_v3.kicad_sch]
2025-06-11 Début MEP couvercle
    [2883514.CATPart, Accumulator_Mark2.CATProduct, Cadre_cellule_Mark3.CATPart, Cadre_cellule_Mark3_negative.CATPart, Cadre_cellule_Mark3_positive.CATPart, EL_22000 (TSAC)_Mark2.CATPart, EL_22017 (Inside Container).CATPart, SLPIPB50BSR1.CATPart]
2025-06-11 Ajout symétrie tube harnais
    [25x2.CATProduct, Fr_A0100 (Frame).CATProduct, Shape_234.CATPart, Symmetry of Shape_234.CATPart, Tubes.CATProduct]
2025-06-11 MEP TSAC et tubes harnais
    MEP TSAC finito et les tubes supplémentaires sont exportés en .stp vamos
    [EL_22000 (TSAC)_Mark2.stp, Shape_234.stp, Symmetry of Shape_234.stp, chapes_fixations.dxf, fond_global.dxf, main_plate.dxf, middle_plate.dxf, midplate avant.dxf]
2025-06-13 Inserts v2
    Ajout inserts v2 pour tests de traction
    [EL_22000 (TSAC)_Mark2.CATPart, ST_03003 (insert traction).CATPart]
2025-06-13 BSPD v4 / AMS IMD v3
    [AMS_IMD_Reset_v3.kicad_pcb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]
2025-06-16 MEP Inserts
    Nouveaux inserts prêts ouais
    [ST_03002 (insert v2).CATPart, ST_03003 (insert traction).CATPart]
2025-06-16 Ajout fichiers .stp
    j'avais oublié mais je boost mes stats sur le git comme ça
    [ST_03002 (insert v2).stp, ST_03003 (insert traction).stp]
2025-06-25 MEP Casing module
    MEP de la v2, manque le truc bizarre sur le dessus @salim
    [Cadre_cellule_Mark3.CATPart, cote1.dxf, cote2.dxf, derriere.dxf, dessus.dxf, oeillet.dxf, rigidifiant.dxf, socle.dxf]
2025-06-25 MAJ cartes électroniques
    [AMS_IMD_Reset_v3-CuBottom.gbr, AMS_IMD_Reset_v3-CuTop.gbr, AMS_IMD_Reset_v3-EdgeCuts.gbr, AMS_IMD_Reset_v3-MaskBottom.gbr, AMS_IMD_Reset_v3-MaskTop.gbr, AMS_IMD_Reset_v3-NPTH.drl, AMS_IMD_Reset_v3-PTH.drl, AMS_IMD_Reset_v3-SilkBottom.gbr]
2025-06-25 Truc bizarre sur le dessus commencé @Martin
    [Cadre_cellule_Mark3.CATPart]
2025-07-03 Eclatement du casing presque fini
    [Cadre_cellule_Mark3.CATPart, Capot_back.CATPart, Capot_front.CATPart, Capot_side.CATPart, Casing_Side_left.CATPart, Casing_bottom.CATPart, Casing_side.CATPart, Casing_top.CATPart]
2025-07-03 Nouveau casing module
    C'est la fête le nouveau casing est arrivé (manque juste la fixation du connecteur HV), attention c'est du lourd
    [Accumulator_Mark2.CATProduct, Cadre_cellule_Mark3.CATPart, Casing v2.CATProduct, back_plate.CATPart, back_plate.dxf, lower_plate.CATPart, lower_plate.dxf, module_support.CATPart]
2025-07-08 MAJ Modules
    J'ai collé à l'envers mais c'est pas grave normalement
    [Casing v2.CATProduct, Casing v3.CATProduct, upper_plate.CATPart, upper_plate.dxf]
2025-07-14 Mise en place d'un dossier regroupant les datasheets de tous les PCBs
2025-07-17 Mise a jour BMS
    [5-103635-8.SchLib, 5-103635-8.stp, BMS_13_VF.kicad_pcb, BMS_13_VF.kicad_sch, EDI2CAP.CFG, SHDRRA9W69P0X254_1X9_2527X1359X741P.PcbLib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]
2025-07-18 Batterie et catia
    début modifs batterie et ajout tutos catia
    [Bati.CATPart, Bielle-Manivelle.CATProduct, Bielle-Manivelle.xls, Bielle-compresseur.CATPart, Bielle.CATPart, Calcul_poulies-courroie.xls, Courroie.CATPart, DesignTable1.xlsx]
2025-07-22 Inside container finito
    v2 de l'IC pour tout faire en FR-4 collé + nouveau support réservoir de freins
    [BR_03003 (tank fixation).CATPart, EL_22017 (Inside Container).CATPart, EL_A2200 (Accumulator).CATProduct, Inside Container v2 (FR-4).CATProduct, fixation_couvercle.CATPart, guide_translation.CATPart, main_couvercle.CATPart, plaqe_principale_courant.CATPart]
2025-07-22 Ajout DXF
    [couvercle.dxf, fixation_couvercle.CATPart, fixation_couvercle_x4.dxf, guide_translation.CATPart, guide_translation_x2.dxf, main_couvercle.CATPart, plaque_cote_conduit.CATPart, plaque_cote_conduit_x2.dxf]
2025-07-23 TSAC et modules
    Nouvel agencement TSAC et nouvelle version modules pour FR-4
    [Accumulator_v3.CATProduct, Casing v4_2H.CATProduct, Casing v4_3H.CATProduct, Copy (1) of screw_plate.CATPart, Copy (2) of back_plate.CATPart, Copy (2) of screw_plate.CATPart, EL_22000 (TSAC)_Mark2.CATPart, Inside Container v2 (FR-4).CATProduct]
2025-07-23 STP Inside Container
    [couvercle.stp, fixation_couvercle.stp, guide_translation.stp, plaqe_principale_courant.stp, plaque_IMD.stp, plaque_cote_conduit.stp, plaque_droite.stp, plaque_fond.stp]
2025-07-23 Trous modules
    j'avais oublié les trous
    [Casing v4_3H.CATProduct, Copy (2) of screw_plate.CATPart, back_plate.CATPart, lower_plate.CATPart, module_support.CATPart, screw_plate.CATPart, upper_plate_v2.CATPart]
2025-07-24 update dxf
    encore des trucs
    [Accumulator_v3.CATProduct, EL_22000 (TSAC)_Mark2.CATPart, Segment Connector H1111000301-000.CATPart, fixation_couvercle.CATPart, guide_translation.CATPart, laterale_up_no_hole.dxf, laterale_up_with_hole.dxf, main_couvercle.CATPart]
2025-07-24 DXF & STP Module
    [back_plate.dxf, back_plate.stp, lower_plate.dxf, lower_plate.stp, module_support.dxf, module_support.stp, screw_plate.stp, screw_plate1.dxf]
2025-07-24 Modif BMS_VF, changement AOP
    [BMS_13.kicad_sch, BMS_13_VF.kicad_sch]
2025-07-24 Changement texte V BMS
    [BMS_13_VF.kicad_pcb]
2025-07-24 BMS fini (?)
    [BMS_13_VF-CuBottom.gbr, BMS_13_VF-CuTop.gbr, BMS_13_VF-EdgeCuts.gbr, BMS_13_VF-MaskBottom.gbr, BMS_13_VF-MaskTop.gbr, BMS_13_VF-NPTH.drl, BMS_13_VF-PTH.drl, BMS_13_VF-SilkBottom.gbr]
2025-08-05 Design support
    Ajout design support pour FSS
    [BR_03003 (tank fixation).CATPart, tank_fixation.stl]
2025-08-08 Tuto dim batterie
    [EL_22017 (Inside Container).CATPart, EL_A2200 (Accumulator).CATProduct]
2025-09-01 AMS IMD SC
    [AMS_IMD_Reset.kicad_pcb, AMS_IMD_Reset.kicad_sch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]
2025-10-21 moteur roue pédagogique
    [Drivetrain_Osiriz.CATProduct, F-MOT-B motor_dummy.CATProduct, HU-FS-Gearset_V1-2025_A_Bolt.CATPart, HU-FS-Gearset_V1-2025_A_Bolt.stp, HU-FS-Gearset_V1-2025_A_Planet1.CATPart, HU-FS-Gearset_V1-2025_A_Planet1.stp, HU-FS-Gearset_V1-2025_A_Planet2.CATPart, HU-FS-Gearset_V1-2025_A_Planet2.stp]
